n416/katanori/surugo/README.md

# 刷るぞー

**印刷ターム（プレート 1 枚）を単位にして、刷る前に計画を立て、刷った結果をログに積む道具。**

```
python surugo/server.py        →  http://127.0.0.1:8731/
```

## なぜプレート単位なのか

番手もフィルムの状態も位置も、**部品ではなくプレート単位で効く**。いちばんはっきりした例が
[docs/PRINT.md](../docs/PRINT.md) 冒頭の「大きい部品は板が厚く出る」で、あれは
**同じプレートに載っている他の部品が、小さい板の厚みを変えている**現象である
（45mm 離れた大きい板が +0.9 変えた）。部品ごとの STL という単位では、この現象を表現できない。
印刷時間も同じで、「一番背の高い部品だけが決めている」のはプレートの性質である。

## 出力は「結合した 1 つの STL」

✅ 実機で確認済み（[docs/PRINT.md](../docs/PRINT.md) §3）。**CHITUBOX は読み込んだ STL の
座標を捨てて、bbox の中心をプレート中央に合わせる。** 部品ごとに別ファイルで出すと、
相対位置すら保たれない（衝突を避けて勝手にずらされる）。⇒ 1 つに結合して出す。
向きと Z は変えられないので、動くのは XY だけ。

書き出す配置は bbox の中心が (0,0) になるよう作ってあるので、**中央合わせが何もしないのと同じ**になる。
⇒ CHITUBOX では読み込んで、**動かさずにスライスする。**

⚠ プレート上の絶対位置（傷を避ける・フィルムの摩耗を散らす）は、必ず中央へ寄るので指定できない。
やるときは「移動量を出して、人が CHITUBOX の数値欄に入れる」マニュアル操作になる。

## 書いてよい人が種類ごとに違う

ログ（`hardware/print_log.jsonl`）は追記だけの出来事の列。

| 種類 | 中身 | 誰が |
|---|---|---|
| `term` | 印刷ターム（部品・接地・配置） | 人でも **AI でもよい**（STL から導ける事実だから） |
| `placed` | 移動指示を実際に適用したという確認 | 人 |
| `result` | 刷り上がりの結果 | **人だけ** |
| `film` | フィルム交換（摩耗の累積がここで 0 に戻る） | **人だけ** |
| `plate` | 研ぎ直し（番手が決まるのはここ） | **人だけ** |
| `resin` | レジン交換 | **人だけ** |

🔒 2026-09-02 ユーザー「間違えた時に戻す方法ないぞこのあぷり」。⇒ ヘッダの**「ログ」**で全行を見て、
行ごとに**編集・削除**できる（人だけ）。書き換える前に必ず `hardware/print_log_bak/<時刻>.jsonl` へ
丸ごと写し、**「戻す」はその写しを戻す**。行を直しても STL は動かさない（archive へ移す・消すのは
`result` / `drop` を積んだときだけ）。実例: 1405 に書いた失敗の result を 1404 へ付け替えた（16:40）。

🔴 **AI に物理の観測を書かせない。**推測が観測の顔で混ざると、勘を反証するために貯めている
記録が最初から汚れる。⚠ `by` の判定は規律のための柵であって錠前ではない。

⭐ 番手とレジンを**印刷のたびに打ち込ませない**のは、毎回手で入れる欄が必ず腐るからである。
出来事として一度書けば、以後のタームはそれを引き継ぐ。

## 大きい部品は単独で刷る（接地が LCD の 30% 以上）

🔒 2026-08-31 ユーザー「デカイのを刷る時は他のを置いちゃだめ。引きずられて寸法が狂うから」。
接地が `rules.json` の `alone_grip_mm2` 以上の部品が入っていると、**並べずに止まる。**

境目は **3,855mm² ＝ Mars 3 の LCD（143.43 x 89.6 = 12,851mm²）の 30%**。
この機種の系統で知られている目安で、原因は Z の柱でもプレートの取り付けでもなく
**プリンタ本体のベースプレート（土台）のたわみ**。出典と表は
[docs/PRINT.md](../docs/PRINT.md) の節「これは Mars 系で知られている現象だった」にある。

⭐ **うちの実測とも合っている。** btntest 9% → 育ち 0 ／ v4_top 40% → +1.2 ／ テスト板（大）50% → +1.2。
30% の線が「出た組」と「出なかった組」のちょうど間に落ちる。

🔒 **見るのは接地ではなく断面。**原文は "cross-sections"。v4_top は接地 5192.9（40%）に対して
断面の最大が 5579.8（**43%**）で、接地だけでは過小評価になる。⇒ 部品ごとに層ごとの断面積を持つ。

🔒 **効くのは「その層に載っている合計」。**原文の "you don't have any large cross-sections" は
プレート全体の話で、たわむ原因が剥離力である以上そうなる。⇒ **1 個ずつ線の下でも、同じ層で
足して 30% を超えたら止める。**例: `v4_lwall` + `v4_rwall` は 11 層目（Z 0.55mm）で合計 53%。

## ヘラが届く所に置く（中央付近に置かない）

🔒 2026-09-09 ユーザー「小さなパーツを中央付近で印刷すると、金属ヘラを傾けなければいけないから
必ず傷がつく。そうすると連続印刷ができない」。プレートに傷が入ると、**研ぎ直すまで次が刷れない**。

剥がし方は 2 段になっている。① オルファ スクレーパー L型 35LB（刃幅 60mm・全長 159mm）で少し浮かせる。
② 浮いたら 井上工具 INOUE 巾木ヘラ 70mm 13003 を挿す（**プラ製**なのでアルミのプレートを**まったく傷つけない**。薄いのは浮いた隙間に入るため）。①で傷が入るのは、金属の刃が角度を持ってアルミに当たるからである。
⇒ 深さの制限を受けるのは ① だけ。**オルファを使うのは入口の一噛みだけ**で、その先は②に持ち替える。

🔒 ユーザー「正直**入口だけ 30mm** あればいい。そこだけオルファを使うから」「**全部が入ってる必要はない**」。
⇒ 見るのは**入口＝部品の手前の縁**（刃が下に入る所）までの距離で、部品の向こう側までではない。
`rules.json` の `scraper_reach_mm` が 30（図から読んだ刃の長さは約 32mm。60mm は横＝一度に噛める幅で、深さではない）。

⭐ 最近 10 回ほど連続で刷れているのは、**道具を試行錯誤で替えてきたのと、本人の技能が上がったから**である
（2026-09-09 ユーザー）。この規則はその技能の外側に線を引くものではなく、
**技能があっても物理的に無理な置き方（入口が奥すぎる）だけを止める**。

規則は「**入口が、プレートの縁からこの値より奥に来ない**」。効く所は 2 つ:

- **散らし**（`spreadMove`）… **入口を一番浅くする（縁へ寄せる）のが先**で、
  フィルムの摩耗を散らす向きは「入口が同じ深さになる範囲の中で」しか効かない
  （`_reg_term.py` と `app.html` の両方・同じ計算）。
  🔴 最初は「規則を満たす一番近い所で止める」にしていたが、それだと入口 29.8mm（規則 30）で止まり、
  ユーザーに「変わってないよ」と言われた。**ぎりぎりで止めない。**
  ⭐ 並べ方も 2 通り（横並び・縦並び）作って入口が浅い方を採る（`_best_entrance`）が、
  部品が 2 つのときは**横並びの方が浅い**。横並びなら 2 つとも同じ縁に揃って寄れるからで、
  縦並びだと片方が必ず反対の縁から遠くなる（実測: 横 3.3mm ／ 縦 18mm）
- **書き出し**（`/api/export`）… 満たしていない配置は**止まる**。`alone_grip_mm2` と同じ扱い

⚠ この規則を入れる前の回には超えている物がある（2026-09-08-2211 が 35.2mm・過去最大 38.5mm）。

## 摩耗マップ（ヘッダの「摩耗マップ」）

ヘッダの「摩耗 11,510,598」は接地 × 層数の総和で、**どこが減っているか**は分からない。
置き場所をずらしている（`spreadMove`）のが効いているかも、この数字では見えない。
⇒ 真上から見たプレートの 1mm 角ごとに、**その場所で何層ぶん露光（＝剥離）が起きたか**を
足して色にする（`heat.py`・`GET /api/heat`）。「回数（何回そこに部品が載ったか）」にも切り替えられる。
失敗した回の部品があった所は赤い縁で囲む。

🔒 **出どころは刷った結合 STL**（`result` を積んだときに `hardware/stl/term/archive/` へ移した物）。
四隅のアンカー入りなので、その座標がそのまま刷った位置である。ログの cx/cy や w/h は使わない
（2026-09-05 以前の回には w/h が無いし、回した向きも入っていない）。
アンカー以前の回（2026-08-31-1631）は STL が残っていないので入れず、「入れていない回」に名前を出す。
まだ刷っていない回（結果が無い）も入れない。フィルム交換より前の回は数えない（ヘッダの摩耗と同じ）。

⚠ 代理値。剥離仕事そのものではない。**「どこが減っている」の判断は道具はしない。**
測った結果は `surugo/.heat_cache/`（STL の mtime で作る派生物・コミットしない）。

## 判定はまだ入れていない

番手の 3 段（#600 / #800 / #1000）を接地面積から自動で出すことは**していない**。
あの境目は実績ではなくユーザーの勘で、n が小さいため
（[docs/PRINT.md](../docs/PRINT.md) §4「まだ道具にしない」）。**先にやるのは判定ではなく記録**である。

## 数字を二重に持たない

接地面積・島・持たれていない天井は [_stl_preflight.py](../hardware/tools/_stl_preflight.py) を
そのまま呼んで出している（`measure.py`）。同じ数字が 2 か所にあると、片方だけ動く。

## 浮かせて刷る部品

いまのパイプラインでは扱えないので、`rules.json` の `lifted` に名前があると止まる。
🔴 **これを幾何から推論してはいけない。**一度そうしたら、直置きで刷れている
`v4_shutter` / `v4_seat` / `v4_hatch` まで弾いた。置き方は PRINT.md §3 のとおり人が決める。

## ファイル

| | |
|---|---|
| `server.py` | API と画面の配布。**API が本体で、画面はその客の 1 つ**（AI は curl で同じ口を叩く） |
| `measure.py` | STL を測る層。`_stl_preflight.py` を呼ぶだけ |
| `store.py` | ログ。出どころの規則はここ |
| `app.html` | 画面。真上から見たプレート図 |
| `rules.json` | 人が宣言する規則（単独で刷る境目・浮かせて刷る部品） |
| `heat.py` | 摩耗マップ。刷った結合 STL（archive）を 1mm 角に割って露光層数を足す |
