n416/katanori/firmware/esp32/README.md

# カタノリロボ 実機ファームウェア (XIAO ESP32S3)

`firmware/core` / `firmware/hal` のコアロジックを実機で動かすための PlatformIO プロジェクトです。
コアはシミュレーターと**同一のソースを共有**しています（コピーを作らないこと）。

## いまの状態

⚠ 2026-09-15 に書き直した。それまでは「Stage 1〜4」の表で、4 に「会話が成立した後の全部」を積んでいた
（Stage の定義はどこにも無かった）。全体の状態は [ルートの README](../../README.md) が持つ。ここはファームの範囲だけ。

| 領域 | 内容 | 状態 |
|---|---|---|
| 会話の土台 | OLEDに顔を表示（I2Cスキャン・状態遷移の目視確認） | ✅ 2026-07-26 |
| 会話の土台 | Wi-Fi + WSS で Durable Object へ接続 | ✅ 2026-07-26 |
| 会話の土台 | I2S 音声の送受信（ReSpeaker Lite 経由） | ✅ 2026-07-26 会話成立 |
| 会話の土台 | TLS証明書の検証 | ✅ 2026-07-26 |
| Wi-Fi | プロビジョニング（キャプティブポータル）・自動接続・繋がらない時の画面と声 | ✅ 2026-07-26〜 |
| 操作 | 会話ボタン（D2 = GPIO3・短押し=会話の開始/終了・長押し=メニュー） | ✅ Usrボタンで 2026-07-27 → 独立したボタン v3 が 2026-08-31 合格 |
| 操作 | 音量つまみ（AS5600） | ✅ 2026-08-02 移行・2026-08-05 実会話まで開通 |
| 耳の安全 | コーデックのミュートゲート（`pumpOutputGate()`） | ✅ 2026-07 |
| 耳の安全 | ミュートリレー（`D3` = GPIO4・無通電で開） | ✅ 2026-08-08 駆動合格 → 2026-09-02 スピーカー線で確認（[起動時の轟音とその対策](#起動時の轟音とその対策)） |
| 電源 | 電池の電圧・電流（INA226 `0x44`・`bat`） | ✅ 2026-09-02 |
| 電源 | 再起動の理由と直前の様子（`boots` / `lastlog`）・30 秒のウォッチドッグ | ✅ 2026-09-12（BootLog.cpp）。2026-09-11 の勝手な再起動は、2026-09-25 の実測で見た電池切れのブラウンアウトの繰り返しと同じ形（[docs/POWER.md](../../docs/POWER.md) 6章） |
| 運用 | OTA（`xiao_esp32s3_ota` env） | ✅ 2026-08-03 |
| 運用 | 利用者の設定（メニュー ＋ `http://katanori.local/`・Settings.cpp） | ✅ 2026-09-11〜12 |
| 運用 | Wi-Fi 越しのシリアル（`katanori.local` TCP 23・Console.cpp・OTA と同じ合言葉） | ✅ 2026-09-11 |
| 呼びかけ | 「カタノリ」の聞き分け（`MicroWake.h`・`WakeModel.h` の `katanori_own_a`） | ✅ 2026-09-24 完成（[docs/WAKEUP.md](../../docs/WAKEUP.md)） |
| 未着手 | QRペアリング | 未着手 |

> 2026-08-02 に XMOS が起動しなくなった件は 2026-08-05 に解決済み（犯人は `D1`(GPIO2) = XMOS のリセット線。
> この文書の「解決（2026-08-05深夜）」の節）。

## 構成

```
firmware/
├── core/          ← シミュレーターと共有（Arduino依存禁止・純C++14）
├── hal/           ← IHal インターフェース
└── esp32/         ← このPlatformIOプロジェクト
    ├── platformio.ini
    └── src/
        ├── main.cpp        Esp32Hal + setup/loop・会話制御・メニュー・シリアルのコマンド
        ├── NetLink         DO との WebSocket
        ├── AudioIo         I2S・再生キュー・コーデック
        ├── Provisioning    Wi-Fi 設定モード（キャプティブポータル・QR）
        ├── Battery         INA226（電池の電圧・電流）
        ├── BootLog         再起動の理由・直前の様子・前回のログ・ウォッチドッグ（2026-09-11）
        ├── Console         Wi-Fi 越しのシリアル（TCP 23・2026-09-11）
        ├── Settings        利用者の設定と katanori.local の設定ページ（2026-09-11）
        ├── VoiceClips.h    焼き込み音声（katanori-backend/tools/gen-voice-clips.mjs が生成・手で編集しない）
        └── RootCa.h        ピン留めしたルート CA
```

`platformio.ini` の `build_src_filter` で `../../core/*.cpp` をビルド対象に加えているため、
コア側を修正すると実機ビルドにもそのまま反映されます。

## 配線（実機で確認済み）

XIAO ESP32S3 を ReSpeaker Lite に直挿しした構成。OLED は ReSpeaker Lite が使っている
I2Cバス（D4/D5）に相乗りさせる。**このバスにはプルアップが既に載っている**ため追加不要。

| OLEDのピン | XIAO | GPIO |
|---|---|---|
| `VCC` | 3V3（右側ヘッダ上から3本目） | — |
| `GND` | GND（右側ヘッダ上から2本目） | — |
| `SCL` | D5（左側ヘッダ上から6本目） | 6 |
| `SDA` | D4（左側ヘッダ上から5本目） | 5 |

```
          ┌──[USB-C]──┐
   D0 ────┤           ├──── 5V
   D1 ────┤           ├──── GND
   D2 ────┤           ├──── 3V3
   D3 ────┤           ├──── D10
   D4 ────┤           ├──── D9      D4 = SDA (GPIO5)
   D5 ────┤           ├──── D8      D5 = SCL (GPIO6)
   D6 ────┤           ├──── D7
          └───────────┘
```

注意点:

- **VCC は 5V ではなく 3V3 に繋ぐこと。** 5Vを与えるとモジュール側のプルアップが
  I2Cラインを5Vへ引き上げ、ESP32の入力定格を超える。
- 使用しているOLEDモジュールのシルクは **`VCC GND SCL SDA`** の順で、一般的な
  `VCC GND SDA SCL` とは SCL/SDA が逆。並び順の記憶で挿すと入れ替わる。
- 起動時にOLEDが繋がっていないと初期化コマンド列がパネルに届かない。配線を直した後は
  リセットするか、シリアルで `r` を打って再初期化すること。

I2Cスキャンでは ReSpeaker Lite 側のデバイスが `0x18` に、OLEDが `0x3C` に見える。
両方出れば配線は正常。

### Usrボタン（🔒 2026-08-03 不採用・デバッグ用のみ）

> 🔒 **決定（2026-08-03・ユーザー）: Usrボタンは製品では使わない。**
> ReSpeaker Lite 側のボタンを借りる方式は**デバッグ用の間に合わせ**であって、
> 装着者が押すボタンではない。**独立したプッシュボタンを載せる**（次節）。
>
> これで消えるもの: `Usr`-`D2` の導通ハック（ボード裏のスルーホールにジャンパを
> ぶら下げる）、個体ごとの導通確認、ストラッピングピン GPIO3 の制約。
> **ボード交換のたびに増えていた手順が丸ごと無くなる。**
>
> 以下は、いま手元の機体を触るときのための記録として残す。

ReSpeaker Lite 裏の **Usrボタンで会話を開始できる**（XIAOのBOOTボタンは小さすぎて実用にならないため）。
ただし Usrボタンは XMOS XU316 側に繋がっていて、**そのままでは ESP32 から見えない**。

- ReSpeaker Lite の XIAO が載っている面、左下に **`Mute D3 D2 Usr`** と印字された穴の列がある
- **`Usr` と `D2` の導通が必要**（Seeed公式の想定でははんだブリッジ。
  [Usr Button Usage](https://wiki.seeedstudio.com/respeaker_button/)）
- これで Usrボタンが **D2 = GPIO3**（`KATANORI_USR_BUTTON`）に押下=LOWで入る

> 🔧 **記録訂正（2026-08-02・ユーザー確認）**: 以前ここに「はんだブリッジしてある」と
> 書かれていたが、**実機にはんだ付けは一切していない**。Usr-D2は**ジャンパー
> （ブレッドボード用ピン）を穴に通してぶら下げているだけ**（固定なし・ブラブラの
> 状態でスルーホールのメッキに触れて導通している）。取り外し自由で基板は無改造。
> 当時ユーザーは画像付きで「ジャンパーで繋いでいるだけ」と報告していたのに、
> AIが勧めていた「はんだブリッジ」が実行されたものとして記録された（誤変換の経緯）。

**Usr-D2 が導通していない個体では Usrボタンは一切反応しない。** 新しいボードを組むときは導通方法を決めてから。

- ファーム側は BOOTボタンと Usrボタンを同じ扱いで読む（`anyButtonPressed()`）。
  短押し=会話開始/終了、3秒長押し=Wi-Fi設定モード
- **Muteボタンはブリッジしない。** XMOS側でマイクミュートとして実際に機能しているため
- GPIO3 はストラッピングピン。INPUT_PULLUPで読むだけなら無害だが、**リセットの瞬間に
  押しっぱなしにしない**こと

### 会話ボタン（独立したプッシュボタン・2026-08-03 決定・✅ 実装済み）

✅ ファームは `D2`(GPIO3) で読む（main.cpp 冒頭）。スイッチは 2026-08-31 にレバー式の v3 が実機で合格し、2026-09-02 にハブ基板経由で動作確認。下の PS21B-3 の話は経緯。

装着者が押す唯一のボタン。役割は Usrボタンから引き継ぐ（短押し=会話開始/終了、
長押し=メニュー。🔒 2026-09-11 に「3秒長押し=Wi-Fi設定モード」をメニューの WiFiせってい へ移した）。ファームは `anyButtonPressed()` で読む形のまま、
ピン定義を差し替えるだけで済む。

**要件**: 高齢者が肩の上で**見ずに手探りで押せる**こと。筐体に固定できること
（ぶら下げ配線にしない）。A接点（ノーマルオープン）・モーメンタリ・LED無し。

#### 🔴 届いた PS21B-3 は硬すぎる（2026-08-06・実物で判明）

**「かなり強く押さないとダメ」**（ユーザー報告）。**上の要件に反している。**

✅ **実測: 約600gf（≒5.9N）が必要**（2026-08-06・ユーザー実測）。
**橋の穴に据えて固定した状態での測定**なので、「手で持っているから硬く感じるだけ」
（指が反力を吸う）という可能性は**同時に否定されている**。硬いのはスイッチ本体。

参考: キーボードのキーやマウスのクリックは**50〜75gf**程度。**600gf はその約10倍。**
⚠ しかも肩の上では反力を受ける支えが無いので、机の上で600gfを押すより更に不利。

⚠ **肩の上のボタンは、机の上の同じ硬さより実際にはさらに厳しい。** 押し返す支えが
取れない（自分の体を押すことになる）ため力が逃げる。強く押すほど**装置が肩からずれる・
鎖骨側に食い込む**方向にも働く。クリップ留めなら外れる可能性もある。

⚠ **落ち度は記録側にある。** 旧 SHOPPING.md（2026-08-24 に削除・git 履歴）4.5 の選定条件は
A接点・モーメンタリ・LED無し・パネル取付・寿命5000回・¥90 で、**押下力が条件に入っていない**。
「高齢者が手探りで押せる」を散文で書いたまま、**購買の数値条件に落とさなかった**のが原因。
リポジトリ内に押下力の数値は一切残っていない（選定時に見ていない）。

🔒 **決定（2026-08-06・ユーザー）: 動作力の軽いスイッチへ交換する。**
てこ／パドルによる延命（部品を買わない案）は採らない。

**▶ 発注したもの（2026-08-06・Amazon・翌日着＝2026-08-07）:
DAOKAI「20PCSマイクロリミットスイッチ NO+NC ヒンジストレートレバー 3PIN 125V 1A」¥309（20個・¥15/個）。**
ヒンジレバー形・a接点/b接点（COMとNOだけ使う）・プラグイン端子。評価4.6（364件）・Amazon出荷。

⚠ **この品も動作力と動作寿命の数値を公開していない**（スペック表は動作モード・電流・電圧・
接点・コネクタ・ブランド・スイッチタイプのみ）。商品説明の「起動にはわずかな力しか必要ありません」は
**宣伝文であって仕様ではない**。**PS21B-3 と同じ形の情報不足**なので、**届いたら実測する**。

**それでもリスクは囲めている**（前回4個で全滅して手詰まりになった状況とは違う）:
1. **20個ある**
2. **測れる**（下の測定方法）
3. **パドルのてこ比で救える。3:1なら300gf → 100gf。** ヒンジレバー形が400gfを超えることはまず無い

⬜ **秋月の `SS-10GL13`（114659・¥160・0.49N）は買わなかった**が、**数値の基準としては有効**
（下の表の右列）。互換品が重すぎた場合の逃げ道として記録に残す。
⚠ 秋月は**送料¥550＋リードタイムが長い**ため、小物1点では選ばない（ユーザー指摘・2026-08-06）。

| | PS21B-3（現物・硬い） | **SS-10GL13**（買っていない。**数値の基準**） |
|---|---|---|
| 動作力 | **実測 約600gf ≒ 5.9N**（カタログに記載が無く、選定時に見られなかった） | **0.49N ≒ 50gf**。キーボードのキー／マウスのクリック相当＝**約1/12** |
| アクチュエータ | ピン押ボタン（φ小・硬い） | **ヒンジ・アール・レバー形**（レバー自体がてこになる） |
| 動作寿命 | **5,000回**（1日15回で約1年） | **50,000回＝10倍** |
| 奥行き | **全長36.58mm**・径18.94mm | **短辺6.4mm**（18.4 × 19.8 × 6.4） |
| 接点 | A接点 | C接点（**NOとCOMだけ使う**） |
| 取付 | パネル穴＋ナット | ねじ止め（印刷したボスに留める） |

#### ✅ 届いた（2026-08-07）。**動作力 約30gf で合格**

| | 値 | 判定 |
|---|---|---|
| **動作力** | ✅ **約30gf ≒ 0.29N**（ユーザー実測） | **合格**。基準の100gf に対し3倍以上の余裕。`SS-10GL13`(50gf)より軽い。PS21B-3(600gf)の**1/20** |
| **外形** | ✅ **縦5 × 横12 × 高6 mm ／ ノブ高5 mm**（2026-08-07 再計測。横＝端子の並び方向） | リレー12.6mm とほぼ同じ長さ |
| 動作寿命 | ⬜ 不明（メーカー非公開） | 試作は可。製品化の段で再検討 |
| 3ピンの割り当て | ✅ **レバーの根本側から C, NO, NC**（2026-08-07 ユーザー確認） | 使うのは **C と NO**。⚠ **NC は繋がない**（押していない間ずっと閉じている＝会話が始まりっぱなしになる） |

⚠ **心配の向きが反転した。** 硬すぎる問題は消えたが、**30gf は「軽すぎ」も検討する帯**。
**パドルのてこ比で軽くする必要はもう無い**（3:1 を掛けると指先10gf になり、服や寝返りで
誤って会話が始まる側に寄る）。**パドルは「手探りで当てられる面積」のために付ける**もので、
**てこ比は1:1近くでよい**。肩の上での誤爆は、パドルを設計する前に決める。

**この交換は4つ同時に効く**（硬さだけの話ではない）:
1. **動作力** — 要件そのもの
2. **寿命** — 5,000回は上の⚠で「製品として渡すなら替える」と既に書いていた宿題。同時に消える
3. **薄さ** — 36.58mm → 6.4mm。**肩に載せる機体では効きが大きい**
4. **手探りで押せる** — レバーの上に**印刷したパドル**を被せる。パドルは要件のためにどちらにせよ要る
   （てこ比のぶん指先の力はさらに軽くなる）

⚠ **筐体側の作り方が変わる。** パネル穴＋ナットではなく、**ねじ止めのボス＋レバーを押すパドル**。
そのため [DIMENSIONS.md](../../docs/DIMENSIONS.md) の「PS21B-3 のパネル穴径・ねじ長」は
**優先度が下がった**（詳細に測る必要はもう無い）。代わりに要るのは **SS-10GL13 の取付穴ピッチ・
レバー位置・動作travel**。

~~⚠ **今週には間に合わない**（発送待ち・到着は週明け見込み）~~ → **2026-08-07 に着荷済み。**
**PS21B-3 は使わない。最初からこのマイクロスイッチを載せる。**

⭐ **線で出さず、ハブ基板に直挿しする（2026-08-07・ユーザー指摘）。**
端子が**1穴飛ばし＝ピッチ5.08mm で 2.54mm グリッドに乗る**ので、3本がそのまま3穴に入る。
**縦置き（リレーと同じ向き・上端も揃える）で 列9**。
穴は **`J9`＝C（GNDへ）／`L9`＝NO（`D3`へ）／`N9`＝NC（繋がない）**。
⚠ **NC を繋ぐと、押していないのに会話が始まりっぱなしになる。**
⚠ これを載せるため駆動回路を左へ寄せた。**空けてある列が3本ある**（いずれも「空き」ではなく設計の一部）:
**列2**＝+5Vレールとの緩衝／**列6**＝コレクタ配線の通り道／**列8**＝GNDレール(列7)と
スイッチのピン列(列9)の緩衝。
穴割りは [hardware/parts/relay_board.html](../../hardware/parts/relay_board.html) が正。

⚠ **ファーム側はこの件と無関係**（ピン定義＋`anyButtonPressed()`）。硬さが未解決でも
**配線とファームは先に通せる**。

⚠ **ピン割り当ては提案であって未確定**（ボード到着後に確定する）:

| 用途 | 提案 | 理由 |
|---|---|---|
| **ミュートリレー駆動** | **D3 = GPIO4** | ✅ **2026-08-08 実機で合格。** 電源投入で開・`high 3` で閉・`hiz 3` で開 |
| 会話ボタン | **D2 = GPIO3** | ✅ **ファーム側は既にできている。** `KATANORI_USR_BUTTON = 3` がこのピンで、`setup()` で `INPUT_PULLUP` にして `anyButtonPressed()` が読んでいる。**スイッチを D2⇔GND に繋げばファームは1行も変えなくてよい** |
| ~~ミュートリレー駆動~~ | ~~**D10 = GPIO9**~~ | 🔴 **使えない。** ファームでは未使用だが、**ReSpeaker Lite 側が握っている**。挿すだけで電源投入時にリレーが閉じっぱなしになった（[docs/POWER.md](../../docs/POWER.md)）。テスターで1.49V＝クロックの平均値と見られる |

🔴 **「ファームで未使用」は「ピンが空いている」ではない。** D10 はこの取り違えで外した。
**ReSpeaker Lite 側の結線は公開資料で追えていない**ので、ピンを決めたら必ず実機で検証する。
検証は「線を挿す → 電源投入で**動かない**こと → `high N` で動くこと → `hiz N` で戻ること」。
`high`/`hiz` で追従を見れば、**ピンの取り違えと機能の可否を同時に確認できる**（数えなくてよい）。

**D1 は使わない。** 基板内でXMOSのリセット線に直結しており、pinMode しただけで
音声が止まる（2026-08-05 確定）。
**D0 は「ファームが触らないピン」になった**（2026-08-11 にADCフォールバックを削除。
下の旧経路の節）。ただし空きピンとして使うのは、ワイパー線を外した独立テストで
生死を確認してから（「`high 0` で3Vが出ない」はポット接続下の測定で証拠不成立）。

### 音量つまみ（AS5600・2026-08-02 ファーム移行済み）

主経路は **AS5600（I2C 0x36）の `RAW ANGLE`**。ゼロ点（NVS `knob/zero`）からの
相対角度を 0-100% へ写す。設計と実測は [docs/KNOB-ENCODER.md](../../docs/KNOB-ENCODER.md)。

- ビルドフラグ: `KATANORI_KNOB_SPAN_DEG`（既定270・ゼロ点からこの角度で100%）/
  `KATANORI_KNOB_OFF_DEG`（既定5・この角度未満でOFF、+3度のヒステリシス）/
  `KATANORI_KNOB_DIR_INVERT`（回して%が逆に動く組み付け用）
- コマンド: `knobzero`（今の位置をゼロ点として保存）/ `knobsrc`（読み元の再判定）/
  `knob`（角度・%・ゲインに加えて磁石の MD/ML/MH・AGC・MAGNITUDE）
- **AS5600が唯一の経路**（旧・可変抵抗のADCフォールバックは 2026-08-11 に削除）。
  起動時に 0x36 が応答しなければ読み取りを止めて既定音量で動き、動作中に
  5回連続で読めなくなったときは音量・OFF状態を**最後の値のまま固定**する。
  復帰は配線を確認して `knobsrc`
- 治具での実測（2026-08-02）: ゼロ点保存→90度ごとに 0/28/64/97% の単調増加、
  12時戻りでOFF復帰、ゼロ点を数度行き過ぎても範囲外折返しで0%に倒れる。
  つまみを外して切り分けるときは `knobdis` で読み取りを止めてから行う

### 音量つまみ・旧経路（スイッチ付き可変抵抗・2026-07-29 配線・**削除済み**）

RV121SF-20-02J-B10K（10kΩ Bカーブ・SPST連動スイッチ付き）。

> 🔒 **この経路は 2026-08-11 にコードから削除した**（ポットを二度と戻さない方針が
> 確定したため）。`kKnobCurve`・`pumpKnobAdc()`・`knobSwitchRawOn()`・
> `KATANORI_VOL_ADC`・`KATANORI_KNOB_SW`・`KATANORI_KNOB_SW_INVERT` は
> もうコードに存在しない。以下は当時の配線と実測の記録として残す。
> **可変抵抗まわりを新規に設計・買い足ししないこと。**

| つまみの足 | 接続先 | 備考 |
|---|---|---|
| 上の足（OFF位置でワイパーが導通する側） | **GND** | 左に回し切り=0Vで最低音量になる向き |
| 中央の足（ワイパー） | **D0 = GPIO1** | ADCで読む。**3V3系。5Vは絶対に入れない** |
| 下の足（最大位置でワイパーが導通する側） | **3V3** | |
| 連動スイッチ2本 | **D1 = GPIO2** と **GND** | 2本に向きは無い。INPUT_PULLUPで読む |

- ⚠ **XIAOのシルク `D0`/`D1` は GPIO0/GPIO1 ではない**（D0=GPIO1、D1=GPIO2）。
  ここを読み違えるとワイパーとスイッチが入れ替わり、「音量が0か最大しかない・
  回転の途中で疑似電源OFFに入る」という症状になる（2026-07-29 に実際に踏んで、
  コネクタで入れ替えて復旧した）
- **現在の機体は外側2本が上表と逆**（OFF位置側=3V3）のまま実装されている
- **ADC→位置(%)の換算は実測テーブル**（main.cpp の `kKnobCurve`）。この個体の
  抵抗カーブはB（直線）と称して実際は「3時で22%・4時→5時に全変化の6割」という
  極端な偏りがあり、線形換算では使いものにならなかった（2026-07-29 実測）。
  向き（外側2本の付け方）の吸収もこの表が担う（旧 `KATANORI_VOL_INVERT` は廃止）。
  **つまみを交換・再半田したら各位置で `knob` を読んでテーブルを取り直すこと**
- ~~組立中に3V3-GNDの短絡事故があった~~ **記録訂正（2026-08-02・ユーザー確認）:
  3V3-GNDの短絡は実際には起きていない。** 以前のセッションの誤診断が事実として
  書かれていた。故障原因の候補からも外すこと
- 待機中にログへ「ミュートしました」が出続けるのは**仕様**（出力ゲートは
  鳴らすものがある間だけ開く）。故障判定は「会話の応答中にも無音か」で行う
- **スイッチは電源線に入れない**（定格DC12V 0.5A。GPIOで読めば数μAで定格が無関係）
- 論理は **ON位置=接点が閉じる=LOW**（アクティブLOW。Usrボタンと同じ作法）。
  「OFF位置なのにHIGH」は故障ではなく仕様。逆に振る舞う個体は
  ビルドフラグ `-DKATANORI_KNOB_SW_INVERT=1` で反転できる
- OFF位置の挙動: 会話を終了し、出力ゲートを閉じたままにする（手動 `unmute` より優先）。
  ボタンを押しても会話を開始しない
- 確認コマンドは `knob` だった（当時はADC生値・スイッチ状態も表示。現在のコードでは
  AS5600の角度と磁石の状態を表示する）

### 疑似電源OFF（つまみOFF位置・`pumpPowerDown()`）

電源基板が無いので**本当には切れない**（USB給電でも電池でもXMOSごと生きている）。
ESP32側だけを畳んで「切れたように見せる」のがこの処理。

| OFF位置になってから | すること |
|---|---|
| 即時 | 会話終了・出力ゲートを閉じる・顔とマイクを止める |
| 2秒後 | OLED消灯（`setPowerSave(1)`。バッファは残るので戻せば同じ絵が出る） |
| 5秒後 | `wsDisconnect()` → `wifiDisconnect()` → ユーザーLED消灯 |

- **一気に落とさない理由**: 回し切る途中で一瞬OFFを通ることがあり、また「切ったつもりが
  違った」とすぐ戻すこともある。落とし切る前にONへ戻せば、その段階は実行されない＝
  何も起きなかったことになる。落とした後に戻した場合は**落とした分だけ**戻す
  （画面を点け、Wi-Fi再試行の待ち時間を捨てて即座に自動接続へ行く）
- 通信を落とすまでの5秒間は WebSocket を生かしたまま `netLink.loop()` を回す。
  ここで戻れば繋ぎ直しが要らない（再接続はWi-Fiだけで十数秒かかる）
- ユーザーLEDは「通信中」の表示なので、**切断が終わってから**消す
- 昇圧ICのEN制御は、この5秒後の処理の**最後**に足す。そうすると
  ミュート→切断→電源断の順序が構造的に守られる（[docs/POWER.md](../../docs/POWER.md)）
- Wi-Fi設定モード中は動かない（画面もAPも要るため）。設定モードを抜けた時点で効き始める
- **`WiFi.mode(WIFI_OFF)` までは落としていない**（`wifiDisconnect()` 止まり、
  `main.cpp` の `powerWifiOff`）。消費電流は WIFI_OFF のほうが小さいので、
  本当は落としたい。実測してから決めること。

  > **この判断を2度間違えている。** 「WIFI_OFF にするとI2Sが巻き添えで止まる」
  > (2026-07-29) → 「I2Sではなくコーデックの設定が飛ぶ」(2026-07-30) → **どちらも誤り**。
  > 根拠にした試験はどちらも「つまみを回す」操作を含んでいて、そちらが犯人だった。
  > `wifistop` で WIFI_OFF を15秒保持しても、コーデックは生きたままになる。
  > **一度に1つしか変えないこと。**

> ✅ **「つまみを回すとコーデックが死ぬ」は解決済み（2026-08-05）。** 原因だった可変抵抗そのものが
> AS5600 への移行で機体から無くなった。経緯と実測は [docs/KNOB-TROUBLE.md](../../docs/KNOB-TROUBLE.md)。
> 以下の可変抵抗の話は記録。

### 切り分け用のシリアルコマンド

| コマンド | 何をするか |
|---|---|
| `creg` | コーデックの主要レジスタをダンプ。正常時は `0x3F=0xD4` / `P1 0x09=0x3C` |
| `knobdis` | つまみの読み取りを止める/再開。**配線を外して切り分けるときは必ずこれ**（外すとピンが浮いてOFF位置と誤認し、ソフト側の理由で無音になる）。⚠ **疑似電源OFF中に打つと復帰処理が走る**（画面点灯・Wi-Fi再接続・**コーデックのミュート解除・起動ボイス再生**）。ゲインが0でなければ音が出るので、**イヤホンを着けたまま打たないこと** |
| `low <d>` | 指定したDピンを300ms LOWにする。「このピンをGNDに繋ぐと何が起きるか」を手を使わずに再現する |
| `pwr` | 疑似電源OFFの有効/無効。前節の処理を丸ごと切れる |
| `reboot` | ESP32だけ再起動。**この機体はRSTボタンが押せない位置にある**ため。USB給電は切れないので「ESP32だけ」の切り分けに使える |
| `mag` | **AS5600(0x36)の磁石の状態と角度**を1回表示（読み出しのみ。OTPには一切書かない）。`STATUS` の MD/ML/MH・`AGC`・`MAGNITUDE`・`RAW ANGLE`・`ANGLE` を出す。つまみの非接触化の組み付け確認用（[docs/KNOB-ENCODER.md](../../docs/KNOB-ENCODER.md)）。**電源断用リードスイッチの磁石が角度を狂わせていないか**もここで見る（[docs/POWER.md](../../docs/POWER.md)） |

`pumpCodecWatch()` が200msごとにコーデックを見張っていて、出力が死んだ瞬間と復帰した
瞬間をログに出す。**これが無いと、音を鳴らすまで気づけない。**

コマンドは `pio device monitor` に手で打ってもよいが、決まった手順を流して結果を
持ち帰るなら [tools/ser.py](tools/ser.py) が楽（行頭に経過秒が付く）。

```bash
python tools/ser.py 3 knobdis creg
```

## セットアップ

PlatformIO Core をインストールします（VS Code拡張版でも可）。

```bash
pip install -U platformio
```

`pio` にパスが通らない環境では `python -m platformio ...` でも同じことができます
（`pip install --user` の場合はこちらが確実）。初回の `pio run` は
ツールチェーンを取りに行くので数分かかります。

**USBドライバは要りません。** XIAO ESP32S3 はネイティブUSB（USB-Serial-JTAG）で、
Windows 11 なら挿すだけで「USB シリアル デバイス (COMn)」として見えます。
CH340/CP210x のようなドライバを入れる必要はありません。ポート番号はPCごとに
変わるので、機械を替えたら確認してください。

```bash
pio device list
```

## ビルドと書き込み

XIAO ESP32S3 を USB-C で PC に接続してから、このディレクトリで実行します。

```bash
pio run -e xiao_esp32s3 -t upload
```

書き込み後、シリアルモニタを開きます。

```bash
pio device monitor -e xiao_esp32s3
```

### 書き込みできない場合（ブートローダーモード）

XIAO ESP32S3 の **BOOT ボタンを押しながら RESET**（または BOOT を押しながらUSB接続）すると
ダウンロードモードに入ります。COMポートが見えない場合はこれを試してください。

## 動作確認（Stage 1 の完了条件）

1. シリアルに `[I2C] device found at 0x3C` が出る → **配線OK**
2. OLED に目が表示され、数秒おきにまばたきする → **描画OK**
3. シリアルモニタから `1` `2` `3` `4` を送ると顔が変化する → **状態機械OK**

| 入力 | イベント | 遷移 |
|---|---|---|
| `1` / BOOTボタン | `WAKE_WORD` | IDLE → LISTEN |
| `2` | `SPEECH_END` | LISTEN → THINK |
| `3` | `RESPONSE_READY` | THINK → SPEAK |
| `4` | `SPEECH_DONE` | SPEAK → IDLE |

シミュレーターのキー操作と同じ割り当てです。
`wrapper.py` が送る `CMD:SPEAK_START` / `CMD:SPEAK_END` も受理します。

### 診断コマンド

ネイティブUSB CDC のため、`upload` 直後のブートログはモニタを開く前に流れてしまいます。
以下のコマンドで後からいつでも同じ情報を取れます。

| 入力 | 内容 |
|---|---|
| `s` | I2Cバスを再スキャン（配線確認） |
| `a` | D0〜D10 の全ピン組み合わせを I2C として叩き、OLED(0x3C/0x3D)がどのピンに繋がっているかを探索 |
| `vN` | D`N` ピンの電圧を測る（簡易電圧計）。例 `v0` |
| `gN` | D`N` ピンが GND に導通しているか見る（簡易導通チェッカー）。例 `g1` |
| `t` | OLED自己診断パターンを5秒表示（`DisplayBuffer` を通さず U8g2 直描画） |
| `bn` | 接続状況の表示（顔の代わりに出る2行）を4種類、3秒ずつ出す。文字の大きさの確認用 |
| `i` | チップ・メモリ・I2Cピン設定を再表示 |
| `?` | ヘルプ |

`t` は**画面が出ない原因を二分する**ためのものです。

- `t` で枠と `KATANORI SELFTEST` が見える → 配線とOLED初期化はOK。原因は `DisplayBuffer` → U8g2 の転送側
- `t` でも真っ暗 → 配線・I2Cアドレス・給電のいずれかの問題

同じ理由で、起動直後にも自動でこのパターンを5秒表示します。

### テスター代わりの使い方

`vN` / `gN` はテスターが手元にないときに ESP32 自身を簡易計測器として使うためのものです。
調べたい点から D`N` ピンへジャンパーを1本渡して実行します。

- `v` は ADC で電圧を読みます。**入力は 3.3V まで。5V の点に繋ぐとピンが壊れます**
- `g` は内部プルアップを有効にして読むだけ。LOW なら GND に導通しています
- ADC非対応のため `v` は D6 / D7 では使えません（D0〜D5、D8〜D10 を使うこと）

## Stage 2: ネットワーク

Wi-Fi資格情報は **NVS(Preferences) に保存**します。ソースにも `platformio.ini` にも
書かないため、gitに漏れません。書き込み直しても消えません。

**最新5件まで保存**できます（自宅とスマホテザリングの併用を想定）。接続時は
スキャンして「見えている保存済みSSIDの電波が強い順」に試します。6件目を登録
すると最も古い1件が押し出されます。接続に成功したSSIDは「最新」へ繰り上がる
ので、よく使うものが自然に残ります。

| 入力 | 内容 |
|---|---|
| `ssid <名前>` | SSID を追加（既存の同名は先頭へ移動） |
| `pass <パスワード>` | 直前の `ssid` のパスワードを保存（ログには出しません） |
| `forget [名前]` | 指定SSIDを削除。名前を省略すると全消去 |
| `wifi` | Wi-Fi へ接続（普段は自動。手動で試したいとき用） |
| `wifioff` | Wi-Fi を切断 |
| `c` | Durable Object へ WebSocket 接続（普段はボタンを押した時に自動で張る） |
| `d` | WebSocket を切断 |
| `n` | ネットワーク状態を表示 |

### 完了条件（実機で確認済み）

```
[NET] 接続しました  IP=192.168.0.18  RSSI=-44dBm  (1.0秒)
[WS] 接続しました (0.9秒)
[WS] ★ setupComplete 受信 — Geminiまで疎通しました
[WS] BIN 26bytes: {"setupComplete": {}}
```

接続開始からGeminiの応答まで実測 **1.06秒**。WebSocket 接続中は内蔵LEDが点灯します
（仕様書の「通信中のステータス表示」）。

空きヒープの実測値: Wi-Fi接続前 292KB → TLS+WebSocket接続後 **248KB**（TLSで約44KB消費）。

### アンテナは必須

XIAO ESP32S3 は外付けアンテナ前提の設計です。**U.FL コネクタにアンテナを挿していないと
実質的に通信できません。** 実測で 40dB（電力比1万倍）の差が出ました。

| | アンテナなし | アンテナあり |
|---|---|---|
| 自宅APのRSSI | -86dBm | **-46dBm** |
| 検出できたAP数 | 2件 | **15件** |
| Wi-Fi接続 | 失敗 (WL_DISCONNECTED) | 成功 (0.8秒) |

スキャン（ビーコンを聞くだけ）は通っても接続（双方向のやりとり）は落ちるため、
「SSIDは見えるのに繋がらない」という紛らわしい症状になります。

### 実機で判明したこと: Geminiの応答はバイナリフレーム

Gemini Live API は応答を **WebSocket のバイナリフレーム**で返してきます（中身はJSONテキスト）。
`wrapper.py` では Python の websockets ライブラリが bytes と str を透過的に扱うため
表面化しませんでしたが、実機では TEXT と BIN の両方を同じように読む必要があります。
**Stage 3 の音声受信でも同じ扱いになります。**

### 起動後の自動接続

渡した相手はUSBもシリアルコンソールも持たない。**電源を入れるだけで会話できる状態まで
自力で行き着く**必要があるため、`main.cpp` の `pumpAutoConnect()` が以下を回します。

1. 保存済み設定があれば起動後すぐWi-Fiへ接続する（`wifi` を打つ必要はない）
2. 失敗したら 5秒 → 10秒 → 15秒…（上限30秒）と間隔を広げて試し続ける。
   ロボットのほうがルーターより先に起きる場合に備えるため
3. **一度も繋がらないまま3回失敗したら設定モードへ落ちる**。SSID変更や
   パスワード間違いを利用者が自分で直せるようにする

3の条件が「一度も繋がっていない場合のみ」なのは意図的です。会話中にルーターが
再起動しただけで設定モードへ入って会話が終わるのは、利用者から見て理不尽なため。
一度繋がった後の切断は再試行のみを続けます。

#### 繋がっていないことを利用者に伝える（2026-07-29）

引っ越して保存済みSSIDが消えた機体が、**顔だけを出したまま約1分間黙って**
再試行を続けました。顔は繋がっていてもいなくても同じように動くので、
利用者からは正常に見えてしまいます。3つ直してあります。

- **画面**: 繋がっていない間は**顔をやめて**、16pxの日本語を2行で出す
  （`netMsg1/netMsg2` / `Esp32Hal::flushDisplay`）。繋がれば顔に戻ります。

  | 状態 | 表示 |
  |---|---|
  | 接続中 | WiFiに / つないでいます |
  | SSIDが無い | WiFiが / みつかりません |
  | それ以外の失敗 | WiFiに / つながりません |

  最初は**顔の下に10pxの帯を重ねる**設計にしましたが、実機で読めませんでした
  （128pxに9文字入れると1文字10pxしか使えず「つ」が潰れる）。文字を大きくすると
  顔と同居できないので、**伝えるほうを優先して画面ごと明け渡しています。**

  フォントは `u8g2_font_b16_t_japanese1`（+46KB）。**かなとASCIIだけ使うこと。**
  japanese1 に無い漢字は幅0で消えます。1行は全角8文字（128px）が上限で、
  超えるとシリアルに `[UI] !! "..." は NNNpx` が出ます。

  文字の大きさは繋がっている機体では確かめられないので、**シリアル `bn`** で
  4種類を3秒ずつ画面に出せるようにしてあります。文言を変えたら必ずこれで見ること。
- **打ち切り**: 切断理由が結論の出ているもの（201 NO_AP_FOUND / 202・15 認証失敗）
  なら、タイムアウトを待たず接続試行を打ち切る。**12秒 → 実測2.5秒**。
- **顔を止めない**: `wifiConnect()` に待ち中のフックを渡し、接続待ちのあいだも
  描画を回す。渡さないと main loop ごと止まって顔が固まり、故障に見える。

結果、SSIDが消えた機体がQRを出すまで **約58秒 → 約23秒**（うち6.5秒は設定モード
起動時のスキャン。ポータルのSSID一覧を作るためのもので、ここは削っていない）。

**スキャンで「SSIDが在るか」を判定してはいけません。** 最初はそう実装しましたが、
名前を隠したAP（ステルス）が近くに1つでもあると「一覧に無い＝存在しない」と
言えなくなり、実機の環境がまさにそれで判定が成立しませんでした。加えて既定の
スキャンは13チャンネルで約6秒かかり、繋がる機体まで毎回遅くなります。
**接続を試した結果の理由コードのほうが速く、確かです。**

WebSocket は**ボタンを押した時に張ります**。DO はクライアント接続と同時に Gemini へ
繋ぎにいくため、常時接続や自動再接続は Gemini のセッションを浪費します
（`wrapper.py` と同じ「会話するときだけ繋ぐ」設計）。押した時点で未接続なら、
接続してから録音を始めます（`pendingTurn`）。

待つのは **`setupComplete` まで**（`netLink.wsReady()`）。WebSocketが繋がった時点では
Gemini側のsetupが終わっておらず、送った音声は捨てられます。最初のひと言が消える
という分かりにくい不具合になるため、ここを`wsConnected()`で済ませてはいけません。

### 焼き込み音声（起動アナウンス）

`src/VoiceClips.h`（自動生成・コミット対象）に 16kHz PCM を直接持っています。
サーバーに繋がる**前**や繋がらないときに鳴らす音なので、DO側のつなぎ言葉とは
別に、ファームのフラッシュに置く必要があります。

| クリップ | 鳴るとき |
|---|---|
| 「カタノリ、起動しました！」 | Wi-Fiに繋がって会話できる状態になった（電源1回につき1度だけ） |
| 「ワイファイの設定をしてください」 | 設定モードに入った（未設定・繋がらない・ボタン長押し） |

作り直しは backend 側のツールから行います（TTSのAPIキーがそちらにあるため）。

```bash
cd katanori-backend
node tools/gen-voice-clips.mjs   # VoiceClips.h を作り直す
node tools/preview-clips.mjs     # 焼く前にWAVで聴く
```

16kHzで持つ理由: 実機のI2Sは16kHz固定なので、24kHzのまま置くとマイコン側で
リサンプルが必要になり、そのまま流せば低く遅い声になります。フラッシュ消費は
16kHz 16bit モノラルで **1秒あたり32KB**（現在2クリップで108KB）。

再生後は必ず出力をミュートへ戻します（`pumpVoiceClip()`）。開けっ放しにすると
次のリセット時にROMブートログが轟音になります。キューが空になってから
250ms待ってから閉じるのは、I2Sドライバ内に残った送信待ちで語尾が切れるのを
防ぐためです。

### VAD計測モード

`vad` で開始。音声はどこにも送らず、有声区間の回数・長さ・音量だけを数えます。

| 入力 | 内容 |
|---|---|
| `vad` | 計測の開始/終了 |
| `me` | 以降の声を【自分】/【周囲】で切り替える（正解ラベル） |
| `vadme` | 自分の声を4秒測ってゲートを自動設定 |
| `vadth <RMS>` | ゲートを直接指定（0で自動） |

計測中はBOOTボタンもラベル用（押しているあいだ【自分】）になり、会話・設定モードは動きません。

呼び名をクラウドの whisper で聞き分ける方式を検証するために作った（2026-09-21 に捨てた。
docs/WAKEUP.md の「却下したもの」）。今の呼び名は機体の中で聞き分ける（src/MicroWake.h）。
VAD の検出線は、合図の音を鳴らす時と、会話の頭の無音詰めにまだ使っている。

**実測で分かったこと（2026-07-26）**

- **絶対音量は当てにならない。倍率で見ること。** 騒音床が 38〜469 と12倍も動いた
  （ReSpeaker側の自動音量調整）。一方で倍率は安定していて、
  装着者の声が床の15〜58倍、隣にいる家族の声が4〜10倍。
- **長さでは分けられない。** 装着者の5秒の発話と家族の0.2秒の相槌が、
  長さの判定では逆に出る。「呼びかけは短い」という仮定は捨てた。
- **騒音床は追従させないと固まる。** 起動時に1回測るだけの実装では、部屋が少し
  騒がしくなった時点で「発話中」のまま2分間無反応になった。静かなあいだ少しずつ
  更新し、10秒を超えた区間は打ち切って測り直す。
- **方向検知(DOA)はこの機体では使えない。** 4マイクの上位機(XVF3800)の機能で、
  ReSpeaker Lite(2マイク)には公式の記載がない。XMOSの制御ポート(0x42)も
  この機体のI2Cスキャンには出ず、用意されているのはDFUと設定用のみ。
  I2Sから来るのは処理済みの音声で、生のマイク2本ではないため自前計算もできない。
- **代わりに低域比（近接効果）を試している。** 口が近いほど低域が持ち上がる。
  距離で決まる物理現象なので「遠くの大声」に騙されない。XMOSのノイズ抑制で
  低域が削られていると使えないので、実測で判断する。**ここが未検証。**

### 設計上の注意

- ESP32 は **2.4GHz帯のみ**です。5GHz専用のSSIDには接続できません。

### TLS証明書の検証

`beginSslWithCA()` でルート証明書を検証しています（`src/RootCa.h`）。
検証あり/なしで接続時間は 0.85秒 → 1.7秒。

2026-07-26 時点の実チェーンから抽出した2つを信頼アンカーにしています。

```
leaf : tobira-sys.workers.dev
  <- Google Trust Services WE1   (中間)
  <- GTS Root R4                 ← 埋め込み
  <- GlobalSign Root CA          ← 埋め込み
```

PEMは連結して渡せるので、クロス署名が外れても片方で検証が成立します。

**ピン留めの宿命**: 接続先が発行元CAを変更するとこの機器は繋がらなくなります。しかも
「TLS検証に失敗した」とは表に出ず、ただ繋がらないだけになります。そのため
**一度も接続できないまま切断された場合はログでCA更新の可能性を示唆**します。

更新手順は `src/RootCa.h` のコメント参照。緊急避難は `-DKATANORI_TLS_INSECURE=1`
（常用しないこと）。

**限界**: `arduino-esp32 2.0.17` は `CONFIG_MBEDTLS_HAVE_TIME_DATE` が無効なため、
**証明書の有効期限は検証されません**。中間者攻撃は防げますが、期限切れ・失効した証明書を
弾く効果はありません。変えるにはフレームワークの再ビルドが必要です。
副作用として、SNTPによる時刻同期なしで検証が通ります。

## Stage 3: 音声

DO の PCMモード（`?pcm=16000`）に繋ぐため、ESP32 側は base64 も JSON 組み立ても
リサンプルも行いません。**生PCMを読んで送る / 受け取って書く**だけです。

### ReSpeaker Lite との I2S 結線（実機で確定）

XIAO は ReSpeaker Lite に直挿しなので配線作業は不要です。ピンは Seeed公式の I2S サンプル
（`I2S.setPins(8, 7, 43, 44)`）と同じですが、**クロックの向きとスロット幅は公式サンプルと
違いました**。実機での総当たり（`scan2`）で確定させた値がこれです。

| 項目 | 当初の実装 | 正解 |
|---|---|---|
| クロック | ESP32がマスタ | **ESP32はスレーブ**（XMOSがマスタ） |
| スロット幅 | 16bit | **32bit**（データは上位16bit） |
| フォーマット | 標準I2S | 標準I2S（これは合っていた） |

総当たりの実測値:

| 設定 | フレーム/秒 | 無音時RMS | 判定 |
|---|---|---|---|
| MASTER 各種 | 16k〜17k | 17155〜17880 | 全滅（自分のクロックで無意味なビットを読むだけ） |
| SLAVE I2S 16bit | 32,427 | 239.9 | 静かだが**レートが2倍**（32bitスロットを2回に割っている） |
| SLAVE I2S 32bit | **16,213** | 256.2 | **正解** |
| SLAVE MSB | — | 23000超 | 全滅 |

**RMSだけで判断してはいけません。** 一様乱数のRMSは 32768/√3 ≒ 18918 で、これに近い値は
音声ではありません。逆に静かに見えても実測フレームレートが 16kHz から外れていれば
スロット幅が合っていません。`scan2` はこの両方を見て選びます。

| 信号 | GPIO | XIAOピン | 向き |
|---|---|---|---|
| BCLK | 8 | D9 | |
| WS / LRCLK | 7 | D8 | |
| DOUT | 43 | D6 | ESP32 → ReSpeaker（スピーカー） |
| DIN | 44 | D7 | ReSpeaker → ESP32（マイク） |
| MCLK | 9 | D10 | 公式サンプルが未使用のため既定では出さない |

**I2C(D4/D5) とは衝突しません。** OLEDと共存できます。

フォーマットは **16kHz / 16bit / ステレオ**。マイクはステレオで届くので ch0 を使い、
スピーカーへはモノラルを左右へ複製して書きます。

### 会話の手順

```
wifi      # Wi-Fi接続
c         # DOへ接続
1         # 話し始める（録音してDOへ送る）
          # ... 喋る ...
2         # 話し終わる（audioStreamEnd を送る）
```

BOOTボタンでも `1`/`2` を交互に切り替えられます。`au` で音声の状態を確認できます。

`clientContent` + `turnComplete` ではなく **`audioStreamEnd`** を使うこと。VADが発話中と
認識していると前者は無視されてハングします（`wrapper.py` で確定済みの知見）。

### 🔴 再生中の残留（2026-09-21・未決着）

**ロボットが喋っている間、マイクにその声が残る。** Gemini がそれを「人が喋った」と
見なして、始めたばかりの応答を割り込みとして捨てる。会話1ターンごとに起きる。

実測（同じ RMS の計算で並べたもの）:

| 条件 | 件数 | 最小 | 中央 | 9割 | 最大 |
|---|---|---|---|---|---|
| 鳴らしていないとき（部屋の音） | 66 | 0 | **49** | 541 | 1169 |
| 再生中 | 13 | 26 | **1379** | 9172 | 9288 |

中央値で **28倍**。部屋の音ではなく、確かにロボットの声である。
比較のために、人の声は 1m で RMS 1880〜2632（docs/WAKEUP.md 付録D）。**重なる。**

🔴 **音量に依存しない。** つまみを変えて測ったが、残留は動かなかった。

| つまみ | 件数 | 最小 | 中央 | 最大 |
|---|---|---|---|---|
| 9% | 22 | 400 | 1385 | 8612 |
| 21% | 23 | 58 | 1522 | 8497 |
| 30% | 56 | 344 | 1363 | 5738 |
| 40% | 25 | 257 | 1403 | 5036 |
| 50% | 20 | 338 | 1689 | 5755 |

⚠ **音響エコーだけでは説明が付かない。** スピーカーから出た音が回っているなら
音量に比例するはずである。9% まで下げても中央 1385・最大 8612 で、連動していない。
🔒 ユーザー 2026-09-21「消える可能性は低いだろうね。１０％で起きてるんだもの」。

⬜ **説明できる仮説はまだ無い。**
一度「GPIO43(DOUT) と GPIO44(DIN) が隣のピンなので、データ線から信号線への
クロストーク」と書いたが、**これは取り下げた**。DIN はデジタル入力で、数十mV 乗っても
0/1 の判定は変わらないので音が混じることにならない（化けるなら音が壊れて聞こえる）。
アナログ側の回り込み（アンプの数百mA が GND を揺らしてマイク入力に乗る）なら音は
混じるが、**それは音量に比例する**。どちらも実測と合わない。

#### 次の一手（1つだけ）

🔴 **XMOS のファームを v1.1.0 にして、ch0 の取り出し口から AGC を外す。**
（2026-09-21 に一次資料を読んで決めた。スピーカーを抜く実験より先にこれ）

**AGC が AEC の残留を押し戻している**という報告が、フォーラムと GitHub の両方にある。

- Seeed フォーラム「Respeaker Lite AEC support」の hamstie（2025-03-17）:
  「AEC は密な音楽の再生ではよく効くが、**発話だけの再生では効かない**。AGC が
  捕捉信号を増幅し、録音された声を最大レベルまで持ち上げる。AGC が強すぎて変更できない」
- respeaker/reSpeaker_Lite の Issue #9 のコメント（herve-clawd・**個人の投稿で Seeed の
  公式回答ではない**）: 「AEC は動いている。罠は **ch0 の工場出荷の既定が AGC タップ**
  （AEC+IC+NS+AGC のフルチェーン）で、最後の AGC が小さな残留を聞こえるレベルまで
  押し戻すこと。ch0 を NS タップ（AGC なし）に下げるとエコーはほぼ消える」

katanori が再生するのは**まさに発話**である。AGC は一定レベルまで持ち上げるので、
**残留が音量に依存しない**ことの説明にもなる（実測がそうだった）。騒音床が 38〜641 と
12倍動くのも同じ AGC の仕業である。

##### 取り出し口（タップ点）の触り方

XMOS Command Transport Protocol、I2C `0x42`、RESID `0xF1`（Configuration service）。

| cmd | 対象 |
|---|---|
| `0x30` | ch0 の取り出し口 |
| `0x40` | ch1 の取り出し口 |

| 値 | 取り出し口 |
|---|---|
| 0 | 生マイク |
| 1 | AEC |
| 2 | AEC + IC（2マイクのビームフォーム） |
| 3 | **AEC + IC + NS（AGC なし）** ← ここへ下げたい |
| 4 | AEC + IC + NS + AGC ← ch0 の既定 |

⚠ XMOS のフラッシュに残る。焼き直しでは戻らない。

##### 🔴 v1.0.8 には無い（実機で確認・2026-09-21）

シリアル `tap` で読める。

```
ファーム版数        v1.0.8       ← 通信は正常
VNR値(0-100)      3             ← 読めている
ミュート状態        status=2      ← 公式が「v1.0.9 以降が必要」と書いているコマンド
ch0 取り出し口      status=3      ← 受け付けられない
ch1 取り出し口      status=3
```

版数と VNR が読めるので I2C は生きている。status が返るのは**そのコマンドが
この版に無い**ためで、Issue #9 のコメントは **v1.1.0 ch0-asr_ch1-mww** での話だった。

⚠ **読み出しの書式を間違えると status=2 で弾かれる。** 公式の例
（`xiao_esp32s3_arduino_examples/xiao_i2c_get_register_value`）に合わせること:
`cmd|0x80` は**付けない**／要求するバイト数は「欲しい数＋1」（先頭が status）／
`endTransmission()` は通常終了で repeated start にしない。

##### v1.0.9 では直らない

changelog（公式）:

```
v1.0.9: DAC 出力ゲインの既定を 0dB → -2dB、i2c で mute_status を読めるように
v1.0.8: 新しいフラッシュ ZB25VQ32D 対応
v1.0.7: i2c でスピーカーのミュートと出力チャンネルを制御
v1.0.6: PRODUCT_STR を変更、ws2812 のバグ修正
v1.0.5: i2c で vnr を読めるように
```

**AGC とタップ点に関する変更が1つも無い。**

##### 書き込みの道は2つ。⭐ B を採る

公式の `dfu_guide.md` によると、dfu-util からは3つの領域が見える。

```
alt=0, name="DFU FACTORY"
alt=1, name="DFU UPGRADE"        ← 公式手順が使うのはここ（dfu-util -R -e -a 1 -D <bin>）
alt=2, name="DFU DATAPARTITION"
```

| | 中身 | 判断 |
|---|---|---|
| A | 16kHz の v1.1.0（**factory** 版）を `-a 0` に書く | ❌ レート変換は要らないが、**公式手順に無い操作**。factory は工場出荷の復帰用で、壊した場合に戻せる保証が無い |
| B | 48kHz の v1.1.0（**DFU** 版）を `-a 1` に書く | ⭐ **公式手順どおり。** 代わりに ESP32 側で 48k↔16k の変換が要るが **3:1 の整数比**なので、送りは3サンプル平均・再生は3倍に伸ばすだけ。DO 側のリサンプラは触らない |

16kHz の v1.1.0 が factory 版しか無いのは 2026-07-26 に調べた通り
（`respeaker_lite_i2s_factory_firmware_v1.1.0_ch0-asr_ch1-mww.bin`）。

##### 手順

1. **ReSpeaker の USB-C ポート**（3.5mm ジャック寄り。XIAO 側ではない）を PC へ繋ぐ
   → 筐体を開ける必要がある
2. `dfu-util -l` で 3 領域が見えるか確認（見えなければ Zadig で WINUSB を入れる）
3. `dfu-util -R -e -a 1 -D respeaker_lite_i2s_dfu_firmware_48k_v1.1.0_ch0-asr_ch1-mww.bin`
4. 機体のファームを 48kHz 用の env で焼く（**2026-09-21 に用意済み**）

   ```
   pio run -e xiao_esp32s3_48k -t upload --upload-port COM5
   ```

   48k↔16k の変換は `AudioIo` の中だけ。`readMic()` が 3 サンプルの平均を 1 つに
   落とし、`writeMono()` が 1 つを 3 つへ線形に伸ばす。**呼び出し側（main.cpp /
   NetLink / WakeWatch / DO）は無改造**で、いままで通り 16kHz を渡し受けする。
   16kHz の env（`xiao_esp32s3`）では比が 1 になり、変換はコンパイル時に消える。

5. シリアル `tap` で ch0 を読む（**4** のはず）。読めれば Issue #9 の情報が当たり
6. `tap 3` で AGC を外し、`[QUIET]`／`[ECHO]` を測り直す
7. 効かなければ v1.0.9（16kHz・DFU）へ戻し、env も `xiao_esp32s3` に戻す

⚠ **ファームと env は必ず揃える。** 食い違うと音が 3倍速か 3分の1 の速さになる。

⚠ 間引きは 3 サンプルの平均で、8kHz あたりの落ちは -6dB ほどしかない。折り返しが
文字起こしに響くようなら FIR に替える（`AudioIo::readMic` のコメント）。

⚠ **AGC を切ると全体の音量が下がる。** 小さい音を持ち上げる働きも無くなるので、
VAD の検出線・ゲート・呼びかけの距離は測り直しになる（docs/WAKEUP.md 付録D/E）。

##### 参考にした一次資料

- `https://github.com/respeaker/reSpeaker_Lite` — ファーム一覧・I2C プロトコル・Arduino の例
- `https://github.com/respeaker/reSpeaker_Lite/blob/master/xmos_firmwares/changelog.md`
- `https://github.com/respeaker/reSpeaker_Lite/blob/master/xmos_firmwares/dfu_guide.md`
- `https://github.com/respeaker/reSpeaker_Lite/issues/9` — タップ点の話（⚠ 個人の投稿）
- `https://github.com/respeaker/reSpeaker_Lite/issues/5` — 「レジスタマップを公開してほしい」（未回答）
- `https://forum.seeedstudio.com/t/respeaker-lite-aec-support/283114` — AGC が強すぎる報告、
  スピーカーの周波数特性（イコライザ付きは AEC を壊す）、USB 版 v2.0.5〜2.0.7 の不具合報告

##### スピーカーの選び方（Seeed の中の人・2025-04-01）

> スピーカーの周波数特性が AEC の結果に大きく影響する。イコライザが付いていると
> 出る音が参照チャンネルと食い違い、AEC が打ち消せない。**平坦な特性で内蔵アンプの
> 無いスピーカー**を選び、JST2.0 で ReSpeaker Lite に繋ぐのが良い。

#### 次の一手のあと（音響側の切り分け）

**スピーカーの端子（PH2.0）を抜いて、同じ測定をする。** 音は出ないが I2S には
同じデータが流れる。

- **抜いても残留が出る** → 配線の回り込み。XMOS の AEC より後なので原理的に消せない。
  自作の音声基板で DOUT/DIN の引き回しを決める
- **抜いたら消える** → 音響エコー。スピーカーの位置・向き・筐体の遮音で対処する

🔒 **ソフトで引く道は採らない**（2026-09-21 ユーザー「それだとこの基盤つかってる意味がない」）。
ESP32 は自分が送った音を持っているので後段で打ち消すことは原理的に可能だが、それは
「音声を専用ハードウェアでやる」という独自性（[ARCHITECTURE.md](../../docs/ARCHITECTURE.md)）を
崩す。**ハード側で決着させる。**

#### この件で外した説明（同じ道を通らないために残す）

いずれも 2026-09-21 に実測で否定された。

| 説明 | なぜ違うか |
|---|---|
| ミュート解除のポップが原因 | 音量レジスタを 8段24ms のフェードにしても残った（フェード自体は正しいので残置） |
| AEC の収束に 0.3〜0.6秒かかる | 残留は再生の全期間で上下していた。立ち上がりだけではない |
| アンプの飽和 | 音量を 9% まで下げても残留が変わらない |
| ReSpeaker Lite はスピーカーが離れた機器向け | **一次資料で確認していない。根拠のない話だった** |

#### 入れた対策（残留そのものは直っていない）

- **つまみが ON のあいだ、コーデックのミュートを開け閉めしない**（`pumpOutputGate`）。
  会話ごとに閉めていたのは、ミュートリレーが入る前（2026-08-05 頃）の対策が
  見直されずに残っていたもの。起動時の ROM ブートログの轟音は、リレーの
  10kΩ プルダウンがファーム停止中に接点を開いて担保している
- **再生開始から 600ms は送らず、そのあとは RMS 1000 を超えた音だけ送る**（`pumpMic`）。
  ⚠ 残留が 9288 まで出るので、これでは塞ぎきれていない。暫定である
- 会話が終わってから **1.5秒** 置いて見張りを始める（`kWatchAfterPlayMs`）

### 設計上の注意（いずれも実機で踏んだ問題）

- **バイナリフレームは無条件に音声として扱う。** 中身を覗いて振り分けてはいけない。
  PCMデータの先頭バイトがたまたま `{` (0x7B) になることは256分の1で起きる。実機で
  1フレーム誤判定して音が欠けた。制御は必ずテキストで来ることをDO側で保証している。
- **音声フレームは4KB以下**である必要がある。`links2004/WebSockets` は
  `WEBSOCKETS_MAX_DATA_SIZE = 15KB` 超を受け取ると中身を読まず `close(1009)` する。
  DO側で刻んでいる。「文字起こしは届くが音声が来ずに切断」という症状で発現した。
- **受信中は描画を間引く。** OLEDの全面転送は約29msブロックする。20FPSのままだと
  時間の6割を描画に取られ、`ws.loop()` が呼ばれず受信を落とす。再生中は8FPSへ落とし、
  `ws.loop()` は1周あたり8回まわす。
- **再生は専用タスク + リングバッファ**で行う。Gemini は応答音声を実時間よりずっと速く
  まとめて送ってくるため、受信した場所から直接 `i2s_write` すると DMA が空くまで
  ブロックして OLED の描画が止まる。
- **送るものが無くても無音を書き続ける。** TXを止めるとDMAが枯渇し、条件によっては
  直前の内容を繰り返して大音量のノイズになる。
- 再生バッファは **PSRAM があれば 512KB（16秒）**、無ければ 48KB（1.5秒）に縮小する。
- **エコーガード**: 再生中はマイクを送らない。送ると自分の声で Gemini が割り込み判定して
  会話が破綻する。ReSpeaker Lite のハードウェアAECが効けば不要になるはずの暫定措置。
- マイク読み出しは**タイムアウト0の非ブロッキング**。描画を止めないため。
- **出力は音量を絞る（既定35%）。** ReSpeaker Lite の出力はアンプ経由。イヤホンを直結すると
  非常に大きな音になるため、耳に着けたままテストしないこと。

### 顔と会話の同期

`StateMachine` は IDLE→LISTEN→THINK→SPEAK の一本道で途中を飛ばせない。一方 Gemini は
自前のVADで勝手にターンを進めるため状態が食い違う（LISTENが10秒でタイムアウトしてIDLEに
戻った後に応答音声が届く、など）。`driveTo()` で必要なイベントを順に注入して追いつかせる。

| Geminiからの通知 | 顔 |
|---|---|
| `speechState: SPEECH` | LISTEN |
| `speechState: NON_SPEECH` | THINK |
| 音声フレーム到着 | SPEAK |
| 再生完了 + turnComplete | IDLE |

**実用上、`2`(audioStreamEnd) を押す必要はない。** Gemini のVADが発話終了を検知して応答を
始める。`1` で録音を開始すれば、あとは自然に会話が続く。

### ReSpeaker Lite のファームウェア

ReSpeaker Lite には **I2S版と USB版**のファームがあり、**USB版では I2S から音が出ません**。

USBオーディオデバイスとして Windows に現れるかどうかで判別できます（現れなければ I2S版）。
確実に確認するには XMOS側のUSB-Cポート（3.5mmジャック寄り）を繋いで `dfu-util -l`。
Windowsではドライバが当たっていないため Zadig で WinUSB を入れる必要があります。

```bash
dfu-util -R -e -a 1 -D respeaker_lite_i2s_dfu_firmware_v1.0.9.bin
```

**`ch0-asr/ch1-mww` ファームについての訂正**（2026-07-26に一次情報で確認）:

`v1.1.0_ch0-asr_ch1-mww` という派生ファームは存在するが、**ウェイクワードを検出しない**。
ch1は「外部のMicro Wake Wordエンジンに向いた処理をした音声」を出すだけで、判定そのものは
ESP32側でやる必要がある（ESPHomeの microWakeWord コンポーネント用という位置づけ）。
「載せ替えれば自前のTinyMLが不要になる」というのは誤り。

### 2026-08-02: XMOS が起動しなくなった（音声全滅）

つまみのAS5600ファームを書き込んだ日の午後、**XMOS (XU316) が起動しなくなった。**
ESP32はI2Sスレーブでクロックは全部XMOSから来るため、音の入出力が全滅している。

**症状と証拠**（どれも単独で再確認できる）:

| 見たもの | 結果 | 意味 |
|---|---|---|
| `au` | 再生キューが溜まったまま**再生済み0サンプル** | I2Sが1バイトも流れていない |
| `scan2` | SLAVE全設定で**0フレーム**、MASTER読みは常にFFFF | BCLK/WSもDIN(マイク)も来ていない |
| `v8` / `v9` | WS(D8)=0mV / BCLK(D9)=0mV | クロック線が物理的に沈黙 |
| `creg`（電源再投入後） | P0 0x3F=**0x14（AIC3204の初期値）** | **XMOSが起動時のコーデック設定を書いていない** |
| XMOS側USB-CをPCへ | **列挙されない**（過去はVID_2886&PID_0019が見えた記録あり） | XMOSのUSBスタックも動いていない |

**切り分けで消したもの**（⚠ ここで消せたのは「**今の症状を維持している要因**」だけ。
「**壊した原因**」の免罪ではない — 作業中に壊れたものは配線を抜いても直らないため、
最小構成テストは原因の切り分けにならない。2026-08-02 訂正）:

- **給電構成ではない** — XIAO側給電・XMOS側給電・両方給電（バッテリー併用）すべてで同じ
- **治具の配線ではない** — AS5600の5本を全部抜いた最小構成・冷間起動でも 0x3F=0x14 のまま
- **ESP32側ソフトではない** — コーデック設定を書くのはXMOSで、その書き込み自体が無い
- **ケーブル/PCポートではない** — 同じケーブルでCOM3(XIAO)は正常に使えている

**原因は不明**。時系列の相関（ESP32ファーム書き込みリセットの轟音が最後の音）は事実で、
治具の配線作業時のダメージは**否定できていない**。偶発的な部品故障とも矛盾しない。
以前の記録が「ESP32側ソフトではない＝書き込み作業は無関係」と読める書き方だったのは
上記の混同によるもの。

> **「書き込みリセット中のI2Sバス競合」説は否定してよい（2026-08-03 調査）。**
> ROMブート／ダウンロードモードで **4本とも向きが変わらない** — DOUT(43)はESP32が出力
> （UART0 TXもESP32出力）、DIN(44)はESP32が入力（UART0 RXも入力）、WS(7)/BCLK(8)は
> ESP32が入力（リセット既定もI2Sスレーブ動作も入力）。ストラッピングピン(0/3/45/46)にも
> 当たらず、電圧も3.3Vロジックのまま。**書き込み動作がXMOSを電気的に叩く筋は薄い。**

**時系列**: 書き込み直前まで音は出ていた（書き込みリセット時にROMブートログの轟音が
出た＝その瞬間はXMOSがクロックを出していた証拠）。その轟音が最後の音。
因果は特定できていない（轟音はXMOSより下流で鳴るので、音自体がXMOSを壊す経路は
考えにくい。※「組立時の3V3-GND短絡の遅発」説は記録誤りにつき撤回 — 短絡は
実際には起きていない。ユーザー確認 2026-08-02）。

**2026-08-02 深夜の再検証**(冷間起動とUSB抜き挿し計7回+αで再現確認):

- **XMOSは完全沈黙ではなく「起動して0.5〜3秒で必ず死ぬ」**。XMOS側USB-Cを挿すと
  VID_2886&PID_0019 が列挙されるが、0.5秒または2.5〜3秒で切断する(7回中7回死亡、
  生存時間はこの2グループに分かれる)。データ線のある別ケーブルでも同じ
- **死ぬまでの進み方が毎回違う**。事故時と再検証初回の冷間起動はコーデック全初期値
  (0x3F=0x14)のままだったが、別の冷間起動では**コーデック初期化の大半を完走**していた
  (P0 0x1B=0x30, P1 0x09=0x3C, 出力経路0x08。DAC電源ONの手前で死亡)
- **抜き挿しを繰り返すと悪化する**(後半は3連続で0.5秒側)。固定点で死ぬファームの
  バグではなく、マージナルなハード(はんだクラック・電源レール・シリコン損傷)の振る舞い。
  なお**基板は無改造・短絡事故も無し**(ユーザー確認 2026-08-02。過去記録の
  「はんだブリッジ」「3V3-GND短絡」はどちらも誤記録)
- 落ちた後は挿しっぱなしでも自然に再列挙しない(ブートループではない)

**復旧手段は無い**: ReSpeaker Lite に Safe Mode・リカバリピン等の公式手順は存在せず、
DFUはUSB列挙が前提。列挙は最長3秒でドライバのバインドすら間に合わず、ソフトからは
触れない(JTAGで触るにはxTAGが要る)。**ボード交換になる。**

**2026-08-05 追試で故障確定**（新ボード到着日に、動作実績のあるケーブルで再試験）:

- コーデック(0x18)が **I2CのACKすら返さない**（`[CODEC] 応答がありません`。
  新ボードでは同条件でレジスタ全読み出しに成功しており、環境差ではない）
- ESP32が `rst:0x15 (USB_UART_CHIP_RESET)` で**ブートループ**し、そのたびCDCが切れる
- **異常発熱**（ユーザーが触知して即座に抜電。発熱箇所の特定はしていない）

3つの独立した症状が揃い、**基板側の物理故障で確定**。以後この個体には通電しない。

⚠ **同日の教訓（切り分けを汚した2件）**: ①`VBUS`短絡らしき**不良USB-Cケーブル**が
ケーブル束に混ざっていた（何も繋がず挿すだけでPCが電源断×2。隔離済み）。
②PC側フロントUSB-Cポートも容疑が残る（ケーブル単独犯とは確定していない）。
**以後の作業は背面I/Oポート＋実績あるケーブルに固定。**
過去の切り分け記録のうち「別ケーブルでも同じ」は、この不良ケーブル混入により
信頼度が下がっている（ただし上記①〜③により故障の結論自体は揺るがない）。

**生きているもの**: ESP32(XIAO)・OLED・AS5600・I2Cバス全デバイス・つまみファーム一式。
つまみの角度→%→ゲインは実測合格済みで、耳での音量確認だけが保留
（[docs/KNOB-ENCODER.md](../../docs/KNOB-ENCODER.md)）。

**次のボードで必ずやること**（**新しいXIAOを使うと決定** 2026-08-03。
NVSが空なので初期設定は一式やり直し。旧XIAOは設定ごと予備として保管）:

1. **ファームをUSBで初回焼き**（`pio run -e xiao_esp32s3 -t upload`。
   OTA待受を載せるまではWi-Fi書き込み不可）
2. **Wi-Fi設定**（起動時に自動で設定モードに入る。QRから、またはシリアルで `ssid`/`pass`）
3. **I2S版ファームか確認**（この節の冒頭。USBオーディオとしてPCに見えたらUSB版なので焼き替え）
4. ~~**Usr-D2 の導通**~~ → **不要になった（2026-08-03）。** Usrボタンは不採用で、
   独立したプッシュボタンに置き換える（上の「会話ボタン」の節）。部品が届くまでの
   あいだ手元で会話を始めたいときは、XIAOのBOOTボタンで代用できる
5. シルクを読んでから挿す・初回は `s` で全アドレスが出るまで疑う（OLED/AS5600で2例あり）
6. **`knobzero` 取り直し**（ゼロ点は新XIAOのNVSには無い）→ 治具で 0/¼/½/¾/最大 の単調確認
7. 保留中の**耳確認**: `beep2` を ¼ と 最大 の2点で（これでAS5600移行が完了）

### 🔒 2026-08-05 の結論: ハードは全部正常。**本体ファームがI2Sを潰している**

**最小ファーム [../i2sprobe/](../i2sprobe/) で、新ボードのI2Sが完全に動くことを確認した。**

```
WS  (GPIO7/D8) : エッジ 1600回/50ms = 32000エッジ/秒 = ちょうど 16kHz
I2S読み出し     : 8192 frames / 500ms = 16384 fps（Git記録の正解値 16213 fps と一致）
peak            : 841 → 1361 → 5503 と毎回変化 = マイクが実際に音を拾っている
```

RXのみ/TX+RX、32bit/16bit、どの設定でも読めた。**基板・XMOS・I2Sの4本・マイクは
すべて正常。** 一方、本体ファーム(`firmware/esp32`)では同じ設定・同じピン・同じ
レガシードライバで **`mic` が0フレーム**。差は本体側にしか無い。

**次にやること**: 最小ファームに、本体にしか無いものを**1つずつ**足して、
どれでI2Sが死ぬかを特定する。容疑者は Wi-Fi ／ OLEDのI2C転送 ／ 再生タスク ／ つまみ。

> 🚫 **この日の誤診の記録（同じ穴を踏まないために）。**
> 「XMOSがクロックを出していない」と何度も断定したが、**全部誤り**だった。
> 根拠にした観測が3つとも無効だったため:
>
> | 使った証拠 | なぜ無効だったか |
> |---|---|
> | `vN` が 0mV | `analogReadMilliVolts()` の**1回きりの瞬時サンプル**。MHz級の方形波はLOWの瞬間を引けば0mVになる。クロックの有無の証拠にならない |
> | `mic` が0フレーム | **本体ファームのI2Sドライバ経由**。故障している当のものを通して測っていた |
> | `scan2` が SLAVE全滅・MASTER採用 | 同上。しかもMASTERは自分でクロックを作るので**常にフレームが来る**（Git記録に「MASTER各種 -> rms 17000超」と既にあった）。`FFFF`固定を「rms最小＝正解」と判定した出力を鵜呑みにした |
>
> **教訓: 疑っている経路を通した測定は証拠にならない。** 独立した経路
> （この件ではGPIOを直接叩く最小ファーム）を1つ用意するまで、原因を断定しない。

### 新ボード 1日目の結果（2026-08-05）— 1と3の途中で停止

**この個体も基板シルクは V1.1**（✅ ユーザー写真で確認。旧ボードと同版）。
XIAOは工場実装で基板と一体（この個体で追加のはんだ付けをした箇所はXIAO接合部ではない）。

**通ったもの:**

| 項目 | 結果 |
|---|---|
| 1. USB初回焼き | ✅ `pio run -e xiao_esp32s3 -t upload` 成功（1.2MB・25秒・ハッシュ検証OK）。COM4 (`VID_303A`, MAC `A4:CB:8F:DF:C2:E0`) |
| I2C | ✅ `0x18` 応答。`creg` 全レジスタ読み出し可（旧ボードはACKすら返さない） |
| XMOSの起動 | ✅ **一度は初期化を完走**。`P0 0x3F=0xD4`（DAC電源ON）を観測 |
| 発熱 | ✅ 無し |

**止まっているもの — 🔴 I2Sのクロックが1本も来ない:**

- `mic` が **0フレーム**（読み出し51回中 空51回）。`v8`(WS)/`v9`(BCLK) とも **0mV**
- `g8`/`g9` は HIGH＝浮いている（GNDへの短絡は**無い**）
- `g4`/`g5`（I2C・動作中）を対照に取っており、測り方は正しい
- **`0x3F` が 0xD4 → 0x14 に落ちて戻らない**（`0x1B`=0x30 と P1 `0x09`=0x3C は保持
  されたままなので、コーデックの全リセットではない）
- ⚠ `0x3F` が 0xD4 だったときも `mic` は0フレーム。**クロック不在はDAC電源では説明できない**

**潰した仮説**（同日中に検証済み。蒸し返さないこと）:

- ~~ファームの回帰~~ — 未コミット差分はOLED演出とつまみ表示のみ。I2Sには無関係
- ~~疑似電源OFF~~ — `knobdis` 後も0フレーム。つまみ未接続によるピン浮きは原因ではない
- ~~はんだ不良~~ — XIAO接合は**工場実装**。ユーザーのはんだ付け箇所ではない
- ~~D8/D9のGND短絡~~ — `g` テストで両方HIGH

**次にやること**: 3番（I2S版かUSB版か）の確定。ただし XMOS側USB-Cを
PCへ繋いでも**何も列挙されなかった**ため、`dfu-util -l` に到達できていない。
⚠ **「正常な個体がXMOS側USBで何を見せるか」のベースラインを我々は持っていない**
（記録にある `VID_2886&PID_0019` は、DFU書き込み時のものだった可能性がある）。
比較対象の健康な個体が無いまま、この列挙結果を故障の証拠に使わないこと。

### 🔒 2026-08-05 夜: 「I2S版かUSB版か」決着 — **I2S版 v1.0.8**。発熱は誤警報

**XMOSはI2Cアドレス `0x42` に制御インターフェースを持ち、版数が読める**
（公式例 `xiao_i2c_get_register_value.ino`。リソースID `0xF0`・コマンド `0xD8` →
ステータス1バイト＋版数3バイト）。USBケーブルもdfu-utilも不要だった。

```
0x18 ACK（コーデック） / 0x42 ACK（XMOS制御）
生バイト [00 01 00 08] → ステータス0・版数 1.0.8 = I2S版   ✅実測
```

読み取り専用ファームは [../xmosver/](../xmosver/)。**この先も版数・0x42生存確認の
診断手段として使える。** ⚠ v1.0.8 は 1.0.9 未満なので、ミュート状態の読み出し
（`0xF1`/`0x81`）はこの個体では使えない。更新（最新は1.1.0）は未実施・別判断。

**発熱の切り分け（同夜・実測）:**

| 状態 | 結果 |
|---|---|
| 探り針ファーム通電（前セッション） | 熱を感じて緊急停止（ReSpeaker側） |
| 空スケッチ [../blank/](../blank/) | 熱くない（ユーザー触知） |
| xmosver（I2Cのみ・約10分通電） | 「大丈夫」＝異常な熱なし（ユーザー触知） |

**結論: XU316の正常動作熱を、旧ボードの記憶で異常と読んだ可能性が最有力。**
I2S版確定により GPIO43(DOUT) の駆動は正規動作で、「ESP32のコードが線を焼く」
機構は成立しない（衝突説は棄却）。⚠探り針と同条件の並走比較まではしていない。

**残る本丸は変わらず**: 本体ファームだけ `mic` が0フレームになる問題（上の751節）。
探り針に本体の要素を1つずつ足す切り分けは中断したまま。

### 🔒 解決（2026-08-05深夜）: mic 0フレームの犯人は **D1(GPIO2) = XMOSのリセット線**

**この1行だった:**

```cpp
pinMode(KATANORI_KNOB_SW, INPUT_PULLUP);   // KATANORI_KNOB_SW = 2 (D1)
```

**D1(GPIO2) は基板内で XMOS のリセット線（アクティブHIGH）に繋がっている。**
根拠は2つ独立してある: ①ESPHome公式構成が `reset_pin: GPIO2` を使っている
②本体setupを二分探索で削り、この1行の有無だけで 0フレーム ⇔ 16384fps が
完全に再現・解消した（MIN_BOOTカット1〜6、全て実機）。

INPUT_PULLUP は弱プルアップでもHIGHに届き、**XMOSはリセットに押さえ込まれて
I2Sクロックが止まる**。ESP32を再起動するとプルアップが外れてXMOSは自動復帰する。

**これで全部の観測が1つに繋がる:**

| 観測 | 説明 |
|---|---|
| 本体ファームだけ0フレーム | プルアップを張るのは本体だけ。探り針・xmosver・blankは張らない |
| 新ボードだけで発症 | 旧ボードは連動スイッチが D1⇔GND に入っていて、ON位置=閉=LOW がXMOSを走らせていた。新ボードはスイッチ無し→HIGH→XMOS停止 |
| 「つまみを回すとコーデックが死ぬ」(旧) | 回す途中でスイッチが開く/接点が暴れると D1 がHIGH＝XMOSリセット。「ファーム経路と無関係に、回している最中に死ぬ」観測と一致 |
| `0x3F` が 0xD4→0x14 に落ちる | XMOSがリセットされ、コーデックが初期値に戻った |
| USB抜き差しで直る | 電源再投入でプルアップが消えている間にXMOSが起動し直す |

**対処（実装済み）:** `KATANORI_KNOB_SW` の既定を **-1（スイッチ無し）** にし、
GPIO2 への pinMode を封印。OFF判定はAS5600の角度閾値へ（元々の移行方針どおり）。
**GPIO2 には二度と pinMode しないこと。**

**同夜、実機で全経路開通:** mic 80384フレーム/5.02秒、Wi-Fi 1.4秒、
WebSocket→Gemini setupComplete、実会話（「聞こえますか?」→「はい、バッチリ
聞こえてますよ!」）→スピーカー再生まで確認。**音量は vol 30 で「大きすぎて
びっくりした」**（装着者基準では過大）— 既定ゲインを 0.15 に下げ、つまみ未接続時は
ADC読みを自動停止する変更をコード済み（⬜次回書き込みで反映）。

さらに **DFU版は48kHzのみ**（`respeaker_lite_i2s_dfu_firmware_48k_v1.1.0_ch0-asr_ch1-mww.bin`）。
現構成は16kHz（Geminiの入力仕様と一致）なので、載せるとマイク側と再生側の両方に
レート変換が必要になる。16kHzの ch0-asr/ch1-mww は factory firmware のみで、
DFUとは書き込み手順が違う。

結論: **ウェイクワードのためにこのファームを入れる必要はない**。判定はどうせESP32側なので、
まず既存の16kHz ch0 の音声で作る。ch1は「認識精度が上がるかもしれない改善案」であって
前提条件ではない。使うときは `KATANORI_MIC_CHANNEL` で切り替える。

## OTA: Wi-Fi経由のファーム更新（2026-08-03 実機確認済み）

筐体に封入した後もファームを直せるようにする仕組み（TODO 2章。優先2位だった）。
ArduinoOTA を使い、Wi-Fiが繋がると自動で待受が始まる。

```bash
pio run -e xiao_esp32s3_ota -t upload
```

- **初回だけはUSBで通常envを焼く**こと（OTA待受コードが乗っていない機体は受けられない）
- `katanori.local` が引けない環境では `platformio.ini` の `upload_port` を機体のIPに
  （IPはシリアルの `ota` で出る）。合言葉は `--auth=katanori`（`KATANORI_OTA_PASSWORD`）
- 転送は反対側のOTAスロット（default_8MB.csv の app0/app1、各3.3MB）へ書かれ、
  **MD5検証に通ってから起動先が切り替わる**。途中で切れても現行ファームのまま
- 転送中はOLEDに UPDATING と進捗バーが出る（**2026-08-03 目視確認済み**）。
  終わると自動再起動。※1度だけ「進捗が出なかった」回がある（シリアルには
  0→100%が出ていたのでコールバックは動いていた）。再現したら描画側を疑う
- シリアル: `ota`（状態表示）/ `otadis`（待受の無効/有効。計測中の誤爆防止用）

**届く条件に注意**: 疑似電源OFF（つまみOFF位置）では自動接続ごと止まるので**OTAも届かない**。
更新するときはつまみをONにしておく。卓上でつまみ未接続のときはピン浮きで疑似電源OFFに
入るため、先に `knobdis` を打つ（実機で2回踏んだ）。

実測（2026-08-03 深夜）: USB初回焼き → Wi-Fi越しに同一ファームを再送（63秒・約1.2MB）→
自動再起動 → 新スロットで起動 → 待受再開、まで一巡を確認。
遠隔（インターネット越し）の更新は未実装で、DOの認証（[TODO.md](../../docs/TODO.md) B-2）と合わせて設計する。

## Stage 4: Wi-Fiプロビジョニング

Wi-Fi未設定なら起動時に自動で設定モードへ入ります。手動なら `prov`、または
**ボタン長押しのメニュー →「WiFiせってい」**（2026-09-11 から。それまでは3秒長押しで直接入った）。
抜けるのは `provoff` か、設定モード中の長押し。

| 操作 | 動作 |
|---|---|
| 短押し（通常時） | 話し始め / 話し終わり |
| 短押し（設定モード中） | QR画面 ⇄ 文字画面 |
| 長押し（通常時） | メニュー（あかるさ・ねむるまで・きどうのこえ・WiFiせってい。main.cpp の「メニュー」の節） |
| 長押し（設定モード中） | 設定モードを抜ける |

### 画面

QRは Version2(25モジュール)を1モジュール2pxで 50×50px、上下7pxがクワイエットゾーン。
右の余白に文字を置きます。

**時間で自動切り替えしてはいけません。** QRの読み取りには数秒かかることがあり、
その最中に画面が変わると失敗します。ボタンによる手動切り替えにしてあります。
また**変化があったときだけ描き直します**。全面転送(約29ms)が読み取りの邪魔になるため。

0.96インチでは 4x6 / 5x7 ドットのフォントは実用になりませんでした（実機で確認）。
文字画面は全幅を使って 9x15 で描いています。

### 実装順序が重要

`Provisioning::begin()` の順序を間違えると **APがスマホのWi-Fi一覧に出ません**。

```
1. WiFi.disconnect()   STAの再接続を止める（チャンネルが動いてAPが安定しない）
2. refreshScan()       AP起動より先にスキャンを済ませる
3. WiFi.softAP()       最後にAPを立てる（チャンネル固定）
```

`WiFi.scanNetworks()` は数秒チャンネルを掃くため、**AP起動後に呼ぶとその間
ビーコンが止まり**、一覧に現れません。実機で踏みました。

### キャプティブポータルを自動で開かせる

- **302リダイレクトではなく「200 + ポータル本体」を返す。** AndroidもiOSも
  「期待した応答(204 や `<SUCCESS>`)が返ってこないこと」でポータルを判定する。
  リダイレクトだと端末によっては追随しない。
- **スキャン結果をキャッシュする。** 端末は検出用URLを何度も叩いてくる。その都度
  `WiFi.scanNetworks()`（1回数秒）を回すと、端末側のタイムアウトに間に合わない。
- 検出用の既知URL（`/generate_204`, `/hotspot-detect.html`, `/ncsi.txt` 等）も
  明示的に拾う。

### 承知のうえの弱点

設定用APは**開放（暗号化なし）でページもHTTP**です。入力されたWi-Fiパスワードは
設定中の数分間、近くの第三者から傍受されうる状態になります。市販IoT機器でも一般的な
方式ですが、弱点であることは変わりません。設定ページにも明記しています。

## 起動時の轟音とその対策

**ESP32-S3 の GPIO43 は UART0 の TX であり、この構成では I2S DOUT でもあります。**
リセット直後、ROMブートローダが 115200bps で吐くブートログがそのままオーディオとして
増幅され、耳を痛めるレベルの音になります。アプリが走る前の出来事なのでソフトでは防げません。

対策は **ESP32 がリセットされてもコーデックはリセットされない**（別電源）ことを利用します。

- ReSpeaker Lite の音声コーデック **TLV320AIC3204 (I2C 0x18)** を直接ミュートする
- **普段はミュート、鳴らすものがあるあいだだけ解除**。この状態がリセットをまたいで保持される
- DACデジタル音量を -63.5dB（page0 reg 0x41/0x42）とミュートビット（reg 0x40 D3/D2）の二段構え

### 開け閉めは1か所だけ（`pumpOutputGate()`）

`main.cpp` の `pumpOutputGate()` **だけ**がコーデックを開け閉めします。判断基準は
「再生キューに音があるか」の一点です。

以前は再生経路ごとに `setOutputMute()` を呼んでいました（応答再生・割り込み・
ターン終了）。経路が増えるたびに閉じ忘れの穴ができる作りで、起動アナウンスを
足した時点で**電源を入れるだけで自動的に開く経路**が生まれ、実際に事故になりました
（開いたまま電源を抜く → 次の起動でROMブートログが轟音）。

再生経路側でミュートを触らないこと。`announce()` のように「先にキューへ積んで、
開けるのはゲートに任せる」順にすれば、音が出ていないのに開いている時間も作らずに済みます。

手動の `unmute` はゲートを一時停止します（そうしないと鳴っていない状態として
すぐ閉じられ、スピーカー単独の切り分けができない）。**`mute` で必ず戻すこと。**
`beep` / `beep2` はスピーカー単独テストなので自分で解除します（ミュートの検証には
使えません）。

**残る穴**: 再生中にクラッシュ・電源断・リセットが起きると、解除された状態が残って
次の起動でROMブートログが流れます。ゲートは窓を「鳴っているあいだ」まで狭めますが、
ゼロにはできません。**この穴はスピーカー線のミュートリレーが塞ぐ**（下の節・2026-09-02 実機確認）。
リレーの無い卓上構成（ReSpeaker Lite 単体）では **喋っている最中に電源を抜かないこと** で避けます。

### 製品として置くなら、この穴は運用注意では塞げない（2026-08-03）— ✅ ミュートリレーで塞いだ（2026-09-02）

肩に載る＝耳道から数cm、装着者は高齢者。**「喋っている最中に電源を抜かない」を装着者に
要求することはできない**ので、製品ではこれは注意書きではなく**未解決の要求事項**です。

音圧の概算: 8Ω 2W に一般的な感度（85dB/W/m 前後）を仮定して 10cm で 105〜110dB SPL 台。
アンプは5Wまで出せる（[docs/POWER.md](../../docs/POWER.md)）。**感度が不明なので概算**ですが、
桁として「驚く音」ではなく「危ない音」の側です。高齢者では聴力被害より
**驚愕反応からの転倒**のほうが現実的な被害かもしれません。

稼働中に残るリセット経路:

| 経路 | ミュートされるか |
|---|---|
| OTA更新の再起動 | ✅ される（`ArduinoOTA.onStart` でミュート済み） |
| **電池切れ** | ❌ されない（下記。一番効く） |
| クラッシュ・例外 | ❌ パニック中にI2Cでコーデックを閉じる手段が現実的にない |
| ウォッチドッグ | ❌ 同上（2026-09-12 に 30 秒のウォッチドッグを入れた。リセットはハードなのでコーデックは閉じない。守るのはリレー） |
| シリアルの `reboot` / `R` | ✅ される（2026-08-03に `muteBeforeRestart()` を追加。実機で確かめた記録は無い） |

**電池切れが一番効く（2026-08-03・ユーザー指摘）。⚠ 以下は推定で、未実測。**
電池切れは*きれいな電源断ではなく電圧の垂れ下がり*なので、ESP32のブラウンアウト検出が
先に働き、**ESP32だけがリセットして、コーデックは生きたまま解除状態を保持する**
——書き込みリセットとまったく同じ条件が、フィールドで自然に発生します。昇圧ICが
復帰と停止を繰り返せば **爆音が1回で終わらない** 可能性もあります。
喋っている最中に電池が切れるのは、稀ではなく**いつか必ず起きます**。

**危険側に偏っているのが最悪の点**: ゲートが開いているのは喋っている最中だけで、
クラッシュしやすいのも電力を食うのも喋っている最中です。残った窓は危険な瞬間に開きます。

**🔒 決定（2026-08-03・ユーザー）: スピーカー線にミュートリレーを入れる。✅ 実装済み** — 駆動回路と接点の合格（2026-08-08）→ ハブ基板に実装（2026-08-18）→ スピーカー線で「閉→鳴る／開→鳴らない」を確認（2026-09-02）。ファーム側は `muteRelaySet()`（`D3` = GPIO4）。回路と開閉の順序は [docs/POWER.md](../../docs/POWER.md) 3章。

アンプ出力とスピーカーの間にリレーの接点を置き、**無通電で開**（ノーマルオープン）に
する。閉じるのはファームが起動し切ってから。**リレーが開いていれば、上の表の ❌ は
全部「スピーカーが物理的に切り離された状態」で起きます。** 守りがソフトの鎖から外れる。

成立条件（ノーマルオープン / **ラッチング禁止** / 閉じるのは `setup()` の最後 /
コイル電流 30〜50mA）と落ちた案は [docs/POWER.md](../../docs/POWER.md) に集約。

- **減衰器（スピーカー線に固定の抵抗分圧）は不採用。** フルスケールが安全な音圧に
  収まる減衰量まで削ると、肝心の声が聞こえなくなる。必要なのは音量を下げることでは
  なく**開閉すること**
- ⚠ **ウォッチドッグの整備はリレーより先にやらないこと。** 再起動を早める＝
  ミュートされない再起動を増やす方向にも働く（✅ この順で済んだ: リレー 2026-09-02 → ウォッチドッグ 2026-09-12）
- 常用音量の天井（[TODO.md](../../docs/TODO.md) A-3 の「音量の上限」）は
  リレーとは別の宿題として残る。数値の根拠は WHO-ITU H.870 / EN 50332（耳元機器の
  音圧上限）を一次資料で当たること

**検証方法（未実施）**: 可変電源で5Vをゆっくり落としながら再生し、GPIO43とスピーカーを
観測する。**必ずスピーカーを耳から離してから**。

### ROMログをeFuseで止める手（調査済み・2026-08-03）

ROMブートログはリセットのたびに **UART0 と USB Serial/JTAG の両方**へ出ます。
止めるeFuseはそれぞれ別です。

| 出口 | eFuse | この機体での役割 |
|---|---|---|
| UART0 = GPIO43 | `UART_PRINT_CONTROL` = 3 | 受け手はXMOSだけ。**読めない。鳴るだけ** |
| USB Serial/JTAG | `DIS_USB_SERIAL_JTAG_ROM_PRINT` | モニタで実際に読んでいるのはこちら |

`ARDUINO_USB_MODE=1`（USB Serial/JTAG）なので、シリアルで見ている `rst:0x1 (POWERON)` は
USB側の複製です。**`UART_PRINT_CONTROL` を焼いてもモニタの表示は残ります。**

- 焼いても影響しないもの: 書き込み（esptoolのコマンド応答で成立し、経路もUSB側）、
  アプリのログ（USB CDC）、2段目ブートローダ（`CONFIG_BOOTLOADER_LOG_LEVEL_NONE` で元から無言）
- **不可逆。** XIAO 1個ずつ手作業になる。GPIO46で切り替えられる値(1/2)は、
  XIAOのヘッダに GPIO46 が出ていない（D0〜D10 の11本のみ）ため使えず、実質 3 の一択
- 失うもの: **USBが死んだときの最後の診断経路**（GPIO43にUSB-TTLを当ててROMログを読む）。
  ReSpeaker LiteでUSBが死ぬのを実際に見ているので、絵空事ではない

**判断: 不採用（2026-08-03）。** ミュートリレーが入ればブート窓はスピーカーごと
切り離されるので、**不可逆な操作をしてまで焼く理由が無くなりました**。
そもそも消えるのは最大の音源であってゼロにはならず（リセット直後のピンの状態次第で
ポップは残る）、リレーの代わりにはなりません。

> リレーの前は「製品機だけ焼き、ベンチ機を1台残す」を検討していました。この調査を
> 残してあるのは、リレーが物理的に入らなかった場合の控えとしてです。

### モニタの開閉で再起動するのを止める

ネイティブUSB(USB-Serial-JTAG)は DTR/RTS の変化をリセットとして解釈します。
`platformio.ini` の `monitor_dtr = 0` / `monitor_rts = 0` で止まります。

## トラブルシューティング

| 症状 | 対処 |
|---|---|
| 画面が真っ暗 | まず `t` で自己診断。それも真っ暗なら配線側、パターンが出るなら転送側の問題 |
| `[I2C] no devices found` | SDA/SCL/VCC/GND の配線と OLED への給電を確認。ソフトの問題ではありません |
| `スキャンできませんでした (戻り値 -2)` | `WiFi.scanNetworks()` の負値は「APが無い」ではなく失敗。接続の再試行中はスキャンを開始できないので、先に `WiFi.disconnect()` する |
| 設定モードのAPが一覧に出ない | AP起動後にスキャンしていないか確認（上記の実装順序） |
| 書き込みのたびに轟音 | コーデックが解除されたまま電源が切れた状態。スピーカーを耳から離して一度起動すれば `setup()` 冒頭でミュートに戻る。`unmute` を打ったあとは必ず `mute` |
| 画像が横に2ピクセルずれる / 端が回り込む | コントローラが SSD1306 ではなく **SH1106** の可能性。`U8G2_SH1106_128X64_NONAME_F_HW_I2C` に差し替える |
| `0x3C` ではなく `0x3D` が見つかる | `platformio.ini` の `build_flags` に `-DKATANORI_OLED_ADDR=0x3D` を追加 |
| I2Cピンが違う | 同様に `-DKATANORI_I2C_SDA=<n> -DKATANORI_I2C_SCL=<n>` を追加 |
| 顔が8ピクセル単位で左右反転する | `-DKATANORI_DISPLAY_BIT_REVERSE=1` を追加（MSB/LSB順の差異を吸収） |
| `PSRAM が見えていません` | `board_build.arduino.memory_type = qio_opi` が効いているか確認。Stage 3 で必須 |
| シリアルに何も出ない | ネイティブUSBのため、モニタを開き直すか RESET を一度押す |

## Stage 3 に向けたメモ

- `Esp32Hal::getMicLevel()` は現在ダミーのLFO（`KATANORI_FAKE_MIC`）。I2S入力の実測ピークに差し替える。
- Gemini の応答は 24kHz、ReSpeaker Lite の I2S は 16kHz。**リサンプルは DO 側でやる**方が実機は楽。
- base64+JSON は ESP32 には重いため、DO にバイナリフレーム受け口を追加してから着手すること。
- スピーカー出力は ESP32 → I2S → ReSpeaker Lite の DAC 経由にする（AECを効かせるため）。

`main_esp32_skeleton.cpp` は移植前の参考コード（`#if 0`）で、`src/main.cpp` に置き換わっています。
