n416/katanori/hardware/ref/cad/README.md

# 公式 CAD（2026-09-06 に保存。何度もダウンロードし直していたので repo に置く）

| ファイル | 出どころ |
|---|---|
| ReSpeakerLitev1.1.step | Seeed ReSpeaker Lite の公式 STEP（Downloads にあった物）。XIAO は入っていない（部品名 60 個に XIAO/ESP 無し） |
| seeed-studio-xiao-esp32s3-3d_model.zip → xiao_3d/ | Seeed wiki xiao_esp32s3_getting_started の「3D Model」 |
| XIAO_ESP32S3_v1.1_Dimensioning.dxf | 同ページの 2D 寸法図（板 21 × 17.8） |
