n416/katanori/docs/CASE-V61N.md

# 筐体 v6.1n（ナイロン版）

🔴 2026-09-16 の引継ぎは [MECH-V61N-HANDOFF.md](MECH-V61N-HANDOFF.md)。いまの形の残っている欠陥（左の板の透き間）と次にやることはそこにある。

2026-09-15 起こし。**ファイルは v6.1 と同じ `hardware/case_v6_1.scad` で、切り替えは
その先頭の `MAT` 1 行**（🔒 ユーザー 2026-09-15「ナイロン版とレジン版があっていいんだよ。まさか・・・スイッチになってない？」、
2026-09-16「ナイロンとレジンは別パラメーターであるべきでは？でないと explode もそれに応じた形にできないのでは？」）。

```
part = "all";
MAT = "nylon";   // ← 既定は "nylon"（2026-09-16 ユーザー・現行は MJF）。"resin" にすると板 6 枚のレジン版。GUI・Customizer・CLI の -D MAT= のどれでも
```

`skin`・`all`・`explode` は MAT に追従する（nylon なら底パーツ＋蓋の 2 部品（8 章）。explode は底パーツを置いたまま、蓋は小組ごと上へ・PCB と電池は左の窓から外へ・ReSpeaker と OLED はライザーごと上へ）。

仕組み（2026-09-16）: case が `$mat = MAT;` を置き、`$` 付きの変数が呼び出しの連鎖を伝わる性質で `use` した部品
（つまみ・会話ボタン・スピーカー）の先頭の代入にも届く。部品ファイルは include の直後に `$mat = is_undef($mat) ? "resin" : $mat;` を持ち、
単体で開けば resin、`-D '$mat="nylon"'` で nylon、case から use されれば case の値になる。case の assert が食い違い（`-D $mat=` だけ渡した等）を捕まえる。
🔴 2026-09-15 までは `parts/mat.scad` の `MAT = "resin";` を書き換える方式だった（-D が use 先に届かないため）。書き出しスクリプトはその行を一時的に書き換えていたが、いまは -D で渡す。

部品側も同じ `nylon()` を読む: `parts/knob_v61.scad`・`parts/btn_v61.scad`・`parts/spk_v61.scad`
（前者 2 つは v5 と共用の knob_v5 / btn_v3 の写し。v5 は触らない）。

## 1. なぜ形が違うのか

v6.1（レジン）が板 6 枚なのは、**寝かせて刷る・反る・支柱の跡を面に出さない**の 3 つが理由だった。
MJF（粉の中で焼く）ではその 3 つが消えるので、**床＋4 壁を 1 部品、天板だけ蓋**にした。

~~中身を入れる口は上の 1 か所だけでよい。ReSpeaker と PCB はどちらも幅 82.02 で、箱の内寸との
余裕が左右合わせて 1.43mm しかなく、**上下からしか入らない**ため。~~
🔴 **これは間違いだった（2026-09-16・ユーザー「ナイロン組み立て不能では？」）。** 上からしか入れられない箱に対して、最後に横向きに動く物が
3 つあった（充電の USB-C・XIAO の USB-C・OLED のダボ）。床＋4 壁の一体シェルは組めない。直した形は 8 章。

つまみ・スピーカー・会話ボタンの小組は今までどおり天板の上で完結する（深さ 50 の箱の底から
工具を入れる作業にしない）。だから天面が蓋である必要がある。

## 2. 刷り分け

| 部品 | 材料 | 体積 | 理由 |
|---|---|---|---|
| 底パーツ（床＋前・後ろ・右の壁＋左の壁の帯） | MJF PA12 | 26.75cm³ | 大きい・反りと支柱が問題になる（8 章の分割・2026-09-16） |
| 蓋（天板＋左の板） | MJF PA12 | 17.41cm³ | 同上 |
| スピーカーのバスタブ | MJF PA12 | ― | 公差が要るのは六角だけ（呼び ＋0.5） |
| 会話ボタンの押し子・バスタブ | MJF PA12 | ― | 動く嵌めは片側 0.40 ＝ 直径 0.80 で MJF の下限 0.76 を満たす |
| つまみ一式（島・つまみ・軸） | MJF PA12 | 4.91cm³ | E リング 2 枚で公差を吸収する（下） |

**この表は MJF 版（v6.1n）の刷り分け。**🔴 2026-09-18 まで「全部 MJF。レジンで刷る部品は無い」と書いていたが誤り。
レジン版（板 6 枚）は生きていて、**形を調整するのはそちら**（🔒 ユーザー 2026-09-18「MJF 版はたしかに正式では
あるのですが、調整するのは別荘で刷ることのできるレジン版だからです」。作業場所は [[katanori-two-sites]]）。
大きい 2 部品で 44.2cm³ ≈ 44g（レジンの 6 枚は 61.3cm³ ≈ 67g）。

つまみが MJF に乗るのは 🔒 ユーザー案「軸を大きくしたうえで、溝も広げて 2 個入れればいい」による。
軸は 7 のまま（呼び 6 は軸 φ7 に溝 φ6 を切る規格どおりの組み合わせ）で、溝を 2 枚ぶんに広げた。
つまみ側で MJF に合わせて動かした数字は 3 つ:

| | レジン | MJF | 理由 |
|---|---|---|---|
| E リングの溝 | 幅 0.95・径 6.0・1 枚 | **幅 1.90・径 5.85・2 枚** | 幅は枚数で、径は狙いを 0.2 細くして安全側へ |
| 軸受けの遊び | 0.25 | **0.80** | 軸も島も ±0.3 に振れる。0.25 だと最悪 −0.35 で固着 |
| 磁石のポケット | φ4.10（圧入） | **φ4.50 ＋ 接着** | 4.10 だと細い側 3.8 で φ4 の磁石が入らない。入れて瞬間接着剤で留める |

## 3. MJF の数字（JLC3DP）

| | 値 | この設計での扱い |
|---|---|---|
| 最小肉厚 | 1.0mm | 板は全面 **1.6**（公差 ±0.3 で薄い側へ振れても 1.3） |
| 公差 | ±0.3mm（100mm 以内） | 下の嵌め合いに全部これを積む |
| 穴の公差 | ±0.3mm | 六角ポケットは 呼び ＋0.5 |
| 組む隙間 | 0.76mm 以上 | `FIT_SLIP` 0.1 → **0.8**・`FIT_BURN` 0.4 → **0**（初層が無い） |

刻印は彫り **0.8**（JLC3DP の指針 0.8 深）。裏に同じ 0.8 を足して刻印の下の壁を 1.6 に戻す（`lwall_icon_back`・輪郭は刻印を 0.8 太らせた形）。
ただし柄の端の裏はライザーの板（壁の内面から 0.306）に当たるので足さず、そこだけ残り **0.8**（⚠）。2026-09-19 まで 0.35 で、スパナが出ないと言われた。
レジンは 1.0 → **1.5**（透明で読める 1.0 ＋ 下向きの面の焼き込み最大 0.5。残り 0.5 で 0.4 を超えるので裏は足さない）。

## 4. レジン版との差分（一覧）

- 板を留めるための物を全部削除: 下の柱 4 本・耳 6 個・ハッチの足・床の座ぐり 5 か所。
  残るのは**天板を留める上の柱 4 本**だけ（筐体のねじ 9 本 → 4 本）
- ~~背面に**トグルの座** φ14 × 1.8（板 1.6 と合わせて 3.4）。M6 のナットは外側~~ ⭐ 2026-09-19 にトグルをやめ、座も穴も消えた。背面には PCB の電源の押しボタン SW2 のキャップの丸穴（φ7.1・世界 X 27.5・Z 15.23 ＝ USB-C の口の芯の高さ）。キャップ（φ6.6・鍔付き・顔に電源の記号）は**光造形で刷り**、PCB を入れる前に押し子へ差す（`part="look_pwrcap"`・`part="print_pwrcap"`）
- 右の壁の内面を 1.45 外へ（`RIGHT_CL` −1.2 → +0.25・2026-09-16）。ReSpeaker を真上から降ろすとき、右端の出っ張り
  （ジャックの筒 1.58・USB1 の殻 0.86）が壁に触れないため。~~XIAO の USB-C の殻は壁の内面より 1.22 外へ出るので、ReSpeaker を右へ寄せて降ろしてから左へ入れる道を作った~~
  🔴 2026-09-16 まで −0.4 で「道を作った」と書いていたが、USB1 の殻が壁に 0.95 食い込むので道になっていなかった。XIAO の口は 8 章の分割で解いた
- `xusb_shell_relief`（壁を上から降ろすとき殻が通る道）を削除。シェルでは壁が降りて来ない
- つまみ: **E リング 2 枚**（溝 0.95 → 1.90・径 6.0 → 5.85）
- 格子・支柱・ラフトは無し
- ~~リード＋トグルの線が 0.57mm³ 当たる（トグルが座のぶん 1.8 箱の中へ入ったため。レジンでは 0）~~ 実際に当たっていた相手は E リング 2 枚の下の面（Z 40.55）。2026-09-19 にトグルの線ごと消えた（hit_wires はナイロンも 2.20）

## 5. 検査（2026-09-15）

| | 値 | 意味 |
|---|---|---|
| seam_shell_top | 0.00 | 面が重なっているだけ（厚み 0.003） |
| plugpath | 空 | プラグの道は塞がっていない |
| hit_wires | 2.20mm³ | 赤がスピーカーの枠を 1.98・緑が電池の角を 0.22 |
| nutpath | 9.79mm³ | 組む順で解く（天板とスピーカーを先に机で組む）。⭐ 2026-09-18 に `nutpath_chk.py` へ組み直した（口 36／29・場面ごと・docs/SWEEP.md 10 章）。この行より下の nutpath の値は旧検査の物 |
| sk_rsp | 4.28mm³ | 天板が ReSpeaker を 0.3 押さえる設計どおりの当たり |
| sk_hub / sk_spktub / sk_tgl | 0.01 / 0.74 / 0.70 | 前者は USB-C の角、後ろ 2 つは接触面のかけら |
| シェル・天板の STL | 中身 1 個・宙から始まる肉 0・0.42 を割る面なし | |

🔒 **検査は材料で分ける（ユーザー 2026-09-15「レジン版とナイロン版はスイッチできるわけで、それに応じてアラートを分けて」）。**
`_stl_preflight.py` に `--mat resin|nylon` を入れた（道の名に `v61n` があれば自動で nylon）。
上の表は resin の判定（0.42）で見た結果で、**MJF の判定では下の 5.1 の 🔴 が出る**。

```
python hardware/tools/_stl_preflight.py "hardware/stl/v61n/*.stl"          # nylon（自動）
python hardware/tools/_stl_preflight.py "hardware/stl/v5/*.stl"            # resin（今までどおり）
```

| 判定 | resin（自分の機械） | nylon（JLC3DP の MJF） |
|---|---|---|
| 底 Z・接地・宙から始まる肉・急な立ち上がり | 見る | **見ない**（粉の中で焼く） |
| 薄い肉 | 0.30 未満を拾い 0.42 で 🔴 | 1.2 未満を拾い、**最薄 0.8 を割れば 🔴・壁 1.2 に届かなければ ⚠** |
| 中身の数 | プレートに着いていない塊を 🔴 | 入れ子の殻＝**閉じた空洞（粉が抜けない）を 🔴**、別の塊は ⚠ |
| 部品の大きさ | — | 5×5×5 か 10×2×2 未満を 🔴 |

数字の出どころ: 最薄 0.8・壁 1.2 は JLC3DP のアップロード画面（[PRINT.md](PRINT.md) 9.5・2026-09-12 に見た値）。
設計指針（jlc3dp.com/help/article/3d-printing-design-guideline）は 壁 1.0（5×5）〜2.0（100×100 以上）・
刻印 0.8 深 × 0.8 幅・穴 φ1.5 以上・動く隙間 0.6・粉抜き穴 φ2.5（3 未満なら 2 つ）・公差 ±0.3。
⚠ 3 章の「最小肉厚 1.0・組む隙間 0.76」はこれと少し違う（出どころが書いていない）。**厳しい側の 0.8 / 1.2 で判定している。**

### 5.1 MJF の判定で出た 🔴 と、その直し（2026-09-15・同日に全部直して 🔴 0）

書き出しは `python hardware/tools/stl_v61n.py`（7 点。case には `-D MAT="nylon"`、部品ファイルには `-D '$mat="nylon"'` を渡す）、当たり検査は同じ道具の `--check`（下の 5.2。`--resin-check` はレジンのまま）。直しはどれも `nylon()` の分岐で、レジンの形は変えていない（ザグリを開く 1 件だけ両方）。

| 部品 | 🔴 だった物 | 正体 | 直し |
|---|---|---|---|
| v61n_top | 0.60 × 18・0.69 × 30 | スピーカーのハニカムの肉 `S_HEX_WALL` 0.6（0.69 は 0.6/cos30）。PRINT.md 9.5 で 09-12 に「0.8 に」と書いた件 | `spk_v61.scad` `S_HEX_WALL` nylon() ? 1.0 : 0.6 |
| v61n_top | 0.50 × 1（16.8 × 3.0・つまみの後ろ） | **リードスイッチの穴の天井** `REED_TOP` −0.5（見える面の下の肉 0.5） | `knob_v61.scad` `REED_TOP` nylon() ? −1.0 : −0.5 |
| v61n_btn_tub | 先細り 0.25 × 2（X ±16.5） | ナットの溝ではなく、**縦ねじの頭のザグリ φ4.2 と耳の外面の間の肉**（芯 14.15 ＋ 2.1 ＝ 16.25 に対し外面 16.50） | `btn_v61.scad` ザグリを耳の外面へ開く（頭の座の床はそのまま。レジンでも同じ） |
| v61n_btn_tub | 0.55 × 2（底・X ±3.25） | **スイッチのねじのナットの座（六角 4.5・平面を下）の下の床**。ねじの芯 −12.14 − 2.25 − 底 −15.09 | `B3_SKIRT`（床の厚み）nylon() ? 1.3 : 0.8。底が 0.5 下がる（筐体の逃げは元から底の 1.0 下まで）。床 1.3・座の下 1.05 |
| v61n_btn_tub | 0.60 × 2（Y 3.65） | 同じナットの座の底と器の内面の肉（初回の一覧で見落とした） | `B3_WALL_YP` nylon() ? 3.2 : 2.8。器の中の芯 `B3_TUB_CY` は動かさない（それまで外形の中心に追従していた）。肉 0.6 → 1.0 |
| v61n_shell | 0.70 × 1（右の壁・Y 10〜13.5・Z 9〜18.5） | **ReSpeaker 自身の USB-C（USB1）の殻の盲ポケット** 0.9（殻が 0.6 入る） | `USB1_POCKET` nylon() ? 0.75 : 0.9（残り 0.85・逃げ 0.15）。壁を外へ動かす手は、充電の USB-C の口が外面の 0.8 裏より奥に落ちるので使えない |
| v61n_shell | 0.70 × 2（後ろの上の角） | **後ろの上の柱 2 本のナットの溝の両脇の肉**（柱 6.0 − 二面幅 4.6 ＝ 0.7 × 2） | `POST_W_TR` nylon() ? 6.6 : 6.0（後ろの上の柱だけ）。前の柱は OLED の板の端まで 0.3、下の柱は PCB の欠きが確定なので動かさない |

⚠（黄・壁 1.2 に届かない）は残っている。主な物: 前の壁の Y 4.60 の面 1.20（23 か所）、床の柱 4 本の下の 1.00（設計値どおり）、
USB1 のポケットの 0.85、会話ボタンのナットの座 1.0、天板の 0.80〜0.90 × 7。黄は向こうで止められない。

### 5.2 当たり検査（2026-09-15・直した後・`python hardware/tools/stl_v61n.py --check`）

| | 値 | 5 章の表との差 |
|---|---|---|
| seam_shell_top / plugpath / nutpath / sk_rsp / sk_hub / sk_spktub / sk_tgl / sk_btn / hit_btn | 0.00 / 空 / 9.79 / 4.28 / 0.01 / 0.74 / 0.70 / 0.00 / 空 | 同じ |
| hit_wires | **2.77** | 表は 2.20。差の 0.57 はトグルの線（X 63〜68・Y 32・Z 40.55〜40.74）の当たりで、3b1d72d の検算どおり「トグルが座のぶん 1.8 箱の中へ入ったため」。ナイロンだけ出る（レジンは 0）。コミット 97c4bc0 の筐体でも 2.77 で、表が古かった。線の道は直していない |

~~⬜ 刻印が JLC3DP の指針（0.8 深 × 0.8 幅）より浅い（`ICON_D` 0.35・壁 1.6）~~ ✅ 2026-09-19 に彫り 0.8 ＋ 裏の足し肉 0.8 にした（3 章）。柄の端のライザーの裏だけ残り 0.8

## 6. まだ決めていない・残っている

- ~~🔴 MJF の判定で出た 🔴 を直す~~ ✅ 2026-09-15 に 7 件とも直して 🔴 0（5.1）。STL は書き出し直し済み
- ⬜ v61n の .scad に残っているレジンの数字: `btn_v61.scad` 11 行の「肉 0.42」（注だけ）・`spk_v61.scad` の `S_THIN` 0.50（薄い肉を削る判定。MJF なら 0.8）
- 🔒 **電池の工具なし交換は捨てた（ユーザー 2026-09-15）。** v6.1 で電池のハッチ（蓋・ロック・床の板）を外し、電池は板の下・口は天面だけ。替えるときは天板の M2×6 ×4 を外して板ごと上げる。[TODO.md](TODO.md) B-1 の設計条件は取り下げ
- つまみの E リングを**実物で嵌めた記録が無い**（1 枚のレジン版も含めて）。割れたら v4 の半月へ戻す（`hardware/frozen/v1-v4/`）
- 粉抜きの穴は要るか（いまは天面が全開なので抜けるはず。閉じた空洞は作っていない）
- ~~発注用の STL の書き出し~~ ✅ 2026-09-15 に 7 点書き出した（`hardware/stl/v61n/`・コミット 26b3e3a）。支柱・ラフト・FIT_PRINT は無し
  - ⚠ **二重面（厚みゼロの皮）を残さない。** SOLIZE の自動見積りが v61n_shell を「シェル数 129」で弾いた（2026-09-15・5.3）。09-16 にシェルと天板を書き出し直した
  - ⚠ **STL はバイナリで出す**（`--export-format=binstl`）。26b3e3a は ASCII で出していて、3d-print-express.com の見積りが「3Dオブジェクトが含まれていません」で弾いた（サイトは 80〜84 バイト目を三角形数として読むのでバイナリ専用）。2026-09-15 に `hardware/tools/stl_bin.py` で 7 点をバイナリに変換済み（体積は同じ）

### 5.3 SOLIZE の自動見積りが「シェル数 129」で弾いた件（2026-09-15 → 09-16 に直した）

[online.solize.com](https://online.solize.com/) に v61n_shell.stl を上げると全材料が「パーツ数もしくはシェル数が 30 個以上のため、お見積りができませんでした」（左に「シェル数：129」）。
手元の `_stl_preflight.py` は「中身 1 個」と言っていた（頂点でつなぐ数え方なので、厚みゼロの皮を見落とす）。

| 正体 | どこ | 直し（`case_v6_1.scad`） |
|---|---|---|
| **二重面 77 枚**（同じ 3 頂点の三角形が表裏 2 枚＝厚みゼロの皮。潰れた重なりも足すと 130）。外注の判定はこれを殻として数える（数え方は向こうの物なので 129 は再現していない） | 床と 4 壁の 45° の留め継ぎ（`*_wedges()` の斜面）。レジン用に板ごと分けた形を、ナイロンでは**斜面で密着させたまま union** していた。回した halfspace の丸めで継ぎ面に皮が残る | ナイロンでは床と壁の間の楔を切らず、**角で重ねて union**（`floor_wedges()` 全部と、壁 4 枚の Z_TOP 以外の楔を `if (!nylon())`）。天板との継ぎ目（Z_TOP の楔）は別部品なので残す |
| 非多様体の辺（4 枚以上が共有）190 本 | 板の直方体の外面が `env()`（角丸の外形）の平面と**同一平面**。intersection の境目（角丸の最初の輪）に欠片が残る | `slab_*()` の直方体を外へ 1 はみ出させる。外面は env() で決まるので形は同じ（レジン 5 枚・ナイロン 2 点の体積が一致） |
| 面積ゼロの三角形 600 枚（害は無いが、辺の数え方によっては非多様体に見える） | マイクのヒゲ 6 本のベベルの輪が外面ちょうど（Y −0.6）に乗っていた | ベベルの輪を 45° の斜面に沿って 0.01 外・0.01 広くずらす（形は同じ） |

直した後: 7 点とも二重面 0・（面積ゼロを除けば）非多様体 0・殻 1。天板も二重面 48 枚が 0 に（上げていれば同じく弾かれていた）。
`--check` の当たり検査（5.2 の表）は全部同じ値。`_stl_preflight.py --mat nylon` に **🔴 二重面** の判定を足した（同じ見落としを繰り返さない）。
残る面積ゼロの三角形（天板 96・スピーカーのバスタブ 34・会話ボタン 18・シェル 4）は頂点が重なった潰れで、どの読み込みでも捨てられる。
⚠ 変えたのは STL の中の継ぎ目だけで、部品の形は変えていない。**再アップロードはシェルと天板の 2 点**（他 5 点はバイト単位で同じ）。

### 5.4 稜の丸みが R 1.6 に縮んでいた（2026-09-16 に直した）

🔴 `EDGE_R = WALL` で壁厚に連動させていたため、ナイロンで壁を 1.6 に薄くしたとき **外の稜の丸みまで R 1.6** になっていた（v4・v5・レジン版は R 2.0）。
ユーザー「ナイロン版、R1.6 になっちゃうの！？おかしいでしょ」。`EDGE_R = 2.0` に固定し、シェルと天板を書き出し直した（STL 上で実測 R 2.000）。

- ⚠ ナイロンでは内側の角は立ったままなので、角の肉は対角で 2.0 − 0.4·√2 ＝ **1.43**（壁 1.6 より薄いが MJF の ⚠ 1.2 より上。preflight に新しい ⚠ は出ていない）
- `--check`（5.2 の表と 128 行目の hit_wires 2.77）は R を変える前後で全部同じ値。二重面 0・🔴 0 のまま
- 変わるのは外の稜だけ。**再アップロードはシェルと天板の 2 点**（5.3 と同じ 2 点。他 5 点は触っていない）

**内側の角にも同心の R 0.4 を足した**（同日・ユーザー「内部なにもしないと当然角は薄くなるけど、そこにもR付けてるの？」→ 付けていなかった）。
`inner_fillets()`（`case_v6_1.scad`・ナイロンだけ）: 稜ごとの細い箱（空洞側へ 0.4・壁の中へ 0.3 食い込む）− 内側の丸い箱 `env_in()`（外の丸みと同じ 8 中心・半径 `IN_R` = 2.0 − 1.6）。
足したのは床の稜 4 本・壁どうしの稜 4 本・床の隅 4 つの球面で、角の肉は稜も隅も 1.6 になる。天板（2.5）は R 2.0 より厚く天板と壁の稜は痩せないので、天板には足していない。

- 🔴 最初は「空洞の箱 − env_in」で作ったら、帯の平らな面が壁の内面と同一平面になり、Manifold が厚みゼロの皮を残して右の壁の USB ポケットの口を塞いだ（preflight: 閉じた空洞・平たい肉 0.00）。壁の中へ 0.3 食い込む箱にして解消（二重面 0・中身 1 個）
- STL 上で実測: 床の隅の球面の頂点 158 個が全部 中心から 0.400。`--check` は全部同じ値・preflight の ⚠ の顔ぶれも同じ
- 再アップロードは引き続き**シェルと天板の 2 点**（天板は 5.4 冒頭の R 2.0 の書き出しのまま）

### 5.5 F5 のプレビューで板の色が他の板に縞で乗る（2026-09-16 に直した）

explode を下から見ると床の裏が虹色（青・紫・緑の縞）、skin の天面にハッチの緑が縞で乗る（ユーザー「底面の色がおかしい。何枚かさなってるんだこれ」）。
実体は重なっていない（`seam_*` が全部 0、F6 では正しく描かれる）。F5（OpenCSG）が「板の直方体 − 45° の楔（回した 400mm の箱）∩ 丸い外形 `env()`」を
正しく描けず、`env()` の面に他の板の色を重ねる症状。切り取りの箱を小さくしても、intersection と difference の入れ子を変えても直らず、
**`slab_*()` を `render()` で包む**（Manifold の網にして描かせる）と直った。v5 にも同じ 6 行があるので同じ直し。キャッシュされるので 2 回目からの F5 は速い（1〜2 秒）。
書き出しには影響しない（`--check` / `--resin-check` とも同じ値）。
⚠ 以前ここに「7 点ともバイト単位で同じ」と書いていたが、**バイト比較は同一性の根拠にならない**。
`shell.stl` は同じ scad・同じコマンドでも三角形 4 枚ぶん（200 バイト）違う。形で見ること（外形・中身の数・二重面・体積）。

## 7. 発注（2026-09-15 時点）

| 何を | どこへ | 何待ち |
|---|---|---|
| 7 点の STL（`hardware/stl/v61n/`） | JLC3DP・MJF PA12 | 無し（🔴 0・2026-09-16 に底パーツと蓋を書き出し直し。`v61n_top.stl` は消して `v61n_lid.stl` に。他 5 点は 09-15 のまま） |
| 板 v6.1（`hardware/pcb/katanori61/`） | JLCPCB | ユーザー判断で来月（[PCB-V61.md](PCB-V61.md) 5 章） |

## 8. 分割のやり直し — 底パーツ＋蓋（天板＋左の板）（2026-09-16）

🔒 ユーザー「ナイロン組み立て不能では？」「出っ張った USB をどうやって入れる気？」「それじゃ v2 と同じ失敗じゃん」。
1 章の「上下からしか入らない」は最終位置の当たりだけを見た結論で、**入れる順を追っていなかった**。v2（2026-08-22・[CASE-V2.md](CASE-V2.md) 88 行）と同じ失敗で、
そのとき作った掃引の道具 `_assemble_chk.scad` も使っていなかった。「天板だけが蓋」の案は v2 でユーザーが却下していた案でもある。

### 8.1 何が入らなかったか（一体シェル・09-16 朝の形）

| 部品 | 最後の動き | 空き | 結果 |
|---|---|---|---|
| 充電の USB-C（PCB） | 右の壁の穴へ +X 0.8 | 左 0.31 | 真っ直ぐは不可。斜め 6°なら入る |
| XIAO の USB-C（ReSpeaker） | 左の壁の穴へ −X 1.22 | 右 0.27（USB1 の殻が食う） | 不可。「右へ寄せる道」は嘘だった |
| OLED のダボ 2 本 | 前の壁へ −Y 2.0 | 後ろのリブまで 0.2 | 不可（ガラスが壁の穴に 1.0 入る形も同じ理由で不可） |
| ジャックの筒（ReSpeaker） | 右の壁の穴へ +X 0.45 | ― | 不可（掃引で見つけた。表に無かった 4 つ目） |

私の案（口の段付き・壁の増し肉・スリット）は全部却下（ユーザー: スリットは口の脇の肉が限界を割る。壁の増し肉は上まで全部要る）。
🔒 ユーザー案で決めた: **「天板＆左壁というパーツ」**・「角や辺の一部までは底パーツが持てば良い」・「XIAO の USB の方が位置的に高いので辺部分を維持しやすい」・
「電池部分は壁（切り抜き）側が持っていた方がいい」・「電池の仕切りを付けて分けてしまって、その上に（柱を）建てたら」。

### 8.2 形

| 部品 | 中身 |
|---|---|
| 底パーツ `shell()` | 床＋前・後ろ・右の壁＋左の壁のうち前後の縦の稜の帯（前 Y 〜7.7・後ろ Y 51.4〜）＋床の左の稜（Z 〜0.4）＋上の柱 4 本 |
| 蓋 `lid()` | 天板＋左の板（Y 6.0〜51.4・Z 0.5〜天面。XIAO の口とスパナの刻印）＋板の後ろの下の角の足。板の縁は底パーツに 3 辺とも 0.1 で当たる（`FLAP_CL`・8.5） |

- **蓋の閉め方（🔒 ユーザー 2026-09-16 夕・8.5）**: 蓋は真上から降ろす。左の板は L 字のたわみ部品で、途中で外へ 1.5 たわんで XIAO の殻をかわし、口が殻に来た所で戻って嵌まる。ねじ 4 本＋床の裏 1 本。
  横へ 2.0 ずらしてから押す動き（`LID_SHIFT`）は捨てた（0 のまま残してある）。右・前・後ろの壁との 45° の楔はレジンと同じ向き。
  左の帯（前後の隅の柱）の頭は Z_TOP の平らな面で止め、天板（2.5 のまま）がその上に載る。外から見た継ぎ目は左の面だけ 1.6 低く、角で段が付く（楔に戻す理由は無い・ユーザー）。
  🔴 帯の頭を 1.6 高くして天板に 0.9 の唇を被せ、継ぎ目の高さを揃える形を一度作ったが、蓋を 2.0 ずらして降ろすために唇を 2.3 内まで広げる必要があり、そこに左の柱のねじが載って座ぐりが天面まで抜けた
  （ユーザー「ここに穴が開いても OK なわけか」）。継ぎ目を揃える以外の利点が無く（「それのなにがいいの」）、やめた
- 🔴 蓋を回して閉じる案 2 つは掃引で落ちた: 左下の稜を軸にすると上ほど外へ振れて、降ろすとき板の下半分が XIAO の殻を擦り、蓋の縁が帯の楔に食い込む。右上の稜を軸にすると口の動きが Z 3 : X 1 で、殻に被さるあいだに板が 3.7 下がる
- **PCB は Z 12**（`BAT_CASE` 2.0 → 6.0）。左後ろの柱は、ハッチの内面に付く台（電池の後ろ Y 45.7〜51.4）の上の頭（φ7・Z 8.0〜12・ナットの溝の下に肉 1.2）で、電池の上へ張り出す。
  **左前の柱は無い**（床からは電池の抜け道 Y 9.9〜44.9 の中なので立てられない）。**ねじは 3 本**のまま。板の穴 (6, 17) は開けたままでよい。
  仕切りを渡して左前を下から受ける案は **2026-09-16 夕に 2 回試して、どちらもユーザーが却下**（① 塗りつぶしの板 3662mm³　② 板の輪郭に沿った縁のリブ 920mm³）。
  却下の理由は `part="open_left"` で横から見てもらっての「想像以上にスカスカでめちゃくちゃ」。**作戦はユーザーが再検討中。リブは削除済み。**
  ただし **J10 を右へ逃がしたので Z 7.0〜12.0 の層は丸ごと空いている**（電池の抜け道の掛け値 6.5 の上・板の裏 12.0 の下）。何を渡すにしてもこの層。
  🔒 ユーザー 2026-09-16 夕「右壁の２つのスペーサーのナットのポケットは、斜め４５度内側に向ければいいでしょ？」── **`hub_nut_ang(i)`**（右前 135°・右後ろ −135°・左の 2 本は +X のまま）。
  真横（−X）に開けていたときは溝も口も柱の左へ X 62.9 まで伸びていた。箱の中心へ 45° 向けると口の cube は全頂点が X > 71、溝は Y 18.7〜24.1。
  口の cube の長さも `NUT_MOUTH_L` 10 → 4.0（柱の面を破るのに要るのは 2 ほど）。レジンは `nutpath` 8.49 / `sk_hub` 1.26 / `path_bat` 644.77 が前後で同一。
- **電池**は蓋を外して左の窓から −X へ抜く（J10 のプラグを外してから）。床の左の稜の丸み 0.4 を乗り越える
- **J10 は右へ移した**（2026-09-16 夕・🔒 ユーザー「電池のｐｈコネクター、左壁側にあるじゃないですか」）。旧：板 x 1.70〜10.30 / y 22.10〜29.00 ＝ 世界 X 3.70〜12.30・Y 35.60〜42.50 ── 板の左端で、下端 7.2 が電池の天面 6.0 の 1.2 上。この 1.2 が `BAT_CASE` 6.0（4.8 ＋ 1.2）を決めていて、電池の上の層を使えなくしていた。
  新：板 x 72.00〜80.60 / y 15.50〜22.40 ＝ 世界 X 74.0〜82.6・Y 29.0〜35.9・拜く向き −X。電池は −X にしか動かないので **X 68.05 より右は電池が一度も通らない**。隔たりは K31 から 0.4・J4（表）から 0.7・左右の柱から 8 以上・右の壁まで 1.75。線は短い。🔒 ユーザー 2026-09-16 夕「バッテリを Z 軸１８０度回転」で `BAT_RZ` 90 → **270**、タブが左 X 18.05 から**右 X 68.05**（口の目の前）へ移ったので、床近くを X 68.55 → 70.0 と進んで立ち上がるだけ。足跡（50×35）も芯も変わらない。**⚠ 基板担当へ渡す変更**
- **OLED はダボ無し・ガラスは壁の内面の 0.2 後ろ**（`FRONT_DY` 1.0 → −0.2・外面からの奥まり 1.8 でレジンと同じ数字）。X はライザー（PCB の J2）が出す。
  L の足は穴の真上から 1.8 内側へ（`OLED_L_DX`・前の上の柱まで 0.3 だった）。
  **床に板の左右の縁を挟むガイド 2 本**（`oled_guides`・板の縁の外 0.4・幅 1.2・高さ 5・内側の上の角を 0.6 落とす。🔒 ユーザー「すこしの膨らみは付けたほうが安定する」→ 足の膨らみは蓋を左へずらして降ろす動きと両立しないので床側で。X が ±0.4 で決まる）
- **ReSpeaker の右端の止め**（`rsp_stop`・🔒 ユーザー「ReSpeaker を抑える何かが欲しい」）: 右の壁の内面から板の右端の外 0.4 まで、板の前面の前 0.4 から座の後端 9.6 までの帯に高さ 20 の柱。
  盲ポケットを廃止した右端はこれで止まり、左は蓋の板の内面（縁まで 0.3）で止まる。後ろを 9.6 で切るのは USB1 の殻（Y 10.03〜）に当たるため
- **ReSpeaker を真上から降ろす**ために: 右の壁を 1.45 外へ（`RIGHT_CL` +0.25・ジャックの筒との空き 0.20 ⚠）・USB1 とジャックのカバーの盲ポケットを廃止・
  左前の上の柱を K1 の道から外す（`POST_D_F_TL`）。⭐ 2026-09-18 に **Y −1.0〜5.3（6.3）** へ直した ── 柱を前の壁へ `TL_FWD` 0.8 食い込ませて、ナットの溝（Y −0.15〜4.45）が入るようにした。前の肉 1.65・後ろの肉 0.85。K1 への空き 0.3 は変えていない。**2026-09-16 から 09-18 まではここをタッピングにしていた**（10.4）
- マッチ棒（ReSpeaker の押さえ）は X 53（OLED のライザーのメスまで 0.37 だった）。スピーカー IN の線は J4 の頭の 1.6 上を通る式に（板を上げたら 16.0 の数字が J4 を貫いた）
- **左後ろの柱と、フラップが持つ座**（`rear_post`・`flap_seat`・2026-09-16 夕に作り直し）
  🔒 ユーザー「柱を底パーツ側に立てると思ってましたよ」── 上から降りてくる足（旧 `lid_foot`）を廃止し、**床から立つ柱**にした。
  降りてくる物が無くなったので **PCB の欠き 2 つは全廃**（角ごとの欠き X 〜9.594・Y 43.4〜51.9 が消えた）。
  ・**柱** `rear_post`（底パーツ）X 1.694〜8.094・床から Z 12.0。下半分は電池の後ろ 0.3（Y 45.2）から Z 6.7、上半分は前へ Y 43.9 まで張り出して下は 45°（電池はここを −X へ抜ける）
  ・**座** `flap_seat`（蓋）X 1.694〜8.094・Y 43.9〜50.6・**Z 13.6〜22.0**。板の**上**にしか無いので、蓋を真上から降ろしても板の面を横切らない
  ・ナットは座の中の横差しで、**底 1.6 の上に載る**（下からのねじなのでこの向きでないと蓋を引けない）。**口は +Y**で、ハッチの内面（51.4）との隙間 0.8 で抜けない
  ・座は左の板に沿って Z 22.0 まで背を立て、hull で 45° に繋いで根を 6.3 × 3.4 → **6.3 × 8.4** に（下からのねじは板と蓋を一緒に引く）
  🔴 途中でやった 3 つの間違い: ① ナットの上下を逆に彫り、締めてもナットが PCB に押し付けられるだけだった　② 座を 3.4 だけで置き、根が 21mm² しか無かった　③ 口を塞ぐタブを出して、たわんだ蓋が背の高いレール（X 1.694〜2.894）に当たった（`path_lid` 7.42）
- OLED の L の足は穴の真上から内側へ（`OLED_L_DX`）: 左前の上の柱（内面 X 6.7）から 0.3 空く所
- 左後ろの上の柱は壁の内面から始めて後ろのレールと一体（幅 7.4・X 1.7〜9.1。🔒 ユーザー 2026-09-16 夕「肉をふやして、いっそレールと完全に一緒に」）。左後ろの壁どうしの内側の R 0.4 は板の範囲では切る（残すと 0.3 の皮が立つ）

### 8.3 入れる順と掃引の検査（`--check` の `path_*`）

1. **PCB** を横から。🔒 ユーザー 2026-09-16 夕「板を真上から降ろすのをやめるだけでは」「ずらしておろしてからスライドするという 2 動作」。
   ⭐ 2026-09-17 夜に **4 段**へ（充電の USB-C が後ろの縁に移ったため。9.8）:
   ① 前へ `pcb_fwd()` 3.6 逃がし `PCB_LIFT` 3.5 上げて左の窓の外に構える　② 右へ滑らせて中へ
   ③ 柱の頭まで垂直に下ろす　④ **後ろへ 3.6 押して USB-C と電源の押しボタンのキャップをハッチの口へ挿す**（キャップは先に押し子へ差しておく。鍔は壁の内側に残る）。
   前へ逃がす根拠は **板の後ろの縁から出ている物**（USB-C の胴 `usbc_out()` 1.3・押しボタンのキャップの顔 3.1）の大きい方 ＋ 0.5（逃がさないと差している間じゅう後ろの壁を通る）。⭐ 2026-09-19 にキャップで 1.8 → 3.6
   持ち上げの根拠は **J10 の下端がケーシングの天板（天面 8.2）を越える**こと。
   🔴 J10 の窓（`bat_case_j10_win`）は **−Y に `pcb_fwd()`（3.6）広げてある**。④ の押し込みのあいだ J10 はその中を通る。**ねじは上から 3 本**
2. ~~**トグル**をハッチに~~（⭐ 2026-09-19 にトグルをやめた。電源の押しボタンは PCB に付いて 1 で入る）
3. **ReSpeaker** をライザーごと真上から（ライザーの L 字が PCB の J1 に嵌まる）
4. **OLED** をライザーごと真上から（OLED のライザーの前向きのメスが ReSpeaker の頭を跨ぐので、この順でないと入らない）
5. **電池**を左の窓から板の下へ。J10（縦の B2B-PH-K）に挿す。床と天井の膨らみを乗り越える（電池は膨らむのでこれでよい。余る分はスポンジ）
6. **フラップの座にナットを差す**（蓋を降ろす前に。口は +Y）
7. **蓋**を真上から降ろす（左の板は途中で外へ `FLAP_FLEX` たわむ）。**天板のねじ 4 本**
8. **床の裏から M2×18 を 1 本**。床 → `rear_post` → PCB → フラップの座のナット を一本で締める。底パーツと板と蓋が同じねじで留まる（🔒 ユーザー「PCB の留めは上から 3 本、下から 1 本」）

| 検査 | 値 | 意味 |
|---|---|---|
| seam_shell_lid | 0.00 | 継ぎ目は面が触れているだけ |
| sk_oled | 0.00 | OLED ↔ 底パーツ＋蓋。床との接触面だけ |
| hit_wires / nutpath / sk_rsp / sk_hub / sk_spktub / sk_tgl | 2.74 / 空 / 4.28 / 0.00 / 1.35 / 0.70 | nutpath は `S_NUT_ANG` 57 → 20 で空になった |

**入れる道は別の道具で見る**（2026-09-17 に移した。9.9・docs/COLLISION-SURVEY.md）。
引数なしで 6 本とも回る。

```
python hardware/tools/sweep_chk.py
```

了承済みの当たりは `hardware/sweep_accept.json` の台帳に載せてあり、
**載っていない当たりだけが「新」として出る**（新が 1 件でもあれば終了コード 1）。
2026-09-17 時点で台帳 5 件・新 0 件。

| 道 | めり込み（塊ごと） | 状態 | 意味 |
|---|---|---|---|
| hub | 無し | ── | 板の裏が柱の頭に載る面だけ（9 か所とも厚み 0.000 の皮） |
| rsp | 無し | ── | 同上（5 か所） |
| oled | 厚み 0.400・0.438 mm³<br>厚み 0.320・0.205 mm³ | 済 | OLED の裏のフィルムが ReSpeaker の D1 を擦る。フィルムは押せば凹む |
| bat | 厚み 0.700・43.409 mm³ × 2 | 済 | `bat_guide_ring` を電池が乗り越えるぶん（床側と上側のレール）。🔒 ユーザー「電池は膨らみますし、隙間は多少あっても良い」── **意図した値** |
| lidmain | 無し | ── | 天板＋つまみ・ボタン・スピーカー。縁のぐるりの面接触だけ（3 か所） |
| lidflap | 厚み 0.440 × 2・厚み 0.021 | 済 | 左の L 字。戻る最後の一手で XIAO の殻の角が口の R 1.2 に触れる（旧 `path_lid` 0.07 と同じ所） |

「済」は `hardware/sweep_accept.json` の台帳に載せた物。**新は 0 件。**

上の値は 2026-09-16 の `57e661b`（板の上の物を箱から実物のメッシュへ）の後のもの。
それ以前は `path_hub` 0.59 ／ `hit_wires` 2.75 ／ `sk_hub` 0.01 だった。どれも小さくなった側である。

preflight（MJF）: 底パーツ・蓋とも 🔴 0・二重面 0・中身 1 個。

### レジンで回す検査は 6 件少ない（2026-09-16）

`--resin-check` は次の 6 件を回さない（`hardware/tools/stl_v61n.py` の `NYLON_ONLY`）。

| 外す物 | 理由 |
|---|---|
| `seam_shell_lid` | 底パーツ＋蓋の継ぎ目。レジンは板 6 枚なので、この分割が無い |

（入れる道の掃引 `path_*` もここに並んでいたが、2026-09-17 に撤去した。9.9）

これを分ける前は、レジンで `seam_shell_lid` 4529 や `path_lid` 4520 が出ていた。板も部品も壁を突き抜けた量を数えていただけで、**不良の量ではない**。
実際、過去のレジンの報告（`434dee2` ほか）も `sk_*` と `hit_wires` だけを載せていた。道具をその運用に合わせた。

レジンの値（`57e661b` 時点）: `plugpath` 空 ／ `hit_wires` 2.20 ／ `nutpath` 空 ／ `sk_rsp` 4.28 ／
`sk_oled` 0.00 ／ `sk_hub` 0.00 ／ `sk_spktub` 0.80 ／ `sk_tgl` 0.00 ／ `sk_btn` 0.00 ／ `hit_btn` 空。

### 8.4 残っている物

- ⚠ ジャックの筒と右の壁の空き 0.20（MJF の ±0.3 より小さい）
- ⚠ 蓋を右へ押すあいだ蓋が 0.3 浮く前提（ReSpeaker の押さえ）。浮かないなら羊羹が板の頭を 2.0 擦る
- ⚠ **電池の ＋X（前右の柱まで 2.95）と ＋Y（ハッチの内面まで 6.5）の遊び**は止まっていない。床と天井の膨らみは Y と入り口側しか見ていない
- ⚠ フラップの座のねじは **M2×18** が必要（床の裏 −1.6 からナットの上端 17.0）。手持ちの長さを要確認
- 基板担当へ: [PCB-V61.md](PCB-V61.md) 3 章の 🔴。いまの前提は **板の裏 Z 12.0（両材料共通）・欠き無し・穴 4 点 (6, 17) (81.354, 17) (4.834, 47.494) (81.354, 48.4)**
  ⭐ 2026-09-16 夜: 前右を 74.5 → 81.354 へ（🔒 ユーザー）。板の中では X 72.5 → 79.354。右側が前後そろった
- ねじの数: 天板 4 本（4 本ともナット）＋ PCB の上から 3 本 ＋ 床の裏から 1 本（M2×18）

### 8.5 2026-09-16 夕に見つけた不具合

- 🔴 **`ribs_gen61.py` が `-D MAT=` を渡していなかった。** 反り対策の格子は**レジンでしか使わない**（`RIBS_OFF = nylon()`）のに、
  `case_v6_1.scad` 先頭の既定（"nylon"）で空きを計算していた。つまり**ナイロンの中身の配置で作った格子をレジンの箱に立てていた**。
  `BAT_CASE` を揃えるまでは両材料で中身の高さが 4.0 違ったので、ずれはさらに大きかった。直して生成し直した（66 → 72 区間）
- 🔴 **トグルの受け（`CRADLE_*`）は v6.1 に存在しない。** 死んだ定数が 2 行残っているだけ。
  `path_hub` 174.08 のうち 159 の正体は **`tgl_boss`**（ナイロンだけの φ14・張り出し 1.81・Z 36.35〜50.35）
- 🔴 **`skin()` が v6.1 に未定義**だった（v5 からの残り）。`part="skin"` / `part="all"` が黙って空になっていた。定義した
- 🔴 `S_NUT_ANG` を 2026-09-14 に 20 → 57 へ戻したとき、**会話ボタンの押し子の枠を 14.24mm³ 削っていた件が理由に入っていなかった**。
  20 に戻して解消（同心円上の角度なので点対称と同心円の関係は保たれる。🔒 ユーザー「同心円状のナットの位置関係は維持してほしい」）。`nutpath` が空に

### 8.6 表示用の part

- `open_left` … 全部組んだ状態で**左の壁だけ**取り払う（帯もレールも抜く）
- `open_flap` … **蓋の左の板だけ**外し、底パーツの帯とレールは残す（🔒 ユーザー「床パーツがすこし左の壁を持ってるでしょ？それは表示させてほしい」）

## 9. 板の上の物を実物の足形にした（2026-09-16 夕・基板の精緻化）

🔒 ユーザー「コネクタの品番変更もそのスレッドへ。つまりモデルの精緻化と、基板の変更両方ですね」。
電池のケーシング（8 章）で天板の開口が `PCB_PARTS` の数字からそのまま決まるようになったので、
**模型の粗さが直接形に出る**ようになった。その粗さを取った記録。

### 9.1 何が粗かったか

| | 前 | 後 | 出どころ |
|---|---|---|---|
| 口の枠 | KiCad の **courtyard**（胴の周りに 0.3〜0.5 の逃げが付く「置き場所の予約」） | **胴（F.Fab）** | `katanori61.kicad_pcb` に実際に置いてある足形 |
| 枠の取り方 | 口は courtyard・ライザーは胴、と不揃い | 全部 胴 | 同上 |
| プラグの通り道 | 全部の口に一律 **3.1**（`PCB_PLUG_PATH`） | 口ごと。JST-PH は **2.0**（`PH_MATE_OUT`） | 📄 ePH.pdf 1 ページ。🔴 旧 3.1 は**導出が間違っていた**（下） |
| ミュートリレー | 15.3 × 10.7 × 9.33 の 1 つの塊 | **胴 14.8 × 7.4 × 9.33 ＋ リード 15.3 × 10.7 × 0.5** の 2 つ | データシートの 10.7 は「リードを含む外形」 |
| 板の裏へ出る足 | **無かった**（板の下に居るのは J10 だけと数えていた） | スルーホールの口 5 つとピンヘッダ 2 つに付けた | 🔒 並走セッション「ピンヘッダありますからね。当たり判定はちゃんとしておいたほうがいい」 |
| 足の枠 | （無かった） | **スルーホールのパッドの外接枠**。胴の枠で押し出すと嘘の当たりが出る | 同上 |
| 板を入れる持ち上げ | **1.5 の決め打ち** | 数えて出す（`PCB_LIFT` ＝ いま 3.5） | 下の 9.3 |

🔴 **`PCB_PLUG_PATH` 3.1 の導出**: 📄 2 ページ（**SMT** の図）の `(9.6)` − `6.0` − 逃げ 0.5 = 3.1。
引いた 6.0 は**トップ型の背**で、`(9.6)` が載っている**サイド型の奥行き 7.6** ではない。層の違う数どうしを引いていた。
正しくは 📄 1 ページ（Through-hole の組立図）で
**サイド型 (9.6) − 7.6 = 2.0 ／ トップ型 (8) − 6.0 = 2.0**。どちらも 2.0 である。

📄 `hardware/ref/jst_ph/ePH.pdf` は暗号化＋埋め込みフォントで、そのままでは**表の数字が丸ごと落ちる**。
`pypdf` で復号してから `pdfminer` で開き、回転した寸法線は文字の向きごとに拾う。

### 9.2 電池の口（J10）を縦にした

🔒 ユーザー「ケーシング作ったから垂直のがいい。結局一番穴は小さくなる」。
サイド型 S2B-PH-K（背 4.8・横出し）→ **トップ型 B2B-PH-K を板の裏に下向き**。基板の側も同日に差し替えた
（[PCB-V61.md](PCB-V61.md) 2・8 章。DRC エラー 0・未接続 0 で配線し直し済み）。

- 天板の窓 **12.7 × 7.9（100.3mm²）→ 8.11 × 5.91（47.9mm²）**。胴 6.31 × 4.91 ＋ 逃げ 0.5 ＋ 右へ滑る 0.8（X だけ）
- これで足りるのは 📄 3 ページの表でハウジング **PHR-2（5.8 × 4.5）がトップ型の胴（5.9 × 4.5）の中に収まる**から。
  **縦の口は挿しても平面の外形が広がらない**
- 線（`w_bat61`）は電池のタブ（世界 68.05, 27.4）から床の上 Z 3.0 を右へ走り、**パッドの真下で真上に上がる**だけになった（折れが 1 つ減った）
- 🔴 組む順が変わった: 下向きの口なので、板を据えてから下から挿す手は入らない。
  **電池を入れて線を右の帯へ垂らす → プラグを J10 に挿してから板を降ろす** → ねじ

### 9.3 精緻化して出てきた当たり（どれも前から在ったが、模型が粗くて見えていなかった）

| 見つかった物 | 大きさ | 直し方 |
|---|---|---|
| **J10 の足が J4 に挿さったプラグの真下**（`hit_wires`） | 1.02mm³ | J10 のパッドを Y 並びから **X 並び**へ（極性の言い方が 手前／奥 → **左／右**）。[PCB-V61.md](PCB-V61.md) 8 章 |
| OLED のライザーの足（下端 Z 9.0）が、横差しの途中で**床の柱の頭**（Z 12.0）を削る | 0.3 × 足跡 | `PCB_LIFT` を 1.5 → **3.5**。越える相手は天板（8.2）だけでなく**その物の Y の帯に柱が居れば柱（12.0）**である |
| 縦になった J10（下端 Z 6.0）が天板（〜8.2）を横断する | 349mm³ | 同上（1.5 では 1.2 足りなかった） |
| J10 が窓の左の縁を削る | 0.3 | 窓を **右へ滑る 0.8 のぶん** −X 側へ広げた（`pcb_slide()`） |

### 9.4 当たり検査（`python hardware/tools/stl_v61n.py --check`・16 項目）

| | 精緻化の前 | 後 |
|---|---|---|
| seam_shell_lid / plugpath / nutpath / sk_oled / sk_btn / hit_btn / path_rsp | 0.00 / 空 / 空 / 0.00 / 0.00 / 空 / 0.00 | 同じ |
| sk_rsp / sk_tgl / sk_spktub / path_oled / path_bat | 4.28 / 0.70 / 1.35 / 0.51 / 86.82 | 同じ |
| **sk_hub** | 0.44 | **0.01**（リレーを胴とリードに分けた） |
| **hit_wires** | 3.01 | **2.75**（電池の線の折れが 1 つ減った） |
| **path_lid** | 41.55 | **33.15**（同じくリレー） |
| **path_hub** | 1.13 | **0.59** |

`path_hub` の 1.13 は**全部 1 か所**で、板の左後ろの角（世界 X 1.69〜2.89・Y 50.60〜50.90）が後ろのレールを削っていた。
正体は **板の逃げが「右へ 0.8 滑る」分だけ足りない**ことだった ── 板は左の窓から差してから右へ `pcb_slide()` 0.8 滑るので、
滑る前の姿勢では逃げが 0.8 ずれてレールが板を **0.8 × 0.3** 食う。`pcb61()` の逃げの幅を `RAIL_T + 1` →
`RAIL_T + 1 + pcb_slide()` にして（板の座標で X 0〜1.694）**0.59** になった。基板側の `NOTCHES` も同じ値にしてある。
⭐ 2026-09-17: この逃げは**板から筐体へ移した**（`NOTCHES = []`・当たりは 0.000）。9.7 を見ること。

preflight（MJF・7 点）: **中身 1 個・二重面 0**。🔴 は蓋の 1 件（0.22mm・X 28.74 / Y 12.0 / Z 47.6〜50.4）だけだった。
**→ 2026-09-16 に解消（9.6）。いまは 7 点とも 🔴 0。**

### 9.5 引き継ぎの数字が古かった件

精緻化を**始める時点**で、引き継ぎと 5.2・8.3 の表は実測と合っていなかった:
`path_hub` 0.59 → 1.13 ／ `hit_wires` 2.77 → 3.01 ／ `sk_hub` 0.01 → 0.44 ／ `sk_spktub` 0.74 → 1.35 ／
`path_lid` 0.07 → 41.55。どれも 2026-09-16 夕の未コミットの作業で動いていた値である。

その後 `path_hub` は 9.4 のとおり **0.59**（引き継ぎの値）に戻り、`path_lid` も **0.07** に戻った。
`path_lid` の 41.55（途中で 218.61 まで増えた）は、**廃止したはずの蓋の足**（`lid_foot`）を掃引の `lid_flexed()` が
まだ降ろしていたためで、並走セッションが `flap_seat()` に差し替えて解消した。

### 9.6 筐体側の作り替えに合わせた基板の直し（2026-09-16 夕・並走セッションと）

蓋の足を廃して**床から立つ柱**にする作り替え（別セッション）に合わせて、基板を次のように直した。

| | 前 | 後 |
|---|---|---|
| 取付穴（板の座標） | (4.0, 3.5) (72.5, 3.5) (10.0, 33.4) (72.5, 33.4)・**左前は使わず 3 本** | (4.0, 3.5) (72.5, 3.5) **(2.834, 33.9942) (79.354, 34.9)**・**4 点とも使う**（上から 3 本・下から 1 本） |
| 板の欠き | 後ろの両隅に 2 つ（合わせて 41mm²） | **全廃**。残るのは後ろのレールの逃げ（X 0〜1.694・Y 37.1〜37.4）だけ ⭐ 2026-09-17 にそれも廃止（9.7） |
| 板の裏の Z | ナイロン 12.0・レジン 8.0 | **両方 12.0**（`BAT_CASE` 6.0 がレジンにも入った） |

🔴 欠きを全廃したら **Freerouting が VBUS を 3 本引き残す**ようになった（板が広くなって配線の topology が変わったため。
配置は前後で 1mm も動いていないことを確かめてある）。パスを 40 → 120 にしても、ネックダウンを切っても同じ。
`route.py --incremental` を続けて回すと 4.6 秒で 0 になる。

⚠ その `--incremental` は**壊れていた**。「φ0.59 以上は縫いのビア」として落としていて、自動配線のビア（φ0.8）まで
種から抜け、多層をまたぐネットが切れて未接続 40 本を出していた。縫いのビア（φ0.6）だけ落とす形に直した。

⇒ いまの手順は `gen_pcb → route → route --incremental → check_pcb → fab → check_fab`。
DRC エラー 0・未接続 0・回路図との食い違い 0・銅箔のすきま 0.151（下限 0.15）。

### 9.6 ナットを回すと薄肉が出る件（2026-09-16 に解消）

`S_NUT_ANG` を変えるたびに天板のスピーカーの座に薄い刃が出ていた。原因は 2 つあった。

**① 確かめる道具のほうが、角度以外で答えを変えていた。**
`case_v6_1.scad:63` は `$fn = 48`、`parts/spk_v61.scad` には無く、薄肉落としの `offset()` も `$fn` を渡していなかった。
そのため**呼び出し側で多角形が変わり**、同じ `S_NUT_ANG = 20` でも 部品単体 `part="deck"` は 🔴 0・天板は 🔴 1 になっていた。
→ `spk_v61.scad` に `S_FN = 48; $fn = S_FN;` を置いて揃えた。

**② 直線の手と曲面の縁を、同じ半径から立てていた。**
手の板 `spk_hang_arms` の内の面は座の輪郭に**接する直線**（x = S_R_I）。縁 `spk_rim` の内の面は**同じ半径の曲面**。
だから縁は手の内の面より内へ `R − sqrt(R² − y²)` だけ出る（手の縁 y = ±3.3 で **0.73**）。
その裏にナットのポケットの空が来ると、厚さ 0 → 0.73 の楔になる。**角度で深さが変わるので出たり消えたりしていた。**
→ `spk_rim_relief()`: **手のまわりの縁を丸ごと落とす**（薄くするのではなく無くす）。位置出しは手の板 2.8 厚が持つ。
窓は手より `S_RIM_GAP` 0.6 広い（同じ幅だと面が重なって厚さ 0.00 の板が出る）。半径方向は縁の外まで通す。

掃引（`part="deck"`・`$fn=48`・5° 刻み）: **0〜105° で 🔴 0**。110° より先は両方の手がぶつかって部品が分裂する範囲なので設計として成立しない。
当たり検査 16 項目は 8.3 の表と全一致。レジンの 16 項目も変更前と同一。

🔴 やって駄目だった直し方（繰り返さないこと）:
- 断面を `projection(cut=true)` で取り、「縮めて膨らませて」薄い所を削る … 凸の角が全部丸まるので 🔴 が 20 枚に増える
- 縁の逃げを手と**同じ幅**で切る … 面が重なって厚さ 0.00 の板が 9/20 の角度で出る
- 逃げの深さを `sqrt(R² + y²) − R` で計算する … **式が逆**。正しくは `R − sqrt(R² − y²)`。浅いと端に三日月が残る

### 9.7 後ろのレールの逃げを板から筐体へ移した（2026-09-17）

🔒 ユーザー「筐体の後ろのレール（背の高いほう）の逃げで基盤が 0.3mm × 1mm ほど削られている」
「たった 0.3mm で逃げもクソもない気がするしね」。

**あの欠きは効いていなかった。** 板の後ろ左の角を 0.894 × 0.3 欠いていたが、板は**左の窓から差して**入る
（`path_hub` ①）ので、**後ろの縁 82mm 全部**が後ろの背の高いレール（世界 X 1.694〜2.894）を通る。
角だけ欠いても通り道には効かず、掃引には 0.544mm³ が残ったままだった
（X 1.69〜2.89・Y 50.60〜50.90・Z 12.00〜17.01 ＝ 板の裏から差し込む姿勢の表まで）。
しかも深さ 0.3 × 幅 0.9 は**ルータの刃 φ2 では切れない形**である。

⇒ 逃げを**筐体のレール側**へ移した。

| | 前 | 後 |
|---|---|---|
| 板の外形（`v61_board.py` の `NOTCHES`） | `[(0.0, 37.1, 1.694, 37.4)]` | `[]`（角の立った 82.024 × 37.4） |
| 後ろの背の高いレール | Y 50.6〜51.4 が全高 | 板の通る高さだけ前の面を Y **51.0** へ引く |
| `path_hub` のこの当たり | 0.544 mm³ | **0.000 mm³** |

- 逃げは `flap_rail_pcb_relief()`（`case_v6_1.scad`）。Y は `PCB_Y1` ＋ `PCB_RAIL_CL` 0.1、
  Z は 板の裏 `HUB_AT[2]` から 板の表まで（板厚 1.6）、上下に 0.1。**数字は全部引き算で出す。**
  ⭐ 2026-09-17 夜に高さを 5.3 → 1.8 に詰めた。板は前へ 1.8 逃がしたまま入って下りるので、
  差している間の板の後ろの縁は Y 49.1 でレールの前の面 50.6 に届かない。**触れるのは ④ の押し込みだけ**である（9.8）。
- 引いた残りは 0.4 だが、**裏がハッチの板（Y 51.4〜53.0・厚み 1.6）**なので立った薄肉リブにはならない。
- KiCad の板（`katanori61.kicad_pcb`）は **手で切った**。外形の `gr_line` 6 本 → 4 本、ベタ 3 枚の輪郭から欠きの 3 点を抜く。
  `v61_board3d.stl` は `python hardware/pcb/gen_board3d.py` で作り直した。
  🔴 **`gen_pcb.py` は回さないこと。**`build()` は板を毎回ゼロから書き直すので、**自動配線の線が全部消える**
  （`route.py --incremental` は「今の板の線」を種にするので、`gen_pcb` の後では種がもう無い）。
  外形を広げるのは**銅が増える側**なので、いまの配線はそのまま合法である。
- 確かめた: 配線 682 本・ビア 198 個は減っていない。`check_pcb.py` すきま最小 0.151mm（VSYS ↔ LBO）。
  KiCad の DRC は **変更前と同一**（lib_footprint_mismatch 4・silk_edge_clearance 2。どちらも J13 の絹で、欠きとは無関係）。

### 9.8 入れる道の掃引を「通過点の並び」に書き直した（2026-09-17 夜）

> ⚠ **この節の掃引（`sweep_pose` / `path_*`）は同じ 2026-09-17 に撤去した。9.9 を読むこと。**
> 道の書き方（`PATH_*` の通過点・3 軸の回し）はそのまま新しい道具が引き継いでいる。

🔒 ユーザー「本来であれば対象物をどう移動させるかのパスを定義してあたりを出すべきでしょ」
「入れられないかを判断する道具は必要だよ？ 当たり前だけど」「そのクソみたいな機能のツールはいらないということ」。

**何が駄目だったか。** 道具は `sweep_x` と `sweep_z` の 2 本しか持っておらず、**X と Z の平行移動しか書けなかった**。
そのため「前へずらして入れて、下ろしてから後ろへ押して口に挿す」という実際の動きが書けない。
充電の USB-C を後ろの縁（ハッチ）へ移した 2026-09-17 以降、板の縁から 1.3 出た胴が
**横差しの間じゅう後ろの壁の中を通る形**で数えられ、`path_hub` は 51.4mm³ を出し続けていた。
入る動きなのに「あたってます」と言い続ける道具で、しかもその処遇をユーザーに判じさせていた。

**直し方。** 道の 1 点を **`[dx, dy, dz, 回し（度・Z 軸まわり）]`** で持ち、点と点のあいだを n 等分して当てる
（`pose_lerp` / `at_pose` / `sweep_pose`）。これで Y のずらしも斜めも書ける。回す中心は物ごとに渡す。

```
//                dx          dy   dz        rx ry rz
PATH_HUB = [[-95, -pcb_fwd(), PCB_LIFT, 0, 0, 0],   // ① 前へ 1.8 逃がし 3.5 上げて左の窓の外
            [  0, -pcb_fwd(), PCB_LIFT, 0, 0, 0],   // ② 右へ滑らせて中へ
            [  0, -pcb_fwd(),        0, 0, 0, 0],   // ③ 柱の頭まで下ろす
            [  0,          0,        0, 0, 0, 0]];  // ④ 後ろへ 1.8 押して USB-C を口へ挿す
```

**回しは 3 軸ある。**（🔒 ユーザー「これ、入れる物体の角度とかも変えられるの？」「3 軸の変更は必要だし……
特定位置で固定してから回すって動きがあるわけだ」）。最初は Z 軸まわりの 1 つしか持たせておらず、
平面で首を振れるだけで**傾けられなかった**。「斜めに入れる」は普通 X か Y 軸まわりに倒すことなので、
それが書けないと道具の意味が無い。回す中心 `c` は物ごとに渡す（既定は世界の原点で、傾けると物が遠くへ飛ぶ）。
板は `hub_c()`（板の芯）。

**刻みは決め打ちにしない。** 姿勢を n 個置いて union する以上、姿勢と姿勢の**あいだは見ていない**。
刻みより細い物はすり抜けて 0.00 が出る ── それは「入る」ではなく「置いた姿勢では当たらなかった」である。
板は 82mm あるので、芯まわりに **1° 回すだけで端は 0.7mm 動く**。回しを足すほど取りこぼしが増える。
⇒ 1 刻みで物のどの点も `SWEEP_STEP` より動かないよう、区間ごとに n を数える（`pose_move`）。
`SWEEP_STEP` は **1.5**（🔒 ユーザー「重すぎるんでやめてください」）。書き直す前の決め打ち（`path_hub` は 95mm を 60 で刻んで 1.58）
とほぼ同じ細かさで、`path_hub` は 10 秒。0.25 まで落として回しても **16 項目の値は 1 つも動かなかった**ので、
この板と蓋については粗くして失う物は見つかっていない。⚠ ただし「1.5 より細い物はすり抜ける」ことは変わらない。
怪しい所を詰めるときだけ 0.25 に落として回す（`path_hub` が 10 秒 → 120 秒）。
回したときいちばん動くのは端なので、**回す中心から端までの長さ r** を渡してもらう（弧の長さ r・Δθ）。板は `hub_r()` 45.7。

🔴 **`hull()` で隣の姿勢を繋ぐ手は使えない**（2026-09-17 夜に試して捨てた）。凸包なので**へこみが埋まる**。
蓋のような凹んだ殻でやると `path_lid` が 0.07 → **21327mm³** になった。厳密なのは Minkowski だが遅すぎる。
「平行移動なら hull は通り道そのもの」は**凸な物に限った話**である。

- `pcb_fwd()` = `usbc_out()` + 0.5 = **1.8**。数字ではなく式で置く。
  🔴 **関数にすること。** `PCB_HATCH_GAP` はこの行より下で代入されるので、変数だと `undef` になる
  （実際に踏んだ: 天板の窓が `undef` になって STL が書き出されず、**古いファイルの数字を読んで報告した**）。
- `part="path_hub_one"`（`-D PI_=<番号>`）で通過点を 1 つだけ置いて当てられる。どの段で入らないかを見る用。

**道具が直ったら本物を 1 件捕まえた。** 前へ 1.8 ずらした姿勢では、**J10（電池の口・板の裏）が自分の窓から外れて
電池ケースの天板を削っていた**（6.16mm³・世界 X 76.0〜80.5 / Y 24.7〜26.0 / Z 7.0〜8.2）。
窓は最終位置に合わせて開けてあったためである。⇒ `bat_case_j10_win()` の **−Y 側を `pcb_fwd()` ぶん広げた**。
旧の道具では Y へ動かせなかったので、この当たりは永久に見えなかった。

🔴 **「斜めに入れる」は使えない**（2026-09-17 夜。🔒 ユーザー「斜めに入れる道も一度試して、入るか見て」
→ 掃引が重く、測り終わる前に🔒「重すぎるんでやめてください」。**以下は測定ではなく図面の数字からの理屈**）。

| 案 | なぜ駄目か |
|---|---|
| 首を振る（Z 軸） | USB-C は板の X **43.012**、板の芯は X **43.0**。**回転軸の真上**なので何度振っても動かない。加えて内寸 82.66（`IN_X` 84.354 − `LW_X` 1.694）に板 82.024 なので遊びは 0.636。必要幅 `82.024·cosθ + 37.4·sinθ` が内寸を超えるのは **1° 弱**で、そもそも振れない |
| 倒す（X 軸） | 効きはする（15° で USB-C は約 1.5 前へ引っ込む）。だが**最後に口へ入れる一手が回転ではできない**。口は 9.54 × 3.86、殻は 8.94 × 3.26 で**片側 0.3 しかない**。回して戻すと殻の角が弧を描いてこの 0.3 を食う。⇒ 倒しても最後は **Y へまっすぐ押す**しかない |

最後にまっすぐ押すのなら、途中で倒す意味が無い。**前へ 1.8 逃がしたまま入れて押す**いまの道の方が動きが 1 つ少ない。

**検査 16 項目**（`python hardware/tools/stl_v61n.py --check`）: `path_hub` **51.9 → 0.00**。
他の 15 項目は 8.3 の表と全一致（書き直しの巻き添え無し）。
刻みを 0.25mm まで細かくしても値は 1 つも動かなかった（`path_oled` 0.51 / `path_rsp` 0.00 /
`path_bat` 86.82 / `path_lid` 0.07）。**前の粗い刻みが何かを取りこぼしていたわけではない。**
その 0.25 は時間が重すぎた（`path_hub` 120 秒）ので、常用は **1.5**（`path_hub` 10 秒）に戻した。
preflight（MJF）: 底パーツ・蓋とも **🔴 0・二重面 0・中身 1 個**。逃げの 0.4 の段も広げた窓も警告を足していない。

### 9.9 掃引を捨て、判定を距離クエリへ移した（2026-09-17）

🔒 ユーザー「道を通過点で書く形と 3 軸の回しの 0.25 刻みをやったら PC が固まりました」→「旧の掃引検査は削除」。

**なぜ固まったか。** `sweep_pose()` は姿勢を n 個 union して交わりの**体積を作る**。CSG のブーリアンなので
姿勢の数だけ面数が増える。`PATH_HUB` は道のり約 100mm あり、0.25 刻みで 400 姿勢。
`hub_unit()` は 28782 面なので、**1150 万面を 1 つのソリッドに合体**させようとしていた。
粗くすれば今度は姿勢と姿勢のあいだを見ていない。**この方式では「誤報か、重すぎるか」は原理的に解けない。**

**世の中の手**（調べは docs/COLLISION-SURVEY.md）。CAD の当たり判定で交わりの形を作る流儀は無い。
三角形を BVH に入れて**最短距離を mm で返す**（FCL・ROS/MoveIt の標準）。刻みは決め打ちにせず、
「いま d 空いていて、物の最大点速度が v なら d/v 進んでも当たらない」と保証しながら進む（Conservative Advancement）。
誤報はしきい値（clash tolerance）で落とし、体積ではなく**深さ**で判定する。

**移した形。** 形を作るのは OpenSCAD のまま、判定と動画だけ外へ出した。

```
python hardware/tools/sweep_chk.py hub rsp oled bat     # 検査
python hardware/tools/sweep_movie.py bat                # 動画（_tmp_sweep/nylon/bat.mp4。判定は check/nylon/sweep/bat.json）
```

| 道 | 旧（掃引・体積） | 新（距離＋厳密） |
|---|---|---|
| `path_hub` | 0.00 mm³ | 厚み 0.000 mm（同一平面の皮）→ **入る** |
| `path_rsp` | 0.00 mm³ | 厚み 0.000 mm（同一平面の皮）→ **入る** |
| `path_oled` | 0.51 mm³ | **0.512 mm³**・厚み 0.400・1.6×0.8×0.4 @ s=0.898 |
| `path_bat` | 86.82 mm³ | **86.818 mm³**・厚み 2.382・35×6×2.382 @ [15.2, 9.9, 0.5] |

体積は小数 3 桁まで一致した。新しい方は**道のどこで・どんな形で**当たっているかまで出る。
`path_hub` は距離 188 姿勢 1.8 秒 ＋ 厳密 13 回 ＝ **11 秒**（旧は 0.25 刻みで PC が固まった）。4 本まとめて 48 秒。

**`SWEEP_STEP` は無くなった。** 空いている距離から刻みを出すので、広い所は 1 歩で飛び、狭い所だけ細かくなる。
「1.5 か 0.25 か」を人が選ぶ問題も、「刻みより細い物をすり抜ける」穴も消えた。

**誤報の落とし方。** 隙間 0.05mm 以下を接触として扱い、そこで厳密な交わりを取って**主軸で測った厚み**を見る。
0.01mm 未満なら同一平面の皮 ＝ めり込みではない。`path_hub` の接触は 13 姿勢すべて厚み 0.000 の平面で、
板の裏が柱の頭に載っているだけだった。**体積では区別できない**（5mm³ は「深さ 0.01 × 面積 500」かもしれない）。

**外した物。** `case_v6_1.scad` から `sweep_pose` / `pose_move` / `SWEEP_STEP` / `path_*` /
`path_*_one` / `path_*_show` を削除。`stl_v61n.py --check` の 16 項目は **11 項目**になった
（残り 11 の値は撤去の前後で全一致）。`PATH_*`・`at_pose`・`world_for_*`・`lid_flexed` は新しい道具が使うので残す。

**蓋も載せた（同日）。** たわむので 1 つの剛体では書けない ⇒ **2 つに分けた。**
`PATH_LIDMAIN`（天板＋天板に付く物・真下へ降りる）と
`PATH_LIDFLAP`（左の L 字・外へ 1.5 出たまま降り、`LID_REST` で内へ戻る）。
2 つは同じ蓋の部品なので互いには当てない。`PATH_LID` と `lid_flexed()` は置き換えた。
結果: `lidmain` 厚み 0.000（皮）／`lidflap` 厚み 0.440・0.036mm³・6 か所。
6 か所を足すと 0.073mm³ で旧 `path_lid` 0.07 と合う。
⚠ 最後の `LID_REST`(0.3) → 0（ねじで締める分）は見ていない。静止の `sk_*` が見る。

**🔴 塊ごとに測る。合計は持たない。** 交わりは離れた複数の塊になる。まとめて主軸を取ると
別々の平面にある皮が寄り集まって「厚い」に化けた（`lidmain` が体積 0 のまま厚み 5.198）。
そして合計は持たない（🔒 ユーザー「合計は無意味」）── 小さな接触 6 か所と大きなめり込み 1 か所を
足すと区別できなくなり、塊ごとに分けた意味が消える。出すのは**いちばん深い塊**と**所の数**だけ。

## 10. レジン版（板 6 枚）の留めを作り直した（2026-09-18）

入れる道の検査をレジンに対応させるときに出てきた。回し方は [SWEEP.md](SWEEP.md)。

### 10.1 床の板と壁の板が同じ柱を 2 枚持っていた

左 318.33mm³・右 314.99mm³ の重複。レジンでは板が組めない状態だった。

| | 直す前 | いま |
|---|---|---|
| 後ろ 2 点のスペーサー | 床から φ7 を立てる | **立てない**（壁の下の柱が座を兼ねる） |
| 後ろ 2 点のねじ | 床の裏から ＋ 壁の柱の頭にナット | 朝: 板の上から挿して床の裏のナット → **同日夜: 床の裏から ＋ 壁の羽の頭にナット**（戻した。下の 10.1a） |
| 前 2 点のスペーサー | φ7（頭に横差しのナット溝） | **φ5.0 の管**（`HUB_POST_D_R`・`rotate_extrude`） |
| 前 2 点のねじ | 板の上から ＋ 柱の頭のナット | **板の上から挿して床の裏のナット** |
| 左後ろの下の柱の芯 | X 4.694 | **X 4.834**（PCB の穴と一致） |

#### 10.1a 後ろ 2 本を床の裏からに戻した（同日夜）

`nutpath_chk.py`（[SWEEP.md](SWEEP.md) 10 章）で、板の上から挿すと頭の上 23.05 に同じ壁の上の柱が同軸で居て
（通し φ2.5）、壁の格子も頭の柱に 0.7〜0.8 掛かり、ドライバーが入らないことが出た。
上の柱をずらす案（C）と、床の裏からに戻す案（a）を出し、🔒 ユーザー「組み立てづらくなるけど a で行こう」。

- 頭は床の裏の座ぐり（ゴム足の下）。ナットは壁の羽（下の柱）の頭の横差しの溝（口はハッチ側 +Y）。前の下の柱と同じ形
- 引き換え: PCB の後ろ 2 角は羽の頭に載るだけで締めない。締めるのは前の 2 本。M2×15 の先は PCB の穴に 1.0 入って位置だけ決める
- なぜ上からだったか: PCB は ② で先に置き、羽は ④ で後からその下に入るので、PCB ごと締めるねじは板の上からしか入らない。
  その向きは v5 と同じ（🔒 ユーザー「v5 は…底面にナットがついてる。この 6.1 のレジン版も全く同じ」）だったが、上の柱との同軸が邪魔になった
- 確かめた物: 板どうしの食い込み 4 組 0.00 ／ preflight（床・左壁・右壁）中身 1 個・🔴 0 ／ 掃引 5 場面 新 0 ／ nutpath レジン 36 口ぜんぶ空き

根拠: 🔒 ユーザー「ナイロン版は外に持ち出し用」「レジン版は破損のおそれのない室内用です。4 つ足をつけます。
したがって下に貫通し、下部で固定するで良いのです」「v5 はハブ基盤を支えるものが下に貫通していて底面に
ナットがついてる。この 6.1 のレジン版も全く同じ」。

直した後: 板どうしの食い込みは 8 組とも 0.000mm³。preflight（床・左壁・右壁）は 🔴 0・中身 1 個。
ナイロンの shell / lid は体積差 0.000000（壊していない）。

### 10.2 ゴム足の座（φ10 × 0.6）は置かない

v5 は「座の中にナットが隠れる」形だったが、v6.1 の穴位置では成立しない。
板の縁までが 前左 6.306／前右 5.000／後左 5.140／後右 5.000 で、半径 5.0 の座は 4 点中 3 点で縁を割る。
v5 が座を置いたのは M3（ナット 2.6）が床 2.0 に収まらなかったため。M2 のナットは 1.8 なので、
床 2.0 の中に底から 0.6 引っ込んだ位置に収まる（`FOOT_SINK`）。座は要らない。

### 10.3 寸法がされたら止める assert を 3 本入れた

`case_v6_1.scad`。PCB の後ろ 2 穴と、壁の下の柱の芯・蓋のフラップの足のねじが
0.001mm 以上ずれたら止まる（2026-09-16 の指示が半分しか届いていなかった件の再発防止）。

### 10.4 左前の上の柱がタッピングになっていた（2026-09-16 → 09-18 に戻した）

🔒「留めは必ずナット」に反する箇所が 1 つだけ残っていた。`case_v6_1.scad` の上の柱で、ナイロンの左前 1 本。
入ったのは `06fe935`（2026-09-16 の 2 分割）。生きた模型で `TAP_D` を使っていたのはここだけ。

**なぜそうなったか。** 2 分割で前の壁が底パーツの一部になり、ReSpeaker が真上から降りるようになった
（`PATH_RSP` は 45mm 真下・回転なし）。前の上の柱 2 本が板の道に入るので削った。右前は 8.0 → 6.5 で足りたが、
左前は ReSpeaker のボタン **K1**（実測 X 3.232〜7.832・Y 5.600〜8.180・Z 34.895〜38.095）が柱の真下にあり、
板が真下に降りるので K1 は柱の高さを全部通る。柱を Y −0.2〜5.3（5.5）まで詰めた。
そこで「5.5 では溝 6.2（二面幅 4.6 ＋ 肉 0.8 × 2）が入らない」としてナットを外した。

**その引き算が間違っていた。** 柱の前には前の壁 1.6 が密着していて、柱も壁も同じ `shell()`（底パーツ）。
X 1.694〜6.694・Y −1.800〜−0.200・Z 45.454〜50.454 は充填率 100%（体積 39.97 / 40.00）で、
材料は **Y −1.8〜5.3 の 7.1mm 繋がっている**。6.2 は入る。

**直した形。** 柱を前の壁へ `TL_FWD` 0.8 食い込ませて Y −1.0〜5.3（`POST_D_F_TL` 6.3）。
溝は Y −0.150〜4.450、ねじの芯は Y 2.55 → 2.15。実測で前の肉 **1.650**・後ろの肉 **0.850**（MJF の最薄 0.8 以上）。
K1 への空き 0.3 は変えていない。掃引はナイロン 5 本とも新しい当たり 0 件。

⚠ コメントに書いてあった「K1 は X 3.2〜6.7」の 6.7 は K1 の端ではなく**柱の右端**（1.694 ＋ 5.0）だった。
K1 は 7.832 まである。空いている帯は X 1.694〜3.232 の 1.538mm しかなく、そちらへ逃げる道は無い。
