n416/katanori/docs/PCB-V61.md

# v6.1 の板に載る物（2026-09-14）

この資料は **「v6.1 の 1 枚基板に何が載るか」だけ**を持つ。板の外形・穴・口の座標は筐体（`hardware/case_v6_1.scad`）が
持っていて、ここには写した値と、それを板の座標へ直した値だけを置く。配線の進み具合は別の資料にする。

v6.1 の板は、v5 でバラバラだった **ハブ基板（ユニバーサル 44 × 81.2・54 部品）・PowerBoost 1000C・INA226 モジュール・
秋月の Type-C 基板** を 1 枚に統合したものである。回路そのものは v6 で起こした `hardware/frozen/v6/pcb/hub_power/` と同じで、
外形と口の位置だけが変わる。

## 1. 載る物

| ブロック | 部品 | 出どころ |
|---|---|---|
| 充電 | MCP73871-2CCI/ML（QFN-20）・USB-C レセプタクル・CC 5.1kΩ × 2（状態 LED は 2026-09-19 に外した ── POWER.md） | v6 の板。秋月の Type-C 基板（115426）と外付けの CC 抵抗が要らなくなる |
| 昇圧 5V | TPS61090RSAR（VQFN-16）・6.8µH FNR4018S・47µF × 2・10µF × 3・分圧の R | v6 の板。PowerBoost 1000C の置き換え |
| **電力計** | **INA226AIDGSR（MSOP-10）＋ 10mΩ 1206 シャント**。I2C でつまみ・OLED と同じバスに乗る | v6 の板。INA226 モジュールの置き換え |
| **逆接保護** | **AO3401A（P-ch・SOT-23）＋ ゲートの 100kΩ**。電池の ＋ と INA226 のシャントのあいだに入れて、電池を逆に繋いでも電流が流れないようにする | ⭐ 2026-09-16 夕 🔒 ユーザー「MOSFET 一つ入れましょ」 |
| 電源のオン/オフ | EN のプルアップは TPS61090 側。**リードスイッチと電源の押しボタン SW2 が EN を GND へ落とす**（閉 ＝ OFF）。⭐ 2026-09-19 にハッチのマスタートグルを板の押しボタンへ替えた（下の 3 章の終わり） | `docs/POWER.md` 2 章 |
| ミュートリレー | G6S-2F DC5（15.3 × 10.7・**背 9.33** で板の上でいちばん高い）・SS8050・1N4148W・1kΩ・10kΩ・0.1µF | v6 の板。v5 の実機で鳴らしている回路 |
| つまみ | **AS5600（ASOT・`C499458`）を板に直付け**（SOIC-8・足跡 4.9 × 6.2）。磁石はつまみの軸の先に付いて真上から降りてくる | 🔒 ユーザー 2026-09-14「AS5600 を PCB 基板に落として」 |
| XIAO の受け | **2.54 のオスのピンヘッダ 1x07**（信号 4 本 D2・SDA・SCL・D3 ＋ 電源 3 本 3V3・GND・5V）。ライザー側の**裏面の L 字のメス**がこれを受ける。ピンの芯は板の座標 **X 1.770〜17.010（2.54 間隔）・Y 8.935**、courtyard は X 0〜18.79 で板の左の縁と面一 | 枠は KiCad の courtyard 18.80 × 3.54・樹脂 17.78 × 2.54 |
| OLED の受け | **2.54 のオスのピンヘッダ 1x04**（SDA・SCL・3V3・GND）。ピンの芯は板の座標 **X 37.240〜44.860（2.54 間隔）・Y 1.9** | 枠は courtyard 11.16 × 3.54・樹脂 10.16 × 2.54 |

板厚 1.6・**部品はほぼおもて（F.Cu）**。裏に居るのは電池の口 J10 だけで、電池の右の帯（板の座標 X 66.05〜）に立つ。
電池の真上は板の裏まで 6.0 しか無いので、そこには置けない。

## 2. 線が残る口（枠は板の座標・2026-09-14 に置いた）

ライザーと USB-C 以外は線で外へ出る。ネットは v5 のハブ基板と同じである（`hardware/parts/hub_ports.py`）。
口は **JST-PH 2.0**。⭐ 2026-09-16 夕に、courtyard だけでなく **胴（F.Fab）の実寸**も持つようにした
（`v61_board.py` の `PH2_V_BODY` ほか）。courtyard は KiCad が周りに 0.3〜0.5 の逃げを足した**置き場所の予約**で、
物の形ではない。筐体の窓や、板を挟んだ当たりは胴で見る。

| | JST の表（📄 ePH.pdf 1・3 ページ） | KiCad の F.Fab（胴） | courtyard | 背 |
|---|---|---|---|---|
| S2B-PH-K（横出し 2 ピン） | B 5.9 × 幅 4.8 | 5.90 × 7.60 | 6.90 × 8.60 | 4.8 |
| S4B-PH-K（横出し 4 ピン） | B 9.9 × 幅 4.8 | 9.90 × 7.60 | 10.90 × 8.60 | 4.8 |
| **B2B-PH-K**（縦 2 ピン） | B 5.9 × 幅 4.5 | **6.31 × 4.91** | 6.90 × 5.50 | 胴 6.0・**嵌合 8.0** |
| B4B-PH-K（縦 4 ピン） | B 9.9 × 幅 4.5 | 10.31 × 4.91 | 10.90 × 5.50 | 胴 6.0・嵌合 8.0 |
| ハウジング PHR-2（相手） | **5.8 × 4.5** | — | — | — |

🔴 **PHR-2（5.8 × 4.5）は B2B-PH-K の胴（5.9 × 4.5）の中に収まる。**
⇒ **縦の口は、挿しても平面の外形が胴より広がらない。** 筐体の窓は「胴 ＋ 逃げ」だけでよい。

横出しの口には、プラグの相手が板の面に沿って入る 3.1（`PLUG_D`）を「通り道」として同じ向きに取ってある。
この 3.1 は見積りではなく 📄 2 ページの `(9.6)` − 胴 6.0 − courtyard の逃げ 0.5 で出した数で、**横出しにしか意味がない**。
縦の口は面を食わないので通り道は取らない（`plug_box()` は ±Z で `None` を返す）。
位置は筐体がくれた線の行き先の実測から決めた。

📄 この PDF は暗号化＋埋め込みフォントで、そのままでは数字が読めない（表の数字が丸ごと落ちる）。
`pypdf` で復号してから `pdfminer` で座標つきに開くと出る。2026-09-16 夕にそうやって 1・3 ページの表を取った。

芯の座標は `hardware/pcb/v61_board.py` の `PORTS` が正（ここへは写さない）。
⭐ 2026-09-19 🔒 ユーザー「板単体で見たときにも美しいと思える配置に」: 後ろの縁の J6・J7 を同じ線（`REAR_ROW_Y`）にそろえ、J7 はつまみの軸の芯の真下へ。

| 口 | プラグを抜く向き | ネット | 行き先 |
|---|---|---|---|
| J4 SPK IN | 縦（上向き） | SPKP・SPKM | ReSpeaker の J2 |
| J5 SPK OUT | 横出し −X | SPKM・SPKO | スピーカーの線の出口 |
| J6 会話ボタン | 縦（上向き）・後ろの縁の列 | GND・BTN | 天板の会話ボタンの端子 2 本 |
| J7 リード（2 ピン） | 縦（上向き）・後ろの縁の列 | EN・GND | つまみの台座のリードの穴。⭐ 2026-09-19 まではトグルと合わせた 4 ピン |
| J10 電池 | 板の裏・縦（下向き −Z） | VBAT・GND | 板の真下の電池のタブ（電池の**右**の短い辺） |

**リードの口を縦にしたのは、横出し +Y だとプラグがハッチの板に刺さるからである**（トグルと合わせた 4 ピンの頃の測り）。
筐体が通り道を回して 136.03mm³ の当たりを出した（世界 Y 51.40〜54.00 ＝ ハッチの内面から板厚の中）。
挿したプラグ自身がそこに居座るので、ハッチが閉じられなくなる。縦なら上に 27 以上空いている。

**電池の口は板の裏（B.Cu）に下向きで置いた**（🔒 ユーザー 2026-09-14「電池は板の裏にあるんだから、口も裏に出せばいい」）。
線が板を回り込まず、電池からまっすぐ挿さる。いったん作った前の縁の欠きは、これで要らなくなったので廃止した。

板の裏で胴が入るのは、電池の外の 2 本の帯だけである（電池の真上は 6.0 しか無い）。
左の帯が板の座標 X 0〜16.05・Y 8〜29、右の帯が X 66.05〜82.024・Y 8〜29 で、どちらも 16 × 21 ある。

⭐ **2026-09-16 夕に右の帯へ移し、縦（トップ型 B2B-PH-K）にした。** 🔒 ユーザー「ケーシング作ったから垂直のがいい。結局一番穴は小さくなる」。
- 同日に `BAT_RZ` が 90 → 270 になり、電池のタブが左（世界 X 18.05）から**右**（68.05）へ移った。口も右へ来れば線は 10mm で済む
- 左の帯は**電池が −X へ抜ける道の真上**で、電池のケーシングの天板（Z 7.0〜8.2）に大穴が要る。右の帯なら電池が一度も通らない
- 天板の窓が **12.7 × 7.9 → 8.11 × 5.91**（胴 6.31 × 4.91 ＋ 逃げ 0.5 ＋ 板を右へ滑らせる 0.8）。面積 100.3 → 47.9mm²

**置ける所は次の 4 つで決まった**（板の座標）:
- X 66.05 より右（世界 68.05 ＝ 電池の右端。ここより左は電池の抜け道）
- 床の柱 φ7 を外す（X 69.0〜76.0 × Y 0〜7.0 と 29.9〜36.9）
- 🔴🔴 **J10 は裏に付くが、はんだ足 2 本は表へ突き抜ける。** その足を
  ① 表の **J4 の胴**（Y 〜14.30）と ② **J4 に挿さったプラグ**（Y 14.30〜16.30 ＝ 胴 ＋ 2.0）の外へ出す
- **USB-C のシェルの足**（スルーホール・Y 20.63〜）を外す

②と④に挟まれた帯は **4.33** しかなく、パッドを Y へ並べる形（枠 5.5 × 6.9）は入らない。
⇒ **パッドを X へ並べた**（枠 6.9 × 5.5・角度 180）。枠 **X 73.00〜79.90 × Y 14.475〜19.975**。
足は J4 のプラグから **0.60**・枠は USB-C の足から **0.655** 空く。

⚠ その代償で、**極性の言い方が「手前／奥」から「左／右」に変わった**（8 章）。

②を最初に見落として 1 度置き、筐体側の `hit_wires`（1.17mm³ ＝ SPK IN の線が J10 の足に当たる）で見つかった。
基板側の検査は「表と裏は当たらない」で切り分けた所で**足を見ていなかった**ので、同日に
`gen_pcb.py` のプラグの通り道の検査へ「相手が裏なら、その**板を貫くパッド**だけを見る」を入れた。

📄 `hardware/ref/jst_ph/ePH.pdf` 1 ページに「With a mounting height of 8 mm ... in the top-entry version」とあり、
**トップ型は嵌合した高さが板の面から 8.0** ある。ナイロン版は板の裏が Z 12.0・床まで 12.0 なので、**4.0 余して入る**。

⚠ ただし帯の Z 7.0〜8.2 には電池のケーシングの天板が渡っている。**そこに窓を開けてもらうのが前提**で、
嵌合したプラグ（下端 Z 4.0）は天板を 3.0 突き抜けて下へ出る。窓は胴 6.31 × 4.91 ＋ 逃げ 0.5 で足りる（PHR-2 が胴の中に収まるため）。

⚠ 電池の真上は板の裏まで 6.0 しか無い（嵌合 8.0 が入らない）ので、裏の口は電池の外の帯にしか置けない。

🔴 **組む順**（縦にしたので変わった）: 電池を左の窓から入れて線を右の帯へ垂らす → **プラグを J10 に挿してから板を降ろす**
（下向きの口なので、板を据えてから下から挿す手は入らない）→ ねじ 3 本。PHR-2 は胴の中なので窓を通る。

**SPK OUT のプラグを抜く向きは −X（左の縁）**である。裏の口がサイド型だった時に、表の通り道と裏のパッドが
板の面で重なったので変えた。トップ型に戻った後も、筐体が −X で当たりを取り直して空なので、そのままにしている。

🔒 **電池はタブ（線の出る端）を**右**にして入れる。** タブは短い辺（35 の端）から出る（v4 の配置の記録・`hardware/parts/parts.scad`）。2026-09-16 夕に `BAT_RZ` 90 → 270（🔒 ユーザー「バッテリを Z 軸１８０度回転」）で、タブが世界 X 18.05（左）から 68.05（右）へ移った。J10 を板の右へ移したのと対。
🔒 **外形は渡された 82.024 × 37.4 が最大**で、広げない（ユーザー 2026-09-14）。

⭐ **2026-09-19: ハッチのトグルをやめ、板の後ろの縁の押しボタン SW2 にした**（🔒 ユーザー「板の後ろの縁に押しボタンを載せる方法にしようか」「2 で」）。
- 品: **XKB5858-Z-E**（LCSC C780038・横向き・自己保持・DPDT・0.1A 30V DC・$0.30・押し子 5.0）。足形は `katanori.pretty/SW_XKB5858-Z-E`（パッドは JLC の足形のまま）。図面は `hardware/ref/xkb5858/C780038.pdf`。
  同日、押し子 2.5 の -75（C780035）から替えた: 押し込み 2.0 に対してキャップが 0.3 しか掛からない（🔒 ユーザー「キャップがつかない」）
- 位置: 板の座標 (25.5, 30.9)・0°。胴の前の面を板の後ろの縁から **2.8** 下げる（キャップの顔の出から逆算・`v61_board.py` の `PWR_INSET`）。USB-C の左隣で、口の面取りの縁どうし 5.2（🔒 ユーザー「もうすこし USB から離さないとおかしい」で 4.0 左へ）
- 接点: 1–3 番が「離して閉・押し込んで固定すると開」（📄 データシートの CIRCUIT DIAGRAM）⇒ **1 GND・3 EN**（EN の行き先が右なので右の 3 番。左の 1 番に EN を置いたら J6 との隙間で引けなかった）。出ている間は OFF、押し込むと電源はつまみ（リード）に従う。1–3 が「出ている間に閉」の根拠: 📄 CIRCUIT DIAGRAM（RELEASE で 1–3・LOCK で 2–4。4–6・2–5 は常に結ばれた同じ端子）と、📄 PCB LAYOUT のピンの前後（1・3 は胴の前寄り、2・4 はその 2.0 後ろ）。動く接点は押し子と一緒に前後し、出ていると前の 1・3、押し込むと後ろの 2・4 をつなぐ。2 つの図が同じことを言う
- 残り 2・4・5・6 番は使わない。J7 はリードだけの 2 ピンになった。C31 は SW2 と重なったので SW2 の前 (22.9, 27.15) へ固定
- 筐体: 押し子に丸いキャップ（φ6.6・顔の芯は USB-C の口の芯の高さ・鍔で抜け止め・顔に電源の記号）。キャップは**光造形（レジン）で刷る**。形は `case_v6_1.scad` の `pwr_cap`、断面の模型は `part="look_pwrcap"`
（それまで: リードとトグルは同じ EN と GND を並列に落とすだけなので 4 ピン 1 つにまとめ、トグルはハッチの板に付いて線 2 本で来ていた）

前の縁の外は ReSpeaker の板（世界 Y 8.185〜10.035）まで 3.5 しか無いので、**前（−Y）向きの口は挿せない。**
後ろの縁は、柱の欠き 2 つと留めねじの頭 2 つを避ければ、板の外へ通り道を出してよい（殻の側で空けてもらう）。

## 3. 筐体から来た数字（動かせない）

板の座標は板の左前の角が原点で、**世界 = 板 + (2.0, 13.5)**。

- 外形 **82.024 × 37.4 × 1.6**。世界 X 2.0〜84.024・Y 13.5〜50.9。裏が **Z 12.0**・表が **13.6**
  （⭐ 2026-09-16 夕: 電池のケーシング `BAT_CASE` 6.0 が**レジンにも入った**ので、両材料ともこの高さになった）
- 取付穴 M2 φ2.2 が **4 点とも使える**（⭐ 2026-09-16 夕・🔒 筐体側）。板の座標で
  **(4.0, 3.5) (79.354, 3.5) (2.834, 33.9942) (79.354, 34.9)**。世界では (6, 17) (81.354, 17) (4.834, 47.4942) (81.354, 48.4)。
  （⭐ 2026-09-17 に検算。右前は 72.5 と書いてあったが板の穴は 79.354 で、出どころは `python hardware/pcb/check_fab.py` が穴あけファイルから読む表）
  🔒 **留めは 上から 3 本・下から 1 本。** 下の 1 本は**左後ろ (2.834, 33.9942)** で、床の裏 → 床 → 床から立つ柱 → 板 →
  蓋のフラップが持つ座のナット（板の上 Z 13.6〜17.0）を一本で締める。板から見れば 4 点とも φ2.2 の素通しで、
  **4 点とも板の上に頭かナットが出る**（ナットの下が空いているかの検査はそのまま効く）。
  ⚠ 2026-09-14 の「左前は使わない・ねじは 3 本」は取り消し。後ろの 2 点も (10.0, 33.4) (72.5, 33.4) から動いた
- **板の欠き（後ろの両隅）は全廃**（⭐ 2026-09-16 夕）。欠きは「上から降りてくる物（蓋の足・壁の上の柱）を板が避ける」ためで、
  蓋の足が**床から立つ柱**に置き換わって降りてくる物が無くなった。合わせて **41mm² の銅が戻った**。
  ⭐ 2026-09-17 に**最後の 1 個（後ろのレールの逃げ・板の座標 X 0〜1.694・Y 37.1〜37.4）も廃止**した
  （🔒 ユーザー「たった 0.3mm で逃げもクソもない」）。板は左の窓から差して入るので後ろの縁 82mm 全部が
  レールを通る ⇒ 角だけ欠いても筐体の掃引は 0.544mm³ 残ったままで、深さ 0.3 × 幅 0.9 はルータの刃 φ2 でも切れない。
  逃げは筐体のレール側（`flap_rail_pcb_relief`）へ移した。**板に欠きは 1 つも無い**（`NOTCHES = []`・
  外形は角の立った 82.024 × 37.4）。詳しくは docs/CASE-V61N.md 9.7
- 充電 USB-C は板の**後ろの縁（ハッチ側）・X 中央**。胴は板の座標 X 36.542〜45.482・Y 31.400〜38.700 で、
  板の後縁 37.4 から **1.3 出る**（⭐ 2026-09-17: 右の縁 y 26.0・1.53 出しから移した。前の縁は壁ではなく
  ReSpeaker の板が立っていて、胴を出すと残り 1.935 でプラグが入らない）
- AS5600 は (63.7, 13.8)（U4 の胴は板の X 61.750〜65.650・Y 11.350〜16.250）。板の表が世界 Z 13.6、
  IC の背 1.75 で上面が **15.35**・磁石の下面が **16.45**（隙間 1.1）。**真上に φ6 の空きが要る**
  （⭐ 2026-09-20 に検算。出どころは `hardware/pcb/v61_parts.scad` の U4 の行）
- XIAO のライザー（J1・1x07）: 胴が X 0.500〜18.280・Y 10.835〜13.375（ピンの列は Y 12.105。⭐ 2026-09-19 に +0.30。ライザーの表の XIAO のメスを表面実装にして板が 0.30 後ろへ下がったため）。
  OLED のライザー（J2・1x04）: 胴が X 35.970〜46.130・Y 3.500〜6.040（ピンの列は Y 4.770）
  （⭐ 2026-09-17 に検算。y 8.935 / 1.9 は古い。出どころは `hardware/pcb/v61_parts.scad`）
- 表に使える高さは **36.854**。板の表 13.6 から天面の内面 50.454 まで
  （⭐ 2026-09-17 に検算。つまみの台座は天板の**外面** 52.954 に載るので、もう内側の高さを削らない。
  旧「台座の裏 41.45 まで 31.85」は板の裏が 8.0 だったころの値）

2026-09-14 に `hardware/_tmp_v61_pcbchk.scad` の echo で取った。⚠ **そのファイルはもう無い。**
いま取り直すなら: 穴と外形は `python hardware/pcb/check_fab.py`、板の上の物は `hardware/pcb/v61_parts.scad`
（`python hardware/pcb/gen_case_parts.py` が作る）、筐体側の高さは `case_v6_1.scad` を include して
`HUB_AT` / `Z_TOP` / `MAG61_Z0` を echo する。筐体が動かせば動く。

### 3.1 逆向きの流れ ── 板の上の物は、板から筐体へ渡す（2026-09-16 夕）

この章は「筐体 → 板」の一方通行だが、**板に何が載っているか**は逆向きに流れる。

筐体の `case_v6_1.scad` は、板に載る物を `PCB_PARTS` という表で持っている。
2026-09-16 夕まで、これは**手書きの 9 行**だった。板には 55 個載っているので **46 個が模型に存在せず**、
存在しない物には当たらないので、筐体の当たり検査の 0 は「問題なし」ではなく「**見ていない**」を意味していた。

⇒ いまは `hardware/pcb/katanori61/katanori61.kicad_pcb` から起こす。

```
python hardware/pcb/gen_case_parts.py     # → hardware/pcb/v61_parts.scad（56 行）
```

`case_v6_1.scad` はこれを `include <pcb/v61_parts.scad>` の 1 行で読む。
**板を置き直したら、この道具を回し直すこと。** 回さないと筐体の模型が古い板のままになる。

何を板から取り、何を手で持つか:

| | 出どころ |
|---|---|
| 平面の形 | **胴（F.Fab / B.Fab）の外接枠**。courtyard は KiCad が付けた逃げ込みの「置き場所の予約」で物の形ではないので使わない |
| 面 | F.Cu / B.Cu |
| 足の枠 | 板を貫くパッド（thru_hole / np_thru_hole）の外接枠 |
| 背 | **KiCad が同梱している 3D モデル（STEP）の Z の最大**。足形が指しているファイルを読む（📐）。<br>ただし `gen_pcb.py` の `HEIGHT` の出どころが **📄（データシート）か 🔒（決め）なら手の値が勝つ** |
| 抜く向き・通り道・足の長さ | `gen_case_parts.py` の `PORTS`。口だけが持つ |

⚠ **名前を変えないこと。** 筐体は綴りで引く（`pcb_part("J10 BAT")` / `pcb_mouth("J4  SPK IN")` / `j5_frame()`）。
変えると筐体側が undef になって**黙って**壊れる。

⭐ **背は 2026-09-16 夕に実測へ替えた**（🔒 ユーザー「そもそもだけど、表面実装の抵抗とかがなんでこんな分厚いの？」）。
それまでは `HEIGHT_DEFAULT` の **1.45 を 45 個に配っていた**。1.45 は「0805 の抵抗とコンデンサと LED はこれ以下」という
**上限**で実寸ではなく、0805 の抵抗は実際 **0.45**（3.2 倍厚く描いていた）。

いまは 45 個を STEP で測っている。手の値が勝つのは 9 個だけ:

| | 背 | なぜ手の値か |
|---|---|---|
| K31 | 9.33 | 📄 en-g6s.pdf ＋ STEP |
| J4・J6・J7・J10 | 6.00 | 📄 ePH.pdf Top entry（胴。嵌合は 8.0） |
| J5 | 4.80 | 📄 同 Side entry |
| U4 | 1.75 | 📄相当 JLCPCB C79815 |
| J1・J2 | 2.50 | 🔒 **STEP はピンの 6.0 まで入って 8.5 になる**。要るのは板の上に立っている樹脂だけで、ピンはライザーの裏の L 字が咥える |

⚠ 残る ⚠ は **J13（USB-C）の 3.16** だけ（自作の足形なので 3D モデルが無い。二次資料）。

🔴 **`HEIGHT` に値を足すときは、出どころの頭を 📄 か 🔒 にするかどうかで動きが変わる。**
付けないと 3D モデルの実測で上書きされる。J2 で一度踏んだ（2.5 が 8.65 になった）。

⚠ **USB-C を二重に置いている**（筐体の `usbc61()` と、生成した `J13` の行）。
union の中なので害は無いが、`usbc61()` は壁の口 `USBC_PORT_C` の出どころでもあるので単純には消せない。
⭐ 2026-09-17 夕: この 2 つが **1.2 ずれていた**。`usbc61()` が `(IN_Y + HATCH_T - 0.8) - PCB_Y1` で
レジンだけ 2.5 出しており、板の J13（どちらの材料でも 1.3）と合わない。模型の口だけが外へ出ていた。
筐体側を `PCB_HATCH_GAP + HATCH_T_NYLON - USBC_RECESS`（= 1.3・基板側と同じ式）に直して揃えた。
当たりの体積は前後で同じ（`sk_hub` レジン 12.02・ナイロン 0.00、`r_hatch` T=0 で 27.32）。

56 個にして回した当たり検査は、**9 個のときと 16 項目すべて同じ値**だった（[CASE-V61N.md](CASE-V61N.md) 8.3）。
新しく入った 46 個はどれも電源の区画の中に収まっている。

🔴 **ナイロン版（v6.1n・[CASE-V61N.md](CASE-V61N.md) 8 章・2026-09-16）では次の 3 つが上と違う。板の設計は変えなくてよいが、知っておくこと:**

- ~~板の裏は Z 12.0（レジン 8.0）~~ ⭐ 2026-09-16 夕に**レジンも 12.0** になったので差が消えた（3 章に反映済み）
- ~~充電 USB-C の板の縁からの出は 2.58（レジン 1.53）~~ ⭐ 2026-09-17: 口を**後ろの縁（ハッチ）**へ移し、
  出は**両材料とも 1.3** に固定した。板は 1 枚・足形は 1 つなので、材料ごとに出を変えられない。
  レジンのハッチは 2.8 と厚いので、口のまわりを外面から 1.2 掘って残り肉 1.6 ＝ ナイロンと同じにする。
  **奥まりはどちらも 0.80**（胴の奥の面が世界 Y 52.2・ナイロンの外面 53.0・レジンの掘った底 53.0）
- ~~左後ろの欠きは X 〜7.6・Y 29.9 から~~ ⭐ 2026-09-16 夕に**欠きは全廃**（3 章）。蓋の足が床から立つ柱になったため
- 🔴 `fab.py` は 2026-09-16 夕から、kicad-cli を呼ぶときに `--check-zones` を**自分で付けて**書き出す。基板ファイルにはベタの塗りを保存していないので、これが無いと GND ベタが**空**のガーバーになる（それまでの fab の B_Cu は塗り 0 面だった。出し直した物は 3 面 → J10 を右の帯へ移した 2026-09-16 夕の出し直しで 4 面）。⚠ **コマンドラインに書くものではない。**`fab.py` は `sys.argv` を読まないので `fab.py --check-zones` と打っても引数は捨てられる（2026-09-17 まで 5 章がこの綴りで、付けないと塗られないように読めた）

## 4. 私が仮に決めた事

線の口を JST-PH 2.0 にした。ライザーは 2.54 のピンソケットで、足跡の奥行きは 2.54 と置いた。
リードとトグルを 1 つの 4 ピンにまとめた（⭐ 2026-09-19 にトグルをやめ、リードだけの 2 ピンになった）。
🔴 **ミュートリレー K31 は AS5600 の横から退けた（2026-09-17 夕）。**
前は板の (56.3, 17.8)〜(71.6, 28.5)で、筐体の仮置きから**前へ 2.0**（つまみの軸まで残り 0.5）
まで寄せていた。つまり、**電磁石を磁気で角度を読むセンサの真横へ、限界まで寄せていた**。
胴と胴のすきま 3.16mm・芯と芯 9.47mm。
これを 90° 回して **X 46.48〜57.18・Y 20.30〜35.60** へ移した。

| | 前 | いま |
|---|---|---|
| 芯と芯 | 9.47mm | **18.47mm**（1.95 倍） |
| 胴と胴（Y） | 3.16mm | **4.05mm** |
| 胴と胴（X） | 0（重なっていた） | **4.57mm** |
| 磁石（双極子・1/r³）の場 | 1 | **約 7.4 分の 1** |

⭐ 2026-09-20 に引き直した。枠は `hardware/pcb/v61_parts.scad` の U4 の行と `K31 RELAY LEADS` の行から取っている。

⚠ [MEDIATOR-V6-HANDOFF.md](MEDIATOR-V6-HANDOFF.md) 3 章の見出し「**設計で潰す手は無い**」は
**誤り**である。板の 64% には部品の胴が無く、留め穴・欠き・縁 0.5 を避けても
リレーが入る場所は **501 通り** あった。「オフセットなので knobzero が消す」は
残る差を説明する話であって、**離せない理由ではない**。
実機で確かめる項目（つまみを 1 か所に置いて K31 を開／閉し、AGC(0x1A) と RAW ANGLE を
2 回読む）は残すが、出発点の距離が違う。
充電の USB-C は v6 と同じ **HRO TYPE-C-31-M-12（16P・LCSC C165948）**にした。足跡は KiCad 標準の
`Connector_USB:USB_C_Receptacle_HRO_TYPE-C-31-M-12`（足 4 本）で、胴は **8.94 × 7.30 × 3.26**。
筐体の一般値（8.94 × 3.26・奥行 7.35）とほぼ同じなので、殻の口は直さなくてよい。
⚠ 2026-09-17 に自作の `NoFrontLegs` 版（v6 用・出 3.0）へ一度戻しかけたが、出を 1.3 に下げて素の足形へ統一した。

🔴 **板の縁から出す長さが 1.5 を超えると、後ろのシェルの足 2 本が板の縁からはみ出す。**
後ろの SH パッド（貫通・1.00 × 1.60）は芯が (36.692, 36.100) と (45.332, 36.100)、奥の端が **Y 36.900**。
板の後縁 37.400 まで 0.500 しかなく、銅を縁から 0.3 空ける規則（`min_copper_edge_clearance`）を守ると
余りは **0.2** ＝ 出の限界 1.5。**v6.1 は 1.3 出しなので素の足跡（足 4 本）が使える。**
板の座標でいうと、胴が X 36.542〜45.482・Y 31.400〜38.700（1.3 が板の外）になる。
⚠ 旧「2.6 を超えると前の足 2 本が外れる」は、口が**右の縁**に居て自作足形だったころの値。

区画と口の地図は `hardware/pcb/v61_map.svg`（`python hardware/pcb/v61_map.py` で刷り直す）。
同じスクリプトが、区画・口・プラグの通り道 × 動かせない物 の重なりを数えていて、いまは 0 件である。

## 4.1 まだ決めていない（2026-09-16 夕）

- ✅ **シルクの線幅は表裏とも 0.15 に揃っている**（⭐ 2026-09-17 夜にガーバーで確かめた。
  `katanori61-F_Silkscreen.gbr` / `B_Silkscreen.gbr` のアパーチャは `%ADD10C,0.150000*%` の 1 種類だけ）。
  前はここに「足形が持つ枠線が 0.12 で、JLCPCB の公表値 ≥0.15 を下回る」とあったが、直した後も ⬜ のまま残っていた
- ✅ **J4 と J6 の口は縦（B2B-PH-K・上から挿す）。** 2026-09-16 に横出しから替えた。
  J10 のパッドもそれで Y 並び（手前／奥）へ戻った（8 章）。ここは 2026-09-18 まで ⬜ のまま残っていた

## 5. 次にやること

板の外へ出る物（口 5 つ・ソケット 2 つ・USB-C・AS5600・穴）は 2026-09-14 に全部決まり、筐体の模型にも入った。
USB-C の型番も 2026-09-14 に決まったので、**板の外へ出る物は全部決まった。**

板は 2026-09-14 に**配線まで通った**（DRC エラー 0・未接続 0）。道具は `hardware/pcb/` にある。

```
python hardware/pcb/gen_sch.py && python hardware/pcb/check_sch.py         # 回路図と突き合わせ
python hardware/pcb/gen_pcb.py && python hardware/pcb/route.py            # 配置 → 自動配線 → DRC
python hardware/pcb/route.py --incremental                                 # 🔴 残りを引く（下）
python hardware/pcb/check_pcb.py                                           # 銅箔どうしのすきま
python hardware/pcb/fab.py && python hardware/pcb/check_fab.py             # 製造ファイルと、その検算
```

🔴 **`route.py` を 1 回で終わらせない。** 欠きを全廃して板が広くなった 2026-09-16 夕から、
Freerouting は 1 回目で VBUS を **3 本引き残す**（パスを 40 → 120 に増やしても、ネックダウンを切っても同じ）。
`--incremental`（引けている配線と穴を種に入れて残りだけ引かせる）を続けて回すと **4.6 秒で 0 になる**。

⚠ その `--incremental` は 2026-09-16 夕まで**壊れていた**。「φ0.59 以上は縫いのビア」として落としていて、
自動配線のビア（**φ0.8**）まで種から抜けていた ── 多層をまたぐネットが全部切れて、未接続が 40 本出る。
縫いのビア（φ0.6）だけを落とす形に直した。

⚠ その `--incremental` は **2026-09-17 夜にもう 2 か所壊れていた**（どちらも黙って空振りする形）。直してある:
- **種が DSN に入っていなかった。**`seed_wiring()` は「空の wiring」を置き換える作りで、`gen_pcb.py` が
  先に引いた線を protect で wiring に書くようになってから、置き換える相手が無くなっていた（`type route` が 0 行）。
  ⇒ wiring の頭へ差し込む。入らなければ止まる
- **種を渡すと配線がほぼ全部消えた**（未接続 82 本）。Freerouting 2.4.1 は種の線と穴を SES に `type protect` で返し、
  `merge()` は protect を捨てて板の配線を全部置き換えるため。⇒ `--incremental` のときは板の上の配線を残し、SES の新しい線だけ足す
- 縫いのビアは**大きさではなく `(free yes)` の印**で見分ける。4 層化で自動配線の穴も φ0.6 になり、
  「0.65 未満は縫い」が全部の穴を落としていた

⭐ 2026-09-17 夜の通し: 全部の引き直し 約 1 分（未接続 1 本 ＝ BTN）→ `--incremental` 約 15 秒で **未接続 0・エラー 0**。

🔴 **発注の前に回すのは `check_fab.py`。** ガーバーとドリル（JLCPCB へ送る物そのもの）を
配置のコードとは別の道で読み、外形・電池の極性・取付穴・ライザーの穴を突き合わせる。

残っているのは発注だけで、ユーザーの判断で**来月**である。そのとき JLCPCB の在庫と区分と価格を取り直す
（AS5600 は 2026-09-18 に在庫の多い ASOT `C499458` へ替えた。表示灯と Q1 は 2026-09-19 に外した）。

## 6. ライザーの受け方が 3 回変わった（2026-09-14）

最初は線（PH の横型）だった。次にライザーの板を立てることになり、板の側を **2.54 の縦のメスソケット**にした。
ところがこのソケットは背が 8.5 あり、ライザーの板の下端が世界 Z 18.1 になって、XIAO の下のメス（15.61）に
**2.49 届かなかった**（筐体が模型に入れて出した）。

🔒 ユーザー 2026-09-14「ライザーは裏から L 字の水平に出すソケットを付ければいけるか」で決着した。
**板の側はオスのピンヘッダ**（樹脂は板の上に 2.5 ほど）で、**ライザー側が裏面の L 字のメス**で受ける。
ライザーの板の下端が 12.1 に下り、下のメスとの間に 3.51 残る。

**穴の並びは 3 回とも同じ**（1x07 と 1x04・2.54・ピンの芯の座標も同じ）なので、配線はそのまま生きた。
変わったのは部品の指定と背と courtyard だけである。

## 7. L 字のメスの寸法（2026-09-14・Sullins の .100 系のカタログ）

ライザーの裏面に付く **2.54 の L 字（右角）のメス**の寸法を、
[Sullins の .100" Female Headers のカタログ](https://sullinscorp.com/catalogs/101_PAGE114-115_.100_FEMALE_HDR.pdf) から取った。
1 列の右角（型番の 3 文字が `LGB`）は **.335" [8.50]（胴の長さ）× .100" [2.54]（胴の幅）・足 .124" [3.15]** である。

KiCad の `PinSocket_1x07_P2.54mm_Horizontal` は説明文に「8.51mm socket length」と書いてあり、この系列と同じ物である。
足跡の外形 10.03 は、胴 8.50 ＋ 足の曲がりの 1.53 に当たる。

⇒ **胴は板の面から 2.54 の厚みで寝ていて、接点の軸はその真ん中＝ 1.27**。
筐体が置いた「ライザーの板 1.6 ＋ 1.27 ＝ **2.87**」はこれで裏が取れた。
⚠ 残る仮定は「胴が板に密着して寝ていること」と「接点が胴の厚みの真ん中にあること」の 2 つで、
図面の断面までは読んでいない。型番を最終的に決めるときにもう一度当てる。

## 8. 🔴🔴 電池の口（J10）の極性 — 組む前に必ず読む

J10 は**板の裏**に付く。裏面の足形は KiCad の中で鏡になるので、表と同じ角度で置くと
口が逆（−X）を向き、2 つのピンの位置も入れ替わる。**2026-09-14 に置いたあとの座標を測って固定した。**

⚠ 2026-09-16 夕に一度「左／右」へ変わったが、**同日中に「手前／奥」へ戻した**（🔒 ユーザー「J10の極性も手前奥に戻して」）。
左右で書かれた手順書が出回っていたら捨てること。

| | 板の座標 | 板の上での言い方 |
|---|---|---|
| パッド 1 ＝ **GND（−）** | (75.700, **16.950**) | **奥**（ハッチ側） |
| パッド 2 ＝ **VBAT（＋）** | (75.700, **14.950**) | **手前**（OLED 側） |

口（プラグの入る側）は **−Z ＝ 真下（電池の側）**。枠は X 73.50〜79.00・Y 12.50〜19.40。
この 2 点は `gen_pcb.py` の `CHECK_PADS` に入れてあり、**入れ替わると生成の時点で止まる**。
`check_fab.py` も、パッドが並んでいる軸を見て「右が GND ／ 左が VBAT」と刷る。

一度 X 並びにしたのは、**J4 に挿さったプラグ（板 Y 14.30〜16.30）と USB-C のシェルの足（20.63〜）に
挟まれて 4.33 しか無く**、Y 並びの枠 6.9 が入らなかったためである。
同日に **J4 を縦へ替えてその帯が消えた**ので、Y 並び（角度 270）へ戻した。

### この電池のプラグの指紋（2026-09-16 夕・ユーザーが現物を見て）

🔒 **爪（ロックの出っ張り）のある面を上・線の出ている側を手前にして持つと、赤は左。**

これがユーザーの電池（DTP603450(PHR)）の向きである。テスタを当てる前に、まずこれと見比べればよい。

⚠ ただしこの指紋から「赤が J10 の何番に入るか」を紙の上で導くことはできない。
PHR-2 のハウジングのどちらが 1 番の穴かは、リポジトリにあるデータシート（603048・502535）には描かれていない。
**確かなのは実機の実績のほうである**: 2026-09-11 の事故のあと、同日 03 時台と 12:51 に
**この電池をそのまま PowerBoost 1000C の JST-PH に挿して動いている**（[POWER.md](POWER.md)）。
v6.1 の J10 は `check_sch.py` が PowerBoost の B1 と突き合わせて 1番=− / 2番=＋ の一致を確かめているので、
**この電池はそのまま挿さる。**

⚠ 2026-09-11 に燃えた原因は電池のプラグではなく、あいだに挟んだ**圧着済みの延長ペア**である
（噛み合わせると赤と黒が入れ替わる・[POWER.md](POWER.md)）。**延長を挟むときだけ**極性を疑うこと。

### 逆接しても壊れない（2026-09-16 夕に足した）

J10 の 2 番と シャント R41 のあいだに **P チャネル MOSFET（Q2 / AO3401A）**が入っている。

- 向き: **ドレイン（3 番）が電池側（BATRAW）・ソース（2 番）が負荷側（BATP）・ゲート（1 番）は 100kΩ で GND**
- 逆に繋ぐと ボディダイオードが逆方向・Vgs = 0 でチャネルも閉じたまま ⇒ **電流が流れない**
- 逆接したときの症状は「電池をつないでも何も起きない（充電もしない）」。壊れずに間違いが分かる
- 保護の外に残るのは **BATRAW の線と Q2 のドレインだけ**で、その先には部品が無い。
  2026-09-11 に焼けた INA226 は、入力（IN+ = BATP・IN− = VLIPO）も電源（V33）も Q2 の内側にある

⇒ 下の手順 2〜4 は**やらなくても燃えない**。ただし極性が合っているかを早く知るためにやる価値はある。

### 組むときの手順（🔴 通電の前に）

1. 電池のプラグは**色で判断しない。** 手持ちの PH の圧着ペアは規格が無く、噛み合わせると赤が黒に当たる個体があった（2026-09-11）
2. **電池のプラグの 2 本を、テスタの電圧レンジで当たる。** 3.7〜4.2V が出る側が ＋
3. その ＋ が **手前（OLED 側）のピン**へ入る向きで挿す。奥（ハッチ側）が GND
4. 挿したら、**通電の前に**板の上の VBAT と GND のあいだをテスタで当たり、ショートしていないことを見る

⚠ ここを逆にすると INA226 から煙が出る。2026-09-11 に実機で起きている（[POWER.md](POWER.md)）。

## 9. 会話ボタンの口は残る（2026-09-14 に外して戻した）

一度「基板に会話ボタン要らないよ」を**口ごと要らない**と読んで J6 を外したが、同日に戻した。
🔒 ユーザーの言葉は「会話ボタンを基板に付ける必要はないと言ったんであって、**線は必要でしょ**。天板の会話ボタンはあるんだし」で、
**押しボタンを板に載せない**という話だった。**板は線を受ける口だけ持つ。**

⇒ J6 は残す（2026-09-16 夕に縦の口になり、2026-09-19 に後ろの縁の J7 の列へ）。線が出る口は **5 つ**。
BTN（XIAO の D2）は板の J6 で受ける。
