n416/katanori/docs/MECH-V61N-HANDOFF.md

# v6.1n（ナイロン筐体）引継ぎ — 2026-09-16

次の担当へ。この日の作業で決まったこと・残っていること・やってはいけないことを、この 1 枚に置く。
経緯の細かい数字は [CASE-V61N.md](CASE-V61N.md) 8 章にある。

## 1. いまの状態（作業ツリー・未コミット）

`git status` で M になっている物が全部この日の変更。コミットはしていない。

| 何 | 状態 |
|---|---|
| `hardware/case_v6_1.scad`（MAT="nylon"） | 底パーツ `shell()` ＋ 蓋 `lid()`（天板＋左の板＋足）の 2 部品。夕に透き間を無くした（CASE-V61N.md 8.5）。検査は下の表 |
| `hardware/stl/v61n/v61n_shell.stl`・`v61n_lid.stl` | 夕の形を書き出し済み。preflight 🔴 0・二重面 0。`v61n_top.stl` は消した。他 5 点は 09-15 のまま |
| `hardware/tools/stl_v61n.py` | `--check` に入れる道の掃引 `path_hub / path_rsp / path_oled / path_bat / path_lid` を足した |
| `hardware/pcb/katanori61/`・`v61_board.py`・`fab.py` | 左後ろの欠きを X 〜7.6・Y 29.9〜 に広げ（GND の縫いビア 5 本を消した・DRC 0）、ガーバー一式を出し直した。`fab.py` に `--check-zones` を足した（それまでの ガーバーは GND ベタが空だった） |
| `docs/CASE-V61N.md` 8 章（8.5 が夕の分）・`docs/PCB-V61.md` 3 章 | 上の内容を書いてある |

昼の版に残っていた「左の板の 3 辺に 0.8 の透き間」は夕に直した（8.5）。

## 2. 何をどう解いたか（決定はユーザー・🔒）

- 一体シェルは組めなかった。上からしか入れられない箱に、横向きに最後の動きをする物が 4 つあった（充電 USB-C +X・XIAO USB-C −X・OLED のダボ −Y・ジャックの筒 +X）
- 🔒 分割は「天板＆左壁」を 1 部品に。角と稜の一部は底パーツが持つ。電池は左の窓から抜く。PCB の左後ろの柱は電池の上へ張り出す台の上
- 🔒 OLED のダボは廃止。ガラスは壁の内面の 0.2 後ろ。床にガイド 2 本。ReSpeaker の右端に止め
- 🔒 左の板の後ろの下の角は床の裏から M2×15 で留める。ナットは足の中、口は後ろ（ハッチの内面が塞ぐ）
- 🔒 左後ろの隅の台は 1 つの塊（丸い頭を四角い台に載せた形は却下）
- 🔒 天板の左の縁を薄く削る「唇」はやめた（ねじの座ぐりが天面まで抜けた）。左の帯の頭は Z_TOP の平面

## 3. 次にやること（順に）

🔒 **設計の前提（ユーザー・2026-09-16）。まずこれを読んでから CAD を開くこと。**

- **蓋（天板＋左の板）は L 字のたわみ部品。** 蓋は真上から降ろす。左の板は途中で外へたわんで XIAO の USB-C の殻（板の内面より 1.22 内側に出ている）をかわし、
  殻を越えたら戻って口に嵌まる。PA12・厚み 1.6・幅 42・折り目から口まで 26 で、口の所を 1.5 外へ曲げる力は約 8N、ひずみ 0.6%（弾性の内）。
  **横へ 2.0 ずらしてから押す動き（いまの `LID_SHIFT`）は捨てる。** 唇・透き間・柱の幅やねじの位置の細工も、その動きのために生まれた物なので全部要らない
- **左の板の縁はレールで受ける。** 前後の隅の柱に板の縁が落ちる溝（レール）を切り、板は真上から溝に沿って降りる。密着し、位置も決まる。パッキンではなくレール（ユーザー）
- **板の下の角のねじ（床の裏から M2）は、たわんだ板を引き戻して止めるための物。** 8.2 章の足とナットの向き（口は後ろ）はそのまま使える
- **PCB の形は自由。** 電池の抜け道が足やレールで塞がるなら、電池を斜め上へ引き出せる切り欠きを板に作る。床の上を真っ直ぐ左へ抜く道を守る必要は無い
  （いまの「Y 9.4〜45.4 の床に何も置けない」という前提は捨てる）
- 継ぎ目は密着（今までの箱は 0.1）。隙間で公差を逃がす案は却下済み。出さない

やった（夕・CASE-V61N.md 8.5）:

1. ✅ `LID_SHIFT` 0・`path_lid` は板を 1.5 外へたわませた姿勢で真上から
2. ✅ 前後の隅の帯の裏にレール（`flap_rails`）・`FLAP_CL` 0.1（今までの箱と同じ密着）・切り欠きの 3 辺の継ぎ目は両側 0.5 の面取り（`FLAP_CH`・V 溝）。柱の頭は Z_TOP の平面のまま（楔には戻さない・ユーザー）。板の前の縁は Y 6.0 へ（8.5 の裏は ReSpeaker が居てレールを置けない）
3. ✅ 電池の抜け道は変えていない（下の縁には受けを置かない）。PCB の欠きは足と柱に合わせて X 〜7.6・Y 29.9〜
4. ✅ `--check` → `shell lid` 書き出し → preflight 🔴 0（下の表）

残り:

- 発注（底パーツ・蓋・他 5 点）
- ⚠ 未実機のまま: ジャックの筒と右の壁の空き 0.20・OLED 裏のフィルムと ReSpeaker の D1 の 0.4（path_oled 0.51）・後ろのレールの幅 0.8（MJF の最薄ちょうど。理由は 8.5）
- ⭐ 2026-09-17 夜に**掃引を通過点の並びに書き直した**（`pose_lerp` / `at_pose` / `sweep_pose`）。
  道の 1 点は `[dx, dy, dz, 回し]` で、Y のずらしも斜めも書ける。🔒 ユーザー「本来であれば対象物をどう移動させるかの
  パスを定義してあたりを出すべきでしょ」「入れられないかを判断する道具は必要だよ？」。
  ⚠ 2026-09-16 の「これ以上道具を育てないこと」はこれで**取り消し**。平行移動しか書けない道具は、
  入る動きにまで当たりを出して人を困らせる（`path_hub` 51.4 → 0.00）。docs/CASE-V61N.md 9.8

🔴 私が引継ぎの最初の版に書いた「左の壁を 2.0 外へ出す」案は、たわみを想定しない前提の上の案。**優先しない。**

## 4. 検査の値（この日の最後）

| 検査 | 値 | 意味 |
|---|---|---|
| seam_shell_lid / path_rsp / path_bat / sk_oled / sk_btn | 0 | |
| sk_hub | 0.01 | 充電 USB-C の角 |
| path_hub | **0.00** | ⭐ 2026-09-17 夜。道を 4 段（前へ 1.8 逃がす → 右へ → 下ろす → 後ろへ 1.8 押す）で書いた結果。174 は「真上から降ろす」平行移動を当てていた頃の値 |
| path_oled | 0.51 | OLED 裏のフィルム（⚠ 写真の高さ）が D1 を 0.4 擦る。フィルムは凹む |
| path_lid | 0.07 | 模型の殻の角が口の R に触れる。実物の殻は丸い |
| hit_wires / nutpath / sk_rsp / sk_spktub / sk_tgl | 2.77 / 9.79 / 4.28 / 0.74 / 0.70 | 09-15 と同じ |

## 5. この日に私がやった失敗（同じことをしないために）

- 「上下からしか入らない」と書いて、入れる順を追わなかった。v2（08-22）と同じ失敗。掃引の道具はあったのに使わなかった → `path_*` を足した
- 「道を作った」と資料に書いたが、道になっていなかった（USB1 の殻が壁に 0.95 食い込む）
- 「PCB の欠きは動かせない」「ナットで留めるなら向きを変えるしかない」「箱の大きさは変えない」を、誰も決めていないのに制約にした。ユーザー「制約はキミが勝手に作ってる」
- 継ぎ目の高さを揃えるためだけの細工（唇）を足し、利点を聞かれて答えられなかった。それがねじの座ぐりを天面まで抜いた
- 継ぎ目に 0.8 の透き間を置き、狭める方向で答えた。今までの箱は密着（0.1）だった
- **L 字の蓋を見て「板をたわませる」と読まなかった。** ユーザーは最初に「弾性あるの？」と聞いていた。私は「要りません」と答え、横へずらす動きに固定し、そこから唇・透き間・ねじの移動が連鎖した
- 説明が長く、絵を出しても伝わらなかった。数字は合っていても、形の意図を一行で言えない物は作らないこと
- 引継ぎの最初の版がこの前提を書いておらず、後任も同じ所で詰まった（ユーザー 2026-09-16）。この版で 3 章を書き直した

メモリにも残してある: `feedback-assembly-path`・`feedback-no-invented-constraints`・`feedback-joints-overlap`。
