n416/katanori/docs/COLLISION-SURVEY.md

# 当たり判定の作り方 — 世の中の手 (2026-09-17 調べ)

## 0. いま何が起きているか

`case_v6_1.scad` の `sweep_pose()` は、**姿勢を n 個置いて `union` し、世界との `intersection` の体積を測る**。
これは CSG のブーリアンなので、姿勢を細かくするほど面数が線形に増え、CGAL / Manifold の計算量はそれ以上に増える。

- `PATH_HUB` の道のり ≒ 100mm。`SWEEP_STEP = 0.25` なら 400 姿勢。
  回しを入れると `hub_r() = 45.7` なので 10° で弧 8mm ＝ さらに 32 姿勢。
- `hub_unit()` は板＋部品で数千面。**400 倍して数百万面**を 1 つのソリッドに合体させようとする。
  → 2026-09-17 夜、PC が固まった。**道具の使い方が世の中と違う**のであって、PC が非力なのではない。

そして刻みを粗くすると、今度は**姿勢と姿勢のあいだを見ていない**（すり抜け＝見落とし）。
「誤報か、重すぎるか」の板挟みは、**この方式を採っている限り原理的に解けない**。

---

## 1. 世の中は「ブーリアンを取らない」

交わりの**体積を作る**のは、CAD の当たり判定では誰もやっていない。標準は次の 3 つ。

### A. 距離クエリ（BVH）— 実務の本命

三角形を BVH（木）に入れて、**2 つの物の最短距離／めり込み深さを mm で返す**。形は作らない。

| ライブラリ | 出来ること | 入手 |
|---|---|---|
| **FCL**（Flexible Collision Library） | 当たり判定・最短距離・連続当たり判定（CCD）。ROS / MoveIt の標準 | `pip install python-fcl` — **cp312 の Windows wheel あり**（0.7.0.11, 2026-04-08） |
| **trimesh** | STL 読み・`CollisionManager`（中身は FCL）・`min_distance_single()` | `pip install trimesh` (5.1.0) |
| **MeshLib** | 厳密ブーリアン・当たり三角形の列挙・SDF | `pip install meshlib` — Windows wheel あり（3.1.4, 2026-09-16） |
| Bullet / Coal(hpp-fcl) | 同上。ゲーム・ロボットの現場 | — |

速さの桁が違う。**1 姿勢 1 ペアあたりミリ秒**なので、450 姿勢 × 数十ペアでも 1 秒程度。
いまの「体積を作る」やり方とは、比べる土俵が違う。

### B. 刻みを決め打ちにしない — Conservative Advancement

CCD の定石。**「いま d mm 空いている。物の最大点速度が v なら、d/v だけ進んでも絶対に当たらない」**
と保証しながら進む。だから:

- 広い所は 1 歩で飛ばす（速い）
- 狭い所だけ勝手に細かくなる（すり抜けない）
- **`SWEEP_STEP` という定数が要らなくなる。**「0.25 か 1.5 か」を人が選ぶ問題が消える

回しがあっても使える。論文は C2A（Tang et al. 2009, ICRA）。速度で 1〜28 倍。

### C. 掃引体そのものを作る — 研究の領域

- Sellán, Aigerman, Jacobson "Swept Volumes via Spacetime Numerical Continuation"（SIGGRAPH 2021）。
  陰関数で 4D 時空に持ち上げて掃引体の等値面を追う。MIT ライセンスのコードあり（ただし Adobe が特許出願中）。
- "Implicit Swept Volume SDF"（2024, arXiv 2405.00362）。
- **どれも「union して hull を取る」より 1 桁速い**と主張している時点で、いまのやり方が土俵外だと分かる。
  設計の検査では**掃引体は作らない**のが普通。

> `hull()` で姿勢を繋ぐと凹みが埋まる（`path_lid` 0.07 → 21327mm³）のは既に踏んだ通り。
> 厳密には Minkowski だが遅すぎる。**これは「掃引体を作ろうとしたから」起きる問題で、A + B なら起きない。**

---

## 2. 誤報を消す実務の手

### (a) しきい値（clash tolerance）を持つ ── 体積でなく**深さ**で判定する

業界のクラッシュ検出は、**0 か非 0 か**では判定しない。

- 0.05mm 程度の penetration threshold を置いて、意図した接触（嵌め合い・パッキン・面接触）を落とす。
  これをやらないと報告が誤報で埋まる、というのが BIM / CAD 双方の定説。
- SolidWorks の干渉認識にも「一致を干渉として扱う」の切り替えがある。

いまの `0 が正` は、この意味で**世の中より厳しい判定**をしている。
体積 5mm³ は「深さ 0.01mm × 面積 500mm²」かもしれないし「深さ 2mm × 面積 2.5mm²」かもしれない。
**前者は誤報、後者は入らない。体積は両者を区別できない。**

### (b) 当たり用の形を、見せる形と分ける（collision proxy）

ゲーム・ロボットの世界では、**表示メッシュで当たりを取らない**のが常識。
凸分解（V-HACD）や箱・カプセルの代理形を持つ。理由は速さと、三角形分割由来の誤報を避けるため。

**OpenSCAD 特有の誤報源**: `circle()` は多角形が円に**内接**する。
つまり `$fn=48` の穴は真円より小さく、柱は真円より細い。
→ ぴったりの嵌め合いが**必ず当たる**（誤報）。
逃げの要る穴は `r / cos(180/$fn)` で外接させるのが定石。
`katanori-spk-fn-and-wedge` で踏んだ薄肉と同じ根っこ。

### (c) 模型の忠実さ

`PCB_PARTS` が 55 個中 9 個しかない件（[katanori-model-fidelity]）は、
**誤報の裏返しの見落とし**。距離クエリに移せば 55 個入れても速さは問題にならない。

---

## 3. 成果物が「動画」なのも、世の中の標準

SolidWorks の Motion Study の *Find Interferences Over Time* は、まさにこの形をしている。

- アニメーションを再生しながら、**フレームごと**に干渉を探す
- 結果は一覧表: **フレーム番号・時刻・当たった部品の組・干渉の体積**
- その行をクリックするとそのフレームへ飛ぶ

Navisworks の Clash Detective も同じ（当たった場所へ視点を飛ばす）。
つまり実務の成果物は「**動画** ＋ **当たった区間の表**」がセットで、
数字だけ・絵だけでは判定しない。ユーザーの直感は業界の作法と一致している。

### 我々の環境で作れる物

| 部品 | 状態 |
|---|---|
| ffmpeg | `C:\ffmpeg\bin\ffmpeg` にあり |
| Blender | 5.2 導入済み（`C:\Program Files\Blender Foundation`） |
| OpenSCAD | `C:\Program Files\OpenSCAD (Nightly)\openscad.exe` |
| Python | 3.12.10 / numpy 1.26.4（trimesh・fcl は未導入） |

- **OpenSCAD の `--animate N`**: `$t` を 0→1 に振って PNG を連番で吐く → ffmpeg で mp4。手軽だが、
  フレームごとに CSG を評価するので、部品数が多いと重い。
- **Blender**: STL を一度だけ出して、姿勢を Python で振る。描画は毎フレーム数十 ms。
  **当たった区間だけ赤く塗る**・めり込み量を字幕に焼く、が自然にできる。こちらが本命。

---

## 4. 作った物（2026-09-17）

形を作るのは OpenSCAD のまま、**判定と動画だけ外に出した**。

| ファイル | 役目 |
|---|---|
| `hardware/tools/_sweep_v61.scad` | 呼び出し口。`SW_MODE="mover"/"world"/"hit"/"pose"`。`case_v6_1.scad` は触らない |
| `hardware/tools/sweep_chk.py` | 距離クエリで道を走り、接触区間の中だけ厳密な交わりを取る |
| `hardware/tools/sweep_movie.py` | Blender で動画を焼く（青＝空き／黄＝接触／赤＝めり込み） |
| `hardware/tools/_sweep_blender.py` | Blender の中で動く側 |
| `hardware/sweep_accept.json` | 了承済みの当たりの台帳（載っていない物だけが「新」として出る） |
| `docs/SWEEP.md` | コマンド集 |

**回し方は [SWEEP.md](SWEEP.md)**（この資料は「なぜこの形か」だけを持つ）。

### 旧検査との突き合わせ（2026-09-17）

| 道 | 旧（OpenSCAD の掃引） | 新（距離＋厳密） | 一致 |
|---|---|---|---|
| `path_hub` | 0.00 mm³ | 厚み 0.000 mm（皮）→ 入る | ✅ |
| `path_rsp` | 0.00 mm³ | 厚み 0.000 mm（皮）→ 入る | ✅ |
| `path_oled` | **0.51 mm³** | 0.512 mm³・厚み 0.400 mm・1.6×0.8×0.4 @ s=0.898 | ✅ |
| `path_bat` | **86.82 mm³** | 86.818 mm³・厚み 2.382 mm・35×6×2.382 @ [15.2, 9.9, 0.5] | ✅ |

⚠ この表は**移した直後の値**。このあと「塊ごとに測る／合計は持たない」に変えたので、
いまの `bat` は「厚み 0.700・43.409mm³ が 2 か所」と出る（足すと 86.818 で同じ物）。

体積は小数 3 桁まで同じ。新しい方は**道のどこで・どんな形で**当たっているかまで出る。

### 速さ

| | 旧 | 新 |
|---|---|---|
| `path_hub` 0.25 刻み | **PC が固まる**（400 姿勢 × 28782 面 ＝ 1150 万面） | ── |
| `path_hub` | SWEEP_STEP 1.5 で数十秒 | 距離 188 姿勢 1.8 秒 ＋ 厳密 13 回 ＝ **11 秒** |
| 4 本まとめて | ── | **48 秒** |

刻みは `SWEEP_STEP` のような決め打ちを持たない。空いている距離 d と、その区間で物のどの点も動かない上限 M から
`Δt = (d − 0.05) / M` で出す（Conservative Advancement）。広い所は 1 歩で飛び、狭い所だけ細かくなる。
**刻みより細い物をすり抜ける**という旧方式の穴が原理的に無い。

### 誤報の落とし方

- 隙間 0.05mm 以下を「接触」として扱う（clash tolerance）
- 接触したら厳密な交わりを取り、**主軸で測った厚み**が 0.01mm 未満なら同一平面の皮 ＝ めり込みではない
  （`path_hub` の接触はすべて厚み 0.000 の平面。板の裏が柱の頭に載っているだけ）
- 体積で判定しない。体積 5mm³ は「深さ 0.01 × 面積 500」かもしれず、「深さ 2 × 面積 2.5」かもしれない

### 動画の読み方

**回し方と読み方は [SWEEP.md](SWEEP.md)**。ここでは考え方だけ:

- 箱は灰色の半透明、動く物は不透明
- 色は **2 色**（青＝問題なし／赤＝めり込み）。下の「色は 2 色」参照
- 当たった所では**交わりそのもの**を赤い実体で出す（OpenSCAD で厳密に取った形）
- 並びは ①入れる ②交わりを見せる ③**組み上がった姿勢で 2.5 秒止める**（ここで終わる）

### 動画で踏んだ穴（2026-09-17）

- 🔴 **`obj.matrix_world` に素の配列を入れると「列」として読まれる。** 行で渡したつもりの平行移動が
  行列のいちばん下の行（点の変換に使われない場所）に入り、**まるごと捨てられる**。
  最初に焼いた 3 本は**物が 1mm も動いていなかった**（色と字幕は別経路なので、動かない絵の上で
  色と数字だけが変わる、いちばん質の悪い出方をした。ユーザーの指摘で発覚）。
  ⇒ `mathutils.Matrix([行, 行, 行, 行])` で包む。
  ⚠ **焼いたら必ず 2 コマ以上を開いて、物が動いているかを目で確かめること。**
- EEVEE の半透明どうしは前後関係が壊れる（動く物が箱の面の裏に消えた）。
  半透明は箱だけにして、動く物は不透明のまま扱う。
- `Wireframe` モディファイアは物を拡大する**前**に効く。`scale` で大きくすると線まで太る
  （8.4 倍して針金の箱が中身の詰まった箱に見えた）。⇒ 毎コマ頂点そのものを書く。
- カメラの寄りは外接箱の 8 隅をカメラ座標へ落として合わせる。`ortho_scale` は横に効くので、
  16:9 では**縦が先に切れる**（縦長の場面で箱が枠から出た）。
- 道が「座った姿勢 → 外」の向きで書かれている物がある（`PATH_BAT`）。
  動画は座る姿勢で終わる方が読めるので、その場合はコマ順を逆にする（剛体なので当たりは向きに依らない）。

### 了承済みの当たりを台帳に持つ（2026-09-17）

当たりは「有るか無いか」ではなく「**前に見て了承した物か、初めて出た物か**」で読む。
Navisworks の Clash Detective も当たり 1 件ごとに New / Active / Reviewed / **Approved** の
状態を持ち、承認済みは次の回から黙る。同じ形にした。

`hardware/sweep_accept.json`:

```json
{ "id": "bat-guide-ring-low", "key": "bat",
  "why": "bat_guide_ring を電池が乗り越えるぶん。🔒 ユーザー「電池は膨らみますし、隙間は多少あっても良い」",
  "box": [[14.6, 9.4, 0.0], [18.1, 45.4, 1.7]], "thick": 0.75, "since": "2026-09-17" }
```

- 見つけた塊が `box` に収まり、厚みが `thick` 以下なら **済**。そうでなければ **新**
- **形を動かして当たりの場所が箱から出たら、新として鳴る。それが狙い**（決め直す）
- 厚みが育っても鳴る
- 新が 1 件でもあれば**終了コード 1**。新の塊は、そのまま台帳に貼れる形で出る（理由は人が書く）
- 皮（同一平面・厚み 0.01 未満）は当たりに数えないので、台帳に書く必要は無い

2026-09-17 時点で台帳は 5 件（OLED のフィルム 1・電池のレール 2・蓋の左の板 2）、新は 0 件。

### たわむ物の載せ方（蓋）

**2026-09-17 にやって、2026-09-18 に捨てた形**: 蓋を 2 つの剛体（`lidmain` 天板・`lidflap` 左の板）に
割って別々に当てた。数字（最後の 0.44mm）は合っていたが、**左の板を剛体のまま 1.5 横へずらす**ので、
1 つの部品であるはずの**付け根が 1.5mm せん断された**形になっていた。
旧 `lid_flexed()` は 2 つを `union` していたので段差が塊の中に隠れていて、割って並べて描いて初めて見えた。

🔒 ユーザー「天板と左壁はつながっています」「お前はなにをしようとしている」「なんで折り目で曲げようとしている？
ナイロンだから柔軟にグニャグニャ曲がると思っているのか」。

**いまの形（2026-09-18）**: **剛体に割らない。形そのものを作り直す。**
`flap_bent(d)` が Z を 12 段に切り、段ごとに X のせん断（`multmatrix`）を掛けて片持ち梁の形を作る。

```
y(x) = d/2 ・( 3(x/L)^2 − (x/L)^3 )      x は付け根からの距離・L は付け根から口まで 26.50
```

口より下は荷重が無いので直線。実測 **付け根 0.016・口 1.602・下端 3.559・1 つの塊**。
d = 1.5 で 6.24N・表面のひずみ 0.53%（引継ぎの「約 8N・0.6%」と一致・PA12 の弾性内）。

道の点は 7 要素になった（`[dx,dy,dz,rx,ry,rz,d]`）。**7 つ目が変わると形が変わる**ので、
道具はたわみ量を 0.1 刻みに**小さい側へ丸めて**（判定として厳しい側）形を作り直し、姿勢ごとに使い分ける。

**結果**: 降ろす間は全部 0。当たるのは最後に板が戻る 2 コマだけ（0.220 → **0.440mm**）＝ スナップ。
台帳に `lid-snap-front` / `lid-snap-rear` として理由付きで載せた。

⚠ **蓋を平行移動させる道は作れない。** 蓋は 4 本の上の柱（`POSTS_T`）で位置決めされていて、
X にも Y にも **0.3mm** しか動けない（前左の柱の +X 面 6.69 ／ 天板の −X 面 7.0）。
口が要る逃げは **1.25mm**。だから逃げを出せる場所は左の板 1 枚だけで、これがたわみ部品である理由。
曲げない剛体として降ろすと口で **1.958mm** 当たる（2026-09-18 実測）。

### 色は「判断が要るか」だけを持つ（2026-09-18）

🔒 ユーザー「lidflap.mp4 を見る限り、入らないといっているように見えますね」。
皮で触れているだけの所を黄色にしていたため、`lidflap` は道の全域（s 0〜2）で触れていて
**最初から最後まで黄色**になっていた。自分で「皮はめり込みではない」と決めておきながら、
絵では警告を出しっぱなしだった（実測は s 0〜1.5 が全部 厚み 0.000 の 4 面の皮）。
⇒ まず **青＝めり込み無し（触れているのも含む）／赤＝めり込み** の 2 色にしたが、
今度は**了承済みのめり込みまで赤く**なり、蓋の最後の絵が真っ赤になった。台帳を作った意味が消える。
⇒ 最終形は 3 段: **青＝めり込み無し／橙＝了承済み／赤＝新しいめり込み**。
色が持つのは「**判断が要るか**」だけ。触れていることは焼き込みの文字（`touch`）に残す。

### 🔴 塊ごとに測る／合計は持たない

交わりは**離れた複数の塊**になる（蓋は縁のぐるり全部で触れる）。
まとめて主軸を取ると、**別々の平面にある皮が寄り集まって「厚い」に化ける**
（2026-09-17 に踏んだ: `lidmain` が体積 0 のまま厚み 5.198 と出た）。⇒ 塊ごとに測る。

そして**塊の体積を足した「合計」は持たない**（🔒 ユーザー 2026-09-17「合計は無意味」）。
小さな接触が 6 か所あるのと、大きなめり込みが 1 か所あるのを、足すと区別できなくなる。
塊ごとに分けた意味が消える。出すのは**いちばん深い塊**と**触れている所の数**だけ。
（旧道具との突き合わせに 1 回だけ合計を使い、一致を確かめてから外した。）

### まだ手を付けていない

- 🔴 **ナイロン（MJF）しか見ていない。** `sweep_chk.py` は `-D MAT=` を渡しておらず、
  `case_v6_1.scad` の既定（`MAT = "nylon"`）のまま回る。6 本の道もナイロンの入れ方で、
  板 6 枚のレジンの組み立てを表していない。
  🔒 ユーザー 2026-09-15「レジン版とナイロン版はスイッチできるわけで、それに応じてアラートを分けて」
  に、**この道具だけが従っていない**。レジンの道を書くところから要る（2026-09-18 時点で未着手）

- STL の壊れた辺（`print_shell` で 53 本・4 枚または 6 枚が集まる辺。穴は 0）。
  ゼロ面積の面が 74 枚あり、ほぼ Z 0.0（床の面）と Z 0.4（床の左の稜）に固まっている。
  当たり判定は三角形の集まりとして見るので走るが、**内外判定を使う手が採れない**
  （符号付き距離でめり込み深さを直に出せない）。刷る側は穴が無いので当面困らない

## 参考

- C2A: Controlled Conservative Advancement — http://gamma-web.iacs.umd.edu/papers/documents/articles/2009/tang09.pdf
- Swept Volumes via Spacetime Numerical Continuation — https://www.dgp.toronto.edu/projects/swept-volumes/
- Implicit Swept Volume SDF — https://arxiv.org/pdf/2405.00362
- FCL / python-fcl — https://github.com/BerkeleyAutomation/python-fcl
- trimesh.collision — https://trimesh.org/trimesh.collision.html
- MeshLib — https://meshlib.io/feature/mesh-to-sdf/
- SOLIDWORKS Detecting Interference (Motion) — https://help.solidworks.com/2023/english/SolidWorks/motionstudies/t_detecting_interference_motion.htm
- Clash detection と tolerance — https://www.spatial.com/glossary/what-is-clash-detection
- V-HACD（凸分解） — https://github.com/isabella232/VHACD
- OpenSCAD Animation — https://en.wikibooks.org/wiki/OpenSCAD_User_Manual/Animation
