n416/katanori/docs/DIMENSIONS.md

# 部品の寸法（筐体設計の材料）

筐体・スタンドを設計するときに使う寸法を1か所に集めた表。

**この表の目的は「数字を集めること」ではなく、`数字がどこから来たか`を消さないこと。**
つまみの治具で起きた事故が、全部そこから出ている（下）。

関連: [PRINT.md](PRINT.md)（印刷の実測値と補正） / 旧 SHOPPING.md（2026-08-24 削除・git 履歴）（購入品の型番） /
[POWER.md](POWER.md) / [TODO.md](TODO.md) 2章（筐体）

---

## 🔒 この表の使い方（設計ルール）

### 起きた事故

つまみの卓上治具（2026-08-02・[PRINT.md](PRINT.md) 3回目）で3件やった。

| 起きたこと | 何を間違えたか |
|---|---|
| コネクタのスロット位置が外れ、手加工で窓に開け直した | **説明書を流し読みして、ピンの位置とピンヘッダーのサイズを考慮し忘れた** |
| 軸がブリッジの穴に入らず、削って通した | 凸は太る・穴は縮むという**印刷側の補正**を穴の設計値に入れ忘れた |
| スタンドオフが2本折れた | 長穴の向きの肉厚を**計算していなかった**（0.3mmしか無かった） |

**3件を一つの教訓にまとめない。** 原因が別々で、まとめると薄まる。
1件目は**在った情報を読み落とした**（ユーザーもピンヘッダーが立っていることを
説明していた）。2件目は**補正を入れ忘れた**。3件目は**計算しなかった**。
どれも「難しくて分からなかった」ではない。

⚠ **以前ここには「3件とも現物を当てずに数字を置いた」と書いてあった。**
事故を認識論の話へ格上げした書き方で、実際より上品にしていた。書き換えた
（2026-08-03・ユーザーの指摘）。

### 下の格付けが効く範囲

**上の3件には効かない。** 格付けが効くのは別の型 — **公称値をそのまま設計値にする**
事故（外形は📄で足りるが、穴の位置に使うと外す）。上の3件は、**在った情報を
使わなかった**型。**同じ表では防げないので、分けて持つ。**

⚠ **そして 2026-08-03、同じ読み落としをこの表を書きながらもう一度やった。**
公式ページに両面のピンアウト図があるのに、テキストの仕様表だけ見て
「面の割り当てはネットに無い」と書いた（下で訂正済み）。**一次情報を開いて、
最後まで見る。** 仕様表・図・写真は別々の情報で、表だけ読むのは流し読みと同じ。

### だから、数字に格付けを付ける

| 記号 | 意味 | 設計で許されること |
|---|---|---|
| ✅ | **実測** — 手元の現物で測った・嵌めて確かめた | **穴を置いてよい** |
| 📄 | **カタログ** — メーカー／販売ページの公称値 | **外形の当たり（入るか／どのくらいの箱か）まで**。穴は置かない |
| ⚠ | **推定** — 誰かが決め打ちした値。写真からの読みも含む | 設計に使うなら**長穴・窓・逃がし**にする |
| ⬜ | **未取得** | 使わない |

> **📄と⚠の上に、位置の決まった丸穴を置かない。**
> 逃げ方は治具でもう出ている — 位置が怪しければ**丸ごと窓にする**（基板の下を全部開けた）、
> ピッチが怪しければ**長穴にする**（±1mm 吸収）。**手加工で開け直すより、
> 最初から開けておくほうが安い。**

### 📄 を拾うときは一次情報から

⚠ **ここには一度「XIAOの外形は出どころによって 21×17.5 / 21.5×17.5 / 21×17.8 と
食い違う」と書いた。誤り。**
[Seeed の仕様表は **21 × 17.5 mm** の一つだけ](https://wiki.seeedstudio.com/xiao_esp32s3_getting_started/)。
食い違って見えたのは、検索結果に出たまとめサイトや販売店の記事を一緒に数えたから
（2026-08-03 訂正）。**公称値が当てにならないのではなく、公式を見ていなかった。**
ReSpeaker Lite の **35 × 86 mm** も同じで、公式の仕様表に最初から書いてある。

**📄 に採ってよいのは、メーカーの wiki・データシート・製品ページだけ。**
検索結果の要約や転載記事は数に入れない。

---

## 0. 🔒 数字は表に書くだけでなく、CADのモックにする（2026-08-04）

**表だけでは当たりは見つからない。** 2026-08-04、当たり板を刷って3回失敗した
（下端が板の上面に当たる／マイク面のスイッチが座に当たる／中央領域の部品を1.5mmの座に
入れようとしていた）。**3回とも CAD の中に基板が無かったから見つからなかった。**

| ファイル | 中身 |
|---|---|
| [../hardware/parts/respeaker_lite.scad](../hardware/parts/respeaker_lite.scad) | ReSpeaker Lite。`respeaker_lite()` と `respeaker_mating_space()` |
| [../hardware/parts/parts.scad](../hardware/parts/parts.scad) | AS5600・PowerBoost・MTS-102・リードスイッチ・磁石・**リポ・スピーカー・OLED 2.42"** |
| [../hardware/parts/hub_board.scad](../hardware/parts/hub_board.scad) | **ハブ基板（実装込み）**。⭐ **穴割りから自動生成**（下の0.6） |
| [../hardware/frozen/v1-v4/case_pack_study.scad](../hardware/frozen/v1-v4/case_pack_study.scad) | **箱詰めスタディ**（2026-08-15・下） |

### 0.6 ハブ基板は推定せず、穴割りから生成する（2026-08-15）

🔴 **穴割りが分かっているのに、AI はハブ基板を「18mmの赤い箱」で代用し続けていた**
（ユーザー指摘「穴割が分かっている時点で正確にモデリングできるのでは」）。**そのとおりだった。**

```bash
python hardware/parts/gen_hub_board.py     # relay_board.html → hub_board_parts.scad
```

🔒 **手で転記しない。**正は [relay_board.html](../hardware/parts/relay_board.html) の `initialLayout()` で、
穴割りを直したら流し直す（`respeaker_lite_parts.scad` と同じ方針）。**部品17個・口7個**が実位置に載る。

⭐ **生成した瞬間に、推定の誤りが2つ出た。**

| | 推定していた値 | 実際 |
|---|---|---|
| ハブ層（横出し） | 8.0mm | 🔴 **13.6mm**（板1.6＋リレー10＋半田面2） |
| ハブ層（立てる） | 27.0mm | **28.6mm**（板1.6＋口25＋半田面2） |

🔒 **最高点はヘッダの向きで入れ替わる。**立てれば**口が25mm**で断然の最高点、
横出しにすれば口は寝て⚠約6mmになり、**リレーの10mm**が最高点になる。
🔴 **13.6mm のうち 10mm はリレーで、ヘッダを寝かせても減らない。**

⚠ **AI はここに「最高点はピンヘッダ(8.5mm)ではなくリレー(10mm)」と書いた。誤り**
（2026-08-15・ユーザー指摘）。**8.5mm は裸のヘッダで、ハウジングを忘れている。**
25mm という数字を自分で記録した後に、同じ忘れ方を2回している。
🔒 **口の高さは、必ずハウジングが挿さった状態で数える。**

### 🔴 穴割りが鏡像だった（2026-08-19）

**ユーザー指摘**「中継基板のコネクタの位置が実際と違う。鏡面になってないかこれ。
ハンダ面に部品が乗ってる」。**そのとおりだった。**

`relay_board.html` は**部品面**を描いていて、SVG の y は下向きなので画面では **行A が上**。
`gen_hub_board.py` は行A を **Y 小**に置いていた。SCAD で部品面（+Z）から見下ろすと
Y は画面の上へ伸びるので、**同じ面を見ているのに上下だけが反転**する。列はどちらも
左が列1なので、**回転では戻らない鏡像**になっていた。

🔒 **HTML の画面の上 = SCAD の +Y。** 生成器の `hole_xy()` で行を反転して直した。

さらにユーザー指示で **板は筐体へ 180度 回して載せる**（`ROT180`）。鏡像を直しただけだと
口が前後そっくり入れ替わり、XIAO が背面・PWR が前面になって**テストするまでもなく当たる**ため。
⇒ 生成器は**載る向き**で座標を出す。`HUB_ROT180` を `hub_board.scad` の `hub_dir()` が読み、
口の向きも一緒に回る。**座標だけ回して向きを回さないと、口の向きだけが嘘になる。**

⭐ **鏡像の修正と180度回転は打ち消し合うので、旧モデルとの正味の差は「左右の反転」だけ。**
Y は10口すべて不変で、X が `74 - x` になった。**同じ辺に居るが、左右が入れ替わっている。**

| 口 | 旧 X | 新 X |
|---|---|---|
| PHIN / PHOUT（ReSpeaker・スピーカー） | 4.0（左辺） | **70.0（右辺）** |
| AS5600（つまみ） | 64.9（右辺） | **9.1（左辺）** |
| BTN2（会話ボタン） | 67.5（右辺） | **6.5（左辺）** |
| PWR（PowerBoost） | 9.1〜16.7（背面の左） | **57.3〜64.9（背面の右）** |
| XIAO | 37.0〜52.2 | 21.8〜37.0 |
| OLED / INA | 42.1〜49.7 | 24.3〜31.9 |
| TOGGLE | 21.8〜24.3 | 49.7〜52.2 |
| REED | 29.4〜31.9 | 42.1〜44.6 |

🔴 **これで筐体の配線は全部引き直しになる。** とくに `case_v2.scad` が
「ハブの PWR の口が板の左後ろにあるので PowerBoost を左へ入れ替えた」と書いている根拠が
**反転した**（PWR は背面の右になった）。

⚠ 生成器そのものも2回こけた。`fn:'D3'` `fn:'D2'`（XIAOのピン名）を穴名として拾って
**XIAOの口が7本ではなく9本**になり、OLEDのラベルの `"` が SCAD の文字列を壊した。
**どちらも「口の本数を数える」だけで見つかる**ので、生成器は本数を必ず出力すること。

### 🔴 OpenSCAD の警告を捨てない（2026-08-15）

**箱詰めスタディでハブ基板が原点に置かれ、絵が滅茶苦茶になった。**原因は
`use <hub_board.scad>` が**モジュールと関数しか取り込まず、変数を取り込まない**こと。
呼ぶ側の `HUB_SOLDER` が undef になり、`translate([2, 40.125, undef])` が**丸ごと無視された。**

🔴 **OpenSCAD はこれを WARNING で2行はっきり出していた。**
AI が出力を `grep -E "ECHO|ERROR"` で拾っていたため、**自分で警告を捨てていた**
（ユーザーが OpenSCAD の画面を見て発見）。

| 🔒 決めごと | |
|---|---|
| ビルド出力は **`grep -Ei "warning\|error"` で必ず見る** | ERROR だけ拾わない |
| **外に出す値は変数でなく関数にする**（`hub_solder()`） | `use` で変数は渡らない |
| 絵と寸法計算を食い違わせない | `S_CORRIDOR=0` のとき横の通り道を描いていた |

⚠ **外寸の数字（455.7cm³）は変わらなかった。**寸法は定数から計算していて、
描画位置とは独立だったため。**壊れていたのは絵と、絵による検証のほうである。**

### 0.5 箱詰めスタディ — まず「何mmの箱になるか」を見た（2026-08-15）

**筐体の設計ではなく、全部入れたら何mmになるかを見るためだけの当て板。**

```bash
openscad -o out.png --camera=45,35,50,58,0,32,470 -D 'EXPLODE=45' hardware/frozen/v1-v4/case_pack_study.scad
```

### 🔒 唯一の設計変数は「25mm をどの軸で払うか」

**コネクタ1個は約25mm要る**（上の1.5節）。**向きを変えても数字は同じ**なので、
ヘッダの向きは「その25mmを高さで払うか、基板面で払うか」の選択でしかない。

⚠ **この節には一度、行A の通り道しか入れず、ハブ層も推定値(8mm)で置いた表があった。
2026-08-15 に2回とも訂正したので削除した。**⚠ **[relay_board.html](../hardware/parts/relay_board.html) を
開かずに書いたため、行S に口が4つ集中しているのを見落としていた**（2026-08-15・ユーザー指摘）。
行S を入れ直すとこうなる（OLED 20mm のとき）。

🔒 **2026-08-15、ハブ基板を推定値でなく実物のモックに置き換えた**
（[hub_board.scad](../hardware/parts/hub_board.scad)。穴割りから自動生成・下の 0.6節）。**数字はこうなった。**

| ヘッダ | 行S の行き先 | 外寸 | 体積 | 高さ |
|---|---|---|---|---|
| **横出し** | 全部**下段へ降りる**（下限） | 90 × 98 × **51.6mm** | 456cm³ | ⭐ |
| **横出し** | 全部**パネルへ出る**（上限） | 90 × 121 × **51.6mm** | 563cm³ | 長辺が痛い |
| 立てる | （通り道は要らない） | 90 × 75 × **66.6mm** | 450cm³ | ❌ |

🔴 **横出しの優位は「高さだけ」に縮んだ**（51.6 対 66.6mm）。**体積では並ばれている**
（456 対 450）。急所は高さ（[ARCHITECTURE.md](ARCHITECTURE.md) 223行）なので**方向としては横出しのまま**だが、
⚠ **「横出しで確定」と2回言ったのは、どちらも根拠が足りていなかった。**

⚠ **なぜ悪化したか: ハブ層が 8mm ではなく 13.6mm だったから**（内訳と誤りの経緯は 0.6節）。

⬜ **決め手は行S の内訳である。** PowerBoost(4) と INA226(4) は**箱の下段にある部品**なので
線は下へ降り、通り道は要らない。トグル(2)・リード(2)・会話ボタン(2) は**パネルへ出る**。
**この6本をどう逃がすかだけが残った判断で、それが決まるまで横出しは確定にしない。**

⚠ **一度ここに「横出しなら OLED の疑いはほぼ効かない」と書いたが、ハブ層が 13.6mm に
上がったことで OLED の塔が再び床(34mm)を超えた。効かなくなるとは言えない。**（2026-08-15 訂正）

⚠ **AI は「向きに関係なく要る数字」と書いた直後に、ヘッダ高さを別の未知数として
測定を要求した**（2026-08-15・ユーザー指摘）。**同じハウジングに同じ線が挿さるのだから
同じ25mm。**同じ物を2回数えていた。→ `CONN = 25.0` の1変数に統合した。

### 🔒 この配置は好みではなく、3つの制約から一本道で出ている

| | 制約 | そこから決まること |
|---|---|---|
| 1 | **マイクは上か正面を向く**（塞ぐと音が死ぬ・ユーザー 2026-08-15） | 天面は OLED が占めるので、**マイクは正面**しか残らない |
| 2 | マイクは**マイク面の両端**にある（U4/U5・[RESPEAKER-LITE.md](RESPEAKER-LITE.md)） | → **ReSpeaker は立てる**（同文書 240行の結論と一致） |
| 3 | ハブ基板(74×52) と OLED(70×48) は **footprint がほぼ同じ** | **必ず重ねる。** 横に並べると Y が30mm伸びる |

⭐ **`opt` では高さの支配が「OLEDの塔」から「立てた基板の34mm」に移る。**
これは**物理的な床**である。マイクを正面に向ける限り基板は立ち、34mm より低い箱は作れない。

🔴 **候補A（全部平置き）は捨てた。マイク面が箱の底を向いていた。**
[RESPEAKER-LITE.md](RESPEAKER-LITE.md) は最初から「基板は立てる」と結論していたのに、
箱詰めのときに参照しなかった。→ `mic_path()` で**音の通り道を可視化**して再発を防ぐ。

⚠ **この数字を「箱の大きさ」として引用しないこと。** まだ足りていない。
① **つまみが入っていない**（再設計中・[KNOB-ENCODER.md](KNOB-ENCODER.md)）
② ハーネスは **行A（ReSpeaker行きの7本）の1本ぶんしか入れていない。**
   列1・列27 の口の通り道は未計上（他の部品の隙間と共用できる見込みだが、未検証）
③ 逆方向の余地として、**充填率は39%**（部品191cm³ / 箱484cm³）。まだ詰められる

### ⚠ StackChan との比較は、体積ではなく高さで見る

🔴 **下の `opt` の行は 2026-08-14 の箱詰めスタディで、実際に作った筐体ではない。**
筐体 v4 で測り直した確定値は [ARCHITECTURE.md](ARCHITECTURE.md) の
「筐体 v4 で測り直した比較（2026-08-27）」にある（面積 6,498mm² ／ 高さ 52.95mm ／ 体積 344cm³）。
**高さは 40mm では収まらなかった**（`opt` はつまみも外皮の厚みも入っていない）。

| | 設置面積 | 高さ | 体積 | 電池 |
|---|---|---|---|---|
| StackChan | 3,807mm² | **61.5mm** | 234cm³ | ❌ 含まない |
| katanori `opt`（🔴 過去のスタディ） | 6,581mm² | **40mm** | 263cm³ | ✅ 含む |
| **katanori v4（実物）** | **6,498mm²** | **52.95mm** | **344cm³** | ✅ 含む |

🔒 **[ARCHITECTURE.md](ARCHITECTURE.md) 223行のとおり、肩に載せる物の急所は高さである。**
体積で1.1倍・面積で1.7倍だが、**高さは3分の2に収まっている**（薄く長い板になるという読みどおり）。
⚠ **ただし体積の比較はそもそも公平ではない。** StackChan の234cm³は電池を含まず、
katanori 側は電池・PowerBoost・XMOS まで入れた数字である。

**約束:**

1. **測っていない部品はモックに書かない。** 仮の箱を置くと、それが事実として使われる
2. 外形だけでなく、**コネクタ・ピンヘッダー・線の曲がり**まで箱にする
3. 新しい寸法を測ったら、**この表とモックの両方**を更新する
4. 筐体を刷る前に、`respeaker_envelope()` などを `difference()` して**削れないことを確認する**

## 1. 基板

| 部品 | 外形 | 厚み・高さ | 取付穴 | 出典 |
|---|---|---|---|---|
| **ReSpeaker Lite** | **82.024 × 34.007 mm**（張り出し込み 86 × 34） | **1.85 mm** ✅ 実測（公式 CAD は 1.51） | **2つ・対角・φ2.20（M2）** ✅ | ▶ **[RESPEAKER-LITE.md](RESPEAKER-LITE.md) に独立**（面・端・穴の図・突き出ている物） |
| **XIAO ESP32S3** | **21 × 17.5 mm** | ⬜ | 取付穴なし | 📄 [Seeed wiki 仕様表](https://wiki.seeedstudio.com/xiao_esp32s3_getting_started/) |
| **AS5600 モジュール** | **23 mm 角** | 基板 1.6mm ／ チップ ⚠1.1mm（SOIC想定） | 穴中心間 **17mm** ✅／穴の径 🔴 **φ3.5 以上**（2026-08-27 ユーザー実物・⚠ 正確な径は未取得）。**「M2」は誤り**で、M2 のねじだと片側 0.75 以上ガタつき、基板はねじでは位置が決まらない。穴の外に残る板は 1.25mm。チップは4穴の中心 | ✅ 定規で実測（`knob_jig.scad`）／穴の径だけ 2026-08-27 に訂正 |
| **PowerBoost 1000C** | 📄 **22.86 × 36.07 mm**（USB-Aジャック無し） | 📄 **板の一般 4.9mm（✅板1.6＋📄インダクタ3.3）／最高点 6.8mm（JST 5.2）**・読み取り誤差±0.3・6g。🔴 **公称の 10mm は USB-Aジャック込みで、この個体には当たらない。** 2026-08-19 まで筐体はこの 10 を厚みとして箱詰めしていた | 📄 **4つ**（下） | 平面は 📄 [EagleCAD Rev B](https://github.com/adafruit/Adafruit-PowerBoost-1000C) の .brd。**高さは 📄 2026-08-19 の側面写真**（板の長さ36.07で倍率を合わせた）。✅ **板厚 1.6 は同日に櫛ゲージ（[board_gauge.scad](../hardware/frozen/v1-v4/board_gauge.scad)）で実測**し、写真の読みと一致。🔒 **写真と治具は独立した観測**なので倍率の誤差は消え、残るのは読み取り誤差のみ |

🔴 **「23 × 45mm」は USB-A ジャック込みの値で、この個体には当たらない**（ユーザー・2026-08-15）。
**ジャック無しの基板は 36.07 × 22.86mm で 9mm 短い。**

### 📄 取付穴は4つ（`.brd` から確定・2026-08-15）

| 穴 | 位置 | 径 | 正体 |
|---|---|---|---|
| `U$11` | **(2.54, 2.54)** | φ2.5 | 取付穴 |
| `U$10` | **(2.54, 20.32)** | φ2.5 | 取付穴 |
| `CN1.S1` | **(33.91, 5.18)** | φ2.3 | ⭐ **USB-Aのシールド固定タブ穴** |
| `CN1.S2` | **(33.91, 18.32)** | φ2.3 | 〃 |

⭐ **USB-Aジャックを付けないので、シールドタブの2穴がそのまま取付穴として使える。**
四隅に近い4点で留められる。

⚠ **AI は一度「Rev B の取付穴は2つ。現物の4つと合わないので revision が違う」と断定した。誤り**
（2026-08-15）。**`MOUNTINGHOLE` という名前の element だけを探していた**ため、
コネクタのタブ穴を数えていなかった。**探す対象を間違えただけで、板は合っていた。**
🔒 **穴を数えるときは、名前ではなくドリル径で数える。**

| 位置（基板座標・📄 `.brd`） | |
|---|---|
| 電池 JST-PH2（`B1`） | (10.668, 19.304) |
| 出力（USB-A/端子台 `X1`） | (33.909, 11.7475) … ⭐ **この個体はここにピンヘッダが立っている**（ユーザー） |
| スルーホール（pad） | **27個**。ヘッダはここに立つ。図: [_pb_revb.svg](../hardware/frozen/v1-v4/_pb_revb.svg) |

✅ **2026-08-15、ユーザーが現物と図を照合して「完全に一致」を確認。**
→ 外形 36.07 × 22.86 と上の穴位置は **✅ に上げてよい。**

### ✅ 実際に使っている端子は 2つだけ（2026-08-15・ユーザー）

| | |
|---|---|
| **スルーホール27個（ブレイクアウトのパッド列）** | 🔴 **一切使っていない** |
| USB-A の4か所 | 使っているのはここ |
| └ そのうち実際に結線しているのは | ⭐ **`U$25`(+) と `U$26`(−) ＝ +5V と GND の2本だけ** |

📄 位置: `U$25`(+) **(31.115, 6.223)** ／ `U$26`(−) **(31.115, 17.399)** … どちらも **+X 端**。
🔒 **PowerBoost から出る線は2本で、出る場所は基板の +X 端に決まっている。**
→ 置き場所を考えるときは、**この2本と4つの取付穴だけが拘束**になる。

⬜ **`EN` はどうするか。** ハブ基板の穴割りは `S6` を PowerBoost の `EN` へ引いており
（[POWER.md](POWER.md) のEN遮断）、そこはブレイクアウトのパッド列にある。
**「スルーホールは使わない」と両立するのか、要確認。**

| 位置（基板座標・📄 EagleCAD） | |
|---|---|
| 取付穴 ×2 | `(2.54, 2.54)` `(2.54, 20.32)` … **出力と反対の端**。ここで留めて出力側を自由にできる |
| 電池 JST-PH2（`B1`） | `(10.668, 19.304)` … 長辺寄り |
| 出力（USB-A/端子台 `X1`） | `(33.909, 11.7475)` … **+X端**。⭐ **この個体はここにピンヘッダが立っている**（ユーザー） |

⬜ **残るのはヘッダの本数・向き（ストレート/アングル）と、`EN` などの制御パッド列の位置。**
→ **写真を待つ**（[measurement-handoff の作法](TODO.md)。こちらで読み取って復唱する）
| **OLED 2.42"**（現行の表示） | 📄 **70.1 × 48.1 mm** | ✅ **8.5 mm**（実測。図面の 20mm は誤り） | ✅ **四隅穴 横67 × 縦43・ほぼ角・φ2.8・穴の面は正面から3.0mm** ／ **黒い枠 61 × 38.5**（2026-08-17 確定）。~~L型（ライトアングル）ヘッダは板の面から 2mm ／ 横への飛び出し 10mm~~ 🔴 **2026-08-20 訂正: ヘッダは L型ではなく直（ストレート）で、上辺の中央寄りから後ろへ出る**（ユーザー）。旧記述「L型・板の面から 2mm・横への飛び出し 10mm」と、`parts.scad` にあった「正面から見て左辺の4ピン」は**どちらも古い**。位置と逃げは下の 1.5 の表を見ること。🔴 穴間は最初「62×38」と申告されたが、それだと穴が黒い枠に1.9mm食い込む計算になり写真と矛盾 → 写真を定規で校正して読み直し67×43で承認。**「あり得ない値は作る前に照合」の実例**。筐体は4本ともM2×8でねじ化済み（hardware/frozen/v1-v4/case_v1.scad → いまは case_v2.scad が引き継いでいる）。⬜ 発光領域と窓の重なりは初点灯で確認 | 📄 2026-08-15 図面 ＋ ✅ 実測 |
| **OLED 0.96"**（旧・退役） | 30 × 27 mm | ⬜ | 4ピンヘッダが下辺中央 | ✅ 2026-08-07 実測。**2.42" に交換したので設計には使わない** |

⚠ **2.42" の 20mm をそのままパネル設計に使わないこと。** この class のモジュールとしては厚く、
**背面のピンヘッダーを含んだ総厚**の可能性が高い。前面パネルの窓に要るのは表示面までの厚みなので、
着荷したら **「素のパネル厚」と「背面の突起込みの総厚」を分けて**取り直す。
⬜ ピン並びも未確定（[POWER.md](POWER.md) 4章「現物の並びを見てから確定」）。

> ▶ **ReSpeaker Lite の形は [RESPEAKER-LITE.md](RESPEAKER-LITE.md) に独立させた**
> （2026-08-04）。面の呼び方・どの部品がどの端にあるか・取付穴の図・この機体で
> 足されている物・そこから出る設計上の結論まで、全部そちらにある。
> **筐体を触るときは最初にあれを開く。**

## 1.5 突き出ている物（外形の表に載らない）

**基板は板ではない。** 上にも下にも物が生えていて、そこにコネクタが挿さり、線が出て、
曲がる。**外形と穴ピッチだけを並べた設計で1回やらかしている**ので、輪郭と同じ扱いで
ここを埋める。

| 基板 | 生えている物 | 状態 |
|---|---|---|
| **ReSpeaker Lite** | ピンヘッダー7本×2列＋ワイヤー ／ XIAO ／ USB-C ×2 ／ スピーカー端子 ／ 3.5mmジャック ／ マイク ／ ボタン ／ パッド列 | ▶ **[RESPEAKER-LITE.md](RESPEAKER-LITE.md)** に面・端つきで全部ある |
| **AS5600 モジュール** | **7 ピンが左右の対の縁に 2 列**（左 VCC/OUT/GND・右 DIR/SCL/SDA/PGO・2.54 ピッチ・列は穴の間）＋ Dupont（挿すのは 5 本・1 本ずつバラす） | ✅ **2026-08-24 商品画像（寸法矢印付き）で模型化**（[parts.scad](../hardware/parts/parts.scad) `as5600()` ピン単位）。ヘッダは平らな面＝裏から挿して IC 側ではんだ（[KNOB-ENCODER.md](KNOB-ENCODER.md)）。鎖: 樹脂 2.5 ＋ DuPont 10 ✅ ＋ 逃げ 3.6 ＝ 裏面から 16.1（治具時代の包絡 ⚠14 はこの鎖の逃げ無しと整合）。🔴 **2026-08-27 この模型は実物と合っていない**（ユーザー・実物）: 「DIR のピンヘッダから穴までは 1mm もありません」。模型だと 3.42mm ある（穴の縁からピンの側面まで）。⇒ 実物のピンは **M2 の穴の中心から 2mm 以内**に立っており、つまみの座の柱（座面 φ8 ＝ 半径 4）はそれを座面のほぼ中央で踏む。`case_v4` の欠き ③ はこの当たりへの逃げで、**柱の設計そのものが未解決**。⚠ 正しい値は未取得（上限 1mm のみ）。写真の画素読みは 2.3 を作ったのと同じ精度なので使わない（ユーザー指摘）。⚠ 縁から列中心 2.3・列中心＝板中央は画像読み。🔒 **個体は 2 つ・1 つは未はんだ**（2026-08-24 ユーザー）⇒ ヘッダの形（直立て／L 字）は置き場の従属変数で、`as5600(ra =)` の 2 モデル。🔴 「位置未取得」とここに書き続けていたのは docs を掘っていない行だった。⚠ **治具の最終版で窓がギリギリで基板が少し斜めに付いている**（未解決・[PRINT.md](PRINT.md)）は継続 |
| **XIAO ESP32S3** | USB-C ／ 両側のヘッダピン（ReSpeakerのソケットに刺さる） | ✅ **XIAO面から 10.0mm ＝ XIAO の上に立てたヘッダのピンの先端**（ユーザー実測。🔴 2026-08-24 構成確定: XIAO は直付け・「ソケット」は無い。線の DuPont を挿すと 13.9）。**この機体の最高点。**⚠ ここには「未取得」と書いてあったが誤り（2026-08-15 訂正）—— [respeaker_lite.scad](../hardware/parts/respeaker_lite.scad) の `HDR_H` に最初から入っていた。📄 **USB-C の張り出しは 1.53**（2026-08-22・Seeed 公式 STEP。XIAO の板の端は ReSpeaker の端とツライチなので、ReSpeaker の端からも 1.53）。🔴 それまで筐体は ⚠3.0 で描いていた |
| **OLED** | **4ピンヘッダは上辺の中央寄り・ストレートで後ろ（板の裏）へ出る**。位置は背面写真から**上端から下へ約6mm・板の左右 58%**（⚠ 写真読み）。挿さる DuPont ハウジング＋線の曲がりで**後ろへ 25mm** の逃げが要る（⚠ OLED を測った値ではなく AS5600 の 26.0 と同じ一般値） | ✅ 2026-08-17「中央最上部にある」＋ 2026-08-20「L型ではなく直」（ユーザー） |

**数えるのはコネクタ本体だけでは足りない。**

1. **挿さる相手のハウジング**（コネクタは挿すと伸びる）
2. **線が出て曲がる余地**（真横に折れない。曲げ半径のぶん空間が要る）
   → ✅ **約 25mm**（2026-08-15・ユーザー。**断線しない曲げまで含めた実務値**）
3. **抜き挿しする指**（一度組んだら触らない所か、繰り返し挿す所かで要る空間が違う）

### 🔒 ハーネスの余地は 25mm（2026-08-15）

**コネクタ1個につき、線が出て曲がり切るまでに約 25mm 要る。**
⚠ AI が最初に置いた「15〜20mm」は推測で、**小さすぎた**（ユーザーの実務値で訂正）。

🔴 **これはヘッダの向きに関係なく要る数字である。**
横出し（ライトアングル）にすると、この25mmが**高さから基板面の横方向へ移るだけ**で、
消えはしない。**どちらが得かは「箱のどの寸法が苦しいか」で決まる。**

⚠ **[case_pack_study.scad](../hardware/frozen/v1-v4/case_pack_study.scad) はこれを入れていなかった。**
入れた結果は下の 0.5節。

⚠ **「ピンの逃げ」という書き方をしない。** 高さの数字に潰した瞬間に、
ハウジングと線が設計から消える。**部品として置く。**

## 2. 音・電源

| 部品 | 外形 | 取付・端子 | 出典 |
|---|---|---|---|
| **スピーカー** 秋月 **[112495] マイクロスピーカー 青/白リード付 8Ω** | ✅ **23 × 15 × 4.0 mm**（2026-08-16 実測。📄商品ページの 16 / 4.6 は誤り） | ⚠ **リード線の直出しで、PH2.0 ではない。** 2P(E) を継ぐ（旧 SHOPPING.md（2026-08-24 削除・git 履歴） 2章）。✅ **リードは裏面（磁石側）の、楕円の長軸の端の縁にある小さなパッド 2 つから出る**（2026-08-17 写真・2026-09-06 に表と裏の写真で再確認。🔴 AI 側が何度も読み落として聞き直していた。次からはここを読む）。青と白の 2 本。外形が対称なので**端子の端は貼る向きで選べる**。CAD は `SPK_LEAD`（case_v5.scad）で +X 側の端に置いている | ✅ 2026-08-16 実測＋2026-08-17 端子写真。[商品ページ](https://akizukidenshi.com/catalog/g/g112495/)。⬜ 定格(W) |
| **リポ 3.7V 1000mAh** | ✅ **54 × 34 × 5 mm** | JST・約20g。🔒 **v4 ではタブの端を後ろ（ハッチ側）に向けて置く**（2026-08-25 ユーザー「繋ぎやすい方で」・[CASE-V4.md](CASE-V4.md) §2） | ✅ **2026-08-15 ユーザー実測**。規格品 **503450**（厚5×幅34×長50）＋タブ側の封止で長さ54mm。20gとも整合。⚠ 現行の正は parts.scad（603450・50×35×6・2026-08-25 ユーザー「6mm でいい」） |
| **INA226 モジュール**（Amazon `B0GDX2P81Y`・10mΩ・電池線に直列） | 📄 **27.0 × 20.1 mm** | **ネジ端子4口が片方の長辺**（INPUT 2＋OUT 2・電池線を通す。高さ⚠約10=写真比）／**反対の長辺に5ピンヘッダ**（VCC/GND/SDA/SCL/ALER・ハブへは4本）／**取付穴2・対角**（✅ φ3.0・中心はヘッダ側の端から 16.6） | 📄 2026-08-17 ユーザー提供の商品画像（寸法矢印 2.7cm/2.01cm）。✅ **2026-08-24 着荷・実測**（穴 φ3.0・端から 16.6・シャント刻印 `R010` ＝ 10mΩ。[POWER.md](POWER.md) 6章・[parts.scad](../hardware/parts/parts.scad) `ina_holes()`）。⚠ 端子とヘッダの並びの向きだけ模型では仮定のまま |
| **リードスイッチ**（KILIGEN 樹脂モールド N/O） | 2.5 × 14 mm | リード線 | 📄 商品ページ |
| └ 付属マグネット | **φ6 × 厚2 mm** | — | 📄 商品ページの実寸図 |
| **AS5600 用マグネット**（径方向着磁） | ⚠ φ4.0（未実測） | — | ✅ **ポケット内径 4.10mm で嵌合確定**（下） |

> **磁石の径は⚠のままだが、設計は困っていない。** 要るのは「どの設計値で穴を作れば
> この磁石が嵌まるか」であって絶対径ではなく、そちらはゲージで✅が出ている。
> **絶対寸法が要らない場面では、無理に測らない。**（[PRINT.md](PRINT.md) 2回目）

## 3. 操作部・スイッチ

| 部品 | 外形 | パネル取付 | 出典 |
|---|---|---|---|
| **トグル MTS-102**（マスタースイッチ） | レバー込み全長 33mm・胴径 13mm | **φ6mm の穴**（M6ブッシング） | 📄 旧 SHOPPING.md（2026-08-24 削除・git 履歴） 4章 |
| **押しボタン PS21B-3**（開発用・元 会話ボタン・秋月 104580） | ⬜ | ⬜ **穴径**と⬜ **ねじ長**が未取得。**測る必要はもう無い**（硬すぎて交換・下の行が本命） | ✅ **2026-08-06 着荷**（手元にある） |
| **マイクロスイッチ DAOKAI**（会話ボタン・ヒンジレバー3PIN） | **縦5 × 横12 × 高6 mm ／ ノブ高5 mm**（横＝端子の並び方向。✅ 2026-08-07 **再計測**。初回の「縦6×横9」は誤り——端子の外〜外が10.16mmで9mmには収まらない。**リレー12.6mmとほぼ同じ長さ**） | **端子3本が1穴飛ばし＝ピッチ5.08mm。2.54mmグリッドに乗るのでユニバーサル基板に直挿し**。**縦置き**（リレーと同じ向き・上端も揃える）で `J9`=C／`L9`=NO／`N9`=NC。⬜~~レバーの動作travel はパドルを作る段でだけ要る~~ → ✅ 2026-08-29 図面で解決 | ✅ **2026-08-07 ユーザー実測**。**動作力 約30gf**（合格ライン100gf以下）。✅ **2026-08-29 商品ページの図面**（DAOKAI 20PCS ヒンジストレートレバー 3PIN・Amazon 2026-08-06 ¥309/20個・Unit mm ±0.1）: 胴 **12.8×5.8×6.5**・レバー全長 13.5・自由状態の頂点 10.5±0.5・**ヒンジは C(COM) 端子の端**・**取付穴 φ2.0/φ2.2 ×2・穴間 6.5・胴を横に貫通**・端子長 3.5・板厚 0.5。CAD は parts.scad の MSW_* を図面値に更新済み |
| **リレー Y14H-1C-5DS**（秋月 101346・HSIN DA） | **12.6 × 7.6 × 10 mm・約2.2g** | **6ピン＝2列×3本。横 2.54/7.62・行間 5.08。すべて2.54mmグリッドに乗る**（ユニバーサル基板に直挿し可）。⬜ **どのピンがコイルかは未確定** | 📄 [データシート](https://akizukidenshi.com/goodsaffix/y14h.pdf)（2026-08-06 取得） |
| **OLED 0.96" I2C**（会話中の顔） | **30 × 27 mm** | 4ピンヘッダ（2.54mm）が**下辺の中央**。**ユニバーサル基板の 行L・列17〜20 に直挿し**（[POWER.md](POWER.md) の穴割り）。⚠ 本体は上へ27mm張り出すので**行Lより下げられない**（板の上辺からはみ出す） | ✅ **2026-08-07 ユーザー実測** |
| **AS5600 モジュール**（配線） | — | **7ピンのうち はんだ付けは5本**（VCC / GND / **DIR** / SCL / SDA）。⚠ **DIRはGNDへ**（浮かせると回転方向が決まらない）／**OUTは不要**／**GP0(PGO)は絶対に繋がない**（OTP書込用・焼くと戻せない）。基板側の着地は **行M・列17〜20 の4穴**（M18にGNDとDIRの2本） | 📄 [KNOB-ENCODER.md](KNOB-ENCODER.md)（2026-08-01 実物確認） |
| **つまみ**（自作・印刷） | **φ27 × 天面から外へ 5.5mm ／ 軸 φ7** ／ 天板の下に要る深さ **22.4mm**（バスタブ 2 の板の裏まで。基板の裏は 19.7 ＝ `knob_deep()` で、case_v5 の口と線はそちらを基準にしている） ／ 天板の座 **32 × 36.2mm・四隅 r9**（Y は −16.7〜+19.5 で対称ではない。+19.5 は 2026-08-21 にリードの穴の外壁を 0.4→1.4mm にするため 37→39 へ広げた側。−Y と隅の丸めは 2026-08-27・配線の余地のため、**中身が使っていない肉だけ**を落とした＝最薄は前後とも 1.70mm。−16.0 → −16.7 は 2026-09-08、吊るす手のナットのポケットに肉 0.75 を残すため） | 島（1部品）を **M2×6 2本**で上から留める（🔒 2026-08-23 に M2.5 ナイロンから変更。ナイロンねじは 2026-09-09 現在 1 本も使っていない）。天板は**通し穴＋裏の六角ポケットにナット**（2026-08-21・下の418行の方針どおり。以前あった下穴 φ2.1 のねじ込みは誤りだった）。抜け止めは**Eリング呼び6**（✅ 手元にある） | ✅ 設計値（`knob_v5.scad`。深さと座は 2026-09-08 の吊り＝手 4 本＋バスタブ 2 の形）。⚠ 旧「φ25 × 高12 ／ 軸 φ6 × 10」は `knob_jig.scad`（治具）の値 |

✅ **会話ボタンの動作力は解決した（2026-08-07）。約30gf ≒ 0.29N。**
合格ライン100gf に対して**3倍以上の余裕**があり、買わなかった基準品 `SS-10GL13`（0.49N＝50gf）
よりも軽い。PS21B-3 の約600gf に対して **1/20**。→ 旧 SHOPPING.md（2026-08-24 削除・git 履歴） 4.5

⚠ **これで新しい心配が1つ生まれた: 軽すぎる側**。パドルのてこ比は「軽くするため」に
入れる必要がもう無いので、**てこ比は1:1近くでよい**（比を掛けると誤爆側に寄る）。
肩の上で服・手・寝返りが触れて勝手に会話が始まらないか、**パドルを作る前に決めること**。

## 4. 印刷の補正（穴を開けるときに必ず足す）

**寸法表と別に持たない。** 部品の寸法を筐体の穴に変換するのはここ。
全部 [PRINT.md](PRINT.md) の実測で、**レジン①・層厚0.05mm・通常2.5s・ボトム35s×5層・
収縮補償OFF** のときの値。

| | 値 | 使い方 |
|---|---|---|
| 穴の縮み | **約 0.1mm** | 穴系の**設計値に足す**（`SHRINK`） |
| 凸の太り | **約 0.1mm** | 軸などの外径から引く／隙間の見積りに入れる |
| 回る嵌合の遊び | **直径 +0.25mm**（✅2026-08-05 実測ばっちり） | 🔒 **入口逃がしとセットで成立**。逃がし無しの旧実測が「0.25では通らない」だったため一時0.40まで開けたが、ガタが出た（`BORE_CLEAR`） |
| 差し込み嵌合（ほぞ） | **ほぞ径 = 穴の設計値 − 0.25**（✅2026-08-05 穴3.35にほぞ3.1で確定） | 3.0はプカプカ・3.2は入らない（実測3点）。先端に面取り0.5を付ける（`PEG_FIT_D`/`PEG_TIP_C`） |
| ボトム層の過硬化 | 0.25mm（35s × 5層） | **プレートに接する面の穴は入口を逃がす**（+1.2mm × 深0.6mm） |
| 長穴の遊び | ±1mm（`SLOT_LEN` 2.0） | ピッチが📄・⚠のときの逃げ |
| 板バネ | 🔒 **レジン①では作れない** | 刷った直後は戻るが、**1日半で全数破断**した |

⚠ **設定を1つでも変えたら、この列は全部取り直し。**
⚠ **レジン①は経時で脆い。** 樹脂にネジを切らず、**M2は貫通＋ナット**にする。
（根拠は**板バネ試験1件だけ**＝薄肉0.4〜0.8mmを二次硬化後・1日半経過で曲げた話。
設計ルールとしてはこのまま使うが、**破壊の原因診断にこの行を前科として使わない** —
2026-08-05、未硬化のまま剥がすとき割れた部品が一度これで誤診された。経時ゼロで
割れているのだから経時脆化では説明できない、が正しい読み）

## 4.5 造形できる大きさ（プレートの制約）

| | 値 | 出典 |
|---|---|---|
| ELEGOO Mars 3 のビルドボリューム | **143 × 89.6 × 175 mm**（L×W×H） | 📄 [ELEGOO](https://www.elegoo.com/products/elegoo-mars-3-lcd-3d-printer) |

⚠ **ReSpeaker Lite の 86mm が、プレートの短辺 89.6mm とほぼ同じ。**
基板を寝かせて載せる板は、**縁を足した時点で短辺に入らない**。逃げ方は3つあって、
どれを採るかは板の形が決まってから決める（斜めに置く／基板の長手をプレートの
長辺 143mm に向ける／板を分割してほぞで継ぐ）。

**高さは175mmあるので余る。** 光造形で効くのは面積ではなく**Z高さ＝時間**なので、
スタンドを立体で一発で刷ると時間がそのまま伸びる。平板を寝かせて刷る作法は
ここでも正しい。

## 4.6 見せる部品を刷るなら、レジン②へ（段階4が要る）

**プレゼンで使う前提なら、レジン①（水洗い灰・テスト用）では出せない。**
本番用は **SK本舗 Ultra 高靭性 白**（[PRINT.md](PRINT.md) の「手元にあるもの」）。

⚠ **ただし、レジンを替えると 4章の補正値が全部無効になる。**
0.1mm の縮みも、`BORE_CLEAR` 0.40 も、板バネの 1/30 も、**レジン①・この露光設定での
実測値**であって材料の性質ではない。[PRINT.md](PRINT.md) の **段階4（本番レジンの
露光時間出し）が未実施のまま**なので、そこを通してから、磁石ポケットのゲージを
レジン②で刷り直して数字を取り直す。

**脆さの問題もここで解決する見込みがある。** レジン①は経時で割れる（板バネ9枚が
1日半で全数破断）が、これは高靭性レジンへ進む根拠として [PRINT.md](PRINT.md) に
🔒で残してある判定そのもの。

---

## 5. 未取得の一覧（測ればこの表が埋まる）

現物が手元にあるものと、着荷待ちのものを分けてある。

### 🔒 スタンドに要るのは 35 × 86 と板厚だけ

⚠ **ここには一度「外形・取付穴・各コネクタの位置・マイクの位置を全部測る」と
書いてあった。要らない**（2026-08-03 訂正）。持ち方が決まると、必要な数字は激減する。

**基板は立てて、長辺の縁を溝で受ける。**

| 要らなくなった実測 | なぜ |
|---|---|
| コネクタが端から何mmか | **両方の短辺を丸ごと開ける**ので、位置を知る必要がない |
| マイクが端から何mmか | **マイク面は中央しか受けない**ので、端は最初から開いている |
| ピンヘッダーの位置 | **XIAO面には触れない** |
| 取付穴の位置 | 保持は縁で行う。ネジで姿勢を出さない |

| 数字 | 値 |
|---|---|
| 外形 | 📄 **35 × 86 mm**（公式仕様表） |
| **板厚** | ✅ **1.25 mm**（2026-08-03 ユーザー実測）。**標準の1.6ではない** |
| → 溝幅の設計値 | **1.50 mm** ＝ 1.25 ＋ 縮み0.1 ＋ 遊び0.15 |

**これで数字は揃った。** 板厚ゲージ（`board_gauge.scad`）は実測が出たので**刷らない**。

> **測る量は、持ち方が決まるまで確定しない。** 先に全部測るのは無駄になるし、
> 逆に、持ち方を決めずに数字だけ集めても設計は始まらない。

### 参考: 筐体（肩に載せる本番）まで行くと要るもの

**スタンドには不要。** 本番の箱を作る段になったら測る。

- OLED 2.42"（**着荷待ち**）… 📄 70.1 × 48.1 × 20mm は図面から取れた（上の1章）。
  ⬜ 残るのは **素のパネル厚 ／ 四隅穴の径 ／ ピン並び**
- **ハブ基板の実装高さ**（現物は手元）… 🔴 **最高点はピンヘッダー**（リレーではない）。
  ⚠ **ハウジングを挿した状態**で測る（[POWER.md](POWER.md) 4章）
- ~~リポ 1000mAh（外形）~~ → **✅ 2026-08-15 実測 54 × 34 × 5mm**（上の2章）。
  ⚠ ここには「箱の厚みを決めるのが電池になりがち」と書いてあったが、**測ったら 5mm で主要部品の
  最薄だった**。一般論をこの機体の事実として書いていた（[POWER.md](POWER.md) 4章に経緯）。
  ⬜ **残るのは JSTコネクタと線の出る向き**。工具なしで交換する（[TODO.md](TODO.md) B-1）ので、
  **箱の外形だけでは設計できず、抜き挿しの経路が要る**
  ✅ **2026-08-19、PowerBoost 側は片が付いた。サイドエントリである**（ユーザー）。
  **抜け代は板厚方向へ出ない**ので、PowerBoost の板厚方向は電池を挿しても **6.8mm**。
  🔴 AI は「トップエントリ＝板の上へ 6mm 抜ける」と書き、**12.8mm** として隙間の可否を
  判定していた（同日訂正）。
  ✅ **線の出る端も同日に実写で確定。+Y の長辺**（micro-USB のある短辺を -X としたとき）。
  ハウジングは板の +Y 端より外へ出る。⚠ 突き出し量は未測（`PB_JST_MATE = 6.0` は推定のまま）
- ~~PowerBoost 1000C（取付穴の有無と位置）~~ → **📄 済み。公式 EAGLE の .brd から4穴
  （φ2.5×2・φ2.3×2）を取得**（hardware/parts/parts.scad の PB_MOUNT・2026-08-15）。
  筐体の柱4本はこの座標に立っている
- ReSpeaker Lite の取付穴（数・位置・径）… ネジ留めに戻すなら

### 着荷待ち

- ~~スピーカー（外形・厚み）~~ → **📄 2026-08-15 に確定。秋月 [112495]・23 × 16 × 4.6mm**（上の2章）。
  ⬜ 残るのは **定格(W)・取付穴の有無**と、⬜ **PH2.0 化**（リード線の直出しなので 2P(E) を継ぐ）
- **会話ボタンのタクトスイッチ（LUYING アソートの 6×6×4.3mm・4ピン）** … 2026-08-17 発注・当日着。
  ✅ **胴だけの高さ = 3.0mm**（黒い樹脂の四角だけ。軸と足は含まない。2026-08-21 ユーザー実測）。
  一般値で置いていた 3.5 を `hardware/parts/parts.scad` の `TSW_BODY_H` に反映済み。
  ✅ **軸径 3.5mm ／ ストローク 0.5mm**（2026-08-21 ユーザー実測。どちらも parts.scad に反映済み）。
  🔴 **動作力 255gf ＝ 不合格**（合格ライン 100gf）。⇒ **2026-08-30 に会話ボタンは v3（DAOKAI レバー・30gf）へ戻った。**
  このスイッチは会話ボタンには使わない（アソート 180 個は手持ちのまま）。
- **DuPont コネクタ一式（サムコス QI コネクター 620 個セット・2.54mm ピッチ・オス/メス・ケース付き）**
  … ✅ **2026-08-17 購入・手持ち**。ハブ基板側の 10 束はこれで圧着する（🔒 2026-08-07「DuPont のまま＋抜け止め」・[POWER.md](POWER.md) 639 行）。
  Amazon `B08HCNYF1N`。
- **会話ボタンのマイクロスイッチ（DAOKAI・ヒンジレバー）** … 🔒 **これが現行**（会話ボタン v3）。
  ✅ 2026-08-07 着荷・実測完了。20 個手持ち。
  ⚠ 2026-08-17 に「筐体で 24mm の井戸が要る」としてタクトへ変えたが、**その 24mm は二重計上**だった
  （「胴 6 ＋ レバー 11」を足していた。**部品の全高は 11mm**。深さを決めるのはクリックまでの 2.5mm）。
  ⇒ 2026-08-30 に v3 でこのスイッチへ戻した。実測の深さは**バスタブの底 −15.085 / 端子の先 −17.785**。
  - ⑤**動作力 … ✅ 約30gf**（合格。100gf以下）→ **閉じた**。
    ⚠ 個体差の3個測定は**やらなくてよい**（余裕が3倍あり、数gfの差では結論が動かない）
  - ①**外形 … ✅ 縦5 × 横12 × 高6 mm ／ ノブ高5 mm**（2026-08-07 ユーザー**再計測**）。
    横12mm ＝ 端子の並び方向。⚠ 初回申告の「縦6 × 横9」は誤りで、**端子の外〜外10.16mm と
    矛盾していた**（9mmには収まらない）。ユーザーが「リレーと同じ幅では？」と気付いて再計測
    → 12mm で辻褄が合った。**有り得ない値は作る前に照合する**の実例
  - ②**取付穴 … 不要になった。** 端子が**1穴飛ばし（ピッチ5.08mm）で 2.54mm グリッドに乗る**ので、
    **ユニバーサル基板に直挿しする**（ねじ止めのボスは筐体を作る段の話）
  - ③**レバーの位置と動作travel** ⬜ … **パドルを設計する段でだけ要る**。基板には要らない
  - ④**端子 … ✅ 確定**（2026-08-07 ユーザー確認）:
    **レバーの根本（ヒンジ）側から順に C, NO, NC**。使うのは C と NO、**NC は繋がない**
    → 穴は `J9`／`L9`／`N9`（縦置き）。[POWER.md](POWER.md) と
    [hardware/parts/relay_board.html](../hardware/parts/relay_board.html)
  > ⚠ **これを載せるために駆動回路を左へ寄せた**（GNDレール 列8 → **列7**）。
  > **列2 は空けたまま**にすること —— 列1が +5V レールなので、隣に節点を置くと橋絡が
  > 「+5V–GND短絡」「**リレーが閉じっぱなし**」「5VがGPIOへ」に直結する。**緩衝の1列。**
- ~~押しボタン PS21B-3 のパネル穴径・ねじ長~~ → **優先度を下げた（2026-08-06）。**
  硬すぎて交換が決まり（実測600gf）、**取付がパネル穴＋ナットからねじ止め＋パドルに変わった**ため。
  開発用として配線するので現物は使うが、細かく測る必要は無い
- ~~リレー Y14H-1C-5DS（外形）~~ → **✅ データシートで取得（2026-08-06）。**
  残るのは⬜ **ピン機能（どの2本がコイルか）**。`gN` の導通マッピングで確定できる
  （手順は [POWER.md](POWER.md) の「どのピンがコイルかは未確定」）

---

## 記録のときの約束

- **測った日と方法を書く**（「定規で実測（2026-08-03）」）。あとから格付けを直せる
- **推定を実測に見せない。** ⚠ のまま残すほうが安全で、実際 AS5600 の磁石は
  ⚠ のまま設計が通っている
- **物理側の事実（はんだ・配線・現物の有無）は、ユーザーの確認なしに断定形で書かない。**
  過去に「はんだブリッジしてある」「短絡事故があった」が誤記録で残り、
  保証相談の判断まで狂わせかけた（[firmware/esp32/README.md](../firmware/esp32/README.md)）
