n416/katanori/docs/VOICE-BOARD.md

# 自前の音声の板（ReSpeaker Lite ＋ XIAO の置き換え・2026-09-15 着手）

ReSpeaker Lite ＋ XIAO ESP32S3 をやめ、**XU316 の音声部と ESP32-S3 を載せた自前の音声の板**を ReSpeaker Lite の場所に入れる。ハブ（v6.1）とはライザーでつなぐ。
この資料は「なぜ・何を借りて・何を変えるか」と、面積とピンの**叩き台**だけを持つ。
板の外形・穴・口の座標は、今までどおり筐体（`hardware/case_v6_1.scad`）と [PCB-V61.md](PCB-V61.md) が持つ。

## 0. ⏸ 今の状態（2026-09-15・保留）

🔒 **保留。凍結ではなく別の期にやる**（ユーザー 2026-09-15「この板をもとに進める。次は音の面の確認をして、まず 5 枚だけ試作する。これで良い。量産化計画が立ったら。それまではペンディング」）。
それまで katanori は今の **ReSpeaker Lite ＋ XIAO ＋ v6.1 のハブ**（`hardware/pcb/katanori61/`・`gen_sch.py`・`gen_pcb.py`・どれも手を入れていない）で進む。

**できている物**
- 回路図 2 枚（8 章）: 音声の板 `katanori61_audio/`・ハブ `katanori61_hub/`。`check_sch_voice.py` の食い違い 0。
- 音声の板の配置と配線（別スレッド katanori-83・コミット 89a5228）: KiCad の DRC エラー 0・未接続 0。板のパッドのネットは回路図のネットリストと全ピンで一致（katanori-a7 が確かめた）。再現は `python hardware/pcb/gen_pcb_audio.py --route --keep`。

**再開したらやる順**
1. **3.5mm ジャックとヘッドホン検出を戻す。** 回路図を写すときに私（katanori-a7）がユーザーに確かめずに外した。実際は最初の動作確認（[FIRST-RUN.md](FIRST-RUN.md)）でイヤホンを使っていて、筐体 v6.1 の右の壁にも穴がある。置き場所は音声の板の、ReSpeaker Lite の J1 と同じ位置（筐体の穴）。Voice PE の J1・FB2・FB3・C15〜C18・D2・D3・R18・R19 と、ヘッドホン検出 D9・Q2・R26 を写す。`check_sch_voice.py` の爆音の検査は、Q2（アンプを止める側にしか働かない）を認めるように直す。板は今の配線を残して、その周りだけ足す。
2. **音の面を Voice PE と比べる**（DRC では見えない所）: 内層 2 の GND のベタを外したこと、マイク面だけすきま 0.125 にしたこと、Flash を XU316 の横へ回したこと、GNDA の島、水晶の周り、スイッチング電源とマイク・コーデックの距離、XU316 の真裏のパスコン。
3. **5V の電流とノイズ**: ハブの昇圧 TPS61090 で XU316・ESP32・アンプをまかなえるか（Voice PE は USB の 5V）。
4. **ハブの基板を作り直す**（v6.1 からリレーと J4・J5 が消え、ライザーの口が 2x07 に。ライザーの板と筐体の `riser61()` も 2 列に）。
5. **受動部品の LCSC 番号**を選ぶ。J16 の「未実装」属性を回路図に揃える。
6. **5 枚だけ試作**して、割り込みと遠くの声を今の実機と聞き比べる。発注の条件は「DRC エラー・未接続 0」「回路図と板の突き合わせ 0」「`check_sch_voice.py` 0」と、ユーザーが KiCad の画面で板を見て納得すること。

## 1. 決まったこと

| 🔒 決定 | 理由 |
|---|---|
| **XU316 をそのまま載せる**（ソフトの AEC や半二重にはしない） | 声での割り込みが必須。割り込みの要らない版は Android と Web で既にある（ユーザー 2026-09-14） |
| **20 台以上作る前提** | ReSpeaker Lite は日本から大量に入手するのが面倒（ユーザー 2026-09-15） |
| **2 枚に分ける: 音声の板（ReSpeaker Lite の場所）＋ ハブ（v6.1）** | ユーザー 2026-09-15 夜「だめだね。基盤を大きくしないといけないのでは。やっぱり2枚に分けます？」→「あなたがお勧めする構成で良い」。1 枚（82 × 37.4・裏は電池の影で部品を置けない）では、線 0.2・すきま 0.15 に緩めると自動配線が通らず、0.12 に詰めても「ごっちゃごちゃ」（10 章）。筐体 v6.1 には ReSpeaker Lite の場所（前の縦の板・82.024 × 34.007）が既にあるので、そこへ自前の音声の板を入れる。費用は 2 倍にならない（部品は同じ・設計の種類は 1 枚案でもマイクのライザーとで 2 つだった） |
| ~~v6.1 の板と 1 枚にまとめる~~ | ユーザー 2026-09-15 昼に決め、同じ日の夜に上の 2 枚案へ変えた |
| **ESP32 は音声の板に置く** | I2S 2 組と MCLK をコネクタに通さない。ReSpeaker ＋ XIAO と同じ分担なので、ハブとのライザー（XIAO の 2 列を受ける形）の考え方がそのまま使える。ハブとの間はライザーで I2C・電源・USB D±・ボタンなど |
| **ミュートリレーを外す** | 下の 3 章。アンプの SHUTDOWN を ESP32 のピンで握り、プルダウンで代わりにする |
| **マイク間隔は 71.0mm** | ReSpeaker Lite（[RESPEAKER-LITE.md](RESPEAKER-LITE.md) の U4/U5：中心 5.49 と 76.49）、Voice PE、XMOS 純正リファレンスのどれも 71mm。XMOS は 71mm で評価し、他の間隔は「適応するが性能は変わりうる」としている |
| ~~マイクだけを前の面の細い板に分ける~~ | 1 枚案のときの決定（ユーザー 2026-09-15「マイクだけ前にあればいい」）。2 枚案ではマイクが音声の板のマイク面に ReSpeaker Lite と同じ位置で直に載るので、要らなくなった |
| **マイク・XU316・コーデックは今と同じ部品** | 今の実機で割り込めていて、遠くの声も拾えている（ユーザー 2026-09-15） |

## 2. 出どころ

| もの | どこから | ライセンス |
|---|---|---|
| 回路（XMOS・DAC・Power の 3 シート） | **Home Assistant Voice PE**（Seeed の設計と見られる）。`hardware/ref/voice_pe/`（2025-07-16 版を取得） | **CERN-OHL-P v2**。商用で製造・販売してよい。変えた設計を公開する義務はない。著作権表示とライセンス文は残す |
| XU316 のファーム | [esphome/voice-kit-xmos-firmware](https://github.com/esphome/voice-kit-xmos-firmware)（XMOS 純正アプリ FFVA の派生） | XMOS Public Licence v1。XMOS のチップ上で動かすなら商用利用できると読める（XMOS の明文の解釈は未確認） |
| ~~Seeed の配布ファーム~~ | 使わない | ライセンスの記載が無く、USB の VID:PID も Seeed のもの |

ReSpeaker Lite の設計データは非公開で、回路図は PNG 1 枚しか出ていない。

## 3. 爆音の穴を回路で塞ぐ（リレーの代わり）

リレーを入れた理由は [firmware/esp32/README.md](../firmware/esp32/README.md) の「起動時の轟音とその対策」にある。
**ESP32 だけがリセットされて、音の出口が開いたまま残る**場面（書き込み・電池切れ・クラッシュ）を塞ぐためだった。

Voice PE の回路（`DAC.kicad_sch`）では、この場面が次のように塞がる。

- TPA6211A1 の `SHUTDOWN`（Low で停止）＝ `AMP_CTL`
  - ESP32 の GPIO47 から R25（4.7kΩ）経由で駆動する
  - **R35（470kΩ）で GND に引き下げてある**
  - C29（10nF）が GND へ入っている
- ヘッドホンを挿すと Q2（BSS138）が `AMP_CTL` を Low に落とす
- ⇒ **ESP32 がどんな理由でリセットされても、ピンが浮けばアンプは止まる。** リレーの「無通電で開」と同じ働き

🔴 **アンプの EN は必ず ESP32 のピンだけで握る。**
- XMOS に握らせると、XMOS は ESP32 と一緒にリセットされないので、今のコーデックのミュートと同じ罠に戻る。ReSpeaker Lite の X0D31 がこれにあたる。
- Voice PE には、0Ω（R37）で別の信号を同じ節点へ入れる箇所がある。つながる先は未確認。流用するときは外す。

🔒 **I2S は UART0（GPIO43/44）に出さない。** GPIO43/44 はテストパッドにだけ出す（USB が死んだとき、ROM ログを読むための最後の経路）。

ROM ログを eFuse で止める案は、2026-08-03 に不採用のまま。この板でも要らない。

## 4. 面積の見積もり（courtyard の外接矩形の合計・2026-09-15・1 枚案のときの物）

⚠ 1 枚案（v6.1 の板に全部）のときの見積もり。2 枚案では音声の板が ReSpeaker Lite と同じ中身（XU316・コーデック・アンプ・マイク）に ESP32 モジュール（XIAO の代わり）を載せるだけなので、面積の心配は小さい（11 章）。

`kicad_pcb` から部品ごとの courtyard を読んで合計した。配線の余白は入っていない。

| ブロック | 元の値 | この板で見込む値 | 増減の中身 |
|---|---|---|---|
| v6.1 の板の今の中身 | 1086 | 約 770 | − リレーまわり（約 190）、− XIAO の受け（67）、− SPK IN（59） |
| XMOS（Voice PE） | 472 | 約 290 | − ボタン SW1（89）、JTAG の J5（97）をパッドに縮める、− マイク 2 個（前の板へ）、＋ マイクの板への口 |
| DAC（Voice PE） | 385 | 約 250 | − 3.5mm ジャック J1（134） |
| Power（Voice PE） | 247 | 約 150 | − 2 つ目の USB-C、− USB の切替。残すのは 0.9V・1.8V・3.3V |
| ESP32 | 333（チップ直載せ） | 約 350 | **ESP32-S3-WROOM-1U**（18.0 × 19.2）に替える |
| LED・コネクタ（Voice PE） | 377 | 約 40 | 画面の口だけ |
| **合計** | | **約 1860** | |

**使える面積**は、表 82.024 × 37.4 ＝ 3068 から、欠きと穴の周りを引いて**約 2900**。
合計はその **64%** で、**部品を表だけに置くと窮屈**。

逃げ道は 2 つ。
- **受動部品を 0805 から 0402 に落とす。** v6.1 は手はんだ前提の 0805 で、1 個 6.7mm² ある。JLCPCB で実装するなら 0402 でよい。
- **裏の、電池の外の 2 本の帯**（それぞれ 16 × 21、背 6.0 まで）にも部品を置く。

Voice PE の板は 78 × 59 で、部品は大半が裏にある。そのままの配置は使えない。

## 5. ESP32 のピン（叩き台・⬜ 未確定）

ESP32-S3-WROOM-1U-N16R8 を想定する。GPIO26〜32（Flash）と 33〜37（Octal PSRAM）は使えない。

| 用途 | GPIO | メモ |
|---|---|---|
| I2S その 1（スピーカー）LRCK / BCLK / DOUT | **7 / 8 / 10** | Voice PE と同じ。ESPHome の設定（`home-assistant-voice.yaml`）は **48kHz・32bit・ESP32 がスレーブ**。7 と 8 は今の katanori とも同じ |
| I2S その 2（マイク）LRCK / BCLK / DIN | **14 / 13 / 15** | Voice PE と同じ。**16kHz・32bit ステレオ・ESP32 がスレーブ**。XU316 が処理した後の声がここに来る |
| I2S の MCLK | 9 / 12 | Voice PE の配線どおり（0Ω の R146 で 2 本の MCLK がつながっている）。ESPHome の設定には出てこない |
| I2S その 1 の戻り（XU316→コーデック DIN） | 11 | Voice PE の配線どおり ESP32 にもつながっている（読むだけ） |
| I2C SDA / SCL | **5 / 6** | XU316（0x42）・コーデック（0x18。ESP32 から設定する）・AS5600・INA226 |
| アンプ EN | **47** | 基板で 470kΩ のプルダウン（3 章）。ESPHome も `restore_mode: ALWAYS_OFF` |
| XU316 リセット | **4** | High でリセット（Q3 経由）。浮いていれば動く |
| 画面 | 16 / 17 / 18 / 21 / 48 | 今は 16 と 17 を OLED 専用の I2C（SCL・SDA）に使う。SPI 版にしたら SCK・MOSI・RES・DC・CS に回す |
| 会話ボタン | 40 | v6.1 の J6 |
| マイクのミュート | 2 | Voice PE のスライドスイッチの代わり。10kΩ で引き下げ（リセット中もマイクは有効） |
| USB D− / D+ | 19 / 20 | 書き込みとシリアル（今の COM5 と同じ経路） |
| UART0 TX / RX | 43 / 44 | **テストパッドだけ** |
| 避ける | 0・3・45・46 | ストラッピングピン |
| 空き | 1・3・38・39・41・42（45・46 はストラッピング） | Voice PE で 3 はミュートスイッチ、38/39 は 2 本目の I2C、40/41 は XU316 との予備線だった。どれも写していない |

## 6. 開いている問い

| ⬜ 問い | 誰が決めるか |
|---|---|
| ~~マイクの板の形・マイクのライザー~~ | 1 枚案のときの問い。2 枚案ではマイクが音声の板に直に載るので無くなった |
| **音孔。** マイクを 1 個ずつ独立させ、スピーカーから離す。筐体の中で音が回り込まないようにし、ビビリ音を出さない（XMOS の音響設計ガイド） | 筐体 |
| **アンテナ。** 今の XIAO と同じ外付けにするため、WROOM-1U（u.FL）を想定。アンテナの置き場所 | 筐体 |
| 🔒 **音声の板の板厚は 1.6**（JLCPCB の 4 層で選べるのは 0.4/0.6/0.8/1.0/1.2/1.6/2.0。ReSpeaker Lite の 1.85 は選べない。2.0 は 5 枚で +$64（技術料 $66・2026-09-15 の見積もり））。**筐体の座・唇・押さえを 1.6 の板に合わせて直す**（ユーザー 2026-09-15「ガタが出るじゃなくて、筐体設計を変えるだけの話でしょ」）。XIAO 面（ライザー側）の位置 Y 10.035 はそのまま、マイク面側の唇を 0.25 後ろへ。筐体の模型を ReSpeaker Lite から音声の板に替えるときに一緒にやる | 筐体 |
| **ハブ ↔ 音声の板のライザー。** 今のライザーはハブ側が 1x07。I2C・USB D±・画面 5 本・会話ボタン・電源を通すと 14 本要るので、ハブ側を 2x07 にする（筐体の `riser61()` の L 字のメスも 2 列になる） | 回路・筐体 |
| ~~USB-C を 1 つにするか~~ → 🔒 **1 つにして、充電と書き込みを兼ねる**（ユーザー 2026-09-15「やりたかった事そのもの」）。ハブの充電用 USB-C（右の縁・y 26.0）の D+/D− を、ライザーを通して音声の板の ESP32 の GPIO19/20 へつなぐ。ESD 保護を入れる。再起動が起きるのは、PC のソフトがポートを開いて DTR/RTS を動かしたときだけ。挿しただけでは起きない | — |
| **画面は今の HS154L03W2C01（I2C）のまま。SPI への切り替えは後で調べる**（ユーザー 2026-09-15） | ユーザー |
| 🔒 **画面の口は後から SPI に替えられる形にする**（ユーザー 2026-09-15 了承）。1.54" の SSD1309 は、SPI 版の 7 ピンモジュール（GND・VCC・SCL・SDA・RES・DC・CS）が多く出回っている。HS のデータシートにも SPI のタイミングと RES/DC/CS のピンが載っている。口を 1x07 にして、1〜4 番を今の I2C の並びと揃える。3・4 番は共用の I2C バスではなく**専用の GPIO**へつなぐ（ESP32 はどの GPIO でも I2C にも SPI にも回せる）。こうすれば、今の OLED は 4 本だけ挿して動き、同じ大きさの SPI 版が見つかれば板を変えずに差し替えられる | ユーザー |
| XU316 の型番 | QF60B-C24 を第一候補（Voice PE と同じ）。手に入らなければピン互換の C32。LCSC の在庫は 12 個前後しかないので、DigiKey で買って JLCPCB に持ち込む |
| XU316 のファーム | ESPHome 版は **I2S を 2 本使う**。マイクはその 2 で 16kHz（今と同じレート。間引きは要らない）、スピーカーはその 1 で 48kHz。`AudioIo` は 2 本の I2S に分ける。Gemini→ESP32 の 24kHz は 2 倍にして出す |
| 書き込み | 空の XU316 は USB から書き込めない。**JTAG をパッドで出し、XTAG4 で最初の 1 回を書く**。その後の更新は ESP32 から I2C でできる（ESPHome の `voice_kit` が `ffva_v1.3.1_upgrade.bin` を I2C で送っている） |

## 7. 部品の在庫（JLCPCB / LCSC の API・2026-09-15 取得）

Voice PE の部品は**全部 Extended**（Basic も Preferred も無い）。1 枚あたり約 24 種類ある。

**欠品で、代わりに替える物**（XU316 以外は同じ足形・同じピン配置）:

| Voice PE の部品 | 状況 | 替える物 | 違い |
|---|---|---|---|
| XU316-1024-QF60B-C24 | 在庫 0 | **QF60B-C32（C7397517）** | ピン互換で速い版。**JLC・LCSC とも在庫 12 個しかない ⇒ DigiKey（2026-09-14 時点で 571 個）で買って持ち込む**。QF60A は IO が全部 1.8V なので使えない |
| ZB25VQ32DSJG（XU316 の Flash） | 取り扱いなし | W25Q32JVSSIQ（C179173・在庫 2.4 万） | 電源の下限が 2.7V（Voice PE の Flash の電源が 3.3V かは ⬜ 未確認） |
| Y2400FE001（24MHz） | 見つからず | HY24MSMD2016FA1R30（C5265838） | ESR 45Ω。XMOS の条件（ESR 60Ω 以下・12pF）に収まる |
| LC1458CB5TR33 | 取り扱いなし | ME6211C33M5G-N（C82942） | ピン配置は同じ。Voice PE でも U19 は DNP |
| SGM2594BDXN5G（電源スイッチ） | 取り扱いなし | RT9742CGJ5（C250546） | ピン配置は同じ。電流制限の値は ⬜ データシートで確かめる |
| ESDPSA0402V05（Semitel） | 在庫 0 | SLESDPSA0402V05（C7496591） | 同じ系列の互換品 |
| MSM261DHP006（マイク） | **在庫あり（C22390138・2508）** | そのまま使う | — |

**ESP32**: ESP32-S3-WROOM-1U-N16R8（C3013946）は JLC に 11,135 個ある。

**AS5600（C79815）: LCSC は 0 だが、JLCPCB 側に 813 個ある ⇒ JLCPCB の実装なら使える。**
発注までに減るおそれがある。控えは次の 2 つ。
- AS5600L: 在庫 6 個で足りない。
- MT6701CT-STD-R（C3003196・8,592 個）: ピン 3・4・6・7 は同じだが、ピン 2・5・8 の役目が違う。I2C のアドレスは 0x06、レジスタも別物。載せ替えには板とファームの両方の変更が要る。

## 8. 回路図（2 枚・2026-09-15 夜）

```
python hardware/pcb/gen_sch_voice.py && python hardware/pcb/check_sch_voice.py
```

| 板 | 出力 | 部品 | 中身 |
|---|---|---|---|
| 音声の板 | `hardware/pcb/katanori61_audio/`（A1） | 192 | Voice PE の XMOS・DAC・Power の写し、マイク 2 個、ESP32-S3-WROOM-1U とその周り、JTAG のパッド、ライザーの 2 列（J21・J22）、スピーカーの口 J23 |
| ハブ | `hardware/pcb/katanori61_hub/`（A3） | 49 | v6.1 から、リレーまわり・SPK IN（J4）・SPK OUT（J5）・XIAO の受けを外し、ライザーの口 J1 を 2x07 に |

- v6.1 の `katanori61/` はそのまま残っている（比べる元にするため）。
- Voice PE の部品は、**部品番号に 100 を足して**写した（R36 → R136）。
- `gen_sch.py` は書き出し部分だけを使い回せるように直した。v6.1 の出力は 1 バイトも変わっていない。

### ライザー（音声の板 ↔ ハブ）

音声の板の J21・J22 は、XIAO のピンがあった 2 列（11 章）に立てる 1x07 のオス。ハブの J1（2x07）の奇数番が J21、偶数番が J22。

| 番 | J21（電源の列） | J22（信号の列） |
|---|---|---|
| 1 | V5 | GND |
| 2 | GND | USB_DN |
| 3 | V33 | USB_DP |
| 4 | BTN | SDA |
| 5 | OLED_RES | SCL |
| 6 | OLED_DC | OLED_SCL |
| 7 | OLED_CS | OLED_SDA |

- 3.3V は音声の板（Voice PE の TPS62827）が作り、ハブの INA226・AS5600・画面へ送る。5V はハブの昇圧から来る。
- 共用の I2C の引き上げは音声の板の R223・R228（Voice PE の R123・R128）。ハブの R42・R43 は画面の I2C の引き上げ。
- スピーカーは音声の板の J23（PH2.0・上から挿す）に直に挿す。ハブの J5 は無くなった。

### 検算（`check_sch_voice.py`）

KiCad が書き出した 2 枚のネットリストを、ライザーでつないで 1 つにし、元の 2 つと突き合わせる。
1. Voice PE から写した部品: 168 個・487 ピンが Voice PE と同じ組み合わせでつながっているか
2. ESP32 のピン: Voice PE の ESP32 の GPIOn と、この板の IOn の相手が同じか。変えた 15 本（画面・会話ボタン・I2C はライザー越しにハブの相手まで）と、ライザーを越える電源と USB の 5 本を確かめる。JTAG のパッド 7 個
3. 爆音の穴:
   - アンプの SHUTDOWN に乗っているのが、470kΩ・4.7kΩ・10nF・アンプだけか
   - その向こうが ESP32 の IO47 だけか
   - UART0 がテストパッドだけか
4. v6.1 から残した部品（ハブ）: 146 ピンのつながりが変わっていないか

2026-09-15 の時点で**食い違いは 0 件**。ライザーの USB の 2 本を音声の板の側だけ入れ替えると、2 件の食い違いとして出ることも確かめた。

KiCad の ERC のエラーは、ハブの Q1 のベースの 1 件だけ（v6.1 の時点から同じ。昇圧 IC の LBO はオープンドレイン）。音声の板は 0 件。

**写さなかった物**（外した理由はどれも「katanori に無い部品のためのもの」）:

| シート | 外した物 |
|---|---|
| Power | 2 つ目の USB-C・USB の切替（SGM7222）・VBUS から 5V を作るスイッチ（SGM2594）とその周り |
| DAC | 🔴 3.5mm ジャックとその経路・ヘッドホン検出（Q2 がアンプを止める回路）— **ユーザーに確かめずに外した誤り。再開したら戻す（0 章の 1）**。スピーカーの口 J2（音声の板の J23 に替える） |
| XMOS | ミュートのスライドスイッチとその検出・XU316 の USB の VBUS 検出・ESP32 との予備線・JTAG の 20 ピン J5 と xLink の 22Ω（R32・R33。JTAG はテストパッド J16） |

**変えたつなぎ方**:
- ミュート: スライドスイッチの代わりに、ESP32 の IO2 で握る。
- USB: USB の ESD 保護と 22Ω は写し、ハブの USB-C からライザーを通して ESP32 へ。
- 画面: ハブの J2 を 1x07 にし、画面専用の I2C（後から SPI）に替える。
- マイク: 足元に 100nF（C301・C302）を足した。Voice PE はマイクが XU316 の近くにあるので、この 100nF が無い。

**⬜ まだの物**:
- **受動部品の LCSC 番号**（IC は 7 章の番号を入れた）
- **5V の電流**: ハブの昇圧 TPS61090 で、XU316・ESP32・アンプを全部まかなえるか
- **基板**: 音声の板の部品配置と配線は、別スレッド（「ReSpeaker回路の配線」から引き継いだ katanori-83）が作った（ユーザー 2026-09-15「もう部品配置もあっちに依頼したら？」「置き方相当悪いよね」）。`hardware/pcb/gen_pcb_audio.py`・`katanori61_audio/`。katanori-a7 の最初の置き方（Voice PE の並びを区画へ縮めて空きへ詰める）は XU316 とコーデックの周りが詰まって自動配線が進まなかったので、XU316 の周りは手で引き直してある。DRC エラー 0・未接続 0（0 章）。ハブの基板はまだ（0 章の 4）

## 9. 費用と、元が取れる台数（2026-09-15・概算・1 ドル 150 円）

🔴 **最初に出した「1 台あたり 2〜3 千円」と「20 台で約 ¥4,900」は、部品と量産の単価だけで、下の最初の費用・作り直し・道具を入れていなかった**（ユーザー 2026-09-15「完全に後だしでしょ」）。
自作を選ぶ前に、この表で判断できるようにしておくべきだった。

**1 台あたり**
| | 値段 |
|---|---|
| 買う: ReSpeaker Lite ＋ XIAO（スイッチサイエンス） | ¥5,591 |
| 自作: 音声の板 1 枚（部品 約 $30 ＋ 基板と実装の分） | 約 ¥5,000 前後（以前の見積もり: 20 台で ¥4,900・50 台で ¥4,000） |
| 自作ならハブから消える物（リレーまわり） | 数百円 |
| **1 台あたりの得** | **せいぜい ¥1,000 前後** |

**最初にかかる物**
| | 値段 |
|---|---|
| 試作 5 枚（音声の板 4 層・部品・実装〔特殊部品の取り付け料 約 24 種 × $3・両面の段取り〕＋ハブ 5 枚＋送料 約 $30） | 5〜8 万円（見積もりは取っていない） |
| 直しの 2 回目の板（1 回目でそのまま性能が出る見込みは低い） | もう 5〜8 万円 |
| XTAG4（XU316 に最初に書く道具・1 台で全部の板に使える） | 約 4 千円（Flash を先に書いて起動できれば要らない可能性・未確認） |
| **合計** | **約 10〜16 万円**（作業の時間は入っていない） |

⇒ **お金だけで元が取れるのは、およそ 100〜160 台から。20〜50 台では取れない。**
自作の得は値段ではなく、XIAO のピンの制約を解くこと・リレー無しで爆音を塞ぐこと・日本からまとめて買いにくい ReSpeaker Lite に頼らないこと。

## 10. 1 枚案の基板の記録（4 層・2026-09-15・取りやめ）

v6.1 の板（82.024 × 37.4）に全部を載せる案で、配置と自動配線まで進めて**やめた**（1 章）。
道具のうち、置き方（legalize・full_box）と DSN の渡し方（dsn_pad）は `gen_pcb_audio.py` へ移し、`gen_pcb_voice.py` は消した。`route.py`・`dsn.py`・`voicepe.py` はそのまま使う。1 枚案の出力（`hardware/pcb/katanori61_voice/`・`katanori61_mic/`）は消した（git の履歴にはある）。
2 枚案でもそのまま効く教訓だけを残す。

### 足形（そのまま使う）

Voice PE の `.kicad_pcb` から `hardware/pcb/voicepe.pretty`（26 種）を起こした（`voicepe.py`）。
- **検算**: 元と同じ面・同じ回転で置き直すと、171 部品すべてでパッドの位置・向き・層が一致する。
- **同じ名前で形の違う足形**: C0603・R0603 に 2 種類あったので、2 つ目を `_v2` に分けた。
- **XU316 の外形**: 長さ 0 の線と余計な線が混ざっていたので、長方形 1 つに替えた。

### 置き方の教訓

- Voice PE は大半が裏面。**裏から見た鏡像**（X を鏡にし、向きは 180 − a、層は F↔B・In1↔In2）で写す。
- 押し離し（relax）は解けなかった（79 組）。⇒ **大きい順に、狙った位置に一番近い空きへ置く**（`legalize`）。
- 枠は courtyard に**パッドの実寸**と**丸の本当の半径**を足して測る（courtyard だけではパッドが 25 か所で触れた）。
- IC の周りの余白: 足 16 本以上は 0.6、6 本以上は 0.3（0.05 では XU316 のピンが引き出せなかった）。
- 裏の部品の貫通の足の真上（表）には部品を置かない。

### 自動配線の教訓（Freerouting 2.4.1）

- 内層を DSN の plane にすると例外で止まる（`drillShapes` is null）。⇒ 4 層とも配線の層にし、GND のベタを 4 層に敷く。
- 最適化の段は、配線の段より悪い版を書き出すことがある。⇒ 止める（`--router.optimizer.enabled=false`）。
- ネックダウン（細いピッチの手前で線を半分まで細くする）は止める（`--router.automatic_neckdown=false`）。
- 🔴 **CLI で渡した `--router.*` は `%APPDATA%\freerouting\freerouting.json` に残り、次の起動にも効く。** `route.py` は板ごとに全部の値を明示する。
- 金属化していない穴（USB-C の位置決めの足）は、DSN で配線禁止にする（入れ忘れて VBUS のビアが 25 個乗った）。
- 多角形のパッドと斜めのパッドは、DSN に**凸包の多角形**で渡す（小さく渡したら線がパッドに 0.044 まで寄った）。
- **すきま**: マイクの LDO（U118・X2SON4）はパッド 3–5 の間が 0.123、XU316 は 0.146。規則はネットクラスを 0.12 にし、**線・穴・ベタだけ 0.15** を `kicad_dru` で掛ける（ネットクラスを 0.15 にすると XU316 の隣り合うパッドが 56 件の違反になる）。

### 結果と、やめた理由

| 回 | 規則 | 結果 |
|---|---|---|
| 3 回目 | 線 0.15・すきま 0.12 | 未接続 4（JTAG の 20 ピンが XU316 から 45mm） |
| 5 回目 | 同上・JTAG をテストパッドに | 未接続 6（全部 XU316 の水晶・PLL・I2S の周り）・すきま 0.1147 が 3 件 |
| 6 回目 | 線 0.2・すきま 0.15（受動部品を 0402 に） | パス 4 で 44 本（5 回目の同じパスは 12 本）。途中で止めた |

- 5 回目の板を見たユーザー:「ごっちゃごちゃ。簡単にショートしそう」。緩めると通らない＝**面積が足りない**。手で引いても通り道は増えない。
- ⇒ 2 枚に分けた（1 章）。

## 11. 音声の板の置き場所（ReSpeaker Lite の場所・2026-09-15 に筐体から測った）

出どころは `hardware/case_v6_1.scad`（OpenSCAD は未導入なので、式を読んで計算した値）。
座標は ReSpeaker Lite と同じ「XIAO 面から見て 左から x ／ 下から b」（[RESPEAKER-LITE.md](RESPEAKER-LITE.md) 2 章）。
隙間 d は今の板厚 1.85 の面（マイク面 Y 8.185・XIAO 面 Y 10.035）から測る。

### 置き場所
- 世界 X ＝ 2.000 + x、世界 Z ＝ 41.507 − b（`W_rsp`）。**マイク面が前（−Y）、XIAO 面が後ろ（+Y）**。回転であって鏡ではない（`chk_rsp_hand`・ライザーの位置・壁の口の 3 つで確かめた）。
- 板の縁を掴む溝は無い。下の縁は床の座に載り、上の縁を押さえ 2 本（x 30.5〜35.8 と 48.0〜50.4）が 0.3 押す。左右の縁は壁の内面まで 0.306 / 0.33。
- 前板のマイクの穴は、マイクの中心（x 5.487 / 76.487・b 17.002）から外へ 1.0。🔴 穴の位置の式が回す前の写像のままだったので、2026-09-15 に `W_rsp` へ直した（ずれは 0.05）。

### マイク面（前）に置ける高さ
| 場所 | 障害物と隙間 d | 部品の高さの上限 |
|---|---|---|
| ほぼ全面（x 6.0〜76.1） | OLED の基板の裏 3.785 | 3.2（OLED の裏の小さな部品の高さは模型に無い） |
| x 32.05〜50.05 × b 15.71〜19.21 | OLED の FPC のコネクタ 1.785・その中の x 34.8〜47.3 はフィルムの頂点 0.185〜接触 | 1.2、フィルムの下は **何も置かない** |
| x 34.8〜47.3 × b 17.46〜34.0 | OLED のフィルムの帯 2.785 | 2.2 |
| b 31.0〜34.0（下の縁の帯）の x 6.0〜74.35 | 床の座の唇 0.2 | **何も置かない** |
| b 0〜0.9（上の縁の帯）の x 5.2〜11.2 と 70.9〜76.9 | OLED の L 足 0.185 | **何も置かない** |
| 左右の端（x ≤ 8.25 と ≥ 73.75） | 前板のリブ 6.185・下の角の柱 2.685 | 2.1〜5.6 |

⇒ マイク面は、マイク（1.28）・LED・0402 などの低い物だけにする。

### XIAO 面（後ろ）に置ける高さ
| 場所 | 障害物と隙間 d | 部品の高さの上限 |
|---|---|---|
| ほぼ全面 | 9〜13 以上 | 背の高い物（ESP32 モジュール 3.2・コネクタ・電解）はここ |
| b 31.9〜34.0（下の縁の帯） | ハブの板の前の縁 3.465 | 2.9 |
| x 34.7〜47.4 × b 19.4〜34.0 | OLED のライザーの L 字のメス・ハブの J2 6.965 | 6.4 |
| x 36.0〜46.1 × b 0〜29.4 | OLED のライザーの板 5.365 | 4.8 |
| x 1.66〜16.9 の 2 か所（b 8.1〜10.7 と 23.4〜25.9） | ライザーのメスの口 3.9 | ピン以外 3.4 |
| 左右の縁の帯（x ≤ 1.7 と ≥ 80.35） | 壁のリブ 1.65〜 | 部品を置かない（リブは ReSpeaker の形から `ribs_gen61.py` が自動で引いている） |

### ライザーが受けるピン（今の位置）
- 信号の列 b 9.397: x 8.012・10.552・13.092・15.632（XIAO の D2・D3・SDA・SCL）。
- 電源の列 b 24.627: x 2.932・5.472・8.012（5V・GND・3V3）。
- メスの口は d 3.9、奥は d 12.4。ピンの樹脂は d 3.9 より手前、ピンの先は d 3.9〜12.4 に入れる。
- 14 本にするときは、同じ 2 列を x 2.932〜18.172（7 本ずつ）まで使う。

### 壁の口（XIAO と ReSpeaker の物・音声の板では使わない）
- 左の壁: XIAO の USB-C の口（b 12.2〜21.8）。右の壁: 3.5mm ジャックの穴（b 6.5）と ReSpeaker の USB-C の盲ポケット。音声の板の縁のその位置には、背の高い物を出さない。

### 今の筐体で当たっている・近い物（ReSpeaker Lite で）
- ハブの板の前の縁と ReSpeaker の USB-C の殻が 0.07（音声の板には USB-C が無いので消える）。
- OLED のフィルムの頂点と ReSpeaker の LED1 が 0.135（実物では触れている可能性）。音声の板では 上の表のとおりフィルムの下に置かない。
