n416/katanori/docs/KNOB-ENCODER.md

# つまみ（AS5600・ホール式の絶対角度）

可変抵抗（RV121SF）の後継。**摩耗も熱劣化もする要素を無くし、回しても電気的に何も動かない構成。**

🔒 **移行は完了している。可変抵抗には二度と戻さない。** 軸受けにも流用しない。

🔒 **いまの正は [knob_v5.scad](../hardware/frozen/v1-v4/knob_v5.scad)（2026-08-19）。v4 は捨てた**
（圧入した輪が歪み、実機でツメが床を擦って回らなくなった）。
**寸法は `.scad` が正で、この文書は理屈と実測だけを持つ。**
⚠ **以下に「v4」と書いてある数字は、そのとき決めた値の記録であって現行値ではない。**

| | |
|---|---|
| **方式** | 🔒 **AS5600 ＋ 軸受けも含めて全部3Dプリント**（確定） |
| ✅ | 卓上で読める・バスが死なない・**20往復回してもコーデックが死なない** |
| ✅ | 治具を印刷・組立・回転テスト合格（2026-08-02） |
| ✅ | ファーム実装＋治具で実測合格（2026-08-02）。**ADCフォールバックは 2026-08-11 に削除** |
| ✅ | 実会話まで開通（2026-08-05）。**音が出ないという保留は解消済み** |
| ✅ | リードスイッチの座と磁石ポケットは [knob_v5.scad](../hardware/frozen/v1-v4/knob_v5.scad) に入っている（**未印刷**）。⚠ v5 で**リードは横・水平**に置き直した（2026-08-19・ユーザー） |
| 🔒 | **磁石はリードと「平行」に置く。面を正対させてはいけない**（2026-08-16 実測・下の「磁石の向き」）。✅ **2026-08-20 に再実測して確定**、v5 のポケットも同日この向きへ差し戻した |
| ✅ | 回転の壁（315度）も v5 に入っている（**未印刷**。ツメ13度＋タブ32度で 315 ちょうど）。**板バネのデテントは第1世代では作らない**（2026-08-17 決定） |
| ⬜ 残り | **まだ分厚いか**（2026-08-15・ユーザー「つまみがとにかくデカすぎる」）。⚠ **φ25 × 高12mm・全高25.8mm は v4 以前の数字。** v5 は **φ27 × 天面から外へ 5.5mm ／ 天板の下 22.4mm**（バスタブ 2 の板の裏まで。基板の裏は 19.7。[DIMENSIONS.md](DIMENSIONS.md)）。**これで足りたかはユーザーの判断待ち** |
| ✅→⬜ | **筐体用の小型化再設計**（2026-08-15・ユーザー発案 → v5 で実装）。以下は発案時の文面。現行機構は全部品中で最大。デカさの原因はつまみ本体でなく「ねじも接着も避ける」ためのブリッジ＋ベースなので、**ねじ止めを解禁して畳む**方向。AS5600基板（M2×4穴）をパネル裏へ直留めし、軸受けはパネル自体の穴で受ける。1部品で焼く同芯・長穴＋AGCの追い込みはそのまま。リード座・磁石ポケット・回転の壁もこの1回に乗せる。**⬜ 軸受けを買う案をもう一度見る**（下の「既存モデルの調査」） |

📄 経緯・失敗の捜査記録は 2026-08-15 に整理した。`git log -p docs/KNOB-ENCODER.md` で読める。

---

## 設計値

**ここだけ見れば設計できる。** 数字の出どころは右列。

| 値 | 数字 | 出どころ |
|---|---|---|
| 磁石ポケットの内径 | **4.10mm** | [PRINT.md](PRINT.md) ゲージで確定（4.2は逆さで落ちる） |
| 穴の縮み | **約0.1mm**（穴側の設計値に足す） | 同上の副産物。**レジン①・0.05mm・2.5秒での値** |
| プリント一体の板バネ | **厚み ≧ 長さ ÷ 30** | [PRINT.md](PRINT.md) 9枚のゲージ。例外なし。⚠ ただし下の注意 |
| 磁石（AS5600用） | **径方向着磁**・公称 **φ4.0 × 2mm** | AS5600キット付属 |
| 磁石（リード用） | **軸方向着磁**・**φ6 × 2mm** | リードスイッチ付属。⚠ **上と別物。混同しない** |
| 同芯（磁石の中心 ⇔ 回転軸） | **0.25mm 以内** | AS5600データシート |
| エアギャップ（磁石 ⇔ チップ上面） | **0.5 〜 3mm** | 同上。**上限3mmが効く** |
| AS5600基板 | **23 × 23mm** / M2 × 4 / **穴中心間 17mm** / チップは4穴の中心 | 実測（個体差あり） |
| I2Cアドレス | **0x36** | OLED 0x3C・コーデック 0x18 と衝突しない。⚠ **MAX17048 と衝突する**（[POWER.md](POWER.md) 6章） |

設計の決めごと（理由は下の各節）:

- **AS5600保持板の穴は長穴（スロット）にする** … 静的なずれを最後に `AGC` で追い込むため
- **磁石とピンヘッダはできるだけ離す** … ヘッダの鉄が磁界を歪める
- **ピンヘッダは平らな面から挿し、IC側ではんだ付けする** … IC側に何か立つとギャップ上限3mmに入らない
- **穴の嵌合は現物合わせ** … 可動部でない穴は +0.2〜0.4mm 見込む

⚠ **板バネはレジン①では作れない（2026-08-03 確定）。**「厚み ≧ 長さ ÷ 30」は刷りたてでのみ成立し、
**約1日半後に同じ9枚が押した瞬間に全数破断した**（比率がいちばん有利な 0.8×12 も割れた）。
🔒 **第1世代ではデテントを作らない（2026-08-17 決定・ユーザー）。**
軸に載っている機構は抜け止め・リードスイッチ・回転の壁・デテントの4つだが、**デテントだけが
「感触だけ」の機能**である。OFF検知は角度の閾値、電源断はリードスイッチが担っているので、
バネが無くても機体は成立する。そして機構を1つ足すと、その機構の高さではなく「座と逃げ」が
軸方向に積まれるため、ユニットが厚くなる。⚠ **ここを ⬜（未決）で残すと候補が何度も出てくる。**

📄 材料の候補は第2世代へ持ち越す（**作る決定ではない**）。レジン②（高靭性）、リン青銅の板、
そして**バネ線を曲げて渡す方式**（ピアノ線／ばね用ステンレス線 φ0.4〜0.6。天板裏の穴2つに通し、
渡った部分を溝付きの輪に当てる）。⚠ ホームセンターの「針金」＝なまし鉄線はバネにならない。
ばね用ステンレス線はほぼ非磁性なので、リード用磁石の近くを通せるという利点がある。

---

## ✅ リードスイッチ — [knob_v5.scad](../hardware/frozen/v1-v4/knob_v5.scad) に入っている（未印刷）

**つまみが OFF 位置に来たら、磁石でリードスイッチを閉じて `EN` を GND に落とす**
（回路と理屈は [POWER.md](POWER.md) 2章）。

### 🔒 磁石の向き — リードと「平行」に置く（2026-08-16 実測）

**面をリードに正対させると、リードの真正面が不感帯になる。** 磁束が接点の左右に対称に
入って打ち消し合うためで、少しずらすと対称が崩れて閉じる。結果、**真ん中を挟んで2箇所で
鳴る。** ユーザーが台座の上で確かめたところ、4時半と8時半の位置で反応し、その中間では
鳴らなかった。

🔴 **この向きのまま設計すると、つまみを回すあいだに電源が落ちる角度が2箇所できる。**
片方は狙った OFF 位置だが、もう片方は音量を回している最中に来る。

✅ **磁石の軸をリードの長手方向と平行にすると、不感帯が消えて中央の1箇所だけで鳴る。**
knob_v4 は φ6×2 の円板を**立てて**持ち手の裏へ埋める形にしてあった（磁石の下端から接点まで 4.51mm）。

⚠ **距離だけを見て設計しないこと。** 「閉じるのは 5mm」という実測値は向きによって変わる。

### ✅ v5 との矛盾は決着した（2026-08-20・ユーザーが再実測）

一時期、[knob_v5.scad](../hardware/frozen/v1-v4/knob_v5.scad) が 08-19 に「磁石の軸を半径方向へ＝面が
リードに正対」へ変更され、この節と矛盾していた。**2026-08-20 にユーザーが v5 の姿勢
（リードを水平・接線方向に置く）でテスタの導通レンジを当てたところ、やはり2箇所で鳴った。**
08-16 の実測が再現したので、**この節の 🔒（軸をリードの長手と平行）が正しい**と確定し、
v5 のポケットを v4 と同じ向きへ差し戻した。

差し戻しで動いた寸法は次のとおり。円板の直径 6.3 が半径方向に立つので、外壁を
v4 の実績値に保つには中心を内へ引く必要がある。

| | 08-19（正対・誤り） | 08-20 以降（接線・正） |
|---|---|---|
| 磁石の軸 | 半径方向 | **接線方向**（リードの長手と平行） |
| `MAG2_R`（中心の半径） | 11.5 | **9.40** |
| リードに一番近い点 | 面 r 12.51 | **外縁 r 12.40** |
| 接点（y 16.125）まで | 真横に 3.62mm | **真横に 3.73mm** |
| 持ち手の外周までの壁 | 0.60mm | **0.91mm**（v4 の実績値） |
| 圧入で押される壁 | 外壁（v4 と逆） | **押されない**（v4 と同じ） |

⚠ **「閉じるのは 5mm」は正対で測った値なので、この 3.73mm の判定には使えない。**
ただし v4 の 4.69mm（同じ接線向き）より近い側なので、距離だけを見れば悪化していない。
⬜ **接線向きでの閉じる距離が未測定。** 刷る前にテスタで取れば、3.73mm の余裕が分かる。

### 実測でわかっていること

| 項目 | 値 | 出どころ |
|---|---|---|
| 本体 | 14 × 3.2mm、足は両端に14mmずつ（全長42mm） | 📄 2026-08-16 の寸法図。⚠ 一度 2.5角×15 と誤記した |
| 閉じる距離 | 5mm（ただし向きに依存・上記） | ✅ 2026-08-15 ユーザー実測 |
| 溝の圧入 | 3.25（部品 3.2角） | ✅ 2026-08-16 ゲージ（[fit_gauge.scad](../hardware/frozen/v1-v4/fit_gauge.scad)）点2 |
| 磁石の圧入 | 6.10（φ6） | ✅ 同上 点2 |
| プレート側 | 口が縮む。+1.2mm × 深さ0.6 の逃がしが要る | ✅ 同ゲージで「一番奥が通らない」 |

### 経緯（残しておく）

🔴 **リードスイッチは 2026-08-01 に決まっていたのに、8/05〜8/10 に刷った治具
（[knob_jig.scad](../hardware/frozen/v1-v4/knob_jig.scad) ／ [as5600_holder.scad](../hardware/parts/as5600_holder.scad)）の
どちらにも座が入っていない**（2026-08-14 に判明）。

⚠ **順番を守ること。距離を測る前に刷ると、まず確実に2回刷ることになる。**

| 順 | やること | 何で |
|---|---|---|
| 1 | **リードスイッチが閉じる距離を測る** | テスターの導通レンジ＋磁石を近づけるだけ。部品は 8/3 から手元にある |
| 2 | **つまみの外周に φ6×2mm の磁石ポケットを足して刷り直す** | 1の距離で位置が決まる |
| 3 | **ホルダ側にリードスイッチの座（2.5×14mm）を足して刷り直す** | 〃 |

⭐ モデルは [parts.scad](../hardware/parts/parts.scad) に `reed_switch()` と `magnet_reed()` が実寸であるので、
**刷る前に CAD で当てられる。**

### ⚠ 磁石が2つになる（AS5600 への干渉）

**この方式でいちばんの risk。** AS5600 は軸上の磁石の**磁界の向き**を読んでいるので、リード用の
磁石が近いと角度がずれる。**AS5600 の磁石は軸の中心、リード用は つまみの外周**へ置いて距離を稼ぐ。
組んだら `STATUS`(0x0B) の MD/ML/MH と `AGC`(0x1A) で確かめること。**数字で分かる。**

⬜ 8/05 に「磁石の距離が回転角で揺れる」という観測がある。8/11 にホルダを刷り直したので、
**まず `knob` で再確認する**（直っている可能性がある）。

---

## 同芯をどう出すか

**急所は印刷精度ではなく同芯。** そして**誤差は2種類あって性質が違う。この2つを混ぜると設計を間違える。**

| 誤差 | 何が起きるか | 直せるか |
|---|---|---|
| **A. 磁石が軸に対して偏心** | 回すたびに磁石が振り回され、角度誤差が**回転位置ごとに変わる** | **直せない。** 校正で吸収できない |
| **B. 軸の中心とチップ中心が静的にずれている** | 一定のオフセットとして出る | **直せる。** 位置を動かして `AGC` を見ながら追い込める |

🔒 **採った解: つまみ・軸・磁石ポケットを1部品として同じ中心で焼く。**
貼り合わせる工程が無いので、**A が原理的に発生しない。** 軸受けは印刷した門形ブリッジの穴。
残る B は、**AS5600 基板を留める M2 を長穴にして** `AGC` を見ながら追い込む。

### ✅ 「1部品で焼けば同芯が出る」は実測で立証されている

印刷した治具で 12時→3時→6時→9時→12時 の5点を測った（2026-08-02）。

| 位置 | RAW | 角度 | 刻み | AGC | MAGNITUDE |
|---|---|---|---|---|---|
| 12時 | 396 | 34.8度 | — | 47 | 2086 |
| 3時 | 1466 | 128.8度 | +94.0 | 67 | 2112 |
| 6時 | 2391 | 210.1度 | +81.3 | 59 | 2128 |
| 9時 | 3407 | 299.4度 | +89.3 | 51 | 2070 |
| 12時戻り | 353 | 31.0度 | 戻り差 −3.8度 | 67 | 2063 |

⭐ **MAGNITUDE 2063〜2128（変動3%）＝ 磁石が回転軸に乗っている。**
手貼りの治具では 2127→616（**−71%**）まで落ち、刻みも −76 → −42 → −14 → **+3** と最後は反転した。
**この差が「印刷したホルダーが要る」の実測根拠である。**

### 中心出しは AS5600 自身を測定器にできる

目測で当てにいかない。① 磁石を両面テープで仮止め ② つまみを回して各位置で `mag`
③ **MAGNITUDE が平坦なら中心が出ている** ④ 動いた方向へずらして②へ ⑤ 平坦になってから固定。

---

## 配線

XIAO ESP32S3 のヘッダに繋ぐ（実際にはハブ基板経由・[POWER.md](POWER.md) 4章）。OLED と同じ I2C バスへの
相乗りで、**バス側のプルアップは ReSpeaker Lite に載っている**（4.7kΩ）ので追加は要らない。

手元のモジュールは**7ピン**で、左が `VCC` `OUT` `GND`、右が `DIR` `SCL` `SDA` `GP0`。**繋ぐのは5本。**

| AS5600 のピン | 側 | 行き先 |
|---|---|---|
| `VCC` | 左 | **3V3** |
| `OUT` | 左 | **繋がない**（アナログ/PWM出力。I2Cで読むので不要） |
| `GND` | 左 | **GND** |
| `DIR` | 右 | **GND**（ハブ基板側に穴は作らず、ハーネスを二股にして GND に相乗り） |
| `SCL` | 右 | **D5**（GPIO6） |
| `SDA` | 右 | **D4**（GPIO5） |
| `GP0` | 右 | 🔴 **絶対に繋がない**（AS5600 の PGO・OTP書き込み用） |

### 必ず守ること

- **`VCC` は 5V ではなく 3V3。** 5V を与えるとモジュール側のプルアップが I2C ラインを 5V へ引き上げ、
  ESP32 の入力定格を超える（OLED と同じ理由）
- **3V3線に直列抵抗を入れない。** 可変抵抗でやった 1kΩ は、AS5600 では 6.5mA × 1kΩ ＝
  **6.5V 落ちて動かない**
- **`DIR` を浮かせない。** 回転方向の極性を決めるピンで、GND に落とすと「時計回りで値が増える」。
  ⚠ **`DIR` と `GND` は基板の反対側にある**
- **`GP0`（PGO）には何も繋がない。** ZPOS/MPOS は焼き直しが効かず、誤って焼くと戻せない。
  **ゼロ点はソフトで持つのでこの線は一生使わない**
- **シルクを読んでから挿す。並び順は製品ごとに違う。** ⚠ **この個体はシルクの SCL/SDA が逆で、
  D4/D5 を入れ替えたら出た。** OLED（`VCC GND SCL SDA` で一般的な並びと逆）に続き2例目
- ⚠ **左の列は `VCC` と `GND` が隣り合っていない**（間に `OUT` が挟まる）。2連のハウジングを
  そのまま挿すと必ず片方が浮くので、**1本ずつにバラして挿す**
- **配線は電源を切ってから**（組立中に 3V3–GND 短絡事故を起こしている）

### ✅ 「0x36 が黙ったら、まず SCL/SDA の交差を疑う」

2026-08-10、ハーネスを作り直したら **OLED は動くのに AS5600 だけ応答しなくなった。**
症状は `requestFrom(): i2cWriteReadNonStop returned Error -1`（＝相手が返事をしない。バスの衝突ではない）。

| 手 | やったこと | 結果 |
|---|---|---|
| 1 | `knobsrc` を打つ | ✅ 0x36 が居ないことを確定。**ファームは起動時にしか 0x36 を探さない**ので、挿し直しただけでは戻らない |
| 2 | AS5600 の `VCC`–`GND` を DC電圧レンジで測る | ✅ **3.2V**。電源の2本が無罪になり、容疑が `SCL`/`SDA` に絞れた |
| 3 | `SCL` と `SDA` を入れ替える | ✅ **これで動いた** |

🔴 **交差していても OLED は正常に動く。** 2本ともバスには繋がったままなので幹線は健全に見え、
AS5600 だけが黙る。**「OLED が動いているからバスは正常」は、AS5600 の枝の無罪証明にならない。**

### ピンヘッダは「平らな面」側に付ける

**磁石を向けるのは IC が乗っている面。** ホール素子はダイの中にあり、エアギャップ 0.5〜3mm も
IC パッケージの上面から測る。**上限が 3mm しかない**ので、IC 側に何か立っていると成立しない。
ヘッダは**平らな面から挿して IC 側ではんだ付けする**（フィレットは IC 側に出るが、パッドは基板の縁で
磁石の真下には来ない）。

⚠ **裏（平らな面）からでも磁界は FR4 を通るので一応読めてしまう。** 基板厚1.6mm分ギャップが増える
だけなので、**「読めた＝正しい面」ではない。** 面の当たりは `AGC` で比べる（小さいほど強い）。

### バスの相乗り

アドレスは衝突しない（0x36 / 0x3C / 0x18）が、**配線が不安定だとバスごと道連れになる。**
✅ `s` を20回連続で流して3つとも欠けずに出ることは確認済み（2026-08-01）。
⚠ **組んだら 20回以上回して `creg` と `[CODEC]` ログを見ること。1回で判断しない。**

---

## ファーム（`firmware/esp32/src/main.cpp`）

- 角度は `RAW ANGLE`（0x0C/0x0D、12bit＝4096分解能）→ ゼロ点からの相対角度 → `knobPercent`
- **ゼロ点は NVS**（`knob/zero`）。つまみを OFF 位置にして **`knobzero`** で保存。
  🔴 **機構を刷り直したら必ず取り直す**（組み直すと機構とゼロ点の対応が変わる）。OTP には一生書かない
- 可動域はビルドフラグ: `KATANORI_KNOB_SPAN_DEG`（既定270・100%になる角度）/
  `KATANORI_KNOB_OFF_DEG`（**既定25**・未満でOFF。🔒 リードが閉じる約15度より外に置く。
  2026-08-17 に 5 から変更した。理由は [POWER.md](POWER.md) 2章の実測）
- OFF判定は角度の閾値（ヒステリシス3度＋30msデバウンス）。**ファームは EN に触らない**
- **`knob` コマンドが磁石の数字を出す**: MD/ML/MH・AGC・MAGNITUDE・RAW・相対角度
- 0x36 が応答しなければ**読み取りを止めて最後の音量のまま固定**する（起動時に居なければ既定音量）。
  再判定は `knobsrc`、つまみを外して切り分けるときは `knobdis`

### ⬜ SPAN と折返し — **機構に壁が要る**

治具の可動域（約345度）が SPAN（270度）より広く、有効なのは **0〜315度**（SPAN 270 ＋ 上側の
吸着帯45度）である。それを超えると「ゼロ点を通り越した」と判定されて **0%(OFF) に倒れる。**
回し切りでいきなり無音になるのはこれ。

🔴 **壁の向きも設計値である（2026-08-17・実物で発覚）。** ツメを壁のどちら側に置くかで
可動域が丸ごと裏返る。2026-08-17 に刷った版は裏返っていて、**OFF から右へ 0度・左へ 315度**
だった（ユーザーが組んで発見）。`DIR` を GND に落としてある以上「時計回りで値が増える」ので、
**OFF は可動域の時計回り側の端**でなければならない。
いまは `knob_v5.scad` の echo ⑥ が可動域とリードの帯を出す。**右が 315。**

🔴 **SPAN を広げるだけでは直らない。** 上側の吸着帯と「ゼロ点を戻しすぎた」の折返しは同じ判定を
共有しており、SPAN を広げると戻し側の余裕（今は45度）が同じだけ削れる。345度をカバーすると戻し側が
10度未満になり、**OFF 位置を少し行き過ぎただけで最大音量**になる。
🔒 **本筋は機構に壁を付けることで、本番のつまみ／パネルで必ず入れる。**

✅ **入っている。** v4（2026-08-15）はツメ 25度 ＋ 柱 20度 で 360−45＝315度 だった。
**v5 では受けが柱から島のタブに変わり、ツメ 13度 ＋ タブ 32度 で 315度 ちょうど**（echo ⑥）。
⚠ v4 のとき AS5600 の柱が邪魔で、ツメの掛かりが 0.4mm しか取れず**柱の上側だけ外へ広げた**
（内縁 11.85mm）。柱が要るのは基板の穴の位置（17mm角）だけで、その上は自由だという理屈は
v5 でも生きている。🔒 **角度と掛かりの現行値は `.scad` の echo が正。ここに写さない。**

### ✅ 上に引っ張ると壁を越えられる → 直した（2026-08-19・**未印刷**）

⚠ **この節は半月で抜け止めをしていた v4 の話である。** v5 は半月をやめて E リングにしたので、
浮きの内訳が変わった（`ERING_PLAY` ＋ 溝の遊び。現行値は echo ①）。
**残す理由は「浮き＞掛かりなら壁は効かない」という関係のほうで、下の数字ではない。**

**壁そのものは効いている。つまみが上へ浮く量のほうが、ツメの掛かりより大きい。**
✅ 実体でも当てて確かめた（ツメは 0.49 で止まり 0.51 で抜ける／半月は 0.96 で自由・1.00 で当たる）。

| | 量 | 内訳 |
|---|---|---|
| ツメが溝から出る持ち上げ量（＝掛かり） | **0.50mm** | `STOP_T 1.0 − GRIP_GAP 0.5` |
| 半月が段Bを掴んで止める持ち上げ量（＝浮き） | **0.975mm** | `BORE_RELIEF 0.6 ＋ PLAY 0.2 ＋ (RING_BORE−SHAFT_D)/2 0.175` |

🔴 **どちらも「引き算の余り」で、誰も決めていない値だった。**

- **掛かりは `STOP_T` まるごとではない。** ツメは持ち手の裏から下りるので、へこみの底に届くまでに
  `GRIP_GAP` を渡り切っている。溝に入っているのは **`STOP_T − GRIP_GAP`**
- **浮きには `BORE_RELIEF` がまるごと乗る。** 段Bの円錐（45度）と、半月の**下側**の入口逃がし
  （同じ45度）は傾きが一致して**入れ子になる**ので、抜け止めが効き始めるのは逃がしを抜けた奥の稜線
- ⚠ **円錐そのものは前から勘定に入っていた**（`knob_v4.scad` の「遊びは 0.2 → 0.375 に増える」＝
  0.2 ＋ 0.175）。落ちていたのは `BORE_RELIEF` の側である

**浮きの下限**（半月を使う限り）: 逃がし 0.25（ボトム5層）＋ 遊び 0.2（これ以上詰めると噛む）＋
軸の遊びの半分 0.175 ＝ **約 0.6mm**。⚠ 「0.2mm まで詰められる」は E リング版の数字で、別の話。

🔒 **天井の件と一緒に直した（2026-08-19）。** ツメ・溝・持ち手の逃げは同じ場所なので、
別々に直すと二度設計することになる。

| 変数 | 前 | 後 | 理由 |
|---|---|---|---|
| `BORE_RELIEF` | 0.6 | **0.3** | 過硬化はボトム5層＝0.25mm。⚠ これ以上は減らせない |
| `STOP_T` | 1.0 | **1.3** | 掛かりを 0.95 にする |
| `GRIP_GAP` | 0.5 | **0.35** | 掛かりを直接削る値 |

**浮き 0.675 / 掛かり 0.95 → 余裕 +0.275mm。**
✅ 実体でも当てた（ツメは 0.94 で当たり・0.96 で素通り ／ 半月は 0.66 で自由・0.69 で当たり）。
⚠ 副作用: 持ち手が 0.15mm 沈み、リード磁石と接点が 4.69 → **4.56mm**（近づく側＝安全）。

### 表示（2026-08-03）

つまみを回すと**顔を消して数字を全画面**で出し、下にインジケーターを1本引く（1.5秒間・
`drawVolumeScreen()`）。壁が無いと「今どこまで回ったか・100%はどこか・折返し帯に入ったか」が
体感で分からないため。OFF/ON にはブラウン管風の演出を入れてある。**直した理由がそのまま設計条件:**

| 条件 | 理由 |
|---|---|
| 白ベタで塗らず**光る縁だけ**を動かす | OLED は白＝全画素点灯で、ブラウン管とは逆の印象になる |
| ON は**開き切ると真っ黒**で終わる | 真っ白から顔が出るのが不自然だった |
| 縁を最後に**2px→1px**（OFF は残光3px→1px） | いきなり消すと角が立つ |
| 開いた後**黒で120ms**置いてから顔へ | 「開く」と「映る」が重なって忙しく見えた |
| ON の直後**0.9秒は音量表示を抑える** | ON に戻すと必ず%が変わるので、顔より先に数字が出ていた |
| OFF は**「OFF」を0.7秒見せてから**演出へ | いきなり消えると、自分が消したのか勝手に落ちたのか分からない |

⚠ Wi-Fi 設定モード中と起動直後の初回同期では鳴らさない（QR の読み取りと自己診断パターンを
潰さないため）。ON 復帰時は表示が `setPowerSave(1)` で止まっているので、アニメの先頭で自分で起こす。

⚠ **「音が出ない」の切り分けでは、まずつまみ位置とビープ振幅の掛け算を疑うこと。**
`beep2` の振幅は 4000/32767（12%）しかなく、つまみ12時（ゲイン0.14）だと実効1.7%でほぼ聞こえない。
**起動音（ほぼフルスケール）が聞こえるのに `beep2` が聞こえない場合は、故障ではなく音量である。**

---

## いま刷るもの — [knob_v5.scad](../hardware/frozen/v1-v4/knob_v5.scad)

🔴 **[knob.stl](../hardware/stl/knob.stl) は 2026-08-02 の治具版なので刷らないこと**
（つまみφ25・軸φ6。下の「治具（第1世代・履歴）」の成果物）。v5 の STL は名前が違う。

書き出しは `part` を変える。**全部プレート直置き・サポート不要**で、置き方は
`.scad` の 🔒 コメントのとおり（つまみは天面を下・島はへこみの底を下・天板は見える面を下）。

🔒 2026-08-27 ユーザー「v4 ディレクトリにまとまるのが筋」「rod と deck は要らない・wall と knob だけで」。
**機械の部品である 2 点は [_stl_v4.py](../hardware/frozen/v1-v4/_stl_v4.py) が筐体と一緒に `stl/v4/` へ焼きます**。
道具である卓上テストの天板だけは、これまでどおり手で `stl/` へ書き出します。
🔒 2026-08-27 ユーザー「rod はもう完全にいりませんね」で、**押し棒（`part="rod"`）は .scad ごと削除しました**。
リードを押し込む深さは穴の天井が決めているので、ゲージは要りません（平らな細い棒で足ります）。

```bash
python hardware/frozen/v1-v4/_stl_v4.py knob knobwall
```

| STL | 中身 | 刷る |
|---|---|---|
| [v4_knob.stl](../hardware/stl/v4/v4_knob.stl) | つまみφ27 ＋ 軸φ7 ＋ AS5600磁石ポケット ＋ リード磁石ポケット ＋ ツメ ＋ Eリング溝 | ✅ 刷ってよい（v4 の 18 点の 1 つ）。🔴 **2026-08-28 に焼き直すまでは刷ってはいけない状態でした**（下） |
| [v4_knobwall.stl](../hardware/stl/v4/v4_knobwall.stl) | 島（座金＋タブ） | ✅ 刷ってよい（v4 の 18 点の 1 つ） |
| [knob_v5_deck.stl](../hardware/stl/knob_v5_deck.stl)（道具） | 卓上テスト用の天板 | ✅ 刷ってよい。⚠ 上と同じ（`-D 'part="deck"'`） |
| ~~knob_v5_half.stl~~（2026-08-18） | 半月。v5 で廃止した部品の残骸 | ❌ 刷らない |
| ~~knob_v5_rod.stl~~（2026-08-27） | 段付きの押し棒。`part="rod"` ごと削除した | ❌ 刷らない（ファイルも消した） |

✅ **4つとも刷ってよい**（2026-08-20 に E リングの外径が 12.0 で確定）。

### 🔴 2026-08-28（16 度目の机上の通し）: つまみの STL が 5 つに割れていた

`_stl_preflight.py` が `v4_knob.stl` を **中身 5 個**と判定しました。連結成分に割ると
**持ち手 / 持ち手の裏の 0.3mm の円板 / 軸 / ツメ / 軸の先の 0.3mm の円板**の 5 つで、
そのあいだに **0.01mm の隙間**が空いていました（manifold・CGAL とも同じ）。

犯人は面取りの抜き `ch_bot()` です。外側の筒だけが円錐より上下に 0.01 ずつ長く、
そのはみ出しが**半径いっぱいの円板**になって、部品を 2 か所で輪切りにしていました。
`z` は部品の**下の面**なので、下のはみ出しはその面を跨ぐ軸とツメを切り、上のはみ出しは持ち手を切ります。

はみ出しをやめて筒も円錐も `z 〜 z+c` にそろえ、`python hardware/frozen/v1-v4/_stl_v4.py knob` で焼き直しました。

| | 直す前 | 直した後 |
|---|---|---|
| 連結成分 | 5 | **1** |
| 体積 | 4941.72mm³ | **4947.98mm³**（＋6.26 ＝ 誤って抜けていた 0.01mm の円板 2 枚） |
| preflight | 🔴 欠片 4 個 | ✅ 中身 1 個・支えの無い天井なし・島 0・薄肉なし・接地 496mm² |

面取りの寸法は変えていません（持ち手 半径 13.5 → 13.2 ／ 軸 3.5 → 3.2・どちらも 0.3mm）。
当たり検査 48 本と工具の道は、戻した 6.26mm³ の後も全部同じ値でした。
⚠ `ch_top()` にも同じ形のはみ出しがありますが、`z` が部品の**上の面**でその先には何も無いため、
いまは何も切っていません（触っていません）。
下の「E リングは呼び6」を先に読むこと。**呼び7 を使うと入らない。**

⚠ 2026-08-20 の書き出しは**リード磁石の向きを差し戻したあと**のもの。
これより古い `knob_v5_*.stl` は正対のままなので捨てること。

### 🔴 初回の板（5 枚）で真っ先に測ること（2026-09-13）

⚠ **通電の前に、目で 1 つ**（2026-09-13 調停役の依頼で追加）。

🔒 **SW1（スライドスイッチ）が板から浮いていないか。**
浮いていたら、**位置決めの足（φ0.7 × 2）が板厚 1.6 を超えている**ということ。
📄（`hardware/ref/slide_switch_mst12d18g3/MST-12D18G3.pdf`）に**足の長さの寸法が無く**、
「推奨ランドどおりに使う限り、表面実装のパッドが板に着くのだから足は 1.6 以下のはず」という
**幾何の筋だけで 0 と置いている**。⚠ **これは測定ではない。**
⇒ **浮いていれば筋が外れていた証拠**で、そのときは**板の裏へ足が出る＝仕切りの予算が変わる**。
⭐ **組んだ瞬間に分かるので、いちばん安い検査。**

v6 で AS5600 がチップになり、つまみは歯車 3 枚を介すようになった。**机上で潰せない物が 2 つ残って
いて、どちらも `mag` コマンド（`AGC`(0x1A) と `RAW ANGLE`(0x0C)）で出る。**焼き上がったら他より先に取る。

🔒 **やることは 1 つ。「つまみを可動域の端から端まで回しながら `AGC` と `RAW ANGLE` を取る」掃引を、
ミュートリレーを開いた状態で 1 回・閉じた状態で 1 回、合わせて 2 回**（2026-09-13 調停役）。

| | 何が出るか |
|---|---|
| 掃引 1 本そのもの | **エアギャップ 1.10 ±0.41 と磁石の芯の振れ 0.19**（機構担当の依頼） |
| **2 本の差** | **ミュートリレーの漏れ磁束が作る誤差曲線の振幅と位相** |

#### なぜ 1 点の 2 読みでは足りないか

一定の漏れ磁束はつまみの磁石の磁界に**ベクトルで**足されるので、
測れる角度は `atan2(B·sinθ + by, B·cosθ + bx)` になり、誤差は **θ の正弦波**（振幅 ≒ 漏れ ÷ 磁石）。
⇒ つまみを 1 か所に置いた 2 読みは、その正弦波の 1 点でしかない。

> 🔴 **2 読みが 0 でないなら問題は在る。2 読みが 0 でも、問題が無いとは言えない**（節に当たった可能性）。

#### 測ったあとの分岐（先に決めてある）

| `AGC` | 何の問題か | 直す場所 |
|---|---|---|
| 範囲内のまま角度だけずれる | 磁界の**向き** | **ファームで引ける。**`muteRelayClosed`（`main.cpp` 825 行）は つまみを読むループと同じ所にいるので、リレーの状態で場合分けして誤差曲線を引けばよい |
| **振り切る**（0 または 128 に張り付く） | 磁界の**大きさ** | ファームでは直らない。**ここで初めて筐体・機構の話**（板側は K31 の芯 ↔ AS5600 の芯 **11.95mm** が限界） |

#### 掃引 2 本の作り方（🔒 2026-09-13 調停役・ファームの追加は要らない）

| 掃引 | どうするか | なぜ効くか |
|---|---|---|
| **リレー開** | `-DKATANORI_MUTE_RELAY_PIN=-1` でビルドする | ✅ `main.cpp` 154 行が `#ifndef` なので `-D` で上書きできる。`muteRelaySet()` は 838 行で**即 return** しピンを一度も駆動しない（`pinMode` は 844 行より後）。⇒ 板の **R32 10kΩ のプルダウン**が接点を開いたまま保つ |
| **リレー閉** | ふつうにビルドする | 掃引そのものが「操作」なので居眠りに入らず、接点は閉じたまま |

⚠ 掃引 1 は音が出ない（接点が開いたまま）。磁気の測定には関係ない。
⚠ `KATANORI_MUTE_RELAY_PIN` を使っているのは 154・838・844・845 行だけで、
**このピンを他から叩くコードは無い**（2026-09-13 に grep で確認）。

##### ✅ その 10kΩ は v6 の回路図に残っている（2026-09-13 に確かめた）

2026-09-12 にミュートリレーを Omron G6S-2F ＋ SMD のトランジスタ・ダイオードへ替えたとき、
**プルダウンが落ちていないか**を調停役から聞かれたので確かめた。**残っている。**

    R32  10kΩ  BASE → GND   （gen_sch.py 177 行・注記「relay_board R2・🔴 安全の要」・LCSC C17414）
    IN ネットにつながるのは J1.4（XIAO の D3）と R31.1 の 2 つだけ
    BASE につながるのは Q31.1（SS8050 のベース）・R31.2・R32.1 の 3 つだけ

⇒ D3 が浮けば R32 がベースを GND へ引き、Q31 が切れてコイルは励磁されない ＝ **接点は開く。**
`check_sch.py` が `relay_board.html` の R2 と突き合わせていて 0 件で通っている。

🔴 **初回の板では、これを実物で 1 回見ること。** XIAO を挿す前（D3 が浮いている状態）で
V5 を与え、**K31 の COM–NO 間が開いている**ことをテスタで当たる。
`POWER.md` 3 章の「**耳を守っているのはソフトではなく、この『電気が来ていなければ開く』という
配線そのもの**」を、SMD へ替えた後の板で確かめる唯一の手順である。

⚠ この機体は**もともと磁気源が 2 つ**ある（つまみの磁石・リードスイッチの磁石）。干渉は
[POWER.md](POWER.md) 2 章に「この方式でいちばんの risk」として立っている。**リレーは 3 つ目**である。
⭐ ただし v6 は歯車 3 枚で読み取りの芯を**つまみから 24.56mm** 離したので、つまみの外周に付く
リード用磁石は AS5600 から 10mm 以上へ退いた（2026-09-13 調停役）。

### 🔒 AS5600 の基板は「穴に合う棒＋E リング」で留める（2026-08-28 決着）

⛔ **2026-09-13、この 🔒 は失効した。**AS5600 は**中継基板の上のチップ**（`C79815`・SOIC-8）になり、
ここで留める外付けモジュールが無くなった。🔒 ユーザー「歯車 3 枚」で読み取りの芯が
**板 X 36.2・Y 7** に決まり、板の側は `hardware/frozen/v6/pcb/gen_pcb.py` の `PLACE["U4"]` に入っている。
留め方は機構側のブラケット（板の面基準・右下の M2 で共締め）に替わった。
**下の「棒＋E リング」は外付けモジュールを留める話なので、v6 では使わない。**
（この節は v4／v5 の記録として残す。[[case-v6-for-new-board]]）

ねじ止めをやめました。AS5600 の取付穴は M2 ではなく **φ3.5**（印刷した φ3.5 が入り φ3.6 は入らない・
`hole_gauge.scad` で 4 つとも確認）で、M2 のねじでは片側 0.75mm 以上ガタつき、基板の位置がねじでは
決まっていませんでした。座金で締めても、柱の座面 φ8 がピンヘッダのはんだ足を踏むので 4 本が同じ高さに
座らず、実物は「ほんとガタガタしてる」状態でした。

いまの形は、天板から下りる **φ3.5 の棒 4 本**です。棒は基板の穴を通り抜け、裏側に彫った溝で
**E リング（呼び3・箱の「3mm」）が基板を受けます**。

基板の上には **φ4.0 × 高さ 2.0 の段**が 1 つだけあります。リングは下から受けるだけなので、
段が無いと**筐体が揺れたときに基板が棒を 10.7mm 上まで滑ります**（ユーザー指摘・2026-08-28。
磁石とチップの距離が変わる）。⚠ 昔の φ8 の座面には戻しません。あれが踏んでいたのは
穴の中心から 4.40mm にあるはんだ足で、φ4.0（半径 2.0）なら 2.40mm 空きます。
**止めるためだけの段で、柱全体を太くはしません。**

| 決めたこと | 値 | 出どころ |
|---|---|---|
| 棒の径 | φ3.5 | ✅ 現物合わせ（印刷物なので収縮の補正は不要） |
| リング | 呼び3（溝 φ3.0・外径 7.0・厚 0.6） | ✅ **外径 7.0 はユーザー実測**（2026-08-28）。呼び6 と同じで 📄 規格どおりだった。適用軸 3.2〜4 |
| 溝 | φ3.0 × 幅 0.65 | 厚み 0.6 ＋ 0.05。軸のリングと違って**広げない**（基板が下がるため） |
| リングの数 | **3 個**（DIR 角には入れない） | ユーザー案「3 点 E リング・1 個ダボ」 |

3 点にする理由は、**3 点なら板は必ずその 3 点に座る**からです。4 点はどれか 1 本が必ず浮きます。
DIR 角を外すのは、そこだけリングの外周（半径 3.5）がヘッダの樹脂に **0.58mm** 食い込むためで、
残る 3 つは **VCC 角 1.34・GND 角 1.04・GPO 角 0.51mm** 空きます（`knob_v5.scad` の echo ⑤b）。
🔴 2026-08-28 まで、この行は `0.62 / VCC 1.05 / GND 1.35 / GPO 0.48` と書いてありました。
echo を引き写したと書いてありながら、**値が違い、VCC と GND が入れ替わって**いました。
いまの echo（`part="ering"`）の値に直しています。

🔒 **これは決める話ではありません**（2026-08-28 ユーザー「溝を切って無い所に近いのが DIR だよ」）。
リングが入らない角は「リングの外周がヘッダの樹脂に食い込む角」で、`knob_v5.scad` の `DOWEL_XY` が
`parts.scad` の実物合わせから計算しています。**溝は 3 本しか切っておらず、1 本は溝の無いただの棒**です。
組むときは、**その棒へ DIR のピンが来る向きで基板を通します**。取付回転（R）はここには要りません。

🔴 2026-08-28 の一時、ここには「R の記述が食い違うので 4 本とも同じ溝にしてある」と書いてありましたが、
**図面は最初から 1 本を溝無しにしていました**（記述の方が嘘だった）。

### 🔒 E リングは呼び6。呼び7 ではない（2026-08-20 決着）

**E リングの「呼び」は溝径であって、軸径ではない。** ここを取り違えると入らない。

| 呼び | 適用する軸 | 溝径 | 外径 D | 厚さ t |
|---|---|---|---|---|
| 1.5 | 2〜2.5 | 1.5 | 4 | 0.4 |
| 2 | 2.5〜3.2 | 2 | 5 | 0.4 |
| 3 | 3.2〜4 | 3 | 7 | 0.6 |
| 4 | 4〜5 | 4 | 9 | 0.6 |
| 5 | 6〜8 | 5 | 11 | 0.6 |
| **6** | **7〜9** | **6.05** | **12.0** | **0.8** |
| 7 | もっと太い | 7 | 14 | — |

🔒 **軸 φ7 に使うのは呼び6。** 呼び7 は適用軸が太すぎて φ7 では効かない。
✅ 外径 12.0 はユーザーの現物（セットで所有）。08-19 のメモの「外径 12〜13」とも合う。

✅ **手持ちの在庫（2026-08-27・ユーザー）**: 箱には mm の数字だけが書いてあり、
**1.5mm・2mm・3mm・4mm が各 12 個**ある。上の 🔒（「6」と書かれた物が軸 φ7 に効いた）から、
この箱の数字は**溝径＝呼び**と読める。したがって φ2.5 の軸に使うのは「2mm」、
φ3.2〜4 の軸に使うのは「3mm」。⬜ 未確認: 「2mm」の外径が 📄 5.0 に合うか（現物をノギスで）。
小さい呼びの行（1.5〜4）は 📄 規格値で、現物と照合していない。

`ERING_OD = 12.0` で検査は両方とも通る。**島も天板も、いまの形のまま刷れる。**

| 検査 | 余裕 |
|---|---|
| ねじの先 ↔ リング（echo ③） | **+0.65mm** |
| 柱のあいだ 13.4 ↔ リング（echo ⑤） | **+1.40mm** |

<details><summary>📄 2026-08-20 の空騒ぎの記録（同じ失敗を繰り返さないため）</summary>

外径を聞かれたユーザーが**セットの中の呼び7**（外径 14）を測って 14.0 と答え、
その値で `③ −0.35 / ⑤ −0.6` となって「島のねじを置ける半径が無い」という結論が出た。
原因は3つ、いずれも AI 側にある。

1. **どの径かを図で示さないまま数字だけ求めた。** 軸径 7・溝径 6・外径 12 が
   混在する部品で、「外径」としか言っていなかった。
2. **買うものを 旧 SHOPPING.md（2026-08-24 削除・git 履歴） に載せていなかった。**
   呼び6 という指定がリストに無いので、ユーザーの手元で呼びが特定できなかった。
3. **返ってきた 14.0 を「写真では 11〜12mm」と称して否定した。** その読みは捏造で、
   画素を測ってなどいない。設計が壊れない側の数字がほしいという動機が先にあった。
   さらに「木の棒の上に浮いている」「斜めから撮っている」という写真の状況も作り話だった。

⚠ [knob_v5.scad](../hardware/frozen/v1-v4/knob_v5.scad) の 57行目には 08-19 の時点で
**「外径 12〜13」**と書いてあった。AI はそれを読まずに「12.7 は仮の値」と言い続けた。

</details>

### E リングまわりで、確かめてあること／確かめられないこと

**位置は一本の理屈で決まっている。** 受け面（増し肉の裏 z −9.0）から `ERING_PLAY` 0.3mm
下に溝の上端を置く。この 0.3 がそのまま「つまみを引ける量」になる。

| 何を | 数字 | 判定 |
|---|---|---|
| 溝の位置 | z −10.25〜−9.3 | 引き上げ 0.45mm ／ ツメの掛かり 1.3 → **余裕 0.85mm** |
| 溝の深さ | 軸 φ7 に φ6 → 片側 **0.5mm** | 規格の溝径 6.05 なら 0.475 |
| 受け面の掛かり | リング外周 r6 ↔ 通し穴 r4 | **半径で 2.0mm 重なる**（素通りしない） |
| 溝の下端 → 磁石ポケット | 離れ 3.45mm | 軸の中で繋がらない |
| 柱の通り道（echo ⑤） | 13.4 ↔ 12.0 | +1.40mm |
| ねじの先（echo ③） | — | +0.65mm |

⬜ **CAD で出ないのは保持力だけ。** 何 N で爪が外れるか、ステンレスの爪が深さ 0.5mm の
溝でどれだけ踏ん張るかは材料の話で、爪を実形状で描いても数字は出ない。**刷って引く。**

✅ **2026-08-20、代役をやめて実形状にした。** それまでは `ering_proxy()` という
「外径だけ合わせたスリット入りの円板」で、③⑤ の数字は正しかったものの、
**磁石にはある「実体で通り道を見る検査」がリングには無かった**（ユーザー指摘）。
リングも組む順④で横から差す部品なので、磁石と同じ検査を持つべきだった。

いまは 3つの爪と口を持つ `ering_part()` があり、差し込みの経路を実体で当てられる。

| 検査 | 結果 |
|---|---|
| `part="eringpathx"`（±X から差す） | ✅ **交わり空＝通る**（2026-09-09） |
| `part="eringpath"`（±Y から差す） | 🔴 **手 4 本に 16.0mm³ 当たる**（2026-09-09。y 12.00〜14.50・リングの帯の高さ） |

**いまの差し込みは ±X（左右）。**⚠ この向きは**ロックしない**。周りの物から決まる従属値で、
隣が動けば動く（2026-09-09 ユーザー「周辺機構が変わったら削除しないといけないロックなら、それは不要だ」）。
つまみまわりを触ったら、上の 2 つを回して**空いている側を採る**のが決め方。

🔴 **2026-08-28（15 度目の机上の通し）に、この表の下の行が根拠を失っていた。**
2 つ重なっていた。

1. `ering_obstacles()` の「ねじの胴」が、高さ `Z_BOSS_BOT − SCR_TIP_Z = −10.5 − (−10.3) = **−0.2**`
   の**負の円柱**になっていて、実体が 0 だった。つまり `eringpath` も `eringpathx` も、
   **ねじを障害物に数えないまま**「空」を出していた。⇒ ねじの現物 `stop_screws()` を
   そのまま相手にするよう直した（同日）。
2. 直して実体で当て直すと、**±X も空**（当たらない）になる。ねじが短くなったからではなく、
   **ねじの先が Z −10.3 で終わり、リングの帯（Z −11.6〜−10.8）より 0.5mm 上**だからで、
   いまのねじはリングの高さまで下りて来ない。上の「ねじが y=0 に居るので X から入れると轢く」は、
   ねじが Z −12.0 まで出ていた頃の話。

🔴 **2026-09-09 に ±Y → ±X へ入れ替わった。** 上の 2026-08-28 の話（ねじが ±X を塞がなくなった）に、
2026-09-08 の吊りが重なったため。台座の裏に立った**手 4 本**（世界 x 2〜8・y 12〜16）が、
リングの帯（z −11.6〜−10.8）の高さを横切って ±Y を塞いだ。当たりは 16.0mm³。
⚠ この入れ替わりは、9 月 8 日に手を Z 90 度回した時から起きていて、9 月 9 日まで誰も検査を回していなかった。
**つまみの周りを動かしたら、この 2 つの検査を回すこと。**

⚠ 検査の性質: `hull()` は C の口を埋めるので**実物より太った経路**になる。
**「空＝通る」は保守側で通った強い結論**だが、「非空＝当たる」は保守側の判定であって
証明ではない。X の結果はそう読むこと。

⬜ リングの**口の幅・爪の角度幅・逃げ径**は絵の形を作るために AI が置いた値で、
現物と照合していない。⚠ ③⑤ と受け面の判定は**外径だけ**に依存するので、
この3つが違っていても数字は動かない。動くのは絵の見た目だけ。

---

## 治具（第1世代・履歴）

📄 2026-08-02 の回転テスト用。**いま刷るものではない。**
モデルは [knob_jig.scad](../hardware/frozen/v1-v4/knob_jig.scad) と [as5600_holder.scad](../hardware/parts/as5600_holder.scad)。

```bash
openscad -o hardware/stl/knob.stl -D 'part="knob"' hardware/frozen/v1-v4/knob_jig.scad
```

| STL | 中身 |
|---|---|
| [knob.stl](../hardware/stl/knob.stl) | つまみφ25 ＋ 軸φ6×10 ＋ 磁石ポケット4.10 が**一体** |
| [bridge.stl](../hardware/stl/bridge.stl) | 門形の軸受け。デッキの穴で軸を受ける |
| [base.stl](../hardware/stl/base.stl) | 底板。AS5600 の座（M2長穴）＋ ブリッジのほぞ穴 |

⚠ **接着しない。** 駄目なら刷り直すので、ほぞは差すだけにする。

**外したときに直す場所**（`.scad` の1行を変えて刷り直す）:

| 変数 | 用途 | 直し方 |
|---|---|---|
| `BORE_CLEAR` | 軸受けの遊び | ガタつく → −0.1 ／ 渋い → +0.1。⚠ **0.25 → 0.40 に直した**（凸は約0.1mm太り、入口はボトム層で過硬化して縮む） |
| `CHIP_GAP` | 磁石面とチップの隙間 | 許容 0.5〜3mm。⚠ **1.5 → 1.1 に直した**（φ4の小磁石は中央では弱すぎて AGC が振り切った） |
| `HOLE_PITCH` | 基板の穴間隔（現 17.0） | 基板の変種が来たらここだけ |

**組んでみて直した所**（設計に反映済み）: スタンドオフが折れた → 丸柱＋長穴では肉厚0.3mmしか
無かったので小判形に変更（肉厚1.8mm）／ コネクタが挿さらない → ハウジング（約14mm）の空間を
忘れていたので基板の下を貫通窓に。**ベースの下に10mm台を噛ませて使う。**

⚠ **本番のつまみとパネルの寸法は、筐体側の条件（パネル厚・つまみ周りの空間）が決まってから。**

## 部品

| 品目 | 型番 | 入手 | 数 | 単価 |
|---|---|---|---|---|
| AS5600モジュール（磁石付属） | Hailege 2個セット | Amazon | 1 | ¥990 |

**購入済み。追加の基板・線材は手持ちでよい。**

⚠ **Amazon の罠**: 「3ピンワイヤー付き・ジンバルモーター用」の安い基板（¥500台）は買わない。
コネクタに出ているのが PWM/アナログ出力で、**I2C(SDA/SCL) がピンに出ていない。**
ピンヘッダに SDA/SCL が明記されたブレイクアウト形を選ぶこと。**磁石付属品を選ぶ**
（径方向着磁の専用磁石が必要で、単品調達は面倒）。

---

## 既存モデルの調査（2026-08-17）

世の中に出ている AS5600 のノブを一通り見た。**現行機に流用できるものは無かったが、第2世代の
軸受けについて1つ拾うものがあった。**

出回っているモデルはほぼ全部 [scottbez1/AS5600Knob](https://github.com/scottbez1/AS5600Knob) の
子孫で、Printables や Thingiverse のものはそのリミックスにあたる。構成はプリント3部品＋**608 の
スケートベアリング**＋結束バンド（抜け止め）＋基板を留める M3×4 で、磁石は φ4×2 の径方向着磁と、
こちらと同じ寸法を使っている。可変抵抗の置き換えを正面から狙ったものとしては、軸受け筒に
M10×1 のネジを刷ってパネルナットで留める [Magnetic Multiturn Potentiometer](https://www.printables.com/model/972305-magnetic-multiturn-potentiometer) がある。

**拾うもの:** 彼らが半月に相当する部品を作らずに済んでいるのは、ベアリングが軸の位置決めを
全部引き受けているからで、抜け止めは荷重を持たない。だから結束バンドや樹脂の止め輪で足りる。
v4 は**つまみが半月からぶら下がる**ので抜け止めが常時スラストを受けており、そのために剛性が要り、
ねじ止めになり、天板にナットポケットが生えた。ここが部品数と座の広さの発生源になっている。

**そのまま真似できない理由:** 608 は外径22mmの鋼で、持ち手の裏（半径 8.4）に埋めたリード用磁石の
真下に鋼の輪が来る。⚠ **実測した「閉じるのは 5mm」が変わる。** また、どのモデルも
リードスイッチによる機械的な電源断・315度の壁・パネルのへこみを持っておらず、寸法も作者の
FDM機に合わせ込んだ値なので、レジンの縮み 0.1 の世界とは別物。

⬜ **第2世代で見るのは転がり軸受けではなく滑りブッシュ。** 手で回すつまみに転がり要素は要らない。
**青銅（銅系）の焼結含油ブッシュなら非磁性で数百円**であり、セラミック軸受けを買う理由は無い。
⚠ 含油軸受けには**鉄系（磁性あり）もある**ので、買うときは材質を確かめること。

---

## ✅ 天井の直し方 — 壁を1枚だけ別部品にした（2026-08-19・**未印刷**）

✅ **考え方は生きている。`part="wall"` として入っている**（いまは
[knob_v5.scad](../hardware/frozen/v1-v4/knob_v5.scad)）。検討の模型は
[stack_study.scad](../hardware/frozen/v1-v4/stack_study.scad)（`SEAT="onepiece"`・画面用。刷らない）。

🔴 **ただし下の表は v4 に入れたときの数字で、v5 では別物になっている。**
同じ日の夕方に、ユーザー指摘（「歪む壁に壁を建てるな」「圧入ゼロ」）で
**外側の輪とスリットを廃止し、座金＋タブ1枚の「島」を上からのねじ2本で留める形**へ作り直した。
厚みも 1.2 → 3.9mm に変わっている。🔒 **現行値は `knob_v5.scad` の echo ②③。**

**v4 に入れたときの数字**（記録）:

| | 値 |
|---|---|
| 壁の厚み | **1.2mm**（ツメの掛かり 0.95 より厚いこと） |
| 壁の外径 / 座 | 26.0 / 26.2（逃げ 0.2） |
| 壁を受ける輪 | 半径 **12.0〜13.1**（幅 1.1）。それより内は **0.75mm 掘り下げ** |
| ツメの先 → 掘り下げた床 | **1.0mm** |
| 掘り下げ | 🔴 **リードの溝の天面まで通す**（膜を残さない・下の理由） |
| 支柱 | 半径 6.95 と 10.55 に各12本・φ1.4。⚠ **モデルに入れる** |
| 回り止め | ピン **φ3.0 を半径 7.6 に1本**（穴 φ3.3）。⚠ 1本だけ（2本を180度に置くと裏返しでも入る） |

### 何を直すのか（🔒 面はツルツルにならない）

**掘り込みの底は、刷ると必ず天井になる。** 天面を下にして焼く以上、上を向いた面は下向きに焼かれる。
だから狙いは「天井を無くす」ではなく、**荒れる場所を、見えず触らない所へ移すこと**である。

✅ **荒れの度合いはユーザーが実物で順位を付けた（2026-08-18）。赤 ＞ 青 ＞ 橙。**
効いているのは幅ではなく、**生まれた瞬間に何辺で支えられているか**。

| | 場所 | 幅 | 生まれたとき何に繋がっているか | 荒れ |
|---|---|---|---|---|
| **赤** | へこみの底・溝より内（半径 5.5〜9.8） | 4.3mm | 壁の 20度 のタブ1本だけ（片持ち） | 一番ひどい |
| **青** | へこみの底・溝より外（12〜13.1） | 1.1mm | へこみの壁に外周で（片側・全周） | 次 |
| **橙** | 溝の床 | 2.2mm | 溝の内壁と外壁の**両側** | 一番マシ |

### 形（ユーザー案・2026-08-19）

🔒 **天板と床は一体のまま。別部品にするのは「壁」1枚だけ。**

| 名前 | 中身 |
|---|---|
| **天板＋床**（1部品） | 見える面・へこみ・溝の底。**いまの座のまま**。M2.5 のナットもリードの溝もそのまま |
| **壁**（増える1部品） | 溝の壁と回転限界止め。**上面がへこみの底**。円弧のスリットは貫通。平置きで刷るので両面とも平ら |

⭐ **壁は床の上に乗るだけ。**床が天板と一体なので落ちようがなく、**支える仕掛けが一切要らない。**
上へも抜けない（持ち手が 0.5mm 上で蓋になる）。ねじ・すり鉢・棚・ペグ・バヨネット、全部不要。

⭐ **赤と青が壁の上面に移り、平置きで焼かれる。**残る天井は橙（溝の底）だけで、
そこは半径 9.8〜12.0 ＝ **持ち手（φ25）の下に完全に隠れ、ツメとも 0.95〜1.4mm 空く。**

✅ **その面にはサポートを入れてよい。** 痕が残っても機能にも見た目にも当たらない。
🔴 **これが分割のいちばんの効き目である。** 分割前は同じ面が「見える面」かつ「ツメが走る面」で、
支柱の痕がそのまま実害だった（2026-08-17、削らないと回らなかった）。

### 🔴 極薄の床を残さない（2026-08-19・ユーザーの実績）

掘り下げをリードの溝の手前で止めると、**0.45mm の膜**が残る。この膜は刷る向きでは
**下に空洞（リードの部屋）を背負った薄い天井**になり、**印刷が失敗しやすく、FEP に
張り付いたことがある**（ユーザー）。だから**溝の天面まで通して、膜を残さない。**

⚠ 代わりにリードの溝の天面が一部無くなる。ただし**溝の端（x ±7.15）には y 9.64 から外に
天面が残り、本体に対して 2.59mm 幅で当たる**ので、リードの高さの突き当たりは生きている。

### 🔴 支柱はモデルに入れる（消さないこと）

**スライサーのサポートが効かなかった**ので、支柱をモデルに入れてある（ユーザー実測）。
⚠ 2026-08-19、AI が「痕が実害にならないからスライサーに任せればいい」と考えて一度削除し、
差し戻された。**「痕が問題」ではなく「サポートが効かない」が理由である。**

支えるのは**掘り下げた床（半径 5.5〜12.0）**だけ。受ける輪（12.0〜13.1）は幅 1.1mm で
へこみの壁に全周で付くので支柱は要らないし、**そこは壁の座なので痕を残してはいけない。**
痕に許される高さは **0.75mm**（壁の裏と床の差）。

### ⬜ まだ決まっていないこと

- **床の掘り下げ量。** 垂れる内側に島を触らせないために掘る。
  ⚠ **仮値である（v4 で 0.4 → v5 は `RELIEF_T` 0.3）。実測ではない。** 垂れ量は刷らないと分からない。
  ⚠ v5 は締めると島がその分下がって**支柱の痕に乗る**（echo ②）
- 🔴 **掘り下げの下 0.05mm でリードスイッチの部屋。** 溝の天面は z −4.45、掘り下げ底は −4.4。
  抜けると**リードの高さを決めている突き当たりが無くなる**（磁石→接点 4.69mm・閉じるのは 5mm で
  余裕 0.31mm しかない）。強度や見た目の話ではない
- ~~**壁の回り止め。**~~ ✅ v5 で解決。**島は左右2本のねじが回り止めを兼ねる**（ダボも座も無い）。
  ⚠ 2026-08-19 に AI が入れた角柱は、天板の見える面を貫通していて撤去した
- ~~**壁の内側の輪の弱さ。**~~ ✅ v5 で消えた。**外側の輪とスリットを廃止して、島は φ22 の
  丸板＋タブ1枚になった**ので、細い輪がタブ1本でぶら下がる形が無い

### 🔒 ①引き上げと②天井は同時にやる（2026-08-18・ユーザー）

②で壁を別部品にすると、①で触る**ツメ・溝・持ち手の逃げ**がそこへ乗る。
**別々に直すと同じところを二度設計することになる。**

### ⬜ 途中で出て落ちた受け方（蒸し返さないために残す）

⚠ 下は全部、**床も別部品にした場合**に必要になったものである。床を天板と一体にした時点で、
**問題そのものが消えた。**

| 受け方 | なぜ落ちたか |
|---|---|
| **圧入ペグ** | 重力が板を天板から引き剥がす向きに働き、ぶら下がるもの全部を摩擦が持つ |
| **すり鉢**（ユーザーの元案） | 壁が持たない。円錐は 1mm 深くなるごとに半径を 1mm 削るのに、溝の外径 12.0 は固定。壁の外周は上端で 1.1mm しかなく、1.1mm 潜った時点で消える（下端で −0.475mm） |
| **棚** | 🔴 AI が唐突に出して推した案。下を向いた水平面を1つ増やす |
| **バヨネット** | 🔴 AI の誤り。**板を下から支える面は必ず上を向く**ので、天板の中に作れば刷ると天井になる。棚もすり鉢もこれと同じ |
| **下からのねじ** | ナットは上に置けず（上は見える面）、タッピングは天板 2.5mm に 3〜4山しか噛まない |

⭐ **一般則: 天板の中で板を持ち上げる面は、刷ると必ず天井になる。**唯一の例外は下から入れるねじの
下穴（止まり穴なので上へ開く）。だから支えるなら**天板以外の部品から**支えるしかない。
**床を切り離さなければ、この話に入らずに済む。**

---

## 🔒 落ちた案（蒸し返さないこと）

| 案 | 何だったか | なぜ落ちたか |
|---|---|---|
| **死んだRV121SFを軸受けに流用** | 電極を繋がず軸受けとしてだけ使う | **実施して失敗。** 貼り合わせでは同芯0.25mmが出ない（MAGNITUDE が −71%） |
| **スイッチ付ボリューム ¥110 を軸受けに** | JHS16KN2B102L20KC。300°の回転止め・クリック・ブッシング込み | **パネル取付型は軸の先端が使う人の側を向く**＝センサーの置き場所が無い。側面付けは逆に基準面が無い。どちらも貼り合わせが残る |
| **ホール式ポテンショの完成品** | Bourns AMS22 / Piher PST / P3022系・¥1,500前後 | 全部印刷で足りることが実測で立証されたので不要 |
| **非磁性ベアリングで軸を受ける** | セラミック（Si3N4）や SUS316 の転がり軸受け。旧バージョンで検討した | **値段で落ちた**（ユーザー・2026-08-17 に経緯を再確認）。⚠ ただし落ちた理由は「非磁性」という条件の付け方の方にあった可能性がある。⬜ 第2世代では**青銅の滑りブッシュ**として再検討する（下の「⬜ 残り」の行） |
| **インクリメンタルエンコーダ EC11系** | EC12E2420801（秋月 106357・¥100） | **絶対角度が読めない。** NVS保存・音量バー・原点合わせが全部必要になり、現行の UX（軸の向きを見れば音量が分かる）が崩れる。⚠ さらに **A/B相に想定していた D0/D1 は両方 ReSpeaker 側が握っている**ので、この配線では組めない |
| **マイクロスイッチ（境目でパルス）** | — | 接点の摩耗が残り、読み逃しの補正ロジックも要る |
| **ホールIC UH277G**（秋月 111031・¥30） | — | 🔴 **買ってはいけない。** 交番検知（ラッチ型）で磁石1個の近接検知には使えない |

⚠ **可変抵抗（ボリューム）全般は買わない。** RV121SF の予備も、軸受け用の¥110も、ホール式
ポテンショの完成品も**買わない**（旧 SHOPPING.md（2026-08-24 削除・git 履歴）「買わないもの」）。

## この移行で何が置き換わったか

| 役割 | 旧（可変抵抗） | 現（AS5600） |
|---|---|---|
| 音量の入力 | カーボン膜の分圧を ADC で読む | **磁石の絶対角度を I2C で読む**（接触なし） |
| 音量の記憶 | 軸の角度そのもの | 同じ（絶対角度なので NVS 保存は不要） |
| 音量の表示 | 軸の向きを見る | 同じ |
| OFF の検知（音の停止） | SPST スイッチ | **角度の閾値**（部品も配線も不要） |
| OFF の実行（電源断） | SPST スイッチ | **リードスイッチ＋磁石**（EN⇔GND・[POWER.md](POWER.md) 2章） |
| OFF のカチッ（手応え） | スイッチ内蔵デテント | 3Dプリントの溝＋板バネ（**感触だけ**） |
| 回転の壁 | 内蔵（230度） | ⬜ **印刷した機構で作る（未着手）** |

移行した理由は2つで、**どちらも実測から出ている。** ① 抵抗膜が半田付けの熱で劣化し、B（直線）
カーブのはずが「3時で22%・4時→5時に全変化の6割」という歪み方をした ② **回すとコーデックが死んだ**
（[KNOB-TROUBLE.md](KNOB-TROUBLE.md)）。AS5600 なら回るのは磁石だけで、基板も配線も静止したまま
なので、②の観測された経路がそのまま消える。**連動スイッチの2本も無くなる。**
