n416/katanori/docs/CASE-V4-LOG.md

# 筐体 v4 — 経緯の台帳（2026-08-24〜25）

> **この文書は記録です。いまの姿を知りたいときは [CASE-V4.md](CASE-V4.md)、判断待ちは [CASE-V4-OPEN.md](CASE-V4-OPEN.md) を見てください。**
> 2026-08-25 に CASE-V4.md を 3 つに分けたとき、**それまでの本文を 1 行も変えずにここへ移しました**。
> 章番号（§1〜§13）は分ける前のままです。他の文書や .scad が「CASE-V4 §10」のように指しているのは、この文書の §10 です。
>
> 🔴 ここには**間違えた経緯と、取り消した案**が残っています。読みにくいのは承知の上で、消しません。
> 消すと次に開いた人（AI を含む）が同じ場所へ戻ってくるからです。落ちた案・訂正・失敗は、そのための地図です。

---

# 筐体 v4 — 面倒なピースから置く

> 🔒 **2026-08-25 ユーザー決定で v3 を打ち切り、v4 へ**（経緯は [CASE-V3.md](CASE-V3.md) 冒頭）。
> v3 の敗因は、PowerBoost を本物（ヘッダ・ハウジング・挿す軌跡）にする精緻化を後回しにし、最後に入れる場所が無くなったこと。
> ~~v4 は**置く順番**から作る: **PowerBoost＋挿す手 → 電池＋工具なし交換 → ReSpeaker/OLED/フィルム → ハブ → つまみ**。~~
> 🔴 2026-08-24 この順は看板のままで、実作業は毎回 v3 座標の固定物を先に読み込んでいた（＝PB が構造的に残り物になる）。
> 🔒 **作り方を替えた（§7）: まず固定群だけの機体（芯）を作り、自由な部品をそこへ一つずつ足す。外皮は従属変数。**

日付: 2026-08-24〜。原則はユーザー、測定と記録は AI。

## 1. 前提（2026-08-24 ユーザー）

- 🔒 **最上位の条件: つまみは OLED から見て右。** 使う人（介護の現場・高齢の方）は殆どが右利きで、右手でつまみを回す。
  **右以外はあり得ない。** 鏡の事故の後、ユーザーは OLED 用に計画したヘッダを AS5600 に充てる補正までしてこれを守った（口の役割の入れ替え・[POWER.md](POWER.md) 4章）。
  線・口・組み立ての都合は全部この下に従う。設計の序列は **使う人の体 → 実物のハード → 図と模型 → 検査の都合**。逆順にしない。
- ~~**外径は v3 のまま。** 内寸 86.0 × 72 × 48.454・外寸 90 × 76 × 52.95。~~
  🔴 2026-08-24 ユーザー決定で 🔒 を解除（§7）。**v3 の外径は制約ではなく比較対象**（「v3 のようなサイズ感」が目標値）。
- **固定している物**: 天板の部品群（スピーカー・会話ボタン・つまみ knob_v5）・正面の OLED・ReSpeaker。座標は v3 の値を使う。
- それ以外（PowerBoost・電池・INA226・Type-C 基板・ハブの前後位置・トグルの位置）は白紙から置き直してよい。
  ⚠ ただしハブ（52 × 74）は寸法の都合で床に平置きしか無い。スタディは v3 の位置（Y 11.9〜63.9）で当てた。
- **かならず組める形にする。** 組む動きを先に文で追い、検査は当たり体積だけでなく挿す軌跡・抜く軌跡まで見る。
- v3 から引き継ぐ設計の規則（[CASE-V3.md](CASE-V3.md) §4）: 寸法は変数・貫通＋ナット・開口はベベルで穴は殻の大きさ・
  落下前提 2.0・**電池の口は OLED から見て左**・向きの基準は OLED 正面・丸みの持ち主はフロント＝天面 ＞ 側面 ＞ 背面 ＞ 底面。
- 部品の模型は版に依らない（parts.scad・hub_board.scad・knob_v5.scad・respeaker_lite.scad・typec_115426.scad）。v3 までの精緻化がそのまま土台。

## 2. スタディ①: PowerBoost の置き場（2026-08-24・[_v4_pb.scad](../hardware/frozen/v1-v4/_v4_pb.scad)）

**障害物は固定と決まっている物だけ**: 外皮（素の板）・ハブ＋挿した線 10 本・ReSpeaker（XIAO 込み）・OLED・
天板の部品群（つまみ込み）・フロント・トグル（ハッチ・v3 の位置）。v3 の機構（ブリッジ・トンネル・棚・柱・フック）は入れない。

**ReSpeaker の挿さる物も障害物と検査に入れた**（2026-08-24 ユーザー「ピンヘッダも精緻化」）:
- **J2（スピーカーソケット）のプラグ＋線の空間**。🔒 PH2.0 のトップ型（真上に挿す・[RESPEAKER-LITE.md](RESPEAKER-LITE.md)）なので、
  空間は XIAO 面の法線＝箱の +Y へ「面から 15」（`respeaker_mating_space` と同じ値）。世界座標で **X 5.1〜12.1・Y 10.0〜25.04・Z 15.5〜23.5**。
  ⬜ プラグの尻の実測（PHR-2 の突き出し）が出ればこの 15 は詰められる。
- **XIAO の積み重ねと 7 本の線（2026-08-24 にピン単位へ開いた）**。✅ 構成の正はユーザー（写真＋説明・**同日中に AI が 2 回作り話をした末の確定**）:
  **XIAO は ReSpeaker に直接はんだ付け（ソケット無し・浮き無し）。その XIAO の上にストレートのピンヘッダが立ち、線の DuPont はそこに挿さる。**
  鎖: はんだ ⚠0.2 ＋ XIAO の板 ⚠1.2 ＋ 樹脂 2.5 ＋ ピン 6 ＝ **先端 9.9 ≈ ✅実測 10**（標準部品で閉じる）。線の頭は面から 13.9 ＝ 世界の Y 23.9・線の逃げで 27.5。
  🔴 AI の誤り遍歴（再発防止のため残す）: ①「塊 高さ 10」＝挿す物が無い ②「ソケットで XIAO が 6.7 浮き USB の殻が頭」＝作り話で、線の頭を 5.3 深読みし、口の位置を道連れにした。
  模型は [respeaker_lite.scad](../hardware/parts/respeaker_lite.scad) の `respeaker_xiao_stack()`（恒久）と `respeaker_xiao_housings()`。
  🔒 **挿すのは使う 7 本だけ**（[POWER.md](POWER.md) 4章: 電源側 5V・GND・3V3 ＝ USB 端から 1〜3 番、信号側 D2・D3・SDA・SCL ＝ 3〜6 番。残り 7 ピンは裸）。
  ⚠ どちらの列（下/上）が電源側かは未確認だが、入れ替わっても X の帯が入れ替わるだけで筐体の当たりには効かない。
  検査: 線 7 個 ↔ 他の固定物 **0**（`xh`）・抜き挿し（`xpull`・+Y へ 12）**0**。
  **スタディ②の置き物はこの帯（X 64〜83・Y 14〜28・Z 10〜29）を空けておく。**
- 🔴 **道連れの訂正: 右の壁の XIAO USB-C の口の位置。**v2/v3 の口は「殻が積み重ねの頭（面から 6.74〜10）」という誤った鎖から導いていた。
  実物の殻は **XIAO の板の上＝面から 1.4〜4.66**（中心 3.03）。**口は約 5.3 奥に開けていた**ことになる。
  ユーザーは以前から誤りを指摘していて、AI が「合ってる」と言い続けていた（メモリ user-knows-their-hardware に記録）。
  `xiao_usb_yz()` は直した。**v4 の右の壁はこの値で描く。**v3 の `v3_rwall.stl` は口がずれているので刷らない。
- **OLED の I2C ヘッダと線も模型に入れた**（✅ 2026-08-24 ユーザーの写真 3 枚。詳細は台帳）。上辺の裏・中央のストレート 4 ピン。
  線の DuPont の頭は裏面から 12.5 ＝ 世界の Y 17.1・線の逃げで 20.7（Z 45〜48・X **37.9〜48.1**。🔴 当初ここに 30〜40 と書いていたが、模型（✅定規写真由来）の bbox は 37.9〜48.1。2026-08-24 帯出しで訂正）。
  🔴 **これが見つけた当たり: v3 天板の ReSpeaker 押さえの前リブ（X 39.1〜45.1）が、OLED のヘッダと線の真上に居る**（`oh`/`opull` とも 43mm³。🔴 2026-08-24: ヘッダは当初 AI が検査ファイルにだけ置いていて部品本体に無かった。いまは `oled_242()` 本体に入っている＝ case_v3 の画面にも出る）。
  ⬜ **v4 の天板では前リブの X をずらす**（リブは意匠ではなく機能形状なので動かせる。どこへ寄せるかはユーザー）。

検査は 6 種類（すべて `--backend=manifold`）:

| 検査 | 何を見るか |
|---|---|
| `chk` | 座った状態 ↔ 完成形の全部 |
| `seat` | 線を全部挿した PowerBoost を上から降ろす（⑨ 相当の動き） |
| `hup` | ハウジングを後から上へ抜き挿しする（天面がまだ無い時点） |
| `husb` | （C 案のみ）水平の 2 本を完成後に −Y へ抜く |
| `top` | 天面＋つまみを最後に降ろす（⑫ 相当） |
| `bat` | 電池の座＋左の壁の外 5mm まで抜く道 ↔ PowerBoost |

### 🔴 落ちた置き方: 平置き・右半分（どの高さでも不成立）

つまみの一式（固定）は天板から **Z 29.95 まで**下りている（AS5600 の島と柱・実測 bbox **X 54.2〜77.2・Y 22.3〜45.3**）。
平置きのハウジングの頭は 板の下面 ＋14.1 で、板の下面はハブの線の頭（17.7）＋足 1.2 より下げられない ⇒ 頭は最低 **33.0**。
つまり島の下には入らない。島を XY で避けようとすると、右へは壁（板が 94 要る）、後ろへは JST のプラグがハッチを貫き、
前へは XIAO の頭（Y 20.035）、180° 回すと 4 ピンヘッダが電池の場所（X < 52）に入る。**右半分の平置きは全滅**。
（2026-08-24 深夜の「ブリッジの上に平置き」は左寄り X 4〜40 だったので生きている。下の A 案がその子孫。）

### 🔴 ハブの口の模型が 2.5 甘かった（2026-08-24・精緻化の途中で発見）

`housing(id)`（ハブの口に挿した DuPont）は**ハウジングを板の上に直接**置いていた。実際はピンヘッダの樹脂（2.5）の上に座るので、
頭は 14.1 ではなく **16.6**、線の曲がり込みの頭は 17.7 ではなく **20.2**。hub_board.scad 自身が「裸のヘッダで数えるな」と
2 回記録している（2026-08-15 ユーザー指摘）のと同じ忘れ方を、隣のファイルでしていた。直して全検査を回し直した。
同時に、**自分の置いた PowerBoost の上向きハウジングに曲がり込み（3.6）を載せ忘れていた**のも直した。
⚠ ヘッダの樹脂 2.5 は規格値。ハブの実装の最高点（ヘッダ）の実測は [POWER.md](POWER.md) too 未取得のまま（⬜）。

### 🔴 案 A: 平置き・左・電池の下 —— **精緻化で不成立になった**（2026-08-24）

絵は [_v4_pb_A.png](../hardware/frozen/v1-v4/_v4_pb_A.png)。板 **[4, 25, 28.5]**（X 4〜40.2・Y 25〜47.9・板の下面 Z 28.5）・部品面が上。

- ハウジングは 4 つとも真上に立つ（頭 Z 42.6）。スピーカーの裏（Z 44.25）まで **1.65**。
- **電池は PowerBoost の真下** [2, **25.4**, 18.4]（Z 18.4〜25.4）。下はハブの線の頭 17.7 まで 0.7、
  上は PowerBoost のヘッダの足の下（27.3）まで **1.9 ＝ v3 のスポンジ厚と同じ**。左の壁の口から −X へ抜く道も 0。
  🔴 v3 の Y 22.9 のままだと、前面が **J2 のプラグ＋線の空間（Y 〜25.04）に入る**（電池がこの高さに下りたため。v3 の Z 29.3 では上を通っていた）。
  抜き道ごと 2.5 後ろの Y 25.4 へ。後ろは Y 60.4 で、中央の空間に収まる。
- 蓋・ロック・磁石の機構は v3 のまま使えるが、**口の高さが v3 より 10.9 下がる**（壁の口は Y 25.1〜60.7・Z 18.1〜24.7 の帯に開く）。
- JST のプラグは +Y へ水平（Y 47.9〜52.6・Z 30.1〜35.3）。中央の空間に出るだけ。
- ~~検査: `chk` / `seat` / `hup` / `top` / `bat` すべて 0~~ 🔴 **この 0 は模型が甘いときの値だった。**ハブの口の +2.5 と曲がり込みを入れると:
  1. **電池の床が成立しない。**ハブの口の曲がり込みの頭が 20.2 になり、電池の底 18.4 がめり込む（`batf` 544mm³）。
     床を 20.5 に上げて積み直すと、20.2 ＋ 0.3 ＋ 電池 7 ＋ スポンジ 1.9 ＋ 足 1.2 ＋ 板 1.6 ＋ 樹脂 2.5 ＋ ハウジング 10 ＋ 曲がり 3.6
     ＝ **48.3 で、内寸 48.454 に対し余りが 0.15 しか無い**。スポンジ（⬜実測待ち）と曲がり（⚠既定）のどちらかを削る前提でしか立たない。
  2. **その積み上げ以前に、いまの位置でも GND/EN/USB の線の曲がり込みがスピーカーの裏（Z 44.25）に 32mm³ 入る**（`chk`）。
     スピーカーの外（Y 37〜）へ逃げる余地はあるが、1 の全高が変わらないので救えない。
- （記録として残す前提条件）8 ピン列は真っ直ぐなヘッダが要る＝ L 型を半田付け済みなら付け替え。電池の口は v3 より 10.9 下がる。

### 案 C: 背面（ハッチの内側）に立てる（検査は全部 0）

絵は [_v4_pb_C.png](../hardware/frozen/v1-v4/_v4_pb_C.png)。板の裏をハッチへ向けて右の壁の際に立てる。**[右端 X 84.3, 裏の面 Y 70.3, 上縁 Z 34.5]**
（板 X 48.1〜84.3・Y 68.7〜70.3・Z 11.6〜34.5）。部品面はハブ側（−Y）・8 ピン列の縁が上・JST の縁が下。

- **ヘッダは v3 の 🔒 決定のまま**（GND/EN は L 型・USB は真っ直ぐ 1 ピン）。L 型は縁の外＝真上を向き、ハウジングは上から挿す
  （X 60.0〜65.1・頭 Z 44.5・線の曲がり込みの頭 48.1・天井まで 0.35）。
- USB の 1 ピンと PWR の 4 ピンはハブ側へ水平に出る（ハウジングは X 51.8〜55.0・Y 56.2〜66.2・Z 17.7〜27.9。
  ハブの口の頭 16.6 の上・曲がり込みの帯はこの XY に無い）。
  この 2 本は**完成後もハッチを開けて −Y へ抜ける**（真っ直ぐ 10 で抜け切る。11 まで引くと USB の 1 本がつまみの島の角に 1mm³ 触れるが、抜けた後は線が曲がる）。
- JST のプラグは下向き（下端 Z 6.95・X 69.6〜77.6）。⑥ 相当の「手元で挿してから降ろす」で入れる（`seat` 0）。
- 裏のヘッダの足（1.2）とハッチの内面の間は **0.5**。micro-USB の張り出し（0.5）と右の壁の間は **1.2**。
  トグル（X 33.5〜46.5）とは L のハウジングまで X で 13.5。
- **電池・トンネル・蓋は v3 の位置のまま成立**（`bat` 0）。位置は 3 回動かして決めた:
  上縁 Z 36.0 → 4 ピンのハウジングの頭が電池の抜き道の膜（Z 29.0）に 2mm³ → 35.0。
  右端 X 51.5 → USB の水平ハウジングの先が電池の尻（X 〜52・Z 32.5〜35）に 13mm³ → **84.3**（水平 2 本の先が X 52.4 より右になる）。
  L の曲がり込み（3.6）を頭に載せると天井 48.454 を 0.15 超える → 上縁 **34.5**。
- 検査（ハブの口 +2.5・曲がり込み込みの模型で）: `chk` / `seat` / `hup` / `husb` / `top` / `bat` / `batf` / `xpull` **すべて 0**。
- 使う奥行き: 板＋部品で Y 65.4〜71.5。後ろの帯（8.1）にほぼ収まり、ハブの上へは水平のハウジング 2 個だけが出る。
- 🔒 充電の Type-C 基板の場所（左の壁・後ろ下・X 0〜7）とは重ならない。v3 の床のハッチの爪（帯 Z 0〜2.5・ポケット X 12〜20 / 66〜74）は
  JST のプラグ（下端 7.45）より下なので、爪の再設計にも当たらない。
- 完成後に L のハウジング 2 本を抜くには天面を外す（天井に掛かる）。水平の 2 本はハッチだけで済む。

### スタディ①のやり直し（2026-08-24・ユーザー「v4 はなんで作ったんだっけ」を受けて）

🔴 **スタディ①は探索が狭かった。**前提（§1）で白紙のはずのハブの前後位置・電池・トグルを v3 の位置のまま障害物に入れて
PB の席を「残り物」から探していた。v4 の看板（面倒なピースが先・他が従う）と逆。やり直しの結果:

- **場所と姿勢の結論は C のままだった。** ハブが床の平置きしか無く（52 角＋床 62 深で、床にはハブ 1 枚しか置けない）、
  電池の口が 🔒 左、天井が 48.454 で固定の以上、PB の立てる場所は後ろの帯が構造的にほぼ唯一。消去法ではなく構造で決まる。
- 🔴 **撤回: 「下の余り 1.1 ＝ハブの口の頭との隙間」は誤読だった。**PB の水平ハウジング（X 51.8〜55）の真下に後列の口は無い
  （INA は X 48.9 まで・TOGGLE は 59.1 から。§2 の「口の頭 16.6 の上」は帯の一般値の注記で、接触ではない）。
  下で本当に効くのはハブの実装の高さ（⚠ 15.1 規格読み）。
- **Z は窓の上端に居ただけだった。**固定物だけを相手に上縁 Z を走査（`_v4_asm.scad` W="pbz"/"pbzh"）すると窓は **[32, 34.5]**
  （35 で天井・31 でハブの実装に触れる）。スタディ①の 34.5 は「上から下げて最初の 0」＝窓の上端。
  ⚠ **仮決め: 上縁 Z = 33（窓の中央）**。余裕は 天井 1.85・ハブ実装 約1.5・電池の膜 2.6・JST〜爪 2.95 になる。
- Z=33 で軌跡検査を全部回し直し: `chk`/`seat`/`hup`/`husb`/`top`/`bat`/`xpull` **0**。`batf` の 470mm³ は**素の左壁と電池の抜き道の重なり**
  ＝蓋の開口を彫る分（Type-C の 18mm³ と同類・v3 の蓋 🔒 を引き継ぐ場所）。
- 窓をさらに広げる実弾は ⬜ 実測 2 件（§6: 曲がり込み 3.6・ハブ実装の最高点）と、🔒 を解くなら外径 Z の +α（ユーザー判断）。

### ⬜ 決めること（ユーザー）

- 🔴 **2026-08-25 この ⬜ は流れた。** PowerBoost は電池の上の傾いた板へ移り（§10 の ✅③・§12・§13）、背面立ては模型から外れた。
  以下は 8/24 時点の記述で、いまの形ではない。
- ⬜ **C（背面に立てる・上縁 Z 33）で行くか。** やり直しの結論として、これは消去法ではなく
  「ハブ床置き・電池左・外径固定」の下で構造的に唯一の帯。承認するかはユーザー。
- ⬜ 板を何が持つか（C）。後ろの帯の床と右の壁が近い。機構はユーザー案を検査する。
- ~~⬜ ReSpeaker を 1.5 後ろへ送る件（OLED のフィルム・[TODO.md](TODO.md) の「筐体 — 残作業」）。C は無関係（板は Y 68.7〜）。~~
  → ✅ **2026-08-26 に消えた。**当たりの数字はフィルムが裏一面に 3.9 膨らむと置いていた頃のもの。模型は 2026-08-24 に直っており、測り直すと 0mm³（[CASE-V4-OPEN.md](CASE-V4-OPEN.md) の済んだもの）。

## 3. スタディ②: 魚の開きを立体に畳む（2026-08-24・[_v4_asm.scad](../hardware/frozen/v1-v4/_v4_asm.scad)）

魚の開き（[_v4_sakana.scad](../hardware/frozen/v1-v4/_v4_sakana.scad)）は**口の役割の正**（実配線・入れ替え済み）。それを v3 の外径に立体で畳んだ。
座標の正は v3 の固定値（ハブ・ReSpeaker・OLED・天板の部品群・トグル・電池）＋ スタディ①の **C 案**（⬜ 裁可待ちのまま、生き残りを前提に通した）。
絵: [_v4_asm_iso.png](../hardware/frozen/v1-v4/_v4_asm_iso.png)（前右上）/ [_v4_asm_back.png](../hardware/frozen/v1-v4/_v4_asm_back.png)（後左上）/ [_v4_asm_top.png](../hardware/frozen/v1-v4/_v4_asm_top.png)（真上）。

新しく当てた 2 つ（検査は全部 `--backend=manifold`。相手＝自分以外の全部）:

- ~~**INA226 は v3 の位置のまま成立**~~ 🔴 **この 0 は AS5600 のコネクタを置く前の値だった。**④⑤の駅（§4）で
  コネクタ（直立て）と 38mm³ 衝突し、**X=24 へ移動（⚠仮決め）**。以下は当時の記録:
  （板 X 48〜75・Y 29.45〜49.55・Z 21.6〜23.2・部品面を下に吊る姿勢）。
  🔒 2 モデル（2026-08-24 ユーザー「設置したらどっちかに当てはまるように 2 モデル作って置く」）**どちらも当たり 0**:
  L 字横出し（線は −X へ・頭 X 36.4 まで）も、直立て（線は下へ・ハウジングの下端 Z 5.5・ハブの板の上面 4.1 まで 1.4）も入る。
  切替は `ina226_module(ra =)`（parts.scad に引数を追加）・検査は `-D INA_RA=`。
  ⚠ 静的のみ。留め（v3 はブリッジの座の柱だった）と挿す軌跡は v4 の機構待ち（⬜ ユーザー）。⚠ 現物のピン並びは着荷（8/21〜29）待ちのまま。
- **Type-C 基板（🔒 左の壁・後ろ下 CHG_C_LW）も成立**。部品どうしは 0。素の壁と **18mm³** 重なるのは設計どおりで、
  v3 の溝（板の縁が 0.9 入る `tcb_slot_cut`）と口の開口（`left_wall_port_cut`）を **v4 の左の壁にも彫る**分（比較: v3 の `chk_tcb` は 27mm³）。
  ⚠ 基板は未注文・未実測のまま。

電池の座＋左へ抜く道 ↔ 新入り 2 つ（INA226・Type-C）: **0**。

これで開きに載っている部品は全部置けた（つまみ・会話ボタン・スピーカー・トグルは天板/ハッチの v3 座標のまま）。
残るのは形（§4 末尾の差分 ①〜⑦）と線 13 本で、どちらも置き場ではなく作図の工程。

## 4. v4 の組む姿勢（2026-08-24・v3 の①〜⑬からの導出。発明ではない）

> 🔴 **2026-08-24 この章は作り直し（ユーザー「やり直しというのは、組み立て手順を変える所から」）。**
> この章は v3 の①〜⑬の写しに [変] を貼った物で、PowerBoost が相変わらず⑨′＝終盤に入る。冒頭の 🔒（置く順番:
> **PowerBoost＋挿す手 → 電池＋工具なし交換 → ReSpeaker/OLED/フィルム → ハブ → つまみ**）と矛盾していた。
> 手順が設計変数・形が従属変数。スタディ①①′の座標は「v3 の手順の下での解」なので、新しい手順が決まったら全部当て直す。
> ⬜ **新しい①〜⑬の原文はユーザー**（v3 と同じ分担: 原文ユーザー・精緻化と検査は AI）。以下は旧手順の記録として残す。

🔒 背骨は [CASE-V3.md](CASE-V3.md) §2 の①〜⑬（3 回目にユーザーが伝えた組み方）そのまま。
C（PowerBoost 背面立て）で変わる箇所だけ **[変]** を付ける。各ステップは「何を置き・何を持ち・口がどこを向き・最後に載る物は何か」の文で書く。

1. **まな板を作る**（変更なし）: 床にハブを M3×4 で留める。頭は床裏のザグリ・ナットは上。
2. **ReSpeaker を溝に立てる**（変更なし）: ビス無し。⑫で天面のリブが 0.3 押さえる。**[変]** 天面の前リブは OLED の線の真上（X 39.1〜45.1）から外す。
3. **ReSpeaker と OLED をハブに配線**（変更なし）: XIAO 7 本は積み重ねの頭（Y 23.9 まで）の DuPont、OLED は上辺の裏のヘッダへ。上が開いているので挿せる。
4. **天面に OLED を留める**（変更なし）: L で受けて前から M2。
5. **天面側の配線**（変更なし）: AS5600・BTN2・REED・PHOUT。
6. **側面構造体を手元で組む** **[変]**: 左壁・ブリッジ・右壁・電池トンネル・INA226 — **PowerBoost はここに居ない**。右壁のダボ・後ろの L・座の切り欠き（KNOB_TRIM）は不要になる。INA226 は v3 の位置（ブリッジの下）が C でも空いているか検査して決める（2 モデルで当てる）。
7. **充電**: 🔒 Type-C 基板（秋月 115426）は左壁後ろ下。PowerBoost の USB パッドへの 2 本は、PB 側は 8 ピン列の USB（水平ハウジング）なので**⑨' の前に PB へ挿す**。
8. **電池と INA226 と PB の電池線**: 電池 JST → INA INPUT → OUT → PB の JST。**[変]** PB の JST は下向きなので、**PB を降ろす前に手元で挿す**（`seat` 検査がこの姿勢）。
9. **側面構造体をまな板へ Z で降ろす**（変更なし・線 10 本は全部挿してから）。
9'. **[変] PowerBoost を後ろの隙間へ上から降ろす**: JST（下向き）・USB と PWR の水平ハウジング 2 本を挿した単位で、右壁の際（右端 X 84.3・裏がハッチ側・上縁 Z 34.5）へ。L の 2 本（GND/EN）は降ろした後で上から挿せる（`hup` 0）。⬜ 支え: v3 で🔒だったダボ＋唇＋フックの型をこの向きに移す（形はユーザー検収）。
10. **PWR の線**: PB の 4 ピン → ハブ PWR。ハブ側は③〜⑤で挿し済み。
11. **トグル**（変更なし）: ハッチに外ナット。
12. **天面を降ろし、フロントを差す**（変更なし。`top` 0）。
13. **ハッチを閉じる**（変更なし）: 下は爪・上はトグルのナット。**[変]** PB の裏の足とハッチ内面 0.5 は静止で 0（閉じる軌跡も 0）。

**v3 → v4 の形の差分**: ①右壁: XIAO USB-C の口を Y −5.3 直す ②天面: 前リブの X を OLED の線の外へ ③右壁まわり: PB のダボ・L・フック・KNOB_TRIM を撤去し、9' の支えを付ける ④ハブの口の柱・座を頭 20.2 で再検査 ⑤INA226 と Type-C の座を 2 モデル/実測で当て直す ⑥線 13 本を引き直す ⑦ビスと工具の道・組む動きの検査。
🔴 この番号の順で消化しない（それが v2 の再演・§6）。**①〜⑬の組む順を歩きながら、そのステップに属する差分をその場で**。
- ✅ **差分④は消化した**（2026-08-24・[_v4_asm.scad](../hardware/frozen/v1-v4/_v4_asm.scad) `mana`/`mana2`/`manain`）: まな板の①〜③を現行模型で当て直し、
  床の形（柱・土手・リブ）↔ 挿した線 17 本（ハブの頭 20.2・XIAO の頭 23.9）・ハブの線 ↔ ReSpeaker・上から挿す軌跡（+30）**すべて 0**。
  ⚠ 探針に親基板は入れない（樹脂は挿さる相手と重なるのが正。検査するのは他人との当たりだけ）。
- **差分②の材料が出た**（2026-08-24・[_v4_asm.scad](../hardware/frozen/v1-v4/_v4_asm.scad) `rib*`・絵 [_v4_rib_band.png](../hardware/frozen/v1-v4/_v4_rib_band.png)）:
  前リブ（幅 6・Y 7.7〜10.5・Z 36.2〜天井）を全幅 X 2〜84 に伸ばして相手ごとに当てた。塞がりは
  **OLED の線 X 37.9〜48.1**（v3 のリブ 39.1〜45.1 はこの中）と**フロントの耳 X 〜6.25 / 79.75〜** だけ。
  スピーカー・つまみの島・タクトは 0。ReSpeaker 自身とは押し代 0.3 の分だけ重なる（正）。
  ⇒ **空きは X 6.25〜37.9 と X 48.1〜79.75**（右の腕 69.5〜74.2 は従来どおり別部品で残る）。
  ⚠ **仮決め: 前リブは X 31.4〜37.4**（v3 から −7.7）。物差しは「押さえは板の中央に近いほど良い」＋「線から 0.5 逃がす」の 2 つで、
  両方を満たす最良はここ 1 か所。2026-08-24 ユーザー「どう判断していいか分からない」→ AI の推薦を仮採用（変数 1 個なのでいつでも動かせる）。
- **④⑤の駅: AS5600 のコネクタ × INA226 の連立**（2026-08-24・[_v4_asm.scad](../hardware/frozen/v1-v4/_v4_asm.scad) `asc`/`ascw`/`inam`）:
  コネクタ探針（ピン単位・knob_v5 の位置・裏面 Z 31.25）を **4 回転 × 2 形**で箱の全部に当てた内訳（mm³）:

  | 取付回転 R | 直立て | L 字横出し |
  |---|---|---|
  | 0 | INA226 **38** | 電池 **77** |
  | 90 | INA226 31 ＋ XIAO の線 21 ＋ 天板 2 | XIAO の線 14 ＋ 天板 2 |
  | 180 | INA226 **39** | 電池 **103** |
  | 270 | INA226 21 ＋ XIAO の線 35 ＋ 天板 2 | XIAO の線 22 ＋ 天板 2 |

  つまみの島・柱・ハブの口とは**全通り 0**。🔒 の固定物（XIAO の線・電池）に当たる通りは救えないので、
  **筋は「直立て × R0 か R180」**（直立て＝はんだ済みの実機の姿）。残る相手は INA226 だけで、INA の位置は元々未 🔒 の宿題。
  ⇒ **INA226 を X 走査**（姿勢・Y・Z は v3 のまま・相手にコネクタ込み）: 空きは**左端 X 22〜28 だけ**
  （v3 の 48 は 38・X 30〜46 は 15〜22・X 6〜10 は 52〜65・X 14〜20 は 0〜2 の際）→ ⚠ **仮決め X=24**（帯の中央）。
  移動後の再検算: コネクタ 0（端数の殻のみ）・電池の道 0・Type-C 変わらず 18（壁の溝の分）。
  ✅ **取付回転は R0（コネクタの列が手前）に決めた**（2026-08-26）。当たりは R0 / R180 とも 0 なので、決めたのは線の向きの都合: 座の板の欠き ③ は手前側にしか切っていないし、線の道（⑩）も島の下を `Y 36.8` へ渡って手前で受ける。ゼロ点はソフト（`knobzero` → NVS）なので、面内の 180° は角度の一定オフセットにしかならず、回る向きも変わらない（[CASE-V4-OPEN.md](CASE-V4-OPEN.md) の済んだもの）。
  ⚠ 90/270 の天板 2mm³ は座の板の縁。R0/180 では出ないので追わない。

## 5. 挿さる物の台帳（2026-08-24）

🔴 **v3 の敗因も、A 案が一度「全部 0」で通った件も、模型が塊のまま検査を回したこと。**
「0」は模型の細かさまでしか意味を持たない。**塊のまま当てた検査は、報告に「塊」と書く。**
挿さる界面ごとの現在地:

| 界面 | 模型 | 状態 |
|---|---|---|
| PowerBoost（SMD・L/直ヘッダ・4 ピン・JST・ハウジング・軌跡） | parts.scad ＋ [_v4_pb.scad](../hardware/frozen/v1-v4/_v4_pb.scad) | ✅ .brd ＋ 実測（v3 で精緻化済み） |
| ハブの口 10 個（ヘッダ樹脂＋ハウジング＋曲がり込み） | case_v3 `housing(id)` | ✅ 2026-08-24 に +2.5 を直した。⚠ 樹脂 2.5 は規格値・ハブの最高点の実測は ⬜（[POWER.md](POWER.md) も未取得） |
| ReSpeaker J2 ＋ PH2.0 プラグ | 包絡「面から 15」 | ✅ 実測系の値。⬜ プラグの尻の実測で詰められる |
| ReSpeaker XIAO の積み重ね（直付け XIAO・シールド缶・ヘッダ・ピン 14 本） | `respeaker_xiao_stack()` | ✅ 2026-08-24 構成確定（ユーザー写真）。ピンの先端 9.9 ≈ ✅実測 10。⚠ はんだ 0.2・板厚 1.2 は規格読み |
| ReSpeaker XIAO の線 7 個（使うピンだけに DuPont・線の逃げ付き） | `respeaker_xiao_housings()` | ✅ 頭は面から 13.9（Y 23.9）。`xh` 0・`xpull` 0。⚠ 電源側がどちらの列かは未確認（当たりに効かない） |
| XIAO USB-C の殻と口 | `xiao_usb_yz()` | 🔴 2026-08-24 訂正: 殻は XIAO の板の上（面から 1.4〜4.66）。**v2/v3 の壁の口は約 5.3 奥**。v4 はこの値で描く |
| OLED の I2C ヘッダ（直・4 ピン）＋線（4 連 DuPont） | `oled_i2c_header()` / `oled_i2c_housing()` | ✅ 2026-08-24 ユーザーが写真を再提供（裏面＋定規を穴の線に当てた 2 枚）して模型化。**上辺の裏・中央（✅定規写真・±1）**・樹脂は裏面に座りピンは裏面の法線へ。ピンの露出は ✅寄り 6.5（ヘッダ単体の定規写真・±1）。⚠ 縁からの距離 1.6 は写真読み。並びは正面から SDA・SCL・VDD・GND。✅ 四隅の穴も確定（2026-08-24 ユーザー実測＋裁定）: φ3.0・中心はどの端からも 2.0・穴間 66.1 × 44.1・板幅 70.1。旧「67×43・φ2.8」は破棄。✅ 下辺の切り欠き（幅 23・⚠深さ 7 写真読み）を外形から切り、フィルムは「ガラスの尻 → 切り欠きの中 → 裏 → FPC コネクタ」の一続きに直した（外せる接続点はコネクタ側だけ） |
| INA226（L ヘッダ＋ハウジング） | parts.scad | ⚠ 現物のピン並びは着荷（8/21〜29）待ち |
| AS5600 のコネクタ | ピン単位の 2 列（parts.scad `as5600()`） | ✅ 2026-08-24 ユーザーが商品画像（寸法矢印付き）を再提供して模型化。**左右の対の縁に 3 本（VCC/OUT/GND）＋ 4 本（DIR/SCL/SDA/PGO）**・2.54 ピッチ・列は穴の間・ヘッダは平らな面＝裏・挿すのは 5 本（1 本ずつバラす・裸は OUT と PGO）。鎖は 樹脂 2.5 ＋ DuPont 10（✅実測）＋ 逃げ 3.6 ＝ 裏面から 16.1。⚠ 縁から列中心 2.3・列中心＝板中央は画像読み。✅ 取付回転は **R0**（コネクタの列が手前・2026-08-26 決定・§4 の④⑤）。🔒 **個体は 2 つ・1 つは未はんだ**（2026-08-24 ユーザー）⇒ ヘッダの形は置き場の従属変数（INA226 と同じ）。`as5600(ra =)` の 2 モデル（直立て＝はんだ済みの個体の姿・L 字横出し＝深さ約 4 で縁の外へ約 15）を持ち、スタディが場所と一緒に形を出す。🔴 元の「位置未取得」は docs（[KNOB-ENCODER.md](KNOB-ENCODER.md) 8/1）を掘らずに書いた行だった（ユーザー指摘） |
| Type-C 基板（秋月 115426） | 図面由来 | ⚠ **2026-09-09 に着荷（ユーザー・抵抗 5.1kΩ も一緒）。模型はまだ図面のまま**（板 20 × 15 × 1.6・口が縁から出る量 0.8 は図に無いので仮） |
| トグル MTS-102 | 実測 13 × 8 | ✅ |

## 6. まだ無いもの

🔴 **進め方は §4 の組む順（①〜⑬）が背骨**（2026-08-24 ユーザー指摘）。当初ここに
「形の差分 → 線 13 本 → 最後にビスと工具の道・組む動きの全検査」と書いたが、それは **v2 の再演**
（置いて・引いて・当たり 0 を通して、組む手順を最後に確かめた順）なので捨てた。

- 形（.scad）: §4 の①から順に歩き、そのステップに要る板と留めを描いたら、**その場でそのステップの動きの検査**
  （降ろす・挿す・抜く軌跡・ビスと工具の道）まで回してから次のステップへ。v3→v4 の差分①〜⑦は
  §4 の何番に属するかで並べ直して消化する（例: 右壁の XIAO の口は⑥⑨、天面の前リブは⑫）。
- 線 13 本は、線が要るステップ（③⑤⑦⑧⑩）の中で引く。開きの灰色の点＝平面図でだけ重なる点は、
  この工程で高さと道順を割り付けて 0 にする。
- AS5600 のコネクタは ✅ **ピン単位・2 モデルで模型化済み**（台帳・商品画像 2026-08-24。直立て／L 字は `as5600(ra =)`）。
  取付回転は **R0** に決まった（2026-08-26・§4 の④⑤）。残るのはヘッダの形で、これは未取得ではなく設計の自由度（🔒 個体は 2 つ・1 つ未はんだなので L 字も選べる）。
- スタディ①②の静的 0 は**置き場の値**。組めるかどうかは各ステップの動きの検査が言う（「当たらない」は「組める」ではない）。
- ⬜ **刷る前の実測 2 件**（→ §7 の後も生きている）（2026-08-24 ユーザーが CAD で「ギリギリ」を指摘した 2 か所は、どちらも ⚠ の上の余りだった）:
  1. **ハブの後列に線を挿した状態の「基板の上面 → 線の頭」**。C 案の下の余り 1.1 の根拠 16.6 は規格の積み上げ（樹脂 2.5 ⚠）。
  2. **DuPont の線を真横に倒したときの「ハウジングの頭からの膨らみ」**。L の頭 ↔ 天井 0.35 の根拠 3.6 は既定値（⚠）。
  どちらかが実測で大きければ、C 案の Z か電池の膜の側を動かして窓を作り直す。

## 7. 芯から作り直す（2026-08-24 ユーザー決定）

🔴 **ループの根の記録**: スタディ①も §4 も、最初の一手が「v3 座標の固定物一式を箱に読み込む」だった。
その瞬間に PowerBoost は（看板に何と書いてあっても）残り物の席を探す部品になる。置く順番は文書の言葉ではなく
**scad ファイルに部品を書き足す順番**で決まる。決意を繰り返しても同じ場所に戻ったのはこのため。

🔒 ユーザーの決定（原文の要旨）:

- **固定は OLED・ReSpeaker・ハブ基板だけ。位置関係として、天面につまみ（AS5600）・会話ボタン（タクトスイッチ）・スピーカー。多分これは変わらない。**
- **他は位置もサイズも全部フリー**（＝ §1 の外径 🔒 を解除。v3 の 90 × 76 × 52.95 は比較対象）。
- **まず固定群だけの機体（芯）を作る。組み立て順も、これらを置いてから**（自由な部品は芯に一つずつ足し、足すたびに当てる。外皮は最後に部品へ合わせて描く従属変数）。

芯: [_v4_core.scad](../hardware/frozen/v1-v4/_v4_core.scad)（2026-08-24 作成。座標は 🔒 の v3 値・挿さる物はピン/ハウジング/逃げ込みの模型のまま）。
絵は [_v4_core_iso.png](../hardware/frozen/v1-v4/_v4_core_iso.png)（前右上）/ [_v4_core_back.png](../hardware/frozen/v1-v4/_v4_core_back.png)（後左上・v3 外皮の影付き）。

**芯の bbox（manifold・当たり 0 で export）: X 0.4〜85.6・Y 0〜63.9・Z 0〜56.5**（Z はつまみの頭込み。天面の内側までは 48.454）。
v3 内寸（86 × 72 × 48.454）と比べると、**空いているのは主に後ろの帯 Y 63.9〜72（奥行 8.1）**。
X はほぼ満席（0.4〜85.6）。自由な部品（PowerBoost・電池・INA226・Type-C・トグル）が後ろの帯に収まらなければ、皮が Y か Z へ育つ。

- ⬜ **自由な部品を芯へ足す順はユーザー**（冒頭の旧 🔒 を素直に読めば PowerBoost が先頭だが、決めるのはユーザー）。
- ⬜ 芯を先に組む場合、天面一式が先に載る＝自由な部品は「天面が載った芯」へ後から入れることになる。挿す軌跡の検査はその姿勢で回す。

### ハブの X 位置

🔒 **2026-08-25 ユーザー指示: 中継基板（ハブ）は X 中央。** `HUB_DX = 0`・ハブは **X 6.0〜80.0**。口と挿した線も一体で動く。
（8/24 の「ReSpeaker の左端に揃える」はユーザー指示で削除。経緯は git 履歴にだけ残る。）

## 8. 電池の置き方（2026-08-25 ユーザー指示）

🔒 ユーザー指示の原文: **「バッテリーを立てて、背面に下に来るようにしてから以下の位置に置いてください」**＋注釈付きスクショ
（背面からの view に青い枠。「バッテリーのケーブルは下から出る」）。位置の正はこのスクショ（チャットのみ）。

- ⚠ 画像読みの補足: 青い枠は**ハブ基板の上・つまみと反対側の端**（板の X 低い側の縁・背面 view では右に見える）。
  細長い縦帯＝薄い面（厚み 6）が縁を向く立て方。縦（長辺 50 を上）は天井 48.454 を超えるので、高さは幅 35 の側。
- `bat_v4()`（[_v4_core.scad](../hardware/frozen/v1-v4/_v4_core.scad)）は 2026-08-25 にこの位置へ直した
  （X 10.024〜16.024・Y は板の中央 12.9〜62.9・Z 4.1〜39.1）。⚠ Y と「縁との詰め」は AI の仮置き・ユーザー検収待ち。
- 🔴 経緯: 担当 AI 3 代がこの指示を取り違えた（1 代目: 基板の外に縦置き。2 代目: 原文を見ずに「横倒し」と復唱。
  3 代目: 位置を「右端・右壁」と**ユーザーが言っていない言葉で記録し、つまみ側の端＝逆の端に置いた**。
  メモリ restate-only-what-you-saw / no-invented-decisions）。
- ⬜ 電池の帯と J2 プラグ空間（X 5.1〜12.1・Z 15.5〜23.5）は X で約 2 重なる。当たり検査と置き詰めはユーザー検収の後。
- 🔒 2026-08-25 **電池はタブ（ケーブル）の端を後ろ＝ハッチ側に向けて置く**（ユーザー「繋ぎやすい方で」→ AI 選定・理由: 前の端は
  電池ガードの真後ろで塞がり、後ろの端は縦穴 Y 62.9〜72 に全開。電池線の模型もこの向き）。
- ✅ 2026-08-25 ユーザー実測（実物のハブ基板）: **板の端 → 手前のヘッダ（BTN2）は 5〜6mm**（読み 6・誤差込み）。
  模型のヘッダは端から 5.5・挿した線の頭は 4.7 で、実測の幅の中＝**穴の位置は合っていた**。
  検査で出た重なり 58mm³（横 1.3 × 奥行 4.5・相手は BTN2 の線）は、電池を全長まるごと厚み 6 の板で描いた模型の粗さ。
  **実物の電池は封止の端が約 5mm**（ユーザー実測・テーパー）なので、実物どうしなら入る（きつめ）。🔒 電池の模型は 6 のまま使う（2026-08-25 ユーザー「6mm でいいよ」。テーパーは描かない）。

## 9. 配線（2026-08-25〜）

ネットの正は [_v4_sakana.scad](../hardware/frozen/v1-v4/_v4_sakana.scad)（開き・口の役割の入れ替え済み）と [relay_board.html](../hardware/parts/relay_board.html)。
**接点の世界座標は手で写さない**: `openscad --backend=manifold -o /tmp/x.stl -D "W=\"pts\"" hardware/frozen/v1-v4/_v4_core.scad` が
echo で吐く（PB の L ピン・JST プラグ・INA の口・ハブ PWR・電池タブ・通り道。2026-08-25 ユーザー「接点の座標を残しておけば」）。
模型は [_v4_core.scad](../hardware/frozen/v1-v4/_v4_core.scad) の `wires_pwr()`（1.5 角の箱・直角のみ）。通り道は 4 本:
**左の溝**（X 5.4〜13）・**右の溝**（X 53〜80）・**後ろの縦穴**（Y 62.9〜72）・**帯の上の棚**（Z 31.4〜43）。

### ✅ 引いた（電源系 7 本・当たり 0）

| 線 | 出発 → 到着 | 道 |
|---|---|---|
| 5V・GND・EN の 3 本 | PB の L 字 3 ピン（🔒 5Vo=1 番・GND=4 番・EN=5 番・POWER.md シルク実読）→ ハブ PWR の口 | 後ろの縦穴を降りる |
| 電池線 2 本 | 電池のタブ（🔒 後ろの端）→ INA226 の INPUT の口（L 字・✅商品画像実測 y 3.6〜16.4） | 縦穴 → 左の壁ぎわ X 2〜3.5 |
| 電池線の続き 2 本 | INA226 の OUT の口 → PB の JST プラグ | 左の壁ぎわ → 棚の上を右へ |

### ✅ 引いた（残り 10 束・2026-08-25。当たり検査は下の「検査」）

模型は `wires_sig()`（束ごとに `w_*()`）。絵は [_v4_wires_iso.png](../hardware/frozen/v1-v4/_v4_wires_iso.png)（前右上）/
[_v4_wires_back.png](../hardware/frozen/v1-v4/_v4_wires_back.png)（後左上）。経路の数字は .scad のコメントが正（ここに写さない）。

| 束 | 本数 | 通した道（計画からの変更は 🔴） |
|---|---|---|
| XIAO | 7 | 🔴 皿の下の低い車線ではなく **Z 19 の車線**（下記）→ 右の溝 X 55.35 → 上段は島の下の帯から、下段は X 73 で Z 11.9 へ下りて後ろから |
| OLED | 4 | Z 19 → 左の溝 X 9 を上がる → 前を Z 45.2 で右へ（INA の電源の口の頭 41.0 と電池線の上）→ 線の帯 X 37.9〜48.1 |
| つまみ（AS5600） | 5 | Z 19 → X 59.5 で Z 13.3 へ → 島の下 Y 36.8 を横断し 2 列の真下で終端（⬜ 取付回転 R0 のまま） |
| スピーカー IN | 2 | J2 の確保空間の後ろの面から Z 19.6 / 18.0 の 2 段でそのまま右へ（🔴 前の床は 幅広部品〜脚〜ハブ前縁の隙間が 1.5 未満で通らない）|
| スピーカー OUT | 2 | 🔴 口（Y 55.87）は**帯の下**だった。Z 19.5 のまま帯の前 Y 49.3 へ抜けて壁ぎわ X 83.5 を上がる → 天井の下 → スピーカーの下 Z 41.6 |
| INA226 の I2C | 4 | 🔴 3 回引き直し: ①ハッチの廊下 = **PWR 3 本の先客**（Y 70.2・Z 24〜28）②トグルの下 Z 38.3 = **PB の JST ソケット群**（X 36〜51.5・頭 41.8）→ ③縦穴 Y 68.1 → トグルの線の東 X 51.6 → Z 44.5 で前へ |
| トグル | 2 | 縦穴 → 胴の手前 Y 55.4 → 端子の真上（⚠ 使う 2 端子は中央＋片側と仮定） |
| リード | 2 | 縦穴 → デッキのパッド（Y ≤58.3・Z 41.95〜）の後ろで Z 41 へ潜り、v5 の縦の溝から下りる足の根元 [60.85 / 76.55, 54.95] へ。🔒 **コネクタ無しの直はんだ**（2026-08-25 ユーザー）。座は新設せず knob_v5 のポケットのまま |
| BTN2 | 2 | Z 19 で前へ（X 11.75）。🔴 途中 Y 24.2〜41.4 は **OLED の出口と PHIN の下 Z 15.9 をくぐる** → J2 ソケットと INA の口の間 Y 17.4 で上がる → タクトの足へ 🔒 **コネクタ無しの直はんだ**（2026-08-29 ユーザー「直ハンダで確定」）（⚠ −X 側の対と仮定） |
| 充電 | 2 | **VBUS**: 左の壁ぎわを Z 34.30 まで上がり、後ろの廊下の**いちばん下の車線**（4 車線の 1 本目）で右へ、`USB` の DuPont へ。上から降ろさないのは真上がマスタートグルの胴（Z 39.5〜47.5）だから。**GND**: 天井の下 Z 47.3 を右へ、トグルの外（X 18.96）で降ろして `5Vo` の隣の `GND` へ（🔒 2026-08-28 ユーザー決定） |

**検査（manifold・全部 0）**: `W="wchk" -D WP=束` = 束 ↔ 線以外の全部（10 束 0）・`W="wwchk"` = 束 ↔ 電源系＋他の束（10 束 0）。
🔴 wwchk の初版は difference で「他の束」を作っていて、**重なりの体積ごと引かれて検査が盲目**だった（0 厚の面で発覚・修正済み）。

**車線の発見（.scad のコメントにも記載）**: 前列の口からの主車線は **Z 19**（口の頭 16.6 の上・皿の裏 21.4 の下）。
「Z 15 以下」の低い層はジャンパの被覆線（頭 〜12.2）が居て通れる幅が無い。Z 11.9〜13.3 を使うのは XIAO 下段と
つまみコネクタの真下だけ。

⚠ きつい所（引いた後に残っている数字）: ①皿の裏 1.2・L ピン〜ハッチ 2.3（計画どおり）
②~~**PB の USB ピンの DuPont の逃げの頭 49.2 が v3 天井 48.454 を 0.75 超える**~~
　→ ✅ 2026-08-28 **根から解消**。原因は「USB だけ直ピン」で、その根拠（外向きの L 字は天井まで 0.3）は
　　 **v3 の壁立ての姿勢の数字**でした。v4 は板が寝ていて外向き＝水平に後ろなので、L 字に揃えると
　　 頭は 49.72 → ≈37.6（天井まで約 11mm）。§10 の天面の裏のポケットは**廃止**し、天面は 2.5mm に戻りました。
③I2C の通路 X 51.6 はトグルの線と 0.45・ヘッダの逃げと 0.27 ④XIAO 下段の回り込み X 73.0 は曲がり箱まで 0.11。

## 10. 外皮とボス（2026-08-25・[case_v4.scad](../hardware/frozen/v1-v4/case_v4.scad)）

> 🔒 スイッチは v3 と同じ **`part=` 一本**（2026-08-25 ユーザー「V3 と同じ part を。無駄な学習は嫌」で V/P4/W の混在を廃止）。
> 値の一覧は case_v4.scad の冒頭のコメントが正（絵 look/inside/explode・板 p_*・刷る向き print_*・静止 chk_*・
> 動き close_*・線 chk_wire*・電池 chk_shut_*/chk_swap）。芯だけのスタディは従来どおり _v4_core.scad の W。

芯＋自由な部品＋線 17 束に合わせて、皮 6 枚（床・左の壁・右の壁・天面・フロント・ハッチ）と
締結（ボス）を描いた。板の構造・丸みの持ち主・開口のベベル・継ぎ目 45°・貫通＋ナットは
[CASE-V3.md](CASE-V3.md) §4 の規則をそのまま引き継ぐ。フロントは OLED・ReSpeaker が 🔒 固定なので **v3 と同一**。
絵: [_v4_look_iso.png](../hardware/frozen/v1-v4/_v4_look_iso.png)（前右上）/ [_v4_look_back.png](../hardware/frozen/v1-v4/_v4_look_back.png)（後左上）/
[_v4_open_iso.png](../hardware/frozen/v1-v4/_v4_open_iso.png)（天面・フロント・右壁を外した中身）/ [_v4_explode.png](../hardware/frozen/v1-v4/_v4_explode.png)（分解・`V="explode"`）。

> 🔒 2026-08-25 ユーザー「v3 は不要になったのでは」→ **土台を分離**: v4 が使う寸法・座標・関数・共通モジュールだけを
> [case_base.scad](../hardware/frozen/v1-v4/case_base.scad) に写し（生成は [_make_base.py](../hardware/frozen/v1-v4/_make_base.py)・機構と part= の描画は除去）、
> [_v4_core.scad](../hardware/frozen/v1-v4/_v4_core.scad) の include を case_v3 → case_base に付け替えた。`part="none"` の細工は消えた。
> [case_v3.scad](../hardware/frozen/v1-v4/case_v3.scad) は履歴（単体では今も開ける）。**分離の前後で STL 8 個（板 6＋look＋core）の md5 が全一致**、検査一式も同値。
> ⚠ 内寸（IN_X/IN_Y/IN_Z）は v3 の機構の変数から導く式のまま base に残っている（値を変えるときは式ごと v4 の言葉に書き直す）。

### 締結（v3 の型のまま）

- **天面のビス 4 本**（M2）: 後ろは左右の壁の柱（7×7×9・ナット上入れ）、前はフロントの耳と壁の柱（`ear_col`）を 1 本で 3 枚締め。
- **床のビス 3 本**（M2×15）: 前の 2 本は v3 のまま。🔴 **後ろ右は v3 の [79, 65] のままだとハブ（+4 で Y 15.9〜67.9・柱 [77, 64.9]）に入る**
  → X 80.8〜86 へ寄せて幅 5.2 に（ナットは二面幅を X へ・壁 0.5 ⚠）。後ろ左は v3 で廃止済み（充電まわり）のまま。
- **ハッチ**: 下は爪 2 つ＋上はトグルの外ナット（v3 と同じ）。**ハブのビス 4 本**（M3）は +4 に追従。
- **尻尾**（トグルのレバーに被せる別刷り・`tail_cap`）は v3 のまま（形・角度 25°・アンテナ線の溝と、ハッチのスリットの対も同じ）。
  🔴 2026-08-25 皮を描いたとき持って来忘れ、土台の分離でも一度落とした（ユーザー「尻尾がない」で発覚）。
  いまは look/explode に出て、印刷は `V="part"` ＋ `P4="tail"`。

### v3 → v4 の形の差分の消化（§4 の①〜③）

- ✅ ① 右壁の XIAO USB-C の口（2026-08-25 描き直し済み）: 🔒 要件＝**口（殻の面 85.554）が彫り込みの床に顔を出す**。
  **式の付け替えとセットで解いた**（ユーザー「壁を動かして連鎖するなら、使ってる場所の計算がおかしい」）:
  - 部品の X を壁（IN_X）から測っていた誤用 6 式を、全検査済みの世界座標へ**凍結**（つまみ 65.704・ハブ 6.002・
    OLED 8.002・v3 遺産の PB 面・右の耳の内側の縁 79.352・knob_seat）。[_make_base.py](../hardware/frozen/v1-v4/_make_base.py) の FREEZE 表が正
  - **壁は殻から導く**: 内面 ＝ 殻の面 85.554 ＋ 0.15（`RIGHT_CL`）＝ 85.704。皮の板・ボス・耳の幅だけが壁に追従して動く
  - 彫りは v2/v3 の形そのまま（`right_wall_ports_cut` ＋ `xiao_pad` を土台へ復活）: 殻の鼻先は口の開口の中・
    モールドの座（床 86.504・🔒 v3「3 でいきましょう」の 0.95）・口は殻の大きさ・縁ベベル・印は口の右
  - 🔴 経緯（残す）: 初版は壁を v3 の位置（殻から 0.45）に置いたまま外から彫るだけの安い読みで口が 1.25 埋まり、
    「埋まりは物理・IN_X の大工事」という後付けの理由まで docs に書いた。両方誤り。⚠仮の「ポケット 16×11」も横長の読み違いだった
  - 検査: 全板 chk・軌跡（lwseat/rwseat/topseat/frontins/hatchcl）・線（wchk/wwchk/pwrchk）・入れ替え（swslide/swout/swpull）
    すべて再走して **0（押さえ 6mm³ のみ）**。凍結の照合: ハブ [6.002, 80.002]・つまみの島 bbox 不変・内寸 X 86.004 → **85.704**
  - 🔴 途中の発見 2 つ: 右の耳と柱が「壁から幅 6.652」で測られ OLED の L に 0.3 食い込む（→ 内側の縁を凍結・`ear_col` は実スパン幅に）。
    座の板のトグル線のノッチが横穴で、天面を降ろす軌跡で底の肉が線を通過（→ 下まで抜いて縦の通り道に）
  - 🔒 2026-08-25 意匠: すり鉢（床 → 外面の一枚斜面）＋ **井戸の縁にもベベル 0.4**（`rwall_port_cut4`）。
    🔴 ユーザー「XIAO の方が全然 2 段に見える」→ その通りで、**2 段は物理**: 井戸 0.95 ＝ 殻の上の皮 0.8 ＋ 隙間 0.15（消すと肉ゼロ）、
    床の平面 ＝ モールドの受けで、斜面にするとプラグの挿しが浅くなる方向にしか動かない。充電口が 1 段なのは鼻先が外面の 0.8 裏だから。
    やれるのは文法合わせだけ＝井戸の縁を充電口と同じ「ベベル＋口」にして入れ子に読ませる
- ✅ ② 天面の前リブは X 31.4〜37.4（⚠ 仮決めのまま）。🔴 **右の腕（v3 X 69.5〜74.2）は移動後のスピーカーの真下になった**
  → X 50.0〜54.7 へ（⚠ AI 仮: OLED の線の帯 48.1 とつまみの島 57.2 の隙間）。
  🔴 **ついでの発見: v3 は押さえリブを継ぎ目 45° の intersection の中に描いていて、リブの下端（Z 36.2〜40.8）が
  切り落とされ、押さえが ReSpeaker（頭 36.5）に届いていなかった**（v3 の `close_top` 18.6mm³ に押さえ分が無いのはこのため）。
  v4 は OLED の L と同じく継ぎ目の外に置いた。押し代 0.3 の重なり ≈6mm³ が検査に出るのが正。
- ✅ ③ PB の壁の機構（ダボ・唇・フック・KNOB_TRIM・棚）は描いていない（PB は電池の上）。

### 新しく描いた所（v3 に無いもの）

- 🔒 **左壁も右と同じだけ寄せた**（2026-08-25 ユーザー「論理的には右と同じだけ詰められる筈」）: 内面 ＝ ReSpeaker の
  板の左端 2.024 − 0.33 ＝ **LW_X 1.694**（case_base）。皮の左端・耳・ボス・Type-C 基板・壁ぎわの車線 4 本が追従。
  箱の外幅は 90（v3）→ **86.66**。左右の振れ止めリブは壁が務めるので廃止。
  - 🔴 **初出の発見: 左壁は ReSpeaker のイヤホンジャック（J1）の口を塞いでいた**（ユーザー「口も塞いでるわｗｗ」）。
    壁が寄った結果、筒の先（X 0.424）が外面の 0.73 裏に来て **1 段の口が開けられる**ようになった → 開けた。
    🔴 最初は模型の角箱の包絡で「大穴」を開けてしまい、ユーザー「どこがイヤホンジャックの穴じゃ。モデルが間違ってる。
    CAD が公開されてるのに」→ **公式 STEP（Downloads/ReSpeakerLitev1.1.step）から J1 を実体で取り直した**:
    筒は**丸 φ5.45**（穴 φ3.6）・軸 世界 [Y 12.52, Z 9.00]・+Y 側に金属カバー（0.68 張り出し）。
    模型（respeaker_lite.scad）も丸筒＋カバー＋CAD 寸法の胴に描き直し、**口は丸 φ6.05＋ベベルの 1 段**になった。
  - 🔒 **ReSpeaker 自身の USB-C（USB1）**（左端・殻 8.94×3.16・Y 10.27〜13.43・Z 25.79〜34.73・張り出し 0.86・📄 STEP）
    はユーザー「出さなくていい」→ 壁の内側の**盲ポケット**（降ろす溝と一体・外からは見えない）。
    ⚠ XIAO の USB の殻は XIAO の STEP が手元に無く規格値の箱のまま（⬜ Seeed の XIAO ESP32-S3 の CAD で照合）。
  - 🔒 **つまみとスピーカーを内側へ**（2026-08-25 ユーザー「少しだけ内側へ。当たりは出るかもしれないが解決するしかない」）:
    +3 → **+1.5**（⚠ 量は仮）。出た当たり 3 件を潰した: INA226 をさらに −1.5（I2C の角と座の壁）・
    座のトグル線のノッチを板の新しい左端まで拡張・INA の I2C の前走りを 1.5×2 本に割って
    「ソケット群（〜51.5）と降りる島（53.7〜）の谷」を通した（線の端点は全部追従）。
  - 🔒 `inside` は**壁・床・天井なし**（フロントとハッチと中身だけ）に修正（ユーザー「v3 から壊れてた」）。
  - 🔒 **後ろの床ビス（2026-08-25 確定）: 右は復活・左は無し＝v3 と同じ 3 本構成**。
    右は真っ直ぐな柱の幅が無いので **L 形**（X 77.4〜84.354 からハブの柱の角を欠く・ナット [82.0, 69.5]・
    ⚠ ナットの六角の角が欠き側に小さく開くが二面幅より狭く抜けない）。
    左はユーザー「無いとバラける」→ 復活を試みた経緯: 充電基板を +11.5 上げて角を空ける → 上げた板がブリッジの帯
    （Z 21.4〜23.4）を横切る → 帯の左端を欠いたら 🔒「ブリッジ切り抜いちゃだめ」→ 帯を跨ぐには板を帯の上
    （口 Z≈33.5・トグルの下）まで上げるしかない → ユーザー「まぁいいか」で見送り。充電口は Z 10.5 のまま。
    後ろの床は右のビス＋ハッチの爪 2 つ＋トグルの外ナットが持つ。

- **充電口はハッチ**（🔒 2026-08-25 ③案で更新）: **基板の鼻先をハッチの厚みの中へ 1.2 進め、口の面を外面の 0.8 裏に**。
  プラグが面まで届くのでポケットは不要になり、**口（殻の大きさ）＋ベベルだけ**——右壁の XIAO の口と同じ顔。
  基板の縁（板 1.6）が内面に 0.4 入る分は内面側の逃げ溝 0.7（見えない）。充電線の始点と床の振れ止めリブは +1.2 追従。
  🔴 経緯: 初版（内面に鼻先＋局所薄肉のポケット）は輪郭 3 重で角の丸みに食い込む顔だった（ユーザー「変」→ 3 案比較
  [_v4_chg_now](../hardware/frozen/v1-v4/_v4_chg_now.png) / [_v4_chg_scoop](../hardware/frozen/v1-v4/_v4_chg_scoop.png) / [_v4_chg_flush](../hardware/frozen/v1-v4/_v4_chg_flush.png) → ③）。
  端のベベルの規則として記録: **縁から明確に離すか、縁まで開き切るか。中途半端に接するのが一番醜い。彫りで化粧する前に「口を顔出しさせて彫り自体を消せないか」を先に問う。**
  印（稲妻）は口の左（+X。右は板の縁）。⚠ 鼻の出 0.8 は図面値・着荷実測待ち。
- **天面の裏の局所ポケット**（X 17.9〜22.9・Y 56.4〜61.4・深さ 1.27・残り 1.23 ⚠）: PB の USB 線の DuPont の逃げ（頭 49.2）用。
  🔴 充電線の終端は「逃げ箱の上を Z 50.05 まで跳ねる」経路で天井を 1.6 超えていた → 逃げ箱の手前 Y 56.3・Z 47.3 で止める形に引き直した。
- **つまみの座の欠き 3 つ**（v3 の KNOB_TRIM と同じ流儀）: スピーカー側 Y < 22.3（159mm³）・
  右壁側 X > 82.1 ＝ スピーカー OUT の線の通り道の手前（220mm³。🔴 束は幅 2.2 なので X 82.4 から始まる）・
  AS5600 コネクタの列の切り欠き（±0.3・2mm³）。
- **床**: 爪の帯の前縁を Y 66 → **68.4**（🔴 ハブ +4 の半田面の予約が 221mm³ 入っていた。バーとの隙間 0.1 ⚠）。
  ブリッジの脚の受け溝（±0.25・後ろの壁 0.45 ⚠）と Type-C 基板の前の振れ止めリブ（⚠ 高さ 3。
  🔴 壁に付けると壁を降ろす軌跡が壁ぎわの電池線を通過するので床に持たせた）。
- **芯側の直し**（このスタディで動かした）: 🔴 INA226 の I2C の角が座の壁に 6mm³ → `INA_DX` −1.5 → **−3.2**（線の端点も追従）。
  🔴 PB の 8 ピン列の足（板裏 1.0）が留め帯 C の天板に 1.02 刺さる → C の天板に逃げ溝（深さ 1.35・残り 0.65 ⚠）。
- **ブリッジと留め帯の面取り・フィレット**（🔒 2026-08-25 ユーザー「面をとりたい。90 度カーブの所には R を」）:
  稜を削るのではなく、**断面（2D）を丸めてから押し出す**作りに書き換えた（`_v4_core.scad` の `smooth2d` / `ext_ch` / `prism_x,y,z`）。
  面取りは「c だけ痩せた断面 ⊕ 錐」のミンコフスキ和で真の 45°（🔴 スライスの階段で近似したらガタガタになった。`roof()` は実験機能）。
  値: 面取り 0.5・出隅の角 R 0.5・入隅の R は脚の付け根 1.0（真下のハブの前縁 Y 15.9 でちょうど止まる）。
  **電池に面する入隅は 0.5**——レールと留め帯 ⊓ の内側は電池との隙間が X で 0.5 しか無く、そこに収めれば当たらない。
  ⚠ **前ガードの付け根だけ R なし**: 電池は Y も Z も隙間 0 で当たっていて、R を入れると電池を押す。
  🔴 **前ガードは皿と「線」でしか接していなかった**（ガード Y 11.9〜12.9・Z 23.4〜／皿 Y 12.9〜・Z 〜23.4 で、
  共有するのは Y 12.9 ∩ Z 23.4 の一本の稜だけ＝宙に浮いた壁）→ **皿を 1.0 だけ前（Y 11.9）へ出して面で受ける**。
  前面の位置は動かさないので ReSpeaker への隙間 0.18 はそのまま。検査は `brgchk` / `strapchk` / `batchk` / `chk_all` とも据え置き。

### 検査（manifold・2026-08-25。「押さえ 6mm³」は前リブ＋腕の押し代 0.3 ＝ 設計どおり）

| 検査 | 何を見るか | 結果 |
|---|---|---|
| `chk_床〜hatch`（板ごと）/ `chk_all` | 板 ↔ 中身＋線＋他の板（静止） | **押さえの 6mm³ だけ**（床・左右壁・フロント・ハッチは 0） |
| `close_lwall` / `close_rwall` | 壁を上から降ろす軌跡 | **0** |
| `close_top` | 天面（島・スピーカー・傘ごと）を降ろす軌跡 | **押さえの 6mm³ だけ** |
| `close_front` / `close_hatch` | フロントを前から差す / ハッチ（トグル・蓋込み）を閉じる | **0** |
| `wchk` 全束 / `wwchk` / `inachk` / `batchk` / `strapchk` / `strappb` / `brgchk` | 線と自由な部品の当て直し（INA 移動後） | **0** |
| `close_desk` | ブリッジを上から降ろす | 🔴 **OLED の線を挿した後だと 172mm³**（受け皿が線の帯 X 37.9〜48.1・Z 45〜48 を通過）。**ブリッジ → OLED → OLED の線 の順なら両方向 0**（`desk3`・`oledseat` で確認） |

⚠ この表は 2026-08-25 の**昼の時点**の値です。同日午後にフロント板・スピーカー・つまみを動かしたので、**現在の検査値は §12 の表**を見てください。

🔴 **組む順の制約が 1 つ出た: ブリッジは OLED を溝に立てる前に降ろす**（OLED が先だとヘッダのピン先とも 2mm³ 当たる）。
⬜ v4 の①〜⑬の原文はユーザー（§4）。この制約をその中に織り込む。

### ⬜ 残っている判断（ユーザー）・⚠ 仮のまま

- ✅ **電池の入れ替え口は §11 で実装した**（後ろ抜き。🔒 ユーザー「配置を指定した時から後ろから出すのは分かっていた事」）。
- ⬜ **Type-C 基板の保持**: 床の振れ止めは前の 1 本だけ。X に倒れる向きと Z の抜けは未対策（⚠ 基板そのものが未注文・未実測）。
- ⬜ **ブリッジの帯の左右の端の受け**: いまは前の脚（床の溝）だけで、帯の端は壁に触れているだけ。
  左端の真下は Type-C 基板（Z 〜20.5）が居るため v3 の棚（ナット入り）が素直に立たない。
- ⬜ **ブリッジを刷る向き**（`print_bridge` が無い理由）: `part="bridge"`（🔒 v3 と同じ名前）で出せるようにしたが、モデルのままだと
  帯（Z 21.4〜23.4）が脚の上に丸ごと張り出す。寝かせるか・脚を別部品にするかは未決。
- ⬜ **留め帯 3 本の留め方**（Z の抜け止め・帯自身の固定）。脚はレールの切れ目に座るだけ。
- ⬜ **電池・基板の Z の抜け止め**（天面との間は空いている）。
- ⚠ 皮の仮寸法: XIAO のポケット 16×11・充電のポケット 9×15・前リブの X・腕の X・後ろ右の床ボスの壁 0.5。
- ⚠ 上流の仮: `HUB_DY = 4`（ブリッジの脚の空間・ユーザー検収待ち）が動くと、床の柱・ビス穴・爪の帯・脚の溝が全部追従する。

🔴 **2026-08-25 [TODO.md](TODO.md) から引き取った 2 件。** 打ち切った v3 の名前の見出し（「筐体 v3 — 残作業」）に
現役の残作業が溜まっていたのを整理し、v4 固有の 2 件をここへ移した。TODO 側は版に依らないものだけになった。

- **Type-C 基板の受けを「ケーブルの胴用」から「基板用」に作り直す件**（v3・8/23 の別刷りの受け）は、上の ⬜「Type-C 基板の保持」に含む。
  v4 の床の振れ止めリブは最初から基板用なので、残っているのは倒れ（X）と抜け（Z）の対策だけ。
- **PowerBoost の置き場**（v3 の「右の床に立てる」案・床から 4.5 浮かせ・−X へ抜けない押さえ方）は、いまは
  **電池の上の傾いた板**に電流計と並べて載り、座のネジ 6 本と留め帯 3 本で押さえる形になっている（`pb_bat()`・§10 の ✅③・§12・§13）。
  床から浮かせる話も、壁のダボ・唇・フックも、向きごと消えた。
  🔴 **2026-08-25 ここに一度「§2 の案 C（背面立て）で決着した」と書いたのは誤り。** 案 C は 8/24 のスタディで、いまの模型は使っていない。
  `pose_c` / `pb_c` / `pb_unit`（[_v4_core.scad](../hardware/frozen/v1-v4/_v4_core.scad)）は案 C の残骸で、`W="pbchk"` / `"lookpb"` / `"pbseat"` だけがそれを見ていた。
  ⚠ **`pbchk` の 63.73mm³ は、いま存在しない置き方の PowerBoost とハブ基板の重なり**で、現行機の当たりではなかった。
  🔒 2026-08-25 ユーザー「pbchk と lookpb はもはや不要では？」→ **残骸ごと消した**（`C_AT` / `pose_c` / `pb_c` / `hous_c` / `pb_unit` と、
  それを見ていた 3 つのスイッチ）。当たりの検査は [case_v4.scad](../hardware/frozen/v1-v4/case_v4.scad) の `chk_*` / `close_*` / `seat*` / `strap*` が持っていて、
  そちらは最初から現物の `pb_bat()` を相手にしている。

## 11. 電池の入れ替え口（後ろ抜き・2026-08-25・[case_v4_shutter.scad](../hardware/frozen/v1-v4/case_v4_shutter.scad)）

> 🔴 **この節のスライドの向き（下）は 2026-08-26 に §16 で横（右）へ差し替わりました。**口の位置・型・磁石・ロックの考え方は生きています。

🔒 ユーザー GO。**後ろ（ハッチ）だけが、🔒 を一つも崩さず口を作れる向き**だった: レール＋留め帯は最初から +Y にだけ開いた鞘で、
タブ（JST）も 🔒 後ろ向き。抜き道（電池の断面 ±0.5・X 15〜51.5・Z 22.9〜29.9）に当てると**部品は 0**、居たのは仮の線だけ。

- **型は v3 の蓋そのまま**（[case_v3_shutter.scad](../hardware/frozen/v1-v4/case_v3_shutter.scad) の定数を共有。磁石 φ6.1 は ✅ゲージ確定値）:
  蓋（板 2.75＋耳＋磁石 2）＋外面の彫り込み帯＋門形ロック（M2×1＋ナット・中央の半円）。ハッチの裏に増し肉 2.2。
  🔴 **v3 と違うのはスライドの向きだけ＝下（−Z）**。上だと ①増し肉の上端 36.45 が PB の L ピンの線の通り道（Z 35.8）を塞ぐ
  ②ロックのボスが 5V の DuPont（Z 34.5〜37.1）に刺さる。下なら増し肉の上端 30.95 で線の下が空き、ボスは口の下
  （ハブのジャンパの頭 12.2 の上 0.5 ⚠）に立つ。ロックは 🔒 v3 のまま中央（X 33）。
- **交換の手順**: M2 を 1 本外す → ロックを外す → 蓋を下へ 5.5 ずらして後ろへ抜く（磁石だけで保持の運用なら工具なし・
  v3 と同じ思想でロックを締めれば現場の誤開放を防ぐ）→ 電池の JST を抜く → 電池を後ろへ引き出す。
- **線の引き直し 3 系統**（抜き道と蓋の増し肉に居た分。経路は ⚠ 仮のまま）:
  PWR 3 本は増し肉の上の 3 車線（Z 32.2/33.7/35.2・Y 70.7）を右へ走り道の外（X 64/66.5/69）で下りる。
  INA の I2C は立ち上がり X 52.8・前走りは座の板の下 Z 40.6（板と 0.25・JST ソケット群と X 0.2 ⚠）。
  トグル 2 本は口の頭の上 Z 21.6 で X 55.2 へ移ってから上がり、Z 46.8 の車線で前へ（座の板に線のノッチを開けた）。
  🔴 ついでの発見 2 つ: 電源線の**止め代をハウジングの中へ取っていた**（±X の向きの取り違え・全 7 本直した）。
  電池のタブ線の出発が電池に 0.15 めり込んでいた。
- **検査（manifold・全部 0）**: 蓋の静止（`chk_hatch`）・ずらす軌跡（`chk_shut_slide`）・蓋を抜く（`chk_shut_out`）・
  **電池を抜く（`chk_swap`・+Y 45）**・ハッチごと閉じる（`close_hatch`・蓋一式込み）・線の再検査（`chk_wire`/`chk_wire_w` 全束・`chk_wire_pwr` 新設）。
  chk_swap はタブ側の電池線 2 本（`w_batin`）を外して回す（実物は JST を抜いてから）。
- ⚠ 仮のまま: 磁石の座の穴の底 0.4（0.8 だと I2C の束に入る。接着が持つ前提）・きつい所 0.2 が 3 か所
  （I2C ↔ 抜き道／座の板／ソケット群）・ボスの下端 ↔ ハブのジャンパ 0.5。
- ⬜ ユーザー: 蓋の裏 ↔ 電池の尻の遊び 8.35 の詰め物（v3 のスポンジの流儀）。ロックを常時締める運用にするか。

## 12. 意匠の追い込みと、それが呼んだ追従（2026-08-25 午後）

出発点はユーザーの一言でした。「フロントパネルと、スピーカーのベベルがすこし大味すぎるので、すこし掘りをゆるめてください」。
掘りを浅くすると画面や振動板が奥に引っ込むので、**浅くした分だけ相手を近づける**のが全体の方針です。
どちらを動かすかは面ごとに違い、フロントは板を動かし、天面は他部品の兼ね合いが大きいのでスピーカーを持ち上げました（どちらもユーザー指定）。

### 12.1 フロント: 窓の裏を彫って壁を 1.0 にし、板ごと 1.0 ハッチ寄せ

OLED のガラスの面は内面 Y=0 にあり、板の内面とツライチです。ここで**板の裏**を窓のまわりだけ 1.0 彫ると、
そこだけ壁の厚みが 2.0 → 1.0 になります（`WIN_SUNK = 1.0`）。彫り込みの縁は段ではなく 45° で開きます。
段にしなかったのは、輪郭が増えて「変」になった充電口の初版と同じ顔を避けるためです。
さらに板そのものを 1.0 だけハッチ寄せ（`FRONT_DY = 1.0`）すると、彫り込みの底がガラスの面に届き、
**外から見た窓の深さが 2.0 → 1.0** になります。外面は平らのままなので、外から見える顔は変わりません。

- 板の前後位置は `FY_OUT`（外面）と `FY_IN`（内面）の 2 つの式に集約しました。既定は `FRONT_DY = 0` なので v1〜v3 の形は変わりません。
- 板が 1.0 内側へ入った分、床・左右の壁・天面・耳の柱は前端がその位置まで詰まります。
- 窓のベベル `WIN_CH` は 1.2 → **0.6**（板厚の 6 割 → 3 割）。マイクのヒゲと口のベベルは触っていません。
- 彫り込みが窓の外へ出る量 `WIN_SUNK_M = 2.5` は ⚠ 仮の値です。

🔴 **継ぎ目の 45° を切り直し忘れて角が開いた。** 天面とフロントを分ける斜面の蝶番が Y=0 に固定されていたため、
板を寄せたあと旧い斜面と新しい板の間に楔形の欠けが 1mm³ 開きました（ユーザー「この穴はふさがないんですか？」→「天板の斜めを切り直してないからだね」）。
`seam_top_half` / `seam_front_half` の起点を `FY_IN` に追従させて 0 になりました。

🔴 **マイクのヒゲ（貫通スリット）を一度消した。** `whisker_cut` の中の `fy` は**相対値**で、呼び出し側の translate に
既に `FY_OUT` が乗っています。そこを二重に補正したためスリットが外面へ届かなくなり、穴が消えました。
ヒゲは v2 から一貫して**外面のベベル＋内面まで貫くスリットの 2 段**で、飾りの溝ではありません。

### 12.2 天面: へこみを浅くした分だけスピーカーを持ち上げる

天面の板は他の部品との兼ね合いが大きいので動かさず、代わりにスピーカーを上げました。

| | 前 | 後 |
|---|---|---|
| へこみ `EMB_H` | 1.2 | **0.6** |
| スピーカーの持ち上げ `SPK_LIFT` | — | **+0.6** |
| 振動板の逃げ `SPK_REL` | 0.4 | **1.0** |
| 振動板 → 外面の距離／グリルの長さ 0.9 | | **据え置き** |

持ち上げると振動板だけでなく**スピーカーの枠（23×15）**が天板に 0.4 食い込みます。逃げが振動板（15×9）の分しか無かったためです。
枠の座を深さ 0.6・片側 0.3 で掘って解消し、`part="chk_top_spk"` で見張るようにしました。

### 12.3 傾斜の座とネジ（🔒 ユーザー「固定具作って下さい」→「ネジにしないと逆さまにしたら落ちちゃう」）

電流計と PowerBoost の 10°（`THETA`）は**座標の回転だけ**で、前縁の下は空でした。浮きは PowerBoost が 3.97、電流計が 3.49 で、
実機なら組んだ瞬間に落ちます。留め帯 A/B/C の天板の上に座を立てて解決しました。

- 座の面は板の裏から `SEAT_GAP = 0.3` 下げ、**ビス 6 か所だけ φ5 のパッド**で板に届かせます。こうすると板の裏の足
  （電流計の L ヘッダ 1.2・PB の 8 ピン列 1.0）は掘らなくても全部逃げます。
- ネジは**鉛直**です。板に直角にするとナットが 10° 傾き、角が天板の裏から 0.35 はみ出して**電池の頭を突きます**（`seathw` で 6mm³ として出た）。
  鉛直ならナットは天板の裏に平らに座ります。頭は 10° の板に片当たりになりますが、M2 の頭 φ3.0 での話です。
- 座と穴は板と同じ変換（`ina_frame` / `pb_frame`）を通しているので、`THETA` や板の位置を動かせば全部追従します。

🔴 **プレビューを破裂させた。** 板の裏の足を「板の CSG を 7 方向にずらして引く」で逃がしたところ、
CSG の正規化が 20 万要素を超えて**空の木**になり、ユーザーの画面が真っ白になりました。`--render`（Manifold）でしか
検算しておらず、F5 の経路を通していなかったのが原因です。上の「座を下げてパッドで受ける」方式に変え、
座の柱も `roof` 依存の `prism_y` をやめて素の cube にしました。

### 12.4 ネジとつまみの +2

ユーザー指示で、天面と底面の**前**のネジ 2 本ずつと、つまみを 2mm ハッチ方向へ動かしました
（後ろのネジは Y 65〜72 でハッチの内面にべったりなので動かせません）。耳は Y 0〜8 → 2〜10、床の前ビスの柱は +2、つまみは +5 → +7 です。
これに伴う追従は、島のノッチを板の後端まで延長したこと、リードの線の潜り点を +2 したこと、
耳の柱と床の右前の柱が ReSpeaker の板の帯に当たる分を欠いたことの 3 つです。

### 12.5 🔴 PHIN / PHOUT は DuPont ではなく JST PH2.0 だった

ハブの 10 個の口を**全部同じ DuPont**（樹脂 2.5 ＋ 胴 10 ＋ 曲がりの予約 3.6）で描いていました。
しかし PHIN / PHOUT は ReSpeaker の J2 とスピーカーへ行く線で、[relay_board.html](../hardware/parts/relay_board.html) の `PHCONN` に
**PH2.0 の 2P（胴 5.9×4.5）**と書いてあります。DuPont は物理的に挿さりません。模型を PH ソケット（高さ 6.0 ⚠ 標準値）に直しました。

この間違いは検査結果まで汚していました。「つまみ +2 で電流計のコネクタが PHIN のハウジングに 0.27mm 当たる」と報告していましたが、
相手が実在しない部品だったので、**実物同士では当たりません**。直した結果 `close_top` は 0 になりました。
⬜ プラグと線の空間は、トップ型かサイド型かが現物合わせで決まってから入れます。

### 12.6 `part="bridge"` を復活（ユーザー「bridge コマンドが漏れてますね」）

v4 の part 一覧にブリッジが 1 つも無く、刷る部品なのに単体で出せませんでした。v3 と同じ名前で復活させ、
中身はユーザー指定どおり**ブリッジ＋電池・電流計・PowerBoost・左右の壁・結束バンドの一式**です（単体では判断できないため）。

### 検査（manifold・2026-08-25 午後の再取得。これが現在値）

| 検査 | 結果 |
|---|---|
| `chk_floor` 〜 `chk_hatch` / `chk_all`（板 ↔ 中身＋他の板） | **0** |
| `chk_press`（ReSpeaker の押さえが板に届いている証拠） | **6mm³ が正** |
| `chk_top_spk`（天板 ↔ 持ち上げたスピーカー） | **0** |
| `close_top` / `close_front` / `close_hatch` | **0** |
| `close_lwall` / `close_rwall` | **0 / 0.01mm³**（🔴 3.1 / 29.0 だったのを §13.5 で直した。0.01 は口の膜）|
| `seatchk` / `seathw` / `seatshaft`（座・ネジ・ナット ↔ 全部） | **0** |
| `close_desk`（ブリッジを降ろす） | **171mm³**（§10 の組む順の制約。ブリッジ → OLED → OLED の線 の順なら 0） |

⚠ **現在値は §13.7 の表です**（2026-08-25 夜。この表より後）。この表が「0」と書いている中で、
`close_front` は 0.13・`close_hatch` は 0.02・`seatshaft` は 0.05 が実際の値で、丸めた（または取り違えた）ものでした。
どれも板の 0.5 持ち上げとは無関係の既存値で、§13.7 の末尾に別途の宿題として立ててあります。

### ⬜ この章から出た未決

- ⚠ **彫り込みが窓の外へ出る量 2.5** は AI が置いた仮値です。太い／細いの判断待ちです。
- ⬜ **PH2.0 のトップ型かサイド型か**（現物合わせ）。決まればプラグと線の空間を入れます。
- ⬜ **AS5600 側の線の逃げ予約（3.6 角）**も PHIN と同じく取り過ぎの可能性があります。線が下向きに出てどちらへ曲がるかが未確定です。
- ⬜ **つまみの島の欠きと線の経路が世界座標の生の数字**で書かれているため、つまみを動かすたびに手で追従させる必要があります。
  `KNOB4` からの式に直せば「次の移動は 1 変数」になりますが、検証済み座標を凍結する流儀との兼ね合いで保留しています。

## 13. 組み立ての手順（2026-08-25 夜・[assembly_v4.html](../docs/manual/assembly_v4.html)）

ユーザーの依頼は「v3 のときに作った組み立てマニュアルを、v4 の分も作ってほしい」でした。
出来たものは v3 と同じ形式の 1 枚の HTML で、挿絵つきの 12 手順・線と留め具の表・検査の裏取り・
電池の交換・まだ埋まっていないものの一覧を持っています。作り直しは `python hardware/frozen/v1-v4/_asm_manual_v4.py`、
段の中身と軌跡の検査は [_asm_sim_v4.scad](../hardware/frozen/v1-v4/_asm_sim_v4.scad) の `upto()` と `CHK=` が持ちます。

⚠ **手順の番号は CAD の軌跡検査から起こしたもので、①〜⑬の原文をユーザーが書いたものではありません。**
§4 の ⬜（新しい①〜⑬の原文はユーザー）はまだ空いています。ここに書いたのは「この形なら物理的にこの順にしか入らない」
という制約の集合で、原文が来たら突き合わせる材料です。

### 13.1 順番を決めたのは 2 つの制約

1 つめは **ハブの口 10 本の上にブリッジの皿と帯が載る**ことです。皿は `Z 21.4〜23.4・X 13〜53`、
壁〜壁の帯は `Y 50.5〜62.9` の全幅で、その真下に口がある束（XIAO・つまみ・BTN2・スピーカー IN/OUT）は
ブリッジを載せた後では届きません。だから**ハブの口は全部ブリッジより先に挿す**ことになります。

2 つめはその裏返しで、**皿や帯の上を通る束**（OLED・INA の I2C・トグル・リード・充電）を先に上げてしまうと、
今度はブリッジが降りません（`CHK="brg_bad"` で **846mm³**）。この 5 束はハブ側の口が左の溝か後ろの縦穴にあり、
ブリッジの後でも挿せるので、**低い車線を先・上の車線を後**に分けました。

この 2 つから出た順番が次の 12 段です。
**① 床にハブ → ② ReSpeaker と Type-C → ③ ハブの口 10 本と低い車線 → ④ 左右の壁と床の 3 本 →
⑤ ブリッジ → ⑥ 電池 → ⑦ 留め帯 → ⑧ 電流計と PowerBoost → ⑨ OLED と上の車線と電源系 →
⑩ 天面の小組と天面側の配線 → ⑪ 天面を降ろしてフロント → ⑫ トグル・ハッチ・蓋・尻尾。**

電池と留め帯と基板を OLED より先に入れるのは、上の車線が電池の真上（`Z 45.2` の OLED の線など）を通るためです。
先に線を上げると電池も帯も基板も真下へ降ろせなくなります（それぞれ 570 / 256 / 573mm³）。

### 13.2 軌跡の検査（`_asm_sim_v4.scad` の `CHK=`・相手はその手順の直前まで）

| 動かす物 | 結果 |
|---|---|
| 壁（`wall_l` / `wall_r`） | **0 / 0.01mm³**（🔴 3.1 / 29.0 だったのを §13.5 で直した） |
| ブリッジ（`brg`）・電池（`bat`）・留め帯（`strap`）・PowerBoost | **0** |
| 電流計（`boards`） | ⚠ **0.4mm³**（下の 13.3） |
| OLED（`oled`）・上の車線と電源系（`whigh`） | **0** |
| 天面・フロント・ハッチ（case_v4 の `close_*`） | **0** |

ブリッジ・電池・留め帯の検査には素で回すと 4〜10mm³ が出ますが、これは **BTN2 の線がタクトの足へ渡る最後の枝**で、
タクトは手順⑩で載るのでこの時点では存在しません。枝を外すとどれも 0 になります。

### 13.3 🔴 この作業で見つかった、まだ組めない所（→ §13.5 で 2 件を直した）

- ✅ **右の壁の前の床ボス ↔ ReSpeaker の右端の部品（25.7mm³）。** 静止では欠き（`X 78.0〜83.09・Z 6.31〜10.11`）が
  効いて 0 ですが、壁を上から降ろす軌跡では部品（`X 78.30〜82.79・Y 5.60〜7.50・Z 6.61〜9.81`）を通ります。
  順番を入れ替えても解けません。ReSpeaker を壁の後に入れると 454mm³ で、こちらの方がずっと悪いからです。→ §13.5
- ✅ **左右の壁の前の床ボス ↔ ReSpeaker の前面の部品（3.1 / 3.2mm³）。** ボスの後ろの面 `Y 7.5` に部品が 0.6 かぶり、
  降ろす軌跡で `Z 17.75〜21.25` の帯を通ります。どちらも 🔒「天面と底面の前のネジを 2mm ハッチ方向へ」（§12.4）で
  ボスが前へ寄った分です。→ §13.5
- 🔶 **留め帯のナットのポケットだけ下を向いている**（§13.6 で 6 個中 4 個を横穴にした。残り 2 個は未決）**。** 床・天面・耳のボスは全部上向きで落とし込めますが、
  留め帯 3 本の 6 か所は天板の**裏**に開いていて、ポケット 4.3 に対しナットは 4.0 なので帯を起こすと落ちます。
  🔴 **向きは変えられません**——ネジは板の上から来るので、ナットが締める物の反対の端（＝天板の裏）に居ないと
  座を挟めません（床のビスと同じ理屈。上向きにすると板とナットが直に噛むだけで座は締まらない）。
  ⬜ 直せるのは入れ方（テープ・接着・締まりばめ）で、ユーザー判断です。
  ⚠ 六角ポケットは実績では**呼び +0.3 でジャスト**なので、1 本刷って落ちるかを見るのが安い。
- ✅ **座のネジの長さの上限が穴ごとに違う。** 首下は後ろ寄りの 3 本が 3.99 / 4.04 / 4.50、前寄りの 3 本が
  6.70 / 6.78 / 7.13 までです。超えると先が天板の裏を抜けて電池の頭を突きます（天板の裏＝電池の上面で隙間はゼロ）。
  → §13.5 でポケットの天井を上げ、`M2×4` ×3 ＋ `M2×6` ×3 で 6 本とも掛かりが満（1.6）になりました。
- ⚠ **電流計の板の縁が留め帯 A の座に 0.37mm³ 入っています**（`X 15.48〜16.12・Y 19.60〜20.38・Z 33.01〜34.01`）。
  静止でも同じ値なので軌跡の問題ではありません。§12 の `seatchk` が 0 なのは相手に留め帯そのものを入れていないためです。
- **ブリッジ・留め帯・会話ボタンのキャップには印刷用の出力がありません。** `part="bridge"` は §12.6 のとおり「見る用」の一式で、
  `p_` も `print_` もまだ無く、刷る向きも未決です。キャップは v3 の `p_btncap` が v4 に移っていません。
  いま刷れるのは 9 点で、部品は全部で 14 点（ブリッジ 1 ＋ 留め帯 3 ＋ キャップ 1）です。つまみ一式は knob_v5.scad が別に持ちます。

### 13.4 マニュアルに載せた数字の出どころ

線の長さは [_v4_core.scad](../hardware/frozen/v1-v4/_v4_core.scad) の `w_*()` の点列を、`wire()` を echo に差し替えて折れ線長として取りました
（束の中で一番長い 1 本・mm）。⬜ **天面を箱の左に裏返して置いた姿勢で足りるかは v4 では測っていません**。
v3 では実測で最大 +57mm 要った束があったので、作る長さは実長 ＋ 40mm を目安として書き、この項を未計測として残しました。

### 13.5 直した 2 件（2026-08-25 夜・ユーザー「修正できますか？」）

**① 前の床ボスを L 形に。**（[case_v4.scad](../hardware/frozen/v1-v4/case_v4.scad) の `lwall_v4` / `rwall_v4`）
直す前の欠きは「部品の高さの帯だけ」でした。しかし**ボスは壁と一緒に上から降りる**ので、
部品より**下**にある肉も、降りてくる途中でその部品を通ります。つまり欠きは帯ではなく**全高**でなければなりません
（部品より上の肉だけは通りません）。左右とも、部品の XY の影を ±0.3 で全高に抜きました。

| | 欠く範囲 | 結果 |
|---|---|---|
| 左 | `X 5.91〜7.7・Y 6.61〜7.5`（後ろ右の角） | `close_lwall` 3.1 → **0** |
| 右 | `X 78.0〜83.09・Y 5.3〜7.5`（後ろ左＝ボスが L になる） | `close_rwall` 29.0 → **0.01**（口の膜） |

ナットは残った前半分（`Y 2.6〜5.3`）の壁が捕まえたままです。+Y へ出ようとすると右の角（`X 84.28`）が
残り肉（`X 83.09〜85.3`）に掛かり、−X へは前半分の壁で逃げ場がありません（開口 3.77 < 二面幅 4.3）。
締める力を受ける座も前半分が残ります。絵は [_boss_fix_r.png](../hardware/frozen/v1-v4/_boss_fix_r.png)（右・左が直す前）と
[_boss_fix_l.png](../hardware/frozen/v1-v4/_boss_fix_l.png)。当てた道具は [_boss_probe.scad](../hardware/frozen/v1-v4/_boss_probe.scad)
（ボスの XY の影を上まで伸ばした角柱 ↔ ReSpeaker）です。

**② 座のナットのポケットの天井を上げた。**（[_v4_core.scad](../hardware/frozen/v1-v4/_v4_core.scad) の `seat_nut_d`）
ナットは締めるとポケットの**天井**まで登り、そこで止まります。つまり掛かりを決めているのは深さです。
深さ 1.8 のままだと前寄りの 3 穴は天井が低く、`M2×6` の先が届かずに 0.67 / 1.02 / 1.10mm しか掛かりませんでした。
座は板の裏まで詰まっているので天井は上げられます。**深さ ＝ seat_d − 0.6（天井の上に肉 0.6 を残す）で頭打ち 2.8** としました。

| 穴 | 首下の上限 | ネジ | ポケット | 掛かり | 先 → 天板の裏 |
|---|---|---|---|---|---|
| 電流計・後 | 3.99 | M2×4 | 1.80 | **1.6** | −0.01 ⚠ |
| PB・後 | 4.04 | M2×4 | 1.84 | **1.6** | 0.04 |
| PB・後（もう 1 本） | 4.50 | M2×4 | 2.30 | **1.6** | 0.50 |
| 電流計・前 | 6.70 | M2×6 | 2.80 | **1.6** | 0.70 |
| PB・前 | 6.78 | M2×6 | 2.80 | **1.6** | 0.78 |
| PB・前（もう 1 本） | 7.13 | M2×6 | 2.80 | **1.6** | 1.13 |

⚠ 電流計の後穴だけ `M2×4` の先が 0.01mm 出ます（上限 3.99 に対して 4.00）。電池の面に触れるだけで、`seathw` に
0.03mm³ として出るのはこれです。数字は [_seat_probe.scad](../hardware/frozen/v1-v4/_seat_probe.scad) が出し直します。
`seat_bolt` も**現物の長さ**（4 / 6）と**締めた位置のナット**で描くようにしました（旧版は「入る上限の長さ」の
実在しないネジを描いていて、`seathw` が 0 に見えていました）。

**検査**（manifold・直した後）: `close_lwall` 0・`close_rwall` 0.01・`chk_all` 0.03（口の膜 4 枚・直す前と同値）・
`strapchk` 0・`seatchk` 0.37（既知。電流計の縁 ↔ 帯 A の座・§13.3）・`seathw` 0.03（上の ⚠）・
`seatbolt` 1.71（既知。ネジの頭が 10° の板に片当たりする分・直す前と同値）。留め帯の最薄肉は直す前と同じ（薄い稜が 126 → 122 か所）。

### 13.6 ナットを横から差す捕捉溝（2026-08-25 夜・ユーザー「留め帯の形状を変えても構いません・パーツを追加してもいいです」）

形を変えてよいという許可が出たので、留め帯のナットを**横穴**（側面から差す捕捉溝）に替えました。
六角の穴を高さ 1.7 で開け、帯の一番近い面まで幅 4.3 の通路でつなぎます。ナットは横から差し、
上（天井）と下（床）の肉で閉じ込められるので、帯をどう向けても落ちません。通路の壁が二面幅を挟むので回り止めにもなります。

**上下をひっくり返す案は不可です。** ネジは板の上から来るので、ナットが締める物の反対の端（＝天板の裏側）に
居ないと座を挟めません。上向きにすると板とナットが直に噛むだけで、座は締まりません（床のビスと同じ理屈）。
**横は成立します。** 締める力は天井が受けますが、天井は板とナットの間で**押されるだけ**（曲げではない）なので薄くてよく、
床は荷重を持ちません——ナットが落ちないための縁です。値は天井 0.4・床 0.3・傾き 10° の逃げは通路の抜ける向きで決めます
（前＝−Y へ抜くときは面が上がるので六角の分だけ、後ろ＝+Y へ抜くときは通路の長さの分だけ天井を下げる）。

| 穴 | 世界 Y | 形 | 通路 | 天井 / 床 | 掛かり |
|---|---|---|---|---|---|
| 電流計・後（hy 2.25） | 34.05 | ⬜ 下向きのまま | — | — | 1.60 |
| PB・後（hy 2.54） | 57.13 | ⬜ 下向きのまま | — | — | 1.60 |
| PB（hy 5.18） | 54.53 | ✅ 横穴 | 前へ 1.93 | 0.84 / 0.36 | 1.56 |
| 電流計・前（hy 17.85） | 18.69 | ✅ 横穴 | 後ろへ 2.76 | 1.06 / 2.34 | 1.34 |
| PB（hy 18.32） | 41.59 | ✅ 横穴 | 後ろへ 0.61 | 0.68 / 2.80 | 1.60 |
| PB（hy 20.32） | 39.62 | ✅ 横穴 | 後ろへ 2.58 | 1.03 / 2.80 | 1.37 |

ナットの居場所が板の裏の近くまで上がったので、**ネジは 6 本とも `M2×4` の 1 種類**になりました（前は 4 と 6 の 2 種類）。
絵は [_slot_plan.png](../hardware/frozen/v1-v4/_slot_plan.png)（帯 B を溝の高さで水平に切った図。六角の穴から帯の面へ通路が抜けている）と
[_strap_look.png](../hardware/frozen/v1-v4/_strap_look.png)（3 本を斜め下から）。数字は [_seat_probe.scad](../hardware/frozen/v1-v4/_seat_probe.scad) が出し直します。

⬜ **残る 2 個**（電流計の後穴・PB の後穴）は下向きのままです。板の裏から電池の頭まで **2.39 / 2.44mm** しか無く、
横穴に要る **2.84**（天井 0.4 ＋ ナット 1.7 ＋ 傾きの逃げ 0.44 ＋ 床 0.3）が入りません。逃げ道を 3 つとも当たってみて、いずれも塞がりました:

- **板を 0.5 持ち上げれば全部横穴にできます。**（🔴 このとき AI は「板の上は詰まっていて 0.18mm³ 触っている」と書きましたが、
  **古い STL を読んだ誤りでした**。線を外して測り直すと板の上は空で、当たっているのは INA の I2C の線と**その線自身の
  DuPont ハウジング**です。ユーザーはこの案を選び、§13.7 で実装しました）
- **ネジの頭を横穴で捕まえて（頭 φ3.4×1.4 なら 2.30 で収まる）、ナットを板の上で締める**手は、頭が丸くて回り止めが
  効かないので使えません（六角ナットと違い、締めるときにネジが供回りします）。
- **後ろの 2 本をやめて座に返し（リップ）を付ける**手は、電流計の後縁と PowerBoost の前縁の隙間が 0.5mm しか無く、
  返しを立てる場所がありません。

→ 🔒 **ユーザー決定「板を 0.5 持ち上げましょう」で 1 番目を採り、§13.7 で 6 か所とも横穴になりました。**

**検査**（manifold・この直しの後）: `strapchk` 0・`seatchk` 0.37（既知）・`seathw` 0.03（既知の先 0.01）・
`seatbolt` 1.71（既知の頭の片当たり）・`chk_all` 0.03（口の膜 4 枚）。留め帯の肉厚は §13.7 の「肉厚の確かめ直し」を見てください
（この時点で `_thin.py` が出していた 0.60 / 0.30 は道具の下限に当たった値で、設計値としての最薄はナットの床 0.35）。

### 13.7 板を 0.5 持ち上げて、6 か所とも横穴にした（2026-08-25 夜・🔒 ユーザー「板を 0.5 持ち上げましょう」）

蝶番（板の後縁）を天板の面から **0.5 浮かせました**（`BOARD_LIFT`）。座の肉が 6 か所とも 2.89 以上になり、
§13.6 で入らなかった 2 か所も横穴になりました。ネジは 6 本とも `M2×4` のままです。

| 穴 | 通路 | 天井 / 床 | 掛かり | 先 → 天板の裏 |
|---|---|---|---|---|
| 電流計・後（hy 2.25） | 前へ 0.85 | 0.84 / **0.35** ⚠ | 1.56 | 0.49 |
| PB・後（hy 2.54） | 後ろへ 1.47 | 0.84 / **0.41** ⚠ | 1.56 | 0.54 |
| PB（hy 5.18） | 前へ 1.93 | 0.84 / 0.86 | 1.56 | 1.00 |
| 電流計・前（hy 17.85） | 後ろへ 2.76 | 1.06 / 2.84 | 1.34 | 3.20 |
| PB（hy 18.32） | 後ろへ 0.61 | 0.68 / 3.30 | 1.60 | 3.28 |
| PB（hy 20.32） | 後ろへ 2.58 | 1.03 / 3.30 | 1.37 | 3.63 |

ネジの先が天板の裏（＝電池の頭）に触れる穴も無くなりました（前は 1 本が 0.01 出ていた）。

**板に付いている物は同じだけ上げました**——L 字 3 ピンのハウジング・USB ピンのハウジングと逃げ箱・
板側の線の端点（PWR 3 本の出発・電池線の INA 側と PB の JST 側・I2C の INA 側・充電 GND の PB 側）。
これに追従して 3 か所を直しています:

- **PowerBoost の 8 ピン列の逃げ溝**（留め帯 C の天板）: 足も 0.5 上がるので溝の高さを 1.4 → 1.9 に。床の残り 0.65 は据え置き。
  直す前は足が座に 0.15mm³ ×3 刺さっていました。
- **天面の裏の局所ポケット**（PB の USB の DuPont の逃げ）: 逃げの頭が 49.2 → 49.7 になるので、深さ 1.27 → **1.77**。
  ⚠ **板の残りは 1.23 → 0.73**。これが今回の持ち上げの実質的な代金です。
- **INA の I2C の前走り**: 1.5 の 2 本（Z で 3.0 要る）が入らなくなりました。上は座の板 41.95（動かない）、
  下は I2C の DuPont ハウジング（板と一緒に上がって頭 39.41）で、谷が 2.54 しかありません。
  → **元の 2.2 の束 1 本に戻しました**（Z 40.6・下 0.09 ⚠・上 0.25）。⚠ X の余裕が 0.35 → 0 に戻ります
  （谷 51.5〜53.7 にぴったり）。2026-08-25 昼に「余裕 0 だから割った」経緯（§10）の巻き戻しなので、ここは覚えておく値です。

**検査**（manifold・持ち上げの後。カッコ内は持ち上げの前）: `chk_all` 0.03（0.03）・`close_top` 0（0）・
`close_lwall` 0（0）・`close_rwall` 0.01（0.01）・`close_front` 0.13（0.13）・`close_hatch` 0.02（0.02）・
`wchk` 0.18（0.18）・`wwchk` 0・`seatchk` 0.37（0.37）・`strappb` 0.37（0.37）・`inachk` 0.37（0.37）・
`strapchk` 0・`seathw` **0**（0.03）・`seatbolt` 1.71（1.71）・`seatshaft` 0.05（0.05）。
軌跡（`_asm_sim_v4.scad`）: `boards` 3.35・`strap` 9.78・`bat` 4.16・`brg` 9.79（どれも BTN2 の枝の分で、
枝を外すと 0 なのは §13.2 と同じ）・`oled` 0・`whigh` 0・`wall_l` 0・`wall_r` 0.01。**全部持ち上げの前と同値です。**

#### 肉厚の確かめ直し（ユーザー「0.30 は厳しいなぁ・・・印刷できるかなぁ」）

**この 0.30 は道具の下限値でした。** [_thin.py](../hardware/frozen/v1-v4/_thin.py) は 0.15mm の格子でボクセル化して距離場の稜線を拾うので、
**0.30（＝ 0.15 × 2）より薄いものは全部 0.30 と出ます**。面取りや斜面の先（厚み 0 まで痩せる「刃」）と、
本物の 0.3mm の壁が、同じ数字で並んでしまいます。

切り出して格子 0.05 で測り直すと（[_thin_crop.scad](../hardware/frozen/v1-v4/_thin_crop.scad) ＋ [_thin2.py](../hardware/frozen/v1-v4/_thin2.py)）、
どの場所も **0.10（＝新しい下限）** まで下がりました。つまり全部**刃**です。3 か所の正体は:

| 出た場所 | 正体 |
|---|---|
| 世界 Y 37.05・Z 35.4・X 全幅 | 電流計の座と PowerBoost の座の谷（0.5）。板を 0.5 上げた分、座の後縁が天板の上に 0.2 の段として乗った。**下は天板 2.0 が続いている** |
| 世界 Y 58.45・Z 29.9 | PB の 8 ピンの逃げ溝の床（0.65）が、天板の下の面取り 0.5 に食われて縁で刃になる所 |
| 世界 X 23.2〜27.1・Z 33.9 | **今回作ったナットの溝の口**。天井（0.4）が帯の面の面取り 0.5 に食われて、口の縁だけ刃になる |

**設計値としての本当の最薄は、ナットの床 0.35（電流計の後穴）です。** 天井は 0.68〜1.06、逃げ溝の床は 0.65、
天板と ⊓ の壁は 2.0。この機（🔒 ELEGOO Mars 3・光造形・層 0.05）の実績は **「薄壁 0.3mm が形になる」**（[PRINT.md](PRINT.md)）なので、
0.35 は内側です。⚠ FDM のノズル幅（0.4/0.42）はこの機では意味を持ちません（[[stl-preflight-check]] の記録）。
溝は横に開いているのでレジンも抜けます。口の縁の刃は、刷ると丸まって少し欠ける程度で、ナットの逃げ止め（4.3 の口）には効きません。

**「か所」の数え方も誤解を招きました**（ユーザー「195 か所も薄い箇所があると言っているのですよね」）。
`_thin.py` はしきい値ごとに行を出しますが、**195 は「厚み 1.60mm 未満」の行の数**で、0.30 の行の数ではありません。
AI が厚みを一番上の行から、数を一番下の行から拾って 1 文に混ぜたのが誤りでした。正しくは:

| しきい値 | 塊の数 |
|---|---|
| 0.42mm 未満 | 47 |
| 0.60 未満 | 82 |
| 0.80 未満 | 143 |
| 1.00 未満 | 167 |
| 1.60 未満 | **195** |

「か所」はしきい値を超えた稜線の**連結成分の数**なので、面取りの縁が細切れに数えられます。1.60mm 未満に 195 個並ぶのは、
「部品の縁がほぼ全部入る」という意味で、欠陥の数ではありません。

仕分けは [_thin3.py](../hardware/frozen/v1-v4/_thin3.py) が出します（格子 0.09・下限 0.18）。**厚み 0.60 未満の塊 81 個のうち 22 個が刃**
（下限に張り付く）で、残りは 1〜8 点の粒です。粒の正体は溝の口で、帯の面の面取り 0.5 が床や天井の**入口の縁**を
0.25〜0.36 まで削っている所です。ナットが座る奥は設計どおり（床 0.35 / 0.41・天井 0.68〜1.06）で、
入口の縁が少し欠けてもナットは 4.3 の口から出られません。

この部品の肉は、天板 2.0・⊓ の壁 2.0・PB の逃げ溝の床 0.65・ナットの天井 0.68〜1.06・**ナットの床 0.35（最薄）**です。

⚠ 数字が並んだときのために、`_thin.py` は自分の下限を毎回刷るようにしました。
⚠ `close_front` 0.13・`close_hatch` 0.02・`seatshaft` 0.05 は **持ち上げとは無関係の既存値**で、
§10/§12 の表が「0」と書いているのは古いか丸めたものです（この 4 つは別途の宿題）。

---

## 14. 充電基板の受け（2026-08-25 夜・[case_v4.scad](../hardware/frozen/v1-v4/case_v4.scad) の `tc_seat4`）

ユーザーが [CASE-V4-OPEN.md](CASE-V4-OPEN.md) の A-6「Type-C 基板の保持は床の振れ止めリブ 1 本だけ」を読んで、
「マジで？」と聞いたのが発端です。確かめたら、**そのリブは何にも触っていませんでした**。

`tcb_v4()` を単体 STL に出して bbox を取ると `X 1.694..7.065 / Y 48.669..73.200 / Z 0.500..20.500`。
📄 秋月 115426 の寸法図で板は 20 × 15 × 1.6 なので、**板そのものは Y 57.4〜72.4**。Y 48.669 まで前へ出ているのは
板ではなく**デュポンのハウジング 4 個**（`X 4.524〜7.065`・Z は 4 つの帯・最下段 3.99〜6.53）でした。
リブは `X 1.694〜4.694・Y 47.7〜48.4・Z 0〜3.0` なので、板からは Y で 9mm 手前、ハウジングからは Z で 1mm 下。
どちらにも当たっていません。

🔴 **「板の前縁 48.67 の 0.27 手前」というリブのコメントが、ハウジングの前端を板の前縁と読み違えたもの**でした。
A-6 の本文はそのコメントを引き写していたので、二重に間違っていたことになります。実際に基板を押さえていたのは
ハッチに開けた口だけで、X の倒れも Z の抜けも、**−Y（ケーブルを挿す向き）すら**止まっていませんでした。

受けは 5 つに分けました。② が挿す力を、③④ が倒れを、⑤ が抜けを持ちます。

| | 形（世界座標） | 止める向き |
|---|---|---|
| ① 底の座 | `X 1.694〜3.9・Y 55.95〜72.0・Z 0〜0.5` | 板の下端を面で受ける（口の Z 中心 10.5 を保つ） |
| ② 前の当て | `X 1.694〜4.25・Y 55.95〜57.15・Z 0〜20.5` | **−Y。ケーブルを挿す力** |
| ③ 前の返し | `X 3.544〜4.25・Y 57.15〜58.35・Z 0〜20.5` | +X（前の倒れ） |
| ④ 後ろの控え | `X 3.544〜4.70・Y 62.0〜65.5・Z 0〜20.5` | +X（後ろの倒れ） |
| ⑤ 帯の裏の押さえ | `X 1.694〜3.9・Y 58.6〜62.2・Z 20.7〜` | +Z（抜け） |

②③④ を置ける場所は隙間で決まりました。③ の表 4.25 ↔ ハウジング 4.524 で 0.274、③ の後端 58.35 ↔ L 型ピン列 58.67 で 0.32、
④ の後端 65.5 ↔ コネクタ胴の前端 65.85 で 0.35、④ の補強の右端 5.9 ↔ ハブの左端 6.002 で 0.102。
② と ④ は 1.2 厚で 20.5 立つので、前と右へ三角の補強を入れて Z の途中で消しています。
⑤ が入れるのは、板の上端 20.5 と ブリッジの壁〜壁の帯の裏 21.4 のあいだの 0.9 だけで、そこへ 0.7 下ろして
逃げを 0.2 にしました。板との隙間は ②③④ とも 0.25 なので、20mm の板が倒れられるのは 0.7° までです。

🔴 **組む順が変わりました**（§13 の手順 2・4・5）。板の裏を受ける面が左壁の内面そのものなので壁より先には立てられず、
壁の後から真上に落とすと天面の後ろ左のボス（左壁の一部・`X 1.694〜・Y 64〜72・Z 38〜48`）が板の平面図の footprint と
重なって経路を 75.6mm³ 塞ぎます。残るのは「板を壁の内面に当てて、壁と一緒に降ろす」の 1 通りだけでした。

検査は `chk_tc`（受け＋押さえ ↔ 基板と周り）と `close_tc`（壁と基板を一緒に 30mm 降ろす）を足して、どちらも 0。
⚠ `close_tc` の障害物に電源系の線は入れていません。電池は手順 6 でこの時点では通っていないためで、
入れると 20.2mm³ 出ます（`X 2.0〜4.9・Y 57.4〜64.45・Z 27.75〜30.75` ＝ 電池の線が板の真上を横切る所）。
静止では板の上端 20.5 と線の下端 27.75 が 7.25 離れているので当たりませんが、線を通すときはここを避けて回します。

🔒 2026-08-25 ユーザー「この絵で良いと思いますよ」で**形は検収済み**。⚠ 検収されたのは形で、現物（B-2）が未注文のため
②③④ の Y は板が届いたら取り直しです。絵は [_tc_iso.png](../hardware/frozen/v1-v4/_tc_iso.png) / [_tc_seat.png](../hardware/frozen/v1-v4/_tc_seat.png)、
出し方は [_tc_look.scad](../hardware/frozen/v1-v4/_tc_look.scad)。

⚠ このとき、組み立てマニュアルの生成が **OpenSCAD Nightly では回らなくなっている**のも見つけました。
`--render` は値が要る仕様に変わっていて、値なしで渡すと**次の引数（`--camera=...`）を食べてしまいます**。
[_asm_manual_v4.py](../hardware/frozen/v1-v4/_asm_manual_v4.py) の 2 か所を `--render=full` に直しました。

## 15. T-2 の直しと、それが呼んだ追従（2026-08-26・つまみとスピーカーを内側へ 4）

### 15.1 犯人を取り違えた

T-2 は「OLED の右のナットが入らない」。L の裏の面（`Y 6.6`）から奥へ、左は 8.0mm 開いているのに
右は **1.3mm** しか無く、ナットの厚み 1.6 が入りませんでした。

初版は塞いでいる物を **「天面のつまみの島」** と書きましたが、**取り違えでした。**島は `Y 22.3` より奥に
しか無く、この場所から 15mm 離れています。部品ごとに抜いて撃ち直したら、はっきりしました。

| 撃った物 | 左 | 右 |
|---|---|---|
| 天板と L だけ | 8.00 | 8.00 |
| つまみ一式だけ | 8.00 | 8.00 |
| **スピーカーだけ** | 8.00 | **1.29** |

正体は**スピーカーの右前の丸み**（前端 `Y 6.8` ＝ L の裏の面 `6.6` の 0.2 奥）でした。
全部入りの STL で 1 か所測って「1.3 で止まる」まで分かった時点で、**切り分けずに犯人を名前で呼んだ**のが
誤りの原因です。止まった相手を名指しする前に、容疑者を 1 つずつ抜いて撃ち直すこと。
絵は [_t2_blocker.png](../hardware/frozen/v1-v4/_t2_blocker.png)。

同じ理由で「島は天面と一体だから順番では解けない」も誤りでした。スピーカーは後から入れる部品です。

### 15.2 直し方（🔒 全部ユーザーの指示）

1. 「スピーカーを少しだけ**内側**に移動すればいいのでは」「つまみも一緒に」「**両方を +4 移動させてください**」
   → つまみとスピーカーを**内側（−X・右壁から離す向き）へ 4**。`KNOB4` `SPK4` とも `X 67.204 → 63.204`。
   ⚠ AI は「内側」を +Y（奥）と読み違えて一度 Y で実装しました。この repo では 2026-08-25 の
   🔒「少しだけ内側へ」が **+X を +3 → +1.5 に減らした**記録として残っていて、**内側＝−X** が正です。
   この 4mm は T-2 と別に、**上から見たときのつまみの位置のバランス**（UI）が目的でもあります。
2. 動かすと座の**柱**（AS5600 を吊る 4 本・各 9.9 × 7.9）が INA226（29.2mm³）と PowerBoost（11.7mm³）の
   板に乗りました。柱は削れません（中心にナットの小判スロットが入っていて、左右に残る肉は片側 2.7mm）。
   → 「**バッテリー自体のってるブリッジの帯ごと左に 4mm 移動**」で `BAT_DX` を +1 → **−3**。
   電池・皿・脚・帯 A/B/C・座・両基板が `BAT_X0` から出ているので、この 1 つでまとめて動きます。
   これで柱と両基板の当たりは**完全に 0** になりました。
3. 帯ごと動かすと、今度は INA226 の INPUT/OUT が左の壁に当たりました（板の左端 `1.30` ／ 壁の内面 `1.694`）。
   → 「**INA の傾斜を無くして、左壁側のピンヘッダを垂直にしたらどうだろう**」で
   **INA226 だけ水平（`INA_THETA = 0`）＋電源の口を直立て（`pwr_ra = false`）**。
   ⚠ AI は最初 `ra`（I2C の 5 ピン）を立てて取り違えました。座標で確かめたところ、
   **左壁側の口は電源（INPUT/OUT 4 本）** で `X 4.03〜17.07`、I2C は `X 38.50〜41.80` の右側でした。
   L 字は板の縁の外へ 11.8mm 伸びていたので、直立てにすると板の左端が `5.30 → 14.53` になり、
   壁まで 12.8mm 空きます。傾斜を外したのは、直立ての口の頭を 2.06mm 下げるためです
   （`Z 51.66 → 49.60`。帯ごと動かした後の実寸は `46.00` で天井 `48.454` の下）。

### 15.3 併せて直したもの

- **ReSpeaker の押さえの腕** `ARM4_X1` を `54.7 → 52.4`（スピーカーの左端 52.72 と 0.32）。
  左へ寄せる案（45.3〜50.0）は OLED の線の帯（`X 37.9〜48.1・Z 45〜48`）に 20.5mm³ 入るので採りません。
  `chk_press` は 5.94 → **4.66**（0 なら押さえが板に届いていない印なので、これは正）。
- **欠き ④** の右の縁を `KNOB4[0] − 10.954` → `− 6.954` に。板の左端が 4mm 伸びたぶん、
  欠きの右の縁を**元の絶対位置 56.25 のまま**にして、トグルの線の道を動かさないためです。
- **会話ボタンの受けの上の角に幅 5 の縦の溝**（`X 9.3〜14.3・Y 17.8〜22.6・Z 45.9〜48.454`）。
  INA の一番手前のピン（`Y 19.87`）が受け（`X 9.5〜37.4・Y 6.8〜21.8・Z 39〜48.4`）の真下に来て、
  口の頭 `46.0` と受けの底 `47.1` の間が **1.1** しか無く、線（1.5）が通らなかったためです。
  下から開いた溝なのでブリッジは要りません。
  🔴 **初版はこの溝を高さ 3.0（`Z 45.9〜48.9`）で切って、天板に 0.446mm 食い込ませました。**
  会話ボタンの皿の底は `Z 48.454〜48.704` の **0.25mm しか無い**ので、重なった `X 12.4〜14.3・Y 17.8〜20.9` が
  抜けて、**天面の表に穴が開きました**。ユーザーが CAD（`part="explode"`）で見つけたものです。
  当たり検査は全部 0 のままでした ── **皮に穴が開いても「当たり」は増えないので、`chk_*` では見つかりません。**
  外から見る絵（`part="p_top"` / `look`）を必ず 1 枚見ること。溝は `IN_Z` で止めて直しました。
  溝を見る絵は `part="btnslot"`（[_v4_btnslot.png](../hardware/frozen/v1-v4/_v4_btnslot.png)）。
  ⚠ 受けの**首**（`Z 46.5`）は 5.7mm² のまま無傷。受けの**板**は 375.0 → 355.8mm²（−5.1%・左端の角）。
- **`PB_DX` / `pb_wx()` / `ina_wx()` を新設。**板に付く物（DuPont・線の端点・天板の USB 逃げポケット）は
  旧 `BAT_X0 = 15.5` のときの絶対値で書いてあったので、帯ごと動かしたぶんを足して追従させました。
- **座の関数に板ごとの角度を通しました**（`seat_d` `seat_vert` `seat_nut_d` `slot_ceil` `slot_ok`
  `seat_nut_ceil` `seat_hole` `seat_bolt` が `th` を取る。既定は `THETA`＝PowerBoost 用）。
- **線 8 束の引き直し**: OLED・BTN2・PHIN・INA の I2C・電源 3 系統・つまみ・スピーカー OUT・リード。
  効いた事実を 3 つ残します。
  - **BTN2 の立ち上がり**は旧 `X 11.75・Y 17.4` が皿の下に入りました。撃って探した空き車線は
    **`X 3.5〜7.0` の `Y 28`**（J2 の確保空間 `Y ≤ 25.03` の後ろ・皿の縁 `9.0` の左）。
  - **2 枚の板は Y で重なっていて**（INA `16.17〜36.27`・PB `32.77〜66.31`）**間に廊下はありません。**
    電源 2 本は直立ての口の頭の上（`Z 46.8`）を東へ走らせて PB の JST の上で降ろしました。
  - **OLED の前走り**は、その電源 2 本の後ろ（`Y 35.6`）を渡って、電源が降りた後（`X 41.0`）で前へ出ます。

### 15.4 いまの検査（2026-08-26・`--backend=manifold`）

`chk_all` / `chk_wire` / `chk_wire_w` / `chk_wire_pwr` / `chk_t1` / `chk_tc` / `chk_top_spk` /
`close_lwall` / `close_top` / `close_tc` / `chk_shut_slide` / `chk_shut_out` / `chk_swap` は **すべて 0**。
`close_rwall` 0.01・`close_front` 0.13・`close_hatch` 0.02 は 0 厚の膜で既存値のまま。`chk_press` 4.66 が正。

**工具と手の道は 33 本すべて通ります（`python hardware/frozen/v1-v4/_asm_access.py`）。**
OLED の右のナットの空きは **1.3 → 15.7mm**。判定の「要る mm」は初版の 8.0（根拠の無い仮値）を
**ナットの厚み 1.6** に直しました。

### 15.5 電流計の座の 0.1mm（同日・`INA_LIFT`）

水平にしたぶん電流計の座は `2.5`（帯の天板 2.0 ＋ 板の浮き 0.5）しか無く、**M2×4 の先と帯の天板の裏
＝電池の上面が 0.1mm** でした。断面を見る絵を `part="seatgap"` で足して（[_v4_seatgap_zoom.png](../hardware/frozen/v1-v4/_v4_seatgap_zoom.png)）、
🔒 ユーザー「0.1 はきついですね」。

ユーザーの問い「**浮きをふやしたらネジの長さは長くすべきなのでは**」への答えは **いいえ** です。
この座はナットが**天井**に居ます（`slot_ceil` ＝ 板の裏から 0.4 下）。板を浮かせるとナットも一緒に上がるので、
ネジから見た距離は動かず、増えるのは**ナットの下の床**だけです。実測で確かめました。

| 電流計の座 | 浮き 0.5 | 浮き 1.0（`INA_LIFT`） |
|---|---|---|
| ナットの上面（板の裏から） | −0.4 | **−0.4（変わらず）** |
| 掛かり | 1.6 | **1.6（変わらず）** |
| ナットの下の床 | 0.4 | 0.9 |
| **ネジの先 → 電池の上面** | **0.1** | **0.6** |

`seat_d` / `seat_nut_d` / `slot_ok` / `seat_nut_ceil` / `seat_hole` / `seat_bolt` に `lift` 引数を足し、
電流計だけ `INA_LIFT` を通しています（既定は `BOARD_LIFT`＝PowerBoost 用）。
板の頭（直立ての口）が `46.0 → 46.5` になるので、そこから出る電源 4 本も `46.8 → 47.3` へ追従。

🔴 このとき `46.8]` を一括置換して**トグルの線まで巻き添えで上げ**、欠き ④ の天井（`Z 48.0`）を
0.05 超えました（`chk_all` 0.88mm³）。座標の一括置換は、当たった行を必ず目で確かめること。

## 16. 蓋のスライドを下から横へ（2026-08-26・[case_v4_shutter.scad](../hardware/frozen/v1-v4/case_v4_shutter.scad)）

出発点はユーザーの指摘です。「v4 のバッテリーのロック機構は v3 のものを 180 度回転させてしまっている。
こんな事をするとロックが無いと蓋が空いてしまうので 1 から考え直さないといけない」。

そのとおりでした。v3 の蓋は**上へ持ち上げて外す**型なので、手を離せば自重で閉じ位置に戻り、ロックは念のための止めでした。
§11 はそれを 180° 回したので、自重がそのまま開く向きに効きます。ロックのビスを外した瞬間、蓋を押さえているのは
φ6×2.0 の磁石 2 個だけになる。ファイル冒頭には v3 の「外せば磁石だけで開閉」という文言がそのまま残っていて、
v4 では意味が変わっていました。**ロックが念のための止めではなく構造材になっていた**のが誤りです。

### 横へ回せるかを測った

上は §11 のとおり潰れています（線と DuPont）。そこで横を測りました。

- ハッチの面: 帯の右に 36.7mm、左に 8.66mm 空いている。逃がすのに要るのは `SHUT_SLIDE` = 5.5mm
- 中身との当たり: 帯＋裏の増し肉を**右へ** 5.5 伸ばすと **0mm³**。**左へ**だと Type-C 基板に **45.49mm³**
  （あの板はハッチ内面ではなく左壁の内面にベタ付けなので、左端は使えない）
- 横スライドにすると耳が上下（±Z）へ回るので帯が上下に広がる。その最小の外形で当てると、当たったのは
  **PB の L ピン 3 本（`w_pwr3`）だけ**で 59.83mm³。基板にも壁にもボスにも当たらない

**ユーザー指示で 2 枚に分ける案も測りました。**左のパネルを左へ逃がすには帯の左端が X −1.85 まで要り、
ハッチの端は −0.31 なので 1.54mm 足りません。磁石の部屋を左端に置かなければ収まりますが、
**左のパネルの磁石を置く場所が無くなります**。1 枚のまま右へ滑らせれば足りるので、分けていません。

### 形

型は v3 のまま、軸だけ 90° 入れ替えました。

- スライドは **+X（右）**、耳は上下（±Z）、磁石の部屋（`SHUT_EXT`）は口の**左右**
  （口は Z に 7mm しか無いので、磁石を上下には置けない）
- 耳は上下 1 個ずつ・X の中央。v4 と同じで「上下が同じ位置」でないと逃がし口を 1 か所で通れない
- 逃がし口（リップを抜く所）は帯の**右端**。ここにロックが座る
- ロックは 🔒 ユーザー希望で残した。門形の縦棒が帯の右端、脚が左へ、舌（半円）が蓋の右端に乗る。
  ナットは v3 と同じで上から落とし込む

### 意匠（🔒 ユーザーの朱書き）

- **ロックの外端に、ビスを中心にした半円（`SW4_NOSE_R`）を出す**
- **舌が枠に刺さる 2 か所の入り隅の角を取る**（`SW4_FILLET`。膨らませてから縮める処理でまとめて取る）
- **枠の右端の角丸は足先と同じ小さい角にする**（旧 `SHUT_R - SHUT_CL` = 2.25 → `SHUT_LK_RF`）。
  大きい角丸のままだと、半円の左右に丸い耳が残る

🔴 このとき、彫り込みの角丸を手で数字合わせしていたため「ロックは角が取れているのにハッチは角張ったまま」が
上下で 2 回出て、ユーザーに「仕事が粗い」と言わせました。**彫り込みはロックの輪郭そのものから
`offset(r = SHUT_CL)` でくり抜く**ように直しています。ロックの形を変えれば彫り込みが自動で追従するので、
同じ取り残しは起きません。

### 線の引き直し

`w_pwr3` の 3 車線を **Z 32.2/33.7/35.2 → 35.2/36.7/38.2** へ上げました。
下（Z 20 以下）も測りましたが、筐体の芯と信号線でふさがっていて通りません。空いているのは
ハッチ内面ぎわの Z 34.0〜39.25 と、帯より右（X 61〜64）の縦の道だけです。線は帯の上を右へ走り、
その縦の道で下ります。降りる場所は §11 と同じ（X 64/66.5/69）。

**ユーザーから「1mm や 2mm ならハッチを後ろに下げてもいい」という申し出がありましたが、これは効きません。**
帯の裏の増し肉はかわせますが、ロックのナットのボスはハッチから内側へ深く出ているので、
ハッチを下げるとボスがそのぶん奥へ進んで、かえって線に食い込みます（実測で 21.26 → 30.38mm³ に悪化）。

### 検査（manifold・全部 0）

`chk_shut_slide`（右へずらす軌跡）・`chk_shut_out`（蓋を後ろへ抜く）・`chk_lock_out`（ロックを後ろへ外す・新設）・
`chk_swap`（電池を後ろへ抜く）・`chk_wire_pwr`・`chk_wire_sig`。
刷る向きの底 Z も確認済み（`print_shutter` 2.75 高・`print_lock` 3.0 高・どちらも底 Z 0）。

### 交換の手順（§11 から向きだけ変わる）

M2 を 1 本外す → ロックを後ろへ外す → 蓋を**右へ** 5.5 ずらして後ろへ抜く → 電池の JST を抜く → 電池を後ろへ引き出す。

⬜ ユーザー: 蓋の裏 ↔ 電池の尻の遊びの詰め物。ロックを常時締める運用にするか。

## 17. 組む順の掃引で出たブリッジ ↔ J2（2026-08-26・[_v4_core.scad](../hardware/frozen/v1-v4/_v4_core.scad)）

**組み立てマニュアル（[assembly_v4.html](../docs/manual/assembly_v4.html)）の検算で見つかりました。**
静止の検査（`chk_all` ほか §15.4 の一覧）は全部 0 のままなのに、**手順 5「ブリッジを上から降ろす」が成立していませんでした。**

### 何が当たっていたか

皿の左縁 `X 9.00` が、ReSpeaker の **J2（スピーカーのソケット）の右端 `X 10.08`** に **1.08mm** 入っていました。

| 相手 | 量 | 区画 |
|---|---|---|
| J2 ソケットの**実体** | **7mm³** | `X 9.00〜10.08 / Y 12.90〜16.87 / Z 21.40〜23.40` |
| プラグ＋線の**確保空間**（§2 の「面から 15」）| 17mm³ | 同じ X で `Y 16.87〜25.03` |
| 降ろす軌跡 `CHK="brg"` の合計 | 60.5mm³ | 上の 26 ＋ BTN2 の枝 35（枝の相手のタクトは手順 10 の部品なので、この時点では存在しない）|

出どころは §15.2 の 🔒「バッテリー自体のってるブリッジの帯ごと左に 4mm 移動」（`BAT_DX` +1 → −3）です。
皿の左縁が **13.0 → 9.0** になり、**4 のうち最後の 1.08 が J2 に乗りました**。
静止の検査は全部回し直しましたが、**`_asm_sim_v4.scad` の組む順の掃引だけ回していなかった**ので素通りしました。

### 選択肢と代金（測った値）

| | 消えるもの | 代金 |
|---|---|---|
| ① 皿の前左の角を欠く（`X 9.0 → 10.2` を `Y 12.9〜16.9`）| ソケットの実体 7mm³ | 留め帯 A の左足の座が `Y 15.45〜16.9` の 1.45mm だけ幅 2.0 → 0.8 |
| ② ①を `Y 25.1` まで伸ばす | 確保空間も含めて全部 | 帯 A の左足の座 8mm 全部が 0.8 幅＋左の土手の根元 3.6mm が 1.1 幅 |
| ③ 帯ごと右へ 1.1 戻す | 全部（欠き無し）| **落ちる。**板を +0.5 で天面の部品に 0.13mm³・**+1.1 で 3.49mm³**。§15.2 の「柱が INA/PB の板に乗る」が戻る |
| ④ J2 の確保空間を詰める | 確保空間の 17mm³ だけ | **落ちる。**ソケットの実体 7mm³ が残るのでブリッジは降りない |

### 🔒 ユーザーの選択は ①

`BRGJ2_X = 10.2` / `BRGJ2_Y = 16.9` と `brg_j2_cut()` を新設し、`brg_v4()` の `difference()` に足しました。
欠くのは**皿（`Z 21.4〜23.4`）だけ**で、左の土手は `Y 21.45` から始まるので触れていません。

- ✅ ソケットの実体との当たり **7 → 0**（掃引・静止とも）。`CHK="brg"` は 60.5 → **46.4**。
- ⬜ 確保空間へ **16.3mm³** 残る（`W="brgchk"`）。「基板面から 15」は仮の包絡なので、
  **PHR-2 の尻の実測が出るまで保留**というのが ① の中身です。
- 留め帯 A の左足の角とソケットの頭は **0.09mm** 重なりますが（`X 9.23〜10.08`・0.08mm³）、**項目にしません**。
  ユーザーの手の精度は 0.3mm で、印刷の公差より小さい値です。**検査の非ゼロを全部項目に格上げすると宿題が際限なく増える**ので、
  この筐体では **0.3mm 未満の重なり／0.5mm³ 未満の当たりは報告しない**ことにします（0 厚の膜と同じ扱い）。

### 掃引の検査（2026-08-26・欠きを入れた後）

`CHK="bat"` / `"whigh"` / `"top_oled"` は 0。`"strap"` `"strap_dry"` は 0.57（帯 A の左足 ↔ J2 の確保空間・上記）。
`"boards"` 12.0 のうち 11.4 は BTN2 の枝（手順 10 の部品）で、残り 0.6 が電流計の縁 ↔ 帯 A の座（§既知）。
反例は `"rsp_after"` 444・`"brg_bad"` 1037・`"strap_top"` 81・`"strap_bad"` 201・`close_desk` 156 で、**順番の縛りは効いています**。

## 18. 4 度目の机上の通し（2026-08-27・[assembly_v4.html](../docs/manual/assembly_v4.html)）

3 度目までの検査は、**部品が通るか**（当たり体積）と**ビス・ナット・指の道**（円筒の探針）でした。
4 度目は残っていた最後の動き——**コネクタを口に挿す動き**——を初めて当てました。
口の座標は手で写さず、[_asm_plugs.scad](../hardware/frozen/v1-v4/_asm_plugs.scad) が口だけを STL に出して bbox から取ります。
線は口と一緒に動くので障害物に数えられません。線を抜いた段（`ST="st9r"` / `"st10r"`）を
[_asm_sim_v4.scad](../hardware/frozen/v1-v4/_asm_sim_v4.scad) に足しました。

### 🔴 T-4 充電とスピーカー IN の口を挿す手順が、どこにも書かれていなかった

- **充電の 2 本（Type-C 基板側）**。口は `X 4.52〜7.07・Y 48.67〜58.67` の縦 2 段（`Z 3.99〜9.07` と `14.15〜19.23`）。
  **下の口は上の口の真下**なので、壁を降ろした後に真上から届くのは上の口の頭（`Z 19.23`）までで、下の口には触れません。
  手順 5 でブリッジの帯（`Y 50.5〜62.9`・全幅）が載ると、上の口も **23.6mm**（頭の 7.2 上）で止まります。
  ⇒ 手順 4 の行に「**板を手に持っているうちに挿す**」を書きました。CAD は触っていません。
- **スピーカー IN の J2 側**。手順 5 で皿（`X 9〜49・Z 21.4〜23.4`）が真上に載ります（真上から φ5 が 22.6mm ＝
  口の頭 `Z 23.5` の 3.9 上で止まる）。⇒ 手順 3 の行に「**J2 側もここで挿す**」を書きました。
- 手順 9 で挿す 9 か所（電流計の電源 4・I2C・PB の L 3 ピン・USB・OLED）は、挿し代 6.0（`parts.scad` のピンの出）に対して
  全部通りました。OLED だけは**天面を載せると 1.6 で止まり**、以後は抜けません（挿すのは手順 9 のうち）。

### 🔴 手順 3 の車線の分け方が 1 つずれていた

「上へ登る 5 束」に**充電**が入っていて **PWR** が抜けていました。ハブの口は `PLUGGED_9`（[case_base.scad](../hardware/frozen/v1-v4/case_base.scad)）の
`XIAO/PHIN/OLED/AS5600/BTN2/REED/PHOUT/PWR/INA/TOGGLE` の 10 本で、**充電の口はハブにありません**
（充電は Type-C 基板と PowerBoost をつなぐ線で、板は手順 4 に来ます）。手順 3 の行を直しました。

### ✅ 手順 12（ハッチの姿勢）の線の長さを測った

トグルはハッチに付くので、`TOGGLE` の 2 本は**ハッチを箱から離したまま**繋ぐしかありません（天面もフロントも閉じている）。
[_asm_wirepose.py](../hardware/frozen/v1-v4/_asm_wirepose.py) に `hatch()` を足して測りました。固定点は線が後ろの縦穴の頭で前へ折れる角
（`[55.2, 64.76, 46.8]`・そこまで 30.8mm）で、そこから先を後ろの口へ引き出します。

| ハッチの置き方（外の面を下・箱の後ろ・すきま 10） | 要る長さ | 組んだ姿勢との差 |
|---|---|---|
| **上下を返して置く（トグルが箱側）** | 71.6mm | **+14.3** |
| 一番要らない置き方（180° ＋ 15mm ずらす） | 68.8mm | +11.4 |
| そのまま置く（レバーが奥） | 102.4mm | **+45.1（+40 の増しに入らない）** |

⇒ マニュアルの手順 12 に「**繋ぐ**」動作と置き方を書きました。⬜ 残るはアンテナ線（同軸の実物が未取得）。

### 🔴 接点の座標表（`W="pts"`）が 4mm 古かった

「数字を書き写して増やさないこと」と自分で書いてある表が、🔒 2026-08-26 の「帯ごと左に 4mm」（`BAT_X0` 15.5 → 11.5）に
追従していませんでした（PB の L ピンが `32.2/24.58/22.04` のまま＝実際は `28.2/20.58/18.04`、電池タブの Y も 62.9 → 63.9）。
`pb_wx()` / `BAT_X0` を通して計算するように直し、INA の電源口が **L 字ではなく直立て**（🔒 2026-08-26）になっている
のも書き直しました。

### 止まっていないもの

工具と手の道は **52 本すべて通ります**（うち 3 本は反例＝止まるのが正）。静止と軌跡の検査は 3 度目から変わっていません。

## 19. 5 度目の机上の通し（2026-08-26 深夜・[_asm_access.py](../hardware/frozen/v1-v4/_asm_access.py)）

日付は `Get-Date` の実測です（§18 は 2026-08-27 と書いてありますが、こちらが実際の日付。ずれは直していません）。

4 度目までに当てたのは、部品の軌跡・ビスとナットを**落とす／差す**道・指の道・**口に挿す**道でした。
5 度目に当てたのは 2 つです。

### ✅ 口を「持つ」道（19 か所・全部通る）

⑧（4 度目）はコネクタを**口そのものの太さ**（φ3.6）で撃っていました。口は指かピンセットに掴まれて動くので、
φ3.6 が通っても道具が通るとは限りません（2026-08-26 に OLED の L のナットで同じ間違いをしています。
φ2.0 で撃って通し、実際は二面幅 4.3 のナットが 0.19mm で止まっていた）。

- 手順 3 のハブの口 **10 本**（座標は手で写さず [_asm_plugs.scad](../hardware/frozen/v1-v4/_asm_plugs.scad) の `P="hub"` の echo から取る）:
  ピンセット φ5 も指 φ12 も**外まで**通る。この時点では壁もブリッジも無い。
- 手順 9 の **9 か所**: ⑧ と同じ軌道を φ5 で撃ち直して全部通る（電流計の I2C だけ 35.0mm でその先が閉じるが、要る 6.0 は満たす）。

### 🔴 T-6 手順 1 の M3 ナットを**回す**道が、後ろ左だけ φ7.19 しか無い

ハブを留める M3 は 4 本とも、**ビスの頭が丸いザグリ**（`φ6.0 × 2.2`・`M3_HEAD_D` / `M3_HEAD_H`）に座ります。
六角ポケットではないので**回り止めがありません**。ナットを回すあいだ、下からドライバで頭を押さえることになり、
ナットの側には**工具の外径**ぶんの縦の道が要ります。**落ちる道（ナットの対角 6.7）とは別の数字**です。

| 穴 | ナットが落ちる道 | 座 `Z 4.1` まで届く一番太い円筒 |
|---|---|---|
| 前左 `[9.0, 18.9]` | 通る | **φ16.82** |
| 前右 `[77.0, 18.9]` | 通る | **φ16.49** |
| 後ろ右 `[77.0, 64.9]` | 通る | **φ10.12** |
| **後ろ左 `[9.0, 64.9]`** | 通る（対角 6.7 に対して 7.19 ＝ 片側 0.25） | **φ7.19** |

塞いでいるのは **Type-C 基板の受けの ⑤ 補強の三角**（[case_v4.scad](../hardware/frozen/v1-v4/case_v4.scad) `tc_seat4()` の
`polygon([[4.70, 0], [5.9, 0], [4.70, 10.0]])`・`Y 62.0〜65.5`）です。`Z 0` で `X 5.9`、`Z 10` で `X 4.70` まで
斜めに引っ込むので、ナットの座 `Z 4.1` の高さでは `X 5.408`。穴の中心 `X 9.002` からの距離が **3.594** ＝ 直径 **7.19** で、
測定値とぴったり合います。三角の右端 `X 5.9` はハブ基板の左端 `6.002` の 0.102 手前（`tc_seat4` のコメントに既出）。

- **横からのスパナも入りません。**ナットの高さ（`Z 5.3`）で φ6 を撃つと、左からは中心の **5.5mm 手前**、
  後ろからは **7.1mm 手前**で止まります（ハブ基板の実装部品）。ナットを掴むには中心まで 2.75 に寄る必要があります。
- ✅ **要る外径が実測で決まりました。**5.5mm のナットドライバのボックス外径は **9.0mm**
  （📄 HOZAN `D-840-5.5`（M3 用）の寸法表・深さ 18・軸 φ5）。初版に書いた 8.0 は AI の仮値でした。
  **後ろ左は 7.19 なので入りません。**他の 3 本は入ります（後ろ右 10.12 ＝ 片側 0.56 の余裕）。
- 三角を `X 4.75` まで欠くと **φ8.60**（次に効くのは ④ 控えの表 `X 4.70`）で、**9.0 にはまだ 0.40 足りません**。
  欠く量は三角の断面 6.00mm² のうち **5.51mm²**（体積で 21mm³ のうち 19.3mm³）＝**ほぼ全部**で、
  ④ の控えは幅 1.156・高さ 20.5 の片持ちだけになります。
  そこから 9.0 にするには、**控えの表を `Y 63.58〜66.22` の帯で最大 0.198mm 削ぐ**必要があります
  （`X 4.70 → 4.502`・厚みは 1.156 → 0.958）。⇒ 🔒 ユーザー判断（[CASE-V4-OPEN.md](CASE-V4-OPEN.md) T-6）。**CAD は触っていません。**
- 🔴 **初版に書いた「ピンセットか細いラジオペンチで押さえる」は、ラジオペンチが誤りでした。**
  ナットの二面幅 5.5 を挟むので、掴み代は **片側 (7.19 − 5.5) / 2 = 0.845mm** です。先がこれより厚い物は入りません。
  他の 3 本は 5.7 / 5.5 / 2.3（片側）。この値も `_asm_access.py` が出します。

### 🔴 T-7 手順 1 の「裏返して 4 本通してから起こす」は、そのままでは成立しない

床を裏返してザグリへ M3×8 を 4 本落とし、**床を起こす**とビスは 4 本とも落ちます。ザグリは丸くて
（`φ6.0 × 2.2`）掴む物が無く、通し穴 `φ3.4` はビスの胴 3.0 より広いからです。ナットを掛けるまで
ビスを保持する物が、この手順のどこにもありません。

床を台か机の端に載せることも、手順 1 には書いてありませんでした（手順 4 の「箱を伏せずに机の端か台に載せる」と
同じ条件が、手順 1 にも要ります。下からドライバを入れるので）。⇒ **マニュアルの手順 1 を、
台に載せて 1 本ずつ通し、その都度ナットを掛ける書き方に直しました。CAD は触っていません。**

### 検査（99 本・止まりは T-6 の 1 本）

`python hardware/frozen/v1-v4/_asm_access.py` を 52 → **99 本**にしました（⑨ 口を持つ道 19 本・⑩ 手順 1 の M3 まわり 18 本）。
止まるのは「後ろ左のナットを回す工具」（T-6）だけです（要る 9.0 は 📄 HOZAN D-840-5.5 のボックス外径）。掃引の当たり（`CHK=...`）と静止の検査は 4 度目から動いていません。

### 🔒 T-6 のユーザー決定（2026-08-26）

**①（工具を足さない）。**「ピンセットの先の厚みが片側 0.8mm 以下ですか」に対して **「はい。鋭いですからね」**。
後ろ左の 1 本は、手持ちのピンセットでナットを押さえ、下からビスを回します。**受けの三角は欠きません（CAD は触っていません）。**
マニュアルの手順 1 は「選択肢」から「そう締める」という書き方に直し、`_asm_access.py` の後ろ左のナットドライバの行は
**反例**（止まるのが正）にしました。⇒ 99 本すべて通ります（うち 4 本が反例）。

なお、要る外径を調べたのは **8.0 という私の仮値では「買えば済むのか」を判定できなかったから**です。
呼びの **5.5 はナットの二面幅**で、ボルトの M3 とは別の数字です（M3 のナット ＝ 二面幅 5.5）。

---

## 20. D-1 充電基板の受けを床から出した（2026-08-27・[case_v4.scad](../hardware/frozen/v1-v4/case_v4.scad)）

床は `Z 10` から上、この受けしか無く、断面 8.4mm² のまま `Z 20.5` まで続いていました。床の背が **8.5 → 22.5mm**、
層数 **170 → 450**、CHITUBOX の見積りが約 25 分 → **1h04m50s** です。分けて刷れば床は 25 分に戻り、
受けは `4.21 × 19.8 × 20.5`・257mm³ を寝かせて刷るだけになります。

### 落とした案 ① 左の壁の部品にする（🔒 ユーザーが一度こちらを選んだが、測って取り下げた）

壁の刷る背は **9.00mm のまま変わりません**でした（壁の内面から一番出ている棚が 7.4mm あり、受けの 4.21mm は
その下に隠れる）。**時間の面ではタダ**です。ところが**板が受けに入りません**。

| 板を受けに入れる動き | 受けが床（いま） | 受けが壁 | 塞いでいる物 |
|---|---|---|---|
| 横から壁の面へ当てる（−X） | **0** | **111.4mm³** | ④ 後ろの控え 98.0（全高 20.5）／③ 前の返し 13.4 |
| 後ろから差す（−Y） | **0** | **48.5mm³** | ④ ↔ 板の L 字コネクタ 2 段（`Z 3.99〜9.07` / `14.15〜19.23`） |
| 壁の面を真下へ滑らせる（−Z） | 61.6mm³ | 61.6mm³ | 天面の後ろ左のボス 56.5（`Y 65〜72・Z 39.45〜44.50`）＋ 押さえ 5.1 |

⭐ **理由は 1 つです。** 受けが**床**に在るあいだ、板は受けに対して**真下**へ入り、返し 2 枚（③④）は板の脇に立つので
当たりません。受けが**壁**の部品になると板は受けと一緒に動いてしまうので、どこかで受けに対して入れ直す必要が出ます。
その道が 3 方向とも無い、ということでした。**一部だけ移す逃げもありません**（床の背を 8.5 に戻すには ②③④⑤ が
全部出る必要があり、③ か ④ が壁に在るかぎり横からの道は塞がる）。

### 落とした案 ② ストッパーをねじ止めする（🔒 ユーザー提案・場所が無くて採れなかった）

ケーブルを挿す力は口の中心 `Z 10.5` に効きます。床の枠だけで受けると腕が残るので、落とし込んだ後に前から差し込む
ストッパーで高い所を受ける、という案でした。機構としては正しかったのですが、**ビスの座が置けません**。
受けの前は 壁（`X 1.694`）と デュポンのハウジング（`X 4.524`）に挟まれた **2.83mm 幅**のスリットだけで、
M2 の通し穴 φ2.5 ＋ 肉に要る 4.1mm が入りません。前の上（`Z 9〜20`）・後ろ（`Y 68.6〜72`）・後ろの上も当たっていて、
ナット（二面幅 4.3）の座に要る 5.5 角が取れる所は 1 つもありませんでした。

### 採った形（🔒 ユーザー了解）

**⑤ 前の三角を落として、床の枠が ② 前の当ての前面を面で受ける。**

- ⑤ の**斜面に噛む形の枠は庇**になり、受けを真上から落とせなくなります（持ち上げるほど斜面が前へ出るため）。
  三角を落とすと ② の前面が `Z 0` から平らに出るので、**垂直どうし**で落とし込めます。
- 枠は `X 1.694〜4.25・Y 54.50〜55.70・Z 0〜6.5`（`seat_frame4`）。腕は 10.5 → **4.0mm**。
- 🔴 **枠の背 6.5 は「床の上に立っている物の頭」です。** 一度 8.5 で作って刷る背が 8.50 → **10.50** に伸びました。
  **床の刷る背 8.50 は床板の厚み 2.0 を含んだ数字**で、床の上の物の頭は世界の `Z 6.5`（ReSpeaker の溝の壁）です。
- **ビスはありません。** 受けが動ける 4 方向を、それぞれ別の物が止めます ── `−Y` 枠／`−X` 左の壁の内面
  （受けの裏がそのまま `X 1.694`）／`+X` ハブの後ろ左の柱（φ7・左端 `X 5.5` に 0.3mm）／`+Y` ハッチの内面。
- ⚠ 受けが単体（箱に入る前）のときは ② が `2.556 × 1.2 × 20.5` の柱になって折れやすくなります。

### 入れる順は 1 通りだけ

**手順 1〜3 の後、手順 4 の頭で真上から落とす。** `chk_seat_in` の `SEAT_STAGE` で測れます。

| 段 | 真上から | 何が起きるか |
|---|---|---|
| 手順 1〜3 で置く | 0（入る） | ❌ 後ろ左の M3 ナットの道が `φ10.1 → φ7.19` に狭まる |
| **手順 4 の頭** | **0** | ✅ これが正 |
| 板と壁の後 | 255.5mm³ | ❌ ① 底の座が板の下へ入るので通れない |

⭐ **手順 1 の「後ろ左だけピンセット」（T-6・🔒 2026-08-26 のユーザー決定）は、これで消えました。**
塞いでいたのは受けの ⑤ 補強の三角で、手順 1 の段には居なくなったからです。**4 本ともナットドライバ**
（📄 HOZAN `D-840-5.5`・ボックス外径 9.0mm）で締まります（道は 16.8 / 16.5 / **10.1** / 10.1）。

### ついでに直した当たり

⑤ 後ろの三角がハブの後ろ左の柱（`[9.0, 64.9]`・左端 `X 5.5`）と **0.85mm³ 重なっていました**。受けが床の一部だった
あいだは同じ部品どうしなので union で溶けて見えませんでしたが、別部品になると別々の印刷物が同じ場所を取り合います
（`chk_floor` 0 → 0.85 / `chk_lwall` 0.06 → 0.92 で出ました）。柱を 0.3 の逃げ付きで欠いてあります。
⚠ 逃げの実績に書いてあった「⑤ の右 5.9 ↔ ハブの左端 6.002 = 0.102」は**基板の縁**との距離で、その下の柱を
見ていませんでした。**同じ場所に 2 つ相手が居るときは、近い方を測る。**

### 使った道具（作り直せます）

- `hardware/_pf/_split.scad` ── 床を「受け」と「受け以外」に割って測る。空きを探す probe も全部ここ。
- `hardware/frozen/v1-v4/_d1_fig.scad` ＋ `hardware/frozen/v1-v4/_d1_fig.py` ── 4 枚の絵（`_d1_floor` / `_d1_near` / `_d1_wall` / `_d1_side`）。
- `hardware/frozen/v1-v4/_stl_v4.py` ── v4 の印刷部品 16 点を `hardware/stl/v4/` へ書き出す（それまで手順が文書に無かった）。

## 21. 刷る物を全部並べて見る `part="plate"`（2026-08-27・[_v4_plate.py](../hardware/frozen/v1-v4/_v4_plate.py)）

刷る部品が 16 点に増えて、「何を焼いたか」「どれが焼き直し前か」が一目で分からなくなっていたので、
**焼いた STL をそのまま 1 面に並べて見る絵**を CAD 側に足しました。OpenSCAD で
[case_v4.scad](../hardware/frozen/v1-v4/case_v4.scad) を開き `part = "plate"` にすると出ます。

並べているのはモデルではなく `hardware/stl/v4/*.stl` そのものです。STL は `PROPS_OFF=false` で焼いてあるので、
**支柱もラフトも犠牲タブも付いた状態**で並びます。つまりここに見えている物が、そのままスライサへ持って行く物です。
支柱とラフトは部品の下に付くため真上からは見えません。回して斜め下から見てください
（[_v4_plate_low.png](../hardware/frozen/v1-v4/_v4_plate_low.png)）。

置き方は [_v4_plate.py](../hardware/frozen/v1-v4/_v4_plate.py) が STL の外形から決めて
[_v4_plate.scad](../hardware/frozen/v1-v4/_v4_plate.scad) に書き出します（`_v4_props.py` と同じ流儀で、🔴 手で直しません）。
[_stl_v4.py](../hardware/frozen/v1-v4/_stl_v4.py) の最後から呼んでいるので、焼き直せば絵も一緒に付いてきます。

- **動かすのは X と Y だけで、Z は 1mm も動かしません。** 底が Z=0 に無い部品は浮いたまま並びます
  （`[FLOAT]` の名札も出ます。しきい値 0.05 は `_stl_preflight.py` と同じ）。
- 🔒 **色分けはしません**（2026-08-27 ユーザー「全部白くていいです」）。最初は古い STL を赤くしていましたが、
  やめました。焼いた時刻は名札に出したままなので、古い STL が混ざっていれば時刻を見れば分かります。
- 隙間は「見て区別が付く量」で、**プレートへの詰め方ではありません**。Mars 3 のプレートは 143 × 89mm、
  板は 100.66mm あるので 2 枚は並びません（[PRINT.md](PRINT.md)）。これは 1 回の印刷の割り付けではなく
  **刷る物の棚卸し**です。

⚠ 足した時点で 16 点のうち 9 点（top / front / hatch / lwall / rwall / shutter / lock / btn / tail）が
06:03 の焼きで、残り 7 点が 11:55 の焼きでした。前の 9 点は §20 の受けの独立と押さえの移設より前の STL なので、
刷る前に `python hardware/frozen/v1-v4/_stl_v4.py` を通してください。

---

## 22. 9 度目の机上の通し（2026-08-27・[assembly_v4.html](../docs/manual/assembly_v4.html)）

マニュアルに載っている検査を 1 本ずつ回し直して、数字が**いまのモデルでも出るか**を確かめました。
17 本とも同じ値でした（`wall_l` 0 / `wall_r` 0.012 / `brgf` 0 / `brgf_bad` 1450.3 / `brg` 46.4 /
`brg_bad` 1037.1 / `strap` 0.57 / `strap_dry` 0.57 / `strap_down` 15.0 / `strap_top` 81.1 /
`strap_bad` 201.3 / `bat` 0 / `boards` 12.0 / `oled` 0 / `whigh` 0 / `close_top` 0 / `close_front` 0.128 /
`close_hatch` 0.018 / `chk_all` 0.027 / `chk_press` 4.66 / `close_tc` 0 / `chk_tc` 0 / `brghw` 0 / `brgchk` 16.3）。
マニュアルが引いているスイッチ名 20 個も、全部ソースに実在します（8 度目に見つけた「`CHK` が無いのに 0 と
書いてあった」類は再発していません）。

### ① 掃いていなかった動きが 3 つありました

| 何 | 結果 | |
|---|---|---|
| ② ReSpeaker を床の溝へ差す | **0** | 反例（`rsp_after` 444.4）だけがあって、**入れる動きそのもの**が無かった |
| ④ 壁を降ろす（相手に**受け**を入れて） | **0 / 0.012** | 受けは 🔒 2026-08-27 に床から出た別部品で、手順 4 の**頭**に落とす。壁はその後に降りるのに、`wall_l` / `wall_r` の相手（`upto(3)`）に受けが居なかった |
| ④ 左の壁が **Type-C 基板を抱いて**降りる | **1.169mm³** | 下記 ② |

`CHK="rsp"` / `"wall_l_seat"` / `"wall_r_seat"` / `"tcwall"` / `"tcwall_bare"` として
[_asm_sim_v4.scad](../hardware/frozen/v1-v4/_asm_sim_v4.scad) に足しました。

### ② 🔴 充電の口（下）のハウジングが、ハブ基板に 0.11mm 乗っています

手順 4 は 🔒「充電の 2 本を挿すのは、板を手に持っているうち」です。つまり壁と一緒に降りるとき、板には
デュポンのハウジング 4 個が付いています。**その姿で当てたことが一度もありませんでした。**
既存の `close_tc` は板を `tcb_v4_bare`（デュポン**抜き**）で掃いていて、相手も `core() + floor_v4()` で受けが居ません。

- 当たり **1.169mm³**・`X 6.002〜7.065`（1.06）・`Y 48.669〜58.670`（10.0）・`Z 3.99〜4.10`（**0.11**）
- 中身は「下の口のハウジングの底 `Z 3.99`」と「ハブ基板の上面 `Z 4.10`」。ハブの左端は `X 6.002` なので、
  ハウジングが **1.06mm** ハブ基板の上へ張り出し、その底が板の面より **0.11mm** 下にあります。
- **掃引のせいではありません。静止でも同じ 1.169mm³ が出ます。** 板の Z は受けの ① 底の座（`Z 0.5`）が決めていて、
  ハウジングはそこから決まる高さに来ます。
- 板は 📄 秋月 `[115426]` の寸法図から起こしたもので**現物は未注文**、ハウジングも `2.54` 角の既定値です
  （[CASE-V4-OPEN.md](CASE-V4-OPEN.md) B-2・⑤）。⬜ どちらの数字も実測ではありません。

### ③ 🔴 中身どうしの静止を、誰も総当たりで当てていませんでした

②が 8 度素通りしたのは、静止の検査が **皮 ↔ 中身**（`chk_all` ほか）と **名指しの 1 対 1**（`chk_tc` など）
しか無いからです。中身どうしは、名前を挙げた組しか見ていませんでした。
[_asm_pairs.py](../hardware/frozen/v1-v4/_asm_pairs.py) を書いて 20 部品を総当たりしました（`PAIR_A` / `PAIR_B`）。出たのは 10 組で、
設計どおりの食い込み（ハブ ↔ 挿した口 1231.4／ReSpeaker ↔ 天面の押さえ 4.662）と、既に文書にある小片を除くと
**新しいのは②の 1 件だけ**でした。

| 組 | 当たり | 読み |
|---|---|---|
| ハブ基板 ↔ Type-C 基板 | **1.169mm³** | 🆕 上の② |
| 留め帯 ↔ 電流計 / PowerBoost | 0.369 / 0.367mm³ | 板の縁が座に食い込む分。電流計側は既知（[CASE-V4-OPEN.md](CASE-V4-OPEN.md)）だが、**PowerBoost 側は書かれていなかった** |
| ReSpeaker ↔ 留め帯 | 0.063mm³ | 既知。帯 A の左足の角 ↔ J2 の頭 0.09mm（§17） |
| ReSpeaker ↔ 右の壁 | 0.012mm³ | 既知。XIAO の口は殻の大きさ（逃げゼロ） |
| Type-C 基板 ↔ ハッチ | 0.016mm³ | 既知。充電の口も逃げゼロ |
| 左の壁 ↔ フロント / 右の壁 ↔ フロント | 0.064 / 0.064mm³ | 継ぎ目の 0 厚の膜（`close_front` 0.128 の中身） |

### ④ 🔴 工具と手の道の表が、6 時間前の形を測っていました

[_asm_access.py](../hardware/frozen/v1-v4/_asm_access.py) の `stage()` は `_access_tmp/*.stl` を
**在れば作り直さない**キャッシュでした。この日は 06:14 に焼いた STL が残っていて、
§20（受けを床から出す）より前の姿のまま測り続けます。実際、手順 1 の「後ろ左のナットを回す工具」は
`φ10.1 通る` が **`φ7.19` で止まる**に化けていました（＝受けが床に在った頃の値）。
マニュアルは「この表は作り直すたびに測り直すので古くならない」と書いてありますが、
**それが本当になるのはこの判定を入れてからです**。`hardware/*.scad` の一番新しい更新時刻より古い STL は
焼き直すようにしました（`fresh()`）。空にして測り直すと **104 本すべて通ります**。

### ⑤ 手順 6（留め帯）の手の道が 1 行も無かったので足しました

帯は「+2.0 ずらした位置へ上から降ろして、まっすぐ −X へ 2.0 押す」動きですが、当てていたのは部品の軌跡
（`strap` / `strap_down`）だけで、それを**する手**は一度も撃っていませんでした。

- 上から摘まむ: 3 本とも **指 φ12 が通る**（A 30.6 / B 36.6 / C 36.6mm・要るのは 27.6 / 24.4 / 27.2）
- −X へ押す: 横から差す道は **棒 φ3.2 なら 3 本とも通る**。指 φ12 は A が 2.6mm・C が 1.4mm で止まるので、
  横からではなく**天板に指を載せたまま**押します

### ⑥ ✅ 直しました（同日・板ごと 0.25 上げ）

②のハウジングとハブ基板の 1.169mm³ を 0 にしました。**この分割より前の版でも同じ 1.169mm³ が出ます**
（`git archive 2c504f7^` の木で `tcb_v4()` ∩ `hub_at()` を取ると同じ値・同じ bbox）。`tcb_v4` も `hub_at` も
`_v4_core.scad` の中にあり、D-1 の分割はそのファイルを触っていないので、**分割が作った当たりではありません**。

出どころは [case_base.scad](../hardware/frozen/v1-v4/case_base.scad) の `CHG_C_LW` に付いていた
「胴の下はハブの基板の上面（4.1）から 0.4」というコメントです。逃げ 0.4 を見ていたのは**胴の下（4.5）だけ**で、
その下に伸びる**ピン列のハウジング**（下の口の底 `Z 3.99`）を見ていませんでした。

- **直し**: 口の中心 `CHG_C_LW` を **`10.5 → 10.75`**（板ごと 0.25 上げ）。逃げは **0.14mm** になります。
- **なぜ 0.25 しか上げないか**: ハブの上面 `4.1` からブリッジの帯の裏 `21.4` までの **17.3** に、
  板 **16.51**（ハウジングの底から板の上端まで）・押さえ・🔒 遊び 0.2 が入る取り合いだからです。
  余りは **0.79** しかなく、いまは 逃げ 0.14 ＋ 遊び 0.2 ＋ 押さえ 0.45 で使い切っています。
- **押さえは式にしました**: `TC_PRESS = [58.6, 62.2, TCB_ZTOP + 0.2]`。🔒「板が上へ動ける量 0.2」を式で持つので、
  板の Z を動かしても遊びが変わりません。厚みは `21.4 − 20.95` ＝ **0.45**（📄 [PRINT.md](PRINT.md) の最薄 0.42 は超える）。
- **同じ数字の直書きを 3 か所やめました**: `TC4_ZT`（板の上端）は `TCB_ZTOP` へ、受けの ① 底の座は `TC4_ZB` へ、
  ハッチの口 `CHG4_C` の Z は `CHG_C_LW[1]` へ。**口と板が別々に動ける状態**だったので、ずれれば挿さらなくなります。

**検査は全部やり直しました。** `tcwall` 1.169 → **0** / 中身の総当たりからもこの組が消えた（残りは前と同じ 9 組）/
`chk_all` 0.027・`chk_lwall` 0.064・`chk_rwall` 0.076・`chk_hatch` 0.016・`chk_floor` 0・`chk_tc` 0・`chk_press` 4.662・
`close_lwall` 0・`close_rwall` 0.012・`close_top` 0・`close_front` 0.128・`close_hatch` 0.018・`close_tc` 0・
`brg` 46.4・`strap` 0.57・`bat` 0・`whigh` 0（全部前と同じ）。工具と手の道は **104 本とも通ります**。

### ⑦ 🔴 ついでに: 反例の 1 本が「差せる」に化けていました

`chk_tc_slide`（板だけを後ろから差し込む道・**止まるのが正**）が **0** ＝ 差せる、になっていました。
相手に**受け（`tc_seat4`）が入っていなかった**ためです。受けが床の一部だった間は `floor_v4()` に含まれていて、
D-1 で独立した瞬間に相手から消えました。文書に載っている 48.519mm³ はその前の値です。
相手に受けを足して **47.986mm³**（＝ 差せない）に戻しました。`chk_tc_drop` も同じ理由で 5.110 → **3.285** です
（こちらは受けを足しても変わりません。止まることに変わりはありません）。

### ⑧ 🔴 工具の表の「要る mm」も直書きでした

板を 0.25 上げた直後、「充電の口（上）へ真上から」が赤くなりました。**測る側は動いたのに、要る mm が
直書きの `19.23`（口の頭の Z）のまま**だったからです。ハブの口と同じように、口の頭を模型から取るようにしました
（`ST="tchous"` で下の口・上の口を STL に出し、連結成分の bbox から Z を読む）。いまは `19.5` と出ます。

⚠ **STL は焼き直しが要ります。** 形が変わったのは **左の壁**（押さえ）・**受け**（① 底の座 0.5 → 0.75）・
**ハッチ**（充電の口の Z）の 3 点です。`python hardware/frozen/v1-v4/_stl_v4.py`。

---

## 23. 11 度目の机上の通し — 電池のコネクタ対（2026-08-27・[_v4_core.scad](../hardware/frozen/v1-v4/_v4_core.scad)）

### ① 検査が穴を隠していました

組む手順 1〜12 は当たり 39 本・工具と手の道 104 本とも通りました。止まったのは**組んだ後の電池交換**です。

マニュアルの最後の「電池の交換」の 3 行目に「電池の JST を抜く」と書いてありましたが、
**抜く相手が図面にありませんでした。** 電池の線（`w_batin`）は電池のタブから電流計の INPUT まで 1 本続きで、
途中に外れる所がありません。手順 9 の「電源の 7 本」にも、線の表の 13 束 39 本にも、電池側のコネクタ対は入っていません。

それでも `chk_swap` が 0 だったのは、`world_no_door_bat()` が**その線を障害物から丸ごと外していた**からです。
線を残したまま同じ 45mm を引き出すと 65.6mm³ 当たります。

外せる所（電流計の INPUT）は `Z 46〜47.3` で天面の下です。電池の口が開いているのは `Z 23.5〜29.0` だけ
（φ5 のピンセットなら `25.5〜27.0`）で、そこから電流計へ届く直線はありません。

### ② ポケットの実測

🔒 2026-08-27 ユーザー「後ろの 8.35mm にコネクタ対を置きましょ」。
8.35mm は口の所の話で、電池のすぐ後ろは違いました。

| | 実測 |
|---|---|
| 電池の尻 → ハッチの裏 | `Y 63.9 〜 70.4`（**6.5mm**。8.35 は蓋の裏まで） |
| ポケットの高さ | `Z 23.4 〜 約 39`（鞘の 6mm ではない） |
| 電池口（蓋を外したとき） | `X 42.2 × Z 22.90〜29.90`（**7.00mm**） |
| 口から φ5 が届く先 | `Y 63.9`（電池の尻ちょうど） |

### ③ 置き方は X 一択でした

嵌合した PH2.0 は約 14mm あって **Y には寝ません**（6.5mm しかない）。Z に立てると口を通りません（7.00mm）。
残るのは **X に寝かせる**だけです。`BATCON = [14.0, 5.0, 6.0]`（⚠ 仮）を `X 27〜41・Y 64.2〜69.2・Z 23.4〜29.4` に置きました。

線は 3 つに割りました。**電池と一緒に動く側**（`w_bat_tab`・タブ → コネクタ・15.4mm）、
**曲がるたるみ**（`w_bat_slack`・抜き道の中の 4.4mm・剛体では見ない）、
**箱に残る側**（`w_bat_ext`・コネクタ → 電流計の INPUT・97.7mm）です。

### ④ 引き直しが 3 回要りました

- 🔴 タブの線の出発を `Y 63.95` に置いて、電池の尻に 12.1mm³ 食い込みました（束の太さ 1.5 の半分を忘れた）。`64.70` へ。
- 🔴 延長の横渡りを `Z 33.0 / 34.5` に置いて、**PowerBoost の L 字ハウジングの腹（`Z 35.03`）**に 0.22 触れました。
  この 2 本の天井は 35.03、床は電池の抜き道の頭 29.4 です。`32.2 / 33.9` へ。
- 🔴 延長を手順 7 の段に入れたら、板を降ろす検査（`CHK="boards"`）が **その板に挿さる自分の線**で 9.1mm³ 止まりました。
  口の真上に線の端が居るためです。延長は他の「上の道」と同じ手順 9 の段へ。
- 🔴 たるみと延長を同じ点で継いだら、`CHK="whigh"` に継ぎ目の 6.5mm³ が出ました。束の太さ 1.5 だけずらして面で突き合わせました。

### ⑤ 嵌める順は「電池が座ってから真上で」

| いつ | ピンセット φ5 | 指 φ12 | |
|---|---|---|---|
| 手順 7（板の前） | 30.6 通る | 30.6 通る | ← ここだけ |
| 手順 8（板を載せた後） | 24.4 で止まる | — | PowerBoost の L 字ハウジングの腹 |
| 交換（蓋を外す） | 20.8 通る | 16.0 で止まる | 口は高さ 7.00 |

先に嵌めてから電池を押し込むことも出来ません。**電池の尻を押す指の前にコネクタが立つ**ためで、
φ12 が通るのは `X 14` あたりだけになります。

### ⑥ いまの数字

`chk_swap` **0**（箱に残る延長を障害物に入れたうえで）・`chk_wire_pwr` **0**・`CHK="bat"` **0**・
`CHK="boards"` 11.98・`CHK="whigh"` **0**・`chk_all` 0.03・`close_top` 0・`close_front` 0.13・`close_hatch` 0.02。
当たり 39 本は前と同じ、工具と手の道は **109 本とも通ります**（コネクタの 5 行が増えました）。

⚠ **外形 `14.0 × 5.0 × 6.0` は仮です。** 逃げは Y に 1.2・Z に上下 0.5 ずつしかありません。
現物（電池の PHR ＋ 自作の PH2.0 延長）が来たら真っ先に測ります（[CASE-V4-OPEN.md](CASE-V4-OPEN.md) B-7）。

## 24. 12 度目の机上の通し — つまみが手順に無かった（2026-08-27・[assembly_v4.html](../docs/manual/assembly_v4.html)）

### ① 今回当てたのは「部品表と手順の突き合わせ」です

図面には触っていないので、当たり 39 本・工具と手の道 109 本は 11 度目から動いていません。
今回は**印刷部品 18 点と、ビス・ナットの全行が、手順 1〜12 のどこかに出てくるか**を 1 つずつ当てました。

出てこなかったのは **2 点だけ**でした。**つまみ**（`knob_v5.scad` の `part="knob"`）と
**つまみの島**（同 `part="wall"`）です。印刷部品の表には両方とも載っていて、刷る向きまで書いてあります。
それに付く **E リング（呼び 6）**・**つまみの磁石 2 個**・**島を留める M2×6 ×2 とそのナット 2 個**も、
手順にもビスとナットの表にもありませんでした。

### ② 1 行だけあって、それが最後の 1 つでした

手順 10 のつまみまわりは「天面を裏返して置き、AS5600 の基板を島の 4 本の柱へ M2×6 ×4」の 1 行だけでした。
[knob_v5.scad](../hardware/frozen/v1-v4/knob_v5.scad) の冒頭の「組む順」では、その基板は **⑤＝いちばん最後**です。

| | knob_v5 の組む順 | 天面の向き |
|---|---|---|
| ⓪ | リードの足を曲げて、裏の穴から平らな細い棒で押し込む | 裏 |
| （つまみ単体） | 磁石 2 個を軸の下から入れる | — |
| ① | 島をへこみに置く（**圧入しない**） | 表 |
| ② | 左右の M2×6 ×2 を上から締める | 表 |
| ③ | つまみを上から挿す | 表 |
| ④ | E リングを軸の溝へ**横から**（🔒 ±Y のみ） | 裏 |
| ⑤ | AS5600 の基板を柱へ | 裏 |

マニュアルは、この 7 つのうち**最後の 1 つだけを、最初に書いていた**ことになります。

### ③ 直したこと

手順 10 を上の順に書き直し、題も「つまみを組み、天面に小組を付けて配線する」にしました。
天面は **裏 → 表 → 裏** と 2 回返ります。あわせて、

- ビスの表に **M2×6 ×2（島 → 天面）**、ナットの表に **M2 ×2（天面の裏の下向きポケット）**を足しました。
  ナットの総数はこの表から数えるようにしたので、もう手書きの数字が離れません（M2 は 23 → **25**）。
- 「ナットには 2 種類ある」を **3 種類**に直しました。島の 2 個だけは**下向き**で、置いておけません
  （天面を台に載せて、下から押さえながら上から回す）。
- 道具にリードを奥まで押す**平らな細い棒**を足しました。

### ④ 残した ⚠

**工具と手の道の 109 本に、つまみまわりの道が 1 本も入っていません。** 小組そのものが手順に無かったので、
その道も掃いていませんでした。E リングの**片側 0.65mm** と島のねじの逃げは `knob_v5.scad` の echo で、
`_asm_access.py` の掃引で出した数字ではありません（🔒 ただし 2026-08-21 にユーザーが実物で
「非常に難しかったが、工作できないほどではない」と判定済み）。マニュアルの「まだ埋まっていない」に **⑨** として立てました。

### ⑤ その道を掃きました（同日・追記）

④ で「掃いていない」と書いた**島のナットを下から押さえる道**を、実際に撃ちました。
相手は新しく足した段 `ST="topnut"` ＝ **天面と、へこみに置いた島だけ**です
（つまみ・E リング・AS5600 の基板・スピーカー・会話ボタンはまだ付いていません）。
ねじは 2 本とも `X 55.304 / 71.104・Y 40.8`、ナットのポケットの口は `Z 40.454`（天面の裏と面一）です。

| 下から Z 20.0 で撃つ | 止まった Z | |
|---|---|---|
| 指 φ12 | **32.854** | ポケットの口まで **7.6mm 手前**。AS5600 の柱 4 本に当たる |
| ピンセット φ5 | 40.454 | 口まで届く |
| ナット 4.3 | 40.454 | 口まで届く |
| 柱のあいだに空いている太さ | **φ9.1** | これより太い物は入らない |

つまり**指では押さえられません**。押さえるのはピンセットです。手順 10 の本文をそう直しました。
島のねじを**上から回す**道（ドライバ φ3.2 → 頭は島のザグリの底 `Z 46.654`）も同時に足しています。
⚠ ザグリは φ3.4 なので、φ3.4 の先は `Z 48.3` で止まります（箱側の座ぐりと同じ条件）。

工具と手の道は **109 → 117 本**になり、**全部通ります**（止まったもの 0）。
マニュアルの「まだ埋まっていない」⑨ は ✅ に変えました。残るのは E リングの**片側 0.65mm** が
`knob_v5.scad` の echo であってこの表の掃引ではない、という注記だけです。

### ⑥ ついでに見つかった書き間違い

[knob_v5.scad](../hardware/frozen/v1-v4/knob_v5.scad) の `NUT_POCK_AF` と `NUT_POCK_T` のコメントが、
**M2.5 のときの数字（5.3 / 2.2）のまま**でした。2026-08-23 に M2.5 → M2 へ変えたときの直し忘れで、
式は正しく **4.3 / 1.8** を出しています。掃引の実測（口の AF 4.3・深さ 1.8）と合ったので気づきました。
コメントを直しました。

## 25. 13 度目の机上の通し — 天面が降りなくなっていた（2026-08-27・[assembly_v4.html](../docs/manual/assembly_v4.html)）

### ① 今回当てたのは「表の数字を、いまの図面で取り直す」ことです

検査の表は手書きで、図面に自動では追従しません。12 度目からあとに図面を触った commit が
4 本あったので、**表に載っている 40 本を全部回し直して、書いてある数字と突き合わせました**。

39 本は一致しました。ずれたのは **1 本だけ**です。

| 何を動かすか | 表の値 | いまの値 |
|---|---|---|
| 天面一式を降ろす（`part="close_top"`） | 0 | **30.24mm³** |

### ② 止めているのは、AS5600 に挿したデュポンの腹でした

動く側・相手・束を 1 つずつ当てて切り分けました（道具は
[_asm_blame_v4.scad](../hardware/frozen/v1-v4/_asm_blame_v4.scad) の `P="ct_*"` に置いてあります）。

| 当てたもの | 結果 |
|---|---|
| 天面の殻だけ ↔ 全部 | 4.66mm³（＝ ReSpeaker の押し代。`close_top` では引かれる・正しい姿） |
| つまみ一式 ↔ 全部 | 0 |
| スピーカー ↔ 全部 / 会話ボタン ↔ 全部 | 0 / 0 |
| **AS5600 のデュポン ↔ 全部** | **30.24mm³** |
| 同 ↔ XIAO の束だけ | **30.24mm³**（ほかの 9 束は 0） |
| 同 **止まった姿**（降ろし終わった後） | **13.26mm³** |

食い合っているのは、**ハウジングの腹**（`Y 30.53` から +Y・`Z 18.75〜31.25`・
`X 59.39〜61.93` と `64.47〜67.01` の 2 か所）と、**XIAO の上段 4 本の束**
（中心 `Y 29.9`・`Z 27.13`・束 φ3 ＝ `Y 28.40〜31.40`）です。食い込みは **0.87mm**、
1 か所 6.63mm³ の 2 か所で 13.26mm³。降ろす軌跡ではこれが `Z` に伸びて 30.24mm³ になります。

### ③ いつからかは、commit を 1 本ずつ回して出しました

`part="close_top"` を 12 度目（`f8fc10d`）から HEAD まで 11 本ぶん回しました。

| commit | close_top |
|---|---|
| `f8fc10d` 〜 `b0d1a2d`（7 本） | 0 |
| **`90f7899`「つまみの座の柱を C 字にして、AS5600 のヘッダを踏まないようにした」** | **30.24mm³** |
| `34246d8` 以降（3 本） | 30.24mm³ |

`90f7899` は、AS5600 の**ピン列を実物の写真から起こし直した** commit です
（列が**左右 → 上下** ⇒ `rotate 90`・縁から列の中心まで `2.3 → 4.5`）。模型が実物に近づいたのは
正しい直しですが、**コネクタが動いた先に線が居たまま**でした。同 commit の本文には
「検査: chk_top 0.000 / chk_all 0.027mm³」とあります。どちらも**止まった姿**の検査で、
`close_top`（降ろす軌跡）と `W="wchk"`（束 ↔ 部品）は回していませんでした。

### ④ 同じ commit で、つまみの 5 本の行き先も宙に浮きました

`w_as5600` の終点は `X 72.4・Y 36.8・Z 13.3` です。これは**回す前**の右列
（`X 70.6〜74.2`・`Y 35.73〜44.41`・`Z 15.15〜18.75`）の真下で、当時は合っていました。
いまの列は `Y 30.0〜33.6` と `44.0〜47.6`（`X 57.6〜68.3`）なので、線は**どちらの列の下にも来ていません**
（前の列まで `Y` で 2.1mm・後ろの列まで 6.1mm）。当たりは 0 なので、当たり検査には出ません。

### ⑤ 逃げ場を測りました

XIAO の上段の車線に、`Y` の逃げ場がどれだけあるかを測りました。3×3 の角材を `Z 27.13` に置いて
`Y` を振り、ReSpeaker・XIAO・つまみ一式・デュポンに当てた実測です（`P="ct_lane"`）。

| 束の中心 Y | 当たり |
|---|---|
| 29.9（いま） | 13.26mm³ |
| 29.4 | 5.64mm³ |
| **29.0** | **0.15mm³** |
| 28.9 | 0.57mm³ |
| 28.4 | 2.68mm³ |

`Y 29.0` の一点だけが底です。**空きは 3.00mm ＝ 束の太さちょうど**（逃げ 0）。

ただし、その 3.00mm は**車線の全長にわたる細いトンネルではありません**。断面（`P="ct_slab"`）で見ると:

| X の区間 | 空いている Y | |
|---|---|---|
| 55.35〜59.39 | 両側とも遠い | 広い |
| 59.39〜66.59 | 〜30.53 まで（−Y 側に何も無い） | 8mm 以上 |
| **66.59〜67.01** | **27.53〜30.53 ＝ 3.00mm** | ← ここだけ |
| 67.01〜68.00 | 27.53 から +Y へ開いている | 広い |

きついのは**長さ 0.42mm の一点**で、相手は板ではなく**両方ともデュポンのハウジング**でした——
`−Y` 側が **XIAO に挿したハウジングの尻**（`X 66.59〜68.00`・`Y 27.53` まで）、
`+Y` 側が **AS5600 に挿したハウジングの腹**（`X 64.47〜67.01`・`Y 30.53` から）。

🔒 **2026-08-27 ユーザー判断「逃げ 0 でも一応通るかなぁ」＝ 通す**（線は柔らかい）。⇒ 下の ⑥ で引き直しました。

### ⑥ 引き直しました（同日）

**XIAO の上段**は車線を `Y 29.9 → 29.03`（3.00mm の隙間の真ん中）へ寄せました。
[_v4_core.scad](../hardware/frozen/v1-v4/_v4_core.scad) に `XIAO_UP_Y` という名前を付けて、同じ数字を 3 か所に書かないようにしています。

**つまみの 5 本**は、口の位置を**数字で写さず** `as_conn()` と同じ変換から出す `as_plug()` を足して、
そこから引き直しました（幹は 2 列のあいだ `Y 36.8` に残し、南へ 2 本・北へ 3 本の枝）。

引き直して初めて出たことが 1 つあります。**4 ピンの列は、ハブのリレーの真上でした。**

| | |
|---|---|
| リレー Y14H-1C-5DS（ハブの最高点・高さ 10mm）の頭 | `Z 14.10` |
| 4 ピンの列に挿したデュポンの下端 | `Z 15.15` |
| **そのあいだ** | **1.05mm** |

線（φ1.5）はここを通れません。⇒ その 3 本は「口の真下から下りる」のをやめ、
**口の高さのまま南へ出て、リレーの前面（`Y 43.22`）を越えてから下りる**形にしました
（`AS_OUT_Z 16.0` / `AS_DROP_Y 42.0`）。3 ピンの列の下には何も無いので、そちらは真下で終わります。

### ⑦ 引き直したあとの数字

表の 40 本を全部回し直して、**39 本が元の値に戻りました**。

| | 前 | いま |
|---|---|---|
| `part="close_top"` | 30.24mm³ | **11.45mm³**（実体は 0） |
| `W="wchk"` つまみの 5 本 ↔ 部品 | — | **0** |
| `W="wchk"` XIAO ↔ 部品 | — | 0.16（3.00mm に束 3.0 ＝ 逃げ 0 のぶん） |
| `W="wwchk"` 束 ↔ 他の束（10 束） | — | 0（下の ⑧ を除く） |
| `part="chk_all"`（止まった姿） | 0.027mm³ | **0.027mm³** |

残った **11.45mm³ は実体ではありません**。デュポンの口から出る線のために取ってある
**3.6 角の逃げ予約**が、天面を降ろす途中で XIAO の車線を横切る分です。
止まった姿では予約の頭 `Z 18.75` と束の底 `Z 25.63` が **6.88mm** 離れていて、静止の当たりは 0 です。
⚠ この分は**車線をどこへ寄せても消せません**——予約の縁 `Y 30.00` と XIAO 側のハウジングの尻 `27.53` の
あいだは **2.47mm** で、束 3.0 が入らないからです。同じ性質の残りが `close_top` には前からあり
（旧「AS5600 の線の逃げ予約 ↔ PHIN」の 2mm³）、その行き先が変わっただけです。

### ⑧ 引き直しの途中で踏んだ穴（2 つとも記録します）

**`use <parts.scad>` の向こうからは、変数が見えません。** 口の位置を `AS5600_USED_L` などから
出そうとしたら、静かに**空のリスト**になり、枝が 1 本も出ないまま線が箱の外まで伸びていました
（`wall_l` が 0 → 38.7 で気づきました）。⇒ parts.scad に関数（`as5600_used_l()` など）を足して渡し、
`_v4_core.scad` 側に `assert(len(AS_PLUGS_L) == 2 && len(AS_PLUGS_R) == 3, ...)` を置きました。
同じ落とし方は [case_base.scad](../hardware/frozen/v1-v4/case_base.scad) 460 行にも書いてあります。

**トグルとリードの 2 束が、後ろの縦穴で 44.15mm³ 重なっています**（`X 54.60〜55.95`・
`Y 64.01〜65.51`・`Z 21.55〜43.35` の 1 本の柱）。これは**今回の引き直しより前からで**、
`HEAD` でも同じ値が出ます。[CASE-V4.md](CASE-V4.md) の「線どうし…ゼロ」はこの 1 組だけ外れています。
どちらも柔らかい線で、行き先も同じ（つまみのデッキの足元）なので止まりではありませんが、
⬜ 直すか「束ねる前提」と書くかは決めていません。

### ⑨ ついでに直した、部品表の 3 か所

- **ビスの本数**が見出しで **27 本**になっていました。表を足すと **29 本**です
  （12 度目につまみの島の M2×6 ×2 を足したときの数え忘れ）。
- **平座金 4 枚**が、部品表にも手順 10 にもありませんでした。AS5600 の穴は φ3.5 以上で、
  M2 の頭（φ3.0・実測）は**穴を素通りします**。🔒 2026-08-27 ユーザー「一応座金を入れて対応してたよ」。
- ナットの表の「つまみの島の柱の**小判スロット**」は、`90f7899` で小判をやめて丸になっています
  （`SLOT_LEN 2.0 → 0`）。横から差すことは変わらないので、「六角ポケット（横から差す）」に直しました。

### 止まっているもの

**ありません。** 手順 11（天面を降ろす）は、線を引き直して通るようになりました。
⚠ ただし XIAO の上段の車線は**逃げ 0** です。手順 11 に
「降ろす前に束を ReSpeaker 側へ寄せる」を書き足しました。

---

## 26. 14 度目の机上の通し — 幻を避けるために寄せた車線を戻した（2026-08-28・[assembly_v4.html](../docs/manual/assembly_v4.html)）

マニュアルを頭から読み直し、**当たり 61 本・工具と手の道 117 本・中身どうしの総当たり 20 部品**を通しで回しました。
止まったものと新しい当たりは **ゼロ**です。食い違ったのは**記録の方で 2 か所**でした。

### ① `close_top` は 11.45mm³ ではなく **0** だった

マニュアル（`docs/manual/assembly_v4.html`）は 2026-08-28 02:49 に作られていますが、`_v4_core.scad` が
最後に変わったのは **02:53** です。あいだに入った 🔒 ユーザー指示「そんな変数は削除してほしい」（`20c378b`）で
`ASC_DY = -2` が消え、**AS5600 のコネクタが基板の上へ戻っていました**。その 2mm ぶん、
13 度目に「消せない」と書いた当たりが消えています。

- 13 度目の 30.24mm³ も 11.45mm³ も、**実物の当たりではなく `ASC_DY` の幻**でした。
  コネクタは基板にはんだ付けされている物なので、基板から 2mm ずれた模型は現物では成立しません。

### ② 幻を避けるために寄せた車線が、今度は XIAO のハウジングを食っていた

13 度目に XIAO の上段の車線を `Y 29.9 → 29.03` へ寄せました（🔒 ユーザー判断「逃げ 0 でも一応通るかなぁ」）。
幻が消えたいま、この 29.03 は**逆側**へ寄り過ぎていて、束の腹が XIAO 側のハウジングへ **0.005mm** 入り、
`chk_wire` が **0.168mm³**（0 が正の検査）で止まっていました。コミット `20c378b` の本文には
「chk_wire 0.168（内 0.164 は §25 ⑦ の XIAO の束・別件）」と書いてありますが、**別件ではありませんでした**。

- **断面を測り直しました**（`_asm_blame_v4.scad` の `P="ct_slab"` を Y 45 まで広げた版）。
  車線の帯（`Z 25.63〜28.63`）で、XIAO 側のハウジングの尻は `Y 27.535`・AS5600 側の腹は `Y 32.230`。
  **通り道は 4.695mm** で、束 3.0 を入れると片側 0.85mm ずつ、**ど真ん中が 29.88** です。
- ⇒ `XIAO_UP_Y` を **29.9 へ戻しました**。13 度目に AI が動かす前の値で、いまの通り道の中央でもあります。
  🔒 の「逃げ 0 でも一応通るかなぁ」は**逃げ 0 を通す許し**であって 0 にしろという指示ではないので、
  前提（幻の 0.87mm）が消えた時点で元へ戻す判断をしました。**戻したくなければ 1 行で戻せます**（`_v4_core.scad`）。

### ③ 効き

`close_top` **0**（11.45 から）／ `chk_wire` **0.004**（0.168 から）／ `chk_wire_w` 0 ／ `chk_all` 0.027 ／
`chk_top` 0 ／ `chk_press` 4.662 ／ 他の 55 本はマニュアルの表と同じ数字。
工具と手の道は **117 本とも通り**、中身どうしの総当たりで出た 9 組は全部 §22 ③ の既知（設計どおりの食い込み・膜）です。

⚠ `chk_wire` に残る **0.004mm³** は XIAO とは別で、車線を戻す前から在ります。中身は 2 つ ——
BTN2 の束がハブの OLED の口のハウジング（`X 12.812〜12.850`・`Y 37.801〜38.379`・`Z 16.6〜17.0`）を
**0.038mm** かすめる分と、INA の I2C の束の厚みゼロの膜（`Z 23.400` の 1 面）です。
⬜ どちらも手の精度（0.3mm）より 1 桁小さいので、この通しでは触っていません。

### ④ 直した記録

- `hardware/frozen/v1-v4/_v4_core.scad` … `XIAO_UP_Y` と、その上の経緯。
- `hardware/frozen/v1-v4/case_v4.scad` … `close_top` の脇に置いてあった「いまの正は 11.45」の注記。
- `hardware/frozen/v1-v4/_asm_manual_v4.py` … 検査表の `close_top` の行／手順 11 の注意（「束を寄せる」の理由と数字）／
  線の表の上段の車線／「まだ埋まっていない」⑩（⚠ 要観察 → ✅ 済んだ）。
- `docs/CASE-V4-OPEN.md` … 「数字は分かっているが、直していないもの」の 2 行と、A-14 の後日談。

### 止まっているもの

**ありません。**⬜ 実測待ちは前と同じ 3 つ（Type-C 基板・電池のコネクタ対・アンテナの同軸）と、
🔴 AS5600 の取付回転（DIR がどの角か）です。どれも**手が止まる物ではありません**。

---

## 27. 15 度目の机上の通し — 「0」が本物かを確かめた（2026-08-28・[assembly_v4.html](../docs/manual/assembly_v4.html)）

マニュアルを頭から読み直し、**当たり 48 本**（`_asm_sim_v4.scad` の CHK 27 本・`case_v4.scad` の part 14 本・`W=` 3 本・
`knob_v5.scad` の part 4 本）と、**工具と手の道 117 本**を今のジオメトリで回し直しました。
数字は**マニュアルに書いてある値と 1 つ残らず一致**し、止まったものはゼロです。
そこで今回は、数字が合っているかではなく、**その 0 が本物か**を見ました。

### ① 0 が「両側に実体がある 0」かを機械で確かめた

当たり検査は `intersection(){ 動く側; 相手側; }` なので、**どちらか一方が空でも 0 が出ます**。
14 度目までは、その空を見る仕組みがありませんでした。0 で通っている検査ぜんぶについて、
動く側と相手側を別々に焼いて体積を測りました。

- `_asm_sim_v4.scad` の 13 組（`hub` `rsp` `seat` `ldgnut_lf/lb/r` `wall_l` `tcwall` `brgf` `bat` `oled` `whigh` `strap`）と、
  `case_v4.scad` の 8 つの動く側（棚・ビス・蓋のスライド・ロック・蓋の抜き・電源の線・組み上がりの世界・天面の掃引）。
- **結果はすべて非空**（一番小さい棚のナットの掃引で 60.57mm³、次が `brg_hw` の 128.55mm³）。
  ⇒ **筐体側の 0 は全部本物**です。

### ② 見つけた穴は 1 つ ── E リングの検査が、ねじを障害物に数えていなかった

`knob_v5.scad` の `ering_obstacles()` が、「ねじの胴のうち `Z_BOSS_BOT` より下へ出る分」を
自前の円柱で描いていました。その高さは `Z_BOSS_BOT − SCR_TIP_Z = −10.5 − (−10.3) = **−0.2**` ——
**負の円柱**で、OpenSCAD は黙って何も作りません。つまり `part="eringpath"` も `part="eringpathx"` も、
**ねじが 1 本も居ない状態で「空＝通る」を出していました**。

- **直し**: 自前の円柱をやめ、ねじの現物 `stop_screws()` をそのまま相手にしました。
  `eringpath`（±Y）は直した後も **0** で、結論は変わりません。
- **ついでに分かったこと**: 実体で当て直すと **±X も 0**（当たらない）になります。
  ねじの先は `Z −10.3` で、リングの帯（`Z −11.6〜−10.8`）の**上端より 0.5mm 上で終わって**いて、
  いまのねじはリングの高さまで下りて来ません。[KNOB-ENCODER.md](KNOB-ENCODER.md) の
  「ねじが y=0 に居るので X から入れると轢く」は、ねじが `Z −12.0` まで出ていた頃の話でした。
- 🔒 **それでも「差し込みは ±Y のみ」は動かしていません。**決めたのはユーザーで、
  2026-08-21 に実物で「非常に難しかったが工作できないほどではない」と判定済みです。
  ±X を許すかどうかは⬜ **ユーザーの判断待ち**にしてあります。

### ③ 刷る側 ── ブリッジの掘り込みの天井が支え無しだった

STL 18 点を書き出し直し（形は 18 点とも**体積が完全一致**＝古くなっていませんでした）、
`_stl_preflight.py` を通しました。1 つだけ記録と食い違います。

- `v4_bridge`: **支えの無い天井 65mm²**（刷る向きで `Z 1.10`・`X 19.9〜38.2`・`Y 15.3〜18.5`・1 層）。
  正体は**前板のフランジが入る掘り込み**（皿の裏のへこみ）の天井で、皿を伏せて刷ると下を向きます。
  掘り込みは前（首を通す抜きの側）へ開いているので、天井を支える壁は左右と奥の 3 方だけです。
- 🔴 **初報で「支柱は立てられない」と書いたのは間違いでした**（同日、ユーザー「え。サポート付ければ
  いいんじゃないの？」で訂正）。掘り込みはプレートへ向かって開いていて、**柱を立てる空間はあります**。
  `_v4_props.py` が 0 本なのは `keepout_bridge()` が `brgf_cuts()`（この掘り込みそのもの）を
  keepout に入れているからで、**こちらが書いたルール**です。物理ではありません。
- 本当の制約は**痕**です。掘り込みの実寸は**公称 1.0 ＋ 逃げ 0.1 ＝ 1.1**、フランジは 1.0 ＝
  **差し込みの逃げ 0.1mm**。支柱の痕の実績は **0.3mm** で、痕はフランジが滑り込む天井の面に残ります。
  ⇒ サポートを入れるなら**先に掘り込みを深くする**（`BRGF_SINK` 一箇所）。その代わり前板が前へ倒れる
  余裕が増えます（逃げ 0.1 で約 1°・0.4 なら約 4°）。⬜ ユーザー判断。
- **危険度の見立て**: 天井は膜ではなく**厚み 0.9mm の棚**（皿 2.0 − 掘り込み 1.1）で、左右と奥の
  3 辺で繋がり、自由なのは手前の 1 辺だけ。一番遠い点でも奥の壁から **6.0mm** です。
  preflight の「支えから 2.0mm 超」は部品を選ばない一般のしきい値なので、
  **このまま刷って前板が入るかを見る**のが安いと考えます。
- 🔴 §T-6（[CASE-V4-OPEN.md](CASE-V4-OPEN.md)）には「支えの無い天井 **なし**・接地 2304mm²」と
  書いてありますが、それは押さえを壁へ移した 2026-08-27 時点の値です。**いまは 65mm² / 2263mm²** です。
  ⬜ 実物で垂れるかは刷ってみないと分かりません（**現物待ち**）。

### ④ 直した記録

- `hardware/frozen/v1-v4/knob_v5.scad` … `ering_obstacles()` の負の円柱 → `stop_screws()`。
  ①の echo の「±X は不可」の理由も、いまの寸法から出る文に直した。
- `docs/KNOB-ENCODER.md` … `eringpathx` の行と、その下の 🔒。
- `docs/CASE-V4.md` … ブリッジの刷る向きの接地（2304 → 2263）と、掘り込みの天井の節。

### 止まっているもの

**ありません。**⬜ 実測待ちは前と同じ 3 つ（Type-C 基板・電池のコネクタ対・アンテナの同軸）に、
**ブリッジの掘り込みの天井が垂れるか**と、**E リングの ±X を許すか**（ユーザー判断）が加わりました。
どれも手が止まる物ではありません。

---

## 28. 16 度目の机上の通し — つまみの STL が 5 つに割れていた（2026-08-28・[assembly_v4.html](../docs/manual/assembly_v4.html)）

15 度目は「当たり検査の 0 が本物か（相手が空でないか）」を潰しました。今回は**同じ疑いを、工具と手の道の側**へ
向けました。円筒を撃つ検査も、相手に居ない物には当たりません。あわせて、刷る側も見直しました。

### ① いちばん重いもの ── `stl/v4/v4_knob.stl` は 5 つのバラバラな塊だった

`_stl_preflight.py` が **中身 5 個**と言いました。連結成分ごとに焼いて測ると、つまみは
**持ち手 / 持ち手の裏の 0.3mm の円板 / 軸 / ツメ / 軸の先の 0.3mm の円板**の 5 つに分かれていて、
そのあいだに **0.01mm の隙間**が空いていました（Z 7.695・8.005・21.095 に三角形が 1 枚もありません）。
manifold と CGAL の両方で同じ結果なので、書き出しの癖ではなく**形そのもの**です。

犯人は面取りの抜き `ch_bot()` でした。

```
translate([0, 0, z - 0.01]) difference() {
    cylinder(r = r + 3, h = c + 0.02);                    // z-0.01 〜 z+c+0.01
    translate([0, 0, 0.01]) cylinder(r1 = r-c, r2 = r, h = c);   // z 〜 z+c
}
```

外側の筒だけが円錐より**上下に 0.01 ずつ長い**ので、その 2 か所は円錐に守られない
**半径いっぱいの円板**になります。抜きなので、そこで部品が丸ごと輪切りになります。
`z` は部品の**下の面**なので、下のはみ出しはその面を跨ぐ物（軸とツメ）を切り、
上のはみ出しは持ち手そのものを切っていました。

- **直し**: はみ出しをやめて、筒も円錐も `z 〜 z+c` にそろえました（[knob_v5.scad](../hardware/frozen/v1-v4/knob_v5.scad)）。
  面取りの寸法は変えていません（持ち手 半径 13.5 → 13.2 ／ 軸 3.5 → 3.2・どちらも 0.3mm のまま）。
- **結果**: 連結成分 **5 → 1**（manifold・CGAL とも）。体積 4941.72 → **4947.98mm³**（＋6.26 ＝ 誤って抜けていた 2 枚の 0.01mm の円板）。
  preflight は **中身 1 個・支えの無い天井なし・島 0・薄肉なし・接地 496mm²（無事の実績 513 の側）** で全部合格になりました。
- 当たり検査 48 本と工具の道は、この 6.26mm³ を戻した後も**全部同じ値**でした（戻った肉はどこにも当たりません）。
- ⚠ `ch_top()` にも同じ形のはみ出しがありますが、`z` が部品の**上の面**で、その先には何もありません。
  いまは切っていないので触っていません。

### ② 工具の道の穴 ── 手順 3 の「口を摑む」が、口の無いハブへ撃っていた

`_asm_access.py` の 20 行（10 口 × ピンセット・指）は、相手が **`st2` ＝ 口が 1 本も挿さっていない姿**でした。
手順 3 は 10 本を順に挿す手順なので、最後の 1 本を挿すときには**残り 9 本が既に立っています**。
それを障害物に入れないまま撃っていたので、20 行とも「外まで通る」が出ていました。

- **直し**: `ST="nb_<ID>"`（手順 2 まで ＋ その口以外の 9 本）を足し、相手をそちらに変えました。
  向きも直しました（真上へ撃つと出発点が口の頭に重なり、隣の口の**下の面**を跨いでしまう。道具は上から降りて来ます）。
- **出たこと**: **トグルとリードの 2 口だけ、指の腹（φ12）が口の頭まで 4.5mm 届きません。**
  後列は 1 列に並んでいて、トグル ↔ リードは **7.6mm**。隣の口が上に取っている線の逃げ（半径 2.25）を
  よけて φ12（半径 6.0）を降ろすには **8.25mm** 要ります。**ピンセットなら 10 口とも届きます**（残り 4.0mm）。
- ⇒ 手順 3 の本文に「後ろに並んでいる 4 本はピンセットで挿す」を足しました。**手が止まる話ではありません。**

### ③ 手順 9 の中の順番が、実は効いていた

コネクタを挿す検査は `ST="st9r"`（線を **10 束とも**障害物から外した姿）へ撃っています。
自分の線と当たるのを避けるための除外ですが、**隣の束まで消えて**いました。
`ST="w9_<束>"`（その口自身の束だけを抜く）を足して測り直すと、**OLED の 4 連**の挿し代が
**12.7 → 5.0mm**（要る 6.0）に落ちます。相手は**電流計 → PowerBoost の 2 本**で、
これが OLED の口の真上（Z 40.8〜48.0）を渡ります。

マニュアルは前から OLED を先に書いていましたが、「**先でなければならない**」とは書いておらず、裏取りもありませんでした。
反例の行を 1 本足し、本文にも「この段の中では OLED の 4 連をいちばん先に挿す」を書きました。

⚠ **線は剛体の管で描いてあります。**電流計の INPUT と OUT のように、同じ列の隣どうしが互いの真上を
渡っている所は、この描き方だと必ず当たります（1.5mm で止まる）。実物の線は逃げるので、
**straight-cylinder の検査では線どうしの当たりは判定できません。**それが `st9r` が 10 束を外している理由で、
その判断自体は妥当です。今回足したのは「**順番が効いているか**」を見るための段です。

### ④ 動いていないもの

- 当たり検査 **48 本**（`_asm_sim_v4` の CHK 27・`_v4_core` の W 3・`case_v4` の part 14・`knob_v5` の part 4）
  … つまみを直す前も後も、マニュアルに書いてある値と**全部一致**。
- 工具と手の道 **118 本**（1 本増えたのは③の反例）… 止まったもの **0**。
- 印刷部品 **18 点** … つまみ以外の 17 点は体積が完全一致（うち 5 点は三角形の切り方だけが変わった）。
- ⚠ `_stl_v4.py` で焼き直すと STL が **ASCII → バイナリ**になります（スクリプトが `binstl` で書くため）。
  中身は同じで、ファイルが小さくなるだけです。

### 止まっているもの

**ありません。**⬜ 実測待ちは前と同じ（Type-C 基板・電池のコネクタ対・アンテナの同軸・呼び3 の E リングの外径）、
⬜ 現物待ちはブリッジの掘り込みの天井、⬜ ユーザー判断は E リングの ±X です。

### ⑤ マニュアルの掃除（🔒 ユーザー指示）

🔒 ユーザー「だんだんゴミがたまってきて下の方を見るのが人間ではキツくなってきました」。
本文 31,045 字のうち、**組む人向けは 26%（手順）だけ**で、残りは機械の検算と申し送りでした。

- **検査 2 表を別ページへ出した** —— [assembly_v4_check.html](../docs/manual/assembly_v4_check.html)
  （部品の当たり 31 行・工具と手の道 118 行）。`_asm_manual_v4.py` が 2 枚とも書き出し、
  **数字は同じ 1 回の測定から出す**ので、2 枚がずれることはありません。
  マニュアル側にはリンク 1 行と、止まったものがあるかどうかの 1 文だけを残しました。
- **「まだ埋まっていない」を 12 行 → 6 行にした。**🔒 ユーザー「まだ埋まってないとか書いてるのに
  完了してるってのが笑うね」。落としたのは ✅ 済みの 5 件（⑩ XIAO の車線・② 刷る向き・③ 支えが無い所・
  ④ 線の長さ・⑨ つまみまわりの道）と、⑪ 呼び3 の E リングの外径です。
  ⑪ は 🔒 同日ユーザー「7mm で実測してる」で**埋まっていました**——[KNOB-ENCODER.md](KNOB-ENCODER.md) の
  出どころを 📄 規格 → ✅ ユーザー実測に直しました。
- 消す前に、他のどこにも書いていなかった 2 件を [CASE-V4.md §6](CASE-V4.md) へ移しました ——
  **たるみの行き場**（箱の空き 195,910mm³・1 つながり 186,185mm³・逃がし先は後ろの縦穴と右の溝）と、
  🔴 **たるみを置いてはいけない道 3 本**（電池の抜き道・蓋の横スライド・ハッチの爪）。
  ② の「⚠ 皿の裏は 0.7 浮く」は、CASE-V4.md に「押さえを左の壁へ移して解決済み」と既にあり、
  マニュアル側が**古くて間違い**でした。
- ついでに [KNOB-ENCODER.md](KNOB-ENCODER.md) の E リングの逃げの数字を直しました。
  `knob_v5.scad` の echo を引き写したと書いてありながら、**値が違い、VCC と GND が入れ替わって**いました
  （旧 0.62 / VCC 1.05 / GND 1.35 / GPO 0.48 → 正 **0.58 / VCC 1.34 / GND 1.04 / GPO 0.51**）。

結果、マニュアルの本文は **31,045 → 16,751 字**（−46%）で、手順が占める割合は **26% → 49%** になりました。
手順・呼び名・線・ビスとナット・印刷部品・電池の交換は 1 字も減らしていません。

---

## 29. 会話ボタンの線は直はんだで確定（2026-08-29・[assembly_v4.html](../docs/manual/assembly_v4.html)）

🔒 ユーザー「B-8は直ハンダで確定です」。会話ボタンの 2 本は、デュポンのハウジングを作らずに
**タクトの足へ直接はんだ付けします**。これで [CASE-V4-OPEN.md](CASE-V4-OPEN.md) の B-8 は閉じました。

決まったことで、組む順に 1 つ制約が付きました。下から留める板（`btn_plate`）に開いている足の窓は
**1.4mm**（`BTN_LEGWIN = [3.1, 4.5]`・足 3.46〜4.16 の外へ 0.34 ずつ）しかないので、
はんだを付けた後では板が通りません。**留め板は、線をつなぐ前に入れて留めます。**
手順 10 に本文として書き、ビスとナットの表にも板のねじ 2 本とナット 2 個を足しました。

書いているうちに、**留め板が本番の刷る部品に入っていない**ことが分かりました。板は
`print_btntest`（会話ボタンだけの試し刷り）の中にしか置いておらず、`stl/v4` の 18 点に居ませんでした。
`1f52b26` で羊羹（ReSpeaker の前リブ）の逃げを欠いたので、試し刷りで刷ってある板はもう使えません。
⇒ `print_btnplate` を足して単体で焼けるようにしました。焼いた板は `15.40 × 12.87 × 1.50`・中身 1 個で、
底の Z は 0.000、接地 142mm²、支えの無い天井なし、0.30mm 未満の面もありません（`_stl_preflight.py`）。
刷る物は **18 → 19 点**になりました。

板を留める `M2` ねじ 2 本は **`M2×8`** に決まりました（🔒 2026-08-29 ユーザー「8 も沢山買ったので大丈夫です」）。
板の裏 `Z 38.154` からナットの底 `45.304` まで 7.15mm なので**掛かりは 0.85mm**、ねじの逃げは `Z 47.60`
（9.45mm）まであるので底は突きません。手持ちから出せるので**買い物は増えず**、ビスの長さは
`M2×4`・`M2×6`・**`M2×8`**・`M2×15`・`M3×8` の **5 種類**になりました。

なお同じ日に **B-9（右の耳のナットを落とす順）は取り下げました。**手順 11 の 1 行目に
「先に M2 ナットを 4 個落とす……この 4 個は、天面を載せる前にしか入らない」が
**2026-08-25（`3e958e4`）から入っていて**、工具の道の検査も「天面のナット 前右 (81.9, 6.0)・φ4.3・外まで・通る」
で通っていました。B-9 は手順書も検査の表も見ずに立てた重複で、添えた行番号（441・448）も外れていました。

### 焼き直したら工具の道の検査が 5 行動いた（同日）

マニュアルを焼き直すと、工具の道は**その場で測り直します**。前に焼いたのが 08-28 の朝（`9c2b723`）で、
その後に天板・スピーカー・会話ボタン・つまみのピッチと 4 つ形が動いていたので、5 行が新しい数字になりました。

**測る側の間違いが 2 つ見つかりました。**

- `_asm_access.py` が、OLED の L の裏へナットを差す道を **`4.6 + 2.0`＝ L の古い厚み**から撃っていました。
  08-28 に `OLED_L_T` を 2.0 → 3.6 にして STL を焼き直したので、撃ち始めが**ナットのポケットの中**（Y 6.4〜8.2）に
  入り、ポケットの口までの 1.59mm だけを測って **4 行とも「🔴 止まる」**に化けていました。
  L の裏の面（`OLED_L_BACK_Y = 4.6 + 3.6`）から撃つように直すと、**左 4.561・右 2.853**（要る 1.6）で通ります。
  ⚠ L が 1.6mm 厚くなったぶん、後ろの空きは**右が 4.5 → 2.9 に減っています**。通りますが、余裕は半分以下です。
- 反例の行（止まるのが正）が**通ってしまった**とき、`_asm_access.row()` は `⚠ 通ってしまう` を返すのに、
  マニュアル側が「🔴 止まる」と書いていました。止まっていないのに「止まる」と出るので、読む側には見分けが付きません。
  ラベルと、上の「いま何か所で止まっているか」の 1 文を分けました。

**直したうえで残った本物が 1 つあります。**反例「OLED の 4 連を 電源の 7 本の後から挿す」が、
要る 6.0 に対して **7.5mm 空いていて通ってしまいます**（前は 5.0 で止まっていました）。
手順 9 の中の順の唯一の裏取りだったので、[CASE-V4-OPEN.md](CASE-V4-OPEN.md) に **B-11** として立てました。
つまみの島のナットを下から押さえる道も **φ13.2 → φ12.0**（指ちょうど）に細っています。
どちらも 08-28 の夜の 4 つの変更のどれが効いたかは切り分けていません。

## 30. 支柱の下側の抜け止めは絵の上だけだった（2026-09-02）

ユーザー「このスペーサーって上に載ってるだけじゃない？基板と一緒に引っ張ったら取れない？」
「下にEリング付ける溝ないじゃん」「ただ細くなってるだけ」「電池は蓋にならないよね・・・」。

支柱は 2026-08-30 に「上下 2 つの E リング（呼び 2）で挟む」形で作った。上のリングは板を支柱に留め、
下のリングは帯の裏のザグリ（0.5）に沈んで支柱を帯に留める、という筋だった。ところが帯の下に出る軸は
1.6mm しか無く、下の溝は**軸の先端**に置いてあるので、φ1.5 に細くした段があるだけで下側の壁が無い。
scad には「下は電池が蓋」と書いてあったが、電池は柔らかいパウチで蓋にならない。

⇒ 支柱を帯に留める物が無く、板と支柱 6 本がひとまとまりで帯から浮く。締結としては成立していない。
座（高さ・10° の傾き）と回り止め（D の足）だけが残っている。未決は [CASE-V4-OPEN.md](CASE-V4-OPEN.md)。

同日、支柱を浮かせて刷る生成器の不具合 5 つ（最下点に足が無い・円錐が法線から外れる・斜材が胴の側面を
0.08 で通る・柱の頭が 0.3〜0.46 で癒着しそう・1 本の柱に円錐が 2 つ）を直してターム 2120 に登録したが、
締結の話はその後に出た。**刷る前に見つかった。**

## 31. 支柱の留め方の調査（2026-09-02）

ユーザー「省スペースで上に持ち上がらないように固定する方法を調査して欲しい。帯と一体型のスペーサーを付けるのが
定石のはずだが、そうすると印刷が難しくなる問題がある。ただ、寝かせばいけるのでは？」。工学の定石を調べ、4 つの案を
数字で比べた。数字は全部 CAD と検算ツールの値で、この日は何も刷っていない。提案は §31.8。

### 31.1 いまの scad の実体（調べて分かったこと）

- post_one の軸 φ2.0 は Z 29.4（帯の裏面＝電池の上面）から立つ。**帯の裏から出る量は 0** で、φ1.5 の首 0.5 は裏のザグリ
  （φ4.4 × 深さ 0.5）の中に収まる。先端側に φ2.0 へ戻る壁が無いので、E リングの言葉では溝ではなく段付きの軸で、
  リングは先から抜ける。§30 の「帯の下に出る軸は 1.6mm」は D の足の下で帯の中にある長さで、帯の裏から出てはいない。
- 溝径 1.5・外径 4.0・厚 0.4・溝幅 0.5（`ER_GD` / `ER_OD` / `ER_GW`）は**呼び 1.5** の値である。`_v4_core.scad` 907 行の
  コメント「呼び 2」は誤り。呼び 2 は適用軸 2.5〜3.2・溝径 2.05 で、φ2.0 の軸には切れない。手持ちは箱の「1.5mm」が 12 個。
- **支柱の穴が帯の縁を破っている。** PowerBoost の穴は 14° で回した座標になるので、`_v4_core.scad` 713 行の
  「PB の 4 穴は中に居る」（θ=0 の値）は成り立っていない。post 5（Y 41.85）は帯 B の後端 42.2 まで 0.35 しか無く、
  通し穴 φ2.1 が縁を 0.70、ザグリ φ4.4 が 1.85、D の窪み r3.05 が 2.70 破る。post 2 はザグリ 0.77・D 1.62、
  post 4 はザグリ 0.20・D 1.05、post 3 はザグリの残り 0.09・D 0.76。絵は [hardware/frozen/v1-v4/_onepiece_strapB_top.png](../hardware/frozen/v1-v4/_onepiece_strapB_top.png)
  （いまの帯 B を上から。左上の穴が後端に切れている）。
- 帯 A/B/C は**まだ一度も刷っていない**（print_log.jsonl に strap の回は無い）。「伏せで接地 316mm²・無支持 0」は
  検算の数字で、印刷の実績ではない。
- 旧の一体の座（`seats_v4`・M2 鉛直＋横差しナット）を捨てた commit 52429f0 の理由は 3 つ: ①6 か所中 3 か所で差し口が
  作れない ②床 0.30 ③天面を平らにして伏せて刷る。案は 🔒 2026-08-29 ユーザー「座のパッドを別部品にして帯面を平らにする」。
  ①②はナットの溝の話で、E リングのピンなら無くなる。残るのは③だけ。

### 31.2 E 形止め輪 呼び 1.5 の規格 📄

| 項目 | 値 |
|---|---|
| 内径 d | 1.5（0 / −0.09） |
| 外径 D | 4.0（±0.2）。溝にはめた状態の最大 4.25（DIN 6799 d3） |
| 厚さ t | 0.4（±0.03） |
| 適用軸径 | 2.0 を超え 2.5 以下（オチアイの表は 2〜2.5） |
| 溝径 d2 | 1.53（+0.06 / 0） |
| 溝幅 m | 0.50（+0.05 / 0） |
| 軸端から溝までの距離 n の最小 | 0.8 |
| 溝底の r の最大 | 0.13 |

- 溝の片側の深さは (2.0 − 1.53) / 2 = 0.235。オチアイの計算資料は n/d ≥ 3 を要求し、この軸では n ≥ 0.71。
- 取り付けは径方向（軸に直角）から押し込む。リングが横に走る幅が要る。φ4.4 のザグリの中では片側 0.1〜0.2 しか無く、入らない。
  専用工具 ETH-1.5 の先端幅は 7mm。
- 溝の耐荷重は溝側の材料の降伏強さで決まる。軟らかい相手は挿入時に削れる。相手の角が R や面取りだと荷重点が動いて脱落する。
  リングは再使用しない。
- 出典: https://jp.misumi-ec.com/tech-info/categories/machine_design/md05/g0004.html ／
  https://www.ochiai-if.co.jp/assets/file/pdf/products/retaining_ring/retaining_ring_spec_etw.pdf ／
  https://www.ochiai-if.co.jp/assets/file/pdf/products/retaining_ring/retaining_ring_calc_all.pdf ／
  https://www.monotaro.com/p/4196/3293/ ／ https://www.westfieldfasteners.co.uk/Standards/Clip-EClip.pdf ／
  https://www.rotorclip.com/wp-content/uploads/2023/03/UltimateRetainingRingGuide.pdf ／ 工具 https://www.monotaro.com/p/2901/8168/

### 31.3 支柱の胴の高さ（OpenSCAD の echo）

| post | 板 | xy | 板の裏 Z | 胴の高さ（天面 31.4 から） | 全高 |
|---|---|---|---|---|---|
| 0 | INA 後 | [21.20, 37.02] | 32.40 | 1.00 | 5.90 |
| 1 | INA 前 | [21.20, 21.42] | 32.40 | 1.00 | 5.90 |
| 2 | PB hy 2.54 | [44.49, 57.17] | 32.51 | 1.11 | 6.01 |
| 3 | PB hy 20.32 | [44.49, 39.91] | 36.82 | 5.42 | 10.32 |
| 4 | PB hy 5.18 | [13.12, 54.60] | 33.15 | 1.75 | 6.65 |
| 5 | PB hy 18.32 | [13.12, 41.85] | 36.33 | 4.93 | 9.83 |

### 31.4 薄い板の裏を平らなまま留める既製品（Web 調査）

| 種類 | この事例で落ちる理由 | 出典 |
|---|---|---|
| セルフクリンチング スタンドオフ（PEM SO/TSO） | 母材が HRB80 以下の金属で冷間流動する前提。打込 3.1〜4.9kN。M2 無し | https://www.pemnet.com/wp-content/uploads/sites/9/2022/06/sodata.pdf |
| 基板用ブローチ式（PEM KF2/KFS2） | 対象は FR4。最小板厚 1.53。M2 はナット型のみ | https://www.pemnet.com/wp-content/uploads/sites/2/2022/06/kdata.pdf |
| ブラインドナット（ポップナット） | 最小 M3。かしめで板の裏に胴が膨らむ | https://www.japan-drive-it.co.jp/bli-pop.html |
| スナップイン基板サポート（Essentra LCBS） | 頭が板の裏に出る。板厚上限 1.98。ナイロンの弾性が原理 | https://www.digikey.com/en/product-highlight/e/essentra-components/pcb-snap-lock-supports |
| ワンタッチスペーサー（廣杉 WN） | 足が板の裏へ抜けて開く | http://hirosugi.co.jp/shop/c/c1121/ |
| クォーターターン（Southco D5） | 板の裏に線深さ 3.81 のばね受けが要る | https://media.southco.com/media/static/Literature/d5.en.pdf |
| 樹脂クォーターターン（Essentra QTPF-2BK） | 板厚 4.0〜6.2 から。頭 φ15.9 | https://us.rs-online.com/product/essentra-components/qtpf-2bk/71185091/ |
| 金属 M2 六角スタンドオフ（廣杉 ASB-2000E） | 対辺 3、長さ 3〜12.5。最短 3.0 が胴 1.00〜1.75 に入らず、上面が平らで 14° を受けない。秋月は M2 の金属を扱わない | https://hirosugi.co.jp/shop/g/gASB-2006E/ |
| M2 皿小ねじ（ISO 7046-1） | dk 実 3.8 / 理論 4.4、k 1.2、90°。板 2.0 に皿 1.2 は板厚の 60% で板金の則の上限。在庫に無い | https://fullerfasteners.com/tech/iso-7046-1-specifications-countersunk-flat-head-screws/ |
| 光造形部品の一般解（Formlabs / Hubs） | 熱圧入インサートは SLA に打てない。ナットをポケットに抱かせるか、**ボスを筐体側に一体で作る** | https://formlabs.com/blog/adding-screw-threads-3d-printed-parts/ ／ https://www.hubs.com/knowledge-base/how-assemble-3d-printed-parts-threaded-fasteners/ |

### 31.5 案ごとの成否

- **案 A（支柱を帯と一体にし、上の E リングだけで板を留める）**: 締結は 6/6 成立。帯の裏に出る物は 0。買い足し 0
  （呼び 1.5 を 6 個使い 6 個余る）。伏せて刷れないので向きを変える（§31.6）。
- **案 B（帯の裏から M2 皿ネジ、支柱の胴の中にナット）**: 胴の高さ 1.00 / 1.00 / 1.11 / 1.75 の 4 本にナット厚 1.6
  （📄 ISO 4032）が入らない。床 0.3 ＋ ナット 1.6 ＝ 1.9 が最低。板を 1.0 上げると天面に当たる記録がある
  （`_v4_core.scad` の THETA まわりのコメント）。φ5.8 の胴に幅 4.1 のポケットを切ると壁は 0.53〜0.85。皿の円錐 φ4.4 は post 5 で 1.85、
  post 2 で 0.77、post 4 で 0.20 帯の縁を破る。皿の頭は帯の裏で電池パウチに面一で触れる。M2 皿小ねじは在庫に無い。**不成立。**
- **案 B'（裏のザグリの中に溝 0.5 とつば n を持つ本物の E リング座）**: 天板 2.0 ＝ D の窪み 0.4 ＋ 床 ＋ 溝 0.5 ＋ n 0.8 で
  **床は 0.3**。commit 52429f0 で捨てた「床 0.30」の寸法に戻る。ザグリ 0.5 のままなら軸の先が電池側へ 0.8 出る。
  ザグリ φ4.4 にリング φ4.0（座って 4.25）を径方向に差す走路が無く、帯の縁まで通路を切ることになる（post 2/4/5 は
  ザグリが既に縁を破っている）。上下で 12 個使い、在庫 12 個で予備 0。溝幅 0.5 − 厚 0.4 ＝ 0.1 に印刷の Z 縮み 0.1 と
  下向き面の膨らみが乗る。**成立はするが、案 A が採れないときの控え。**
- **案 D（真鍮 M2 スタンドオフ ＋ 裏から皿ネジ）**: 最短 3.0 が胴 1.00〜1.75 に入らない。上面が平らで PowerBoost の
  14° を受けられない（対辺 3 で高低差 0.75）。長さ 3.0 の中で上下のネジの先が当たる。買い物が 3 種類増える。**不成立。**

### 31.6 一体にした帯の印刷性（[hardware/frozen/v1-v4/_onepiece_study.scad](../hardware/frozen/v1-v4/_onepiece_study.scad) を `_stl_preflight.py` に掛けた値）

較正 ✅: 「急な立ち上がり」は無事に刷れた部品で最大 4.00mm（floor）、失敗は 6.83mm（tub）。点立ちは接地 38mm² 未満。
帯 A には post 1、帯 B には post 0/3/5、帯 C には post 2/4 が載る。

| 帯 / 向き | 接地 mm² | 急な立ち上がり mm | 無支持の天井 mm² | 備考 |
|---|---|---|---|---|
| A / B / C 足を下 0° | 34 / 44 / 35 | 17.75 | 244 / 244.5 / 152.5 | 天板が足の間 36mm を渡る。Z 6.0 で層断面 37 → 326mm² |
| A 寝かせ −Y 面（前にツバ無し） | 51.4 | 3.00 | 0 | 支え無しで較正の内側。ピンは水平 |
| A 寝かせ +Y 面 | 1.0 | 18.82 | 44.4 | ツバの刃先で立つ |
| B 寝かせ ±Y 面 | 3.2 / 1.0 | 34.93 / 18.82 | 39.4 / 47.9 | 前後ともツバ。08-26 に「もう使えない」と記録した向き |
| C 寝かせ ±Y 面 | 1.0 / 1.0 | 15.97 / 16.45 | 20.7 / 44.1 | 同上 |
| A / B / C 端で立てる（40mm 高） | 56〜60 | 5.94〜6.27 | 21〜34 | 上の足が 6mm の庇。ピンは水平 |
| A / B / C 伏せ（ピンの先で立つ） | 3.1 | 25.11〜31.85 | 106〜252 | ピン先 1 本の点立ち |

- 「寝かせる」が支え無しで成り立つのは帯 A だけで、理由は前にツバが無いこと。帯 B・C は ±Y のどちらを下にしても
  ツバの刃先（接地 1mm²）で立つ。
- 寝かせる・端で立てるとピン φ2.0 が水平になる。下向きの面は 50〜500µm 膨らみ（§31.7）、溝幅 0.5 にリング 0.4 の余裕 0.1 を食う。
- 傾けた最良（`_tilt_sweep.py`）: A と B は 30°・方位 315 で 1 層あたりの増分 0.59 / 1.13mm²、最大断面 81 / 86mm²。
  C は 45°・方位 225 で 0.56mm²、43mm²。どれも接地は 0.01〜0.08mm² で、ラフトと支えが要る。
- 足を下にして傾けると天板の裏は坂になり、高い側の足の先が島になる（10° で 35.09、20° で 17.93、45° で 9.10mm²）。
  支えは足の裏に立つ。痕の実績 0.3mm（knob_v5）。ツバの溝の逃げ `TAB_CL` は 0.2。
- 旧の一体の座（`oldseat` 変種）も順位は同じ。ナット横穴の床 0.30 が全部の向きで薄肉に出る。
- 帯用の支えモジュール `props_strap_*` は現在空。支柱用の生成器 `_v4_post_props.py` は LIFT 5.0・ラフト厚 0.6・球 φ1.0・
  円錐 1.5〜3.0・GAP 0.4。
- ⚠ `_stl_preflight.py` の島の数え方に偽陽性がある（BFS の seen の印が残り、鏡像の向きで数が食い違う）。上の表では島の列を省いた。

### 31.7 光造形の向きと材料の一般値 📄

- Formlabs Form 3/4: 無支持のオーバーハングは 5mm・水平から 10° まで。旧世代は 1mm・19°。大きな平面は 10〜20° 傾ける。
  直置きは Z が約 0.1 縮み、底が幅 +0.29 広がる。https://formlabs.com/support/Design-specifications-for-3D-models-form-3/ ／
  https://formlabs.com/support/Model-Orientation/
- CHITUBOX: 鉛直から 45° 未満のオーバーハングと 5mm 未満のブリッジはサポート無しで刷れることがある。
  https://docs.chitubox.com/en-US/academy/a-complete-guide-about-adding-supports-in-sladlplcd-3d-printing
- 下向きの面の膨らみ（層をまたぐ硬化）は 50〜500µm。水平のねじ穴は補正しても嵌らず、鉛直と 45° は嵌る。
  https://blog.honzamrazek.cz/2022/11/cross-layer-curing-and-layer-bulging-on-resin-printers-enemy-of-overall-dimensional-accuracy-and-printed-threads/
- 鉛直でない穴は 0.2〜0.3mm 楕円になる。https://forum.formlabs.com/t/cylindricity-of-the-holes/36847
- 一体ボスの根元は内 R ＝ 肉厚 × 0.5、ボス径 ≥ ねじ径 × 2.5、ピン ≥ φ2。https://www.hubs.com/knowledge-base/how-design-parts-sla-3d-printing/ ／
  https://ameralabs.com/blog/3d-design-parts-sla-3d-printing/
- Formlabs の値はレーザー SLA（Form 2/3/4）で、Mars 3（LCD・FEP）とは剥離の機構が違う。
- ELEGOO 水洗いレジン 2.0: 引張 23.4MPa・破断伸び 14.2%。https://3dprintbeginner.com/elegoo-water-washable-resin-review/
- Formlabs: 硬化が進むほど伸びが落ちる（Grey V5 で 22 → 13%）。部品は経年で脆くなりうる。スナップは Tough/Durable 向け。
  https://formlabs.com/support/Brittle-parts-SLA/ ／ https://formlabs.com/blog/designing-3d-printed-snap-fit-enclosures/
- リポジトリ側: レジン①の板バネは 1 日半で全数破断（docs/DIMENSIONS.md 421）。

### 31.8 提案（未実装・判断待ち）

**案 A を提案する。** 支柱の胴 φ5.8 とピン φ2.0 を帯の天板に一体で生やし、板は上の E リング（呼び 1.5）6 個だけで押さえる。
帯の通し穴・ザグリ・D の窪みは無くなり、電池側に出る物は 0。買い足しは無い。定石にも合う（§31.4 の最終行）。

「寝かせればいける」は帯 A だけ当たっている（§31.6）。向きは 3 本とも**足を下にして傾け、ラフトと支えで浮かせる**にする。
これは 🔒 2026-08-26 にユーザーが描いた向き（足とツバを下・ツバの上面 45°）で、天板の裏は坂になり支えが要らず、
支えの痕は足の裏に付く。絵は [hardware/frozen/v1-v4/_onepiece_look.png](../hardware/frozen/v1-v4/_onepiece_look.png)（帯 B を組んだ姿勢）と
[hardware/frozen/v1-v4/_onepiece_tilt.png](../hardware/frozen/v1-v4/_onepiece_tilt.png)（足を下に 30° 傾けて 5mm 浮かせた向き。支えとラフトは描いていない）。

採用するなら要る直し（計算だけで、当たりの検査は回していない）:
1. 帯 B・C を後ろへ広げる。胴 φ5.8 のはみ出しは post 5 で 2.55、post 2 で 1.47、post 4 で 0.90、post 3 で 0.61。
   幅の値は当たりの検査（chk_all・close_top・横差しの掃引）と一緒に決める。C の後ろの土手は `TAB_MIN` 3.5 を割って
   後ろのツバが消える可能性がある。
2. PowerBoost の 4 本はピンを板に直角（14°）にする。鉛直のままだと板 1.6 を 14° で抜けるのに穴 φ2.46 が要り（計算）、
   φ2.3 の穴を通らない。リングも板に平らに座らない。
3. ピンの先 `POST_TIP` を 0.5 → 0.8（📄 JIS の n の最小）。post 1 と会話ボタンのバスタブ底の余裕が 0.57 → 0.27（計算）になるので chk 要。
4. 胴の根元に R1.0 のフィレット（📄 内 R ＝ 肉厚 × 0.5）。
5. 帯 3 本の向きは `_tilt_sweep.py` で取り、支えは `_v4_post_props.py` の作法で足の裏に立てる。刷る前に `_stl_preflight.py`
   （急な立ち上がり ≤ 4.00・底 Z 0・薄肉）を通す。

**判断待ち: 🔒 2026-08-29「帯は天面を下にして伏せて刷る」の撤回。** 一体にすると伏せられない。帯はまだ刷っていないので、
捨てる実績は無い。

実機で確かめていない前提（採用時に 1 つずつ潰す）:
- 呼び 1.5 の現物の外径 4.0・厚 0.4（📄 規格値。KNOB-ENCODER の ⬜ のまま）。
- 印刷した φ2.0 のピンの溝幅 0.5 が膨らみでどれだけ狭くなるか。ターム 1404 の支柱の残骸で測れる。
- いま機械に入っているレジンでの急な立ち上がりの限界・痕の高さ・薄肉の下限（較正はレジン①）。
- 傾けて刷った天板の裏（坂）が支え無しで持つか。
- 足の裏の痕を紙やすりで落とせるか（ツバの溝の逃げは 0.2）。
- 上の E リング 6 か所にリング φ4.0 と指が入る空き（PB の JST・USB・INA の直立ピンとの当たり未検査）。

採用時に掃く文書: docs/CASE-V4.md 44 行（帯の Y）・80 行（支柱 6 本の行）・134 行（M2×4 ×6 の表）、
`_asm_manual_v4.py` 386〜427 行（裏の E リング・呼び 2）、`_v4_core.scad` 907 行のコメント「呼び 2」。

## 32. 支柱を帯と一体に戻し、帯を傾けて浮かせて刷ることにした（2026-09-03）

ユーザー「スペーサーが上からひっぱると抜ける問題があり、帯と一体化に戻す事になりました。ただ、印刷時に
長いアーチになるので柱が必須です。浮かせるスペーサーを作る時に使った保持具を付けて欲しいです」
「角度についても、最も印刷に適した極端な変化にならない角度を付けたいです」。§31 の調査で出した案 A の採用である。
実装した。**この日はまだ何も刷っていない。** 数字は全部 CAD と検算ツールの値である。

### 32.1 モデル

支柱は帯の天板から生える形にした。帯の側にあった通し穴（φ2.1）・裏のザグリ（φ4.4 × 0.5）・天面の D の窪み
（0.4）と、軸の下の溝は全部消えたので、**帯の裏（電池に触る面）に出る物は 0** になり、板は上の E リング
（呼び 1.5）6 個だけで押さえる。抜け止めは支柱が帯そのものであることで成り立つので、§31 で「成立していない」
と書いた締結はここで終わる。

作図で 2 つ直した。1 つ目は、胴を天面 31.4 ちょうどから立てると帯と**面で触れているだけの別の塊**になる
（焼いた STL が 2 つの塊で出た）ので、胴を天板へ 0.5 沈めて 1 つの肉にした（`POST_MERGE`）。沈めるのは天板 2.0 の
中だけなので、外から見える形も帯の裏も変わらない。2 つ目は、印刷用の切り出しである。胴 φ5.8 は帯の Y の外へ
出る（post 5 は後端から 2.55mm）ので、ツバ込みの端（`strap_ya` / `strap_yb`）で切ると胴が削れる。胴込みの端
（`strap_ya_all` / `strap_yb_all`）で切るようにした。

当たりは測った。**支柱 ∩ 箱の中身（皿・ブリッジ・電池・トグル・Type-C）は 0.00mm³** で、一体化で増えた当たりは
無い。前からある物として、軸 ∩ 板 2 枚が 1.43mm³（PowerBoost の板が 14° 傾いているのに軸が鉛直・§31.8 の 2 番）、
帯 ∩ 箱の中身が 0.63mm³、帯 ∩ 板 2 枚が 0.37mm³ ある。後の 2 つは支柱を外した帯だけで測っても同じ値なので、
一体化とは無関係である。3 つとも [CASE-V4-OPEN.md](CASE-V4-OPEN.md) に立てた。

### 32.2 保持具（支柱を浮かせて刷ったときの物をそのまま使う）── ⚠ 同日中に凍結した（§32.7）

`_v4_post_props.py` の相手を**支柱 6 本から帯 3 本へ**付け替えた。作り（柱 φ2.0 ＋ 球 φ1.0 ＋ 円錐 → 接点 φ0.5・
食い込み 0.1・浮かせ 5.0・ラフト 0.6）と、向きの選び方（1 層あたりの断面積の増分の最大値がいちばん小さい向き ＝
ユーザーの言う「極端な変化にならない角度」）は 2026-09-01〜02 に決めたまま、何も変えていない。

触ってはいけない面だけ帯のものに書き換えた。①軸の側面と E リングの溝（軸の中心から 1.55mm・先の端面は除く）
②板が載る座＝胴の天面（中心から 3.20mm・板の傾きで下がるぶんを見込む）③ツバの上面と側面（溝の逃げ `TAB_CL` が
0.2 しか無く、痕の実績 0.3 が勝つため）。**足の裏とツバの裏（皿に載る面）は当ててよい**ことにした。§31.8 の
「支えは足の裏に立つ」のとおりで、痕は紙やすりで落とす前提である。座標は case_v4.scad の `part="strap_nums"` の
echo から読むので、生成器の側に書き写していない。

逃げが効いているかは別に測った。**柱ぜんぶ ∩ 逃げの体積は 3 本とも 0.00mm³** である
（帯 A で 柱 915mm³ ↔ 逃げ 35mm³、帯 B で 柱 1908 ↔ 238 と、どちらも空ではないので検査は空振りではない）。

### 32.3 選ばれた向きと結果（`python hardware/_v4_post_props.py`）── ⚠ この向きは採らなかった（§32.7）

帯を広げた後（§32.5）に取り直した値である。

| 帯 | 向き | 柱（真下／斜め） | 接点の合計 | ラフト | 急な立ち上がり | 食い込み（見込み） | 最下点から最寄りの先 |
|---|---|---|---|---|---|---|---|
| A | 30° / 方位 315 | 11 / 9 | 3.93mm² | 613mm² | 1.50mm | 0.365（0.393）mm³ | 0.03mm |
| B | 45° / 方位 135 | 10 / 21 | 6.09mm² | 800mm² | 2.02mm | 0.522（0.609）mm³ | 0.11mm |
| C | 45° / 方位 225 | 9 / 9 | 3.53mm² | 532mm² | 1.77mm | 0.375（0.353）mm³ | 0.09mm |

⚠ 広げたことで**帯 B の向きが 30°/315 から 45°/135 へ動いた**（柱も 22 → 31 本）。向きは形から選び直すので、
帯を 2.6mm 伸ばせば別の向きが最良になる。A は同じ向きのまま、C は 3.16 → 1.77mm と良くなった。

急な立ち上がりは 3 本とも実績の較正値 4.00mm の内側である。食い込みは見込み（接点の面積 × 0.1 × 本数）と同じ桁
なので、斜材や枝が部品を突き抜けてはいない。支柱どうしの隙間は 1.08〜1.27mm（要 0.40）、先まわりの空き（ニッパー
の刃）は 2.00〜2.02mm（要 2.00）で、どちらも満たしている。

焼いた STL を `_stl_preflight.py` に通すと、3 本とも底が Z=0・塊は 1 個・0.30mm 未満の面は無し（面取りの縁だけ）
だった。接地は 616 / 803 / 535mm² で、A と B は較正の「frame（585・角が欠けた）」を超える ⚠ が付く。ただしこれは
**ラフトの面積**であって部品の面ではなく、この機で 🔴 が出る線（base 1709）よりは下、床 5737・天板 5147 で刷っている
実績よりずっと小さい。

### 32.4 帯 A の向きの候補（掃引の上位・物差しは 1 層あたりの断面積の増分）

| 傾き / 方位 | 増分の最大 | 最大断面 | 高さ |
|---|---|---|---|
| **30° / 315** | **0.59mm²** | 81mm² | 23.6mm |
| 30° / 45 | 0.66mm² | 74mm² | 23.6mm |
| 30° / 135 | 0.66mm² | 70mm² | 24.7mm |
| 45° / 45 | 1.40mm² | 60mm² | 29.3mm |

0° の直置き（足を下）は、天板が現れる層で 37 → 326mm² に一段で跳ぶ。傾けるとその跳ねが 0.59mm²/層になる。

### 32.5 帯 B・C を広げた（同日・ユーザー「広げる判断を聞くなら計算前にしたらよかったのでは」）

最初は広げるかどうかを**支柱を生成した後に**聞いた。順番が逆で、広げれば向きも柱も取り直しになる。
指摘を受けて、決める材料を先に測り直した。

| 案 | 帯 B | 帯 C | 残るはみ出し | ツバ | 当たり（帯 ∩ 中身 / ∩ 板） |
|---|---|---|---|---|---|
| そのまま | 33.2〜42.2 | 52.6〜58.6 | post5 2.55・post2 1.47・post4 0.90・post3 0.61 | 全部ある | 0.63 / 0.37mm³ |
| **採用** | **33.2〜44.8** | **51.7〜58.6** | **post2 1.47 のみ** | 全部ある | 0.63 / 0.37mm³ |
| 全部入れる | 33.2〜44.8 | 51.7〜60.1 | 無し | 🔴 **C の後ろが消える** | 0.63 / 0.47mm³ |

C の後ろを 60.1 まで伸ばすと、後ろの土手が 62.9 − 60.1 = 2.8mm になり `TAB_MIN` 3.5 を割る。
ツバが消えると C の抜け止めが前だけになるので、post 2 の 1.47mm を残す方を採った。
広げても当たりは 1 つも増えていない（**横差しの掃引 0.63mm³ も広げる前と同じ値**・支柱 ∩ 箱の中身 0.00・帯 ∩ 線 0.00）。
レールの切れ目とツバは `STRAP_BANDS` から作るので自動で追従した（左のレールは 24.45〜33.2 / 44.8〜51.7 / 58.6〜62.9）。

### 32.6 刷る回 `2026-09-03-0138` を登録した

ユーザー「OK では刷るぞーに登録してください」「非常に高さがあるので、フロントパネルとバスタブも一緒に印刷しましょ」。
⇒ 帯 A・B・C とバスタブの **4 点**で登録した（`hardware/stl/term/2026-09-03-0138.stl`・露光だけの下限 32 分・
いちばん高いのは帯 B の 768 層 38.40mm）。

🔴 **フロントパネルは入らなかった。** 5 点だと 11 層目（Z 0.55）で断面の合計が 4174mm² ＝ LCD の 32%、
フロントを足すだけでも 3985mm² ＝ 31% になり、🔒 2026-08-31 の「デカイのを刷る時は他のを置いちゃだめ」
（30% ＝ 3855mm²）に当たる。刷るぞーが止めた。⇒ フロントは別のプレートにする。

⚠ ラフトの接地で帯 A（616mm²）と帯 B（803mm²）に「実績 585 で角が欠けた」の警告が出ている。
欠けるとしたらラフトの角なので部品ではないが、実際どうなるかは刷ってみないと分からない。

### 32.6 掃いた文書と、やっていないこと

掃いた: docs/CASE-V4.md（点数 25 → 19・帯の行・帯の Y・ビスの表から M2×4 6 本を削除・E リングを 4 → 10 個）、
docs/PRINT.md §3.9（この仕組みの相手が帯になったこと）、`_asm_manual_v4.py` の手順 6 と 8（差す作業が消え、
E リングは呼び 1.5 が 6 個）と部品表、`_stl_v4.py`（post_0〜5 の出口を削除）、`_v4_props.py`（PARTS から帯を外す）。
`stl/v4/v4_post_*.stl` 6 個は消した。

やっていない（[CASE-V4-OPEN.md](CASE-V4-OPEN.md) に立てた）: 帯 B・C を後ろへ広げて胴のはみ出しを無くすこと、
PowerBoost の 4 本の軸を板に直角（14°）に倒すこと、帯そのものの 0.63 / 0.37mm³ の当たりの場所の特定。

### 32.7 浮かすのも傾けるのもやめ、直置き＋立てる柱にした。浮かす道具は凍結（同日・夜）

ユーザーが CHITUBOX でスライスして、**宙から始まる肉**を見つけた（層 484 と 370 の赤丸）。
そこから 3 つ分かった。

1. **検算の実装が定義どおりでなかった。** 「急な立ち上がり」の 🔒 定義は「新しく出た肉が**直下の肉**から
   どれだけ離れているか」なのに、コードは `edt(~prev)`（前の層の肉ぜんぶが相手）で
   **平面上でいちばん近い肉**までを測っていた。⇒ 下に何も無い島でも「1.95mm」という有限の値が出て、
   しきい値 4.00 を素通りしていた。ユーザー「差分という意味なら無限大です」。
2. **島は立ち上がりの物差しには原理的に映らない。** ユーザー「大抵の開始点は角なので、それは急な
   立ち上がりを回避できる」。角から始まった肉は面積も層ごとの差も小さいまま育つ。
   ⇒ **開始点（0 か所か否か・しきい値なし）と立ち上がり（4.00mm と比べる）は別の門**にした
   （`_stl_preflight.layer_starts` を新設し、`steep_rise` は「つながって出た庇」だけを測るように直した）。
3. **角度は「出せていなかった」。** 向きは球面上の連続な 2 自由度なのに、傾き 5° × 方位 45° の 145 点しか
   見ておらず、そのうち柱まで付けて評価するのは上位 1〜6 通りだけ。1 位と 2 位の差（1.12 対 1.14mm²）は
   網の目より細かい。ユーザー「組み合わせ爆発によって不可能なので、どこかで間引いているだろう」。
   ⇒ そのとおりだった。

🔒 ユーザー「帯については浮かすのも傾けるのもやめましょう。この帯については柱を立てる方の
パイプラインで作りましょう」「浮かすパイプラインは凍結。使われないようにしてアーカイブしておきましょう」。

⇒ **帯は直置き**（組んだ姿勢・足の裏とツバの裏が z=0）で刷り、天板の裏のアーチ（足と足の間 36mm）は
`_v4_props.py` が立てる柱で受ける。`_v4_post_props.py` / `_spot_props.py` とその .scad は
[hardware/frozen/v1-v4/archive/floating_supports/](../hardware/frozen/v1-v4/archive/floating_supports/README.md) へ移し、include も外した。

直置きの結果（`python hardware/frozen/v1-v4/_v4_props.py` → 焼き直し → `_stl_preflight.py`）:

| 帯 | 柱 | 接地 | 宙から始まる肉 | 急な立ち上がり | 高さ（層数） |
|---|---|---|---|---|---|
| A | 23 本 | 104mm² | **0 か所** | 2.50mm（Z 6.03） | 11.90mm（238） |
| B | 37 本 | 183mm² | **0 か所** | 2.37mm（Z 6.03） | 16.32mm（327） |
| C | 22 本 | 104mm² | **0 か所** | 2.57mm（Z 6.03） | 12.65mm（254） |

立ち上がりは天板の裏が現れる層で、実績の較正 4.00mm の内側。接地は 585 の警告より下。
傾けていた版（768 層・接地 616〜803mm²・開始点 15 か所）と比べて、**層数は 768 → 327、接地は 1/4 以下**。

回 `2026-09-03-0138` は**改訂して登録し直した**。接地が 1954 → 391mm² に減ったので、
前は 30%（3855mm²）に当たって外していた**フロントパネルが同じプレートに載った**
（帯 A・B・C ＋ バスタブ ＋ フロントの 5 点・327 層・露光だけの下限 13.6 分）。

## 2026-09-03 窓を黒枠の実物の形に合わせた（横 63.0・縦 38.8・下辺に台形の逃げ）

回 `2026-09-03-0244` のフロントを実物に当てて分かったこと（どれもユーザーの実測）。

- **黒枠の下辺の中央が 1.5mm 下へ張り出している。** 黒枠の左右の端から 12mm で斜めが始まり、14mm で下がりきる。
  中央の平らな所は 33mm。位置はフィルムが裏へ回る切り欠きの真上。
- これが窓に入らないので、黒枠がフロント板を前へ **1.0mm**（`FRONT_DY`）押し、**板が反っていた**。
- 黒枠の前への出は **2.8mm**（模型は 3.0 だった）。半田面（ガラス側）へ**ピンの尻が 1.8mm** 出ている（模型は 0.5 と置いていた）。

直したもの。

- 窓の横 62.0 → **63.0**（🔒 ユーザー「スっと入らないと困る」・片側 1.0）
- 窓の縦 39.1 → **38.8**（🔒 ユーザー「縦幅そのものは 0.5 くらい大きすぎ」。0.5 まるごとは詰めない ──
  黒枠の 38.5 は 1 回の実測で、少しでも大きければ入らず、また板が反るため。半分の 0.15/片側 にした）
- 下辺の中央だけ**台形に逃がした**（🔒 ユーザー「下辺を大きく下げると基板が目立つから、こういう所ちゃんとしたい」）。
  下端を全幅で下げると窓の両端から青い基板が 1.65mm 見え、板の下の帯も全幅で 5.7mm に細っていた。
  台形なら帯は端で 7.2mm のまま、細るのは中央だけ。
- 黒枠の張り出しを **OLED の模型そのものに入れた**（`OLED_GLASS_BULGE`）。窓はそこから作る。

🔴 **なぜ机上で見つからなかったか。** 窓は「黒枠 ＋ 隙間」で作るので、模型の黒枠は必ず窓より小さい。
当たり検査は永遠に 0 と出る。ピンの尻も 0.5 という根拠の無い置き値で、板の内面まで 0.2 余っていた（実物は 0.0）。
⇒ 張り出しを模型に入れたうえで、**逃げを外して検査が反応するかを確かめた**: 逃げ無し **47.1mm³** / 逃げ有り **0.13mm³**
（0.13 は前からある値と同じ）。検査が見えていることを確かめてから 0 を報告する。

刷る前の検算: 底 Z=0・接地 1367mm²・宙から始まる肉 0 か所・急な立ち上がり 0.35mm・0.30 未満の面なし。

## 2026-09-03 右の壁の「宙から始まる肉」は取り残しの刃だった（消した）

刷る前の検算が右の壁で **1 か所・1.06mm²** を出していた。道具の誤検出ではなく、**モデルに実在する刃**だった。

作っていたのは 2 つ。**床ビスの通し穴**（φ2.5・芯 `Y 4.75` ⇒ 縁は `Y 6.00`）と、
**ReSpeaker の右端を避ける欠き**（平面 `Y 5.30`・X 78.0〜83.09 を全高で落とす）。穴の縁は欠きの壁より奥にあるので
普通なら飲み込まれるが、穴は円筒なので端へ行くほど縁が手前へ戻る。戻って壁より手前に入った所だけ肉が残っていた。

実体を切り出すと **体積 0.343mm³・厚み 0〜0.2mm・丈 7.0mm**（X 80.400〜80.686・Z 3.2〜10.2）。反対側（X 82.92〜83.05）にも対称に同じ物。
壁は外面を下に寝かせて刷るので、この薄い先が 2〜3 層のあいだ宙に現れる。硬化しないか、ヒゲになって槽に落ちる。

**消し方**: 穴の真上（穴の X 幅ぶん・芯 `Y 4.75` から欠きの壁 `Y 5.30` まで）を箱で落とした。
上端は**ナットのポケットの底**（`BOSS_B_H − NUT_T` ＝ Z 10.2）で止めてある ── ナットを捕まえている前半分の肉には手を出さない。

確認: **宙から始まる肉 1 か所 → 0 か所**／`chk_rwall` 0.08mm³ で変化なし／刃の実体を切り出すと消えており、
残るのは穴の外の普通の肉（X 80.40〜80.55）だけ。STL は焼き直し済み（152,484 → 152,084 バイト）。

⚠ 左の壁には出ない。あちらの欠きは `Y 6.61` で、穴の縁（6.00）より奥にあるため交わらない。

🔴 経緯として残す: 最初にこれを「検算のバグ」と言い、「太さ 2 マス未満は島と呼ばない」というフィルタを出した。
ユーザー「いやいやおかしいだろ」。**フィルタで隠すのは直しではない。**検算は正しく、モデルが間違っていた。

## 2026-09-03 ハッチの柱 20 本が空中から生えていた（足元の規則を直した）

ユーザーが ChituBox で見つけた。「柱が地面に置かれていない」「柱そのものが印刷不能じゃねーか」。
`v4_hatch.stl` の柱 49 本のうち **20 本が Z 0.70 から始まり、その下（0〜0.70）には何も無かった**。
柱の先は天井（Z 3.00）に食い込んでいるので塊としては 1 個に繋がっており、
刷る前の検算は「中身 1 個・宙から始まる肉 0 か所」と通してしまう。**塊単位でしか浮きを見ていない検査の穴**である。

原因は `hardware/frozen/v1-v4/_v4_props.py` の `basemax` だった。柱の足元を「胴 φ2.0 の footprint の中でいちばん高い肉の上」に
置く規則で、これは 2026-08-29 に「胴が部品に食い込まないように」入れた物である。ところが**円の端を段差が
かすめただけでも円全体がその高さまで持ち上がる**。ハッチでは電池の口（プレートまで空）の縁に高さ 0.70 の段差が
あり、そこを 0.25mm 踏み外した所に柱が並んでいた。例として柱 (11.55, 22.11) の真下の肉は 0.70〜4.20 だけである。

**直し方**: 足元は `basemin`（胴の底面**全部**の下にある肉）で取る。段差をまたぐ升には肉が無いので、柱はプレートまで下りる。
なお「段差をまたぐ升には立てない」という案も試したが、段差の縁の帯 2mm がまるごと禁止になり、
**ハッチの天井 252.1mm² のうち 114.9mm² が持たれないまま残った**（柱 49 → 32 本）ので採らなかった。

**結果**（`python hardware/frozen/v1-v4/_v4_props.py` → `python hardware/frozen/v1-v4/_stl_v4.py hatch`）:
柱は 49 本のまま・持たれずに残る天井も 3.4mm² のままで、**0.70 から始まる柱は 0 本**になった。
プレートに着く面積は 3311 → **3467mm²** に増えた。断面の絵は [_hatch_props_sec.svg](../hardware/frozen/v1-v4/_hatch_props_sec.svg)。

**⚠ 代わりに、20 本の柱が部品の肉と重なった。**ユーザー ChituBox「重なってる」。
素のハッチ（`-D PROPS_OFF=true` で焼いた物）に対して足 φ2.0 を重ねて数えると、
重なりは **18〜50%**（多くは 33%・最大 50.2%）で、相手は **Z 0〜0.70 の帯**である。
その帯は電池の口のふちに沿って走る**外面側の 0.7mm の皮** ＝ 蓋が滑る鞘の床で、
その上（0.70〜3.00）が蓋の通る隙間、さらに上（3.00〜4.20）が柱の持っている天井（鞘の屋根）である。
つまり柱は**鞘の中に立ち、床のふちに食い込んでいる**。折れば跡は蓋の入口に残る。

🔴 このとき私は最初「重なりは 0.9〜1.8%」と報告した。**間違い。**
柱と肉が癒着した所は STL では 1 本の肉（0.00〜3.10）になるので、
「低い所で切れている肉」を数える書き方では**重なった所だけが数から抜け落ちていた**。
素の部品と柱を別々に持って測り直すこと。

刷る前の検算（新しい `v4_hatch.stl`）: 底 Z=0・接地 3467mm²・宙から始まる肉 0 か所・急な立ち上がり 2.85mm・0.30 未満の面なし。

### 屋根は本当に柱が要るのか（測った・要る）

ユーザー「そもそもですが、ここって急な立ち上がりに属するんですか？」「なんか面積で適当に柱建てられているように見えるけど。」
まず**柱の置き場所は「急な立ち上がり」では決めていない**。あれは `_stl_preflight.py` の別の物差しで、
`_v4_props.py` は層ごとに「その層で新しく現れた肉」＝下に何も無い下向きの面（`Ng = O & ~S`）を天井として拾い、
天井の縁から `REACH` 2.0mm で持てない所にだけ立てている。

そのうえで張り出しを測った（`python hardware/frozen/v1-v4/_hatch_roof_span.py`・素の部品を読む）。
Z 3.00 の天井は **394.9mm²**、下から続く肉（壁）は 84.0mm² しかなく、
**壁からの張り出しは中央 2.92mm・最大 28.19mm**。2.0mm より遠い天井が 251.7mm² ある。
絵は [_hatch_roof_span.png](../hardware/frozen/v1-v4/_hatch_roof_span.png)（灰＝壁・青＝壁に近い・赤＝遠い）で、
鞘の屋根の**左 6 割は下に何も無いまま 28mm 伸びている**。⇒ **柱は要る。**

⬜ **未解決**: 柱は要るが、鞘の床のふちと重ねてはいけない。
🔒 ユーザー案（2026-09-03）「柱を口の内側へ寄せ、円錐で保持する。前に浮かせるのを作った時のヤツ
（`archive/floating_supports/_v4_post_props.py` の 柱＋球＋円錐＋枝）を使う」「内側の何もない所に**ラフト**を
置いて、そこから伸ばすしかない」。凍結した道具だが仕組みは借りる（浮かせも傾けもしない）。

**場所があるかを先に測った**（`python hardware/frozen/v1-v4/_hatch_post_room.py`・素の部品）:
Z 0〜3.00 を貫いて空いている所が 694.2mm²、そのうち **φ2.0 の柱が肉から 0.3 逃げて立てられる所が 466.4mm²**
（かたまり 2 個・大きい方が 454.5mm²）。**天井の各点からその足場までの横の距離は中央 0.50mm・最大 3.32mm**で、
3.0mm より遠い天井は 0.2mm² しかない。⇒ 球＋円錐＋枝で渡す量は 3.3mm 以下。**ユーザー案は成立する。**
絵は [_hatch_post_room.png](../hardware/frozen/v1-v4/_hatch_post_room.png)（緑＝柱を降ろせる所＝ラフトを置く所）。

⚠ **term `2026-09-03-1725` は古いハッチで焼いた物なので刷らない。** 刷るぞーで新しい id を取り直すこと。
⬜ `_stl_preflight.py` は今回の浮きを検出できなかった。柱の足元を列（レイ）ごとに見る検査は入っていない。

### 直した: 接触点は天井のふち・柱は口の内側・間を球＋円錐＋枝、ラフトは口の中（2026-09-03）

`_v4_props.py` に `CONE_PARTS = {'hatch'}` を足した。この部品では**接触点と柱の足を切り離す**。
接触点はこれまでどおり天井の規則（縁から `CLEAR`・間隔 `PITCH` 2.4）で取り、柱は
`stand`（肉から `MIN_GAP` 0.3 逃げていて、足がプレートに着く升）にだけ降ろす。
真下が `stand` でないときは、`BRANCH_SLOPE` 1.0（45°）で届く範囲のいちばん近い `stand` へ**枝**で振る。
柱の足どうしは `PROP_D + GAP2` ＝ 2.4mm 離す。形は 柱 φ2.0 ―（球 φ1.0）― 枝 ― 円錐（`HEAD_L` 0.6）― 先 φ0.5・食い込み 0.1。
ラフトは**柱の足の下**に敷く（＝口の中の空き）。値と作りは `archive/floating_supports/_v4_post_props.py` から借りた。

🔴 **足どうしの間隔は最初に入れ忘れ、支えが互いに -0.845mm 食い込んでいた**（`_props_gap.py` で実測）。
枝で振ると別々の接触点が同じあたりへ集まるためで、接触点の間隔（2.4）は足の間隔を保証しない。

**検算（ハッチ）**

| 見たもの | 値 |
| --- | --- |
| 支え ∩ 素の部品（`_chk_hatch_sup.scad`） | **0.900mm³・Z 3.00〜3.10 だけ** ＝ 先の食い込み 0.1 のぶん（48 本ぶん）。胴の重なりは 0 |
| 持たれずに残る天井 | **8.1mm²**（元の重なる置き方で 3.4・柱を立てないだけの案で 131.2） |
| 支えどうしの隙間（`_props_gap.py`） | **最小 0.500mm**（基準 0.40）・割った組み合わせ 0 |
| 枝で振った柱 | 21 本・振った横の距離は最大 1.46mm |
| 刷る前の検算 | 底 Z=0・接地 3593mm²・宙から始まる肉 0 か所・0.30 未満の面なし |
| 急な立ち上がり | 2.85 → **3.75mm**（Z 3.03）。実績で無事な範囲 ≤4.00 の内側だが、余裕は 0.25mm しかない |

絵: [_hatch_cone_sec.svg](../hardware/frozen/v1-v4/_hatch_cone_sec.svg)（X 一定の縦断面・柱＋枝＋円錐の並び）／
[_hatch_cone_look.png](../hardware/frozen/v1-v4/_hatch_cone_look.png)（口の中を斜めから）。

⚠ `PITCH` 2.4 は、アーカイブの道具が要求していた「先の径 0.5 ＋ ニッパーの刃 2.0 ＝ 2.5」を満たさない。
これは**柱を立てる側のパイプラインに元からある性質**で、今回の変更で持ち込んだものではない。⬜ 触るかは未決。

### 刷るぞーに登録した: 回 `2026-09-03-2037`（ハッチ＋充電基板の受け）

ユーザー GO。`hardware/stl/term/2026-09-03-2037.stl`（面 20,758）。
中身は `v4_hatch.stl`（接地 3593.1mm²・132 層・背 6.60・cx -4.31 / cy 11.50）と
`v4_seat.stl`（61.0mm²・84 層・背 4.18・cx 52.83 / cy -5.70）。
フィルムを散らすため中央から **X +8.0 / Y +11.5** ずらしてある（12 回目・動かせる範囲 ±8.0 / ±11.5）。
層数はハッチが決めている（132）。

刷る前の検算（回の STL・四隅のアンカー込み）: 底 Z=0・接地 3807mm²・**宙から始まる肉 0 か所**・
急な立ち上がり 3.76mm（Z 3.03・実績で無事な範囲 ≤4.00 の内側）。
「先細りの縁 0.03→0.30mm（X 53.9..56.1 / Y -7.6..-4.4・Z 3.01）」は受けの面取りで、前の回から同じ。

⚠ 前の回 `2026-09-03-1725` はユーザーが 18:01 に取りやめ済み（理由「ハッチの印刷形状に問題がある。これでは印刷できない」）。
登録に使った口は `surugo/_reg_term.py`（AI が画面を触れないため。並べる・書き出す・積むの本体は server.py / store.py）。

## 2026-09-03 刷った結果（回 2026-09-03-2037）: レールがガビガビ・全体が反った

ユーザー実機「電池カバーのレール部分の加工がかなり必要なレベルでガビガビ。あと全体的に反っている。」

### ① ガビガビの原因（確定）

`props_hatch()` の **48 本すべてが接触点 Z 3.00**、つまり**鞘（レール）の屋根の裏**に当たっている
（他の高さは 0 本）。先は φ0.5 で 0.1mm 食い込ませてあるので、折れば**蓋が滑る面そのものに 48 個の跡**が残る。
そのうえ円錐 0.6mm・枝・柱が **0.70〜3.00 の 2.3mm の隙間の中**に残る。

🔴 その隙間 2.3mm は、アーカイブの道具が要求していた「先の径 0.5 ＋ ニッパーの刃 2.0 ＝ **2.5mm**」に足りない。
**刃が入らない場所に 48 本立てた**ということである。私はこれを「`PITCH` 2.4 が 2.5 を満たさない・
柱を立てる側に元からある性質」として付記しただけで、**この部品では刃が入らないという意味に翻訳しなかった。**
2026-09-03 にユーザーが最初に言った「こんなところに柱を立てる事がNGだわ」が正しかった。

### ② 反りは剥離力（断面積）では説明できない

`python hardware/frozen/v1-v4/_layer_area.py <STL> 0.05` で 1 層ずつの断面積を出して比べた。

| 部品 | 1 層目の断面 | 板の区間 | 結果 |
| --- | --- | --- | --- |
| `v4_floor`（2026-08-31-2325） | **5749 mm²** | Z 2.03 まで約 6000mm² を 40 層 | **ばっちり**（反り無し） |
| `v4_lwall`（09-01-0352） | 接地 3384mm² | ― | 良い感じ |
| `v4_rwall`（09-01-1339） | 接地 3363mm² | ― | 無事 |
| `v4_hatch`（09-03-2037） | **3599 mm²** | Z 2.03 まで約 3630mm² を 40 層 | **反った** |

⇒ **床は面積で 1.66 倍を 40 層引いて無事だった。** 面積が原因なら床が先に反る。⚠ 反りの記録はこれが初めて。

⬜ **未解決。候補は 2 つで、まだ分けられていない。**

1. **形の弱さ**: ハッチは大きな貫通口を囲む枠で、Z 2.03 で断面が 3630 → **208mm²** に落ちる（床は 681mm²）。
   口の縁には板が **0.70mm** しかない帯もある。曲げに弱い形である。
2. **私が付けたラフトと柱の載せ方**: ラフトは口の中の **259.1mm²・厚み 0.3mm** の独立した島で、
   プレートには自分で貼り付いているが、**部品との繋がりは屋根の裏の φ0.5 の先 48 本だけ**。
   プレートから部品を剥がすとき、その力が 48 本の先を通して **1.2mm の屋根**に掛かる。
   ガビガビと反りが**同じ一回の動作**で起きた説明になる。

### 観測が来た（2026-09-03 ユーザー実機）

「レールを削っている間に反りましたね」「ラフトは全部部品についてきましたよ」「反りは長手方向です」。

⇒ **候補 2（プレートから剥がす力が先 48 本を通して屋根に掛かる）は消えた。**ラフトは部品に付いてきており、
剥がす動作で先は折れていない。**反りは印刷中でも取り外し中でもなく、レールを削っている間に起きた。**

⇒ **原因は 1 つ。①が②を生んだ。**刃の入らない 2.3mm の隙間に 48 本立てたので、削るしかなくなり、
その力で部品が長手に曲がった。

**なぜ長手に曲がるのか（測った・`python hardware/frozen/v1-v4/_hatch_stiff.py`）**。X を 0.5mm おきに切った
Y-Z 断面の断面二次モーメント I（水平軸まわり）を、無事だった部品と比べる。I が小さいほど曲げに弱い。

| 部品 | 長手の長さ | I の中央 | 断面積の中央 | 結果 |
| --- | --- | --- | --- | --- |
| `v4_hatch` | 86.7mm | **80.3 mm⁴** | 95.1 mm² | 反った |
| `v4_floor` | 86.0mm | 308.7 mm⁴ | 166.4 mm² | ばっちり |
| `v4_lwall` | 47.0mm | 369.2 mm⁴ | 152.3 mm² | 良い感じ |

⇒ ハッチは**床と同じ長さで I が 1/3.8**。たわみは荷重が同じなら I に反比例するので、同じ力で床の 3.8 倍曲がる。
壁と比べると、長さが 1.84 倍・I が 1/4.6 なので、L³/I で **約 28 倍**。
**いちばん柔らかい板を、いちばん長く工具で押す羽目になった**という組み合わせだった。

⬜ **次の判断**: 鞘の中に柱を立てない方法を選ぶ。①刷る向きを変えて屋根を垂直面にする
②部品を割って屋根を別に刷る。**「柱を立てない」は不可**（屋根は壁から最大 28.19mm 張り出す。上の §で実測）。

### 口が大きすぎる（測った・2026-09-03）

ユーザー「そもそも形状だっておかしい。スライドする部分はそんなにいらなかったし」
「なんで縁まで全部穴あいてるのこれ」「レールが滑る長さは 1cm もない。でも隙間は端まである」。
測ると全部そのとおりだった（`python hardware/frozen/v1-v4/_hatch_openings.py`・素の部品）。

| 測ったもの | 値 |
| --- | --- |
| ハッチの板 | 86.66 x 50.45 |
| 口（貫通・Z 0.05 でも 1.90 でも同じ） | **58.35 x 12.25**。板の左の縁まで **3.50mm** しか残っていない |
| 鞘の隙間が開いている範囲 | X 3.25〜61.50（**58.25**）x Y 20.25〜32.50（12.25）＝ **口の全長** |
| 蓋 `v4_shutter.stl` | 51.20 x 11.80 x 2.75 |
| ロック `v4_lock.stl` | 29.30 x 11.80 x 3.00 |
| 滑り代 `SHUT_SLIDE` | **5.5mm**（1cm も無い） |
| 電池の抜き道（§11 の設計値） | X 15〜51.5・Z 22.9〜29.9 ＝ **36.5 x 7.0** |

⇒ **口は抜き道より 左に 11.8 / 右に 10.0 / 下に 2.65 / 上に 2.60 大きい。**
滑り代 5.5 で説明できるのは片側だけで、残りは説明が付かない。
鞘が端まで開いているのは滑り代のせいではなく、**蓋が 51.2 あるから**である
（鞘は 蓋 51.2 ＋ 滑り代 5.5 ＝ 56.7 以上要る。実際 58.25）。

**連鎖**: 大きい口 → 長い蓋 → 長い鞘 → **385mm² の天井** → 柱 48 本 → 削って反った。
つまり印刷の失敗の根は柱ではなく口の寸法にある。

⬜ 型は「v3 の蓋そのまま」と §11 に書いてある。v4 の抜き道に合わせ直した記録は無い。
**⬜ 判断待ち: 口を抜き道（36.5 x 7.0）＋逃げ に詰め直すか。**詰めれば蓋・鞘・天井が同じだけ縮む。

## 2026-09-04 電池の蓋の溝の床が片持ちだったのを直した（`sw4_backing` につばを戻す）

ユーザーが CAD で発見。溝の床（増し肉を彫った残り 1.2mm・磁石の座を持つ板）が、
**ロックの座の縁だけでぶら下がっていた**。外から見て右の磁石までが約 25mm の片持ち。

理由。溝は外面から 3.0mm（蓋 2.75 ＋ 隙間 0.25）掘るのに、ハッチの壁は 2.0mm しかない。
足りない 1.0mm は裏の増し肉 2.2mm から取っており、残る床の外面は Y 71.0、壁の内面は Y 72.0 で
**1.0mm ずれている**。増し肉の輪郭が帯とぴったり同寸だったので、床の縁の先には何も無かった。
唯一の例外がロックの座の裏（`offset(SHUT_CL + 1.0)`）で、そこだけ帯の外へ出て壁に届いていた。

直し方はユーザー指示「当たった部分だけ削ればいい」。2026-09-02 は Type-C 基板との 0.721mm³ を
**輪郭全体の縮小**で解いていたので、床を支えていた縁まで消えていた。

- つば `SW4_BACK_FL = 1.0` を全周に戻す（ロックの座の裏と同じ出）
- 当たる所だけを**部品そのもの**で引く（`sw4_backing_carve()` ＝ `tcb_v4()` を 6 方向へ
  `SW4_BACK_CL = 0.3` ずらした和）。🔒 数字で削らないので、基板が動けば削れる所も追う

| 検査 | 直す前 | 直した後 |
| --- | --- | --- |
| `chk_hatch`（ハッチ ↔ 中身＋他の板・0 が正） | 0.02mm³ | **0.02mm³** |
| `chk_all` | 1.15mm³ | **1.15mm³** |
| つばと Type-C 基板の重なり（削る前） | — | 0.35mm³（削って 0） |
| Y 71.4 の断面に残る肉（＝床と壁をつなぐ物） | ロックの座の縁だけ | **帯を一周する 1.0mm の輪** |

### 同日 レールは端まで要らない（耳の届く範囲だけにした）

ユーザー「端までレールである必要がない。**実際手元でそのレールを 6mm 以外塞いでも動作してる**」（実機で確認済み）。
理由は印刷で、縁の下に柱が立って滑る面がガビガビになる。

- 耳は蓋の X 中央の 1 対だけで、閉 X 26.75〜31.25 から逃がし口へ 5.5 動く。届くのは X 36.75 まで。
- ⇒ 溝を「蓋の本体が走る分（全長・蓋の高さ）」と「耳が走る分（レール・縁まで高い）」の 2 つに分け、
  後者を **X 24.0 から右だけ**にした。左の X 3.15〜24.0（20.85mm）は上下の縁とも壁が Y 71〜74 で通しになる。
- 🔒 ロックの形は変えていない（ユーザー指示「ロックの形はそのままでやってみろ。動作するから」）。
- ⚠ レールの左端は角丸 SHUT_R のぶん口が細るので、耳の閉位置より `SHUT_R + SHUT_CL = 2.75` 左へ出す。
  1.0 で切ったときは掃引で耳と 0.07mm³ 当たった。

| 検査 | 値 |
| --- | --- |
| 蓋を閉→開き切りまで送った掃引 ∩ ハッチ（0 が正） | **空（当たり無し）** |
| `chk_hatch`（0 が正） | **0.02mm³**（直す前と同じ） |

### 同日 電池の蓋の床を Y 71.0 で 2 部品に割った（急な立ち上がりを消す）

ユーザー指示「急な立ち上がりを作らない形状に変更したい」「部品が分かれても良い」。
柱を立てる／立てないの前に、**そもそも柱が要るか**を測った。刷る向きで 0.1mm ごとに全層を切り、
下の層とつながっていない塊（島）を探すと **島は 0**。48 本は屋根を見た生成器が立てただけで、
受けている物は無かった。残る問題は落下ではなく、**Z 3.00 で 327.8mm² が一度に出る**こと。

斜めで削れる量は蓋の逃げの分しかなく（耳の裏まで 1.05mm・磁石の穴があるので長辺は 0.8mm）、
概算で 111mm² しか抜けない。**板が溝をまたぐ限り、その面はどこかの層で必ず一度に出る。**
⇒ 増し肉を **Y 71.0（＝溝の床の面）**で割り、Y 71〜72 をハッチの縁、Y 69.8〜71 を別部品の板にした。

| | 一度に出る面積（最大） | 島 |
| --- | --- | --- |
| 割る前のハッチ | **327.8 mm²**（Z 3.00） | 0 |
| ハッチ（`print_hatch`・7404mm³） | **45.4 mm²**（Z 0.15・外周のベベル。割る前からある） | 0 |
| 床の板（`print_shutfloor`・836mm³） | **15.1 mm²**（Z 2.05・磁石の座の輪） | 0 |

- 板の刷る向きは 🔒 **溝の床の面を下**（座とボスが上を向く）。逆向きだと座が宙で始まって島になる。
- 合わせ面は Y 71.0 の平面。接着（磁石と同じ）＋ ロックの M2 を共用して締める。
  ⚠ **この接着は、同日の「つばを戻す」直しが先にあって初めて成立する。**浮いた板は貼れない（ユーザー）。
- 位置決めは **ハッチ側の爪 2 個**（Y 70〜71、板は同じ所を貫通で欠く）。板側に立てると、板を寝かせた
  ときに爪だけが最下層になり本体 544mm² が Z 1.0 で一度に出るので、**必ずハッチ側**。
  - 置ける所は限られる: 右の端はロックの鼻の座（半径 5.55）に縁を食われていて爪が浮いた（島 1 個・3.00mm²）。
    上の帯は電源の線が Y 70.7・Z 32.2 を走るので当たる。⇒ **左の端**と**下の帯の X 30** に置いた。
  - 最初に試した「全周を囲む輪」は、縁の輪郭が 1.25mm 外へ広がって**信号線に 31.8mm³** 当たったので取り消し。

| 検査 | 値 |
| --- | --- |
| `chk_hatch`（0 が正） | **0.02mm³** |
| `chk_all`（0 が正） | **1.15mm³**（割る前と同じ） |
| 蓋の掃引 ∩ ハッチ＋板（0 が正） | **空** |

⬜ `_v4_plate.py` の並べ方には `print_shutfloor` をまだ入れていない。

### 同日 ロックの舌が右の磁石に乗っていたので、蓋の右端だけ 1.8mm 外へ出した

ユーザー実機「私の手元のロックパーツは、シャッターの嵌る半月分しか考慮されていない。
その半月の中にさらに磁石が嵌るための空間が無いとだめなのに。**このロック、機能として良くない**」。
測ると、空間が足りないどころか**すでに穴が開いていた**。

| | 値 |
| --- | --- |
| 蓋の外面に残る肉（磁石の上） | 0.75mm（板 2.75 − 磁石 2.0） |
| ロックの舌の逃げの深さ（蓋に彫る） | 1.4mm（`SHUT_LK_T` 1.2 ＋ `SHUT_LK_CL` 0.2） |
| 逃げ ∩ 磁石の穴 | **2.96mm³**（0.65mm 深く抜けていた） |
| X の重なり（舌 52.3〜54.8 ↔ 右の磁石 47.6〜53.6） | **1.3mm** |

逃がす道は 3 つあって、動く量を測ると 2 つは足りなかった。

- 磁石を内へ動かす: **0.18mm** しか動けない（穴 ↔ 電池の口の肉が 0.6 で、最小 0.42 まで）。要るのは 1.3mm
- 電池の口を詰める: 不可。口は電池 35 × 6 に片側 0.5 を足しただけの寸法（ユーザー「入口が狭くなる」）
- ⇒ **機構の幅を広げる**（ユーザー判断）。左右で対称である必要は無い（同）ので **右だけ**

`SW4_EXT_R = SHUT_EXT + 1.8`（左は据え置き。左は口の縁まで 3.5mm しか無い）。
磁石は蓋の端からではなく**電池の口から**数える `SW4_MAG_IN = 0.6` に変え、端が動いても口から離れないようにした。
結果、舌の始まりが 52.3 → **54.1**、磁石の外端 53.6 との間に **0.5mm** の肉ができた。

⚠ 広げたことで 2 つ動いた。どちらも「当たった所だけ削る」で処理した。

- ロックのナットのボス（幅 9.0）が右へ動いて電源の線の下り（X 64）に食い込んだ ⇒ **幅 7.0**（ナット対角 4.73・壁 1.13）
- ロックの鼻のまわりのつばが X 64.35 まで伸びて 5V の下りに **7.86mm³** ⇒ つばを削る相手に `w_pwr3()` を追加（線の通り道の溝になる）

追加した assert: 左右それぞれの「磁石 ↔ 口」の肉・右の「磁石 ↔ 蓋の端」の肉・**舌が磁石に掛からないこと**。

| 検査 | 値 |
| --- | --- |
| 舌の逃げ ∩ 磁石の穴（0 が正） | **空**（直す前 2.96mm³） |
| 蓋の掃引 ∩ ハッチ＋床の板 | **空** |
| `chk_hatch` / `chk_all` | **0.02 / 1.15mm³**（据え置き） |
| 島（ハッチ・床の板・蓋・ロック） | **全部 0** |

## 2026-09-04 刻印の印が反転していた ── 投影図には見た側を書く

印（スパナ・ヘッドホン・稲妻・クーポン）に反射が入った。**命令の綴りが `mirror` かどうかは関係なく、
幾何として入った**ので、`hardware/frozen/v1-v4/_kinshi_check.py` も grep も素通りしている。

作った側の言い分は「CAD を 180度 回して裏へまわしてスクショを撮り、それをトレースした。
だから反転のコマンドは使っていない」。これは弁明ではなく経路の説明になっている。

- 板を 180度 回して裏へまわるのは**剛体運動**なので、**物体そのものは鏡像にならない。** そこは正しい。
- 反転が生まれるのは、その像を 2D に落として**「表の図」として読み直した瞬間**で、
  トレースがそれを座標に焼き込む。以後どこにも変換が残らず、ソースからは永久に見つからない。
- 裏から見ること自体は正しい作業（半田面はそう見るしかない）。事故は、
  **見た側が書かれていない絵を表の図として使ったこと。**

🔒 **投影図には「どちら側から見たか」を書く。書いていない絵はトレースしない。**

その場で捕まえられる印もある。裏から見た像には必ず利き手を持つ物が写っている
（シルクの文字・USB の口・1番ピンの位置関係）。**文字が裏返って読めたら、その絵は表の図ではない。**

⚠ 番人 `_kinshi_check.py` はソースの文字列しか見ていない。**反射は書き方の性質ではなく
出来上がった形の性質**なので、結果を測る検査（彫った面から見た輪郭を元の SVG と、その左右を
入れ替えた版の両方に突き合わせる）でなければ、何件潰しても必ずすり抜ける。⬜ 未実装。

⚠ このときの直しは、AI が出した**板を下から見たレンダー画像**を根拠にユーザーへ判断を求めたため、
以後の直しがその向きの上に積まれた。**絵は必ずユーザーが見る向き（彫った面から見た向き）で出す。**

## 2026-09-05 電池の蓋の床の板とハッチの接着面を作った（奥行き +2.0・のりしろ 8 個）

ユーザーが CAD のプレビューでハッチの蓋の窓の中がチラつくと指摘した。原因は 2 つの部品の彫りが
合わせ面（溝の床）ちょうどの Y で始まっていたことで、彫りの底面がハッチの縁の底面と床の板の上面に
同一平面で重なっていた。ハッチは縁の下が空なので彫りを 1.0 貫き、床の板は上面の 0.01 上から彫る
ように呼び分けた（`hatch_cuts4(u)` / `sw4_band_cut(u)`）。形は変わらない（STL の体積が編集前後で同一）。

同じ絵で、ハッチ側は溝の輪郭がそのまま貫通していて、床の板を貼れるのは溝のまわり幅 1.0 の枠だけだと
分かった（面積 201.7 mm²・`_hatch_glue.scad` で測った）。ユーザー「接着用ののりしろをいくつか付けたい」。
つばのまわりに何が居るかを升ごとに測ると（`_hatch_tabs_probe.scad`）、下の帯はリブの間だけ、上の帯は
電源線の 4 車線（Y 70.7 直書き）でふさがっていた。ユーザー「筐体の Y を広げてもよい。線は最背面に
沿わせているだけ」。BACK_CL を 8.1 → 10.1 にして IN_Y 72 → 74（外寸の奥行き 74 → 76）。ハッチ側の肉は
IN_Y − 2.2 = 71.8 から始まり、線（〜71.45）の後ろに外れた。

奥行きを広げたら Type-C 基板の受けと押さえが置いていかれた。基板は IN_Y に追従するのに、受けの前後
（57.4 / 72.4 / 58.35 / 62.0 / 65.5）と押さえ（58.6 / 62.2）と基板の置き場（−64.47）が直書きだったため。
全部 IN_Y からの式にした（`TC4_Y1 = IN_Y + 0.4`、`TC_PRESS`、`tcb_v4` の `TCB_YB`）。線を板の厚みに
通すための Y への掃き（`SW4_CARVE_Y`）は、線が板の手前に外れたので 0 にした（掃いたままだと線の無い
縁まで削れて幅 0.06 のひれが出ていた）。

のりしろは幅 5.6 × 丈 3.0（下）/ 2.5（上・トグルの胴まで 0.8）をリブの間に上下 4 個ずつ。
接着面は 201.7 → 331.3 mm²。リブの表（RIB_SEGS）と照合する assert を入れた。

検査は広げる前と同値（chk_all 1.146 / chk_hatch 0.0155 / chk_tc 0 / chk_seat_in 0 / chk_press 4.94 /
close_hatch 0.0175 / close_top 0.163 / chk_wire 0.241）。刷る向きの検算はハッチ・床の板とも底 Z 0・1 個・
薄肉なし。

⚠ 支柱（`_v4_props.py`）・並べ方（`_v4_plate.py`）・リブ（`_v4_ribs.py`）は広げる前の形で焼いたもの。
**刷る前に焼き直す。** stl/v4 の既存 STL は奥行き 74 の物なので使わない。
