n416/katanori/docs/SCREW-SORTER-SURVEY.md

# ねじを長さで仕分ける道具の一覧（2026-09-07・第 1 版）

問い: 「M2 のねじが長さ違いでゴッチャ。ナットとワッシャーも混ざっている。揺らしたらいい感じで仕分けられる治具は無いか」（2026-09-07・ユーザー）。

手元の物: M2 なべ小ねじ（📄 頭 φ3.8 × 1.4）。記録にある長さは 4・6・8・15（他の長さも混ざっている前提）。M2 ナット（📄 二面幅 4.0・厚 1.6）。M2 ワッシャー（📄 外径 4.3〜5.0・厚 0.3）。

この版は 2026-09-07 に Web で集めた。Printables と Cults3D はボット検証で本文が読めず、検索結果の要約だけで書いた行は「本文未読」と付けてある。
可否や順位は付けていない。M2 で使うときに効く数字だけ、各行の右に置いた。

## 原理は 5 つ

長さで分ける道具は、①1 本ずつ当てて目盛りを読む（ゲージ）、②転がして、長さより広いスリットに落とす、③頭で吊るして流し、
軸の先が抜ける所で落とす、④穴に立てて並べ、頭の高さで見る、のどれか。⑤径だけで分けるふるいは長さを分けないが、ナット・ワッシャーを
ねじから外すのに使われている。⑥ナット・ワッシャー専用の物は別に並べた。

## ① 1 本ずつ当てて読む（ゲージ）

| 実例 | 仕組み | 対応 | 大きさ | 入手 | M2 で効く数字 |
|---|---|---|---|---|---|
| Sneaks「Quickly Measure & Sort M2, M3, M4, M5 Metric Screws up to 50mm」 | 中央の V 溝に寝かせ、頭を端に当てて目盛りを読む | M2〜M5・〜50mm | 本文未読 | [Printables 3408](https://www.printables.com/model/3408-quickly-measure-sort-m2-m3-m4-m5-metric-screws-up-)（無料・印刷） | 1 本ずつ。振っては分からない |
| RH3D「ねじ測定ツール カードサイズ」 | 径の穴と長さの目盛りが 1 枚の板 | M2〜M12・0〜82mm | カード大 | [MakerWorld 検索](https://makerworld.com/en/search/models?keyword=screw%20sorter%20M2)（無料・印刷） | 同上 |
| alexan_e「円形メートルねじ測定器」 | 円盤の放射状の溝 | M2〜M6・〜48mm | — | 同上 | 同上 |
| torokzoli「Screw sorter metric」 | 径の穴＋長さの目盛り | M2〜M16・5〜100mm | — | [Thingiverse 104966](https://www.thingiverse.com/thing:104966) | 同上 |
| 市販「ねじ識別ゲージ」（ステンレス板） | 径の穴＋ピッチ＋長さの目盛り | 3〜22mm（M2 は範囲外の表記） | — | [Amazon.co.jp B0D22TC42H](https://www.amazon.co.jp/dp/B0D22TC42H) | M2 の穴が無い |
| ねじゲージ・ネジサイズチェッカー各種 | 雌ねじにねじ込んで径を判別 | M2 あり | — | [モノタロウ ねじゲージ M2](https://www.monotaro.com/s/c-122640/attr_f2853-M2/) | 径だけ。長さは分からない |

## ② 転がして、長さより広いスリットに落とす

| 実例 | 仕組み | 対応 | 大きさ | 入手 | M2 で効く数字 |
|---|---|---|---|---|---|
| Zavion3D「Bolt/Screw Length Sorter」 | 傾いた樋を転がる。樋の幅が段々広がり、自分の長さより広い所で下の箱へ落ちる。上の樋を台に載せるだけ・サポート無し | 5・10・15・20・25・30・40mm、M6 まで | 197 × 88 × 77・160g | [MakerWorld 633329](https://makerworld.com/en/models/633329-bolt-screw-length-sorter)（無料・印刷） | 作者「穴は表記より約 2mm 広い（10 の穴は約 12）。12・14・16 は 10 と 15 の間で不安定」（コメント 2024-11-17）。使用者「時々転がり落ちる・脱線する」「サポート面の凹凸で転がらなかった」 |
| 同型の市販品「M3 ボルトソーター 7 つの測定スロット」 | 上と同じ形の 3D プリント品 | M3・7 段 | — | [Amazon.co.jp 検索](https://www.amazon.co.jp/s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) ￥1,427〜1,988・9/20〜28 着（中国発送） | M3 用の幅。M2 の頭 3.8 は M3 の頭 5.5 より小さく、樋の幅が合わない |
| Fabbaloo 紹介「M3 Bolt Sorter」（Gridfinity） | 上から 1 本入れると溝を転がり、寸法の違う穴を順に通って最初に合う穴へ落ちる | M3 | Gridfinity 升 | [Fabbaloo](https://www.fabbaloo.com/news/design-of-the-week-m3-bolt-sorter) | 1 本ずつ入れる |
| LayerLux3D「自動 M3 ボルト仕分けタワー」 | 同じ原理の塔 | M3 | — | MakerWorld 検索 | 同上 |

## ③ 頭で吊るして流し、軸の先が抜ける所で落とす

| 実例 | 仕組み | 対応 | 大きさ | 入手 | M2 で効く数字 |
|---|---|---|---|---|---|
| EmGi「Mechanical M3 Bolt/Screw Sorting Device」 | ホッパーに山盛り → 手回しの昇降台が 1 本ずつ拾って溝に頭で吊るす → 90° 回して仕分けの樋へ → 樋の下の隙間が段々長くなり、軸が抜ける所で下の箱へ落ちる。ナットも通って自分の箱へ。全部印刷・モーター無し・接着剤少量 | M3 キャップボルト 6〜40（11 箱）。皿・なべは未対応 | 部品 20 点 | [MakerWorld 747968](https://makerworld.com/en/models/747968-mechanical-m3-bolt-screw-sorting-device)（無料・印刷。商用不可）／解説 [Hackaday 2024-11-02](https://hackaday.com/2024/11/02/3d-printed-hardware-sorter-keeps-it-simple/) | M2 は 2025-01 に要望があり作者「改良版で M2 を予定」。2026-03 にも催促あり、M2 版は未公開。使用者「ゆっくり回さないと失敗」「PETG だと供給されず 1 本ずつ置いた」 |
| EmGi「Screw Sorting Machine｜Motor or by Hand｜Modular」 | 上の改良版。箱 10・手回しかモーター | M3〜M6 | — | [MakerWorld 1589824](https://makerworld.com/en/models/1589824-screw-sorting-machine-motor-or-by-hand-modular) | M2 は無い |
| 2026-09-07 に私が出して引っ込めた皿 | 同じ原理からホッパーと昇降台を抜いた物 | — | — | 削除済み | 入れ口が無く、吊るしたねじが滑る根拠も無かった |

## ④ 穴に立てて並べ、頭の高さで見る（整列皿）

| 実例 | 仕組み | 対応 | 大きさ | 入手 | M2 で効く数字 |
|---|---|---|---|---|---|
| 日東工器「ねじ整列皿 静電 2.0〜2.6mm」（トラスコ 392-4233） | 皿に入れて軽く振ると、ねじが穴に先から落ちて頭を上に立つ。電動ドライバーの供給用の定番 | ねじ径 2.0〜2.6 | 94 × 142 × 25・深さ 13.5・穴 273・ピッチ 6 | [モノタロウ](https://www.monotaro.com/s/q-%E3%81%AD%E3%81%98%E6%95%B4%E5%88%97%E7%9A%BF/) ￥2,198（税込）・当日出荷。[ミスミ](https://jp.misumi-ec.com/vona2/detail/223300278827/) にもあり | 立った後は頭の高さ＝長さ。長さごとに分けるのは目で見て拾う。皿の深さ 13.5 に対し M2 の長さは 4〜15。穴の深さと底の形はページに無い |
| 同 1.7〜2.0mm（392-4232）／3.0〜4.0mm（392-4234） | 同上 | — | 同寸・穴 273／160 | 同上 ￥2,198 | — |
| キリウス「ネジ皿（ネジ整列皿）」 | 同上 | 3 種 | — | モノタロウ ￥1,978 | サイズの内訳はページに無い |

## ⑤ ふるいで径を分ける（長さは分けない。ナット・ワッシャーが外れる）

| 実例 | 仕組み | 対応 | 大きさ | 入手 | M2 で効く数字 |
|---|---|---|---|---|---|
| BubsBuilds「Quick Bolt Sorter - M2, M3, M4, M5」 | 網を小→大の順に重ね、混ぜ物を入れて蓋をし、左右に振る。頭より少し小さい穴の網で止まる。5 部品が 1 プレートで 7 時間 | M2・M3・M4・M5 | — | [MakerWorld 112537](https://makerworld.com/en/models/112537-quick-bolt-sorter-m2-m3-m4-m5)／[Thangs](https://thangs.com/designer/BubsBuilds/3d-model/Quick%20Bolt%20Sorter%20-%20M2,%20M3,%20M4,%20M5-904925)（無料・印刷） | 径で分ける。M2 だけの山には長さの情報が出ない。穴は縮み分 +0.3 で、作者「穴の寸法合わせはプリンタごとに難しい」 |
| BubsBuilds 単品の網 M2／M2.5／M3／M6／#6 | 同上の 1 枚 | — | — | MakerWorld 118635 ほか | 同上 |
| EmGi「Bolt/Screw Separation Device｜Sort by Size」 | モーターで径ごとに分ける | M2〜M6・長さ 60 まで | — | [MakerWorld 982703](https://makerworld.com/en/models/982703-bolt-screw-separation-device-sort-by-size) | 径だけ |
| Shadow Moose「In-Cam-Sieve-able」 | カムで棒の隙間を変える円筒のふるい | ねじ・ナット・ボルト | 本文未読 | [Printables 57815](https://www.printables.com/model/57815-in-cam-sieve-able-the-screw-nut-and-bolt-sorter) | — |
| Isik's Tech「Screw Sorter」 | 本文未読 | M2.5〜M5・6〜50mm | — | [Printables 226325](https://www.printables.com/model/226325-screw-sorter) | M2 は範囲外 |

## ⑥ ナット・ワッシャー

| 実例 | 仕組み | 対応 | 入手 | M2 で効く数字 |
|---|---|---|---|---|
| carl5blum「Nut & Washer Sorter」 | 合板に各サイズのボルトを立てた板。ワッシャーは通る一番太いボルトに落とし、ナットはねじ込んで判別 | #0〜#10・M3〜M12（自作） | [Instructables](https://www.instructables.com/Nut-Washer-Sorter/) | 板と M2 のねじ 1 本で同じ物が作れる。ワッシャー内径 2.2 が φ2.0 に通る |
| Mr. Innovative「Automatic Nut Sorter」 | 回る階段。段の下をくぐれない高さのナットが横の箱へ出る。モーター＋旋盤加工 | ナットの高さで分ける | [Hackaday 2021-08-23](https://hackaday.com/2021/08/23/automatic-nut-sorter-for-a-tidy-workspace/) | 大きいナットが小さい物を押し出して誤仕分けあり |
| jonafriendj「Metric hex nut sorting machine - no supports」 | 本文未読 | メートル六角ナット | [Printables 281892](https://www.printables.com/model/281892-metric-hex-nut-sorting-machine-no-supports) | — |
| TobiW_「メートルねじ六角ナット仕分け器 M2〜M10」／TuTu「ナット選別タワー」 | 本文未読 | M2〜M10 | MakerWorld 検索 | — |
| EmGi ③の装置 | ねじと一緒に通すとナットは自分の箱へ | M3 | 上記 | — |

## 混ぜ物を扱う市販機（参考）

| 実例 | 仕組み | 対応 | 入手 |
|---|---|---|---|
| キリウス「ねじ供給機 M1.0〜M5.0」 | 回転ドラムと振動レールで 1 本ずつ整列して供給。首下 19 まで・容量 200〜220cc | M1.0〜M5.0 無段階 | モノタロウ ￥52,778 |
| パーツフィーダ EA シリーズ | 振動ボウル | — | モノタロウ ￥131,780〜 |

どちらも「整列して送る」機械で、長さでは分けない。

## 出典（読めた順）

- MakerWorld: [Zavion3D 633329](https://makerworld.com/en/models/633329-bolt-screw-length-sorter)・[EmGi 747968](https://makerworld.com/en/models/747968-mechanical-m3-bolt-screw-sorting-device)・[EmGi 1589824](https://makerworld.com/en/models/1589824-screw-sorting-machine-motor-or-by-hand-modular)・[EmGi 982703](https://makerworld.com/en/models/982703-bolt-screw-separation-device-sort-by-size)・[BubsBuilds 112537](https://makerworld.com/en/models/112537-quick-bolt-sorter-m2-m3-m4-m5)・[検索「screw sorter M2」](https://makerworld.com/en/search/models?keyword=screw%20sorter%20M2)
- [Hackaday 2024-11-02（EmGi の解説）](https://hackaday.com/2024/11/02/3d-printed-hardware-sorter-keeps-it-simple/)・[Hackaday 2021-08-23（ナット）](https://hackaday.com/2021/08/23/automatic-nut-sorter-for-a-tidy-workspace/)・[Instructables](https://www.instructables.com/Nut-Washer-Sorter/)・[Fabbaloo](https://www.fabbaloo.com/news/design-of-the-week-m3-bolt-sorter)
- モノタロウ: [ネジ 仕分け](https://www.monotaro.com/k/store/%E3%83%8D%E3%82%B8%20%E4%BB%95%E5%88%86%E3%81%91/)・[ねじ整列皿](https://www.monotaro.com/s/q-%E3%81%AD%E3%81%98%E6%95%B4%E5%88%97%E7%9A%BF/)・[ねじゲージ M2](https://www.monotaro.com/s/c-122640/attr_f2853-M2/)
- [Amazon.co.jp「ネジ 長さ 仕分け トレイ」](https://www.amazon.co.jp/s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)・[ねじ識別ゲージ](https://www.amazon.co.jp/dp/B0D22TC42H)
- 本文未読（ボット検証）: [Printables 3408](https://www.printables.com/model/3408-quickly-measure-sort-m2-m3-m4-m5-metric-screws-up-)・[226325](https://www.printables.com/model/226325-screw-sorter)・[526978](https://www.printables.com/model/526978-quick-bolt-sorter-m2-m3-m4-m5)・[57815](https://www.printables.com/model/57815-in-cam-sieve-able-the-screw-nut-and-bolt-sorter)・[281892](https://www.printables.com/model/281892-metric-hex-nut-sorting-machine-no-supports)・[Cults3D 8〜20mm 自動長さ仕分け](https://cults3d.com/en/3d-model/tool/automatic-screw-length-sorter-8-20-mm)
