n416/katanori/docs/CASE-V4-OPEN.md

# 筐体 v4 — OPEN

いまの姿は [CASE-V4.md](CASE-V4.md)、経緯は [CASE-V4-LOG.md](CASE-V4-LOG.md)、組む手順は [assembly_v4.html](../docs/manual/assembly_v4.html)。

🔒 **OPEN しているものだけを書く。** 済んだ話・経緯・AI の反省は書かない。**済んだらその場で消す**（経緯が要るなら
[CASE-V4-LOG.md](CASE-V4-LOG.md) へ）。書く前に「これは本当にまだ決まっていないか」を現物と `.scad` に当てる。
**1 件につき「やること」「いま」「外れると」の 3 行。** モデルの中の言葉（「ハウジングの頭」のような言い方）は使わない。

---

## 🔴 組めない（2026-09-05・実機）

**線のハウジングは 14。模型は 10 で置いていて、その 10 に「✅実測」の印が付いていた**
- やること: ハウジング 14 で中身が閉じる形にする。当たりは下の 5 か所（模型・`_hous14_fit.scad` と `chk_all`）。
- いま: ユーザー「ピンヘッダは 10、ハウジングは 14」。10 はヘッダ（樹脂＋ピン）の値をハウジングの欄に書いたもので、
  OLED・INA226・ハブ・PowerBoost・XIAO の線の全部に使われていた。2026-09-05 に全部を 1 つの数字（parts.scad `DUPONT_H = 14`）に集めた。
  実機で当たったのは 1 番目で、模型でも同じ形で出るようになった。

  | # | 何が | 何に | どれだけ |
  |---|---|---|---|
  | 1 | OLED の線のハウジング | 会話ボタンの右の腕 | 横 1.4 重なり・奥行き 3.2 食い込む（実機 約 2） |
  | 2 | INA226 の口のハウジング 4 本 | 天板 | 天板の中へ 2.05 入る（天板 2.5 のうち残り 0.45） |
  | 3 | ハブの口のハウジング＋線の曲がり | ブリッジ・電池 | ブリッジの底（Z 21.4）を 3.7 越える。電池の床が成立しない |
  | 4 | PowerBoost の L ピンの線 | ハッチの内面 | 0.7 入る |
  | 5 | XIAO の線のハウジング | ReSpeaker の板 | 10 のときから 17mm³ 重なっていた（14 で 186）。線は XIAO 面から真上・頭 13.9・曲がり込み 17.5（RESPEAKER-LITE.md 259 行・ユーザー 2026-08-24）。v5 はこの向きで置く |

  ボタンを左へずらす案: 0.5 で座の左端が INA226 の板の角に当たる（模型）。ずらす余地は無い。
  バスタブの壁や腕を削る案: 腕の内面は押し子のツバの部屋（±10.3）で決まっているので、壁を削っても腕は動かない。
  天板を 5 上げる案: INA226 の角は越えるが、腕と耳は 11.5 の高さがあり OLED の線はその中に居続ける。上げるだけでは 1 番は直らない。
- 外れると: 天板が組めない。3 番は電池の床の積み上げ（LOG 2026-08 の「余り 0.15」）が 14 では −3.85 になる、という意味で、v4 の内寸そのものの話。

**⬜ OLED のヘッダの並び**
- 模型は腕に近い端を SDA としている（正面から SDA・SCL・VDD・GND）。ユーザーは当たった線を GND と言った。形は同じなので当たりには効かないが、配線の資料の並びは要確認。

## 買う物

**アンテナ線（同軸）を買う — 尻尾 `v4_tail` はこれが来てから**
- やること: 同軸の実物を手に入れる。
- いま: 未取得。🔒 尻尾は最後の仕上げにする（2026-09-01・ユーザー）。
- 外れると: `v4_tail` を刷る番が来ない。ほかの 17 点の印刷は止まらない。

**B-2 充電口の基板を買う — 秋月 `[115426]` ¥180 ＋ 5.1kΩ を 2 本**
- いま: 2026-08-24 の時点で未注文。模型は秋月の寸法図から起こしたもので、実物は見ていない。
- 外れると: ハッチに開けた口の位置と大きさが図面値のまま。**受け（`tc_seat4`）の前の当て・返し・控えの Y も、
  板の 20 × 15 × 1.6 を前提に置いてある**ので、実物が図面と違えば一緒に取り直しになる。
  🆕 2026-08-27（D-1）で受けは**独立した印刷部品 257mm³**になったので、取り直しても**刷り直すのは受けだけ**です（前は床 1 枚でした）。
- 確かめた日: 2026-08-25（[TODO.md](TODO.md) B-3 に未注文のまま）

**B-7 電池のコネクタ対 — 電池側の JST を測り、相手の PH2.0 延長を用意する**
- いま: 🔒 2026-08-27 ユーザー「後ろの 8.35mm にコネクタ対を置きましょ」で、置き場は決まりました
  （電池の尻の後ろ・`X 27〜41・Y 64.2〜69.2・Z 23.4〜29.4`・X 方向に寝かせる）。
  ただし**外形 `14.0 × 5.0 × 6.0` は仮**です。出どころは parts.scad の `PB_JST_SZ [7.9, 4.5]`・
  `PB_JST_H 5.2`・`PB_JST_MATE 6.0` で、どれも写真か推定の値です。
  リポ側は parts.scad に「⬜ JSTコネクタ・線の出る向き・曲げ半径」と書いたまま、相手（自作の PH2.0 延長）も未取得です。
  作り方そのものは v3 で決まっています（[CASE-V3.md](CASE-V3.md) 123 行「電池線は PH2.0 の延長を自作して切る」）。
- 外れると: 逃げが **Y に 1.2mm**（ポケット 6.5 − 5.0 − 0.3）・**Z に上下 0.5mm ずつ**（電池口 7.00 − 6.0）しかありません。
  実物がこれより厚ければ電池口を通らず、**組んだ後の電池交換ができなくなります**。
- 確かめた日: 2026-08-27（11 度目の机上の通し）

## PowerBoost の 4 本は軸が板に直角ではない（2026-09-03）

- やること: PB の 4 本の軸を板に直角（14°）に倒すか決める。
- いま: 軸は 6 本とも鉛直。PowerBoost の板は 14° 傾いているので、**軸が板の穴（φ2.3）を斜めに抜ける**。
  当たりは **1.43mm³**（`posts_v4()` ∩ 2 枚の板・2026-09-03 に測った）。一体化より前からある形で、
  一体化で増えたものではない（支柱 ∩ 箱の中身は 0.00mm³）。E リングも板に平らには座らない。
- 外れると: 実物では板の穴が軸に当たって最後まで落ちないか、無理に通すと板が反る。
- 確かめた日: 2026-09-03

## 帯そのものの当たりが 0 ではない（2026-09-03・記録だけ）

- やること: 0.63mm³（帯 ∩ 箱の中身）と 0.37mm³（帯 ∩ 板 2 枚）の出どころを特定する。
- いま: 支柱を外した帯だけで測っても同じ値なので、**一体化とは無関係の前からある当たり**。
  場所はまだ特定していない（体積だけ）。
- 外れると: 小さいので組めるかもしれないが、どこが当たっているか分からないままになる。
- 確かめた日: 2026-09-03

## フロントの一枚板は反りを止める物が無い（2026-09-03）

- やること: 板の留め方を決める（このままにするかどうかを含めて）。
- いま: フロントは 2.0mm 厚・86.7 × 52.1 の一枚板で、真ん中に 63.0 × 38.8 の穴（下辺の中央に台形の逃げ）。残る枠は左右 11.8・下 7.35・上 5.9mm。
  前へ膨らむ向きを止めているのは**上の両端の耳 2 か所だけ**で、床・左右の壁・天面の前端は板の内面に突き当たっているだけ。下辺は自由。
- 外れると: 窓の件（2026-09-03 に直した）で押されなくなっても、組み付けの力が掛かれば同じ所が膨らむ。
- 確かめた日: 2026-09-03

## OLED のピンの尻（正面側 1.8mm）がフロントの内面に当たる（2026-09-03・実物）

- やること: ニッパーで 4 本の尻を落とす（🔒 ユーザーの方針）。落とした後に実際の残りを測って `OLED_HDR_TAIL` を直す。
- いま: 半田面（ガラスと同じ正面側）へピンの尻が **1.8mm** 出ている。場所は上辺の裏の中央＝**窓の上端の 2.2mm 上**、
  板の上の帯（幅 5.8mm）の中。黒枠 2.8（実測）− `FRONT_DY` 1.0 ＝ 板の内面まで 1.8 なので、**ちょうど届く**。
  🔴 模型がこれを 0 と出していた理由は 2 つ: 尻を根拠なく 0.5 と置いていたことと、黒枠を 3.0（実物 2.8）で持っていたこと。両方 `parts.scad` に直した。
- 外れると: 板の上の帯を 0.5 掘って逃がすことになる。そこは反りに対して一番細い所なので、削りたくない。
- 確かめた日: 2026-09-03

## 留め帯とレールの逃げが Y に 0.00mm しかない（2026-09-04・実機）

- やること: 帯の足とレールの切れ目のあいだに逃げを入れるか決める。入れるなら**レール側**を左右に広げる
  （帯 B は胴 44.754 が後端 44.8 の内に 0.046 で入っているので、帯を細くする側では逃げが作れない）。
  溝（`tab_slot`）も同じだけ延ばさないと、レールの端の 0.2mm が残ってツバを突く。
- いま: 手で滑らず、**ドライバーの棒で押し込んで入った**（2026-09-04・ユーザー）。刷った STL で測ると
  `rail_segs()` は `STRAP_BANDS` の**ちょうど補集合**で、Y の逃げは **0.00**（0.05 動かすと 0.14mm³ 当たる）。
  逃げがあるのは上だけで `TAB_CL` の **0.20**（0.3 で 0.13mm³）。滑る向き（X）は ±2mm 空いている。
  この機は六角ポケットで**呼び + 0.3 でジャスト**なので、0.00 は締まりばめになる。
- 外れると: 帯 3 本が毎回押し込みになり、ツバ（掛かり 2.0・高さ 2.0）を折る危険が残る。
  直すなら**ブリッジを刷り直す**ことになる（帯の側は動かせない）。手元の 4 点は入っているので、刷り直しは今すぐ要らない。

---

## 反り対策のリブ（2026-09-04・入れた。⬜ 実機で確認待ち）

**4 枚の板の内面に格子のリブを入れた — 現物で効いたかを見る**

- やること: 次に刷ったときに、この 4 枚が二次硬化後も歪まないかを見る。
- いま: `case_v4.scad` に入れて、当たり・切れ端・外形を機械で通した（下）。**まだ刷っていない。**
- 外れると: 刷るたびにまた歪む。**`front` だけリブではなく板厚（2.0 → 2.8）で買った**（下）。

### なぜ厚みではなくリブか

板を 2.0 → 2.6mm へ**外へ**広げる案は、ユーザーが自分で潰した（「そのせいでUSBの口が～ってのがあるか」
「刺さらなくなる」）。右壁の XIAO USB-C とハッチの Type-C は**殻が壁を貫通し、口の面が外面の 0.8 裏**にある。
外面が 0.6 外へ出ると、プラグは 0.8 → 1.4mm 浅い所で止まる。
逃げを掘る案（「深くなった分、掘りを広げるしかない」）は、オーバーモールド 6.5 × 12.5 に対して口が 3.86 × 9.54 で、
45° のベベルをいくら深くしても**箱は入らない**（ベベルは自分と同じ大きさの所で止まる）。
入れるには**まっすぐな彫り込み**が要り、それは 2026-08-25 に意匠で 2 度却下された形（「幻か？」「変」）である。
⇒ **口を触らずに断面だけ増やせるのがリブ。**

### 🔴 丈 1.0mm では「3mm」に届かない

板 2.0 にリブを立てたときの**等価板厚**（曲げ剛性を同じにする一枚板の厚み）:

| リブ丈 | 幅 | ピッチ | 等価板厚 |
|---|---|---|---|
| 1.0（局所 3.0mm） | 2.0 | 4 | **2.68** ← これが丈 1.0 の天井 |
| 1.0 | 1.6 | 8 | 2.36 |
| **2.0**（局所 4.0mm） | **1.6** | **8** | **2.95 ≈ 3.0** |

⚠ **「3mm になるように」の読みが 2 通りある。** ①リブの所の肉が 3.0mm（丈 1.0）② 等価板厚が 3.0（丈 2.0）。
**②で決めた。**①では 2.68 が上限で、反らなかった床（焼き上がり 2.8）に届かないため。
⇒ **違うなら丈を 1.0 に落とすだけで済む**（線の場所は変わらない）。

### 入れたもの（`python hardware/frozen/v1-v4/_v4_ribs.py` が生成）

🔒 **格子・ピッチ 8mm・幅 1.6mm・0/90。丈 2.0（front だけ 1.0）。**
✅ ユーザー「鞍型ですね」で横だけの平行リブは消えた（鞍型は 2 方向に曲がる）。
⚠ **斜め（±45）は採らない。** どの板でも引ける長さが短く、front は 131 → 44mm と壊滅した。
空きが四角い障害物で区切られていて、斜めの線はそのたびに切られるため。

| 板 | リブ丈 | 内面の空き | 入ったリブ | 体積 |
|---|---|---|---|---|
| `rwall` | 2.0 | 1681mm² | **18 本 / 340mm** | +839mm³ (+10%) |
| `lwall` | 2.0 | 1995mm² | **20 本 / 357mm** | +941mm³ (+12%) |
| `hatch` | 2.0 | 2020mm² | **16 本 / 292mm** | +871mm³ (+12%) |
| ~~`front`~~ | — | — | **リブ無し。板厚 2.8 で買った**（下） | — |

⭐ **リブは印刷に一切悪さをしない。** 3 枚とも外面を下にして刷るのでリブは上を向く。
⇒ 支柱は要らず、**接地面積も LCD 比も変わらない**ので、育ち +0.2 もそのまま。

### ✅ `front` は板厚で買った（2026-09-04・`BEZ_T` 2.0 → 2.8）

🔒 ユーザー「frontは厚くしましょう」。リブでは 3 本 30mm しか入らず、効きが +1% しか無かった
（窓の裏に OLED と ReSpeaker が居て、丈 1.0 でも空きが 990mm² しかない）。

- **2.8 は反らなかった床の焼き上がりと同じ値。** 曲げは厚みの 3 乗で効くので、t²·⁰ を 1 として **2.74 倍**。
- ✅ **front は接地 11% で育ちが 0**（実測 2.0 → 2.0）なので、**設計値がそのまま焼き上がる。**
- ✅ **front には口が無い**ので、壁とハッチを潰した USB の問題が起きない。
- ⚠ **外へ 0.8 出した。** 外面の Y が −1.000 → −1.800。機体の奥行きが 0.8mm 増える。
- ⚠ **45° の合わせ目のぶん、板の Z が 0.414 伸びた**（50.094 → 50.508）。天板はその分を失うが、
  合わせ目の面（`FY_IN`・`IN_Z`）は動いていないので噛み合いは変わらない（下の検算で 0.000）。
- ⚠ **窓のまっすぐな部分が 0.8 → 1.6mm になり、窓が深く見える。** ベベル `WIN_CH` は 1.2 のまま。
  窓はガラス（61.0 × 38.5）に隙間 0.3 で切ってあり、**表示は無効枠の内側**なので機能には効かない。
  ⬜ 深く見えるのが嫌なら `WIN_CH` を 1.2 → 2.0 にすれば、まっすぐな部分は 0.8 に戻る
  （そのぶん外から見た窓が全周 0.8mm 大きくなる）。

### 作り方（🔴 手で座標を置いていない）

[_v4_ribs.py](../hardware/frozen/v1-v4/_v4_ribs.py) が [_v4_ribs_gen.scad](../hardware/frozen/v1-v4/_v4_ribs_gen.scad) を書く。
`_v4_props.py` → `_v4_props.scad` と同じ型。⚠ **中身（`innards4`）を動かしたら生成し直すこと。**

1. OpenSCAD に「内面の空き」を焼かせる（`_v4_ribspace.scad` の `ribfree_<k>`）。
   空き ＝ 〈リブ帯 ∩ 板の輪郭〉−〈中身を面内 ±0.4 太らせた物〉−〈他の皮〉。深さも**リブ丈 ＋ 0.5**で見る。
2. その空きを**深さ方向に 8 枚**切り、**全部で空いている所**だけを空きとする。
3. 幅 1.6 が丸ごと空いていて、8mm 以上続く区間だけを線にする。⇒ **薄片・切れ端は構造上できない。**

🔴 **2 は落とし穴だった。** 最初は帯の一番奥 1 枚だけを見ていて、**手前だけ塞がっている物**
（壁に寄り添う線・薄い棚）を見逃し、**当たりが 1.1 → 106.5mm³ に増えた。**
「一番当たりやすい所で切っている」つもりが逆だった。

### 🔴 生成が 2 か所で 1 マスはみ出していた（2026-09-04・直した）

**最初の生成は、リブが皮に 0.7mm³ 食い込んでいた**（左右の壁のリブ → フロントの耳、
X 1.694〜3.694・Y 4.200〜5.800・**Z 45.254〜45.500 ＝ 0.246mm**。ハッチのリブ → 右壁も 0.4mm³）。
原因は空きの地図の**格子の目（0.25mm）の丸め**で、2 つ別々に取りこぼしていた:

| | 何を落としたか | 直し方 |
|---|---|---|
| ① | 線の**中心を格子に乗せていなかった**ので、幅 1.6 の判定が実効 ±0.75 になり **0.05mm 足りなかった** | 中心を `C[i]` に丸め、幅は 1 マス余分に見る |
| ② | 区間の端を格子の目のまま返していたので、端が**最大 1 マス（0.25mm）はみ出した** | 端を `END_CLR = 0.3` だけ内へ詰める |

⇒ 直した結果、リブは 458→405 / 641→608 / 406→292mm に短くなった。**これが本当に入る長さである。**

### 🔴 私の検算のやり方が間違っていた（同日・記録として残す）

一度「フロントを厚くしたら壁との当たりが 0.738mm³ 出たが、`BEZ_T=2.0` でも 0.738 なので**元からある物**」と
報告した。**これは嘘だった。** 比べた 2 つは**どちらもリブが乗ったまま**で、0.738 の中身は
「元からある 0.064」＋「私が入れたリブの 0.674」だった。**変えていない方を基準に置くとき、
その基準に自分の新機能が乗っていないかを確かめていなかった。**
⇒ 基準は `-D RIBS_OFF=true -D BEZ_T=2.0`（＝手を付ける前の姿）で取ること。

### 🔴 組み立ての「動き」の模型が実態と違っていた（2026-09-04・ユーザーの指摘で判明）

リブを入れた直後、別セッションが `close_lwall` 60.34 / `close_rwall` 267.65 を報告した。
これを受けて私は**「壁を垂直に 30mm 降ろす道」をリブの障害物に足し**、右のリブを 608 → 340mm に半減させた。
**それが間違いだった。** ユーザー:

> 「なんか垂直におろす事ってそこまで重要なんですかね」「計算が面倒なので垂直におろす計算をしているようにしか見えない」
> 「実際私も組み立てた感想ですが、別に垂直におろしたことなど1度もない」
> 「手で持って左右の壁で ReSpeaker をサンドイッチするんですよ。ねじは下からでしょ?」
> 「左壁はネジが1個しか底面にはないので、羽根のように開きます。……右壁を立て、左壁も立てたあと、
> 羽根のように開いてから ReSpeaker を入れられましたね。羽根を閉じたら挟み込み完了」
> 「精読を組み立てマニュアル16回も通したのに、ここまで実態と違うとは思いませんでしたよ」

🔴 **`close_lwall` / `close_rwall` / `close_tc` が見ている垂直の並進は、実際には一度も起きていない。**

**本物の動きを検査にした**（`case_v4.scad`・どれも **0 が正**）:

| 検査 | 動き | 結果（リブ有 / 無）|
|---|---|---|
| `side_lwall` / `side_rwall` | 左右の壁で ReSpeaker を ±X から挟む | 0.000 / 0.014 — **リブ有無で同値** |
| `wing_lwall` | 左壁を前端のネジ `[4.2, 4.75]` を軸に 18° 開いて閉じる | 0.068 — **リブ有無で同値** |

⇒ **リブは実際の組み方に一切かかっていない。** 垂直の制約は外し、リブは元の長さに戻した。
⚠ ReSpeaker の入れ方は掃引にしていない。✅ ユーザー「上でも横でもどこからでも。素材は多少はたわむから
どうやっても入ります」。**剛体の掃引で縛ると嘘の制約になる。**
⚠ `close_*` の 3 つは消さずに残し、理由を `case_v4.scad` に書いた。内面から出る物を足すと非ゼロに
なるが、それは不具合ではない。**次に同じ報告が上がるのを防ぐため。**
✅ ドライバの道（`chk_t1`）と充電基板をポケットへ差す道（`chk_tc_pocket`）は**本物なので残してある**
（`_v4_ribs.scad` の `rib_path`）。棒は曲がらないし、ポケットの入る向きは 1 つ。

### ✅ 「壁を降ろす道」の彫り 4 本を切り詰めた（同日・264mm³ の肉が戻った）

✅ ユーザー「左の壁の ReSpeaker の USB のくぼみとかも縦に伸びてますが全く持って不要」
「右の壁の USB のくぼみも不要ですね」。**降ろす動きのためだけに、壁の下端まで貫く縦溝が 4 本あった。**

| 彫り | 全体 | 最終位置で要る分 | 要る Z | 直した下端 |
|---|---|---|---|---|
| 左① 筒の通り道 | 121.0mm³ | 32.1 | 6.15〜11.73 | −0.5 → **5.6** |
| 左② J1 の金属カバー | 33.1 | 10.9 | 6.15〜11.70 | −0.5 → **5.6** |
| 左③ USB1（縦に長い） | 95.4 | 29.8 | 6.15〜34.73 | −0.5 → **5.6** |
| 右① XIAO の USB | 105.0 | 17.6 | 15.03〜19.50 | −0.5 → **14.5** |

「要る分」は彫りと `innards4()` の交わりを実測した値。⇒ **合計 264mm³ が壁へ戻り、
外の皮 0.58mm の全高の弱線が消えた**（反りに直接効く側）。⚠ `chk_all` は 1.146 のまま動いていない。

### いま入っているリブと、効きの見積り

| 板 | 入った長さ | 埋め切り（約 860mm）に対する被り | 等価板厚のおよそ |
|---|---|---|---|
| `rwall` | **608mm** | **71%** | **2.7**（＝反らなかった床とほぼ同じ）|
| `lwall` | 380mm | 44% | 2.5 |
| `hatch` | 292mm | 34% | 2.4 |
| `front`（リブ無し・板厚 2.8 で買った） | — | — | **2.8** |

⚠ 等価板厚は被りから按分した**概算**で、リブの入り方が場所で違うので効きも一様ではない。
⇒ 反らなかった床の 2.8 に並んだのは **front と rwall**。`lwall` と `hatch` は 2.4〜2.5 止まり。
⬜ 足りるかは実物で見る。

### 通した検算（2026-09-04・直したあと）

`case_v4.scad` にある **`chk_*` / `close_*` の 26 本を全部**、リブ有り・無しで回して突き合わせた。

| 見たもの | 結果 |
|---|---|
| **26 本の検査すべて** | リブ**無し**と同値。⚠ 例外は下の 2 本だけで、どちらも**増えるのが正しい向き** |
| ┗ `chk_tc_drop` 3.285 → 5.845 | コメントに「**止まるのが正**」（板だけ後から落とす道は無い、の裏取り）|
| ┗ `chk_tc_pocket_z` 62.6 → 146.4 | 同じく「**止まるのが正**」 |
| **リブ ∩ 皮（15 組）** | **全部 当たり 0** |
| 皮 front ∩ lwall / rwall | **0.064mm³** — ⚠ 板 2.0・リブ無しでも同じ 0.064。**元からある** 0.01mm の膜 |
| 切れ端（8mm 未満の塊） | **3 枚とも 0 個** |
| リブの外形（bbox の差） | **3 枚とも X/Y/Z すべて 0.000** |
| 絵 | `_rib_look_*.png`（内面）・`_front_bez20.png` / `_front_bez28.png`（外から見た顔）|

⚠ 「空」と「失敗」は分けて数えた。OpenSCAD は当たり 0 のとき STL を出さず
`Current top level object is empty.` を返して**終了コード 1** になる。これをエラーと読むと全部
エラーに見える（実際そう読み違えた）。

⚠ **「3mm」を等価板厚と読んで丈 2.0（局所 4.0mm）にした。** 「リブの所の肉が 3mm」の意味なら
`_v4_ribs.scad` の `RIB_H` を 1.0 にして生成し直すだけ（線の場所は変わらない）。
⚠ 素の板だけ見たいときは `-D RIBS_OFF=true`。
