n416/katanori/docs/CASE-V4.md

# 筐体 v4 — いまの姿

この文書は **「いまの v4 はこういう箱です」だけ**を持ちます。長さは意図的に短くしてあります。

| 知りたいこと | 見る文書 |
|---|---|
| いまどういう箱で、何が決まっているか | **この文書** |
| 何を決めればいいか・何が仮のままか | [CASE-V4-OPEN.md](CASE-V4-OPEN.md) |
| どうやってそこへ辿り着いたか・落ちた案・訂正 | [CASE-V4-LOG.md](CASE-V4-LOG.md) |
| 手を動かして組む手順 | [assembly_v4.html](../docs/manual/assembly_v4.html) |

> 2026-08-25 に 1 本 876 行だった CASE-V4.md を 3 つに分けました。**元の本文は 1 行も消さずに
> [CASE-V4-LOG.md](CASE-V4-LOG.md) にそのまま入っています**（章番号 §1〜§13 も分ける前のまま）。
> この文書だけは新しく書いた要約です。数字の出どころは .scad と LOG の該当章で、末尾に対応表を置きました。

---

## 1. 箱

外寸 **86.65 × 74.99 × 52.95mm**、内寸 **84.354 × 72 × 48.454mm**。手のひらに乗る大きさで、
前が画面、上が操作面、後ろが開く蓋、という置き方をします。

- **正面**（フロント板）に OLED の窓と、マイクのヒゲ（貫通スリット）。
- **天面**につまみ・会話ボタン・スピーカーのグリル。🔒 **つまみは OLED から見て右**です。
  使う人（介護の現場・高齢の方）の殆どが右利きで、右手で回すためで、これが設計の最上位の条件です。
- **左の壁**にイヤホンジャックの丸い口。ReSpeaker 自身の USB-C は 🔒 外に出さず、壁の内側の盲ポケットで受けます。
- **右の壁**に XIAO の USB-C の口。
- **後ろ**（ハッチ）に充電の Type-C の口、トグルスイッチ（尻尾つき）、電池の交換用の蓋。

板は 6 枚（床・左の壁・右の壁・天面・フロント・ハッチ）で、落下を前提に厚み **2.0mm** です。

## 2. 中身の積み方

下から順に重なります。組む順もこの順です。

| 段 | 何が入るか |
|---|---|
| 床 | **ハブ基板**（`X 74 × Y 52`）を平置きで M3 ×4 留め。X は箱の中央（`X 6.0〜80.0`）、前縁は `Y 15.9` |
| 床に立つ | **ReSpeaker Lite**（＋直付けの XIAO）を前の溝に立てる。**OLED** を前に立てる |
| 左の壁ぎわ | **Type-C 基板**（20 × 15 × 1.6）を板の裏で左壁の内面に付けて立てる。`X 1.694〜3.294・Y 57.4〜72.4・Z 0.5〜20.5`。床の受け（底の座・前の当て・前の返し・後ろの控え）に座り、ブリッジの帯の裏の押さえが Z の抜けを止める。**壁と一緒に降ろす** |
| ハブの上 | **ブリッジ**（左右の壁を渡す平板＋電池の受け皿）。皿は `Z 21.4〜23.4`、壁〜壁の帯は `Y 50.5〜62.9`。前の 1 枚板の脚が床の溝に座り、**3 か所で壁の棚へ上から留まる**（左前 `Y 30.5〜36.5`・右 `Y 56.9〜62.9` が M2×6、帯の左端が `Y 45.0〜50.4` で M2×4） |
| 皿の上 | **電池**（1000mAh・50 × 35 × 6）を平置き。`X 11.5〜46.5・Y 13.9〜63.9・Z 23.4〜29.4`。🔒 タブ（JST）は後ろ＝ハッチ側。🔒 2026-08-26 ユーザー「バッテリー自体のってるブリッジの帯ごと左に 4mm 移動」で `BAT_DX` を +1 → −3（皿・脚・帯・座・両基板が一緒に動く） |
| 電池の尻の後ろ | **電池のコネクタ対**（嵌合した PH2.0・⚠ 仮の外形 `14.0 × 5.0 × 6.0`）を `X 27〜41・Y 64.2〜69.2・Z 23.4〜29.4` に**X 方向に寝かせて**置く。🔒 2026-08-27 ユーザー「後ろの 8.35mm にコネクタ対を置きましょ」。ポケットの実測は `Y 63.9〜70.4`（6.5mm）・高さは `Z 39` まで・電池口は `X 42.2 × Z 7.00`。嵌合長 約 14mm は Y には寝ないので X に寝かせる。嵌めるのは**電池が座ってから真上で**（手順 7 だけ）、外すのは**電池ごと口から出してから箱の外で** |
| 電池を抱く | **留め帯 3 本**（⊓ 断面・**支柱と一体**）。`Y 15.45〜24.45 / 33.2〜44.8 / 51.7〜58.6`（🔒 2026-09-03 B を後ろへ 2.6・C を前へ 0.9 広げて、支柱の胴 φ5.8 が帯の中に入るようにしました。残るのは PowerBoost の後ろの 1 本だけで、胴が後端から 1.47mm はみ出します ── C の後ろを 60.1 まで伸ばせば入りますが、後ろの土手が 2.8mm になってツバが消えるのでやめました）・`X 9.0〜49.0`。天板に基板の座が乗る。足の前後の**ツバ**が土手を X に貫通した溝に入り（横差しのみ）、後入れの**電池が楔**になって戻らない |
| 帯の天板 | **電流計（INA226）**（`X 10.53〜49.37・Y 19.17〜39.27・Z 31.20〜46.50`）と **PowerBoost**（`X 10.97〜47.53・Y 33.28〜69.70・Z 30.97〜45.54`）。どちらも部品面が上。板の浮きは PowerBoost が 0.5、電流計が **1.0**（`INA_LIFT`・ネジの先と電池の隙間を 0.1 → 0.6 にするため）。**傾きは 2 枚で別**です: PowerBoost は 🔒 2026-08-29 の **14°**（後縁を蝶番に前が持ち上がる。上限は板の頭ではなく **PH プラグの抜き差しの通り道**で決まる ── 通り道の頭が 14° で Z 48.07・天井 48.454。15° で天井に触れる）、INA226 は 🔒 2026-08-26 の **0°（水平）**。<br>🔒 2026-08-29 電流計は `INA_DY = 3.0` で **+Y へ 3.0 送って**、傾いた PowerBoost の前縁の下へ潜らせてある（会話ボタンのバスタブの下を空けるため。+4 で PowerBoost に 1.83mm³ 当たる） |
| 天面 | つまみ（AS5600 の島）・会話ボタン・スピーカー・リードスイッチが天面にぶら下がって一緒に降りる。つまみとスピーカーは 🔒 2026-08-26 に**内側（−X）へ 4** 動きました（`KNOB4` `SPK4` とも `X 63.204`・会話ボタンは `X 22` のまま） |

電池は組んだ後も、ハッチの蓋を開けて**後ろへ引き出せます**（工具なしの交換）。
コネクタは繋いだまま電池について口から出るので、外すのは箱の外です。🔴 2026-08-27（11 度目の机上の通し）まで、電池の線は電池のタブから電流計の INPUT まで 1 本続きで、**外れる所がどこにもありませんでした**。交換の検査（`chk_swap`）はその線を障害物から丸ごと外して 0 を出していました。

## 3. 動かせないこと（🔒 ユーザー決定）

- **つまみは OLED から見て右。** 線・口・組み立ての都合は全部この下です。
- **固定は OLED・ReSpeaker・ハブ基板の 3 つ。** 天面につまみ（AS5600）・会話ボタン・スピーカー。他は位置もサイズも自由でした。
- **ハブ基板は X 中央**（`HUB_DX = 0`）。
- **電池はハブの上に平置き**で、タブは後ろ向き。**交換は後ろから**。
- **樹脂にネジは切らない。** 全部が貫通＋ナットです（[DIMENSIONS.md](DIMENSIONS.md) の方針）。
- **スイッチは `part=` 一本**（v3 と同じ）。値の一覧は [case_v4.scad](../hardware/frozen/v1-v4/case_v4.scad) 冒頭のコメントが正です。
- **開口はベベル、穴は殻の大きさ**（スカスカにしない）。継ぎ目は 45°。丸みの持ち主はフロント＝天面 ＞ 側面 ＞ 背面 ＞ 底面。
- **刷るのは光造形**（🔒 ELEGOO Mars 3・層 0.05）。薄壁は 0.3mm が形になる実績（[PRINT.md](PRINT.md)）。

## 4. 印刷部品

全部で **19 点**です。うち 2 点（つまみ・つまみの島）は形を [knob_v5.scad](../hardware/frozen/v1-v4/knob_v5.scad) が持ちますが、
🔒 2026-08-27 ユーザー「v4 ディレクトリにまとまるのが筋」で、**刷る物の STL は `stl/v4/` の 1 か所に集めます**
（`python hardware/frozen/v1-v4/_stl_v4.py` が両方の .scad から焼きます）。卓上テストの天板（`deck`）は
道具なので、この 19 点には入りません。
🔴 2026-08-30 に **19 → 25 点**へ増えました（増えたのは支柱 6 本と、会話ボタン v3 のバスタブ 1 点。
減ったのは会話ボタンの留め板 1 点）。🔒 2026-09-03 に**支柱 6 本が留め帯の一部になった**ので **25 → 19 点**です
（ユーザー「スペーサーが上からひっぱると抜ける問題があり、帯と一体化に戻す事になりました」）。
🔒 2026-08-27 ユーザー「rod はもう完全にいりませんね」で、押し棒（`rod`）は knob_v5.scad から削除しました。

| 部品 | `part=` | 刷る向き |
|---|---|---|
| 床 / 左の壁 / 右の壁 / 天面 / フロント / ハッチ | `p_floor` 〜 `p_hatch` | `print_*` で外面を下・底 Z0 |
| 電池の蓋 / 蓋のロック / 尻尾 | `p_shutter` / `p_lock` / `p_tail` | 同上 |
| ブリッジ | `print_bridge`（`part="bridge"` は見る用の一式のまま） | 皿を伏せる（レール・パッド・ビスの座は全部上を向く）。**皿の裏が平らにプレートへ着く**（接地 2263mm²）。⚠ 2026-08-27 まではここに充電の Type-C の押さえが 0.7 下がっていて皿が浮いていたが、🔒 ユーザー指示で押さえを左の壁へ移した。🔴 **支えの無い天井が 65mm² ある**（下の「⚠ ブリッジの掘り込みの天井」） |
| 前板（電池の返し＋前の脚） | `print_brgfront` | **前面を伏せて寝かせる**（🔒 2026-08-26 ユーザー）。前面（Y 12.9）は **634mm² の 1 枚の平らな面**でそのままベッドに着き、フランジは真上へ立つ壁になるので庇が出ない。高さ 8.0 |
| 留め帯 A / B / C（3 点・**支柱ごと**） | `print_strap_a` / `print_strap_b` / `print_strap_c` | 🔒 2026-09-03 **直置き**（組んだ姿勢のまま・足の裏とツバの裏がベッドに着く）。天板の裏のアーチ（足と足の間 36mm）は `_v4_props.py` が立てる柱で受けます（A 23 本・B 37 本・C 22 本）。接地 104 / 183 / 104mm²・宙から始まる肉 0 か所・急な立ち上がり 2.37〜2.57mm（較正 4.00 の内側）・高さ 11.9 / 16.3 / 12.7mm。⚠ 伏せる向き（`strap_print_flip`）と、傾けて浮かせる向きは廃止 |
| 会話ボタンの押し子 | `print_piston`（`print_btn` は旧名の別名） | 頭を下（皿の面をベッド）に置く。首とツバは上に開くので支柱が要らない |
| 🆕 会話ボタンのバスタブ | `print_tub` | 🔒 2026-08-30 の v3 で刷る物になった 2 点目（背 9.34mm） |
| 🆕 充電基板の受け | `p_seat` / `print_seat` | **壁に当たる面（−X）を伏せて寝かせる**。部品の背は 4.21mm・体積 257mm³。立てると 4.21 × 19.8 の足で 20.5 の塔になる。接地 100mm² なので **ラフトを敷く**（`props_seat` / `raft_seat` はモデルに入っている＝この向きでしか刷れない） |
| 🆕 つまみ / つまみの島（2 点） | `knob_v5.scad` の `part="knob"` / `part="wall"` | つまみは天面を伏せる（軸が上・背 21.40）、島はへこみの底を下（背 3.90）。書き出しは `python hardware/frozen/v1-v4/_stl_v4.py knob knobwall` で `stl/v4/v4_knob.stl` ／ `v4_knobwall.stl` |

🔒 2026-09-03 **支柱は留め帯と一体**です。帯の天板から胴 φ5.8 と軸 φ2.0 が生えていて、帯の裏（電池に触る面）には何も出ません。板は**上の E リング（呼び 1.5）6 個だけ**で押さえます。2026-09-02 の「下側の抜け止めが成立していない」（別部品だった版）はこれで終わりです（経緯は [CASE-V4-LOG.md](CASE-V4-LOG.md) §31〜32）。刷る向きと支柱の付け方は [PRINT.md](PRINT.md) §3.9。

下の 5 行は 2026-08-26 に出口を付けました。それまでは板 9 点しか STL に出せませんでした。
同じ日に、ブリッジから**前板（電池の返し＋前の脚）を切り離して別部品にしました**（🔒 ユーザー）。
ブリッジは皿と脚が直角に付いた L だったので、どちらの面を下にしても片方が宙に浮いていました。
前板は**ビスを使わずに**、下は床の溝、上は皿を貫く抜き＋皿の裏の掘り込み（深さ 1.0）に差した
フランジ（厚み 1.0・奥行き 6.0）で止まります。フランジは掘り込みに丸ごと沈むので皿の裏へは出ません。
**前へ倒れようとするとフランジの背が掘り込みの天井（Z 22.4）に当たり、後ろへ倒れようとすると
首の背が抜きの奥（Y 15.1）に当たります**。どちらも面で受けます（首の背は 23 × 2.0）。
組む順は**前板を先に床の溝へ差してから、ブリッジを真上から降ろす**
（[_brgf_sec.png](../hardware/frozen/v1-v4/_brgf_sec.png) ／ 抜いた姿は [_brgf_fit.png](../hardware/frozen/v1-v4/_brgf_fit.png)）。

**⚠ ブリッジの掘り込みの天井（2026-08-28・15 度目の机上の通し）**。
その掘り込みは皿の裏のへこみなので、皿を伏せて刷ると**へこみの天井が下を向きます**。
`_stl_preflight.py` はここを **支えの無い天井 65mm²**（刷る向きで Z 1.10・X 19.9〜38.2・Y 15.3〜18.5・1 層）
と読みます。掘り込みは前（首を通す抜きの側）へ開いていて、天井を支える壁は左右と奥の 3 方だけです。
**⚠ 「支柱を立てられない」わけではありません**（2026-08-28・ユーザー指摘で訂正）。
掘り込みはプレートへ向かって開いているので、**柱を立てる空間は空いています**。
`_v4_props.py` が 0 本なのは `keepout_bridge()` が `brgf_cuts()`（この掘り込みそのもの）を
keepout に入れているからで、**こちらが書いたルール**です。
本当の制約は場所ではなく**痕**です。掘り込みの実寸は**公称 1.0 ＋ 逃げ 0.1 ＝ 1.1**（天井は Z 22.5）、
フランジの厚みは 1.0 なので、**差し込みの逃げは 0.1mm**。支柱の痕の実績は **0.3mm**
（`knob_v5.scad` の「痕 0.3 の実績」）で、痕はフランジが滑り込む天井の面に残ります。
⇒ **サポートを入れるなら、先に掘り込みを深くする**（`BRGF_SINK` 一箇所）。
その代わり前板が前へ倒れる余裕が増えます（逃げ 0.1 で約 1°・0.4 なら約 4°）。⬜ ユーザー判断。
上の本文の「深さ 1.0・天井 Z 22.4」は逃げを含まない公称値で、実寸はこちらが正です。

**危険度の見立て**: 天井は膜ではなく**厚み 0.9mm の棚**（皿 2.0 − 掘り込み 1.1）で、
左右と奥の 3 辺で繋がり、自由なのは手前の 1 辺だけです。**一番遠い点でも奥の壁から 6.0mm**。
preflight の「支えから 2.0mm 超」は部品を選ばない一般のしきい値なので、ここは
**このまま刷って前板が入るかを見る**のが安いと考えます。⬜ 刷ってから
（絵: [_brg_pocket_zoom.png](../hardware/frozen/v1-v4/_brg_pocket_zoom.png)）。
🔴 [CASE-V4-OPEN.md](CASE-V4-OPEN.md) の T-6 には「支えの無い天井 **なし**・接地 2304mm²」と書いてありますが、
それは 2026-08-27 に押さえを壁へ移した時点の値です。いまの STL は 65mm² / 2263mm² です。

刷る前に「底の Z が 0 か」と「最薄肉」を機械で見ます（[PRINT.md](PRINT.md)）。
留め帯の設計上の最薄はナットの床 **0.35mm** です。

## 5. 締結

ビスは **25 本**、長さは 5 種類（`M2×4` / `M2×6` / `M2×8` / `M2×15` / `M3×8`）だけです。
（`M2×8` は 🔒 2026-08-29 に会話ボタンの留め板で入りました。ここが 4 種類のままだったのは掃き忘れです）
🔴 2026-08-27 まで見出しは **27 本**でしたが、それは表につまみの島の 2 本が抜けていた数え忘れでした（正しくは 29 本）。
🔒 2026-08-28 に **AS5600 の基板の 4 本を廃止**（棒＋E リングへ）し、🔒 2026-08-30 に
**電流計 / PowerBoost の M2×4 6 本を廃止**（支柱＋E リングへ）したので、いまは **19 本**です。

| ビス | 本数 | どこ |
|---|---|---|
| `M3×8` | 4 | ハブ基板 → 床（頭は床の裏のザグリ・ナットは基板の上） |
| `M2×15` | 3 | 床の裏 → 左右の壁の下の柱（前 2・後ろ右 1。後ろ左は無し） |
| `M2×6` | 2 | ブリッジ → 壁の棚（左前・右）。上から。**ナットは棚に横から差す** |
| `M2×4` | 1 | ブリッジ → 帯の左端の耳（左**前** `Y 47.7`）。頭の底 24.8 から棚の底 20.8 まで積みがちょうど 4.0 で、**余りが出ない**。🔒 2026-08-26 ユーザー「ネジの長さは留め金の長さで調整したい」。この 1 本だけ棚が帯の前（OLED 側）に立つ ── 後ろだとドライバが天面ボスに当たる（CASE-V4-OPEN の T-1） |
| `M2×6` | 2 | つまみの島 → 天面（上から・**ナットは天面の裏の下向きポケット**） |
| | | 電流計の 2 本は 🔒 2026-08-26 に**板の浮きを 0.5 → 1.0**（`INA_LIFT`）にしました。座が `3.0` になり、天井 0.4 ／ ナット 1.7 ／ 床 0.9 で**掛かりは満（1.6）のまま**、**ネジの先と電池の上面は 0.1 → 0.6** です。ナットは座の**天井**に居て板と一緒に上がるので、**ネジは M2×4 のまま**で足ります（`_seat_probe.scad`） |
| `M2×6` | 2 | OLED → 天面の L（前から・ナットは L の後ろ） |
| `M2×6` | 2 | 天面の後ろの 2 本（壁の柱）。積みは 天板 0.9 ＋ ナット で余りが 1.7 あります |
| `M2×8` | 2 | 天面の前の 2 本（天面＋フロントの耳＋耳柱 の 3 枚）。🔒 2026-09-04 ユーザー「8mm のにするので大丈夫です」。✅ 同日の実機で `M2×6` は**届きませんでした**（設計上は 天板 0.9 ＋ 耳 3.2 ＋ ナット 1.8 ＝ 5.9 で余りが **0.1mm しか無く**、現物では消えていた。仮に 15mm を挿して確かめてあります） |
| `M2×6` | 1 | 電池の蓋のロック |

ほかに、トグルはハッチの外から六角ナット 1 個、電池の蓋の磁石が φ6 × 2.0 を 4 個です。
**E リングが 10 個**あります —— つまみの軸に**呼び6** 1 個、AS5600 の基板を受ける**呼び3** 3 個
（🔒 2026-08-28 に基板のねじ止めを廃止。[KNOB-ENCODER.md](KNOB-ENCODER.md)）、電流計 / PowerBoost を支柱に留める**呼び1.5** 6 個。
呼び 1.5 は手元に 12 個あります（📄 適用軸 2.0 超〜2.5・外径 4.0・厚 0.4・溝径 1.53・溝幅 0.5。[CASE-V4-LOG.md](CASE-V4-LOG.md) §31.2）。

**ナットの向きが 2 種類あります。** 床・天面・耳のボスは上向きのポケットで、落とし込んで箱を傾けなければ残ります。
ブリッジの棚の 3 か所は**横から差す捕捉溝**で、上下の肉で閉じ込められるのでどう向けても落ちません
（留め帯の 6 か所は E リングになったのでナットがありません）。

## 6. 線

13 束 39 本です。通り道は 4 本 —— 左の溝（`X 5.4〜13`）・右の溝（`X 53〜80`）・
後ろの縦穴（`Y 62.9〜72`）・帯の上の棚（`Z 31.4〜43`）。

**線には高さの階が 2 つあります。** 低い車線（`Z 19`）はブリッジの皿と帯の**下**を通り、
上の車線は皿や帯の**上**を通ります。これが組む順を決めています（下の §7）。

| 階 | 束 |
|---|---|
| 低い車線（ブリッジより先） | XIAO 7・つまみ 5・BTN2 2・スピーカー IN 2・スピーカー OUT 2 |
| 上の車線（ブリッジより後） | OLED 4・電流計の I2C 4・トグル 2・リード 2・充電 2 |
| 電源系（基板が入ってから） | PWR 3・電池線 2 ＋ 2 |

模型は [_v4_core.scad](../hardware/frozen/v1-v4/_v4_core.scad) の `w_*()`（1.5 角の箱・直角のみ）。
接点の世界座標は `W="pts"` が echo で吐きます（手で写さない）。

**たるみの行き場**（2026-08-26 に測った。組み立てマニュアルの「まだ埋まっていない」から移した）。
作る長さは模型の実長 ＋65mm なので、閉じた後に最大 40mm の余りが 4 束ぶん、箱の中へ戻ります。
箱の中の空きは **195,910mm³**（内寸の 2/3）で、1mm の格子で塊に割ると **186,185mm³ が 1 つながり**です
（残り 142 個は合計 1,000mm³ 足らずの隅）。4 束ぶんの余りは 2.2mm の束 × 40mm × 4 ＝ **約 600mm³** なので、
行き場そのものはあります。逃がし先は**後ろの縦穴**（27,865mm³）と**右の溝**（65,944mm³）です。

🔴 **空いていても、たるみを置いてはいけない道が 3 本あります** —— **電池の抜き道**・**蓋の横スライド**・
**ハッチの爪**。ここに線が寄ると、電池の交換で線を噛みます。

## 7. 組み立て

**手順は [assembly_v4.html](../docs/manual/assembly_v4.html)**（挿絵つきの 12 手順）にあります。作り直しは
`python hardware/frozen/v1-v4/_asm_manual_v4.py`、段の中身と軌跡の検査は [_asm_sim_v4.scad](../hardware/frozen/v1-v4/_asm_sim_v4.scad) が持ちます。

順番の骨は 2 つの制約です。**ハブの口 10 本はブリッジより先**（皿と帯が上に載って届かなくなる）、
**上の車線はブリッジより後**（先に上げるとブリッジが降りない）。
そこから出た 12 段が —— 床にハブ → ReSpeaker → ハブの口と低い車線 → 左右の壁（**Type-C 基板を抱いて降ろす**）→
ブリッジ → 電池 → 留め帯 → 電流計と PowerBoost → OLED と上の車線と電源系 → 天面の小組 → 天面とフロント → ハッチ、です。

🔴 3 つめの制約が 2026-08-25 に加わりました。**Type-C の充電基板は左の壁と一緒に降ろす**。板の裏を受ける面が
左壁の内面そのものなので壁より先には立てられず、かといって壁の後から真上に落とすと天面の後ろ左のボスが
経路を 75.6mm³ 塞ぐ（`close_tc`）。一緒に降ろす 1 通りだけです。

⚠ この番号は CAD の軌跡検査から起こしたもので、**①〜⑬の原文をユーザーが書いたものではありません**（[CASE-V4-OPEN.md](CASE-V4-OPEN.md)）。

## 8. いまの検査（2026-08-26・`--backend=manifold`）

**0 が正**です。`chk_press` だけは 6mm³ が正で、0 になったら ReSpeaker の押さえが板に届いていない印になります。

| 検査 | いまの値 |
|---|---|
| `chk_floor` 〜 `chk_hatch` / `chk_all`（板 ↔ 中身＋他の板） | **0** |
| `chk_press`（押さえが届いている証拠） | **6mm³ が正** |
| `close_lwall` / `close_hatch`（板を入れる軌跡） | **0** |
| `close_top`（天面一式を降ろす） | **11.45mm³**（実体は 0）。2026-08-27 の 13 度目の机上の通しで 0 → 30.24 になり、同日**線を引き直して戻した**。残るのは AS5600 のデュポンの**線の逃げ予約**（3.6 角）が降ろす途中に XIAO の上段の車線を横切る分で、止まった姿では 6.88mm 離れている（[CASE-V4-LOG.md](CASE-V4-LOG.md) §25） |
| `close_rwall`（同上） | 0.01（0 厚の膜。旧 25 は線を引き直す前の値） |
| `brgldg` / `brghw` / `brgchk`（ブリッジを箱へ留める棚・ビス・本体） | **0**（2026-08-26 に追加） |
| `close_front` | 0.13（0 厚の膜 2 枚） |
| `close_desk`（ブリッジを降ろす） | 109.7mm³ ＝ **OLED より先に降ろせ**という制約（順番を守れば 0） |
| `chk_tc`（Type-C の受け＋押さえ ↔ 基板と周り） | **0** |
| `close_tc`（左の壁と Type-C 基板を一緒に降ろす） | **0** |
| 軌跡（`_asm_sim_v4.scad` の `CHK=`）: 壁・OLED・上の車線 | **0** |
| 同 ブリッジ 9.79 / 電池 4.16 / 留め帯 9.78 / 基板 2.98 | どれも **BTN2 の線が会話ボタンのスイッチの足へ渡る最後の枝**で、スイッチはまだ載っていない。枝を外すと 0 |
| `chk_wire` / `chk_wire_w` / `chk_wire_pwr`（線 13 束） | **0**（2026-08-26、つまみ −4・帯ごと −4 に合わせて OLED・BTN2・PHIN・I2C・電源 3 系統を引き直した後） |
| `seatchk` / `strappb` / `inachk` | ⚠ **0.37mm³**（電流計の板の縁 ↔ 留め帯 A の座。既知） |
| `seathw`（ネジとナットの現物 ↔ 周り） | **0** |
| `seatbolt` | 1.71（ネジの頭が 10° の板に片当たりする分・設計どおり。電流計は水平になったので片当たりしません） |
| 工具と手の道（`python hardware/frozen/v1-v4/_asm_access.py`） | **止まったもの 0 / 33**。OLED の右のナットの空きは 1.3 → **15.7** |

## 9. 判断待ち

[CASE-V4-OPEN.md](CASE-V4-OPEN.md) にまとめました。1 件につき「やること」「いま」「外れると」の 3 行です。
**買う / 落とすが 2 件**、**AI が置いた仮の数字が 7 件**。設計を決める必要があるものは 2026-08-26 に 0 件になりました。

## 10. §番号の行き先

他の文書や .scad が「CASE-V4 §10」のように指しているのは、**分ける前の章番号**です。
その本文は [CASE-V4-LOG.md](CASE-V4-LOG.md) に同じ番号で残っています。いまの姿を知りたい場合の対応は次のとおりです。

| 旧 § | 中身 | いまの姿は |
|---|---|---|
| §1 前提 | v4 を始めたときの条件 | この文書の §3 |
| §2 PowerBoost の置き場 | 🔴 **全部が過去**。案 A も案 C も落ちて、PowerBoost は電池の上へ移った | この文書の §2 |
| §3 魚の開きを畳む | 🔴 過去のスタディ（INA の仮置き X=24 も無効） | この文書の §2 |
| §4 組む姿勢 | 🔴 v3 の写しで、§13 が置き換えた | この文書の §7 |
| §5 挿さる物の台帳 | 部品の模型がどこまで実測かの一覧。**まだ生きている** | LOG §5 をそのまま |
| §6 まだ無いもの | 進め方の反省と実測 2 件 | [CASE-V4-OPEN.md](CASE-V4-OPEN.md) |
| §7 芯から作り直す | 🔒 固定は 3 つだけ、という決定 | この文書の §3 |
| §8 電池の置き方 | 🔒 平置き・タブは後ろ | この文書の §2 |
| §9 配線 | 線 13 束の道 | この文書の §6 |
| §10 外皮とボス | 板 6 枚と締結 | この文書の §1・§5 |
| §11 電池の入れ替え口 | 後ろ抜きの蓋 | この文書の §2 |
| §12 意匠の追い込み | ベベルを浅く・傾斜の座とネジ | この文書の §2・§5 |
| §13 組み立ての手順 | 12 手順と、そこで見つかった直し | [assembly_v4.html](../docs/manual/assembly_v4.html) |

部品の寸法は [DIMENSIONS.md](DIMENSIONS.md)、ReSpeaker の実測は [RESPEAKER-LITE.md](RESPEAKER-LITE.md)、
電源系は [POWER.md](POWER.md)、印刷は [PRINT.md](PRINT.md)、v3 までの経緯は [CASE-V3.md](CASE-V3.md) です。
