n416/katanori/docs/RESPEAKER-LITE.md

# ReSpeaker Lite — 基板の形と結線

**この基板について「現物がどうなっているか」を1か所に集めた参照表である。**
外形・面・端・穴・突き出ている物・XIAO の14本の行き先を持つ。
🔒 **ここに書いてあることを聞き直さない。**

| 文書 | 担当 |
|---|---|
| **RESPEAKER-LITE.md（ここ）** | この基板の寸法・位置・結線。**事実だけ** |
| [POWER.md](POWER.md) | 電源の設計と根拠。**どう繋ぐかの判断はあちら** |
| [DIMENSIONS.md](DIMENSIONS.md) | 他の部品の寸法／格付け（✅実測 / 📄カタログ / ⚠推定 / ⬜未取得）の定義 |
| [PRINT.md](PRINT.md) | 印刷の補正値 |

📄 経緯・反省・訂正の履歴は 2026-08-15 に削除した。`git log -p docs/RESPEAKER-LITE.md` で読める。

---

## 1. 基本 — この機体は **V1.1**

基板のシルクに **`V1.1`** と印字されている（✅ 実物写真 2026-08-04）。
🔴 **[公式wikiのピンアウト図](https://wiki.seeedstudio.com/xiao_respeaker/)に写っているのは V1.0 で、
別の版である。図から位置を読み取ってはいけない**（2回外している。実際「USB-Cは右の短辺」と
読んだが、この機体では上の長辺にあり開口は上を向いていた）。**図から使ってよいのは
「どの部品がどちらの面のどの端にあるか」だけで、mm は 5.5／5.6 の表からしか取らない。**

| | 値 | 出典 |
|---|---|---|
| 横（長辺） | **86 mm** | 📄 公式仕様と ✅ 実測が一致。⚠ **これは張り出し込みの外形**（素の基板は 82.024・5.6） |
| **縦（短辺）** | **34 mm** | ✅ ユーザー実測。**2枚目のボードでも34を確認**（別個体で一致）。⚠ 公式仕様の 35 と1mm食い違うが、個体差ではない。**実測を採る** |
| **板厚** | **1.85 mm** | ✅ ユーザー実測（2026-08-10・板厚ゲージv2の櫛・0.05刻み）。**公式CADの1.510とも標準の1.6とも違う。** 傍証2つ: 穴Aペグ（当て面から2.21）の出しろ「ほぼ無し」＝2.21−1.85=0.36 ／ 中央領域の実測4.8 ≒ 1.69+1.85+1.19=4.73 |
| → 溝で受けるときの設計値 | **2.10 mm** | 1.85 ＋ 縮み0.1 ＋ 遊び0.15 |

⚠ 検索に出る「45.5 × 86.5mm」は公式の外形と食い違う（ケースか梱包の値と思われる）。採らない。

## 2. 面の呼び方（固定）

**面は向きで呼ばない。載っている物で呼ぶ。** スタンドで傾けると上下・表裏の意味が変わるため、
**「上・下・表・裏」は使わない。**

| 呼び方 | どの面か |
|---|---|
| **XIAO面** | XIAO・XU316・全コネクタ・パッド類が載っている面 |
| **マイク面** | マイク2個・各LED・Usr/Muteボタン・`seeed studio` ロゴがある面 |

🔒 **基準の向きは「XIAO面を手前・XIAO の USB-C が左」**（✅ ユーザー確認・2026-08-03）。
この向きで **86mm が横・34mm が縦**で、短辺を「左端」「右端」と呼ぶ。

> 🚫 **鏡像の禁止。** モックで面のY割り当てを逆に置き、モデル全体が鏡像になる事故を起こした
> （2026-08-04）。鏡像は一瞬正しく見えるため、**それを基準に伝えられる座標ごと汚染される。**
> 座標系や面割り当てを定義・変更したら、**XIAO面ビューのレンダを実物写真と並べて照合するまで、
> そのモデルで設計しない。** モックの面ラベル「XIAO」が鏡文字に見えたら、裏（マイク面）を見ている。

## 3. 何がどこにあるか（面と端の割り当てのみ）

| 面 | 位置 | 物 |
|---|---|---|
| XIAO面 | **左端** | ⑦ XIAO ESP32S3（実装済み）。**XIAO の USB-C は基板の左端から外へ張り出す** |
| XIAO面 | 中央 | ⑧ XU316 |
| XIAO面 | **上の長辺・Type-C のすぐ左** | ⑨ 外部電源パッド（下記） |
| XIAO面 | **右端** | ⑩ **USB Type-C**（ReSpeaker側）／ ⑪ **スピーカー端子**（白・2ピン・`SPK + −`・🔒 **PH2.0**）／ ⑫ **3.5mmジャック**。**3つとも右の短辺に並んで外を向く** |
| XIAO面 | 下辺 | ⑬ 外部パッド1 `Mute D3 D2 Usr ⏚ 3V3` ／ ⑭ 外部パッド2 `43 42 36 35 33` ／ ⑮ JTAG |
| マイク面 | **左端寄り** | **MIC 1** ／ Power LED |
| マイク面 | **右端寄り** | **MIC 2** |
| マイク面 | 中央 | RGB LED（WS2812）／ Mute LED |
| マイク面 | 右下 | ⑤ Usr ボタン ／ ⑥ Mute ボタン |

### ⑨ 外部電源パッド — 🔴 **穴の無いランド2枚**

📄 公式のハードウェア図で位置と形が確認できた（`files.seeedstudio.com/wiki/SenseCAP/respeaker/front.png`）。

| | 内容 |
|---|---|
| 面 | XIAO面 |
| 位置 | **上の長辺に沿う。** XU316 の右上・**ReSpeaker の Type-C のすぐ左**（基準の向き＝2章） |
| シルク | **左が `GND`・右が `5V`** |
| 形 | 🔴 **平らなランド2枚。穴が開いていない**（拡大画像で確認）。ピッチは2.54mmより狭い |

🔴 **したがって「このパッドに2ピンのピンヘッダーを立てる」は物理的に成立しない。**
⬜ **では何で受けるかは未決で、判断は [POWER.md](POWER.md) 5章が持つ**（この文書は形しか言わない）。
⚠ 公式図の基板シルクは `V1.0` なので、位置と形は現物で照合すること。
⬜ 左からの mm は未取得。

## 4. 🔒 XIAO の14本が基板上で何に繋がっているか

📄 出典は wiki に1枚だけ載っている **XIAO ブロックの回路図画像**
（`files.seeedstudio.com/wiki/SenseCAP/respeaker/respeaker_lite_v1.0_sch_1.png`）。
⚠ **Seeed はフル回路図を公開していない。**

🔴 **「ファームで未使用＝空きピン」ではない。基板側の結線を先に見ること。**
D10 をリレー駆動に選んで実機で外した件は、この表があれば起きなかった。

| XIAO | 基板上の行き先 | 空きか |
|---|---|---|
| **D0** | 🔴 `XIAO_WS2812` — RGB LED のデータ線 | ❌ 下記 |
| **D1** | 🔴 `XU316_RST` — XMOS のリセット | ❌ |
| **D2** | `XIAO_D2` → 外部パッド1 ⑬ | ✅ |
| **D3** | `XIAO_D3` → 外部パッド1 ⑬ | ✅ |
| D4 | `I2C_SDA`（**4.7kΩ プルアップ実装済み** R34） | I2C |
| D5 | `I2C_SCL`（**4.7kΩ プルアップ実装済み** R35） | I2C |
| D6 | `I2S_DIN_SEC`（DIN・R36 0Ω） | ❌ |
| D7 | `I2S_DIN_XIAO`（DOUT・R40 0Ω） | ❌ |
| D8 | `I2S_LRCK`（R39 0Ω） | ❌ |
| D9 | `I2S_BCLK`（R38 0Ω） | ❌ |
| **D10** | `I2S_MCLK`（R37 0Ω） | ❌ **実測 1.49V（矩形波の平均）と一致** |
| 3V3 / GND | 基板の 3V3 / GND | — |
| **5V** | 🔒 **`+5V` ネットに直結**（C59 100nF が付くだけ。逆流防止も分離も無い） | 給電の入り口 |

### 🔒 D0 は壊れていない。**680Ωでプルアップされている**

```
XIAO D0 ──[D11 ショットキー]──┬──[R75 680Ω]── +3V3
                              │
XU316 ────[D12 ショットキー]──┴──[Q5 LBSS138 レベルシフタ]──[R69 5.1k→+5V]── WS2812 の DI
```

**XIAO と XMOS が1本の LED データ線をワイヤードOR で共有していて、High を作っているのは
R75 の 680Ω である。**「何も繋がない状態でテスター(10MΩ)を当てても3.3Vが動かない」という実測は、
**このプルアップそのもの**である。🔒 **故障説は否定された。**

⚠ **ただし空きピンにはならない。** 使えば RGB LED のデータが壊れ、XMOS 側も同じ線を叩く。
⬜ RGB LED を捨てる前提なら入力として使える可能性はあるが、XMOS が叩く分をファームで無視できるかが
未検討。**いま結論を出さない。**

## 5. 🔒 取付穴 — 2つ・対角・**φ2.20（M2）**

📄 公式CAD ＋ ✅ ユーザー確認（2026-08-08）。**実物に2mmネジが通ることを確認済み。**

```
        XIAO面を手前・XIAOのUSB-Cが左（86 × 34）

      左2.5
       ↓
    ┌──●─────────────────────────────────────────┐  ↑
    │  ↑ 上2.5                                    │  │
    │                                             │  │ 34
    │                                             │  │
    │                                ●            │  │
    │                          左60 ↗ ↑ 下2.5     │  ↓
    └─────────────────────────────────────────────┘
    ←──────────────── 86 ────────────────────────→
```

| 穴 | 左から | 上下 | 径 |
|---|---|---|---|
| 隅の穴 | **2.492 mm** | **上から 2.430 mm**（＝下から 31.577） | **φ2.20（M2）** |
| もう一方 | **60.202 mm** | **下から 2.657 mm** | **φ2.20（M2）** |

> **向きの取り違えは写真で判別できる。** XIAO面の公式写真で、隅ではない穴は**基板の右半分**に
> ある。鏡像（マイク面から見た向き）なら 86 − 60 = **26mm** で左半分に来る。隅の穴も XIAO面では
> 左上、マイク面では右上に写っていて、鏡の関係と一致する。

## 5.5 🔒 実測マップ（2026-08-04・この機体 V1.1）

**座標は「左から／下から」。基準の向きは2章。**
モック [../hardware/parts/respeaker_lite.scad](../hardware/parts/respeaker_lite.scad) はこの表そのもので、
⚠ **片方だけ直さない。**

| 部品 | 面 | 左から | 下から | 立ち上がり | 備考 |
|---|---|---|---|---|---|
| XIAO（直付け）＋その上のピンヘッダー2列 | XIAO | **2〜20** | 下列 7〜9 ／ 上列 23〜25（**下から8 と 上から8**・厚み2） | **10（ピンの先端）** | ✅ 2026-08-24 構成確定（ユーザー写真・何度も指摘されていた）: **XIAO は基板に直接はんだ付け・ヘッダはその上**。はんだ0.2＋板1.2＋樹脂2.5＋ピン6＝9.9≈10。線の DuPont を挿すと頭 13.9。🔴 旧記「ソケット込み」「XIAO がソケットに載る」は AI の誤り |
| Usr スイッチ | マイク | 1.5〜6.5 | 3.5〜6.5 | 3.5 | 座に当たった張本人 |
| Mute スイッチ | マイク | 9〜14 | 3.5〜6.5 | 3.5 | 〃 |
| **中央領域**（基板込み） | 両面⚠ | **32〜65** | **0〜34（全域）** | 計 **約4.8** | ✅ ユーザー実測。⚠ 面ごとの振り分けは未取得（クレードル設計では不要） |
| 3.5mmジャック | XIAO | **68〜83** | 3〜10 | 5 | ✅ 筒が右端から突き出す |
| スピーカーソケット | XIAO | 76〜81 | 12〜23 | 10（線込み15） | |
| USB-C（ReSpeaker） | XIAO | 76〜88 | **24.5〜32.5**（上端 32.5 = 34−1.5 は✅／下端は⚠導出） | ⚠3.2 | ✅ **上の長辺・開口上向き。縁から1.5mm引っ込む**。⚠ X88（右へ2mm出る）との両立は現物で要確認 |
| XIAOのUSB-C | — | 📄 左端から1.53張り出し | 板の高さの中央 | 📄3.26 | 🔴 **2026-08-24 訂正: 殻は XIAO の板の上＝面から 1.4〜4.66**（旧「積み重ねの頭 6.74〜10」は AI の作り話。**右の壁の口はこの誤りで約 5.3 奥に開いていた**。ユーザーは以前から指摘していた） |
| u.FLアンテナ同軸 | XIAO | ⬜ | ⬜ | ⬜ | 存在は✅（実物写真）。経路・固定未定 |

## 5.6 🔒 公式CADマップ（2026-08-08・出典 `ReSpeakerLitev1.1.step`）

Seeed の公式3Dファイル（KiCad が吐いた v1.1 のアセンブリSTEP）から出した値。リファレンス指定子
（K1・U4…）と配置行列が入っているので、**部品の位置は読み取りではなくそのまま数字で出せる。**
格付けは📄（公式CAD）。

⚠ **5.5 とは別の表として置く。5.5 はこの機体の実測（ユーザーの配線・はんだ込み）で、こちらは
素の基板である。食い違ったときは、どちらが何を測っているかを先に見ること。**

座標変換: 基板外形が STEP の X40.238〜122.262 / Y−107.957〜−73.950 / Z0〜1.510 にあるので、
**左から = X − 40.238 ／ 下から = Y + 107.957 ／ マイク面 = Z<0 側・XIAO面 = Z>1.51 側。**
この向きは取付穴2つと K1・K2 の位置が 5.5 と一致することで検算済み。

| 項目 | 値（📄公式CAD） | 5.5・5章との関係 |
|---|---|---|
| 基板外形 | **82.024 × 34.007**、四隅 **R1.27** | 1章の「86×34」は**張り出し込みの外形**。82.024＋ジャックの筒1.578＋XIAOのUSB-C約3 ≒ 86.6 で辻褄が合う ✅ |
| J1（3.5mm ジャック）の筒 | **丸 φ5.45（穴 φ3.6）**・軸 = 下から 6.502・面から 2.485・板の端から 1.576 出る。+Y 側に金属カバー（x 82.25〜82.70・端から 0.68） | 🔴 2026-08-25 まで模型は「胴＋筒」の角箱で、筐体の口が大穴になっていた（ユーザー指摘）。STEP の CIRCLE から取り直し、respeaker_lite.scad を丸筒に修正 |
| USB1（ReSpeaker 自身の USB-C） | 殻 **8.94 × 3.16**（角 r1.28）・下から 23.29〜32.23・面から 0.24〜3.40・板の端から 0.86 出る | 2026-08-25 STEP から。筐体 v4 では 🔒 出さない（左壁の盲ポケット） |
| 基板厚 | **1.510** | ⚠ **実物は1.85**（1章）。**公式CADのこの値は実物と0.34ズレている数少ない項目。** モデル（`respeaker_lite.scad` の `BOARD_T`）は1.85に直してある |
| 取付穴 | **φ2.20** が2つ。左から **2.492**／下から **31.577** と、左から **60.202**／下から **2.657** | ✅ **5章と完全に一致**（位置も径も） |
| マイク U4（左） | マイク面・左から **4.16〜6.81**・下から **15.25〜18.75**・出っ張り **1.28** | 5.5では⬜だった。**塞いだら音が死ぬ場所** |
| マイク U5（右） | マイク面・左から **75.16〜77.81**・下から **15.25〜18.75**・出っ張り **1.28** | 〃 |
| スイッチ K1 | マイク面・左から **1.23〜5.83**・下から **4.11〜7.31**・出っ張り **2.58** | 5.5の「Usr 1.5〜6.5」と一致。⚠ 名前は下の注記 |
| スイッチ K2 | マイク面・左から **8.92〜13.52**・下から **4.16〜7.36**・出っ張り **2.58** | 5.5の「Mute 9〜14」と一致 |
| 3.5mmジャック J1 | 左から **69.00〜83.60**・下から **2.18〜10.83**・XIAO面へ **4.99** | **筒の突き出しは 83.60−82.024＝1.578mm** |
| スピーカーソケット J2 | XIAO面・左から **73.94〜80.94**・下から **13.04〜20.99**・**6.84** | 5.5の「10」は線込みの値。🔒 規格は PH2.0（下） |
| USB-C（ReSpeaker）USB1 | 左から **75.10〜82.88**・下から **23.29〜32.23**・XIAO面へ **3.40** | 右端から **0.86mm** 出る。上の長辺から **1.78mm** 引っ込む。⚠ 5.5の「左から76〜88」の88は合わない |
| XIAOのパッド | 2×7・**2.54ピッチ**・φ0.89。左から **2.932〜18.172**、下から **9.397** と **24.627** | 5.5の「ピンヘッダー2〜20」と一致 ✅ |
| 中央領域（左から32〜65）の素の総厚 | **4.38**（XIAO面へ最大1.69＝C85／マイク面へ最大1.19＝D1／板1.51） | ✅ 5.5の実測 **4.8** との差0.42は**板厚で決着**: 実物の板は1.85なので 1.69+1.85+1.19=**4.73**、残差0.07は測り方の差で足りる。🔒 **スタンドの設計値は4.8のまま**（厚いほうが当たるので、薄い側に合わせると効かなくなる） |

### 🔒 スピーカーソケット J2 は **PH2.0**（2026-08-10 確定）

秋月の **コネクター付コード 2P(E)**（通販コード 105683・型番 DG01032-0009-01・**JST PH相当の
2.0mmピッチ・ストレートプラグ・長さ160mm**）が**この機体のスピーカーソケットに実際に挿さる**ことを、
ユーザーが現物で確認した。規格の推定ではなく嵌合そのものを見ているので確定として扱う。

**向きは トップ型（真上に挿す）**（✅ ユーザー現物確認）。コードは XIAO面から真上に出るので、
**この上に線の曲がるぶんの空間が要る**（5.5 の「線込み15」がそれ）。
**場所取りは公式CADの 7.00 × 7.95 × 6.84 をそのまま使う。**

### 🔒 マイク面に載っている部品は、基板全体で **6つだけ**

STEP で Z<0 側（マイク面）に置かれている部品を全部並べるとこれで終わる。

| ref | 左から | 下から | 出っ張り |
|---|---|---|---|
| K1（スイッチ） | 1.23〜5.83 | 4.11〜7.31 | 2.58 |
| U4（マイク・左） | 4.16〜6.81 | 15.25〜18.75 | 1.28 |
| K2（スイッチ） | 8.92〜13.52 | 4.16〜7.36 | 2.58 |
| D1 | 40.26〜41.86 | 14.27〜15.07 | 1.19 |
| LED1 | 39.90〜42.00 | 16.06〜17.95 | 0.65 |
| U5（マイク・右） | 75.16〜77.81 | 15.25〜18.75 | 1.28 |

→ **マイク面の左上、左から0〜20 × 下から19.5〜34 は完全に無地**（20 × 14.5mm）。
ここは⬜（未取得）ではなく📄（公式CADで空だと確認済み）。**左のロックが掴める場所はここ。**
マイク U4 の上端は下から18.75 なので、下から19.5 より上なら音の穴に掛からない。

> ⬜ **Usr と Mute の名前が 5.5 と逆の可能性がある。** 公式の製品写真のシルクでは、左端側
> （左から1.5〜6.5＝K1）が **Mute**、その隣（9〜14＝K2）が **Usr** に見える。STEP はリファレンス
> （K1/K2）しか持たないので名前の確定には使えない。**位置は一致しているので機構設計には影響しない。
> ファームで区別するときだけ効く。**

## 6. 🔒 設計に効くこと

**5.5／5.6 から機械的に出てくる結論。迷ったらここへ戻る。**

1. **両方の短辺と、上辺の右角が塞げない。** 右端にジャックの筒とスピーカーの線、左端に XIAO の
   USB-C、**上辺の右角（X76〜88）に USB-C が上向きに開く**
2. **下辺の占有**: X0〜14 スイッチ ／ X32〜65 中央領域（下端まで）／ X68〜83 ジャック。
   **素の基板を下辺で掴めるのは X20〜32 の間だけ**（マージン込みで X21.5〜31 の約10mm）
3. **XIAO面は一切押さえられない**（ピンヘッダー2列＋ワイヤー、高さ10mm）
4. **マイクは長辺方向の両端寄りに1個ずつ。** マイク面を受けるなら中央だけ。端は開ける
5. → **基板は立てる。** マイク面＝前（マイクが人を向く）／XIAO面＝後ろ（ヘッダーと線は背面へ）
6. → **受け（橋）は X21.5〜31 の1個だけにして、他は全部開放する。** 当たれる物を1個にすれば、
   当たりの原因も1個になる。X合わせは手探りにせず**左端ストッパー**に突き当てる
7. **中央領域を掴む・挟む設計は、面ごとの振り分け（⚠）を測るまで作らない**
8. **隅の穴（左2.492／上2.430・φ2.20）は、左を掴むための本命。** φ2.2あれば**φ2.0のダボが
   立てられる**ので、ネジを使わずに位置を出せる。下側の穴（左60.202／下2.657）は基板を沈めた
   時点で使えない。⚠ **樹脂にネジは切らない**（レジン①は経時で脆い）
9. **左を掴むなら相手はマイク面。** XIAO面は8項のとおり触れないが、マイク面は基板全体で6部品しか
   載っておらず、**左から13.6〜39.9 は全高が無地**、**左から0〜20 × 下から19.5〜34 も無地**。
   マイク U4（左から4.16〜6.81・下から15.25〜18.75）とスイッチ2つ（下から4.1〜7.4）だけ避ければよい

## 7. この機体で足されている物

**公式の図には無い。この機体固有。ここを設計から落とすと前回の事故と同じになる。**

| 物 | 場所 | 効くこと |
|---|---|---|
| **XIAO（直付け）の上のピンヘッダー 7本 × 2列 ＋ ワイヤー** | XIAO面・XIAO の上に立つ | ✅ ピンの先端 10・**線の DuPont を挿すと 13.9（逃げ込み 17.5）**。XIAO面には何も被せられない |
| ジャンパ（Usr導通用） | XIAO面の ⑬ から通してある | 「何とでもなる」（要件にしない） |
| OLED | ブレッドボードに挿してある（基板には固定されていない） | ⬜ **2.42インチへ移行中**。前面パネル扱いになる（[POWER.md](POWER.md) 4章） |

## 8. 🔒 CADのモック — **刷る前にここで当てる**

**[../hardware/parts/respeaker_lite.scad](../hardware/parts/respeaker_lite.scad)**

```
use <respeaker_lite.scad>
respeaker_lite();       // 基板＋部品。目で見て当たりを探す
respeaker_envelope();   // 侵入禁止の体積。筐体から difference() して、削れたら当たり
```

**2026-08-04 に、当たり板を刷って3回失敗してから作った。** 3回とも CAD の中に基板が無かったから
見つからなかったもので、モックがあれば刷る前に全部出ていた（受け以外の場所で下端が当たる／
マイク面のスイッチが座に当たる／中央領域の部品を 1.5mm の座に入れようとしていた）。

チェックのやり方は [../hardware/frozen/v1-v4/stand_seat_test.scad](../hardware/frozen/v1-v4/stand_seat_test.scad) の
`show="check"`（**何も表示されなければ干渉なし**）。

⚠ **モックの多くの寸法はまだ ⚠（仮値）。** 測ったら `.scad` の該当行を ✅ に書き換える。
**⚠ のままの箱に筐体を密着させない。**

他の部品のモックは [../hardware/parts/parts.scad](../hardware/parts/parts.scad)。
この形を使っているもの: [../hardware/frozen/v1-v4/stand_seat_test.scad](../hardware/frozen/v1-v4/stand_seat_test.scad)。

## 9. 公開されているもの／いないもの

| | 公開されているか |
|---|---|
| 外形 | 📄 **35 × 86 mm**（⚠ 短辺は実測34。1章のとおり実測を採る） |
| **どの部品がどちらの面・どの端にあるか** | 📄 **公開されている**（ピンアウト図・両面） |
| 部品の**寸法上の位置**（mm） | ⬜ 図は写真で寸法線が入っていない。✅ 5.5 と 📄 5.6 で埋まった |
| 取付穴の数・位置・径 | ⬜ 記載なし。✅ 5章・5.6 で埋まった |
| 板厚・部品高さ | ⬜ 無い。✅ 実測で埋まった |
| **フル回路図** | ⬜ **無い。** XIAO ブロックの画像1枚だけ（4章） |
| DXF・STEP・PCB外形 | 📄 **STEP はある**（`ReSpeakerLitev1.1.step`・5.6の出典）。[GitHub](https://github.com/respeaker/reSpeaker_Lite) には画像のみ |

**出典**

- [ReSpeaker Lite with XIAO ESP32S3（ピンアウト図・両面）](https://wiki.seeedstudio.com/xiao_respeaker/)
- [Getting Started with reSpeaker Lite（仕様表・外形）](https://wiki.seeedstudio.com/reSpeaker_usb_v3/)
- [respeaker/reSpeaker_Lite（GitHub）](https://github.com/respeaker/reSpeaker_Lite)
