n416/katanori/docs/_img/sweep/2026-09-18-nylon/README.md

# 入れる道の動画 — 2026-09-18-nylon

`python hardware/tools/sweep_movie.py --save=2026-09-18-nylon` が焼いた物。
読み方と回し方は [SWEEP.md](../../SWEEP.md)。

| 動画 | 道 | 判定 | めり込み |
|---|---|---|---|
| [bat](bat.mp4) | bat | 了承済みの当たりだけ | 厚み 0.700・[15.159, 9.9, 0.5]（済）<br>厚み 0.700・[15.159, 9.9, 5.8]（済） |
| [hub](hub.mp4) | hub | 入る | 無し |
| [rsp](rsp.mp4) | rsp | 入る | 無し |
| [oled](oled.mp4) | oled | 了承済みの当たりだけ | 厚み 0.400・[42.255, 7.0, 27.25]（済）<br>厚み 0.320・[42.255, 7.0, 27.615]（済） |
| [lid](lid.mp4) | lid | 了承済みの当たりだけ | 厚み 0.440・[0.47, 11.435, 20.733]（済）<br>厚み 0.440・[0.47, 13.795, 20.733]（済） |

了承済みの当たりの理由は `hardware/sweep_accept.json`。
