n416/katanori/docs/_img/sweep/2026-09-18-resin/README.md

# 入れる道の動画 — 2026-09-18-resin

`python hardware/tools/sweep_movie.py --save=2026-09-18-resin` が焼いた物。
読み方と回し方は [SWEEP.md](../../SWEEP.md)。

| 動画 | 道 | 判定 | めり込み |
|---|---|---|---|
| [front](front.mp4) | front | 了承済みの当たりだけ | 厚み 1.013・[37.97, 6.9, 45.23]（済）<br>厚み 1.013・[47.13, 6.9, 45.23]（済）<br>厚み 0.119・[1.694, 0.883, 50.454]（済） |
| [hatch](hatch.mp4) | hatch | 入る | 無し |
| [rwall](rwall.mp4) | rwall | 了承済みの当たりだけ | 厚み 0.191・[85.409, 10.798, 32.98]（済）<br>厚み 0.104・[84.264, 48.446, 0.779]（済） |
| [top](top.mp4) | top | 了承済みの当たりだけ | 厚み 0.300・[32.5, 8.185, 41.907]（済）<br>厚み 0.300・[50.0, 8.185, 41.907]（済） |

了承済みの当たりの理由は `hardware/sweep_accept.json`。
