n416/katanori/docs/CONCEPTS-2026-09-13.md

# 並べ替えの提案 3 案（2026-09-13）

ハブ基板・PowerBoost・電流計・OLED 2.42" を外し、残りの v5 の部品（ReSpeaker＋XIAO・電池・充電の Type-C・
つまみ v5・会話ボタン v3・スピーカー v5・トグル・リード）と v6 の 1.54" OLED（HS154L03W2C01）を自由に並べ替えた、
形だけの 3 案である。部品は `hardware/parts/` の実模型をそのまま呼んでいて、寸法はそこから読んでいる。

| 案 | ファイル | 外形（mm） | 一言 |
|---|---|---|---|
| A フレーム | [../hardware/concepts/concept_a_frame.scad](../hardware/concepts/concept_a_frame.scad) | 89 × 30 × 84・12° 後ろへ傾く | 卓上の写真立て。画面の左右にマイクの口が並ぶ |
| B ハンド | [../hardware/concepts/concept_b_hand.scad](../hardware/concepts/concept_b_hand.scad) | 83 × 30 × 89 | 片手で持つ縦型。左に画面・右につまみとボタン |
| C ドラム | [../hardware/concepts/concept_c_drum.scad](../hardware/concepts/concept_c_drum.scad) | φ72 × 89・高さ 58 | 横に寝た筒。天面につまみ、15° 上を向いた顔に画面 |
| D ブック | [../hardware/concepts/concept_d_book.scad](../hardware/concepts/concept_d_book.scad) | 89 × 112 × 19 | 部品を 1 層に並べて寝かせた板。DuPont 無し・薄いつまみ。厚みは ReSpeaker が決める |
| E 文庫本 | [../hardware/concepts/concept_e_bunko.scad](../hardware/concepts/concept_e_bunko.scad) | 木 16（左）＋ 本体 89 ＝ 105 × 148 × 19（A6） | D の本体の左に木のクレードル。充電の Type-C は本体の左の壁、木は USB-C のオスだけ。電源はしおりの磁石とリードスイッチ |

共通の単位（部品と口）は [../hardware/concepts/_cunits.scad](../hardware/concepts/_cunits.scad) にある。
どのファイルも `part` 一本で切り替える（`look` 中身と透けた皮／`guts` 中身だけ／`shell` 皮だけ／`cut` 断面／`pair` 2 単位の重なり）。

```
"C:/Program Files/OpenSCAD (Nightly)/openscad.exe" --backend=manifold -o a.png -D "part=\"look\"" hardware/concepts/concept_a_frame.scad
python hardware/concepts/tools/pairs.py hardware/concepts/concept_a_frame.scad   # 単位どうしの重なりを 1 組ずつ数える
```

---

## A 「フレーム」── 12° 傾いて立つ薄い板

卓上に置いて上から覗く物なので、板を 12° 後ろへ倒して顔を上へ向けた。
足は左右の 2 本だけで、間は空けてある。スピーカーは底面から下向きに鳴らし、机に反射させる。

顔の上段は画面で、その左右にマイクの細い口が 1 つずつ並ぶ。ReSpeaker は画面のすぐ裏に横向きに寝ていて、
マイク面が顔を向いている。マイクは板の両端にあるので、42 幅の画面が中央を隠しても両端の口は塞がらない。
下段は左から会話ボタン・（底面のスピーカー）・つまみで、つまみの台座 39 は横に寝かせて右の壁に寄せた。
トグルは左の側面、充電の Type-C は背面の下、XIAO の USB-C は右の側面、ジャックは左の側面に出る。
電池は ReSpeaker の裏（XIAO の反対側）に立てて隠した。

厚み 30 は ReSpeaker 側の鎖（壁 2 ＋ ガラスの沈み 0.2 ＋ OLED 2.65 ＋ 隙間 1.3 ＋ マイク面の部品 2.6 ＋ 板 1.85 ＋ XIAO 面の DuPont と曲がり 17.5 ＋ 壁 2）で決まっていて、
つまみ側（板 2.5 ＋ 22.4）は 5 余る。

## B 「ハンド」── 片手で持つ縦型

v6 で「幅を狭めないとポータブル端末に見えない」と言われた向きの案。ReSpeaker を縦に立てて左の列に入れ、
その顔に画面を載せる。XIAO の USB-C が上の縁、ジャックが下の縁に出る。マイクは上下の端なので、画面が中央にあっても口は上下に 1 つずつ開く。

右の列は上がつまみ、下が会話ボタン。会話ボタンの真裏（背面）にスピーカーを置いた（バスタブ 15.1 ＋ 10.2 で厚み 30 の中に収まる）。
トグルは右の側面でボタンとつまみの間、充電の Type-C は下の縁の右寄り。電池は ReSpeaker の裏の下半分（XIAO の反対側）に立てた。

幅 83 は「ReSpeaker の幅 34 ＋ つまみの台座 32」に逃げと壁を足した値で、これより狭くするにはつまみの台座を小さくするしかない。

## C 「ドラム」── 横に寝た筒

箱に見えない形を狙った案。φ72 の筒を横に寝かせ、天面（Z 28 の平面・弦の幅 45）に会話ボタン・つまみ・トグルを左から並べる。
顔は 15° 上を向いた平面で、左に画面、右下にスピーカーのハニカム。机に着く底は幅 40 の平面。

ReSpeaker は筒の軸に沿って寝かせ、マイク面を上へ向けた。マイクの口は天面の両端で、中央のつまみの台座（幅 32）は両端の口を隠さない。
XIAO の USB-C は左の端面、ジャックと充電の Type-C は右の端面に出る。電池は底に寝かせ、XIAO 面の DuPont（左端）とは X で分けた。

## D 「ブック」── 部品を 1 層に並べて寝かせた板（🔒 ユーザー 2026-09-13「DuPont は無し・出来る限り平らに・Book タイプ」）

机に寝かせた本の形で、顔の上に部品を重ねずに並べる。上から、ReSpeaker（寝かせてマイク面を上・マイクの口は顔の両端）、
その手前に OLED（左）とつまみ（右）、いちばん手前にスピーカー（左）と会話ボタン（右）。
電池だけは OLED の板の裏（4.15 ＋ 6 で 10）に隠す。トグルと充電の Type-C は手前の縁、XIAO の USB-C は左の縁、ジャックは右の縁。
🔴 2026-09-13 私はここを「USB-C が右・ジャックが左」と逆に書き、穴も逆に開けていた（模型の ReSpeaker は x 0 端＝XIAO が左）。同日直した。

厚みは 19 で、決めているのは ReSpeaker の鎖（壁 2 ＋ マイク面の部品 2.6 ＋ 板 1.85 ＋ XIAO のピンの先 9.9 ＋ 壁 2 ＝ 18.35）。

🔒 2026-09-13 ユーザー「会話ボタンと同じ高さに」「PCB 基板を作るから DuPont も要らないし、バスタブ 2 も不要」:
つまみは v5（深さ 22.4）をやめて `u_knob_flat` にした。v6 の皿（φ28.5・外へ 2.5・スカートが板の穴 φ12.85 の中で回る・皿とハブで板を挟む）に
短い軸と磁石を付け、AS5600 は自作基板に直付けで、基板の裏を会話ボタンのバスタブの底（−15.085）に揃えた。
磁石の下面は IC の上 1.0。つまみの底も会話ボタンの底も顔から 15.085 で、床から 3.9 に並ぶ。
最初は つまみ v5 のせいで 25 だった。⚠ 皿の回り止め・ハブの留め・基板の留めは描いていない（v6 の A1〜A4 を使う前提）。

## E 「文庫本」── D の本体の左に木のクレードルを足して文庫本（A6）に（🔒 ユーザー 2026-09-13）

🔒 ユーザー「USB を両方出させる為に、文庫本サイズの横は別の木製パーツで埋める。充電器も兼ねる」→
「逆。左につけて。メンテナンス用の USB はいつも使う訳ではないから。この木はいわばクレードルなんで、USB 基板は本体側。USB のオスだけがついてる」。

本体の幅は ReSpeaker で決まる 89（左の壁に XIAO の USB-C・右の壁にジャック・D と同じ）で、丈は文庫本の 148。
充電の Type-C 基板は本体の左の壁に寝かせ、口を左の壁に出す（Y 40〜60）。
左に幅 16 の木のクレードルを付けて 105 × 148 にする。木が持つのは充電の口へ挿さる USB-C のオス 1 本だけで、基板は無い。
木を付けている間、XIAO の USB-C（保守用）は木の裏に隠れる。外して使う。

顔の並びは上から: しおりのレーン（Y 129〜148）／会話ボタン（右）とスピーカー（左）（Y 108〜128）／ReSpeaker（Y 71〜105・マイクの口は両端）／
OLED（左）とつまみ（右）（Y 32〜70）／電池（Y 3〜38・OLED の板の裏に 6 潜る）。
🔒 ユーザー「ボタンとスピーカーを上に。バッテリーは下に」「下が重い方が持ちやすいので」。

### 電源はしおり（🔒 ユーザー 2026-09-13）

🔒「トグルスイッチは無くす。リードスイッチに変更。しおり型の磁石が付いた板を外すと ON になるようにする。リードは表面近くにして、後で作るカバーを閉じても電源が切れるように」
「斜めはやめる。Z 軸を中心に時計回りに 10 度くらい」「しおりはもっと押し込む想定。ちょっと出てるくらいのがしおり」「長さは短く。つまり磁石の位置はもっと上」。

トグルは外した。電源はリードスイッチ（KILIGEN・N/O・磁石が近いと閉）で、回路は「閉 ＝ OFF」と読む。
しおりは 20 × 20 × 2.2 の板で、先から 3 の所に φ6 の磁石を平らな面を上にして埋める。皮の裏に平らに寝て、上の縁（Y 148）の口から
上から見て時計回りに 10° 振った向きで 16 刺さり、4 だけ出る。刺し切ると磁石の芯は X 47.3・Y 135.2 で、磁石の上面はリードの芯の 1.8 下（閉じる距離 5 の中）。抜くと開いて ON。
リードは天面の皮のすぐ裏（芯 Z 15.4・上面が皮の裏に着く）に X 向きで寝かせてあるので、後で作るカバーがその真上に磁石を持てば、閉じたときも閉（OFF）になる。

⚠ 板の寸法・出る長さ 4・板の高さ（芯 Z 12.5）・通り道の遊び（片側 1.0・上下 0.2）は私の仮の数字。しおりの抜け止め・口の面取り・リードの足の道（足 14 は曲げて基板へ）は描いていない。
リードの接点は真ん中の一点で端へ行くほど鈍る（parts.scad）ので、磁石はリードの芯の真下に置いてある。

🔴 その前の版は私の読み違い。①本体を 105 に広げただけの版は「XIAO の USB-C を右の縁に出した」と書いたが、届いていたのはジャックで USB-C は 16 内側だった。
②木を右に付けて中に Type-C 基板を入れた版は、木がクレードル（オスだけ）という意図を取り違えていた。③しおりを 20° 下向きに刺す版と 34 押し込む版は、向きと長さを取り違えていた。

⚠ 描いていない物: 木と本体の留め方・クレードルとして本体を受ける形（溝など）・オスの線の出口・オスの殻の寸法は規格の概数。

---

## 検算したこと・していないこと

| | 状態 |
|---|---|
| 単位どうしの重なり（A〜D 8 単位 × 28 組・E は木・オス・リード・しおりを入れて 11 単位 × 55 組） | `pairs.py` で全部「空」。E の tc × plug（189mm³）だけはオスを口に 6.5 挿している分で、意図した重なり。⚠ 皮と単位の当たりは見ていない |
| つまみ・会話ボタン・スピーカーの台座（`knob_station_add/cut` など） | **入れていない**。皮に開けたのは軸の穴・頭の窓・ハニカム・φ6.4 だけ |
| 線の道・線の余り | 置いていない |
| マイクの位置 | ⚠ 板の両端 x 5 と 77・板の高さの中央、と置いた概数。docs/RESPEAKER-LITE.md の U4/U5 の座標で置き直すこと |
| ReSpeaker の厚みの鎖 | 模型の bbox で測った。マイク面の部品の頭は面から 2.6（D1 の 1.185 より高い物がある）・XIAO 面は DuPont と曲がりで 17.5 |
| 1.54" OLED の端子 | 模型に入れていない（板 42.4 × 38 とガラスだけ） |
| A の足の安定 | ⚠ 傾き 12° で重心は足の上に載る計算だが、実物で確かめていない |
| C の天面と顔の平面の位置 | 台座 39 が入る弦の幅から決めた。筒の半径 36 はその結果で、これより細くするなら天面を下げるしかない |
