n416/katanori/docs/WAKEUP.md

# 話しかけ・会話参加のロードマップ

## 目指すもの

**最終目標**: 複数人の会話にそばで混ざれるロボット。

そこへ至る道は2本ある。混ぜて考えると設計を誤る。

| 軸 | 内容 | いま |
|---|---|---|
| A. 呼ばれて応じる（受動） | 話しかけられたら反応する | **ボタンと「カタノリ」の呼びかけで動く** |
| B. 自分から入る（能動） | 会話を聞いて頃合いで入る | 未着手（最終目標） |

**土台は共通**。どちらも「常に聞く → 安く文字にする → 判断する → 必要なときだけGeminiに繋ぐ」
の二段構えで動く。Aで作るものはBでそのまま効くので、順にやれば無駄がない。

## 決まっていること

1. **レベル0（ボタン）を仮OKとする。** 確実に動く。ここで止まっても製品として成立する
2. 🔒 **呼び名は「カタノリ」で固定し、機体の中で聞き分ける（2026-09-21・ユーザー決定）。**
   呼び名を自由にする要件は取り下げた。スマートスピーカーがこの 10 年で固定の呼び名に
   落ち着いたのが最適解だという判断。自由な呼び名を声で確実に聞き分けるには、
   言葉の分かる大きなモデルをクラウドで回し続けるしかない（whisper での失敗は[却下したもの](#却下したもの)）
3. **入力は1つに絞らない。** 確信度の違う入力を足し合わせる（下表）
4. **迷ったら聞き返す。** 「私ですか？」と返せるので、各入力は完璧でなくてよい

### 確信度と反応

| 確信度 | 例 | 反応 |
|---|---|---|
| 確実 | ボタン、遠隔ベル、叩く | すぐ会話を始める |
| 強い | 声 ＋ 目線 | 短く返事をして始める |
| 弱い | 声だけ | 「私ですか？」と聞き返す |
| なし | 周囲の会話、テレビ | 黙る |

## 次の一手（1つだけ）

🔒 **呼び名の聞き分けは `katanori_own_a` で完成（2026-09-24・ユーザー「今のこのモデルは完成です」）。**
実機で、映画を 2 時間見て誤爆 0 回、眠り（待機スリープ）から呼んで起きた（ユーザー）。
中身は[呼び名で起こす](#呼び名で起こす)。次は下の「そのあとの順番」から選ぶ。

### 音素の網（別のプロジェクトで研究開発を続ける）

🔒 音素の網（ReazonSpeech で学習した CTC ＋「k a t a n o r i」の並びの照合。2026-09-23 決定）は、
このリポジトリの外の別のプロジェクト `C:/Users/shingo/phoneme-wake` で研究開発を続ける（2026-09-24・ユーザー）。
🔒 **ただし、恐らくこの MPU（XIAO ESP32-S3）には載らない（2026-09-24・ユーザーの見立て）。**

2026-09-23 時点の到達点（詳しい表は phoneme-wake の README）:

| 見たもの | 結果 |
|---|---|
| 本人の PC 録音 28 本で「カタノリ」の確からしさ 0.5 以上 | 一番良い版（mel3・log-mel・75 万パラメータ・130 時間）で **10 本**。網を大きくしても（480 万）・増強しても・書き起こしを選別しても 10 本から動かない |
| 機体の音（`cap_first.wav`・ch1 16 倍） | どの版も 2 回目で 0.20〜0.25 止まり（当たりは 0.5〜0.7）。頭の k・t が毎回消える |
| 誤爆 | 本人の会話 4.9 分で最大 0.16。しきい値 0.3 で 0 回 |
| 特徴量 | 機体の frontend（22 段階）では実声が上がらず、log-mel にして 3 倍。機体に載せるなら log-mel を自前で計算する |
| 残る手 | 放送の音をスピーカーから鳴らし、機体の ch1 で録り直して学習に混ぜる（別荘で機体が要る） |

## そのあとの順番

上ほど安く効果が大きい。

| 順 | やること | なぜこの順か |
|---|---|---|
| 1 | **叩いて起こす** | ハード追加ゼロ。マイクで拾える。肩を叩く動作は自然で他人には起こせない |
| 2 | **遠隔無音ベル（BLE）** | 声を出せない場面で使える。離れた家族からの呼び出しにもなり、仕様書4章のプッシュに直結 |
| 3 | **呼び名で起こす（機体の中）** | ✅ 2026-09-22 に動いた（microWakeWord）→ 2026-09-24 own_a で完成（上） |
| 4 | **目線で確認（カメラ）** | 誤起動をほぼ消せるが、ハード追加とESP-IDF移行が要る。買う前に[写真で確認](#目線カメラ)する |
| 5 | **アクティブモード** | 最終目標。1〜4の土台が要る |

## 各項目のメモ

### 叩いて起こす

叩いた音は声と形がまったく違う。**極端に短い（数十ms）／極端に大きい／低音寄り**。
低域比の計算はVAD計測モードに実装済みなので、判定を足すだけ。
2回叩き（コンコン）を条件にすれば、物がぶつかった誤検知も落とせる。

### 遠隔無音ベル

声を出さずに呼べることに、他にない価値がある（夜間・人前・声が出しづらいとき）。
離れた家族から呼ぶ使い方もでき、DOから機体へ落とす経路は既存のWebSocketがそのまま使える。

### 呼び名で起こす

「カタノリ」を microWakeWord で学習し、ReSpeaker の ch1 を機体の中で聞き続ける
（`firmware/esp32/src/MicroWake.h`・`WakeModel.h`）。クラウドへは呼ばれたと決まってから繋ぐ。
学習の材料と手順は別のリポジトリ `n416/wakeword-maker` にある。

🔒 **モデルの方向を変えた（2026-09-23・ユーザー決定）: 本人の声を徹底的に覚えさせる。近い声の人に反応するのは許容し、誤爆も起きる前提。**
09-22 の「本人の声は正例にも負例にも入れない」は取り下げ。合成音だけで大勢の声に効かせる道は
限界が見えてきたという判断。根拠は機体が拾った音（wakeword-maker `device/cap_first.wav`・呼びかけ 4 回・16 倍）で、
合成音だけの版はどれも 1/4 以下、実録 17 個を学習に入れた `katanori_withreal` が 3/4（2〜4 回目が 1.000）、
実録 28 個・重み 8 の `katanori_real8` が 2/4。09-23 は withreal を起動時に使ったが、
テレビあり・鼻声で取りこぼしは無かった一方、1 時間で誤爆 27 回だった。

**2026-09-24: 正例をご本人の声だけにして作り直した `katanori_own_a`（wakeword-maker `c30b39b`）を機体の唯一のモデルにした。**
🔒 ユーザー「own_a は今までのモデルの発展形ではないので、他 3 つは不要」。withreal・real8・tv_loud は
`WakeModel.h` から外した（katanori `3897cc8`）。

| 実機で確かめたこと | 結果 |
|---|---|
| 映画を 2 時間（ユーザー） | **誤爆 0 回**（withreal は 1 時間で 27 回） |
| 眠り（待機スリープ）から呼ぶ（ユーザー） | 起きた |
| withreal が誤爆した YouTube（c5SiAR7eNow）の、越えた場所 18 か所を順に鳴らす | 0 回。3 周とも越えた 2 か所（10:10.7・13:20.1）も越えない |

比べたいモデルができたら `WakeModel.h` の `kWakeModels` に足し、シリアルの `wakemodel <番号>` で切り替える
（起動時は先頭。切り替えは保存しない）。

| 決めたもの | 値 | 根拠 |
|---|---|---|
| 聞き分けに渡す音 | **ch1 を 16 倍** | ch1 は XMOS v1.1.0 で AEC だけを通した口。そのままでは小さい。上げても取りこぼしは直らない（[付録F](#付録f-2026-09-23-の測定取りこぼしの原因を機体で潰した)で 256 倍まで測った） |
| しきい値 | **0.7**（直近 5 回の平均） | microWakeWord の既定の数え方。越えた瞬間の値は余裕ではない（最大は起きたあと 0.6 秒追ってログに出す） |
| 会話の頭を遡る長さ | **2 秒** | 判定は言い終えてから少し遅れて出る。1.5 秒では頭の「カ」が欠けた |
| 声の手前に残す長さ | **0.3 秒** | 「カ」の k はゲートを越えない。0.16 秒でも 3 回に 1 回「たのり」になった |
| 合図の音を鳴らす時 | **0.6 秒静かになったら**（最長 8 秒） | 🔒 ユーザー 2026-09-22「ウェイクと続きを受け取ってからに」。呼ばれた直後に鳴らすと「カタノリ、今日の天気は？」の続きが消えた |
| マイクの読み方 | **専用タスクで読み、PSRAM に 5 秒ためる** | Gemini への接続の間 loop が止まり、続きの言葉が消えていた |

VAD で区間を切ってクラウドの whisper に送る方式は 2026-09-21 に作って捨て、
部品は 2026-09-22 に消した（[付録E](#付録e-2026-09-21-の実装呼びかけで会話が始まるところまで)）。

### 目線（カメラ）

🔴 **「目線」は取れない。取れるのは顔の向きだけ（2026-08-14・ユーザーが PC 上で実験済み）。**
**視線そのものは全然取れず、取れても顔の方向だった。** この項目を「目線で確認」として
計画するのは、実測に反する。**以後は「顔の向きで確認」として扱う。**

視線を扱う技術には段階があり、この機体で届くのは 1 までである。

| 段階 | 何が分かるか | この機体で |
|---|---|---|
| 1 | **顔がこちらを向いているか** | ✅ **ここまで**（実験で取れたのはこれ） |
| 2 | 目が合っているか | ⚠ 目の領域が数十ピクセル要る |
| 3 | 視線の方向を角度で出す | ❌ 実験で取れなかった |
| 4 | 角膜反射と瞳孔から確定する | ❌ **原理的に無理。** IR照明・近距離・個人ごとの較正が要る据置き/眼鏡型の技術 |

⚠ **本当の壁は解像度ではなく角度である。** 肩の位置は顔の下から見上げるので、
まぶたと頬骨で目が隠れる。**画素を増やしても、下から見上げている限り改善しない。**

カメラを回し続けるのはウェアラブルでは電力的に厳しい。**音で起こして、その瞬間だけ見る**。
声が聞こえた瞬間に数百msだけカメラを見て、こちらを向いていれば反応する。
カメラは1日数分しか動かず、クラウドへ送る前に判断できる。

**買う前にやること**: ロボットを載せる位置にスマホを置き、(1)正面を向いたとき
(2)ロボットを見たとき の2枚を撮る。そもそも顔が写るか、2枚が明らかに違うかを見る。
ここで駄目ならカメラを買っても解決しない。
⭐ **切り離す前提（下）なら、この実験は「置く場所を決める実験」になる。**
肩の高さと胸元の2箇所で撮り比べれば、どこに置けば通るかが分かる。

#### カメラは無線で切り離す（2026-08-14・ユーザー提案）

**カメラを本体に配線せず、別ユニットにして無線で繋ぐ。** 高画質である必要はない。

| 効くところ | 中身 |
|---|---|
| **MCU の条件が緩む** | カメラは「逃がせないもの」の筆頭で、アプリ側 MCU を30本級・DVPペリフェラル必須に縛っていた**唯一の理由**だった。外に出すと要件は 11〜17本まで落ちる（[ARCHITECTURE.md](ARCHITECTURE.md)） |
| **置く場所を選べる** | 上の「角度」の問題が、解像度ではなく**配置**で解ける問題に変わる |
| **画像を送らなくてよい** | 欲しいのは「向いているか」の真偽だけ。**カメラ側で判定して結果だけ送れば帯域の問題は消える。** 画像が機体の外に出ないので、[仕様書](../仕様書.md)の「カメラ監視のプライバシーリスクを排除」ともまっすぐ合う |
| **ESP-IDF 移行を閉じ込められる** | 移行が要るとしてもカメラ側の1台だけで済み、本体のファームは触らない |

#### カメラは機体から少し離れた所に置く（2026-08-14・ユーザー）

**肩には置かない。** 上の角度の問題は、肩に置いている限り解像度では解けないため。

これで性質が3つ変わる。

| | |
|---|---|
| ✅ **充電するものは増えない** | 据え置きなら常時給電にできる。当初の懸念（高齢者に「今日はどちらを充電したか」を増やす）が消える |
| ⚠ **その部屋にいるときだけ効く機能になる** | 外出時は使えない。BLE の届く範囲は見通しで10m程度で、同じ部屋なら足りるが家中はカバーしない |
| 🔴 **受け取られ方が変わる** | **肩のカメラより、部屋に置かれたカメラのほうが「見張られている」と感じられやすい。** 画像を外に出さない作りであっても、置いた瞬間の印象は別物である。[仕様書](../仕様書.md)が「カメラ監視のプライバシーリスクを排除」を掲げている以上、**説明の仕方まで含めて設計に入る** |

障害: 肩のカメラは周りが身構える。
XIAO ESP32S3 の Sense 版が同じ形でカメラ付きだが、ESP-IDF 移行が要る可能性が高い。

### アクティブモード（軸B）

複数人の会話に自分から入る。アプリ側にすでに「AIの好奇心」「プロアクティブトーク」が
あるので、**何を喋るかの判断はそちらの資産を持ってこられる**。ロボット側で新しく要るのは
「聞き続ける」「誰が喋ったか」「いつ入るか」の3つ。

難しいのは判定ではなく**間の取り方**。何を喋るかより、いつ黙るか。
少しでも入りすぎた瞬間に鬱陶しくなる。先に決めておくこと:

- 明示的にONにするモードにする（常時聞く状態を既定にしない。同席者の同意の問題）
- 黙ることを既定にする（迷ったら入らない）
- 入った回数を数えて自制する

未検討: 話者分離をマイク1本でどこまでできるか。入るタイミングをどこで判断するか。

## 却下したもの

同じ議論を繰り返さないために残す。

| 案 | 却下の理由 |
|---|---|
| whisper で自由な呼び名を判定（クラウド） | 2026-09-21 に実装して捨てた。**咳で毎回起きる**（ユーザー「せきをすると１００％反応」）。`initial_prompt` に呼び名を入れると咳を「カタノリ」と書き起こし、外すと短い呼びかけを「ご視聴ありがとうございました」と書き起こす。`no_speech_prob` は咳でも 0 で当てにならない。whisper は長い文の書き起こし用で、1 語の聞き分けには向かない |
| Picovoice Porcupine | 対応が Arm Cortex-M4 のみ。ESP32-S3(Xtensa)では動かない |
| ブラウザの音声認識モデルを載せる | 実体は数百MBのネイティブ部品かクラウド。ESP32とは桁が2〜3つ違う |
| 音源方向（DOA）で判定 | 4マイクの上位機の機能。Lite(2マイク)では取り出せず、I2Sから来るのは処理済み音声 |
| 発話の長さで呼びかけを判定 | 実測で逆に出た（[付録C](#付録c-実測で分かったこと)） |
| 低域比（近接効果）で装着者を切り分け | 2026-09-21 の実測で分離しなかった。**そもそも要らない**（[付録D](#付録d-2026-09-21-の実測距離で分けられる)） |
| 加速度センサーで体の振動を拾う | **置いても使う**ので体に触れていない場面がある。AirPods 方式はこの機体では成立しない（2026-09-21・ユーザー指摘） |

---

## 付録A: 費用

クラウドで文字にする方式でも、費用は判断材料にならない。

- Cloudflare Workers AI `whisper-large-v3-turbo`: **音声1分 $0.00051**
- 無料枠: **1日10,000ニューロン ≒ 音声3.5時間ぶん**

装着者が喋った分だけ送るなら1日数分〜数十分。無料枠に収まる見込み。
会話を聞き続けるアクティブモードでも3.5時間/日までは無料。
判断がCloudflare内で完結するので、呼ばれたと分かるまでGoogleへは何も送らない。

## 付録B: 計測のやり方

`firmware/esp32/` を書き込み（`pio run -t upload`）、シリアルで操作する。
音声はどこにも送らない。

| 入力 | 内容 |
|---|---|
| `vad` | 計測の開始/終了。最初の2秒は静かにする（騒音床の測定） |
| `me` | 以降の声を【自分】/【周囲】で切り替える（正解ラベル） |
| `vadme` | 自分の声を4秒測ってゲートを自動設定 |
| `vadth <RMS>` | ゲートを直接指定（0で自動） |

`me` で自分と周囲を交互に切り替えながら数回ずつ喋る。1分ごとに判定が出る。

```
[VAD] 区間 0.56秒  音量RMS=2547 (床の15.6倍)  低域比=0.71  [自分]  → 送る
[VAD] 正解ラベル 自分8回(最小RMS=2100) / 周囲6回(最大RMS=1500) → 音量で分離できています
[VAD] 低域比の平均 自分=0.71 / 周囲=0.48 → 近接効果が出ています
```

計測中はBOOTボタンもラベル用になり、会話・設定モードは動かない。

## 付録C: 実測で分かったこと

2026-07-26、肩乗り・隣に家族がいる状態での実測。

- **絶対音量は当てにならない。倍率で見る。** 騒音床が38〜469と12倍動いた
  （ReSpeaker側の自動音量調整）。倍率は安定していて、装着者が床の15〜58倍、
  隣にいる家族が4〜10倍
- **長さでは分けられない。** 装着者の5秒の発話と家族の0.2秒の相槌が、
  長さの判定では逆に出る
- **騒音床は追従させる。** 1回だけ測る実装では、部屋が騒がしくなった時点で
  「発話中」のまま固まり2分間無反応になった
- **低域比は未検証。** XMOSのノイズ抑制で低域が削られていると使えない

## 付録D: 2026-09-21 の実測（距離で分けられる）

同じ人が同じ調子で、距離だけ変えて喋った。エアコン・PC のファン・換気扇は鳴ったまま。

| 距離 | 何にあたるか | 区間 | RMS | 低域比 | ゲート |
|---|---|---|---|---|---|
| 40cm | 肩に載せたときの本人 | 1.93〜2.04秒 ×3 | 10455〜16859 | 0.46〜0.59 | 全部 送る |
| **1m** | **置いて使うときの本人** | 0.80〜2.32秒 ×4 | 1880〜2632 | 0.25〜0.40 | **4/4 送る** |
| **3m** | **隣の人** | 0.11〜1.00秒 ×20 | 405〜2594 | 0.10〜1.00 | **19/20 落とす** |

**結論: 低域比は使えないが、要らない。** 距離が 1m と 3m なら、検出線（騒音床×3）と
ゲートだけで分かれる。低域比は 1m が 0.25〜0.40、3m が 0.10〜1.00 で重なる。

- 🔴 **誤って通ったのは 20 区間中 1 つ**（0.36秒・RMS 2594・低域比1.00）。**最短区間 0.5 秒の
  条件を足せば落ちる**（1m 側の最短は 0.80秒なので、本人は削られない）
- ⚠ **低域比は 1 秒未満の区間では当てにならない。** 0.11〜0.36秒の区間で 0.10〜1.00 まで散る。
  使う場面があっても 1 秒以上に限ること
- ⚠ **騒音床は 2 秒の初回測定では実勢に届かない。** 1 回目は床 RMS=83 と出たが実勢は 150〜700 で、
  検出線 207 を下回れず「発話中」のまま 10 秒の上限で切られ続けた（区間が成立しない）。
  ReSpeaker の自動音量調整が時間差で動くため。測り直すと床 209 で乗った
- ⚠ **距離で落ちる量は逆二乗より急。** 40cm → 1m（距離2.5倍）で RMS が 12〜25分の1
  （逆二乗なら 6分の1）。ReSpeaker が遠い音を落としているぶん、狙いには有利に働く
- 📄 参考（距離を測っていないので判定には使わない）: PC スピーカーのアニメは RMS 712〜11297。
  大きい場面は 40cm の本人（最小 10455）と音量で重なる

## 付録E: 2026-09-21 の実装（呼びかけで会話が始まるところまで）

⚠ **この方式は同じ日に捨て、`POST /wake` と送る部品は 2026-09-22 に消した**（[却下したもの](#却下したもの)）。
同じ道を通らないための記録として残す。今の数字は[呼び名で起こす](#呼び名で起こす)にある。

機体が VAD で切った区間だけを `POST /wake` へ送り、バックエンドで
`whisper-large-v3-turbo` にかけて呼び名の有無を返す。入っていれば会話を始める。

| 測ったもの | 値 |
|---|---|
| 呼びかけの判定（送信〜返事） | **2.7〜6.6秒** |
| サーバー接続（setupComplete まで） | 1.6〜1.8秒 |
| 呼んでから会話が始まるまで | **4.3〜8.4秒** |
| 送るぶんの費用の目安 | 月 40〜425円（機体の表示。無料枠 3.5時間/日の内） |

🔴 **待たせる間に黙っていてはいけない。** 判定に数秒かかるので、何も返さないと
届いていないと思って呼び直される。実機で4回呼ばれ、その全部が控えから送られて
Gemini が別々の発話として扱い、応答が割り込みで捨てられ続けた
（ユーザー「応答がないからだよ。そりゃ呼ぶわ」）。**顔（目）と音で即座に返す。**
音は木を2回叩いた音（`firmware/esp32/tools/gen_wake_chime.py`）。
⚠ 顔だけでは足りない。機体を見ていない場面がある。口は音に反応して出るだけなので、
黙っている間に変わるのは目（16→19px）だけである。

### 数字で決めたこと

| 決めたもの | 値 | 根拠 |
|---|---|---|
| 最短の区間 | **0.3秒** | 呼び名だけを言うと 0.36秒 にしかならない。0.5秒 にしたら呼びかけ自体が落ちた |
| 控えに遡る長さ | **1.5秒** | 「カタノリ、〜」と間が空くと呼び名が手前の区間に落ちる。呼び名 0.7秒＋区切りの無音 0.5秒 |
| 控えの無音を詰める | **0.2秒 まで** | 一括で送ると Gemini が無音の長さを実時間として扱わず、0.44秒 の間で発話を切る |
| 1回に送る長さ | **最大4秒** | 呼び名は文頭近くに来る。送った量が費用になる |
| 会話後に見張るまで | **1.5秒** | 鳴り終わった直後はロボットの声が残る |

### 踏んだ穴（同じ道を通らないために）

- 🔴 **`isRecording()` を「会話中か」の代理に使ってはいけない。** マイクの用途が
  3つ（見張り・計測・会話）に増えたので、判定する場所ごとに条件を足して回る形になり、
  同じ原因のバグが4件出た（見張り開始→即「60秒無音」で会話終了→再開の無限ループ／
  会話ボタンが「終了」に倒れる／計測モードに入れない／呼ばれた直後に閉じる）。
  **マイクの用途を1つの状態として持つ**リファクタリングが要る（未了）
- **騒音床は「静かなとき」だけ追従させると固まる。** 起動直後の2秒で測った値が
  実勢とずれると（実機で床 2〜5 に対して環境音 100〜300）、検出線を割る瞬間が
  来ないので追従が一度も掛からない。直近5秒の底を見て、発話中でも寄せ直す
- **打ち切り時の測り直しは `vadCloseSegment()` の前に値を控える。** あの関数が
  `vadSegMinRms` を 0 に戻すので、後から読むと必ず 0 になり床が据え置かれていた
- **控えを流し込むまでライブ送信を始めない。** 繋がった瞬間から送ると、直後の
  `drainToNetLink()` が同じところをもう一度送って二重になる

## 付録F: 2026-09-23 の測定（取りこぼしの原因を機体で潰した）

呼んでも起きない回がある。原因の候補を実機で 1 つずつ測った。測り方は、同じ音声ファイルを
PC のスピーカーから流し、機体が聞いた ch1 を `wakedump` で吐かせて数える形。声の大きさは
[QUIET] と [VAD] の行で追った。

⚠ この測り方で分かるのは「機体の中の音の通り道」までで、**呼びかけの取りこぼしそのものは再現できない**。
スピーカーから鳴らした録音は、元の声とは別物になる（実際、本人の録音を鳴らしても越えない本が多い）。
下の表のうち、通り道の性質（AGC・床の上がり方）は再生音で測ってよいが、**モデルの当たり外れは
再生音では測れない**。

### 外れた候補

| 候補 | 測ったこと | 結果 |
|---|---|---|
| ch1 に AGC が掛かっている | 取り出し口を 1・0・4 に変えて同じ音を 4 回ずつ | 1（AEC だけ）では声 222〜237 でばらつき 0.6dB。4（AGC あり）では声 4076〜9313（7.2dB）・床 831〜4439（5.3 倍）。**ch1 に AGC は掛かっていない** |
| ch1 の 16 倍が足りない | **スピーカーから鳴らした録音**の 6 回に 16・32・64・128・256 倍を当てる | どの倍率でも 1 度も越えない。振り切れ 0。⚠ 測ったのは「そもそも越えない再生音」に対してだけ。**生の声で取りこぼす回に倍率が効くかは未測定**。理屈の上では声も床も同じだけ上がるので差は変わらないが、それは測定ではない |
| 機体が喋った直後だから | `say` で喋らせ、その 0.3 秒後に同じ声を鳴らす（5 回） | 声は 425〜452 で変わらない。変わるのは床で、45〜60 → 111〜147。**声と床の差が 19dB → 10dB に縮む** |

### 残った見立て

同じスピーカー・同じ音量・同じ部屋・ピーク -3dBFS にそろえた 11 本の「カタノリ」を流すと、
越えたのは 3 本だけだった（本人の録音 6 本のうち 2 本、合成 5 本のうち 1 本）。条件をすべて
そろえても結果が分かれるので、**この再生音の中で越える・越えないを決めているのは声そのもの**。

生の声では 5 回中 3 回だった。こちらが本題の取りこぼしで、モデルが認める範囲が狭い、というのが
残った見立て。ただし机の上の再生と生の声は別物で、再生が越えないこと自体は取りこぼしの再現ではない
（スピーカーと部屋を通った音は元の声と違う）。**両者を同じ現象として扱わないこと。**

### この机の物差しは使えない

同じ 6 本を tv_loud と conf2 で流すと、tv_loud が 1 本・conf2 が 2 本で、conf2 の方が良く出た。
別荘の実機テストでは逆（tv_loud テレビなし 4/5、conf2 テレビなし 0/5）。**順位が合わないので、
スピーカーで鳴らした録音による机上の測定はモデルの選定に使えない。** 別荘側でも、手元の測定
（取り出した音・厳しい条件・声の変化）が実機の結果を予測できなかったと報告されている。
モデルの良し悪しは、今のところ実機で生の声を使う以外に測る手段がない。

### 足した道具（シリアル）

| 命令 | 何をするか |
|---|---|
| `wakedump <何秒前から> <秒数>` | 聞き分けに渡している ch1 を、専用の 30 秒の控えから 16 進で吐く。**控えに入っているのは `wakegain` を掛けた後の音**（既定 16 倍済み）。PC で測るときにさらに 16 倍しないこと（wakeword-maker の TRAIN.md 21 節・2026-09-24） |
| `tools/wakecap.py <出力.wav> <秒数>` | PC 側。倍率を 1 にしてから指定の秒数だけ待ち（この間に呼ぶ）、その区間を `wakedump` で取り出して WAV にし、倍率を元に戻す。16 倍する前の ch1 が取れる（ワラビモチの物差しを 2026-09-24 にこれで録った） |
| `wakegain <倍率>` | ch1 の倍率を変える（既定 16）。振り切れた数も出す |
| `wakedry on/off` | 越えても会話へ進まない。記録だけ残して見張りへ戻る（再起動で切） |
| `wakeword on/off` | 入切を指定する。引数なしなら今の状態を出す（切り替えない） |
| `say` | 焼いてある声を 1 つ鳴らす（喋った直後を測るため） |
| `tap1 <値>` | ch1 の取り出し口を書く（ch0 は `tap`） |

`wakeword` は以前は入切を入れ替えるだけで、今どちらかを読めなかった。切のまま試験して
「どの倍率でも起きない」という無効な結果を出したので、読める形にした。

### 起動時のモデルを tv_loud に戻した

`WakeModel.h` の先頭が conf2 になっていて、起動時に一番悪い版が動いていた。tv_loud を先頭に戻した。
（09-23 時点の話。今は own_a 1 本だけ。）

### 測るときの注意

- 再生を見つける判定を「1 回大きい音」にすると、部屋の物音で誤って始まる。5 秒間隔で 2 回続いたときだけ始める
- `wakedump` の吐き出しは頭が数秒欠けることがある。届いた行だけで測る（無音として埋めない）
- 🔴 人に聞かせる音は、中身を確かめてから渡すこと。`wakeword-maker/check/katanori_*.wav` は
  長さの指定を落として生成した壊れた見本で、呼び名と関係ない発話が入っていた（学習には未使用・別荘で削除済み）。
  中身を聞かずに試験音へ混ぜて、本人の家族の前で鳴らした
