n416/katanori/docs/CASE-V6-PLAN.md

# 筐体 v6 — 縦置き（2026-09-13）

> ⛔ **凍結（2026-09-14）。v6 縦置き案の資料。現行の筐体 v6.1（[CASE-V61N.md](CASE-V61N.md)・`hardware/case_v6_1.scad`）は v5 から派生した別の作りで、ここに書いた方針（丸み無し・48 × 88 × 23 など）は v6.1 には当てはまらない。**

🔴 **2026-09-12 に書いた「基板を立てる案・88 × 74 × 40」は捨てた。**この文書はその日のうちに全面的に
置き換わっている。v5 のファイル（`hardware/case_v5.scad` ほか）は触らない。

形の正は [../hardware/frozen/v6/_v6_portrait.scad](../hardware/frozen/v6/_v6_portrait.scad) 一本。数字はそこから写している。
部品の寸法は [DIMENSIONS.md](DIMENSIONS.md)、ReSpeaker は [RESPEAKER-LITE.md](RESPEAKER-LITE.md)、
電源と基板は [POWER.md](POWER.md) が持つ。

きっかけはユーザーの参考画像（縦長の携帯機・画面が上・下に円いつまみ・側面にボタン）で、
方針は「**ポータブル端末に見える形**」である。

---

## 1. 外形

| | |
|---|---|
| 胴 | **48 × 88 × 23 ＝ 97cm³** |
| スピーカーのポッド | 左（−X）へ 8.2 出る ⇒ 総幅 **56.2** |
| 肉 | 壁 2.0・背面の蓋は Z 10 で合わせる |
| 角と稜 | **丸み無し**（🔒 ユーザー「筐体の丸みを無くしましょう」） |

幅 48 の下限は **OLED の 42.40**。ガラス 40.04 の左右の余白が 4.0 ずつ、縦横比 1:1.83 で参考画像
（1:1.82）とほぼ同じになる。🔒 一度 58 で引いたらユーザーに「幅を狭めないとポータブル端末に見えない」
と却下されている。**広げる方向はこの一言で塞がっている。**

丈 88 の下限は**両端の口**。XIAO の USB-C 1.53 ＋ ReSpeaker 82.024 ＋ 3.5mm ジャックの筒 1.576 ＝ 85.13 で、
88 なら余り 2.87 を上下に分けて、どちらの口も外面から 1.435 奥で止まる。

厚み 23 は下の 3 節の鎖で決まっている。

## 2. 顔（正面）と縁

**正面**

| | 座標 |
|---|---|
| 画面の窓 | X 4.98〜43.03・Y 50.13〜70.65（**38.05 × 20.52**。光る所 35.05 × 17.52 に縁 1.5） |
| つまみの皿 | φ**28.5**・芯 **Y 30.04**・厚み 2.5・面から 2.5 出る（裏は 23.05）・真ん中の抜き φ11 |
| 軸の穴と止めの溝 | 穴 φ**12.85**／溝 r9.6・幅 2.2・深さ 1.0・島 28 度・抜き穴 φ1.5（−90 度）。**どちらも皿の下で見えない** |
| マイクのグリル | 縦 1.6 × 3.0 のスリット **7 本**（ピッチ 3.4・X 13.8〜34.2）を **Y 8.45 と 79.45** の 2 段 |

🔒 **窓はガラスではなく光る所に合わせる。**ガラス 27.22 のうち光るのは 17.52 で、残り 9.70（上 2.76・
下 6.94）は部品の余白。そこまで開けると黒い帯が顔に出るので、殻の裏へ入れる。

🔒 **OLED は Z 軸まわりに 180° 回してある**（`OLED_FLIP`）。端子が上の縁に来て、光る所がガラスの中で
上へ 4.18 寄る。

🔒 **マイクの穴は面の中心に合わせたスリットにする。**マイクの芯は X 19 で面の中心 24 から 5 左だが、
7 本のグリルが X 13.8〜34.2 に左右対称で並ぶので、ズレが外から見えない。

**上の縁**（左から）

| | X | Z |
|---|---|---|
| 3.5mm ジャック φ7 | 5.00〜12.00 | 芯 14.515 |
| J2 のプラグの柱（**穴なし**・内側の立入禁止） | 15.04〜22.99 | — |
| スライドスイッチのスリット | 26.35〜30.65 | 4.3 × 2.0・芯 Z **7.65**。レバー（1.5 角）が板の上端から 3.0 張り出し、外面の 0.8 奥で止まる |
| 充電の USB-C | 35.03〜43.97 | 芯 6.18 |

**下の縁**: XIAO の USB-C（X 14.28〜23.72・Z 12.14〜15.80）だけ。**充電は上・データは下。**

**左の縁**: スピーカー（v5 一式・−20°・ポッド）と会話ボタン。**右の縁**: 何も無い。

## 3. 中身の Z の鎖（厚み 23 の内訳）

| | Z |
|---|---|
| 背面の壁 | 0 〜 2.0 |
| 逃げ（⚠ 私が置いた数。板の裏のはんだは 0.8〜1.5 出るので**足りていない可能性がある**） | 2.0 〜 3.0 |
| **中継基板** | 3.0 〜 4.6 |
| 板の部品 | 4.6 〜 8.6 |
| **電池**（⬜ 寸法は探索中。天面は U3 の底 14.75 で止まる） | 8.6 〜 14.6 |
| 逃げ（ReSpeaker の XIAO 面のはみ出し 1.69） | 14.6 〜 17.0 |
| **ReSpeaker**（マイク面が前） | 17.0 〜 18.85 |
| 🔒 **OLED との隙間 `OL_RS_GAP` 1.30** | 18.85 〜 20.15 |
| **OLED の板 1.00** | 20.15 〜 21.15 |
| 歯車 3 枚（幅 1.4） | 19.40 〜 20.80 |
| **OLED のガラスの積み 1.65** | 21.15 〜 22.80 |
| 顔の肉（`SCR_IN` 0.2） | 22.80 〜 23.0 |

🔴 **`OL_RS_GAP` は 0.3 だった。**ReSpeaker のマイク面から **1.185 出ている D1** を誰も数えておらず、
OLED の板が **0.89 食い込んで**いた（OLED × ReSpeaker ＝ 2.51mm³・**この 2 つを当てた検査が無かった**）。
⇒ 1.30 に広げ、同じだけ `SCR_IN` を 1.2 → **0.2** にして OLED を前へ出した。
⚠ **この 2 つは対。**片方だけ動かすと中継基板が背面の床（Z 2.0）を割る。
⚠ 背面から 1.0 出す案は、**板の裏へはんだが 30 点 0.3〜1.5 出る**ので不可（回路担当）。
⇒ **顔のガラスは面から 1.2 奥 → 0.2 奥（ほぼ面一）になる。**🔒 ユーザーへ報告済み。

⭐ **ここで動かせない数は 12.4 である。**中継基板の表面から ReSpeaker の XIAO 面までの距離で、
XIAO のピンを板のメスソケットへ直挿しにした時点で確定した（はんだ 0.2 ＋ XIAO の板 1.2 ＋ 樹脂 2.5 ＝ 3.9 の
所からピンが 6.0 出る。メスの胴 8.5 の天面が樹脂の頭に当たって止まる ⇒ 3.9 ＋ 8.5 ＝ 12.4）。
厚みを増やしてもこの帯は広がらないので、**厚みで解ける問題と解けない問題がある。**

## 4. 板への条件 — 天井の地図

板の座標（左下＝箱の X 2・Y 3 を原点）。**「板の部品は 4.0 まで」は板全面の規則ではない。**

| Y の範囲 | 背の高い物を置ける幅 | 天井（板の面から） |
|---|---|---|
| **Y 0〜25** | **44 全部**（谷 X 10.67〜23.36 だけ 9.0 ＝ XIAO の胴が居る） | 12.4〜14.2 |
| Y 25〜75（電池の影） | X 35〜44 の **9.0** だけ。影の中は **4.4** | 4.4 ／ 帯は 14.2 |
| Y 75〜81.2 | 44 全部（切り欠きを除く） | 12.4〜17.2 |

🔒 **立入禁止**: 板の X 33.2〜39.2・Y 4〜10（磁石と軸 φ4 に逃げ 1.0。板の面から 14.05 全高）。
　歯車 3 枚でここへ移った。電池の影（Y 25〜75）の外なので、電池への 0.8 の食い込みは消えた。

## 5. 中継基板へ渡した条件

| | 板の座標 |
|---|---|
| 外形 | **44 × 81.2**（切り欠き後 3,491mm²）。旧 2 枚の合計 5,128mm² の 68% |
| 切り欠き | X 12〜22・Y 73 から上端（J2 のプラグの柱が板を 2.6 貫くため） |
| 取付穴 | X 3.5 と 40.5・Y 3.5 と 69.5（**37 × 66**・M2 φ2.2） |
| XIAO の口 | Y 2.90〜18.14・列 X 9.40 と 24.63（縦のメスソケット 1×7 ×2・直挿し） |
| AS5600 のチップ | 🔒 X 36.2・Y 7。真上に φ6 の空き |
| 充電の USB-C | X 37.5・上の縁から 3.0 出る |
| スライドスイッチ | X 21.95〜31.05・**胴のレバー側の面を Y 81.2（板の上端）に揃える**。胴 Y 77.7〜81.2・端子の尻 75.5〜77.7 |
| OLED の口 | **JST PH 4 ピン横型**（`S4B-PH-K-S`） |
| リード・会話ボタンの口 | 2.54 の L 字ソケット |
| スピーカー IN／OUT・電池 | JST PH 横型 |

**口は 7 つ**（XIAO・OLED・スピーカー IN・スピーカー OUT・リード・会話ボタン・電池）。
AS5600 の 4 ピンとマスタートグルの 2 ピンは消えた。

⚠ **「線ゼロ」ではない。**消えたのは AS5600 の 4 本と XIAO の 7 本だけで、他は線が残る。

## 6. つまみと歯車 — 🔒 3 枚で確定（2026-09-13）

つまみの軸は正面の面から後ろへ 19.7（`knob_v5` の `Z_PCB_BOT`）で、その先に AS5600 が来る。
ReSpeaker が幅いっぱい（X 2〜36.007）で寝ているので、**軸を真っ直ぐ降ろすと板を貫く。**

🔒 ユーザー案「つまみをギアで動かして稼働部と読み取り部を遠ざける」で解く。
🔒 **2026-09-13 ユーザー決定: 歯車 3 枚**（2 枚だと磁石の軸が電池に 0.8 × 4.0 食い込んでいた）。
これで **幅 48・板 44 × 81.2 が確定**し、幅 50 の案は消えた。

| | 芯（箱） | 歯数 | ピッチ円 | 歯先円 |
|---|---|---|---|---|
| つまみ | X 24・Y 30.04 | 28 | 14.0 | 15.0 |
| 中継 | X 33.00・Y 21.37 | 22 | 11.0 | 12.0 |
| 読み取り | **X 38.2・Y 10**（板 X 36.2・Y 7） | 28 | 14.0 | 15.0 |

- **1:1 でなければならない。**AS5600 は 1 回転 0〜4095 の絶対角なので、増速すると 1 回転を超えて巻き戻る。
  **3 枚なら両端の歯数を同じにするだけでよく、中継の歯数は比に効かない。**
- 中継の芯は両端から等距離なので、両端を結ぶ線の中点から垂線を 2.332 立てた所に来る。
  この 3 つの数はモジュールと歯数から計算していて、**.scad に直書きしていない**（歯数を変えれば追従する）
- ⚠ **3 枚は 2 枚と回る向きが逆**（つまみと同じ向きに回る）。符号はソフト側（`knobzero`）で吸収する
- 歯先と内壁の逃げは **右 0.3・下 0.5**。歯車の平面は **19.05〜20.85**
### 🔴 帯の在庫は 0.45 しかない（2026-09-13 調停役の裁定 #1）

帯 2.15（ReSpeaker のマイク面 18.85 〜 前の壁の内面 21.0）に中継の歯車（鍔から鍔 **1.700**）を
入れると、**余りは 0.450**。つまみの軸方向の遊び 0.25 と止めピンの掛かり 0.85 はこの中から出る。

そしてこの 0.45 を食うのは公差ではなく、**前の壁の内面の「育ち」**である（片側にだけ出る系統誤差・
接地面積で決まる。`PRINT.md`: LCD 比 9〜11% で +0、26〜27% で +0.2、40〜45% で +0.8〜0.9、50% で +1.2）。

| | 初層 | LCD 比 | 育ち | 判定 |
|---|---|---|---|---|
| 前の殻だけ | 3,142mm² | 24.4% | +0.2 | ✅ 通る（余り 0.25・遊び 0.05） |
| 背面の蓋だけ | 4,226mm² | 32.9% | — | — |
| 🔴 **2 枚を同じプレートに** | 7,368mm² | **57.3%** | +0.8〜1.2 | 🔴 **組めない** |

🔒 **前の殻と背面の蓋を同じプレートに載せない。**刷るのはユーザーだが、「好みで 2 枚一緒にした」
だけで機構が組めなくなるので、**設計側の条件**としてここに残す。
🔒 **0.45 は帯の在庫。**鍔を厚くする・歯幅を戻す・壁を厚くする話は全部ここから引く。

- 磁石とチップの隙間は **1.0**（⚠ AS5600 が許すのは 0.5〜3。歯車 → 軸 → 磁石 → 板の座の積み上げ公差の上に乗る値で、まだ数え直していない）

**当たりは数えた**（`--backend=manifold` の交差の体積）。歯車 × 殻・歯車 × ReSpeaker・歯車 × OLED・
軸 × 電池・軸 × ReSpeaker はすべて **0**。同じ検査に古い値（歯幅 2.5／軸を Y 30.04）を入れると
214.24 / 10.70mm³ と出るので、**検査そのものが空振りしていないことも確かめてある。**
残る 15.68mm³ は軸が中継基板の「口の層」（板一面に 4.0 の塊を置いた仮の場所取り）を通る分で、
実体ではない。実体の条件は上の立入禁止（4 章）。

🔴 **この段落は塊で置いていた頃の数字である。**歯を切った後の検査は機構担当が持っていて、`python hardware/frozen/v6/tools/_v6_gear_chk.py` で 1 本ずつ回る。2026-09-13 12:55 の結果は**実体 15 本が空（ブラケットの足が板の面に乗る 0.0000 を含む）・対照 16 本が全部反応・ERROR 0**。対照は実体 1 本につき 1 本ずつ対にしてある。要求の一覧は [MECH-V6-REQ.md](MECH-V6-REQ.md)。

## 7. スピーカー

🔒 ユーザー「ケーシングも含めて v5 の形状が美しい」。`parts/spk_v5.scad` を**そのまま呼ぶ**
（`spk_station_add` / `spk_station_cut` / `spk_body` / `spk_tub_all`）。

v5 の一式は板の面から内へ **10.2**。左の壁の内側は X 2 から ReSpeaker なので彫れない。
⇒ **板の面を X −8.2 に置いて丸ごと外へ出し、ポッド（一式の凸包）で覆う。**内側の端が X 2.0 で
ReSpeaker の左端に触れて止まる。🔒 面内で **−20°** 回して、腕とバスタブを輪郭の中へ収める。

🔴 背面に入れる案は厚み 31 になり、ユーザーに「一気に箱感が出た」と却下されている。

## 7.5 組む順・外す順（2026-09-13）

🔴 **外す順は組む順の逆ではない。**OLED は**前の殻**に付き、その口 J2 は**背面側の板の上の縁**にある。
線に遊びが無いと、前の殻を外すのに J2 を抜く必要があり、J2 のプラグの通り道は電池の下、
電池は ReSpeaker の下なので、**前の殻を開けるだけで ReSpeaker と電池を外すことになる**（調停役が指摘）。

⇒ **線で解く。**OLED の線に「前の殻を本体の横へ置ける長さ」を持たせ、余りを**右の谷**へ落とす。

| | |
|---|---|
| 余りの置き場 | 箱の **X 37〜46・Y 28〜78・Z 8.6〜19.15**（9 × 50 × 10.55） |
| 空き（実測・中身と柱と殻を引いた残り） | **4,263.72mm³** |
| 要る量 | 4 芯 φ1.0 を 60mm 遊ばせて 188mm³ |
| 模型 | `wire_bay()`。🔒 **線の空間は部品として置く**（v5 で余りの置き場が模型に無く、張った線の検査に出なかった） |

⚠ 却下した置き場: OLED の板の上の帯（Z 20.15〜21.0）は 194.26mm³ あるが**高さが 0.85 しかない**。

**外す順**（この遊びが入った状態）

1. 背面の蓋（Z 10 で割る）
2. **前の殻はそのまま本体の横へ置く**（線は繋がったまま）
3. 以降は中身を上から順に

**組む順**は `hardware/frozen/v6/_v6_gear.scad` の冒頭が持つ（機構担当）。

## 7.6 リードスイッチ（2026-09-13・**まだ置いていない**）

🔒 **役はスライドスイッチと分かれている。**リードは「つまみを回し切ると切れる」、
スライドは「つまみがどこにあっても・ファームがハングしても落とせる」非常用で、
`EN` ⇔ `GND` に**リード・スライド・0.1µF の 3 つが並列**に入る（`POWER.md` 2 章）。
リードなのは「**電源が無くても効く部品**でなければならない」から。

| | 値 | 出どころ |
|---|---|---|
| OFF の壁 | 🔒 **−14 度**（島は 0 度が芯で ±14・可動域 320.1） | `KNOB-ENCODER.md` 268〜272 と `main.cpp:4125`「**右へ回して**」。正面では時計回り ＝ 角度が減る向き |
| リードの芯（殻の中・固定） | 🔒 **−4 度**（OFF から島側へ 10 度 ＝ v5 の `STOP_OFF_ANG`） | リードが開くのは OFF ＋ 5 度。島の中なので止めピンと当たらない |
| 半径 | ⬜ 磁石が決まってから | |
| ファーム | `KATANORI_KNOB_OFF_DEG` **15 → 25**（＝ 15 ＋ 遊び 9.12） | 筐体側の仕事ではない |

⭐ **回転の向きは v5 と同じ。**歯車 **3 枚は 2 枚と違って入力と同じ向きに回る**ので、
つまみと AS5600 の向きは v5（直結）から変わらない。⇒ **`knobzero` の符号は反転しない。**

### 🔴 皿は磁石の運び手として厳しい

皿の裏で空いているのは軸穴 φ12.85 と止めの溝 r8.5〜10.7 を除いた 2 つの輪だが、
**幅だけ渡すと入る前提で設計が進む。厚みが一定ではない**（上面の窪み `KN_SINK` 0.8 が裏の肉を食う）。

| 半径 | 皿の残り厚み |
|---|---|
| 10.700〜11.250 | **1.700**（窪みの底の真下） |
| 12.000 | 1.967 |
| **12.656** | **2.200** |
| 13.500〜14.250 | 2.500 |

⇒ **厚み 2.2 以上が取れるのは r 12.656〜14.250 の幅 1.594 だけ。**
🔴 **φ4 × 2（手持ち）も φ3 も入らない。**内側の輪は r 6.425〜8.500（幅 2.075・厚み 1.700）。

⚠ **距離**: 皿の裏 23.05 → 殻の内面 21.0 で **2.05**。ただし**止めの溝の底（22.0）だけは 1.00**。
リードは距離で効きが決まるので、この差は効きうる。

⚠ **v5 の 🔒「磁石の軸は接線方向」は持ち越さない。**あの実測（「面をリードに正対させると 2 箇所で鳴る」・
2026-08-20）は**磁石とリードが同じ高さで横に並ぶ** v5 の形でのもの。v6 は前の壁を挟んで**上下に重なる**。
⇒ 手続きだけ生きる: ユーザーの原文「変えるなら先にテスタで『鳴る箇所が 1 つ』を見ること」。
これは `main.cpp:99〜111` が既に「測るならテスタをリードの足に当てる」と書いている初回の実機の項目に 1 行足すだけ。

**⬜ 待ち**: 磁石の形（機構担当）。決まるまで座は彫らない。

## 7.7 電池（⬜ **未決・探索中**）

🔴 **35 × 50 × 6 は入らない。**柱 3 本と ReSpeaker の裏の部品に 548mm³ 食い込んでいた。

| 枠（実体に当てて測った空き。逃げ 0） | 体積 |
|---|---|
| 幅を取る 31.2 × 46.8 × 6.0 | 8,760mm³ |
| 丈を取る 28.0 × 54.2 × 6.0 | 9,106mm³ |
| ⭐ **J1 の胴（X 5.51〜11.51）を避ける 28.19 × 54.2 × 6.0** | **9,167mm³** |

- 幅を決めているのは **OLED の柱**（X 5.3 と 42.7・φ6.0）⇒ 空きは X 8.30〜39.70 の **31.40**
- 丈を決めているのは **J1 の胴**（Y 69.565 から）。**X で避ければ Y 76.8 まで使える**
- 天面を決めているのは **U3**（底 14.75）

🔴 **DTP603048（30 × 49 × 6.0・860mAh）は入らない。**総当たり 510 通りで最小の食い込み **10.85mm³**、
相手は **J1 の胴だけ**（柱・`wire_bay`・殻・中継基板は全部 空）。幅 30 だと左端が必ず 11.51 より左に来る。
⇒ **幅 25 の帯で探し直し中**（DTP の幅は 20 / 25 / 30 / 34 と飛んでいる）。

### 🔒 決着（2026-09-13）

| 品 | 寸法 | 容量 | 逃げ 0 | 逃げ 0.25/片側 |
|---|---|---|---|---|
| DTP603048 | 30 × 49 × 6.0 | 860mAh | 🔴 10.85mm³（J1 の胴） | — |
| DTP652533 | 25.5 × 35 × 6.7 | 500mAh | ✅ (8.5, 33.0, 8.6) | ⬜ |
| ⭐ **603040**（楽天・株式会社TOP・**PSE 認証**） | **30 × 40 × 5.0** | **800mAh** | ✅ **(8.5, 22.5, 8.6)** | ✅ **同じ位置** |

⇒ 模型は **603040** で置いてある。余りは 幅 1.40 ／ 丈 6.96 ／ **厚み 1.0**（膨らみの逃げが取れる）。
🔒 **ユーザー決定: 800mAh（603040）。**「８００でやりましょ。正直決めの問題です。」
⚠ **決めた時点では 500 も入ると思われていた**（部品商社・コネクタがそのまま挿さる・63 個即納）。
🔴 **その後、逃げ 0.25/片側 で 7.64mm³ の食い込みが出て落ちた**（厚み 6.7・天面 15.30・**余り 0**）。
⇒ **ユーザーの「決めの問題」という判断は、当時の材料の上では正しい。いまは 500 には戻れない。**
（⚠ 400mAh（DTP502535）は呼び＋Max の見込み 25.5 × 37 × 5.2 で**入る**。📄 は未取得）

### 電池の押さえ（`bat_fence()`）

🔒 **位置だけ決めて、厚み方向は遊ばせる。**リポは充放電で膨らむので、上から押さえると逃げ場が無くなる。
⇒ 柵は電池と**同じ高さまで**（Z 8.6〜13.6・肉 0.8）。**天井は作らない。**

| | 前 | 後 |
|---|---|---|
| +Y に動ける | **7.07** | 0.30 |
| **−Y に動ける** | **0.09** ← 🔴 **電池が XIAO のソケットを押していた**（押さえを作る過程で見つけた） | 0.30 |
| ±X | 1.20 / 0.20 | 0.30 |
| 上（膨らむ先） | 1.16 | **1.16（触っていない）** |

⚠ **1.16 で足りるかは書かない。**この電池の膨らむ量を誰も持っていない。

🔴 **稼働時間を書かない。**`POWER.md` 78 行 ── 「20 分連続動作」は**死んだ ReSpeaker Lite での実績**で、
**いま生きている板では一度も電池で動かしていない**。⇒ **言えるのは 500 と 800 の比が 1.6 倍まで。**
何分動くかは中継基板を組んで実測するまで誰も知らない（`TODO.md` A-2）。
⚠ 🔒 [[results-belong-to-a-build]] と同じ形を、この案件で 2 度目にやりかけた。

⚠ **私（模型）が言えるのは「この寸法の直方体が入るか」まで。**タブと線・膨らみは数えていない。
🔒 **届いたら現物を測ってから組む。**

**道具**: `python hardware/frozen/v6/tools/_v6_batfit.py 幅 丈 厚み [逃げ]`
模型の実体に当てて置き方を総当たりする。1 品 5〜10 分。**「入らない」も言える。**

## 8. 残っている判断（2026-09-13 の終わり）

| | 中身 | 誰が |
|---|---|---|
| 🔴 **背面のねじの頭 10 か所** | ザグリ φ4 × 1.1。上の 2 対は柱が 2.31 で食い込むので「8 の字」になる。**絵を出してある** | ユーザー |
| ⬜ **800mAh の実寸** | 📄 が無い品。🔒 **届いたらノギスで測ってから組む。**30.5 × 41 × 5.2 を超えたら 400mAh（控え）へ | 実物 |
| ⬜ 磁石とチップの距離 1.10 | AS5600 の許容 0.5〜3。積み上げ公差を数え直していない | 板の座が固まってから |
| ⬜ 電池の膨らみ | 1.16 空けた。足りるかは誰も知らない | 実物 |
| ⬜ ReSpeaker Lite の 3V3 の余力 | 非公開 | 実測 |
| ⬜ 薄壁の下限 0.42 の出どころ | `_stl_preflight.py:386` が使っているが根拠の記載が無い。⇒ **0.30 と 0.42 の両方を超える形にしてある**ので、いまやり直す物は無い | 記録を掘る人 |
| 🔒 **ファームの `KATANORI_KNOB_OFF_DEG` 15 → 25 は、遊び 9.12 度 にぶら下がっている** | 次に遊びを減らしたら（ばね腕・二面幅の隙間）**閾値も戻せる**。増やせば鳴らない区間が広がる。⇒ **遊びを触る人は必ずここも見る** | ソフト |
| ⬜ リードのストローク・Z の芯 | 📄 に無い。初回の実機でテスタを当てるときに見る | 実物 |

🔒 **稼働時間は書かない。**`POWER.md` 78 行 ── 「20 分連続動作」は**死んだ ReSpeaker Lite での実績**で、
いま生きている板では**一度も電池で動かしていない**。何分動くかは組んで実測するまで誰も知らない。

## 9. 今日ここで潰した当たり（記録）

私（AI）が置いた誤りで、実体で当たっていたもの。同じ種類を繰り返さないために残す。

| 何 | 原因 |
|---|---|
| XIAO の USB-C の穴が消えていた | Z を `21.97` と直書きしていて、厚みを 30.5 → 23 に変えたとき ReSpeaker に追従しなかった。`RS_Z − 3.03` で導く形に直した |
| 3.5mm ジャックの Z が 3.0 ずれていた | `BODY_Z/2` と直書き。実物は「筒の軸が XIAO 面から 2.485」 |
| 中継基板の柱が箱の外（X 51）に立っていた | 旧 74 × 52 の 46 × 68 格子のまま。37 × 66 に直した |
| 歯車が ReSpeaker の頭に 0.05 触っていた | 歯車の平面を 18.8 に置いていた。19.05 へ |
| 歯車の歯先が右の内壁を 1.0 貫いていた | 中心距離 15.0。14.2 へ |
| スライドスイッチがジャックに重なっていた | 上の縁の並びを数えずに X を置いた |
| 歯車が前の壁を 0.55 貫いていた（214.24mm³） | 天井に窓の掘り込み 21.8 を使ったが、歯車は窓の下（掘り込みの無い所）に居る。歯幅 2.5 → 1.8 |
| ReSpeaker の Usr/Mute ボタンが前の壁に押されていた（0.43） | マイク面から 2.58 出る。押されっぱなし＝ミュートが入りっぱなしになる。逃げを彫って残り肉 1.2 |
| XIAO の USB-C の穴が殻を 0.30mm³ 削っていた | 逃げを片側 0.25 で引いていた。0.5 へ |
| 🔴 **失敗した検査を「当たり 0」と報告した** | レバーの振り切りの 0.02mm³ を「面取り誤差」として 0 と書いたが、その根拠にした `-D '$fn=256'` の再検査は OpenSCAD がエラーで落ちてファイルが書かれておらず、古い STL を読んでいた。**エラー／空／数値の 3 分岐**を踏んだ |
| 🔴 **対照が「空のまま」通っていた** | `chk_ctrl`（歯車 × ReSpeaker の対照）が古い円盤を Z 19.05 に置いていて、ReSpeaker のマイク面 18.85 と**最初から触っていなかった**。反応しない対照は何も証明しない。記録に残る実際の当たり（平面 18.8 で 0.05）へ差し替えて 15.67mm³ で反応するようにした（2026-09-13・機構担当） |
| 🔴 **OLED を塊で置いて 773.17mm³ 壁に埋めていた** | 42.40 × 38.00 × 2.65 の 1 個の箱にしていた。掘り込みを「光る所」に合わせたので、板の天面 21.8 が内面 21.0 を**全周 0.8 貫いて**いた。📄 側面図から **板 1.00 ＋ ガラス 1.65** に割り、ガラスのぶんだけ内側に座ぐりを足した |
| 🔴 **ハブの柱に穴が 1 つも開いていなかった** | `post()` が穴を「床から 1.5 上」から柱の高さぶん彫っていて、高さ 1.0 のハブの柱では穴が柱の外（z 3.5〜4.5）へ出ていた。機構担当が「M2 × 4 で留まる」を前提に組む順を歩いていて発覚。床の裏から柱の頭まで貫く形へ（🔒 docs「樹脂にねじを切らず貫通＋ナット」） |
| 🔴 **OLED と ReSpeaker を当てた検査が 1 本も無かった** | D1（マイク面から 1.185）に OLED の板が 0.89 食い込んでいた。「挟めるか」を調べに行って見つかった。⇒ `OL_RS_GAP` 1.30 ＋ `SCR_IN` 0.2 |
| 🔴 **電池を「帯の高さ 6.0」だけ見て置いていた** | 柱 3 本と ReSpeaker の裏の部品に **548mm³** 食い込み。⇒ 🔒「ここへ置ける」と言う前に、その箱の中を通っている物を全部数える |
| 🔴 **`STP_D` が 2.00 のまま数時間、φ2.4 として報告していた** | ① 1 つのスクリプトで 2 か所直し、2 つ目の assert が落ちて**ファイルが 1 文字も書かれなかった** ② その後の `re.sub` は置換 0 件でも黙って成功。⇒ 🔒 **1 スクリプト 1 編集**・🔒 **報告する数はファイルから読み直して計算する**（echo に常駐させた） |
| 🔴 **障害物を「部品の表」から作っていた** | `respeaker_lite.scad` は表から **J1 だけ除外して STEP から置き直して**いる。表の J1 は使われていない。⇒ 🔒 **当たりを見るとき、相手は表ではなく模型の実体で取る** |
| 🔴 **測った 3 行のうち、渡すとき 2 行に間引いた** | いちばん体積の大きい「J1 を避ける枠」を落としていた。⇒ 🔒 **測った行を、渡すときに間引かない** |
| 🔴 **柱 10 本と中継の軸が実体として存在しなかった** | `cavity()` を引く前の union に入れていたので丸ごと消えていた。背面の穴だけ残るため、絵では開いて見える。`shell_stand()` として**彫った後に足す**形へ |
| 🔴 **電池を押さえる物が 1 つも無かった** | 姿勢の問題ではなく元から抜けていた。逆さで落ちるだけでなく正立でも動く |
| 🔴 **前方参照を 3 回**（`JACK_Z`・`KN_DISHZ`・`ID_PIN_BOT`） | 後で定義される変数を使う変数を書いて undef にした。しかも `part="face"` では評価されないので**警告が出ない**。壁から出る数を全部壁の隣へ上げて根を絶ち、5 つの part 全部で警告 0 を数えた |
| レバーの Z の芯を 1.05 低く見ていた | 「胴 3.5 ＋ 0.5」の 0.5 をレバーの台と読んだが、胴の下の浮きだった（回路側が側面図の 0.2 を見つけた） |

🔒 **2026-09-13 の 3 スレッド共通の規則**

- **相手のファイルの数に追従させたいときは、変数ではなく「関数」で渡す。モジュールごと上書きしない。**
  🔴 OpenSCAD は同じ変数に 2 回代入すると、**最後の代入の右辺を「最初の代入があった位置」で評価する。**
  子からの変数の上書きは undef になる。関数とモジュールの引数だけが効く。
  モジュールの複製は、親がそのモジュールに足した物を子へ伝えない（**溝の抜き穴で実際に起きた**）。
- 🔒 **共有する実体（殻・OLED・ReSpeaker・板・電池）の形を割った／動かしたら、
  `python hardware/frozen/v6/tools/_v6_gear_chk.py` を 1 回回す。**判定の 1 行だけ読めばよい。
  ⚠ **実体が空なのは正常・対照が空なら失敗**（ここが逆なので注意）。
  下流に 1 行知らせるのは礼儀として続けるが、規則にはしない。相手を知っていて覚えていた日にしか効かないから
- **当たりを見るときは「対照 1 本」と「警告 0」を両方確かめる。**片方では足りない。
  「空」は「当たっていない」と「形が無い」を同じ顔で返す。今日 3 つの機序が出た:
  ① 対照が最初から別の物を触っていた ② 定数の複製で抜き穴の無い溝を見ていた ③ undef で形が消えていた
  ④ **相手の形を割ったら、それを当てにしていた対照が届かなくなった**（誰も間違えていないのに起きる）
  ⑤ **古い写しから引用した**（相手のファイルの複製・直す前の版・自分が前に書いた数）
  ⑥ **同じ変数が設計モデルと印刷モデルで違う値になる**（`fit.scad` を通す数。どちらの話か書かずに比べない）
  ⑦ **部品は描かれていたが、検査が使う実体に union されていなかった**（柱 10 本が `shell_a()` に無かった）
  ⑧ **union には入れたが、その後の `cavity()` に消されていた**（柱も中継の軸も、穴だけ残って実体が無い。
  絵では開いて見えるので気付けない。⇒ **立ち物は彫った後に足す**）
  🔒 5 つとも同じ形である ── **手元にある物が正である保証はどこにも無い。**
  ⇒ 相手の数を confirm するときは、**別の式・別の出どころから出す。**写して一致を見ても、
  それは一致ではなく同じ計算をもう一度しただけになる

🔴 **直書きの座標が 3 件ある。**どれも「他の寸法を変えたとき追従しない」形で残っていた。
**部品の位置は必ず相手の実体から導くこと。**

---

# 2026-09-13 の決着（4 スレッドの議論）

🔴 **この節の内容は、`hardware/frozen/v6/_v6_portrait.scad` にまだ 1 つも入っていない。**
絵にしたものが `hardware/frozen/v6/_tmp_v6b_stack.scad`（提案ファイル・本体には触っていない）。

## 🔒 決まった

| | |
|---|---|
| ギアボックス | 歯車の帯 **4.45**。機構が設計済み（`_tmp_gearbox_proposal.scad`）。天井は前の殻の内面をそのまま使うので新しい肉は要らない |
| 電池 | 背面の**閉じた部屋**に入れる。外からは開かない／全分解すれば取り出せる。**「交換不可」とは書かない**（リポは数年で劣化する） |
| 背面の窓 | **作らない**（ユーザー決定） |
| 殻の割れる高さ | `SPLIT_Z` 10.0 → **2.00**。理由は継ぎ目の位置ではなく、**柱 10 本が切れないこと**と、**見えない嵌合がゼロになること** |
| 部屋の天井 | Z 7.50〜8.30 の **0.8 を別部品**に。留め具なし（中継基板が上から押さえる）。**段差を彫らない**（壁 0.6 − 0.4 = 0.2 で下限 0.42 を割るため。平らに載せる方が強い） |
| 部屋の壁 | X の 2 面 **0.6**／Y の 2 面・天地 **0.8**。薄くするのは「挿すときに擦れる面」で、電池が膨らむ方向に立つ天地は 0.8 のまま |
| 電池の四角 | 部屋の外形 箱 X 8.00〜40.00 / Y 8.20〜67.20。電池そのもの X 8.80〜38.80（逃げ 0.40/辺） |
| J10 | 板の**裏面**。胴が部屋の天井の穴にはまる。**線が通る穴はゼロ**。隙間 0.4/辺 ＋ 部屋側へ 0.6 の襟 |
| 口 | J2・J6 → **ZH 4 ピン** ／ J4・J5・J10 → **PH のまま** ／ K31 → **G6K**（表の右の帯 X 36.30〜45.90 に残せる・空き 14.8）／ XIAO **直付け** ／ SW1 **裏面** |
| 厚み | **`BODY_Z` 23.59**  ⚠ **ユーザー未承認** |

## ⬜ まだ決まっていない

- **印刷の向き。**記録が無い（`print_log.jsonl` 64 件に傾けた例は 0 件。確立しているのは直置きか立てるかの 2 択）
- **1 枚のプレートに何を載せるか。**⚠ `PRINT.md:189`「2 枚以上載せるときは足し算する」

## ⚠ 引いてみるまで分からない

- 前面側が **21.0 の器**になる（いま 13.0）。刷れるか・支柱・育ち
- 背面の板を**立てて**刷れるか（接地 1.4%・育ち 0 になるが、厚み 2.0 の大きい板を立てた記録が無い＝反りが未知）
- **寝かせるとどちらの面を下にしても壊れる**: 内面を下 ⇒ 壁を受ける溝 0.5 が初層で埋まり、育ち 0.46 が部屋の深さを食う（膨らみ代 0.5 → 0.04）／外面を下 ⇒ ザグリ φ4.0 × 1.1 が 10 か所埋まる

## 🔴 今日見つかった、案とは独立の欠陥（案を捨てても残る）

- **いまの設計は柱 10 本を継ぎ目で切っている**（`SPLIT_Z` 10.0 で背面側に 1019.4mm³）。ねじはその継ぎ目を貫いて締まる
- **歯車の読み取りの天面 20.50 ↔ 前の壁の内面 21.00 が 0.50** で、鎖の出会い 0.55 を下回る
- **背面の初層比が 32.87%**（4,224 / 12,851）で、`PRINT.md` の 30% の線を既に越えている

## ⚠ 出どころの無い数字（判断に使うときは見ること）

| 値 | 何 | 出どころ |
|---|---|---|
| **0.5** | 電池の膨らみ代 | ⚠ 私の仮定。📄 でも実測でもない。**電池が届いたら測る** |
| **0.8 / 0.6** | 部屋の壁の肉 | ⚠ 同上（下限 0.42 の 1.4〜2 倍） |
| **0.2/辺** | J10 の実装のずれ | ⚠ 同上（手はんだの THT） |
| **0.42** | 平らな材の下限 | ⬜ `_stl_preflight.py:386`。**記録された根拠が無い** |

## 🔒 幾何で解けず、手順に渡したもの

- **素線 1 本（φ0.08）は、どんな隙間も通る。**⇒ 部屋の継ぎ目と J10 の穴は「被覆つき線 φ1.2 が通らない」までしか保証できない
  ⇒ **組立の手順に「前面側を被せる前に、部屋の中と縁を拭く」を入れる**
- **PH の足を裏 1.0 に切るなら、はんだ付けの前に切る**（付けた後に切るとニッパがランド φ1.7 を剥がす）
