n416/katanori/docs/MECH-V6-HANDOFF.md

# 機構スレッドの任務書（筐体 v6・つまみと歯車）

> ⛔ **凍結（2026-09-14）。v6 縦置き案の任務書。現行の v6.1 には当てはまらない（[CASE-V61N.md](CASE-V61N.md)）。**

**このファイルを読んだセッションが、katanori 筐体 v6 の「機構」担当になります。**
新しいセッションを開いて「`docs/MECH-V6-HANDOFF.md` を読んで機構担当を引き継いで」と言えば立ち上がります。

いま 3 つのスレッドが並行しています。

| | 課題 |
|---|---|
| デザイン担当 | 薄さと「携帯機に見える形」。外形・顔・部品の置き場。`hardware/frozen/v6/_v6_portrait.scad` を持つ |
| 回路担当（セッション「ケーブル取り回しの問題」） | 中継基板が引けること。`hardware/frozen/v6/pcb/` を持つ |
| **機構担当（あなた）** | つまみが回って AS5600 が正しく角度を読む、その**構造**。`hardware/frozen/v6/_v6_gear.scad` を持つ |

ユーザーの言葉: 「機構つまり歯車とかの構造は貴方以外のもう１スレッドを立てて検討すべきですね。
基板設計に任せるものでもないです。」

---

## 1. まず読む（順に）

1. `docs/CASE-V6-PLAN.md` … v6 の現在地。6 章が歯車、4 章が板の天井の地図、9 章が潰した当たりの記録
2. `hardware/frozen/v6/_v6_gear.scad` … **あなたの持ち物**。すでに 6 部品ぶん入っている
3. `hardware/frozen/v6/_v6_portrait.scad` … 形の正。**編集しないこと**（デザイン担当が同時に触っています）
4. `hardware/parts/knob_v5.scad` … v5 のつまみ一式。軸の保持と AS5600 の座の前例
5. `docs/KNOB-ENCODER.md` … AS5600 の要求
6. `docs/RESPEAKER-LITE.md` 5.6 と `hardware/parts/respeaker_lite_parts.scad` … 部品ごとの実寸（212 箱・公式 CAD 由来）

## 2. 🔒 動かせないもの

| | 値 |
|---|---|
| 筐体 | 48 × 88 × 23。丸み無し。壁 2.0。**正面が z = 23**・背面が z = 0。背面の蓋の合わせ面 z = 10 |
| つまみの芯 | 箱の X 24・Y 30.04 |
| つまみの皿 | φ28.5・抜き φ11・厚み 2.5・面から 2.5 出る。**皿そのものがつまみ**（窪みではない）。ユーザーが 2 度こだわった所 |
| 読み取りの芯 | 箱の X 38.2・Y 10（＝ 板の X 36.2・Y 7）。**回路側と合意済み** |
| AS5600 | SOIC-8 のチップが中継基板の表面（箱 Z 4.6）に直付け |
| 比 | **1:1**（1 回転 0〜4095 の絶対角。増速すると巻き戻る） |
| 歯車の帯 | ReSpeaker のマイク面 **18.85** 〜 前の壁の内面 **21.0**。**2.15 しかない** |
| 作り方 | 光造形（自分で刷る）。ユーザーの手の精度 0.3mm |

## 3. いまの到達点（前の担当が出したもの・**未反映**）

`hardware/frozen/v6/_v6_gear.scad` に 6 部品（皿・ハブ・中継の歯車・読み取りの歯車・ロータ・ブラケット）。
歯はインボリュート m0.5・圧力角 20・歯末 0.85m。当たり検査は実体 14 本すべて空、対照 7 本すべて反応。

**潰した当たり**: つまみが軸に繋がっていなかった（皿の抜き φ11 ↔ 殻の軸穴 φ9・結ぶ実体 0mm³）／
軸受け 0 本／歯先の厚み 0.237（下限 0.30 割れ）／歯幅 1.8 が帯に入らない／
ロータが ReSpeaker の脇を通れない（**Q4 が板の裏に箱 Z 15.71 まで垂れている**。
`respeaker_lite_parts.scad` で独立に確認済み）／エアギャップ 1.0 の下限が 0.04 ＝ 磁石がチップに当たる／
回り止めが無い（ファームは壁がある前提。`main.cpp` 660 行・`KATANORI_KNOB_SPAN_DEG=310`）／
板の右下の M2 が磁石の環を塞ぐ。

### 🔴 筐体側へ要求されていること（デザイン担当が未反映）

| | 何のために | 何 |
|---|---|---|
| 軸穴 | 皿の抜き φ11 に届く筒を通す | φ9.0 → **φ12.85**（皿 r14.25 の下に隠れる） |
| 止めの溝 | 可動域 320 度 | 前の面に r8.6〜10.6・深さ 1.0・島 28 度 |
| 中継の軸 | 中継の歯車を載せる | 壁の内面から φ3.0 × 1.85 |
| 皿の裏 | 抜け止めの遊びを 0.25 に | 23.30 → 23.05（出っ張り 2.5 は不変） |
| 歯車の平面 | 2 つの鎖のずれ 0.55 を飲む | 19.05〜20.85（幅 1.8）→ 19.40〜20.80（幅 1.4） |

### 🔴 板側へ要求されていること（回路担当へ未伝達）

1. 立入禁止を 6×6 の角から、板 (36.2, 7) を芯とする **φ10.2 の円・板の面から 11.3** へ
2. ブラケットの座: 板 X 35.4〜43.7・Y 0〜6.7 に背 1.5 超の部品を置かない。**右下の M2 で共締め**
3. AS5600 の足跡は**リード込み 4.9 × 6.2**（いまの 4.9 × 3.9 は胴だけ）

## 4. 🔴 未決（ユーザーの判断待ち）

**戻したときの遊び 8.07 度（RSS 4.70 度）を許すか。**
逆へ回すとこの角度は読みが動きません。ファームの 1%（3.1 度）で 1.5〜2.6 段ぶん、可動域 310 度の 2.6%。
内訳は 噛み合い 2 か所 3.93 ＋ 中継の軸受け 2.18 ＋ つまみ 1.09 ＋ 読み取り 0.87。
消すなら中継をばね腕で両側へ押し付ける（1.96 度になる。部品が 1 つ増え、手応えが重くなる）。

**⚠ 明記された仮定**（実測ではない）: 殻の中の寸法 ±0.20／背面の殻→柱→板 ±0.20／
合わせ面の閉じ残り 0.15／歯厚の削り 0.12（噛み合い 0.24）／読み取りの軸受けの遊び 0.20（v5 の実績 0.25）。

## 5. やり方の決まり

- 🔴 `hardware/frozen/v6/_v6_portrait.scad` を**編集しない**。要求は文で出し、デザイン担当が入れる
- 🔴 座標を直書きしない。相手の実体から導く。同じ数字を 2 か所に書かない
- 🔴 当たりは `--backend=manifold` で。1 つずつ見る。**エラー／空／数値を 3 分岐**にし、
  **わざと外した対照が反応することを毎回 1 本確かめる**（古い STL を読む事故が実際に起きています）
- 🔴 ⬜ を判断待ちに積まない。記録を掘る → 無ければ**仮定を明記して自分で進める**
- 🔴 ユーザーに測定・写真・ノギスを頼まない。試し刷りを気軽に提案しない
- 🔴 絵を出す。座標の羅列で判断を迫らない。**1 返答で迫る判断は 1 つまで**
- 🔴 機構の発案より、ユーザー案の検証・寸法出し・当たりの報告を優先する
