n416/katanori/docs/MECH-V6-REQ.md

# 機構から筐体・板へ出す要求（v6・2026-09-13）

> ⛔ **凍結（2026-09-14）。v6 縦置き案の要求。現行の v6.1 には当てはまらない（[CASE-V61N.md](CASE-V61N.md)）。**

**この資料は要求だけを持つ。**機構の理屈と検算は [CASE-V6-PLAN.md](CASE-V6-PLAN.md) 6 章と
[../hardware/frozen/v6/_v6_gear.scad](../hardware/frozen/v6/_v6_gear.scad) が持っていて、ここはそこから写した
「相手が自分のファイルに入れる数字」の一覧である。

出どころは全部 `_v6_gear.scad` の echo で、番号（①〜⑪）はそのまま引ける。
検算したい人は次の 2 つを回せば同じ数字が出る。

```
"C:/Program Files/OpenSCAD (Nightly)/openscad.exe" --backend=manifold -o x.echo -D "part=\"p_khub\"" hardware/frozen/v6/_v6_gear.scad
python hardware/frozen/v6/tools/_v6_gear_chk.py
```

2026-09-13 12:50 時点で、下の 8 件はどれも相手のファイルに入っていない。
`_v6_portrait.scad` は `KN_BORE = 9.0`・止めの溝なし・`GEAR_W = 1.8`・`GZ = 19.05` のままである。

---

## A. 前の殻へ（`hardware/frozen/v6/_v6_portrait.scad`・デザイン担当）

| | いま | 要求 | なぜ |
|---|---|---|---|
| A1 つまみの軸穴 | `KN_BORE = 9.0` | **φ12.85**（芯は `KN_C` のまま） | 皿の抜きが φ11 なので、φ9 の穴を通る軸は最大 φ8.75 にしかならず、皿の肉に直径で 2.25 届かない。皿を中空の帽子にしてスカート φ12.6 を穴の中で回す。穴は皿 r14.25 の下に完全に隠れるので、顔の見た目は変わらない（echo ③） |
| A2 止めの溝 | 無い | 前の面の内側に **r8.6〜10.6・深さ 1.0**、角度 0 の位置に **28 度の島** | ファーム（`main.cpp` 660 行）は「壁があるので可動域の外へ行けない」前提で書いてある。`KATANORI_KNOB_SPAN_DEG` は 310 度で、この溝の可動域は 320.0 度なので収まる。深さ 1.0 は壁 2.0 のうち 1.0 を残す値で、OLED（Z 19.15〜21.8）には届かない（echo ④・`chk_groove_oled` が空、対照 `chk_ctrl7` は 7.26mm³ で反応） |
| A3 中継の軸 | 無い | 前の壁の内面から **φ3.0 を 1.85 下ろす**（芯は `IDLER`） | 中継の歯車はこの止まり軸に載るだけで、他に支えが無い。軸受けの長さは帯の都合で 1.70 しか取れないので、倒れは軸受けではなく歯車側の上下の鍔 φ10 で 2.58 度に止める（echo ⑧） |
| A4 皿の裏の高さ | 23.30 | **23.05** | 皿とハブで壁を挟む形にしたので、ここが軸方向の遊びになる。0.25 で倒れ 0.66 度。出っ張り 2.5 は変えない（echo ④） |
| A5 歯車の平面 | `GZ = 19.05`・`GEAR_W = 1.8` | **19.40〜20.80（幅 1.4）**、読み取りだけ 19.30〜20.50（幅 1.2） | 使える帯は ReSpeaker のマイク面 18.85 から前の壁の内面 21.0 までの 2.15 しかない。ここへ前の殻の鎖と背面の殻の鎖が別々にぶら下がり、その相対ずれが最悪 0.55 ある。幅 1.8 では上下の逃げが 0.175 しか残らず 0.55 を飲めない（echo ①） |

A1・A2・A3 は `_v6_gear.scad` の `shell_add()` と `shell_cut()` にそのまま形で入っているので、
デザイン担当はこの 2 つのモジュールを呼ぶか、中身を写すかのどちらでもよい。

## B. 中継基板へ（`hardware/frozen/v6/pcb/`・回路担当）

| | いま | 要求 | なぜ |
|---|---|---|---|
| B1 立入禁止 | 板 X 33.2〜39.2・Y 4〜10 の 6 × 6 角 | 板 **(36.2, 7) を芯とする φ10.2**・板の面から **11.3** | 磁石とロータだけでなく、ロータを受ける軸受けの筒（φ9.6・板の面から 4.2〜10.5）がここに立つ。角の指定では筒の外周が入らない（echo ⑪） |
| B2 ブラケットの座 | 無い | 板 **X 35.4〜43.7・Y 0〜6.7** に背 1.5 を超える部品を置かない。**右下の M2（板 X 40.5・Y 3.5）で共締め**する | 軸受けを板の面基準にするための足。前の殻から吊ると鎖が 6 段になってエアギャップが最悪 0.26 まで落ち、AS5600 の下限 0.5 を割る。板基準なら 3 段で 0.69〜1.51 に収まる（echo ⑦） |
| B3 AS5600 の足跡 | 4.9 × 3.9 | **4.9 × 6.2**（リード込み） | いまの数字は胴だけで、SOIC-8（JEDEC MS-012）のリードの張り出し E は 6.00 ±0.20 である。ブラケットの足の座 φ6.4 がこの足跡へ 0.57mm³ 入っていたのを、芯まわりを φ8.5 の筒で抜いて逃がしてある（`chk_brk_chip` が空、対照 `chk_ctrl6` は 0.60mm³ で反応） |

B1 と B2 は同じ場所の話で、B2 の足が通るのは B1 の円の外側である。両方入れないと片方が効かない。

## C. 決めたこと — 戻したときの遊びは 8.07 度のまま（2026-09-13・機構担当）

つまみを逆へ回したとき読みが動き出すまでの遊びは **最悪 8.07 度・RSS 4.70 度**ある。
内訳は噛み合い 2 か所 3.93 ＋ 中継の軸受け 2.18 ＋ つまみ 1.09 ＋ 読み取り 0.87（echo ⑤）。

**ばね腕（1.96 度まで詰まる）は足さない。**

🔴 **2026-09-13 訂正（調停役の裁定 #3）。最初にここへ書いた理由は間違っていた。**
「ファームが 2% のデッドバンドで捨てるから、ばね腕で詰めた差はソフトが捨てる」と書いたが、
**遊びとデッドバンドは競合しない。足し算である。**逆へ回すと読みは遊びのぶん止まり、
そこから 2%（6.2 度）動いて初めて効く。手が動く量は 遊び ＋ 6.2 度 になる。

| | 遊び | 手が動く量 |
|---|---|---|
| 二面幅なし | 8.07 | 14.3 度 |
| 二面幅あり（いま） | 9.12 | **15.3 度** |

⚠ 最悪値は最初から 2% を超えていた（8.07 / 310 = 2.60%）。
私が「前回は 2.60% で下でした」と書いたのも誤りである。

## 足さない本当の理由

`docs/PRINT.md` の「板バネのゲージ」: 9 枚を刷り、直後は 3 枚が合格したのに、
**約 1 日半後に押した瞬間、全数が破断した。**効いたのは形ではなく**時間（経時脆化）**で、
同文書の教訓は「**弾性部品の合否を刷った直後で判定してはいけない。数日置いて同じ試験を
やり直すまでが 1 セット**」である。

⚠ その 🔒 の守備範囲はレジン①（SK本舗 灰）で、それは尽きている。いまは ELEGOO で、
同文書は「水洗い系のレジンでその用途に耐えるかは**どちらのレジンでもまだ試していない**」と書く。
⇒ **「ばね腕は作れない」とは言えない。**言えるのは次のことである。

🔒 **ばね腕を採るとは、未確認のレジンで弾性部品の合否試験を数日がかりでやる、という意味である。**
それを 1.05 度（手が動く量で 15.3 → 14.3 度）のために始めない。
ユーザーに試し刷りをさせないという決まりとも一致する。

この決定は筐体にも板にも何も要求しない（A・B の数字は 1 つも動かない）。

---

# 2026-09-13 追記 — つまみは「抜ける」前に**回っていなかった**

調停役の裁定 #2 の指摘を自分で確かめた。皿の穴は真円 φ8.70、ハブの柱は φ8.60 を二面幅 6.60 で
削った形で、**φ8.60 の円の部分集合はどの角度でも φ8.70 の真円に収まる**。
皿を回してハブに当てる検査は 5 度・20 度・45 度のどれも **0.0000mm³** だった。
⇒ 抜け止めが無いだけでなく、**トルクが 1 つも伝わっていなかった。**
私の前の報告（「締め代ゼロ」）は軸方向しか見ておらず、回転方向が抜けていた。

## 直した所（`_v6_gear.scad`）

| | 何 | 効き |
|---|---|---|
| ① | 皿の穴を**二面幅つき**にした（φ8.70 ∩ 幅 6.70） | 回してぶつける検査が 5 度 0.5633 / 20 度 3.1947 / 45 度 7.1057mm³ で反応。**乾組みのまま「回ること」が確かめられる** |
| ② | 穴の底（z 20.79）に**堀** φ9.70 × 0.40 を彫った | 走った未硬化レジンをここで止める。スカートと殻の穴の隙間 0.25 へ回らせない（裁定の条件 ①） |
| ③ | echo ⑤ に**皿とハブの二面幅の遊び**を足した | 隠さないため。下の数字のとおり増える |
| ④ | echo ⑧b に**帯の在庫と育ちの取り分**を足した | 裁定 #1 の依頼 |

## 🔴 遊びは 8.07 → **9.12 度**になった（RSS 4.70 → 4.82）

二面幅を入れた代償である。柱の角が溝の壁に当たるまでの **1.05 度**が鎖に 1 つ増えた。

    噛み合い 2 か所 3.93 ＋ 中継の軸受け 2.18 ＋ つまみ 1.09 ＋ 読み取り 0.87
      ＋ 皿とハブの二面幅 1.05 = 最悪 9.12 度（RSS 4.82 度）

**決定は変えない。**ファームのデッドバンド 2% ＝ 6.2 度に対し、RSS 4.82 度はまだ下にある。
最悪 9.12 度は 2.94% で、デッドバンドを 0.94 ポイント超える。ばね腕を足しても
つまみ 1.09 ＋ 読み取り 0.87 ＋ 二面幅 1.05 は残るので、詰められるのは噛み合いと中継の分だけである。

## 検査の現在地（2026-09-13 13:28）

**実体 16 本が空／0・対照 20 本が全部反応・ERROR 0。**
`python hardware/frozen/v6/tools/_v6_gear_chk.py` で 1 本ずつ回る。

---

# 2026-09-13 — リードスイッチ用の磁石は**皿の裏**に決めた（機構担当）

電源を切るリードスイッチ（`POWER.md` 2 章「つまみを回し切ると EN を GND に落として完全停止」）の
磁石を、つまみと一緒に回る物のどこに載せるか。運び手の候補は 皿の裏・溝の中・ハブ の 3 つだった。

## 皿の肉を実測した

輪（幅 0.20）で切って 体積 ÷ 面積 で読んだ平均の厚み。

| r | 6.0 | 8.0 | 11.0 | 11.5 | 12.0 | 12.7 | 13.0 | 13.5 | 14.0 |
|---|---|---|---|---|---|---|---|---|---|
| 肉 | 1.698 | 1.698 | 1.698 | 1.788 | 1.968 | 2.219 | 2.327 | 2.492 | 2.497 |

⚠ 「r 11.25 より内側は 2.5 あるはず」は誤り。`KN_SINK` の引き算は中実の円錐なので、
**中心まで 0.8 掘れている**（だから皿の形になる）。

## 手持ちの磁石は 2 種類とも入らなかった

v5 のリード用は **φ6.0 × 2.2**（`knob_v5.scad` の `MAG2_PART_D` / `MAG2_T`。横倒しで、
掴んでいるのは `MAG2_SLOT_W` 1.97 の溝）、AS5600 用は **φ4 × 2**。

| 候補 | 使える枠 | φ6×2.2 | φ4×2 |
|---|---|---|---|
| 皿の裏（埋め込み） | 幅 5.75・深さ 1.4 まで | ✗ | ✗ |
| 溝の中 | 幅 2.2・出しろ 0.9・底 22.0（内面まで 1.00） | ✗ | ✗ |
| ハブ | 中継の歯先まで 6.575 ⇒ 芯が柱 φ8.6 の中に入る。Z も下 0.55・上 0.20 | ✗ | ✗ |

## 🔒 決定

**皿の裏に φ4 × 1 を埋める。**芯 r8.4・止めピンから +90 度・深さ 1.0・天井 0.698。
磁石 ↔ 殻の内面は 2.05。留め方は接着（`PRINT.md`「磁石は圧入にならず抜ける」）で、
A5 の UV レジンと同じ工程に乗せる。⚠ 上限は φ4 × 1.35。**φ4 × 1.5 は入らない**（1.5 + 0.3 > 1.698）。

⭐ **角度が自由になるのが決め手だった。**「止めピンから +10 度」は磁石が溝を走る場合の縛りで、
埋め込むなら溝を通らないので角度はどこでもよい。+10 度ではピンとの中心間が 2.57 しか取れず
φ4 が置けなかったが、+90 度なら弧で 13.2 離れる。

溝の中（φ2 × 0.9 以下）は可動域を 10 度食い、島を 28 → 20 度に狭めないと戻らない。
止めピンを磁石にする案は、突き当たりの衝撃を毎回受ける（NdFeB は脆い）。どちらも採らない。

⚠ 距離 2.05 が足りるかは計算では決めない。`knob_v5` の向きの 🔒 が「実測して差し戻された」記録である以上、
**初回の実機でテスタを当てて「鳴る箇所が 1 つ」を見る**（`main.cpp:99〜111` の項目に 1 行）。
足りなければ上げる余地は皿ではなくリードの側（殻の内面から手前へ出す）にある。

## 検算

刷る向き（表をプレート側）で `_stl_preflight.py`: 底 Z=0・**宙から始まる肉 0**・0.30 未満の面なし。
当たりは `chk_mag2_shell` 空／`chk_mag2_pin` 0.0000、対照 22（磁石を 0.30 沈める）1.5827mm³・
対照 23（磁石を止めピンの角度へ置く）12.5504mm³ で反応。

---

# 2026-09-13 — MuJoCo で歯車を回そうとして駄目だった記録

ユーザーの依頼「ギアがちゃんと回るのを物理シミュレーションで動画で見たい」に対して試した。
**動いていない。**再開する人が同じ所で止まらないよう、試した順と理由をそのまま残す。

⚠ この記録は一度失われかけた。模型は `hardware/_tmp_sim/v6_gear/（消した・現物は frozen/v6/sim2d/ の 2D 模型だけ）` に置き、
理由は `build.py` の冒頭にしか書いていなかった。**1 か所にしか無い記録は消える。**

## 前提（記録より）

MuJoCo は pip で入る（3.12.0 で確認）。**1 単位 1cm**・`multiccd` 必須・**凹 STL 不可**。

## 試した順と、駄目だった理由

| | やったこと | 結果 |
|---|---|---|
| 1 | 歯 1 枚を丸ごと凸メッシュにする | 🔴 インボリュートの歯元が凹なので**凸包が太る**。測ると z28 で **0.1752mm**・z22 で 0.0903mm。設計のバックラッシュの半分 **0.12** を超えるので **t=0 で歯が食い込み**、0.0094 秒で QACC が NaN |
| 2 | 歯を放射方向に 8 枚の帯（台形）へ割る | 🔴 台形は凸なので食い込みは消えた（t=0 の接触 0）。しかし**同じ歯の複数の板が同時に当たって拘束が競合**し、歯 1 枚分（12.86 度）回った所で解けなくなる。`Linesearch objective is not convex` が連発 |
| 3 | **歯を中心線で 2 つに割る** | ✅ **凸包の太り 0.0000**（＝実物の歯形と一致）。geom も 627 → **159**。t=0 の接触 0 |
| 4 | つまみをトルク（motor）で押す | 🔴 慣性が小さく加速しすぎて歯が飛ぶ。数千度回る |
| 5 | つまみを角度（position）で駆動 | 🔴 歯が噛んだ瞬間にアクチュエータが暴れる |
| 6 | **つまみを運動学で直接与える**（毎ステップ qpos/qvel を書く） | ✅ つまみは狙いどおり（32→64→96→128→160 度）。🔴 **中継と読み取りが付いてこない**。0.13 秒で DOF 1 が NaN |

## ⭐ 切り分けの結果 ── 原因は接触の解け方

**接触を切って同じ入力を与えると、つまみは最後まで安定して回る**（160 度の指示に対し 131.72 度・暴れなし）。
接触を入れると **0.201 秒**（つまみ 16 度 ＝ 歯 1 枚分をわずかに超えた所）で壊れる。
⇒ **駆動でも単位でも慣性でもなく、歯どうしの接触である。**

## 使った設定（最後の版）

    timestep 0.0002 ／ gravity 0 ／ integrator implicitfast ／ cone elliptic
    iterations 150 ／ ls_iterations 50 ／ tolerance 1e-10 ／ multiccd enable
    歯: condim 1（摩擦なし）／ solref "0.004 1" ／ solimp "0.95 0.995 0.0005"
    接触の組み合わせは contype/conaffinity で つまみ↔中継 と 中継↔読み取り だけに絞った
    慣性は実物の 100 倍（RHO 1.15e-3 → 1.15e-1 kg/cm³）。
      ⚠ 接触の剛性に対して小さすぎて解けないための処置で、**力の絶対値は読めない模型**になる

NaN が出た時刻は 0.0094 / 0.1306 / 0.201 / 0.2797 / 0.3868 / 0.4501 / 1.7372 秒。
**刻みを細かくしても落ちる時刻が動くだけで、落ちること自体は変わらない。**

## 再開するなら

**手順 3（歯を中心線で 2 つに割る）と手順 6（運動学で駆動）から始める。**そこまでは正しい。
残っているのは「中継と読み取りが接触で付いてこない」の 1 点だけで、
触る先は接触のパラメータ（solref / solimp / condim / margin）と、
場合によっては歯の当たりを 1 か所に絞る工夫である。

⚠ **代わりに出した物**: 運動学の動画（`part="gspin"` を 24 コマ焼いて往復させた GIF）。
歯形も歯数も中心距離も本物だが、**物理ではない**。
通り道に物が無いことは当たり検査の掃引（歯 1 枚分を 0.5 度刻み・可動域を 20 度刻み）で別に取ってある。

---

# 2026-09-13 — 🔒 潤滑は **シリコングリスを軸受け面に塗る**（v4/v5 と同じ）

## 🔴 取り消した判断を 2 つ、理由ごと残す

| いつ | 書いたこと | なぜ間違いだったか |
|---|---|---|
| 1 回目 | **「グリスは塗らない」** | 順番が逆だった。根拠が ①受け皿が入らない ②唇が立たない ③力が小さい の順で、**「入らないから要らない」**になっていた。⇒ ①②は「入れられるか」の答えで、「要るか」の答えではない。**しかも最初に「グリスを塗ると思いますが」と言ったのはユーザーで、私はそれを制約で潰した** |
| 2 回目 | **「PTFE の乾性被膜を使う」** | 🔴 **塗る場所を間違えていた。**私は**歯のまわり**にグリスを保持する方法を探し、入らないので「垂れない物」を外から探した。**v4 も v5 も歯のまわりには塗っていない。**⇒ 一般論を調べる前に、リポジトリの実績を読むべきだった |

## ⭐ 実績（これが正）

    hardware/frozen/v1-v4/knob_v4.scad:46    半月の軸受け面にはシリコングリスを塗る。
    hardware/frozen/v1-v4/knob_v4.scad:1001  シリコングリスを塗るのはこの2面。
    hardware/parts/knob_v5.scad:203   🔒 持ち手の裏は島の上面に乗る（重さの受け）。グリスはこの面

🔒 **グリスは「軸受け面」に塗る。向かい合った 2 面のあいだの薄い膜である。**
⇒ **膜はその 2 面が保持する。囲いも唇も床も、最初から要らない。**
`GRIP_GAP = 0` ── **隙間ゼロで面が乗っている。そこがグリスの座である。**

⚠ そして v5 は**現に良い手ざわりで動いている**。設計は実績に勝てない。

## 🔒 v6 の軸受け面（塗る所）

### ① つまみ ── **ここが手ざわりを決める**

| | |
|---|---|
| 筒の面 | スカート **φ12.60** ↔ 殻の穴 φ12.85 ／ 長さ 2.25 ／ 隙間 0.25（半径 0.125） ／ **面積 89.1mm²** |
| 平らな面 | 皿の裏 23.05 ↔ 殻の顔 23.00 ／ 隙間 **0.05** ← v5 の `GRIP_GAP = 0` に当たる面 |

⭐ **摩擦のトルクは面の半径に比例する。**つまみの筒は半径 6.30 で、しかも**指が直に回す所**である。
中継（半径 1.50）と読み取り（3.50）は歯車を介して伝わるので、つまみ換算では小さい。
⇒ **手ざわりを作っているのはこの面である。**

### ② 中継

| | |
|---|---|
| 筒の面 | 穴 φ3.25 ↔ 軸 φ3.00 ／ 長さ 1.70 ／ 隙間 0.25 ／ **面積 16.0mm²** |
| 平らな面 | 上の鍔の天面 20.95 ↔ 前の壁の内面 21.00 ／ 隙間 0.05 |

### ③ 読み取り

| | |
|---|---|
| 筒の面 | ロータ **φ7.00** ↔ ブラケットの穴 φ7.20 ／ 長さ 6.30 ／ 隙間 0.20 ／ **面積 138.5mm²** |
| 平らな面 | ロータの鍔 φ8.10 が筒の天面 15.10 に**乗っている**（荷重を受ける唯一の面）／ **面積 10.8mm²** |

## 塗る工程（組む順番のどこで塗るか）

**全部、組む前に部品へ塗れる。**組んだ後に届く面は 1 つも無い。

| 工程 | 塗る面 |
|---|---|
| A1 の前 | 皿のスカートの外周と、皿の裏 |
| A5 の前 | 中継の穴と、壁から下りた軸 |
| B2 の前 | ロータの胴と鍔、ブラケットの穴と筒の天面 |

## ⚠ 歯面には塗らない

**v4 も v5 も歯には塗っていない。**そして v6 で歯が伝えるのは磁石 φ4×2（0.19g）を回す分だけで、
手ざわりへの寄与は上の軸受け 3 つに比べて小さい。⇒ **軸受けだけに塗る。**
🔴 実機で歯の当たりがざらつくなら、そのとき歯面を足す（後から塗れないので、その時は組み直し）。

## ⬜ 残っていること

**どのシリコングリスか。**v4/v5 の記録に製品名が無い。⇒ **手持ちがあるか**を先に確かめる
（`docs/` に購入の記録が無いので、v4/v5 の時点で持っていた可能性が高い）。
無ければ買い物に 1 行足す。**硬化済みレジンに使えることだけは確かめる。**

## 参考: 一度書いた「囲いが入らない」の数字（もう使わない）

歯のまわりに溜める必要が無くなったので、この数字は効かない。
帯 2.15 ／ 歯車 1.40 ／ 上 0.20 ／ 下 0.55（中継の鍔を引いて 0.40）／ 平たい肉の下限 0.42。

## ⚠ 一緒に記録する: 上 2 枚の板は誰が留めているか

分解図（`part="ghold"`）の薄い板は**高さの基準**であって実物ではない。

| | 実物 | 留め方 | 持ち主 |
|---|---|---|---|
| 上の板 | **前の殻**そのもの | 殻の合わせ（z 10） | デザイン担当 |
| 下の板 | **ReSpeaker** | 柱 2 本に **M2 貫通＋ナット** | デザイン担当（`POSTS[4]` `POSTS[5]`） |

## 🔒 この件から出た規則

> **機構を選ぶときは、その機構が連れてくる物（潤滑・逃げ・組む順・戻せるか）を同時に数える。**
> **後から数えると、答えが制約から出る。**

> **一般論を調べる前に、リポジトリの実績を読む。**`knob_v5.scad:203` には 🔒 が付いていた。

⚠ 歯車 3 枚は 2026-09-13 にユーザーが決めたが、**潤滑という語はこの日まで docs のどこにも 1 度も出ていない。**

---

# 2026-09-13 — 🔒 つまみの抜け止めを **壁の内側へ移した**（裁定 #2 の取り消し）

## ユーザーの言葉が要求である

> だから溶着が必要なら必要でいいんですが、上からみて「接着してるな～」って分かるようなものは、
> ネジの頭を出すより悪いでしょ？

⇒ **接着そのものは許されている。禁じられたのは「顔から接着に見えること」である。**
裁定 #2 の栓は φ11 の抜きの**真下**にあり、**穴の底がそのまま栓の天面**だった。

## 逃げ場を 1 つずつ潰した記録（＝なぜ「移す」しか残らないか）

| 案 | 落ちた理由 |
|---|---|
| ねじ＋埋めナット | スカートの肉は内 φ8.70／外 φ12.60 の輪で、厚みは半径方向に 1.95。M2 のナット（二面幅 3.2・対角 3.7）がどこにも収まらない |
| 皿の裏の外周（r 5.5〜14.25・顔から見えない） | そこへ届くのはハブの鍔だが、皿とハブのあいだには**前の壁そのもの**がある。ハブは壁より内側から出られない |
| φ11 の穴を塞ぐ膜／別部品の蓋 | 穴は 🔒 顔の意匠。塞げば別の見た目になり、蓋なら継ぎ目が見える |
| 栓を小さくして深い所に置く（φ3 の注ぎ口） | UV が φ3 の口から半径 5.25 まで届かず、**影に未硬化が残る**（裁定 #2 の条件 ②） |

## 🔒 決めたこと — 接着面を **前の壁の内側**へ 2 面

| | 場所 | 面積 | 効き方 |
|---|---|---|---|
| **A** | スカートの下端の輪（z 20.80・穴の縁 → φ11.80）が**歯車の天面**に乗る | **57.40mm²** | 引っ張り。主 |
| **B** | 柱と穴の隙間（片側 0.05・z 20.80 → 21.80） | **26.36mm²** | せん断。従 |
| | | **83.76mm²** | 裁定 #2 の栓は柱の天面 **50.51mm²** の 1 面だけだった |

面積は `_v6_knob_hold.scad` の `a_bond_rim` / `a_bond_bore` を刷って体積から出した（計算ではない）。

## 🔒 はみ出しの行き先を 2 つ作った（これが本体）

| 逃げ | 形 | 容積 | 何を防ぐか |
|---|---|---|---|
| 外へ | スカートの下端を φ12.60 → **φ11.80** に細くする（z 20.80〜21.00） | 4.07mm³ | 軸受けの隙間（片側 0.125）へ上がって**つまみが固まる**のを防ぐ |
| 上へ | 穴の中に毛管止めの溝 φ9.70 × 0.30（z 21.80〜22.10） | 4.74mm³ | 呼び込みの円錐＝**φ11 から見える所**へ届くのを防ぐ |

🔴 細りの上端は壁の内面 21.00 ちょうど。**軸受けは 1 つも短くならない**（`chk_uc_brg` = 0.0000・対照 27 が 3.06mm³）。
🔴 溝の天井 22.10 と円錐の底 22.59 のあいだに残る内向きの庇は **0.49**。
   最初 22.30 に置いたら庇が 0.29 になり、`_stl_preflight` が「平たい肉 0.29（下限 0.42）」を 2 か所で出した。0.20 下げた。

## 🔒 接着剤は **2 液エポキシ**。UV レジンではない

裁定 #2 が UV レジンを選んだ理由は「①手持ちが確実 ②硬化のタイミングを選べる」だった。
**場所を移した結果、①の前提が消えた:**

- A も B も壁の内側の**閉じた隙間**で、**UV が 1 本も入らない**。
- 瞬間接着剤が落ちた理由は「回るか確かめる前に固まる」で、これは CA 固有の欠点。
  **エポキシには可使時間があるので、裁定 #2 の手順 2「回ることを確かめる」がそのまま残る。**

⇒ 買い物に 1 行足す（磁石・リードと同じ 1 回の注文に入れる）。

## φ11 の穴から何が見えるか（`part="gface"` で見られる）

**皿の呼び込みの円錐（皿の印刷面）と、柱の天面（ハブの印刷面）の 2 つだけ。**
柱のまわりに嵌め合いの隙間 0.05 の線が 1 本残るが、これは**穴**であって接着剤ではない。
接着剤はその線の **0.80 下**（溝 21.80）で止まっている。

## グリスとの両立（順番で解く）

接着面にグリスが回ると接着しない。⇒ **細りの段（z 21.00）が塗り分けの目印**である。
グリスはスカートの外面の**段より上**だけ。下端 0.20 と穴の中は塗らない。
🔴 段差 0.40 は手で触って分かる。[[user-hand-accuracy]] の 0.3 で足りるように付けた。

## 検査（`_v6_gear_chk.py`）

| | |
|---|---|
| `chk_bond_cone` | 空 ＝ 接着剤は円錐（＝顔から見える所）に届かない。対照 21（溝が無い場合）1.65mm³ |
| `chk_bond_brg` | 空 ＝ 接着剤は軸受けの隙間に届かない。対照 28（細りが無い場合）8.98mm³ |
| `chk_bond_hub` | 12.24mm³ ＝ 接着剤はハブに本当に向き合っている（**反応するのが正**） |
| `chk_uc_brg` | 0.0000 ＝ 細りは軸受けの帯を食っていない。対照 27（細りを 0.30 上へ）3.06mm³ |

---

# 2026-09-13 — 🔒 ギアボックス（帯 4.45）。**まだ本体の .scad に入っていない**

## ⚠ どこにあるか

| ファイル | 状態 |
|---|---|
| `hardware/frozen/v6/_tmp_gearbox_proposal.scad` | **提案・未実装。**形と検査はここにある。本体を include して読むだけ |
| `hardware/frozen/v6/_v6_gear.scad` | 🔴 **入っていない。**1 文字も触っていない |
| `hardware/frozen/v6/_v6_portrait.scad` | 🔴 **入っていない。**1 文字も触っていない |

⇒ 入れるときは 1 回でまとめて入れ、`_tmp_gearbox_proposal.scad` は消す。

## なぜ囲いが要るのか（経緯）

ユーザー「**軸受け 3 つには塗るし、歯車にだって塗らないとだめでしょ。だから、ReSpeaker とつまみの間には
絶対に間隔が必要。ギアボックスだよ・・・そんなのどんな機械だってあるでしょ・・・。**」
「**普通にギアボックスは大きいでしょ。**」

🔴 それまでの議論は「2.15 の帯に囲いが入るか」だった。**問いが違った。**囲いは要る物なので、
入らないなら帯を広げる。⇒ **「入る範囲で我慢する」をやめた結果、構造の側（XIAO 直付け・電池を別室へ）が動いた。**

## 🔒 帯 = 4.45（天井から下へ）

| z | |
|---|---|
| **21.00** | 天井 ＝ 前の壁の内面 `WALL_IN`。**そのまま使う。新しい肉は 0** |
| 21.00 → **19.00** | 箱の内のり **2.00**（中継 1.70 ＋ 遊び 0.30） |
| 19.00 → **17.50** | 床の肉 **1.50** |
| 17.50 → **16.55** | 床の下面 ↔ 板の面 **0.95** |
| **16.55** | ReSpeaker の板の面 ⇒ `RS_Z = 14.70`（いま 17.0 から **2.30 下げ**） |

### 内のり 2.00 の割り付け

| 部品 | z | 上 | 下 |
|---|---|---|---|
| つまみのハブ | 19.40 〜 20.80 | 0.20（抜け止めの面） | 0.40 |
| 中継（鍔込み） | 19.25 〜 20.95 | **0.05（倒れ止めの当て面）** | **0.25（新しい当て面＝床）** |
| 読み取り | 19.30 〜 20.50 | ⚠ 下の 🔴 参照 | 床を開ける |

🔴 **歯車群の厚みは 1.40 ではなく 1.70。**STL を刷って Z の両端を測った値で、中継の上下の鍔が最外。
1.40 は歯幅であって、帯に要る値ではない。

### 各項目の根拠

| 値 | なぜその値か |
|---|---|
| 内のりの遊び 0.30 | 前の殻の中の 1 寸法 `TOL_SHELL` 0.20 ＋ 回るための逃げ 0.10。天井も床も前の殻の持ち物なので 0.20 が乗る |
| 床の肉 1.50 | 荷重ではない。43 × 19 の**下向きの大平面**であること、**上面が中継のスラスト面を兼ねる**こと（たわむと遊びが変わる）、下面の垂れがマイクとの隙間を食うこと |
| 床の下面 ↔ 板の面 0.95 | 鎖の出会い `TOL_XS` 0.55 ＋ 下向き面の出来 0.20 ＋ 余裕 0.20 |

## 平面の形 — 3 円の凸包

| | 芯 | 歯先 r | 逃げ | 壁の内面 r | 外面 r |
|---|---|---|---|---|---|
| つまみ | (24.00, 30.04) | 7.425 | 0.30 | 7.725 | 8.725 |
| 中継 | **(33.003, 21.368)** | 5.925 | 0.30 | 6.225 | 7.225 |
| 読み取り | (38.20, 10.00) | 7.425 | **0.85** | 8.275 | 9.275 |

側壁の肉 **1.00**、高さ 2.00（床の上面 19.00 → 天井 21.00）。床の外形は外面の凸包。
🔴 読み取りだけ逃げが 0.85（鎖の出会い 0.55 ＋ 0.30）。**半径方向にも鎖は出会う。**

## 🔒 読み取りの下は床を開ける（φ15.70）

| | |
|---|---|
| ① | 読み取りだけ**スタックの鎖**。床（前の殻）で軸方向を決めると上下に 0.65 ずつ要り、内のりが 2.00 → 2.50（帯 ＋0.50） |
| ② | 読み取りの歯車は**ロータに圧入**され、**ロータごと下から入る。**歯先 φ14.85 は小さい穴を通れない |
| ③ | 口の真下はブラケットと板。**マイク U4 まで 8.18 離れている**（下の表） |

⇒ **囲いを半分にしたのではない。鎖が違う物を前の殻で押さえない、という線引き。**

## マイクとの関係（実測・箱の外面から）

| | 出っ張り | 箱の外面から |
|---|---|---|
| マイク U4（左） | 1.28 | **8.18** |
| マイク U5（右） | 1.28 | 39.47 |
| スイッチ K1 | 2.58 | 17.10 |
| スイッチ K2 | 2.58 | 11.23 |

⇒ **箱はどのマイクにもスイッチにも被っていない。**下向きの口は読み取りの φ15.70 ただ 1 つで、真下はブラケット。
🔴 マイクは 🔴 `RESPEAKER-LITE.md:190`「塞いだら音が死ぬ場所」。**封で守るのではなく、位置で守っている。**

## 軸受け 3 つ

| | いま受けている物 | 箱ができて受ける物 |
|---|---|---|
| つまみ | 半径: スカート φ12.60 ↔ 壁の穴 φ12.85（**89.1mm²**）／軸方向: 皿の裏 ↔ 壁の外面 0.05・歯車の天面 ↔ 壁の内面 0.20 | **変わらない。**つまみは壁そのものに受けられている |
| 中継 | 半径: 穴 φ3.25 ↔ 壁から生えた止まり軸 φ3.00（**16.0mm²**）／軸方向: **上の鍔だけ。下は何も無く、0.40 落ちて ReSpeaker に触る** | 🔴 **床が下の当て面になる。箱が増やす軸受けの仕事はこれ 1 つだけ** |
| 読み取り | 半径: ロータ φ7.00 ↔ ブラケットの筒 φ7.20（**138.5mm²**）／軸方向: ロータの鍔が筒の天面に乗る（**ここでエアギャップ 1.10 が決まる**） | **変わらない。箱が受けてはいけない**（受けるとエアギャップが前の殻の鎖へ移る） |

## 🔒 グリス — 塗る面

| | |
|---|---|
| 軸受け | つまみのスカート 89.1mm² ／ 中継の穴と軸 16.0mm² ／ ロータと筒 138.5mm² |
| 歯面 | つまみ ↔ 中継 ／ 中継 ↔ 読み取り |
| スラスト面 | 中継の上の鍔 ↔ 天井 ／ **中継の下の鍔 ↔ 床（新設）** ／ つまみの歯車の天面 ↔ 天井 |

溜まりは**床の上面に浅く彫る**（遊び 0.30 の中に入るので帯は増えない）。

## 組む順（顔を下にして）

```
A1 皿を台へ → 前の殻を被せる
A2 ハブを箱の中へ入れて、柱を皿の穴へ挿す        ← 床がまだ無いから入る
A3 回ることを確かめる
A4 中継を止まり軸へ落とす                      🔴 いまの A6 が繰り上がる
A5 床の板を被せて留める                        ← ここで箱が閉じる
A6 以降スタック。読み取りはロータごと下から φ15.70 の口を通って入り、噛む
```

🔴 **床は別部品。**箱が前の殻と一体だと A2 で歯車が入らない。
留め方: 側壁に段（受け）を作って**下から M2 × 2**。🔒 樹脂にねじは切らず、
ナットは**側壁の外面に横向きの口**で埋める（🔒 ねじの軸と直交する面）。座標は未定。

## 検査（`_tmp_gearbox_proposal.scad` で回した）

```
--- 実体（空 か 0 が正）---
  つまみのハブ            空
  中継                  空
  読み取り               空
  ロータとブラケット         空
  ReSpeaker の板        空
  マイク 2 つとスイッチ 2 つ  空
  天井（前の壁）           0.0000 mm3   ← 箱の天面が天井に面で乗っている
--- 対照（反応が正）---
  中継を 0.30 上げ→天井     18.5816 mm3
  中継を 0.30 下げ→床       3.4750 mm3
  読み取りを X へ 1.20→側壁   0.7086 mm3
  板を 1.20 上げ→床        105.2273 mm3
  マイクを Y へ 16→つまみの下  2.8658 mm3
```

## 🔴 いま既に壊れている（ギアボックスとは無関係）

**読み取りの歯車の天面 20.50 ↔ 天井 21.00 = 0.50 ＜ 鎖の出会い `TOL_XS` 0.55。**
⇒ 公差が悪い方へ出た時点で、読み取りの歯車が前の壁に触る。**箱を入れなくても、いまそうなっている。**
直し: 読み取りの芯 (38.20, 10.00) に **r 8.30 × 深さ 0.15** を天井へ彫る ⇒ 0.65。壁 2.00 の残り 1.85。

## 公差の置き場所（今日決まった規則）

つまみは前の壁を貫いている。皿は殻の外・歯車は殻の内で、ハブは必ず前の殻からぶら下がる。
⇒ **殻の鎖とスタックの鎖は、つまみと ReSpeaker のあいだで必ず 1 回出会う。**
床をどちらの側に付けても **0.55 は消えず、出会う場所が移るだけ**である。

🔒 **避けられない公差は、どちらの壊れ方が軽いかで置く場所を選ぶ。**

| 0.55 が出会う場所 | 当たったとき |
|---|---|
| **床の下面 ↔ 板の面（採用）** | 音が死ぬ。**歯車は回る** |
| 歯車の底 ↔ 床 | 床が歯車を押し上げ、倒れ止めの 0.05 の面が挟む面に変わる ⇒ **回らなくなる** |

## ⬜ 決まっていない

- **つまみの抜け止め** … 調停役の栓の裁定（#2）は**取り消されたまま**。皿まわりの寸法はギアボックスで変わる。
  ⚠ この文書の 1 つ上の節「つまみの抜け止めを壁の内側へ移した」は、**`_v6_gear.scad` に入っていて検査も通っている**が、
  皿の Z（`KN_DISHZ` 23.05）と歯車の Z が動けば、接着面 A（スカートの下端の輪）と毛管止めの溝の Z は取り直しになる。
  ⇒ **ギアボックスが先。**
- **上から押せる機構** … 同上
- **印刷の向き**
