n416/katanori/docs/MEDIATOR-V6-HANDOFF.md

# 調停役の任務書（筐体 v6）

> ⛔ **凍結（2026-09-14）。v6 縦置き案の任務書。現行の v6.1 には当てはまらない（[CASE-V61N.md](CASE-V61N.md)）。**

**このファイルを読んだセッションが、katanori 筐体 v6 の「調停役」になります。**
新しいセッションを開いて「`docs/MEDIATOR-V6-HANDOFF.md` を読んで調停役を引き継いで」と言えば立ち上がります。

🔒 **モデルは Fable 5.1**（ユーザー指定・2026-09-13）。開くときに選んでください。

## 任務（ユーザーの原文）

> 調停役の任務は、薄型のデザインを守りながら、どう落とし込むか考える事です。
> 基板の設計についても、デザインについても、中間に立った視点でやってほしい

---

## 1. いま動いているスレッド

| | 課題 | 持ち物 |
|---|---|---|
| デザイン担当 | 薄さと「携帯機に見える形」 | `hardware/frozen/v6/_v6_portrait.scad`・`docs/CASE-V6-PLAN.md` |
| 回路担当（「ケーブル取り回しの問題」） | 中継基板が引けること | `hardware/frozen/v6/pcb/` |
| 機構担当（「機構担当の引き継ぎ」） | つまみが回って AS5600 が読むこと | `hardware/frozen/v6/_v6_gear.scad`・`docs/MECH-V6-HANDOFF.md` |
| **調停役（あなた）** | **薄さを守りながら 3 つを落とし込む** | この文書 |

3 つはそれぞれ自分の課題に最適化します。**衝突したときに、どこを譲るかを決めるのがあなたです。**
ユーザーに投げ返す前に、まず自分の案を出してください。

## 2. まず読む

1. `docs/CASE-V6-PLAN.md` … v6 の現在地（外形・Z の鎖・板の天井の地図・潰した当たりの記録）
2. `docs/MECH-V6-HANDOFF.md` … 機構側の到達点と、筐体・板への要求
3. `hardware/frozen/v6/_v6_portrait.scad` / `hardware/frozen/v6/_v6_gear.scad` … 形の正
4. `docs/POWER.md` / `docs/RESPEAKER-LITE.md` / `docs/KNOB-ENCODER.md`

## 3. 🔒 触れない前提（ユーザーが決めたもの）

- 外形 **48 × 88 × 23**。丸み無し。幅 48 は「これ以上広げるとポータブル端末に見えない」で 2 度こだわられた
- つまみの皿 **φ28.5・抜き φ11・厚み 2.5・面から 2.5 出る**。皿そのものがつまみ
- 背面にスピーカーを入れて厚み 31 にした案は「一気に箱感が出た」で却下済み
- 中継基板 **44 × 81.2**、歯車 3 枚、読み取りの芯 板 (36.2, 7)
- 1:1（AS5600 は 1 回転 0〜4095 の絶対角）
- 光造形で自分で刷る。軽量化は v7

## 4. いま調停が要る所

### 🔴 A. 機構が筐体の顔を削りにきている（未反映）

機構側の要求 5 件のうち、薄さ・見た目に効くのは 2 つです。

| | 機構の言い分 | デザインの言い分 |
|---|---|---|
| 軸穴 φ9.0 → **φ12.85** | 皿の抜き φ11 に届く筒が要る。いまは皿と歯車を繋ぐ実体が 0mm³ | 皿 r14.25 の下に隠れるので**見た目には出ない**。反対の理由は弱い |
| 前の面に **深さ 1.0 の溝**（r8.6〜10.6・島 28 度） | 回り止め。無いと 360 度回って 0%↔100% が飛ぶ | **残り肉が 1.0 になる。**大きい平面は板が厚く出る（`docs/PRINT.md`）・沈みが顔に出る恐れ |

ほかに 歯車の平面を 19.05〜20.85（幅 1.8）→ 19.40〜20.80（幅 1.4）、中継の軸 φ3.0 × 1.85、皿の裏 23.30 → 23.05。

### 🔴 B. 機構が板の面積を取りにきている（回路へ未伝達）

1. 立入禁止を 6×6 の角 → 板 (36.2, 7) を芯とする **φ10.2 の円・板の面から 11.3**
2. ブラケットの座: 板 X 35.4〜43.7・Y 0〜6.7 に背 1.5 超の部品を置かない。**右下の M2 で共締め**
3. AS5600 の足跡は**リード込み 4.9 × 6.2**（いまの 4.9 × 3.9 は胴だけ）

板は 44 × 81.2（切り欠き後 3,491mm²）に 7 つの口と電源回路を全部載せた状態で、余白がありません。

### 🔴 C. つまみが抜ける（機構側で作業中）

いまの抜け止めは**圧入だけ**です。ユーザー「スポスポ抜けるじゃん。キミらの機構っていつもそう」。
ねじ／形での確実な保持が要りますが、それは厚みか顔のどちらかを食います。**どちらを食わせるかが調停です。**

### ⬜ D. 決まっていない数字

- 戻したときの遊び **8.07 度**（RSS 4.70 度）を許すか … 機構担当が決める
- スライドスイッチのストローク **2.3** … 📄 ではなく回路担当が PDF のベクタを measure した値
- 磁石とチップの隙間 **1.10 ±0.41**（AS5600 の許容 0.5〜3）
- ReSpeaker Lite の 3V3 の余力 … 非公開・実機で見るしかない

## 5. やり方の決まり

- 🔴 **`hardware/frozen/v6/_v6_portrait.scad` と `hardware/frozen/v6/_v6_gear.scad` を編集しない。**持ち主に文で要求する
- 🔴 **ユーザーへ判断を上げる前に、自分の案を 1 つ出す。**選択肢を並べて投げない。1 返答で迫る判断は 1 つまで
- 🔴 数字で言う。当たりは `--backend=manifold`、**エラー／空／数値の 3 分岐**、対照を毎回 1 本
- 🔴 絵を出す。座標の羅列で判断を求めない
- 🔴 ⬜ を積まない。記録を掘る → 無ければ仮定を明記して進める
- 🔴 ユーザーに測定・写真・ノギスを頼まない。試し刷りを軽々に提案しない（1 時間使わせる提案です）
- 🔴 「打ち切る」「やめる」を選択肢に混ぜない。やめるかはユーザーが決める

---

# 裁定 #1 — 機構の 5 件は全部通す。代わりに「育ち」を勘定に入れる（2026-09-13・調停役）

⚠ モデルは Fable 5.1 の指定だったが、この回は **Opus 5** で回っている。数字は全部この文書の中で
追えるようにしてあるので、引き継ぐときに読み直せば足りる。

## 0. まず自分で数え直した

機構の 14 本＋対照 7 本を `python hardware/frozen/v6/tools/_v6_gear_chk.py` でそのまま回した。
**実体 15 本すべて 空 か 0.0000・対照 7 本すべて反応。**報告と一致する（ERROR 0 本）。
その上で、**誰も数えていない数が 1 つある**と分かった（3 章）。

## 1. 🔴 A-1 軸穴 φ9.0 → φ12.85 … **通す**

デザイン側の反対理由は元から弱かったが、数で閉じておく。

| | |
|---|---|
| 皿の縁 r14.25 ↔ 穴の縁 r6.425 | **半径で 7.825 隠れる。**顔には 1mm も出ない |
| 穴の上端 Y 36.465 ↔ 窓の下端 Y 50.13 | **13.67 空く** |
| 刷り方 | **貫通穴**。`docs/PRINT.md`「貫通穴はきれいに抜けている」＝ この機で唯一そのまま出る形 |

⇒ 薄さにも顔にも刷りやすさにも 1 つも払っていない。**議論する所ではなかった。**

## 2. 🔴 A-2 前の面に深さ 1.0 の溝 … **通す。ただしデザイン側の反対理由は向きが逆だった**

デザインの言い分は「残り肉が 1.0 になる・大きい平面は板が厚く出る・沈みが顔に出る」。
**この機では逆である。**

1. **育つのは内面**（`docs/PRINT.md`「育つのは内面なので、天板は同じ +0.9 で六角ナットの
   ポケットと裾を飲んでいる」）。溝はプレート側＝顔の側に開くので、**残り肉は 1.0 のまま、
   あるいは育った分だけ厚くなる。薄くなる向きには動かない。**
2. 「大きい平面が厚く出る」のは接地面積の話で、溝は**平面を 111mm² 減らす**（増やさない）。
   前の殻の初層は溝込みで 3,142mm²（実測 ↓3 章）。

代わりに、機構が書いていない条件が 2 つ付く。**どちらも `hardware/parts/fit.scad` に既にある規則である。**

| | 何 | 出どころ |
|---|---|---|
| ① | 溝の幅は設計 2.2 のまま、**印刷モデルだけ +0.4**（`FIT_BURN`）。手で広げない | fit.scad `fit_hole_down` |
| ② | 溝の底から内面へ **φ1.5 の抜き穴**。無いと吸盤になり「径をいくら広げても入らない」 | fit.scad の ⚠ ・2026-09-10 の小帯 C |

⚠ ②の抜き穴は r9.6 に開くので、**中継の鍔 φ10（芯まで 12.5）を避ける角度**に置くこと。
⚠ 皿は**表をプレート側にして刷る**。止めピンは「印刷の遠い端に立てる」側でなければ太る（fit.scad）。
　これは皿の見える面をプレート側にする向きと一致するので、払う物は無い。

## 3. ⭐ 3 件の残り（軸 φ3.0 × 1.85・皿の裏 23.05・歯幅 1.4）… **通す。ただし帯の残りは 0.45 しかない**

**ここが今日の本題である。**歯車の帯 2.15 に対して、

| | 値 |
|---|---|
| 中継の高さ（鍔から鍔・STL の実測） | **1.700** |
| 帯 21.0 − 18.85 | **2.150** |
| ⇒ **中継が使い切るまでの余り** | **0.450** |
| つまみの軸方向の遊び | 0.25（これを超えると**皿が顔から浮く**） |
| 止めピンの掛かり | 0.85（これを超えると**回り止めが外れて 0%↔100% が飛ぶ**） |

そして、この 0.45 を食う物が 1 つある。**前の壁の内面の「育ち」である。**

🔴 **この機の内面の育ちは公差ではない。片側にしか出ない系統誤差で、接地面積で決まる。**
`docs/PRINT.md` の v4 実測: LCD 比 9〜11% で +0、**26〜27% で +0.2**、40〜45% で +0.8〜0.9、50% で +1.2。

初層の断面を数えた（`--backend=manifold`・**対照は実体の無い z 30 を切って 空**）。

| | 初層 | LCD 比 | 見込みの育ち |
|---|---|---|---|
| 前の殻だけ | **3,142mm²** | **24.4%** | +0.2（v4 の 26〜27% の帯のすぐ下） |
| 背面の蓋だけ | **4,226mm²** | **32.9%** | 30% の線を越える |
| 🔴 **2 枚を同じプレートに載せる** | 7,368mm² | **57.3%** | **+0.8〜1.2**（v4 の実例「大＋小 ＝ 60%」と同じ所） |

⇒ **判定**

| 育ち | 帯 | 中継 1.70 | つまみ | 判定 |
|---|---|---|---|---|
| 0 | 2.15 | 余り 0.45 | 遊び 0.25 | ✅ |
| **+0.2**（前の殻を単独で刷る） | 1.95 | 余り **0.25** | 遊び **0.05** | ✅ 通る。**余りは半分になる** |
| +0.45 | 1.70 | **0** | 皿が 0.20 浮く | 限界 |
| **+0.8〜1.2**（2 枚一緒に刷る） | 1.35〜0.95 | 🔴 **入らない** | 🔴 皿が 0.55〜0.95 浮き、掛かり 0.85 が消える | **組めない** |

⚠ 静的な交差でも出る: 内面を 0.20 下げた殻 × 歯車 3 枚 ＝ **10.52mm³**（0.80 で 113.97・1.20 で 207.83。
育ち 0.001 なら **空** ＝ この検査は空振りしていない）。実物では遊びが先に食われるので潰れはしないが、
**食われる順番がそのまま上の表である。**

### 🔒 決定

1. **歯幅 1.4・帯 19.40〜20.80 を認める。**これ以上細くしても、余り 0.45 は中継の 1.70 で決まっていて増えない
2. 🔴 **前の殻と背面の蓋を同じプレートに載せない。**刷るのはユーザーだが、これは
   「好みで 2 枚一緒にした」だけで機構が組めなくなる、という**設計側の条件**なので、ここに書いて残す
3. 🔴 **0.45 は帯の在庫である。**誰かが中継の鍔を厚くする・歯幅を戻す・壁を厚くするとき、
   この 0.45 から引く。`_v6_gear.scad` の echo ⑧ に「育ちの取り分」を 1 行足すこと（機構担当へ）

⚠ 明記した仮定: 前の殻は**顔を下にして刷る**（顔がこの機で一番正確な面なので、そう刷るはず）。
傾けてサポートで浮かせるなら育ちはほぼ 0 になり、上の表は全部楽になる。**顔の面と帯の 0.45 は同じ数を取り合っている。**

## 4. 🔴 B 板への 3 件 … **通す（回路担当が拾うこと）**

1. 立入禁止を 6×6 の角 → 板 (36.2, 7) を芯とする **φ10.2 の円・板の面から 11.3**
2. ブラケットの座: 板 X 35.4〜43.7・Y 0〜6.7 に背 1.5 超の部品を置かない。**右下の M2 で共締め**
3. AS5600 の足跡は**リード込み 4.9 × 6.2**

⭐ **これは面積の話ではなく、板の右下の角の話である。**3 件とも板の X 35.4〜43.7・Y 0〜6.7 に閉じていて、
既に立入禁止だった 6×6 の角とほぼ同じ場所を、形を丸くして少し広げているだけである。
⇒ **口 7 つと電源回路の置き場には効かない。**回路担当が「余白が無い」で突き返す理由は無い、というのが調停の読み。
⚠ ただし ③（足跡 4.9 → 6.2）は AS5600 のランドそのものが伸びる話なので、`gen_pcb.py` の足形を直す手間は要る。

## 5. ⬜ C つまみの抜け止め — まだ上げない

機構側で作業中。⭐ ただし**払う物は「厚み か 顔」ではない**というのが調停の見立てである。
A-1 で軸穴が φ12.85 に開く以上、保持は**皿 r14.25 の下の直径**で取れる。皿の抜き φ11 の底にねじ頭を
出す（顔を食う）案も、厚みを足す案も、その前に検討する所がある。**機構の案が出てから 1 つに絞る。**

---

# 裁定 #2 — つまみは「抜ける」前に「回っていない」（2026-09-13・調停役）

機構担当から C（抜け止め）と D（遊び 8.07 度）が返ってきた。**D は認める。C は 接着（④）を採る。**
ただし C の理由は機構が書いたものと違う。

## 1. ✅ D 遊び 8.07 度のまま … **認める。調停は不要**

`firmware/esp32/src/main.cpp` 906 行を自分で読んだ。`abs(pct - knobPercent) >= 2` の
デッドバンドは実在し、両端（0/100）だけ `endstop` で素通りする作りも書いてあるとおりだった。
可動域 310 度で 2% ＝ **6.2 度**。最悪 8.07・RSS 4.70 はこの中に埋まる。
**ばね腕を足しても差はソフトが捨てる。**筐体にも板にも要求は出ない。

## 2. 🔴 C 見つけたこと — **いまのつまみは、抜ける前に回っていない**

機構は「皿の穴 φ8.70 ↔ ハブの柱 φ8.60 で締め代ゼロ」を軸方向の話として報告している。
**同じ隙間は回転方向にも空いている。**

`_v6_gear.scad` の `knob_dish()` が開ける穴は `cylinder(d = KN_PEG + SLIP, ...)` ＝ **真円**である。
一方 `knob_hub()` の柱は φ8.60 を `KN_FLAT = 6.60` の二面幅で削った形。
**φ8.60 の円の部分集合は、どの角度でも φ8.70 の真円に収まる。**⇒ 二面幅には相手がいない。

測った（`--backend=manifold`）:

| | |
|---|---|
| いまの皿を **5 度** 回してハブに当てる | **0.0000mm³** |
| いまの皿を **20 度** 回してハブに当てる | **0.0000mm³** |
| 対照: 穴に二面幅を入れた皿 0 度 / 5 度 / 20 度 | 0.0756 / 0.7998 / **4.1831mm³**（反応） |

⇒ **つまみを回しても歯車は動かない。**`chk_dish_hub = 0.0000` は「締め代ゼロ」ではなく
「**継ぎ手が無い**」と読むのが正しい。

⭐ これで C の選択の形が変わる。**直しは抜け止めと回り止めの両方を同時に供給しなければならない。**

## 3. 🔒 決定 — ④ 接着。ただし「接着」ではなく「厚みの中の肩」を作る

### ② バヨネットを却下する理由（面積でも顔でもない）

**つまみに付けるバヨネットは、回すたびに緩む向きに力を受ける。**可動域 310 度の両端は
機構の壁で、ユーザーは必ずそこへ突き当てて止める（メニューは 0／100 へ振り切って使う）。
突き当てた先のトルクは、半分の回転方向で**外す向き**に入る。掴んで回す部品には向かない。

⚠ 機構が挙げた却下理由（「回り止めの二面幅と両立しない」）は**成り立たない。**
両立させる相手の二面幅が、そもそも効いていないからである（2 章）。

### ④ を採る。そして ④ は接着強度の話ではない

皿の穴の上には**呼び込みの円錐**が既に引いてある（z 22.59〜23.05・**φ8.70 → φ11.00**・容積 34mm³）。

🔴 **ここを満たすと、硬化した栓は皿自身の φ8.70 の穴を通れなくなる。**
皿を 0.1 持ち上げた所で栓は φ9.21 になり、穴 8.70 に噛む。⇒ **リベットの頭である。**
`docs/PCB-MOUNT-SURVEY.md` の分類でいえば、**④ の道具で ② 「厚みの中に肩」を作っている。**
壊れるとすれば φ8.70 の面でのせん断（断面 59.4mm²）で、接着面のせん断 49N とは桁が違う。

そして柱の二面幅の脇に残る**三日月の空所 2 つ**が、同じ栓で埋まって**鍵になる**。
⇒ **1 つの操作で、抜け止めと回り止めの両方が出る。**

### 何で満たすか — 🔒 **同じレジン＋UV。瞬間接着剤ではない**

| | |
|---|---|
| 強さ | `PCB-MOUNT-SURVEY.md` ④「**UV 接合の方が同材で強い**」 |
| 手持ち | レジンと硬化機は**確実にある**（同表）。CA は「手持ちにあれば」＝在庫が不確か |
| ⭐ 決め手 | **硬化のタイミングを自分で選べる。**CA は入れた瞬間に走って固まるので、**回るかどうか確かめる前に決着が付く** |

### 🔒 手順 — 皿の抜き φ11 が注ぎ口と UV の通り道になる

1. 乾組みする（皿を外から落とす → 内からハブを挿す）
2. **回ることを確かめる**
3. 皿の抜き φ11 から未硬化レジンを落として**円錐だけ**満たす
4. 同じ穴から UV を当てて硬化させる

⭐ **ユーザーが 2 度こだわった顔の穴が、そのまま組み立ての口になる。**顔も厚みも 1mm も食わない。
これが「厚みか顔のどちらを食わせるか」への回答である ── **どちらも食わない。**

### 機構への条件 2 つ

| | |
|---|---|
| ① | 皿の穴の底（z 20.79）に**堀**を彫ること。そこがスカートの底＝軸受けの隙間 0.25 に一番近い。走った分はここで止める |
| ② | **円錐だけ満たす。**三日月まで満たそうとすると UV の影に未硬化が残る。円錐だけで頭は出るし、三日月の口の所で鍵にもなる |

### 代償の訂正

機構の「(1) つまみが壊れたら前の殻ごと刷り直し」は**言い過ぎである。**
ハブは歯先 φ14.85 が穴 φ12.85 を通らないだけで、**壊してよければ穴から掻き出せる。**
失うのは**皿とハブの 2 部品**で、前の殻は残る。

## 4. まだ機構へ返していない宿題

🔴 **皿の穴に二面幅を入れるかどうかは、機構が決めること。**栓が鍵になるなら要らないが、
入れておけば乾組みの段階で回り、栓は抜け止めだけを担う（役割が 1 つずつに分かれる）。
⭐ 調停の推しは**入れる**。理由は手順 2「回ることを確かめる」が、二面幅が無いと
**回らないことしか確かめられない**からである。

---

# 裁定 #3 — D は取り消さない。栓はリベットではなくなった（2026-09-13・調停役）

機構が二面幅を入れ、代償として遊びが 8.07 → **9.12 度**（RSS 4.71 → 4.82）になったと報告してきた。
「2% を 0.94 ポイント超えた・前回は 2.60% で下でした」と添えられている。

## 1. ✅ D はそのまま。前提は動いていない

🔴 **「前回は 2.60% で下」は違う。2.60% は 2% の上である。**（8.07 / 310 ＝ 2.603%）
最悪値は最初から 2% を超えていた。**動いたのは 0.34 ポイントで、超えたかどうかではない。**

そして **遊びとデッドバンドは競合しない。足し算である。**逆へ回したとき、
読みは遊びのぶん止まり、そこから 2% 動いて初めて効く。

| | 遊び | ＋ デッドバンド 6.2 度 | 体感の死に幅 |
|---|---|---|---|
| 二面幅なし | 8.07 | | **14.3 度** |
| 二面幅あり | 9.12 | | **15.3 度** |

⇒ **310 度のつまみで、手が動く量が 1.05 度 増えただけ。**RSS は 4.82 度 ＝ 1.56% で
デッドバンド 6.2 度の下にいる（前回 1.52%）。**判断は変わらない。**

## 2. ⭐ ばね腕を採らない理由を、本当の物に差し替える

機構は「部品が増える・手応えが重くなる」を理由に挙げていたが、**もっと重い記録がある。**

`docs/PRINT.md`「板バネのゲージ」: 厚み × 長さを変えた 9 枚が、刷った直後は 3 枚 OK だったのに、
**約 1 日半後に押した瞬間 全数破断した。**効いたのは形ではなく**時間（経時脆化）**である。

> ⭐ 教訓: **弾性部品の合否は「刷った直後」で判定してはいけない。数日置いてから同じ試験をやり直すまでが 1 セット。**

⚠ この 🔒 の守備範囲は**レジン①（SK本舗 灰）**で、それは尽きている。いまは ELEGOO で、
同文書は「水洗い系のレジンでその用途に耐えるかは、**どちらのレジンでもまだ試していない**」と書いている。
⇒ **「作れない」とは言えない。**言えるのはこちらである:

🔒 **ばね腕を採るとは、未確認のレジンで弾性部品の合否試験を数日がかりでやる、という意味である。**
それを 1.05 度 のために始めない。**ユーザーに試し刷りをさせない、という調停の決まりとも一致する。**

## 3. ⬜ 1.05 度 を返したいなら、ばね腕より先に見る所がある

二面幅の遊びは `KN_FLAT + SLIP` の **SLIP = 0.10** から出ている。
`fit.scad` の `FIT_SLIP` は「**回る嵌め合い**の狙いの隙間」として計られた値である。
**この二面幅は組んだ後まったく動かない**（回り止めそのもの）。⇒ 同じ 0.10 を使う必然は無い。

| 幅の隙間 | 遊び |
|---|---|
| 0.10（いま） | 1.051 度 |
| **0.05** | **0.522 度** |

⚠ 皿は表をプレート側にして刷るので、**この穴は上向き**＝ `fit_hole_up` 側。ゲージは
「φ3.0 のダボに φ2.9 でも入る」＝ 上向きの穴は大きめに焼ける側である。
**要求ではない。**機構が決めること。1.05 度 はこのままでも払える。

## 4. 🔴 栓の読み方を訂正する — 二面幅を入れた時点で、栓はリベットではなくなった

裁定 #2 では「栓は皿の φ8.70 の穴を通れない ＝ リベットの頭」と書いた。**その形は消えている。**

皿の穴を二面幅（φ8.70 ∩ 6.70）にしたので、**円錐の底（真円 φ8.70）は穴より広くなり、
その三日月ぶんが皿の肉の上に乗る。**⇒ 皿を持ち上げると、**皿が栓を一緒に持ち上げる。**
栓は穴を塞いでいない。

⇒ **荷重を持つのは、栓と柱の天面の溶着である。**

| | 値 |
|---|---|
| 柱の天面（φ8.60 の円を 6.60 で削った形） | **50.55mm²** ＝ 円 58.09 − 弓形 3.77 × 2 |
| 読み方 | **引張**（せん断ではない） |

⚠ 機構の案「円錐の首 φ8.70 の断面で読む」も、私の「φ8.70 面のせん断 59.4mm²」も外れている。
剪断で読むなら円錐の壁 π × 8.70 × 0.45 ＝ **12.30mm²** だが、**その面は荷重経路に無い。**

⭐ **だから心配する所は面積ではない。**50mm² の同材 UV 溶着は母材に近く、指の力とは桁が違う。
**効くのは「未硬化レジンが柱の天面を濡らすか」の 1 点だけ**である。天面は水平で、
注いだレジンの底に来るので重力が仕事をする。⇒ **注いだら少し置いてから UV。**

## 5. 分担は合っている

**鍵＝二面幅（樹脂どうし）／ 栓＝抜け止めだけ**で正しい。理由 3 つ。

1. ⭐ **選んだ方法が成り立つのはこの分担のときだけ。**レジン＋UV を CA より上に採った理由は
   手順 2「**回ることを確かめる**」だった。鍵を栓で作ると、確かめるのは鍵を鋳た後になる
2. **壊れ方が分かれる。**満たし足りなければ抜け止めだけ失う（つまみは回る＝気付ける）。
   鍵を兼ねさせると、満たし足りない 1 つの原因で両方同時に落ちる
3. **栓が穴の中へ 1.80 降りる必要が無くなった**ので、軸受けへの漏れ道が短い

🔒 **堀（z 20.79・φ9.70 × 0.40）はそれでも残すこと。**ただではないものは何も無く、
軸受けの 0.25 は一度回り込んだら戻せない。

---

# 裁定 #4 — 栓の読み方を 3 回目で確定する（2026-09-13・調停役）

この 1 か所は私も機構も 1 回ずつ外している。**測って閉じた。**

| 検査 | 結果 | 読み |
|---|---|---|
| 皿＋栓を 1 つの体として 3.0 持ち上げ、ハブに当てる | **空** | 🔴 **溶着が切れれば皿は栓ごと外れる。ハブ側に止める形は無い** |
| 栓を柱側に固定し、皿だけ 0.30 持ち上げる | **9.2978mm³** | 栓が付いている限り、皿は**止まる** |
| 同じことを二面幅の無い（真円の）皿で | **7.0313mm³** | その大半（7.03）は**円錐のテーパ**の寄与。三日月が足しているのは 2.27 |
| 対照: 皿を動かさない / 0.30 下げる | 0.0000 ／ 空 | 検査は空振りしていない |

⇒ **どちらの言い分も半分ずつ正しかった。**

- 🔴 私の裁定 #3「**栓は穴を塞いでいない**」は言い過ぎだった。**塞いでいる**（9.30mm³）
- 🔴 機構の「皿が抜けないのは円錐が下すぼまりだから」は、**それだけでは成り立たない。**
  栓と柱のあいだに形の掛かりは 1 つも無く、繋いでいるのは溶着だけである（持ち上げの検査が空）

🔒 **確定した 1 行**（組む順番にはこう書くこと）:

> **円錐と三日月が皿を止める。ただし止められるのは、栓が柱の天面に溶着している間だけである。
> 溶着が切れれば皿は栓ごと外れる。⇒ 荷重は溶着の引張 50.5mm² で読む。**

⚠ **これは言葉の綾ではない。**「円錐が止めている」と書くと、**溶着が飾りに見える。**
飾りではないので、手順の「注いだら少し置く（重力で柱の天面を濡らす）」が**効く工程**になる。

## ✅ 二面幅の隙間 0.10 のまま — 認める

`fit_hole_up` の 🔒 実績式の中に留まり、0.53 度 のために式の外の数字へ出ない、という判断は正しい。
`SLIP = FIT_SLIP` に繋いだのも良い（複製が 1 つ減った）。

## 🔴 「検査が別の物を見ていた」は、この案件で 2 回目である

1. `chk_ctrl`（歯車 × ReSpeaker の対照）が古い円盤を置いていて、**最初から触っていなかった**
2. 機構が親の定数 11 個を複製していて、**抜き穴の無い溝**を検査していた（親には `STP_VENT` φ1.5 がある）

**どちらも「同じ数字を 2 か所に書かない」が破れた所で起きている。**
⇒ 調停で走査した（2026-09-13 時点）。**両方に定義がある変数は `WALL_IN` の 1 つだけ**
（式は双方 `BODY_Z - WALL` で同じ）。**両方に定義があるモジュールは 0。**機構の掃除は効いている。

## ⬜ `idler_pin()` の直書き — 直し方を 1 つ出す（デザイン担当へ）

親の `_v6_portrait.scad:191` は `GZ - 0.25` と直書きで、機構が鍔の厚み `ID_FT` を動かしても追従しない。

⭐ **機構が 5 章で「私の定義は include より後なので、親のモジュールの中でも私の値が使われていた」と
書いた性質を、事故ではなく道具として使う。**

| | |
|---|---|
| 親 | `ID_PIN_BOT = GZ - 0.25;` を**名前付きの既定値**として置き、`idler_pin()` はそれを使う。「機構が上書きする」とコメントする |
| 機構 | include の後で `ID_PIN_BOT = ID_BOT - 0.10;` と**上書き**する |

⇒ 名前が 1 つになり、親を単独で描いても壊れない。**同じ数字を 2 か所に書かない**の、
「書かざるを得ない 1 個」の形である。

---

# 裁定 #5 — 私の直し方が間違っていた。追従は「関数」で渡す（2026-09-13・調停役）

## 1. 🔴 裁定 #4 の `ID_PIN_BOT` は成立しない。私の誤り

機構が最小の実験で示してきたので、自分でも再現した。

```
親:  A = 1;  X = A + 10;  B = 2;  function x_fn() = A + 10;  module show(v = 0) ...
子:  include <親>
     C = B + 100;
     X = C;                    // 変数の上書き
     function x_fn() = C;      // 関数の上書き
     echo(X, C, x_fn());  show(C);
```

```
WARNING: Ignoring unknown variable "C"
ECHO: "X = undef   C = 102   x_fn() = 102"
ECHO: "  module arg = 102"
```

🔒 **同じ変数に 2 回代入すると、最後の代入の右辺は「最初の代入があった位置」で評価される。**
⇒ **子は、親の代入より後に定義された物を 1 つも参照できない。**変数での上書きは使えない。
**関数とモジュールの引数は呼ぶときに評価されるので効く**（どちらも 102）。

⚠ この誤りで親の中継の軸が一時 `undef` になった。デザイン担当が `GZ` を壁の隣（34 行）へ上げて
`function id_pin_bot()` へ直し、いまは警告 0 で描ける。

## 2. 🔒 規則（3 つのスレッド共通）

> **相手のファイルの数に追従させたいときは、変数ではなく「関数」で渡す。
> モジュールごと上書きしない。**

- 変数 … ✗ 成立しない（上の実験）
- **関数 … ⭕ これを使う**
- モジュールごと上書き … ⚠ 動くが**禁止**。⭐ 理由: **持ち主が後からモジュールへ足した物が、子へ伝わらない。**
  今日それが実際に起きている（親が溝へ足した抜き穴 `STP_VENT` が機構の複製に無く、
  機構は**抜き穴の無い溝**を検査していた）

⇒ **デザイン担当の言い分が正しい。**機構は `_v6_gear.scad:281` の `idler_pin()` のモジュール上書きを
やめ、`function id_pin_bot() = ID_BOT - 0.10;` の 1 行にすること。**これは裁定である。**

## 3. 🔴 「空」は 2 つの意味を持つ ── これがこの案件の常習犯である

**「検査が別の物を見ていた」は、今日で 3 つ目の機序が出た。**

| | 何が起きたか | 捕まえた物 |
|---|---|---|
| 1 | 対照が古い円盤を置いていて、**最初から触っていなかった** | 対照を実際の当たりへ差し替え |
| 2 | 定数を複製していて、**抜き穴の無い溝**を検査していた | 親から導く形へ掃除 |
| 3 | `undef` で形が消え、**壊れた検査が「空」に見えた**（未遂） | ✅ 警告の行（機構が `_v6_gear_chk.py` へ追加） |

🔒 **共通形: 「空」は「当たっていない」と「形が無い」を同じ顔で返す。**
⇒ **対照を毎回 1 本**（1・2 を捕まえる）＋ **警告 0 を確かめる**（3 を捕まえる）。両方要る。

⚠ **調停も同じ規則に従う。**裁定 #4 の測定を警告つきで回し直した:
`q_lift` 空 ／ `q_ledge` **9.2978mm³** ／ `q_ctrl0` 0.0000 ／ `q_ctrl1` 空 ── **全部 警告 0。**
裁定 #4 の読みはそのまま立っている。

---

# 裁定 #6 — 対照の「空」は失敗である。知らせるのは礼儀、回すのが規則（2026-09-13・調停役）

機構が **4 つ目の機序**を出してきた。裁定 #5 の表に足す。

| 4 | **相手の形が変わって、対照が届かなくなった** | ERROR でも警告でも出ない。**対照の「空」だけが証拠** |

デザイン担当が OLED を 塊 → 板 1.00 ＋ ガラス 1.65 に割ったので、ガラスが Y 44.69 からになり、
板は Z 20.15 で止まった。⇒ 溝（Y 19.4〜40.6）へ届かなくなり、`chk_ctrl7` が **7.2551mm³ → 空**。
実体はずっと空のままなので、**検査は全部「正常」に見えていた。**

## ⭐ まず: Z の鎖は動いていない（調停で確かめた）

割ったのは**中身の表し方**だけで、`OL_T = 2.65`・`OL_Z`・`RS_Z` の式は変わっていない。

> ① 帯: ReSpeaker 18.85 〜 内壁 21 = **2.15** ／ ⑧b 帯の在庫 **0.45**（警告 0・Status NoError）

⇒ **裁定 #1 の 0.45 の在庫は無傷。**歯車も溝も OLED の居る Y 39.3 以上には触っていない。

## 🔒 決定 — 規則は 2 つ。どちらも機械で効く物にする

| | 規則 | なぜこの形か |
|---|---|---|
| **1** | **対照が「空」なら失敗。runner が赤で出す** | 4 つ目への直接の答え。誰が下流かを知らなくても、誰が覚えていなくても効く |
| **2** | **共有する実体（殻・OLED・ReSpeaker・板・電池）の形を割った／動かした側が、`_v6_gear_chk.py` を 1 回回す** | 読むだけで 1 コマンド。**費用が原因を作った側に乗る** |

🔴 機構の案「形を割ったら下流へ 1 行知らせる」は、**規則にはしない。礼儀として残す。**
今回それで拾えたのは事実だが、**知らせる相手を知っていて、かつ覚えていた日にしか効かない。**
規則をそこへ置くと、忘れた日に何も残らない。⇒ **知らせは補助、回すのが規則。**

## 🔴 正直な限界 — 対照が反応しても、正しい理由で反応しているとは限らない

機械で確かめられるのは「**反応したか**」までで、「**何に反応したか**」は確かめられない。
⇒ だから `chk_ctrl7` のような**思いつきのずらし**（0.9 下げる）は鈍る。

> ⭐ **対照は、できる限り「記録に残る実際の当たり」から作る。**
> （`chk_ctrl` を「平面 18.8 で ReSpeaker に 0.05 触っていた」へ差し替えたのがその形）
> 作れないときは、ずらし量を**ぎりぎり反応する値にしない**。今回 0.9 → 2.0 がそれ。

## ✅ 機構の掃除（確認済み）

`grep "module idler_pin" _v6_gear.scad` = **0 件**、`function id_pin_bot() = ID_PINZ;`（273 行）。
両方に定義がある変数は **`part` だけ**（文字列リテラルなので前方参照の問題は起きない・意図的）。
実体 19 本 空／0・対照 21 本 反応・ERROR 0・警告 0。

---

# 裁定 #7 — 回路担当と初めて話した。私の裁定 #1 の B は、当事者に聞かずに書いていた（2026-09-13）

## 0. 🔴 まず私の誤り

| | 何を書いたか | 実際 |
|---|---|---|
| 1 | 「回路担当が**『余白が無い』で突き返す理由は無い**」 | 🔴 **回路担当はそんな主張をしていない。**制約は面積ではなく**プラグの通り道**だった（PH 横挿し 18.6mm・2.54 の L 字 28.3mm）。部品の面積は 1,327 / 3,491mm² で最初から足りていた |
| 2 | B3「`katanori.pretty` のランドを取り直せ」 | 🔴 **取り直さない。**AS5600 は KiCad 標準 `Package_SO:SOIC-8_3.9x4.9mm_P1.27mm`、足跡 7.40 × 5.40。「4.9 × 6.2」は**機構のモデルが 90 度回っていた**もので、機構が撤回済み |
| 3 | 「回路側の作業は未コミット」 | 🔴 **コミット済み。**main は `99a5800`、ワークツリーは `594ab4a` で **18 コミット遅れ** |
| 4 | 口は 7 つ | 🔴 **5 つ。**🔒 ユーザー「線が二股になるのは構わない」でリードと会話ボタンが 1 つの 4 ピン PH（J6）に |

🔴 **1 が一番重い。**私は B を「通す」と裁定したとき、**その反対意見の持ち主に一度も聞いていなかった。**
任務書から写した「板は…余白がありません」を相手の主張として扱い、それを数で論破した。
**相手が言っていないことに勝っても、調停ではない。**

> 🔒 **規則: 当事者に当たっていない論点は「裁定」と呼ばない。**聞くまでは「調停待ち」と書く。

⚠ 相手の申し送り「`CHIP = [4.9, 3.9, 1.75]` が親に残っている」も、確かめたら**既に直っている**
（`_v6_portrait.scad:362` `CHIP = [3.90, 4.90, 1.75]`・`CHIP_PAD = [7.40, 5.40]`）。3 スレッドが
同時に動くと、**送った時点で古い**ことが双方向に起きる。⇒ 受けた申し送りは、渡す前に現物を見る。

## 1. ① 4 ピンの PH — **ReSpeaker のほうが軽い。ただし板はいまのままでよい**

聞かれたのは「電池と ReSpeaker、どちらを外すほうが軽いか」。**答えは ReSpeaker。**

**電池（Z 9.0〜15.0）は ReSpeaker（Z 17.0〜18.85）の下にある。**組む順番も B3「電池 → ReSpeaker」。
⇒ 電池を外すには**先に ReSpeaker を外す**。**上の縁は谷より必ず高くつき、同着にはならない。**

⇒ それでも **OLED は上の縁のままにする。**谷へ移すと、OLED の端子（箱 Y ≒ 77）から谷（Y ≒ 10）まで
**約 65mm の線**を電池と ReSpeaker の脇に通すことになる。97cm³ の箱で、確実な 65mm の線は、
不確実な修理 1 回より重い。**板の変更なし。**

## 🔴 2. その代わりに見つけた物 — 外す順番が定義されていない

OLED は**前の殻**に付き、その口 J2 は**背面側の板**にあって、間は約 3mm しかない。
⇒ **線に遊びが無ければ、前の殻は J2 を抜かないと外れない。**J2 は上の縁なので、
**前の殻を開けるだけで ReSpeaker と電池を外すことになる。**

⚠ 回路担当は「効くのは修理のときだけ」と書いたが、**効くのは分解のたびである。**

`_v6_gear.scad` の冒頭には**組む順番**があるが、**外す順番はどこにも無い。**そして外す順番は
組む順番の逆ではない（前の殻が最初に外れるのに、その線が 2 つの下に埋まっている）。

⇒ 直すなら板ではなく**線**である。**OLED の線に、前の殻を横へ置ける長さを持たせる。**
置き場所（前の壁の内側・OLED の板の上 Z 20.15〜21.0 など）は筐体側の話。**デザイン担当へ回す。**

## 3. ② リレーの磁気 — **設計で潰す手は無い。そのままでよい。測るのは 2 読みで足りる**

`docs/POWER.md` 3 章: **「コイルは動作中ずっと電流を食う」**（5V 30〜50mA）。
リレーは `setup()` で閉じ、**つまみOFF で開く**。

⭐ ⇒ **コイルの状態は、つまみの可動域の中では 1 度も変わらない。**
⇒ 漏れ磁束が作るのは**ふらつきでも漂流でもなく、範囲全体にかかる一定のオフセット**である。
**一定のオフセットは `knobzero`（組む順番 D）が消す物そのもの。**

効きうるのは **OFF の境目の 1 段だけ**で、そこは既にリードスイッチ・両端の即吸着・
ミュートの順序で特別扱いされている。

⇒ **測るのは掃引ではない。つまみを 1 か所に置いたまま、リレーを開／閉して `AGC`(0x1A) と
`RAW ANGLE` を 2 回読む。**差が 1 つ出れば済む。

### ⭐ そして、歯車 3 枚が `POWER.md` の「いちばんの risk」を既に潰している

> 📄 POWER.md「**これがこの方式でいちばんの risk。**…AS5600 の磁石は軸の中心、
> リード用の磁石は**つまみの外周**へ置いて距離を稼ぐ」

これは **AS5600 がつまみと同軸だった頃**の文である。v6 は歯車 3 枚で読み取りの芯を
**つまみから 24.56mm** 離した。⇒ つまみの外周（r ≒ 14）のリード用磁石は、AS5600 から
**10mm 以上**へ退いた。**しかもリード用磁石は回る＝角度に依存する誤差**で、これが悪い方の種類である。
リレーは動かない。⇒ **3 つの磁気源のうち、リレーがいちばん害が小さい。**

## 🔴 4. その過程で見つけた穴 — v6 にリードスイッチが無い

v6 の 2 つの .scad にある磁石は **AS5600 用の φ4 が 1 個だけ**である。
**リードスイッチ本体も、それを叩く磁石も、どこにも置かれていない。**口（J6）だけがある。

リードは飾りではない。**電源の入切そのもの**（`POWER.md` 2 章・`EN` を GND に落とす）。
⇒ 誰の持ち物にするかを決めて、置かせる必要がある。**調停待ちに立てる。**

## 5. コミットの取り決め

回路担当の案「**本体へ書いた人がコミットする**」に賛成。
⚠ それより重いのは **ワークツリーが 18 コミット遅れで、`hardware/frozen/v6/pcb/` が古い 74 × 52 のまま**である点。
⇒ **ワークツリー側で `hardware/frozen/v6/pcb/` を読まない。**板のことは回路担当の本体が正。

---

# 裁定 #8 — リレーは常時通電ではなかった。段差は消せるが、消す場所はファーム（2026-09-13）

## 1. 🔴 私の誤り（裁定 #7 の 3 章）

「リレーは `setup()` で閉じ、つまみOFF で開く ⇒ 可動域の中で状態が変わらない ⇒ 一定のオフセット」
と書いた。**3 つ目の開閉を見落としていた。**回路担当の指摘どおりで、実物を読んで確かめた。

| `firmware/esp32/src/main.cpp`（main `c99ec9c`） | |
|---|---|
| 1271 行 | `if ((drowsy \|\| asleep) && !powerRelayDown && muteRelayClosed) { … muteRelaySet(false); }` |
| 1316 行 | `if (powerRelayDown) { … muteRelaySet(true); }` |
| 1094 行 | `KATANORI_IDLE_SLEEP_SEC 180` |

⇒ **無操作 180 秒で開き、操作で閉じ直す。つまみは動いていない。**
⇒ 出るのは一定のオフセットではなく、**居眠りと復帰のたびの段差**。`knobzero` は起動時の 1 回なので消せない。

⚠ **掃引を「要らない」と書いたのも外れ。**掃引は別件（エアギャップ 1.10 ±0.41 と磁石の芯の振れ）で、
機構担当の依頼である。2 つを 1 つに畳んでいた。

## 2. ⭐ ただし、段差が出たときの直し場所は筐体でも機構でもない

回路担当は「差が出たら離す以外の手を探す ⇒ 筐体か機構の話」と書いたが、**その前にファームがある。**

**ファームはリレーの状態を正確に知っている**（`muteRelayClosed` は同じファイルの静的変数で、
つまみを読むループと同じ所にいる）。⇒ 段差が出たなら、**`muteRelayClosed` で場合分けして引けばよい。**
板を動かすより、筐体を動かすより安い。

🔴 **ただし引く量は定数ではない。**一定の漏れ磁束は磁石の磁界に**ベクトルで**足されるので、
角度の誤差は**つまみの角度に対して正弦波**になる（振幅 ≒ 漏れ/磁石）。⇒ 1 か所の 2 読みは
**その正弦波の 1 点**でしかない。

⚠ **だから私の「2 読みで足りる」も言い過ぎだった。**正しくはこう:

> **2 読みが 0 でないなら、問題は在る。2 読みが 0 でも、問題が無いとは言えない**（節に当たった可能性）。

## 3. 🔒 ⇒ 掃引を 2 回回せば、両方ただで取れる

機構担当の依頼の **AGC の掃引（つまみを端から端まで）を、リレー強制開で 1 回・強制閉で 1 回**。

| 得られる物 | |
|---|---|
| 掃引そのもの | エアギャップと磁石の芯の振れ（機構担当の依頼・本来の目的） |
| **2 本の差** | **リレーの誤差曲線の振幅と位相がそのまま出る** ＝ ファームが引く量 |

⇒ 掃引を畳むのではなく、**同じ 1 回の作業を 2 度回すだけ**で、2 つ目の測定が要らなくなる。

## 4. AGC がどちらの種類かを教える

- **AGC が範囲内のまま角度だけずれる** ⇒ 磁界の向きの問題。**ファームで引ける**
- **AGC が振り切る** ⇒ 磁界の大きさの問題。ファームでは直らない。ここで初めて筐体・機構の話になる

⇒ **初回の板で見るのは「差が出たか」ではなく「AGC が振り切ったか」が先である。**

## 5. ③ リードスイッチ — 板ではなく線の先で確定

`hub_ports.py` の `REED` は口 2 本（`GND`・`EN`）だけ、部品表にリードスイッチは無い。
⇒ **筐体側だけの話。**持ち主はデザイン担当へ回した（つまみ側の磁石は機構担当）。

---

# 裁定 #9 — リードの役は変わっていない。変わったのは、リードとファームの間に歯車が入ったこと（2026-09-13）

## 1. 🔒 リードの役 ＝ **つまみを回し切ると切れる**（デザイン担当の表の 2 行目）

決めるまでもなく `docs/POWER.md` 2 章に書いてある。**スライドスイッチはリードを置き換えない。**

| | 出どころ |
|---|---|
| リード ＝ つまみ OFF で `EN` を落とす | 「つまみOFF位置 → 磁石がリードスイッチに近づく → 接点が閉じる → EN=GND → 完全停止(20µA)」 |
| なぜリードでなければならないか | 「**電源が無くても効く部品**でなければならない。ホールICは電源が要るので使えない」 |
| スライド（マスタートグル）＝ **非常用・並列** | 「**リードスイッチと並列**に、同じ EN⇔GND へ入れる。どちらか一方でも閉じれば止まる。つまみがどの位置にあっても、ファームがハングしていても落とせる」 |
| 板の節点 | 🔒「`EN` ⇔ `GND` には**リードスイッチ・マスタートグル・0.1µF の 3 つが並列**に入る」 |

⇒ **両方ある。役は分かれている。**置き場は **つまみの外周の磁石 ＋ 前の殻の中**。
⚠ デザイン担当の懸念「回すたびに入切するので不可」は 1 行目（マスター）のときの話で、
2 行目なら**回転で入切するのが正しい役**である。磁石は可動域の端でだけリードの前を通る。

## 2. 🔴 ただし v6 は、この仕組みの前提を 1 つ壊している

`main.cpp:99〜111` に鎖が全部書いてある。

```
✅ 2026-08-17 実測: リードの反応帯は磁石の真上から片側 15 度
🔒 機構側で OFF位置を帯の縁へ 10 度 寄せた（knob_v4.scad の STOP_OFF_ANG）ので、
   リードが開くのは OFF から 5 度。閾値 15 で 10 度 の余裕。
⚠ 25 のままだと、鳴らない区間が 25 度 と無駄に広い。STOP_OFF_ANG を変えたらここも直す
#define KATANORI_KNOB_OFF_DEG 15
```

⇒ **ファームがミュートするのは OFF から 15 度、リードが切るのは 5 度。余裕はちょうど 10 度。**

🔴 **この 10 度 は「つまみと AS5600 が同じ軸に乗っている」ことを前提にしている。**
v6 は歯車 3 枚を間に入れた。**リードはつまみが直接叩き、角度は歯車の先の AS5600 が読む。**
⇒ **その 10 度 の中に、裁定 #3 の遊びがまるごと入る。**

| | 度 | 余裕 10 度 に対して |
|---|---|---|
| 戻したときの遊び（最悪） | **9.12** | **残り 0.88** |
| 同（RSS） | 4.82 | 残り 5.18 |

⚠ 向きも悪い方に効く。**戻し方向では読みが古い側に張り付く**ので、ファームのミュートが**遅れる**。
これは `POWER.md` が 🔴 を付けている「ブツ切り／轟音の穴」そのものである。

## 3. 🔒 直す場所は `#define` ひとつ

```
KATANORI_KNOB_OFF_DEG  15 → 25 前後（＝ 15 ＋ 遊び）
```

⭐ **v5 で「25 は無駄に広い」と 15 へ詰めた最適化は、つまみとセンサが同軸だったから成立していた。
v6 がその前提を壊したので、数は戻る。**無駄だったのではなく、**歯車の代金**である。

⚠ もう一方の手（リードが開く角度を OFF から遠ざける）は機構・筐体の話になる。
`#define` のほうが安い。⇒ **まず `#define` を動かす。**

⚠ v6 には `knob_v4.scad` の `STOP_OFF_ANG` に当たる物がまだ無い（止めの溝は島 28 度・可動域 320.1 度
だけが決まっている）。**リードの磁石を置く人が、この 10 度 に相当する寄せを一緒に決める。**
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
