n416/katanori/_med_band.png

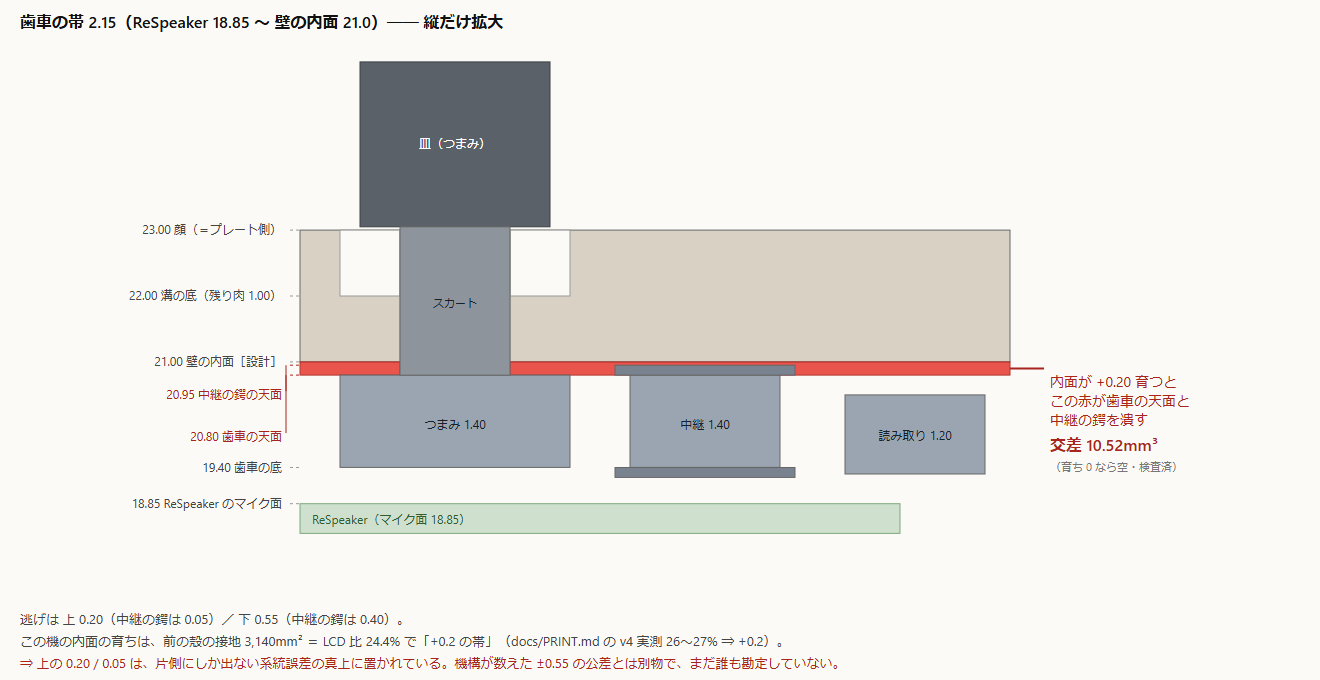
_med_band.png
