n416/katanori/_med_knob.png

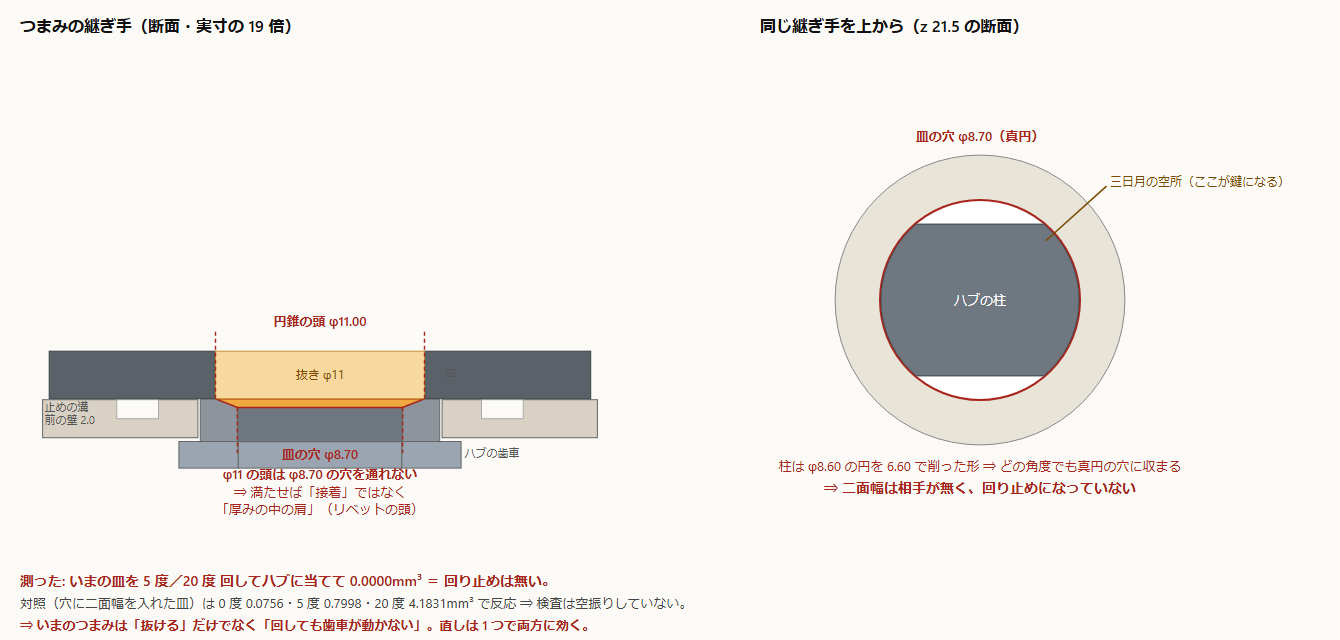
_med_knob.png
