n416/katanori/hardware/frozen/v1-v4/_asm_pic2.png

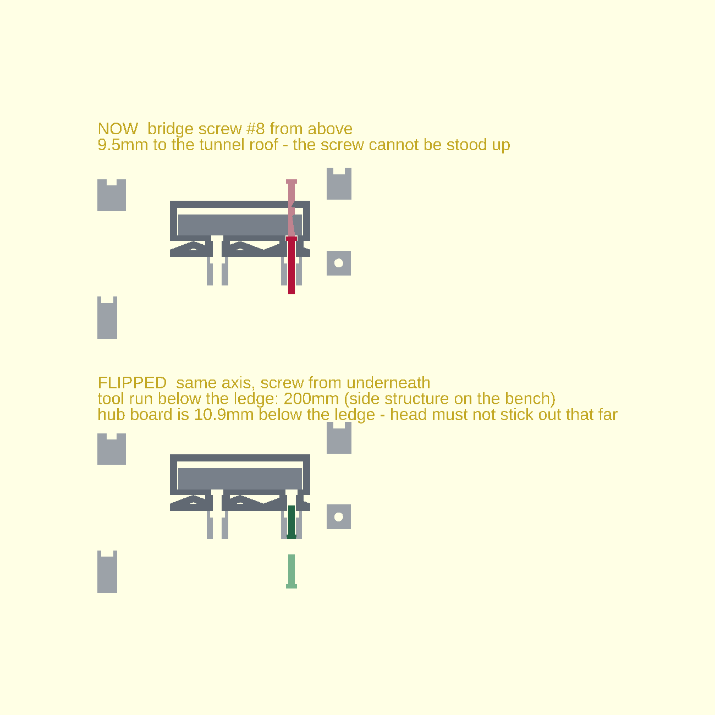
hardware/frozen/v1-v4/_asm_pic2.png
