n416/katanori/hardware/frozen/v1-v4/_brg_pocket_zoom.png

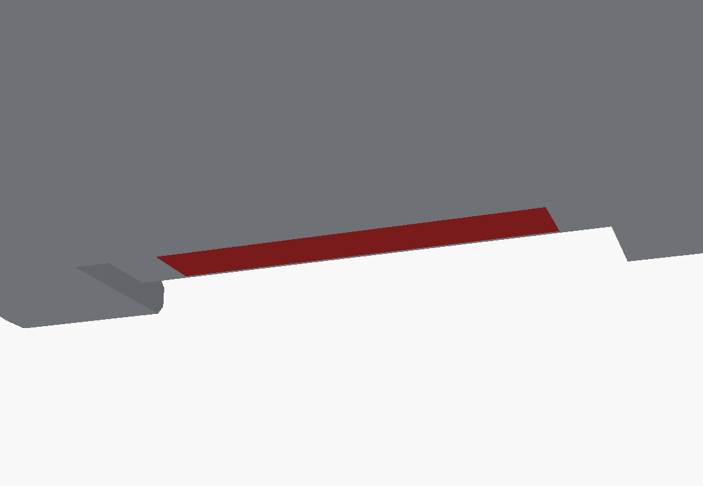
hardware/frozen/v1-v4/_brg_pocket_zoom.png
