n416/katanori/hardware/frozen/v1-v4/_chg_route.png

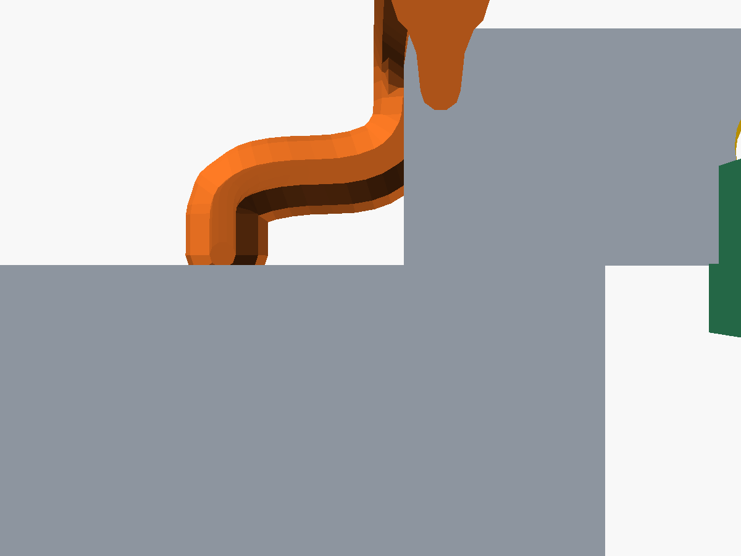
hardware/frozen/v1-v4/_chg_route.png
