n416/katanori/hardware/frozen/v1-v4/_hatch_cone_look.png

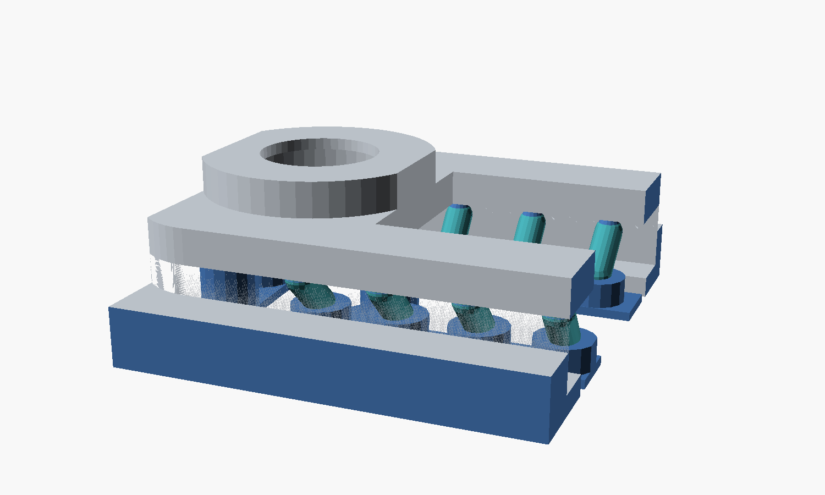
hardware/frozen/v1-v4/_hatch_cone_look.png
