n416/katanori/hardware/frozen/v1-v4/_hatch_post_room.png

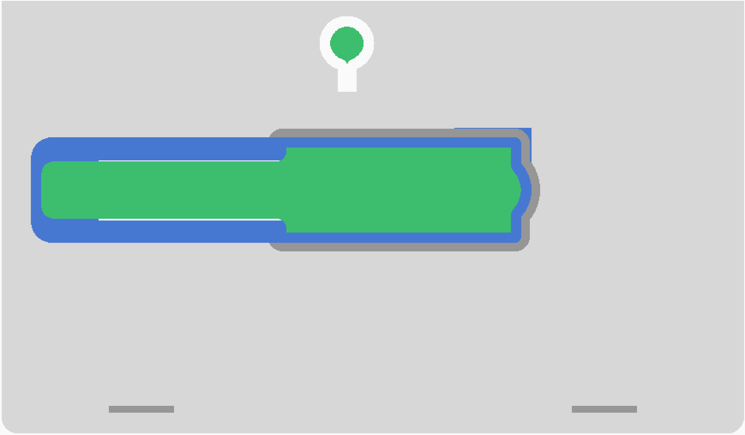
hardware/frozen/v1-v4/_hatch_post_room.png
