n416/katanori/hardware/frozen/v1-v4/_hatch_roof_span.png

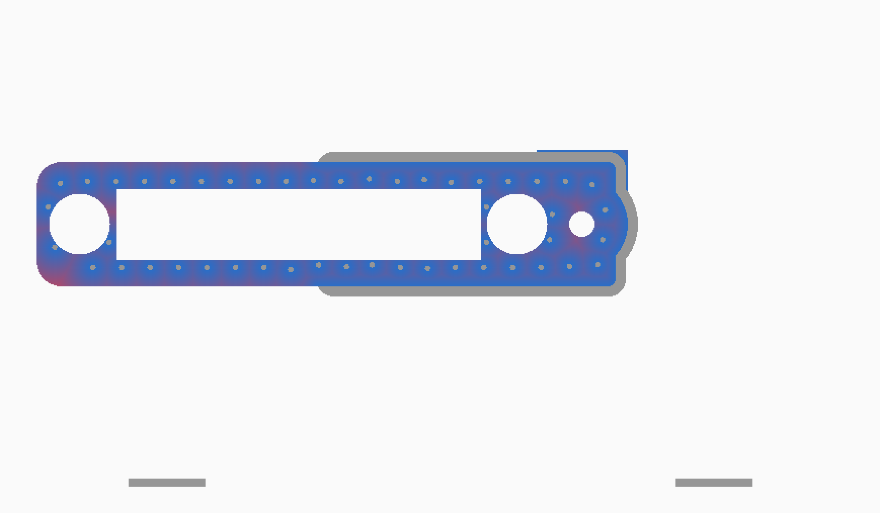
hardware/frozen/v1-v4/_hatch_roof_span.png
