n416/katanori/hardware/frozen/v1-v4/_hinge_chk2.png

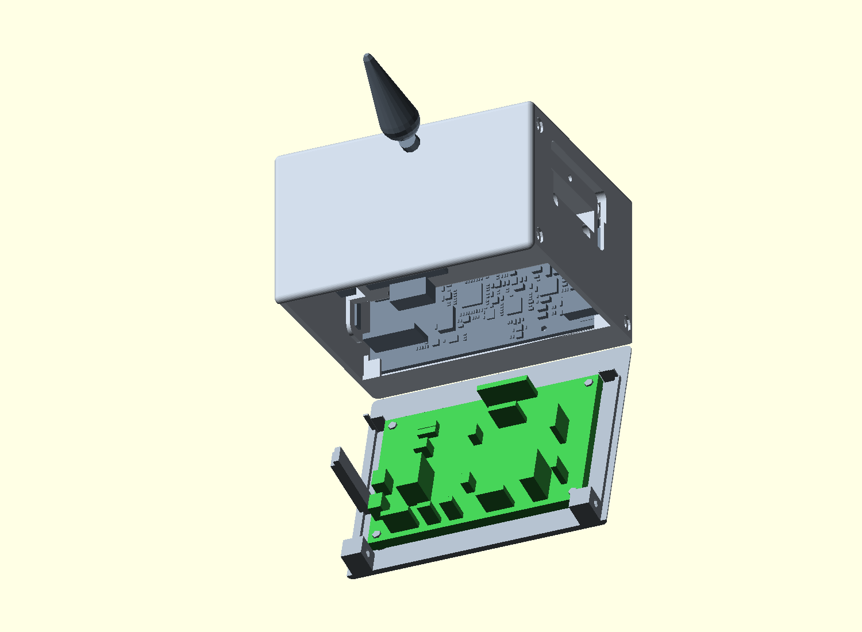
hardware/frozen/v1-v4/_hinge_chk2.png
