n416/katanori/hardware/frozen/v1-v4/_onepiece_strapB_top.png

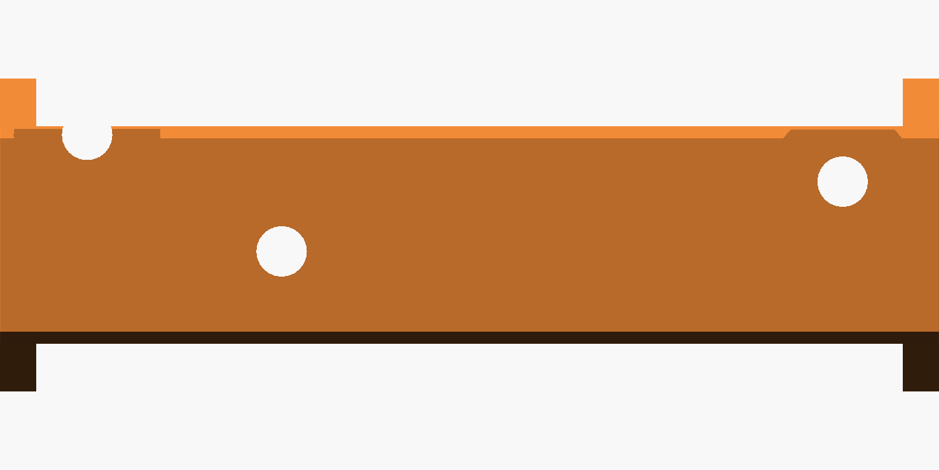
hardware/frozen/v1-v4/_onepiece_strapB_top.png
