n416/katanori/hardware/frozen/v1-v4/_onepiece_tilt.png

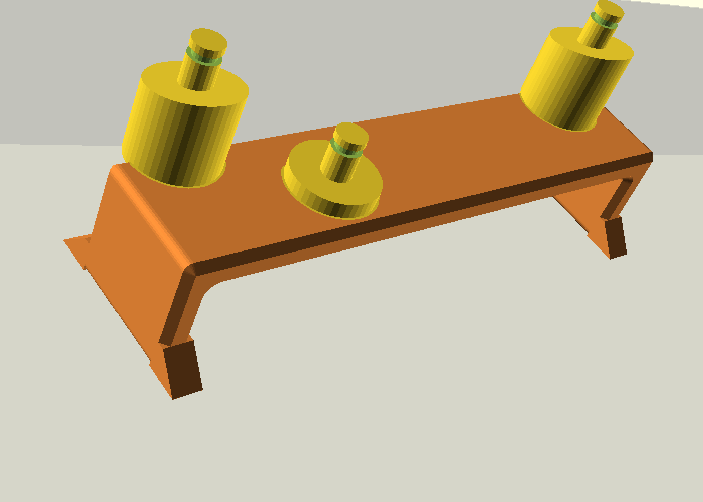
hardware/frozen/v1-v4/_onepiece_tilt.png
