n416/katanori/hardware/frozen/v1-v4/_open_top_look.png

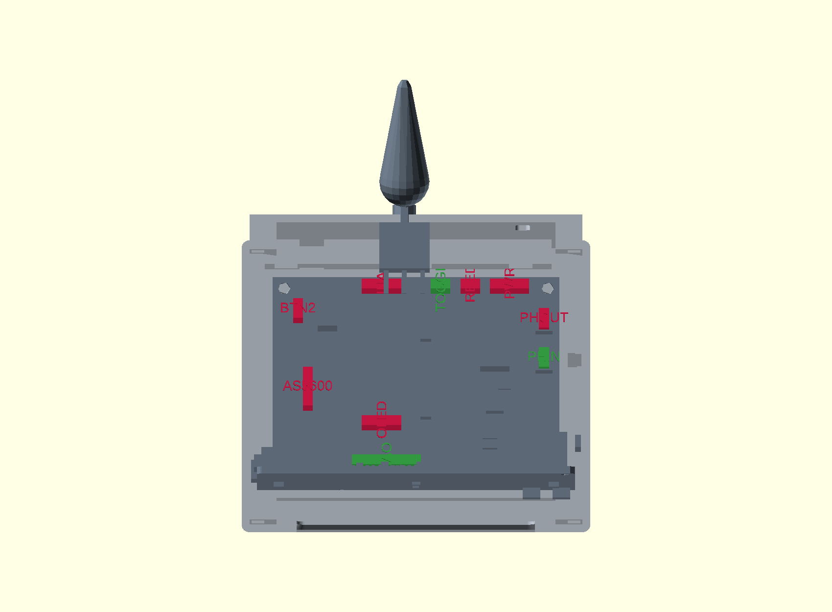
hardware/frozen/v1-v4/_open_top_look.png
