n416/katanori/hardware/frozen/v1-v4/_pb_on_bridge.png

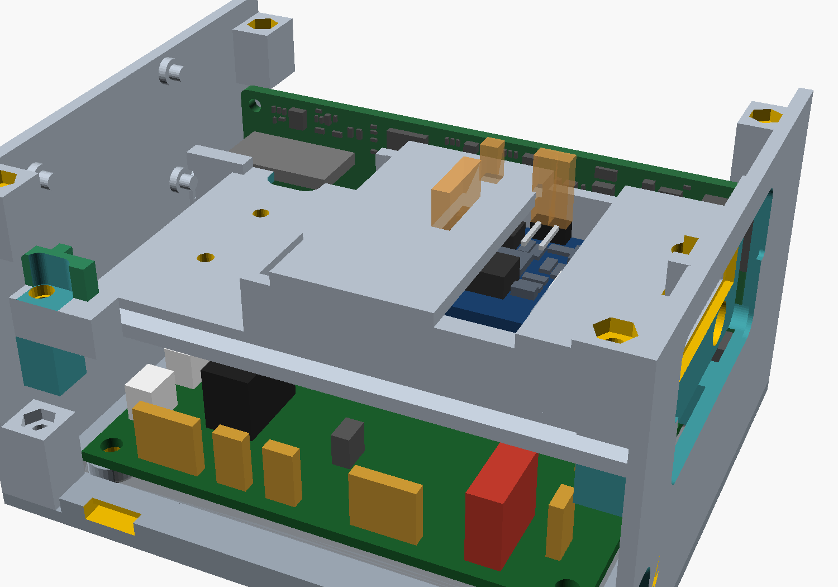
hardware/frozen/v1-v4/_pb_on_bridge.png
