n416/katanori/hardware/frozen/v1-v4/_port_area.png

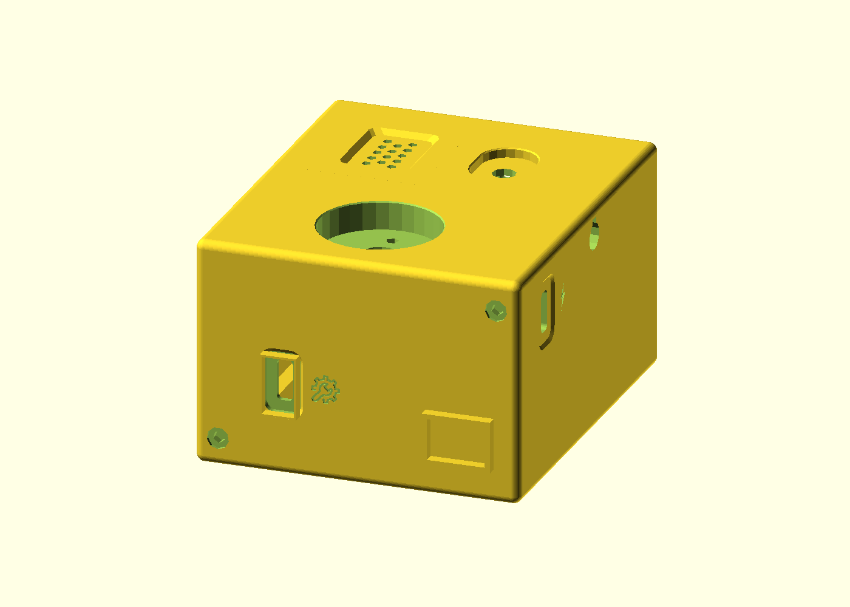
hardware/frozen/v1-v4/_port_area.png
