n416/katanori/hardware/frozen/v1-v4/_slot_plan.png

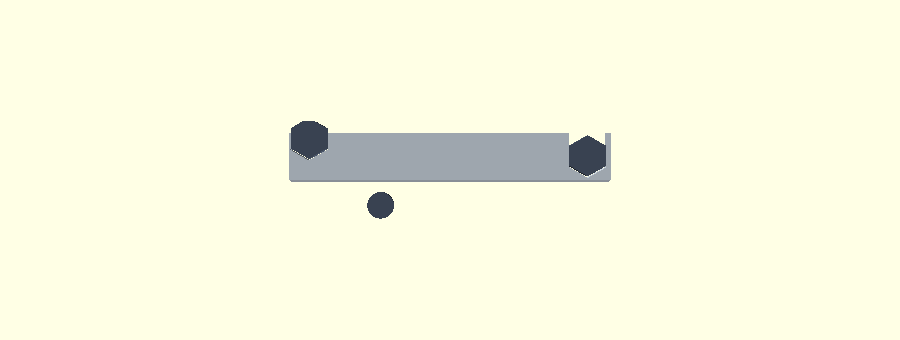
hardware/frozen/v1-v4/_slot_plan.png
