n416/katanori/hardware/frozen/v1-v4/_strap_look.png

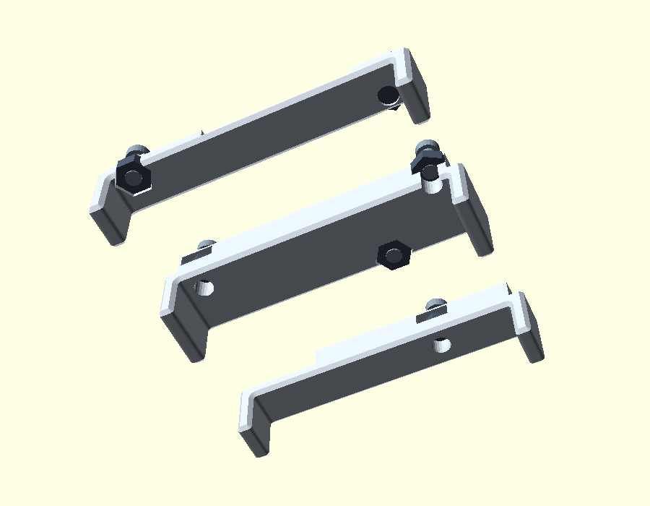
hardware/frozen/v1-v4/_strap_look.png
