n416/katanori/hardware/frozen/v1-v4/_t2_blocker.png

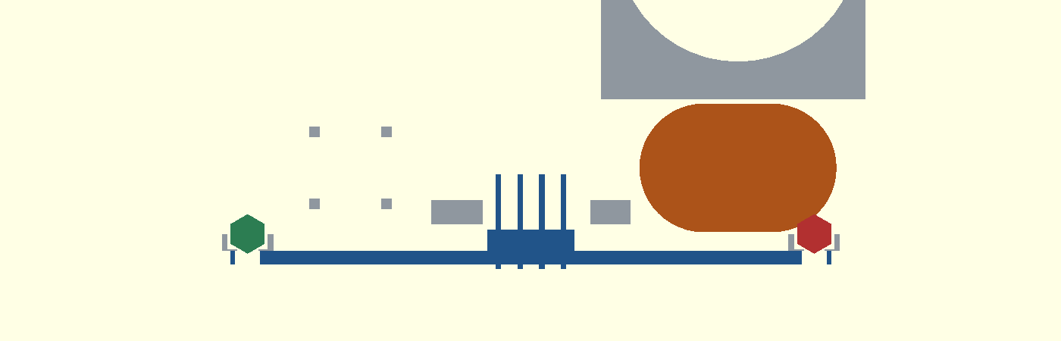
hardware/frozen/v1-v4/_t2_blocker.png
