n416/katanori/hardware/frozen/v1-v4/_tc_seat.png

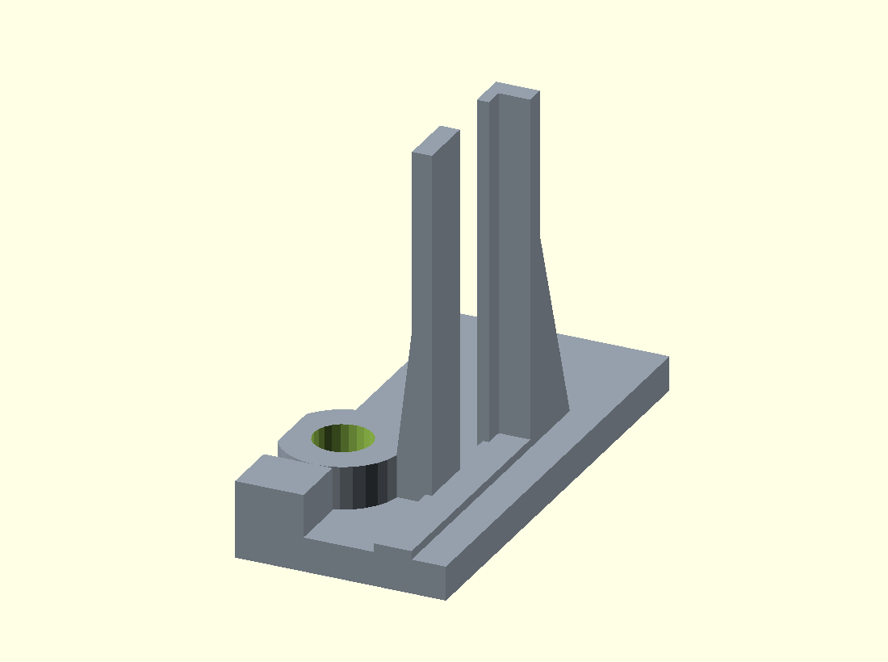
hardware/frozen/v1-v4/_tc_seat.png
