n416/katanori/hardware/frozen/v1-v4/_v3_front_center.png

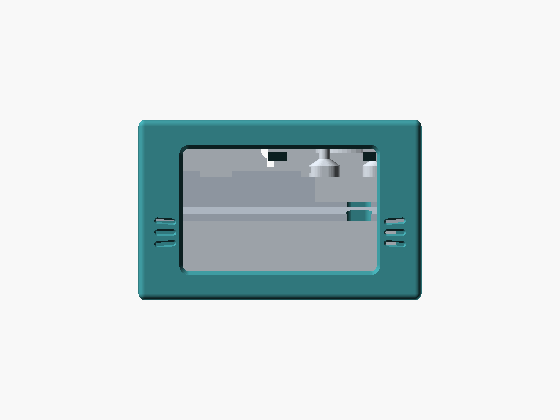
hardware/frozen/v1-v4/_v3_front_center.png
