n416/katanori/hardware/frozen/v1-v4/_v3_lane_plan.png

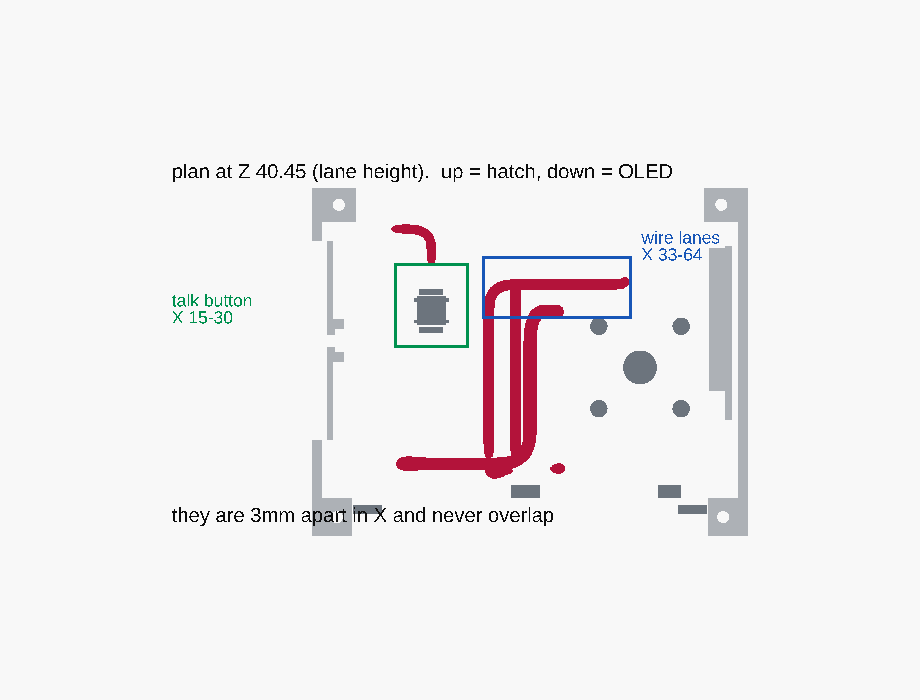
hardware/frozen/v1-v4/_v3_lane_plan.png
