n416/katanori/hardware/frozen/v1-v4/_v3_look9.png

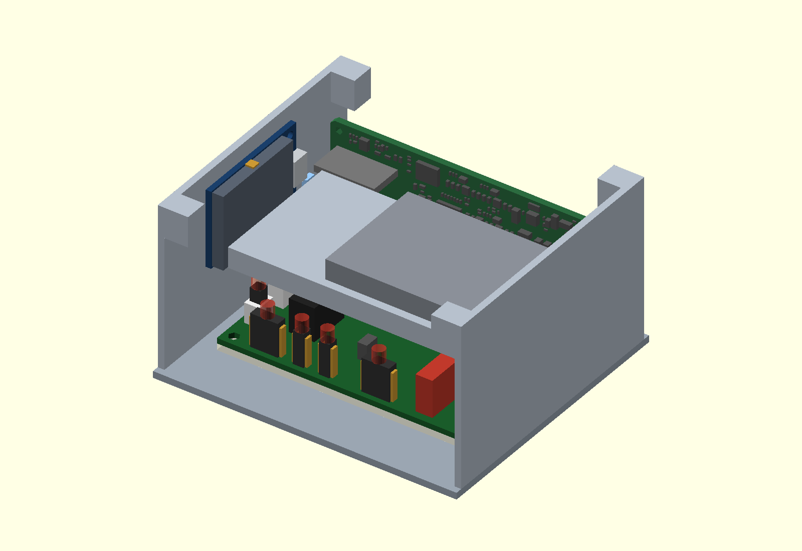
hardware/frozen/v1-v4/_v3_look9.png
