n416/katanori/hardware/frozen/v1-v4/_v3_look_lwall.png

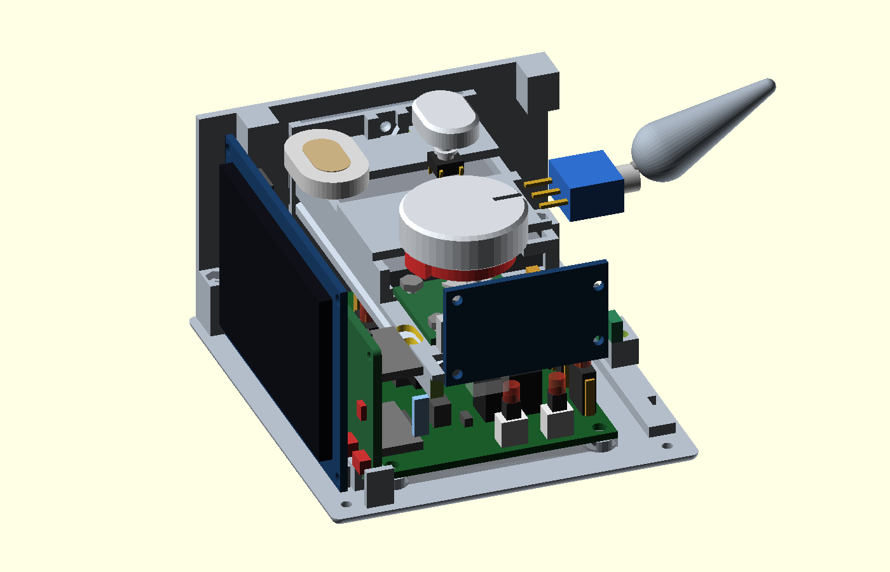
hardware/frozen/v1-v4/_v3_look_lwall.png
