n416/katanori/hardware/frozen/v1-v4/_v3_pic_port_sec_l.png

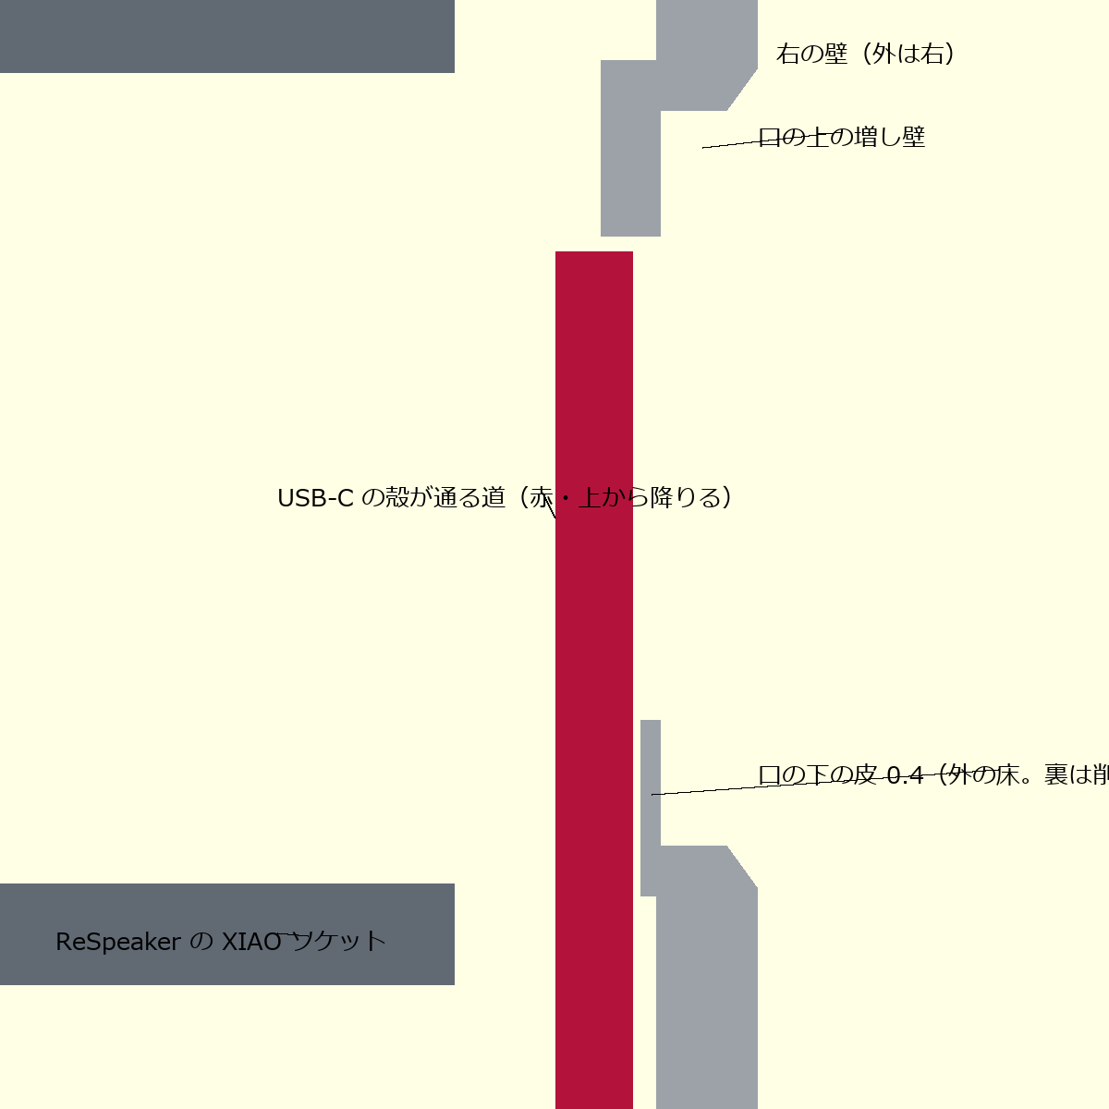
hardware/frozen/v1-v4/_v3_pic_port_sec_l.png
