n416/katanori/hardware/frozen/v1-v4/_v3_port_zoom.png

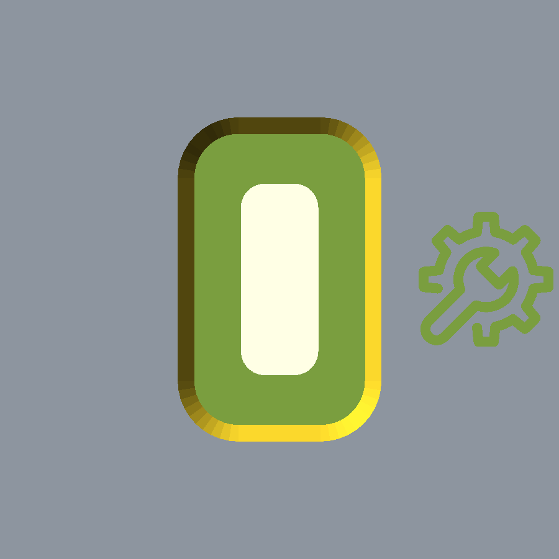
hardware/frozen/v1-v4/_v3_port_zoom.png
