n416/katanori/hardware/frozen/v1-v4/_v3_tgl_sec.png

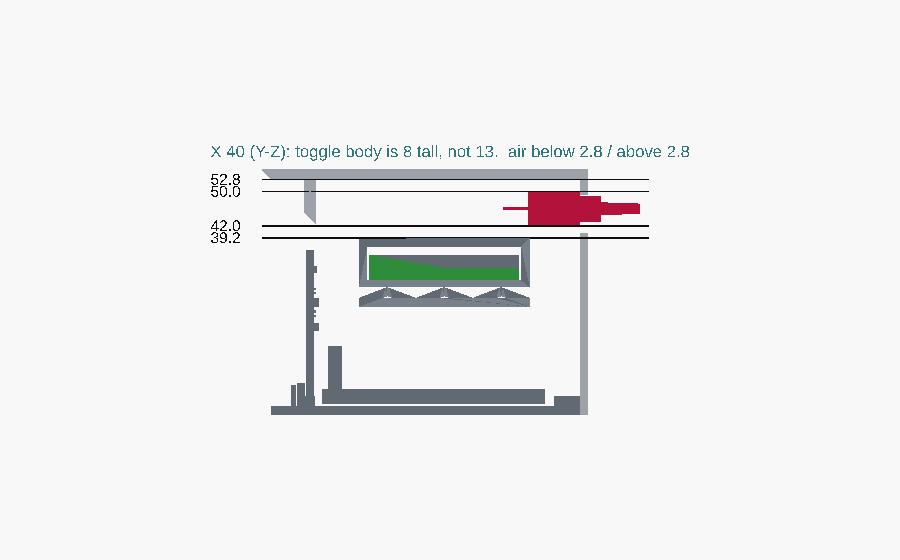
hardware/frozen/v1-v4/_v3_tgl_sec.png
