n416/katanori/hardware/frozen/v1-v4/_v3_typec_map.png

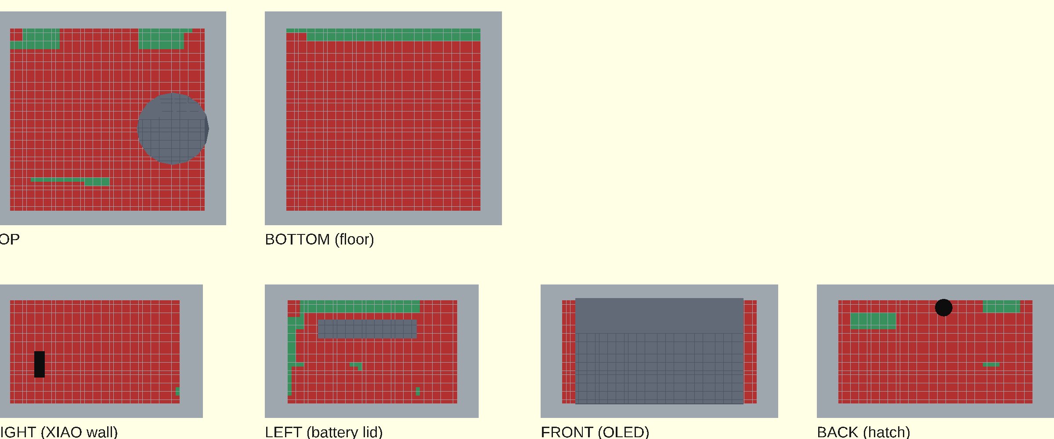
hardware/frozen/v1-v4/_v3_typec_map.png
