n416/katanori/hardware/frozen/v1-v4/_v4_asm_top.png

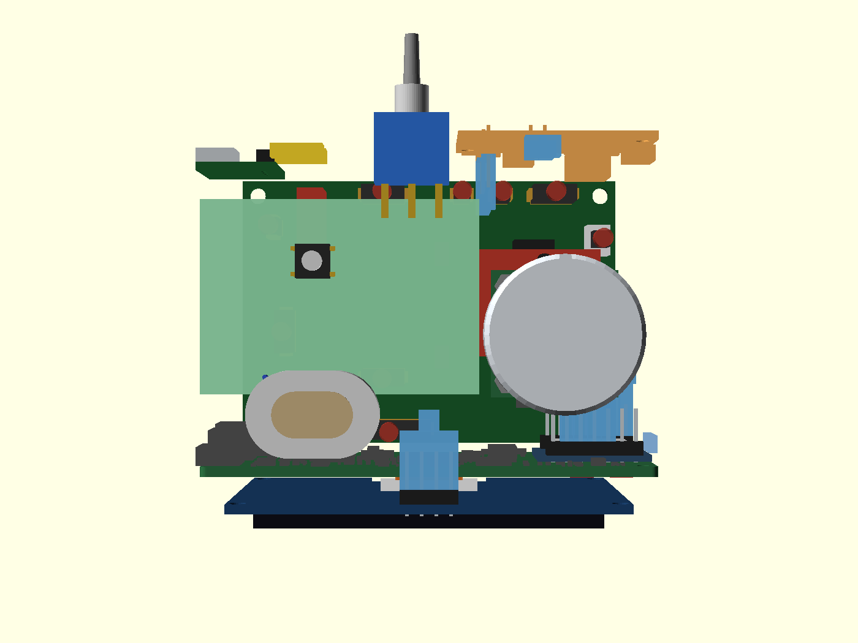
hardware/frozen/v1-v4/_v4_asm_top.png
