n416/katanori/hardware/frozen/v1-v4/_v4_chg_now.png

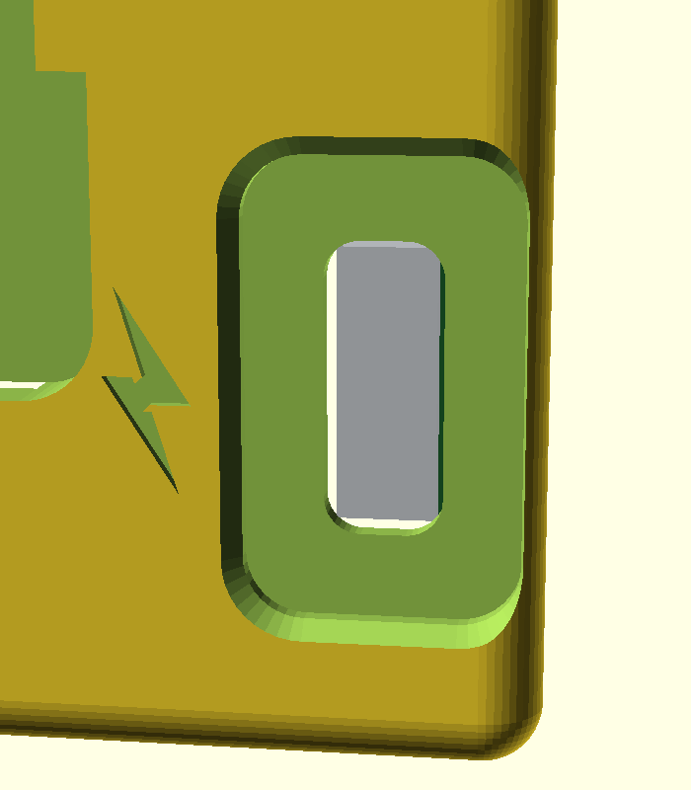
hardware/frozen/v1-v4/_v4_chg_now.png
