n416/katanori/hardware/frozen/v1-v4/_v4_core_iso.png

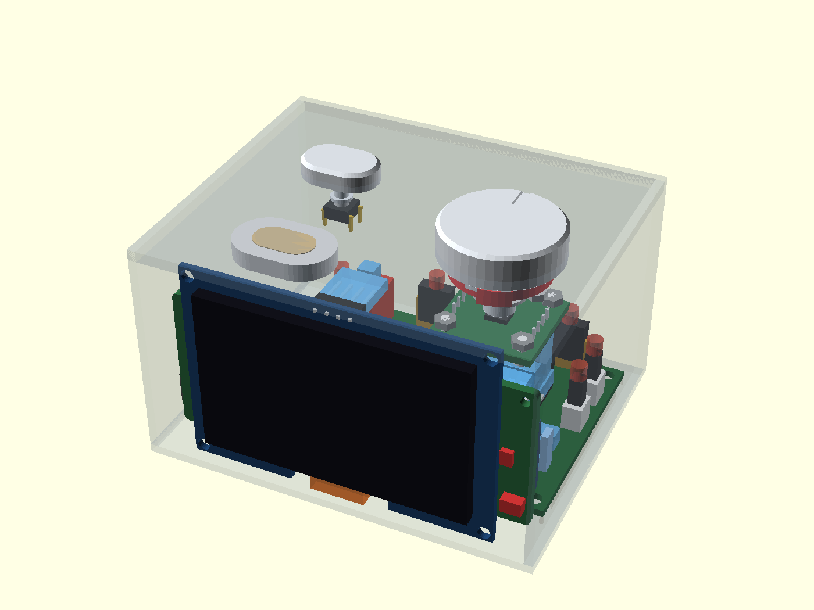
hardware/frozen/v1-v4/_v4_core_iso.png
