n416/katanori/hardware/frozen/v1-v4/_v4_pb_A.png

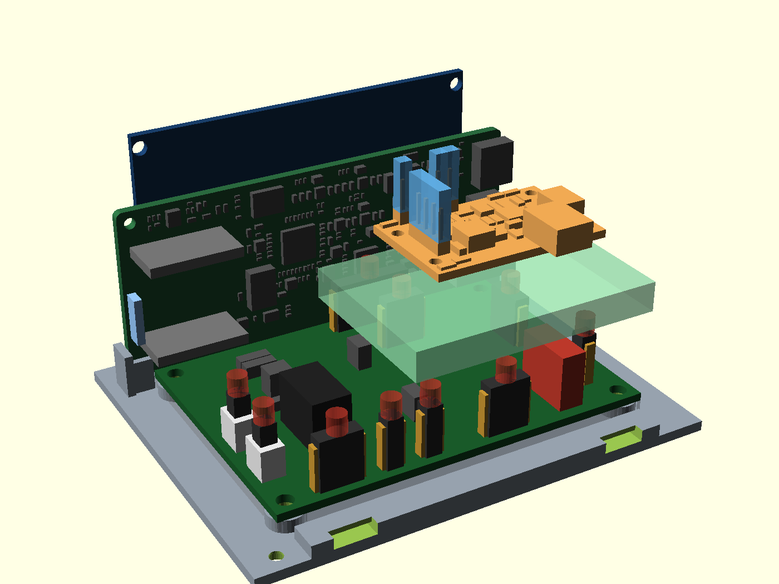
hardware/frozen/v1-v4/_v4_pb_A.png
