n416/katanori/hardware/frozen/v1-v4/_v4_pb_C.png

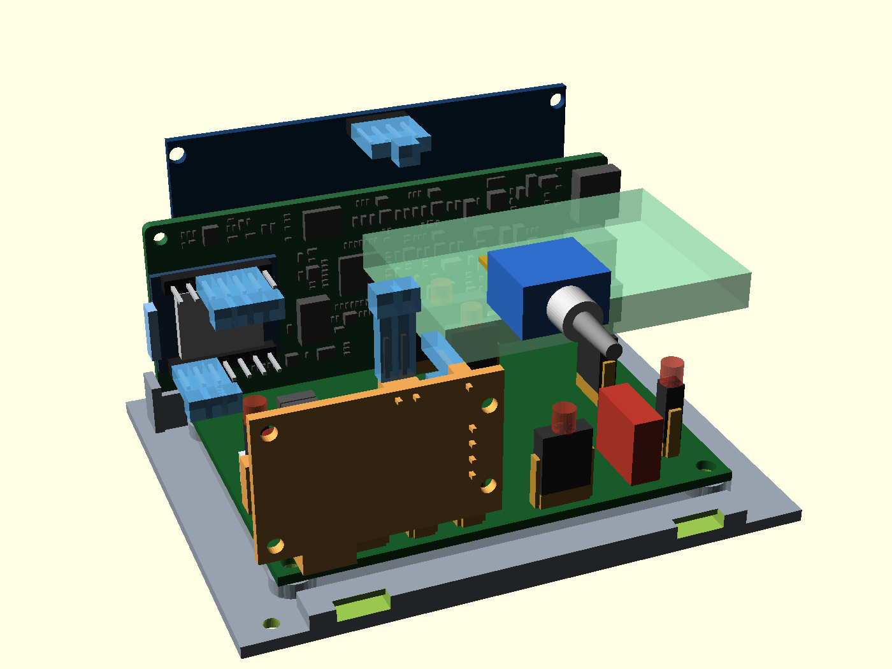
hardware/frozen/v1-v4/_v4_pb_C.png
