n416/katanori/hardware/frozen/v1-v4/_v4_rib_band.png

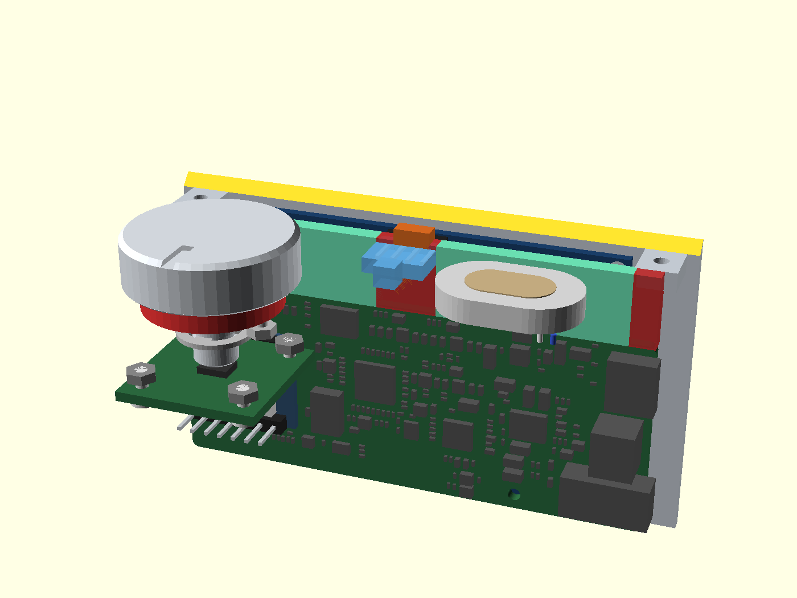
hardware/frozen/v1-v4/_v4_rib_band.png
