n416/katanori/hardware/frozen/v1-v4/_v4_seatgap_zoom.png

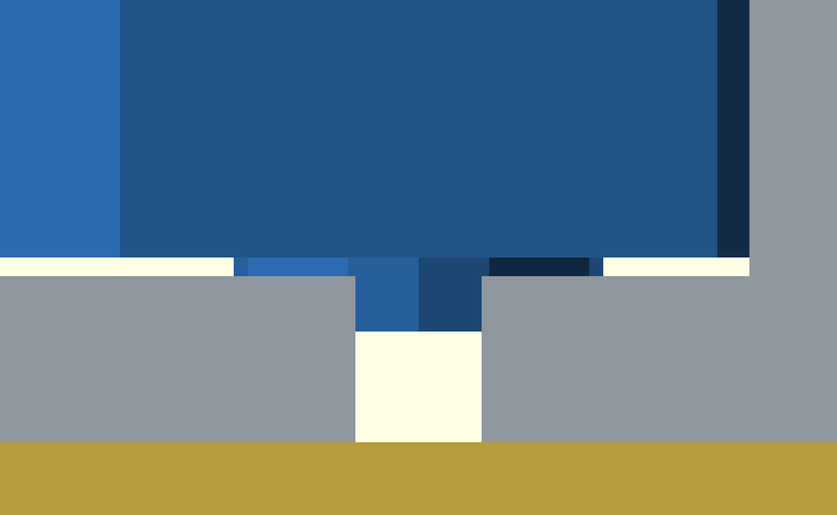
hardware/frozen/v1-v4/_v4_seatgap_zoom.png
