n416/katanori/hardware/frozen/v1-v4/_v4_wires_back.png

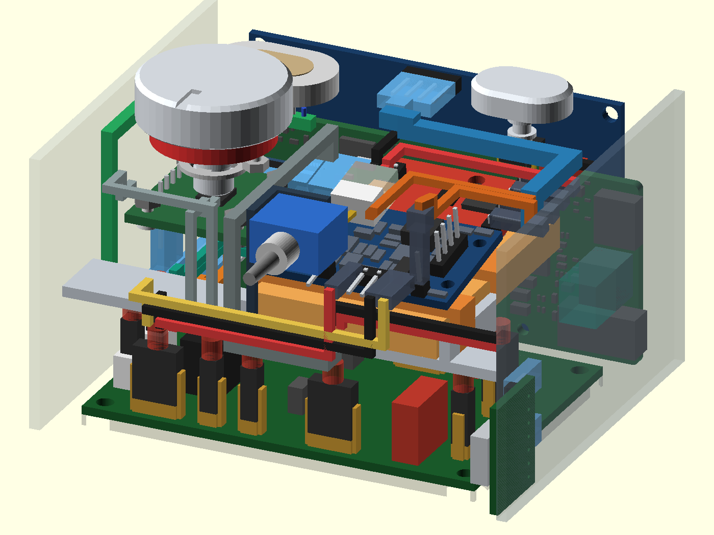
hardware/frozen/v1-v4/_v4_wires_back.png
