n416/katanori/hardware/frozen/v1-v4/renders/board_gauge_v2.png

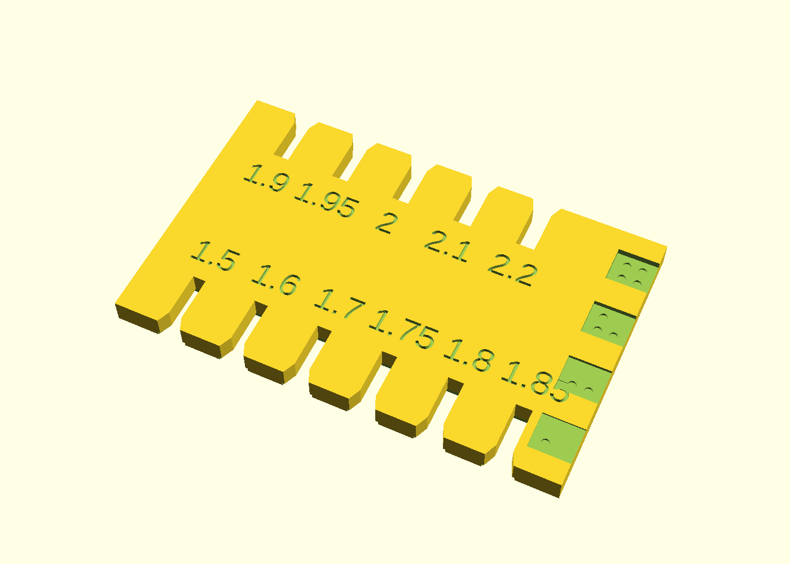
hardware/frozen/v1-v4/renders/board_gauge_v2.png
