n416/katanori/hardware/frozen/v1-v4/renders/case_front2_iso.png

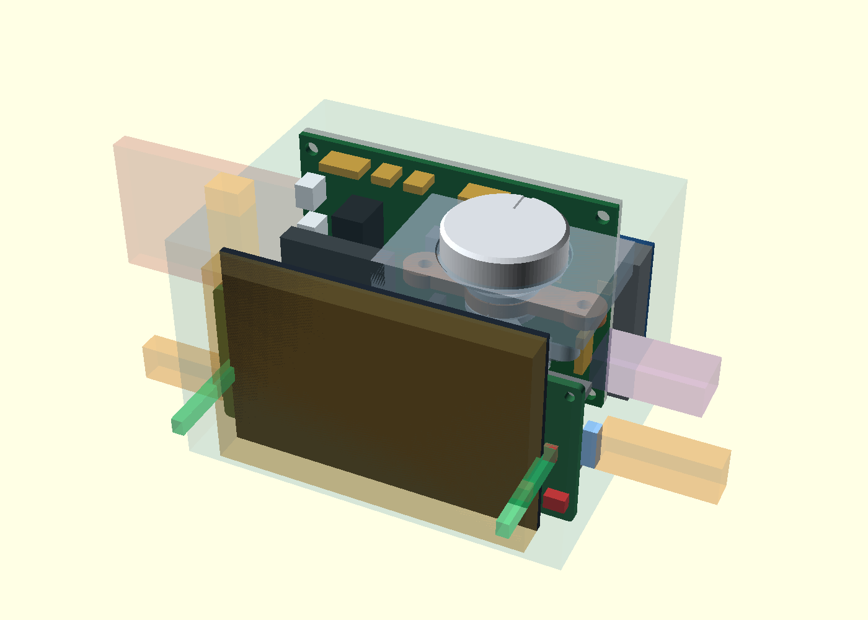
hardware/frozen/v1-v4/renders/case_front2_iso.png
