n416/katanori/hardware/frozen/v1-v4/renders/case_front_face.png

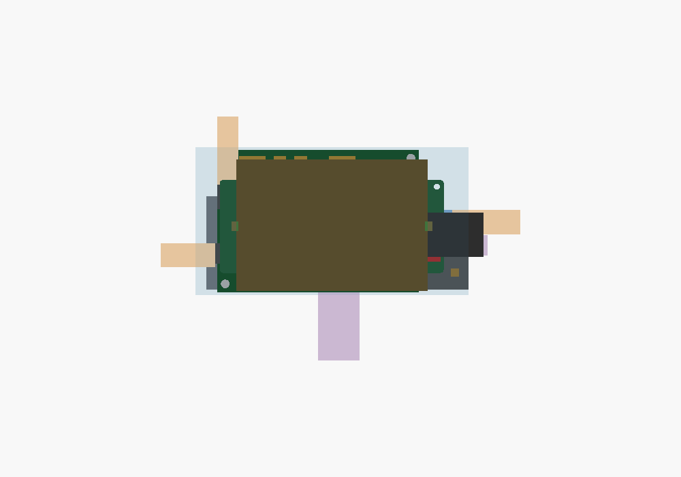
hardware/frozen/v1-v4/renders/case_front_face.png
