n416/katanori/hardware/frozen/v1-v4/renders/case_front_side.png

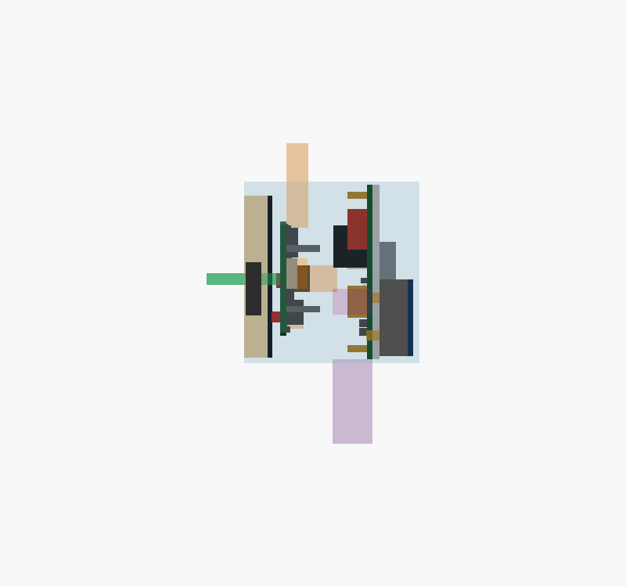
hardware/frozen/v1-v4/renders/case_front_side.png
