n416/katanori/hardware/frozen/v1-v4/renders/case_pack_explode.png

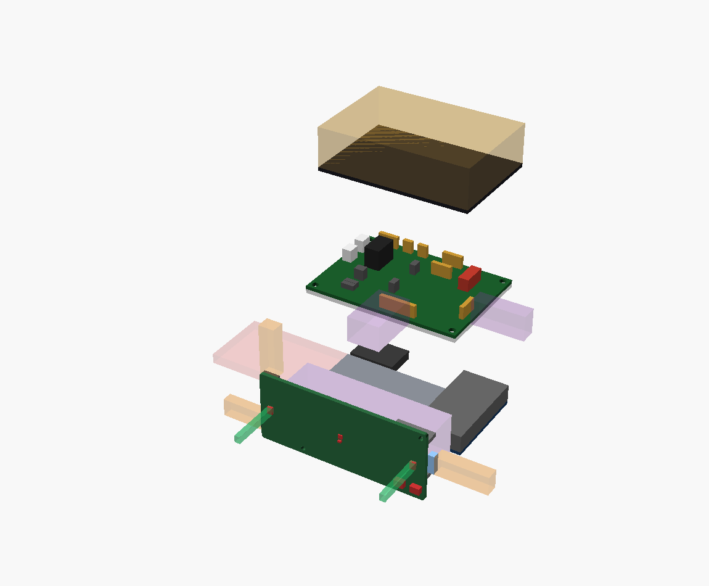
hardware/frozen/v1-v4/renders/case_pack_explode.png
