n416/katanori/hardware/frozen/v1-v4/renders/case_pack_side_vert.png

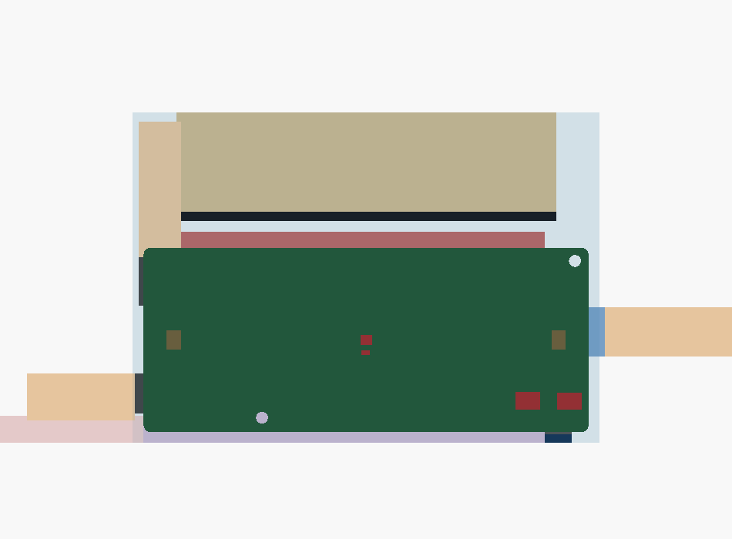
hardware/frozen/v1-v4/renders/case_pack_side_vert.png
