n416/katanori/hardware/frozen/v1-v4/renders/case_pack_top.png

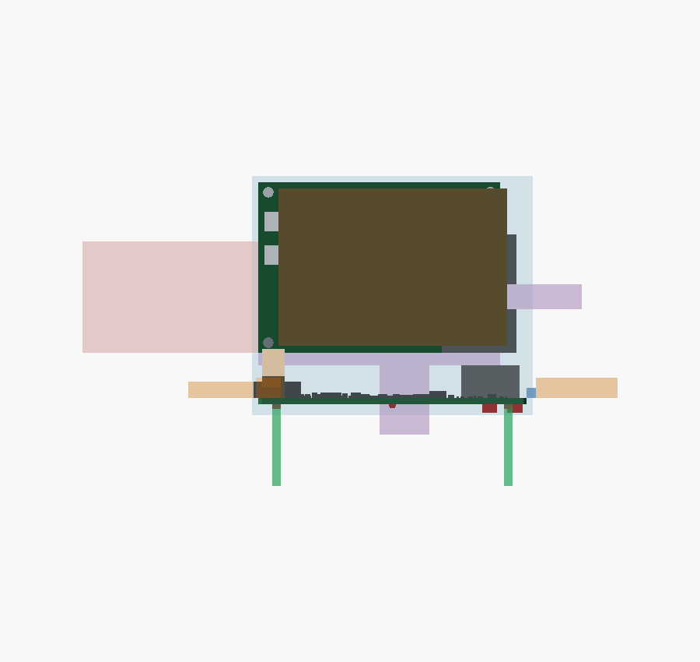
hardware/frozen/v1-v4/renders/case_pack_top.png
