n416/katanori/hardware/frozen/v1-v4/renders/case_top_under.png

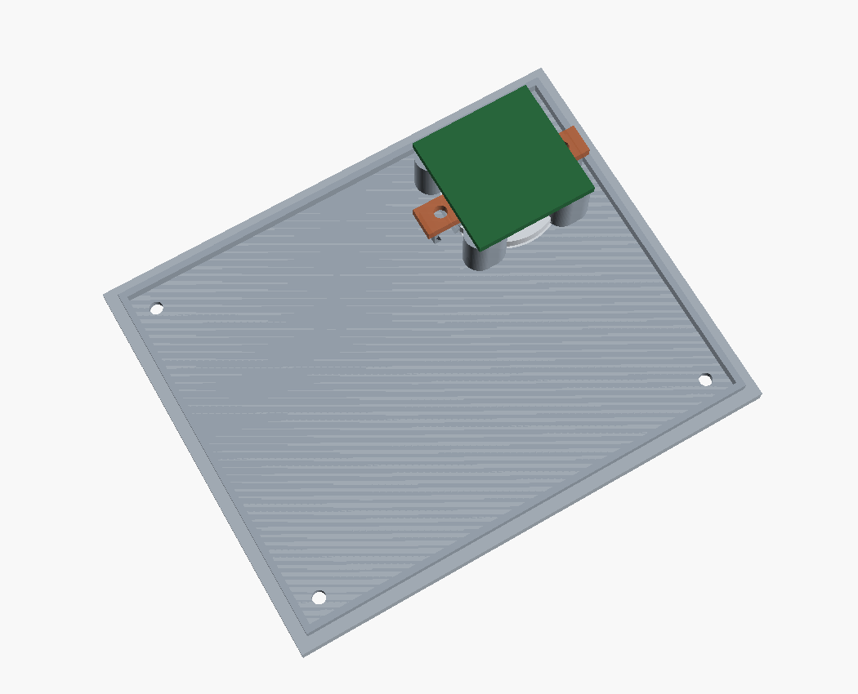
hardware/frozen/v1-v4/renders/case_top_under.png
