n416/katanori/hardware/frozen/v1-v4/renders/case_v1_explode.png

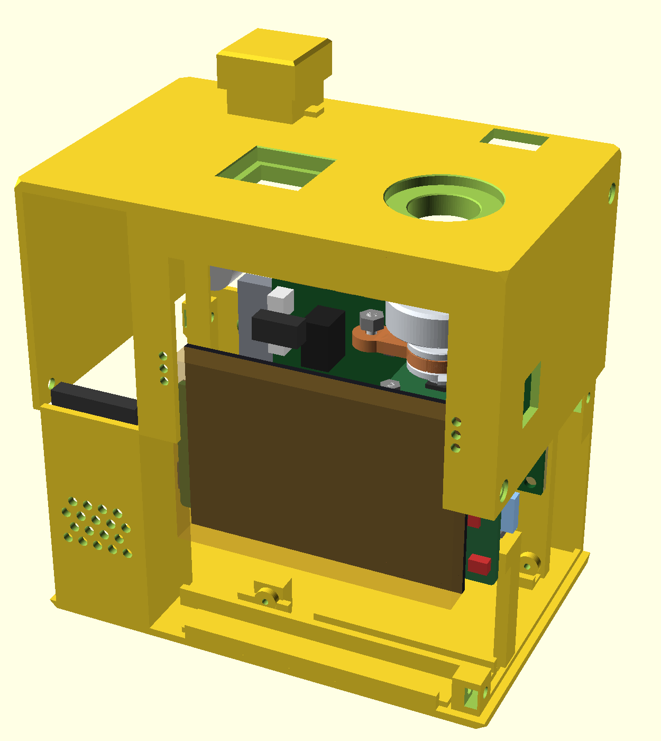
hardware/frozen/v1-v4/renders/case_v1_explode.png
