n416/katanori/hardware/frozen/v1-v4/renders/case_v1_iso.png

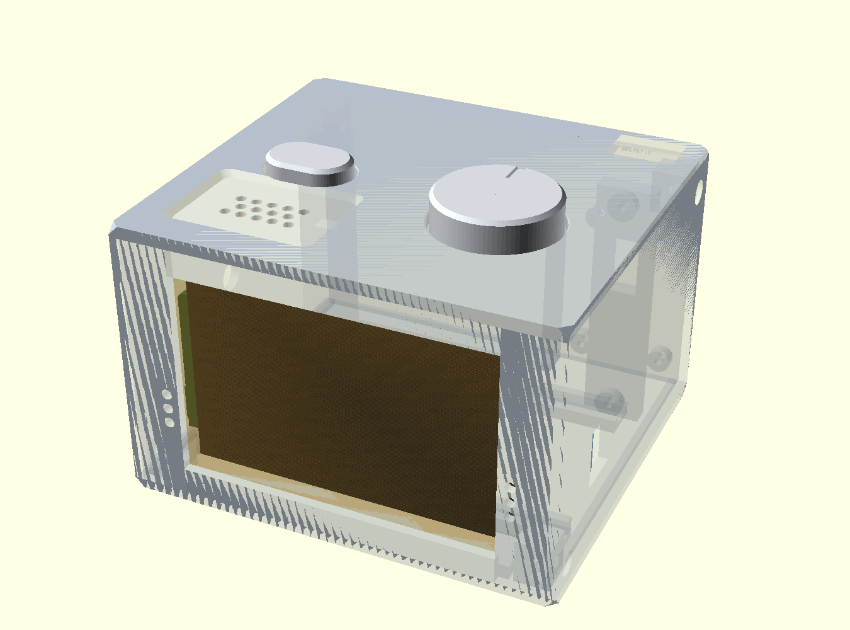
hardware/frozen/v1-v4/renders/case_v1_iso.png
