n416/katanori/hardware/frozen/v1-v4/renders/case_v1_lower.png

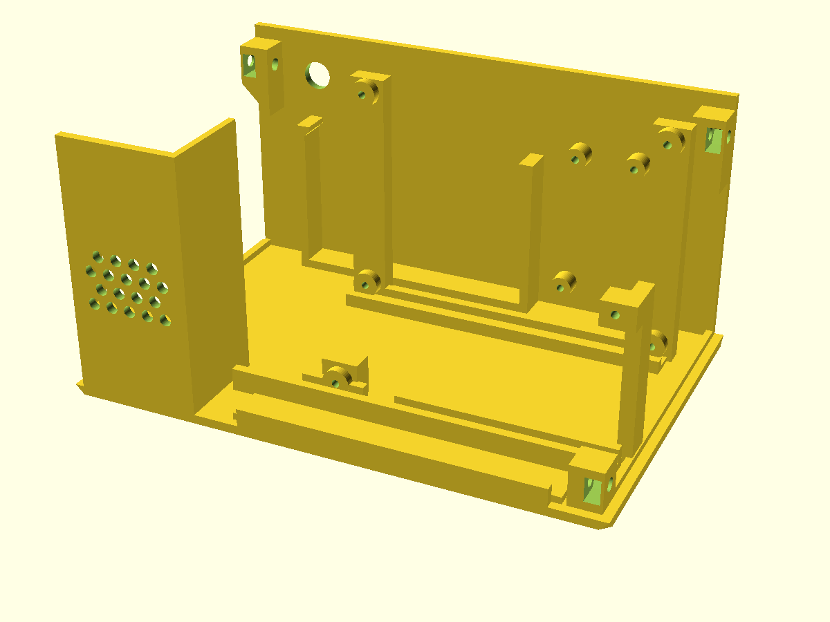
hardware/frozen/v1-v4/renders/case_v1_lower.png
