n416/katanori/hardware/frozen/v1-v4/renders/case_v1_tail.png

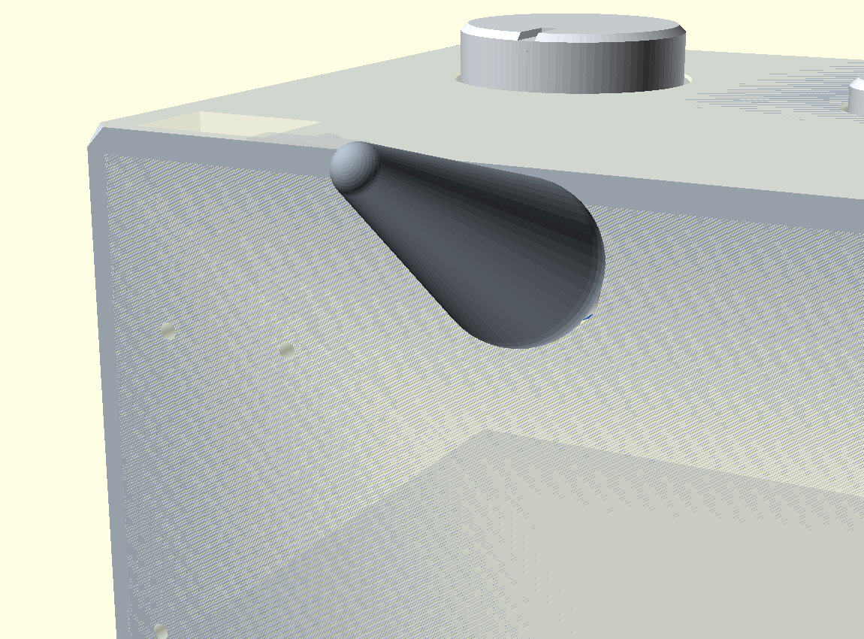
hardware/frozen/v1-v4/renders/case_v1_tail.png
