n416/katanori/hardware/frozen/v1-v4/renders/hub_board.png

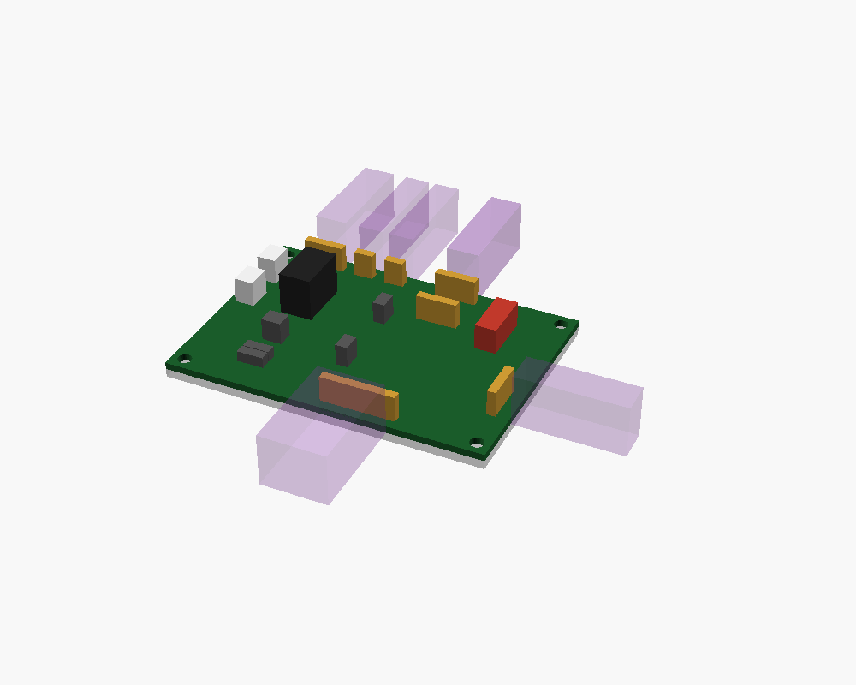
hardware/frozen/v1-v4/renders/hub_board.png
