n416/katanori/hardware/frozen/v1-v4/renders/knob_explode.png

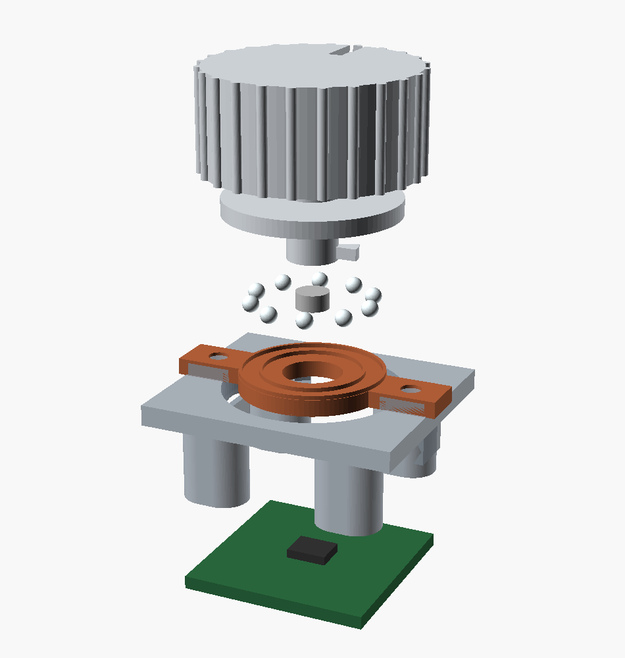
hardware/frozen/v1-v4/renders/knob_explode.png
