n416/katanori/hardware/frozen/v1-v4/renders/knob_top.png

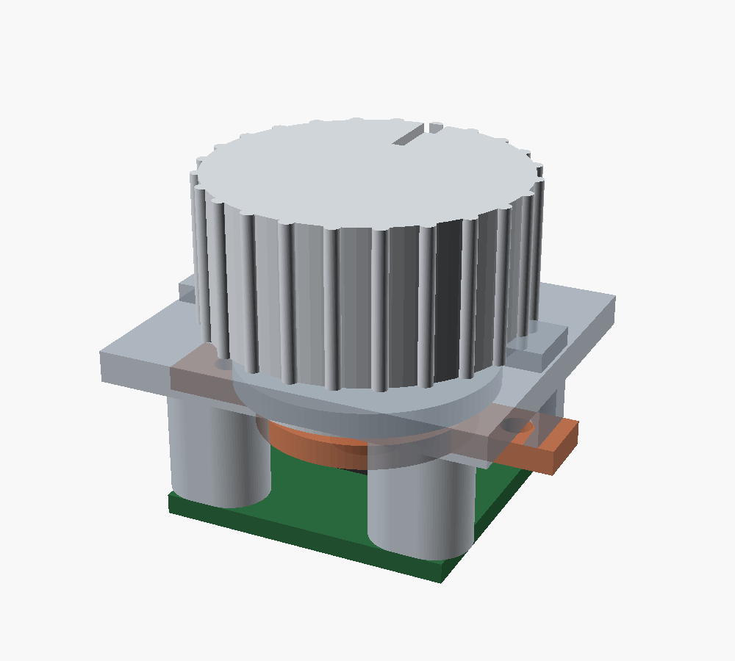
hardware/frozen/v1-v4/renders/knob_top.png
