n416/katanori/hardware/frozen/v1-v4/renders/v_cmp.png

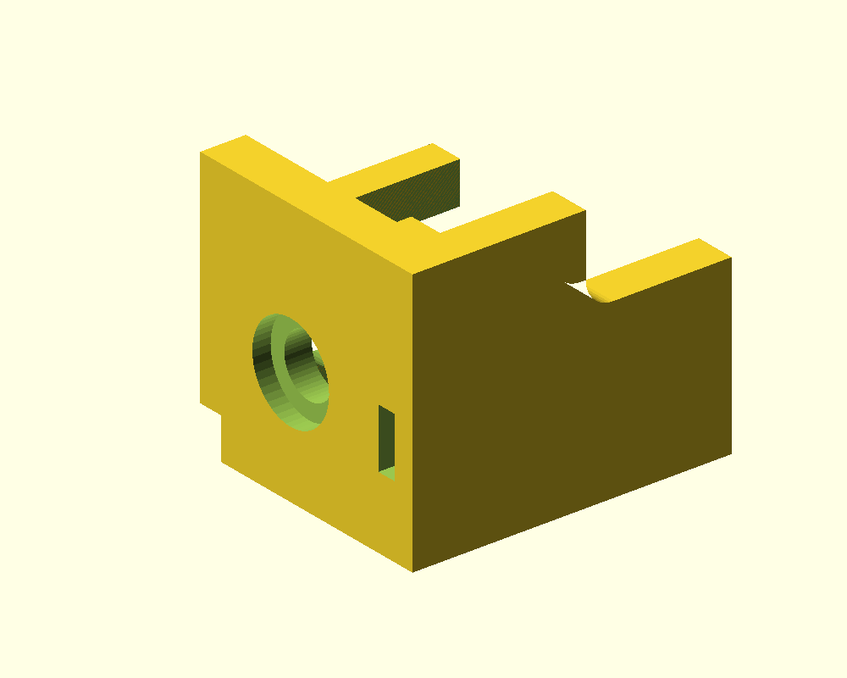
hardware/frozen/v1-v4/renders/v_cmp.png
