n416/katanori/hardware/frozen/v1-v4/renders/v_flip.png

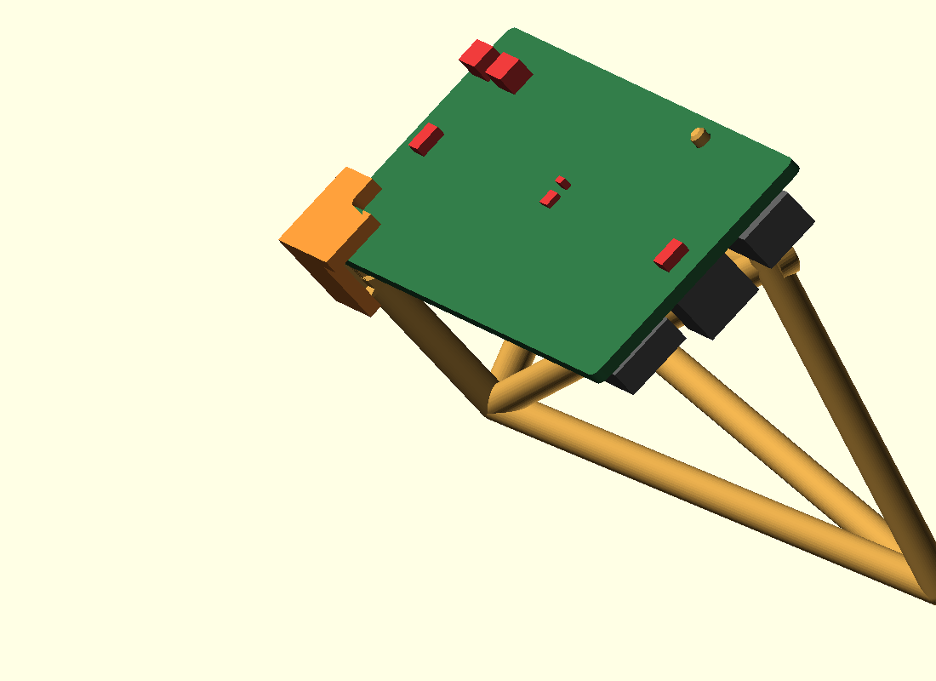
hardware/frozen/v1-v4/renders/v_flip.png
