n416/katanori/hardware/frozen/v1-v4/renders/v_leg1.png

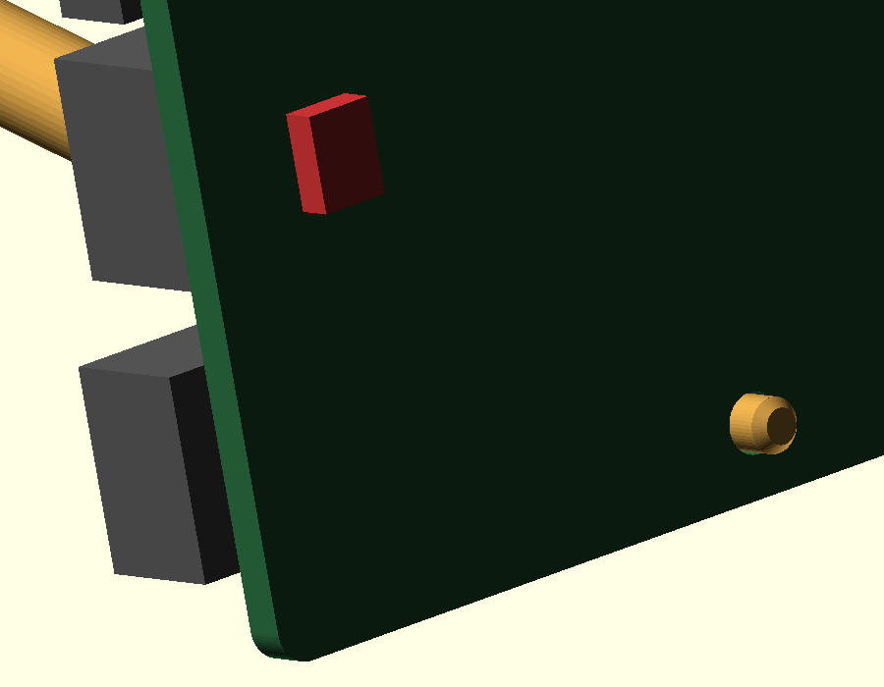
hardware/frozen/v1-v4/renders/v_leg1.png
