n416/katanori/hardware/frozen/v1-v4/renders/v_lock2.png

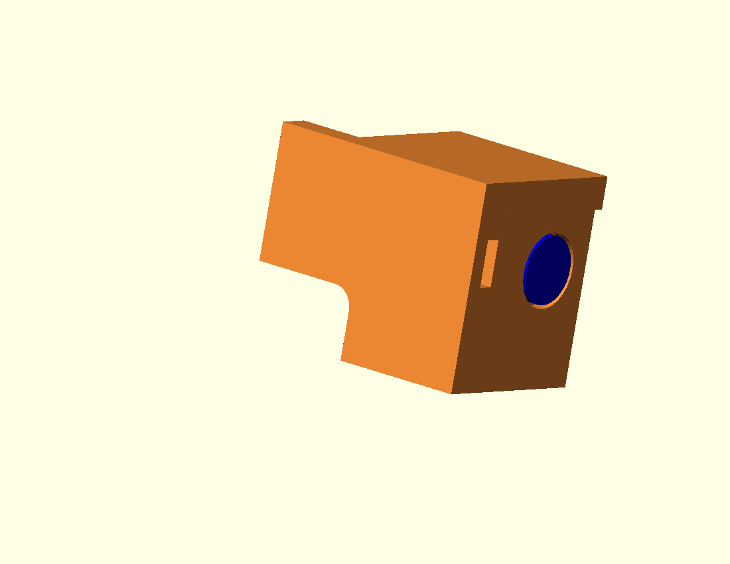
hardware/frozen/v1-v4/renders/v_lock2.png
