n416/katanori/hardware/frozen/v1-v4/renders/v_lock4.png

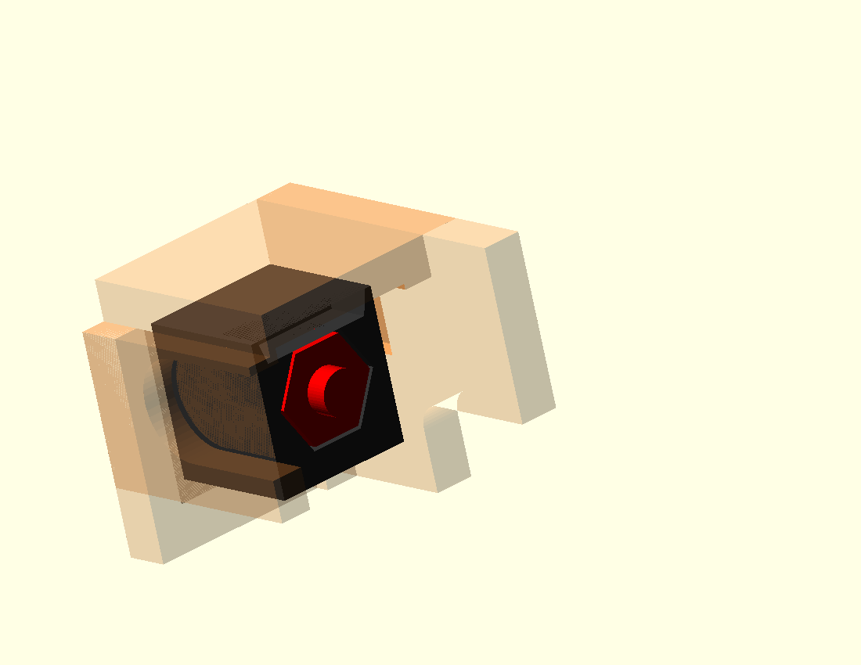
hardware/frozen/v1-v4/renders/v_lock4.png
