n416/katanori/hardware/frozen/v1-v4/renders/v_lock.png

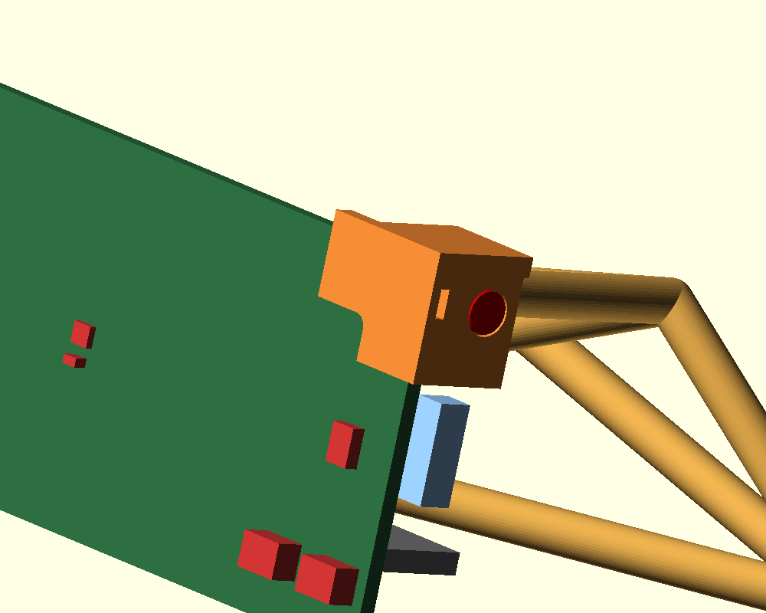
hardware/frozen/v1-v4/renders/v_lock.png
