n416/katanori/hardware/frozen/v1-v4/renders/v_nut.png

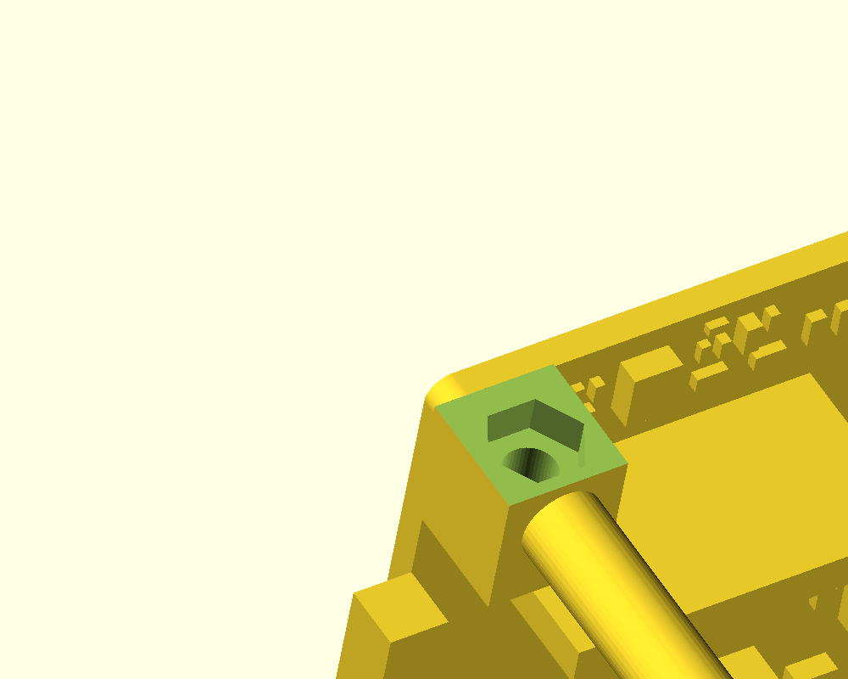
hardware/frozen/v1-v4/renders/v_nut.png
