n416/katanori/hardware/frozen/v6/chk/sgear_hold.png

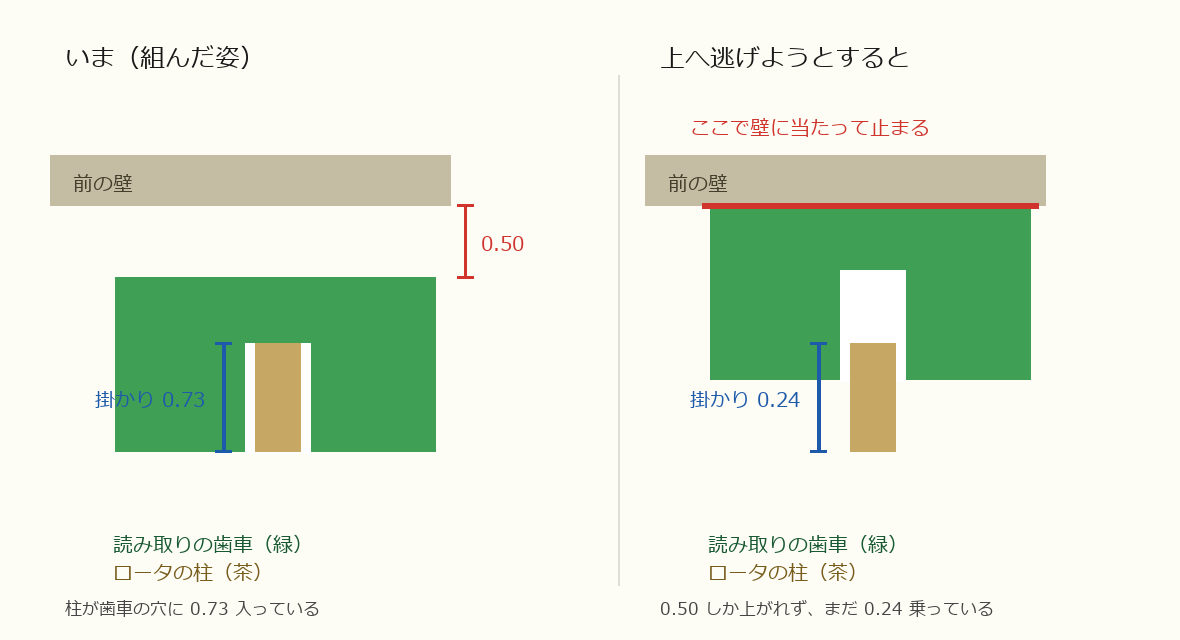
hardware/frozen/v6/chk/sgear_hold.png
