n416/katanori/hardware/frozen/v6/pcb/hub_power/pcb_3d.png

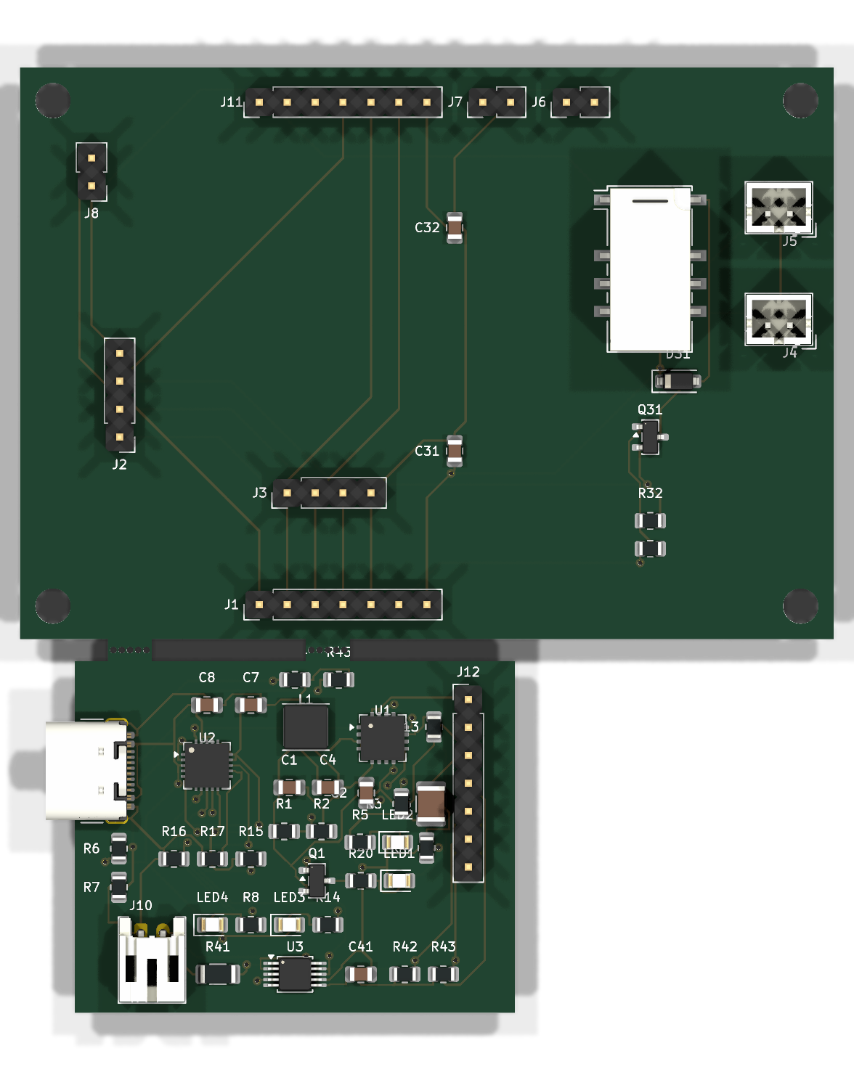
hardware/frozen/v6/pcb/hub_power/pcb_3d.png
