n416/katanori/hardware/frozen/v6/pcb/hub_power/pcb_usbc.png

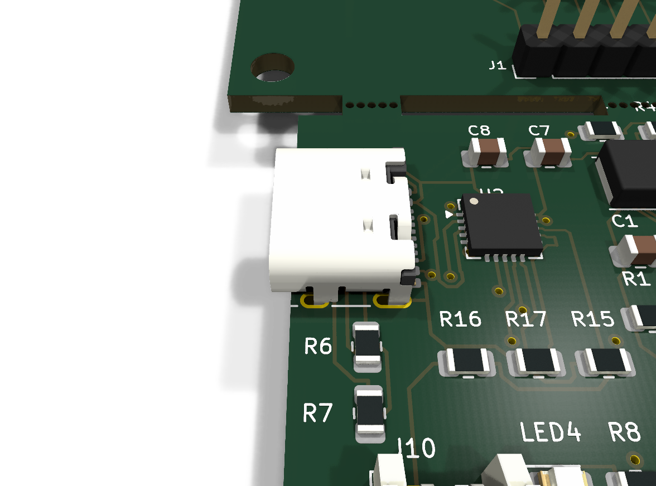
hardware/frozen/v6/pcb/hub_power/pcb_usbc.png
