n416/katanori/hardware/frozen/v6/pcb/hub_power/v6_top.png

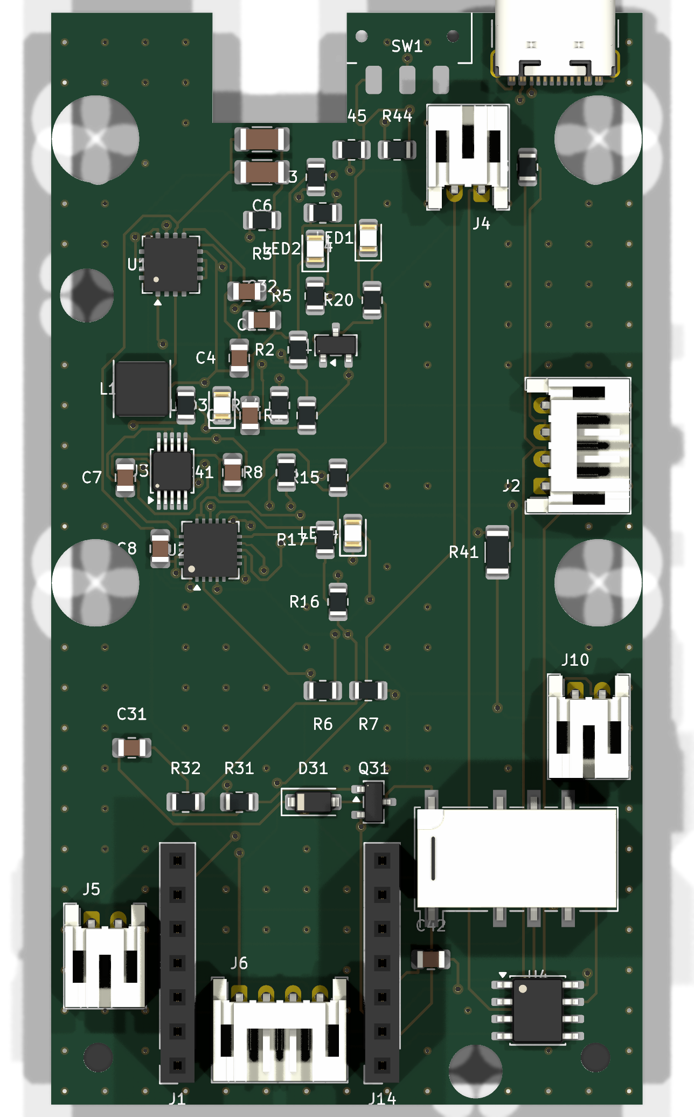
hardware/frozen/v6/pcb/hub_power/v6_top.png
