n416/katanori/hardware/frozen/v6/renders/_v6_edge_side.png

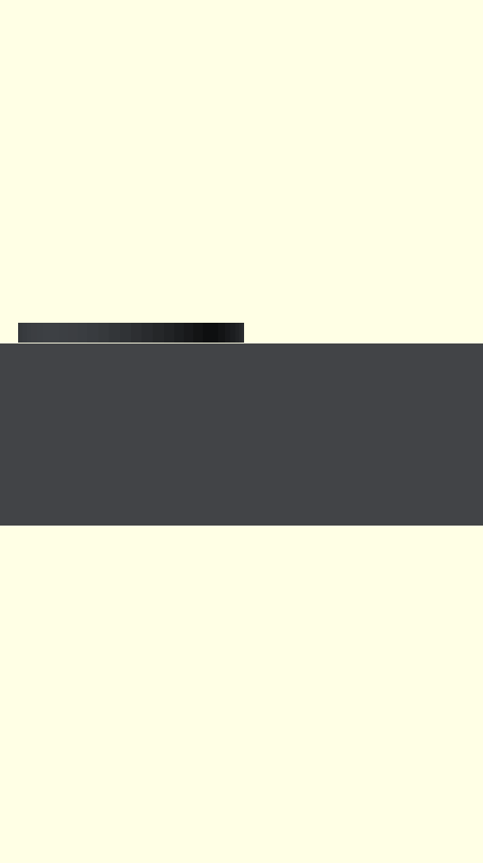
hardware/frozen/v6/renders/_v6_edge_side.png
