n416/katanori/hardware/frozen/v6/renders/_v6_edge_top.png

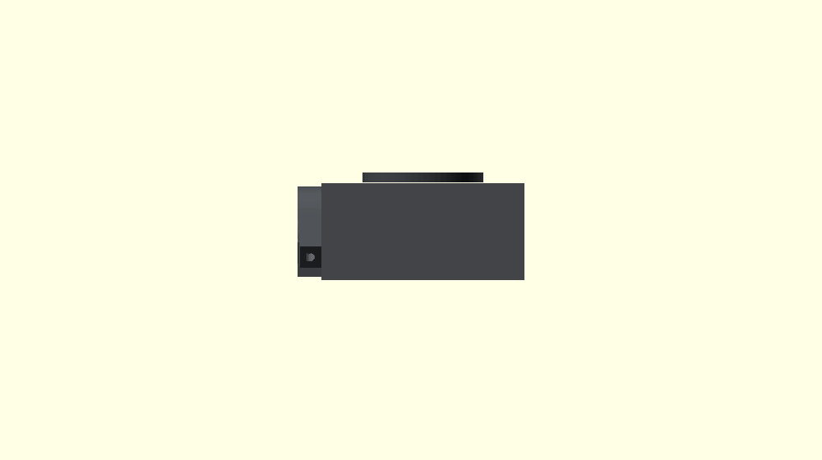
hardware/frozen/v6/renders/_v6_edge_top.png
