n416/katanori/hardware/frozen/v6/renders/_v6_exp_iso.png

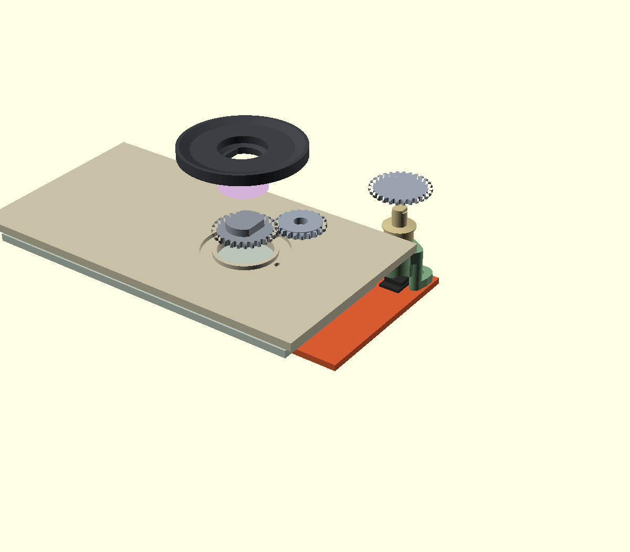
hardware/frozen/v6/renders/_v6_exp_iso.png
