n416/katanori/hardware/frozen/v6/renders/_v6_face_front.png

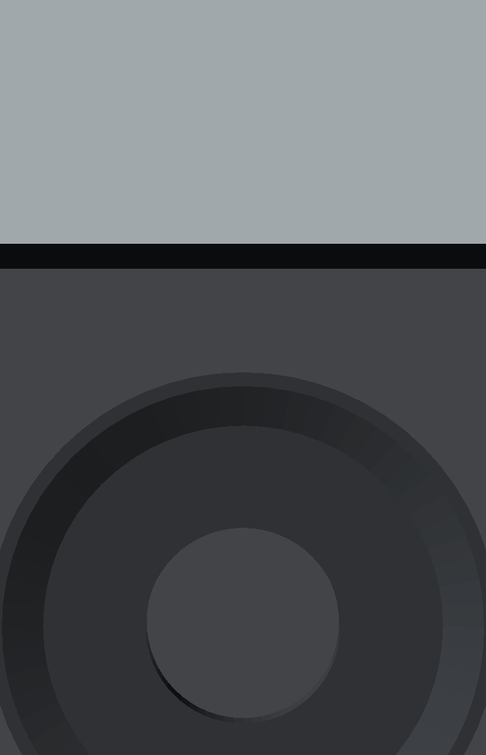
hardware/frozen/v6/renders/_v6_face_front.png
