n416/katanori/hardware/frozen/v6/renders/_v6_gear_turn.gif

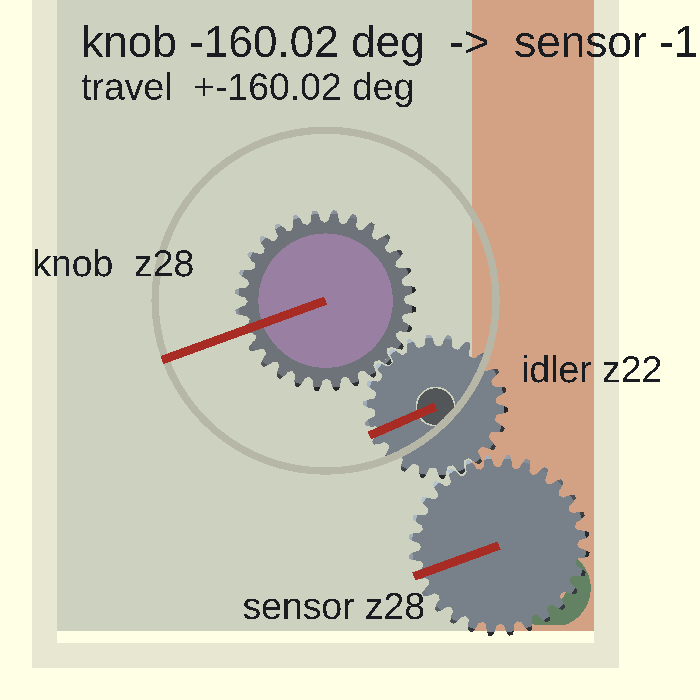
hardware/frozen/v6/renders/_v6_gear_turn.gif
