n416/katanori/hardware/frozen/v6/renders/_v6_guts3d.png

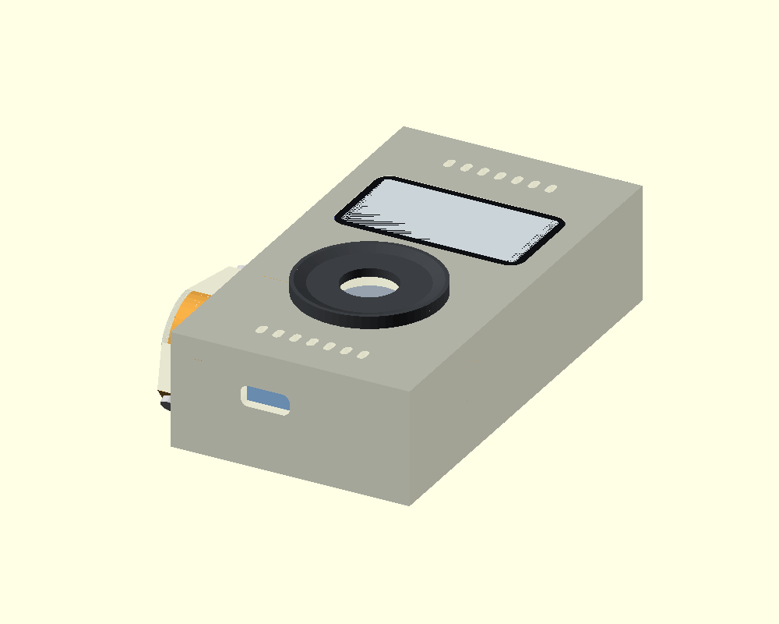
hardware/frozen/v6/renders/_v6_guts3d.png
