n416/katanori/hardware/frozen/v6/renders/_v6_hold.png

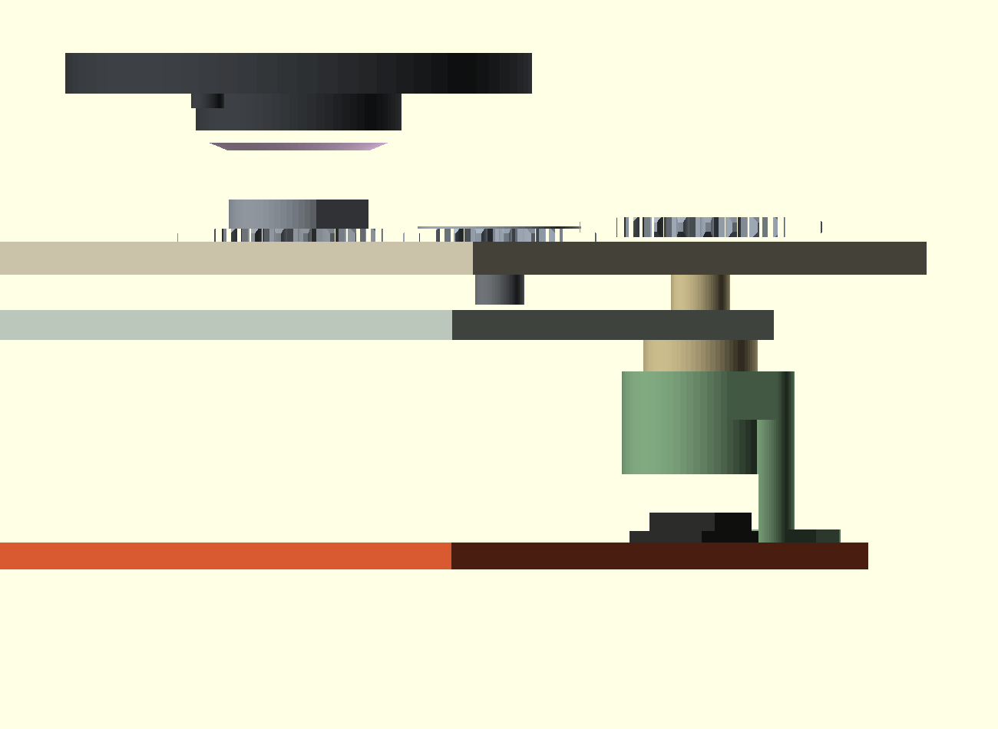
hardware/frozen/v6/renders/_v6_hold.png
