n416/katanori/hardware/frozen/v6/renders/_v6_hold_asm.png

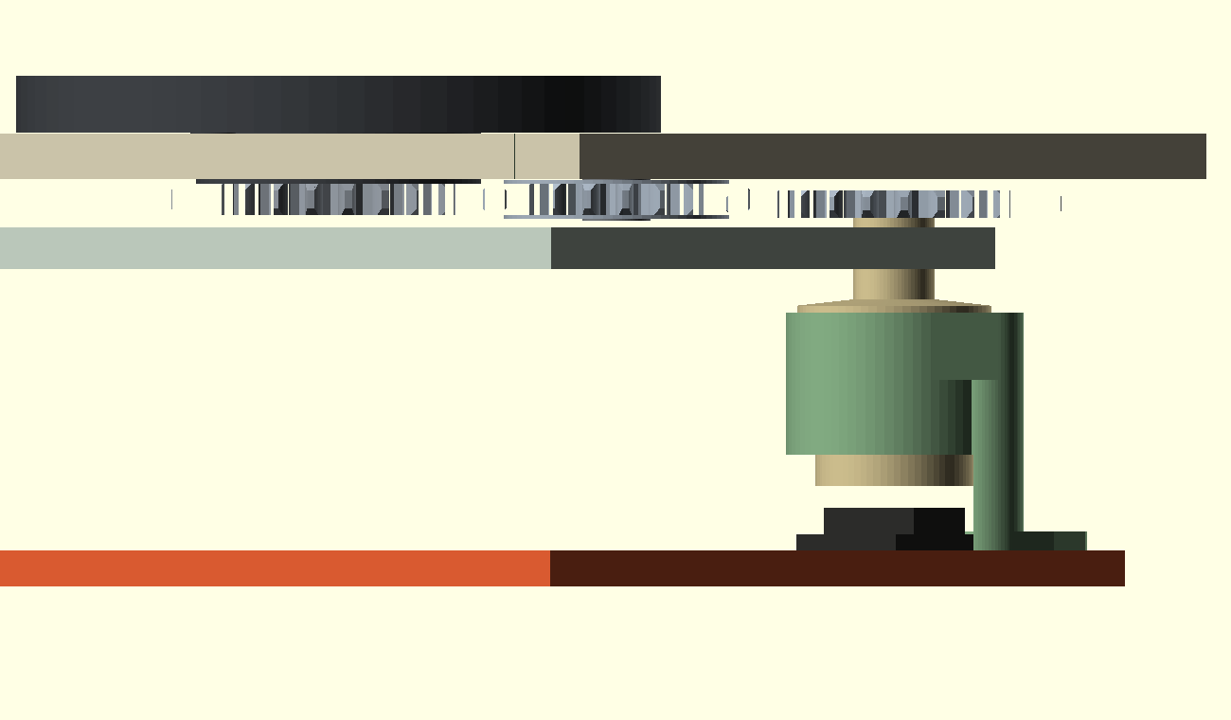
hardware/frozen/v6/renders/_v6_hold_asm.png
