n416/katanori/hardware/frozen/v6/renders/_v6_inside.png

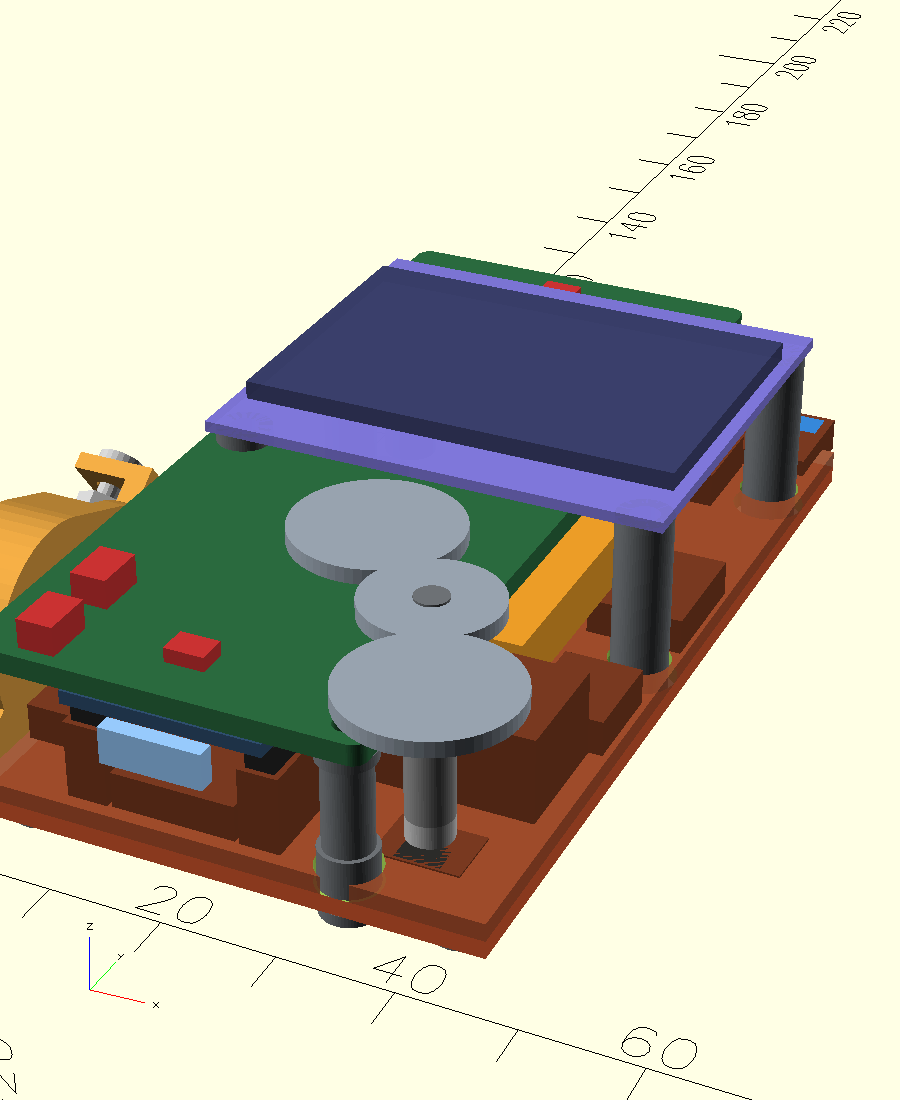
hardware/frozen/v6/renders/_v6_inside.png
