n416/katanori/hardware/frozen/v6/renders/_v6_lift0.png

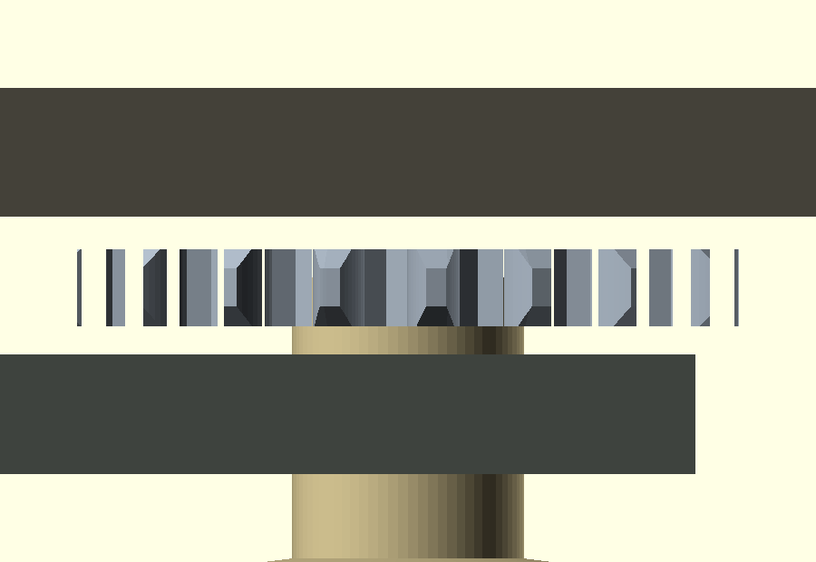
hardware/frozen/v6/renders/_v6_lift0.png
