n416/katanori/hardware/frozen/v6/renders/_v6_plug_face.png

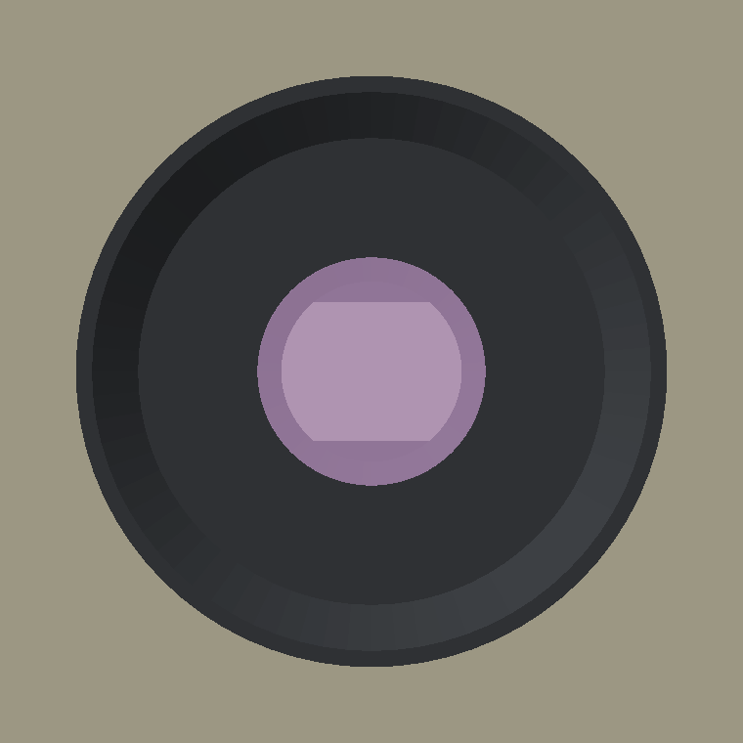
hardware/frozen/v6/renders/_v6_plug_face.png
