n416/katanori/hardware/frozen/v6/renders/_v6_plug_in.png

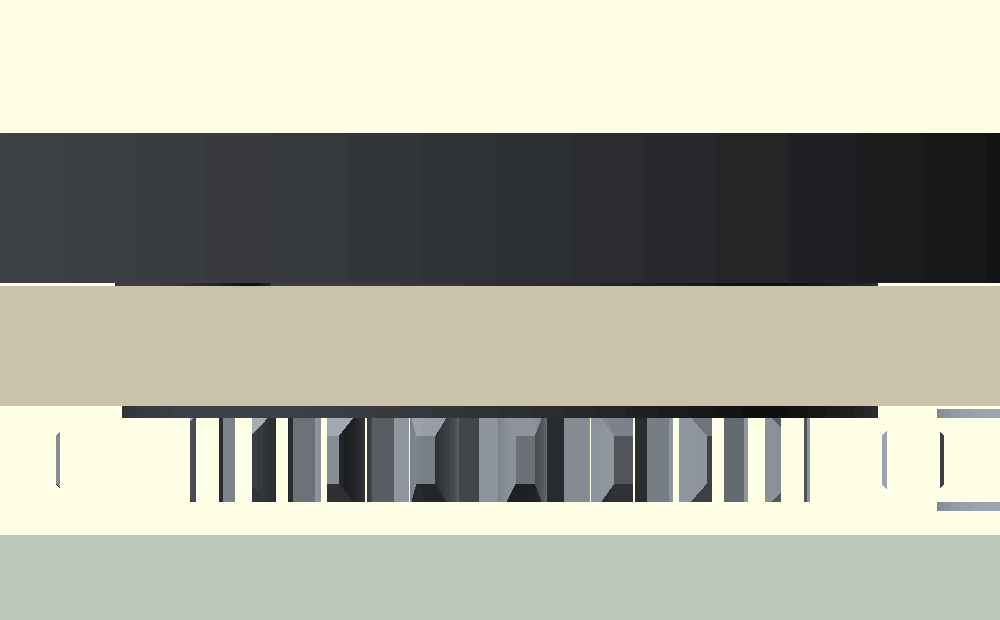
hardware/frozen/v6/renders/_v6_plug_in.png
