n416/katanori/hardware/frozen/v6/renders/_v6_pt_back.png

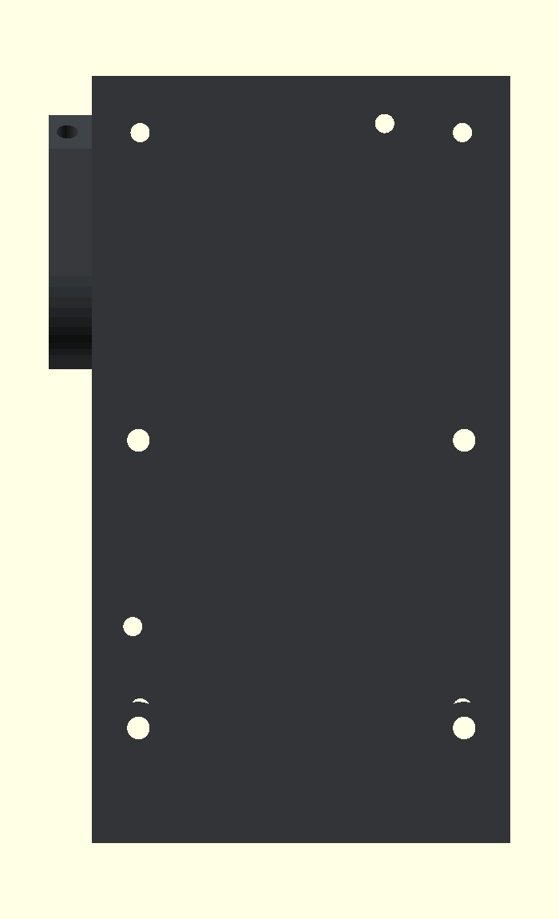
hardware/frozen/v6/renders/_v6_pt_back.png
