n416/katanori/hardware/frozen/v6/renders/_v6_scr_0.2.png

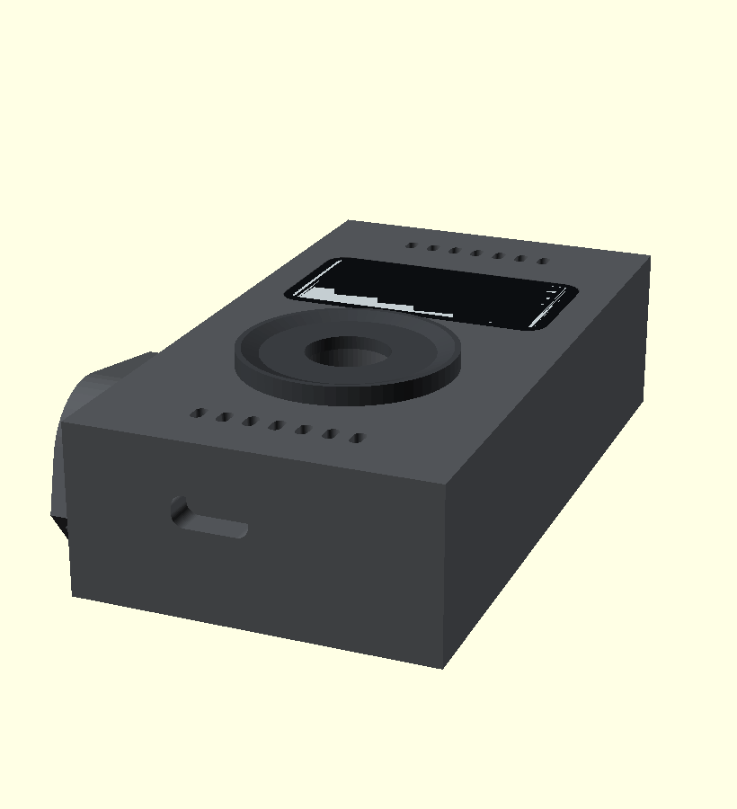
hardware/frozen/v6/renders/_v6_scr_0.2.png
