n416/katanori/hardware/frozen/v6/renders/_v6_side.png

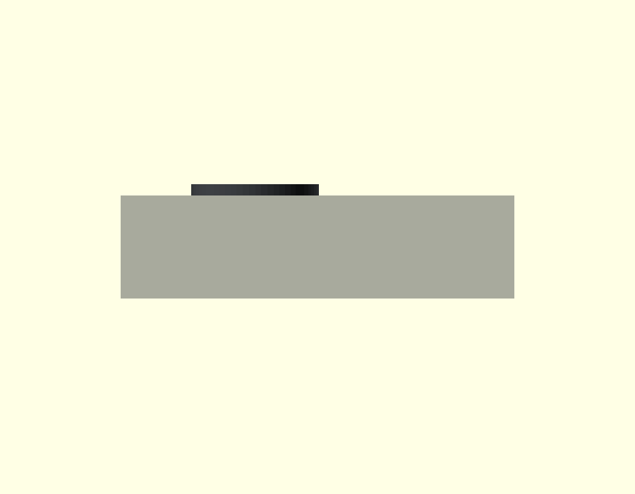
hardware/frozen/v6/renders/_v6_side.png
