n416/katanori/hardware/frozen/v6/renders/_v6_stack.png

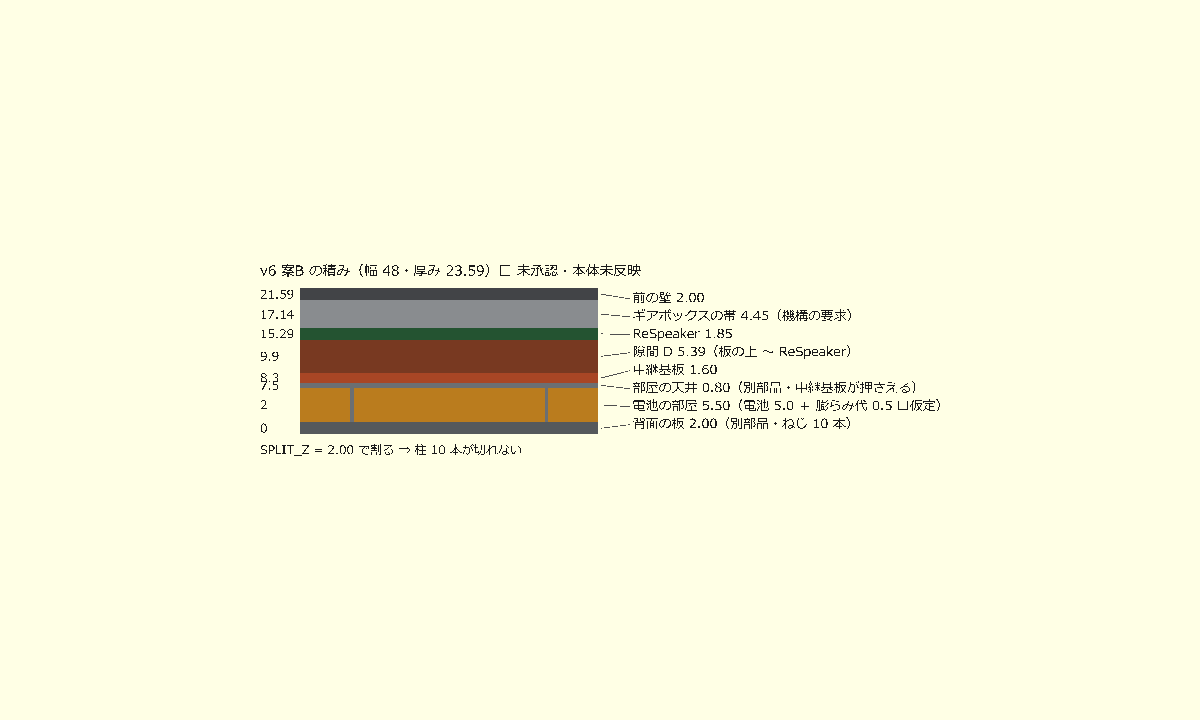
hardware/frozen/v6/renders/_v6_stack.png
