n416/katanori/hardware/frozen/v6/renders/_v6_stop_80.png

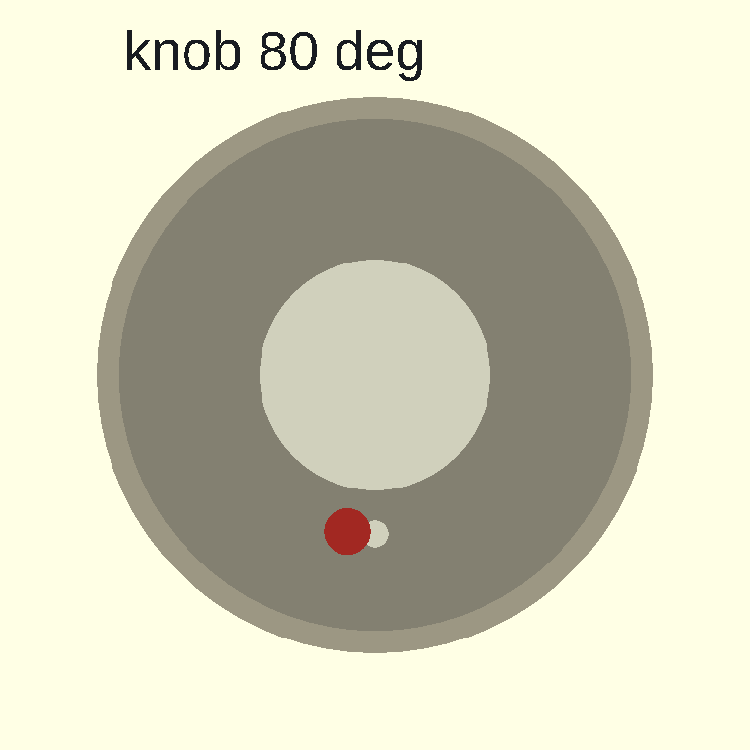
hardware/frozen/v6/renders/_v6_stop_80.png
