n416/katanori/hardware/frozen/v6/sim2d/frame40.png

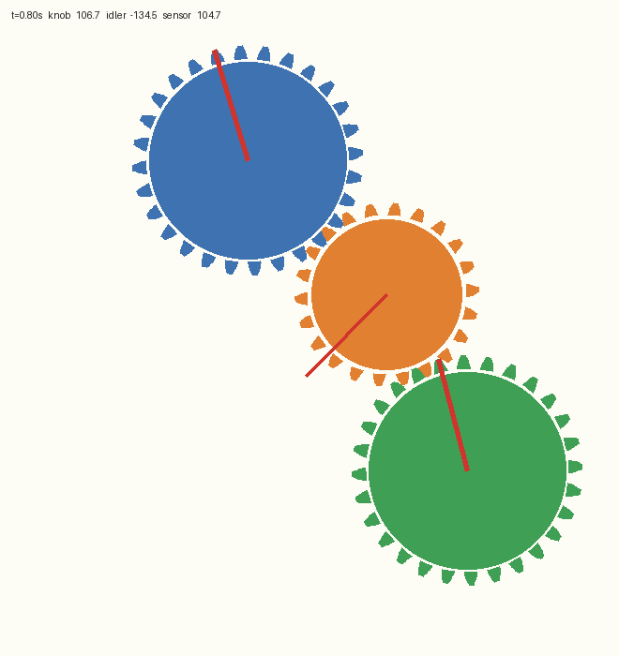
hardware/frozen/v6/sim2d/frame40.png
