n416/katanori/hardware/ref/as5600_overlay.png

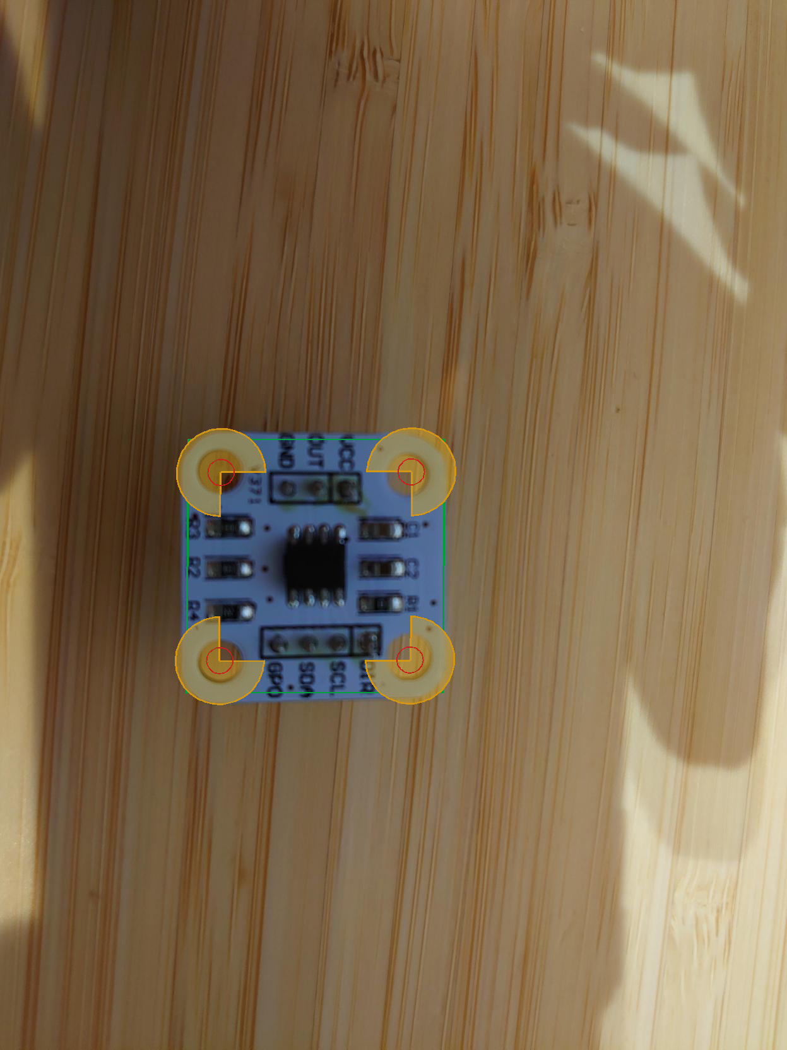
hardware/ref/as5600_overlay.png
