n416/katanori/hardware/ref/as5600_rect.png

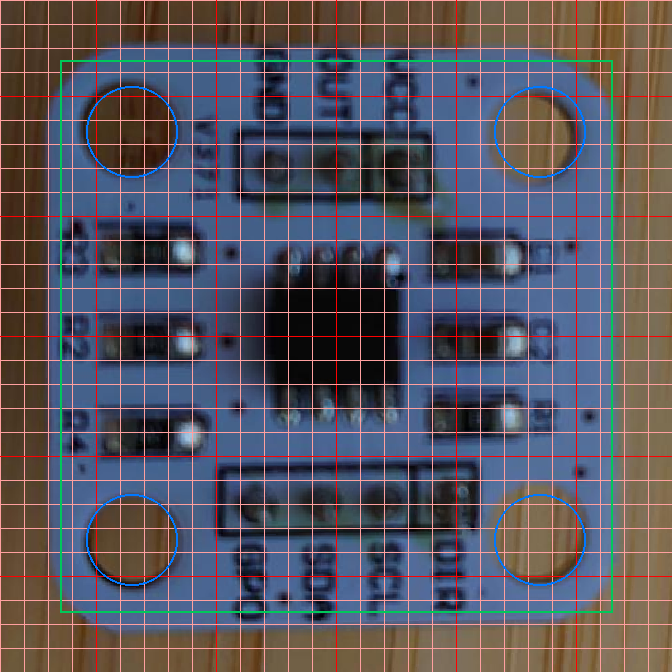
hardware/ref/as5600_rect.png
