n416/katanori/hardware/ref/as5600_row_bot.png

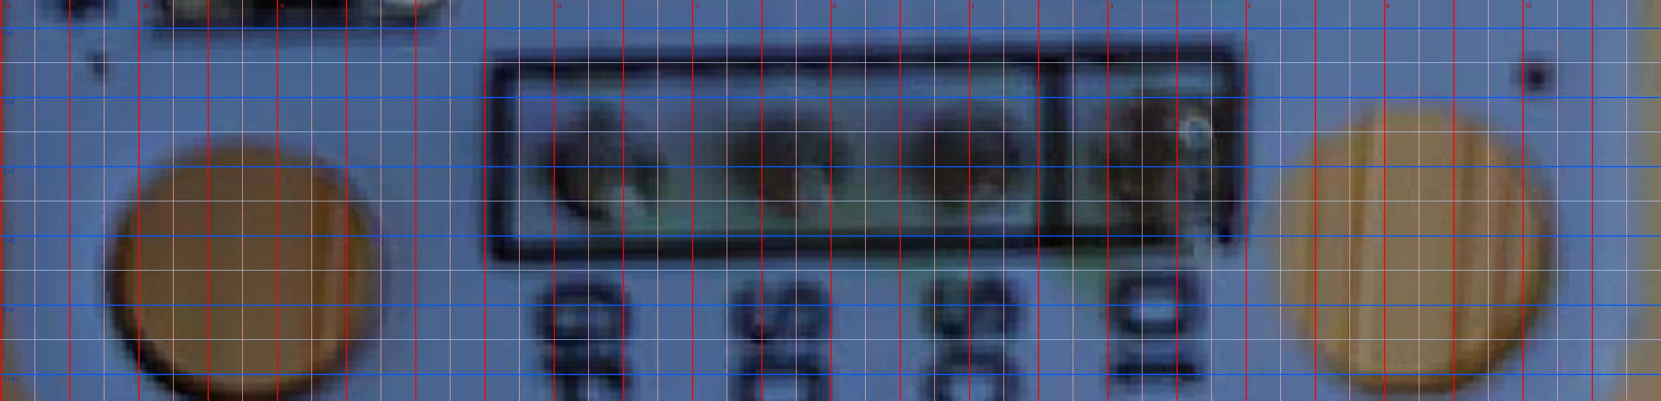
hardware/ref/as5600_row_bot.png
