n416/katanori/hardware/ref/as5600_row_top.png

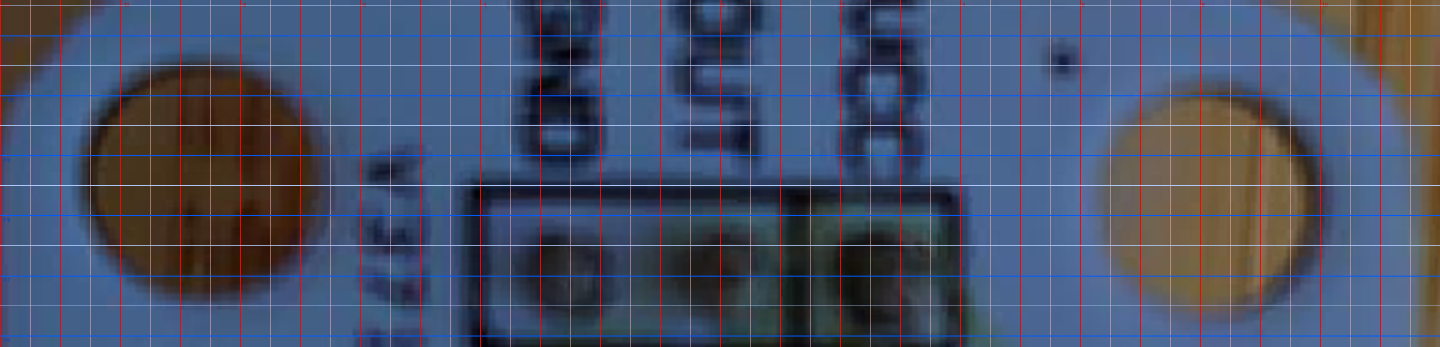
hardware/ref/as5600_row_top.png
