n416/katanori/hardware/ref/battery_dtp/DTP502535_外形図.png

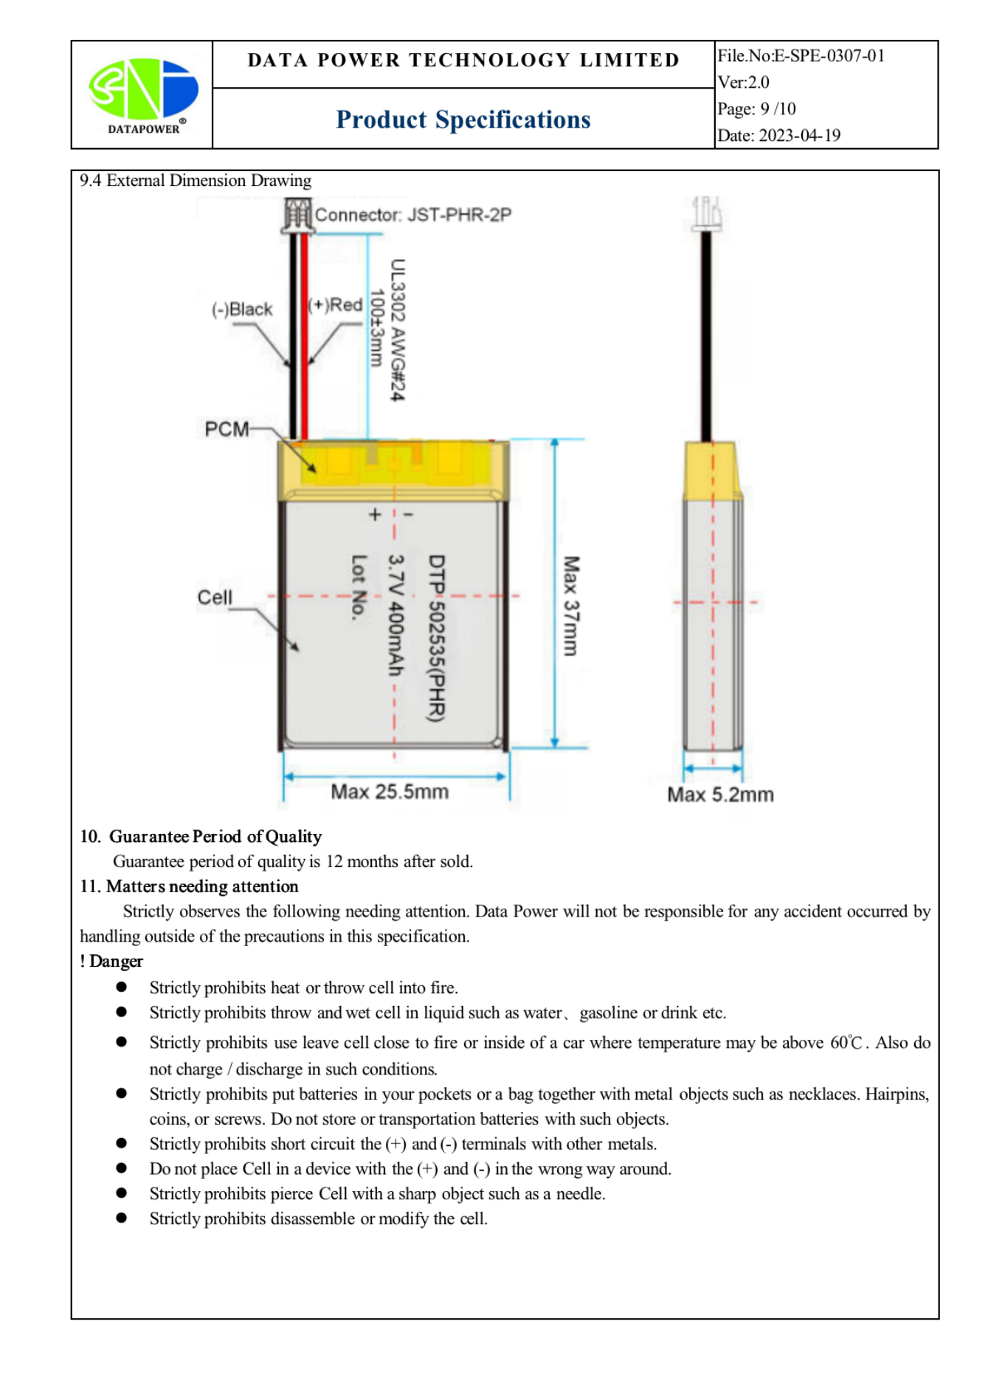
hardware/ref/battery_dtp/DTP502535_外形図.png
