n416/katanori/hardware/ref/oled_hs154l03w2c01/mechanical_drawing.png

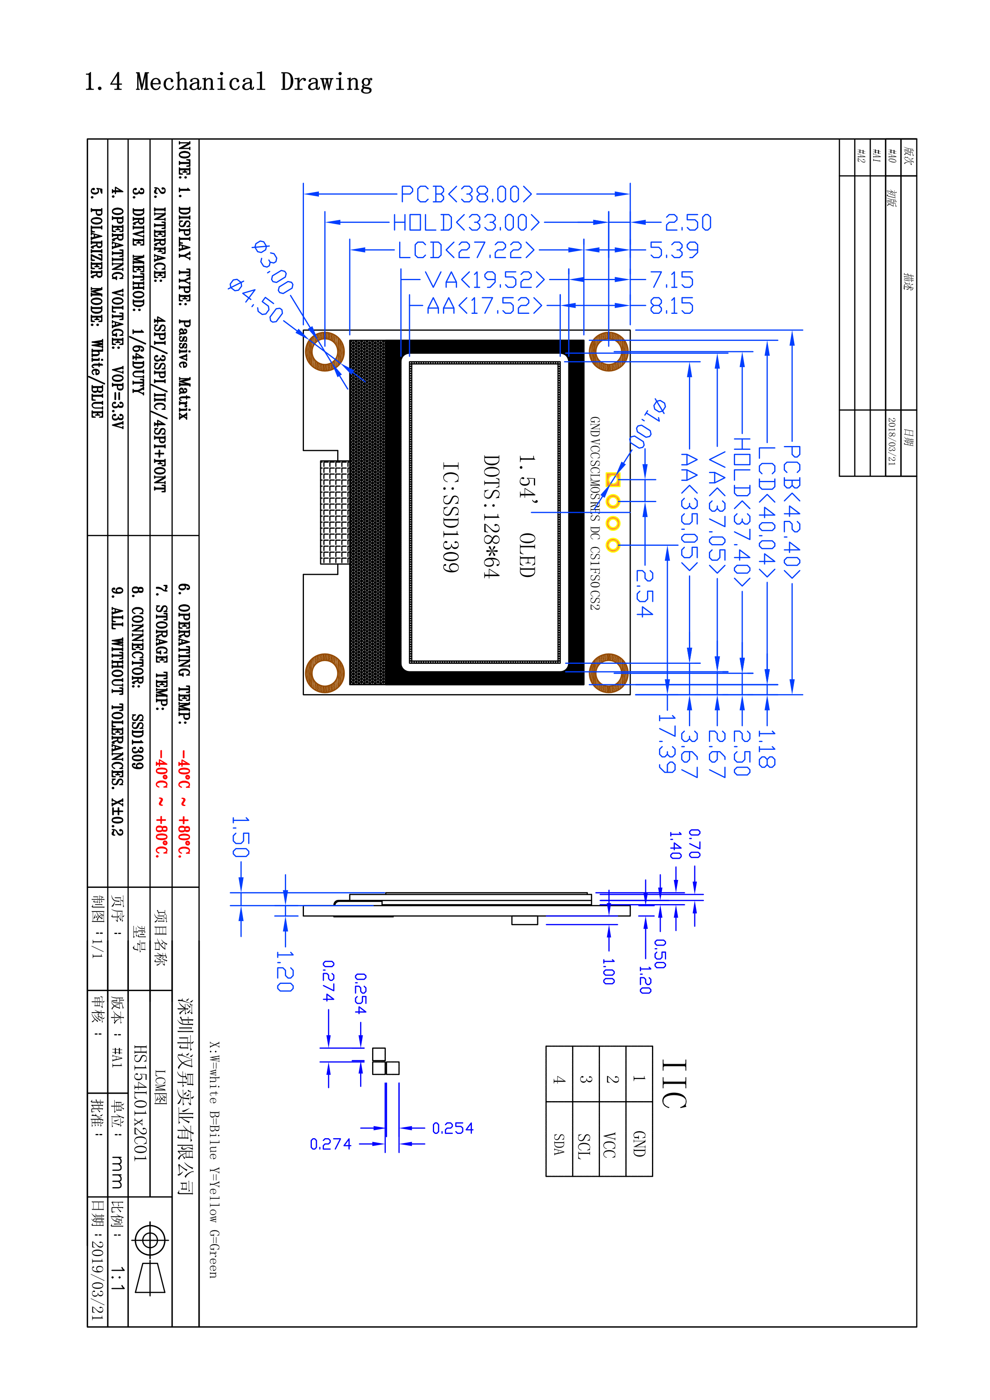
hardware/ref/oled_hs154l03w2c01/mechanical_drawing.png
