n416/katanori/hardware/ref/oled_hs154l03w2c01/outline_topview.png

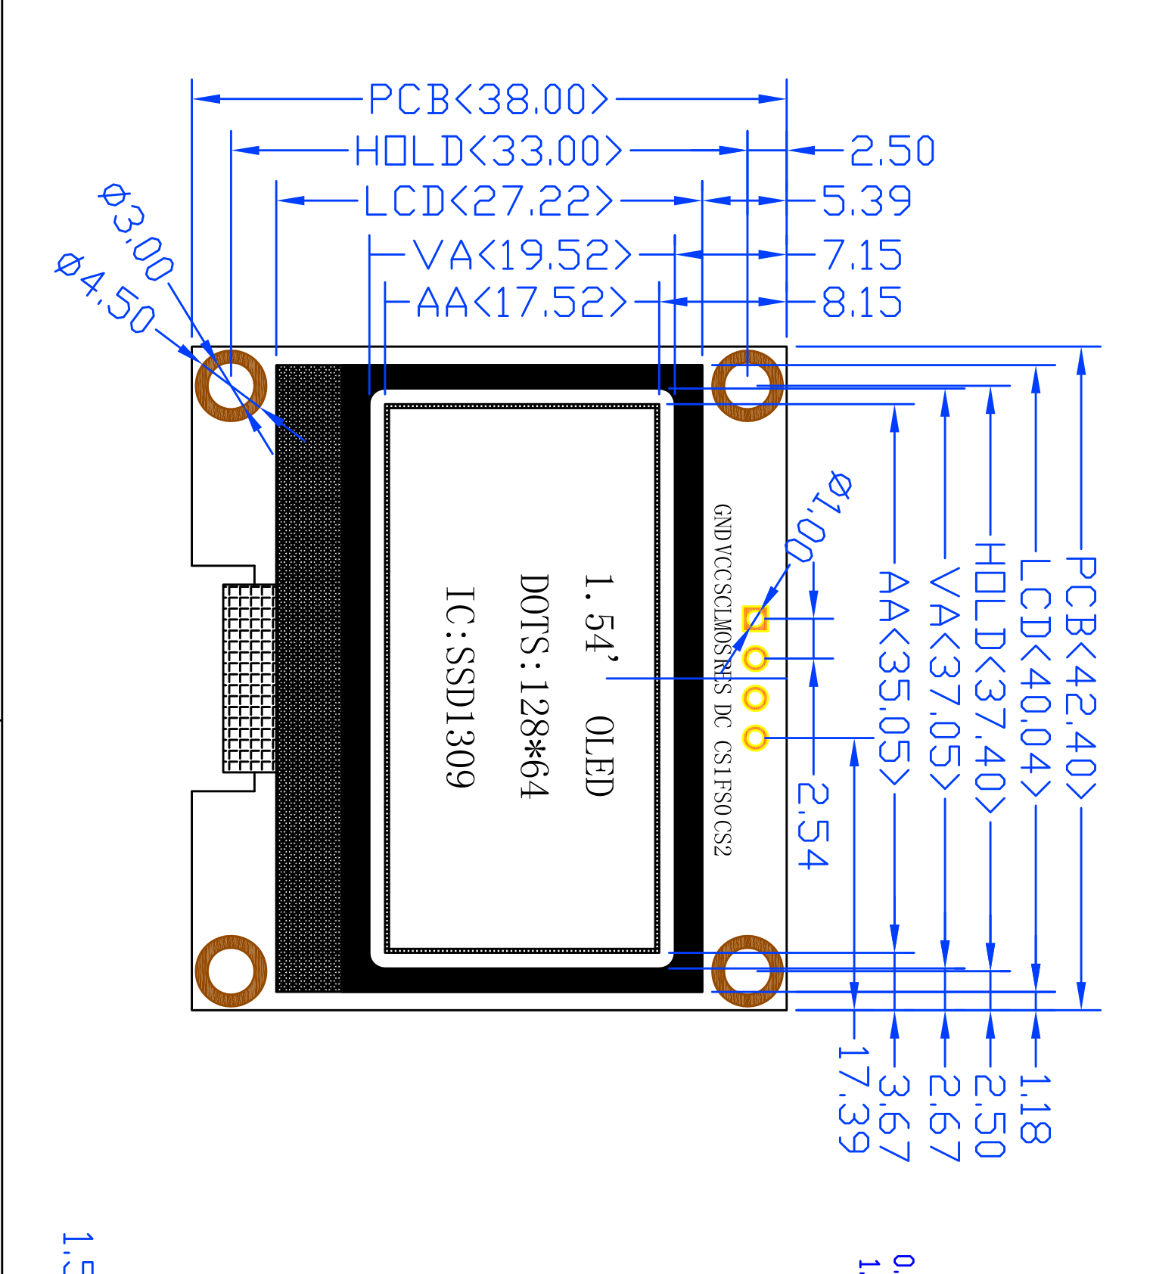
hardware/ref/oled_hs154l03w2c01/outline_topview.png
