n416/katanori/hardware/ref/slide_switch_mst12d18g3/outline_and_land.png

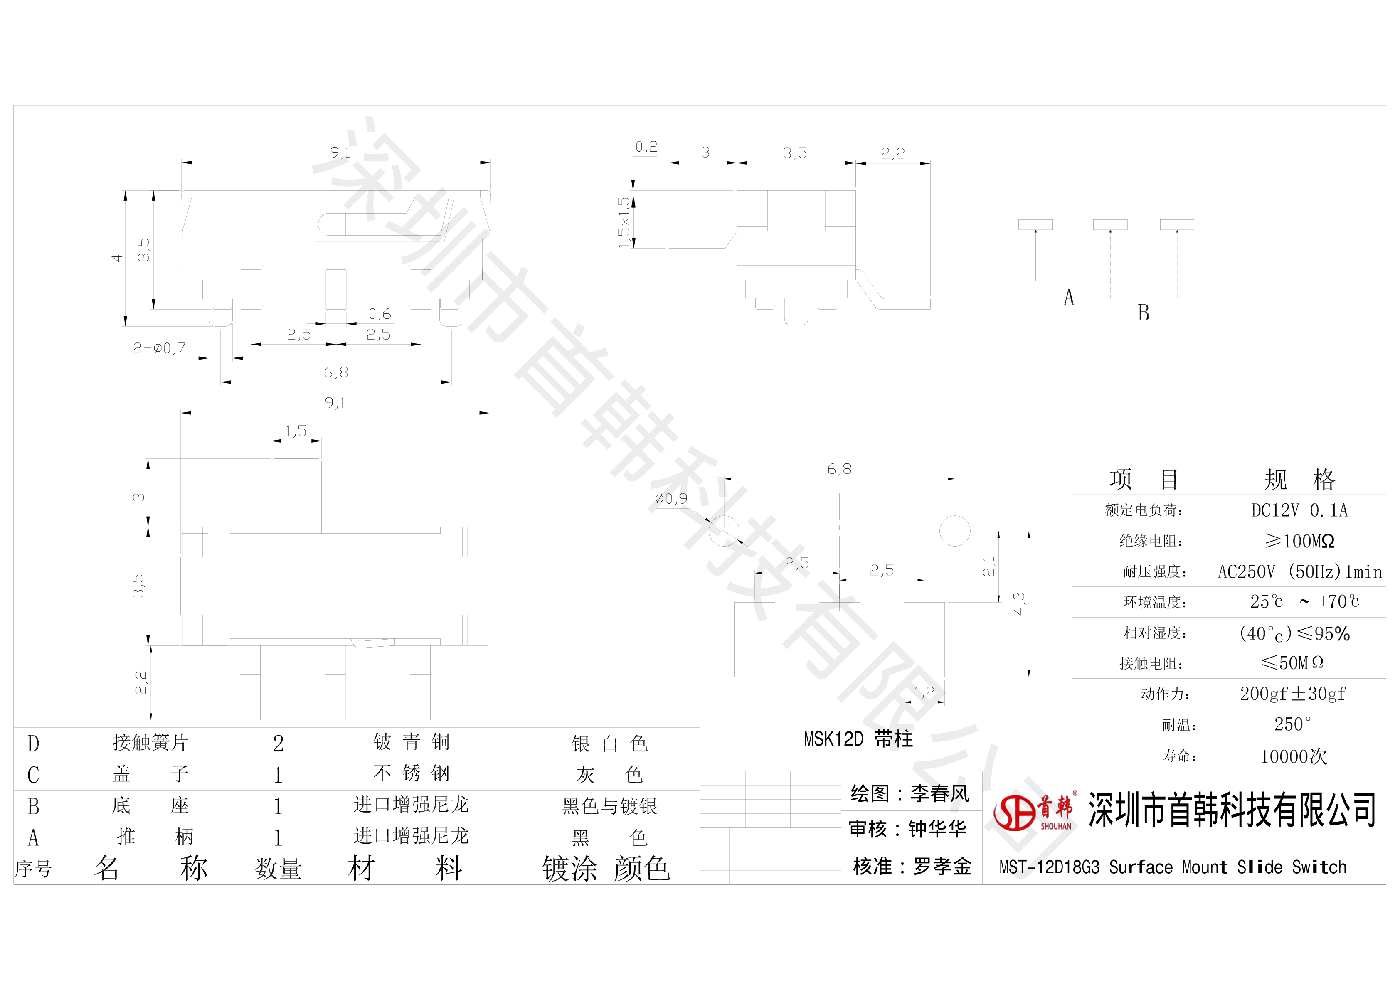
hardware/ref/slide_switch_mst12d18g3/outline_and_land.png
