n416/katanori/hardware/ref/slide_switch_ssss811101/ssss811101_drawing7.png

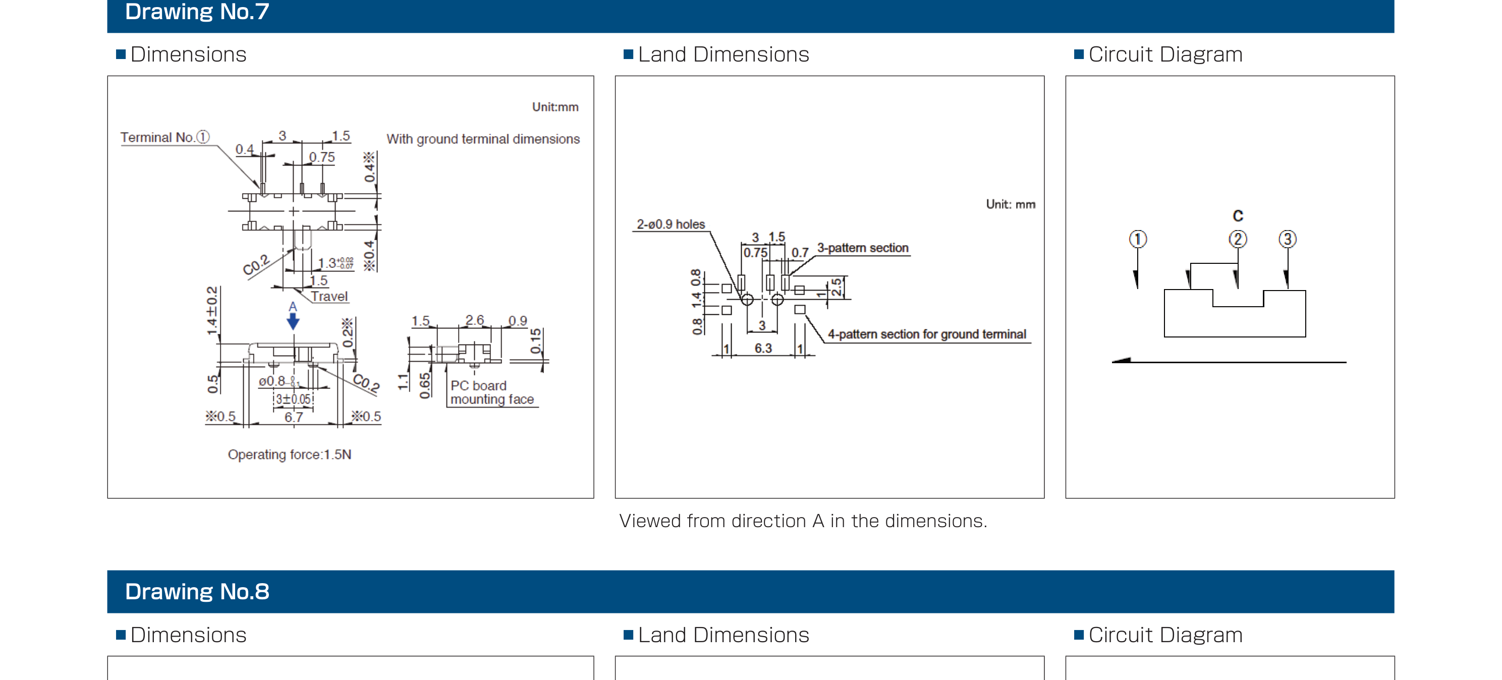
hardware/ref/slide_switch_ssss811101/ssss811101_drawing7.png
