n416/katanori/hardware/ref/top_layer1630.png

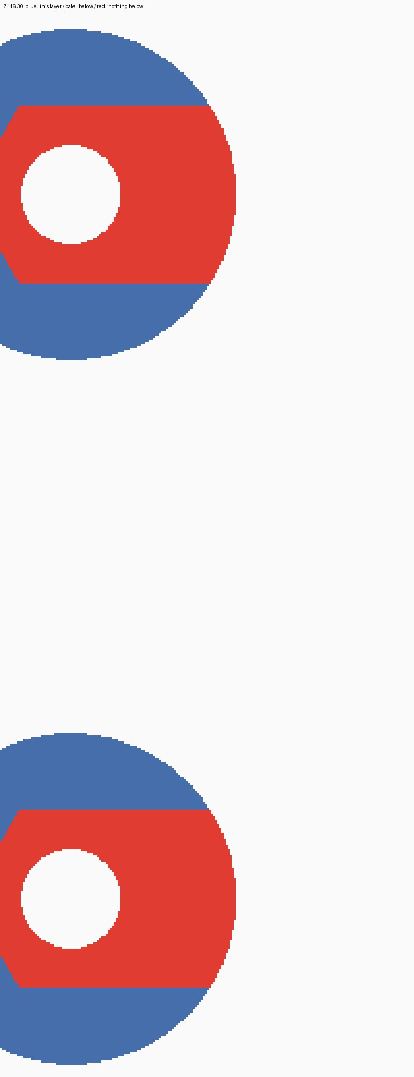
hardware/ref/top_layer1630.png
