n416/katanori/docs/ORDER-V61N.md

# v6.1n の注文リスト（1 台ぶん）

2026-09-19 作成。筐体はナイロン（MJF）版 v6.1n。手はんだ・線作り・組む手順は [組み立てマニュアル](manual/assembly_v61n.html)（手順 0〜）、
ねじ・ナット・線の長さはマニュアルの表（`hardware/tools/manual_v61/_asm_manual_v61.py` の SCREWS・NUTS・BUNDLES）が正で、ここはそこから引いた数。

## 1. 外に出す物

| 相手 | 何を | 数 | 出す物 | メモ |
|---|---|---|---|---|
| JLCPCB（板＋実装） | ハブ基板 `katanori61`（4 層） | 最低 5 枚 | `hardware/pcb/katanori61/fab/`（ガーバー・bom.csv・cpl.csv） | 実装は表面実装だけ（`fab.py --smd-only`）。出す前に `python hardware/pcb/check_fab.py` で在庫・区分を取り直す |
| JLCPCB（板だけ） | XIAO のライザー（2 層・**板厚 1.2**・18.28 × 22.48） | 最低 5 枚 | `hardware/pcb/riser_xiao/riser_xiao_gerber.zip` | 板厚は 1.2 で頼む（`XRISER_T`）。0.8〜1.6 は同じ値段 |
| JLCPCB（板だけ） | OLED のライザー（2 層・板厚 1.6・10.16 × 32.63） | 最低 5 枚 | `hardware/pcb/riser_oled/riser_oled_gerber.zip` | |
| JLC3DP（MJF PA12） | 底パーツ・蓋・つまみ・島・スピーカーのバスタブ・会話ボタンの押し子・会話ボタンのバスタブ | 各 1（7 点） | `hardware/stl/v61n/` | つまみは長い軸（高さ 42.0） |
| 自分で光造形 | 電源の押しボタンのキャップ | 1 | `case_v6_1.scad` の `print_pwrcap` を `MAT="nylon"` で書き出す（高さ 3.6） | MJF では記号の彫り 0.4 が出ないのでレジン |
| 自分で光造形 | つまみの軸のガイド | 1 | `case_v6_1.scad` の `print_kguide` を `MAT="nylon"` で書き出す（板を下） | 支柱なし |

## 2. 買う部品

### 2.1 LCSC（JLC の注文と一緒に）

| 使う所 | 品 | 品番 | 数 | 1 個 |
|---|---|---|---|---|
| XIAO のライザー 表（電源の列） | SHOU HAN 表面実装のメス 1x3・高さ 8.5 | C55218894 | 1 | $0.13 |
| XIAO のライザー 表（信号の列） | SHOU HAN 表面実装のメス 1x4・高さ 8.5 | C55218895 | 1 | $0.14 |
| XIAO のライザー 裏 | SHOU HAN L 字のメス 1x7・8.5 | C54876736 | 1 | $0.18 |
| OLED のライザー 表 | SHOU HAN 縦のメス 1x4・8.5（スルーホール） | C54876726 | 1 | $0.12 |
| OLED のライザー 裏 | SHOU HAN L 字のメス 1x4・8.5 | C54876733 | 1 | $0.14 |
| ハブ SW2 | 押しボタン XKB5858-Z-E | C780038 | 1 | $0.30 |

### 2.2 ハブの手はんだの部品

足形は `hardware/pcb/gen_pcb.py` の `HAND_SOLDER`。値段は 2026-09-19 の LCSC（最小の単位）。

| 記号 | 品 | 品番 | 数 | 1 個 |
|---|---|---|---|---|
| J1 | XFCN PZ254V-11-07P オスのピンヘッダ 1x7・縦（樹脂 2.5・ピン 6・下 3） | C492406 | 1 | $0.044（10 個から） |
| J2 | XFCN PZ254V-11-04P 同 1x4 | C2691448 | 1 | $0.026（20 個から） |
| J4・J6・J7・J10 | JST B2B-PH-K-S(LF)(SN) 縦 2 ピン | C131337 | 4 | $0.036（20 個から） |
| J5 | JST S2B-PH-K-S(LF)(SN) 横出し 2 ピン | C173752 | 1 | $0.040（20 個から） |

模型のピンヘッダは樹脂 2.54 で描いてある。買う品は 2.5 で、ピンの先は 0.04 低い（L 字のメスの中の彫りは板の面から 9.0 まで）。

### 2.3 線の材料

| 品 | 数 | メモ |
|---|---|---|
| JST-PH の殻 PHR-2（LCSC C157955） | 5 | 板の側 4 ＋ スピーカー IN の逆の端 1 |
| JST-PH の端子 SPH-002T-P0.5S（LCSC C111515・AWG 24〜30） | 10 | 予備を足して買う |
| 線（黒・白・紫・橙・青） | 各少し | 色の決まりはマニュアルの表 |
| DuPont のメスの端子（2.54・殻は要らない） | 2 | 会話ボタンの逆の端。マイクロスイッチの C・NO に挿してはんだで固める。予備を足して買う |
| 収縮チューブ（端子の太さ 2.5 角に被さる物・φ3.5 前後） | 2 本 | 会話ボタンの端子の口から線の被覆まで。圧着の前に線へ通しておく |
| PH の圧着工具 | 1 | 手持ちが無ければ（DuPont の端子も圧着する） |

### 2.4 ねじ・ナット・その他

| 品 | 数 | 使う所 |
|---|---|---|
| M2 × 6 | 8 | PCB → 柱 2・天板 → 上の柱 4・つまみの島 → 天板 2 |
| M2 × 12 | 1 | 床の裏 → 右後ろの柱 |
| M2 × 18 | 1 | 床の裏 → 左後ろの柱 → PCB → 蓋の座 |
| M2 × 4 | 2 | スピーカーのバスタブ → 天板の手 |
| M2 × 8 | 3 | つまみの軸のガイドの足 → PCB（要る長さ 7.8 以上） |
| M2（長さはマニュアルに無い・手持ちで合わせてきた物） | 4 | 会話ボタンのスイッチ → バスタブ 2・バスタブ → 天板の腕 2 |
| M2 ナット | 18 | PCB の柱 3・上の柱 3・蓋の座 1・つまみの台座 2・会話ボタン 4・スピーカーの手 2・軸のガイドの足 3 |
| E リング 呼び 6 | 2 | つまみの軸の溝（ナイロンは 2 枚） |
| 磁石 φ4 | 2 | つまみの軸の先 |
| 瞬間接着剤 | 少し | 磁石 |
| はがき | 2 枚 | XIAO のライザーの L 字のメスの下に挟む（コピー用紙では薄い） |

### 2.5 今の実機（v5）から移す物

手元にある前提。無ければ買う。

| 品 | メモ |
|---|---|
| ReSpeaker Lite（XIAO ESP32-S3 付き） | |
| OLED 2.42" | |
| リポ電池 1000mAh（603450・PH のリード付き） | リードが短いと J10 に届かない（長さはマニュアル手順 0） |
| スピーカー | |
| マイクロスイッチ（会話ボタン） | |
| リードスイッチ | |
