n416/katanori/docs/HUB-V6-PARTS.md

# 中継基板（v6）の部品 — 板の座標・足跡・背の高さ

> ⛔ **凍結（2026-09-14）。v6 の中継基板の資料。現行は katanori61（[PCB-V61.md](PCB-V61.md)）。**

外形 44.0 × 81.2・板厚 1.6。座標は **板の左下が原点・X 右・Y 上**。
部品はすべて **F.Cu（ReSpeaker を向く面）** にあり、**B.Cu には 1 つも無い**。
枠は courtyard（KiCad の足形が持つ占有の枠）。**背は板の面から。**

🔴 **出どころの印**: 📄 ＝ データシート／図面で取った ／ ⚠ ＝ 一般値（未確認）

| ref | 値 | 芯 X | 芯 Y | 回転 | 枠 X | 枠 Y | 背 | 背の出どころ |
|---|---|---|---|---|---|---|---|---|
| K31 | G6S-2F DC5 | 34.65 | 18.30 | 90° | 26.95〜42.25 | 12.95〜23.65 | **9.33** | 📄 en-g6s.pdf 5 ページ ＋ KiCad の STEP（Z 0〜9.330） |
| J1 | XIAO D0-D6 | 9.40 | 2.90 | 180° | 7.63〜11.17 | 1.13〜19.91 | **8.5** | 筐体側の数字（2.54 のメスソケット） |
| J14 | XIAO PWR | 24.63 | 2.90 | 180° | 22.86〜26.40 | 1.13〜19.91 | **8.5** | 同上 |
| J10 | BAT (JST-PH) | 41.00 | 25.65 | 180° | 36.55〜43.45 | 23.80〜32.40 | **4.8** | 📄 同 |
| J2 | OLED | 41.75 | 49.30 | 270° | 35.00〜43.60 | 40.85〜51.75 | **4.8** | 📄 ePH.pdf 3 ページ Side entry |
| J4 | SPK IN | 32.50 | 72.90 | 0° | 30.05〜36.95 | 66.15〜74.75 | **4.8** | 📄 同 |
| J5 | SPK OUT | 3.00 | 13.50 | 0° | 0.55〜7.45 | 6.75〜15.35 | **4.8** | 📄 同 |
| J6 | REED+BTN2 | 20.00 | 3.10 | 180° | 11.55〜22.45 | 1.25〜9.85 | **4.8** | 📄 同 |
| SW1 | MST-12D18G3 | 26.50 | 76.20 | 0° | 21.45〜31.55 | 74.90〜84.45 | **4.0** | 📄 MST-12D18G3.pdf（胴 3.5 ＋ 浮き 0.5。レバーは Z 2.3〜3.8） |
| J13 | USB-C | 37.50 | 80.55 | 180° | 32.18〜42.82 | 75.28〜84.70 | **3.16** | ⚠ 二次資料（PCBWiki）・メーカー図は未取得 |
| L1 | 6.8uH | 6.75 | 53.22 | 90° | 4.50〜9.00 | 50.92〜55.52 | **1.8** | 型番の「18」＝ 1.8mm（FNR4018S） |
| U4 | AS5600-ASOM | 36.20 | 7.00 | 0° | 32.50〜39.90 | 4.30〜9.70 | **1.75** | 📄相当 JLCPCB C79815 の仕様欄 Height 1.75mm |
| C6 | 47uF | 15.69 | 69.33 | 180° | 13.39〜17.99 | 68.18〜70.48 | **1.6** | ⚠ 一般値 1206 MLCC |
| C9 | 47uF | 15.69 | 71.78 | 180° | 13.39〜17.99 | 70.63〜72.93 | **1.6** | ⚠ 一般値 1206 MLCC |
| C1 | 10uF | 14.79 | 51.24 | 90° | 13.81〜15.77 | 49.54〜52.94 | **1.45** | ⚠ 一般値・0805 の抵抗とコンデンサと LED はこれ以下 |
| C2 | 2.2uF | 14.56 | 60.48 | 180° | 12.86〜16.26 | 59.50〜61.46 | **1.45** | ⚠ 一般値・0805 の抵抗とコンデンサと LED はこれ以下 |
| C31 | 0.1uF | 6.00 | 26.50 | 0° | 4.30〜7.70 | 25.52〜27.48 | **1.45** | ⚠ 一般値・0805 の抵抗とコンデンサと LED はこれ以下 |
| C32 | 0.1uF | 15.68 | 58.35 | 0° | 13.98〜17.38 | 57.37〜59.33 | **1.45** | ⚠ 一般値・0805 の抵抗とコンデンサと LED はこれ以下 |
| C4 | 0.1uF | 14.00 | 55.52 | 90° | 13.02〜14.98 | 53.81〜57.22 | **1.45** | ⚠ 一般値・0805 の抵抗とコンデンサと LED はこれ以下 |
| C41 | 0.1uF | 13.50 | 47.00 | 90° | 12.52〜14.48 | 45.30〜48.70 | **1.45** | ⚠ 一般値・0805 の抵抗とコンデンサと LED はこれ以下 |
| C42 | 0.1uF | 28.25 | 10.80 | 0° | 26.55〜29.95 | 9.82〜11.78 | **1.45** | ⚠ 一般値・0805 の抵抗とコンデンサと LED はこれ以下 |
| C7 | 10uF | 5.52 | 46.62 | 90° | 4.54〜6.50 | 44.92〜48.32 | **1.45** | ⚠ 一般値・0805 の抵抗とコンデンサと LED はこれ以下 |
| C8 | 10uF | 8.12 | 41.34 | 90° | 7.14〜9.10 | 39.64〜43.04 | **1.45** | ⚠ 一般値・0805 の抵抗とコンデンサと LED はこれ以下 |
| LED1 | RED | 23.60 | 64.44 | 90° | 22.65〜24.55 | 62.76〜66.12 | **1.45** | ⚠ 一般値・0805 の抵抗とコンデンサと LED はこれ以下 |
| LED2 | WHITE | 19.64 | 63.64 | 90° | 18.69〜20.59 | 61.96〜65.32 | **1.45** | ⚠ 一般値・0805 の抵抗とコンデンサと LED はこれ以下 |
| LED3 | GREEN | 12.71 | 52.00 | 90° | 11.76〜13.66 | 50.32〜53.68 | **1.45** | ⚠ 一般値・0805 の抵抗とコンデンサと LED はこれ以下 |
| LED4 | YELLOW | 22.44 | 42.50 | 90° | 21.49〜23.39 | 40.82〜44.18 | **1.45** | ⚠ 一般値・0805 の抵抗とコンデンサと LED はこれ以下 |
| R1 | 1.87M | 19.03 | 51.24 | 90° | 18.08〜19.98 | 49.56〜52.92 | **1.45** | ⚠ 一般値・0805 の抵抗とコンデンサと LED はこれ以下 |
| R13 | 200K | 20.00 | 68.97 | 90° | 19.05〜20.95 | 67.29〜70.65 | **1.45** | ⚠ 一般値・0805 の抵抗とコンデンサと LED はこれ以下 |
| R14 | 1K | 16.98 | 52.00 | 90° | 16.03〜17.93 | 50.32〜53.68 | **1.45** | ⚠ 一般値・0805 の抵抗とコンデンサと LED はこれ以下 |
| R15 | 15K | 21.34 | 46.62 | 90° | 20.39〜22.29 | 44.94〜48.30 | **1.45** | ⚠ 一般値・0805 の抵抗とコンデンサと LED はこれ以下 |
| R16 | 1.0K | 21.34 | 37.38 | 90° | 20.39〜22.29 | 35.70〜39.06 | **1.45** | ⚠ 一般値・0805 の抵抗とコンデンサと LED はこれ以下 |
| R17 | 100K | 20.39 | 42.00 | 90° | 19.44〜21.34 | 40.32〜43.68 | **1.45** | ⚠ 一般値・0805 の抵抗とコンデンサと LED はこれ以下 |
| R2 | 330K | 18.38 | 56.12 | 90° | 17.43〜19.33 | 54.44〜57.80 | **1.45** | ⚠ 一般値・0805 の抵抗とコンデンサと LED はこれ以下 |
| R20 | 1K | 23.88 | 59.82 | 90° | 22.93〜24.83 | 58.14〜61.50 | **1.45** | ⚠ 一般値・0805 の抵抗とコンデンサと LED はこれ以下 |
| R3 | 1.87M | 15.69 | 65.76 | 180° | 14.01〜17.37 | 64.81〜66.71 | **1.45** | ⚠ 一般値・0805 の抵抗とコンデンサと LED はこれ以下 |
| R31 | 1k | 14.00 | 26.50 | 0° | 12.32〜15.68 | 25.55〜27.45 | **1.45** | ⚠ 一般値・0805 の抵抗とコンデンサと LED はこれ以下 |
| R32 | 10k | 10.00 | 26.50 | 0° | 8.32〜11.68 | 25.55〜27.45 | **1.45** | ⚠ 一般値・0805 の抵抗とコンデンサと LED はこれ以下 |
| R4 | 200K | 20.21 | 66.31 | 180° | 18.53〜21.89 | 65.37〜67.27 | **1.45** | ⚠ 一般値・0805 の抵抗とコンデンサと LED はこれ以下 |
| R42 | 10K | 10.03 | 52.00 | 90° | 9.08〜10.98 | 50.32〜53.68 | **1.45** | ⚠ 一般値・0805 の抵抗とコンデンサと LED はこれ以下 |
| R43 | 10K | 29.09 | 69.72 | 90° | 28.14〜30.04 | 68.04〜71.40 | **1.45** | ⚠ 一般値・0805 の抵抗とコンデンサと LED はこれ以下 |
| R44 | 5.1k | 26.31 | 71.00 | 0° | 24.63〜27.99 | 70.05〜71.95 | **1.45** | ⚠ 一般値・0805 の抵抗とコンデンサと LED はこれ以下 |
| R45 | 5.1k | 22.94 | 71.00 | 0° | 21.26〜24.62 | 70.05〜71.95 | **1.45** | ⚠ 一般値・0805 の抵抗とコンデンサと LED はこれ以下 |
| R5 | 1K | 19.64 | 60.13 | 90° | 18.69〜20.59 | 58.45〜61.81 | **1.45** | ⚠ 一般値・0805 の抵抗とコンデンサと LED はこれ以下 |
| R6 | 220K | 20.21 | 30.78 | 180° | 18.53〜21.89 | 29.83〜31.73 | **1.45** | ⚠ 一般値・0805 の抵抗とコンデンサと LED はこれ以下 |
| R7 | 82K | 23.60 | 30.78 | 180° | 21.92〜25.28 | 29.83〜31.73 | **1.45** | ⚠ 一般値・0805 の抵抗とコンデンサと LED はこれ以下 |
| R8 | 1K | 17.50 | 47.00 | 90° | 16.55〜18.45 | 45.32〜48.68 | **1.45** | ⚠ 一般値・0805 の抵抗とコンデンサと LED はこれ以下 |
| D31 | 1N4148W | 19.50 | 22.50 | 0° | 17.15〜21.85 | 21.35〜23.65 | **1.35** | ⚠ 一般値 SOD-123 |
| Q1 | MMUN2133LT1G | 21.18 | 56.47 | 90° | 19.48〜22.88 | 54.54〜58.40 | **1.3** | ⚠ 一般値 SOT-23 |
| Q31 | SS8050 | 24.00 | 22.50 | 0° | 22.07〜25.93 | 20.80〜24.20 | **1.3** | ⚠ 一般値 SOT-23 |
| U3 | INA226AIDGSR | 9.00 | 47.11 | 90° | 7.25〜10.75 | 43.98〜50.24 | **1.1** | ⚠ 一般値 MSOP-10 |
| U1 | TPS61090RSAR | 8.91 | 62.46 | 90° | 6.28〜11.54 | 59.83〜65.09 | **1.0** | ⚠ 一般値 VQFN-16 |
| U2 | MCP73871-2CCI/ML | 11.85 | 41.23 | 90° | 9.25〜14.45 | 38.63〜43.83 | **0.9** | ⚠ 一般値 QFN-20 |
| R41 | 10m | 30.75 | 42.66 | 90° | 29.62〜31.88 | 40.38〜44.94 | **0.65** | ⚠ 一般値 1206 合金シャント |

合計 54 部品。

## 線が出る口 — **筐体の座標（箱）**

**箱 = 板 + (2.0, 3.0)**（向きは同じ・回転も鏡も無い）。
🔴 **線が出るのはこの 5 つだけ。**J1・J14 は ReSpeaker のピンヘッダが真上から挿さる所で線は 0 本。

| ref | 何 | 箱 X | 箱 Y | 背 | 線が抜ける向き |
|---|---|---|---|---|---|
| J2 | OLED | 37.00〜45.60 | 43.85〜54.75 | 4.80 | **−X（左へ）** |
| J4 | SPK IN | 32.05〜38.95 | 69.15〜77.75 | 4.80 | **−Y（下へ）** |
| J5 | SPK OUT | 2.55〜9.45 | 9.75〜18.35 | 4.80 | **−Y（下へ）** |
| J6 | REED+BTN2 | 13.55〜24.45 | 4.25〜12.85 | 4.80 | **＋Y（上へ）** |
| J10 | BAT (JST-PH) | 38.55〜45.45 | 26.80〜35.40 | 4.80 | **＋Y（上へ）** |

### プラグの通り道（箱）

🔴 **「相手の実体」は必ず要る。**そこに殻の肉があると挿さらない。
残りは指と線の曲がりのぶんで、板側の検査はこの 10.0 で回している。

| ref | 相手の実体（枠の縁から 3.1） | 指と曲げまで（10.0） |
|---|---|---|
| J2 | X 33.90〜37.00 | X 27.00〜37.00 |
| J4 | Y 66.05〜69.15 | Y 59.15〜69.15 |
| J5 | Y 6.65〜9.75 | Y -0.25〜9.75 |
| J6 | Y 12.85〜15.95 | Y 12.85〜22.85 |
| J10 | Y 35.40〜38.50 | Y 35.40〜45.40 |

⚠ **板の縁を越える帯がある**（下の縁は箱 Y 3.0・上の縁は箱 Y 84.2）。板の上に障害物が無いので板側の検査は通るが、**殻の側で空けてもらう必要がある。**

## 板に開いている穴（部品ではない）

| 何 | 板の座標 | 径 |
|---|---|---|
| 柱の抜き | (3.3, 38.8) | φ6.5 |
| 柱の抜き | (40.7, 38.8) | φ6.5 |
| 柱の抜き | (3.3, 71.8) | φ6.5 |
| 柱の抜き | (40.7, 71.8) | φ6.5 |
| 柱の抜き | (31.58, 2.46) | φ4.0 |
| 柱の抜き | (2.66, 60.17) | φ4.0 |
| 取付穴 M2 | (3.5, 3.5) | φ2.2 |
| 取付穴 M2 | (40.5, 3.5) | φ2.2 |
| 取付穴 M2 | (3.5, 65.25) | φ2.2 |
| 取付穴 M2 | (40.5, 65.25) | φ2.2 |
| 切り欠き | X 12.0〜22.0・Y 73.0 から上端 | — |
