n416/katanori/docs/jlcpcb-parts-cost.pdf

# JLCPCB の部品区分とコスト — 調査のまとめ

2026-09-12 ／ 対象は自作の電源・ハブ基板（ hub_power ・表面実装 44 個 28 種類）。数字はすべて JLCPCB の部品検 索と料金表から取った実測値で、推定は推定と明記した。

### 1. 何にお金が掛かるのか — 2 種類に分かれる

基板実装の費用は、枚数に比例する分と発注の回数に比例する分に分かれる。ここを混ぜると、枚数を増やせ ば安くなるはずのものが安くならない、という読み違いが起きる。

項目 | 額 | 何に比例するか

⚠ この表の額は「1 回ぶん」「1 枚ぶん」であって、総額ではない。総額は 5 節。

実装の段取り（Economic） | $8.18 | 発注 1 回につき 1 回
メタルマスク | $1.53 | 発注 1 回につき 1 回
Extended の部品 | $3.07 / 種類 | 発注 1 回につき、種類ごとに 1 回
部品代 | 約 $10 / 枚 | 枚数
はんだ点 | $0.0016 / 点 | 枚数

この基板では、発注 1 回あたり必ず $37.34 が乗る。（段取り $8.18 ＋ メタルマスク $1.53 ＋ Extended 9 種類 $27.63）。枚数に比例するのは 1 枚あたり約 $10.2 なので、5 枚 1 回の発注（総額 約 $88）では、費 用の 42% が「枚数と無関係な分」になる。

Basic と Extended の違い

JLCPCB は実装に使える部品を Basic／Promotional Extended／Extended の 3 つに分けている。前の 2 つ は追加料金がかからない。Extended は部品の種類ごとに 1 回の発注で $3.07 かかる。これは機械にリールを 載せ替える手間の料金なので、同じ発注で 100 枚作っても 1 回である。

⚠ 逆に言うと、小分けに頼むと回数ぶん掛かる。5 枚を 5〜6 回に分けて発注する前提なら、Extended 1 種類の実質は 「発注 1 回あたり $3.07」ではなく 総額で $15〜$18 になる。試作を重ねる案件では、ここが効く。

2. この基板の実際 — | 28 種類の内訳
区分 | 種類 | 追加料金
Basic | 19 | $0
Extended | 9 | $27.63 / 発注

計 | 28 | $27.63 / 発注

Basic に寄せられた 3 種類（発注 1 回あたり $9.21・6 回まわすなら総額 $55）

PowerBoost 1000C から写した定数のうち 3 つは、回路の意味をほとんど変えずに Basic の値へ寄せられた。 「E96 の半端な値だから Extended」というだけの部品は、E24 に寄せれば落とせることが多い。

元 | 先 | 電気的に何が変わるか
340kΩ C17636 | 330kΩ 0603 C23137 | 電池切れ警告の閾値が 3.25V → 3.33V。80mV 早く知らせ る側
270kΩ C17589 （100kΩ も 82kΩ へ） | 220kΩ 0603 C22961 82kΩ 0603 C23254 | USB 入力を見る分圧比が 0.2703 → 0.2715。差 0.45%
100µF 10V 1210 C23742 | 47µF 10V 1206 C96123 × 2 | 耐圧 10V を維持。部品が 1 つ増える

最後の 1 つには選択肢が 2 つあった。Basic の 100µF は 6.3V 品しかなく、5.2V が掛かる場所で耐圧を下げるとセラミックコ ンデンサは容量が大きく落ちる（どれだけ落ちるかはメーカーの曲線が要る）。その分からない部分を踏まないために、47µF 10V を 2 個に分ける方を採った。

### 3. 落とせなかった 9 種類と、その理由

残った 9 種類は、理由が 3 つに分かれる。「棚に無い」と「代えると回路が変わる」を混ぜないことが大事 で、前者は調べれば決まるが、後者は設計判断になる。

部品 | 理由の種類 | 確かめたこと
昇圧 TPS61090 C206167 | 写しであることが価値 | この 3 つを代えると PowerBoost 1000C の写しではなく なる。写しであること自体が設計の裏付けで、公開された 実証済みの回路をそのまま使い、元の EAGLE の回路図と 1 ピンずつ機械で突き合わせて検証できる。代えればその裏 付けを捨てることになる。手間の問題ではない。

充電 MCP73871
C5121473

電流計 INA226 C49851

リレー G6S-2F C16707 | 棚に無い | リレー 30,930 件に Basic の絞り込み → 0 件。Promotional Extended も 0 件
インダクタ 6.8µH C167807 | | 6.8µH で 0 件。10µH なら Basic 2 件あるが、 C1035 （0603・3mA）と C1046 （0805・15mA）で信号用。昇 圧の 2A には桁が 2 つ足りない
シャント 10mΩ C105362 | | 「Current Sense Resistors」15,376 件に Basic 0 件。値で 10mΩ を引いても 0 件
USB-C の受け口 C165948 | | USB Type-C 1,345 件に Basic 0 件（USB 全体 15,834 件で も 0）
デジトラ MMUN2133 C21714196 | | Digital Transistors 4,905 件に Basic 0 件。PNP 単体 （MMBT3906）も Extended なので、抵抗 2 本に分ける道 も無い
1.87MΩ C482988 | 代えると回路が動く | E96 なので Basic に無い。2MΩ 0603 は Basic に 1 件ある が、この抵抗は出力電圧 0.5V × (1 + R3/R4) と電池切 れ警告の両方を決めていて、2MΩ にすると出力 5.5V・警 告 3.53V になる。相方も振り直す設計変更が要る
4. 調べ方 — | 0 件を「無い」と読む前に対照を取る

この調査でいちばん危なかったのは、検索で 0 件と出たものを「存在しない」と読んでしまうことだった。
JLCPCB の検索は部品の説明文への文字列一 | 致なので、書き方が違えば当たらない。実際、この調査では一 | 度
これで誤った結論を出しかけた。手順はこうなる。
1. 部品表の品番を 1 つずつ引いて区分を読む。品番で引けば区分（Basic / Extended）は正しく出る。ここ は疑う必要がない。
2. Extended の物は、値で検索して Basic の絞り込みをかけ、残り件数を読む。

3. 🔴 0 件が出たら、必ず対照を取る。Basic が在ると分かっている別の検索で同じ操作をして、絞り込みが 効いていることを見る。抵抗なら 185 件、10µH のインダクタなら 2 件が残る。ここを飛ばすと、方法の 不具合と事実の区別がつかない。
4. 残り件数が 1 以上でも、件数だけで決めない。実際に品番を開いて定格と大きさを見る。10µH の Basic 2 件は、開いてみたら 3mA と 15mA の信号用だった。
JLCPCB の Basic 一 | 覧ページ（1,586 点）は検索の引数を受け付けず、カテゴリ一 | 覧も途中で打ち切られるので、一 | 覧を端から
数える道は使えなかった。上の 4 手順が現実的な方法になる。

### 5. 数量と発注回数でどう効くか

試作を重ねる案件では、ロットの切り方が部品選定より効く。この基板で 5 枚ずつ作る場合を並べる。

発注の回数 | 回数に比例する分 （総額） | 枚数に比例する分 （総額） | 総額 | 1 枚あたり
1 回（5 枚） | $37.34 | $51 | $88 | $17.6
3 回（15 枚） | $112.02 | $153 | $265 | $17.7
6 回（30 枚） | $224.04 | $306 | $530 | $17.7
1 回（30 枚） | $37.34 | $306 | $343 | $11.4

同じ 30 枚でも、総額は 6 回に分ければ $530、1 回にまとめれば $343。差の $187 はすべて段取り・メタル マスク・Extended の掛かり直しで、1 枚あたりに直すと $17.7 と $11.4 の差になる。板代と送料は別で、そ ちらも回数ぶん掛かる。

設計を詰める段階では回数が増えるのは避けられない。そこで効くのは「1 回あたりの固定費を下げておく こと」で、Extended を 12 → 9 種類に減らした効果は、発注 1 回あたり $9.21、6 回まわすなら総額 $55 になる。

### 6. この案件で決めたこと

Extended 9 種類のまま行く。1 種類を落として浮くのは発注 1 回あたり $3.07、5 枚を 6 回まわす前提の 総額で $18。残っている 9 つのうち 5 つは棚に無いので落としようがなく、3 つは実証済みの回路構成そ のもの、1 つは出力電圧が動く。つまり総額 $18 と引き換えに差し出すものが、裏付けのある回路か、5V の値そのものになる。
ミュートリレーは表面実装に替えた（Y14H-1C-5DS → Omron G6S-2F DC5）。手はんだが消え、足形も KiCad 標準の Omron 純正 land pattern になった。Basic のリレーは存在しないので、発注 1 回あたり $3.07（6 回で総額 $18）は避けられない。リレー本体は 1 枚あたり $1.47。
スルーホールは 11 個（ピンヘッダ 8・JST・PH 2）。自分で付けるか、$3.58 ＋ 41 点 × $0.0164 ＝ 発注

### 1 回あたり $4.25（6 回で総額 $26）で頼むかは未決。

板代・送料・面付けの追加料金は未確定。発注画面にファイルを上げるまで出ない。

出どころ: docs/POWER.md（案③）。値段は 2026-09-12 に JLCPCB の部品検索・料金ページで取得。部品には最低数量があるので部 品代は上ぶれする。
