n416/katanori/hardware/frozen/v1-v4/_hatch_bare.stl

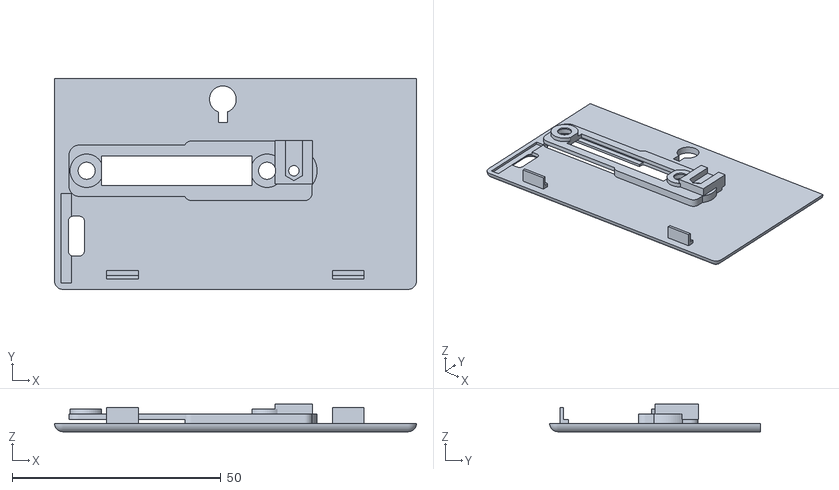
[picture p141: CAD file, 2026-09-03]
hardware/frozen/v1-v4/_hatch_bare.stl
86.7 x 50.5 x 6.60
