n416/katanori/hardware/frozen/v6/pcb_tmp/box_now.stl

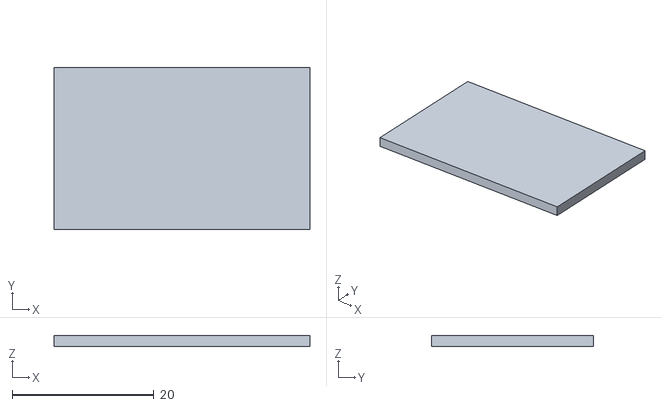
[picture p142: CAD file, 2026-09-14]
hardware/frozen/v6/pcb_tmp/box_now.stl
36.1 x 22.9 x 1.60
