n416/katanori/hardware/pcb/v61_parts3d.stl

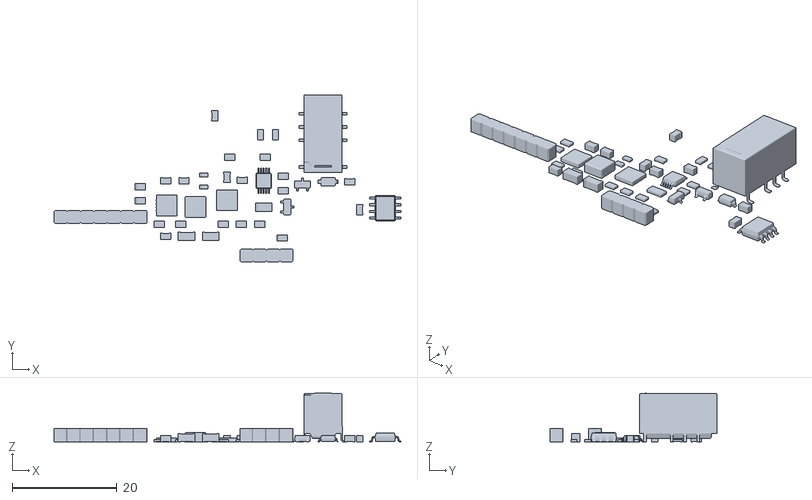
[picture p143: CAD file, 2026-09-20]
hardware/pcb/v61_parts3d.stl
66.2 x 31.9 x 9.33
