n416/katanori/hardware/ref/cad/ReSpeakerLitev1.1.step

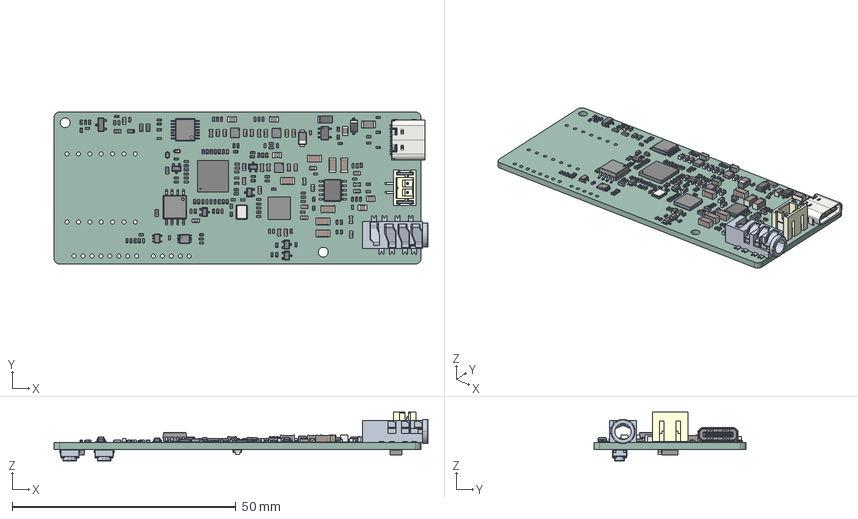
[picture p144: CAD file, 2026-09-06]
hardware/ref/cad/ReSpeakerLitev1.1.step
83.6 x 34.0 x 10.9 mm
R_0402_1005Metric x 70
C_0402_1005Metric x 59
C_0603_1608Metric x 21
PRT000A1
PRT000A2
PRT000A3
PRT000A4
PRT000A5
PRT000A6
PRT000A7
PRT000A8
PRT000A9
SOD-123
SOT-323 x 6
Crystal_SMD_3225-4Pin_3.2x2.5mm
R_0603_1608Metric x 6
C_1206_3216Metric x 7
SOD-123FL
WSON-8 x 3
L_0603_1608Metric x 9
C_0805_2012Metric x 3
FUSE_1206
BODY-QFN
PIN1-ID x 2
USB_C_Receptacle_GCT_USB4105-xx-A_16P_TopMnt_Horizontal
QFN_F60B-C24_XMO
User Library-SOT-23-5_pin_SOT_sot-23-6_1 x 5
User Library-SOT-23-5_body_sot23-6_1
SSOP-10_3.9x4.9mm_P1.00mm
R_1206_3216Metric
SOT-23
PinsArrayLR
BODY-TSSOP
LEAD-TSSOP x 14
PIN1
L_0805_2012Metric x 3
SOD-523 x 2
BODY-VSSOP
LEAD-VSSOP x 8
B2B-PH-SM4-TB_B2B-PH-SM4-TB
BODY-SOT
LEAD-SOT x 5
ReSpeaker Lite v1.1 1.207 x 2
LED4-0404
LED_0603_1608Metric
Pins x 2
ReSpeaker Lite v1.1_PCB
