n416/katanori/hardware/ref/ina226/INA_226.step

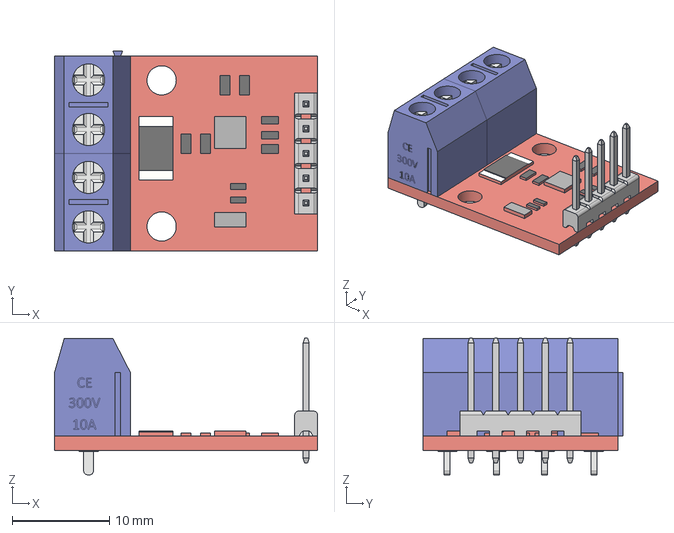
[picture p146: CAD file, 2026-09-14]
hardware/ref/ina226/INA_226.step
27.0 x 20.5 x 14.0 mm
Screw-Terminal-P5.08 x 2
C-3-644456-5
