n416/katanori/hardware/sim/m2_sorter/static.stl

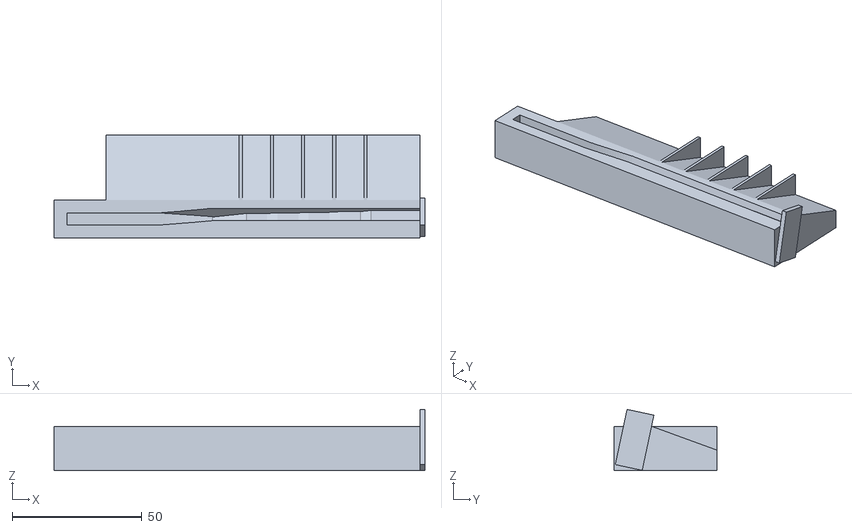
[picture p147: CAD file, 2026-09-14]
hardware/sim/m2_sorter/static.stl
143.0 x 39.6 x 23.6
