n416/katanori/hardware/stand_seat_test_v13custom.stl

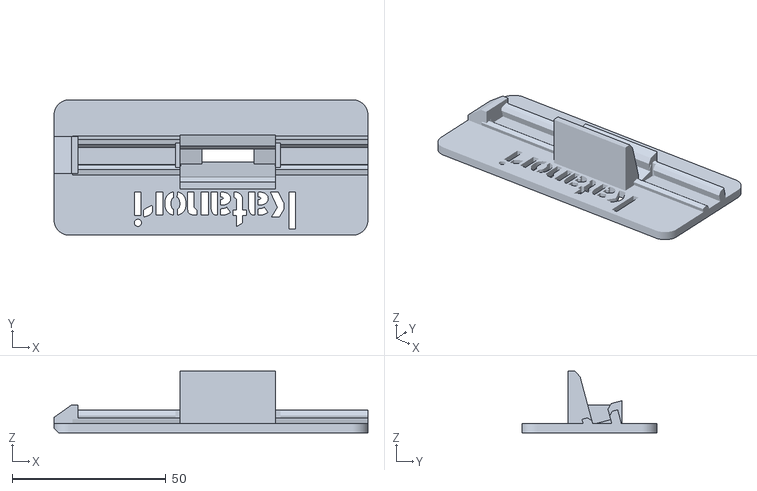
[picture p148: CAD file, 2026-08-04]
hardware/stand_seat_test_v13custom.stl
102.0 x 44.0 x 20.0
