n416/katanori/hardware/stl/icon_gauge.stl

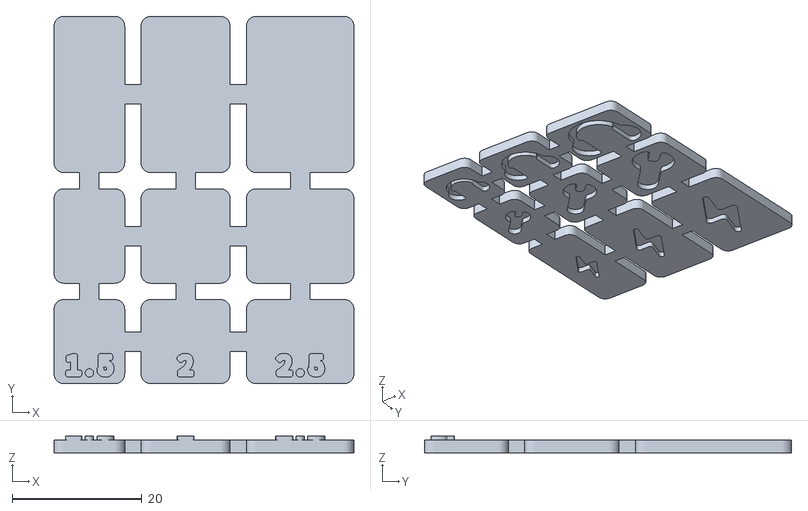
[picture p149: CAD file, 2026-09-04]
hardware/stl/icon_gauge.stl
46.3 x 56.7 x 2.60
