n416/katanori/hardware/stl/jig/m2_align_tray.stl

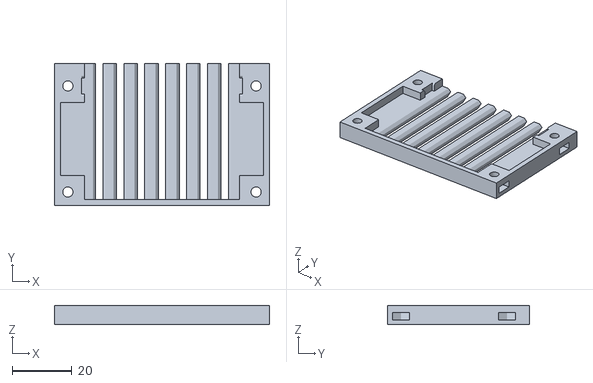
[picture p150: CAD file, 2026-09-11]
hardware/stl/jig/m2_align_tray.stl
72.0 x 47.5 x 6.50
