n416/katanori/hardware/stl/term/2026-09-10-1727.stl

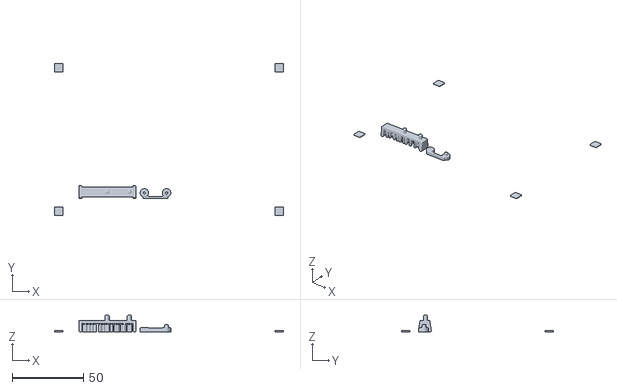
[picture p151: CAD file, 2026-09-10]
hardware/stl/term/2026-09-10-1727.stl
161.0 x 107.0 x 11.7
