n416/katanori/hardware/stl/test/hex_gauge.stl

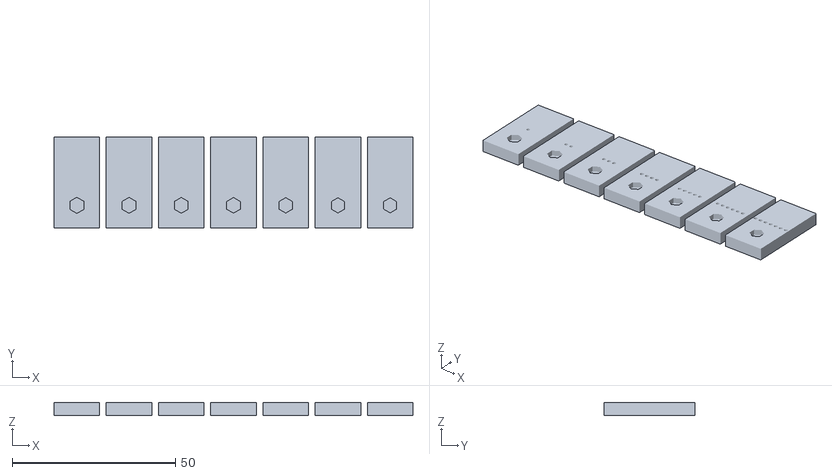
[picture p152: CAD file, 2026-09-02]
hardware/stl/test/hex_gauge.stl
110.0 x 28.0 x 4.00
