n416/katanori/hardware/stl/trial/trial_tub.stl

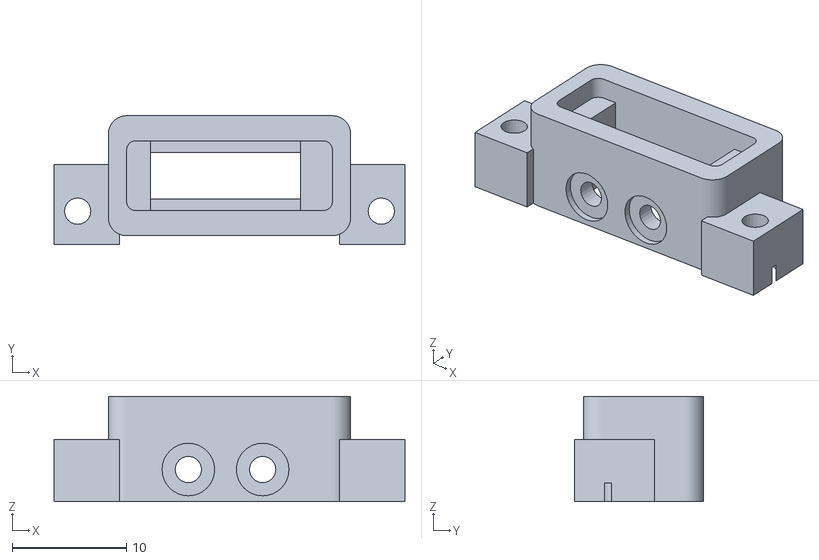
[picture p153: CAD file, 2026-09-07]
hardware/stl/trial/trial_tub.stl
30.7 x 11.2 x 9.19
