n416/katanori/hardware/stl/v5/v5_hatch.stl

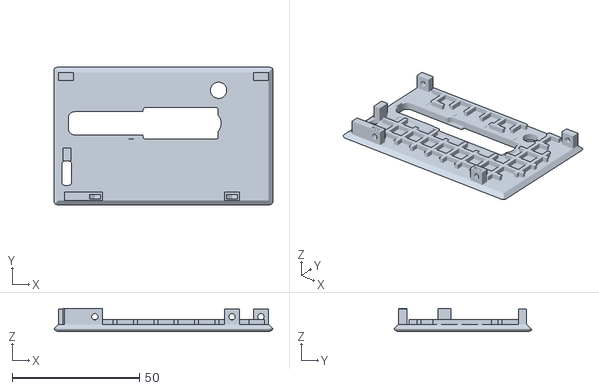
[picture p154: CAD file, 2026-09-11]
hardware/stl/v5/v5_hatch.stl
86.2 x 54.3 x 9.05
