n416/katanori/hardware/stl/v61n/v61n_knob.stl

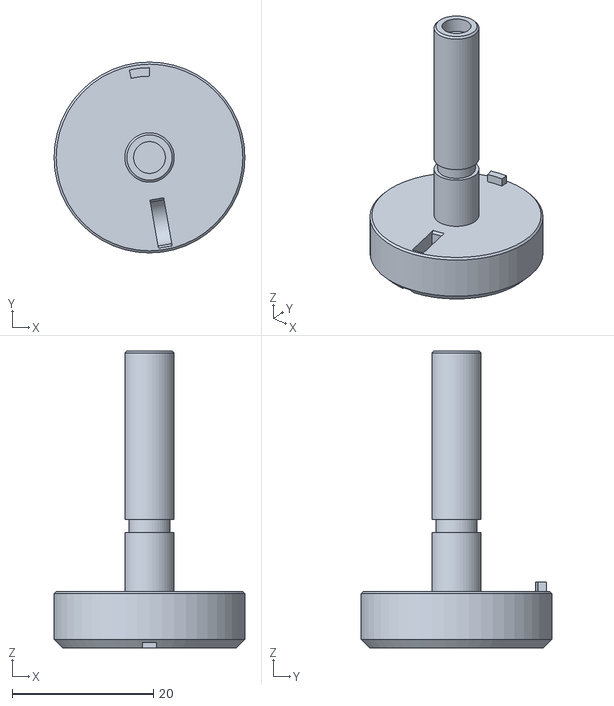
[picture p155: CAD file, 2026-09-19]
hardware/stl/v61n/v61n_knob.stl
27.0 x 27.0 x 42.0
