n416/katanori/surugo/anchor.stl

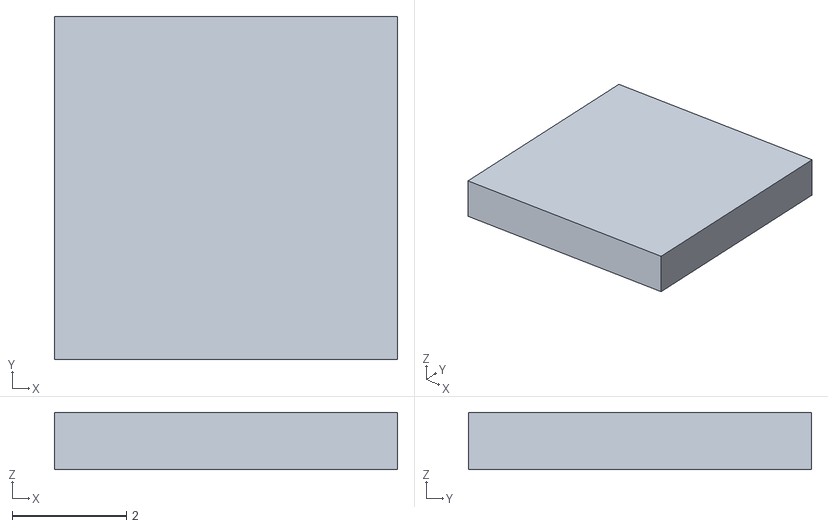
[picture p156: CAD file, 2026-08-31]
surugo/anchor.stl
6.00 x 6.00 x 1.00
