n416/katanori/hardware/frozen/v1-v4/_blade_3.stl

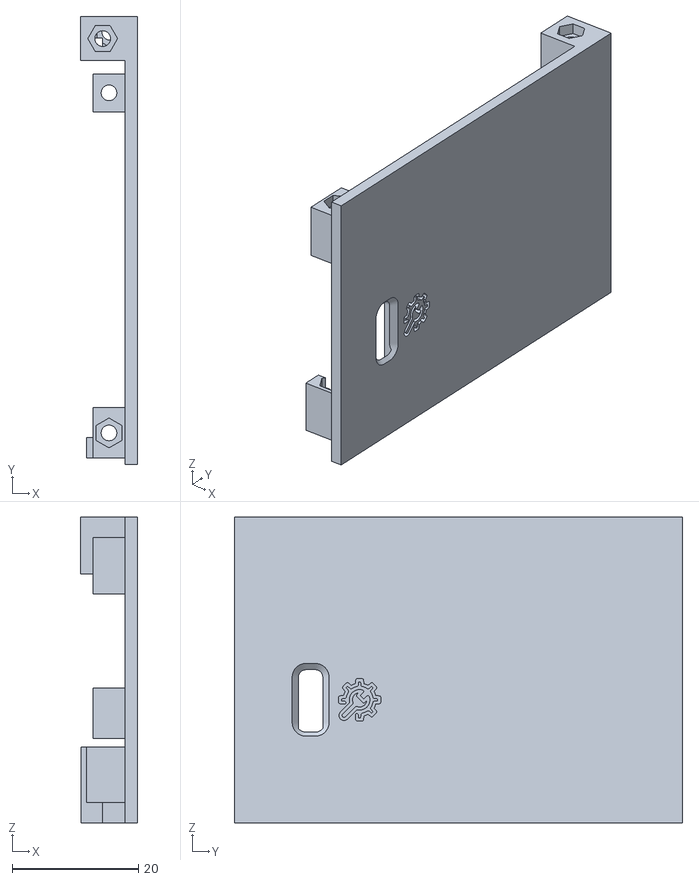
[picture p157: CAD file, 2026-09-03]
hardware/frozen/v1-v4/_blade_3.stl
9.00 x 71.0 x 48.5
