n416/katanori/hardware/frozen/v6/pcb_tmp/ctl_DY_1_-D_NEW_W_60.stl

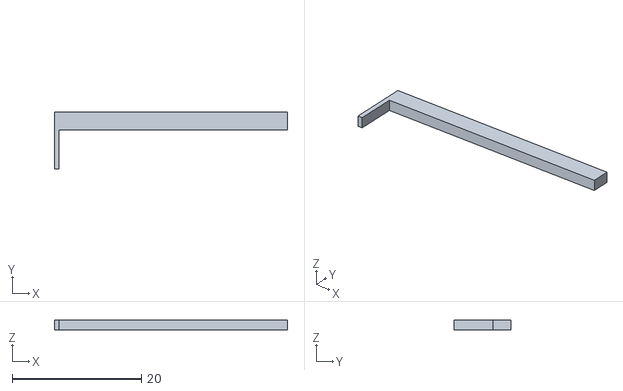
[picture p158: CAD file, 2026-09-14]
hardware/frozen/v6/pcb_tmp/ctl_DY_1_-D_NEW_W_60.stl
36.1 x 8.80 x 1.60
