n416/katanori/hardware/pcb/v61_conn3d.stl

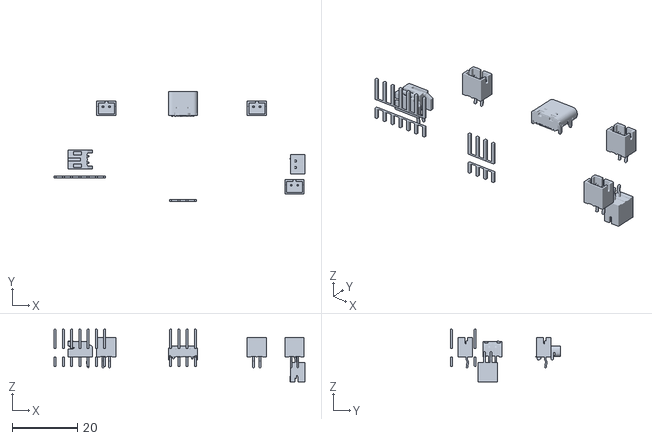
[picture p159: CAD file, 2026-09-19]
hardware/pcb/v61_conn3d.stl
77.0 x 33.9 x 16.2
