n416/katanori/hardware/ref/cad/XIAO_ESP32S3_v1.1_Dimensioning.dxf

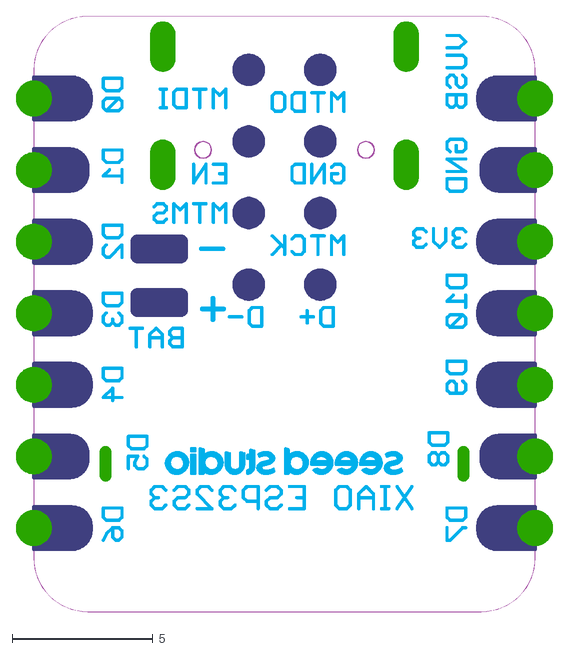
[picture p160: CAD file, 2026-09-06]
hardware/ref/cad/XIAO_ESP32S3_v1.1_Dimensioning.dxf
19.0 x 21.1
