n416/katanori/hardware/sim/m2_sorter/pusher.stl

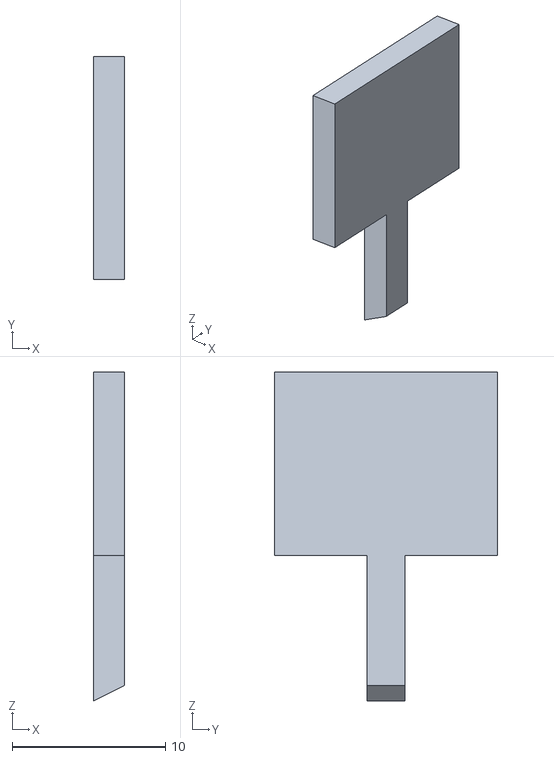
[picture p161: CAD file, 2026-09-14]
hardware/sim/m2_sorter/pusher.stl
2.00 x 14.6 x 21.5
