n416/katanori/hardware/stl/jig/m2_align_gate.stl

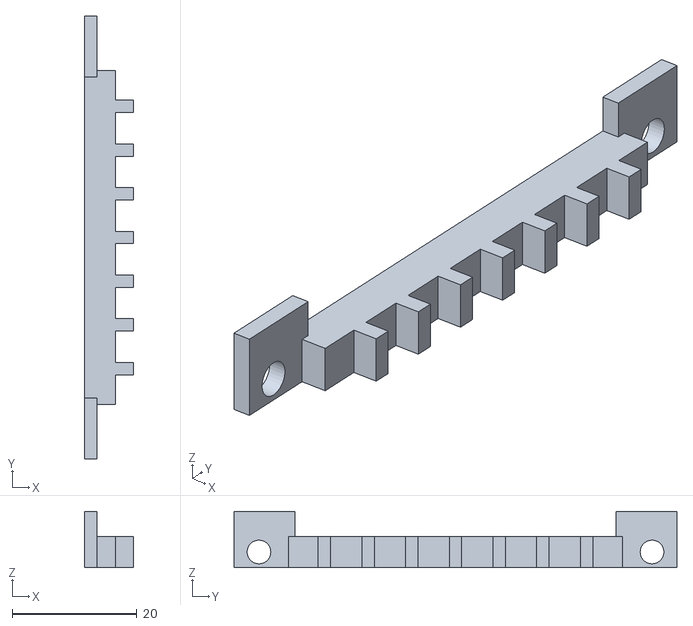
[picture p162: CAD file, 2026-09-11]
hardware/stl/jig/m2_align_gate.stl
7.90 x 71.0 x 9.00
