n416/katanori/hardware/stl/post_fit_test.stl

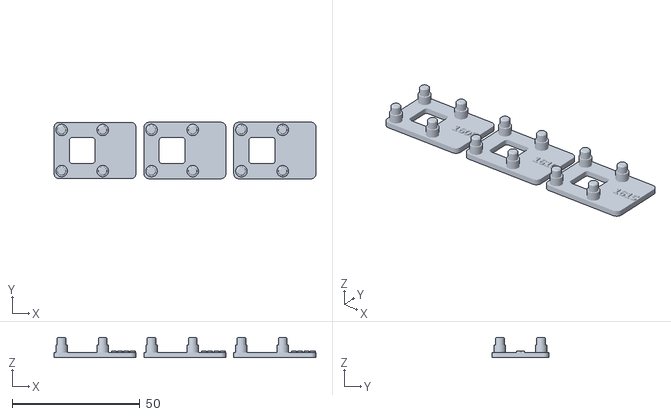
[picture p163: CAD file, 2026-08-30]
hardware/stl/post_fit_test.stl
102.4 x 22.2 x 8.00
