n416/katanori/hardware/stl/term/2026-09-10-1604.stl

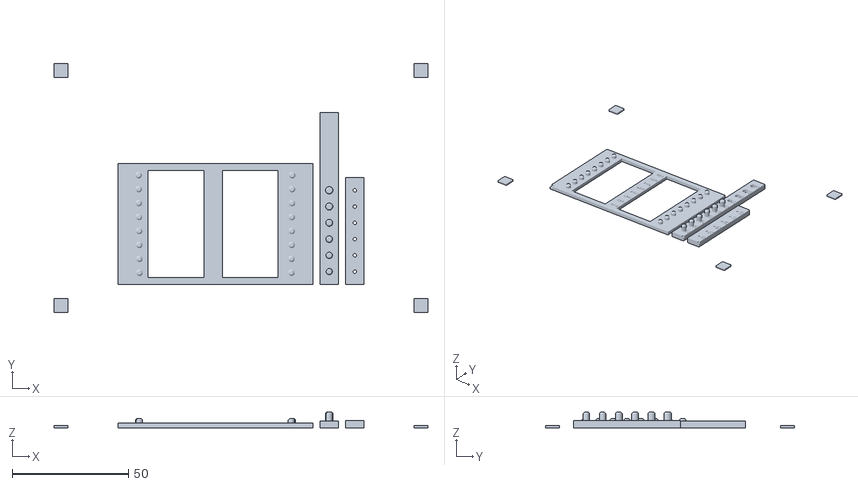
[picture p164: CAD file, 2026-09-10]
hardware/stl/term/2026-09-10-1604.stl
161.0 x 107.0 x 6.69
