n416/katanori/hardware/stl/test/cb_depth_gauge.stl

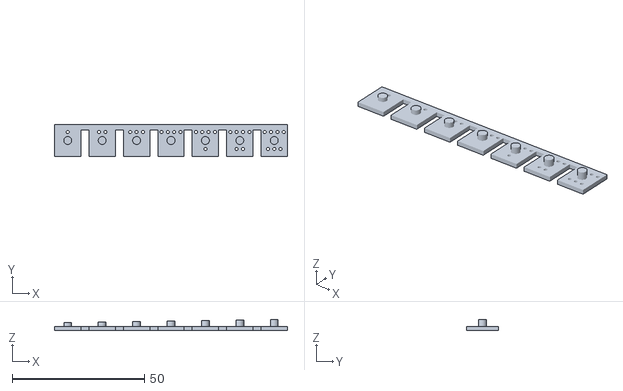
[picture p165: CAD file, 2026-08-31]
hardware/stl/test/cb_depth_gauge.stl
88.0 x 12.0 x 4.10
