n416/katanori/hardware/stl/trial/trial_piston2b.stl

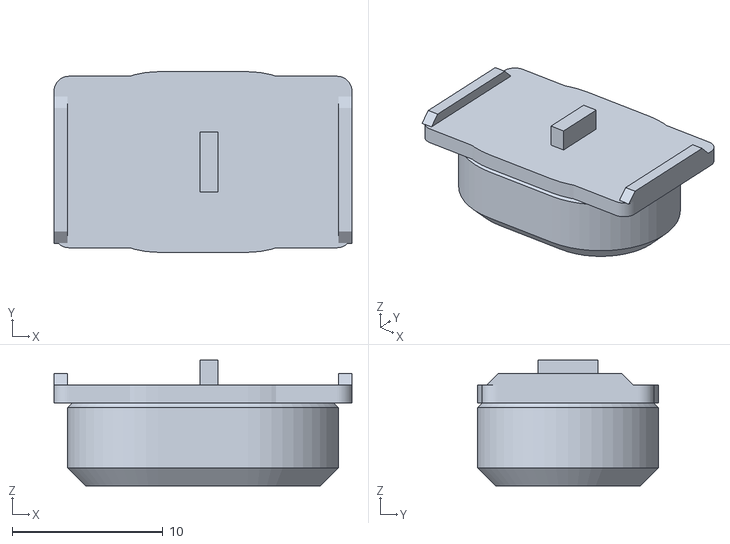
[picture p166: CAD file, 2026-09-07]
hardware/stl/trial/trial_piston2b.stl
19.8 x 12.0 x 8.36
