n416/katanori/hardware/stl/v5/v5_knobhangtest.stl

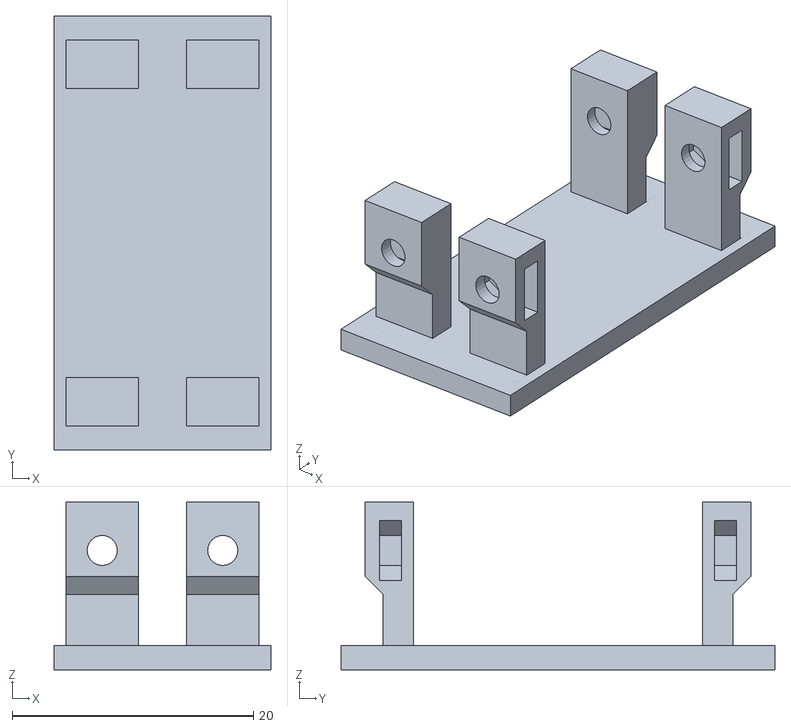
[picture p167: CAD file, 2026-09-11]
hardware/stl/v5/v5_knobhangtest.stl
18.0 x 36.0 x 13.9
