n416/katanori/hardware/stl/v61n/v61n_shell.stl

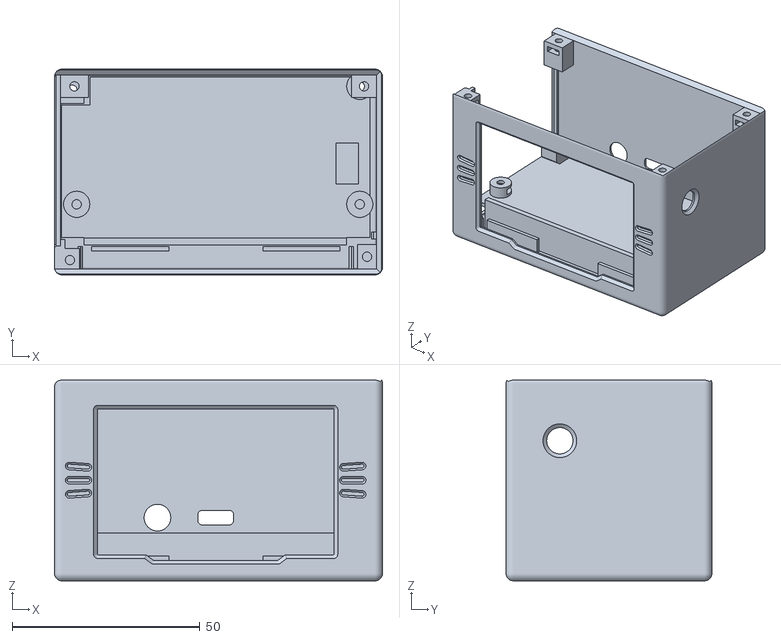
[picture p168: CAD file, 2026-09-19]
hardware/stl/v61n/v61n_shell.stl
87.3 x 54.8 x 53.4
