n416/katanori/hardware/frozen/v6/pcb_tmp/box_1.stl

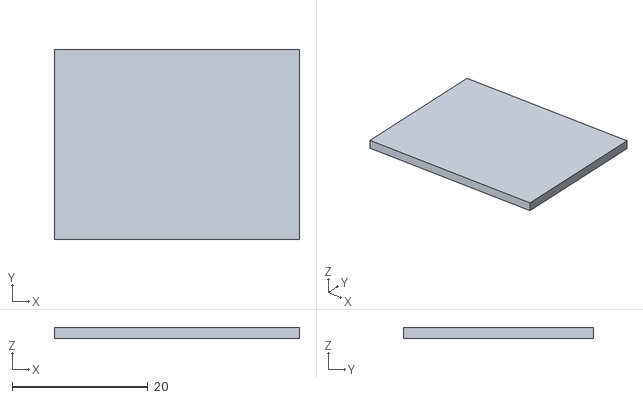
[picture p169: CAD file, 2026-09-14]
hardware/frozen/v6/pcb_tmp/box_1.stl
36.1 x 28.0 x 1.60
