n416/katanori/hardware/pcb/v61_board3d.stl

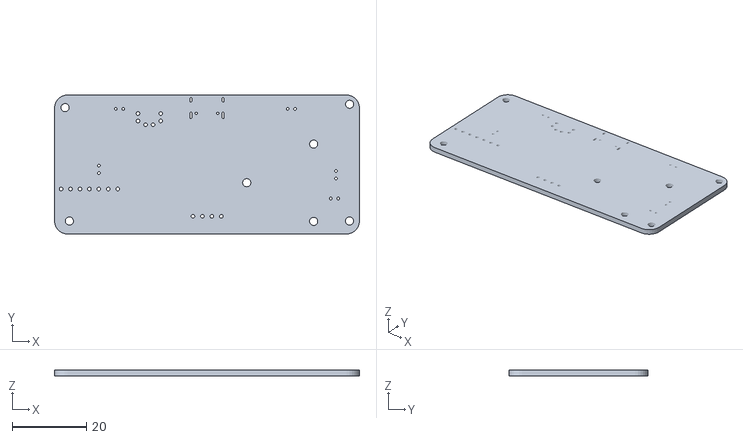
[picture p170: CAD file, 2026-09-19]
hardware/pcb/v61_board3d.stl
82.0 x 37.4 x 1.51
