n416/katanori/hardware/stl/jig/oled_peg_gauge.stl

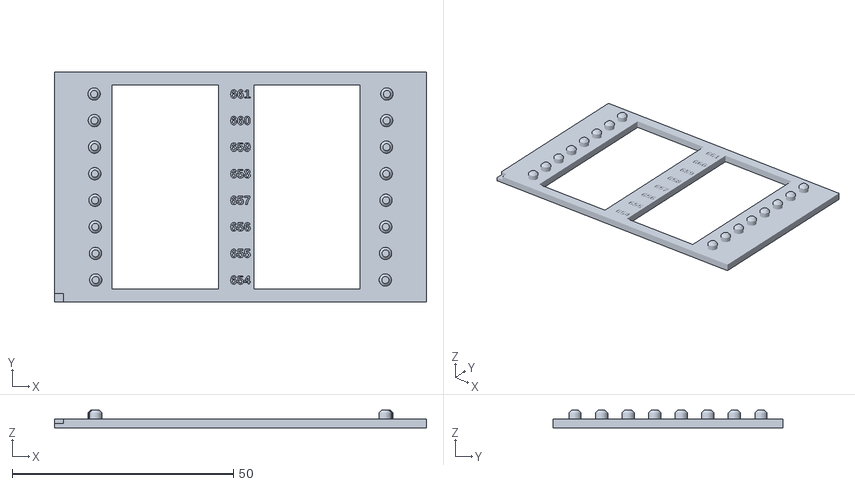
[picture p171: CAD file, 2026-09-10]
hardware/stl/jig/oled_peg_gauge.stl
84.0 x 52.0 x 3.99
