n416/katanori/hardware/stl/knob_v5_half.stl

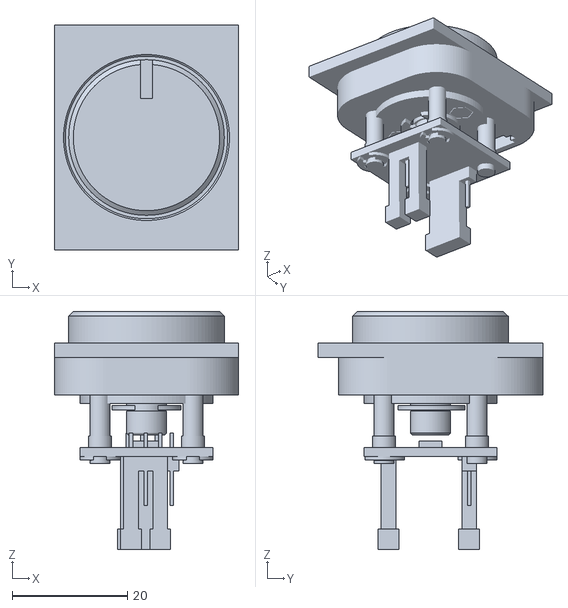
[picture p172: CAD file, 2026-08-28]
hardware/stl/knob_v5_half.stl
32.0 x 39.0 x 41.3
