n416/katanori/hardware/stl/term/2026-09-09-0340.stl

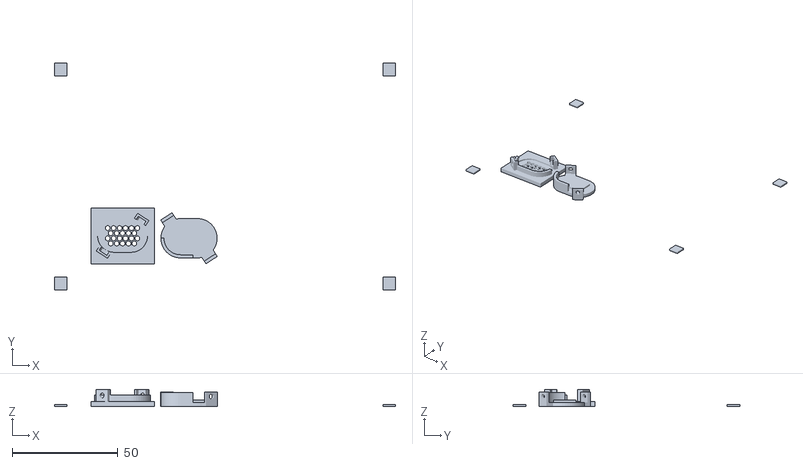
[picture p173: CAD file, 2026-09-08]
hardware/stl/term/2026-09-09-0340.stl
161.0 x 107.0 x 8.20
