n416/katanori/hardware/stl/test/coord_test_b.stl

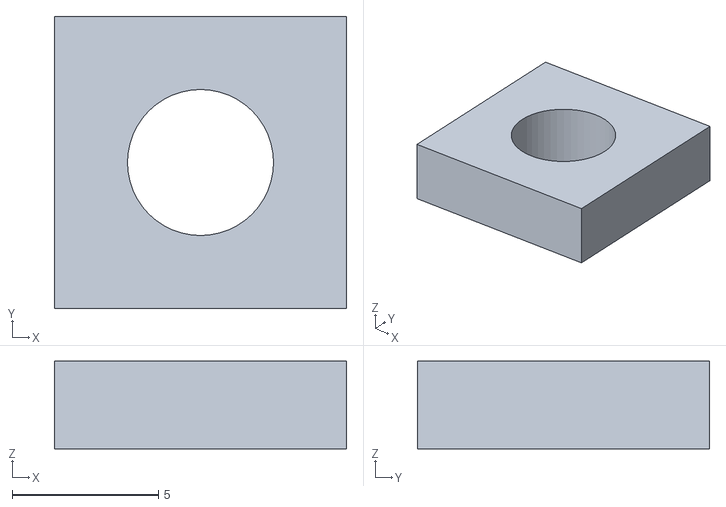
[picture p174: CAD file, 2026-08-31]
hardware/stl/test/coord_test_b.stl
10.0 x 10.0 x 3.00
