n416/katanori/hardware/stl/trial/trial_piston.stl

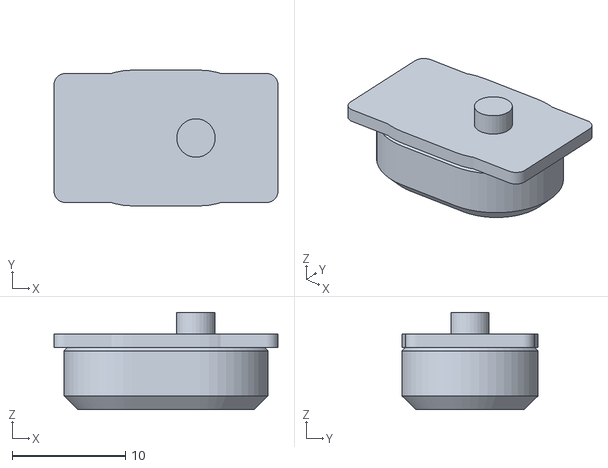
[picture p175: CAD file, 2026-09-07]
hardware/stl/trial/trial_piston.stl
19.8 x 12.0 x 8.59
