n416/katanori/hardware/stl/v5/v5_knobdeck.stl

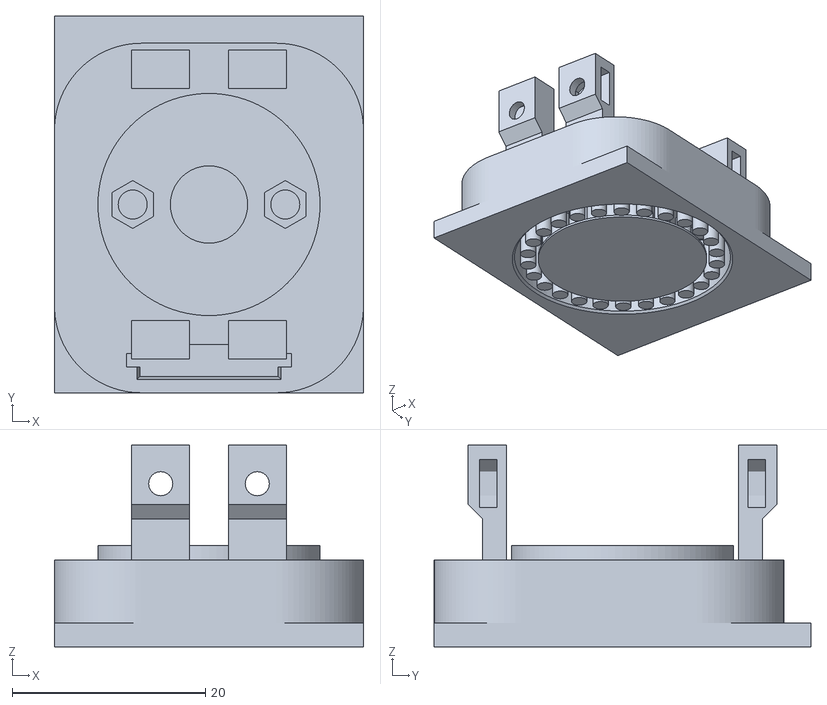
[picture p176: CAD file, 2026-09-11]
hardware/stl/v5/v5_knobdeck.stl
32.0 x 39.0 x 20.9
