n416/katanori/hardware/stl/v61n/v61n_btn_tub.stl

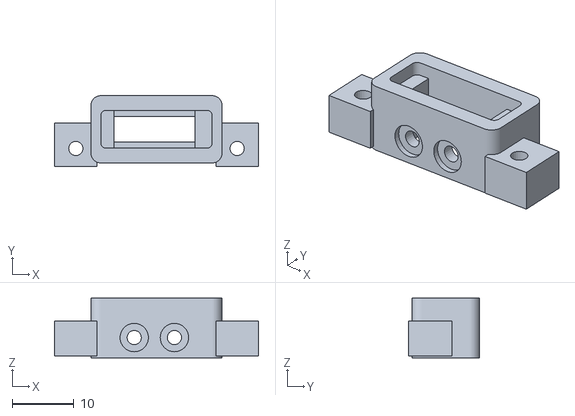
[picture p177: CAD file, 2026-09-19]
hardware/stl/v61n/v61n_btn_tub.stl
33.0 x 11.5 x 9.69
