n416/katanori/hardware/frozen/v6/pcb_tmp/f2_44_32.stl

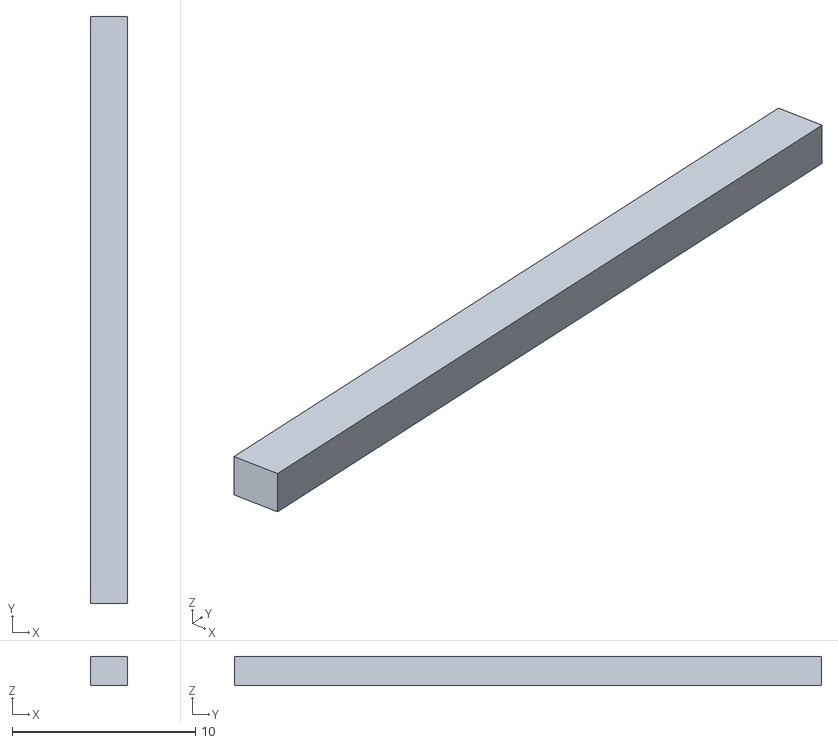
[picture p178: CAD file, 2026-09-14]
hardware/frozen/v6/pcb_tmp/f2_44_32.stl
2.00 x 32.0 x 1.60
