n416/katanori/hardware/ref/emgi_m3_sorter_PrintProfileV4.3mf

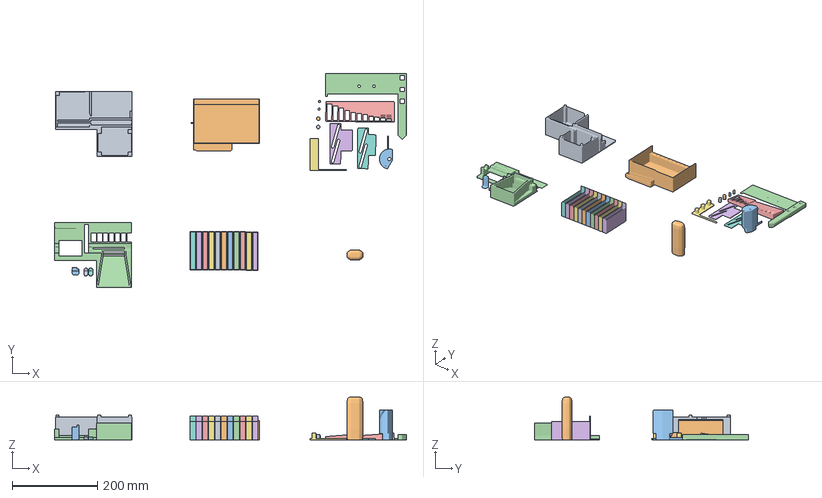
[picture p179: CAD file, 2026-09-14]
hardware/ref/emgi_m3_sorter_PrintProfileV4.3mf
825.2 x 501.7 x 100.0 mm
Grundplatte
Behälter
Rotator
SchieberUnten
SorterV2
Lifter2
SchieberOben
Lifter1
Rotatorbolzen x 2
Lifterstift x 2
Schaufel (1) x 11
Rotatordeckel x 2
Griff
Klemme
MainPlate
