n416/katanori/hardware/stl/jig/peg_gauge_pegs.stl

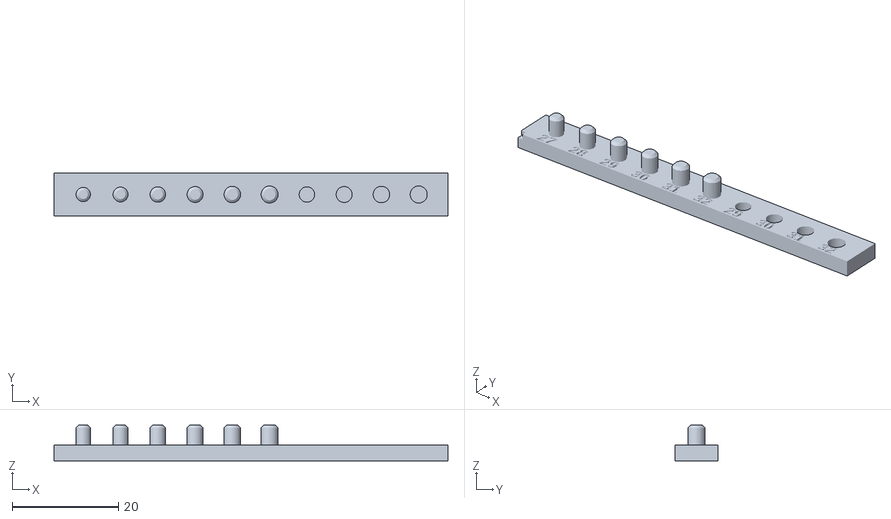
[picture p180: CAD file, 2026-09-10]
hardware/stl/jig/peg_gauge_pegs.stl
74.0 x 8.00 x 6.69
