n416/katanori/hardware/stl/pitch_gauge.stl

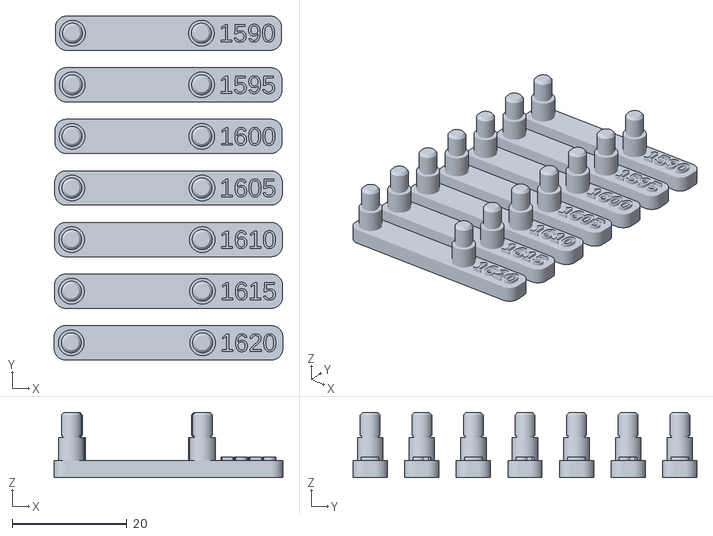
[picture p181: CAD file, 2026-08-28]
hardware/stl/pitch_gauge.stl
39.9 x 60.0 x 11.4
