n416/katanori/hardware/stl/term/2026-09-07-0537.stl

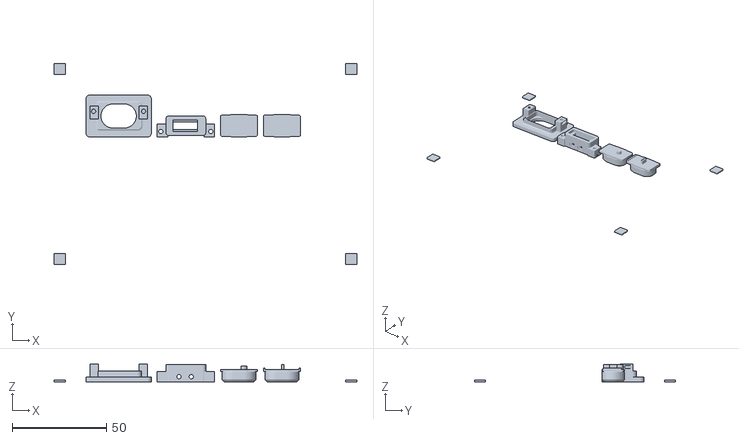
[picture p182: CAD file, 2026-09-07]
hardware/stl/term/2026-09-07-0537.stl
161.0 x 107.0 x 9.50
