n416/katanori/hardware/stl/test/coord_test_a.stl

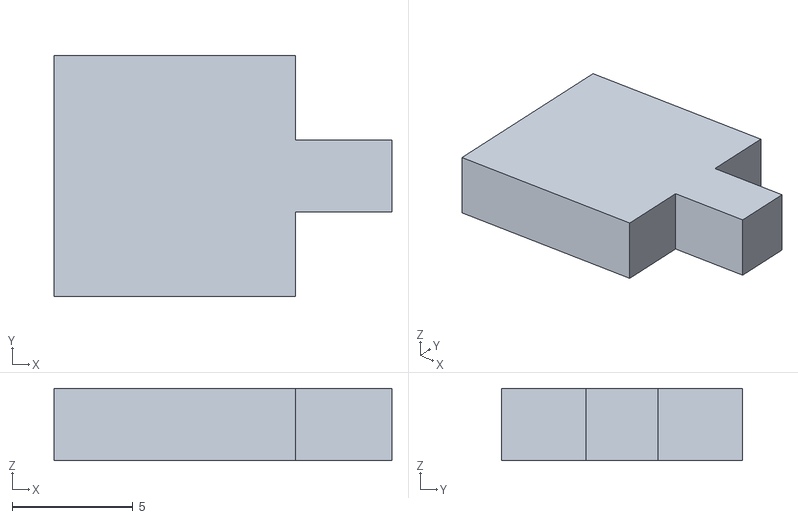
[picture p183: CAD file, 2026-08-31]
hardware/stl/test/coord_test_a.stl
14.0 x 10.0 x 3.00
