n416/katanori/hardware/stl/trial/trial_piston2.stl

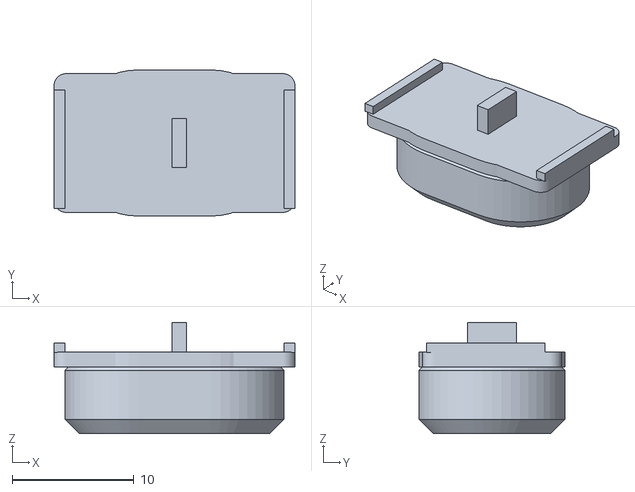
[picture p184: CAD file, 2026-09-07]
hardware/stl/trial/trial_piston2.stl
19.8 x 12.0 x 9.16
