n416/katanori/hardware/stl/v5/v5_floor.stl

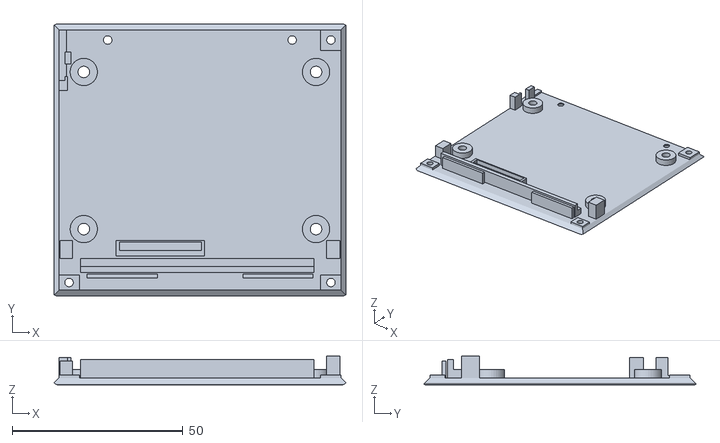
[picture p185: CAD file, 2026-09-11]
hardware/stl/v5/v5_floor.stl
85.5 x 79.8 x 8.49
