n416/katanori/hardware/stl/v61n/v61n_lid.stl

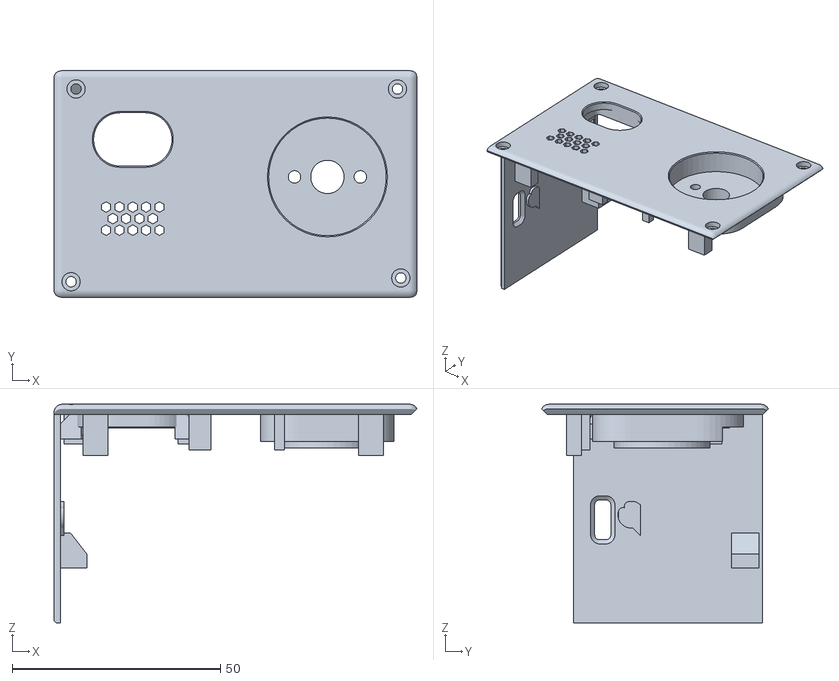
[picture p186: CAD file, 2026-09-19]
hardware/stl/v61n/v61n_lid.stl
87.1 x 54.4 x 52.5
