n416/katanori/hardware/frozen/v6/pcb_tmp/ctl_DY_0_-D_NEW_W_60.stl

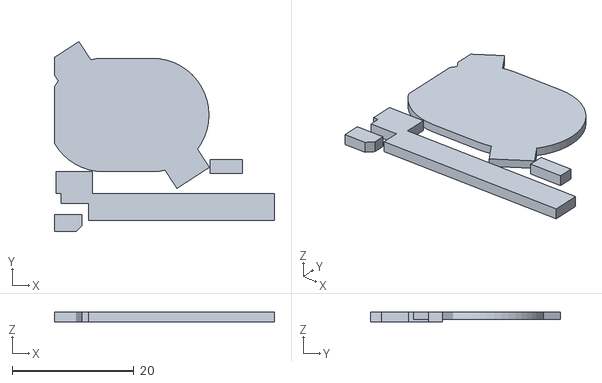
[picture p187: CAD file, 2026-09-14]
hardware/frozen/v6/pcb_tmp/ctl_DY_0_-D_NEW_W_60.stl
36.1 x 31.1 x 1.60
