n416/katanori/hardware/stl/hole_gauge.stl

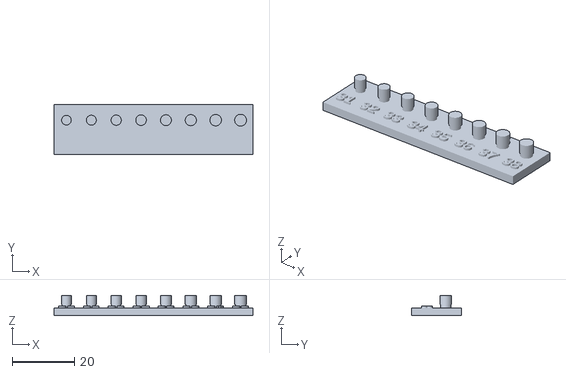
[picture p188: CAD file, 2026-08-27]
hardware/stl/hole_gauge.stl
64.0 x 16.0 x 6.50
