n416/katanori/hardware/stl/jig/peg_gauge_holes.stl

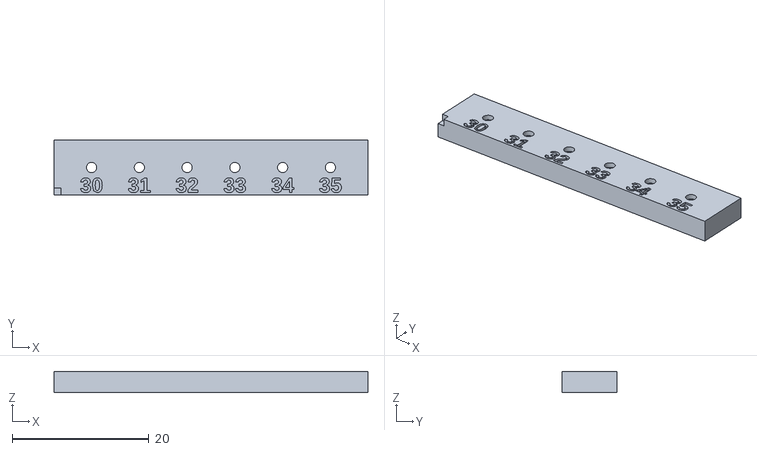
[picture p189: CAD file, 2026-09-10]
hardware/stl/jig/peg_gauge_holes.stl
46.0 x 8.00 x 3.10
