n416/katanori/hardware/stl/term/2026-09-05-1918.stl

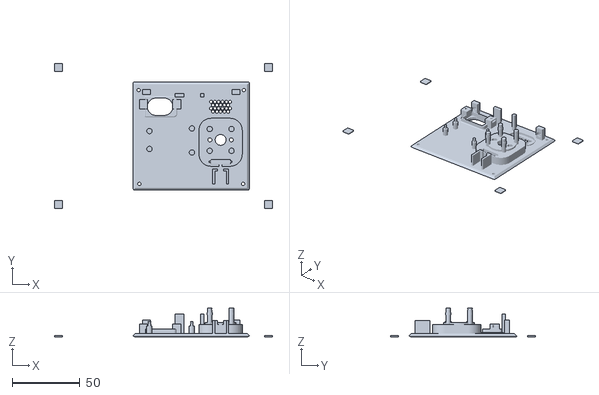
[picture p190: CAD file, 2026-09-06]
hardware/stl/term/2026-09-05-1918.stl
161.0 x 107.0 x 21.2
