n416/katanori/hardware/stl/test/coord_test_both.stl

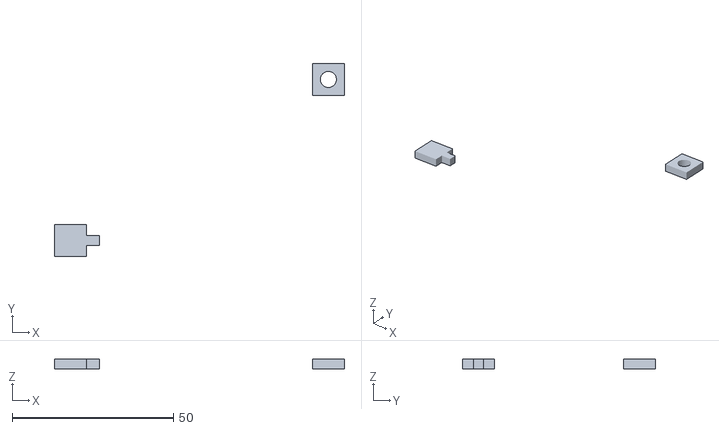
[picture p191: CAD file, 2026-08-31]
hardware/stl/test/coord_test_both.stl
90.0 x 60.0 x 3.00
