n416/katanori/hardware/stl/trial/trial_station.stl

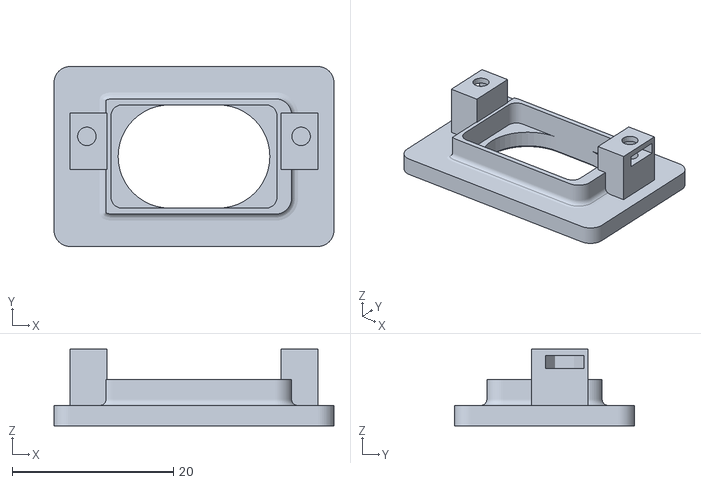
[picture p192: CAD file, 2026-09-07]
hardware/stl/trial/trial_station.stl
34.7 x 22.3 x 9.50
