n416/katanori/hardware/stl/v5/v5_shutfloor.stl

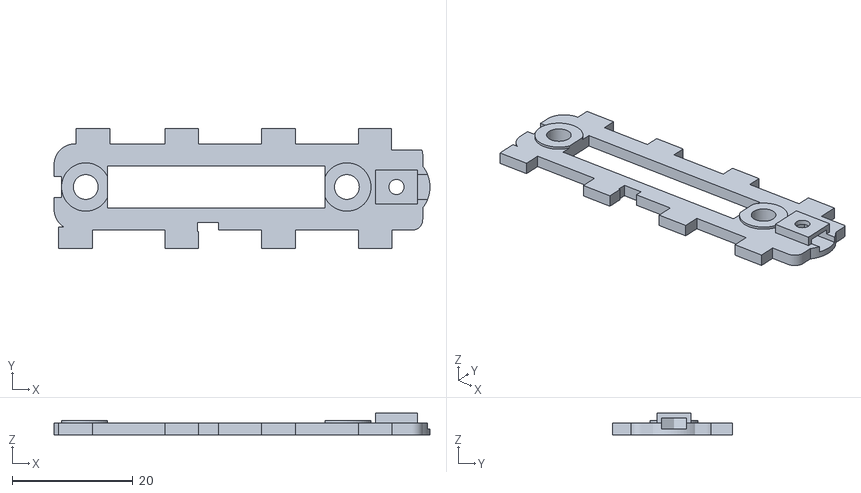
[picture p193: CAD file, 2026-09-11]
hardware/stl/v5/v5_shutfloor.stl
62.2 x 19.8 x 3.60
