n416/katanori/hardware/stl/v61n/v61n_spktub.stl

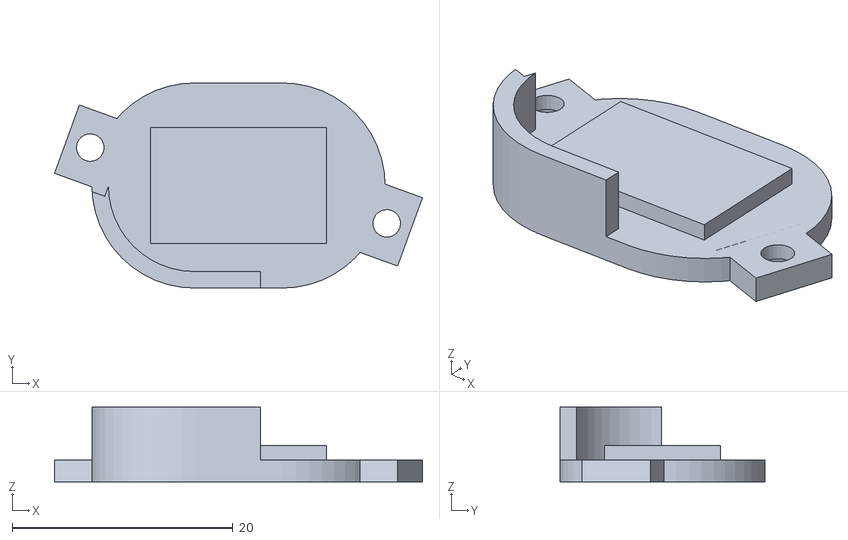
[picture p194: CAD file, 2026-09-19]
hardware/stl/v61n/v61n_spktub.stl
33.4 x 18.6 x 6.80
