n416/katanori/hardware/stl/case_v2_shutter.stl

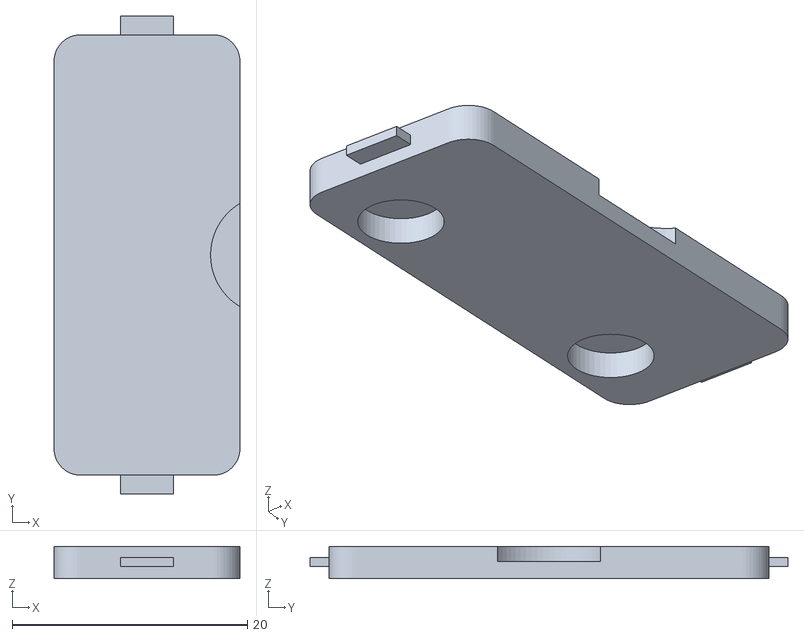
[picture p195: CAD file, 2026-08-21]
hardware/stl/case_v2_shutter.stl
15.8 x 40.6 x 2.75
