n416/katanori/hardware/stl/term/2026-09-05-1917.stl

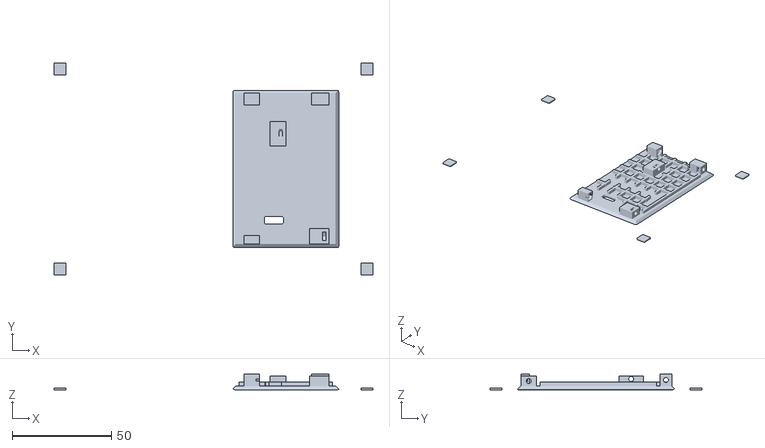
[picture p196: CAD file, 2026-09-05]
hardware/stl/term/2026-09-05-1917.stl
161.0 x 107.0 x 8.00
