n416/katanori/hardware/stl/test/anchor_test.stl

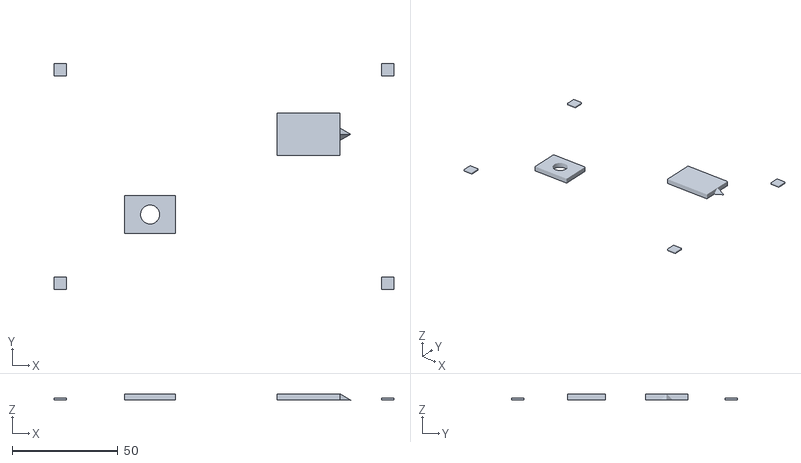
[picture p197: CAD file, 2026-08-31]
hardware/stl/test/anchor_test.stl
161.0 x 107.0 x 3.01
