n416/katanori/hardware/stl/v5/v5_lwall.stl

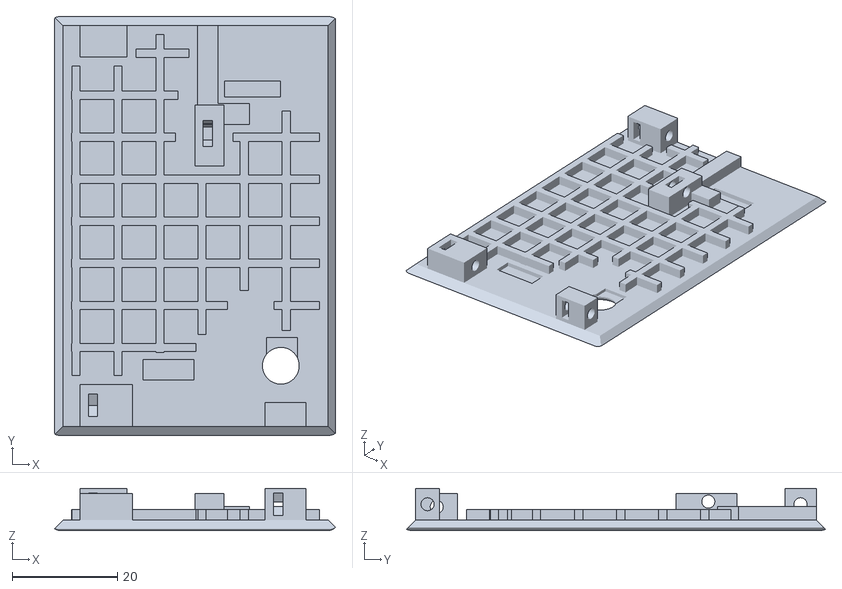
[picture p198: CAD file, 2026-09-11]
hardware/stl/v5/v5_lwall.stl
53.5 x 79.8 x 8.00
