n416/katanori/hardware/stl/v61n/v61n_island.stl

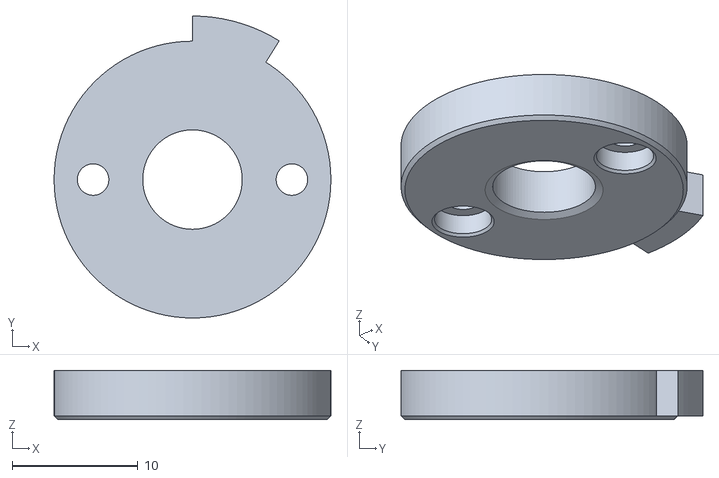
[picture p199: CAD file, 2026-09-15]
hardware/stl/v61n/v61n_island.stl
22.0 x 24.0 x 3.90
