n416/katanori/hardware/frozen/v6/pcb_tmp/pbfit_0.stl

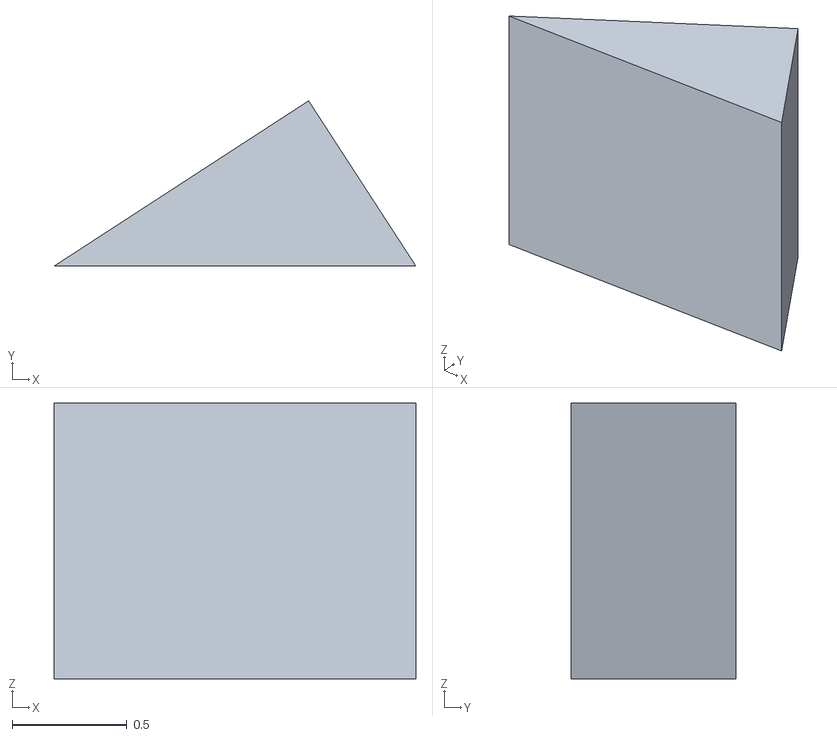
[picture p200: CAD file, 2026-09-14]
hardware/frozen/v6/pcb_tmp/pbfit_0.stl
1.57 x 0.719 x 1.20
