n416/katanori/hardware/stl/case_v2_lock.stl

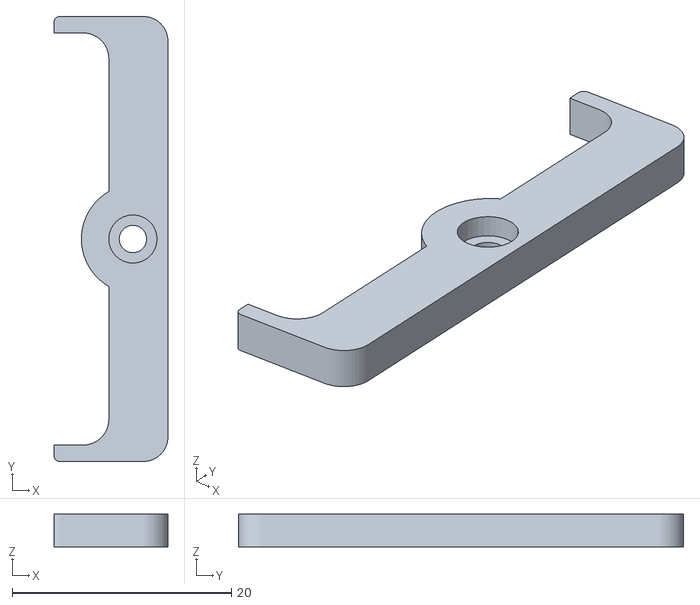
[picture p201: CAD file, 2026-08-21]
hardware/stl/case_v2_lock.stl
10.4 x 40.6 x 3.00
