n416/katanori/hardware/stl/term/2026-09-05-1920.stl

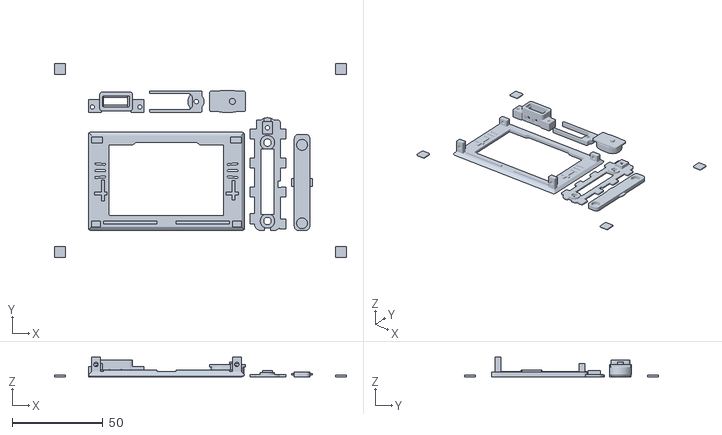
[picture p202: CAD file, 2026-09-05]
hardware/stl/term/2026-09-05-1920.stl
161.0 x 107.0 x 10.8
