n416/katanori/hardware/stl/test/mag_slot_gauge.stl

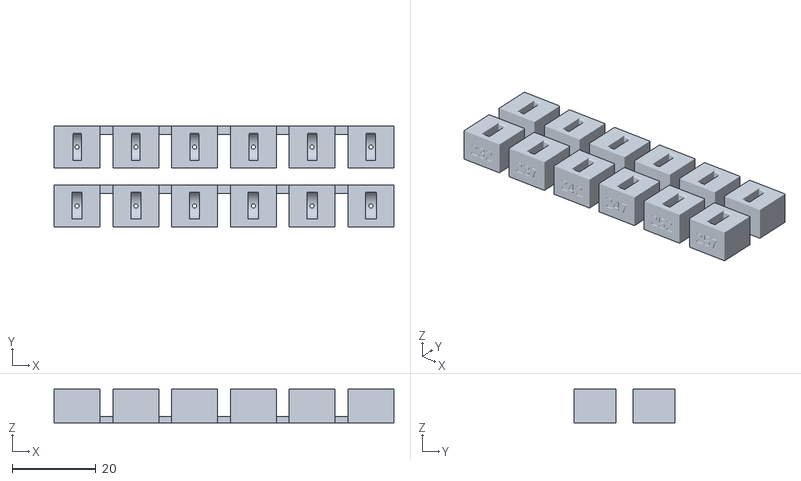
[picture p203: CAD file, 2026-08-31]
hardware/stl/test/mag_slot_gauge.stl
81.0 x 24.0 x 8.00
