n416/katanori/hardware/stl/v5/v5_knobhang.stl

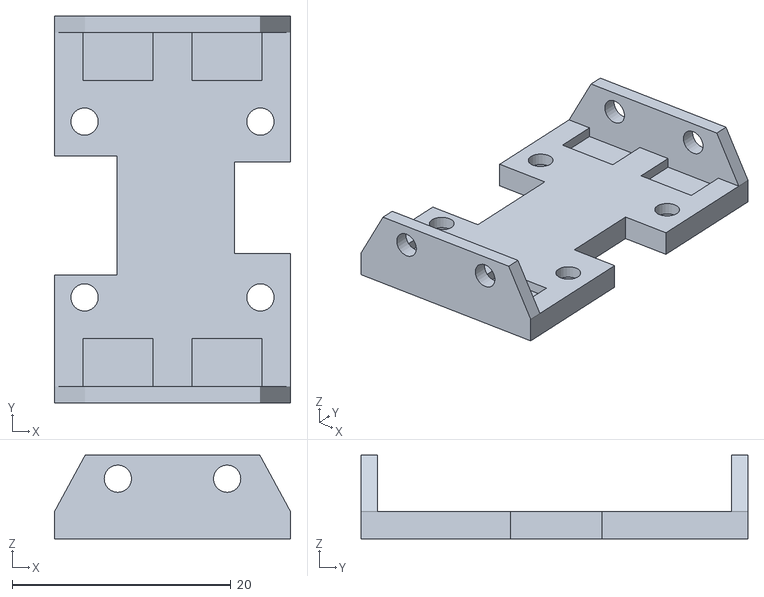
[picture p204: CAD file, 2026-09-11]
hardware/stl/v5/v5_knobhang.stl
21.6 x 35.4 x 7.65
