n416/katanori/hardware/stl/knob_v5_knob_prop.stl

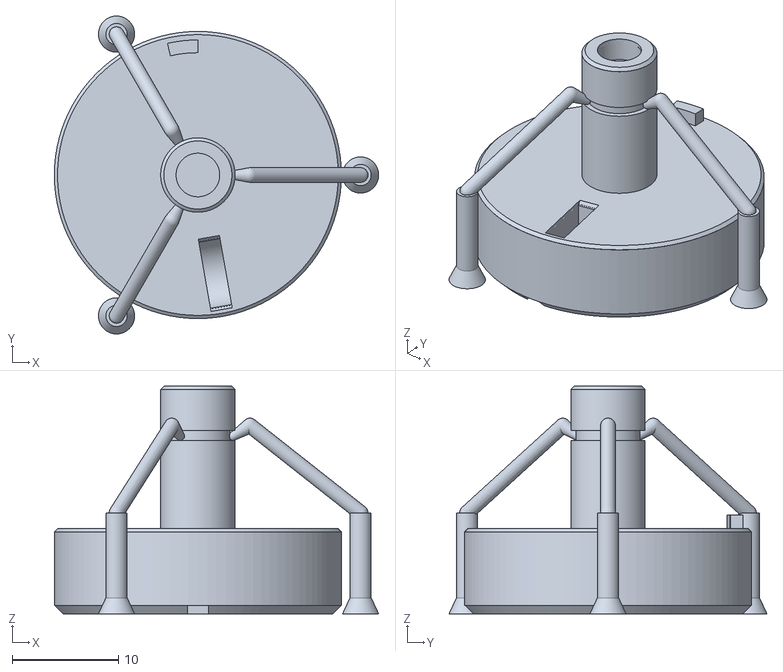
[picture p205: CAD file, 2026-08-21]
hardware/stl/knob_v5_knob_prop.stl
30.5 x 29.9 x 21.4
