n416/katanori/hardware/stl/term/2026-09-05-1914.stl

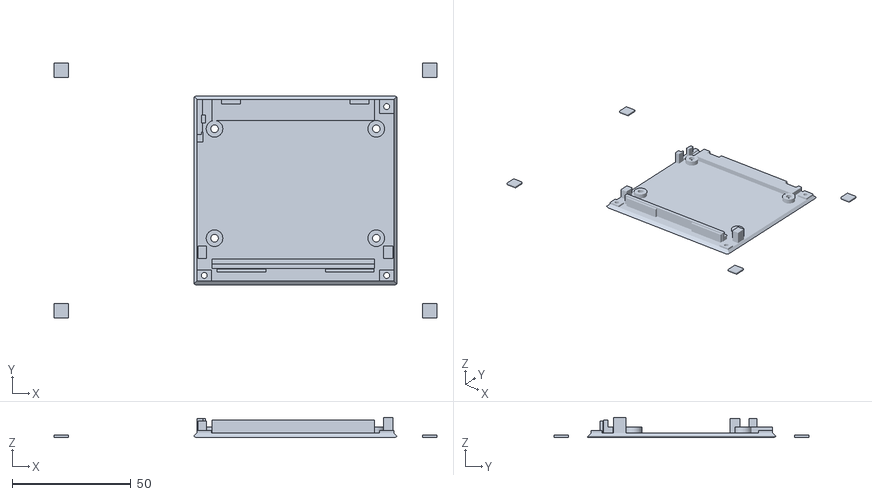
[picture p206: CAD file, 2026-09-05]
hardware/stl/term/2026-09-05-1914.stl
161.0 x 107.0 x 8.49
