n416/katanori/hardware/stl/test/flat_area_test.stl

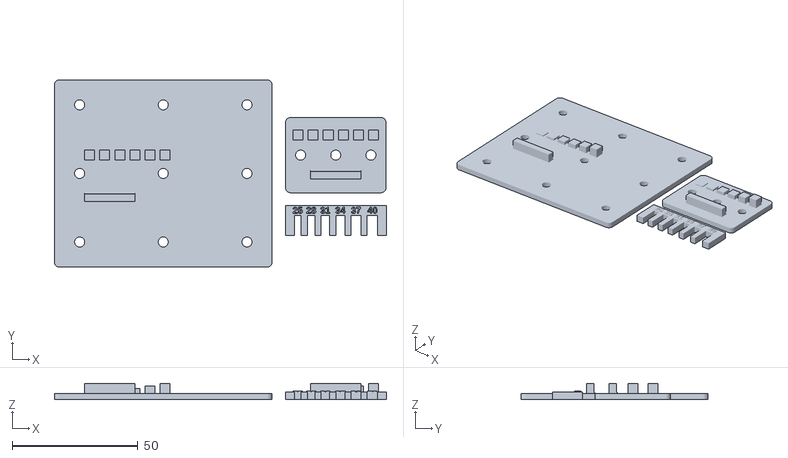
[picture p207: CAD file, 2026-08-31]
hardware/stl/test/flat_area_test.stl
132.2 x 74.6 x 6.50
