n416/katanori/hardware/stl/knob_v5_knob_plain.stl

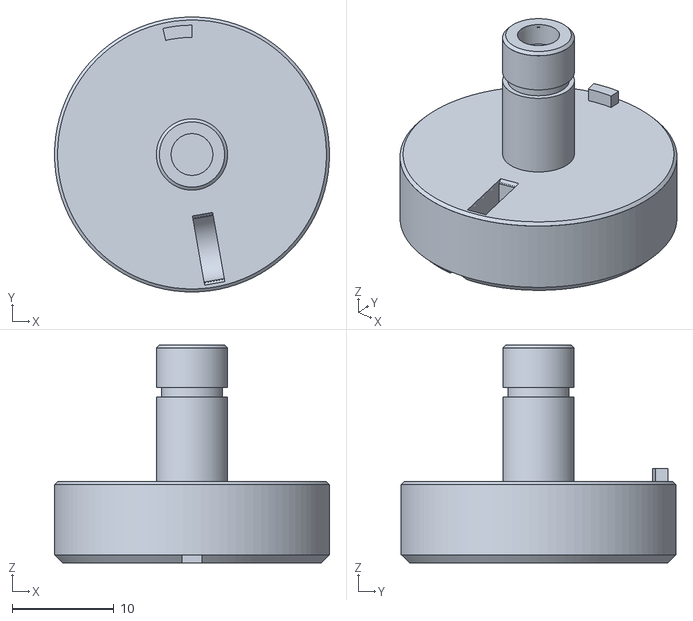
[picture p209: CAD file, 2026-08-21]
hardware/stl/knob_v5_knob_plain.stl
27.0 x 27.0 x 21.4
