n416/katanori/hardware/stl/term/2026-09-03-2037.stl

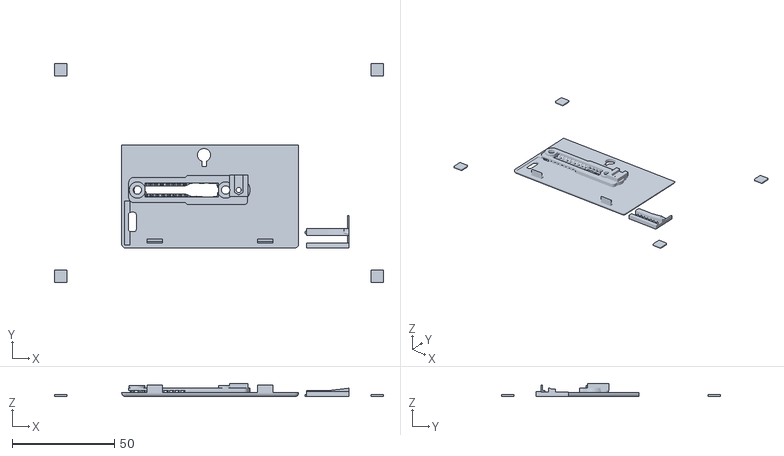
[picture p210: CAD file, 2026-09-03]
hardware/stl/term/2026-09-03-2037.stl
161.0 x 107.0 x 6.60
