n416/katanori/hardware/stl/test/thick_gauge.stl

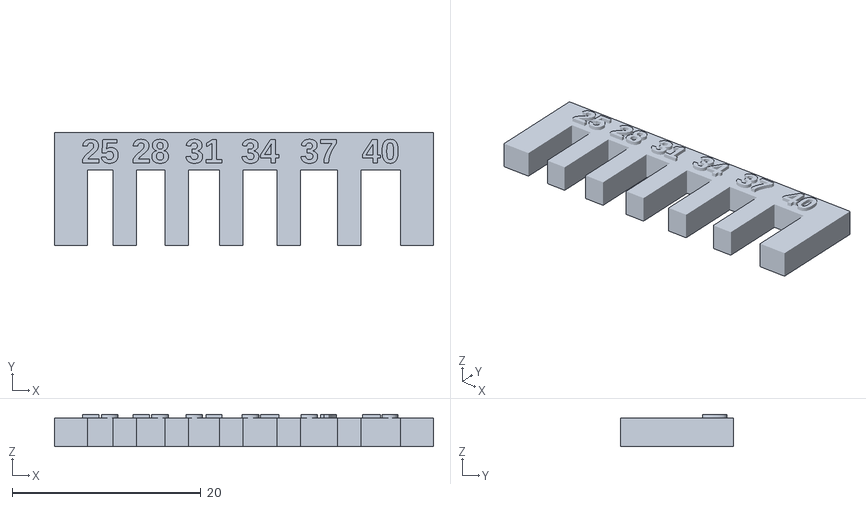
[picture p211: CAD file, 2026-08-31]
hardware/stl/test/thick_gauge.stl
40.2 x 12.0 x 3.40
