n416/katanori/hardware/stl/v5/v5_strap_b.stl

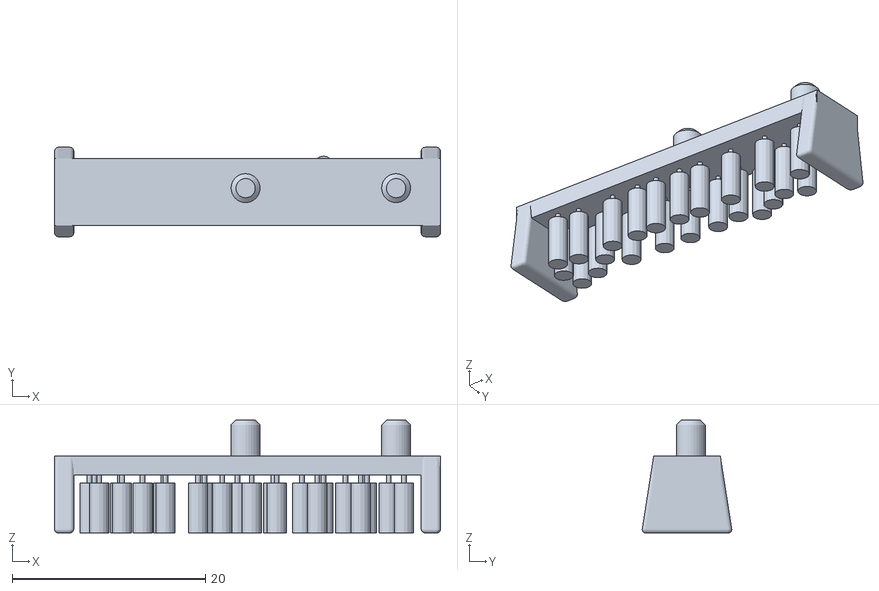
[picture p212: CAD file, 2026-09-10]
hardware/stl/v5/v5_strap_b.stl
40.0 x 9.28 x 11.7
