n416/katanori/hardware/stl/case_top.stl

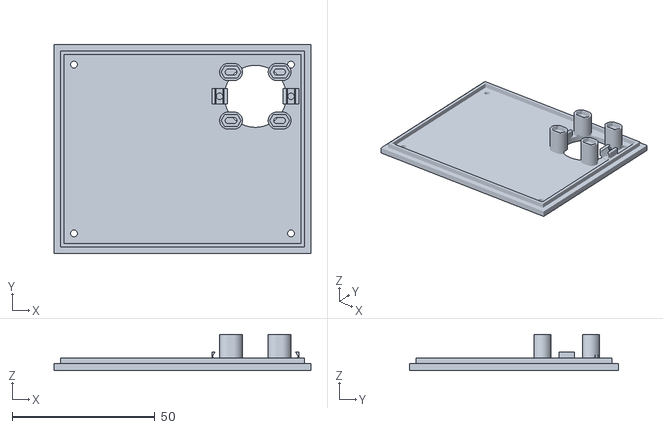
[picture p213: CAD file, 2026-08-17]
hardware/stl/case_top.stl
90.0 x 73.1 x 12.7
