n416/katanori/hardware/stl/term/2026-09-03-0244.stl

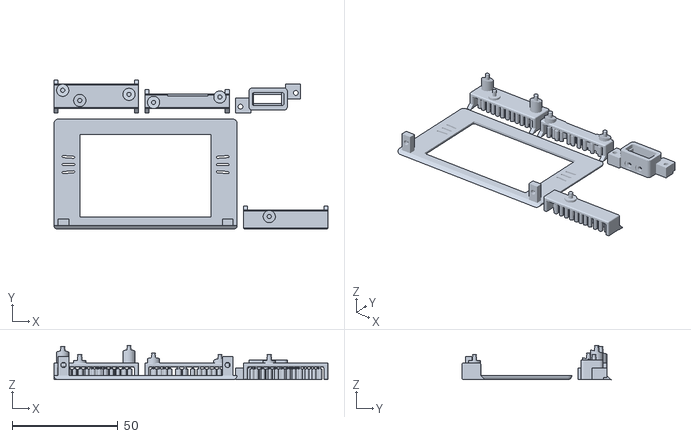
[picture p214: CAD file, 2026-09-02]
hardware/stl/term/2026-09-03-0244.stl
129.7 x 70.7 x 16.3
