n416/katanori/hardware/stl/test/btntest.stl

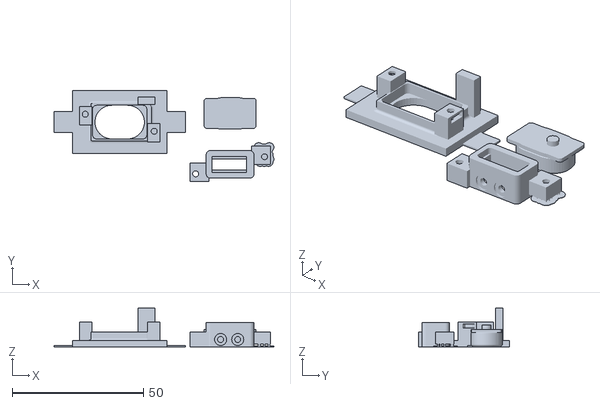
[picture p215: CAD file, 2026-08-30]
hardware/stl/test/btntest.stl
83.7 x 34.6 x 14.7
