n416/katanori/hardware/stl/v5/v5_top.stl

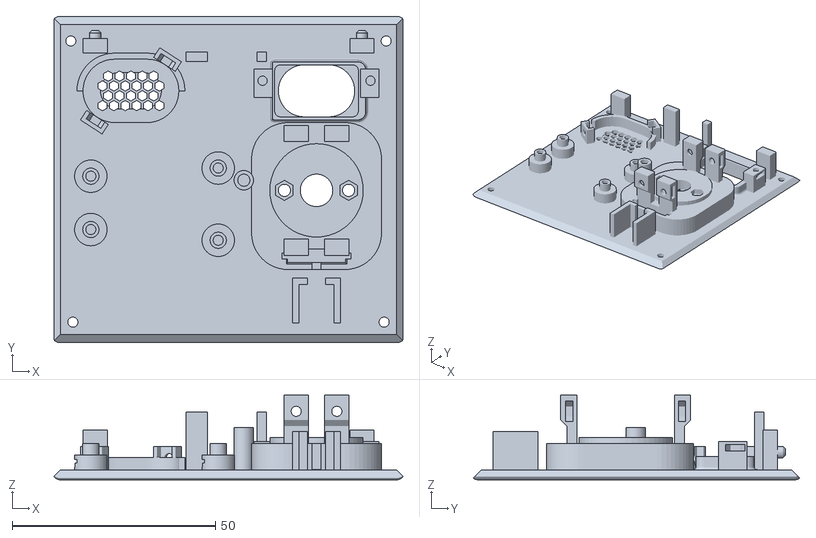
[picture p216: CAD file, 2026-09-10]
hardware/stl/v5/v5_top.stl
85.9 x 80.4 x 20.9
