n416/katanori/hardware/stl/fit_gauge.stl

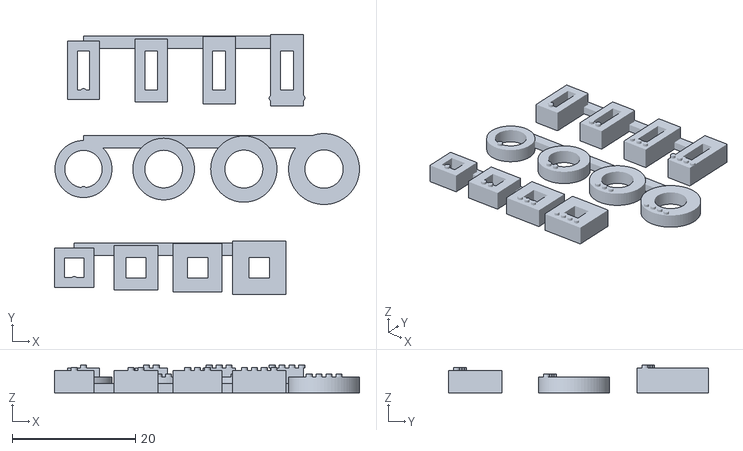
[picture p217: CAD file, 2026-08-17]
hardware/stl/fit_gauge.stl
49.5 x 42.1 x 4.50
