n416/katanori/hardware/stl/term/2026-09-02-0540.stl

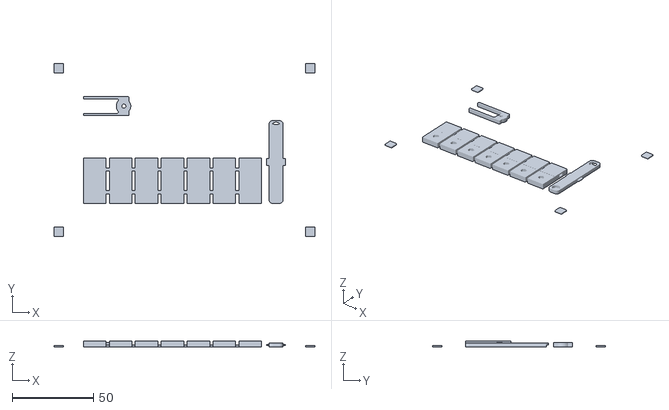
[picture p218: CAD file, 2026-09-01]
hardware/stl/term/2026-09-02-0540.stl
161.0 x 107.0 x 4.00
