n416/katanori/hardware/stl/test/knob_deck.stl

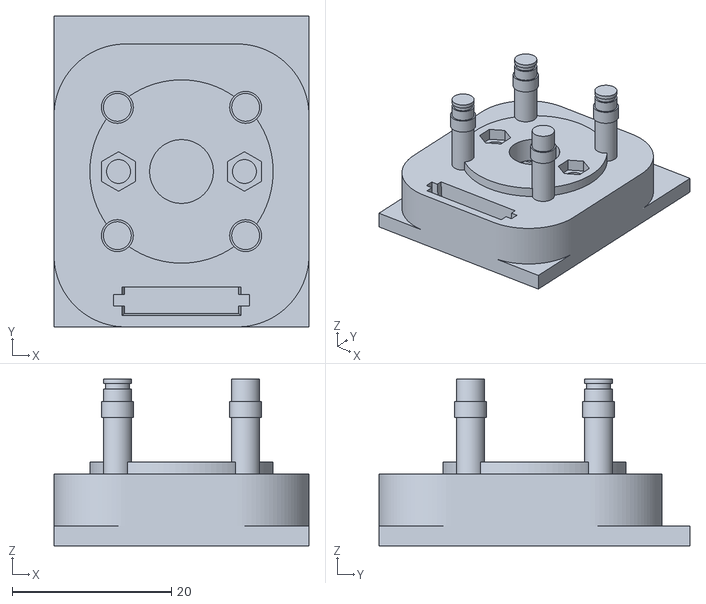
[picture p219: CAD file, 2026-08-28]
hardware/stl/test/knob_deck.stl
32.0 x 39.0 x 20.9
