n416/katanori/hardware/stl/v5/v5_inabar_d.stl

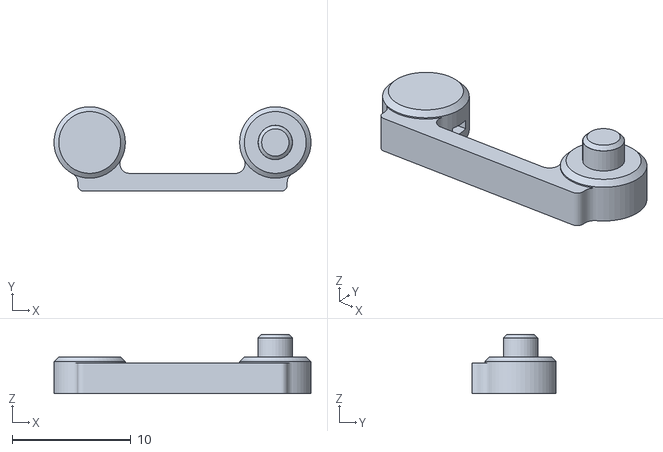
[picture p220: CAD file, 2026-09-10]
hardware/stl/v5/v5_inabar_d.stl
21.6 x 7.10 x 4.99
