n416/katanori/hardware/stl/case_v1_upper.stl

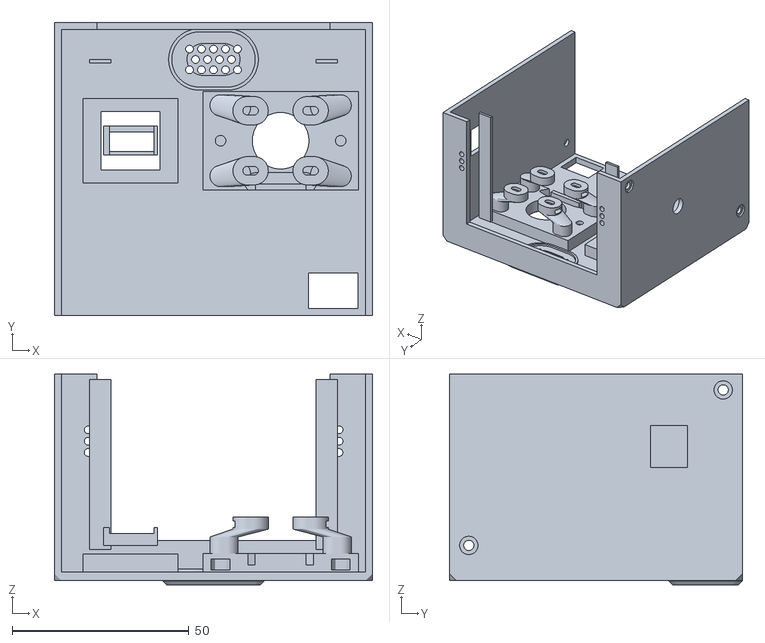
[picture p221: CAD file, 2026-08-17]
hardware/stl/case_v1_upper.stl
90.0 x 83.0 x 59.7
