n416/katanori/hardware/stl/term/2026-09-01-1525.stl

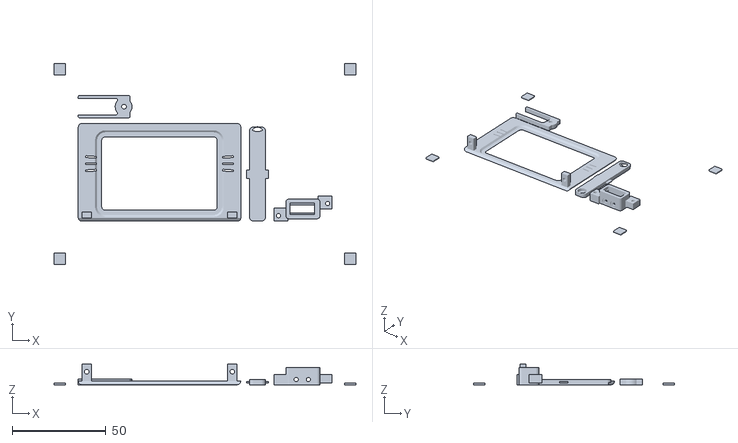
[picture p222: CAD file, 2026-09-01]
hardware/stl/term/2026-09-01-1525.stl
161.0 x 107.0 x 11.0
