n416/katanori/hardware/stl/case_v1_lower.stl

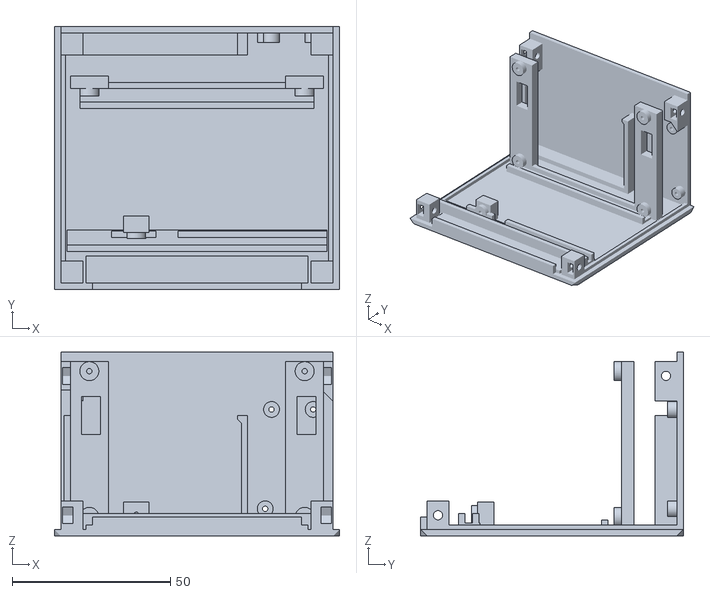
[picture p224: CAD file, 2026-08-17]
hardware/stl/case_v1_lower.stl
90.0 x 83.0 x 58.0
