n416/katanori/hardware/stl/term/2026-09-01-0107.stl

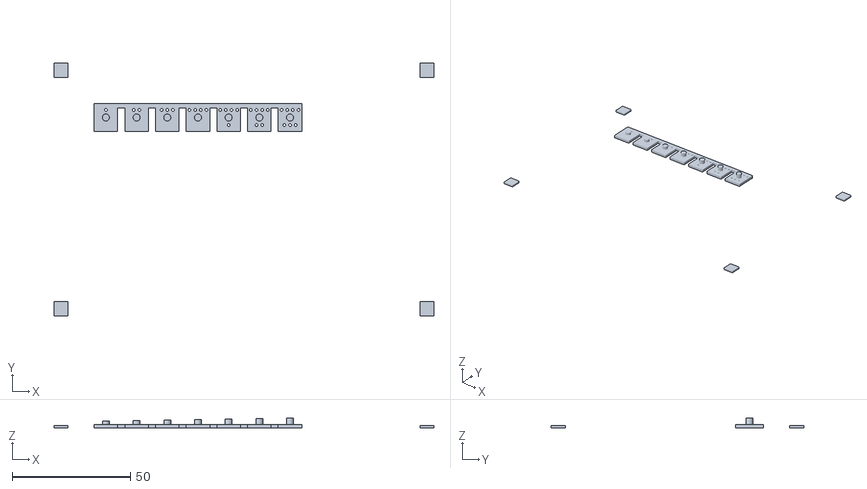
[picture p225: CAD file, 2026-08-31]
hardware/stl/term/2026-09-01-0107.stl
161.0 x 107.0 x 4.10
