n416/katanori/hardware/stl/case_v1_button.stl

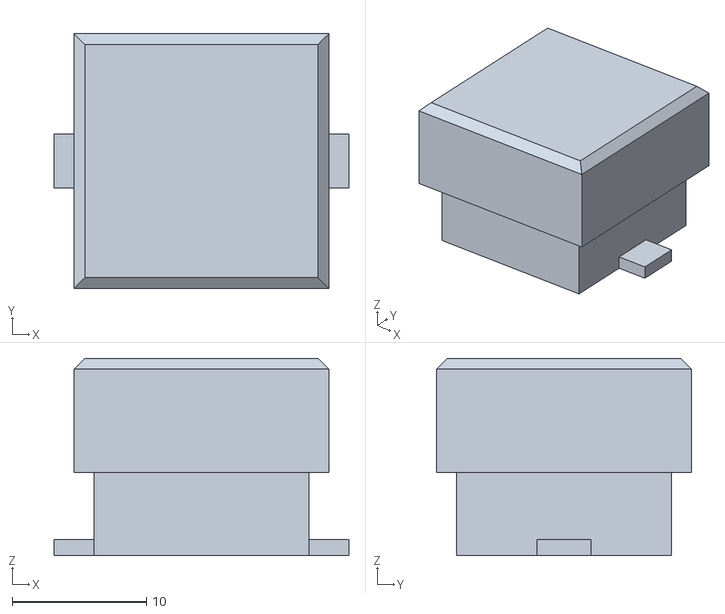
[picture p226: CAD file, 2026-08-17]
hardware/stl/case_v1_button.stl
22.0 x 19.0 x 14.7
