n416/katanori/hardware/stl/v5/v5_inabar_a.stl

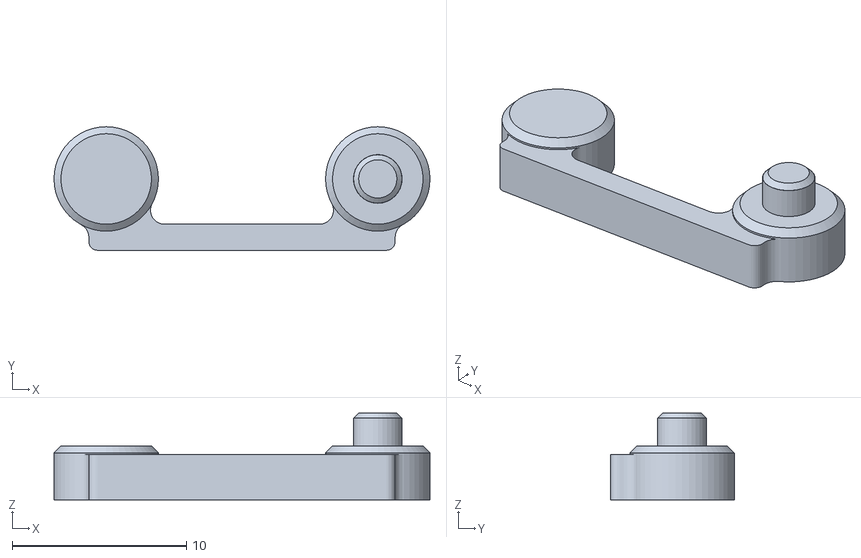
[picture p227: CAD file, 2026-09-09]
hardware/stl/v5/v5_inabar_a.stl
21.6 x 7.10 x 4.99
