n416/katanori/hardware/stl/fit_gauge_edge.stl

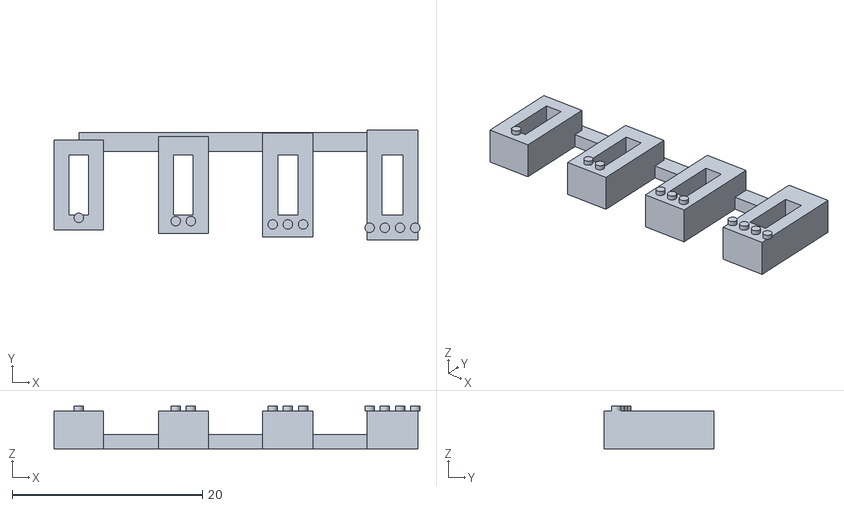
[picture p228: CAD file, 2026-08-17]
hardware/stl/fit_gauge_edge.stl
38.5 x 11.6 x 4.50
