n416/katanori/hardware/stl/v5/v5_strap_c.stl

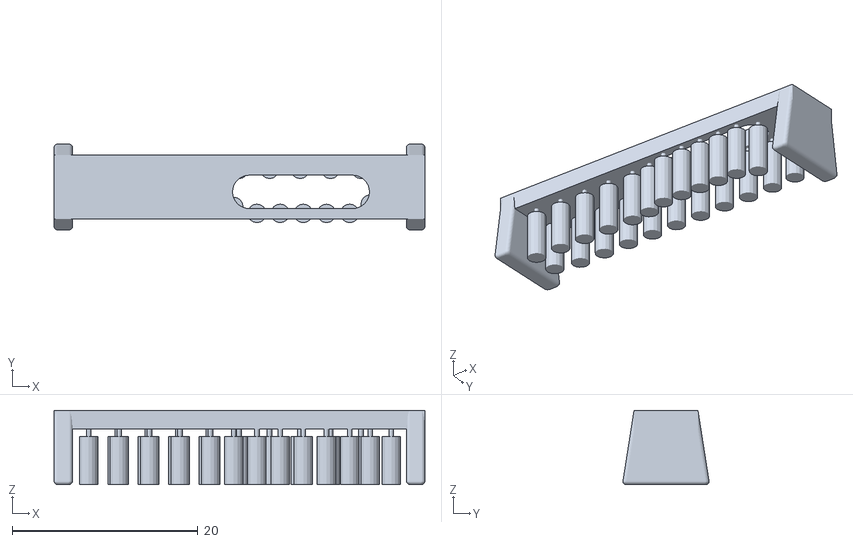
[picture p230: CAD file, 2026-09-09]
hardware/stl/v5/v5_strap_c.stl
40.0 x 9.28 x 8.00
