n416/katanori/hardware/stl/stand_left_lock.stl

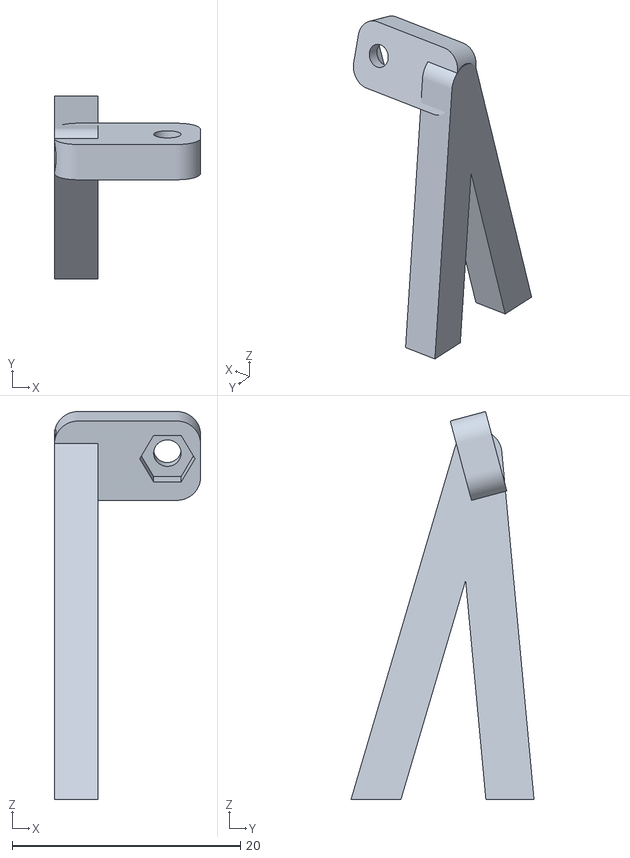
[picture p231: CAD file, 2026-08-11]
hardware/stl/stand_left_lock.stl
12.8 x 16.0 x 34.0
