n416/katanori/hardware/stl/v5/v5_bridge.stl

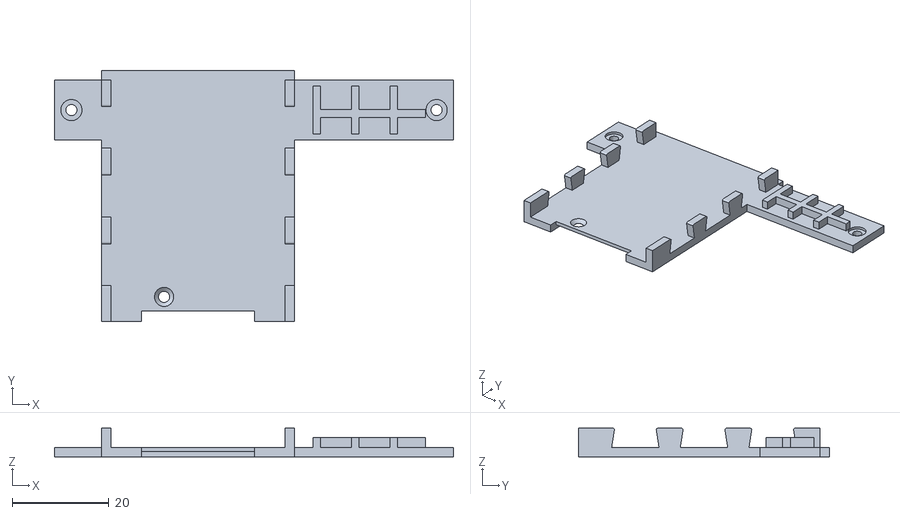
[picture p232: CAD file, 2026-09-09]
hardware/stl/v5/v5_bridge.stl
82.7 x 52.0 x 6.00
