n416/katanori/hardware/stl/v5/v5_spktub.stl

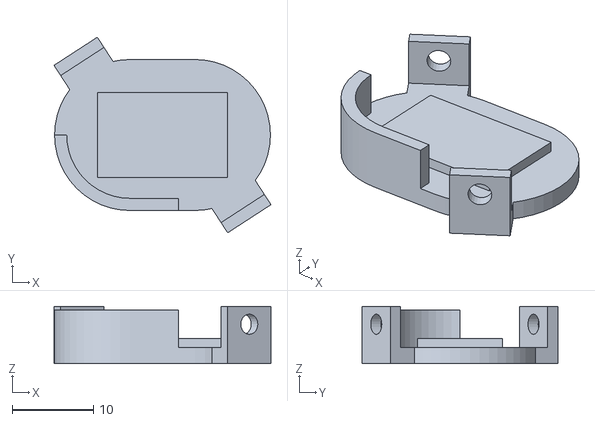
[picture p233: CAD file, 2026-09-08]
hardware/stl/v5/v5_spktub.stl
26.7 x 24.1 x 7.05
