n416/katanori/hardware/stl/v5/v5_spktest.stl

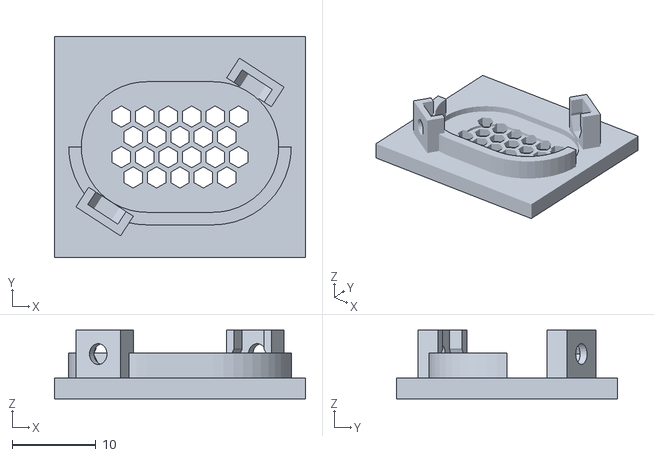
[picture p234: CAD file, 2026-09-08]
hardware/stl/v5/v5_spktest.stl
30.0 x 26.4 x 8.20
