n416/katanori/hardware/stl/as5600_frame.stl

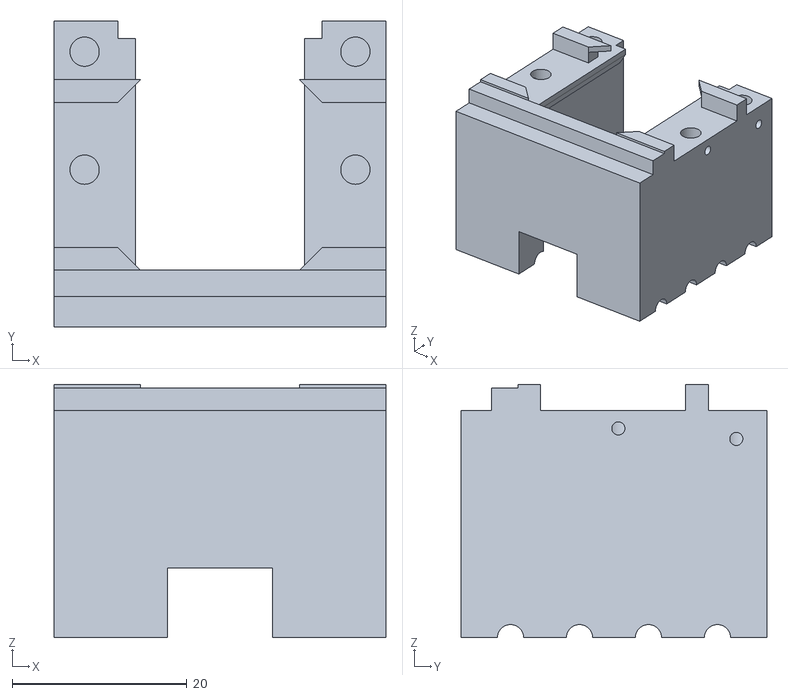
[picture p235: CAD file, 2026-08-11]
hardware/stl/as5600_frame.stl
38.0 x 35.0 x 29.0
