n416/katanori/hardware/stl/stand_ab_frame.stl

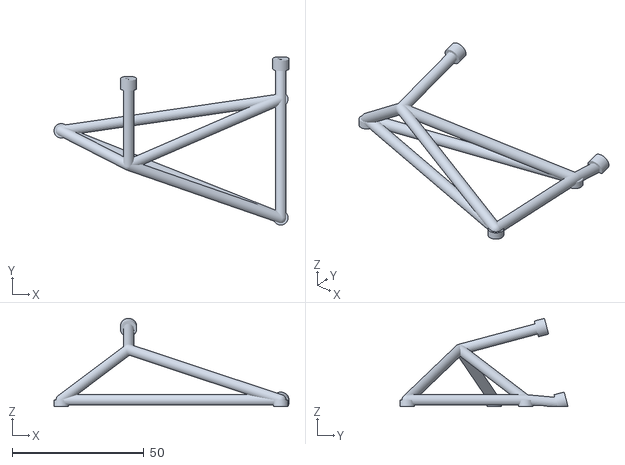
[picture p236: CAD file, 2026-08-11]
hardware/stl/stand_ab_frame.stl
89.1 x 63.8 x 33.5
