n416/katanori/hardware/stl/v5/v5_front.stl

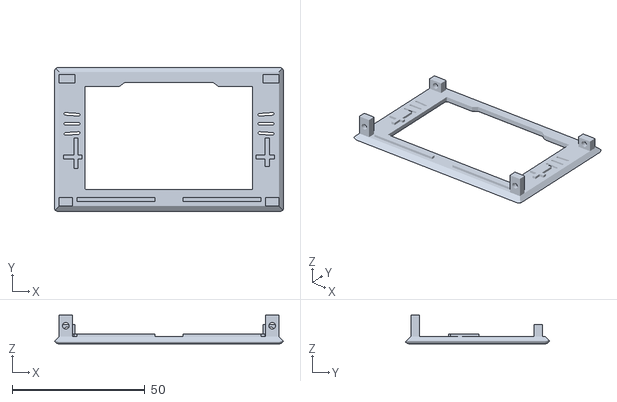
[picture p237: CAD file, 2026-09-05]
hardware/stl/v5/v5_front.stl
86.2 x 54.3 x 10.8
