n416/katanori/hardware/stl/stand_ab_cover.stl

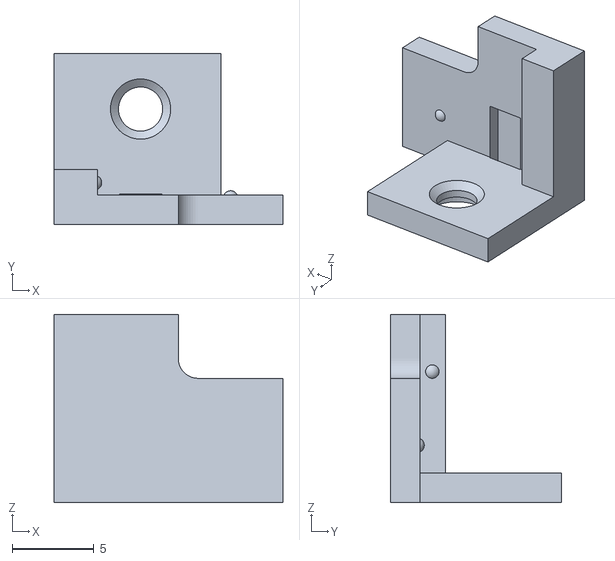
[picture p238: CAD file, 2026-08-11]
hardware/stl/stand_ab_cover.stl
14.0 x 10.5 x 11.5
