n416/katanori/hardware/stl/v5/v5_shutter.stl

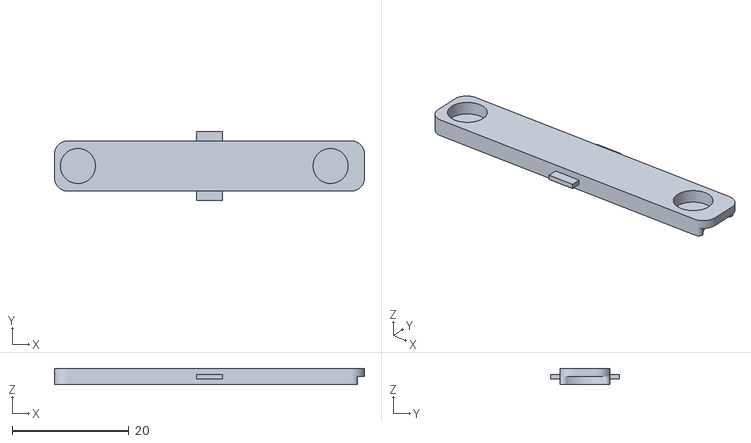
[picture p239: CAD file, 2026-09-05]
hardware/stl/v5/v5_shutter.stl
53.0 x 11.8 x 2.75
