n416/katanori/hardware/stl/as5600_bridge.stl

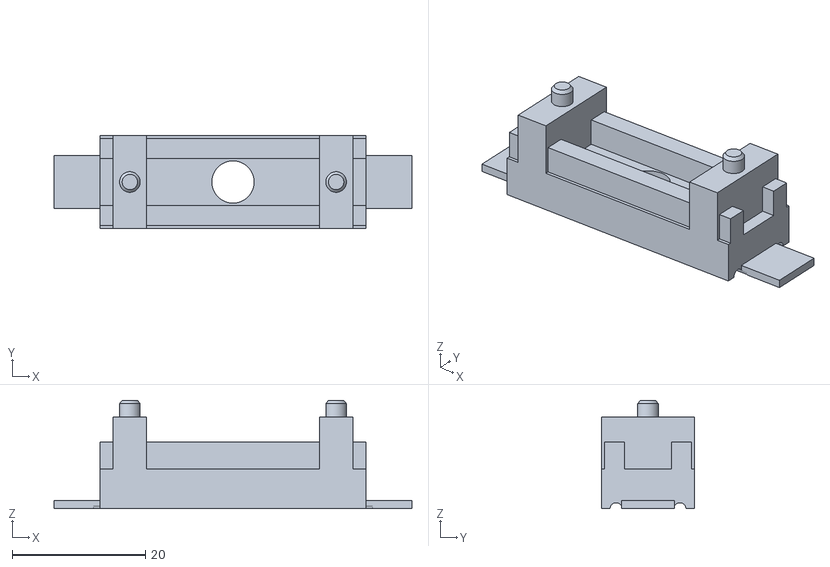
[picture p240: CAD file, 2026-08-11]
hardware/stl/as5600_bridge.stl
53.8 x 14.0 x 16.3
