n416/katanori/hardware/stl/v5/v5_knob.stl

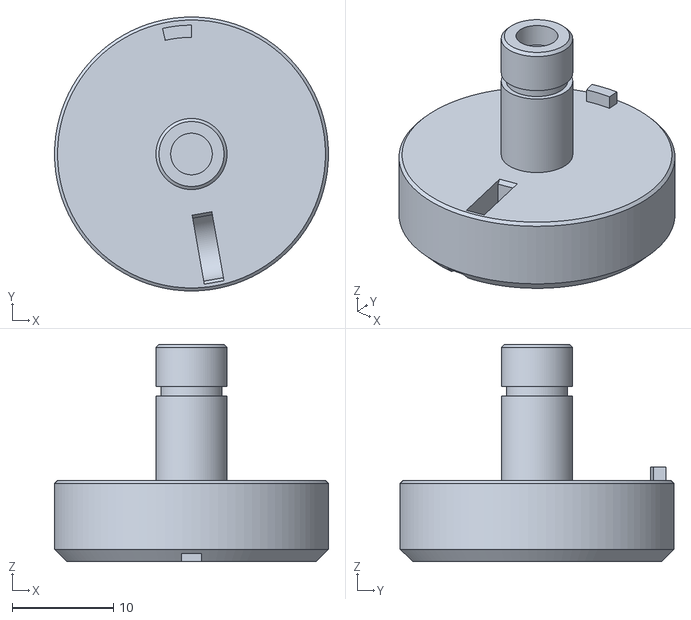
[picture p241: CAD file, 2026-09-05]
hardware/stl/v5/v5_knob.stl
27.0 x 27.0 x 21.4
