n416/katanori/hardware/stl/checkflip.stl

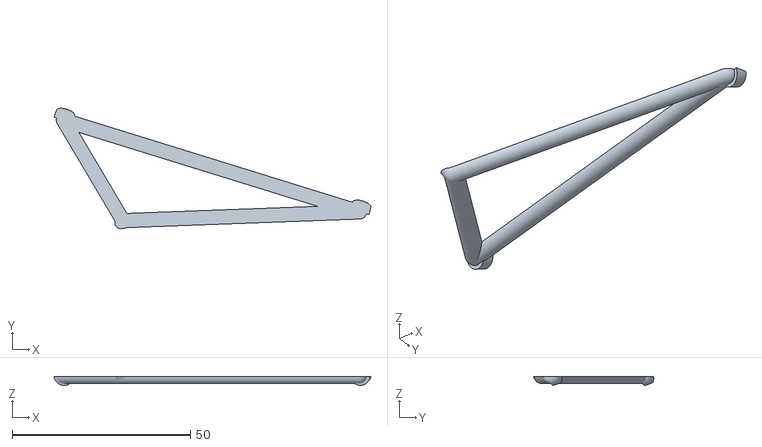
[picture p242: CAD file, 2026-08-11]
hardware/stl/checkflip.stl
89.0 x 33.9 x 2.53
