n416/katanori/hardware/stl/v5/v5_brgfront.stl

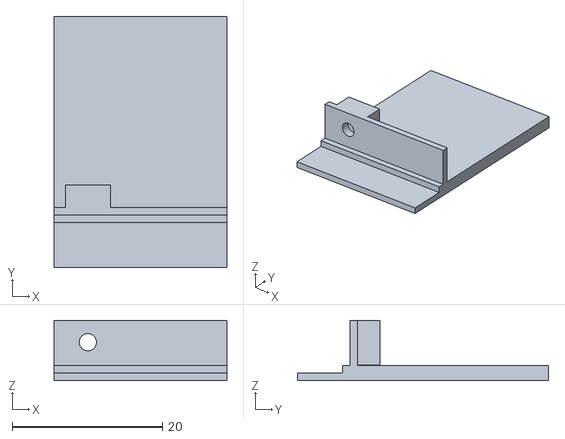
[picture p243: CAD file, 2026-09-05]
hardware/stl/v5/v5_brgfront.stl
23.0 x 33.4 x 8.00
