n416/katanori/hardware/stl/v5/v5_lock.stl

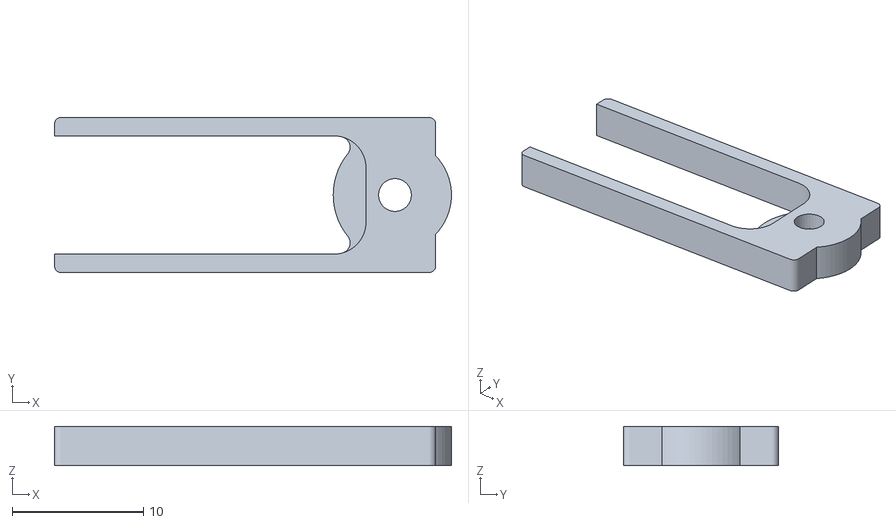
[picture p244: CAD file, 2026-09-05]
hardware/stl/v5/v5_lock.stl
30.2 x 11.8 x 3.00
