n416/katanori/hardware/stl/as5600_lock.stl

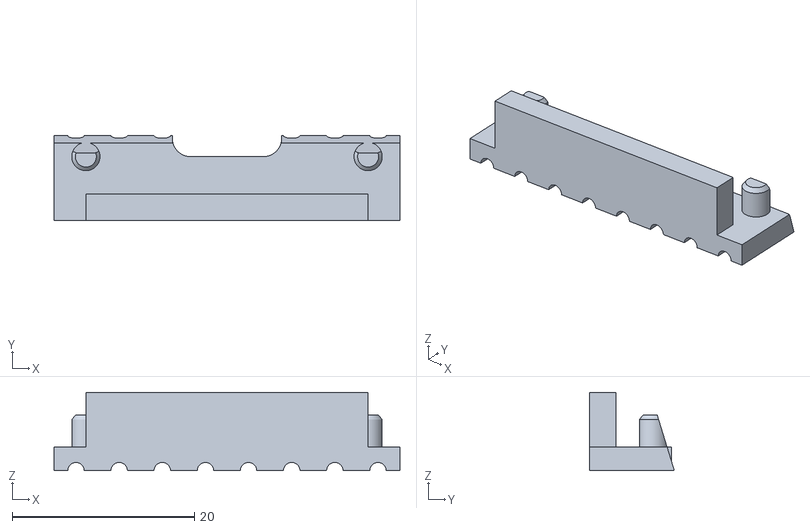
[picture p245: CAD file, 2026-08-11]
hardware/stl/as5600_lock.stl
38.0 x 9.30 x 8.60
