n416/katanori/hardware/stl/stand_ab_frame_v7.stl

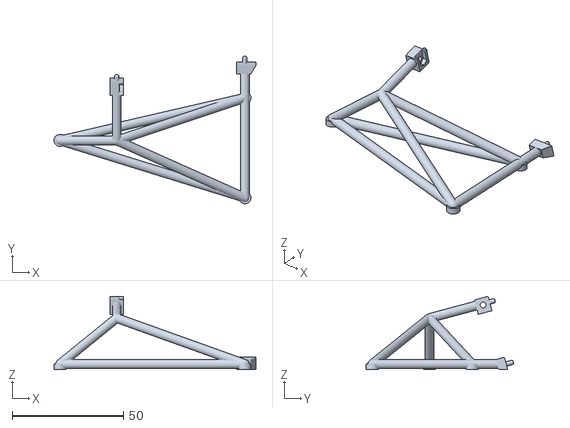
[picture p246: CAD file, 2026-08-11]
hardware/stl/stand_ab_frame_v7.stl
91.0 x 66.5 x 33.0
