n416/katanori/hardware/stl/stand_ab_cover_v8.stl

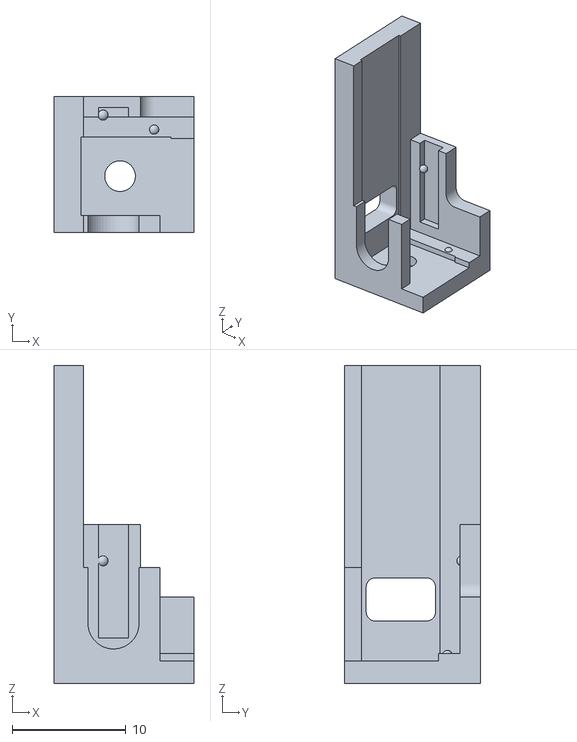
[picture p247: CAD file, 2026-08-11]
hardware/stl/stand_ab_cover_v8.stl
12.3 x 11.9 x 28.0
