n416/katanori/hardware/stl/board_gauge.stl

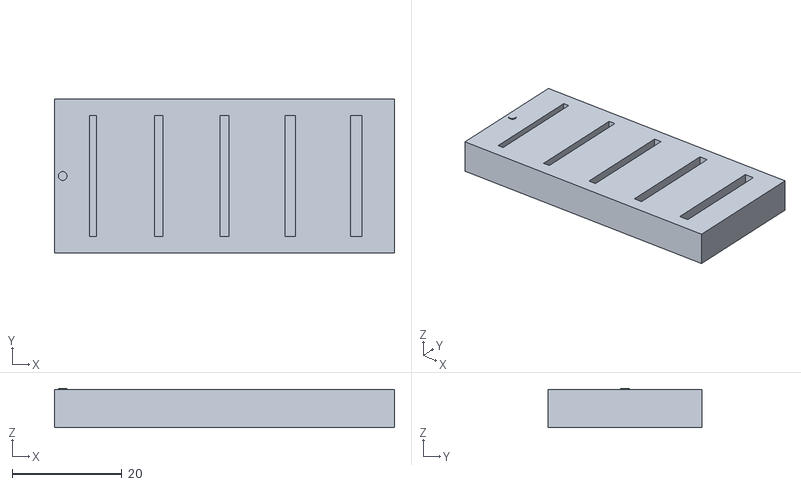
[picture p248: CAD file, 2026-08-11]
hardware/stl/board_gauge.stl
62.0 x 28.0 x 7.20
