n416/katanori/hardware/stl/peg_bore_gauge.stl

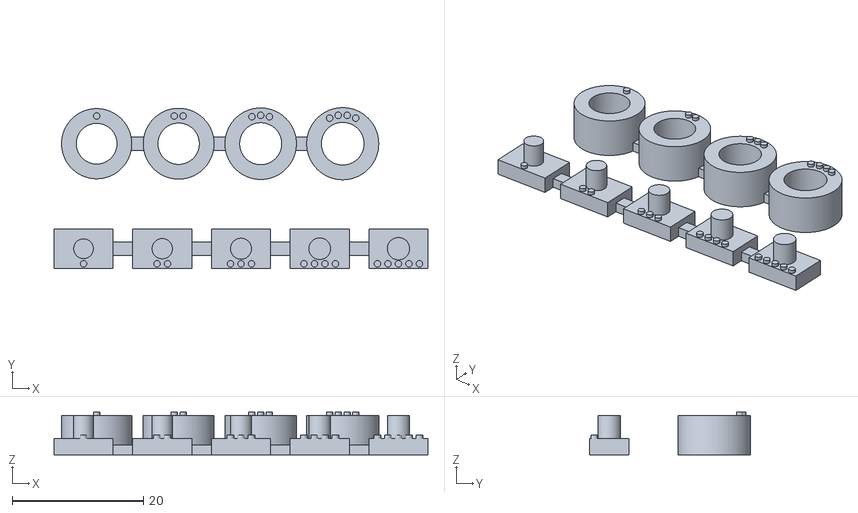
[picture p249: CAD file, 2026-08-11]
hardware/stl/peg_bore_gauge.stl
57.0 x 24.5 x 6.50
