n416/katanori/hardware/stl/flipfoot.stl

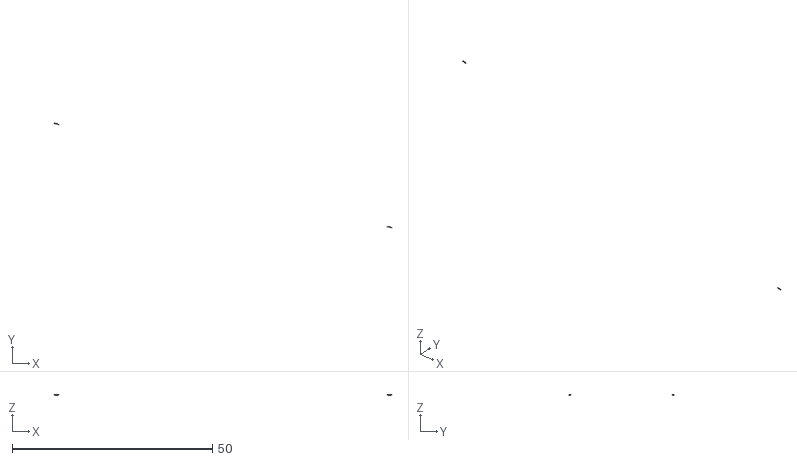
[picture p250: CAD file, 2026-08-11]
hardware/stl/flipfoot.stl
84.2 x 26.1 x 0.0516
