n416/katanori/hardware/stl/stand_seat_v18b.stl

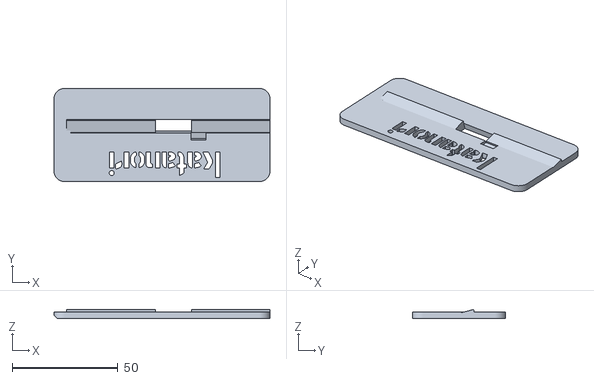
[picture p251: CAD file, 2026-08-11]
hardware/stl/stand_seat_v18b.stl
102.0 x 44.0 x 4.28
