n416/katanori/hardware/stl/as5600_fittest.stl

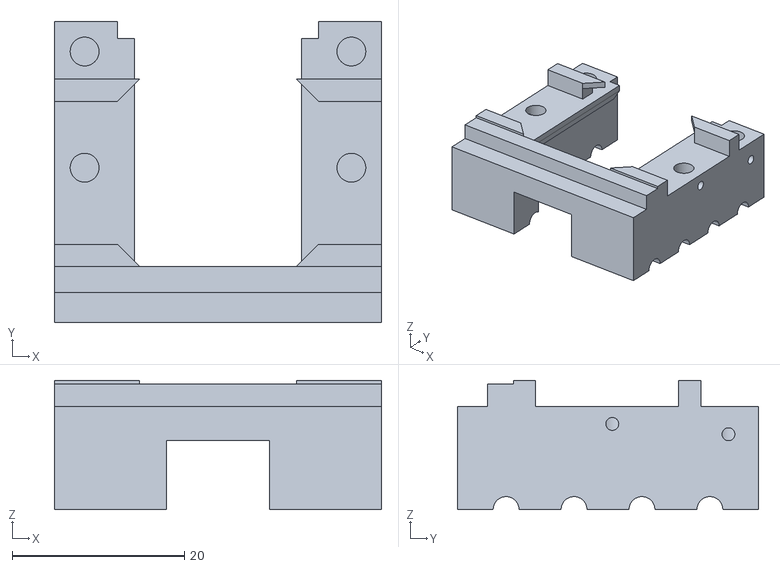
[picture p252: CAD file, 2026-08-11]
hardware/stl/as5600_fittest.stl
38.0 x 35.0 x 15.0
