n416/katanori/hardware/stl/stand_seat_v18.stl

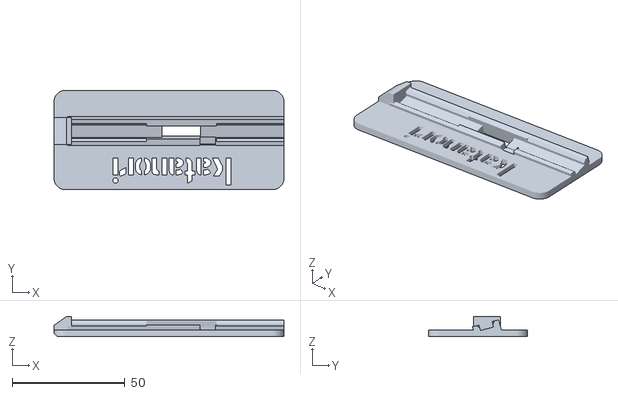
[picture p253: CAD file, 2026-08-11]
hardware/stl/stand_seat_v18.stl
102.0 x 44.0 x 9.00
