n416/katanori/hardware/stl/board_gauge_v2.stl

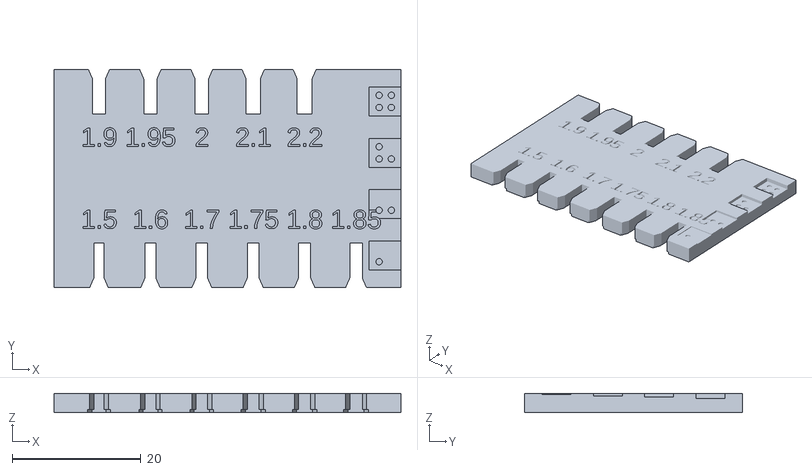
[picture p254: CAD file, 2026-08-11]
hardware/stl/board_gauge_v2.stl
54.0 x 34.0 x 3.00
