n416/katanori/hardware/stl/as5600_bridge_v2.stl

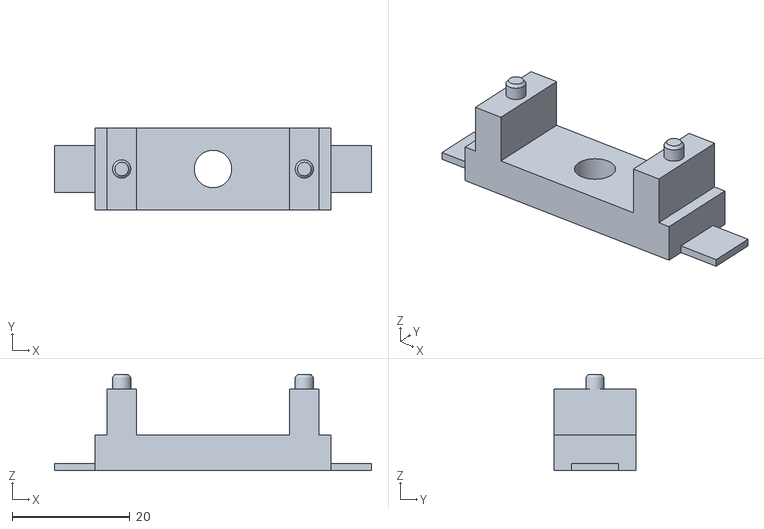
[picture p255: CAD file, 2026-08-11]
hardware/stl/as5600_bridge_v2.stl
53.8 x 14.0 x 16.3
