n416/katanori/hardware/stl/katanori_logo_cutter.stl

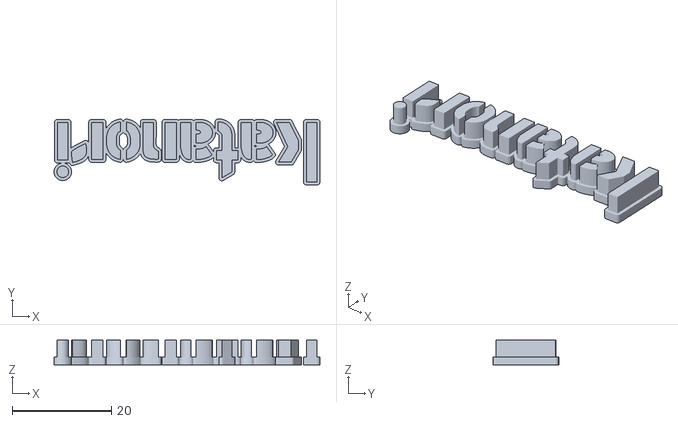
[picture p256: CAD file, 2026-08-04]
hardware/stl/katanori_logo_cutter.stl
53.6 x 13.3 x 5.00
