n416/katanori/hardware/stl/bridge.stl

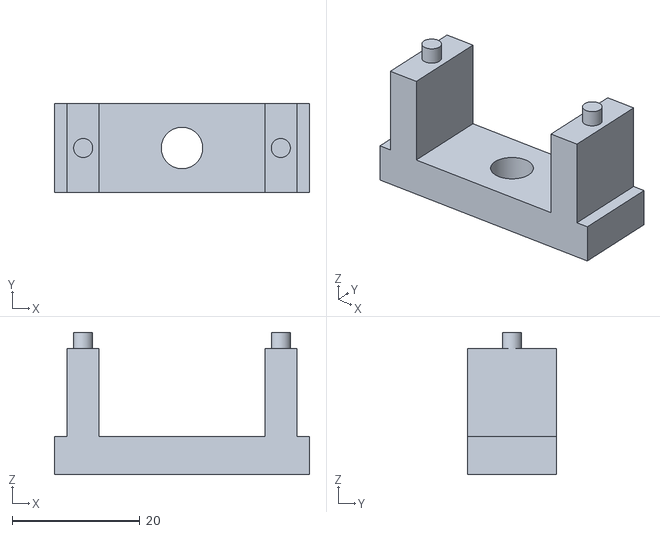
[picture p257: CAD file, 2026-08-02]
hardware/stl/bridge.stl
40.0 x 14.0 x 22.3
