n416/katanori/hardware/stl/base.stl

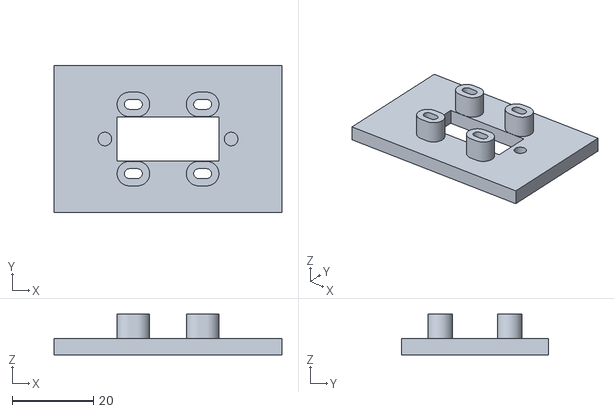
[picture p258: CAD file, 2026-08-02]
hardware/stl/base.stl
56.0 x 36.0 x 10.0
