n416/katanori/hardware/stl/knob.stl

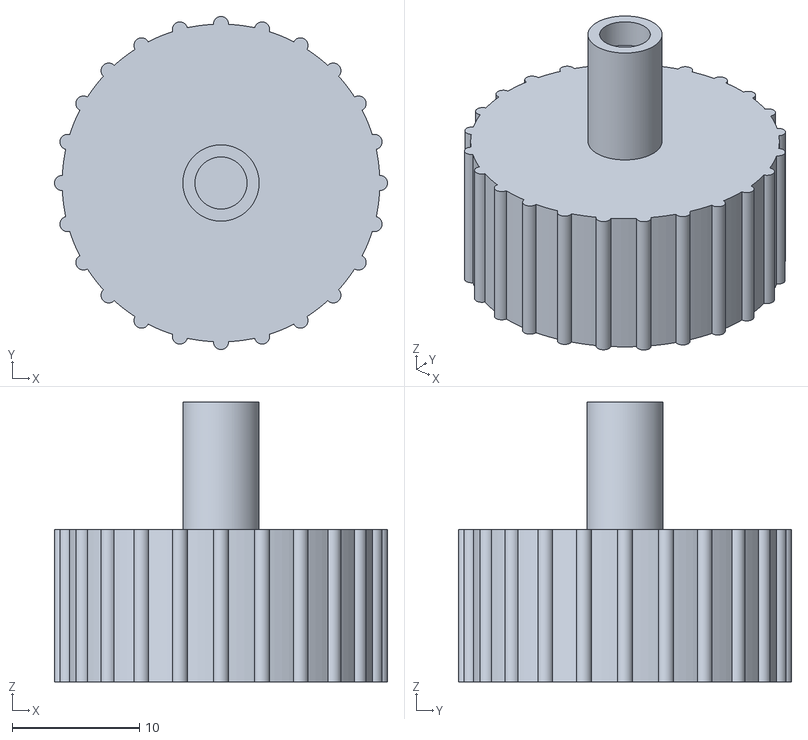
[picture p259: CAD file, 2026-08-02]
hardware/stl/knob.stl
26.2 x 26.2 x 22.0
