n416/katanori/hardware/stl/print-run-2.stl

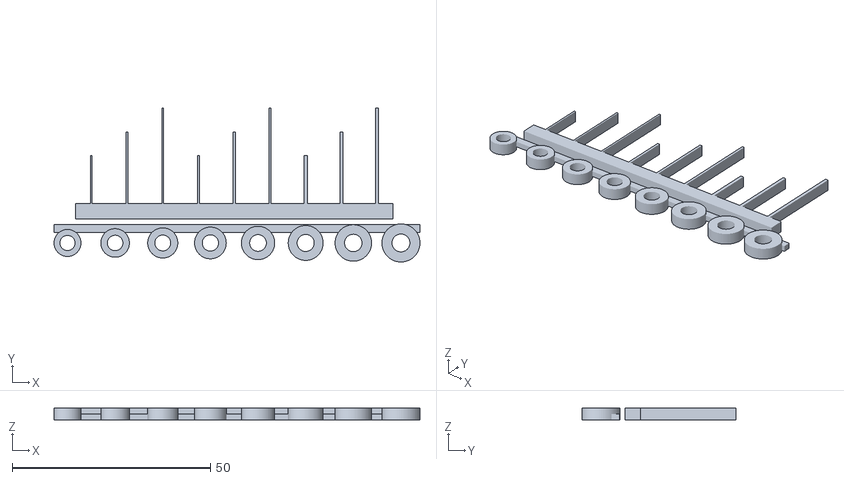
[picture p260: CAD file, 2026-08-01]
hardware/stl/print-run-2.stl
92.2 x 38.8 x 3.00
