n416/katanori/hardware/stl/magnet-fit-gauge.stl

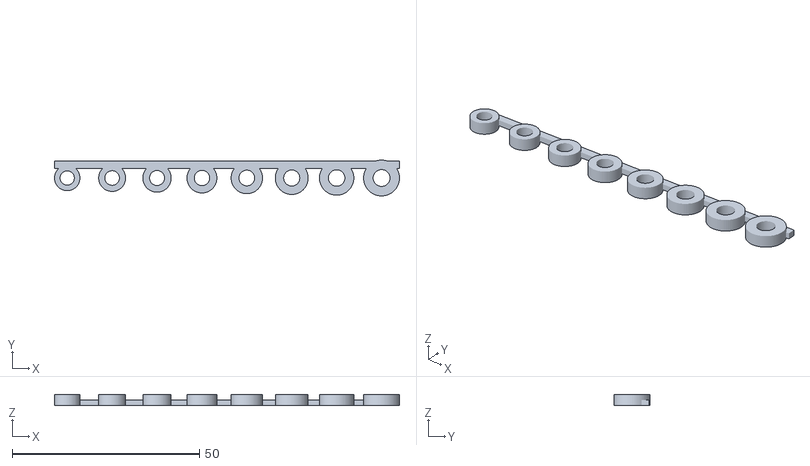
[picture p261: CAD file, 2026-08-01]
hardware/stl/magnet-fit-gauge.stl
92.2 x 9.60 x 3.00
