n416/katanori/hardware/stl/first-print-test.stl

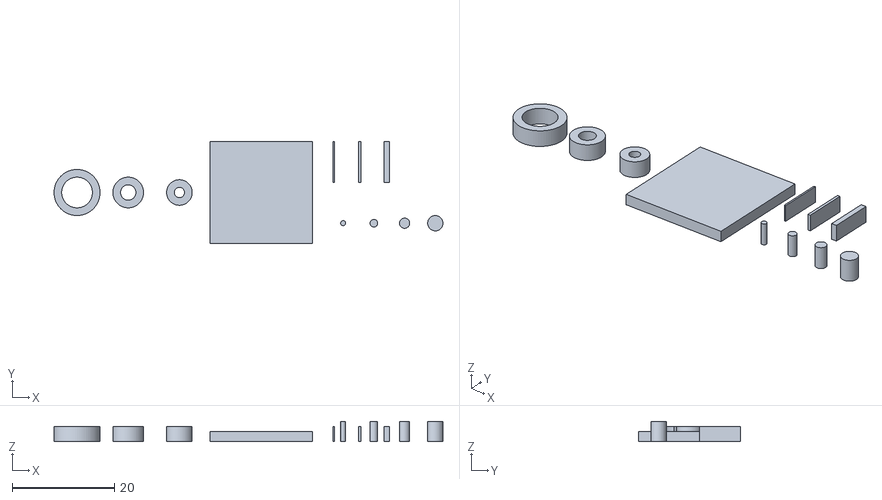
[picture p262: CAD file, 2026-08-01]
hardware/stl/first-print-test.stl
76.0 x 20.0 x 4.00
