n416/katanori/hardware/parts/hub_board_parts.scad

// 🔴 自動生成。手で編集しない。
//    生成元: relay_board.html の initialLayout()
//    作り直す: python hardware/gen_hub_board.py

HUB_L = 74.0; HUB_W = 52.0; HUB_T = 1.6;
HUB_PITCH = 2.54; HUB_MARGIN = [3.98, 3.14];
HUB_MOUNT = [68.0, 46.0]; HUB_MOUNT_D = 3.2;
// 🔒 板が筐体へ載る向き。true なら HTML 忠実な向きから 180度 回してある。
//    hub_board.scad の hub_dir() がこれを見て口の向きを合わせる。
HUB_ROT180 = true;

// [ id, name, kind, x0, y0, x1, y1, 高さ ]
HUB_PARTS = [
  ["R1", "1kΩ", "res", 54.22, 7.07, 60.42, 9.37, 2.5],   // ⚠ 1/4W を寝かせた胴の直径
  ["R2", "10kΩ", "res", 54.22, 9.61, 60.42, 11.91, 2.5],   // ⚠ 1/4W を寝かせた胴の直径
  ["D1", "1N4148", "diode", 58.16, 22.59, 61.56, 24.34, 2.0],   // ⚠ 1N4148 を寝かせた胴の直径
  ["C1", "0.1µF", "cap", 38.14, 14.86, 40.94, 19.36, 5.0],   // ⚠ 0.1µF セラミックを立てた高さ
  ["Q1", "2SC1815-GR", "tr", 55.02, 16.43, 59.62, 20.33, 5.2],   // ⚠ TO-92 の胴の高さ
  ["C2", "0.1µF (EN)", "cap", 38.14, 35.18, 40.94, 39.68, 5.0],   // ⚠ 0.1µF セラミックを立てた高さ
  ["RELAY", "リレー Y14H-1C-5DS", "relay", 53.52, 27.32, 61.12, 39.92, 10.0],   // 📄 Y14H-1C-5DS データシート（docs/DIMENSIONS.md 3章）
  ["BUTTON", "会話ボタン", "button", 11.64, 37.78, 16.64, 49.78, 11.0],   // ✅ DAOKAI 本体6mm ＋ レバー5mm。**レバー込みの実高**（docs/DIMENSIONS.md 3章）
  ["PHIN", "IN（ReSpeakerから）", "ph", 67.77, 26.86, 72.27, 32.76, 6.0],   // ⬜ PH2.0 トップ型の高さ未確定（サイド型なら約4）
  ["PHOUT", "OUT（スピーカーへ）", "ph", 67.77, 37.02, 72.27, 42.92, 6.0],   // ⬜ PH2.0 トップ型の高さ未確定（サイド型なら約4）
  ["XIAO", "XIAO からの7本", "header", 20.76, 2.14, 38.00, 4.14, 8.5],   // 📄 2.54mm ピンヘッダの標準的な全高（樹脂2.5＋ピン6）
  ["OLED", "OLED 2.42” へ4本", "header", 23.30, 12.30, 32.92, 14.30, 8.5],   // 📄 2.54mm ピンヘッダの標準的な全高（樹脂2.5＋ピン6）
  ["AS5600", "AS5600 へ4本（GNDは二股ケーブルでDIRへ）", "header", 8.06, 17.38, 10.06, 27.00, 8.5],   // 📄 2.54mm ピンヘッダの標準的な全高（樹脂2.5＋ピン6）
  ["PWR", "PowerBoost へ4本（3本目は空き）", "header", 56.32, 47.86, 65.94, 49.86, 8.5],   // 📄 2.54mm ピンヘッダの標準的な全高（樹脂2.5＋ピン6）
  ["REED", "リードスイッチへ2本", "header", 48.70, 47.86, 53.24, 49.86, 8.5],   // 📄 2.54mm ピンヘッダの標準的な全高（樹脂2.5＋ピン6）
  ["INA", "INA226 へ4本 ⬜並び要確認", "header", 23.30, 47.86, 32.92, 49.86, 8.5],   // 📄 2.54mm ピンヘッダの標準的な全高（樹脂2.5＋ピン6）
  ["TOGGLE", "マスタートグルへ2本", "header", 41.08, 47.86, 45.62, 49.86, 8.5],   // 📄 2.54mm ピンヘッダの標準的な全高（樹脂2.5＋ピン6）
  ["BTN2", "筐体の会話ボタンへ2本", "header", 5.52, 40.24, 7.52, 44.78, 8.5],   // 📄 2.54mm ピンヘッダの標準的な全高（樹脂2.5＋ピン6）
];

// [ id, label, 出る向き, 本数, x0, y0, x1, y1 ]
HUB_HEADERS = [
  ["PHIN", "IN（ReSpeakerから）", "left", 2, 70.02, 28.54, 70.02, 31.08],
  ["PHOUT", "OUT（スピーカーへ）", "left", 2, 70.02, 38.70, 70.02, 41.24],
  ["XIAO", "XIAO からの7本", "up", 7, 21.76, 3.14, 37.00, 3.14],
  ["AS5600", "AS5600 へ4本（GNDは二股ケーブルでDIRへ） 🔒 2026-08-24 実配線: 旧 OLED 計画のヘッダをユーザーが AS5600 に充てた（鏡事故の補正。つまみの線が OLED から見て右に出る＝このロボットの核心）", "down", 4, 24.30, 13.30, 31.92, 13.30],
  ["OLED", "OLED 2.42” へ4本 🔒 2026-08-24 実配線: 旧 AS5600 計画のヘッダ（上の入れ替えの相方）", "right", 4, 9.06, 18.38, 9.06, 26.00],
  ["PWR", "PowerBoost へ4本（3本目は空き）", "down", 4, 57.32, 48.86, 64.94, 48.86],
  ["REED", "リードスイッチへ2本", "down", 2, 49.70, 48.86, 52.24, 48.86],
  ["INA", "INA226 へ4本 ⬜並び要確認", "down", 4, 24.30, 48.86, 31.92, 48.86],
  ["TOGGLE", "マスタートグルへ2本", "down", 2, 42.08, 48.86, 44.62, 48.86],
  ["BTN2", "筐体の会話ボタンへ2本", "right", 2, 6.52, 41.24, 6.52, 43.78],
];
