n416/katanori/hardware/_spot_props.scad

// 🔴 自動生成。手で直さない。作り直しは `python hardware/_spot_props.py`
//    検算が出した 1 か所にだけ足す支柱。支柱の形（one_prop_free / _strut / _branch）は
//    _v4_post_props.scad が持っているので、使う側でそちらも include すること。
