n416/katanori/hardware/case_v6_1.scad

// ============================================================
// 筐体 v6.1（2026-09-14 着手）= v5 のコピー。ハブ基板を PCB 1 枚に置き換えた所から始める
//   方針（ユーザー 2026-09-05）: 配置は v4 のまま・Y と Z を広げて当たりを減らす。最初は大きく、縮めるのは CAD の中だけ。
//   前の版のファイルは読まない。読むのは parts/ の模型と hub_board_parts.scad（口の表）と、docs/CASE-V4.md §2 に言葉で書かれた配置だけ。
//
//   実行: "C:/Program Files/OpenSCAD (Nightly)/openscad.exe" --backend=manifold -o x.png -D "part=\"look\"" hardware/case_v5.scad
//
// ---- スイッチは part 一本。語はここで決めて、意味を変えない ----
//   look     … 中身（基板・電池・口・線の出だし）。皮は描かない
//   look_rearscrew … 後ろの PCB ねじの周り（場面 ⑧ の角を切り出し・床の裏からのねじと羽のナット・上の柱のねじ）
//   look_btnnut … 会話ボタンのナットの口（蓋を伏せてバスタブを付ける前・口は内側・ナットと道を赤で）
//   look_knobpad … つまみの台座（天板の裏・右後ろの上の柱と逃げ・リードの入口の段・六角穴）
//   look_pwrbtn … 電源の押しボタン（後ろの壁の押し子の口・USB-C の口・PCB の縁の胴）
//   look_pwrcap … 押しボタンとキャップの断面の模型（分解・切・入・押し切りの 4 つ）
//   look_riserhang … XIAO のライザーの下へ垂らした板と、ハブのピンヘッダーの樹脂が接する所（断面）
//   look_kguide … つまみの軸のガイド（平らな板・短い足 3 本・U4 を受ける口）の断面
//   plugs    … 口だけ。v6.1 は空（DuPont は無く、XIAO も OLED もライザーのメスが受ける）
//   open_flap … 蓋の左の板だけ外す（底パーツの左の帯・レールは残る）
//   open_left … 全部組んだ状態で左の壁だけ取り払う（中を左から見る）
//   explode  … 箱全体の分解（レジン: 皮 6 枚を外へ、天板は小組ごと上へ、PCB は柱の上へ／ナイロン: 底パーツは置いたまま、蓋（天板＋左の板）は上へ、PCB と電池は左の窓から外へ、ReSpeaker と OLED はライザーごと上へ）
//   skin     … 皮（板 6 枚・格子込み）
//   all      … 皮＋中身
//   p_floor / p_top / p_lwall / p_rwall / p_front / p_hatch … 板 1 枚だけ（柱・棚・耳・ダボ・穴込み）
//   fasten   … 締結の絵: 左右の壁（柱・棚）を不透明、床と天板とフロントを半透明
//   hit_<名>  … その 1 単位 ↔ 他の全部 の当たり（体積を STL で取る。0 が正）。名は UNITS の語（oled rsp hub riser oriser bat knob btn spk spktub）
//   pair_<a>_<b> … 2 単位の重なり（例 pair_knob_btn）
//   only_<名> … 1 つだけ（外形を数字で取る用）。名は UNITS の語
//   wires    … 中身＋線（束は丸・口の近くは 1 本ずつ扇）。wiresonly は線だけ
//   hit_wires … 線 ↔ 中身と皮と格子の全部の当たり。hit_w_<束> は束 1 つだけ（spkout spkin btn2v61 reed batv61）。only_w_<束> は束 1 つの絵
//   print_<板>  … 刷る向き（floor top lwall rwall front hatch は外面を下）＋ 支柱とラフト（parts/props_v61_gen.scad・python hardware/tools/props_gen61.py）。つまみは parts/knob_v5.scad、会話ボタンは parts/btn_v3.scad で焼く
//   sk_<名>    … その 1 単位 ↔ 皮 6 枚 の当たり（0 が正。ReSpeaker の押し 0.3 は意図した当たり）
//   seam_<板>_<板> … 板 2 枚の重なり（例 seam_top_front。0 が正）
//   （皮・板・検査の語は皮を起こすときにここへ足す。既にある語の意味は変えない）
// ============================================================
part = "explode";
MAT = "nylon";   // ["resin", "nylon"]   刷り方。"resin" = 自分の光造形（板 6 枚）／"nylon" = 外注 MJF（底パーツ＋蓋の 2 部品。蓋 = 天板＋左の板・2026-09-16）。GUI ではこの行を書き換える（Customizer でも選べる）。CLI は -D MAT="nylon"
$mat = MAT;      // 🔴 部品ファイル（use）へ材料を配る。$ 付きは呼び出しの連鎖を伝わる（parts/mat.scad の説明）。PROPS_OFF などより前に置くこと
// ---- 刷り方（🔒 ユーザー 2026-09-14「ナイロンで印刷する場合のモードが欲しいね」）----
//   "resin" … 自分の機械（光造形）。いまの既定。板厚も格子も支柱も、この機械の癖を避けるための形
//   "nylon" … 外注 MJF PA12（docs/PRINT.md の §「レジンと MJF の値段の差」）
//   ここで切り替わるのは**刷り方だけで決まる物**（支柱・ラフト・格子）。板厚と嵌め合いはまだ resin の値のまま。
//   ⚠ ナイロンで書き出すときは FIT_PRINT を渡さないこと（初層の太りの打ち消しは光造形の話。粉の中で焼く MJF には無い）
include <parts/mat.scad>   // nylon() / mat_name()。スイッチは上の MAT（2026-09-16 までは mat.scad の 1 行だった）
PROPS_OFF = nylon();   // 粉が支えるので支柱もラフトも要らない   // true: 刷る向きの素の形（支柱・ラフト無し）。tools/props_gen.py がこれで焼いて支柱の位置を決める

include <parts/fit.scad>   // 嵌め合いの数式（穴 = ダボ + 向きで決まる差。🔒 2026-09-10 ゲージ）
// ナイロンの嵌め合い（🔴 include の**後ろ**に置くこと。前だと fit.scad の既定に上書きされる）
FIT_SLIP = nylon() ? 0.8 : 0.1;   // 印刷どうしの狙いの隙間。JLC3DP の「組む隙間 0.76 以上」より
FIT_BURN = nylon() ? 0 : 0.4;
LID_SHIFT = 0;     // 🔒 ユーザー 2026-09-16: 蓋は真上から降ろす（横へずらす動きは捨てた）。左の板は L 字のたわみで XIAO の殻をかわす（FLAP_FLEX）。2.0 だった名残の読み手（OLED の足）のために 0 で残す
FLAP_FLEX = 1.5;   // 蓋を降ろすあいだ左の板が外へたわむ量（XIAO の殻の出 1.22 ＋ 0.28。PA12・厚み 1.6・幅 42・折り目から口まで 26 で約 8N・ひずみ 0.6%）。掃引 path_lid はこの姿勢で当てる
LID_REST = 0.3;    // 壁に載せただけの蓋の浮き（ReSpeaker の押さえ 0.3 のぶん。ねじで締めて 0 になる）     // 初層の太りの打ち消し。粉の中で焼く MJF には初層が無い
use <parts/parts.scad>
use <parts/respeaker_lite.scad>
use <parts/hub_board.scad>
use <parts/typec_115426.scad>
use <parts/plug.scad>
use <parts/wires.scad>    // 線（丸束・曲げ半径で丸めた点列）
use <parts/btn_v61.scad>    // 会話ボタン v3（🔒 2026-08-30）。原点 = ボタンの芯・z0 = 天板の外面
use <parts/knob_v61.scad>   // つまみ v5。原点 = 軸・z0 = 天板の外面
use <parts/spk_v61.scad>   // スピーカー v6.1（parts/spk_v5.scad の写し。いまは中身も同じ・v6.1 の直しはこちらへ）。原点 = スピーカーの中心・z0 = 天板の外面
// 🔴 半分だけ切り替わっていないか（部品は $mat で見る。-D '$mat=…' だけ渡して MAT を変えないと食い違う）
assert(MAT == knob_mat() && MAT == btn_mat() && MAT == spk_mat(),
       "材料のスイッチが食い違っている。先頭の MAT（または -D MAT=\"nylon\"）で切り替えること（-D $mat= を case に渡さない）");
include <parts/hub_board_parts.scad>   // HUB_HEADERS（口の表・自動生成）。数字はここから読む
include <icons/icon_wrench_u.scad>   // スパナ（🔒 ユーザーの絵 uuu.svg から）
include <icons/icon_headphone.scad>  // ヘッドホン（ユーザーの EPS から）
PLUG_EMBEDDED = true; HUB_EMBEDDED = true;
$fn = 48;   // 🔒 v4 と同じ分割数（無いと小さい円が 5〜6 角形で出る・2026-08-23 ユーザー指摘）

// ---- 箱の中の座標（v4 と同じ）----
//   X: 左の壁の内面が LW_X 1.694・右の壁の内面が IN_X 86.05（ReSpeaker の板の左端 2.0 から測った v4 の座標）・Y 0 = フロント板の内面・Z 0 = 床の上面
//   +X 右（XIAO の USB-C 側）・+Y 後ろ（ハッチ側）・+Z 上（天面）
// ---- 広げる量（Y は AI の初期値・当たり表の最大 3.7 の 2 倍。Z はユーザー決定）----
GROW_Y = 3.25;   // 🔒 ユーザー 2026-09-05「意味不明な拡大はおかしいでしょ」: 8 → 0 → I2C の L 字がハッチの床の板にかかり「3mm 伸ばそう」→「Y を 0.25 増やして」: 3.25（電流計の I2C ↔ 床の板の空き 0.19 → 0.44）
GROW_Z = 2.0;    // 🔒 ユーザー 2026-09-05: 初期値 8 → 電流計を 215° に回して口をバスタブの外へ出し、会話ボタンを X 19 にして「+2 で」（内寸 50.45・外寸 55）。一時 12.5・8.5 にした案は取り下げ

// ---- 配置（docs/CASE-V4.md §2 の言葉と数字。v4 と同じ席）----
OLED_AT = [8.0, 8.5, 0];            // 背面の板の角。X 8.0・背面が Y 8.5・床に直置き（§2「OLED を前に立てる」）
RSP_X   = 2.0;                      // 左端（ジャックの筒が左の壁の口へ）
RSP_Y1  = 10.035;                   // 板の背面（XIAO 面）の Y
RSP_Z   = 7.0 + 1.2;                // 🔒 ユーザー 2026-09-16 夕「ReSpeaker を Z 方向で上に上げてケーシングの天板の上に乗せてください」: 7.5 → 8.2（天板の天面 BCS_H 7.0 ＋ BCS_DT 1.2）。🔴 BCS_TOP を直接書くとこの行より下で代入されるので undef。   // 旧: 🔒 ユーザー 2026-09-14「ReSpeaker の Z 位置を 5mm 上に」: 7.5。一度 10.1（+2.6）まで上げたが、ライザーを L 字で受ける形にして下端が 12.1 まで下りたので**戻した**
HUB_Y0  = 11.9;                     // v4 HUB_Y0（10.035 ＋ 前の逃げ）。電池の Y はここから測る
HUB_DY  = 4.0;                      // v4 HUB_DY（板だけ後ろへ 4。口も一緒に動く）
LW_X    = 1.694;                    // 左の壁の内面（v4: ReSpeaker の板の左端 2.024 − 0.33）
PCB_Y0  = 13.5;                     // 🔒 ユーザー 2026-09-14「PCB の奥行きを小さくして ReSpeaker とぶつからないように」: 前縁 10.235 → 13.5
PCB_Y1  = PCB_Y0 + 37.4;            // PCB の後縁 50.9（板の奥行き 37.4）。動かさない: ハッチの内面がここ（電源の押しボタンの胴の前の面もこの縁に揃う）
PCB_W   = PCB_Y1 - PCB_Y0;          // Y の長さ
PCB_L   = respeaker_L();            // 🔒 ユーザー 2026-09-14「幅を（ReSpeaker に）合わせて」: 82.024（ReSpeaker の板の長さ）。それまでハブと同じ 74
BAT_CASE = 6.0;   // 🔒 ユーザー 2026-09-16 夕「次は高さを合わせろ」: レジンも 2.0 → 6.0。**板の裏は両方とも Z 12.0**。
//   ナイロンはこれより下げられない: 電池 6.0 ＋ 逃げ 1.0 ＝ ケーシングの天井 7.0、天板 1.2 で 8.2、その上の柱にナット 1.8 ＋ 肉 1.0 ＋ 下 1.0 で 12.0。
//   旧: nylon() ? 6.0 : 2.0（レジンは板の裏 8.0）。穴の位置を合わせたのと同じ理由で、板 1 枚を両方で使うなら Z も 1 つにする
HUB_AT  = [RSP_X, PCB_Y0, lipo_size()[2] + BAT_CASE];   // 🔒 ユーザー 2026-09-14「リポ電池を PCB 基板の下へ」: PCB の裏 8.0（電池 6 ＋ 隙間 2）   // 2026-09-14: X を ReSpeaker の板に揃える（2.0〜84.024）・Y の前縁は PCB_Y0   // §2「X 6.0〜80.0・前縁 Y 15.9」。Z 2.5 = v4 BOARD_Z
// 🔴 この 3 行は HUB_AT より後に置く（前に置くと HUB_AT が undef になり、USB-C が原点に落ちる・2026-09-14）
USBC_X = HUB_AT[0] + PCB_L / 2;     // ⭐ 2026-09-17: 口は板の X 中央（世界 43.012）。後ろの縁へ移したので位置を決めるのは X
USBC_Y = 39.5;                      // ⛔ 右の壁に居たときの Y。いまは口の位置に使わない
USBC_SZ = [7.30, 8.94, 3.26];       // 🔒 基板担当 2026-09-14: HRO TYPE-C-31-M-12（16P・LCSC C165948）の胴 [奥行, 幅, 高さ]
// 🔴 板の縁から出す長さ（usbc_out() = 1.3）を **1.5 を超えて** 動かすと、後ろのシェルの足 2 本が
//    板の縁からはみ出す。足形 Connector_USB:USB_C_Receptacle_HRO_TYPE-C-31-M-12 の後ろの SH パッドは
//    奥の端が板の Y 36.900（縁 37.400 まで 0.500）で、縁まで 0.3 空ける規則を守ると余りは 0.2。
//    変えるときは基板担当へ先に知らせること（v6 は 3.0 出して足を 2 本省いた版を作っていた）
// ⭐ 2026-09-17: USB-C を 右の壁 → **後ろの縁（ハッチ）** へ移した（基板側 d4d30b3）。
//   前の縁は壁ではなく ReSpeaker の板が立っていて、板の縁から背面まで 3.465・胴を出すと残り 1.935 でプラグが入らない。
//   口の面はハッチの外面の 0.8 裏で止める（右の壁・XIAO と同じ関係）。材料で HATCH_T が変わると追従する。
// ⭐ 2026-09-17 夕: **材料で変えない。**板は 1 枚・足形は 1 つなので、胴の出は 1 つしか持てない。
//   ナイロンのハッチ（1.6）で奥まり 0.8 になる値に固定し、レジン（2.8）は下の counterbore で
//   1.2 掘って同じ 0.8 に揃える。基板側 v61_board.py の usbc_out() と同じ式・同じ 1.3。
//   ⚠ 前は (IN_Y + HATCH_T - 0.8) - PCB_Y1 で、レジンだけ 2.5 を返していた。板の J13 は
//     どちらの材料でも 1.3 なので、模型の口だけが 1.2 外へ出ていた（2026-09-17 夕に発見）。
HATCH_T_NYLON = 1.6;   // ナイロンのハッチの厚み。下の HATCH_T の nylon 側はここから取る
USBC_RECESS   = 0.8;   // 口の面をハッチの外面の何ミリ裏で止めるか（右の壁・XIAO と同じ関係）
function usbc_out() = PCB_HATCH_GAP + HATCH_T_NYLON - USBC_RECESS;   // = 1.3（材料によらない）
// ⭐ 2026-09-17: **差し込む間だけ板を前（−Y）へ逃がす量**。USB-C の胴が板の後ろの縁から usbc_out() 出ていて、
//   口はハッチ（内面 Y 51.4）にある。まっすぐ横へ差すと、その出っぱりが差している間じゅう後ろの壁の中を通る。
//   前へ逃がしておいて、下ろしてから後ろへ押して口へ挿す（PATH_HUB の ④）。
//   🔴 板の裏へ出ている物の窓は、この 1.8 ぶん **−Y 側にも開けておくこと**（J10 の窓 bat_case_j10_win）。
//     開けないと、押し込む 1.8 のあいだ J10 が電池ケースの天板を削る（掃引で 6.16mm³ 出た）
//   🔴 **関数にすること。**`PCB_HATCH_GAP` はこの行より下で代入されるので、変数だと undef になる
//     （2026-09-17 に変数で書いて、天板の窓が undef になり STL が出ずに古いファイルを読んだ。rp_x() と同じ罠）
function pcb_fwd() = max(usbc_out(), pwr_cap_face() - PCB_Y1) + 0.5;   // 2.7（板の後ろの縁から出る物の大きい方 ＋ 逃げ 0.5）。⭐ 2026-09-19: 電源の押しボタンの押し子が USB-C（1.3）より出る（2.2）。キャップは組んだあと外から差すので数えない
PWR_KEY_OUT = 5.0;   // 電源の押しボタン（XKB5858-Z-E）の押し子が胴の前の面から出る量（📄 データシート 5.00）。⭐ 2026-09-19 に -75（2.5）から替えた
// ハブの口の頭: 板の下面 2.0 + 板 1.6 + 樹脂 2.5 + ハウジング 14 + 曲がり 3.0 = 23.1
HUB_PLUG_TOP = HUB_AT[2] + 1.6 + 2.5 + plug_top();
BRG_T   = 2.0;
BRG_DZ  = 0.5;                      // 🔒 ユーザー 2026-09-05「ブリッジの高さを 2mm 上げて」→「1mm 下げて」→「0.5mm 下げて」: +2 → +1 → +0.5
BRG_ZB  = HUB_PLUG_TOP + 0.775 + 0.5 + BRG_DZ;   // ブリッジの裏 25.375（口の曲がりの頭 23.6 ＋ 線の半径 0.775 ＋ 0.5 ＋ 0.5）。電池・帯・電流計はこれに付いて上がる
BAT_X0  = 14.5 - 3.0 + 3.0 - 0.6;   // v4 BAT_X0 = 14.5 + BAT_DX(−3)。🔒 ユーザー 2026-09-05「電池を 3mm 右に」: +3 →「電池（帯ごと）を左へ 0.6」: −0.6（皿・土手・帯・前板・電池の口も一緒。帯の右の足が AS5600 の板の左端と 0.3 重なったぶん）
BAT_YS  = 1.0;                      // v4 BAT_YS: 電池を前板の返し（1.0）の後ろへ
TRAY_Y0 = HUB_Y0 + (52.0 - lipo_size()[0]) / 2;   // 皿の前縁 12.9（v4 の BAT_Y0）。前板・帯の区間・電流計の枠はここから測る
BAT_Y0  = TRAY_Y0 + BAT_YS;                        // 電池の前縁 13.9（🔴 2026-09-05 まで BAT_YS を落としていて電池が返しに 138mm³ 食い込んでいた）
BAT_AT  = [BAT_X0, BAT_Y0, 0];   // 🔒 2026-09-14: 電池は床の上（PCB の下）   // Z は皿の上（v4 BAT_Z 23.4 を口の頭 23.1 + 0.5 + 皿 2.0 に置き換え）
BAT_TOP = BAT_AT[2] + lipo_size()[2];
STRAP_T = 2.0;                      // 留め帯の天板の厚み（v4 STRAP_T）
PAIR_Y0 = TRAY_Y0 + (lipo_size()[0] - (pb_size()[1] + 0.5 + ina_size()[1])) / 2;   // v4 PAIR_Y0（電流計と PowerBoost を電池の Y の中央に並べる）
STRAP_C_POCKET = 0.0;               // 2026-09-05 一度 1.0 にしたが、ユーザー「ピンヘッダ部分は 1.2mm 掘って」で板を帯に直置きにしたので 0 に戻す
HDR_POCKET_D = 1.2 + 0.3;           // 電源ヘッダの足の裏出し 1.2 の逃げ（帯 C の天板に掘る・床 0.5 残る）
INA_DX  = -4.7; INA_DY = 3.0; INA_LIFT = 0.0; INA_THETA = 0;   // 2026-09-06 一度 4.5 にしたが取り消し（ヘッダは表・裏は足の先だけ）。   // INA_LIFT: v4 は 1.0。🔒 ユーザー 2026-09-05「浮いてるでしょ」: 足の逃げは帯に掘って板は帯に直置き（0）   // v4 の値（🔒 2026-08-29 INA_DY 3.0・2026-08-26 0°）
BOARD_LIFT = 0.5;                   // v4: PowerBoost の蝶番を帯の面から 0.5 浮かせる（🔒 2026-08-25）
INA_SX  = -4.0 + 5.0 + 0.6 - 2.0 + 1.0 + 4.0 + 5.0 - 2.0;   // 🔒 ユーザー 2026-09-08「電流計を 2 ミリ左へ」（帯の印刷が増えるのは承知の上）。それまで: // →「右に 4mm」: +4 →「右に 5mm」: +5。 🔒 ユーザー 2026-09-05 …→ −4 →「右に 5mm」: +1 →「2mm 左に」: −1 →「1mm 右に」: 0。電池を −0.6 したとき枠が動いたぶんを +0.6 補正（電流計の場所は変えない）
INA_SY  = 1.2 - 3.0;                // 🔒 ユーザー 2026-09-05 …→ +1.2 →「手前に 3mm」: −1.8
INA_RZ  = 180;                      // 🔒 ユーザー 2026-09-05「電流計の Y 軸回転をやめて水平に」（ユーザーの「Y 軸回転」＝上下の軸まわり＝ここでは Z）: 45 右・90 左・10 右で 215 にしていたのを、回す前の 180（板を箱の軸に平行・I2C の口が後ろ・電源の口が前）に戻す
PB_DY   = -4.0;                     // 🔒 ユーザー 2026-09-05「PowerBoost と電流計を 4mm 前へ」（電流計もこの値を読む）
PB_DY2  = -2.0 + 1.0 + 2.0;               // 🔒 ユーザー 2026-09-09「PowerBoost を少し奥に押せばいい」: +2（前の JST の面 27.08 → 29.08。スピーカーのバスタブの後ろの腕 25.10 との間が 1.98 → 3.98）。🔒 ユーザー 2026-09-08「PowerBoost を 1 ミリ奥へ」: −2 → −1。それまで: 2026-09-05「手前に 4mm」→「2mm くらい奥に」（天井に付けた後・PowerBoost だけ）: −4 → −2
// （PowerBoost の枠は下の at_pb()。v4 pb_frame() と同じ式）
PB_TILT = 0;                        // 🔒 ユーザー 2026-09-05「PowerBoost の傾きを無くして」。v4 の 14°（2026-08-29）は電流計を前縁の下へ潜らせるための物で、重ねるなら要らない
// ナイロンは +0.25（右の壁を 1.45 外へ）。右の壁は底パーツの一部で上から降りて来ないので、ReSpeaker を真上から降ろすとき
//   右端の出っ張り（ジャックの筒 1.58・USB1 の殻 0.86・ジャックのカバー 0.68）が壁の内面（板の縁から 1.78）に触れないための値。筒との空き 0.20（⚠ MJF の ±0.3 より小さい。触れば筒が口へ滑り落ちるだけで、壁の上に乗ることは無い）
//   上限は充電の USB-C の板の縁からの出（usbc_out）2.6（下の 🔴）で、+0.25 で 2.58。🔴 2026-09-16 まで −0.4 で、ジャックの筒が壁に 0.45 入っていた（掃引 path_rsp で 30mm³）
//   🔴 2026-09-16 まで「右へ 1.22 寄せて降ろしてから左へ入れる道」と書いていたが、USB1 の殻が右の壁に 0.95 食い込むので道になっていなかった
//   （ユーザー「出っ張った USB をどうやって入れる気？」）。XIAO の USB-C（左の壁に 1.22 入る）は、左の壁の板を蓋（天板と一体）に移して横から被せる形で解いた（docs/CASE-V61N.md 8 章）
RIGHT_CL = nylon() ? 0.25 : -1.2;   // 🔒 v4 2026-08-25 ユーザー「壁の移動が足りないだけ」: XIAO の USB-C の殻（先 85.554）を壁に貫通させ、口の面を外面の 0.8 裏に置く
IN_X    = RSP_X + respeaker_L() + xiao_usb_out() + RIGHT_CL;   // 右の壁の内面 84.354（🔴 2026-09-05 まで +0.5 の 86.054 で 1.7 外に置き「v4」と書いていた。ユーザー「XIAO の USB 口も全く違う」）
XIAO_FACE_X = RSP_X + respeaker_L() + xiao_usb_out();   // 85.554 レセプタクルの面
// ⭐ 2026-09-17: 🔒 ユーザー「2.5 で。その上でナイロン版は基板を 0.4 手前にずらして」。
//   USB-C の胴の出は 2.5（レジンに合わせた・板の銅は 1 つしか持てない）。ナイロンは
//   ハッチが 1.6 と薄いので、そのままだと口が外面から 0.4 出る。
//   ⚠ 板を動かしても差は変わらない。ハッチは板から測って作る（IN_Y = PCB_Y1 + この隙間）ので、
//     板を動かすとハッチも一緒に動く。効くのは **この隙間** だけ。
//   0.9 にすると ハッチの外面 = PCB_Y1 + 0.9 + 1.6 = PCB_Y1 + 2.5 ＝ 口の面。面一になる。
//   板の上の物（AS5600 とつまみの位置関係）は動かない。箱が Y に 0.4 深くなるだけ。
PCB_HATCH_GAP = 0.5;   // 板の後縁とハッチの内面の逃げ。⭐ 2026-09-17: 胴の出を 1.3 に戻したので材料で変える必要が無くなった
IN_Y    = PCB_Y1 + PCB_HATCH_GAP;   // ハッチの内面 51.4（PCB の後縁 50.9 の 0.5 後ろ）。v5 は HUB_Y0 + 52 + 10.1 + GROW_Y = 77.25      // v4 の式: HUB_Y0 11.9 ＋ 板 52 ＋ 後ろの逃げ 10.1（BACK_CL・2026-09-05）＝ 74.0。ハブの後縁 67.9 から 6.1（🔴 一時 HUB_AT[1]（+4）から数えて 86 にしていた）
IN_Z    = 48.454 + GROW_Z;          // v4 の内寸 48.454（§1）+ 広げ
Z_TOP   = IN_Z;                     // 天面の内面
TOP_T   = 2.5;                      // 天板の厚み。btn_v3（B3_PLATE_T）と knob_v5（DECK_T）が 2.5 で形を持っているので同じ値
ROW_Y   = 17.3;                     // スピーカーの列。2026-09-14: ReSpeaker を戻したので 22.6 → 17.3 に戻す
ROW_RX  = 64.7;                     // 右の列の X 中央（会話ボタン・つまみ・トグル）。🔒 ユーザー 2026-09-08 夜「つまみと、トグルスイッチは右ですよ」: 入れ替えで動くのはスピーカーと会話ボタンだけ。値はスピーカーの居た 63.2 + 1.5
SPK_AT  = [19.0, ROW_Y];   // 🔒 ユーザー 2026-09-14「スピーカーとボタンを揃える」: 会話ボタンと同じ列。一度 24 にしたのは ReSpeaker を上げてボタンが箱の左後ろの柱に当たったときの逃げで、L 字のライザーで上げをやめた時点で 19 に戻した   // 以下は v5 の経緯:             // 🔒 ユーザー 2026-09-08 夜「会話ボタンとスピーカーの位置入れ替えたらどうでしょうか。元々プロダクトとしてはそっちが正解」: 会話ボタンの居た X 19.0 へ（OLED の線 4 本の出口が無い・横の空きが無い、の 2 つを一度に解く）。それまで 63.2 + 1.5（🔒 ユーザー 2026-09-05「スピーカーも右に 1.5mm」（つまみの台座と一緒）。§2「SPK4 X 63.204」。2026-09-08 「右へ 3」を試したが、右のバスタブ 3 の壁とねじの頭が右の壁に 1.15 / 2.0 入るので戻した（右側の積み上げ 7.6 に対して余裕 8.15）
SPK_RZ  = 180;                      // 🔒 ユーザー 2026-09-09「Z 軸 180 度回転」: スピーカーの単位を本体ごと Z で 180°
OLED_X_C = OLED_AT[0] + oled_l() / 2;   // OLED の X の中心 43.05（板 X 8.0〜78.1）
KNOB_AT = [ROW_RX + 5.0 - 2.0 - 2.0, 33.3 + 1.6 - 1.1 + 8 - 4.5 - 15.0 + 5.0 + (PCB_Y0 - 13.5)];   // 🔒 ユーザー 2026-09-19「2mm 移動してください」: X 67.7 → 65.7（軸のガイドの 3 本足の右前が ReSpeaker の USB の下に入るのを避ける。基板は pcb/v61_board.py の SHAFT を同じだけ動かした）   // ⭐ 2026-09-17: **板に追従させる**。磁石は板の上の AS5600 を読むので、板が前へ寄ればつまみも同じだけ寄らないとずれる（ナイロンで 0.4）。   // 🔒 ユーザー 2026-09-14「つまみを手前に 15mm」→「5mm もどして」: Y 27.3。→「5mm 右へ」→「2mm 左へ」: X 64.7 → 69.7 → 67.7   // 🔒 ユーザー 2026-09-08 夜「つまみとトグルは右」: 右の列 64.7（スピーカーは左へ移ったので、もう SPK_AT には追従しない）。🔒 ユーザー 2026-09-05「つまみの X 中央をスピーカーの X 中央に合わせて」（Y に合わせたのは言い間違い・41.8 に戻す）。X: 63.2 ＋ 右へ 1.5 ＝ 64.7（スピーカーと同じ）。Y: v4 KNOB_YC 33.8 ＋ KNOB_DY 8（🔒 2026-08-29「ノブを後ろに」）＝ 41.8
BTN_GAP = 0.5;   // ⚠ スピーカー一式の後ろとボタンの隙間（私の仮）
BTN_AT  = [SPK_AT[0], SPK_AT[1] + 19.0];   // 🔒 ユーザー 2026-09-14「スピーカーの後ろへ」＋「X 24 で揃える」: スピーカーと同じ列・その 19.0 後ろ（X 24・Y 41.6）   // 🔒 ユーザー 2026-09-14「会話ボタンを OLED の X 軸中央に・Y を後ろに 15」: X 64.7 → 43.05・Y 17.3 → 32.3。それまで: // BTN_AT  = [ROW_RX, ROW_Y];          // 🔒 ユーザー 2026-09-08 夜「会話ボタンとスピーカーの位置入れ替え」: スピーカーの居た X 64.7 へ。それまで 19.0 + 1.0 - 2.0 + 2.0 - 1.0（🔒 ユーザー 2026-09-08「会話スイッチを 1mm 左へ」: 20 → 19。   // →「2mm 右へ」: 20。 🔒 ユーザー 2026-09-05「右へ 2」→「左へ 4」→「左に 3mm」→「1mm 右へ」→「2mm 左へ」: 24 → 26 → 22 → 19 → 20 → 18
TC_AT   = [1.694, IN_Y + 0.4 - 15.0, 0.75];      // §2「X 1.694〜3.294・Y 57.4〜72.4（IN_Y 72）・Z 0.5〜20.5」。Y はハッチに追従
// 🔴 2026-09-11 未解決: この位置だとコネクタの口がハッチの外面の 1.6 裏に落ちて充電のプラグが挿さらない（実機）。IN_Y + 1.2 にすれば XIAO と同じ 0.8 裏になる。Y を決めているのは床の「前の当て」（挿す力を受ける）なので床とハッチ（スリット）の 2 点が刷り直し。左の壁の押さえは動かさなくても成立する。⚠ の TC_CONN_OUT の上に固定の当てを置いたのが DIMENSIONS.md の格付けの規則違反で、当ては Y を選べる形にする（形はユーザー待ち・docs/TODO.md）
OLED_Z_C = OLED_AT[2] + oled_w() / 2;   // OLED の顔の縦の中央 24.05（板 Z 0〜48.1）
// ⭐ 2026-09-19 🔒 ユーザー「板の後ろの縁に押しボタンを載せる方法にしようか」: ハッチのトグル（MTS-102・座・M6 の穴）をやめ、
//   PCB の後ろの縁の押しボタン SW2（XKB5858-Z-E・押し子 5.0）へ。押し子に丸いキャップ（pwr_cap）を差し、後ろの壁（ハッチ）の丸穴から出す（pwr_port_cut）

// ナイロンは全面 1.6（🔒 ユーザー「ねじ止めが無い壁は、ある壁と統一出来る」。MJF は最小肉 1.0・公差 ±0.3 なので
//   1.2 だと薄い側で 0.9 になり下限を割る）。レジンは板ごとの値（フロントとハッチの 2.8 は二次硬化の歪み対策）
WALL = nylon() ? 1.6 : 2.0; FLOOR_T = nylon() ? 1.6 : 2.0; FRONT_T = nylon() ? 1.6 : 2.8; HATCH_T = nylon() ? HATCH_T_NYLON : 2.8;   // 板の厚み。
//   🔒 ユーザー 2026-09-14「ナイロンで印刷する場合のモードが欲しいね」→「やってください」: MAT = "nylon" で薄くする。
//   壁 1.2 は docs/PRINT.md の見当（壁 1.2・天板 2.0 で 111g → 60〜70g）。フロントとハッチの 2.8 は
//   二次硬化の歪みを避けるために足した 0.8 なので、反らない MJF では 2.0 へ戻す。
//   床 2.0 は据え置き（柱・ナット・ゴム足の座を持つ板なので、薄くする理由が刷り方から来ていない）。
//   天板 2.5 も据え置き（下の TOP_T。会話ボタンとつまみの台座が 2.5 で形を持っている）。
//   もとの注: フロントは 2.8（🔒 2026-09-04 二次硬化で鞍型に歪んだので 2.0 → 2.8）。ハッチも 2.8（🔒 ユーザー 2026-09-07「格子が入ってるのにもう歪んできてる」「厚さをました方がいい」: 外へ 0.8 厚くする。内面 IN_Y は動かない）。皮の節より前に置く（shutter_v4 の include が読む）
BAT_Z = BAT_AT[2];                  // 電池の下面（shutter_v4 が読む）
// v6.1: 電池のハッチ機構（shutter_v4）は無い

// ---- 置き道具 ----
module at_oled() translate(OLED_AT) rotate([90, 0, 0]) children();                          // 模型の +Z（正面）→ −Y（前）
RSP_RY = 180;   // 🔒 ユーザー 2026-09-14「ReSpeaker を Y 軸中心に 180 度回転」: 板の中心を動かさずに世界の Y 軸まわりで回す（上下と左右が入れ替わる）
RSP_CX = RSP_X + respeaker_L() / 2; RSP_CZ = RSP_Z + respeaker_H() / 2;   // 板の中心（回転の芯）
module at_rsp()  translate([RSP_CX, 0, RSP_CZ]) rotate([0, RSP_RY, 0]) translate([-RSP_CX, 0, -RSP_CZ]) translate([RSP_X + respeaker_L(), RSP_Y1, RSP_Z]) rotate([0, 0, 180]) children();
// 電流計の姿勢（ユーザー 2026-09-05「PowerBoost の上に電流計は乗らないのかね」「L 字にするよ」の検討）
//   "横並び"      … v4 のまま（PowerBoost の前縁の下に潜る）。電源の L が左の壁を 7.2 貫く
//   "重ね_I2C右"  … PowerBoost の上に重ね（板は平行・JST の頭 5.2 の 0.5 上）。I2C の口が右・電源の口が左。壁を 2.5 貫き天井を 1.1 越える
//   "重ね_I2C左"  … 同・I2C が左・電源が右
//   "重ね_I2C後"  … 同・I2C が後ろ・電源が前
//   "重ね_I2C前"  … 同・I2C が前（OLED 側）・電源が後ろ（ハッチ側）
//   "下_I2C前"    … 電流計が帯の上（PowerBoost の枠の位置）・PowerBoost がその上（PB_ON_INA_Z）。向きは INA_RZ（0: I2C 前・電源 後ろ／180: その逆）と INA_SX・INA_SY で送る
INA_POSE = "下_I2C前";             // 🔒 ユーザー 2026-09-05「PowerBoost と電流計の位置を入れ替えて」: 電流計が帯の上・PowerBoost がその上。向き（I2C 前・電源 後ろ）はそのまま
INA_PWR_L = true;   // 電源の口: true = L 字（🔒 ユーザー 2026-09-05）／ false = 直立て（v4・🔒 2026-08-26）。比較用
INA_ON_PB_Z = 1.6 + pb_jst_h() + 0.5;   // PowerBoost の板の裏から電流計の板の裏まで（板 1.6 ＋ JST ＋ 隙間 0.5）
// PowerBoost の枠（v4 pb_frame() と同じ式・PB_DY と傾きを足したもの）。長辺 36 は X・Z 軸 180°: micro USB が右端・JST は前（−Y）・L 字は後ろの外向き
PB_ON_INA_Z = 1.6 + 2.5 + 1.27 + 0.5 + 1.2;   // 電流計の板の裏から PowerBoost の板の裏まで（L 字のハウジングの頭 5.37 ＋ 隙間 0.5 ＋ PowerBoost の足の裏出し 1.2）
PB_SX = -9.0 + 0.6 + 3.0 + 2.0 - 3.0;   // 🔒 ユーザー 2026-09-08「PowerBoost を 3 ミリ左へ」（上段の中央を広げて線を通す）。それまで: 2026-09-05「右に 3mm」（回転 15° の後）→「右に 2mm」（17° の後）。電池を −0.6 したとき枠が動いたぶんを +0.6 補正（PowerBoost の場所は変えない）。🔒 ユーザー 2026-09-05「PowerBoost を 2mm 左へ」→「左に 4mm」(−6)。電池を +3 したとき枠が動いたぶんを −3 補正して −9（PowerBoost の場所は変えない）
// 🔒 ユーザー 2026-09-05「PowerBoost は天井につけましょう」: 板の裏を天板の内面に向けて（部品は下向き）座 PB_CEIL_SO で浮かす。
//   XY の中心は pb_frame0 の場所のまま。
PB_CEIL_SO = pb_pcb_t() + pb_jst_h() + 0.5;   // 天板の内面 ↔ 板の裏 8.1（板 1.6 ＋ JST 6.0 ＋ 隙間 0.5）。🔴 2026-09-06 実機: JST 5.2 で描いたダボ 5.7 より PH コネクタ（実測 6.0）が高かった → ダボ 6.5。刷った天板（1918）は 5.7 のまま使い、次に刷り直すときにこの形（ユーザー）。🔒 ユーザー 2026-09-05「基板面を下にしなければならない理由はない」: 部品面を上（天井側）に
PB_FLIP = [0, 0, 0];                // 裏返さない（部品が上）。2026-09-05 まで [180,0,0]
PB_RZ = 0;                          // 🔒 ユーザー 2026-09-05「Z 軸左回転 15 度」→「もう 2 度」→「元に戻して」: 0（JST 前・L 字 後ろ）（上から見て反時計回り）。それまで 0（JST 前・L 字 後ろ。「Z 軸で 180 度回転」は裏返しと組の値で、部品面を上にしたとき 0 に戻した）
PBC = [BAT_X0 + (lipo_size()[1] - pb_size()[0]) / 2 + pb_size()[0] / 2 + PB_SX, PAIR_Y0 + ina_size()[1] + 0.5 + pb_size()[1] / 2 + PB_DY + PB_DY2];   // 板の中心 XY（27.0, 44.2）
module at_pb() translate([PBC[0], PBC[1], Z_TOP - PB_CEIL_SO]) rotate([0, 0, PB_RZ]) rotate(PB_FLIP) rotate([0, 0, 180]) translate([-pb_size()[0] / 2, -pb_size()[1] / 2, 0]) children();
BAT_RZ = 270;   // 🔒 ユーザー 2026-09-16 夕「バッテリを Z 軸１８０度回転」: 90 → 270。足跡（50×35）も芯も変わらず、**タブが左 −X（X 18.05）から右 +X（X 68.05）へ**移る。右へ逃がした J10（口 X 71.7）の目の前になるので、線が電池の天面を 50mm 渡さなくて済む。   // 旧: 🔒 ユーザー 2026-09-14「電池を Z 軸 90 度回転」: v5 の姿勢（50 が Y）から中心を動かさずに Z で +90（50 が X・タブは左 −X）
BAT_CL = 0.5;   // ⚠ 電池と右の壁の隙間（私の仮の数）
BAT_DY0 = 0;   // 次にユーザーが電池を前後させるときはここ
BAT_C = [OLED_X_C, 27.4 + BAT_DY0];   // 🔒 ユーザー 2026-09-14「電池を OLED を目標に X 中央揃え」: 芯を OLED の X 中心 43.05 に（X 18.05〜68.05）。Y 27.4 は「PCB の中心 → 3 前 → さらに 3 前」の着地点。🔴 2026-09-16 夕に私が勝手に 32.2 へ動かした（ケーシングの内寸に入れるため）。指示に無いので戻した
BAT_RX = 0;    // 🔒 ユーザー 2026-09-14「リポ電池を PCB 基板の下へ」: 寝かせて床に置く（90 のときは立つ）
function bat_h() = (BAT_RX % 180 == 0) ? lipo_size()[2] : lipo_size()[1];   // 回した後の高さ
module at_bat()  translate([BAT_C[0], BAT_C[1], BAT_AT[2] + bat_h() / 2]) rotate([BAT_RX, 0, 0]) rotate([0, 0, 90 + BAT_RZ]) translate([-lipo_size()[0] / 2, -lipo_size()[1] / 2, -lipo_size()[2] / 2]) children();   // 箱の中心を原点に置いてから回す   // 模型は 50 が X。箱では 50 を Y（前後）に寝かせる（§2 X 11.5〜46.5・Y 13.9〜63.9・タブは後ろ）
KNOB_RZ = 0;    // 🔒 ユーザー 2026-09-14「つまみを 90 度回転させちゃってるんでそれを直して」: 90 → 0（v5 の向きに戻す）。台座・島・リードの穴・ねじが一緒に戻る
module at_knob() translate([KNOB_AT[0], KNOB_AT[1], Z_TOP + TOP_T]) rotate([0, 0, KNOB_RZ]) children();             // 天板の外面が z0
BTN_RZ = 90 + 90;   // 🔒 ユーザー 2026-09-14「ボタンを Z 軸中心に 90 度回転」を 2 回: 180
module at_btn()  translate([BTN_AT[0], BTN_AT[1], Z_TOP + TOP_T]) rotate([0, 0, BTN_RZ]) children();               // 天板の外面が z0（btn_v3 の約束）
module at_spk()  translate([SPK_AT[0], SPK_AT[1], Z_TOP + TOP_T]) rotate([0, 0, SPK_RZ]) children();   // 天板の外面が z0（spk_v5 の約束。2026-09-08 まではスピーカーの角が原点だった）

// Type-C 基板の L 字ヘッダ（v4 tcb_ra と同じ形）: 板の下辺の 7 穴（局所 y 2.54・x 2.54+2.54i）。樹脂は板の上（X 3.294〜5.8）、ピンは芯 X 5.8 で −Y（前）へ 6。立てるのは TC_PINS の 2 本（1 番 VBUS・4 番 GND）だけ
TC_Y0 = TC_AT[1]; TC_ZT = TC_AT[2] + tc_size()[0];
TC_PINS = [0, 3];   // 🔒 ユーザー 2026-09-09「1，4 にピンヘッダ立てるよ。5,6,7 は抵抗に使う」: L 字ピンは 1 番 VBUS と 4 番 GND に 1 本ずつ（ピン単位・間の 2 番 +D と 3 番 −D は立てない）。ヘッダも線もこの 1 つの列から出す（tc_ra / tc_plugs / tc_mouth）。🔴 2026-09-09 まで [0,1,4,5] で、並びの読み違い（2 番を GND としていた）と CC への挿し込みが混ざっていた。2026-09-05 の「7 本目は立てない」（樹脂がハブの左後ろの柱 φ7 に 0.3・ピンの先がハブの板の左端に 0.11）はこの形でも守られている
TC_PIN_XC = TC_AT[0] + tc_size()[2] + 2.5;   // ピンの芯の X 5.79（板の表 3.294 ＋ 樹脂 2.5）

// ---- Type-C 基板の受け（v4 tc_seat4 の形。🔒 2026-09-05 ユーザー「物理的に固定できない」→ 床と一体にする）と左の壁の押さえ ----
//   入れ方: 壁を立てた後・ブリッジの前に、ハッチ側から板を溝へ後ろから滑り込ませ、前の当てに当てる（押さえが溝の上に被さるので真上からは入らない）。ハウジングは板が入ってから前側で挿す
//   板の裏を左の壁の内面に付けて立てる基板を、底の座（床〜0.75）・前の当て（1.2）・前の返し（板の表に 0.25 の逃げ）・後ろの控え（3.5）で受ける。浮きは壁の押さえ（板の上端 ＋0.2）が止める
TC4_XF = TC_AT[0] + tc_size()[2];              // 板の表 3.294
TC4_Y1 = TC_AT[1] + tc_size()[1]; TC4_Y0 = TC_AT[1];   // 後縁 IN_Y+0.4・前縁
TC4_ZT = TC_AT[2] + tc_size()[0]; TC4_ZB = TC_AT[2];   // 上端 20.75・下端 0.75
TC4_CL = 0.25; TC4_GX0 = TC4_XF + TC4_CL; TC4_GX1 = 4.25; TC4_BX1 = 4.70;
TC4_SEAT_X1 = 3.9;   // 底の座（板の下端を受ける台）の右端。板の表 3.294 より 0.6 外へ出ている。⚠ 板の下だけで足りる 0.6 だが、床は 2026-09-07-2140 で刷ってあるので詰めない（詰めると床が刷り直しになる）。この 0.6 のぶんハッチの羊羹は 4.15 から右にしか置けない（左は薄壁になるので 2026-09-09 に廃止）
TC4_FY1 = TC4_Y0 - TC4_CL; TC4_FY0 = TC4_FY1 - 3.0;   // 前の当ての厚み 1.2 → 3.0（ケーブルを挿す力を受ける・2026-09-05）
TC4_SEAT_H = 6.0;   // 受けの高さ（🔒 ユーザー 2026-09-05「床からそんな長いの生やすわけ？」: 20.75 → 6.0。板の上は壁の押さえとハッチの穴が持つ）
TC_PRESS = [TC4_FY1 - 4.0, IN_Y, TC4_ZT + 0.2];   // 左の壁の押さえ [Y0, Y1, Z0]: 板の上端の 0.2 上・足の前面（Y 55.15）からハッチまで（足の上も埋める・ユーザー 2026-09-05）。v4 は IN_Y−13.4〜−9.8 の 3.6 だった（🔒 ユーザー 2026-09-05「もう少し長く」）
TC_PRESS_LIP = 6.0; TC_PRESS_LIP_T = 4.0;   // 押さえの前端から下へ落とす L の足の高さ 6.0・厚み 4.0（🔒 ユーザー 2026-09-05「これくらい厚くしていいでしょ・意匠的にも」）（🔒 ユーザー 2026-09-05「末端を L 字で下に少し落として抑えに。橙の抑えだけだと USB を押し込む時に斜めになりそう」）

// ---- 口（全部 plug.scad）----
// ハブ 10 口: 口の表 HUB_HEADERS = [id, label, 出る向き, 本数, x0, y0, x1, y1]（板の局所・ピン 1 本目 = (x0,y0)）
// 🔒 PHIN・PHOUT は PH2.0 のソケット（表では kind "ph"）。DuPont は挿さらない（ユーザー 2026-09-05「PH コネクタの上にピンヘッダー立てないで」）。ここでは飛ばす
// OLED: ヘッダは板の上辺の裏（oled_hdr() の xy）・樹脂の外面は局所 z = oled_hous_z_top()+14・ハウジングは板の裏（−z 局所 ＝ 後ろ +Y）へ・線は下（局所 −y ＝ 世界 −Z）へ曲がる
OLED_EXIT = [-1, 0];   // OLED の口から出た線の向き（plug の局所）。[0,-1] は下（−Z）。🔒 ユーザー 2026-09-05「OLED のケーブルを水平に」→ 左（−X・ハブの OLED の口の側）へ
// 電流計: L 字ヘッダ（ina_hdr() = [x0, x長, y0, y長, 高さ]）。樹脂の外面 x = x0+高さ・ピン 1 本目 y = y0+1.27・ピンの芯 z = 板 1.6 + 2.5
//   ハウジングは −X（板の外）へ水平・線は後ろ（+Y）へ曲がる（ハブの電流計の口は後縁で +Y 向き）
INA_I2C_YAW = 0;   // I2C の L 字は振れない（5 ピンの L 字ヘッダ・🔒 ユーザー 2026-09-05「そっちは角度つけられんよ」）
INA_I2C_EXIT = [0, 1];   // I2C の口から出た線が曲がる向き（plug の局所）。[-1,0] は後ろ（ハッチへ 3.4 出た・2026-09-05）→ 横へ
// I2C ヘッダが裏（INA_HDR_BACK）なら、上に描いた口を板の中面 z 0.8 で鏡にして裏へ（2026-09-06）
// 電流計の電源の口: 4 本・L 字（🔒 ユーザー 2026-09-05「では電流計を L 字にしてください」。同日 直立て→L→直立て→L と往復）。ピンは端子側の縁（局所 +x）の外へ水平・樹脂の外面 x = 26+1.27・芯 z = 1.6+2.5。線は上へ曲がる
INA_PWR_EXIT = [0, 1];    // 口から出た線が曲がる向き（plug の局所 xy）。[-1,0] = 上（板の法線）・[0,1] = 右（+X 世界）・[0,-1] = 左。上だとバスタブの底に入るので右へ（行き先の電池のコネクタ対と PowerBoost の JST が右側・2026-09-05）
INA_PWR_YAW = [90 - 180, 0, 0, 0];   // 電源の L 字ピン 4 本の根元の振り（板の局所 y 3.6・7.87・12.13・16.4 の順＝板が 180 のとき世界の左から右）。🔒 ユーザー 2026-09-05「一番左のピンだけを左に 90 度回転」: 1 本目 +90（左＝反時計回り）→「右に 180 度」: −90（ハウジングが左＝−X を向く）。それまで 0（「右に 25 度」→「30 度」→「0 に戻す」）
// PowerBoost: JP2 の L 字（pb_ra_pwr() 3 本 ＋ pb_ra_chg() 2 本・ピンは板の上を +y へ水平・芯 z = 1.6 + 2.5）。ハウジングは 1 本ずつ。線は上（+Z）へ曲がる
// XIAO: 2 列 × 使う本数（🔒 2026-09-06 下の列 = 信号 4 本・上の列 = 電源 3 本。公式ピン配置を USB-C 左に回した向き＝マニュアル手順 2。それまで逆に置いていた）。ヘッダは XIAO の上（面から 1.4+2.5）・ハウジングは XIAO 面から真上（後ろ）へ
//   線は低い車線（Z 19 前後）へ: 上の列は下へ、下の列は上へ曲がる
// つまみ AS5600: 板の裏から下へ 2 列（左 2 本・右 3 本）

module plugs() { }   // v6.1: DuPont はもう無い（XIAO も OLED もライザーのメス）

// 単位（基板＋その口を 1 つに数える。ピンはハウジングの中に居るので、別々に数えると自分同士の重なりが出る）
UNITS = ["oled", "rsp", "hub", "riser", "oriser", "bat", "knob", "btn", "spk", "spktub"];   // ⭐ 2026-09-19: "tgl"（ハッチのトグル）を外した。電源の押しボタンは PCB（hub）の部品   // 2026-09-14 ユーザー「ブリッジと帯を削除」: bridge・front（前板）・straps を外した   // v6.1: 電流計・PowerBoost・Type-C 基板・小帯・電池のハッチ機構（蓋・ロック・床の板）を外した（2026-09-14）   // pbmount は天板と一体・tcseat は床と一体にした（2026-09-05）   // リードスイッチは 2026-09-05 に一度置いて外した（ユーザー「そんなところについてないだろ」）
module one(n) {
    if (n == "oled") at_oled() oled_242();   // 2026-09-14: DuPont は廃止（ライザーのメスが受ける）
    if (n == "rsp")  at_rsp() respeaker_lite();   // 2026-09-14: XIAO の DuPont は廃止（ライザーのメスが受ける）
    if (n == "hub")  { hub_body(); kguide(); kguide_screws(); }   // ⭐ 2026-09-19: つまみの軸のガイドも PCB の一式（ねじのナットが板の裏なので、PCB を箱に入れる前に机の上で付ける）   // 電源の押しボタンとキャップ（⭐ 2026-09-19。キャップは PCB を入れる前に押し子へ差すので PCB の一式）   // ⭐ 2026-09-16 夕: 既定は KiCad の 3D モデルごとのメッシュ（下の PCB3D）
    if (n == "riser") riser61();   // XIAO の 2 列を受けるライザー（2026-09-14）
    if (n == "oriser") oriser61();   // OLED の 4 ピンを受けるライザー（2026-09-14）
    if (n == "bat")  at_bat()  lipo_1000mah();
    if (n == "knob") knob61();   // v6.1: AS5600 は PCB の上・軸を磁石まで伸ばす（下の knob61）   // 台座（knob_station_add/cut）は天板 p_top() の側   // 島・つまみ・柱・基板・E リング・磁石
    if (n == "btn")  at_btn()  { btn3_piston(); btn3_tub(); btn3_switch(); btn3_sw_screws(); btn3_v_screws(); }   // 台座（btn3_station_add/cut）は天板 p_top() の側   // バスタブ込み
    if (n == "spk")  at_spk()  spk_body();
    if (n == "spktub") at_spk() spk_tub_all();
}
module hub_body() { if (PCB3D) pcb61_solid(); else { pcb61(); usbc61(); pcb_parts61(); } color("#e8e8e8") pwr_btn61(); color("#f2f2f2") pwr_cap(); }   // PCB と板に付いた物（ガイドを除く。見本の絵で色を分けるため）
module others(n) for (m = UNITS) if (m != n) one(m);
// ---- v6.1 充電の USB-C（🔒 ユーザー 2026-09-14「PCB 基板に USB の充電口を左壁に付けて」）----
//   PCB の左の縁（X 6.0）に横出しのレセプタクル。殻 8.94 × 3.26（v5 の TC_PORT_SZ − 逃げ 0.6）・胴の奥行 7.35（⚠ 一般値）・板の縁から 3.0 出る（v6 の板と同じ数）。Y の位置は私の仮
// ---- 板の上の部品（⭐ 2026-09-16 夕に**実物の足形**へ入れ替えた。板の座標 = 世界 −(2.0, 13.5)）----
// 🔴 それまでの枠は KiCad の **courtyard**（置き場所の予約。胴の周りに 0.3〜0.5 の逃げが付く）で、
//    しかも口は courtyard・ライザーは胴、という不揃いだった。いまは全部 **胴（F.Fab）**である。
//    出どころは hardware/pcb/katanori61/katanori61.kicad_pcb に実際に置いてある足形で、
//    python hardware/pcb/gen_pcb.py を回すと動く。板が動いたらここも取り直すこと。
//
//  [名前, x0, x1, y0, y1, 背, 抜く向き, 面, 通り道, 足]
//    背     … その面から立つ胴の高さ
//    向き   … +1 +Y / −1 −Y / +3 +X / −3 −X / +2 上（板から離れる）/ −2 下（板から離れる）/ 0 通り道なし
//    面     … 1 表・−1 裏
//    通り道 … 嵌合した相手のハウジングが**胴の外へ出る量**（下の PH_MATE_OUT）
//    足     … 板を貫いて**反対の面へ出る**長さ
//    足の枠 … [x0, x1, y0, y1] 足の平面の範囲（**スルーホールのパッドの外接枠**）。[] なら胴の枠を使う。
//             ⭐ 2026-09-16 夕に足した。最初は胴の枠のまま押し出していたが、それだと J10 の足が
//             世界 Y 28.5〜33.4 に広がり、SPK IN の線（Y 29）と 1.02mm³ 当たった。実物のピンは
//             Y 30.4〜32.2 にしか無い。**太い枠は安全側ではなく、嘘の当たりを出す**（線の道を曲げさせる）
PCB_PLUG_H = 4.8;        // JST-PH サイド型の背（📄 ePH.pdf 3 ページ Side entry）
PCB_PLUG_V_H = 6.0;      // JST-PH トップ型の胴の背（📄 同 Top entry）
// 🔴🔴 2026-09-16 夕: 旧 PCB_PLUG_PATH 3.1 を捨てた。**導出そのものが間違っていた。**
//    旧: 📄 2 ページ（SMT の図）の (9.6) − 6.0 − 逃げ 0.5 = 3.1。引いた 6.0 は**トップ型の背**で、
//        (9.6) が載っている**サイド型の奥行き 7.6** ではない。層の違う数どうしを引いていた。
//    正: 📄 1 ページ（Through-hole の組立図。回転した寸法なので pdfminer で向きごとに拾った）
//        サイド型  (9.6) − 胴の奥行き 7.6 = **2.0**   ← 嵌合したハウジングが胴の外へ出る量
//        トップ型  (8)   − 胴の背     6.0 = **2.0**   ← 同じく胴の上へ出る量
//    ⇒ どちらも 2.0。さらに 📄 3 ページの表でハウジング PHR-2 は 5.8 × 4.5 で、
//      トップ型の胴 5.9 × 4.5 の**中に収まる**。縦の口は挿しても平面の外形が広がらない
PH_MATE_OUT = 2.0;
PCB_PLUG_UP = 16.0;      // ⚠ 表の縦の口（J7）の上に取る**線の曲がり込み**の空き。私の見積り（筐体の実測では 33 空く）。PH_MATE_OUT 2.0 はこの中
PCB_PLUG_DOWN = 2.0;     // ⚠ 裏の縦の口（J10）で、嵌合したプラグの下に取る線の曲がり。プラグの下端 Z 4.0 − 2.0 = 2.0 で床まで 2.0 残る
PCB_TH_LEG = 1.8;        // ⚠ 一般値。スルーホールのポストが板（1.6）を貫いて反対側へ出る残り。📄 に数字が無い（ePH.pdf の (3.4) はポストの**位置**で長さではない）
RISER_SOCK_H = 2.54;     // ⭐ 2026-09-16 夕に 2.5 → 2.54。2.54 ヘッダの樹脂は**断面が 2.54 の角**で、2.5 ではない。KiCad の 3D モデルでも板の面から 2.54（メッシュの天面 Z 16.14 − 板の表 13.6）。2.5 のままだとライザーの板の下端がヘッダの樹脂へ 0.04 めり込み、path_rsp / path_oled に 1.2 ずつ残っていた   // 板の上に出るオスのヘッダの樹脂。2.54 ヘッダの規格の姿（樹脂 2.5・ピン 6.0・先は板の面から 8.5・足 3.0）で、parts/parts.scad:328 の PowerBoost のヘッダと同じ数。特別な品を想定していないので実測は要らない
RISER_LEG = 3.0;         // 🔒 並走セッション 2026-09-16 夕「ピンヘッダありますからね。当たり判定はちゃんとしておいたほうがいい」: 同じ規格の姿の**足 3.0**。板の裏 12.0 から下端 Z 9.0 で、電池のケーシングの天板 8.2 まで 0.8 空く
// 🔴 この行は PCB_PARTS より前に置くこと。後ろに置くと前方参照で undef になり、板の上のオスのヘッダ 2 つが描かれない（2026-09-14 に実際に起きた）
// ⭐ 2026-09-16 夕: 手書きの 9 行をやめ、**基板ファイルから生成した 56 行**を読む。
//   引き継ぎ docs/HANDOFF-2026-09-16.md 3.3。手書きの表では 55 個中 46 個が模型に存在せず、
//   **存在しない物には当たらない**ので、当たり検査の 0 は「問題なし」ではなく「見ていない」だった。
//   作り直し: python hardware/pcb/gen_case_parts.py
//   🔒 残しておくべき経緯（生成物の行コメントには入らないので、ここに置く）:
//     J5 SPK OUT … 基板担当 2026-09-14「抜く向きは −X（左の縁）」。ライザーの裏の L 字の胴に
//                  26.21mm³ 食い込んでいたので Y を 1.9 後ろへ逃がしてある
//     J6 BTN2    … 🔒 ユーザー 2026-09-14「会話ボタンを基板に付ける必要はないと言ったんであって、
//                  線は必要でしょ」。板は線を受ける口だけ持つ（私が 1 度この口を消したのは読み違え）
//     J7         … 🔒 縦の B4B-PH-K。横出しだとプラグがハッチの板に刺さる
//     J10        … 🔒 ユーザー 2026-09-16 夕「ケーシング作ったから垂直のがいい。結局一番穴は
//                  小さくなる」。板の裏・縦・下向き。はんだ足が表の J4 のプラグの下へ入らない所に置いてある
//     K31        … 胴（14.8 × 7.4 × 9.33）とリード（15.3 × 10.7 × 0.5）の 2 行に分けてある。
//                  データシートの 10.7 はリード込みの外形で、背 9.33 の胴はもっと小さい
include <pcb/v61_parts.scad>
include <pcb/v61_silk.scad>   // ⭐ 2026-09-19 板のシルク（gen_board3d.py が書く 2D の図形）
// ---- 実物の姿（🔒 ユーザー 2026-09-16 夕「STEPをそのまま読み込んで」）----
//   OpenSCAD は STEP を読めないので、KiCad に基板ごとメッシュへ落としてもらう:
//     python hardware/pcb/gen_board3d.py   → hardware/pcb/v61_board3d.stl（28,528 三角・1.4MB）
//   板・部品の 3D モデル・貫いた足まで入った実物の姿である。箱の模型では
//   コネクタの殻の口もロックの爪もリレーの蓋も無かった。
//   🔴 **寸法の出どころはこちらではない。** 口の座標・背・通り道は PCB_PARTS（v61_parts.scad）が持つ。
//      メッシュは「見る物・当てる物」で、数字は表から引く。両方とも同じ基板ファイルから起きている。
//   座標: KiCad の 3D は 板の裏が Z 0・X は図面のまま・Y は図面の符号を反転。
//      世界 = 3D + (−38.0, +90.9, HUB_AT[2])。gen_board3d.py が同じ式を刷る
PCB3D = true;   // false で箱の模型（pcb61 + usbc61 + pcb_parts61）に戻る
// ⭐ 2026-09-19 🔒 ユーザー「シルクをモデルにも反映させてください」: 板のシルク（pcb/v61_silk.scad の 2D に厚み 0.075）。
//   絵のための物なので当てる検査には入れない（sweep_chk.py・nutpath_chk.py は -D PCB_SILK=false で呼ぶ）
PCB_SILK = true;
//   ⚠ 2026-09-16 夕、ピンヘッダ（J1・J2）の 3D モデルをメッシュから外して逃げようとした。
//      🔒 ユーザー「ピンヘッダ立てることそのものは問題ないでしょ」── そのとおりで、
//      ピンが板の面から 8.5 立つのは実物どおりである。直すべきは**こちら側**で、
//      ライザーの裏の L 字のメスを中身の詰まった塊で描いていたのが原因だった（下の lsock_body）。
//      メスに穴を開けたので、ピンはそこへ入る。メッシュは 55 個そのまま
//   板と部品は**別のファイル**にしてある。1 つだと色を分けられず全部が同じ色になる
//   （🔒 ユーザー 2026-09-16 夕「真っ黄色はやめてね」── import に色を付け忘れると OpenSCAD の既定の黄）
// ⭐ 2026-09-17: 置き方を **板から引く**ようにした。−38.0 / 90.9 と直書きしていて、PCB_Y0 を 13.5 → 13.1 に動かしたとき模型だけ 0.4 後ろに残り、USB-C がハッチから飛び出して見えた。
//   STL は KiCad の図面座標（原点 40, 40・Y は下向き）で出ている。world X = kicad X − 40 ／ world Y = PCB_Y0 + (40 + 板の奥行き) − kicad Y。
module pcb61_solid() translate([HUB_AT[0] - 40.0, PCB_Y0 + 40.0 + PCB_W, HUB_AT[2]]) {
    color("#2b6b3f") import("pcb/v61_board3d.stl", convexity = 12);   // 板
    color("#333")    import("pcb/v61_parts3d.stl", convexity = 12);   // 部品
    color(C_HEADER)  import("pcb/v61_conn3d.stl", convexity = 12);    // 口（PH・USB-C）は白（gen_board3d.py の CONN_3D）
    if (PCB_SILK) color("#f4f4f4") {   // シルク（表・裏）。KiCad の厚み 0 の面を 2D にした物に、板の面から浮いていた分（0.075）の厚みを付ける
        translate([0, 0, SILK_BOARD_TOP]) linear_extrude(SILK_Z_TOP - SILK_BOARD_TOP) silk_top2d();
        translate([0, 0, SILK_Z_BOT]) linear_extrude(-SILK_Z_BOT) silk_bot2d();
    }
}
function pcb_w(q) = [HUB_AT[0] + q[1], PCB_Y0 + q[3], HUB_AT[2] + 1.6];   // 板の座標 → 世界（枠の左前の角）
function pcb_z0(q) = (q[7] < 0) ? HUB_AT[2] - q[5] : HUB_AT[2] + 1.6;   // 部品の下端（裏なら板の裏から下へ）
function pcb_path(q) = q[8];   // 嵌合した相手が胴の外へ出る量
function pcb_leg(q)  = q[9];   // 板を貫いて反対の面へ出る長さ
function pcb_legbox(q) = (len(q) > 10 && len(q[10]) == 4) ? q[10] : [q[1], q[2], q[3], q[4]];   // 足の平面（板の座標）。無ければ胴
module pcb_parts61() for (q = PCB_PARTS) let (o = pcb_w(q), w = q[2] - q[1], d = q[4] - q[3]) color("#333") {
    translate([o[0], o[1], pcb_z0(q)]) cube([w, d, q[5]]);
    // 🔒 板を貫く足（反対の面へ出る）。枠は**スルーホールのパッドの外接枠**（pcb_legbox）
    if (pcb_leg(q) > 0) let (g = pcb_legbox(q))
        translate([HUB_AT[0] + g[0], PCB_Y0 + g[2], (q[7] < 0) ? HUB_AT[2] + 1.6 : HUB_AT[2] - pcb_leg(q)])
            cube([g[1] - g[0], g[3] - g[2], pcb_leg(q)]);
}
// プラグの通り道。胴の縁から PH_MATE_OUT（2.0）だけ抜く向きへ。縦は線の曲がりぶんまで伸ばす。0 が正
module pcb_plug_paths() for (q = PCB_PARTS) let (o = pcb_w(q), z = pcb_z0(q), w = q[2] - q[1], d = q[4] - q[3], n = pcb_path(q))
    if (q[6] == 2)  translate([o[0], o[1], z + q[5]]) cube([w, d, PCB_PLUG_UP - q[5]]);                       // 表の縦の口（上へ・線の曲がり込み）
    else if (q[6] == -2) translate([o[0], o[1], z - (n + PCB_PLUG_DOWN)]) cube([w, d, n + PCB_PLUG_DOWN]);    // 裏の縦の口（下へ・嵌合 ＋ 線の曲がり）
    else if (abs(q[6]) == 3) translate([(q[6] > 0) ? o[0] + w : o[0] - n, o[1], z]) cube([n, d, q[5]]);       // ±X へ抜く
    else if (q[6] != 0) translate([o[0], (q[6] > 0) ? o[1] + d : o[1] - n, z]) cube([w, n, q[5]]);            // ±Y へ抜く
PCB_NOTCH = 0.5;   // 板と柱の隙間
PCB_SCR_D = 2.2;   PCB_FOOT_CL = 0.4;   // 蓋の足と板の穴の隙間   // M2 の通し（板の穴）
// 板に開けるのは **留めねじ 4 本の通し φ2.2**（柱 HUB_HOLES_W の真上）だけ。
// ⭐ 2026-09-17: 後ろのレールの逃げ（板の後ろ左の角 0.894 × 0.3）を**廃止**した（🔒 ユーザー「たった 0.3mm で逃げもクソもない」）。
//   板は左の窓から差して入るので後ろの縁 82mm 全部がレールを通る ⇒ 角を欠いても掃引は 0.544mm³ 残っていた。
//   逃げは筐体側（flap_rail_pcb_relief）へ移した。板の外形は角の立った 82.024 × 37.4 の長方形に戻る
// 2026-09-18: 四隅を丸める（ユーザー「４隅全部丸めればいい」）。レジンの壁を 45° 開くと、後ろのねじより後ろの
//   壁の端が内側へ回り込み、角の立った板の後ろ左・後ろ右の角をかすめていた。外側の角なのでルーターの刃の太さの制限は無い
PCB_CR = 3.5;   // 角の丸みの半径。⚠ 出どころは基板の外形（hardware/pcb/gen_pcb.py の BOARD_CR）。ふだんの模型は KiCad から書き出した v61_board3d.stl を使い、ここは PCB3D=false のときの予備の箱
module pcb61() color("#2b6b3f") difference() {
    translate(HUB_AT) linear_extrude(1.6) offset(r = PCB_CR, $fn = 64) offset(delta = -PCB_CR) square([PCB_L, PCB_W]);
    for (h = HUB_HOLES_W) translate([h[0], h[1], HUB_AT[2] - 1]) cylinder(d = PCB_SCR_D, h = 1.6 + 2, $fn = 24);
    // ⭐ 2026-09-16 夕: 角ごとの欠きを廃止。欠きは「板を真上から降ろす」前提で、壁に付いた上の柱・レール・蓋の足を通すための縁まで開いた穴だった。
    //   🔒 ユーザー 2026-09-16 夕「板を真上から降ろすのをやめるだけでは」→ 1.5 上げて左の窓から差し、柱の頭まで下ろす形（path_hub 174.08 → 0.59）。
    //   この入れ方なら板は上の柱（Z 38.25〜47.25）の下を通るだけなので、欠きは要らない
}
module usbc61() color("#c8ccd0") translate([USBC_X - USBC_SZ[1] / 2, PCB_Y1 + usbc_out() - USBC_SZ[0], HUB_AT[2] + 1.6]) cube([USBC_SZ[1], USBC_SZ[0], USBC_SZ[2]]);   // 後ろの縁の中央。幅 8.94 が X・奥行 7.30 が Y
USBC_PORT_C = [USBC_X, IN_Y + HATCH_T / 2, HUB_AT[2] + 1.6 + USBC_SZ[2] / 2];   // 口の中心（ハッチの厚みの中央）
USBC_PORT_SZ = [USBC_SZ[1] + 0.6, USBC_SZ[2] + 0.6];   // [X, Z] 殻 ＋ 片側 0.3（XIAO の USB-C の口と同じ逃げ）
module usbc61_port_cut() port_cut(USBC_PORT_C, USBC_PORT_SZ[0], USBC_PORT_SZ[1], HATCH_T, "y");   // ハッチ（port_cut の外面は +Y）
// ⭐ 2026-09-17: レジンのハッチ（2.8）だけ、**口のまわりを外面から 1.2 掘る**。
//   胴の出は 1.3（シェルの足 4 本が板に載る上限 1.800 の内側）で 1 つしか持てないので、
//   ナイロン（1.6）では奥まり 0.8 だがレジンでは 2.0 になる。掘って残り肉 1.6 ＝ ナイロンと
//   同じにすれば、どちらも奥まり 0.8（右の壁・XIAO で通った関係）に揃う。
//   ⚠ 掘る大きさは口の穴 ＋ 片側 1.5（CASE-V2.md 1036 行「口の外形＋余白 1.5」の前例）。
//     プラグのオーバーモールドの実寸は手元に無い。現物が来たら測って詰める。
USBC_CB = [USBC_PORT_SZ[0] + 3.0, USBC_PORT_SZ[1] + 3.0, 1.2];   // [X, Z, 深さ] = 12.54 × 6.86 × 1.2
module usbc61_counterbore() translate([USBC_X, IN_Y + HATCH_T - USBC_CB[2], USBC_PORT_C[2]])
    rotate([-90, 0, 0]) linear_extrude(USBC_CB[2] + 1) port_rr([USBC_CB[0], USBC_CB[1]], PORT_R);
// ---- v6.1 ライザーカード（🔒 ユーザー 2026-09-14「PCB 基板に OLED ＋ ReSpeaker をくっつけるライザーカード」）----
//   まず XIAO の 2 列だけ。板を垂直に立て、前向きのメス 2 個で XIAO のピンを受ける。線は 7 本消える。
//   ピンの面（ハウジングの根元）は 2 列とも同じ Y で、ReSpeaker が動けば追従する（W_rsp から引く）
RISER_T = 1.6; SOCK_D = 8.5; SOCK_FWD = 0; RISER_MARG = 1.0; RISER_TOP_CL = 2.5; SOCK_WALL = 1.0; RISER_SHAFT_D = 9.0;   // SOCK_FWD 0: メスの口は XIAO のヘッダの樹脂の面と面一。RISER_SHAFT_D: つまみの軸 φ7 の逃げ
function xiao_row_pts(r) = let (used = [[2, 3, 4, 5], [0, 1, 2]][r], zl = [9.397, 24.627][r])
    [W_rsp([2.932 + used[0] * 2.54, -(1.4 + 2.5), zl]), W_rsp([2.932 + used[len(used) - 1] * 2.54, -(1.4 + 2.5), zl])];
function riser_xs() = [for (r = [0, 1], k = [0, 1]) xiao_row_pts(r)[k][0]];
function riser_y0() = xiao_row_pts(0)[0][1] - SOCK_FWD + XSOCK_H;   // 板の前面 ＝ 表面実装のメスの座る面（口から 8.80。⭐ 2026-09-19 まで SOCK_D 8.5）
function riser_zs() = [for (r = [0, 1]) xiao_row_pts(r)[0][2]];
RISER_SOCK_CY = 18.78;   // 🔒 基板担当 2026-09-14: 板に立てる 1x07 のメスソケットの courtyard。板はこれを覆う幅にする
// 🔒 ユーザー 2026-09-14「ライザー、裏から L 字の水平に出すソケット付ければいけるか」:
//   板の上に立てるのは背の低いオスのヘッダ（樹脂 2.5）にして、ライザー側は裏面の L 字のメスで受ける。
//   ⇒ ライザーの板の下端は 板の表 ＋ 2.5。縦のメス（背 8.5）の頭に乗せる形をやめたので、
//      下のメスの下に板が 3.51 残る（8.5 のときは 0.11 で、オスのヘッダと場所を取り合って作れなかった）
//   ⚠ 2.5 は 2.54 ヘッダの樹脂の一般値。L 字のメスの実寸は基板担当待ち
// L 字のメス（ライザーの裏面に付き、口は下を向いて板のオスを受ける）
// 📄 出どころ: Sullins の .100" Female Headers カタログ（hardware/ref/sullins_100_female_hdr.pdf・2026-09-14 に取得）
//    https://sullinscorp.com/catalogs/101_PAGE114-115_.100_FEMALE_HDR.pdf の表:
//      LGB  1 列  RIGHT ANGLE  A .335"[8.50]  B 0.100"[2.54]  TAIL .124"[3.15]
//      LJB  2 列  RIGHT ANGLE  A .335"[8.50]  B 0.200"[5.08]  TAIL .124"[3.15]
//    ⇒ **B が板からの高さ**（1 列 2.54・2 列 5.08 と列の数に比例する ＝ 接点が縦に積まれる向き）。
//      A 8.50 は列数で変わらないので板に沿う長さ。KiCad の PinSocket_1x07_P2.54mm_Horizontal の
//      足跡の外形 10.03 ＝ 胴 8.50 ＋ 足の曲がり 1.53 とも合う。
//    ⇒ 胴は板の面から 2.54・接点の軸はその真ん中 1.27。**J1・J2 の +2.87 はこれで確定**
//    ⚠ 残る仮定は「接点が 2.54 のちょうど真ん中」の 1 点だけ（この表に断面図は無く、A・B・TAIL の 3 つしか出ていない）
//    ⭐ 2026-09-19: 買う品は SHOU HAN（ORDER-V61N.md）。寸法はその図面へ置き換えた（下の LSOCK_BODY の注）。奥行き 2.50 で接点の軸は 1.25
LSOCK_T = 2.50;   // 胴がライザーの裏面から後ろへ出る厚み。⭐ 2026-09-19 買う品 SHOU HAN の図面で 2.54 → 2.50（下の LSOCK_BODY の注）。接点の軸は真ん中 1.25（図面に寸法なし・前の 1.27 と 0.02 違い）
LSOCK_H = 10.03;  // 🔒 基板担当 2026-09-14（KiCad の実寸）: PinSocket 1x07 P2.54 Horizontal の樹脂は「ピンの列から口の側へ 10.03」。口はライザーの板の下端にあるので、胴は下端から上へ 10.03
function riser_z0() = HUB_AT[2] + 1.6 + RISER_SOCK_H;   // L 字のメスの口（胴の下端）。OLED のライザーの板の下端もここ
// XIAO のライザーの板の下端（⭐ 2026-09-19）。🔒 ユーザー「表面実装のメスなりオスなりさがさないと」→「模型の形を変えてください」:
//   表の XIAO のメスを表面実装（SHOU HAN PM2.54-1x3PLT-H8.5-R C55218894 / 1x4PLT-H8.5-R C55218895・高さ 8.5）にする。
//   スルーホールのままだと電源の列の 3 本の足が裏へ出て、裏の L 字のメスの胴（Z 16.14〜26.17）の下に入り、はんだも付かない。
//   表面実装のパッドは列の芯から上下へ互い違いに 3.0 まで出る（図面の PCB LAYOUT 6.00）。電源の列 Z 17.58 − 3.0 = 14.58 が
//   L 字の口の高さ 16.14 より下なので、板だけハブのピンヘッダの前へ垂らす。板はピンの列（Y 25.3）より前（Y 22.4〜24.0）なのでピンの邪魔にならない。
//   下端はハブの表の 0.5 上（パッドの下に 0.48）。その場所にハブの部品が無いのは 2026-09-19 に KiCad の 3D モデルで見た
RISER_BOT_CL = 0.5;
function riser_plate_z0() = HUB_AT[2] + 1.6 + RISER_BOT_CL;
// ---- XIAO のライザーの部品の寸法（⭐ 2026-09-19 精緻化。🔒 ユーザー「模型の板を精緻化してください」）----
// 表の XIAO のメス: 📄 SHOU HAN PM2.54-1xNPLT-H8.5-R の図面（https://www.lcsc.com/datasheet/C55218894.pdf）
//   胴の長さ N × 2.54 + 0.5・幅 2.50・高さ 8.50。足を含む高さ 8.80（胴は板から 0.30 浮く）・足の先の幅 4.70・足 0.54 × 0.25
//   パッド 1.02 × 3.00 が列の芯から上下へ互い違い（PCB LAYOUT の全幅 6.00）
//   ⚠ 口の四角い穴の大きさは図面に無い。1.0 角・口から 7.5 と置いた（ピン 0.64 が入ればよい）
XSOCK_H = 8.80; XSOCK_BODY = 8.50; XSOCK_W = 2.50; XSOCK_FOOT = 4.70; XSOCK_LEG = [0.54, 0.25]; XSOCK_PAD = [1.02, 3.00]; XSOCK_HOLE = [1.0, 7.5];
function xsock_len(n) = n * 2.54 + 0.5;
CU_T = 0.035;   // 銅箔（1oz）
// 裏の L 字のメス: 📄 SHOU HAN PM2.54-1xNPWZ-H8.5 の図面（https://www.lcsc.com/datasheet/C54876736.pdf・1x4 の C54876733 も同じ図）で 2026-09-19 に突き合わせ
//   胴の長さ N × 2.54 + 0.5（±0.3）・奥行き 2.50（±0.15）・高さ 8.50（±0.15）・胴の座る面から足の先 3.20（±0.25）・胴の口から曲げた足の下の面 10.20（±0.3）・足 0.64 × 0.4・推奨穴 φ1.02
//   足の列の高さは図面の 10.20 から足の厚みを引いて 9.8〜10.0。KiCad の足跡の 10.03 は ±0.3 の内なので LSOCK_H は変えない
//   胴は口（下）から 8.50。その上 1.53 で足が板の側へ曲がり、ピンの列（口から 10.03）で板を貫いて、胴の座る面から 3.20 出る
LSOCK_BODY = 8.50; LSOCK_TAIL = 3.20; LSOCK_LEG = 0.64; LSOCK_DRILL = 1.0;
// XIAO のライザーだけ板を 1.2 にして、板の裏と L 字の胴の間にレジンの板切れ 0.4 を挟む（⭐ 2026-09-19 🔒 ユーザー「板の厚さを下げて、L 字ピンヘッダの樹脂の間にレジンの板切れ 0.4mm を噛ませますか」）。
//   L 字の軸は 板の前面 + 1.2 + 0.4 + 1.27 で 1.6 のときと同じ（ハブの J1 と合ったまま）。垂らした板の裏とハブのピンヘッダーの樹脂の前の面の間が 0 → 0.4 空く。
//   足は胴の上（口から 10.03）で板へ曲がるので、胴の下に挟む板切れに足の穴は要らない。板の前へ出る足は 3.20 − 0.4 − 1.2 = 1.60。
//   JLC の 2 層の厚みの選択肢に 1.2 がある（0.8〜1.6 は同じ値段）。OLED のライザーは J2 と 1.6 で合っているので変えない
XRISER_T = 1.2; LSOCK_SHIM = 0.4;
function xsock_pins(r) = let (q = xiao_row_pts(r), n = round(abs(q[1][0] - q[0][0]) / 2.54) + 1) [for (k = [0 : n - 1]) min(q[0][0], q[1][0]) + k * 2.54];
// 表の XIAO のメス 1 個（y = 板の前面。胴は −Y へ）。足 k は偶数が s0 の向き（+1 上・−1 下）・奇数がその逆
// XSOCK_S0 = [信号の列, 電源の列] の 1 本目の向き。基板の配線（pcb/gen_riser.py）がこれを読む:
//   信号の列は D2 を下（線を下のすきまへ落とす）・D3 を上（ビアを D3 の下に打つ）、電源の列は 5V・3V3 を上・GND を下
XSOCK_S0 = [-1, 1];
// ⭐ 2026-09-19 🔒 ユーザー「USBポートとphヘッダーは白にしてください」→「ピンヘッダーの樹脂部分は黒です」:
//   PH・USB-C は白（基板の側は gen_board3d.py が v61_conn3d.stl に分けて出す）。ピンヘッダとライザーのメスの樹脂は黒
C_HEADER = "#f2f2f2";   // PH・USB-C
C_PINHDR = "#333";      // ピンヘッダ・ライザーのメスの樹脂
C_PIN = C_HEADER;       // ピン・メスの足の金属（🔒 ユーザー「樹脂だけ黒です。ピンは白ですよ」）
module xsock(xs, z, y, s0 = 1) {
    n = len(xs); c = (xs[0] + xs[n - 1]) / 2;
    color(C_PINHDR) difference() {
        translate([c - xsock_len(n) / 2, y - XSOCK_H, z - XSOCK_W / 2]) cube([xsock_len(n), XSOCK_BODY, XSOCK_W]);
        for (x = xs) translate([x - XSOCK_HOLE[0] / 2, y - XSOCK_H - 1, z - XSOCK_HOLE[0] / 2]) cube([XSOCK_HOLE[0], XSOCK_HOLE[1] + 1, XSOCK_HOLE[0]]);
    }
    for (k = [0 : n - 1]) let (x = xs[k], sg = k % 2 == 0 ? s0 : -s0) {
        color(C_PIN) translate([x - XSOCK_LEG[0] / 2, y - CU_T - XSOCK_LEG[1], sg > 0 ? z : z - XSOCK_FOOT / 2]) cube([XSOCK_LEG[0], XSOCK_LEG[1], XSOCK_FOOT / 2]);   // 足（胴の下から列の外へ）
        color("#c87533") translate([x - XSOCK_PAD[0] / 2, y - CU_T, sg > 0 ? z : z - XSOCK_PAD[1]]) cube([XSOCK_PAD[0], CU_T, XSOCK_PAD[1]]);                         // パッド
    }
}
module riser61() {
    pins = riser_pin_x();
    x0 = pins[0] - 1.27; x1 = HUB_AT[0] + RISER_SOCK_CY;   // 左の縁はピンの列の端 − 1.27 = X 2.50（左壁の内面 1.694 まで 0.806）。裏の L 字のメスの胴はそこから 0.25 左へ出る（X 2.25・壁まで 0.556）
    // 🔒 ユーザー 2026-09-19: ライザーはルーターで切る板で、外形は ±0.2 ずれる（JLCPCB・pcb/gen_pcb.py 128 行）。それまでの縁 X 2.0（ハブの板の左の縁に揃えた）は
    //    壁まで 0.306 で、最悪 0.106 にナイロンの ±0.3 が乗ると当たる。縁を胴の端まで引っ込め、壁との隙間を買う部品の樹脂で決める
    //    （2026-09-19 の精緻化で胴の端を XIAO の列ではなくハブの J1 のピンの列から取り直し、2.392 → 2.50）
    zb = riser_z0(); zt = max(riser_zs()) + 1.27 + RISER_TOP_CL; zp = riser_plate_z0(); y = riser_y0();
    color("#2b6b3f") difference() {
        translate([x0, y, zp]) cube([x1 - x0, XRISER_T, zt - zp]);                                    // 板 1.2（下端は zp。L 字の口 zb より下へ垂れる）
        translate([KNOB_AT[0], KNOB_AT[1], zp - 1]) cylinder(d = RISER_SHAFT_D, h = zt - zp + 2, $fn = 48);   // つまみの軸の逃げ（⚠ 2026-09-15 の測り: 軸は X 64.2〜71.2 でライザーの板から遠く、今は何も削っていない）
        lsock_drills(pins, y, zb, XRISER_T);                                                          // L 字のメスの足の穴
    }
    for (r = [0, 1]) xsock(xsock_pins(r), riser_zs()[r], y, XSOCK_S0[r]);                            // 表の XIAO のメス（表面実装）
    color("#e8e0c8") translate([(pins[0] + pins[len(pins) - 1] - xsock_len(len(pins))) / 2, y + XRISER_T, zb]) cube([xsock_len(len(pins)), LSOCK_SHIM, LSOCK_BODY]);   // レジンの板切れ 0.4（胴の下だけ）
    lsock_body(y + XRISER_T + LSOCK_SHIM, zb, pins);   // 裏面の L 字のメス（口は下・板のオスを受ける。板切れの上に座る）
}
// ---- L 字のメスの胴（⭐ 2026-09-16 夕）----
// 🔒 ユーザー「ピンヘッダ立てることそのものは問題ないでしょ」。
//   それまで中身の詰まった塊で描いていたので、板のオスのピン（板の面から 8.5）が入る所が無く、
//   上から降ろす掃引が串刺しになっていた（path_rsp 18.55 / path_oled 11.12）。
//   実物は**口が下を向いた雌**なので、ピンの列のぶんだけ下から彫る。
//   壁は前向きのメスと同じ SOCK_WALL 1.0。彫る深さはピンの先（板の面から 8.5）までで、
//   胴の上に 1.0 残る限りはそこで止める
LSOCK_PIN_W = 1.2;    // 彫る幅（2.54 のピン 0.64 に片側 0.28 の遊び）
// ピンの芯（世界）。出どころは gen_pcb.py の CHECK_PADS（J1 は板の 1.770〜17.010 の 7 本・
// J2 は 37.240〜44.860 の 4 本。どちらも 2.54 間隔）。板が動けばここも取り直す
function riser_pin_x()  = [for (k = [0 : 6]) HUB_AT[0] + 1.770 + k * 2.54];
function oriser_pin_x() = [for (k = [0 : 3]) HUB_AT[0] + 37.240 + k * 2.54];
// y0 = 胴の座る面（ライザーの板の裏面）。胴は口（zb）から LSOCK_BODY、足はその上で板へ曲がり、ピンの列（zb + LSOCK_H）で板を貫く
// 胴の長さは SHOU HAN の図面の N × 2.54 + 0.5（表の XIAO のメスと同じ式）。列の真ん中から左右へ
module lsock_body(y0, zb, pxs) {
    color(C_PINHDR) difference() {
        translate([(pxs[0] + pxs[len(pxs) - 1] - xsock_len(len(pxs))) / 2, y0, zb]) cube([xsock_len(len(pxs)), LSOCK_T, LSOCK_BODY]);
        // 🔴 Y は「胴の厚み − 壁 × 2」ではなく **ピンと同じ 1.2 を胴の真ん中**に取る。
        //   SOCK_WALL 1.0 を両側に置くと 2.54 − 2.0 = 0.54 しか残らず、2.54 ヘッダのピン 0.64 が入らない
        //   （2026-09-16 夕に実際に path_rsp 4.04 が残った）。真ん中に取れば壁は片側 0.67 になる
        // 彫る高さはピンの先（板の面から 樹脂 2.54 ＋ ピン 6.0 ＝ 8.54）の少し上まで。胴の天井は 1.0 残す
        let (zt = min(HUB_AT[2] + 1.6 + 9.0, zb + LSOCK_BODY - 1.0))
            for (px = pxs)
                translate([px - LSOCK_PIN_W / 2, y0 + (LSOCK_T - LSOCK_PIN_W) / 2, zb - 1])
                    cube([LSOCK_PIN_W, LSOCK_PIN_W, zt - zb + 1]);
    }
    color(C_PIN) for (px = pxs) let (ya = y0 + LSOCK_T / 2, zr = zb + LSOCK_H, h = LSOCK_LEG / 2) {   // 足: 胴の上から軸に沿って上がり、ピンの列で板へ曲がって貫く
        translate([px - h, ya - h, zb + LSOCK_BODY]) cube([LSOCK_LEG, LSOCK_LEG, zr - zb - LSOCK_BODY + h]);
        translate([px - h, y0 - LSOCK_TAIL, zr - h]) cube([LSOCK_LEG, ya + h - (y0 - LSOCK_TAIL), LSOCK_LEG]);
    }
}
// L 字のメスの足の穴（板の前面 yf から裏面まで）
module lsock_drills(pxs, yf, zb, t = RISER_T) for (px = pxs) translate([px, yf - 1, zb + LSOCK_H]) rotate([-90, 0, 0]) cylinder(d = LSOCK_DRILL, h = t + 2, $fn = 24);
// ---- v6.1 OLED のライザー（🔒 ユーザー 2026-09-14「OLED ライザーもつくりましょ」）----
//   OLED の 4 ピンは板の裏の上辺（世界 Z 46.5）から後ろ（+Y）へ出る。ピンの出る面は世界 Y = ORISER_Y_PIN。
//   そこへ口を合わせた前向きのメスを付け、板は PCB の上（Z 9.6）まで下ろす。⇒ 下駄は要らない（ピン 6 の中でメスが受ける）
function oriser_y_pin() = OLED_AT[1] - (oled_hous_z_top() + dupont_h());   // ヘッダの樹脂の面（ピンの根元）7.1
function oriser_xs() = let (c = oled_hdr()) [OLED_AT[0] + c[0] - 1.5 * 2.54, OLED_AT[0] + c[0] + 1.5 * 2.54];
function oriser_z() = OLED_AT[2] + oled_hdr()[1];
module oriser61() {
    x0 = oriser_xs()[0] - 1.27; x1 = oriser_xs()[1] + 1.27;
    yf = oriser_y_pin() + SOCK_D;                                   // 板の前面
    zb = riser_z0(); zt = oriser_z() + 1.27 + 1.0;
    color("#2b6b3f") difference() { translate([x0, yf, zb]) cube([x1 - x0, RISER_T, zt - zb]); lsock_drills(oriser_pin_x(), yf, zb); }   // 板（L 字のメスの足の穴）
    color(C_PINHDR) difference() {                                                                    // 前向きのメス（中は空）
        translate([x0, oriser_y_pin(), oriser_z() - 1.27]) cube([x1 - x0, SOCK_D, 2.54]);
        translate([x0 + SOCK_WALL, oriser_y_pin() - 1, oriser_z() - 1.27 + 0.5]) cube([x1 - x0 - 2 * SOCK_WALL, SOCK_D - SOCK_WALL + 1, 2.54 - 1.0]);
    }
    lsock_body(yf + RISER_T, zb, oriser_pin_x());   // 裏面の L 字のメス（口は下・穴あき）。胴 10.66 は板 10.16 から左右へ 0.25 出る
}
// ---- v6.1 つまみ（🔒 ユーザー 2026-09-14「AS5600 を PCB 基板に落として」「ノブはながーーい棒を備える事になりますがそれで良い」）----
//   knob_v5 の 持ち手・島・ねじ・ナット・E リング・磁石 はそのまま。AS5600 のモジュール基板と吊り（バスタブ 2）は無い。
//   軸（φ7）を knob_v5 の軸の下端（外面から 15.9）から PCB の上の磁石まで伸ばす。IC 5 × 4 × 1.1 と 磁石との隙間 1.1 は knob_v5 の CHIP_H / CHIP_GAP と同じ数
KNOB61_GROUPS = ["knob", "mag", "screw", "wall", "nut", "ering", "reed"];   // ⭐ 2026-09-19: "reed"（リードスイッチ）を足した
// ⭐ 2026-09-17: AS5600 のチップを筐体側で描くのをやめた。基板の模型（PCB_PARTS の "U4"）が
//   同じ 1 個を持っているので、2 か所に描くと当たり検査が自分自身に当たる（15.791mm³ 出ていた）。
//   背も筐体側は 1.1 と置いていたが、実物は 📄 1.75（JLCPCB C79815 の仕様欄）。基板の模型から読む。
function as_ic_h() = pcb_part("U4")[5];   // AS5600 の背（基板の模型が持つ実寸）
AS_GAP = 1.1;   // 磁石の下面とチップの**天面**の隙間。ここは設計値のまま
AS_IC_Z  = HUB_AT[2] + 1.6;                 // PCB の上面 レジン 9.6／ナイロン 13.6
MAG61_Z0 = AS_IC_Z + as_ic_h() + AS_GAP;    // 磁石の下面。チップの実寸 1.75 から測るので ナイロンで 16.45（旧 15.8。1.1 と置いていたぶん 0.65 上がる）
// 軸の延長（⭐ 2026-09-19）: v5 の軸の下端（外面から −15.9）から磁石の下面 MAG61_Z0 まで。つまみの部品ファイルへ $knob_ext で渡す。
//   軸は 1 本の刷り物になり、磁石 φ4 × 2 は伸ばした先のポケットに入る（つまみと一緒に蓋に付いて動く）。
//   🔴 2026-09-19 まで延長は絵の円柱（knob61_shaft・磁石の上面で止まる）だけで、発注用の STL（parts/knob_v61.scad の part="knob"）は短い軸のまま。
//      磁石も PCB の側に別に描いていた。刷る形は print_knob61 から出す（tools/stl_v61n.py の knob）
KNOB61_EXT = (Z_TOP + TOP_T + knob_shaft_bot()) - MAG61_Z0;
$knob_ext = KNOB61_EXT;
module knob61() at_knob() for (g = KNOB61_GROUPS) knob_group(g);   // ⛔ AS5600 のチップはここでは描かない（基板の模型が持つ）。2026-09-17 に消した
module print_knob61() rotate([180, 0, 0]) translate([0, 0, -knob_grip_h()]) knob_part();   // 持ち手の天面を下（knob_v61.scad の part="knob" と同じ向き）
echo(str("knob61: 軸の延長 ", KNOB61_EXT, "（下端 Z ", MAG61_Z0, "）"));
// ---- つまみの軸のガイド（⭐ 2026-09-19。🔒 ユーザー 2026-09-19「つまみの軸の精度をあげる方法として、基盤手前にガイドをつけたい」→「１がいい」＝基板に立てる）----
//   🔒 ユーザー 2026-09-19「私は板に足がすこしついているくらいのイメージ」「板から足が伸びてるので良い」:
//     平らな板 1 枚（軸の周りの丸 ＋ 足へ向かう 3 本の腕）を U4 の少し上に浮かせ、短い足 3 本で基板に立てる。
//     🔴 最初は別セッションの叩き台（輪・漏斗・輪から下りる胴・腕）で描き、形が違う・刷れない（宙から始まる肉・突然出る輪）と言われて描き直した
//   ・軸の穴: 軸 φ7 ＋ 島と同じ遊び 0.8。上の縁に面取り（降りてくる軸の先を拾う）
//   ・位置は U4 の胴で取る。丸の下を U4 の足の上まで下ろした太い塊にし、中の口を下は U4 の胴の四角（嵌め 0.1）、チップの天面の上で軸の丸へ少しずつ移す
//     （🔒 ユーザー「四角から丸にすこしずつ移行すればいい」。最初は板の裏から壁 0.8 の枠を下ろしていて「これじゃ割れちゃう」）。
//     移る斜面は左右で水平から約 28°（高さ 1.0 で 1.85 入る。軸の先とチップの間が 1.1 しか無いので高さは取れない）。
//     🔒 ユーザー「28° のまま刷る」: 45° は一般の目安で、このリポジトリの光造形の判定（宙から始まる肉 0・急な立ち上がり 0.25 / 実績 4.00）は通っている
//   ・足 3 本（120° 等分・半径 12・基板の穴は PCB_GUIDE_HOLES）。ねじは押さえるだけ ⇒ 板と足の穴は φ2.8 と大きめ
//     🔒 ユーザー 2026-09-19「だめだったら枠を無くしましょ。3 点穴があれば場所は固定できますし」: 刷って U4 の口がうまくいかなければ、
//     口（丸の下の塊と前後の端の壁）を外し、KG_SCR_D を φ2.2（基板の穴と同じ）に絞って 3 本の足の穴で位置を取る
//   ・板の外形を丸や三角にしないのは、右の 2 本の足の間に J4（背 6.0）が来るため
//   ・刷る向きは板を下（print_kguide）。足と枠は板から上へ伸びるだけで、宙から始まる肉は無い
//   ⚠ 私が置いた値: 板の高さと厚み、丸と腕の幅、口の嵌め 0.1、前後の端の壁 0.8、KG_LEAD_H 1.2（SOIC-8 の足の上端の一般値・図面で未確認）
KG_BORE = knob_shaft_d() + 0.8; KG_BORE_CH = 0.5;
KG_PLATE_T = 2.0; KG_HUB_D = 16.0; KG_ARM_W = 6.0; KG_PAD_D = 6.0; KG_LEG_D = 5.0; KG_SCR_D = 2.8;
KG_FIT = 0.1; KG_WALL = 0.8; KG_END_CL = 0.5; KG_LEAD_H = 1.2; KG_TOP_CL = 0.1; KG_PART_CL = 0.3;   // KG_TOP_CL: 口の四角はチップの天面の 0.1 上まで・KG_PART_CL: 塊の下の部品（C42）の逃げ
function kg_top() = AS_IC_Z + as_ic_h();                       // チップの天面（ナイロン 15.35）
KG_PLATE_Z = [kg_top() + 0.85, kg_top() + 0.85 + KG_PLATE_T];   // 板 16.2〜18.2。軸の先（天面 + 1.1）は板の穴の中
function kg_holes() = [for (h = PCB_GUIDE_HOLES) [HUB_AT[0] + h[0], PCB_Y0 + h[1]]];
function kg_u4() = let (q = pcb_part("U4"), o = pcb_w(q)) [o[0], o[1], o[0] + q[2] - q[1], o[1] + q[4] - q[3]];   // U4 の胴 [x0, y0, x1, y1]（世界）
assert(norm([(kg_u4()[0] + kg_u4()[2]) / 2 - KNOB_AT[0], (kg_u4()[1] + kg_u4()[3]) / 2 - KNOB_AT[1]]) < 0.01, "U4 の芯がつまみの軸と揃っていない");
assert(len([for (h = kg_holes()) if (abs(norm(h - [KNOB_AT[0], KNOB_AT[1]]) - 12) > 0.01) 1]) == 0, "ガイドの足の穴が軸から 12 に無い（基板を動かしたら gen_case_parts.py を回す）");
module kg_plate2d() let (c = [KNOB_AT[0], KNOB_AT[1]]) {
    translate(c) circle(d = KG_HUB_D, $fn = 64);
    for (h = kg_holes()) { hull() { translate(c) circle(d = KG_ARM_W, $fn = 32); translate(h) circle(d = KG_ARM_W, $fn = 32); } translate(h) circle(d = KG_PAD_D, $fn = 48); }
}
module kguide() color("#e0c060") difference() {
    b = kg_u4(); c = [KNOB_AT[0], KNOB_AT[1]]; zb = AS_IC_Z; zt = kg_top();
    union() {
        translate([0, 0, KG_PLATE_Z[0]]) linear_extrude(KG_PLATE_T) kg_plate2d();                                                   // 板
        for (h = kg_holes()) translate([h[0], h[1], zb]) cylinder(d = KG_LEG_D, h = KG_PLATE_Z[0] - zb + 0.01, $fn = 48);           // 足
        translate([c[0], c[1], zb + KG_LEAD_H]) cylinder(d = KG_HUB_D, h = KG_PLATE_Z[0] - zb - KG_LEAD_H + 0.01, $fn = 64);        // 丸の下の塊（U4 の足の上で止める）
        translate([b[0] - KG_FIT - KG_WALL, b[1] - KG_FIT - KG_WALL, zb + KG_END_CL])                                                 // 前後の端（足の無い辺）だけ板の 0.5 上まで下ろす
            cube([b[2] - b[0] + 2 * (KG_FIT + KG_WALL), b[3] - b[1] + 2 * (KG_FIT + KG_WALL), KG_LEAD_H - KG_END_CL + 0.01]);
    }
    // 口: 下は U4 の胴の四角（嵌め 0.1）、チップの天面の上で丸（軸の穴）へ少しずつ移す（🔒 ユーザー「四角から丸にすこしずつ移行すればいい」）
    translate([b[0] - KG_FIT, b[1] - KG_FIT, zb - 1]) cube([b[2] - b[0] + 2 * KG_FIT, b[3] - b[1] + 2 * KG_FIT, zt + KG_TOP_CL - zb + 1]);
    hull() {
        translate([b[0] - KG_FIT, b[1] - KG_FIT, zt + KG_TOP_CL - 0.01]) cube([b[2] - b[0] + 2 * KG_FIT, b[3] - b[1] + 2 * KG_FIT, 0.01]);
        translate([c[0], c[1], MAG61_Z0]) cylinder(d = KG_BORE, h = 0.01, $fn = 64);
    }
    translate([c[0], c[1], MAG61_Z0]) cylinder(d = KG_BORE, h = KG_PLATE_Z[1] - MAG61_Z0 + 1, $fn = 64);                            // 軸の穴（軸の先の高さから上）
    translate([c[0], c[1], KG_PLATE_Z[1] - KG_BORE_CH]) cylinder(d1 = KG_BORE, d2 = KG_BORE + 2 * KG_BORE_CH + 0.02, h = KG_BORE_CH + 0.01, $fn = 64);   // 上の縁の面取り
    translate([b[0] - KG_FIT - KG_WALL - 1, b[1] - KG_FIT, zb - 1]) cube([b[2] - b[0] + 2 * (KG_FIT + KG_WALL) + 2, b[3] - b[1] + 2 * KG_FIT, KG_LEAD_H + 1]);   // 左右（足の側）は足の上端より下を空ける
    let (q = pcb_part("C42"), o = pcb_w(q)) translate([o[0] - KG_PART_CL, o[1] - KG_PART_CL, zb - 1]) cube([q[2] - q[1] + 2 * KG_PART_CL, q[4] - q[3] + 2 * KG_PART_CL, q[5] + KG_PART_CL + 1]);   // C42 の逃げ
    for (h = kg_holes()) translate([h[0], h[1], zb - 1]) cylinder(d = KG_SCR_D, h = KG_PLATE_Z[1] - zb + 2, $fn = 24);              // ねじの通し
}
// 足のねじ M2（頭は板の上）と板の裏のナット（絵）
module kguide_screws(screw = true, nut = true) color("#b8b8b8") for (h = kg_holes()) translate([h[0], h[1], 0]) {   // 分解図は screw・nut を別々に呼ぶ
    if (screw) translate([0, 0, KG_PLATE_Z[1]]) cylinder(d = 3.8, h = 1.3, $fn = 24);
    if (screw) translate([0, 0, HUB_AT[2] - FP_NUT_T]) cylinder(d = 2.0, h = KG_PLATE_Z[1] - (HUB_AT[2] - FP_NUT_T), $fn = 16);
    if (nut) translate([0, 0, HUB_AT[2] - FP_NUT_T]) cylinder(d = FP_NUT_AF / cos(30), h = FP_NUT_T, $fn = 6);
}
// 分解図の PCB の一式: 軸のガイドは板から上へ、ねじはさらに上へ、板の裏のナットは下へ（🔒 ユーザー「explodeにAS5600の位置ガイド部品の分解が書かれていません」）
EXP_KG = [12, 24, -8];   // ガイド・ねじ・ナットを離す量 [mm]
EXP_PISTON = -10;        // 分解図の会話ボタンの押し子: 天板の下（下から入れる）。バスタブ（−20）より上
// 分解図の会話ボタン（押し子は上の EXP_PISTON）: 押し子の下にスイッチ、その下にバスタブ。スイッチを留める横のねじは
//   バスタブの壁を貫く向き（−Y）へ抜き、バスタブを引き上げる縦のねじは一番下（🔒 ユーザー「会話ボタンのスイッチが分解できていません」）
//   🔒 ユーザー「スイッチですが下から入れるものではないので、バスタブを下にしてください」: スイッチは上からバスタブへ入れる
EXP_BTN = [-34, -20, 10, 14];   // バスタブの Z・スイッチの Z・横のねじを −Y へ・縦のねじをバスタブから下へ [mm]
module btn_explode() {
    translate([0, 0, EXP_BTN[0]]) at_btn() { btn3_tub(); btn3_v_screws(EXP_BTN[3]); }
    translate([0, 0, EXP_BTN[1]]) at_btn() { btn3_switch(); translate([0, -EXP_BTN[2], 0]) btn3_sw_screws(); }
}
module hub_explode() {
    hub_body();
    translate([0, 0, EXP_KG[0]]) kguide();
    translate([0, 0, EXP_KG[1]]) kguide_screws(nut = false);
    translate([0, 0, EXP_KG[2]]) kguide_screws(screw = false);
}
function kguide_screw_len() = KG_PLATE_Z[1] - (HUB_AT[2] - FP_NUT_T);   // 頭の座（板の上）から板の裏のナットの下まで
echo(str("kguide: 板 Z ", KG_PLATE_Z[0], "〜", KG_PLATE_Z[1], "・足の長さ ", KG_PLATE_Z[0] - AS_IC_Z, "・ねじ M2 × ", kguide_screw_len(), " 以上"));
module print_kguide() translate([0, 0, KG_PLATE_Z[1]]) mirror([0, 0, 1]) kguide();   // 板の上面を下（足と枠が上へ伸びる）。鏡で上下だけ返す（X・Y は世界のまま）
function tail(s, k) = len(s) > k ? _join([for (i = [k : len(s) - 1]) s[i]]) : "";
function _join(v, i = 0) = i >= len(v) ? "" : str(v[i], _join(v, i + 1));
function starts(s, pre) = len(s) >= len(pre) && _join([for (i = [0 : len(pre) - 1]) s[i]]) == pre;


// ============================================================
// ブリッジ（🔒 ユーザー 2026-09-05「先にブリッジを設計しましょう」→ 3 段案は却下・PowerBoost は天井へ）
//   皿（電池）＋土手＋壁への帯。電流計は留め帯 B の支柱に載る（v4 と同じ）。
//   数字は全部いまの中身の外形から（電池 X 11.5〜46.5・Y 12.9〜62.9・Z 26.1〜32.1／電流計の穴 (14.2,43.1)(29.8,43.1)／PowerBoost の穴 (42.5,53.1)(42.5,35.3)(11.1,50.5)(11.1,37.3)）
// ============================================================
BR_X0 = BAT_X0 - 2.5;  BR_X1 = BAT_X0 + lipo_size()[1] + 2.5;   // 皿の X 9.0〜49.0（v4 と同じ・土手の外面まで）
BR_Y0 = TRAY_Y0;       BR_Y1 = TRAY_Y0 + lipo_size()[0] + 2.0;   // 皿の Y 12.9〜64.9（v4 と同じ。後ろは開ける）
ARM_Y = [50.5, 62.9];                 // 壁への帯の Y（v4 と同じ・幅 12.4・左右とも）。
// 帯の両端を壁の棚へ M2×6 で留める（v4 と同じ流儀: ブリッジ側は通し φ2.3＋座ぐり φ4.4×1.6、ナットは壁の棚の中＝皮を描くときに彫る）。2026-09-05
BRG_ANCH = [[LW_X + 3.5, (ARM_Y[0] + ARM_Y[1]) / 2], [IN_X - 3.5, (ARM_Y[0] + ARM_Y[1]) / 2]];   // ねじの芯 [X, Y]: 壁の内面から 3.5
BRG_ANCH_D = 2.3; BRG_ANCH_CB = 4.4; BRG_ANCH_CBH = 0.6;   // 座ぐりの深さ 1.6 → 0.6（2026-09-05）: 腕は 2.0 厚なので 1.6 だと底が 0.4 しか残らず印刷の下限 0.42 を割る。腕の上は箱の中で頭が 0.7 出ても当たる物が無い   // （🔒 ユーザー 2026-09-05「奥のクソ細い橋は却下」。帯はつまみの口（X 58.7〜68.8・Y 〜49.8・Z 19〜）の後ろを通る）
// ---- 前板（v4 の brg_front と同じ形・🔒 ユーザー 2026-09-05「v4 と同じ支え板を設置」）----
//   首 23 × 2.0 が床の溝に立ち、皿を貫く抜きを通って、皿の裏の掘り込み（1.0）にフランジ（1.0 厚・奥行き 6）が沈む。上は返し（1.0 厚・電池の高さ 6）。ねじ無し（前へ倒れるとフランジが掘り込みの天井に、後ろへ倒れると首が抜きの奥に当たる）
LEG_X0 = BAT_X0 + 6;                  // 17.5（v4: 意匠の引っ込み 6）
LEG4W  = lipo_size()[1] - 2 * 6;      // 23
BRGF_T = 1.0; BRGF_SINK = 1.0; BRGF_D = 6.0; BRGF_CL = 0.2;
FP_Y0  = TRAY_Y0;                     // 前板の前面 12.9（皿の前縁と面一）
FP_ZT  = BRG_ZB + BRG_T;              // 皿の天面 26.875
// 🔒 ユーザー 2026-09-05「支え板、平ねじでブリッジ上から留められるように」: 皿の上から M2 平ねじ 2 本 → 皿 2.0 → フランジ 1.0 → フランジの下のナットの箱（床 1.0＋ナット 1.6・横差し）。M2×6
FP_SCR_X = [LEG_X0 + 4.5];                  // ねじの芯 X 22.0・1 本（🔒 ユーザー 2026-09-05「1 個でいいよ」。右は XIAO の口の上で置けない）
FP_SCR_Y = FP_Y0 + BRG_T + 3.1;            // 18.0（フランジ Y 14.3〜20.9 の中）
FP_SCR_D = 2.3; FP_CSK_D = 4.0; FP_CSK_H = 0.85;   // 通し・皿もみ（M2 平ねじの頭 φ3.8）
FP_NUT_AF = 4.0; FP_NUT_T = 1.6; FP_NUT_FLOOR = 1.0;
FP_BOX = [LEG_X0 + 1.5, LEG_X0 + 7.5, FP_SCR_Y - 3.0, FP_Y0 + BRG_T + BRGF_D];   // ナットの箱 X 19.0〜25.0・Y 15.0〜20.9（フランジの中に収める）
FP_NUT_ROOF = 0.4;                                                       // ナットの溝の天井とフランジの裏の間に残す肉（フランジ 1.0 と合わせて 1.4）
FP_BOX_Z0 = BRG_ZB - FP_NUT_ROOF - FP_NUT_T - FP_NUT_FLOOR;                // 箱の底 21.875（ハブの口の頭 24.4 は X 26.5〜 にしか無い）
module bridge() color("#c9a86a") difference() {
    union() {
        translate([BR_X0, BR_Y0, BRG_ZB]) cube([BR_X1 - BR_X0, BR_Y1 - BR_Y0, BRG_T]);                       // 皿
        translate([LW_X, ARM_Y[0], BRG_ZB]) cube([IN_X - LW_X, ARM_Y[1] - ARM_Y[0], BRG_T]);                    // 壁〜壁の帯（皿と一体・v4 と同じ Y）
        banks();                                                                                                 // 土手（留め帯の足の区間だけ途切れる）
    }
    strap_seat_cut();   // 🔒 ユーザー 2026-09-10「台形で良いね」: 台形の足が入る座（ツバの溝 tab_slots() は使わない）
    seat_corner_round();   // 🔒 ユーザー 2026-09-10「あまりにも鋭利で作業中に手を切った事がある」: 座の口が土手の天と交わる角を R0.5 で丸める
    for (a = BRG_ANCH) translate([a[0], a[1], 0]) { translate([0, 0, BRG_ZB - 1]) cylinder(d = BRG_ANCH_D, h = BRG_T + 2, $fn = 24); translate([0, 0, BRG_ZB + BRG_T - BRG_ANCH_CBH]) cylinder(d = BRG_ANCH_CB, h = BRG_ANCH_CBH + 0.01, $fn = 32); }   // 壁への留め（通し＋座ぐり）
    for (x = FP_SCR_X) translate([x, FP_SCR_Y, 0]) { translate([0, 0, BRG_ZB - 1]) cylinder(d = FP_SCR_D, h = BRG_T + 2, $fn = 24); translate([0, 0, BRG_ZB + BRG_T - FP_CSK_H]) cylinder(d1 = FP_SCR_D, d2 = FP_CSK_D, h = FP_CSK_H + 0.01, $fn = 32); }   // 前板の平ねじ（通し＋皿もみ）
    translate([LEG_X0 - BRGF_CL, FP_Y0 - 1.0, BRG_ZB - 1]) cube([LEG4W + 2 * BRGF_CL, BRG_T + 1.0 + BRGF_CL, BRG_T + 2]);   // 首を通す抜き（皿を貫通・Y 11.9〜15.1）
    translate([LEG_X0 - BRGF_CL, FP_Y0 + BRG_T + BRGF_CL, BRG_ZB - 1]) cube([LEG4W + 2 * BRGF_CL, BRGF_D, 1 + BRGF_SINK + 0.1]);   // フランジの掘り込み（皿の裏・深さ 1.0）
}

// ---- 留め帯 3 本（🔒 v4 2026-08-25〜09-03 の形をそのまま・ユーザー 2026-09-05「3 本のバッテリーストラップを復活させて」）----
//   ⊓: 足（厚み 2）が皿の縁の上に立ち、天板（厚み 2）が電池の上。足の前後のツバ（長さ 2・上面 45°）を、皿の土手を X に貫く溝へ横差し。
//   差した後に電池を後ろから入れると電池が楔になって戻らない（ねじ無し）。土手は厚み 2・高さ 4・足の区間だけ途切れる。
STRAP_GAP = 51.7 - (33.2 + 13.3);   // 帯の間隔 5.2（B〜C）。🔒 ユーザー 2026-09-05「1・2・3 番目の間隔を同じに」
STRAP_DY = -4.0;   // 🔒 ユーザー 2026-09-05「3 つの帯を 4mm 手前へ」
STRAP_W = 6.9;    // 帯の太さ（3 本とも同じ）。🔒 ユーザー 2026-09-05「帯の太さをもっとせまく」: 13.3 → 6.9（元の A・B の太さ）。間隔 2.525 では足の三角（ツバ・TAB_MIN 3.5 以上の区間にだけ付く）が消えていた
STRAP_N = 3;   // 🔒 ユーザー 2026-09-05「帯を 2 個から 3 個に増やし等間隔に」（様子見・調整はまだ）
STRAP_SP = (lipo_size()[0] - STRAP_N * STRAP_W) / (STRAP_N + 1);   // 電池の長さ 50 の中に帯 3 本を、両端の余白も含めて同じ間隔で並べる（6.9 なら 7.3）
STRAP_BANDS = [for (i = [0 : STRAP_N - 1]) [BAT_Y0 + STRAP_SP + i * (STRAP_W + STRAP_SP), STRAP_W]];   // 6.9 のとき 21.2〜28.1・35.4〜42.3・49.6〜56.5
BANK_H = 4.0;
TAB_L = 1.5; TAB_H = 1.5; TAB_CL = 0.2; TAB_MIN = 3.5;   // 掛かり 2.0 → 1.5・45°（🔒 ユーザー 2026-09-05「細すぎ」: 土手の根元 = 帯の間隔 5.2 − 溝 1.7×2 = 1.8。v4 は 2.0 で根元 0.8）
TAB_TIP = 0.4;   // ツバの先端の平らな高さ。🔒 ユーザー 2026-09-05「足の三角が鋭角すぎて入れるのに苦労した」: 刃（0）→ 0.4 の面で止め、そこから 45°
TAB_Z0 = BRG_ZB + BRG_T;                // ツバの下面 = 足の裏 = 皿の上
function foot_x(right) = right ? BAT_X0 + lipo_size()[1] + 0.5 : BAT_X0 - 2.5;   // 足の X（電池との隙間 0.5）: 9.0 / 47.0
function rail_segs(right) = [for (i = [0 : len(STRAP_BANDS)])   // 左右とも皿の前縁から（v4 は左を最初の帯の後ろから始めていた: J2 の欠きのため。v5 は皿が J2 の頭 23.5 より上なので要らない・ユーザー 2026-09-05）
    let (a = (i == 0) ? TRAY_Y0 : STRAP_BANDS[i - 1][0] + STRAP_BANDS[i - 1][1],
         b = (i == len(STRAP_BANDS)) ? TRAY_Y0 + lipo_size()[0] : STRAP_BANDS[i][0]) if (b > a) [a, b]];
module banks() for (right = [false, true]) for (sg = rail_segs(right))
    translate([foot_x(right), sg[0], TAB_Z0]) cube([STRAP_T, sg[1] - sg[0], BANK_H]);
// 🔒 ユーザー 2026-09-10（絵・中央の帯 B）＋「台形で良いね」: 足は下へ行くほど Y へ広がる台形。ツバは廃止。
//   上端は STRAP_W 6.9・下端は片側 FOOT_FLARE ずつ広い。絵から読んだ数字（帯の間隔 14.2mm を基準に 25 px/mm、上端 6.6・下端 9.4）→ 片側 1.25。
//   A・C も同じ形（ユーザー「A と C の帯の足は中央 B にあわせて」）。刷る向き（足の裏を下）では上へ行くほど細るので張り出しが無い。
//   横（X）から差す。下が広いので、差した後は上へ抜けない。柱の根元の肉は 7.325 − (1.25+0.2)×2 = 4.425
FOOT_FLARE = 1.25;
FOOT_H = lipo_size()[2] + STRAP_T;   // 足の高さ 8.0（皿の上から天板の上まで）
// 🔒 ユーザー 2026-09-10「入れやすいように左右の角を削って。帯側。台形の底面もかな」: 足の底のまわりを FOOT_CH だけ落とす。
//   底面が四方に FOOT_CH 小さくなり、そこから 45° で台形の断面に戻る。削るのは帯だけで、土手の座は角のまま（逃げを帯側に持たせる）
FOOT_CH = 0.4;
// 🔒 ユーザー 2026-09-10「入れやすいように左右の角を削って。帯側。台形の底面もかな」→「丸くしてください」: 面取り（45° の平面）をやめて R に。
//   ① 足の四隅（上下に走る 4 本の角）を R = FOOT_R で丸める（断面が角丸の長方形になる）
//   ② 底のまわりの辺も同じ R で丸める（底面が四方に FOOT_R 小さくなり、そこから R で側面へつながる）
//   削るのは帯だけ。土手の座は角のままで、逃げは帯側に持たせる
FOOT_R = 0.4;
FOOT_RN = 6;   // 底の R の分割
// 🔒 ユーザー 2026-09-10（絵・赤丸 6 か所）「ブリッジのこの赤丸の所は丸めておいて。あまりにも鋭利で作業中に手を切った事があるから」:
//   座の斜面が土手の天面と交わる角（X に 2mm 走る辺・左右の土手 × 帯 3 本の前後 = 12 本）を半径 SEAT_R で丸める。
//   丸めるぶんは座が広がる側なので、帯との嵌まりはゆるくなる方向（きつくならない）
SEAT_R = 0.5;
function seat_g(z) = (FOOT_FLARE + TAB_CL) - FOOT_FLARE * z / FOOT_H;   // 高さ z での座の片側の広がり
module round_edge(x0, xw, ye, zt, s, r) difference() {   // s=-1: 肉が y<ye 側 / s=+1: 肉が y>ye 側
    translate([x0, s < 0 ? ye - r : ye, zt - r]) cube([xw, r, r + 0.01]);
    translate([x0, ye + s * r, zt - r]) rotate([0, 90, 0]) cylinder(r = r, h = xw, $fn = 96);   // 中心は肉のある側へ r（🔴 2026-09-10 反対側に置いていて、丸まらず四角い欠きになっていた）
}
module seat_corner_round() let (g = seat_g(BANK_H), zt = TAB_Z0 + BANK_H)
    for (b = STRAP_BANDS) for (right = [false, true]) {
        round_edge(foot_x(right) - 1, STRAP_T + 2, b[0] - g,        zt, -1, SEAT_R);   // 手前側（肉は前の土手）
        round_edge(foot_x(right) - 1, STRAP_T + 2, b[0] + b[1] + g, zt, +1, SEAT_R);   // 奥側（肉は次の土手）
    }
module strap_seat_cut() for (b = STRAP_BANDS) for (right = [false, true]) hull() {   // 足＋逃げ TAB_CL。X は土手を貫くよう前後 1 ずつ伸ばす
    translate([foot_x(right) - 1, b[0] - FOOT_FLARE - TAB_CL, TAB_Z0]) cube([STRAP_T + 2, b[1] + 2 * (FOOT_FLARE + TAB_CL), 0.01]);
    translate([foot_x(right) - 1, b[0] - TAB_CL, TAB_Z0 + FOOT_H - 0.01]) cube([STRAP_T + 2, b[1] + 2 * TAB_CL, 0.01]);
}
// 電流計まわりだけの組み立て図（2026-09-09）: 実体は 電流計の板と部品・帯 B・小帯・天板の棒、天板は半透明。part="inalook"
// 電流計の支柱（B の天板の上・v4 2026-09-03「支柱は帯と一体」）: 胴 φ5.8・高さ INA_LIFT、軸 φ2.0 が穴 φ3.0 を通る。E リング（呼び 1.5）の溝はまだ彫っていない
// 電流計の穴の世界座標: at_ina() の "下_I2C前" と同じ変換を式で（送ると支柱が付いてくる）
PBF_O = [BAT_X0 + (lipo_size()[1] - pb_size()[0]) / 2 + pb_size()[0], PAIR_Y0 + ina_size()[1] + 0.5 + pb_size()[1] + PB_DY];   // pb_frame0 の原点 XY
function ina_hole_w(h) = let (v = [h[0] - ina_size()[0] / 2, h[1] - ina_size()[1] / 2],
                              a = -90 + INA_RZ,
                              r = [v[0] * cos(a) - v[1] * sin(a), v[0] * sin(a) + v[1] * cos(a)],   // rotate Z(−90+INA_RZ)（任意の角度）
                              q = [r[0] + pb_size()[0] / 2, r[1] + pb_size()[1] / 2])
                         [INA_SX + PBF_O[0] - q[0], INA_SY + PBF_O[1] - q[1]];          // pb_frame0 の Z 軸 180° と送り
INA_HOLES_W = [for (h = ina_holes()) ina_hole_w(h)];
// E リング（呼び 1.5）の軸: φ2.0・板 1.6 の上に遊び 0.1 → 溝（径 1.5・幅 0.5）→ 掴みしろ 0.6。🔒 ユーザー 2026-09-05「電流計に E リング。PowerBoost もダボ＋E リング」。溝の数字は規格値（AI が置いた）
E15_D = 2.0; E15_GRV_D = 1.5; E15_GRV_W = 0.5 + 0.3; E15_PLAY = 0.1; E15_GRIP = 0.6;   // 溝の幅 0.8（リング 0.4 ＋ 0.4）。🔒 ユーザー 2026-09-05「AS5600 のダボの E リングが取れないくらい厳しい。PowerBoost と電流計の溝も同じはず」: 0.5 → 0.8、軸は同じだけ長くなる（e15_len）
// 電流計の軸: 3.0（穴 3.2〜3.4）に E-2.3（軸 3〜4 用）の溝。🔒 ユーザー 2026-09-06「軸 3 を留める E リングなんていくらでも持ってる」。溝径 2.3・幅は板厚 0.6 ＋ 0.4（E-1.5 の溝を 0.4 広げた前例と同じ）
E23_D = 3.0; E23_GRV_D = 2.3; E23_GRV_W = 0.6 + 0.4;
// 電流計の板の足跡（世界・軸に平行）: 4 隅を ina_hole_w() と同じ変換で写す
INA_FOOT = let (c = [for (q = [[0, 0], [ina_size()[0], 0], [ina_size()[0], ina_size()[1]], [0, ina_size()[1]]]) ina_hole_w(q)])
           [min([for (q = c) q[0]]), max([for (q = c) q[0]]), min([for (q = c) q[1]]), max([for (q = c) q[1]])];   // [x0, x1, y0, y1]
// 電源ヘッダの足の列（板の局所 x 26・y 3.6〜16.4）の世界の足跡
HDR_FOOT = let (c = [for (q = [[26.0 - 1.27, 3.6 - 1.27], [26.0 + 1.27, 3.6 - 1.27], [26.0 + 1.27, 16.4 + 1.27], [26.0 - 1.27, 16.4 + 1.27]]) ina_hole_w(q)])
           [min([for (q = c) q[0]]), max([for (q = c) q[0]]), min([for (q = c) q[1]]), max([for (q = c) q[1]])];
// ---- 電流計の留め（🔒 ユーザー 2026-09-07 決定）----
//   ① E リングはやめて素のダボ（左の穴・帯 B の上）。樹脂の軸に E リングは割れる（同日実機・PowerBoost の首 1.5 で 1 本割れ、「2mm だって無理」）
//   ② 帯 B と帯 C の上の薄いレール（板の縁を横から差し込む唇）は同日に廃止（ユーザー「スライドしませんよね。穴の開いた帯です」: ダボ 2 本に上から落とす板は横に差し込めない）
//   ③ 2026-09-07 の同日、ユーザー「ダボとダボを結ぶ小帯パーツがあった方がよくないですか」→ 描く: 右のダボも帯 B に戻して 2 本にし、
//      2 つの穴に小帯 inabar（足 φ6.0 × 高さ INA_BAR_H・間は橋）を載せる。天板の足（φ3.6・先は平ら）は小帯の右の足の上に降りて押さえる（ina_ceiling_leg・p_top 側）。
//      小帯の穴は φ3.0 のすべり嵌め（ダボ φ2.8）。ダボの先は小帯の上面より 0.2 低く、天板の足はダボではなく小帯に当たる
//   台座でナットを入れる案は、電流計の一番高い所が PowerBoost の裏の 0.33 下にあり、台座 4.2 で 3.9 食い込む（当たり 113mm³）ので不可（同日検算）
INA_BAR_H = 3.1; INA_BAR_T = 1.5; INA_BAR_FOOT_D = 6.0; INA_BAR_W = 1.25;   // 小帯: 足の高さ（板の上から）・橋の厚み・足の径・橋の幅。凹みの径は下の INA_BAR_HOLE_D（INA_PEG_D の後で定義する。前に置くと undef）
INA_BAR_ARM_W = 2.0; INA_BAR_BACK_Y = 35.2; INA_BAR_BACK_W = 1.5;   // 🔒 ユーザー 2026-09-09「ピンヘッダー側の 2mm 程度は床が平。そこで繋げれば小細工がそもそもいらない」: 橋を足の芯の列から +Y へ逃がして「コ」の字にし、足の裏から上面まで通しで結ぶ（張り出しを作らない）。
//    板の上の障害物（模型で実測・足と足のあいだ x 34.2〜43.8）: y 23.90〜31.17 高 4.09 ／ 31.65〜38.15 高 1.00 ／ 39.90〜43.10 高 1.10 ／ 51.33〜59.87 高 2.82（I2C ヘッダ）。
//    ⚠ y 38.15〜39.90 の 1.75 のすき間は模型では空だが、実物は抵抗が載っている（🔒 ユーザー 2026-09-09「抵抗がある」）。通せるのは y 43.5〜51.0 の側だけ
INA_BAR_POCKET = 2.4;   // 🔒 ユーザー 2026-09-10「ダボ穴が浅すぎる」: 1.6 → 2.4（足 3.1、右のダボの下に 0.7 残す）。帯 B のダボも同じ回で伸ばす。   // 🔒 ユーザー 2026-09-09「天板棒→棒の凹み→小帯ダボ→小帯凹み→帯Bダボ」: 小帯の下面の凹みの深さ（貫通させない。残り肉 1.5）
INA_BAR_CB_D = 4.0;
INA_BAR_CB_H = 0.4;
INA_BAR_VENT_D = 1.5;   // 🔒 ユーザー 2026-09-10「どっちも入りましたが D はダボがすこし斜めになりました。なので C で」: 凹みの天井から真上へ抜く φ1.5（右は上のダボの中を通る）。✅ 実機 2026-09-10: C（凹み 3.35・ダボ 2.9・抜き穴 1.5）と D（横穴）はどちらも帯 B のダボに入った。吸盤が原因だった
INA_BAR_WEB = 2.6; INA_BAR_CH = 0.4; INA_BAR_FIL = 0.8; INA_BAR_RND = 0.5;
// ↑ 見た目だけの値（🔒 ユーザー 2026-09-10「板と円柱をくっつけただけみたいなダサさ」）。腕と橋の高さ 2.6（足 3.1 より低くして段を出す）・
//   足の上の縁の面取り 0.4（右の足は φ5.2 の平らが残る。天板の棒 φ4.8 より広いので面接触はそのまま）・
//   入り隅の丸み 0.8（腕↔足・腕↔橋）・外の角の丸み 0.5（橋の幅 1.5 の半分 0.75 より小さくする。これを超えると橋が消える）
// ↑ 小帯の凹みの口のザグリ（径 3.6・深さ 0.4）。🔴 2026-09-10 実機: 帯 B のダボ φ2.75 がこの凹み（φ3.0）に入らなかった。
//   同じ差 0.25 でも、小帯の上のダボ φ2.75 → 天板の棒の穴 φ3.0 は入っている（✅ ユーザー 2026-09-10）。違いは向きで、
//   この凹みだけが print_inabar でプレートに接する面に開いている。docs/PRINT.md §2「プレート側の穴は初層で塞がる。ザグリで浮かせること」を
//   落としていた（初層 5 層 = 0.25mm）。効く φ3.0 の区間を 0.4 上から始める。ダボが入るのは左 1.0・右 1.3 なので掛かりは足りる
// 🔴 2026-09-09 実機: φ2.8 のダボが小帯（穴 φ3.0）にも天板の棒（穴 φ3.0）にも刺さらなかった。この機の嵌め合いは as5600_holder.scad:162〜170 の実測が持っていて、
//    穴 φ3.35 に対しダボ 3.1 が良い・3.2 は入らない → 一般則「差し込みのほぞ径 = 穴 − 0.25」＋先端の面取り 0.5。ここは差 0.2・面取り無しでその規則を外していた（私が置いた数字）。
//    直しは**ダボ側だけ**（穴を広げると刷り直したばかりの天板の棒が変わる）: φ2.8 → 2.75（差 0.25）・先に 0.5 の面取り。帯 B だけ刷り直せば済む
INA_PEG_D = 3.0; INA_PEG_CH = 0.5;   // 🔒 ユーザー 2026-09-10「帯 B 触るならダボ径をもう少し厚く。電流計の穴は 3.2 くらい」: 2.75 → 3.0（板の穴 3.2 に 0.2）   // ダボの径（板の穴 φ3.0 − 嵌め代 0.25）・先の面取り
INA_BAR_HOLE_D = fit_hole_down(INA_PEG_D);   // 設計 3.1 / 印刷 3.5。小帯の凹みは口がプレート側の止まり穴なので ダボ + 0.5（parts/fit.scad・🔒 2026-09-10 ゲージ）。旧: 3.0 → 3.35（C）→ 数式
INA_PEG_H_R = ina_size()[2] + INA_BAR_POCKET - 0.3;   // 右のダボ 2.9（板 1.6 ＋ 小帯の凹み 1.6 − 0.3）。🔒 ユーザー 2026-09-09「連動ダボと小帯のダボの長さを 0.3 づつ減らせ」: 先に 0.3 の空きを残す
INA_PEG_H_L = ina_size()[2] + INA_BAR_POCKET - 0.3;   // 左も 3.7（2026-09-10。凹み 2.4 に対して先の空き 0.3。突き当てないのは同じ）。旧 +1.0:              // 左のダボ 2.6（板 1.6 ＋ 凹みへ 1.0）。🔒 ユーザー 2026-09-09「上に棒が無いので柱に入らない。右と連動させるな」: 位置決めだけ。突き当てない
INA_PEG_IN = 2.0;                                              // 🔒 ユーザー 2026-09-08「帯のダボは小帯を貫通して天井の棒に刺さるイメージ」: 右のダボは小帯を抜けて天板の棒の先の穴に 2.0 入る
INA_LEG_D = 4.8; INA_LEG_PLAY = 0;   // 天板の棒 φ4.8（先の穴は下の INA_LEG_HOLE_D）。棒の先と小帯の上の遊び 0。⚠ 棒はつまみの台座の壁（x 48.7）に 0.5 重なるが同じ天板なので溶け合うだけ
INA_BAR_PEG_D = 2.9;   // 🔒 ユーザー 2026-09-10「天板との噛み合いは 2.9 ですね」（A/B の試し刷りで 2.8 と 2.9 を比べた。刷った棒の穴 φ3.0 に 2.75 はブラブラ）。小帯の上のダボ（刷った棒の穴 φ3.0 と同軸・嵌め代 0.25）
INA_BAR_PEG_H = INA_PEG_IN + 0.2 - 0.3;   // 1.9 小帯の上のダボ（刷った棒の穴の深さ 2.2 − 0.3）。同上
INA_LEG_HOLE_D = fit_hole_up(INA_BAR_PEG_D);   // 設計・印刷とも 3.0（初層に無いので打ち消し無し）。天板の棒の穴は口が上の止まり穴なので ダボ 2.9 + 0.1（parts/fit.scad）。刷った天板（2026-09-09-1413）も 3.0
INA_TOP_Z = BAT_TOP + STRAP_T + ina_size()[2];             // 板の上面 36.975
INA_LEG_AT = INA_HOLES_W[1];
INA_BAR_Z0 = INA_TOP_Z; INA_BAR_TOP = INA_TOP_Z + INA_BAR_H;   // 小帯の裏（板の上面）と上面
// 🔴 2026-09-10 実機: プレートに口を向けた止まり穴は吸盤になる（ユーザー「吸盤かこれ」）。中のレジンが抜けずに固まり、
//    凹み φ3.0 でも φ3.35 でも φ2.75 のダボがまったく入らなかった（A/B の試し刷り）。眼鏡の頃の貫通穴は入っていた。
//    径ではなく「反対側が開いているか」。C は各凹みの天井から φ1.5 を真上へ抜いて空気とレジンの道を作る

// 🔒 ユーザー 2026-09-10「3mm のと 3.35mm のをそれぞれ作って刷る。3mm の方の小帯のダボは 2.8mm、3.35mm のダボは 2.9mm」
//   上のダボを太くするのは、刷った天板の棒の穴 φ3.0 に φ2.75 がブラブラだったから（実機 2026-09-10）
echo(str("INA hold: 板の穴 ", INA_HOLES_W, " / 帯 B のダボ ", INA_HOLES_W, " d ", INA_PEG_D, " h 左 ", INA_PEG_H_L, " 右 ", INA_PEG_H_R, " / 小帯 Z ", INA_BAR_Z0, "-", INA_BAR_TOP, " 足 d ", INA_BAR_FOOT_D, " 凹み d ", INA_BAR_HOLE_D, " 深さ ", INA_BAR_POCKET, " / 上のダボ ", INA_LEG_AT, " d ", INA_BAR_PEG_D, " h ", INA_BAR_PEG_H, " / 刷った棒 ", INA_LEG_AT, " 穴 d ", INA_LEG_HOLE_D, " 深さ ", INA_PEG_IN + 0.2, " / 小帯の上面から PB の裏まで ", Z_TOP - PB_CEIL_SO - INA_BAR_TOP));
// ---- 帯 1 本だけ・刷る向き ----
//   strap_one(k): 帯 k（ツバ込み・その帯の上に立つ電流計の軸込み）。straps() を Y の板で切る（v4 strap_one と同じ切り方・ツバ TAB_L のぶん広げる）
//   strap_print(k): 直置き（組んだ姿勢のまま・足の裏とツバの裏が Z 0。🔒 ユーザー 2026-09-03「帯については浮かすのも傾けるのもやめましょう。柱を立てる方のパイプラインで」）。
//     天板の裏（足と足の間 36mm のアーチ）は tools/props_gen.py が立てる柱（props_strap_*）と 0.3 のラフト（raft_strap_*）で受ける。電流計の軸は上を向くので支えは要らない
// PowerBoost のダボ（天板の裏から部品面まで下りる胴 φ5.8・高さ 5.7、軸 φ2.0 が板の穴 φ2.4 を下へ貫いて E リング）。天板を描くとき天板に union する
PB_DOWEL_D = 4.0;   // ダボの胴の径（板のそば）。5.8 だと足元が板の上の小さな部品（0.6〜0.7）に 2.8mm³ 乗る。4.0 で 0（2026-09-05）
// 🔒 ユーザー 2026-09-07「PowerBoost はネジとナットでいいよ」: E リングの軸（首 1.5）は嵌めると割れた。胴に通し φ2.5、板の裏から M2×8、ナットは胴の上の横穴（上に肉 0.7・天板が続く）。
//   胴は板から PB_BOSS_LO の間は φ4（部品を避ける）、その上は φ7（ナットの角 4.97 を包む）。溝の口は 4 本とも −X（2026-09-08。右の穴を +X に向けるとつまみの台座に塞がれる）
PB_BOSS_D2 = 8.0; PB_BOSS_LO = 2.8; PB_NUT_SKIN = 0.7;   // 2026-09-08: 胴 7.0 → 8.0（口を片側に閉じると閉じた側でナットの角と胴の外面の肉が 0.35 になる。8.0 で消える）、細い部分 1.5 → 2.8（8.0 だと左後ろの穴のそばの部品の頭（板の裏から 3.1〜4.1）に 0.43mm³ 乗る。2.8 まで φ4 で逃げて 0）
PB_SCR_HEAD_D = 3.8; PB_SCR_HEAD_H = 1.4;   // M2 なべ頭（板の裏に載る）
module pb_mount() color("#c9d0d8") at_pb() difference() {
    for (h = pb_mount()) translate([h[0], h[1], pb_pcb_t()]) { cylinder(d = PB_DOWEL_D, h = PB_BOSS_LO + 0.01); translate([0, 0, PB_BOSS_LO]) cylinder(d = PB_BOSS_D2, h = PB_CEIL_SO - pb_pcb_t() - PB_BOSS_LO + 0.01); }
    for (h = pb_mount()) let (sx = +1) translate([h[0], h[1], 0]) {   // 🔴 2026-09-08 実機: 右の 2 本（世界 X 43.5）の口が +X を向いていて、つまみの台座の壁（X 48.7）まで 1.7 しか無くナットが入らない（ユーザー「つまみの台座に干渉してる」）。4 本とも口を世界の −X へ ＝ 枠が 180° 回っているので局所は +x。右の 2 本は PowerBoost の板の上の空へ、左の 2 本は左の壁まで 6.9
        translate([0, 0, -1]) cylinder(d = SCR_D, h = PB_CEIL_SO + 2, $fn = 24);
        hull() for (k = [0, sx * 10]) translate([k, 0, PB_CEIL_SO - PB_NUT_SKIN - NUT_T]) rotate([0, 0, -30]) hex_pocket(NUT_AF, NUT_T);   // 二面幅を Y に・口は X の外へ
    }
}
echo(str("PB screw: board ", pb_pcb_t(), " + boss ", PB_CEIL_SO - pb_pcb_t(), " = ", PB_CEIL_SO, " / nut Z ", PB_CEIL_SO - PB_NUT_SKIN - NUT_T, "-", PB_CEIL_SO - PB_NUT_SKIN, " above the board back / M2x8 tip at 8.0 -> engages ", min(8.0, PB_CEIL_SO - PB_NUT_SKIN) - (PB_CEIL_SO - PB_NUT_SKIN - NUT_T), " of nut ", NUT_T));

// 前板の脚を受ける床の溝（v4 floor_v4 の「ブリッジの前の脚の受け溝」と同じ形。🔴 2026-09-07 実機: v5 の床に彫っていなかった。ユーザー「あれの溝がどこにもない。v4 は床にあった」）
//   脚（厚み 2.0・幅 23）の前後 ±0.25 を空け、前の壁 1.6・後ろの壁はハブの前縁（Y 15.9）から 0.3 逃げた残り 0.45・高さ 2.5。X は脚の両端に 0.5 の空きと 1.0 の壁
FPG_H = 2.5; FPG_CL = 0.25; FPG_WF = 1.6; FPG_XCL = 0.5; FPG_XW = 1.0;
FPG_Y0 = FP_Y0 - FPG_CL - FPG_WF;                 // 溝の塊の前端 11.05
FPG_Y1 = HUB_AT[1] - 0.3;                          // 溝の塊の後端 15.6（ハブの前縁 15.9 の 0.3 手前）
echo(str("FP groove: leg Y ", FP_Y0, "-", FP_Y0 + BRG_T, " / slot Y ", FP_Y0 - FPG_CL, "-", FP_Y0 + BRG_T + FPG_CL, " / block Y ", FPG_Y0, "-", FPG_Y1, " (rear wall ", FPG_Y1 - (FP_Y0 + BRG_T + FPG_CL), ") H ", FPG_H));   // ASCII only: the manual generator decodes OpenSCAD output with cp932
// 前板そのもの（別部品・v4 brg_front）。断面 Y-Z を X に押し出す

// ============================================================
// 皮（v4 と同じ板 6 枚。壁 2.0・天板 2.5。口は v4 の一覧のとおり・開口の縁はベベル 1.0）
// ============================================================
PORT_BEV = 1.0;    // 口の縁のベベル（v4 PORT_BEV）
FRONT_DY = nylon() ? -0.2 : 1.0;    // ナイロン −0.2（2026-09-16）: 前の壁は底パーツの一部で動かないので、OLED は真上から降ろすしかなく、ガラスを壁の穴の中に入れられない（−Y の押し込みが要る）。ガラスの面（Y 0）を壁の内面の 0.2 後ろに置く。外面からの奥まりは 1.6 ＋ 0.2 ＝ 1.8 で、レジン（2.8 − 1.0）と同じ数字   // 🔒 v4 2026-08-25 ユーザー「板の位置を y−1」: フロント板を 1.0 後ろへ寄せ、OLED のガラスの面（Y 0）が外面の 1.0 奥に来る（黒枠は窓を素通りして前へ 1.0 出る）
OUT_X0 = LW_X - WALL; OUT_X1 = IN_X + WALL; OUT_Y0 = -FRONT_T + FRONT_DY; OUT_Y1 = IN_Y + HATCH_T;
// 角穴＋外面のベベル。c = 穴の中心（板の厚みの中央）・w, h = 板の面内の [横, 縦]・t = 板厚・axis = 板の法線 "x"|"y"・外面は法線の +側
PORT_R = 1.2;      // 口の角の丸み（v4 USBC_PORT_R）。🔴 2026-09-05 まで角の立った長方形で切っていた（ユーザー「何で四角いの」）
module port_rr(sz, r, g = 0) hull() for (a = [-1, 1], b = [-1, 1]) translate([a * (sz[0] / 2 - r), b * (sz[1] / 2 - r)]) circle(r = r + g, $fn = 40);   // 角丸の四角（2D）。g で外へ広げる
// 口: 角丸の四角を板に貫通させ、外面に 45° のベベル（PORT_BEV）。axis "x": w は Y・h は Z、外面は +X ／ axis "y": w は X・h は Z、外面は +Y
module port_cut(c, w, h, t, axis) {
    translate(c) rotate(axis == "x" ? [90, 0, 90] : [-90, 0, 0]) {   // 2D の x → Y（"x"）/ X（"y"）・押し出しは外向き
        translate([0, 0, -t / 2 - 1]) linear_extrude(t + 2) port_rr([w, h], PORT_R);
        hull() { translate([0, 0, t / 2 - PORT_BEV]) linear_extrude(0.01) port_rr([w, h], PORT_R); translate([0, 0, t / 2 + 1.0]) linear_extrude(0.01) port_rr([w, h], PORT_R, PORT_BEV + 1.0); }
    }
}
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
