n416/katanori/hardware/icons/icon_gear_wrench.scad

// icon_gear_wrench.svg から自動生成（hardware/gen_icon_svg.py）。直接いじらない
// 線を「点と点のあいだの hull」で描く。角と端は丸（元の stroke-linejoin/cap と同じ）
function icon_gear_wrench_size() = [72.500, 72.500];   // 線の太さ込みの外形（SVG 単位）
function icon_gear_wrench_sw()   = 5.000;           // 元の線の太さ（SVG 単位）
ICON_GEAR_WRENCH_PATHS = [
  [[-4.96,25.52], [-4.14,33.75], [4.14,33.75], [4.96,25.52], [6.23,25.24], [7.49,24.9], [8.73,24.49], [9.95,24.02], [11.14,23.49], [12.31,22.9], [13.44,22.26], [14.54,21.55], [20.93,26.79], [26.79,20.93], [21.55,14.54], [22.26,13.44], [22.9,12.31], [23.49,11.14], [24.02,9.95], [24.49,8.73], [24.9,7.49], [25.24,6.23], [25.52,4.96], [33.75,4.14], [33.75,-4.14], [25.52,-4.96], [25.24,-6.23], [24.9,-7.49], [24.49,-8.73], [24.02,-9.95], [23.49,-11.14], [22.9,-12.31], [22.26,-13.44], [21.55,-14.54], [26.79,-20.93], [20.93,-26.79], [14.54,-21.55], [13.44,-22.26], [12.31,-22.9], [11.14,-23.49], [9.95,-24.02], [8.73,-24.49], [7.49,-24.9], [6.23,-25.24], [4.96,-25.52], [4.14,-33.75], [-4.14,-33.75], [-4.9,-26.12]],
  [[-26.12,-4.9], [-33.75,-4.14], [-33.75,4.14], [-25.52,4.96], [-25.24,6.23], [-24.9,7.49], [-24.49,8.73], [-24.02,9.95], [-23.49,11.14], [-22.9,12.31], [-22.26,13.44], [-21.55,14.54], [-26.79,20.93], [-20.93,26.79], [-14.54,21.55], [-13.44,22.26], [-12.31,22.9], [-11.14,23.49], [-9.95,24.02], [-8.73,24.49], [-7.49,24.9], [-6.23,25.24], [-4.96,25.52]],
  [[-31.11,-22.63], [-13.96,-5.48], [-14.39,-4.24], [-14.7,-2.98], [-14.9,-1.69], [-14.99,-0.39], [-14.97,0.92], [-14.84,2.21], [-14.59,3.49], [-14.23,4.75], [-13.76,5.97], [-13.19,7.14], [-12.52,8.26], [-11.76,9.32], [-10.9,10.3], [-9.97,11.21], [-8.95,12.03], [-8.31,12.48], [-7.65,12.9], [-6.97,13.28], [-6.27,13.63], [-5.55,13.94], [-4.81,14.21], [-4.06,14.44], [-3.3,14.63], [-2.54,14.78], [-1.76,14.9], [-0.98,14.97], [-0.2,15], [0.58,14.99], [1.36,14.94], [2.14,14.85], [2.91,14.71], [3.68,14.54], [4.43,14.33], [-2.83,7.07], [7.07,-2.83], [14.33,4.43], [14.6,3.42], [14.81,2.4], [14.94,1.36], [15,0.32], [14.98,-0.72], [14.9,-1.76], [14.74,-2.79], [14.51,-3.81], [14.21,-4.81], [13.84,-5.79], [13.4,-6.74], [12.9,-7.65], [12.34,-8.53], [11.72,-9.37], [11.04,-10.16], [10.3,-10.9], [9.52,-11.59], [8.69,-12.23], [7.82,-12.8], [6.68,-13.43], [5.73,-13.86], [4.75,-14.23], [3.75,-14.52], [2.73,-14.75], [1.7,-14.9], [0.66,-14.99], [-0.39,-14.99], [-1.43,-14.93], [-2.47,-14.8], [-3.49,-14.59], [-4.49,-14.31], [-5.48,-13.96], [-22.63,-31.11], [-23.17,-31.6], [-23.77,-32.01], [-24.23,-32.26], [-24.71,-32.47], [-25.2,-32.63], [-25.71,-32.76], [-26.22,-32.83], [-26.74,-32.87], [-27.36,-32.85], [-27.88,-32.78], [-28.49,-32.65], [-28.98,-32.49], [-29.46,-32.28], [-29.92,-32.04], [-30.36,-31.75], [-30.77,-31.43], [-31.22,-31], [-31.56,-30.61], [-31.93,-30.1], [-32.19,-29.65], [-32.41,-29.18], [-32.59,-28.69], [-32.72,-28.19], [-32.82,-27.67], [-32.87,-27.05], [-32.86,-26.53], [-32.81,-26.01], [-32.71,-25.5], [-32.57,-25], [-32.39,-24.51], [-32.16,-24.04], [-31.9,-23.6], [-31.6,-23.17], [-31.19,-22.7], [-31.11,-22.63]],
];
module icon_gear_wrench(sw = 5.000) {
    for (p = ICON_GEAR_WRENCH_PATHS) for (i = [0 : len(p) - 2])
        hull() { translate(p[i]) circle(d = sw, $fn = 16); translate(p[i+1]) circle(d = sw, $fn = 16); }
}
