n416/katanori/hardware/icons/icon_headphone.scad

// icon_headphone.svg から自動生成（hardware/gen_icon_svg.py）。直接いじらない
// 線を「点と点のあいだの hull」で描く。角と端は丸（元の stroke-linejoin/cap と同じ）
// 塗りの付いていた path は polygon でも描く（塗り ＋ 線）
function icon_headphone_size() = [41.058, 30.613];   // 線の太さ込みの外形（SVG 単位）
function icon_headphone_sw()   = 2.181;           // 元の線の太さ（SVG 単位）
ICON_HEADPHONE_PATHS = [
  [[-14.216,-0.193], [-14.157,1.118], [-13.984,2.397], [-13.701,3.637], [-13.315,4.835], [-12.829,5.984], [-12.249,7.079], [-11.58,8.117], [-10.827,9.09], [-9.996,9.996], [-9.09,10.827], [-8.117,11.58], [-7.079,12.249], [-5.984,12.829], [-4.835,13.315], [-3.637,13.701], [-2.397,13.984], [-1.118,14.157], [0.193,14.216], [1.505,14.157], [2.784,13.984], [4.024,13.701], [5.221,13.315], [6.37,12.829], [7.466,12.249], [8.504,11.58], [9.477,10.827], [10.383,9.996], [11.214,9.09], [11.967,8.117], [12.636,7.079], [13.216,5.984], [13.701,4.835], [14.088,3.637], [14.371,2.397], [14.544,1.118], [14.603,-0.193]],
  [[-12.282,-14.216], [-13.724,-14.071], [-15.068,-13.654], [-16.283,-12.994], [-17.342,-12.12], [-18.216,-11.061], [-18.876,-9.845], [-19.293,-8.502], [-19.438,-7.06], [-19.293,-5.617], [-18.876,-4.274], [-18.216,-3.058], [-17.342,-1.999], [-16.283,-1.126], [-15.068,-0.466], [-13.724,-0.049], [-12.282,0.097], [-12.282,-14.216], [-12.282,-14.216]],
  [[12.282,0.097], [13.724,-0.049], [15.068,-0.466], [16.283,-1.126], [17.342,-1.999], [18.216,-3.058], [18.876,-4.274], [19.293,-5.617], [19.438,-7.06], [19.293,-8.502], [18.876,-9.845], [18.216,-11.061], [17.342,-12.12], [16.283,-12.994], [15.068,-13.654], [13.724,-14.071], [12.282,-14.216], [12.282,0.097], [12.282,0.097]],
];
ICON_HEADPHONE_FILLS = [
  [[-12.282,-14.216], [-13.724,-14.071], [-15.068,-13.654], [-16.283,-12.994], [-17.342,-12.12], [-18.216,-11.061], [-18.876,-9.845], [-19.293,-8.502], [-19.438,-7.06], [-19.293,-5.617], [-18.876,-4.274], [-18.216,-3.058], [-17.342,-1.999], [-16.283,-1.126], [-15.068,-0.466], [-13.724,-0.049], [-12.282,0.097], [-12.282,-14.216]],
  [[12.282,0.097], [13.724,-0.049], [15.068,-0.466], [16.283,-1.126], [17.342,-1.999], [18.216,-3.058], [18.876,-4.274], [19.293,-5.617], [19.438,-7.06], [19.293,-8.502], [18.876,-9.845], [18.216,-11.061], [17.342,-12.12], [16.283,-12.994], [15.068,-13.654], [13.724,-14.071], [12.282,-14.216], [12.282,0.097]],
];
module icon_headphone(sw = 2.181) {
    for (p = ICON_HEADPHONE_FILLS) polygon(p);
    for (p = ICON_HEADPHONE_PATHS) for (i = [0 : len(p) - 2])
        hull() { translate(p[i]) circle(d = sw, $fn = 16); translate(p[i+1]) circle(d = sw, $fn = 16); }
}
