n416/katanori/hardware/icons/icon_wrench_u.scad

// hardware/uuu.png（ユーザーが貼ったスクリーンショット）の輪郭から起こした。
// 🔒 2026-09-04 ユーザー「私の絵から SVG つくれ」「これでやれもう」。
//    uuu.png のオレンジの領域を cv2 で輪郭化 → uuu.svg → ここ。
//    元の位置に描き戻して画素で照合し 99.25% 一致を確認済み。
//    SVG は Y が下向きなので、ここでは Y を反転してある（軸の約束の違いだけ・形は同じ）。
//    単位は uuu.png の画素。原点は外形の中心。外形は 204.750 角。
// 🔴 2026-09-04 点を 90 度回して焼き込んだ（(x, y) -> (-y, x)）。
//    元は口が右下を向いていた。原因は、トレース元にした uuu.png が裏から撮った絵だったこと。
//    ユーザー「rotate([0,0,90]) って入れる前に原本が 90 度回ってるのがおかしいんじゃないの」。
//    呼ぶ側で回すと、回し忘れた呼び出し（icon_gauge.scad）と 90 度ずれる。原本で直すのが正しい。
//    🔒 これで素のまま **口が右上**（icon-orientation-truth の基準）。
function icon_wrench_u_span() = 204.750;
// 🔒 2026-09-04 輪郭を平滑化済み（`python hardware/_wrench_smooth.py 6.0`）。
//    画素の階段と手の震えだけを落とし、外形は 204.750 角へ正規化し直してあるので大きさは不変。
//    平滑化前の生の輪郭は _icon_wrench_u_raw.bak と git 履歴に残してある。
ICON_WRENCH_U_PTS = [
  [-94.023, -91.693],
  [-90.566, -94.982],
  [-86.140, -98.011],
  [-81.294, -100.285],
  [-76.746, -101.589],
  [-72.095, -102.198],
  [-66.843, -102.054],
  [-61.644, -101.098],
  [-56.633, -99.374],
  [-53.458, -97.783],
  [-50.418, -95.873],
  [-47.019, -93.320],
  [-43.292, -90.084],
  [-37.004, -83.976],
  [6.067, -40.766],
  [10.149, -36.978],
  [13.491, -34.535],
  [16.553, -33.110],
  [19.816, -32.419],
  [23.249, -32.322],
  [32.924, -32.823],
  [38.484, -32.731],
  [45.153, -32.042],
  [51.612, -30.714],
  [57.885, -28.719],
  [64.579, -25.785],
  [70.982, -22.183],
  [76.972, -18.018],
  [80.730, -14.909],
  [84.207, -11.470],
  [87.349, -7.740],
  [90.536, -3.306],
  [93.414, 1.344],
  [95.959, 6.221],
  [97.873, 10.708],
  [99.574, 15.870],
  [100.955, 21.717],
  [101.918, 27.669],
  [102.329, 32.514],
  [102.305, 37.392],
  [101.675, 43.422],
  [100.623, 48.701],
  [99.120, 53.105],
  [97.411, 55.982],
  [95.934, 57.552],
  [94.654, 58.487],
  [93.246, 59.180],
  [91.743, 59.609],
  [90.178, 59.763],
  [88.587, 59.641],
  [87.004, 59.257],
  [84.942, 58.379],
  [81.528, 56.073],
  [77.417, 52.336],
  [67.328, 42.240],
  [59.283, 33.175],
  [56.223, 30.371],
  [53.308, 28.552],
  [50.685, 27.647],
  [47.972, 27.408],
  [45.274, 27.864],
  [42.178, 29.239],
  [39.316, 31.310],
  [36.733, 33.852],
  [34.132, 37.224],
  [32.348, 40.370],
  [31.122, 43.679],
  [30.637, 47.064],
  [30.884, 49.872],
  [31.688, 52.615],
  [32.933, 55.266],
  [34.823, 58.321],
  [38.062, 62.701],
  [43.541, 69.118],
  [54.497, 79.979],
  [56.463, 82.302],
  [58.111, 84.730],
  [59.417, 87.785],
  [59.713, 89.349],
  [59.739, 90.907],
  [59.169, 93.408],
  [58.471, 94.796],
  [57.533, 96.063],
  [55.520, 97.856],
  [53.084, 99.238],
  [49.818, 100.433],
  [45.759, 101.365],
  [40.946, 101.989],
  [36.017, 102.235],
  [30.439, 102.148],
  [24.957, 101.648],
  [20.795, 100.946],
  [16.127, 99.837],
  [12.115, 98.583],
  [8.188, 97.035],
  [4.366, 95.216],
  [0.134, 92.863],
  [-4.453, 89.923],
  [-8.377, 87.065],
  [-11.656, 84.333],
  [-14.721, 81.346],
  [-17.529, 78.126],
  [-20.099, 74.737],
  [-22.793, 70.704],
  [-25.238, 66.496],
  [-27.373, 62.119],
  [-28.933, 58.188],
  [-31.134, 50.731],
  [-32.703, 42.478],
  [-33.145, 38.266],
  [-33.267, 34.630],
  [-32.536, 23.817],
  [-32.544, 20.896],
  [-32.835, 18.622],
  [-33.261, 16.968],
  [-33.876, 15.368],
  [-34.975, 13.322],
  [-37.100, 10.424],
  [-40.875, 6.318],
  [-89.323, -42.142],
  [-92.599, -45.852],
  [-95.217, -49.230],
  [-97.540, -52.762],
  [-99.233, -55.934],
  [-100.955, -60.378],
  [-102.015, -65.021],
  [-102.375, -69.777],
  [-102.005, -74.531],
  [-100.948, -79.181],
  [-99.251, -83.660],
  [-96.931, -87.877]

];
module icon_wrench_u() polygon(ICON_WRENCH_U_PTS);
