n416/katanori/hardware/parts/btn_v61.scad

include <mat.scad>   // nylon() / mat_name()。スイッチは case_v6_1.scad 先頭の MAT（$mat で届く）
$mat = is_undef($mat) ? "resin" : $mat;   // 🔴 単体で開く・書き出すときの既定（-D '$mat="nylon"' で上書き）。case から use されたときは呼び出し側の $mat を引き継ぐ。無いと -D が末尾に付いて上の代入が resin のまま焼かれる（2026-09-16 に踏んだ）
function btn_mat() = mat_name();
// ============================================================
// 会話ボタン v6.1n — parts/btn_v3.scad の写し（v6.1n・MJF ナイロン用）
//   🔒 ユーザー 2026-09-14: v5 と共用のファイルは触らない。ナイロン用の直しはこの写しだけに入れる。
//   MJF PA12（JLC3DP）: 公差 ±0.3・穴の公差 ±0.3・組む隙間 0.76 以上・最小肉 1.0
// ============================================================
// 🔒 2026-09-07 本番。btn_v3_trial.scad（試し刷り 0537・1632 で決めた形）をそのまま本番に戻した物（ユーザー「会話ボタンの再設計を行いました。バスタブはテストで印刷したものを使えるので押し子を追加」）。刷る押し子は print_piston2（根元寄りの線・P2_CUT 0.8・台形の足）。バスタブは 0537 の物
//   直した所（ユーザー 2026-09-07 実物）: ①レバーの曲がり始めは胴の端から 1.5（B3_BEND）。図面に寸法は無く、btn_v3 は端で描いていた
//   ⇒ 先が 6.75 → 8.25 に出るので、バスタブの内のりを先から 0.75 空ける形で出す（15.0 → 18.0・外形 21.2）
//   ⇒ 外形が広がるとブロックの内面（B3_BLK_XI）も外へ出て、v5 で足した下側の内面 B3_BLK_XI2 は同じ値になり、ツバ 19.8 の通り道が 18.6 → 21.6 に戻る
//   ⇒ ヒンジが内へ寄ったぶん柱の所のてこ比が 0.696 → 0.585 になり、柱の出 1.6 では先がツバに 0.15 まで寄るので 1.9 に
//   ⇒ ブロックが薄くなるので縦ねじの芯を 13.1 → 13.28 に（ナットの溝の内側の肉 0.42 を残す）
//   刷る物は print_piston / print_tub の 2 点。STL は hardware/stl/trial/ に出す（v5 の STL は上書きしない）
// 🔒 2026-09-07 試し刷り（刷り台 0537: ミニ天板・バスタブ・押し子 1・押し子 2）の実機の結果（ユーザー）:
//   ・押し子 1 を設計の向き（ポッチが先端側・接点 4.35）で付ける … 押せない
//   ・押し子 2（根元側の線・接点 1.0・予圧 0.8・足 0.77）      … 押せない
//   ・押し子 1 を逆（ポッチが根元側・接点 −0.95）で付ける      … 押せて感触が良い（跳ね返りが強い）
//   ⇒ 深く当てた物ほど押せない。実物のレバーはこのファイルの直線（曲がり始め 1.5 から先端 10.5 へ一直線）より
//     接点の辺りで 1.0〜1.5 高い（正しい向きが押せない下限 1.0・逆が鳴る上限 1.5）。写真では根元で急に立ち上がる形。測ってはいない
//   ⇒ その後（同日）ユーザー: バスタブのねじを 2 周緩める（0.8 下げる）と押し子 2 も押せる。足の Y の端を台形に削ると長辺の縁の渋さも消えた
//   ⇒ 🔒 **決定「これで行く」**（ユーザー「0.8mm 押し子のバーを削る・足を台形にする」）: 押し子 2 の線を 0.8 短く（P2_CUT）・足の端を台形。バスタブは 0537 の物のまま。
//     逆付けの押し子 1 は同じ深さで偶然合っていた物。模型（scratchpad/btn_sim*.py）はレバーを 0.8〜1.0 上げて合わせ直すこと
use <parts.scad>   // 借りるのは DAOKAI マイクロスイッチの実測値（msw_*）と絵（microswitch_daokai）だけ。
                   //   `use` なので変数は入って来ない。世界の座標（BTN4 / Z_TOP）もここには一切無い。
// ============================================================
// 📦 btn_v3.scad — 会話ボタン v3（レバー式マイクロスイッチ・2026-08-30）
//    原点 = ボタンの芯 ／ z = 0 は天板の外面 ／ +Z が外（空の方）
//    刷る物 2 点（押し子・バスタブ）。買い物 0（M2 x 4 とナット x 4 は手持ち）。
// ============================================================
//
// ============================================================
// ✅ 実機で確かめた（2026-08-31・btntest 初刷り・レジン①）
//   ・押し心地 … ユーザー「最高。これは凄い」。指の動く量 1.44mm でクリック、
//     残り 0.51mm はツバの部屋の底が受ける（レバーは押し切られない）
//   ・抜けない … ✅ 引いても抜けない（ツバの掛かり 片側 0.5 → 焼いて 0.8）
//   ・落ちない … ✅ 押しても中へ落ちない（ツバ 19.8 ＞ バスタブの内のり 15.0）
//   ・ツバの下面 … ✅ **支え無しで荒れない**（片側 0.9mm の庇・7.56mm2 は垂れなかった）。
//     押し子には柱もラフトも付けない（顔を下にして刷るので跡が縁に残るため）
//   ・傾き … ✅ 約 12° 傾くが引っかからない。ユーザー「傾いても押せてきもちいい」
//   ⇒ **この 4 つはもう検討し直さなくてよい。**
// ============================================================
//
// ■ v2 が死んだ理由
//   天板の **1 つの穴が、ツバを「通す」役と「引っ掛ける」役を兼ねていた。**
//   通れば抜け、抜けなければ通らない。実機 2026-08-30「押し子が落ちない」→「落とせるように
//   したら抜け放題」は、この 1 点から出た症状で、隙間の詰め方の問題ではなかった。
//
// ■ v3 の作り —— 🔒 ユーザー案（2026-08-30・スケッチあり）
//   **押し子を下から通す。** 頭は天板の口を下から抜けて外に出る。ツバは口より広いので
//   **天板の肉そのものの裏に掛かる**。抜け止めに追加部品は要らない。
//   筒は天板から切り離して**バスタブ**（別部品）にし、天板の裏から下ろした**ブロック 2 個**
//   （＝羊羹 2）へ、**下から縦ねじ 2 本**で引き上げて留める。
//
//   組む姿勢: **天板を裏返して机に置く**（箱の中で見えないままやる作業をゼロにする）
//   ① 裏返した天板の口へ押し子を落とす（重力で座る）
//   ② バスタブにマイクロスイッチをねじ止め（M2 x 2）… **机の上・単体でできる**
//   ③ ブロックのナットを横から差す（2 個）
//   ④ バスタブを載せ、下（＝机の上では上）から M2 x 2 を耳に通してナットへ締める
//
//   落ちない … ツバ 19.8 はバスタブの内のりより広い。**中へ入る道が無い**
//   抜けない … ツバ 19.8 は天板の口 18.8 より広い。**外へ出る道も無い**
//   押し心地 … バネはレジンではなく**スイッチのレバー自身**。てこ比 0.696
//   🔒 たわむ部品ゼロ・圧入ゼロ・接着ゼロ。docs/PRINT.md「レジン①で板バネは作れない」に触れない
//
// ■ 🔴 ここまでに潰した 3 つの間違い（同じ穴に落ちないため）
//   ① カバーを皿へ圧入 … 公差に頼る留め方。v2 で 4 回外したのと同じ性質。取り下げ
//   ② カバーに脚を生やして横ねじ … 2.4mm の板に脚と M2。薄すぎる。取り下げ
//   ③ 横ねじ 2 本を同じ軸に並べる … ユーザー指摘「ねじを支点にしたブランコになる」。その通り。
//      横ねじはバスタブを天板へ**押し付けない**ので、止まるのは摩擦だけだった
//   ⇒ 縦ねじだけが「バスタブを天板の裏へ**引き上げる**」向き。面 1 つ＋離れたねじ 2 本で決まる
//   🔴 ナットは「ねじの軸方向に掘ったポケット」に入れるものではない。**床の上に載せて、
//      締める力で床へ押し付ける**（横から差し込む溝）。ここを取り違えて一度縦ねじを取り下げた
//
// ■ 🔒 守っている条件
//   ① ネジを表面に出さない ⇒ 天面に出るのは押し子の頭だけ
//   ② 頭が AS5600 のつまみ（+5.5）より高くならない ⇒ 頭の天面は +3.0
//   ③ 🔒 **バスタブの上は全開**。スイッチはレバーごと上から落とすので天井側に張り出しを作らない
//   ④ 🔒 **留めは 2 か所**。1 か所で持たせない
//   ⑤ 🔒 **棚（本当の L 字）を作らない**（ユーザー「印刷的には棚の形状にしない方が良い」
//      「羊羹みたいな直方体が一番」）。ブロックは天板の裏に付く**薄い直方体**
//   ⑥ ねじの頭は耳の下面にザグって沈める。バスタブの底より下へは何も出ない（深さが増えない）
//      🔴 2026-08-30 ここに「🔒 耳はバスタブの一番上（ユーザーの絵）」と書いていたが、**指示ではない**。
//        ユーザー「耳はバスタブの一番上なんて指示はしてません。なんとなくその方が線の通りが
//        良いだろうと思ったから」。⇒ 🔒 を外す。耳の高さはブロックの厚みで決まる従属値
// ============================================================


// ============================================================
// 1. 印刷の見込み（🔒 docs/PRINT.md 実績値。ここを触ると全部の嵌め合いが動く）
// ============================================================
//   ✅ **2026-09-02 実機で確定**（ELEGOO・回 0540 の六角ゲージ）。
//     ユーザー「正直全部入るのでもういいです。５あたりで良いと思います」。印 5 = 二面幅 4.10。
//     ⚠ 測れたのは **A（上から落とす袋穴）だけ**。B（横差し）は口を連結棒で塞いでいて 1 個も
//       入らなかった（ゲージの設計ミス）。横差しの値は未測定のまま、同じ 4.10 を使っている。
B3_SHRINK   = nylon() ? 0.50 : 0.10;  // v6.1n: 0.10 → 0.50。レジンの実績 0.10 は自分の機械の話で、MJF は穴の公差が ±0.3。呼び 4.0 に対し二面幅 4.50 になる
B3_FIT_MOVE = 0.40;  // 動く所の片側の隙間。v6.1n でもこの値のまま（片側 0.40 ＝ 直径 0.80 で、JLC3DP の「組む隙間 0.76 以上」を満たす）
B3_FIT_POCK = 0.15;  // 金属を入れて動かさない所（見込みだけ）


// ============================================================
// 2. スイッチ（DAOKAI ヒンジストレートレバー 3PIN）
// ============================================================
B3_SW    = msw_size();          // [12.8, 5.8, 6.5] 胴
B3_BEND  = 1.5;                 // 🔒 ユーザー 2026-09-07 実物: レバーの曲がり始めは胴の端から 1.5（図面には無い寸法）
B3_HINGE = -B3_SW[0] / 2 + B3_BEND;   // -4.90 ヒンジ（COM 端子側 = -X の端から 1.5 内）
B3_PIN_LEN   = 3.5;             // ✅ 端子は図面のまま。ニッパーで詰める工程は無い
B3_SW_HOLE_Z = 2.0;             // ✅ 胴の底から取付穴の芯（ユーザー実測）

function b3_lever_z(x) = msw_bot_h() + (msw_act_h() - msw_bot_h()) * (x - B3_HINGE) / msw_lever_l();

B3_SW_DX = -0.35;   // 胴の位置は btn_v3 と同じに固定（ポケット・ねじ・端子・柱の位置を動かさない）。振りの中心を芯に置く式は捨てた
B3_TIP_X = B3_HINGE + msw_lever_l() + B3_SW_DX;      // +6.75 レバー先端（ボタンの芯から）

B3_PUSH_X = 3.0;                                     // てこ比を決める唯一のつまみ
B3_RATIO  = (B3_PUSH_X - B3_HINGE) / msw_lever_l();  // 0.696
B3_CLICK  = msw_click()  * B3_RATIO;                 // 1.74
B3_FULL   = msw_travel() * B3_RATIO;                 // 2.78


// ============================================================
// 3. 顔（天板の口・押し子）
// ============================================================
B3_PLATE_T = 2.5;    // 天板の厚み（case_base.scad の TOP_T と同じ値。ここは形だけを持つ）
// 🔒 2026-08-30 **皿（口の手前の浅い凹み）は廃止**。ユーザー「外のベベルを埋めるのが難しいと？」
//   つまみの顔は「口が板を真っ直ぐ貫いて、縁に 0.3 の面取り」だけ。私はその手前にもう 1 段
//   皿（深さ 0.8）を入れていたので段が 3 つになり、つまみと顔が違って見えていた。
//   ⇒ 皿を埋める。ツバが掛かる肉は 1.70 → **2.50**（板の全厚）に増える。
B3_LIP_T   = B3_PLATE_T;   // 2.50 ツバが掛かる肉の厚み（板の全厚）

// 🔒 2026-08-30 顔を 18.0 → 15.0 に縮めた。ユーザー「ボタンサイズを小さくすれば当たらないんじゃないの？」
//   実測: 顔 15.0 で INA226 の板への当たりが 0 になる（18.0 では 2.22）。買った物（INA226・
//   ReSpeaker 基板・OLED）が全部 0 になるのはこの位置・この寸法だけ。
//   ⚠ 下限は 14.0。ツバ（顔 +1.8）がバスタブの内のり 15.0 より広くないと押し子が中へ落ちる。
//   ⚠ Y へ逃がす案は成立しない: -1 から OLED に当たり始め、-3 で ReSpeaker の基板に 17mm 食い込む。
//   🔄 2026-08-30 **v2 と同じ 18.0 x 12.0 に戻した。**
//   🔴 それまで「顔は 15.0 が限界」と言っていたが、止めていたのは INA226 ではなく
//     **私が決めた 2 つの数字**だった（ユーザー「なんか引っかかるな」で判明）:
//       ① バスタブの ±X の壁 1.6 → 外形 18.2。ツバの部屋（顔 +2.6）がこれより広くなると
//          バスタブの天面が座に載れず、部屋の中に落ちる。だから顔が 15.6 で頭打ちに見えていた
//       ② 座の枠 3.6。座が外へ張り出して INA226 の板に届いていた
//     ⇒ 壁を 3.0（外形 21.0 ＞ 部屋 20.6）、枠を 1.2 にすれば **18 x 12 で全部 0**。実測済み。
B3_HEAD_L = 18.0; B3_HEAD_W = 12.0; B3_HEAD_OUT = 3.0;   // 頭（天面から +3.0 出る）
B3_OPN_L  = B3_HEAD_L + B3_FIT_MOVE * 2;                // 18.80 天板の口（頭が下から抜けて上下に滑る）
B3_OPN_W  = B3_HEAD_W + B3_FIT_MOVE * 2;                // 10.40
// 🔒 2026-08-30 ユーザー「ボタンのベベルがつまみの顔と異なるので**つまみを正として**揃えて」。
//   つまみは knob_v5.scad の ch_hole_top(DISH_D/2, 0, CH_S) ＝ **45°・0.3mm**（CH_S = 0.3）。
//   ここは 0.4 で描いていたので 0.3 に合わせる。⚠ 数字の出どころは knob_v5.scad の CH_S。
//   btn_v3 は筐体を読まない約束なので値は写しで持つ。あちらを変えたらここも直す。
B3_BEVEL  = 0.3;                                        // 皿の縁の面取り（つまみと同じ 45°・0.3）
// 🔒 つまみの顔は **2 段**だった（ユーザー「どう見ても 2 段ベベルです」）。
//   ① 天板の口の縁 … ch_hole_top(..., CH_S=0.3)
//   ② **つまみ自身の頭の角** … ch_top(..., GRIP_CH=0.8) ／ 裾の角は ch_bot(..., CH_S=0.3)
//   ボタンは①しか無く、頭の角が立っていた。つまみを正として②を入れる。
// 🔒 2026-08-30 ユーザー「斜めに押されてしまうのでレールが必要。多少の遊びは必要なのでゆるめに」。
//   🔴 リブで隙間を詰める案は**取り下げ**。滑る嵌め合いの製図値は片側 0.40（見込み 0.30 ＋ 滑り 0.10）が
//     下限で、リブでそれ以下にすると焼いた時点で噛む。**レールでは遊びを減らせない。**
//   ⇒ 減らせるのは遊びではなく**傾き**。効くのは「案内する長さ」なので、頭の断面を
//     ツバの部屋の底まで下ろして、案内の長さを 2.5 → 5.65mm にする（＝下の裾）。
B3_HEAD_CH = 1.2;   // 頭の天面の角（＝つまみの GRIP_CH）。🔒 ユーザー 2026-09-05「1.2 に」: 天面を下にして刷ると 0.8 の面取りが初期層のにじみと下向き面の Z ずれで埋まり、現物の角が立った
B3_HEAD_CB = 0.3;   // 頭の裾の角（＝つまみの CH_S）

// ツバ = 「抜けない」を持つ唯一の面。口より **X だけ** 広くする（Y へ広げない）
B3_CATCH = 0.5;                          // 掛かり（片側・呼び）。焼くと 0.8 になる
B3_FLG_L = B3_OPN_L + B3_CATCH * 2;      // 19.80
// 🔴 2026-08-30 ここを 9.0 の直書きにしていたため、顔を Y に縮めると口より広くなって
//   assert に当たり、「縮められない」ように見えていた。口から引く形にして顔に追従させる。
B3_FLG_W = B3_OPN_W - 1.4;               // Y は掛からない（口より片側 0.7 狭い）
B3_FLG_T = 1.2;

B3_TRAVEL   = 1.95;   // ハードストップ（レバーではなくツバの部屋の底が受ける）
B3_PILLAR_D = 3.4;    // レバーを押す柱の径
B3_PILLAR_H = 1.9;    // 柱の出。1.6 だとヒンジが内へ寄ったぶん先がツバに 0.15 まで寄る（assert 0.30）


// ============================================================
// 4. Z の積み上げ
// ============================================================
B3_Z_LIP_B = -B3_PLATE_T;                      // -2.50 天板の裏 ＝ ツバの座
B3_Z_FLG_B = B3_Z_LIP_B - B3_FLG_T;            // -3.70 ツバの下面（自由状態）
B3_Z_WIN_B = B3_Z_FLG_B - B3_TRAVEL - 0.10;    // -5.75 ツバの部屋の底 ＝ バスタブの上端
// 🔒 予圧: レバーが常にツバを天板の裏へ押し付けている状態にする（0 だとカタつく）
B3_PRELOAD  = 0.3;
B3_Z_SW_BOT = B3_Z_FLG_B - B3_PILLAR_H - b3_lever_z(B3_PUSH_X) + B3_PRELOAD;   // -14.14（バスタブは 0537 で刷った物のまま。レバーの較正は押し子の側 P2_CUT に入れる）
B3_Z_SW_TOP = B3_Z_SW_BOT + B3_SW[2];          // -7.785
B3_SKIRT    = nylon() ? 1.3 : 0.8;                             // 端子と線の逃げ ＝ バスタブの床の厚み。v6.1n 2026-09-15: 0.8 → 1.3（MJF の最薄 0.8・壁 1.2。0.8 の床は境界で、スイッチのねじのナットの座の下の床も 0.55 しか無かった → 1.05）。底が 0.5 下がる（筐体の逃げは元から底の 1.0 下まで・btn3_keepout）
B3_Z_TUB_B  = B3_Z_SW_BOT - B3_SKIRT;          // -15.085 バスタブの底（world の下限に効く）
B3_FINGER_CLICK = B3_CLICK - B3_PRELOAD;       // 指が動く量（予圧のぶんは既に食われている）
// レバーの先の高さ（予圧のぶん柱が押す点を下げているので、先端は 予圧/てこ比 だけ下がる）
B3_TIP_Z = B3_Z_SW_BOT + b3_lever_z(B3_TIP_X - B3_SW_DX) - B3_PRELOAD / B3_RATIO;
// 裾（レール）の下端。押し切っても部屋の中に留まる高さ。
//   🔴 2026-08-30 これを「3. 顔」の節（Z の積み上げより**前**）に置いたら、参照先がまだ無くて
//     押し出しの高さが負になり、押し子が高さ 100mm の柱になった（ユーザー「立派に育ちましたね」）。
//     ⇒ 定義はここ（Z が出そろった後）。下の assert で高さが正であることを縛る。
B3_SKIRT_Z = B3_Z_WIN_B + 0.10 + B3_TRAVEL;


// ============================================================
// 5. 天板側（口・ツバの部屋・ブロック 2 個）
// ============================================================
// 🔴 2026-08-30 ここをツバだけで決めていた。**押し切ると頭も 1.95mm この部屋へ入る**ので、
//   頭も見なければならない。実際 頭 12.0 ↔ 部屋 12.2 で**片側 0.1**しか無く、印刷の見込み
//   （片側 0.30）に完全に負けていた＝焼いた時点で固着する。ブーリアンの当たりは 0 を返すので
//   検査では見えなかった。⇒ ツバと頭の**大きい方**から取る。
B3_WIN_L = max(B3_FLG_L, B3_HEAD_L) + B3_FIT_MOVE * 2;   // ツバの部屋
B3_WIN_W = max(B3_FLG_W, B3_HEAD_W) + B3_FIT_MOVE * 2;
// 🔴 2026-08-30 ここを一度 30.80（座とブロックを 1 枚に繋いだ「1 枚羊羹」）にした。
//   **それは私の勝手な解釈で、ユーザーは言っていない。**実測で当たりが 2 か所 → 4 か所に増えた
//   （+X 側で羊羹と OLED に新たに当たった）ので、ユーザーの絵どおり 24.20 に差し戻した。
// 🔒 枠は 3.6 → **1.2**。3.6 は根拠のない太さで、これが INA226 の板に届いていた。
//   座の役目は「ツバの部屋を囲むこと」と「バスタブの天面を受けること」だけで、
//   荷重はブロックとねじが持つ（座は 2.5mm の天板にぶら下がっているだけ）。
// 🔒 2026-08-30 枠は**一律にできない**。実測した相手の位置:
//     -X … INA226 の板が world X 13.07 まで。枠 0.6 で余裕 0.03mm。1mm も足せない
//     +Y … 電源線が world Y 26.0 を東西に走る。枠は片側 1.05 まで（付け根の丸み 0.8 込み）
//     +X … 空き（羊羹だけで、あれは同じ天板なので union）
//   ⇒ **-X の一辺だけ薄いまま、ほかを厚く**する。枠が 0.6 の薄いリングだったのを直す。
B3_PAD_L = B3_WIN_L + 3.6;               // +X 側の枠（片側 1.8）
B3_PAD_W = B3_WIN_W + 1.5;               // ±Y の枠（片側 0.75。部屋が広がったぶん枠を詰めた）
B3_PAD_XN = B3_WIN_L / 2 + 0.6;          // -X 側だけ 0.6（INA226 が居る）
B3_PAD_R = 2.0; B3_ROOT_R = 0.8;


// ============================================================
// 6. バスタブ（別部品。上は全開・スイッチはレバーごと上から落とす）
// ============================================================
B3_TUB_IX = 2 * (B3_TIP_X + 0.75);       // 18.0 内のり X。レバー先端 8.25 から壁まで 0.75（btn_v3 の 15.0 と同じ空き）
B3_TUB_IY = B3_SW[1] + B3_FIT_POCK * 2;  //  6.10 内のり Y（胴に合わせる）
B3_POCK_X = B3_SW[0] + B3_FIT_POCK * 2;  // 13.10 胴のポケット
B3_LEDGE_W = 1.0;                        // 胴の底を受ける棚（±Y の長辺。端子は Y ±0.4 しか使わない）

// 🔒 ±X の壁は 1.6 → **3.0**。バスタブの外形をツバの部屋より広くして、天面が座に載るようにする。
//   （1.6 のままだと外形 18.2 < 部屋 20.6 でバスタブが部屋に落ちる ＝ 顔を大きくできない原因だった）
// 🔄 2026-08-30 3.0 → **1.6 へ戻した**。3.0 にした理由は「バスタブの天面が座に載るように
//   外形を部屋より広くする」だったが、**耳を下げた時点でその前提は消えている**
//   （締め付けは耳の上面 ↔ ブロックの下面に移った。天面は載っていなくてよい）。
//   細くするとブロックを内側へ寄せられ、ナットの肉と信号線の隙間が両立する。
B3_WALL_X  = 1.6;                        // ±X の壁
B3_WALL_YN = 1.6;                        // -Y の壁（スイッチのねじの頭の側）
// 🔴 2026-08-30 刷る前の検算で **0.30mm の壁**が出た（ナットの座の床・11.62mm2 x 2）。
//   原因: バスタブの芯 B3_TUB_CY が (WALL_YP - WALL_YN)/2 だけ +Y へずれているので、
//   床の実寸は WALL_YP - NUT_T ではなく **(WALL_YP + WALL_YN)/2 - NUT_T**。
//   2.2 では 0.30 にしかならない。0.6 を確保するには 2.8 が要る。
B3_WALL_YP  = nylon() ? 3.2 : 2.8;                        // +Y の壁。v6.1n 2026-09-15: 2.8 → 3.2（ナットの座 1.6 の底と器の内面の肉が 0.6 → 1.0。MJF の最薄 0.8）
B3_TUB_OX  = B3_TUB_IX + B3_WALL_X * 2;              // 18.20
B3_TUB_Y0  = -(B3_TUB_IY / 2 + B3_WALL_YN);          // -4.65
B3_TUB_Y1  =   B3_TUB_IY / 2 + B3_WALL_YP;           // +5.25
B3_TUB_OY  = B3_TUB_Y1 - B3_TUB_Y0;                  //  9.90
B3_TUB_CY  = (B3_TUB_Y0 + B3_TUB_IY / 2 + 2.8) / 2;   // +0.60 器の中（部屋・胴のポケット・裾・耳）の芯。v6.1n 2026-09-15: +Y の壁を 2.8 → 3.2 にしても中は動かさない（レジン版 btn_v3 と同じ芯）。厚くしたぶんは全部ナットの座の底の肉になる（0.6 → 1.0）。それまでは (Y0 + Y1) / 2
B3_TUB_TOP = B3_Z_WIN_B;                             // -5.75 天板の裏に当たる面
B3_TUB_R   = 1.6;

// ---- 縦ねじ（🔒 ユーザーのスケッチ）----
//   下（＝組む姿勢では上）から耳を通し、ブロックの中のナットへ締める。
//   締める力はバスタブを**天板の裏へ引き上げる**向きに働く。
B3_V_SCR_D = 2.3;                    // M2 の通し
B3_NUT_T   = 1.6;  B3_NUT_AF = 4.0;  // M2 ナット（下の芯の式が読むので、ここで先に置く）
// ⭐ 2026-09-18 🔒 ユーザー「ナットの入口を内側に作る必要があるよね。これはボタンもそう」:
//   ナットの溝の口を **−X（ブロックの内面＝バスタブの側）** へ向ける。ナットはバスタブを付ける前に
//   内側から差し、組んだ後はバスタブの外壁（±B3_TUB_OX/2）が口を塞ぐ。
//   これで外向きの道が要らなくなり、ナイロンで蓋の左の板（内面 X 1.694）に塞がれていた
//   15.09mm³ が消える（外面までの空き 0.806 に対し、ナットは厚み 4.0 で入らなかった）。
//   ⇒ ねじの芯は **ブロックの内面 ＋ ナットの半幅**（＝座ったナットの内の面が内面とツライチ）。
//      外側は口ではなく肉になるので、外面との間に MJF の壁 1.2 を残す。
B3_BLK_XI0 = max(B3_WIN_L, B3_TUB_OX) / 2 + 0.2;   // ブロックの内面（下の B3_BLK_XI と同じ式。ここで要るので先に出す）
B3_V_SCR_X = B3_BLK_XI0 + (B3_NUT_AF + B3_SHRINK) / 2;   // ナイロン 13.05 ／ レジン 12.85（旧 14.15 / 13.28 ＝ 口が外向きだった頃の値）
// 🔴 2026-09-02 **見込みを対角（外接円）に足していた。** 正しくは二面幅に足す。
//   旧: B3_NUT_AF/cos(30) + B3_SHRINK = 4.965 + 0.30 = 5.265 ⇒ 二面幅 **4.56**（呼び +0.56）
//   新: (B3_NUT_AF + B3_SHRINK)/cos(30)                      ⇒ 二面幅 **4.30**（呼び +0.30）
//   他は全部 4.30（case_base の NUT_AF / case_v3_shutter の SHUT_LOCK_NAF）。ここだけ 0.26 大きかった。
//   ✅ ユーザー実測が裏付け: 「底板の 6 角はうまく機能している。上面の裏のバスタブを付ける腕と
//     バスタブも逆さまにすると落ちる」。**落ちる方が 0.26 大きい方**だった。
//   ⚠ 下の assert は最初から (B3_NUT_AF + B3_SHRINK) の形で書いてある。検算の側は正しく、
//     彫っている側だけが違っていた。
//   🔒 天板は刷り済み（旧 4.56 のまま）。ユーザー「もう印刷したものをやり直すのは嫌」
//     「気が向いたらやり直すくらいですね。割れたり壊れたら」⇒ **刷り直さない。**
// 🔴 2026-08-31 ザグリの**深さ**を 1.2 → **1.6** に（ユーザー指示・刷り直しの理由）。
//   1.2 は実測の頭の高さ 1.3 より低く、頭が沈みきらない形だった。1.3 ＋ 沈み 0.3 ＝ 1.6。
//   耳の厚み [4.5, 5.585] に対し assert（耳 − ザグリ ≥ 1.5）も通る。
//   ⚠ 径は **4.2 のまま**。他（case_base の SCR_CB・つまみの島）は 4.4 だが、ここだけ
//     外面（B3_BLK_XO 15.35）までの肉が 0.052 まで落ちるので広げない（8d79f07）。
B3_CB_D    = 4.2;  B3_CB_H   = 1.6;  // 頭のザグリ（バスタブの底に沈める）
// 🔒 2026-08-30 ユーザー「耳が浮いてるからその部分で印刷失敗する」。**左右で別々に取る。**
//   耳の下に空間が残ると庇になって刷れないので、当たらない範囲で底まで下ろす。
//   INA226 は -X 側にしか居ないので、+X は底までいける。[+X 側, -X 側]。
//   ✅ 実測: **-X は 5.585（バスタブの底とツライチ・庇ゼロ）／+X は 4.5 が限界**。
//     +X の真下には電池／INA の塊が world Z 35.87〜36.82 の帯で来ていて、4.7 で当たる。
//     ⇒ +X 側だけ 1.085mm の隙間が残る。これは埋められない（支えを付けて刷る）。
B3_EAR_T   = [5.585, 5.585];         // 耳の厚み（Z）。[+X 側, -X 側]。🔒 ユーザー 2026-09-05「右耳の Z 高さを左に合わせて」: 4.5 → 5.585
// 🔄 2026-09-02 上の「+X 側は埋められない」は**耳の厚みを一様に掃引した**結果で、部分的には埋まる。
//   実測（hardware/_tub_ear_probe.scad・相手は innards4 の全部）: 耳の足あと 7.25 x 7.0 = 50.75mm² のうち
//   **39.18mm²（77%）は 1.085mm ぜんぶプレートまで空いている**。塞いでいるのは INA226 の板の縁 1 枚だけで、
//   局所 y 6.54 以上・厚み 0.29mm（当たり 2.007mm³）。電池・PowerBoost・橋・帯・柱・線・OLED・ハブ・
//   ReSpeaker・蓋は全部 0。⇒ +X の耳にも**底まで届く足**を付け、+Y 側だけ INA の手前で止める。
//   これで浮いた庇（斜めに出た所）が消え、支柱もラフトも要らなくなる。
B3_EAR_FOOT_Y1 = 6.04;               // 足の +Y の端（局所 y）。INA の縁 6.54 − 逃げ 0.5
// 足の下面。+X だけ底まで下ろす（-X は元から底とツライチ）
function b3_ear_foot_z0(i) = b3_ear_z0(i);   // 足が無いので耳の下面（2026-09-05）
function b3_ear_foot_y0()  = B3_TUB_CY - B3_BLK_W / 2 + B3_BLK_DY[0];
// 2026-08-30 耳を一度バスタブの一番上へ上げた（ユーザーの絵に合わせて）。
//   ⚠ それは**指示ではなかった**（「なんとなく線の通りが良いだろうと思ったから」）。
//   ⇒ 今はブロックの厚み（印刷の安全）を優先して下げてある。耳の高さは従属値。
// 🔒 2026-08-30 ユーザー「羊羹 2 の Z 長さをすこし増やした方がいい。薄すぎて印刷が危険」。
//   ブロックの高さ = 天板の裏（-2.5）から下へ B3_BLK_H。**上は天板なので伸ばせるのは下だけ**で、
//   下げた分だけ**耳も一緒に下がる**（耳の上面 ＝ ブロックの下面）。
B3_BLK_H   = 7.0;                        // ブロックの高さ（旧 3.25）
B3_EAR_Z1  = B3_Z_LIP_B - B3_BLK_H;      //  -9.500 耳の上面 ＝ ブロックの下面
// 🔒 2026-08-30 耳はできるだけ下まで伸ばす（下に庇を残さないため）。底まで下ろすと INA226 に
//   当たるので、当たらない範囲で最大に取る。B3_EAR_T がその厚み。
function b3_ear_z0(i) = max(B3_EAR_Z1 - B3_EAR_T[i], B3_Z_TUB_B);   // 耳の下面（i=0 が +X）

// ---- ブロック（＝羊羹 2。天板の裏から下りてナットを持つ）----
//   🔴 2026-08-30 ユーザー「押し子にあたってんじゃん」。内面を 9.30 に置いていた。
//     ツバは ±9.9 まで張り出して**上下に動く**ので、そこはブロックの居場所ではない。
//     ⇒ 内面はツバの部屋（±10.3）の外に置く。下の assert で二度と入れない。
//   🔒 ブロックは**直方体**（ユーザー「印刷を考慮したら羊羹みたいな直方体が一番」）。
//   🔒 耳を上げたので、ブロックは天板の裏から耳の上面までの**薄い板**（高さ 3.25）で足りる。
// 🔴 2026-08-30 ここもツバの部屋だけを見ていた。ブロックが避けるべきなのは
//   **ツバの部屋とバスタブの両方**。顔を縮めるとバスタブ（18.2・レバーの振りで決まる）の方が
//   広くなるので、大きい方を見る。これを直すまで「顔を縮められない」ように見えていた。
B3_BLK_XI  = B3_BLK_XI0;             // 内面（ツバの部屋とバスタブの外）。式は上の B3_BLK_XI0
B3_BLK_XO  = B3_V_SCR_X + (B3_NUT_AF + B3_SHRINK) / 2 + 1.2;   // ⭐ 2026-09-18: 外側は口ではなく**閉じた肉**。ナットの外の面から MJF の壁 1.2 を取る。ナイロン 16.50（据え置き＝ブロックは動かない）／レジン 16.10（旧 15.35。口を内へ回したぶん外に肉が要る）
B3_BLK_XI2 = B3_TUB_OX / 2 + 0.2;    // v5: ツバの部屋より下の内面（バスタブの外壁から 0.2）。隙間を埋めてナットの内側の壁にする
B3_BLK_W   = 7.0;                    // 幅（Y）
// ブロックの Y の送り。🔒 ユーザー指針「X が置けなければ Y 方向に太らせればいい。
//   それでもダメなら斜め 2 点」。[-X 側, +X 側] で別々に送れる（＝斜め 2 点が書ける）。
// ✅ 2026-08-30 実測で決定: **-X 側だけ -2.5**。電源線（INA の GND が口から +Y へ走る線）が
//   -X のブロックの中を通っていた（当たり 1.50 x 1.98 x 1.50）。線は引き直せない——線の始点
//   [11.8, 19.87, 47.3] そのものがブロックの内側で、口の頭（Z 46.0）もブロックの高さの中にあり、
//   下へも横へも抜け道が無いため。⇒ 動かすのはブロックの方。
//   掃引: -1 で 1.50 / **-2 で 0** / -3..-5 も 0。他の相手（INA226・ReSpeaker 基板・OLED）は全部 0 のまま。
// 🔄 2026-08-30 **+X 側も振って斜め 2 点に**。ユーザー「これだと OLED のピンヘッダにも刺さる」。
//   +X のブロックが OLED の I2C コネクタに 1.43 x 3.00 x 2.54 食い込んでいた
//   （world X 37.97〜39.40 / Y 14.10〜17.10 / Z 45.23〜47.77）。
//   掃引: +1 で 2.00 / +2 で 1.43 / **+3 で 0**。余裕 0.5 を見て +3.5。
//   🔴 このときまで検査の相手に**コネクタ類（oled_hous / xiao_hous / housing）が入っていなかった**。
//     「全部 0」と言いながら相手が抜けていた。_btn_v3_fit.scad に oledh / xiaoh / hous を追加済み。
//   ✅ 窓を測って真ん中へ置いた（ユーザー「うんギリギリ」）:
//     +X 側 … 窓は **3.0〜4.1 の 1.1mm しかない**（下は OLED のコネクタ・上は電源線）。
//             真ん中の 3.5 が最善で、余裕は 0.5 / 0.6。**ここは物理的にギリギリ**
//     -X 側 … 窓は -2.0 から -5.5 以上まで開いている。-2.5 は端に寄りすぎだったので
//             **-3.0** へ。電源線からの余裕が 0.5 → 1.0 に増える
B3_BLK_DY  = [-2.5, -2.5];   // 🔒 ユーザー 2026-09-05「左右の耳の Y を右の耳に合わせて」: 両方 −2.5（右は 3.5 → 手前 3 → 手前 3 で −2.5）。 🔒 ユーザー 2026-09-05「バスタブの腕を手前に 6mm」: −X 側（腕＝天板の裏のブロック・耳と同軸）を −3.0 → −9.0。 🔒 ユーザー 2026-09-05「バスタブの耳（右だけ）、手前に 3mm」→「さらに手前に 3mm」: +X 側を 3.5 → −2.5（v4 で後ろへ振った理由＝OLED のコネクタは v5 では 3.6 離れている）
B3_BLK_FLR = 0.8;                    // ナットを載せる床の厚み
B3_NUT_Z0  = B3_EAR_Z1 + B3_BLK_FLR; // -11.285 ナットの下面（床の上）
B3_NUT_Z1  = B3_NUT_Z0 + B3_NUT_T;   //  -9.685 同 上面
B3_EAR_XO  = B3_BLK_XO;              // 耳の外面（ブロックと同じ）

// ---- スイッチのねじ（机の上で締める。🔒 頭は -Y・ナットは +Y の壁の中）----
B3_SCR_D  = 2.3;
B3_SEAT_D = 4.6;  B3_SEAT_H = 0.6;
B3_HEAD_D = 3.8;  B3_HEAD_T = 1.2;
B3_Z_SCR  = B3_Z_SW_BOT + B3_SW_HOLE_Z;   // -12.285 ねじの芯の Z
B3_SCR_X  = msw_hole_p() / 2;             // ±3.25（スイッチの芯から）


// ============================================================
// 7. 形（2D の下地）
// ============================================================
// 🔒 2026-08-30 ユーザー「小判状にはできないんですかね。デザイン的に相当浮いてます」。
//   **顔と天板の口だけ**を小判（両端が半円）にする。つまみもスピーカーの穴も丸なので顔が揃う。
//   ⚠ ツバは角のある形のまま。ツバまで小判にすると、掛かりが X の端の一点付近だけになって
//     抜け止めが弱くなる（口が小判・ツバが角なら、口の細る所でむしろ掛かりが増える）。
module b3_ob2d(l, w) hull() for (sx = [-1, 1]) translate([sx * (l - w) / 2, 0]) circle(d = w, $fn = 48);
module b3_ob(l, w, h) linear_extrude(h) b3_ob2d(l, w);

module b3_rr(l, w, r, cy = 0) translate([0, cy])
    offset(r = r, $fn = 48) square([l - 2 * r, w - 2 * r], center = true);
module b3_box(l, w, r, h, cy = 0) linear_extrude(h) b3_rr(l, w, r, cy);


// ============================================================
// 8. 刷る物 ① 押し子（頭 ＋ ツバ ＋ 柱。**下から**天板の口へ通す）
// ============================================================
// 頭。つまみと同じ 2 段の面取り（天面の角 0.8・裾の角 0.3）
module btn3_head() hull() {
    for (d = [[B3_Z_LIP_B, B3_HEAD_CB], [B3_Z_LIP_B + B3_HEAD_CB, 0],
              [B3_HEAD_OUT - B3_HEAD_CH, 0], [B3_HEAD_OUT - 0.01, B3_HEAD_CH]])
        // 🔴 最上段は HEAD_OUT **-0.01**。0.01 の板を HEAD_OUT に置くと天面が 3.01 になり、
        //   刷る向きにしたとき底が Z -0.01 に浮く（刷る前の検算で出た）
        translate([0, 0, d[0]]) linear_extrude(0.01)
            offset(r = -d[1], $fn = 24) b3_ob2d(B3_HEAD_L, B3_HEAD_W);   // 小判
}
// ⭐ 2026-09-19 🔒 ユーザー「モデルの押し子なんですが左右逆です。設計ではたしかにあなたの設定している方向なんですが、
//   V5で実験したところ逆が押し心地が良かったのです」: 押し子は芯のまわりに 180° 回して付ける（柱がレバーの根元側）。
//   上の 2026-09-07 の試し刷りの「押し子 1 を逆（ポッチが根元側）で付ける … 押せて感触が良い」と同じ付け方。
//   刷る形は変わらない（回すのは付ける向きだけ）
B3_PISTON_RZ = 180;
module btn3_piston(dn = 0) color("#f2f2f2") translate([0, 0, -dn]) rotate([0, 0, B3_PISTON_RZ]) {   // ⭐ 2026-09-19 🔒 ユーザー「押し子の色を白に」: #8fb4d9 → 白
    btn3_head();                                                                                 // 頭（2 段の面取り）
    // 裾（レール）。頭と同じ断面を部屋の底まで下ろして、案内の長さを稼ぐ
    translate([0, 0, B3_SKIRT_Z]) b3_ob(B3_HEAD_L, B3_HEAD_W, B3_Z_LIP_B - B3_SKIRT_Z);
    translate([0, 0, B3_Z_FLG_B]) b3_box(B3_FLG_L,  B3_FLG_W,  1.0, B3_FLG_T);                   // ツバ
    translate([B3_PUSH_X + B3_SW_DX, 0, B3_Z_FLG_B - B3_PILLAR_H + 0.01])                        // 柱
        cylinder(d = B3_PILLAR_D, h = B3_PILLAR_H, $fn = 32);
}


// ============================================================
// 9. 刷る物 ② バスタブ（上は全開。耳の下面は底とツライチ）
// ============================================================
// ⭐ 2026-09-19 🔒 ユーザー「各バスタブは全部オレンジにしてください」: #a8b6a0 → スピーカーのバスタブ（spk_v61 の spk_tub）と同じ #e0a040
module btn3_tub() color("#e0a040") difference() {
    union() {
        translate([0, 0, B3_Z_TUB_B])                                                    // 器
            b3_box(B3_TUB_OX, B3_TUB_OY, B3_TUB_R, B3_TUB_TOP - B3_Z_TUB_B, B3_TUB_CY);
        for (i = [0, 1]) mirror([i, 0, 0]) translate([0, B3_BLK_DY[i], 0])                // 耳 2 か所
            translate([B3_TUB_OX / 2 - 1, B3_TUB_CY - B3_BLK_W / 2, b3_ear_z0(i)])
                cube([B3_EAR_XO - B3_TUB_OX / 2 + 1, B3_BLK_W, B3_EAR_Z1 - b3_ear_z0(i)]);
        // 耳の足（+X の耳の下を筒の底まで埋めていた肉）は 🔒 ユーザー 2026-09-05「削除」で無し。ザグリは耳の下面から
    }
    // ---- 中を彫る。🔒 上は全開（天井側に張り出しを一切作らない）----
    translate([0, 0, B3_Z_SW_TOP])                                                        // レバーの部屋
        b3_box(B3_TUB_IX, B3_TUB_IY, 0.8, B3_TUB_TOP - B3_Z_SW_TOP + 0.01, B3_TUB_CY);
    translate([-B3_POCK_X / 2 + B3_SW_DX, B3_TUB_CY - B3_TUB_IY / 2, B3_Z_SW_BOT])        // 胴のポケット
        cube([B3_POCK_X, B3_TUB_IY, B3_SW[2] + 0.01]);
    translate([-B3_POCK_X / 2 + B3_SW_DX, B3_TUB_CY - (B3_TUB_IY / 2 - B3_LEDGE_W),       // 裾（端子の道）
               B3_Z_TUB_B - 1])
        cube([B3_POCK_X, B3_TUB_IY - B3_LEDGE_W * 2, B3_SKIRT + 1.01]);
    btn3_sw_screw_cut();
    btn3_v_screw_cut();
}

// ---- スイッチのねじ（頭は -Y・ナットは +Y の壁の中。締めるとナットは床へ押し付けられる）----
module btn3_sw_screw_cut() for (sx = [-1, 1]) translate([sx * B3_SCR_X + B3_SW_DX, 0, B3_Z_SCR]) {
    translate([0, -20, 0]) rotate([-90, 0, 0]) cylinder(d = B3_SCR_D, h = 40, $fn = 24);
    translate([0, B3_TUB_Y0 + B3_SEAT_H, 0]) rotate([90, 0, 0])                            // 頭の平らな座
        cylinder(d = B3_SEAT_D, h = 4, $fn = 32);
    translate([0, B3_TUB_Y1 - B3_NUT_T, 0]) rotate([-90, 0, 0])                            // 六角の座
        cylinder(d = (B3_NUT_AF + B3_SHRINK) / cos(30), h = B3_NUT_T + 1.0, $fn = 6);
}

// ---- 縦ねじ（耳の通しと、底に沈める頭のザグリ）----
//   ⚠ 足を付けた側は下面が 1.085 下がるので、ザグリも同じだけ深くする。**頭の座の Z は動かさない**
//     （動かすと M2 を 1.085 長い物へ買い替えることになる）。深さ 1.6 → 2.685、残る肉 2.9（assert 1.5）
module btn3_v_screw_cut() for (i = [0, 1]) mirror([i, 0, 0]) translate([0, B3_BLK_DY[i], 0]) {
    translate([B3_V_SCR_X, 0, b3_ear_foot_z0(i) - 1])
        cylinder(d = B3_V_SCR_D, h = B3_EAR_Z1 - b3_ear_foot_z0(i) + 2, $fn = 24);
    translate([B3_V_SCR_X, 0, b3_ear_foot_z0(i) - 0.01])                                   // 頭のザグリ
        cylinder(d = B3_CB_D, h = B3_CB_H + (b3_ear_z0(i) - b3_ear_foot_z0(i)) + 0.01, $fn = 32);
    // ⭐ 2026-09-18: 2026-09-15 に入れた「ザグリを耳の外面へ開く」逃げを**外した**。
    //   あれは芯 14.15 ＋ φ4.2/2 ＝ 16.25 と外面 16.50 の間に 0.25 の刃が出たための逃げで、
    //   ナットの口を内向きにして芯が 13.05 へ寄った今は外面まで 1.35 あり、刃は出ない。
    //   （レジンも 12.85 ＋ 2.1 ＝ 14.95 に対し外面 16.10 で 1.15）⇒ ザグリは閉じた座に戻る
}


// ============================================================
// 10. 天板側（足す肉 = ツバの部屋の囲い ＋ ブロック 2 個 ／ 抜く物 = 皿と口）
// ============================================================
module b3_pad_2d() intersection() {
    b3_rr(B3_PAD_L, B3_PAD_W, B3_PAD_R);
    translate([-B3_PAD_XN, -50]) square([100, 100]);   // -X 側を切り落とす（INA226 の逃げ）
}

B3_ROOT_N = 8;
module btn3_root() for (i = [0 : B3_ROOT_N - 1]) hull() for (j = [i, i + 1])
    let (d = j / B3_ROOT_N * B3_ROOT_R)
        translate([0, 0, -B3_PLATE_T - B3_ROOT_R + d]) linear_extrude(0.02)
            offset(r = B3_ROOT_R - sqrt(B3_ROOT_R * B3_ROOT_R - d * d), $fn = 32) b3_pad_2d();

// ブロック 1 個ぶん（+X 側）。上側は 45° で座へ繋ぐので、刷る向きで庇にならない
module btn3_block() {
    translate([B3_BLK_XI, B3_TUB_CY - B3_BLK_W / 2, B3_EAR_Z1])
        cube([B3_BLK_XO - B3_BLK_XI, B3_BLK_W, B3_Z_LIP_B - B3_EAR_Z1]);   // 直方体・天板の裏まで
    translate([B3_BLK_XI2, B3_TUB_CY - B3_BLK_W / 2, B3_EAR_Z1])           // v5: ツバの部屋（Z_WIN_B より上）を避けて、その下だけ内へ出す
        cube([B3_BLK_XI - B3_BLK_XI2 + 0.01, B3_BLK_W, B3_Z_WIN_B - B3_EAR_Z1]);
}
// ブロックから抜く物: ナットを横から差す溝（床の上に載る）＋ ねじの通し
module btn3_block_cut() {
    translate([B3_V_SCR_X, 0, B3_EAR_Z1 - 0.01])                                           // ねじの通し
        cylinder(d = B3_V_SCR_D, h = B3_NUT_Z1 - B3_EAR_Z1 + 2.0, $fn = 24);
    // ⭐ 2026-09-18 ナットの溝の口は **−X（内側＝バスタブの側）**（🔒 ユーザー「ナットの入口を内側に」）。
    //   ナットはバスタブを付ける前に内側から差し、組んだ後はバスタブの外壁が口を塞ぐ。
    //   掃く先はブロックの内面の 1.0 外まで（そこから先には天板側の物が無い Z 帯）
    hull() for (dx = [0, -(B3_V_SCR_X - B3_BLK_XI) - 1.0])
        translate([B3_V_SCR_X + dx, 0, B3_NUT_Z0]) rotate([0, 0, 30])                      // 二面幅を X に向ける
            cylinder(d = (B3_NUT_AF + B3_SHRINK) / cos(30), h = B3_NUT_T, $fn = 6);
    // 口を六角の角いっぱいに開ける（六角の斜めの辺と口の面がすれ違う所に刃を残さない）。
    //   ナットを keying する六角の面は芯から ±2.0 に残る。⭐ 2026-09-18: 向きを外 → 内へ。レジンでも同じ（口の向きは材料で変えない）
    translate([B3_V_SCR_X - 2.0 - 10, -((B3_NUT_AF + B3_SHRINK) / cos(30) / 2 + 0.3), B3_NUT_Z0])
        cube([10, (B3_NUT_AF + B3_SHRINK) / cos(30) + 0.6, B3_NUT_T]);
}

module btn3_station_add() difference() {
    union() {
        btn3_root();
        // 🔴 ここは b3_box(...) で直に描いていて、b3_pad_2d() の -X の切り落としが効いていなかった
        translate([0, 0, B3_Z_WIN_B]) linear_extrude(B3_Z_LIP_B - B3_Z_WIN_B + 0.01) b3_pad_2d();   // ツバの部屋の囲い
        for (i = [0, 1]) mirror([i, 0, 0]) translate([0, B3_BLK_DY[i], 0]) btn3_block();    // 🔒 ブロック 2 個
    }
    translate([0, 0, B3_Z_WIN_B - 0.01]) b3_box(B3_WIN_L, B3_WIN_W, 1.4,                   // ツバの部屋
                                                B3_Z_LIP_B - B3_Z_WIN_B + 0.02);
    for (i = [0, 1]) mirror([i, 0, 0]) translate([0, B3_BLK_DY[i], 0]) btn3_block_cut();
}

// ---- 天板の板そのものを抜く（皿・縁のベベル・口）----
module btn3_station_cut() {
    // 🔒 つまみと同じ顔: 口が板を真っ直ぐ貫き、縁に 45°・0.3 の面取り 1 つだけ（皿は無い）
    translate([0, 0, B3_Z_LIP_B - 0.01]) b3_ob(B3_OPN_L, B3_OPN_W, B3_PLATE_T + 0.02);           // 口（小判）
    translate([0, 0, -B3_BEVEL]) hull() {                                                        // 口の縁の面取り
        b3_ob(B3_OPN_L, B3_OPN_W, 0.01);
        translate([0, 0, B3_BEVEL]) b3_ob(B3_OPN_L + B3_BEVEL * 2, B3_OPN_W + B3_BEVEL * 2, 0.01);
    }
}


// ============================================================
// 11. 買う物の絵（部品ではない）
// ============================================================
function btn3_sw_pin(i) = [B3_SW_DX + i * 5.08, 0, B3_Z_SW_BOT - msw_pin_h()];   // 端子の先（i = -1 / 0 / +1・ボタンの局所）。筐体の線がここから出る（2026-09-05）
// 試し: 絵も曲がり始め 1.5 で描く（parts.scad の microswitch_daokai は端から描くので使わない）
module msw_trial(press = 0) {
    W = B3_SW[0]; D = B3_SW[1]; H = B3_SW[2]; L = msw_lever_l();
    top = max(msw_bot_h(), msw_act_h() - press);
    color("#2b2b2b") difference() {
        translate([-W / 2, -D / 2, 0]) cube([W, D, H]);
        for (sx = [-1, 1]) translate([sx * msw_hole_p() / 2, -D / 2 - 1, B3_SW_HOLE_Z])
            rotate([-90, 0, 0]) cylinder(d = sx < 0 ? 2.2 : msw_hole_d(), h = D + 2, $fn = 24);
    }
    color("#9a9a9a") translate([-W / 2, -D / 2 + 0.6, 0]) rotate([90, 0, 0])
        translate([0, 0, -(D - 1.2)]) linear_extrude(D - 1.2)
            polygon([[0, H], [B3_BEND, H], [B3_BEND + L, top], [B3_BEND + L, top - 0.8], [B3_BEND, H - 0.8], [0, H - 0.8]]);
    color("#c9a227") for (i = [-1, 0, 1]) translate([i * 5.08 - 0.6, -0.4, -B3_PIN_LEN]) cube([1.2, 0.8, B3_PIN_LEN]);
}
module btn3_switch(press = 0) translate([B3_SW_DX, 0, B3_Z_SW_BOT]) msw_trial(press);
module btn3_sw_screws() for (sx = [-1, 1]) translate([sx * B3_SCR_X + B3_SW_DX, 0, B3_Z_SCR]) {
    color("#b0b0b0") {
        translate([0, B3_TUB_Y0 + B3_SEAT_H - B3_HEAD_T, 0]) rotate([-90, 0, 0])
            cylinder(d = B3_HEAD_D, h = B3_HEAD_T, $fn = 24);
        translate([0, B3_TUB_Y0 + B3_SEAT_H, 0]) rotate([-90, 0, 0])
            cylinder(d = 2.0, h = B3_TUB_Y1 - B3_TUB_Y0 - B3_SEAT_H, $fn = 20);
    }
    color("#8a8a8a") translate([0, B3_TUB_Y1 - B3_NUT_T, 0]) rotate([-90, 0, 0])
        cylinder(d = B3_NUT_AF / cos(30), h = B3_NUT_T, $fn = 6);
}
// 縦ねじ（頭はバスタブの底のザグリの中・ナットはブロックの床の上）
module btn3_v_screws(ex = 0) for (i = [0, 1]) mirror([i, 0, 0]) translate([0, B3_BLK_DY[i], -ex]) {
    color("#b0b0b0") {
        translate([B3_V_SCR_X, 0, b3_ear_z0(i)]) cylinder(d = B3_CB_D - 0.2, h = B3_CB_H, $fn = 24);
        translate([B3_V_SCR_X, 0, b3_ear_z0(i)]) cylinder(d = 2.0, h = B3_NUT_Z1 - b3_ear_z0(i), $fn = 20);
    }
    color("#8a8a8a") translate([B3_V_SCR_X, 0, B3_NUT_Z0]) rotate([0, 0, 30]) cylinder(d = B3_NUT_AF / cos(30), h = B3_NUT_T, $fn = 6);   // 二面幅を X に向ける（台座の溝と同じ向き。2026-09-05 まで 30° ずれて描いていて、皮との当たり 1.1mm³ の正体だった）
}


// ============================================================
// 12. 外へ渡す寸法（case_v4.scad が読む。逆向きの参照はしない）
// ============================================================
function btn3_tub_ox()  = B3_TUB_OX;
function btn3_tub_oy()  = B3_TUB_OY;
function btn3_tub_y0()  = B3_TUB_Y0;
function btn3_tub_y1()  = B3_TUB_Y1;
function btn3_pad_l()   = B3_PAD_L;
function btn3_pad_w()   = B3_PAD_W;
function btn3_blk_xo()  = B3_BLK_XO;       // 箱の中で一番外へ出る X（±）
function btn3_tub_z0()  = B3_Z_TUB_B;      // 下へはここまで
function btn3_v_scr_x() = B3_V_SCR_X;
function btn3_nut_z0()  = B3_NUT_Z0;       // 縦ねじのナットの下面（ブロックの溝の床）。case_v6_1 の look_btnnut が読む（2026-09-18）
function btn3_nut_t()   = B3_NUT_T;
function btn3_nut_af()  = B3_NUT_AF + B3_SHRINK;   // 溝の二面幅（呼び ＋ 材料の見込み）
function btn3_blk_dy(i) = B3_BLK_DY[i];
function btn3_blk_xi()  = B3_BLK_XI;       // ブロックの内面（ナットの溝の口。⭐ 2026-09-18 に外 → 内）

module btn3_keepout() {                     // 支柱の禁止区域（外から手が入らない所）
    translate([0, 0, B3_Z_TUB_B - 1])
        b3_box(B3_BLK_XO * 2 + 1.0, B3_TUB_OY + 1.0, B3_TUB_R, B3_Z_LIP_B - B3_Z_TUB_B + 1, B3_TUB_CY);
}


// ============================================================
// 13. 刷る向き（どちらも平らな面をベッドへ・庇ゼロ）
// ============================================================
module btn3_piston_print() translate([0, 0, B3_HEAD_OUT]) rotate([180, 0, 0]) btn3_piston();

// ============================================================
// 8b. 押し子 2（🧪 2026-09-07・ユーザーが「いい」と言った逆付け＝根元寄りの接点を設計にした物）
//   剛体の押し子＋天板の裏・部屋の底・口の遊び・レバーの接触で解いた地図（scratchpad/btn_sim*.py）から:
//   ・接点は芯のすぐ根元側 P2_X = 1.0（先端側の縁）。どこを押しても鳴る深さが 0.84〜1.19 に揃う。力は 59〜200gf
//   ・ポッチは Y に 4.0 の線（幅 1.2）。長辺の縁を押しても真ん中と同じ動き
//   ・予圧 0.8（先端）。逆付けの押し子は接点が 0.77 浮いていてバスタブが座るとカタつくので埋める
//   ・ツバの裏の両端に足（高さ P2_FOOT）。ハードストップを浅くして、レバーが胴に着く前に止める。足はバスタブの壁の上（X 9.0〜9.9）に着く
//   バスタブは試しの物のまま。頭・ツバ・裾は押し子 1 と同じ
// ============================================================
P2_X    = 1.0;    // 接点（線の先端側の縁・ボタンの芯から）
P2_W    = 1.2;    // 線の X 幅
P2_LY   = 4.0;    // 線の Y 長さ（レバーの幅 4.6 の中）
P2_PRE  = 0.8;    // 予圧（レバーの先端で）
P2_R    = (P2_X - B3_SW_DX - B3_HINGE) / msw_lever_l();                       // 0.463 接点のてこ比
P2_CUT  = 0.8;    // 🔒 ユーザー 2026-09-07 実機: 実物のレバーはこのファイルの直線より高い。バスタブのねじを 2 周（M2 × 0.4 × 2 ＝ 0.8）緩めると押し子 2 が押せた ⇒ 線を 0.8 短く
P2_ZB   = B3_Z_SW_BOT + b3_lever_z(P2_X - B3_SW_DX) - P2_PRE * P2_R + P2_CUT;   // -5.36 線の底（直線のレバーより予圧ぶん下・そこから 0.8 上げる）
P2_H    = B3_Z_FLG_B - P2_ZB;                                                // 2.46 線の出
P2_FULL = (msw_travel() - P2_PRE) * P2_R;                                    // 1.48 接点でレバーが胴に着くまで
P2_TRAVEL = P2_FULL - 0.2;                                                   // 1.28 ハードストップ（0.2 手前）
P2_FOOT = (B3_Z_FLG_B - B3_Z_WIN_B) - P2_TRAVEL;                             // 0.77 足の高さ
P2_CLICK = (msw_click() - P2_PRE) * P2_R;                                    // 0.79 真っ直ぐ押したとき鳴るまでの指
P2_FOOT_X0 = B3_TUB_IX / 2; P2_FOOT_X1 = B3_FLG_L / 2;                       // 9.0〜9.9 足が載るバスタブの壁の上
P2_FOOT_Y0 = B3_TUB_Y0 + 0.3; P2_FOOT_Y1 = min(B3_TUB_Y1, B3_FLG_W / 2) - 0.3;   // 壁の上に収まる Y
module btn3_piston2() color("#8fb4d9") {
    btn3_head();
    translate([0, 0, B3_SKIRT_Z]) b3_ob(B3_HEAD_L, B3_HEAD_W, B3_Z_LIP_B - B3_SKIRT_Z);
    translate([0, 0, B3_Z_FLG_B]) b3_box(B3_FLG_L,  B3_FLG_W,  1.0, B3_FLG_T);
    translate([P2_X - P2_W, -P2_LY / 2, P2_ZB]) cube([P2_W, P2_LY, P2_H + 0.01]);              // 線
    // 足 2 本。🔒 ユーザー 2026-09-07「足の角を台形にするだけで渋さはなくなった」: Y の両端を 45° で削る（削った角度は未記録・45° で描く）。
    //   帯のままだと長辺の縁を押して傾いたとき帯の端が先に壁に着いて渋い。台形なら端が逃げて、鳴ってから着く
    for (sx = [-1, 1]) mirror([sx < 0 ? 1 : 0, 0, 0])
        translate([P2_FOOT_X0, 0, B3_Z_FLG_B]) rotate([90, 0, 90])
            linear_extrude(P2_FOOT_X1 - P2_FOOT_X0)
                polygon([[P2_FOOT_Y0, 0.01], [P2_FOOT_Y1, 0.01], [P2_FOOT_Y1 - P2_FOOT, -P2_FOOT], [P2_FOOT_Y0 + P2_FOOT, -P2_FOOT]]);
}
module btn3_piston2_print() translate([0, 0, B3_HEAD_OUT]) rotate([180, 0, 0]) btn3_piston2();
echo(str("btn_v3 押し子 2: 接点 ", P2_X, "（てこ比 ", P2_R, "）／線の出 ", P2_H, "／予圧 ", P2_PRE, "／鳴るまで ", P2_CLICK,
         "／ハードストップ ", P2_TRAVEL, "（足 ", P2_FOOT, "）／胴に着くまで ", P2_FULL));
assert(P2_CLICK < P2_TRAVEL, "押し子 2: クリックより先にハードストップ");
assert(P2_TRAVEL < P2_FULL, "押し子 2: ハードストップより先にレバーが胴に着く");
assert(P2_X + 0.0 < B3_TIP_X - 0.5 && P2_X - P2_W > B3_HINGE + B3_SW_DX + 0.5, "押し子 2: 線がレバーの外");
assert(P2_FOOT_Y1 - P2_FOOT_Y0 > 3, "押し子 2: 足の Y が短い");
module btn3_tub_print()    translate([0, 0, -B3_Z_TUB_B]) btn3_tub();
module btn3_station_print() rotate([180, 0, 0]) btn3_top_slice();   // 🧪 ミニ天板（口・部屋・腕・ナットの溝）。外面を下にして刷る。押し子とバスタブを机の上で組んで試すための物


// ============================================================
// 14. 単体で開いたときの絵（🔒 スイッチは part 一本）
// ============================================================
// ---- part の一覧（UI・消さない）----
//   絵   : look（組んだ姿）/ explode（分解）/ press（クリックまで押した姿）
//   断面 : secx（レバーの伸びる X-Z 面）/ secy（ねじの Y-Z 面）
//   部品 : p_piston / p_tub / p_station（天板側）/ p_sw
//   刷る : print_piston / print_tub     ← **刷る物は 2 点**（試し: print_piston2 / p_piston2 ＝ 根元寄りの線の押し子）
//   none : 何も出さない（他のファイルから include したとき）
part = "explode";
BTN3_SOLO = true;

module btn3_top_slice() color("#c9d0d8") difference() {   // 天板の切れ端（絵のため・部品ではない）
    union() {
        translate([0, 0, -B3_PLATE_T]) b3_box(B3_BLK_XO * 2 + 4, B3_PAD_W + 8, 2.0, B3_PLATE_T);
        btn3_station_add();
    }
    btn3_station_cut();
}
module btn3_scene(ex = 0, dn = 0) {
    btn3_top_slice();
    translate([0, 0, -ex * 8])  btn3_piston(dn);                    // ① 下から口へ
    translate([0, 0, -ex * 24]) { btn3_tub(); btn3_sw_screws(); }    // ④ バスタブを載せて縦ねじ
    translate([0, 0, -ex * 16]) btn3_switch(dn / B3_RATIO);          // ② スイッチは上からバスタブへ
    btn3_v_screws(ex * 34);                                          // 縦ねじ 2 本（下から）
}
module btn3_half(ax) difference() {
    children();
    if (ax == "x") translate([-60, -100, -60]) cube([120, 100, 120]);   // -Y を落とす ⇒ X-Z の断面
    else           translate([-100, -60, -60]) cube([100, 120, 120]);   // -X を落とす ⇒ Y-Z の断面
}
if (BTN3_SOLO) {
    if (part == "look")         btn3_scene();
    if (part == "explode")      btn3_scene(ex = 1);
    if (part == "press")        btn3_scene(dn = B3_CLICK);
    if (part == "secx")         btn3_half("x") btn3_scene();
    if (part == "secy")         btn3_half("y") btn3_scene();
    if (part == "p_piston")     btn3_piston();
    if (part == "p_tub")        btn3_tub();
    if (part == "p_station")    btn3_top_slice();
    if (part == "p_sw")         btn3_switch();
    if (part == "print_piston") btn3_piston_print();
    if (part == "p_piston2")    btn3_piston2();
    if (part == "print_piston2") btn3_piston2_print();
    if (part == "print_station") btn3_station_print();
    if (part == "print_tub")    btn3_tub_print();
}


// ============================================================
// 15. 数字の申告と歯止め
// ============================================================
echo(str("btn_v3 押し味: クリックまで指が ", B3_FINGER_CLICK, "mm（タクトは 0.5）／ハードストップ ",
         B3_TRAVEL, "／押し切り ", B3_FULL, "／てこ比 ", B3_RATIO, "／予圧 ", B3_PRELOAD));
echo(str("btn_v3 抜け止め: ツバ ", B3_FLG_L, " ↔ 天板の口 ", B3_OPN_L,
         " ⇒ 掛かり 片側 ", (B3_FLG_L - B3_OPN_L) / 2, "（焼くと ", (B3_FLG_L - B3_OPN_L) / 2 + B3_SHRINK,
         "）／受けるのは天板の肉 ", B3_LIP_T, "mm"));
echo(str("btn_v3 落下止め: ツバ ", B3_FLG_L, " ↔ バスタブの内のり ", B3_TUB_IX,
         " ⇒ 中へ入る道は無い（差 ", B3_FLG_L - B3_TUB_IX, "）"));
echo(str("btn_v3 ガタ: 胴 ", B3_SW[0], " x ", B3_SW[1], " ↔ ポケット ", B3_POCK_X, " x ", B3_TUB_IY,
         " ⇒ 片側 X ", (B3_POCK_X - B3_SW[0]) / 2, " / Y ", (B3_TUB_IY - B3_SW[1]) / 2,
         "／レバー先端 ", B3_TIP_X, " ↔ 壁 ±", B3_TUB_IX / 2, " ⇒ 隙間 ", B3_TUB_IX / 2 - B3_TIP_X));
echo(str("btn_v3 レバー先端の Z ", B3_TIP_Z, " ↔ ツバの下面 ", B3_Z_FLG_B, " ⇒ 隙間 ", B3_Z_FLG_B - B3_TIP_Z));
echo(str("btn_v3 深さ: 胴の底 ", B3_Z_SW_BOT, "／バスタブの底 ", B3_Z_TUB_B,
         "（v2 は -15.735 / -16.535）／端子の先 ", B3_Z_SW_BOT - B3_PIN_LEN,
         "／ねじの頭はザグリの中なので下へ出ない"));
echo(str("btn_v3 外形: 口 ", B3_OPN_L, " x ", B3_OPN_W, "（天板の表・皿は無い）／座 ", B3_PAD_L, " x ", B3_PAD_W,
         "／箱の中の最外 X ±", B3_BLK_XO, " = ", B3_BLK_XO * 2, "／バスタブ ", B3_TUB_OX, " x ", B3_TUB_OY,
         "／顔 ", B3_HEAD_L, " x ", B3_HEAD_W));
echo(str("btn_v3 ねじ: スイッチ M2 x2（机の上・頭 -Y）／縦 M2 x2（下から・芯 ±", B3_V_SCR_X,
         "・ナットは Z ", B3_NUT_Z0, "〜", B3_NUT_Z1, " の溝に横から差す）"));
echo(str("btn_v3 組む順: 天板を裏返して机に置く ①押し子を口へ落とす ②バスタブにスイッチをねじ止め ",
         "③ブロックのナットを横から差す ④バスタブを載せて縦ねじ 2 本"));

assert(B3_FINGER_CLICK > 0.8, "予圧が大きすぎて指の動く量が残らない");
assert(B3_FINGER_CLICK < B3_TRAVEL, "クリックより先にハードストップに着く（押しても入らない）");
assert(B3_TRAVEL < B3_FULL, "ハードストップより先にレバーを押し切る（レバーを壊す）");
assert(B3_FLG_L > B3_OPN_L, "ツバが天板の口より狭い ⇒ 上に抜ける");
assert(B3_FLG_W < B3_OPN_W, "ツバが Y でも掛かっている ⇒ Y を広げる圧力が戻る（v2 の道）");
assert(B3_HEAD_L < B3_OPN_L && B3_HEAD_W < B3_OPN_W, "頭が天板の口を下から通らない（組めない）");
assert(B3_FLG_L > B3_TUB_IX, "ツバがバスタブの内のりより狭い ⇒ 中へ落ちる");
assert(B3_WIN_L > B3_FLG_L && B3_WIN_W > B3_FLG_W, "ツバの部屋がツバより狭い（上下に動けない）");
assert(B3_TUB_IX / 2 - B3_TIP_X > 0.5, "レバーの先が壁に当たる（実機 2026-08-30）");
assert((B3_POCK_X - B3_SW[0]) / 2 <= 0.2 && (B3_TUB_IY - B3_SW[1]) / 2 <= 0.2,
       "胴がポケットの中で動く（実機 2026-08-30 ブレブレ）");
assert(B3_Z_FLG_B - B3_TIP_Z > 0.30, "レバーの先がツバに当たっている（柱の出 B3_PILLAR_H が足りない）");
assert(B3_HEAD_OUT < 5.5, "🔒 頭が AS5600 のつまみ（5.5）より高い");
// 🔴 芯のずれを入れた正しい式。前は WALL_YP - NUT_T で 0.6 と出ていたが実寸は 0.30 だった
assert((B3_WALL_YP + B3_WALL_YN) / 2 - B3_NUT_T >= 0.55,
       "ナットの床が薄い（実寸 = (WALL_YP + WALL_YN)/2 - NUT_T）");
assert(min(B3_EAR_T) - B3_CB_H >= 1.5, "耳がザグリに食われて薄い（頭が抜ける）");
// 足の +Y の縁 ↔ ザグリ（φ4.2・芯は B3_BLK_DY[0]）の間に残る肉。ここが足の最薄部
assert(B3_BLK_XI > B3_TUB_OX / 2, "ブロックがバスタブに食い込んでいる（入らない）");
// 🔴 2026-08-30 ユーザー「押し子にあたってんじゃん」。ツバは ±FLG_L/2 で上下に動く
assert(B3_BLK_XI >= B3_WIN_L / 2, "ブロックがツバの部屋に入っている ⇒ 押し子に当たる");
assert(B3_FLG_L > B3_OPN_L, "ツバが天板の口より狭い（再掲・掛かりが消える）");
assert(B3_V_SCR_X - B3_NUT_AF / 2 > B3_WIN_L / 2, "ナットの溝がツバの部屋を食っている");
assert(B3_NUT_Z1 < B3_Z_LIP_B - 0.5, "ナットの溝が天板の裏を突き抜けている");
assert(b3_ear_z0(0) >= B3_Z_TUB_B && b3_ear_z0(1) >= B3_Z_TUB_B, "耳がバスタブの底より下に出ている");
assert(B3_BLK_FLR >= 0.6, "ナットを載せる床が薄い");
// ⭐ 2026-09-18 口が内向きになったので、この 2 つは向きが入れ替わった。
//   内側は**口**なので肉は要らない。代わりに「座ったナットが口からはみ出さないこと」を見る。
//   六角は二面幅を X に向けているので、X の半幅は (二面幅 + 見込み)/2
assert(B3_V_SCR_X - (B3_NUT_AF + B3_SHRINK) / 2 >= B3_BLK_XI - 0.001,
       "座ったナットがブロックの内面（口）からはみ出す");
// 外側は**閉じた肉**。MJF の壁 1.2 を割らないこと（レジンも同じ数字で見る）
assert(B3_BLK_XO - B3_V_SCR_X - (B3_NUT_AF + B3_SHRINK) / 2 >= 1.2 - 0.001,
       "ナットの外の面とブロックの外面の間の肉が 1.2 未満");
assert(B3_Z_LIP_B - B3_SKIRT_Z > 0.2, "裾の高さが 0 以下（Z の定義順を間違えている）");
assert(B3_SKIRT_Z >= B3_Z_WIN_B + B3_TRAVEL, "押し切ると裾がツバの部屋から出る");
