n416/katanori/hardware/parts/fit.scad

// 嵌め合いの数式（🔒 ユーザー 2026-09-10「これかなり重要な情報なので数式にしておいて欲しい」）
//
// 🔒 ユーザー 2026-09-10「印刷用モデルと、構造生成用モデルに分けるべきです」
//    設計モデル（既定・FIT_PRINT = false）… 狙いの寸法。当たり検査・組み立て図・マニュアル・寸法の説明はこちら。
//    印刷モデル（FIT_PRINT = true）      … 焼き上がりが設計モデルになるように、初層の太りを先に打ち消した寸法。
//                                          STL を書き出すときだけ hardware/tools/stl_v5.py と props_gen.py が -D FIT_PRINT=true を渡す。
//    ⇒ 図面の数字は物と一致し、レジンを変えても設計モデルは動かない（動くのは下の FIT_BURN だけ）。
//
// 数字の出どころ: 2026-09-10 のゲージ（hardware/parts/peg_gauge.scad・補償 OFF・レジン ELEGOO）。docs/PRINT.md §2。
//   口が上の止まり穴（深さ 2.2）      : φ3.0 のダボに φ2.9 でも入る  → 効いているのは狙いの隙間だけ  = ダボ + 0.1
//   口がプレート側の止まり穴（深さ 2.4）: φ3.0 のダボに合うのは φ3.5 だけ → 隙間 0.1 ＋ 初層の太り 0.4  = ダボ + 0.5
//   ⇒ 差の 0.4 が初層の太りそのもの（片側 0.2mm）。これは横方向のほぼ一定の距離で、穴の大きさにも部品の形にも依存しない。
//     だから 1 回測れば全部に効く定数として持てる。小さい穴ほど比率で効く（φ3.0 なら 13%）。
//
// 🔒 ユーザー 2026-09-10「レジンを変えた場合にこのゲージを刷って同じテストをすべき」:
//    レジン・露光・ボトム公差補償のどれかを変えたら peg_gauge.scad（pegs / holes）を刷って測り直し、FIT_BURN と FIT_SLIP だけ更新する。
// ⚠ down / up は「その部品を刷る向きで、その穴の口がどちらを向くか」。print_<部品> の向きを変えたら呼び分けも見直すこと。
// ⚠ 口がプレート側の止まり穴は、天井から反対側へ抜き穴（φ1.5）を通してあること（小帯 C）。抜き穴が無いと吸盤になり、径をいくら広げても入らない。
// ⚠ ダボは印刷の遠い端に立てる。プレート側のダボは逆に太る（未測定なのでここでは扱わない）。

FIT_PRINT = false;   // 印刷用モデルなら true（書き出すときだけ -D で渡す）
FIT_SLIP  = 0.1;     // 狙いの隙間。設計モデルにも印刷モデルにも入る
FIT_BURN  = 0.4;     // 初層の太りの打ち消し（直径で）。印刷モデルだけに入る
FIT_THRU  = 0.2;     // 貫通穴（⚠ 眼鏡の頃の小帯 1 点だけ。ゲージで測っていないので分解していない）

function fit_burn() = FIT_PRINT ? FIT_BURN : 0;
function fit_hole_down(peg_d) = peg_d + FIT_SLIP + fit_burn();   // 口がプレート側の止まり穴
function fit_hole_up(peg_d)   = peg_d + FIT_SLIP;                // 口がプレートの反対側の止まり穴（初層に無いので打ち消し不要）
function fit_hole_thru(peg_d) = peg_d + FIT_THRU;                // 貫通穴
