n416/katanori/hardware/parts/knob_v61.scad

include <mat.scad>   // nylon() / mat_name()。スイッチは case_v6_1.scad 先頭の MAT（$mat で届く）
$mat = is_undef($mat) ? "resin" : $mat;   // 🔴 単体で開く・書き出すときの既定（-D '$mat="nylon"' で上書き）。case から use されたときは呼び出し側の $mat を引き継ぐ。無いと -D が末尾に付いて上の代入が resin のまま焼かれる（2026-09-16 に踏んだ）
function knob_mat() = mat_name();
// ============================================================
// つまみ v6.1n — parts/knob_v5.scad の写し（v6.1n・MJF ナイロン用）
//   🔒 ユーザー 2026-09-14: v5 と共用のファイルは触らない。ナイロン用の直しはこの写しだけに入れる。
//   MJF PA12（JLC3DP）: 公差 ±0.3・穴の公差 ±0.3・組む隙間 0.76 以上・最小肉 1.0
// ============================================================
// 🔒 2026-09-05 v5 用の写し（元: frozen/v1-v4/knob_v5.scad）。変更は as5600(..., hous = false) の 1 行だけ。
// つまみユニット v5 ── 島は座金＋タブ・留めは上からのねじ2本・抜け止めはEリング（2026-08-19）
//
//   openscad -o knob.stl -D 'part="knob"' hardware/knob_v5.scad   // つまみ（1個）
//   openscad -o wall.stl -D 'part="wall"' hardware/knob_v5.scad   // 島（1個）
//   openscad -o deck.stl -D 'part="deck"' hardware/knob_v5.scad   // 卓上テスト用の天板
//   （part 未指定なら組み立てビュー。part="explode" で分解図）
//
// ============================================================
// なぜ v4 を捨てたか（ユーザーの指摘。2026-08-19）
// ============================================================
// v4 の輪は矛盾していた。**レールとして精度を求められるのに圧入をしているせいで歪む。**
// へこみの穴の側壁は刷った面なので必ず荒れていて、設計では消せない。圧入すれば輪は
// その形を写して歪む。逃げを作れば留め具が無いので、側面を削ればポロポロ外れる。
// さらに輪の厚み 1.2 とツメの高さ 1.3 がほぼ等しく、縦の逃げが無かった。
// 歪みがそのまま縦に効いて、ツメが床を擦って回らなくなった（実機）。
//
// v5 の骨子と、誰が決めたか:
//   ・島はどこにも押し付けない。**圧入ゼロ**（ユーザー・3回言わせた）
//   ・島は上下に挟まれていて落ちようがない。留めはダボで足りる（ユーザー）
//   ・抜け止めは半月ではなくステンレスのEリング（ユーザー・再三）
//   ・限界止めはタブ（当たり面）だけが持つ。**ねじは限界止めを兼ねない**
//   ・外側の輪とスリットは廃止（ユーザー「歪む壁に壁を建てるな」）。島は座金＋タブ1枚
//   ・島の厚み＝ねじ頭＋薄い底、天板側を厚くして飲む（ユーザー）
//   ・軸 φ7、ねじの半径、Eリング呼び6 … **AIが決めた値**。
//     ユーザーの決定ではない。おかしければ遠慮なく動かすこと
//
// ============================================================
// 2026-08-19（同日・2回目のユーザー指示）で変えた4点
// ============================================================
//   ① 天板のダボ台座（床の掘り残し3点）を削除。へこみの床は全面フラット
//   ② 限界止めのねじ位置（タブの中心・286度）をやめる。タブは当たり面としてだけ残る
//   ③ 島を留めるねじを**2本**にして左右（±X）へ。島がその径で足りないので φ20 → φ22
//   ④ 太った島がツメの道を塞ぐので、ツメを外へ 1.0 動かし、へこみの壁と
//      つまみの外径を**半径で 1.0 ずつ**広げた（へこみ φ26.2 → φ28.2 /
//      つまみ φ25 → φ27）。⚠ 壁を広げたのはユーザー指示「横壁は荒れるから」で、
//      ツメと壁のすき間 1.4mm を現行と同じに保つため
//
// 🔴 このとき AI は「本体水平方向に2個のねじ」を**ねじの軸が水平＝横から刺す**と
//    読み違えた。正しくは**2本の並びの方向**。読み違えたまま「ツメの通り道を
//    横切るので不可能」という報告を2回出した。回る物の通り道にねじを立てる形が
//    出てきた時点で、読みの方を疑うこと。
//
// ---- 🔒 の使い方（2026-09-09 ユーザー）----
//   「周辺機構が変わったらロックそのものを削除しないといけないロックなら、それは不要だ」
//   🔒 を付けてよいのは、**隣が動いても生き残るもの**だけ:
//     ・ユーザーの決定（圧入ゼロ／抜け止めは E リング／刷る向き／ねじは短くしない …）
//     ・実物から出た値（実測・現物合わせ・印刷の実績）
//     ・方針（樹脂にネジを切らない／数字を二重に持たない）
//   付けてはいけないのは、**隣から決まる従属値**（すきま・帯の高さ・差し込む向き・座標）。
//   そこには「いまの値」と、**決め方**（回す検査の名前）を書く。値は答えであって決定ではない。
//   ⚠ ロックの付いた従属値は、隣を動かした人がロックを剥がしそこねて古い数字が正の顔で残る。
//      2026-09-09 に実際に 4 か所あった（リングの帯の高さ・通り道の障害物・段の外縁・case_v2 への波及）。
//
// ---- 組む順 ----
//   ⓪ リードの足を両端とも下へ曲げてから、裏の穴から**平らな細い棒**で、穴の天井に突き当たるまで押し込む
//   ① 島をへこみに置く（タブの向きを合わせるだけ。ダボも座も無い）
//   ② 左右のねじ2本を上から締める（**M2×6**。頭は島のザグリに沈む。ナットは台座の裏の六角ポケット）
//      🔴 ここは長らく「M2.5 ナイロン」と書いてあったが、🔒「2026-08-23、M2.5 ナイロン → M2 に変更」で古い。
//         材質はその 🔒 に書かれていないので、ここでは呼びと長さだけにする
//   ③ つまみを上から挿す（軸はまっすぐ。島の穴を素通り）
//   ④ 天板の裏から、軸の溝にEリングを横から差す。**いまの向きは ±X（左右）**。口が先頭（軸をくわえる側）。
//      ⚠ **この向きはロックしない。**周りの物から決まる従属値で、隣が動けば動く（2026-09-09 ユーザー
//         「周辺機構が変わったら削除しないといけないロックなら、それは不要だ」）。決め方は
//         part="eringpathx" / part="eringpath" を回して**空いている側を採る**。以下は 2026-09-09 時点の値。
//      2026-08-20〜09-08 は ±Y だった。入れ替わった理由は同じ日に起きた二つ:
//        ・±X を塞いでいた島のねじは、先が z −10.3 でリングの帯（−11.6〜−10.8）まで 0.5mm 届かない（2026-08-28）
//        ・±Y には 2026-09-08 の吊りで**手 4 本**が立った（世界 x 2〜8・y 12〜16。リングの帯の高さを横切る）
//      ✅ 2026-09-09 に実体で検査した（part="eringpathx" が空＝通る／"eringpath"（±Y）は 16.0mm³ 当たる）
//   ⑤ **机の上で**、AS5600 基板を**バスタブ 2**（hang_part・別部品）に留める。
//      板の裏から **M2×6 を 4 本**（頭は板の裏のザグリに沈む）、**ナット 4 個は基板の上**に直に置く。
//      座リングは無い（NCV = false）。板はヘッダ 2 列を切り欠いてあるので、基板の裏のピンはそこから下へ出る
//   ⑥ 台座の裏から下りている**手 4 本**の、**横の溝**へ M2 ナットを 1 個ずつ差す
//      （溝は隣り合う 2 本の、外を向いた面に開く。knob_station_hang_cut）
//   ⑦ 基板を付けたバスタブ 2 を、壁が手を外から掴むように被せる。
//      手の下端が板の上面のくぼみ（HANG_RECESS_D）に入って位置が決まる
//   ⑧ **壁の外から横ねじ M2×6 を 4 本**（壁 1 枚に 2 本）。壁 → 手の外の肉 → ナット の順に通る
//      🔒 2026-09-08 ユーザー案。下の「AS5600 を吊るす板」が寸法の出どころ。
//      ⚠ **棒 4 本と E リング（呼び3）3 つは廃止**。2026-08-28〜09-08 はその形だった
//         （基板の穴を φ3.5 の棒に落とし、裏から呼び3 を 3 つ・1 本はダボ）。2026-09-09 にコードごと削除
//
// ---- 🔒 治具から引き継ぐ実績値（作り直さない）----
//   SHRINK 0.1 / MAG_D 4.10 / BORE_CLEAR 0.25 / CHIP_GAP 1.1
//   HOLE_PITCH 16.10 / SLOT_LEN 2.0 / STANDOFF_D 6.0
//
// ---- 手持ち・調達 ----
//   ✅ M2 なべねじ × 6mm … 頭の高さ ✅1.3（2026-08-23 ユーザー実測）。頭の直径は下の M25_HEAD_D の節のとおり
//      （実物は未測定・ザグリは規格上限 📄φ4.0 ＋ 0.4 で切ってある）
//      🔒 2026-09-09 ユーザー「ナイロンネジはもう一つも使っていません」。
//         旧「M2.5 ナイロン・頭 3.0・頭 φ5.0」は 🔒「2026-08-23、M2.5 ナイロン → M2 に変更」で置き換わっている
//   ⬜ ステンレス Eリング … ユーザーが購入予定。軸 φ7 なので**呼び6**。
//      📄 適用軸 7〜9・溝径 6.0・厚さ 0.8・溝幅 0.9・外径 12〜13 — **記憶なので、
//      届いた実物で溝径・厚さ・外径を照合してから刷る**（外径は echo ⑤ の通り道に効く）
//
// ---- リードスイッチ: 横・水平・磁石の高さ（🔒 ユーザー 2026-08-19・最終）----
//   🔒 出発点: **下（床の中）ではぎりぎりだから横に出す**（ユーザー）。
//   🔴 AI は「水平にして」を「床下の穴に戻す」と誤読して一度戻した。正しくは
//   「横の位置のまま、水平に寝かせて磁石に近づける」。以後これが正。
//     ・磁石は軸を接線方向へ（円板を立てる＝v4 と同じ）。中心 r 9.40・外縁 r 12.40
//       🔴 2026-08-20 差し戻し。08-19 に「軸を半径方向＝面が正対」に変えていたが、
//          その向きは**2箇所で鳴る**（ユーザーがテスタで再現）。詳細は下の節
//     ・リードは水平・接線方向。へこみの壁のすぐ外（y 14.5〜17.75）、**磁石と同じ高さ**
//       （z -0.5〜-3.75。天井は見える面の下 0.5）
//     ・接点 (0, 16.125, -2.13) ↔ 磁石の外縁（r 12.40・z -2.45〜+3.55）＝
//       **真横に 3.73mm**。⚠ 「閉じるのは5mm」は**正対で測った値なので当てにしない。**
//       この距離で閉じることは v5 の実機で確かめ済み（つまみ OFF で電源が切れる・2026-09-02）
//     ・挿し方は下から圧入のまま: 裏 -9.0 から 3.95 角の呼び込み → z -4.0 から
//       3.25 角（✅実績値）の座 → 天井 -0.5 で突き当たり
//     ・押し込み量は**穴の天井**（REED_TOP -0.5）が決める。棒は平らな物でよい
//       🔒 2026-08-27 ユーザー「rod はもう完全にいりませんね」で part="rod" を削除した
//     ・足は両端から。挿す前に根元 2mm 残して下へ曲げ、両脇の縦の溝から裏へ。
//       ⚠ モールドの際で曲げると足の付け根が傷む（2mm 残す）
//       🔴 2026-08-21 訂正: ここは長らく「ガラス」と書いていたが、**現物は樹脂モールドの
//          角物**（ユーザー）。3.25mm 角の座に入る時点で丸いガラス管ではない
//   ⚠ 磁石とリードの間: 磁石の面 12.51 →（すき間）→ へこみの壁 14.1 →（肉 0.4）→ 14.5
//
// ---- ⬜ まだ入っていないもの ----
//   ・刷り直したらゼロ点を取り直す（knobzero）

part = "look";
raft = (part == "deck");   // サポートの床。刷るときだけ。-D raft=true/false
$fn  = 96;

use <parts.scad>   // magnet_reed() / as5600()

// ---- 治具から引き継ぐ ----
SHRINK     = 0.1;
MAG_D      = nylon() ? 4.50 : 4.10;   // v6.1n: 4.10 → 4.50。φ4 の磁石に対し MJF の穴は ±0.3 に振れるので、
//   4.10 だと細い側 3.8 で入らない。圧入はあきらめて**接着**にする（ポケットの壁は 1.25 残る）
MAG_DEPTH  = 2.2;
BORE_CLEAR = nylon() ? 0.80 : 0.25;   // v6.1n: 0.25 → 0.80（直径）。軸も島も MJF で、両方が ±0.3 に振れる。
//   0.25 だと最悪 −0.35 で固着する。0.80 なら最悪でも 0.20 残り、緩い側でも 1.40（半径 0.7 のがた）で収まる。
//   🔒 E リングの溝が MJF で成立しない件は、ユーザー案（2 枚・溝 1.90・径 5.85）で解決済み
PCB        = 23.0;
PCB_T      = 1.6;
CHIP_H     = 1.1;
CHIP_GAP   = 1.1;
HOLE_PITCH = 16.10;   // ✅ 2026-08-29 **決着**（⚠ ±0.03）。parts.scad の AS5600_PITCH と同じ。
//   ✅ ユーザー実測（pitch_gauge.scad の φ3.5 版・対角の棒・0.05 刻み・2026-08-29）:
//   **1610 ちょうど／1615 ややキツ／1605 ややユル**。ゲージの棒はこの PCB_HOLE_FIT_D と同寸なので、
//   入った番号がそのまま「柱が挿さるピッチ」になる。17.0 → 16.0（φ3.0 版の中心）→ 16.10。
//    ✅ 2026-08-29 **4 本挿しでも確認**（post_fit_test.scad・台座＋φ3.5 の柱 4 本・3 枚）。
//       ユーザー実測「16.05 / 16.10 / 16.15 の**全部入る。全部ギリギリ**。しいて言えば
//       1605 が少しだけ入りやすいが誤差レベル。**どれも普通には抜けない**」。
//       ⇒ 4 本挿しの余裕は少なくとも **±0.05**。16.10 はその帯の真ん中なので動かさない
//         （1605 側へ寄せるのは誤差への追従＝測り過ぎ）。印刷のばらつきで嵌合は壊れない。
//   根拠: ゲージ（pitch_gauge.scad の φ3.0 版・対角の棒）で 152/154 入らず・156〜168 入り、
//   **160 が一番ゆるい**（ユーザー実測）。ゆるい嵌合はガタが最大の所が正解にいちばん近い。
//   🔴 17.0 は 2026-08-01 の定規実測で、8 月いっぱい模型に居座って柱の位置を決めていた。
//   ⚠ ±0.1 が残っているので、**4 本とも φ3.5（PCB_HOLE_FIT_D）のままだと挿さらない可能性がある**
//      （穴 φ3.5〜3.6 に対して遊びが 0〜0.1 しかない）。これは実物の制約ではなく、
//      4 本を同じ寸法の締まり嵌めにしたこの作図の帰結。⬜ 未解決
SLOT_LEN   = 0;    // 🔒 2026-08-27 ユーザー「小判型辞めようよ。元々、ピンヘッダーを避けようとして
//   小判型にした名残でしょ」。避けるのは post_relief（座面の扇形）の仕事になったので、柱は丸へ戻す。
//   逃げとしても不要: AS5600 の穴は φ3.5 以上で M2 に対し既に ±0.75 以上ある（二重に持っていた）。
//   0 にすると post_oval / M2 の通し穴 / 六角ポケット / 逃げ穴 の hull が全部 1 個の円・六角に潰れる
STANDOFF_D = 6.0;
// 🔒 2026-08-28 **基板を留める M2 のねじ・ナット・座金は廃止した**（ユーザー案）。
//   経緯: AS5600 の穴は φ3.5 で M2 ではない。ねじでは片側 0.75 以上ガタついて基板の位置が
//   決まらず、座金で締めても座面 φ8 がヘッダのはんだ足を踏んで 4 本が同じ高さに座らなかった
//   （ユーザー「ほんとガタガタしてる」）。⇒ 穴に合う φ3.5 の棒を通し、基板の裏で E リングが受ける。
//   これで消えたもの: M2_D / M2_NUT_AF / M2_NUT_T / M2_SHELF / STANDOFF_D_LO / WASHER_* /
//   横入れの口 / 六角ポケット / 座面の扇形（post_relief）。
// ⚠ 2026-09-09 追記: **この段は経緯として読むこと。**2026-09-08 の吊りで、基板の留めは
//   M2 のねじ 4 本＋ナット 4 個に戻っている（相手は台座のスタンドオフではなくバスタブ 2 の板。
//   4 本とも同じ 1 枚の板に締まるので、上でねじをやめた理由＝スタンドオフ 4 本が同じ高さに
//   座らない、は起きない）。
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
