n416/katanori/docs/PRINT.md

# 3Dプリンター（ELEGOO Mars 3・光造形）

**刷る前に開く文書。** 設定・実績値・置き方の判断・剥がし方をここに集めてある。

| 文書 | 担当 |
|---|---|
| **PRINT.md（ここ）** | プリンタの設定・印刷の実績値・置き方と剥がし方 |
| [DIMENSIONS.md](DIMENSIONS.md) | 部品の寸法（格付けの定義もこちら） |
| [KNOB-ENCODER.md](KNOB-ENCODER.md) | つまみの機構と、刷ったものの評価 |

📄 立ち上げ時の捜査記録・失敗の経緯は 2026-08-15 に整理した。`git log -p docs/PRINT.md` で読める。

**スライサーは CHITUBOX（無料版）。** ⚠ `.ctb` は暗号化形式で露光設定が読めないため、
**他人のファイルは使わない。**

---

## 🔴 大きい部品は板が厚く出る（2026-08-30 発見 / 08-31 原因を特定・未解決）

**天板 `v4_top.stl` を刷ったら、板が 2.5mm ではなく 3.7mm で出た**（初報のノギスは 4.0、ゲージで 3.7）。
同じ日・同じ設定で刷った `btntest.stl` は 2.5mm で正しく出ている。**ファイルは正しい。機械の側で起きている。**

🔎 **正体は下の「Mars 系で知られている現象」。** 焼いているあいだ、プリンタの土台が弾性でたわみ、
ビルドプレートが FEP から離れる。断面が LCD 面積の 30% を超えると出る。**ガタではないので手で押しても分からない。**
🟡 **対策 1 回目（待機 3s ＋速度 100）で 3.7 → 3.4。動いたが消えていない。**

出方（実物で確認したもの）:

| 見たもの | モデル | 実物 |
|---|---|---|
| 天板の厚み | 2.500mm | **4.0mm** |
| 壁の根元の裾（R0.8・Z 2.500→3.300） | ある | **無い。角ばっている** |
| OLED を留める六角ナットのポケット | 入る | **六角の一番下の 1 辺が板に埋まって入らない** |
| 貫通穴（四隅のネジ・スピーカーの網目） | — | **きれいに抜けている**（＝二次硬化の膜ではない） |

ファイルが正しいことの裏取り（`.ctb` は暗号化で読めないので、CHITUBOX で開いて体積と層数を突き合わせた）:

| ctb | CHITUBOX | STL | |
|---|---|---|---|
| `top.ctb` | 19.9401 ml | `v4_top.stl` 19.70 ml / 418 層 / 20.900mm | ✅ 一致 |
| `test.ctb` | 5.27834 ml・295 層 / 14.750mm | `btntest.stl` 5.14 ml / 295 層 / 14.747mm | ✅ 一致 |

露光設定も 2 つの ctb で同一（2.500s / 初期層 30.000s / 層 0.050 / リフト 5.000・80 / リトラクト 210）。

### ✅ 切り分けの結果（2026-08-30・flat_area_test を焼いた）

大小 2 枚の板（2.5mm）を **1 ジョブで同時に**焼いた。[hardware/frozen/v1-v4/flat_area_test.scad](../hardware/frozen/v1-v4/flat_area_test.scad)。

| 測った所 | 設計 | 実物 | 差 |
|---|---|---|---|
| 大きい板 6468mm²（全面） | 2.500 | **3.7 均一** | +1.2 |
| 小さい板 1200mm²・**大に近い**短辺 | 2.500 | **3.4** | +0.9 |
| 小さい板 1200mm²・**大から遠い**短辺 | 2.500 | **2.8** | +0.3 |
| 前に刷った天板（単独） | 2.500 | **3.7** | +1.2 |
| btntest（単独・接地 1128mm²） | 2.500 | **2.5** | 0 |

🔴 **小さい板に 40mm で 0.6mm の傾斜が付き、厚い側が大きい板を向いていた。**
同じ大きさの板が、単独なら 2.5、大きい板と同居すると 2.8〜3.4 になる。
⇒ **45mm 離れた大きい板が、小さい板の厚みを変えている。**

これで消えるもの:
- **露光・レジン・光のにじみ** — 45mm 離れた板に一次関数の傾斜は作れない
- **Z=0 のずれ** — それなら全部が同じだけ厚くなる。実際は場所で違う
- **FEP 中央のたわみ** — それなら大きい板が中央だけ膨らむ。実際は**全面 3.7 で均一**
- **初期層／エレファントフット** — 初期層は 5 層＝0.25mm。育っているのは 30 層ぶん

残るもの: **焼いているあいだ、ビルドプレートが FEP から離れる向きに動いている**（大きい板の側ほど大きく＝傾いている）。
逃げ場のないレジンがプレートを押し返す力が原因、という筋。⚠ 押し返す力そのものは測っていない。

✅ **ビルドプレートの取り付けとアームのガタは無い**（2026-08-30・ユーザー判断）。
根拠は「ガタがあれば造形がもっと荒れる。過去に荒れたことがあるので分かる」。⇒ 機械の締結は容疑者から外す。

⬜ 次に試すこと（**②③は同じ 1 つの力を下げる 2 つのつまみなので、一緒に変える**）:
- **リトラクト後の待機時間 0.500s → 3.000s**（レジンが横へ逃げる時間を作る）
- **リトラクト速度 210 → 100mm/min**（押し返す力は降ろす速さに比例する。ボトムも同じに）
- ⚠ 418 層に効くので、天板の印刷時間は 1h0m → **1 時間半前後**に伸びる。

🔴 **2026-08-31・この試行はレジンが変わっている。** 灰（レジン①）が尽きたので、予備の**透明レジン**に交換した。
露光は灰の値（2.500s / 初期層 30.000s）のまま。⇒ **対照実験になっていない。**

- **2.5mm で出ても確定ではない。** 透明は灰より粘度が低いのが普通で、粘度はいま試している力そのものを決める。
  設定が効いたのか、レジンが変わったからなのか分けられない。**灰が入ったら同じ設定でもう一度焼いて確定させる。**
- **3.7mm のままなら、こちらは強い結果。** 粘度が下がり、待機と速度も入れて、なお動かないことになる。
- ⚠ **この印刷の XY 寸法は信用しない。** 透明は光を止めないので深く硬化する。§2 の実績値（磁石ポケット 4.10 /
  丸穴の縮み 0.1 / 六角 +0.3）は全部**灰**の数字。読むのは**板厚と裾だけ**にする。
- 🔄 **2026-09-02 上の「透明は〜」は的外れだった。** 変わったのは色ではなく**メーカー**である
  （✅ ユーザー「そもそもメーカーが違うのです。透明のはエレグーで、灰色（白も使っていましたが）のは
  SK本舗のなんですよ」）。⇒ 灰 ↔ 透明の比較ではなく、**SK本舗 ↔ ELEGOO という別の樹脂の比較**。
  色から機序を推し量る話は成り立たない。§2 の実績値は「灰の数字」ではなく
  **「SK本舗 Water Washable 灰の数字」**である。

### 🟡 1 回目の対策の結果（2026-08-31・天板を焼いた）

**リトラクト後の待機 0.500 → 3.000s ＋ リトラクト速度 210 → 100（ボトムも）**、レジンは灰 → **透明**。

| | 設計 | 前 | 今回 |
|---|---|---|---|
| 天板の板厚 | 2.500 | **3.7** | **3.4** |
| 会話ボタンのスイッチ | 動く | 動かない | ✅ **動くようになった** |
| OLED の六角ナット | 入る | 入らない | ✅ **入った** |

⭐ **この天板は使える。刷り直さない。**（2026-08-31・スイッチ可・ナット可）
⬜ 組むときに見る所: 板が 0.9 厚いぶん、**内側に付いている物は全部 0.9mm 短い**（ネジのボス・柱・壁の受け）。
外面基準の寸法（つまみと AS5600 の距離など）は無事。天板が壁の上に浮くか中へ食い込むかで、
箱の中の余裕（PowerBoost の上の 0.3mm）に当たる可能性がある。

🟡 **動いた。ただし解決していない（まだ +0.9）。**
- ⚠ ゲージの刻みは 0.3mm。動いたのは 1 段で、**改善量は 0.3 ± 0.3** としか言えない。
- ⚠ **設定とレジンを同時に変えている**ので、どちらが効いたか分けられない。透明は粘度が低く、
  設定と同じ向きに効く。**灰が入ったら同じ設定でもう一度焼いて確定させる。**
- 押し返す力を下げる方向へ 2 つ同時に振って、1.2 のうち取れたのが 0.3。**力はまだ大きい。**

⭐ スイッチが 0.3mm の改善で動作域に入った ⇒ **あの機構はもともと際どい所で成立していた。**

⭐ **試すときはテスト板ではなく天板そのものを刷る。** テスト板 16.2ml に対して天板は 19.9ml で、
差は 3.7ml しかない。天板の基準値は 3.7mm と分かっており、ゲージは刷り済みなのですぐ読める。
**効いていれば使える部品が 1 枚残る。** レジンが限られているときは、こちらが得。

⭐ **同じテスト板で効果を測れる。基準値は 大 3.7 / 小 3.4→2.8。**

### ✅ 「飲まれる」の正体（同日・柱 6 本の読み）

テスト板には板の上に **0.5 / 1.0 / 1.5 / 2.0 / 3.0 / 4.0mm の柱**を並べてある。消えた本数:

| | 板の育ち | 消えた柱 | 計算 |
|---|---|---|---|
| 大きい板 | +1.2 | **3 本** | 0.5・1.0 は沈む。1.5 は 0.3 しか出ずほぼ面一 |
| 小さい板（柱の列は傾斜に沿う） | 根元 +0.9 | **2 本** | 0.5 は沈む。1.0 は 0.1 しか出ない。1.5 は 0.8 出て残る |

🔴 **厚みから計算した本数と、実際に消えた本数が一致した。**

✅ テスト板の壁の根元の裾（R0.8）は**大小とも全部消えた。**裾は面から 0.8 しか立たないので、
大きい板（+1.2）では完全に沈む。小さい板も壁の位置で +0.45〜0.75 育つので、残っても 0.35 以下で見えない。
⇒ **天板で裾が角になったのと同じ現象が、テスト板で再現した。**

⇒ **層が落ちているのではない。埋まっている。** 天板の内面が育った分だけ高くなり、
それより低い形は全部その中に沈む。天板で起きたことは、これ 1 行で全部説明が付く:

- 壁の根元の裾（R0.8・頂点 Z=3.300）→ 面が 3.7 で出たので沈む。**壁が平らな面から垂直に立って見える**
- OLED の六角ナットのポケット → 一番下の 1 辺が面に飲まれてナットが入らない
- 全高が +1.1〜1.2 → 板が育った分そのもの
- 貫通穴はきれいに抜けている → 上から膜が乗ったのではないので、当然抜ける

### 📄 これは Mars 系で知られている現象だった（2026-08-31・出典あり）

[(Final) Tuning the Elegoo Mars – mind.dump()](https://blog.honzamrazek.cz/2020/01/final-tuning-the-elegoo-mars/)

- 🔴 **弱いのは Z の柱でもプレートの取り付けでもなく、プリンタ本体のベースプレート（土台）。**
  著者いわく「弱点は Z 軸の柱ではなく、プリンタ全体のベースプレート」。**ガタではなく弾性のたわみ**なので、
  手で押してガタが無くても起きる。⇒ ユーザーの「ガタは無い」という判断と矛盾しない。
- 🔒 **目安: 「サポートで浮かせて、断面が LCD 面積の 30% を超えなければ大丈夫」。**
  ⚠ ここでの断面は**プレート上の全部を足した、その層の断面積**（原文 "any large cross-sections"）。部品 1 個ではない。
- 著者の直し方は **Z 軸をリニアレール 2 本＋ボールねじに作り替えるハード改造。**設定では消えない。
- 著者は模型の高さに **約 2% の直線誤差**と、階段状の試験片で**非線形の誤差**を見つけている。

⚠ 元記事は 2020 年の**初代 Mars** の測定で、Mars 3 そのものではない。ただし土台とカンチレバーの作りは同系統。

⭐ **この記事を読む前に、うちは独立して同じ結論に着いていた。**小さい板の 0.6mm の傾斜から
「プレートが FEP から離れる向きに動く・大きい板の側ほど大きい」を出したのが先。あとから 30% の線が出てきて、
うちの 9%（育ち 0）と 40%（+1.2）がその両側に落ちた。**別々の経路が同じ所に着いている。**

#### 脇役の候補: 層をまたぐ硬化とふくらみ（同じ著者の別記事・主犯ではない）

[Cross-layer Curing and Layer Bulging – mind.dump()](https://blog.honzamrazek.cz/2022/11/cross-layer-curing-and-layer-bulging-on-resin-printers-enemy-of-overall-dimensional-accuracy-and-printed-threads/)
は、UV が下の層まで届いて**下向きの面が Z 方向にずれる**（経験値 **50〜500µm**）ことと、
**幅の広い面ほど大きくふくらむ**ことを書いている。効くのは**レジンの顔料の量**（顔料が多いほど光を止めてずれが小さい）。

🔴 **うちの症状の主犯ではない。**理由 2 つ:
1. **量が足りない。**最大 500µm でも +1.2mm には届かない。
2. **向きが逆。**透明レジンは顔料がほとんど無いので、層をまたぐ硬化は**灰より悪くなる**はず。
   ところが実測は 3.7 → 3.4 で**良くなった**。主犯ならレジンを変えた時点で悪化していた。
⇒ **主犯は土台のたわみ（機械）。層をまたぐ硬化は乗っていても脇役。**
（レジンと設定を同時に変えてしまったのは痛いが、**この 1 点に関しては切り分けの材料になった。**）

⬜ **レジンを使わない knob: レジンの温度。** 同記事は「温かいと粘度が下がってふくらみが減る」を挙げている。
粘度が下がれば押し返す力も下がるので、両方に効く。**次に焼くとき、部屋かレジンを暖めるだけで試せる。**

**Mars 3 の LCD は 143.43 × 89.6 = 12,851mm²。**下の表の「LCD 比」はこれに対する割合。
**30% の線が、うちの「出た組」と「出なかった組」のちょうど間に落ちる**（9% で 0、40% で +1.2）。

### 🔴 部品ごとの接地と、育ちの記録（2026-08-31・**刷るたびに埋める**）

🔴 **効く量は「その層の断面積の合計」。**部品 1 個の接地ではなく、**プレートに載っている全部の、
その層での断面積を足した値**が LCD 面積の 30% を超えると出る（原文 "you don't have any large
cross-sections (let's say more than 30 % of the LCD surface)" ＝ 合計側）。

⚠ 下の表の「接地」は、**平らな板を伏せて直置きする場合の近似**でしかない。板は最初の 50 層が
ほぼ footprint そのものなので接地 ≒ 断面積になるが、背の高い部品では層ごとに変わる。
**2 枚以上載せるときは足し算する。**（実例: 大 6468 ＋ 小 1200 ＝ **7668mm² ＝ 60%**。
このとき小さい板は単独 9% なら 2.5 で出るのに、2.8〜3.4 になった。）

育つ量は断面積で決まるので、**部品ごと・プレートごとに違う。**刷ったらゲージ
（[thick_gauge](../hardware/frozen/v1-v4/thick_gauge.scad)）を当てて、この表を埋めること。
**測るための印刷は要らない。どのみち刷る物を測るだけ。**

| | 部品 | 接地mm² | LCD 比 | 実測の育ち |
|---|---|---|---|---|
| 🔴 | テスト板（大・参考） | 6468 | **50%** | **+1.2**（灰） |
| 🔴 | **v4_floor** | **5748** | **45%** | **+0.8**（透明・待機3s＋速度100／設計 2.0 → 実測 2.8・2026-09-01） |
| 🔴 | v4_top | 5147 | **40%** | **+1.2**（灰・旧設定）／**+0.9**（透明・待機3s＋速度100） |
| 🟡 | **v4_hatch** | 3411 | 27% | **+0.2**（設計 2.0 → 実測 **2.2**・2026-09-04） |
| 🟡 | **v4_lwall / v4_rwall** | 3380 / 3359 | 26% | **+0.2**（設計 2.0 → 実測 **2.2**・2026-09-04） |
| 🟡 | v4_bridge | 2280 | 18% | ⬜ 未測定 |
| ✅ | **v4_front** | 1465 | 11% | **0**（設計 2.0 → 実測 **2.0**・2026-09-04） |
| ✅ | btntest | 1128 | **9%** | **0**（正しく出た） |
| ✅ | 残り 20 点 | 1059 以下 | 8% 以下 | btntest 側。knob_deck 1059 / knob 494 / seat 61 / post 各 2 |

✅ **あいだが 2026-09-04 に埋まった。** 9% と 11% で **0**、26〜27% で **+0.2**、4 0〜45% で **+0.8〜0.9**。
⇒ **30% の線の下でも既にわずかに立ち上がっており、その先で急に伸びる。**30% はスイッチではなく、実害が出始める目安である。

🔴 **大きい部品と、精度の要る部品を同じプレートに載せない。**
2026-08-31、1200mm² の板は**単独なら 2.5** で出るのに、6468mm² と同居させたら **2.8〜3.4** になり、
しかも**大きい板に近い側ほど厚い**傾斜が付いた。小さくても巻き込まれる。

⚠ **接地の広い部品（天板は 5147mm²、btntest は 1128mm²）を刷る前に、この項目を読むこと。**

---

## 1. 🔒 設定 — この数字を変えると寸法が全部変わる

| タブ | 項目 | 値 |
|---|---|---|
| 印刷 | レイヤーの高さ | **0.050mm** |
| 印刷 | 初期層の数 | **5** |
| 印刷 | 露光時間 | **2.500s** |
| 印刷 | 初期層の露光時間 | **30.000s** |
| 印刷 | リフト高さ / 初期層リフト距離 | **5.000mm** |
| 印刷 | 上昇速度 / 初期層上昇速度 | **80 / 60 mm/min** |
| 印刷 | リトラクト速度 / ボトムリトラクト速度 | **100 mm/min** 🔄 2026-08-31（210 から） |
| 印刷 | 遷移レイヤー数 / タイプ | **5 / リニア** |
| 印刷 | プリント中の待機モード | **待機時間** |
| 印刷 | リフト前 / リフト後の待機時間 | **0.000s / 0.000s** |
| 印刷 | **リトラクト後の待機時間** | **3.000s** 🔄 2026-08-31（0.500 から）⚠ 下 |
| 高度設定 | **収縮補償** | 🔴 **OFF** |
| 高度設定 | 許容範囲補償 / ボトム公差補償 | **OFF** ⚠ 下 |
| 高度設定 | アンチエイリアシング / 画像ぼかし | グレースケール（127〜255）/ 2px |

⚠ **ボトム公差補償（2026-09-05 に初めて話に上がった）**: 初期層の輪郭を内側に縮めて、初期層の露光（5 層 × 30s）で横に太る分（エレファントフット）を打ち消す設定。
収縮補償とは別物で、効くのは初期層だけ。現物の症状: 会話ボタンの押し子（天面をベッドに伏せて刷る）は天面の面取り 0.8 が消えて角が立ち、
皮の外周の丸み R 2.0（外面を下に刷る）は底の側が埋まって折れた斜面に見える（v4 の印刷物・ユーザー 2026-09-05）。
🔴 OFF のままだった理由は記録に無い。機械の値を写しただけで、誰もこの症状と結びつけていなかった。
ON にするなら: ベッドに接する面の寸法だけ下の実績（穴 −0.1・六角 +0.3・初層で塞がる）が使えなくなるので、その面の寸法は取り直し。それより上の層は変わらない。
下向きの面の Z ずれ（§ 脇役の候補・50〜500µm）はこの設定では消えないので、天面の面取りは 1.2 に上げてある（btn_v3 / knob_v5・2026-09-05）。
✅ **2026-09-05 実機: ON（a 0.200 / b 0.200）で外面を下にして刷っても、丸みは出なかった**（ユーザー「やっぱり丸みがでませんね」）。
🔒 **2026-09-10 ユーザー決定（こちらが新しい）: 小帯を刷り直す回（ターム 2026-09-10-0522）は **OFF** で刷る。**「3mm にして。ボトム公差は切る」**。
凹みは φ3.0 に戻してある（補償が無ければ真の φ3.0 で、ダボ φ2.75 との差は 0.25）。

🔒 **2026-09-10 ユーザー決定: 帯の回（ターム 2026-09-10-0319・帯 A/B/C ＋ 小帯）は ON で刷る。**
ブリッジの回（2026-09-10-0320）は **OFF のまま**。理由: 帯は足の裏を下にして刷り、台形のいちばん広い所がベッドに接するので、
初層の太りがそのまま「土手の座に入らない」になる。小帯も、裏の凹み（ダボ φ2.75 を受ける φ3.0）が「プレート側の穴は初層で塞がる」で
実際に入らなかった所で、ON ならベッド側の穴は広がる。どちらもゆるむ方向で、嵌まりには安全側。
ブリッジのベッド側は皿の裏（前板のフランジの掘り込み・ナットの箱）で嵌め合いが無く、上の「ON にすると使えなくなる実績」を
手放す理由が無いので触らない。⚠ この機のエレファントフットの太り量は**実測されていない**（上の +0.45〜0.75 は板が育つ話で別物）。

この設定は横（象の足）にしか効かない。丸みが埋まるのは縦の現象で、丸みの区間では層ごとに輪郭が外へ広がるので、
広い層を焼く光が輪郭の外側を通ってプレート側（＝下の狭い層の脇の空き）へ抜け、初期層と遷移層（30s → 2.5s の 5 層）の
余分な露光がその空きを埋める。効く設定は初期層の数・初期層の露光・遷移レイヤー数で、どれも食いつきと引き換え
（35s → 30s は「剥がれない」で下げた値）。ON のままだとベッド側の輪郭が 0.2 内側に寄る（🔴 **「穴は広がる」と書いてあったが、実物は逆である。2026-09-10、ON で刷った 0319 の小帯の、プレート側に開く凹み φ3.0 へ φ2.75 のダボが**まったく入らなかった**（ユーザー）。a 0.200 / b 0.200 なら直径で 0.4 縮む向きで、実効 φ2.6 になる。同じ φ3.0 でも、印刷の遠い端に開く天板の棒の穴では同じダボがブラブラだった。ベッド側に嵌め合いの穴がある部品を ON で刷るなら、穴は 0.4 大きく描くか、その回だけ OFF にする**）ので、丸みが目的なら戻す。

🔴 **収縮補償を絶対に ON にしない。** 下の「穴は約0.1mm縮む」は**補償OFFで測った実測値**で、
設計値に手で足す前提になっている。ON にするとスライサーの補正と二重にかかり、**穴が大きくなる**
（4.2mm＝逆さで落ちる側へ寄る）。

⚠ **これはレジン①（水洗い灰）の値。** レジン②（Ultra高靭性白）に移るときは露光を取り直す
（下の「レジン」）。

🔒 **Z=0 はこの機体では毎回の印刷ごとに取り直す運用。** プレートを削っても Z ずれは発生しない。

🔄 **2026-08-31 に 2 か所を変えた。**リトラクト後の待機 0.500 → **3.000s**、リトラクト速度 210 → **100mm/min**
（ボトムも）。狙いは、大きい平面を降ろすときにレジンが押し返す力を下げること
（[UVtools の wiki](https://github.com/sn4k3/UVtools/wiki/Rest-times-and-TSMC) は待機の出発点として 2〜3s を挙げている）。
**結果は天板の板厚 3.7 → 3.4。動いたが解決していない**（冒頭の項目）。
⚠ 418 層に効くので、天板の印刷時間は 1h0m → **1h29m** に伸びた。
⚠ この 2 つを変えたときレジンも灰→透明に変わっているので、**どちらが効いたかは未確定。**
⚠ **旧値（0.500s / 210mm/min）は、それ以前に刷った全部の部品の条件。**古い部品の寸法を語るときはこちらで読む。

⚠ **初期層の露光は 35s → 30s へ下げてある。** 理由はユーザー「あまりにも剥がれない時に設定を変えた」。
以降ずっと 30s。**変更した時期は記録が無い。** 2026-08-30 に `top.ctb` と `test.ctb` の両方を
CHITUBOX で開いて 30.000s であることを確認した（この表は 35.000s のまま残っていた）。
⚠ 初期層の露光が効くのは最初の 5 層だけなので、**下の「実績値」の丸穴の縮み 0.1mm は 2.500s の側の値で、
この変更では動かない。**

## 2. 🔒 実績値（この設定で焼いたときの値）

| 何 | 値 | 出どころ |
|---|---|---|
| **磁石ポケットの内径**（φ4磁石） | **4.10mm** | ゲージ8個で確定。4.2は逆さで落ちる |
| **丸穴の縮み** | **約0.1mm**（設計値に足す） | 上の副産物 |
| **止まり穴の向きで径が変わる** | 口が**プレート側**（抜き穴あり・深さ 2.4）: ダボ φ3.0 に合うのは **φ3.5 だけ**（作図差 0.5）。口が**上**（深さ 2.2）: φ3.0 のダボに **φ2.9 でも入る**（穴は作図より大きく焼ける） | 🔒 2026-09-10 ゲージ（peg_gauge・補償 OFF）。ユーザー「凄まじい差」。小帯 C（凹み 3.35 にダボ 2.75）が入って 3.0 が入らなかったのと整合 |
| **OLED のダボの間隔** | **65.7**（66.1 は広い） | 🔒 2026-09-10 ゲージ（oled_peg_gauge） |
| **嵌め合いの数式** | `hardware/parts/fit.scad`: 穴 = ダボ + 0.5（口がプレート側）／ + 0.1（口が上）／ + 0.2（貫通、1 点）。使う側は `fit_hole_down/up/thru(ダボ径)` を呼ぶ | 🔒 ユーザー 2026-09-10「数式にして」「レジンを変えたらこのゲージを刷って同じテストを」 |
| **六角ポケット** | **呼び + 0.3 でジャスト** | 実績 |
| 可動部でない穴の見込み | +0.2〜0.4mm | 現物合わせ |
| **プリント一体の板バネ** | 🔴 **レジン①では作れない**（下） | 9枚のゲージ＋再試験 |
| 印刷時間 | **CHITUBOX の見積り × 1.3 が実測** | 20分/15分1秒 |
| 薄壁の下限 | **0.3mm が形になる** | 1回目のテスト |
| 細ピンの下限 | φ1.5 は出た。**φ1.0 は剥離に負けて欠けた** | 〃 |

⚠ **プレート側の穴は初層で塞がる。ザグリで浮かせること。**
🔒 **プレートに口を向けた止まり穴は吸盤になる（ユーザー 2026-09-10）。** 中のレジンが抜けずに固まり、径を 3.0 → 3.35 にしてもザグリを足しても φ2.75 のダボがまったく入らなかった（小帯 A/B）。
直しは径ではなく反対側へ抜くこと: 天井から真上へ φ1.5 を抜いた C と、側面へ幅 1.5 の横穴を通した D はどちらも入った（✅ 2026-09-10）。
D は上のダボが少し斜めに出たので C を採った。ザグリは効かない（吸盤の面積を広げるだけ）。

### 🔴 透明レジンでは上の数字が効いていない（2026-09-01 実機・未解決）

**この表は全部レジン①（SK本舗 Water Washable 灰）の数字である。** それが尽きて
**ELEGOO の透明レジン**に替え、露光は SK本舗の値のまま（2.500s / 初期層 30.000s）で焼いた
2026-09-01-1525 の実物で、次が起きた。⚠ **変わったのは色ではなくメーカーである**（§1 の 🔄）。

| 見たもの | 設計 | 実物 |
|---|---|---|
| 電池の蓋の磁石ポケット φ6.10（磁石 φ6.0） | 圧入 | **スポスポ抜ける**（✅ ユーザー） |
| つまみ（knob_v5）の磁石 | 圧入 | **同じく抜ける**（✅ 同） |
| 蓋の磁石の枠 0.10mm の輪 | 出る | **焼けなかった** |
| バスタブの浮いた腕（庇 17.19mm²） | 出る | **斜め・一部出なかった** |

⭐ **読み方はこうである。** φ6.0 の磁石に対して φ6.10 で描いた穴が、灰では圧入になっていた。
これは**穴が 0.1mm 以上縮んで焼き上がっていた**ということで、上の「丸穴の縮み 約 0.1mm」がその値である。
その同じ穴で磁石が抜けるようになったのだから、**透明では穴が大きく焼けている＝縮みが減っている。**

🔴 **これは §1 に書いてある「透明は光を止めないので深く硬化する」と向きが逆である。**
深く硬化するなら穴は小さくなり、磁石はもっときつくなるはずだった。ユーザー
「なんか AI は透明の方が収縮率が高い的な話をしていたけど逆っぽいよ」。**実物が正しい。**
そして色で説明しようとしたこと自体が的外れで、**別メーカーの別の樹脂に替わっている**（§1 の 🔄）。
⬜ 機序は未解決。ただし §7 に「露光時間はレジンとプリンタの組み合わせごとの実測値」と既に書いてある。
**SK本舗の露光時間で ELEGOO を焼いている**のが効いている可能性は高いが、**確かめていない。**

### 1525 の 3 つの失敗のうち、レジンのせいなのは 1 つだけ

刷った本人の一次所見は「恐らく新しい透明レジンのせいだろう」だったが、形を測ると分かれた。

| 起きたこと | 本当の原因 | レジンを替えたら直るか |
|---|---|---|
| 蓋の磁石の枠が焼けなかった | 枠の設計値が **0.10mm**（帯 6.30 の中央に φ6.10 を置いた残り） | **直らない。** どのレジンでも消える |
| バスタブの腕が斜め・一部出ない | 耳の下 **1.085mm** が浮き、支えの無い天井 **17.19mm²** が支柱なしだった | **直らない。** 形の問題 |
| 磁石が圧入にならず抜ける | 丸穴の縮みが SK本舗の 0.1mm 前提のまま | **これだけがレジンの話** |

⇒ **この印刷に、ELEGOO の品質を疑う根拠は無い。** 上 2 つは私（AI）の作図の穴で、両方その場で直した。

### 常用レジンを ELEGOO にする話（2026-09-02・ユーザーの意向）

ユーザー「価格が 2 倍くらい違うので、この品質ならずっとエレグーで良いかなと思っています」。

| | 量 | 価格 | 密度 1.1g/ml と見た ml 単価 |
|---|---|---|---|
| ELEGOO 水洗い可能 2.0 クリアブルー | 1000g（≈909ml） | 2,879 円 | **約 3.2 円/ml** |
| SK本舗（レジン①の系統） | 500ml | 3,600 円 | 約 7.2 円/ml |

⇒ **約 2.3 倍。** ⚠ g → ml は密度 1.1 と置いた換算で、実測ではない。

✅ **洗い方は変わらない。** ELEGOO 水洗い可能 2.0 も**水洗い**なので、§5 の運用（Mercury Plus に水・
洗った水は排水に流さない）がそのまま使える。レジン①（SK本舗 Water Washable 灰）と**同じ系統**である。

🔴 **ただし §7 が「本番用」に選んでいたのは SK本舗 Ultra 高靭性 白で、選んだ理由は靭性である。**
いまの目標は「毎日会議へ連れ歩く物」で、制約は納期ではなく**耐久性**に入れ替わっている。
水洗い系のレジンでその用途に耐えるかは、**どちらのレジンでもまだ試していない**（落下・繰り返しの
開け閉め・ネジの効きを実物で確かめた記録が無い）。⬜ 値段はこの問いに答えない。常用を決める前に
ここを立てておく。
⬜ **まだ決定ではないが、そうなるなら §7 の「本番レジン（レジン②＝SK本舗 Ultra 高靭性 白）へ移る宿題」は
移る先が変わる。** 常用にするなら露光と §2 の実績値は**一度きちんと取り直す価値がある**（使い捨ての
つなぎではなくなるため）。

### 🔄 「露光を取り直す」は取り下げ（2026-09-02）

一度ここに「露光が先、寸法は後」と書いたが、**間違いだった**。ユーザー
「露光は取り直すって言いますけど、もうこれで全部刷ってますよ」。**その通りである。**
SK本舗の露光（2.500s / 初期層 30.000s）のまま ELEGOO で焼いた記録は、印刷ログで **7 回・うち 6 回 ok**:

| 回 | 刷った物 | 結果 |
|---|---|---|
| 08-31-1631 | knob / knobwall / piston | ✅「問題なく出た。多少張り付きが厳しかったかも」 |
| 08-31-1957 | knob / knobwall | ✅「ばっちり」 |
| 08-31-2325 | floor | ✅「ばっちり」 |
| 09-01-0107 | cb_depth_gauge | ✅「裏の文字が消えてる。薄すぎるよ」 |
| 09-01-0352 | lwall | ✅「良い感じでした。」 |
| 09-01-1339 | rwall | ✅「USB の刻印がみえませんね」 |
| 09-01-1525 | front / shutter / tub / lock | ❌（3 件。うち 2 件は作図の穴） |

⇒ **この露光は ELEGOO で通っている。合わせ直す理由が無い。⇒ これを ELEGOO の基準値として固定する。**

### 🔄 「細く焼けている徴候が 3 つある」も取り下げ（2026-09-02・同日）

一度ここに「裏の文字が消えた／USB の刻印が見えない／蓋の 0.10mm の輪が消えた ＝ 細く焼けている
徴候が 3 つ」と書いたが、**3 つとも徴候ではなかった。** ユーザー「蓋の 0.10mm の輪が消えたって
のはそもそも印刷できる許容を超えているだけでしょ」。**その通りである。**

| 一度「徴候」に数えた物 | 実際 |
|---|---|
| 蓋の 0.10mm の輪 | **§2 の「薄壁の下限 0.3mm」の下**。レジンでも露光でもなく、ただの設計値の誤り。この文書の上の表にも「どのレジンでも消える」と自分で書いてある |
| `cb_depth_gauge` の裏の文字 | ユーザーの所見自体が「**薄すぎるよ**」。同じく設計値 |
| `rwall` の USB の刻印（彫り 0.4） | 彫りは在る。**クリアブルーの透明樹脂では 0.4 の凹凸が目で読めない**。寸法ではなく見え方の話（⇒ 彫りを 1.0 に深くして解決・コミット 63a1b71） |

⇒ **寸法が変わったと言える実測は、磁石の嵌め合い 1 件だけである。** 露光を疑う根拠は無い。

### ✅ ELEGOO の縮みは **ほぼ 0**（2026-08-31 に実物で確定済み）

🔴 **この節を一度「⬜ 未解決。ゲージを焼いて取り直す」と書いたのは誤りだった。**
答えは同じ日に出ていて、[knob_v5.scad](../hardware/frozen/v1-v4/knob_v5.scad) の 257〜282 行に残っている。

| レジン | 設計 | 焼き上がり | 締め代（磁石の厚み 2.02 に対して） | 出どころ |
|---|---|---|---|---|
| SK本舗（旧） | 2.02 | **1.92**（縮み 0.10） | 0.10 ＝ 壊さないと抜けない | ✅ 08-21 の現物 |
| **ELEGOO 透明** | 2.02 | **≒ 2.02**（縮み ≒ 0） | 0 ＝ **ポロポロ落ちる** | ✅ 08-31 ユーザー「磁石ポロポロでした。透明レジンの収縮は少ないみたいですね」 |
| **ELEGOO 透明** | **1.97** | ≒ 1.97 | **0.05 ＝ 丁度** | ✅ 08-31「丁度入りますね。すこしキツイくらいなので丁度いいです」 |

⭐ **手順はゲージではなかった。**「二点（旧の焼き上がりと透明の焼き上がり）から欲しい締め代を引き、
設計値を下げて、実物で確かめる」で 1 発で当たっている。**同じ症状が出たら、まずこの表を見る。**

### 適用（2026-09-02）

同じ理屈を電池の蓋の磁石ポケットへ移した（[case_v3_shutter.scad](../hardware/frozen/v1-v4/case_v3_shutter.scad) `SHUT_MAG_D`）。

| | 設計 | 焼き上がり | 結果 |
|---|---|---|---|
| SK本舗 | 6.10 | ≒ 6.00 ＝ 磁石と同寸 | 圧入になっていた |
| ELEGOO（1525 で刷った物） | 6.10 | ≒ 6.10 | 隙間 0.10 ＝ **スポスポ抜ける** |
| **ELEGOO（直した）** | **6.00** | ≒ 6.00 | 旧レジンの焼き上がりと同じ寸法を作り直す |

⚠ まだ緩ければ 5.95（締め代 0.05・つまみで当たった値）へ。**ゲージは焼かない。**

🔴 **同じ前提の上に立っている数字がまだ残っている。** §2 の表の「丸穴の縮み 約 0.1mm」「六角ポケット
呼び + 0.3」「可動部でない穴の見込み +0.2〜0.4」は**全部 SK本舗の縮み 0.1 を前提にした値**で、
ELEGOO ではその見込みが乗らない。⬜ ナットのポケットや圧入の穴を次に触るときは、ここへ戻ること。
つまみは磁石を**立てて滑らせる**入れ方なので、読むのは立て溝の側である（§ 下の「ゲージの答えは
どの入れ方で測ったかとセット」）。

⚠ **この 0.1mm は上の設定での値。** この設定を**恒久的に変える**なら取り直す。
**うっかり別設定で刷った回があっても、この表に戻せば数字はそのまま有効**である
（実害は「別設定で刷ったその部品にこの数字が効いていない」ことだけ）。

## 2.5 印刷時間は背の高さで決まる（2026-08-27）

**光造形の時間は樹脂の量ではなく層数で決まる。** 1 層は面ごと一度に焼くので、
プレートに何個載っていても時間は変わらない。**1 回の印刷にかかる時間は、
そのプレートで一番背の高い部品だけが決めている。**

🔒 **ただし 1 ターム ＝ 印刷 30 分 ＋ 人手 30 分 ＝ 1 時間。研ぎ直しになれば 2 時間**
（2026-09-02 ユーザー「掃除したり磨いたり、なんだかんだで 1 タームの間に 30 分以上は
掛かってるんだよ」「ゲージ印刷 30 分、そして手間で 30 分。傷がついて磨きなおしになれば
2 時間はかかるんだよ」）。
⚠ **「分けるか、まとめるか」を層数の差だけで比べない。** ターム 1 回を増やすと、
露光の差に加えて**人の 30 分**が必ず乗る。高いのは機械の時間ではなくそちらである。
🔴 **例（2026-09-02・分けたのは誤りだった）。** スペーサーの試し刷りとバスタブ＋パネルを
分けた。ユーザーの後日談「やっぱり今 1 時間以上待ってるのを考えると一緒に印刷すべきだったな」。

間違いは**重みの付け方**である。分ける代償（人の 1 時間）は**確実に発生する**のに対し、
避けようとした損失は「試し刷りが失敗し、**かつ**欠片が同居の部品を巻き込んだ場合」で、
しかもバスタブもパネルも**刷り直せる部品**だった。確実な支払いと、起きるかもしれない損失を
同じ重さで並べてはいけない。

⚠ さらに、同居を避ける理由に挙げた「大きい板が小さい部品の厚みを変える」は、
そのとき自分で「較正の犯人は 6468mm² で、パネルの 1430mm² で起きるかは未確認。
疑いであって確定ではない」と書いていた。**自分で疑いと書いたものに人の 1 時間を払わせない。**

⭐ **分けるのは、同居の相手が「刷り直せない物」か「その回でしか取れない物」のときだけ。**
それ以外は、確実な 1 時間の方が高い。
⬜ `surugo` が出す `min_sec` は**露光だけの下限**で、この 30 分は入っていない。

層数 ＝ 部品の背 ÷ **0.050mm**（§1）。露光は 1 層 **2.500s** なので、
**層数 × 2.5 秒が下限**である（実際は昇降が乗るのでこれより長い。§2 の
「CHITUBOX の見積り × 1.3 が実測」で換算する）。

### 版ごとの「一番背の高い部品」

どれも **刷る向きで焼いた STL の Z** を `python hardware/frozen/v1-v4/_bbox.py` で測った値（2026-08-27）。

| 版 | 一番背の高い部品 | 背 | 層数 | 露光だけの下限 |
|---|---|---|---|---|
| v1 | 上シェル（天面を下） | 57.21mm | **1,145** | 48 分 |
| v2 | 上シェル（天面を下） | 51.10mm | **1,022** | 43 分 |
| v3 | 天面（外面を下） | 18.10mm | **362** | 15 分 |
| v4 | 天面（外面を下） | 18.10mm | **362** | 15 分 |
| （全版共通） | **尻尾**（立てて刷る） | **33.78mm** | **676** | 28 分 |

⭐ **v2 → v3 で 1 回あたりが 1,022 → 362 層（3 分の 1）になった。**
上下 2 枚貝を板 6 枚に割ったので、**箱の高さがそのまま印刷の背だったのが、板の厚みになった**。
[ARCHITECTURE.md](ARCHITECTURE.md) の「v1 → v4 の変遷」のとおり、この版で外寸はほとんど動いていない。
**縮んだのは箱ではなく、1 回の印刷である。**

### v4 の 25 点（刷る向きの背・低い順）

この表は `hardware/stl/v4/*.stl` の実物の背から起こしている（2026-08-30 に焼き直したもの）。

| 部品 | 背 | 層数 | | 部品 | 背 | 層数 |
|---|---|---|---|---|---|---|
| 電池の蓋 | 2.75mm | 55 | | 前板 | 8.00mm | 160 |
| 蓋のロック | 3.00mm | 60 | | 会話ボタンの押し子 | 8.29mm | 166 |
| つまみの島 | 3.90mm | 78 | | 床 | 8.50mm | 170 |
| 充電基板の受け | 4.21mm | 84 | | 右の壁 | 9.00mm | 180 |
| 支柱 #0 | 5.90mm | 118 | | 左の壁 | 9.00mm | 180 |
| 支柱 #1 | 5.90mm | 118 | | 会話ボタンのバスタブ | 9.34mm | 187 |
| ブリッジ | 6.00mm | 120 | | 支柱 #5 | 9.83mm | 197 |
| 支柱 #2 | 6.01mm | 120 | | 支柱 #3 | 10.32mm | 206 |
| ハッチ | 6.60mm | 132 | | フロント | 11.00mm | 220 |
| 支柱 #4 | 6.65mm | 133 | | 天面 | 20.90mm | 418 |
| 留め帯 A | 8.00mm | 160 | | つまみ | 21.40mm | 428 |
| 留め帯 B | 8.00mm | 160 | | 尻尾 | 33.78mm | 676 |
| 留め帯 C | 8.00mm | 160 | |  |  |  |

🔴 2026-08-29〜30 に**留め帯 3 本を天面下向きへ伏せた**ので、背が 9.00 / 12.17 / 9.44 から
**3 本とも 8.00 へ揃った**。座のパッドを**支柱 6 本**として別部品に出したためで、帯の天面が
平らな 1 枚になり、支えの無い天井（26mm²）も島（1 か所）も柱も 0 になっている。
⚠ 支柱の接地は 2mm² しかない（細い軸を下にして立てるため）。**単独で刷らず、必ず他の部品と
一緒にプレートへ並べてラフトを敷く。**

🔴 **未解決の矛盾（2026-08-31）— 上の「ラフトを敷く」は §3 と食い違っている。**
§3 はこう書いている:「効かないのは**ラフト単体**（部品をラフトにベタ置き）で、融着して一体になるだけ。
**『サポート＋ラフト』は標準の作法**」。⇒ **接地 2mm² の支柱にラフトだけ敷いても、
くっついて取れないか、そもそも支えになっていない可能性がある。**

🔴 ユーザーの見立て:「この記述が出来たのは恐らく、**光造形じゃない所に AI が落ち込んで
アイデアを出していた**からだと思う」。⚠ 「ラフトを敷けば接地の小さい部品が固定できる」は
**FDM の作法**であって、光造形では §3 のとおり成立しない。**筋が通っている。**

⚠ **どちらが正かは未確定。片方を消さないこと。** 確かめずに支柱 6 本を刷ると、
2mm² の足のまま焼くことになる。

⬜ 効いてくる先: 支柱の正解が「サポート＋ラフトで浮かせる」だった場合、**支柱 6 本は
「浮かせて刷る部品」に該当する。**「いまは持ち上げて刷るパターンが無い」という前提が崩れ、
配置を自動化するパイプラインの範囲が変わる。

🔴 **尻尾 1 個が、v4 の印刷の重さの 4 割を占めている。** 樹脂は 2,016mm³（24 点の 2.3%）しか
使わないのに、立てて刷るので **676 層**ある。天面（362 層）の 1.9 倍で、v4 で一番長い印刷はこの部品である。
⬜ **寝かせられるかは置き方の判断（§3）で、まだ誰も決めていない。** 寝かせれば背は 12.97mm ＝ 260 層になる。

### プレートに何回分載るか

Mars 3 のプレートは **143 × 89mm**（§4）。**支柱と犠牲タブを含めた実寸**で見ると、大物は
どの版も 1 プレートに 1 枚しか載りません。

| 版 | 大物 | 1 プレートに 2 枚並ぶか |
|---|---|---|
| v1 | 上下シェル 90 × 84 | ❌（90 × 2 = 180 > 143） |
| v2 | 上下シェル 90 × 76 | ❌（同上） |
| v4 | 床・天面・フロント・ハッチ 86.65 × 〜75 | ❌（86.65 × 2 = 173 > 143） |
| v4 | 左右の壁 48.45 × 71 | ✅（96.9 × 71 で 1 プレートに載る） |

⚠ 2026-08-29 に犠牲タブを外した（下の §4）ので、上の実寸は**タブ抜きの外形**です。タブが付いていた頃は
長い軸に片側 7mm ずつ ＝ 14mm 大きく、床・天面・フロント・ハッチは 100.66 と数えていました。

⭐ **小物は大物の脇に同乗させれば 0 秒である**（🔒 2026-08-27 ユーザー指摘）。
1 層は面ごと一度に焼くので、**同じプレートに載っていて、その回で一番高い部品より低いなら、
その部品の印刷時間はゼロ**です。大物の脇には必ず余りが出ます ── 90mm の板なら **53 × 89**、
86.65mm の板なら **56.4 × 89** ＋ 板の奥の帯。v1 の尻尾・ボタン・クリップ・ワッシャも、
v4 の留め帯・受け・蓋・ロック・前板も、全部この余りに入ります。

**同乗を数えた回数と層数**（⚠ AI が寸法を突き合わせた読み。スライサで詰めた結果ではない）:

| 版 | 回数 | 各回の層数 | 総層数 |
|---|---|---|---|
| v1 | **2 回** | 1,145（上シェル＋小物）／ 1,135（下シェル） | **2,280** |
| v2 | **2 回** | 1,022（上シェル＋小物）／ 1,002（下シェル） | **2,024** |
| v4 | **6 回** | 676（天面＋**尻尾**＋小物全部）／ 220 フロント ／ 180 左右の壁 ／ 170 床 ／ 132 ハッチ ／ 120 ブリッジ | **1,498** |

**1 回あたりは 1,145 → 676 層、総量は 2,280 → 1,498 層（−34%）。**
回数は 2 → 6 に増えますが、増えたぶんは**どれも 132〜220 層＝ 6〜9 分の短い回**です。
回数ぶんかかるのは初層 5 層 × 35 秒（＝ 約 3 分）と、洗浄・二次硬化・剥がしの手間です。

⬜ **尻尾を寝かせれば、その 1 回が 676 → 362 層（天面が上限）になり、総層数は 1,184 層になる。**
判断は §3（置き方）。

## 3. 刷る前の判断 — 直置きか、サポートで浮かせるか

🔴 **分かれ目は「底面が平らかどうか」ではない。**

| 部品の性質 | 置き方 |
|---|---|
| 傾けてよい／断面が層ごとに変わる部品 | ✅ **サポートで浮かせる**（光造形の標準の作法） |
| **壁が垂直で、上面に精度の要る基準面がある部品** | ✅ **直置き**（傾けると基準面を失う） |

⚠ **「光造形ではサポートで浮かせられない」は誤り。** 効かないのは**ラフト単体**（部品をラフトに
ベタ置き）で、融着して一体になるだけ。**「サポート＋ラフト」は標準の作法**で、CHITUBOX に
最初から入っている。

**直置きを選ぶ理由は、サポートが使えないからではない。** 枠のように壁が垂直な部品はどの層も
断面積が同じで（`as5600_frame` は全層 585mm²）、浮かせると1層ごとの剥離力を細いサポートの足だけで
受けることになり、途中で落ちやすい。傾ければ剥離力は下がるが、**上を向いた基準面が斜めに焼かれて
精度を失う。**

🔴 **島はサポートで潰すものであって、傾けて潰すものではない。**

### ✅ CHITUBOX は STL の座標を捨てる ── 配置を渡すなら 1 ファイルに結合する（2026-08-31・実機で確認）

**確かめ方**: [chitubox_coord_test.scad](../hardware/frozen/v1-v4/chitubox_coord_test.scad) で、10mm 角の板 2 枚を
A =(-40, -25)、B =(+40, +25) に置いて書き出し、CHITUBOX Basic V2.3 に読み込んだ。

| 読み込み方 | 出た位置 |
|---|---|
| A だけ（1 ファイル） | ❌ **プレート中央**。座標は無視された |
| A と B を**別ファイルで 2 つ** | ❌ **中央付近に隣り合って並ぶ**。さらに衝突を避けて横へずらされる |
| A と B を**1 ファイルに結合** | ✅ **離れた対角のまま。配置が保たれた** |

🔒 **合わせて分かったこと: CHITUBOX は読み込んだ物の bbox の中心を、プレート中央に合わせている。**
（A 単独の bbox 中心は (-38, -25) だったが中央へ動いた。結合版は bbox 中心が (0,0) なので動かなかった。）
✅ **向きと Z は変えられない**（爪は +X を向いたまま、Z=0 に接地したまま）。**動くのは XY だけ。**

⇒ **配置をこちらで決めて渡すなら、1 つの STL に結合して出すしかない。**
⭐ その形で書き出す道具が [surugo/](../surugo/README.md)（「刷るぞー」）。`python surugo/server.py`
⚠ 部品ごとに別ファイルで出す形は成立しない。相対位置すら保たれない。
✅ 支柱をモデル側で作っている（`_v4_props.py`）ので、CHITUBOX で部品を個別に選ぶ用事は無く、
**結合しても失うものは無い。**

🔴 **ただし、プレート上の絶対位置は指定できない。** 必ず bbox の中心が中央に来るため、
「傷の上を避ける」「フィルムの摩耗を散らす」は**このままでは実現できない。**
✅ **解き方（2026-08-31・ユーザー）: アプリが移動量を出して、CHITUBOX で人が動かす。**
必要なときだけのマニュアルモードにする。**目分量ではない** ── CHITUBOX には移動量を数値で
入れる欄があり、しかも **必要な移動量＝狙う bbox 中心の座標そのもの**（中央合わせが (0,0) に
置くため）。指示は「X に +12.5、Y に −8.0」の 1 組で済む。
⇒ 印刷物が増えず、未検証の仕掛けも要らない。動かさなければ従来どおり中央に出るだけなので、
**やらなくても壊れない。**
⚠ **ログに残すのは指示ではなく、実行したという確認の方。**動かさなかった回を「そこに刷った」と
記録すると、傷のマップが汚れる。チェック 1 つでよい。

~~⬜ 回避案（未検証・印刷物が増える）: 狙った範囲の対角に 1mm 角の目印を 2 つ入れて bbox を固定する。~~
（AI 案。上のマニュアルモードで足りるので採らない。）

### 🔴 モデルに支柱を入れた部品は、その支柱が届く置き方でしか刷れない（2026-08-17）

つまみの天板（`deck_props`）は、へこみの天井を掴む支柱を**モデルに入れてある**
（v4 で 8本。いまの正は [knob_v5.scad](../hardware/frozen/v1-v4/knob_v5.scad) で、本数は座の形に合わせて変わる）。この支柱は**見える面をプレートに直置き**したときにだけ足がプレートに届く。
傾けたり浮かせたりすると、支柱の足は**宙に浮いた φ1.4 の島**になり、まず刷れない。

実際 2026-08-17 の印刷では支柱がほとんど脱落し、へこみの底（回転の溝が乗る面）が荒れて、
削って整えないと回らなかった。⚠ **原因は同じファイルの置き方メモが「15〜20度 傾けると
吸着が減る」と書いていたこと**で、支柱の前提と矛盾していた。

⭐ **教訓: 支柱をモデルに入れたら、置き方の指示を同じ場所に書いて縛る。**
スライサー側の自由（傾ける・浮かせる）は、そのぶん失われている。

### 🔴 支柱は「空いていなければならない体積」を避ける（2026-08-27）

筐体 v4 の支柱を作る [_v4_props.py](../hardware/frozen/v1-v4/_v4_props.py) は、**持たれていない天井の輪郭**
だけを見て柱を立てていた。そのため、ネジの通し穴・ナットのポケット・つまみの軸の穴・
充電の口・トグルの穴・前板のフランジの溝の中にも柱が立っていた。ユーザーが STL を見て
「ネジ穴や回転部分にサポートが立っている。これはまずい」と指摘した。
そこの柱は**折っても取れないし、取れてもねじとナットと軸が入らない**。

⇒ case_v4.scad に `keepout_<部品>()` を置いた。中身は**実際に彫っている cut の module を
そのまま呼ぶ**（数字を二重に持たないので、形を変えれば keepout も追従する）。
生成器はこの体積に柱の胴（φ2.0）＋逃げ 0.3 が触る位置を候補から落とす。

⭐ **天井を持つことより、相手の部品が入ることが先。**持てなかった天井は短いブリッジとして
残す（v4 で残ったのは幅 1.0〜3.2mm の帯だけ）。

### ✅ トラス系のサポート設定（2026-08-10・これで成功した）

丸棒だけで構成され上を向いた基準面が無い部品（stand_ab のフレーム）を、直置きで刷って
**床トラスがボロボロになった**。オートサポートで浮かせ直したら**脱落なく出せた。**
**トラス系は次からこの設定を出発点にする。**

| 項目（CHITUBOX Basic V2.3・サポートタブ） | 値 |
|---|---|
| サポート設定プリセット | **中間** |
| Zリフト高さ（プレートから浮かせる量） | **4.000mm** |
| 先端上部径 | 0.40mm |
| タッチチップ距離 | 3.00mm |
| サポート角度 | 45.00° |
| ラフト形状 | スケート |
| オートサポート | 自動サポートモード「**+すべて**」 |

✅ ペグ（φ2）にサポートが付いても実害は無かった（「ペリっと外せた」）。
**配置を毎回手直しする必要は無い。** 嵌合が渋いときに跡を疑う程度でよい。

🔴 **落ちた案（同日・AI が提案して悪化させた）**: 「足を下へ伸ばして浮かせれば良くなる」は
**逆効果だった**。三角がプレートから 0.57mm → 4.57mm へ上がり、浮き島の位置が高くなったうえ、
全体が φ5.5 の柱3本にぶら下がる形になって前回より悪化した。**造形中に何がその重さを支えるのかを
見ずに「浮かせる＝良い」と考えたのが誤り。**

## 3.9 ⬜ 浮かせるシステムを作るための調査（2026-09-01・**インターネットの一般論。実機未検証**）

支柱 6 本（`v4_post_*.stl`）を刷るために、**部品ごとプレートから浮かせて足で受ける仕組みを作る**と
決めた（ユーザー 2026-09-01）。

> 🔴 2026-09-03 **この仕組みは凍結した。**（この節の下の一般論は生きている。凍結したのは道具の方）
> ユーザー「浮かすパイプラインは凍結。使われないようにしてアーカイブしておきましょう」。
> 道具は [hardware/frozen/v1-v4/archive/floating_supports/](../hardware/frozen/v1-v4/archive/floating_supports/README.md) にある。
> 作った相手（支柱 6 本）は留め帯と一体になって消え、残った帯では ①開始点を 0 にできない
> ②角度を出せていない（145 点の網）③遅い、の 3 つが同時に出た。⇒ 帯は**直置き＋立てる柱**
> （`_v4_props.py`）にした。詳しくは [CASE-V4-LOG.md](CASE-V4-LOG.md) §32.7。
>
> （凍結前の記録）2026-09-03 の日中は、この仕組みの相手を留め帯 A/B/C（`v4_strap_*.stl`）へ移していた。 支柱が帯と一体に
> なって単独では刷らなくなり、代わりに帯が「足と足の間 36mm を渡る長いアーチ」を持つようになったため
> （ユーザー「印刷時に長いアーチになるので柱が必須です」「浮かせるスペーサーを作る時に使った保持具を
> 付けて欲しいです」「角度についても、最も印刷に適した極端な変化にならない角度を付けたいです」）。
> 仕組みそのもの（浮かせ 5mm・柱 φ2.0 ＋ 球 φ1.0 ＋ 円錐 → 接点 φ0.5・食い込み 0.1・ラフト 0.6）は
> 変えていない。下の一般論はそのまま生きている。
過去の実績（2026-08-10 の stand_ab）は形状が違いすぎて根拠にならない、
というのがその判断の理由である。ここに集めたのは**その仕組みの寸法を決めるための材料**であって、
この機で焼いて確かめた数字ではない。⚠ FDM の記事は全部落としてある。出典は節の末尾。

### 何が部品を落とすのか

失敗の正体は、焼けた層が FEP から剥がれるときの力（剥離力・吸着力）である。この力は
**その層の断面積に比例する**。断面が大きいほど強く引かれ、支えの保持力を超えたところで落ちる。
⇒ 立てて刷る（断面を小さくする）判断は、この一般論と合っている。

🔴 **ただし本当の敵は断面の大きさではなく「断面の急な立ち上がり」である。**
底が平らな部品は、その層でいきなり大きな面積が現れるので吸盤になる。
複数の出典が同じ処方を書いている: **20〜35°（面が広いときは 30〜45°）傾けて、
層ごとの断面積が少しずつ変わるようにする。**

⚠ **これは支柱 6 本にそのまま当たる。** 真っ直ぐ立てると断面は
**φ1.5＝1.77mm²（z 0.00〜1.60）から φ5.8＝26mm² へ z 1.60 で一段に跳ぶ**（STL 実測）。
教科書どおりの失敗の形をしている。⬜ 傾けるかどうかは未決。

### 浮かせる高さ

| 値 | 出どころ |
|---|---|
| **5mm**（CHITUBOX の既定） | CHITUBOX 公式ドキュメント（Z Lift Height ＝ 部品の最下点とプレートの距離） |
| 3〜10mm | Make: |
| 大きいプレートは 7mm・小さいプレートは 5mm | 一般記事 |

浮かせる理由は 3 つある。サポートが実体として存在できること、部品がラフトに沈まないこと、
吸着力が下がることである。

### サポート 1 本の形（作る物の寸法の候補）

| 部位 | 値 | 出どころ |
|---|---|---|
| 接点の径（tip） | **0.4〜0.5mm** が実用。細部は 0.2〜0.3mm。**0.2 未満は折れて部品の中に残る** | AmeraLabs / RapidMade |
| 接点の径（別出典） | 0.2〜1.0mm | Make: |
| 食い込み（contact depth） | **0.1〜0.7mm** | Make: |
| 頭の長さ | **2〜5mm** | Make: |
| 台（base）の径 | **2〜5mm** | Make: |
| 台の高さ | **0.5〜2mm** | Make: |
| ラフト | スケート（プレート側を 1 枚にして接地を稼ぐ） | CHITUBOX |

⚠ **胴（pillar）の径だけ、どの出典も数字を出していない。** 「台と頭を繋ぐもの」としか書かれていない。
この機で数字を持っているのは repo 側の実績だけである（`deck_props` の 柱 φ2.0・先 φ1.2・ピッチ 3.0。
φ1.4／先 φ0.8 は 2026-08-21 に面ごと剥がれて失敗している）。

### 生成の作法

- **島の判定は層ごとの 2D で行う。** 面の傾きを見るやり方では、わずかに傾いた面が
  スライス時に作る孤立した画素を取りこぼす。CHITUBOX も PrusaSlicer も 2D ラスタで島を探している。
  ⇒ 断面から場所を取る `_v4_props.py` の方針自体は、この作法と合っている。
- **支柱同士を繋ぐと強くなる。** 独立した細い柱より、横に繋いだ組のほうが折れにくい。
  PrusaSlicer の SLA は柱を繋ぐ距離をパラメータに持っている。
- **密度は多めが正解。** 材料と後処理は増えるが、成功率がはっきり上がる、というのが共通の勧め。
- **自動生成だけに任せない。** 自動で出してから、島の警告を 1 つずつ見て手で足す、が定石。
- **ピンには面取りを入れる。** 初層の膨らみ（象の足）を吸って、相手の穴へ入りやすくなる。
  ⇒ 軸 φ2.0 の先端に効く話である。

### この調査で**分からなかったこと**

- **断面 ◯mm² を持つのに足が何本・合計何 mm² 要るか**、という計算式はどの出典にも無い。
  「密度は多めに」までしか書かれていない。⇒ ここは実機で決めるしかない。
- **ELEGOO Mars 3 固有の値**は出てこない。上の数字は全部レジン全般の一般論である。
- 傾けるべきか否かの結論も出ていない。ただし ⚠ **「傾けると軸 φ2.0 と E リングの溝が斜めに
  焼かれておかしくなる」は AI が確かめずに書いた文で、根拠は無い**（2026-09-01・ユーザー指摘で撤回）。
  裏を取った結果はこう:
  - `print_log.jsonl` 64 件に**傾けて焼いた記録は 1 件も無い**。この機で傾けた部品はまだ 1 つも無い。
  - **E リングの溝は一度も焼かれていない。** 設計が 2026-08-30、支柱 6 本は回 `2026-09-01-1525` に
    登録されているだけで結果が無い。
  - §3 の「傾けると上を向いた基準面が斜めに焼かれて精度を失う」は**理屈として書かれた行**で、
    実測ではない。それを軸と溝へ当てはめたのが上の文だった。
  ⇒ **傾ける側の代償は、まだ誰も見ていない。**

### ✅ 立ち上がりの緩やかさは計算できる（2026-09-01・[_tilt_sweep.py](../hardware/frozen/v1-v4/_tilt_sweep.py)）

物差しは **1 層あたりの断面積の増分の最大値**（mm²/層）である。層ごとの断面積は
`surugo/measure.py` の `profile` が既に出しているので、足したのは「三角形を回してから
同じ計算へ渡す」ことと「傾き 0〜90°・方位 8 方向を振る」ことだけ。**難しい計算ではない。**

支柱 6 本の結果（pitch 0.1・層 0.05）:

| 部品 | 直立（いま） | いちばん緩やかな向き | 跳ねの比 |
|---|---|---|---|
| post_0 | **20.63** mm²/層（z 1.60） | 60°/方位135 → **0.70** | 29 倍 |
| post_1 | 20.63 | 60°/135 → **0.70** | 29 倍 |
| post_2 | 20.63 | 60°/135 → **0.68** | 30 倍 |
| post_3 | 20.63 | 30°/90 → **0.79** | 26 倍 |
| post_4 | 20.63 | 60°/135 → **0.69** | 30 倍 |
| post_5 | 20.63 | 30°/90 → **0.77** | 27 倍 |

⭐ **どの向きに傾けても直立より 1 桁以上ましになる。** 直立が飛び抜けて悪い
（φ1.5＝1.74mm² から φ5.8＝26.37mm² へ z 1.60 で一段に跳ぶ）。20° 前後は 1.08〜1.86 で、
出典が言う「20〜35°」はこの部品では最良帯ではなかった。**効くのは 45〜60° である。**

⚠ **正直な代償が 1 つある。** 背の高い post_3 / post_5 は、倒すと影が長くなるので
**最大断面が 26.37 → 30.5 mm² へ増える**（+16%）。跳ねは 26 倍ましになるが、
1 層の最大剥離力は少し上がる。短い 4 本は最大断面も 26.37 → 14〜19 へ下がる。

⚠ **接地は 45〜60° で 0.04〜0.10mm² ＝ 実質ゼロになる。** 傾けるなら浮かせる仕組みが要る、
という結論はここでも同じ所へ来る。

⬜ **実機での検証はまだ無い。** 上は全部 STL の幾何から出した数字である。

### 🔒 足の間隔は既存の柱と同じ（2026-09-01 ユーザー「通常の柱の間隔と同じで良いと思うけど」）

`deck_props` の実績値をそのまま使う ── **柱 φ2.0・先 φ1.2・ピッチ 3.0**。
その間隔で、いちばん緩やかな向きに倒した支柱に何本当たるかを数えた:

| 部品 | 向き | 足の数 | 先の合計 | 最大断面 | 合計/断面 |
|---|---|---|---|---|---|
| post_0/1 | 60°/135 | 7 | 7.92mm² | 14.22 | 0.56 |
| post_2 | 60°/135 | 7 | 7.92 | 15.34 | 0.52 |
| post_3 | 30°/90 | 10 | 11.31 | 30.50 | 0.37 |
| post_4 | 60°/135 | 7 | 7.92 | 18.63 | 0.42 |
| post_5 | 30°/90 | 10 | 11.31 | 30.49 | 0.37 |

✅ **足は一直線に並ばない。** post_0 は 4.25 × 4.15mm に散り、並びの主成分比が 0.84
（post_3 は 3.40 × 6.05mm・比 0.65）。⇒ ねじれ方向にも持てる形になっている。

⚠ **柱の長さは 1 本ごとに違う**（同じ部品の中で 3.2mm の差）。倒したので当然だが、
生成器は「同じ高さの柱を並べる」ではなく**足ごとに部品の下面まで伸ばす**必要がある。

⬜ **「先の合計 ◯mm² あれば持てる」の合否は、まだ誰も持っていない。**
2026-08-21 の失敗（先 φ0.8 × 35 本 ＝ 17.6mm²）は合計が今回より多いが、
あれは**持たれる側が薄皮の床で、床ごと剥がれた**という別の壊れ方である。
支柱は中身の詰まった塊なので、そのまま当てはめられない。

### ✅ 浮かせる生成器ができた（2026-09-01・[_v4_post_props.py](../hardware/_v4_post_props.py)）

`python hardware/_v4_post_props.py` → `hardware/_v4_post_props.scad`。
`case_v4.scad` は素の向き（生成器が読む）と、傾けて浮かせた刷る向き（＋柱＋ラフト）に分かれている。
🔒 2026-09-03 に相手が支柱 6 本から**留め帯 A/B/C** へ移ったので、いまの名前は
`part="strap_bare_a/b/c"` と `part="print_strap_a/b/c"`（旧 `post_bare_N` / `print_post_N` は廃止）。
食い込みの検査も `part="strap_weld_a/b/c"`。

🔒 **考え方の順序（ユーザー 2026-09-01「円錐から柱を作って行く感じなんだよね」）:**

    接触点 → 面の法線 → 円錐 → その円錐を支える柱 → ラフト

**円錐が先で、柱は円錐から下ろす。円錐は動かさない。**

サポート 1 本の作り（🔒 ユーザー「柱＋球＋円錐で構成されるべきだよね」）:

    ラフト ── 柱（垂直・φ2.0）── 球（継ぎ手・φ1.0）── 円錐（軸＝面の法線・長さ 1.5）── 接触面 φ0.5

円錐の軸は面の法線で、両端とも軸に直角＝本物の円錐（回転体）。向きの変わり目は球が受ける。
**柱は円錐の真下**（円錐の中点）に立てるので、寝た円錐も φ2.0 の柱に footprint ごと乗る。

柱の降ろし方は 3 通りあり、この順に試す:

| | いつ | 形 |
|---|---|---|
| **真下** | 円錐の真下が空いている | 垂直な柱をそのままプレートへ |
| **斜め** | 真下が部品の中（急な面ではこうなる） | 球から外へ 45° で降り、届いた所に**自分の柱**を立てる |
| **枝** | 自分では降りられない | 隣の柱へ繋ぐ |

生成器の全体:

1. **向きを毎回選び直す。** 1 層あたりの断面積の増分がいちばん小さい所を掃引で採る
   （`_tilt_sweep.py`）。⇒ 角度をどこにも書いていないので、形を変えれば向きも追従する。
2. **プレートから 5mm 浮かせる**（CHITUBOX の既定）。
3. **部品の最下点を最初の接触点にし、次に 2.5mm の格子で下面を拾う。** 格子の**位相**も
   振って多い所を採る。
   🔴 2026-09-02 まで最下点は格子まかせで、網目に落ちると足が無かった。ユーザーのスクショ
   「最下部にも関わらず、突然出現します」。6 本中 4 本で最下点から最寄りの接触点まで
   2.4〜3.2mm 離れていた。**急な立ち上がりの検査はこれを通す**（隣の柱まで XY で
   2.4mm なので 4.0 の内側）。⇒ 最下点は検査に頼らず、生成器が必ず当てる。
   ⚠ 種にするだけでは足りなかった。60°/135 では最下点が **D の足の角**（平らな面から
   0.06）に来て、逃げの中なので当てられない。⇒ **向きの条件**に「最下点に先を当てられる」を
   足し、当てられない向きは捨てる。⚠ 「跳ねの小さい 6 つの中で選ぶ」では足りなかった
   （全部 D の角か、フランジ下面の縁で軸が刃の筒に入る）。**全候補を先に安い検査でふるい**、
   当てられる向きの中から跳ねの小さい順に組む（post_0 は 7 番目の 60°/270 が当てられた）。
4. 各接触点から円錐 → 柱（上の 3 通り）。
   🔴 2026-09-02 夕方から、胴（柱・テーパー・斜材・枝）と部品の隙間は**全表面**（三角形を
   0.08mm で点にした KD 木）に対して **GAP 0.4**（癒着の実績 0.36 の外）を要求する。首（球〜円錐）は
   軸から半径 NIP_GAP 2.0 の筒（接触面の 0.4 上〜球の上）に部品の面が無いこと＝刃が入る空き。
   ユーザー「ニッパー入りません」「癒着しそうです」（1632 版のスクショ）。
5. **急な立ち上がりを検査器に聞いて潰す。** 焼いて `_stl_preflight.steep_rise()` に
   「その層で新しく出た肉が直下の肉からどれだけ離れているか」の最大（mm）と場所を
   出させ、しきい値（`RISE_WARN` 4.00）を超えていればその場所へ支柱を足す。
6. **ラフトはスケート型。** 底が狭く、**上の縁が 0.6mm 張り出した** 1 枚の板。
   🔴 2026-09-02 夕方: 円の径は φ5 から始めて、**その部品のラフトが 40mm²**（検査の「点で
   立っている」38 の外）に届くまで 0.5 刻みで広げる（上限 φ9）。柱が 1 本しか立たない部品
   （post_0/1・幹 1 本＋枝 3 本）が φ5 の円 1 つ＝19.6mm² になったため。前回（31mm²）と同じ対処。
   （高さ 0.6・下面は 45° で内側へ逃げる）。スキーの先が反った形で、
   **その張り出しの下へヘラを差し込む。**
   🔒 2026-09-02 ユーザー「スケートなんとか型にできます？浮かせる時はこれにしておきたい」
   →（上下を逆に作って）「スロープ・・・これじゃ逆に入りづらいじゃん」→ 直して「ばっちりですね」。
   ⚠ 上下を逆にすると縁が薄い刃先になり、ヘラが乗り上げて刺さらない。

| 部品 | 向き | 真下 | 斜め | 枝 | 接触面の合計 | ラフト（＝接地） | 急な立ち上がり | 先まわりの空き | 振った角度 | 円錐の長さ |
|---|---|---|---|---|---|---|---|---|---|---|
| post_0/1 | 60°/270 | 1 | 2 | 0 | 0.59mm² | 72mm² | 1.52mm | 2.41mm | 0° | 1.5〜2.0mm |
| post_2 | 60°/90 | 1 | 2 | 0 | 0.59 | 71 | 1.50 | 2.43 | 0° | 1.5〜2.0 |
| post_3 | 30°/90 | 2 | 3 | 0 | 0.98 | 109 | 1.95 | 2.05 | 0° | 1.5〜2.5 |
| post_4 | 80°/90 | 2 | 1 | 0 | 0.59 | 64 | 1.25 | 2.26 | 0° | 1.5 |
| post_5 | 30°/0 | 1 | 4 | 0 | 0.98 | 115 | 1.95 | 2.05 | 0° | 1.5〜2.5 |

（2026-09-02 22 時台・親の円錐との空きも見るようにした後の値。枝は 0 本になった）
急な立ち上がりは 6 本とも **1.25〜1.95mm**、実績で無事な範囲（≤ 4.00mm）の内側。
接地は 64〜116mm²。最下点から最寄りの先まで 0.05〜0.25mm。円錐どうし **3.05mm 以上**。
胴と部品の隙間は 6 本とも **0.40mm 以上**、首の筒（半径 2.0）は全部空き。

### 🔒 支柱を足す基準を「急な立ち上がり」へ乗り換えた（2026-09-02）

🔒 ユーザー「もう島だのなんだの曖昧な話は無しにしました」
「面積は惑わせ、混乱させる元凶だから急な立ち上がりに統合だね」。

生成器はそれまで**島の個数**で回していた（島が出た所へ支柱を足す）。いまは
`_stl_preflight.steep_rise()` が返す **1 つの mm** で回す。島（下に何も無い）も
庇（下から離れている）も、この 1 つの数に入る。しきい値も検査器の `RISE_WARN`
（実績の較正値 4.00）をそのまま読むので、こちらに数字を持たない。

⚠ **報告からも島と支えの無い天井の語を落とした。** 面積で言うと「小さいから大丈夫」に
見えてしまうのが理由（この機の失敗 3 件は全部「小さい面積」だった）。

### 🔴 刷った結果（回 2026-09-02-1404・スペーサー 6 本の初回）

**先が部品に刺さっていない支柱があった。** ユーザーがスライサの画面で発見
「円錐の先がオブジェクトに刺さってないのがありますね」。刺さっていない先は、
その周りが宙に浮いた薄片になるので**そこだけ印刷されない**（同・赤丸）。

🔴 **原因（計算で確定）。** 接触面の中心を**振った軸に沿って**押し込んでいた。
正しくは**面の法線に沿って** `PROP_BITE` 押す。振った軸に沿って押すと、中心の深さが
`bite·cosβ` に減り、縁の浅い側は `bite·cosβ − r·sinβ` になる:

| β | 中心の深さ | 縁の浅い側 |
|---|---|---|
| 0° | 0.1000 | 0.1000 |
| 8° | 0.0990 | 0.0642 |
| 16° | 0.0961 | 0.0272 |
| **23.6°（上限）** | 0.0917 | **−0.0083 ★ 浮く** |

法線に沿って押せば中心はいつも 0.100 で、縁は `bite − r·sinβ ≥ 0` になる（上限 23.6° で 0）。
⇒ 直しは `head_at()` の `A = 接触点 − n(振った軸) * PROP_BITE` を
`A = 接触点 − n0(面の法線) * PROP_BITE` にする 1 行。
⚠ 実際に浮いていたのは post_2 に 1 本・post_3 に 1 本（どちらも β=24°）。

🔴 **本当の問題は先の 2 本ではなく、検査が全部「合計」だったこと。**
食い込み体積を「0.0685 対 見込み 0.0785 ＝ 見込み以下」と報告して通したが、中身は
「刺さっている先」と「浮いている先」の混合だった。**1 本ずつ見ていれば 0 が出て、
刷る前に止まっていた。** 隙間（最小値）も立ち上がり（最大値）も同じ形で、
**個々の要素が仕事をしているかを一度も確かめていない。**
⇒ 次にやるのは先の位置の修正ではなく、**要素ごとの検査**を入れること。

⬜ **このシステムを続けるかは未決**（ユーザー「このサポートシステムだめかな」
「いやマジでだめでしょこれ」）。切り分けの見立てだけ残す:
- **残す価値があるのは向きの選定（`_tilt_sweep`）。** 直立の 20.63mm²/層 を 0.79 まで
  落としたのはこれで、支柱の作りとは独立している。スライサには無い機能。
- **支柱の生成そのものは捨てて、傾けた素の部品を出して CHITUBOX に付けさせる**という
  道がある。試すのに新しい印刷は要らない。

### 🔴 足の球はラフトに触れてはいけない（2026-09-02）

🔒 ユーザー「支柱の足の球がプレートを割るって指摘が来たヨ」。

斜材と枝の**根元にある φ2.0 の球**は、中心の下限が `RAFT_T`（0.6）だった。
そのため球の底がラフト（0〜0.6）の中に入り、**そこだけラフトが薄い板ではなく塊**になる。
ヘラで曲げても逃げないので、力がプレートへ行く。実際 post_3 の枝の足が
**球の底 z=+0.43**（ラフトの中）だった。

⇒ 球の中心の下限を **ラフトの上面 ＋ 球の半径 ＋ 0.1 ＝ 1.70mm** にした。
いまの最小は post_3 の **球の底 z=+0.70**（ラフトの上面 0.60 より上）。
生成器が毎回この値を出すので、埋まったら「🔴 足の球がラフトに埋まっている」と表示する。

⚠ **検査ツールの出力の文言は変わることがある。** 2026-09-02、`_stl_preflight.py` が
別途書き換わって「島 N か所」「支えの無い天井」の行が消え、grep が空振りして
「島が出た」と誤読しかけた。**数を見るときは CLI の文字列ではなく
`grip_and_islands()` を直接呼ぶこと。**

### 🔒 円錐の角度と長さを自由度として持つ（2026-09-02・ユーザーの案）

🔒 ユーザー「①点が決まった時点で円錐の角度を固定しない ②どの柱に落とすかの優先度は、
最短で落とした場合のピンの周りの最も混んでいる所から落とす ③それでも混む場合は円錐の
形状をもっと細長くして対応」。**3 つとも実装した。**

⚠ それまでは①②③のどれも無い**貪欲法**だった。格子の走査順に置き、詰まったら
「斜材で横へ降りる／隣へ枝で相乗り／あきらめる」の 3 つしかなく、しかもこの 3 つは
**どれも降ろし方を変えるだけで円錐は動かない**。⇒ 円錐どうしがぶつかったら
その点は黙って消えていた（気付けるのは、たまたま島だったときだけ）。

**①の限界は数字で出る。** 接触面を法線から β 傾けると、円い面の縁で食い込みが
±(先の半径)·sinβ ずれる。浅い側が 0 になるのが β = arcsin(食い込み / 先の半径) で、
先 φ0.5・食い込み 0.1 なら **23.6°**。そこを超えると縁が浮いて接触が三日月になる。
⇒ 振ってよい上限は 23.6°。ただし球が横へ動くのは **0.60mm** しかない。
**①単独では混雑を解けない。**③（長さ 1.5 → 3.0mm）と組んで 1.20mm になって初めて効く。

🔴 **①は同日に止めた（振り角 0 だけ）。** 平らな面（傾き 0°）で 23.6° 振った円錐が出て、
ユーザー「円柱の先が法線になっていないところも見つかりました」。円錐の軸は法線、が
🔒（2026-09-01）で、①はそれと両立しない。②③は残す。戻すなら `BETA_STEPS`。

効果: 間隔を **3.2 → 2.5mm**（検算の下限）まで詰めても 6 本とも島 0 で成立するようになった。
支柱 3〜4 → 4〜6 本、接地 42〜74 → 65〜136mm²。

🔴 **検算を入れた。** 間隔 < 先の径 ＋ 刃の空き のときは走らずに止まる。狭いと
「ぶつかった点が黙って捨てられる」状態になるためで、2026-09-02 に実際にそれをやっていた
（間隔 2.4 に空き 2.0 ＝ 要 2.5）。

**「食い込み」＝ 支柱 ∩ 部品の体積**（`part="post_weld_N"`）で、**剥がせるかの物差し**である。
見込み値は「円錐の先が 0.1 だけ食い込むぶん（φ0.5 の面 × 0.1 ＝ 0.0196mm³）× 本数」。
実測がそれ以下なら、支柱は先でしか部品に触れていない。⇒ 6 本とも見込み以下。

✅ 検査（`_stl_preflight`）: 6 本とも **底 Z=0.000・中身 1 個・0.15mm 未満の面なし**、
**急な立ち上がり 0.79〜2.25mm**（実績で無事な範囲 ≤ 4.00mm の内側）。

🔴 **作りながら潰した間違い（同じ穴に落ちないため残す）:**

| 間違い | どうなったか |
|---|---|
| 逃げ（軸まわり）を半径 2.3 にした | 胴 φ5.8 の 6 割が消え、柱が 2〜3 本に。正しくは 1.55 |
| 軸の**端面**まで逃げに入れた | 傾けたとき最下点になる軸の先を支えられず島が残った。端面は軸方向なので嵌合に効かない |
| 最下点を格子まかせにした | 網目に落ちて足が無く、最下点が島で現れた（スクショで発見。急な立ち上がりの検査は通した） |
| 胴の当たりをレイの最下面だけで見た | 胴の側面（壁）の脇を斜材が 0.08mm で通り、首がその隙間に埋まってニッパーが入らない（スクショで発見）。全表面の点群（KD 木）で見る |
| 胴と部品の逃げを 0.3 にした | 柱の頭のテーパーが部品から 0.30〜0.46 で「癒着しそう」。癒着の実績 0.36 の外 ＝ GAP 0.4 を要求する |
| 「深く重なれば融合」の例外を先にも効かせた | 最下点の先と格子の先が 0.3mm 隣に立ち、1 本の柱の頭に首が 2 つ付いた（スクショで発見）。例外は柱どうしだけ |
| 首のまわりの空きを部品に対して見なかった | 支柱どうしには刃の空き 2.0 を要求していたが、部品との間は見ていなかった。軸から半径 2.0 の筒（接触面の 0.4 上〜球）に部品の面が無いこと |
| 円錐を法線から振った | 平らな面で 23.6° 傾いた円錐が出た（スクショで発見）。軸は法線、に戻した |
| 柱を最寄りのレイへ吸わせた | 隣どうしが 2.4 より近づき、当たり判定で片方が消えた |
| 格子点の下に部品が無くても柱を立てた | **宙に立った柱**（絵で発見。検査は素通りした） |
| 島を自前で数えた | 1 本のレイの「いちばん下の面」しか見ておらず、その上の下向きの面を落とす |
| 島の判定をレイ 1 刻みで見た | 0.25mm² 前後の島は刻みしだいで出たり出なかったりする。3 通り通す |
| 先を球にした | 🔒「球にしてるのは多分雑です」「ただしくは当該面においての垂直方向です」「円錐」 |
| 水平な円と傾いた円を hull で繋いだ | 🔒「円錐の底面に角度が付いてないよね」。球を継ぎ手に挟んで作り直した |
| 胴の頭に φ2.0 の球を置いた | 半径 1.0 が接点より上へはみ出し、円錐ではなく太い塊になった（絵で発見） |
| 円錐を 60° で頭打ちにした | 🔒「刷れない円錐なのであれば柱の位置の方を変更すべきかと」。曲げるのは辻褄合わせ |
| 「急な面には当てない」と決めた | 🔒「壁のような急な面には当てていいでしょ」「何言ってんの？」。**当ててよい。**水平な 7.2mm の円錐ができたのは「球は接触面より下」を法線方向で測った私の規則のせいで、長さが発散していた。壁なら球は横へ逃げるので 1.5mm のままでよい |
| 球を垂直方向の高さで当たり判定した | 斜面で「真上の部品の高さ」と球の半径を足して比べ、空いているのに落として柱が半減した。球は法線方向に 1.5mm 離れており作りの上で空いている |
| 柱どうしが近いと枝に回した | プレートに届く柱が 2〜3 本に減り、接地 25〜33mm²（点で立っている判定）、post_2 は中身 2 個に割れた。空中で柱が融合するのは無害 |
| ラフトを固定の距離だけで繋いだ | 柱が横へずれて届かず、post_4 で 60mm² が 23mm² の小片に割れた。最小全域木で必ず 1 枚にする |
| 「空中で柱が融合するのは無害」と判断して支柱どうしの隙間を見なかった | 🔴 **これが本当の「剥がせない」だった。** 斜材と円錐が隣の支柱に触れるほど近づき、癒着してニッパーの入らない塊になっていた（🔒 ユーザー「いずれにしてもこんなにちかいのはまずいでしょ」）。リポジトリに実績値（隙間 0.4／癒着 0.36）があるのに柱どうし以外へ当てていなかった。⇒ 柱・斜材・円錐の**全部の組み合わせ**で線分どうしの距離を見る |
| 柱を球のところまで上げた | 🔒 ユーザー「円錐の下に球がない」「であれば柱の長さが長すぎるのでは？」。φ1.0 の球が φ2.0 の柱に丸ごと埋まって継ぎ手として働かず、細い部分が円錐の 1.5mm しか残らずニッパーが入らない。⇒ 柱は球の 1.0mm 手前で止め、そこから球へ絞る（細い部分 2.5mm） |
| 柱の頭を球（S.z）に固定した | 🔒 ユーザー「真下ふさがってないよね」。部品の下面まであと 0.6mm というだけで「真下は部品の中」と判定し、斜材へ逃げていた。⇒ 柱は**部品の下面の手前まで**上げ、残りをテーパーで球へ繋ぐ。真下に立つ柱が 8 → 17 本に増えた |
| 「部品に当たる」と「隣の支柱に近い」を区別しなかった | どちらでも斜材へ逃げていた。部品が何も邪魔していないのに柱が横へ飛ぶ |
| 斜材の逃げる方角を**法線の方位に固定**した | 🔒 ユーザー「イメージ的にはオレンジの所に落ちると思うんだけど」。すぐ隣が空いていてもそこへ降りない。⇒ 全方位から探して、いちばん短く降りられる所を採る |
| 近さを「0.4 以上」だけで見た | φ2.0 の柱どうしは「しっかり重なって 1 本になる」か「0.4 空ける」かのどちらかで、**中間（隙間 0〜0.4）だけが癒着する**。禁じるのはその帯だけ |
| 斜材の**着地点の真下**しか調べなかった | 🔴 **斜材そのものが部品を突き抜けて融着した**（2026-09-01・ユーザーのスクショ「剥がせないし、反るような柱になってる」）。検査は島も天井も素通りする。⇒ 通り道を 0.25mm ごとに調べる `seg_clear()` を足し、**食い込み体積**を毎回測るようにした |

⚠ **接触する面の傾きは 0°〜84° まで散っている**（法線と垂直のなす角・実測）。
壁にも当てているので、円錐を法線に沿わせるのは飾りではない。

### ✅ 向きは「立ち上がりが小さいこと」を先に見る（2026-09-01・post_5 で判明）

⚠ 下は**島で回していた頃の記録**である（2026-09-02 に急な立ち上がりへ乗り換えた）。
判断の筋は同じで、いまは「跳ねの良い順に最大 6 通り試し、**急な立ち上がりがいちばん
小さい向き**を採る（しきい値を切ったらそこで止める）」になっている。

跳ねだけで選ぶと post_5 は 30°/90 になり、**0.38mm² の島が 1 つどうしても消せなかった**。
そこへ降ろす支柱と、隣の支柱（軸の端面を持っている枝）の**接触点の軸間距離が 0.6mm しかない**。
支柱をどれだけ細くしても隙間 0.4 は作れず、邪魔な隣を外す案は**島が 0.38 → 0.25mm² へ移るだけ**
だと実験で確認した（外した支柱が持っていた面が今度は島になる）。

⇒ 向きを変えるしかない。候補を並べるとこうなっていた:

| 傾き/方位 | 跳ね | 支柱 | 接地 | 残る島 |
|---|---|---|---|---|
| 30°/90（跳ねが最良） | 0.77mm²/層 | 7 | 84mm² | **1** |
| **35°/0** | 0.85 | 10 | 94 | **0** |
| 30°/45 | 0.87 | 7 | 85 | 0 |
| 30°/315 | 0.87 | 8 | 99 | 0 |

⇒ 生成器は **跳ねの良い順に最大 6 通り試し、島が残らない最初の向きを採る**ようにした
（どれも残るなら跳ね最良へ戻す）。跳ねを 10% 譲るだけで島が消え、支柱も接地も増える。

🔴 **回 `2026-09-01-1525` に登録してある支柱 6 本は、直立だった頃の STL である。**
🔒 2026-09-03 に支柱は留め帯と一体になり、単独では刷らなくなった（`v4_post_*.stl` は消した）。
この回の登録は焼き直しではなく**そのまま歴史として残す**。いま刷る物は `v4_strap_a/b/c.stl` である。

## 4. 剥がす

### 🔒 剥がすのは力ではなく、空気を入れること（2026-09-09・ユーザー）

✅ ユーザー「そもそも最近は傷すらつかないんだけどね。**手が慣れてしまって、どういう力でどういう方向で
加えると空気が入って行くのか想像できる**ようになったんだ」。

⇒ 部品はプレートに**面で吸い付いている**ので、正面から起こそうとすると力が面の全体に掛かり、
足りない分を刃で足すことになる。**縁のどこか一点に入口を作って空気を入れれば、あとは順に外れる。**
刃を立てて力で押し切る方向へ行くと、アルミに傷が入って §5 の坂が始まる。
⇒ **§5 の「プレートを傷なしで維持する」は、研ぎで取り返す話であると同時に、剥がし方で傷を作らない話でもある。
現在は後者が効いていて、傷そのものが出ていない。**

⚠ **力の向きと強さそのものは、まだ文章になっていない。**書けるようになったらここに足すこと。
この節に書けるのは「面の吸着を空気で切る」という考え方までである。

### 🔴 接地面積が剥がれなさを決める

🔒 **この節は散文で置かない。**下の実績値は [_stl_preflight.py](../hardware/tools/_stl_preflight.py) に入れてあり、
STL を出したら必ず通す（`python hardware/tools/_stl_preflight.py "hardware/stl/v4/*.stl"`）。
2026-08-27、筐体 v4 の STL 15 点をこの節を開かずに出して、接地 5770mm² の床をそのまま渡しかけた。
機械が見るのは ①底の Z ②欠片と密閉空洞 ③薄肉 ④**接地面積**（1709 / 585 / 513 と比較）⑤島 ⑥塔。

🔴 **2026-09-03 この 3 つを根拠にした警告は道具から消した。** ユーザー「この警告意味無いので消してください。
ビルドプレートを磨くようになってから失敗なんて一度もないのです」。下の表は**傷のあるプレートで取った値**で、
2026-08-06 の研ぎ直しのあと同じ橋が「めっちゃ簡単に取れた。綺麗。」になり、**傷が原因だったことが独立に
裏付けられている**（下の「✅ 研ぎ直しは効いた」）。⇒ `_stl_preflight.py` と刷るぞーは**接地の数字だけ**を出す。
表は歴史として残す。⚠ 消したのは「剥がれにくさ」の警告だけで、**LCD の 30%（土台のたわみ）は別の判定として生きている**。

| 部品 | プレートに接する面積 | 結果 | いつ |
|---|---|---|---|
| `base.stl` | **1709 mm²** | 剥がれず・**プレートに傷**・スタンドオフ2本折れ | 研ぎ直し前 |
| `as5600_frame` / `fittest` | **585 mm²** | fittest で**角が欠けた** | 研ぎ直し前 |
| `bridge.stl` | 513 mm² | 無事に剥がせている | 研ぎ直し前 |

⚠ 2026-09-03 **この 3 つの実績は「直置き」の回のものである。**着いていたのは部品自身の底で、
欠けた角も部品の角だった。**浮かせて刷る部品では、着くのはラフトの底**で、部品はその上に
5mm 浮いて円錐の先（合計 4〜6mm²）だけで繋がっている。`_stl_preflight.py` は初層の面積しか見ないので
ラフトと部品を区別できず、ラフトにもこの ⚠ を出す（帯 A 616 / 帯 B 803mm²）。**ラフトの角が欠けても捨てる物**なので、
この警告はそのままでは当たらない。⇒ 浮かせる回で見るべきは接地ではなく「先の合計で持てるか」で、
そちらは §3.9 の ⬜ のまま（実績なし）。

**印刷の成功しやすさと、取り外しやすさは逆を向く。** 底面積が大きいほど食いつきは強く、
ボトム35秒×5層で焼き付いている。「サポート不要で確実に刷れる」置き方は、そのまま
**「一番剥がれない」置き方**でもある。

**直置きを選んだら、接地面積を設計で減らす。** 底に横溝を切れば、向きも精度も変えずに面積だけ
落とせる。✅ 半円溝で接地を約4割落とした frame・lock・bridge は**3つとも無傷で剥がせた**
（前回は同じ3部品が全損）。実装は [as5600_holder.scad](../hardware/parts/as5600_holder.scad) の
`relief_x/relief_y`。**溝は半円（角を作らない）・外へ抜く**（閉じた凹みにすると吸盤になり、
洗浄液も溜まる）・**剥がすとき曲げる軸と直交する向き**に走らせる。

🔒 **ただし長い部品に溝は張るな。** 橋（39mm）の溝は2回目の剥がしで蝶番になり、
**軸受け穴を通って破断した**（溝入りの橋がさらに3枚、全部「溝に沿って・穴と無関係の位置で」破断。
計4枚で確定）。長い部品は端からこじると長手に曲がるが、**どの向きに溝を切っても
「どちらかのこじり方」に対しては蝶番になる。** 幅の狭い部品（ロック9mm）は曲げ方向が実質1つなので
溝が効く。**長い部品は溝ではなく犠牲タブ**（`bridge_print` の両端の薄板1.2mm。
ヘラはタブの下に入れ、本体を曲げない）。

🔒 **2026-08-29 ユーザー「天板、側板、底面板、ハッチ、フロントパネルには犠牲のアレを付けないで」。
筐体 v4 の外皮 6 枚（床・天面・左右の壁・ハッチ・フロント）から犠牲タブを外した。** `case_v4.scad` の
`print_*` から呼び出しを消してあり、STL も 2026-08-29 に焼き直してある（外形からタブぶんの 14mm が消えた）。
タブの形（`tab_x` / `tab_y` / `tabs_x` / `tabs_y`）は試し刷り `print_btntest` が使うので残っている。
⚠ `_stl_preflight.py` は接地面積が大きい板に今も「犠牲タブ」を勧めるが、これはユーザーの決定で外したもの。

以下は外す前の記録（2026-08-27 に入れたときの数字）:
~~筐体 v4 の 6 枚（床・天面・左右の壁・ハッチ・フロント）には 2026-08-27 にこのタブを入れた。~~
`case_v4.scad` の `tabs_x` / `tabs_y`（10 × 8 × 1.2・長い軸の両端・本体へ 3mm 食い込ませて角丸を跨ぐ）。
刷る向き（`print_*`）にだけ足してあるので、組み立ての形（`p_*` / `look`）には出ない。
⚠ **タブは接地面積を減らさない**（床 5770 → 5910mm²）。ヘラを本体に当てないための足場である。

### ✅ プレートの粗さは、刷る物の接地面積に合わせて変える（2026-08-31）

🔒 **番手は一度決めて終わりではない。刷る物の接地面積で変える。**（✅ ユーザー・実施済み）

🔒 **2026-09-09 訂正 ── 番手は吸着のためではなく、模様のための選択だった（ユーザー）。**
✅ ユーザー「実は小さいものでも 1000 まで磨いても十分吸着してるんだよ。800 とか 600 で良いのは、
ある意味**模様を見せたい時**と言う感じ。印刷物が**ヘアライン加工**みたいになるからね」。
⇒ **下の表の「狙い」の欄が間違っていた。** 粗くする理由は食いつきではない。**#1000 でも小さい部品は保つ。**
番手を落とすのは、プレートに接する面（外皮では**人の目に触れる面**・下の ⭐）に模様を出したいときである。
表は経緯として残す。

⬜ **運用は 3 段（2026-08-31）。ただし境目は ✅ 実績ではなく、ユーザーの勘である。**
🔴 **サンプルが少ない**（各段 1〜2 回・対照なし・レジンやプレートの研ぎ直しと交絡）。
ユーザー本人が「本当に？とソフトウェアエンジニアとして疑っている」と述べている。
⚠ **この表を根拠に自動判定を書かないこと**（下の「まだ道具にしない」）。
✅ 確かなのは「**番手を刷る物によって変えた**」という運用の事実の方で、境目の数字ではない。

| 刷る物 | 番手 | 狙いと結果 |
|---|---|---|
| **基本**（小さい部品） | **#600** | **取れやすく、しかも落とし（造形中の脱落）が出ない。**ここが既定値 |
| **少し大きい** | **#800** | 中間 |
| **全体の 7 割を超えるくらい** | **#1000** | 剥離しやすくするため。**そもそもデカくて吸着しやすい**ので、粗くしなくても十分に食いつく。実績: 天板（接地 5193mm²） |

⬜ **「全体の 7 割」の分母が記録できていない**（プレート 143 × 89mm に対してか、部品の外形に
対して接地が占める割合か）。⚠ **書き手が推測で埋めないこと。** 次にユーザーに会ったとき確かめる。

⭐ **磨くのは一定方向に。** プレートに接する面は、そのまま部品の表面になる。ランダムな傷は傷として
転写されるが、**一方向なら ヘアライン仕上げとして出る。**
🔴 **v4 の外皮では、これは仕上げの話ではなく外観そのものである。** 外皮は「外面を下」で刷るので
（§2.5）、**プレートに接する面が、完成品で人の目に触れる面**になる。
⇒ **番手を上げる判断は、剥離のためだけではなく、外観の仕上げを決める判断でもある。**
⚠ 外皮の置き方（どの面を下にするか）を変えると、**ヘアラインの出る面も一緒に動く。**

冒頭の「接地面積が剥がれなさを決める」への対策は、これまで**設計側**（半円溝・犠牲タブ）しか
書いていなかった。**プレート側にもつまみがある**という記録である。ユーザーの決定で犠牲タブを
外してある外皮 6 枚（床・天面・左右の壁・ハッチ・フロント）には、実質こちらが唯一の手になる。

⬜ **「鏡面にしたらダメ」は、この機体では検証していない。** §「プレートの傷」の末尾にあるこの一行は
**ネットの通説をそのまま持ち込んだもので、出典は実機ではない。**（🔴 2026-08-31 ユーザー
「鏡面にしたらだめって話だって分からんよ？本当に」）

ユーザーの指摘は筋が通る。**プレート側の食いつきは、単独では意味を持たない。**
造形中に部品を引き剥がそうとするのは FEP 側の離型力なので、成立条件は
**「プレートの食いつき ＞ フィルムの離型力」という比**である。フィルムが新しく滑るなら、
かなり滑らかなプレートでも保つ。曇った・張りの落ちたフィルムなら、同じプレートで落ちる。
⇒ **番手の正解はフィルムの状態にも依存する。**「#1000 にしてください」のような単独の数字は、
比の片側だけを言っている。

⬜ 鏡面が独立に悪いとしたら、考えられるのは「弱い」ではなく「**読めない**」方である（筋・未検証）:
平滑どうしは薄いレジンの膜を挟んで吸い付き（ブロックゲージのリンギングに近い）、
食いつきが弱いのではなく**回によってばらつく**可能性がある。⚠ これは確かめていない。

✅ **反証された（2026-09-09・ユーザー）。** 「小さい部品を #1000 で刷ると落ちる側に倒れるはず」という
この筋は外れていた。**小さい物でも #1000 で十分に吸着する。**

⬜ **なぜ面積で変えるのが正しいのか（筋・未検証）**: 剥離は縁から始まる。小さい部品ほど
**周長 ÷ 面積**が大きく、単位面積あたりで見ると縁の影響を強く受けるので、より強い食いつきが要る。
大きい部品はこの比が小さく食いつきに余裕があり、**余ったぶんがそのまま「剥がれない」に化ける。**

🔴 **記録に番手の列が要る。** §2 の実績値も、冒頭の「部品ごとの接地と、育ちの記録」も、
**どの番手のプレートで焼いたか**を書いていない。粗さは初層の食いつきを変えるので、
刷るたびに番手も一緒に残すこと。

### ⬜ まだ道具にしない（`_stl_preflight.py` に番手の判定を入れない）

上の 3 段を preflight に書けば「#800 で磨いてください」と自動で出せる。**が、いま入れると
n＝1 の勘が、機械の出す指示の顔になる。**（🔴 2026-08-31、AI が「分母が決まれば一行入れます」と
提案したが、早い。撤回した。）

⭐ **先にやるのは判定ではなく記録である。** 刷るたびに **番手・接地面積・結果**の 3 つを残せば、
いま出している印刷にただ乗りしてサンプルが貯まる。**勘を頭に置いたままだと、外れても
外れたことが分からない。**表に書いて初めて反証が効くようになる。

⬜ **入れてよくなる条件**: 各段に数回ぶんの記録が付き、**その間に一度も表と食い違わなかった**とき。
⚠ 食い違いが出たら、それは表が間違っている証拠なので、境目を動かして記録を続ける。

⚠ 対照実験は現実的でない（プレートを研ぐのは不可逆で、深い傷 1 本に 4 時間かかる。§「プレートの傷」）。
**取れるのは観察の積み上げだけ**である。

### 剥がし方

1. **角から攻めない。長い辺の真ん中から。** 角は肉が少なく、力が集中して欠ける
2. **突起を取っ手にしない。** 力は必ず底面の縁に、面で掛ける
3. **プレートを外してから**造形物を剥がす
4. ⚠ **金属ヘラはビルドプレートに使ってよいが、FEP には絶対に使わない**

❌ **決着（2026-08-31・ユーザー実機）: 温める・冷やすは、どちらも効かない。「ほぼ無関係」。**
**この軸はもう追わない。** 剥がれ方を決めているのは接地面積とプレートの粗さであって、温度ではない。
⚠ 以下は当時この節に書いた理屈だが、**実機で否定された。残してあるのは同じ道を二度たどらないため**である。

~~⬜ **冷やすか温めるかは未確定。**~~ 膨張率の差が界面に作るのは**面に沿ったせん断**で、
**縮んでも伸びても剥離の方向に働く**（「温めると押し合う」は起きない。ネット上に「温めろ」という
記事が多いのは、そちらも機構として正しいから）。ただし副作用が違う。

| | 界面 | 部品そのもの |
|---|---|---|
| 冷やす | せん断が出る | ⚠ **樹脂が脆くなる。** こじった瞬間に欠けやすい |
| 温める | せん断が出る | しなやかになる。欠けにくい |

⚠ **「プレートごと冷凍庫15分」は実機で効かなかった**（「全く変わらない」）。プレートは金属で
熱容量が大きく、15分では界面まで冷えない。🔴 **そして「効かない＝冷却不足」と決めつけないこと。**
15分で1mmも動かないなら、冷え方ではなく**接地面積**を先に疑う。
⚠ **水洗いレジンに温水を直接かけない**（未硬化の表面が水に侵される）。温めるならプレートの裏から
ドライヤーか湯煎で、**造形物を濡らさない。**

### 🔒 プレートの傷は造形に影響する

✅ **この機は譲り受けた物で、受け取った時点でプレートに大きな傷があった**（2026-09-09・ユーザー
「このプリンタをくれた人もビルドプレートに最初にあったでっかいキズとかを見る限り私の領域までは
来なかったんだと思うね」）。⇒ **うちは傷のある状態から始まっている。**⚠ 2026-08-06 に 4 時間かけて
落とした深い傷が、この受け取り時の傷と同じ物かは記録できていない。

🔒 **ネットの「傷は吸着を良くする」への答え（2026-09-09）。** ✅ ユーザー「大抵のサイトは
『傷は吸着を良くするので！』みたいなめちゃくちゃな事書いてあるけど大嘘だったね。いや吸着は良くなるけど
**剥がれなくなったら、なにもかもダメ**だし」。⇒ ①あの主張は**比の片方だけ**を言っている
（成立条件は「プレートの食いつき ＞ フィルムの離型力」で、その後に**取り外し**の工程がある）。
②**均一な粗さと、傷は別物である。**砂目のプレートが売られているのは前者で、面の全体に効く。
傷は一点に効き、下の機序で錨になる。**この 2 つを混ぜたまま「傷＝吸着」と書くと嘘になる。**

⚠ **傷の めくれた縁にレジンが流れ込んで焼き付くと機械的なアンカーになり、部品はそこだけ
剥がれずに、傷の真上で折れる。** 橋を溝→タブ→リブと3回設計変更しても折れ続け（1日で6枚破損）、
割れた位置が傷と一致することで判明した。**設計側の対策では直らない。**

**対処（この順で）:**

1. **応急: CHITUBOX で部品を傷のないエリアに配置する**
2. **恒久: プレートの研ぎ直し**（下）
3. 削った後は**レベリングと Z=0 をやり直す**
4. **平面が崩れていないか確かめる。** 紙の抵抗を**中央と四隅の5点**で比べ、中央だけ明らかに
   緩ければ**皿状に凹んでいる**

✅ **研ぎ直しは効いた（2026-08-06）。** 研いだ面での1枚目（`as5600_bridge_v2.stl`・溝なし・
両端タブ）は「めっちゃ簡単に取れた。綺麗。」で折れなし。⭐ **変わった変数はプレートだけで、
同じ橋は前日に設計を3回変えても折れ続けていた。傷が原因だったことが独立に裏付けられた。**

**やったこと**: #120から入って #600 まで（**深い傷1本の除去に4時間**）→ 中性洗剤でブラシ洗い →
乾燥。⚠ **IPA脱脂はしていないが食いつきは正常だった**（脱脂の役目は食いつきなので、
洗剤洗いが済んでいれば必須ではない）。

⚠ **電動サンダーは使わない。** オービタル・パッド式は面に追従し、**押し圧の高い所を深く削る**ので、
深い傷を狙えば傷の周りだけ凹む。**光造形はプレートの平面がそのまま1層目の精度**なので、
速いかわりに取り返しがつかない。

⬜ **次はこの方法で試す**（⚠ この機体では未実施・一般的な擦り合わせの作法）:
耐水ペーパーを**平らな基準面**（厚いガラス板・御影石タイル・定盤）にテープで貼り、
**プレートを裏返して面を下にし、8の字に動かす。当て木を動かすのではなく、基準面を固定して
プレートを動かす。** 面全体が一度に当たるので速く、基準面が平らなので**高い所から先に削れる＝
勝手に平面が出る**。Mars 3 のプレートは 143 × 89mm なので **A4サイズのガラス板1枚で全面が乗る。**
⚠ **鏡面にしない**（食いつきが死ぬ）。**指で直接研がない**（面がえぐれる）。
⚠ **アルミ粉がバットに入ると FEP を突き破る。** プリンタから離れて作業する。

## 5. 運用

### 🔒 一番大事なのはビルドプレートの状態（2026-09-09・ユーザー）

✅ ユーザー「一番大事だったのはビルドプレートだったんだ。いかに良い状態でビルドプレートを
維持するかが光造形では大事だね。本当に誰も教えてくれないし、何処にも書いてない」。

**この文書はここまで、露光時間・レジン・FEP・置き方という「設定できる物」を厚く書いてきたが、
それらの手前にプレートの状態という変数がある。** 造形物が機械に留まっているのは初層の食い付き
一点だけで、その上の全ての層は剥離力に引かれ続ける。したがって板の状態が悪ければ、
露光をどう振っても結果は安定しない。⚠ **この項目は数字にならないので、スライサーの設定表にも
販売元の手引きにも現れない。**うちがここまで書いてこなかったのも同じ理由である。

#### 🔒 傷は坂であって状態ではない（2026-09-09・ユーザー）

✅ ユーザー「ビルドプレートを傷なしで維持する事で連続印刷が可能になるんだけど。そもそも傷なしで
維持するのがめちゃくちゃ難しい。剥がれないから。**傷のあるプレートだと剥がれない。だからますます
傷がつくんだよ**」「だから**完全に磨ききる事が大事**なんだわ。**爪が掛からなければいいとかじゃない。
傷なしで 1000 番の面にならないとだめ**」。

🔴 **これは自分で自分を増やす。** 傷が入る → 剥がれない → 剥がすのに力と刃を使う → 傷が増える、
と一方向に転がるので、**傷のあるプレートで刷り続けるという選択肢は無い**（悪いなりに続く、にならない）。
⇒ **磨きの合格点は「使える」ではなく「傷が無い」である。**爪が掛からない程度に均した面は、
少し悪い状態ではなく**坂の途中**で、残した 1 本が次の回の起点になる。

⭐ **連続印刷ができるかどうかは、この 1 点で決まる。**（🔒 §冒頭「一番大事なのはプレートの状態」の
中身がこれである。）研ぎ直しは不可逆で、深い傷 1 本に 4 時間・磨きが発生すれば日程に 2 時間
（[CASE-V5-PLAN.md](CASE-V5-PLAN.md)）。⇒ **剥がしやすさは快適さの問題ではなく、プレートの寿命の問題。**

✅ **§4 の「番手 3 段」との関係（2026-09-09・確認済み）。** 到達点は **#1000 で傷なし**であり、
これは吸着の都合ではない。**小さい部品でも #1000 で十分に吸着する。**#800・#600 に落とすのは
**ヘアラインの模様を出したいときだけ**である（§4 の表の「狙い」の欄を訂正した）。

#### 🔒 いま使っている道具 ── 中京研磨 サビトール 中目 65×40×9（2026-09-09・ユーザー）

✅ ユーザー「サビトール 65x40x9 中目っていうふざけた包丁磨きツールがあるんだけど。実は今こればっかり。
**ヘラで付いた浅い傷は一発で落とせる**し、**出来上がりの面の触った感じが 800〜1000 番**なんだよ」。

⇒ ヘラで入る浅い傷は、番手を積み上げなくてもこれ 1 本で **#800〜#1000 相当の面**まで戻せる。
**毎回の維持はこの道具でやっている、というのが現在の運用である。**
⚠ 深い傷（§4 の「1 本に 4 時間」の側）にこれが効くかは、まだ書けていない。

🔴 **この製品は自称 #120 である**（✅ ユーザー「中京研磨 サビトール中目 って自称 120 番なんだよ」）。
**箱の番手と、出来上がる面は別の尺度である。**紙やすりの #120 は深い傷を作る番手だが、この道具の面は
触った感じで #800〜#1000 になる。⇒ **この文書で「#1000 の面」と書いているのは、結果としての面の状態で
あって、道具の番手ではない。**道具を選ぶときに数字だけで比べないこと。

⬜ **なぜそうなるか（一般論。この道具では未検証）**: この種の道具は**弾性砥石・ゴム砥石**と呼ばれ、
**金型の仕上げでは標準的な道具である**。
🔴 **ただし補充で買うのはサビトールそのものである。** 同じ原理でも、金型用として売られている物は
値段の桁が違う（✅ 2026-09-09 ユーザー「サビトール激安なのに」）。**カテゴリ名は原理を調べるための
言葉であって、買い物の言葉ではない。**ゴムや樹脂で砥粒を固めてあるので、
砥粒の頭だけが出た状態で当たり、高い所に当たると**粒が土台に沈んで逃げる**。⇒ 切り込みの深さを
決めているのが砥粒の大きさではなく**ゴムの沈み込み**になるため、**削る速さは粗い番手のまま、
傷の深さだけが浅くなる。**紙やすりは硬い台紙に砥粒が固定されているので、番手なりの深さで削れる。
また紙は削りカスで目詰まりして途中から擦っているだけになるが、ゴムは減りながら新しい粒を出し続ける。
⚠ この説明はこの製品で確かめていない。確かなのは ✅ の「触った感じが 800〜1000 番」の方である。
✅ 手持ちの紙やすりも残してあるが、**大体はサビトールで済んでいる**（2026-09-09・ユーザー）。

**手順は §4 の「プレートの傷」と「接地面積が剥がれなさを決める」に書いてある。**
番手の 3 段（#600 / #800 / #1000）・一定方向に磨くこと・その面が外皮の見える面になること・
研ぎ直しが不可逆で深い傷 1 本に 4 時間かかることは、すべて向こうが担当である。
この節は「どこに目を向けるか」だけを言っている。

この文書の中に散っている、プレートに関わる記録:

- 🔒 **Z=0 はこの機体では毎回の印刷ごとに取り直す運用**（§1）。**プレートを削っても Z ずれは発生しない**
- ✅ **プレートの取り付けとアームのガタは無い**（2026-08-30・ユーザー判断）。冒頭の「板が厚く出る」の
  原因はプレートではなく、プリンタ本体の土台の弾性たわみだった
- 🔒 **研ぎ直しの効果は実績で裏付いている**（§4）。2026-09-03 に接地面積を根拠にした剥がれにくさの
  警告を道具から消したのは、この実績が理由である
- ✅ **刷るぞーは配置の側でこれを守っている。** 縁から部品までの距離を見て、ヘラの柄がプレートに
  乗って刃が起き、アルミに傷が入る並べ方を止める（[surugo/server.py](../surugo/server.py) の `edge_gap`）
- 🔒 **日程にも入っている。** 「プレート磨きが発生すれば 2 時間」（[CASE-V5-PLAN.md](CASE-V5-PLAN.md) §冒頭）

- 🔒 **Z=0 は毎回取り直す**（1章）
- **レジンはよく振る。** 振り足りないと硬化不良で「露光時間が足りない」と誤診する
- 🔴 **液面は底から10mm・造形物の高さ + 6mm を確保する。少ないまま刷らない。**
  ⚠ 2026-08-10 に peg_bore_gauge v2 が失敗した回は、レジンがかなり少なくなっていた
  （液面が薄いとリフト後の戻りが追いつかず、細い断面から欠ける）
- 🔒 **印刷に失敗したら、FEP は「本来は」張り替える。掃除で済ませない**（2026-08-31・ユーザー）。
  硬化した層はフィルムに**面で**貼り付くので、剥がすには**縁だけで支えられた膜を押す**ことになり、
  局所的に伸びる。⚠ **問題は弱くなることではなく、そこだけ性質が変わることである。**
  伸びた場所は失敗した場所＝**次も刷る場所**（普通は中央に置く）なので、
  フィルムの状態が一様な変数ではなく**位置依存の変数**に化ける。機械もスライサーもその位置を
  記録しないため、以後の不調は原因不明のまま残る。⇒ **掃除は寿命を延ばしているのではなく、
  追跡できない欠陥を 1 つ埋め込んでいる。** §6 に **FEP 予備あり**。
  ✅ バットのレジンを**濾す**のは別件で問題ない（膜を擦らないので）。
- **洗浄・二次硬化は ELEGOO Mercury Plus**（兼用機）。水洗いレジンなら**水**を入れる。
  **洗浄3分 → 完全に乾かす → 硬化4分。硬化は4分で止める**（当てすぎると脆くなって黄変する）
#### ✅ 洗ってから二次硬化までの段取り（2026-09-09・ユーザー）

1. 洗う
2. **エアブラシで風を当てて乾かす**（下の項目。洗い残しの判定も兼ねる）
3. **塗装ブースの中でしばらく置く。** ブースは常時換気しているので、乾燥と保管を兼ねる
4. **その置いている間に、ヘラを掃除し、手袋を乾かし、次の印刷を機械に入れる**
5. **乾いたものを取り出して二次硬化を始める**

⭐ **下の ⬜「完全に乾かす時間が書かれていない」に対する、この工房での答えがこれである。**
時計で計るのではなく、**3〜4 の他の作業が終わるまでの長さ**を乾燥時間にしている。
⚠ 実際に何分になっているかは記録していない。
⭐ **次の印刷を先に入れているので、機械の時間と手の時間が重なっている。**乾燥待ちが段取りの
待ち時間になっていない。
🔒 **塗装ブースがあり、常時換気している**（§安全の「換気」は、この設備で満たされている）。

- ✅ **いまは洗浄後にエアブラシで風を当てて乾かしている（2026-09-09・ユーザー）。**
  ⭐ **これが残ったレジンの判定にもなっている。**✅ ユーザー「風を当てて乾かないのがレジンだからね」。
  ⇒ 水は飛ぶがレジンは飛ばないので、**濡れたまま残る場所＝洗い残し**である。時間で「乾いたはず」と
  決めるのではなく、**風を当てて見た目で判定できる。**
  ⚠ 使っているエアブラシの圧・当てる時間は記録していない。
- ⬜ **「完全に乾かす」の時間が書かれていない（2026-09-04・一般論。実機未検証）。**
  [SK本舗のコラム](https://skhonpo.com/blogs/3dprinter-practice/usercolumn05) は二次硬化後の反り・
  クラックの機序をこう書いている: 二次硬化の光重合反応で**熱が出る** → 硬化したレジンの中に残った
  **水分がその熱で膨張** → 冷却で収縮 → **内部に応力・クラック**。同記事の対策は
  **「出力後、半日から1日、送風機で送風して常温で乾燥させてから二次硬化する」**で、
  「この方法を始めてから5か月程度経過したレジンでもひび割れ等は発生していない」としている。
  🔴 **うちはレジン④（ELEGOO 水洗い可能 2.0）を水で洗っているので、部品に残るのは水である。**
  ⇒ 二次硬化後に板が反る症状が出たら、置き方より先にここを疑う。**設計も設定も変えずに試せる。**
  ⚠ 出典は 1 件（レジン販売店のコラム）で、この機で確かめていない。
- ⬜ **サポートを付けたまま二次硬化する（2026-09-04・一般論。実機未検証）。**
  [i-maker の解説](https://i-maker.jp/blog/sla-warping-guide-form4-medsupo-52941.html) は別の機序を挙げている:
  「**二次硬化中は熱と光でレジンが収縮します。サポート材を先に外してしまうと、造形物が自由に収縮して
  反り返ってしまいます。**」⇒ サポートを**骨組み（矯正器具）**として使い、形を拘束したまま焼く。
  外すのは「硬化が完了し、常温に戻ってから」。薄板・棒状の部品はタッチポイントを
  0.60 → **0.70〜0.80mm** に太くして拘束を強くする、とも書いている。
  🔴 **うちの大物（`v4_top` 40% / `v4_floor` 45% / 壁）は §3 の判断で全部「直置き」で、
  サポートもラフトも無い。** プレートから剥がした瞬間に完全に自由な板になり、その状態で焼いている。
  ⇒ **この記事の言う「先に外してしまった」状態が、うちでは常時である。**
  ⭐ §3 が直置きを選んだ理由は「上面に精度の要る基準面があるから、傾けると基準面を失う」だが、
  **これは板が平らなまま出てくることが前提の理屈**で、反るならどのみち基準面は失われている。
  ⚠ うちの板が実際どれだけ反っているかは測っていない。
  ⚠ **この記事の時間・温度は移らない。** 向こうは Form 4 ＋ Form Cure（加熱庫）＋ Rigid 10K で、
  うちは Mercury Plus（**加熱なし**）＋水洗いレジンである。**「二次硬化 30分×2回」「庫内を予熱」は
  持ち込まないこと。**上の「硬化4分で止める」がこの機の実績値である。
  ✅ 移るのは「洗浄後にブロワーで隙間の洗浄液を飛ばす」「拘束したまま焼く」という**手順の形**だけ。

✅ **いまやっている対処: 床に板を並べて、上から重しを乗せる**（2026-09-09・ユーザー）。
⚠ いつ乗せるか（二次硬化の前か後か）・時間・重さは記録していない。上の ⬜ 2 つ（乾燥時間・
サポートを付けたまま焼く）とは別の、実際に手を動かしている手当てである。

### 🔴 反ったのは t=2.0 の裸の板 4 枚だけだった（2026-09-04・実機）

✅ ユーザー「ハッチ、フロント、横壁ｘ２が凄く歪みましたね」。STL の実寸を並べると 4 枚は同じ形をしている。

| 部品 | bbox | 設計厚 | **実測厚** | LCD 比 | t³（front=1） | 反り |
|---|---|---|---|---|---|---|
| `v4_floor` | 86.7 × 71.0 | 2.0 | **2.8** | 45% | **2.74** | — |
| `v4_top` | 86.7 × 74.6 | 2.5 | **3.4** | 40% | **4.91** | — |
| `v4_hatch` | 86.7 × 50.5 | 2.0 | **2.2** | 27% | 1.33 | 🔴 凄く歪んだ |
| `v4_lwall` | 71.0 × 48.5 | 2.0 | **2.2** | 26% | 1.33 | 🔴 凄く歪んだ |
| `v4_rwall` | 71.0 × 48.5 | 2.0 | **2.2** | 26% | 1.33 | 🔴 凄く歪んだ |
| `v4_front` | 86.7 × 52.1 | 2.0 | **2.0** | 11% | 1.00 | 🔴 凄く歪んだ |

✅ 実測厚は 2026-09-04 にユーザーが現物を測った値（「ハッチも横板ｘ２も２．２ｍｍ、フロントは2mmでしたね」）。
🔴 **反った組は 1.00〜1.33、反らなかった組は 2.74〜4.91。重なりが無い。** 境目はこの間にある。
✅ ユーザー「完全に面積に反映されてるんで、相変わらずクソプリンタの特性ですね」。
⇒ 育ちは 9% と 11% で 0、26〜27% で +0.2、40〜45% で +0.8〜0.9 と、**面積に対して単調**である。
**冒頭の「土台のたわみ」の診断が、2 点から 6 点に増えて裏付いた。**

⭐ **曲げの硬さは厚みの 3 乗で効く。** t=2.0 を 1 とすると、実測 3.4 の天板は **4.9 倍**、
実測 2.8 の床は **2.7 倍**。⇒ **冒頭で敵だと思っていた「板が厚く出る」現象が、天板と床を反りから守っていた**
という筋になる。反った 4 枚はどれも **30% の線の下**（26 / 27 / 11%）で、育ちが乗らなかった。

#### ⬜ 厚みで買うといくらか（算数。設計判断はしていない）

反らなかった床（焼き上がり 2.8）と同じ硬さを、壁・ハッチで買うなら:

| 設計 | 焼き上がり（育ち +0.2） | t³（front=1） |
|---|---|---|
| 2.0 | 2.2 | 1.33 ← いま。反った |
| 2.4 | 2.6 | 2.20 |
| **2.6** | **2.8** | **2.74** ← 床と同じ |

⚠ これらの部品の育ちは **+0.2** で、板厚を変えても接地面積は変わらないので +0.2 はそのまま乗るはず。
⚠ **`WALL` を上げると内寸・嵌め合い・`IN_X`/`OUT_X` が全部動く。これは算数であって提案ではない。**
⚠ 厚みと同時に「板から立っている物の量」も違う（天板 20.9mm / フロント 11.0mm）ので、
厚みだけが効いていると断定はできない。ただし**壁とハッチは 9.0 / 6.6mm でフロントより少ないのに
反りは同程度**なので、リブ量では説明しきれない。

🔴 **育ちはタダの強さではない。** 育つのは**内面**なので、天板は同じ +0.9 で
六角ナットのポケットと裾を飲んでいる（冒頭）。**固さを買って内側の形を売っている。**
設計で厚くすれば、同じ固さを**内側の形を壊さずに**手に入れられる。

#### 真ちゅう線を差して焼く案（⬜ 人から聞いた手。この 4 枚には小さすぎる）

「造形の時点で穴を開けておき、1mm 真ちゅう線を二次硬化前に差し込んでおくと反らない」という手。
曲げ剛性で比べるとこうなる（⚠ ヤング率は**仮定値**。レジン 2.0GPa・真ちゅう 100GPa）:

| | 値 |
|---|---|
| 真ちゅう φ1.0 を 1 本 | **板の幅 3.68mm ぶん**（t=2.0 の板の場合） |
| 壁（幅 48.5）を倍にする | **13 本** |
| ハッチ（50.5）/ フロント（52.1） | **14 本** |
| 参考：板厚 2.0 → 2.5mm | **1.95 倍**（真ちゅう線 13 本とほぼ同じ） |
| 参考：板厚 2.0 → 3.0mm | **3.38 倍** |

⇒ φ1.2 の通路を 3.7mm ピッチで 13 本並べたら、2.0mm の壁は櫛になる。**この 4 枚には道具として小さすぎる。**
⭐ 逆に **t1.5 × 幅 10mm の細い帯なら 1 本で値が倍になる**ので、手そのものは本物である（相手が違う）。
ロック・シャッター・帯の類なら効く側。
⚠ それでも、φ1.2 × 長さ 50mm の穴は**洗えない**（中の未硬化レジンが抜けないので、線は焼いた後固着する）。
⚠ t=2.5 の板なら残り肉は片側 0.65、t=2.0 なら 0.40。両方とも §2 の「薄壁の下限 0.3mm」の上で、**穴自体は開ける**。
⚠ ただしうちの機では、板の下側 1.2mm にある通路は**育ちに埋まる可能性がある**（テスト板の柱が 3 本沈んだのと同じ機序）。
- ⚠ **洗った水は排水に流さない。** 「水洗い」は水で洗える意味で、流せる意味ではない。
  容器のまま日光に当てて硬化・沈殿させ、沈殿物を可燃ゴミにする

### 安全

- **ニトリル手袋。素手で触らない**（未硬化レジンは皮膚感作性がある。**一度かぶれると以後ずっと反応する**）
  - ✅ **手袋はエアブラシで乾かして再利用している**（2026-09-09・ユーザー）。**乾いていると着けやすい。**
  - ⭐ **同じエアブラシで穴の検査をしている。**✅ ユーザー「膨らませて乾かして音を聞くんだよね」。
    ⇒ **空気を入れて膨らませ、漏れの音で破れを見つける。**手袋の破れは、上の「一度かぶれると
    以後ずっと反応する」の入口そのものなので、**再利用の可否をその場で判定できる手順**になっている。
    ⚠ この検査で見つかるのは音になる大きさの穴で、**微細な孔や、溶剤で薄くなった部分は見つからない。**
    ⚠ ニトリルは IPA やレジンに触れ続けると劣化するので、回数の上限は決めていない（未記録）。
- **換気** ／ **IPA は引火性・火気厳禁** ／ **UVレジンは日光でも硬化する**（直射日光の下で作業しない）
- ⚠ LCD の露光テスト中は**直視しない**

## 6. 手元にあるもの

| 品目 | 内容 |
|---|---|
| プリンタ | ELEGOO Mars 3（4K モノクロLCD） |
| レジン① テスト用 | SK本舗 Water Washable 灰（**水洗い**） |
| レジン② **本番用** | SK本舗 Ultra 高靭性 白（**要IPA洗浄**・2024年11月バッチ） |
| レジン③ 予備 | ELEGOO Plant-based Tough 灰 |
| **レジン④ いま機械に入っている** | **ELEGOO 水洗い可能レジン 2.0 クリアブルー**（1000g・395〜405nm・Amazon B0FMJ1T3L4・**2,879 円**）<br>2026-08-31 に投入。⚠ レジン③（Plant-based Tough 灰）とは別物。露光は SK本舗の値（2.500s / 初期層 30.000s）を流用したまま |
| 洗浄・二次硬化 | **ELEGOO Mercury Plus**（兼用機） |
| 洗浄 | IPA 約3L（本番レジン用） |
| **プレートの研ぎ** | **中京研磨 サビトール 中目 65×40×9**（包丁用の研磨ブロック・**自称 #120**）。**いま維持に使っているのはこれ**。ヘラの浅い傷を一発で落とし、出来上がりの面は #800〜#1000 相当（§5。箱の番手とは別の尺度） |
| 消耗品 | FEP予備あり ／ ニトリル手袋 ／ 濾し器（本体付属のペイント用ストレーナー） |

⬜ **買い足すもの**: キッチンペーパー・プラ製のヘラ（金属は FEP を傷つける）／
デジタルノギス（¥1,500前後。**無くても作業は止まらない。** 要るのは縮み率そのものを数値で
知りたいときだけ）。

⚠ **レジン②は2024年11月バッチで、約1年9ヶ月経っている。** 顔料が底に固着している可能性があるので、
よく振る。心配なら濾してからバットへ入れる。

## 7. ⬜ 本番レジン（レジン②）に移るときの宿題

🔴 **この節の前提が揺れている（2026-09-09・ユーザー。別途あらためて話す予定の話題）。**
✅ ユーザー「倍以上した SK本舗のやつ、質悪いよあれ。エレグーの激安透明レジン**収縮率も少ないし、
曲がりも少ない**。いや曲がるけど」。⇒ **今入っている ELEGOO 水洗い可能 2.0 の方が、値段の高い
SK本舗より収縮と反りで良い**、という実感である。この節は「いずれ SK本舗の Ultra へ移る」という
前提で書かれているので、**移るかどうかから見直しになる。**
⚠ **どちらの SK本舗（レジン① Water Washable / レジン② Ultra）を指しているかは特定していない。**
⚠ 数字ではなく使った実感であり、比較の条件も記録していない。**この旗を根拠に節を書き換えないこと。**

🔴 **移ると IPA が作業場に入る。** ✅ この工房では**塗装ブースの中で半田付けもしている**
（2026-09-09・ユーザー。内部照明を使用）。⇒ レジン②へ移ると、**IPA（引火性・火気厳禁。§5 安全）と
半田ごてが同じブースを使うことになる。**いまのレジン④は水洗いなので、この重なりは発生していない。
⚠ 具体的な手当て（洗浄の日と半田の日を分ける等）は決めていない。**移ると決めたときに決めること。**

**露光時間はレジンとプリンタの組み合わせごとの実測値で、ネットの数字は出発点にしかならない。**
露光テスト用のモデル（Cones of Calibration / AmeraLabs Town / XP2 Validation Matrix など）を
刷って詰める。

| 項目 | 出発点の目安（**実測で置き換える**） |
|---|---|
| 層厚 | 0.05mm |
| 通常露光 | 2.0〜3.0秒 |
| ボトム露光 | 30〜40秒 |
| ボトム層数 | 4〜6層 |

**高靭性レジンは標準レジンより長めに要ることが多い。**

## 8. ⬜ 宿題: 剥離のために足した逃げを、1つずつ外して部品を強くする

傷対策として入れた逃げは、面がきれいになった今は**部品を弱くしているだけかもしれない。**
⚠ **外すのは1回に1つ。**

| 順 | 外すもの | なぜこの順か |
|---|---|---|
| ① | **橋の犠牲タブ**（`bridge_print` 両端1.2mm） | **一番安い実験。** 橋は小物で刷り直しが軽く、しかも「力が要らない」＝余裕が大きいことが分かっている |
| ② | **ロックの `RELIEF_D_LK`**（1.8 → 溝深さ0.9） | **強度を一番食っている逃げ**（板厚2.6mmに対して0.9mm＝約1/3）。⚠ 薄い平板は剥離が一番難しいので**①の結果を見てから** |
| ③ | ~~枠の `RELIEF_D_FR`~~ | ⬜ **やらなくてよい。** 枠は壁7.3mm厚・高さ26mmで溝は強度を食っていない。**得るものが無い変更で変数を増やさない** |

---

## 9. 較正の記録（済み・数字の出どころ）

### 磁石ポケットのゲージ ✅（2026-08-02）

内径 3.8〜4.5mm のリング8個を桟でつないだ1枚。**磁石が「少し力を入れると入り、ガタつかない」
最小のリングの内径が、そのままポケットの設計値になる。**

| リング | 内径 | 結果 |
|---|---|---|
| D | 4.2mm | 嵌るが**逆さまにすると落ちる**（緩い） |
| **E** | **4.10mm** | ⭐ **スポッと嵌り、逆さまでも落ちない** |

⭐ **これが効くのは、ホルダーの設計に要るのが磁石の絶対径ではないからである。** 必要なのは
「どの設計値で穴を作れば刷ったときにこの磁石が嵌まるか」で、それは**磁石の公差と樹脂の縮みの
両方を含んだ値**でなければ意味がない。ノギスで磁石だけを測っても、そこから縮み量を推定する
一手間が残る。

磁石は公称φ4.0mm なので、**設計4.1mmの穴が実寸4.0mm前後に焼き上がっている＝穴は約0.1mm縮む。**

### 🔴 ゲージの答えは「どの入れ方で測ったか」とセットでしか使えない（2026-08-17）

リード用磁石（φ6×2）の圧入ゲージ（[fit_gauge.scad](../hardware/frozen/v1-v4/fit_gauge.scad)）は
2列を別々に測っていた。

| 列 | 入れ方 | 出た答え | それは何の値か |
|---|---|---|---|
| 丸穴 | 磁石を**軸方向**に押し込む | 6.10 | **落ちない**いちばんきつい穴＝圧入代 |
| 立て溝 | 磁石を**立てて横から滑らせる** | 幅 2.02 | 掴む2面の締め代（進行方向の幅は 6.3 固定） |

つまみは磁石を**立てて滑り込ませる**設計なので、必要だったのは立て溝の側の数字だった。
ところが `MAG2_D` に丸穴の 6.10 を書き戻していた。**6.10 は通り道の幅としては
「刷ると 0.1 縮んで磁石と同寸」**になり、道が消える。2026-08-17 の実物で磁石が入らなかった。

🔒 **ゲージは正しかった。6.1 で滑らせるという入れ方を一度も試していなかっただけ。**
ゲージで磁石が実際に滑って入ったのは幅 6.3 の溝で、いまは `MAG2_D = 6.3` にしてある。

⭐ **教訓は2つ。**
- **「落ちない最小の穴」は圧入の答えであって、通り道の答えではない。**
  部品が**通る**必要があるなら、通す向きに動かして測ったゲージの値を使う
- **モデル側で通り道そのものを検査する。** 部品を入口から座まで掃引した立体と実体の
  交わりを取り、空であることを見る（`openscad -D 'part="magpath"'` ＝ knob_v5.scad の中に置いた検査）。
  「座に収まるか」だけを見ていると、収まる位置まで**行けない**形が通る

### 🔴 蓋のツメのゲージ ❌ 2回作り直した（2026-08-20）

[cover_tab_gauge.scad](../hardware/frozen/v1-v4/cover_tab_gauge.scad) は rev.C。rev.A と rev.B は
**このページに既に書いてあるルールを、書いた本人が読まずに破って**失敗した。

| 版 | 何をした | どのルールに反したか |
|---|---|---|
| rev.A | 受け側に「横から覗く窓」を開けた | 溝の天井 12×18mm が 2×3mm の柱2本にぶら下がる片持ちになり、無サポートで垂れた。番号も独立部品にしていたので洗浄でバラバラになった |
| rev.B | ツメの厚み 1.2 を Z に取ってプレート直置き | 上の「板バネのゲージ」…**厚みを Z に取るとボトム層が支配する** |
| rev.B | -X からまっすぐ差すだけにした | 上の「どの入れ方で測ったか」…**通るものは通す向きに動かして測る**（蓋は Y へ滑らせる） |

⭐ **教訓: 噛み合う2部品の実機の印刷向きが違うなら、ゲージも向きを分ける。**
蓋の 1.2 は板を寝かせて刷るので **XY** に出る。筐体側の溝の高さは **Z** に出る。
`COV_CL` が飲み込むのはこの2つの誤差の和なので、片方の向きだけで刷ったゲージでは
どちらも再現できない。rev.C は受け側を寝かせ、ツメ側は板から立てたリブにして分けてある。

### 板バネのゲージ ❌ → 🔒 レジン①では作れない

厚み 0.4/0.6/0.8mm × 長さ 12/18/24mm の9枚（根元を桟に固定した片持ち梁）。
⚠ **刃は寝かせず「立てて」ある**（厚みが水平方向）。厚みを Z に取ると、ボトム層（35秒露光の
5層＝0.25mm）が刃の大部分を占めてしまい、**過硬化した層の硬さを測ることになる。**

**刷った直後（2026-08-02）**: t/L が **1/30 以上なら全部OK、1/40 以下なら全部NG。例外なし。**
OK の下限3つ（0.8×24・0.6×18・0.4×12）は厚みも長さもバラバラなのに t/L がぴったり 1/30 で揃った。
**成否を決めているのは絶対寸法ではなく縦横比。**

**約1日半後（2026-08-03）**: ❌ **同じ9枚が、押した瞬間に全数破断した。**
前回「戻る」だった3枚も、いちばん太く短い 0.8×12（t/L 1/15）も例外なし。
**変わったのは形状ではなく時間で、レジン①が経時で脆化した**（光造形のレジンは刷った後も硬化が進む）。

> 🔒 **結論: レジン①でプリント一体の板バネは作れない。** t/L の比率をどう取っても助からない。
> ⬜ **レジン②（高靭性）か金属片（リン青銅など）へ進む。**

⭐ **教訓: 弾性部品の合否は「刷った直後」で判定してはいけない。** 数日置いてから同じ試験を
やり直すまでが1セット。硬さ・寸法は直後でよいが、**曲げるものは別。**

⚠ **この🔒の守備範囲は「弾性部品」だけ。**「砕けた」「バリバリ」と言葉づかいが似ていても、
**未硬化の部品が剥がすときに割れる話は別件**（経時ゼロでも割れた実例がある）。
**破壊の言葉の一致を診断の証拠にしない。**

### 立ち上げ（0〜3）✅ 通過済み（2026-08-01）

| 段 | 何を見たか | 結果 |
|---|---|---|
| 0 | **LCD の生存確認**（バットを外し、露光テストで全面点灯。⚠ 消耗品で寿命2000時間前後） | ✅ 全面点灯・欠け線やドット抜けの塊なし |
| 1 | 機構（Z軸の上下・プレートとバットの固着レジン・FEP の白濁/傷/張り） | ✅ 全項目良好。**FEP は「ポン」＝張りあり**で張り替え不要 |
| 2 | **ビルドプレートのレベリング**（A4用紙1枚・対角の順に締める・紙が軽い抵抗つきで抜ける） | ✅ 完了。⚠ **Z=0 の設定を忘れると調整が全部消える** |
| 3 | 水洗いレジンで一連の流れを1回通す | ✅ 成功（20mm角の板・リング・薄壁・ピン） |

🔴 **0 が最優先である。** ここが通らなければレベリングも露光テストも全部無意味になる。

## 9.5 外注（JLC3DP）に出すときの数字（2026-09-12）

**🔴 上げるのは支柱を外した STL。** `hardware/stl/v5/` の STL には自分の機械用の支柱とラフトが入っている。
天板で比べると、支柱つきは 22.82cm³・三角 20,240 枚・面積ゼロ 702 枚・**閉じていない（不正な辺 451 本）**、
素の形（`-D PROPS_OFF=true`）は 21.74cm³・三角 11,774 枚・面積ゼロ 0 枚・閉じている。
値段も 5% 違う（$2.08 → $1.98）。向こうは自分で支柱を付けるので、こちらの支柱は入れない。

**向こうの下限**: 壁 1.2mm 超・最も薄い部分 0.8mm 以上（アップロード画面）。
薄肉のヒートマップは 灰 = 1.2mm 以上・黄 = 0.5〜1.2mm・赤 = 0.5mm 未満。
🔒 この 2 つの数字で `_stl_preflight.py --mat nylon` が判定する（2026-09-15・接地や立ち上がりは見ない。[CASE-V61N.md](CASE-V61N.md) 5 章）。

**素の天板でも警告は消えない。** 残っているのは次の 2 つで、外注に出すならここを直す。

| 場所 | いまの値 | 向こうの下限 |
|---|---|---|
| スピーカーのハニカムの肉（`spk_v5.scad` の `S_HEX_WALL`） | 0.6mm | 0.8mm |
| 先細りの縁（X 25.7〜28.4 / Z 3.4〜5.4・Y −10.76 の面） | 0.01 → 0.25mm | 0.5mm を割る＝赤 |

**値段（2026-09-12・レジン 9600 Resin White・サインイン後）**: 8 部品 88.2cm³ で $8.05、
送料 $7.16〜7.18（OCS Express・4〜6 営業日・0.26kg）、造形 3 日。**1 台ぶん 約 ¥2,350**。
DMM.make の同じレジンは ¥83/cm³ で ¥8,300＋送料だった。
基板と同じ買い物かごに入れれば送料は 1 回で済む（[POWER.md](POWER.md) 案③）。
**LCSC の部品・JLCPCB の基板・JLC3DP の 3D プリントは 1 つの箱にまとめられる**
（2026-09-12 に確かめた。条件と期限は POWER.md の「発送は…1 つにまとめられる」）。

### レジンと MJF（ナイロン）の値段の差（2026-09-12・同じ 21 点の素の STL で見積もり）

🔴 **MJF を選ぶ根拠に「反り」を使わないこと。** v5 の板が刺さらなかった件は反りではなく、
反り対策で壁を厚くしたときに口の奥行き（相手が基板から何 mm 出るか）を取り直さなかった
ことが原因である（2026-09-12・ユーザー）。**反りが組み立てを止めた記録は他に無い。**
MJF が買っているのは耐熱 175℃・支柱跡が出ない・丈夫の 3 つで、反りではない。

同じ画面で材料だけ切り替えて出した数字。単価は体積に比例し、**1 部品ごとの下限**がある。

| | 9600 Resin White | MJF PA12-HP ナチュラルグレー | MJF PA12-HP 黒染め |
|---|---|---|---|
| 単価 | $0.090/cm³ | $0.3395/cm³ | $0.3772/cm³ |
| 1 部品の下限 | $0.31 | $0.94 | $1.04 |
| 下限を抜ける体積 | 3.44cm³ 超 | 2.77cm³ 超 | 2.76cm³ 超 |
| 大きい 8 点（87.1cm³） | $7.95 | $29.58 | $32.85 |
| 小さい 13 点（14.0cm³・全部が下限） | $4.03 | $12.22 | $13.52 |
| **21 点の合計** | **$11.98** | **$41.80** | **$46.37** |
| ＋送料 $7.2（OCS・0.26〜0.28kg） | 約 ¥2,950 | 約 ¥7,540 | 約 ¥8,240 |

**MJF は約 3.5 倍。** 差の内訳は単価が 3.8 倍と、下限が 3 倍（$0.31 → $0.94）。
小さい 13 点は全部が下限に当たっていて、体積ぶんの値段（合計 $4.75）の 2.6 倍を払っている。
**小物をランナーで 1 部品につなげば** 13 点ぶんが $12.22 → 約 $4.8 になり、合計は $34 台まで落ちる（切り離しと面出しは自分の手）。

MJF に振り替えるときに設計で効くのは次の 3 つ。

| | 9600 Resin | MJF PA12-HP |
|---|---|---|
| 公差 | ±0.2mm または 0.3% | ±0.3mm または 0.4%（100mm 以内） |
| 熱変形温度 | 56℃ | 175℃ |
| 表面 | 積層の段・支柱の跡・紫外線で黄変 | 全面マット・支柱なし・染色は色ムラが出ることがある |

公差が 0.1mm 緩む側に動くので、**嵌め合い（E リングの溝・六角ポケット・爪）は MJF 前提で引き直す**。
最小肉は向こうの下限（最薄 0.8mm）が変わらないので、ハニカム 0.6 → 0.8 の直しはどちらでも要る。

#### MJF の本当の利点は軽量化（2026-09-12・ユーザー）

🔒 **v6 は自分の機械で刷る（レジン）。MJF が効いてくるのは v7 の軽量化・小型化のとき。**
値段の比がそうなっているためで、1 台あたり 自分で刷る 約 ¥340 ／ 外注レジン 約 ¥2,950 ／
外注 MJF 約 ¥7,550 である（上の表）。外注レジンは反りの理由にならないので、真ん中は選ばない。

重さを決めているのは**板の厚み**である。いまの板厚は 壁 2.0・天板 3.7・フロント 2.8 で、
この 3 つはどれも自分の機械の癖を避けるために厚くした数字である。

| 厚くした理由 | MJF だとどうなるか |
|---|---|
| 天板 2.5 → 3.7（大きい平面が厚く出る・土台がたわむ） | 接地もたわみも無いので理由が消える |
| 壁 2.0 ＋ 反り対策のリブ | 反らないので理由が消える |
| — | 強度はレジン 23.4MPa に対し PA12 はカタログで倍前後 |

⚠ **リブを外しても軽くならない。** 5 点（左右の壁・ハッチ・フロント・ブリッジ）のリブを
`RIBS_OFF=true` で外して測ったら **4.82cm³**、21 点 101.14cm³ の 5% しかなかった。
効くのは板そのものである。

| | 体積 | 重さ |
|---|---|---|
| いま（レジン・密度 1.10） | 101.14cm³ | **約 111g** |
| 同じ形を MJF（密度 1.01）で | 101.14cm³ | 約 102g |
| 壁 1.2・天板 2.0 まで薄くしたら | ざっと 60cm³ 台 | **60〜70g** |

⚠ 最後の行は板厚に比例するという見当で、**掃引して測ってはいない**（2026-09-12 時点）。

### 数量を増やしても単価は下がらない（2026-09-12・実測）

同じ 10 点を数量 1 と数量 10 で出したところ、**どちらの材料もぴったり 10 倍**だった。

| | 数量 1 | 数量 10 |
|---|---|---|
| 9600 Resin（10 点） | $8.57 | $85.70 |
| MJF ナチュラルグレー（10 点） | $31.46 | $314.60 |

1 部品の下限も台数ぶん掛かる（inabar 0.21cm³ は $0.31 → $3.10、MJF は $0.94 → $9.40）。
**つまり数量割引は無く、レジンと MJF の差額は台数に正比例して開く。**

送料だけは台数に比例しない。0.28kg で $7.18（OCS Express・4〜6 営業日）、
1.93kg で $9.82（UPS Worldwide Express Saver・2〜4 営業日）だった。
1 台ぶんの送料は 10 台まとめると 1/7 になる。

## 10. 設計に効く教訓

### 🔴 外形が合っていても、基板は板ではない

治具のコネクタのスロット位置が外れた件（2026-08-02）は、推定を外した話でも実物を測らなかった
話でもない。**ユーザーは、そこにピンヘッダーが立っていることを事前に説明していた。情報は在った。
にもかかわらず、ピンヘッダーが設計の構成要素として入っていなかった。**

証拠は `.scad` に残っている。スタンドオフ6mmを「**ピンの逃げ**」と書いていた
（[knob_jig.scad](../hardware/frozen/v1-v4/knob_jig.scad) の `STANDOFF_H`）。**基板から生えている物を、
空間を占める部品ではなく、下に空ける高さの数字として扱っている。** だからコネクタのハウジングが
入る体積も、線が曲がる余地も、最初から設計に存在しなかった。

> 🔒 **設計に入る前に、基板から突き出ている物を部品として列挙する。**
> 輪郭（外形・穴ピッチ）は列挙の対象の半分でしかない。
> ⚠ **寸法表だけでは、この事故は防げない。** 外形と穴ピッチの行がいくら正確でも、
> 「ピンヘッダーが立っている」は外形の行にならない。**表に載らない物のほうが落ちる。**

### ⬜ 治具の基板がまだ少し斜めに付いている（未解決）

窓に変えた後も**ピンヘッダーに対して窓がギリギリで、基板が少し斜めに付いている。**
「基板の下を丸ごと窓にしたから、ピンがどこに生えていても通る」は成立していない。

⚠ **これは治具の目的に直接効く。** 治具は AS5600 の**同芯**のために作ったもので、基板が傾けば
磁石とチップの距離と平行が崩れる。回転テストは合格しているが、**その数字は傾いた基板の上で
取られている**。AGC を紙で調整した経緯（`CHIP_GAP` を 1.5→1.1 に落とした）も、傾きと
切り分けられていない。

**次に刷るときに効かせること:**

- 窓は**ピンヘッダーの外形＋ハウジング＋線の曲がり**に対して余裕を取る。ギリギリで通すのではなく
  **当たらない寸法**にする
- **基板の姿勢は座（スタンドオフ）で決める。** コネクタやピンに触れて浮くなら、それは座が
  効いていないということ。**基板が水平に乗っていることを組んだ時点で見る**
