n416/katanori/docs/manual/_manual_img_v61/frontsub.png

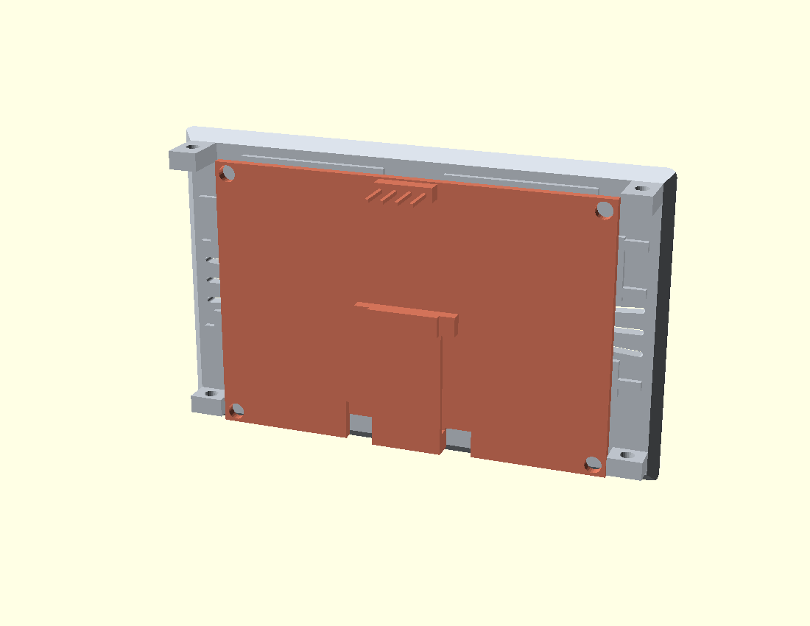
docs/manual/_manual_img_v61/frontsub.png
