n416/katanori/docs/manual/_manual_img_v61/g_press.png

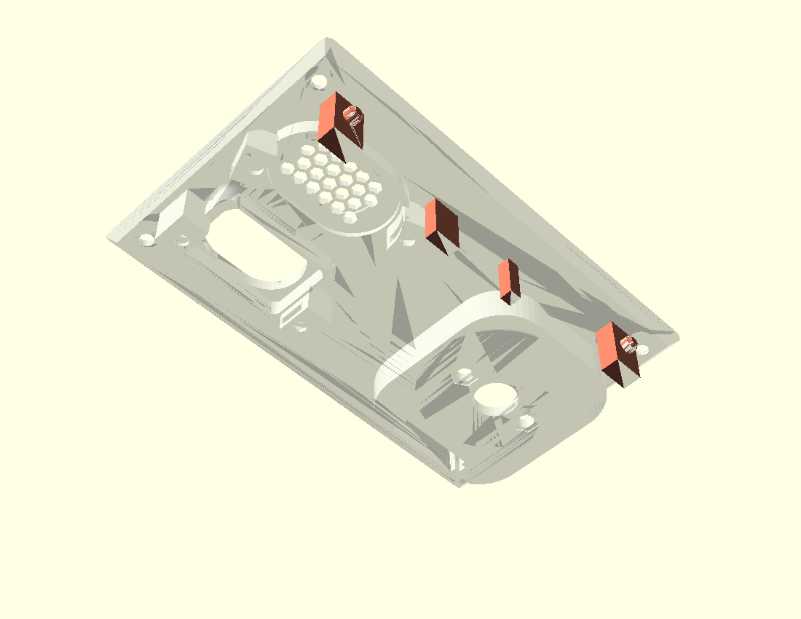
docs/manual/_manual_img_v61/g_press.png
