n416/katanori/docs/manual/_manual_img_v61/g_riser.png

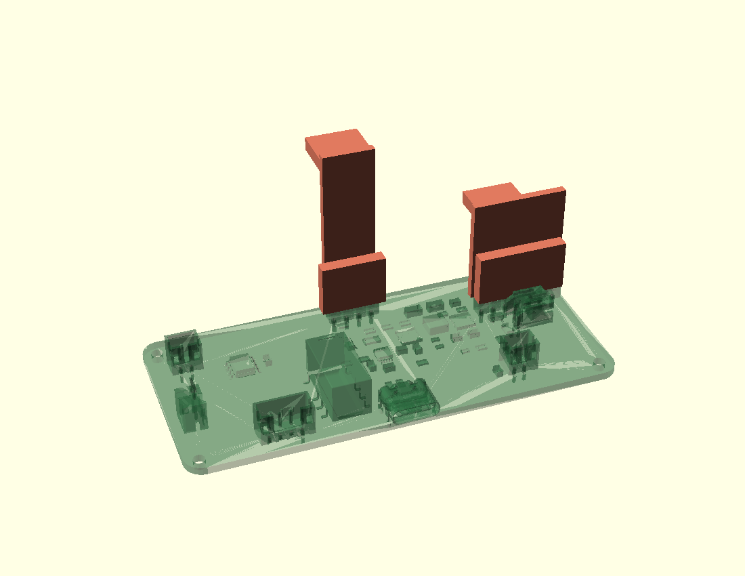
docs/manual/_manual_img_v61/g_riser.png
