n416/katanori/docs/manual/_manual_img_v61/r1.png

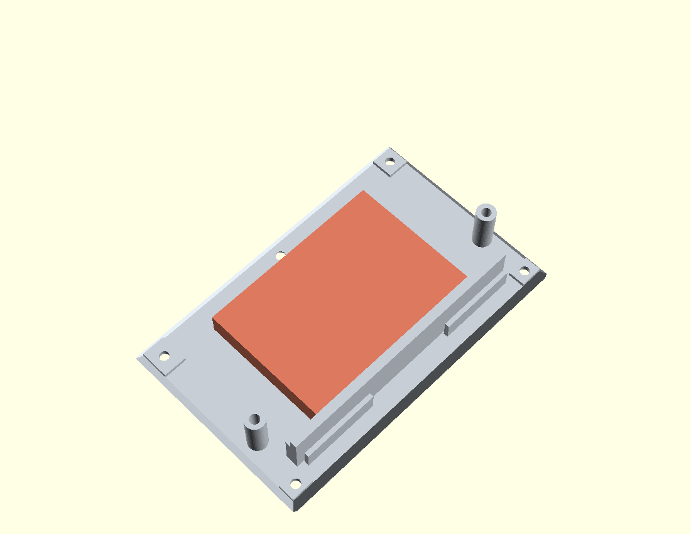
docs/manual/_manual_img_v61/r1.png
