n416/katanori/docs/manual/_manual_img_v61/r4.png

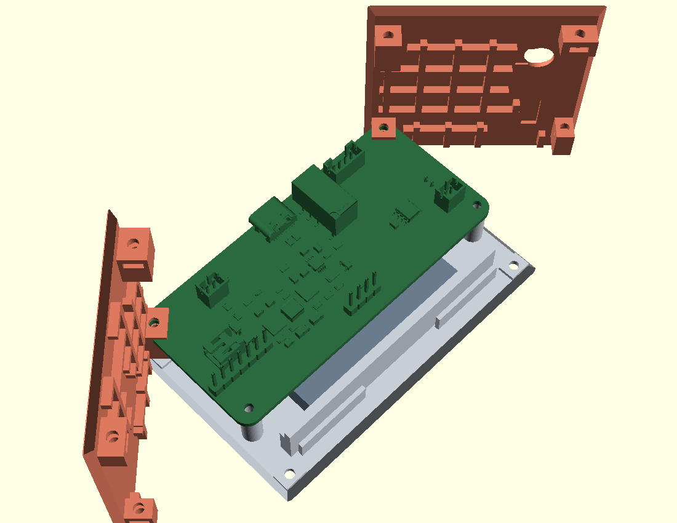
docs/manual/_manual_img_v61/r4.png
