n416/katanori/docs/manual/_manual_img_v61/r9.png

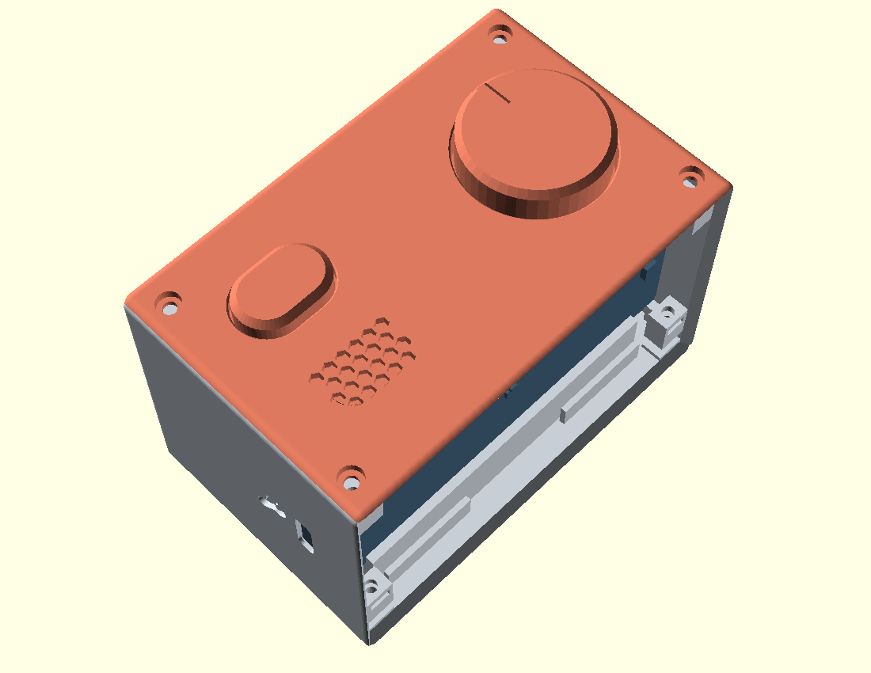
docs/manual/_manual_img_v61/r9.png
