n416/katanori/docs/manual/_manual_img_v61/r10.png

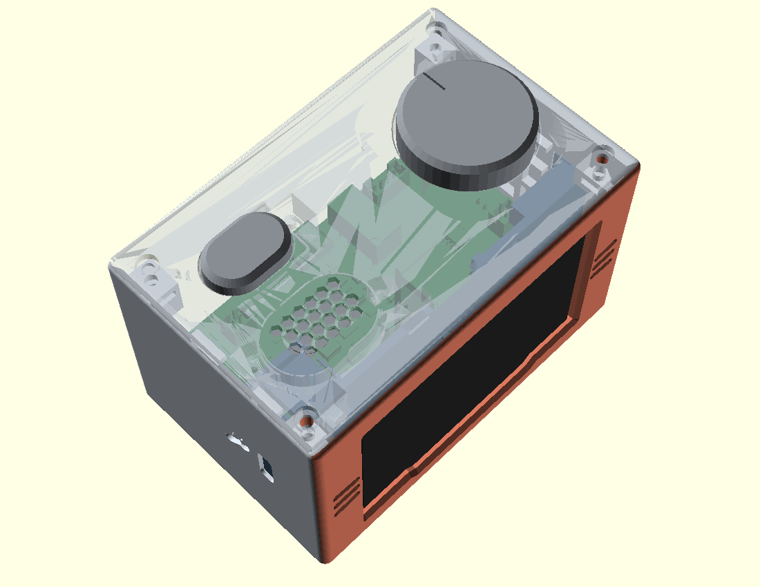
docs/manual/_manual_img_v61/r10.png
