n416/katanori/docs/manual/_manual_img_v61/rtop.png

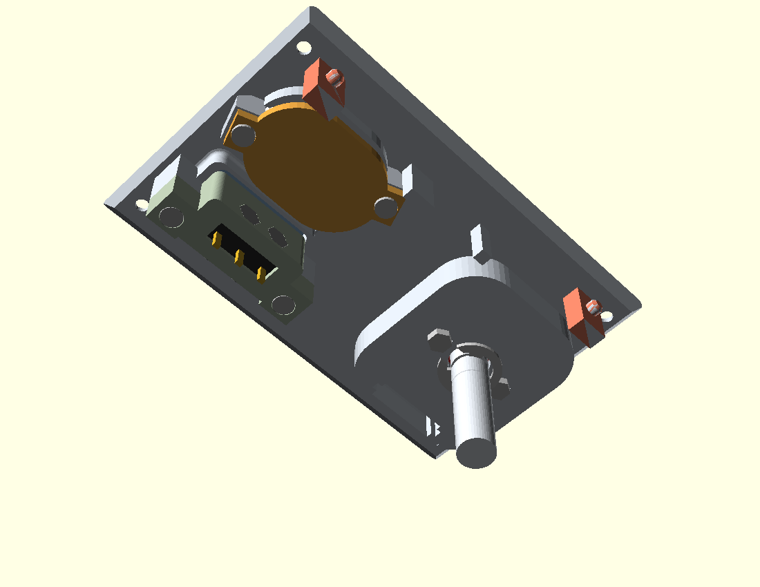
docs/manual/_manual_img_v61/rtop.png
