n416/katanori/docs/manual/_manual_img_v61/wires.png

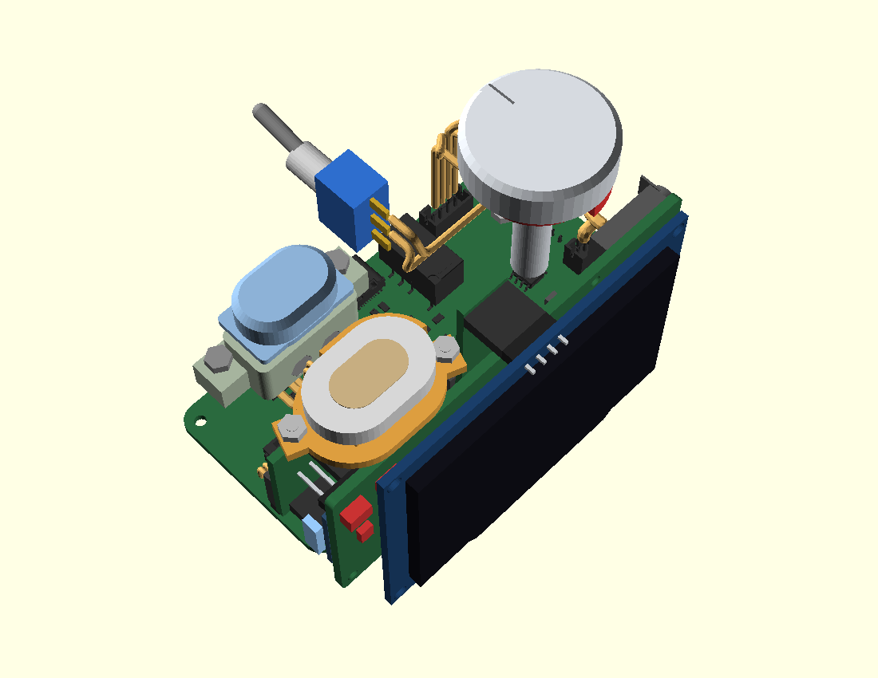
docs/manual/_manual_img_v61/wires.png
