n416/katanori/docs/manual/_manual_img_v61n/g_seat.png

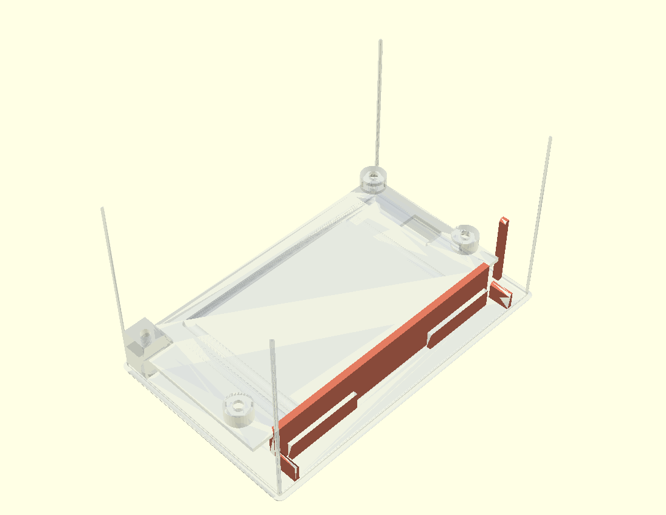
docs/manual/_manual_img_v61n/g_seat.png
