n416/katanori/docs/manual/_manual_img_v61n/n2.png

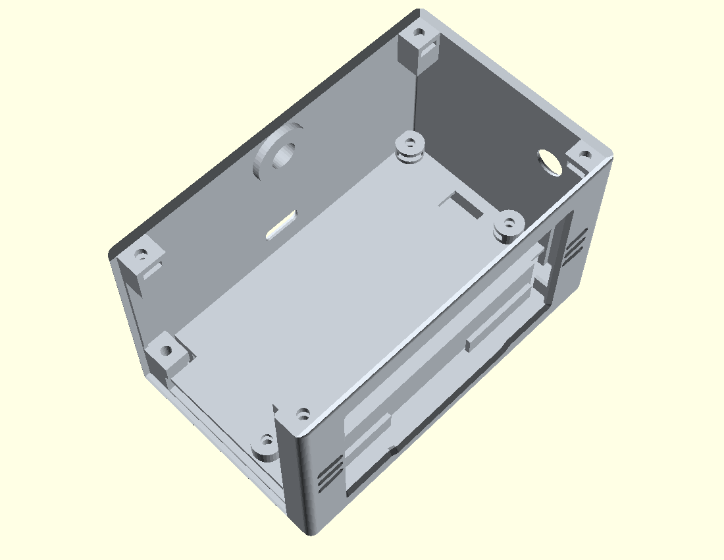
docs/manual/_manual_img_v61n/n2.png
