n416/katanori/docs/manual/_manual_img_v61n/n3.png

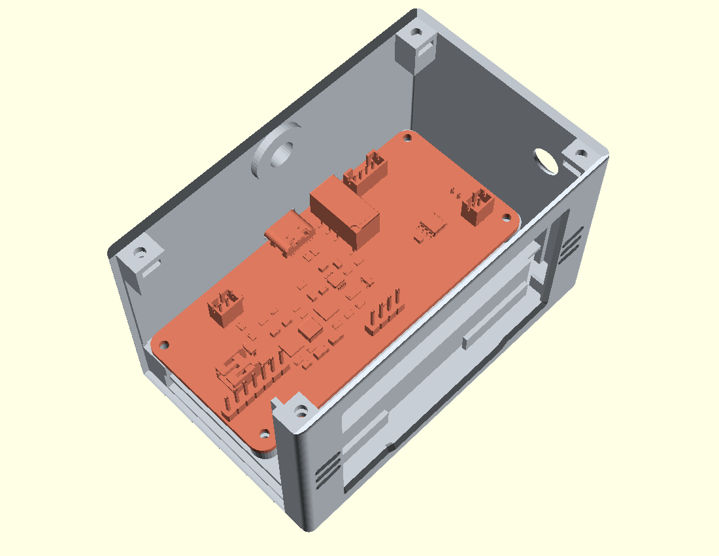
docs/manual/_manual_img_v61n/n3.png
