n416/katanori/docs/manual/_manual_img_v61n/nlid_in.png

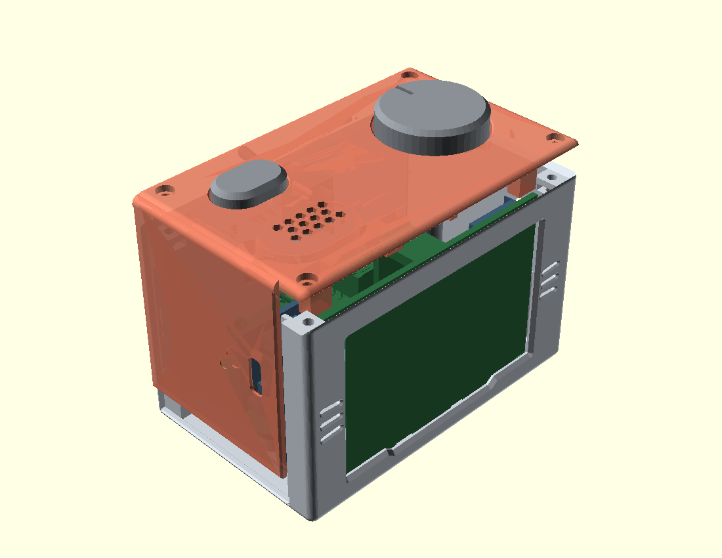
docs/manual/_manual_img_v61n/nlid_in.png
