n416/katanori/docs/manual/_manual_img_v61n/ntop.png

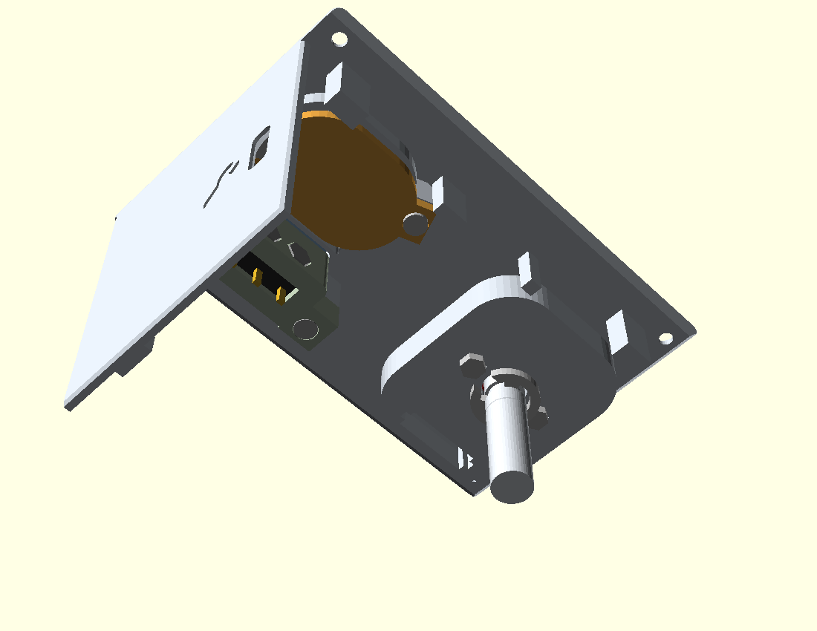
docs/manual/_manual_img_v61n/ntop.png
