n416/katanori/docs/manual/_manual_img_v61n/oledsub.png

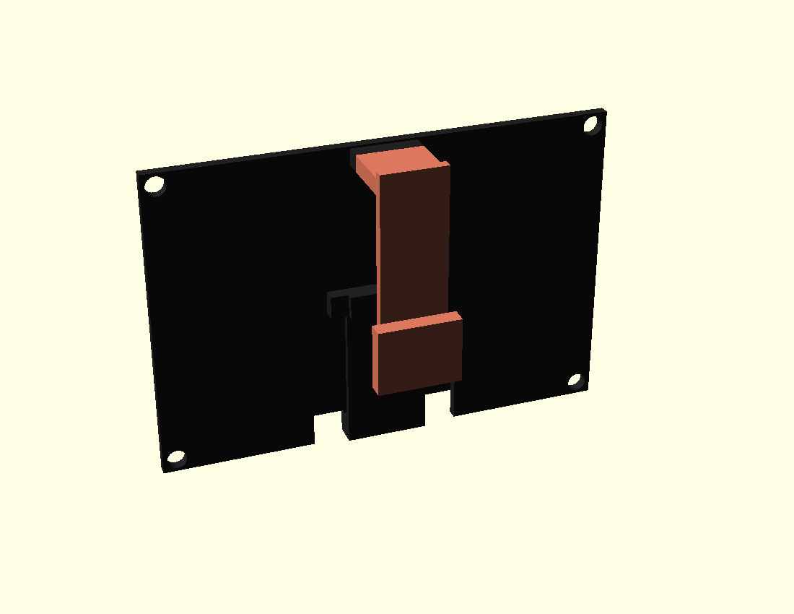
docs/manual/_manual_img_v61n/oledsub.png
