n416/katanori/hardware/frozen/v1-v4/_assemble_chk.png

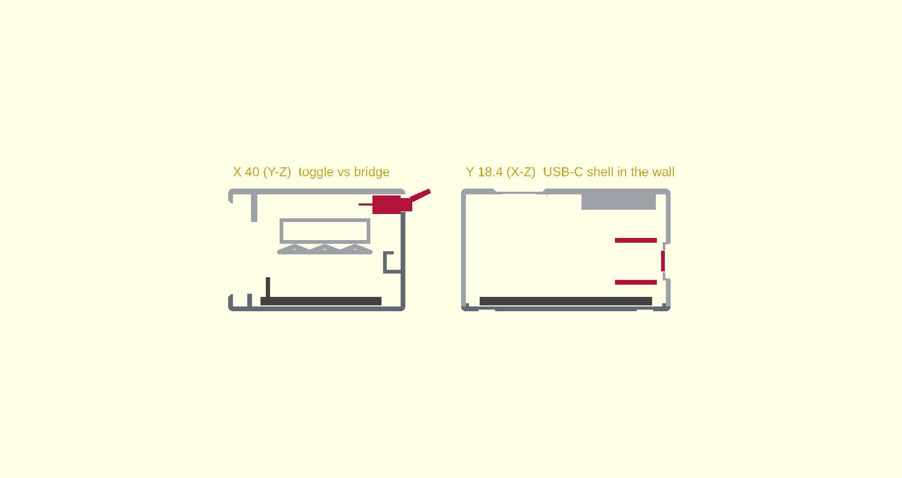
hardware/frozen/v1-v4/_assemble_chk.png
