n416/katanori/docs/TODO.md

# 残っている作業

ここには**残っている作業だけ**を書く。1 行に「項目・誰・何待ち・リンク」だけ。説明と経緯は各文書と git の履歴が持つ。
済んだ行は消す（済んだものは [README](../README.md) の「済んだもの」）。**「何待ち」が「無し」の行が、いま着手できるもの。**
全体の構成は [ARCHITECTURE.md](ARCHITECTURE.md)。

| 章 | いつ | 中身 |
|---|---|---|
| **A** | 🔒 **現フェーズ** | 最小単位で動かす。1 台が電源から会話・安全機構まで通ること |
| **B** | 次 | 人に渡す（第 1 世代の完成）。筐体・サービス・実使用者テスト |
| **C** | フェーズ 2 | 遠隔モジュール（Stackchan）を BLE で足す |

| 記号 | 意味 |
|---|---|
| 🔴 | これが無いと人に渡せない |
| 🟡 | 渡せるが、実用で困る |
| ⚪ | あとで良い |

---

# A. 現フェーズ — 最小単位で動かす

| | 項目 | 誰 | 何待ち |
|---|---|---|---|
| 🔴 | ハブ基板 v6.1（`hardware/pcb/katanori61/`）を JLCPCB へ。出す前に `python hardware/pcb/check_fab.py` で在庫と価格を取り直す（[PCB-V61.md](PCB-V61.md) 5・8 章） | ユーザー | 来月（ユーザー判断） |
| 🔴 | 筐体 v6.1n の MJF 7 点（`hardware/stl/v61n/`）を JLC3DP へ（[CASE-V61N.md](CASE-V61N.md) 5 章） | ユーザー | 基板と一緒に |
| 🔴 | ハブ基板 v6.1 のはんだ付け（[PCB-V61.md](PCB-V61.md)） | ユーザー | 基板の到着 |
| 🟡 | ピーク電流の実測（スピーカーが鳴った瞬間・[POWER.md](POWER.md)） | ユーザー | 無し |
| 🟡 | 音量の上限（天井 `KATANORI_KNOB_MAX_GAIN` 0.70）を耳で決める | ユーザー | 無し |

⚠ `D1`(GPIO2) は XMOS のリセット線なので使わない（`pinMode` 禁止）。
⚠ 監視中: XMOS が起動時に 1 回だけ落ちた（2026-08-05）。再発したら着手。

---

# B. 次 — 人に渡す（第 1 世代の完成）

A 章が通ってから着手する。筐体（B-1）だけは先に動いていて、いまは発注待ち（A 章）。

## B-1. 筐体・装着 — [CASE-V61N.md](CASE-V61N.md)

| | 項目 | 誰 | 何待ち |
|---|---|---|---|
| 🔴 | 肩への固定方法 | ユーザー | 筐体の形 |
| 🔴 | 重量とバランス | ユーザー | 筐体の形 |
| 🟡 | スピーカーのキャビティ | 両方 | 筐体の形 |
| 🟡 | アンテナの取り回し | ユーザー | 筐体の形 |
| 🟡 | 配線の固定 | ユーザー | 筐体の形 |
| ⚪ | 発熱 | ユーザー | 筐体 |
| ⚪ | 防滴・清掃 | ユーザー | 筐体の形 |
| ⬜ | 中を開けたときの見栄え | 両方 | 無し |
| ⬜ | `case_v6_1n.scad` の 136・737 行に残る v5 の注と `TC_*` の定数を片付ける（`LDG_L_Y` が `TC4_Y0` を読んでいる） | AI | 無し |

## B-2. バックエンド・サービス — [../仕様書.md](../仕様書.md)

| | 項目 | 誰 | 何待ち |
|---|---|---|---|
| 🔴 | 認証 | AI | 無し（B-2 はこれが先） |
| 🔴 | 費用の上限 | AI | 無し |
| 🔴 | 個体管理（QR ペアリング） | AI | 認証 |
| 🟡 | yorisoi-care-app との統合 | 両方 | 認証 |
| 🟡 | プッシュ（お薬の時間など） | AI | 認証 |
| 🟡 | 会話ログ・記憶の保存 | AI | 認証 |
| ⚪ | 障害時の挙動 | AI | 無し |

## B-3. 製品・運用

| | 項目 | 誰 | 何待ち |
|---|---|---|---|
| 🔴 | 実使用者でのテスト | ユーザー | 筐体 |
| 🟡 | プライバシーの説明と同意 | ユーザー | 無し |
| 🟡 | 安全性の線引き | ユーザー | 無し |
| 🟡 | 電波法（技適） | ユーザー | 無し |
| ⚪ | コストと量産 | ユーザー | 無し |
| ⚪ | ⏸ 🔒 自前の音声の板（保留・ユーザー 2026-09-15）。再開の手順は [VOICE-BOARD.md](VOICE-BOARD.md) 0 章 | ユーザー | 量産の計画 |

---

# C. フェーズ 2 — 遠隔モジュール（Stackchan）

いま手を付けない（[ARCHITECTURE.md](ARCHITECTURE.md)）。

| | 項目 | 誰 | 何待ち |
|---|---|---|---|
| 🔴 | Stackchan をどの M5Stack で作るか（カメラの有無で決まる） | 両方 | A 章・B 章 |
| 🔴 | 2 台のあいだの BLE プロトコル（画像は送らない） | AI | 上 |
| ⬜ | 会話をどちらが持つか | 両方 | 要確認 |
| ⬜ | ミュートリレーの駆動をどちらが持つか | 両方 | 上 |
| ⚪ | カメラの置き場所を写真で確認（[WAKEUP.md](WAKEUP.md)） | ユーザー | 無し |
