n416/katanori/docs/history/img/v61n_look.png

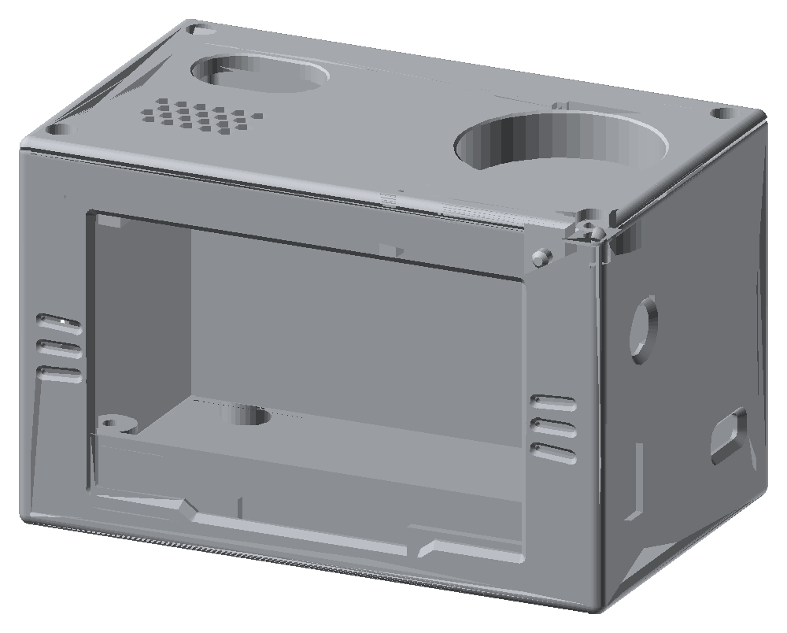
docs/history/img/v61n_look.png
