n416/katanori/docs/history/img/v61n_tray.png

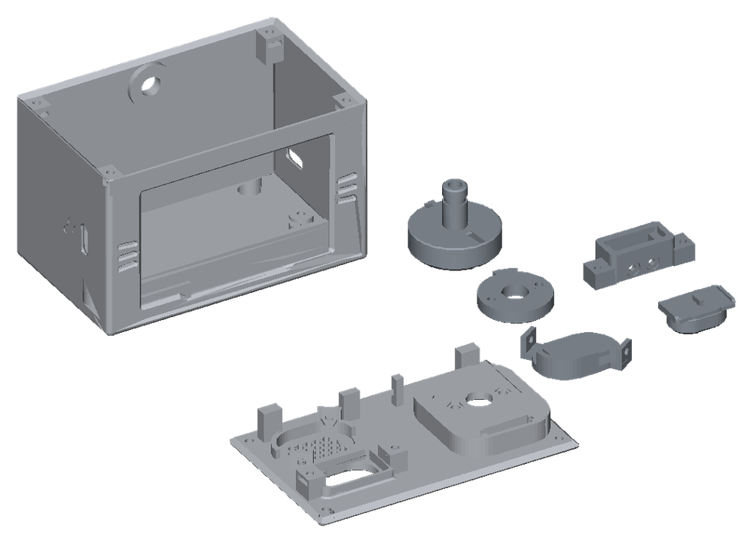
docs/history/img/v61n_tray.png
