n416/katanori/hardware/frozen/v1-v4/_boss_fix_l.png

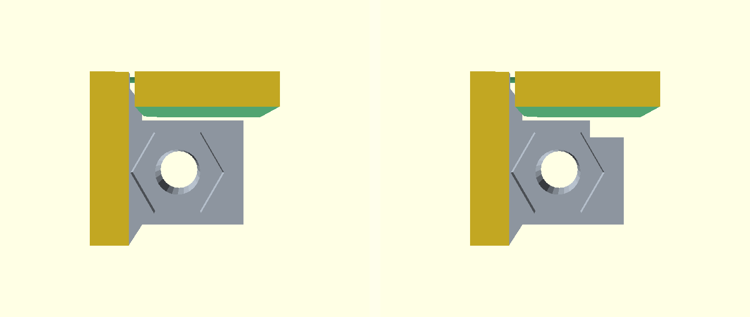
hardware/frozen/v1-v4/_boss_fix_l.png
