n416/katanori/hardware/pcb/katanori61_audio/katanori61_audio.pdf

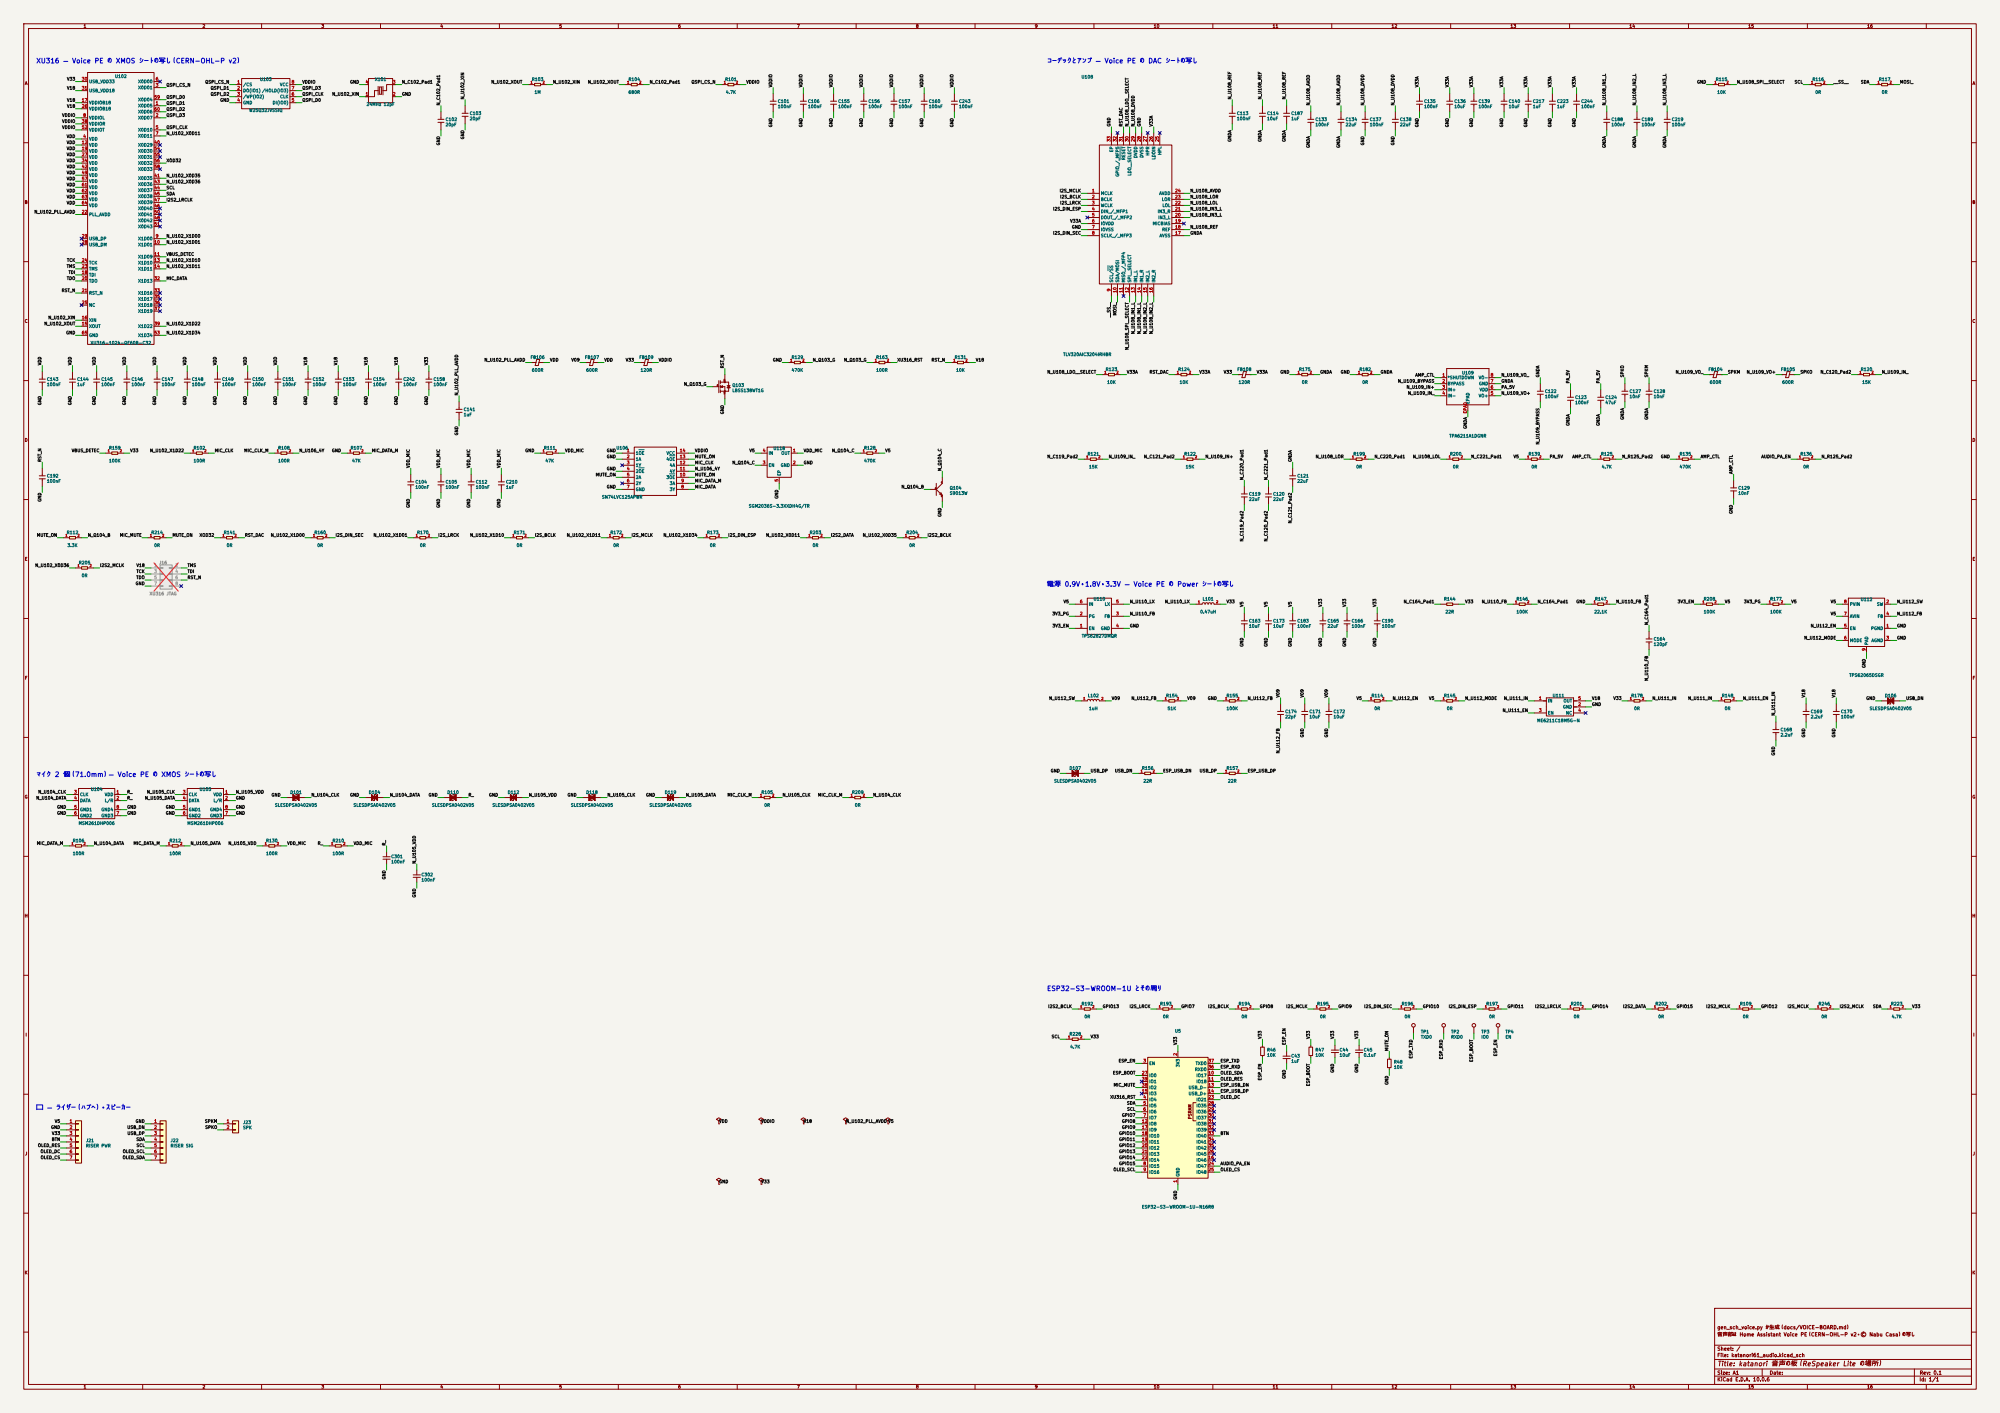
[picture p331: page 1]

24 HPL 25 LDOIN 26 HPR 27 DVSS 28 DVDD 29 LDO__SELECT 30 RESET 31 GPIO_/_MFP5 32 EP 33 U108

電源 0.9V・1.8V・3.3V — Voice PE の Power シートの写し

マイク 2 個（71.0mm）— Voice PE の XMOS シートの写し

gen_sch_voice.py が生成（docs/VOICE-BOARD.md）
音声部は Home Assistant Voice PE（CERN-OHL-P v2・© Nabu Casa）の写し

Sheet: /
File: katanori61_audio.kicad_sch
Title: katanori 音声の板（ReSpeaker Lite の場所）

Size: A1 | Rev: 0.1
KiCad E.D.A. 10.0.6 | Id: 1/1
