n416/katanori/hardware/pcb/katanori61_hub/katanori61_hub.pdf

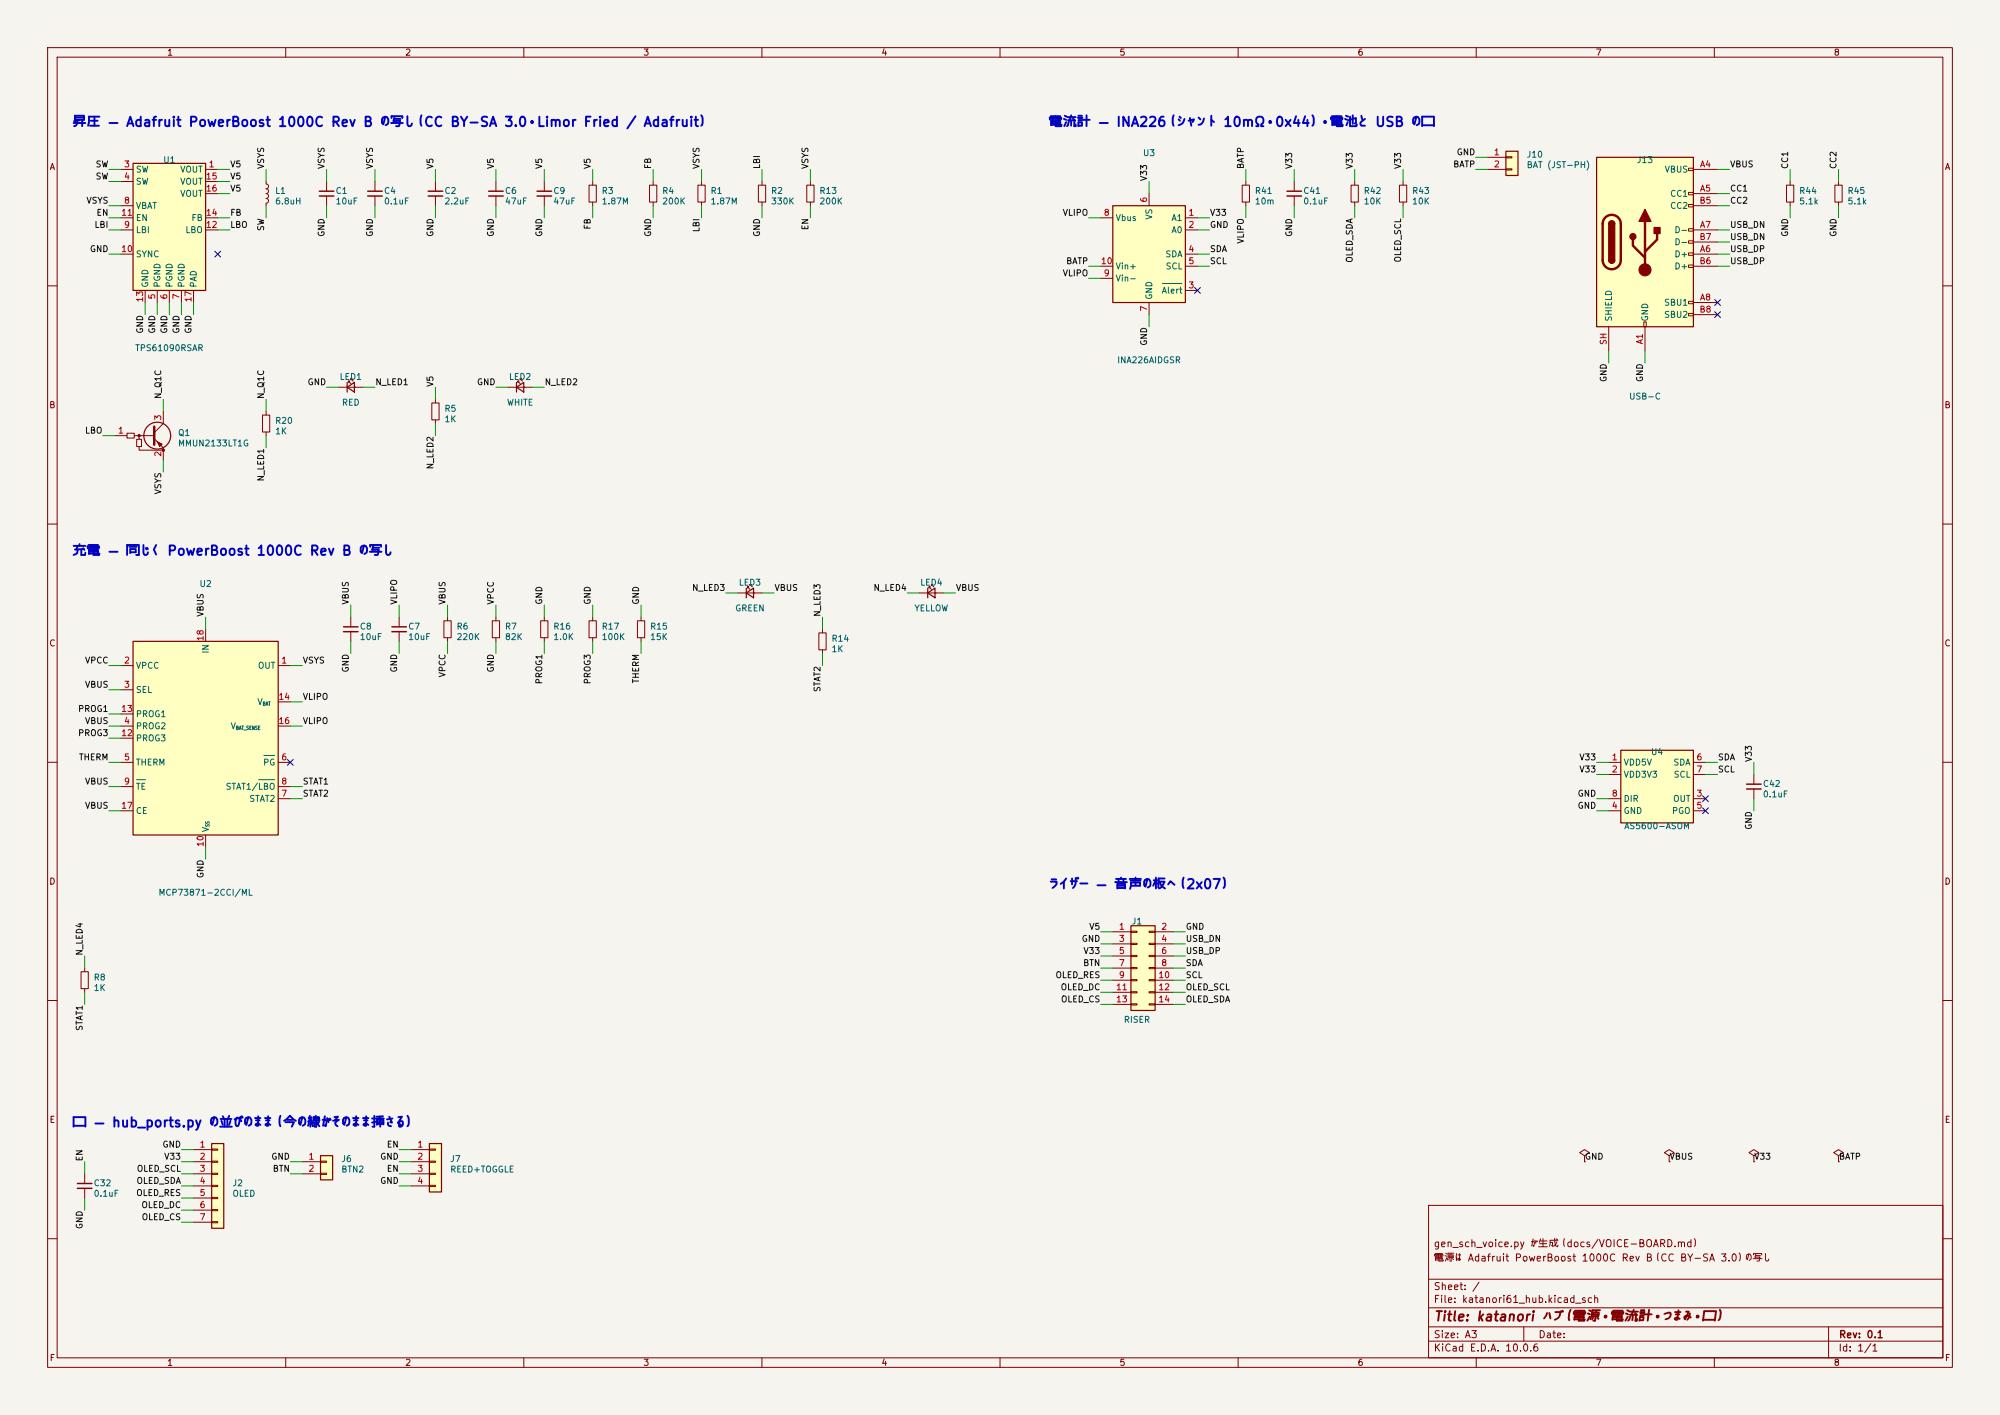
[picture p332: page 1]

昇圧 — Adafruit PowerBoost 1000C Rev B の写し（CC BY-SA 3.0・Limor Fried / Adafruit）
VOUT 16 PAD 17 U1

電流計 — INA226（シャント 10mΩ・0x44）・電池と USB の口

OLED_DC OLED_CS 充電 — 同じく PowerBoost 1000C Rev B の写し

gen_sch_voice.py が生成（docs/VOICE-BOARD.md）
電源は Adafruit PowerBoost 1000C Rev B（CC BY-SA 3.0）の写し

Sheet: /
File: katanori61_hub.kicad_sch
Title: katanori ハブ（電源・電流計・つまみ・口）

Size: A3 | Rev: 0.1 | F Date:
KiCad E.D.A. 10.0.6 | Id: 1/1
