n416/katanori/hardware/pcb/katanori61/katanori61.pdf

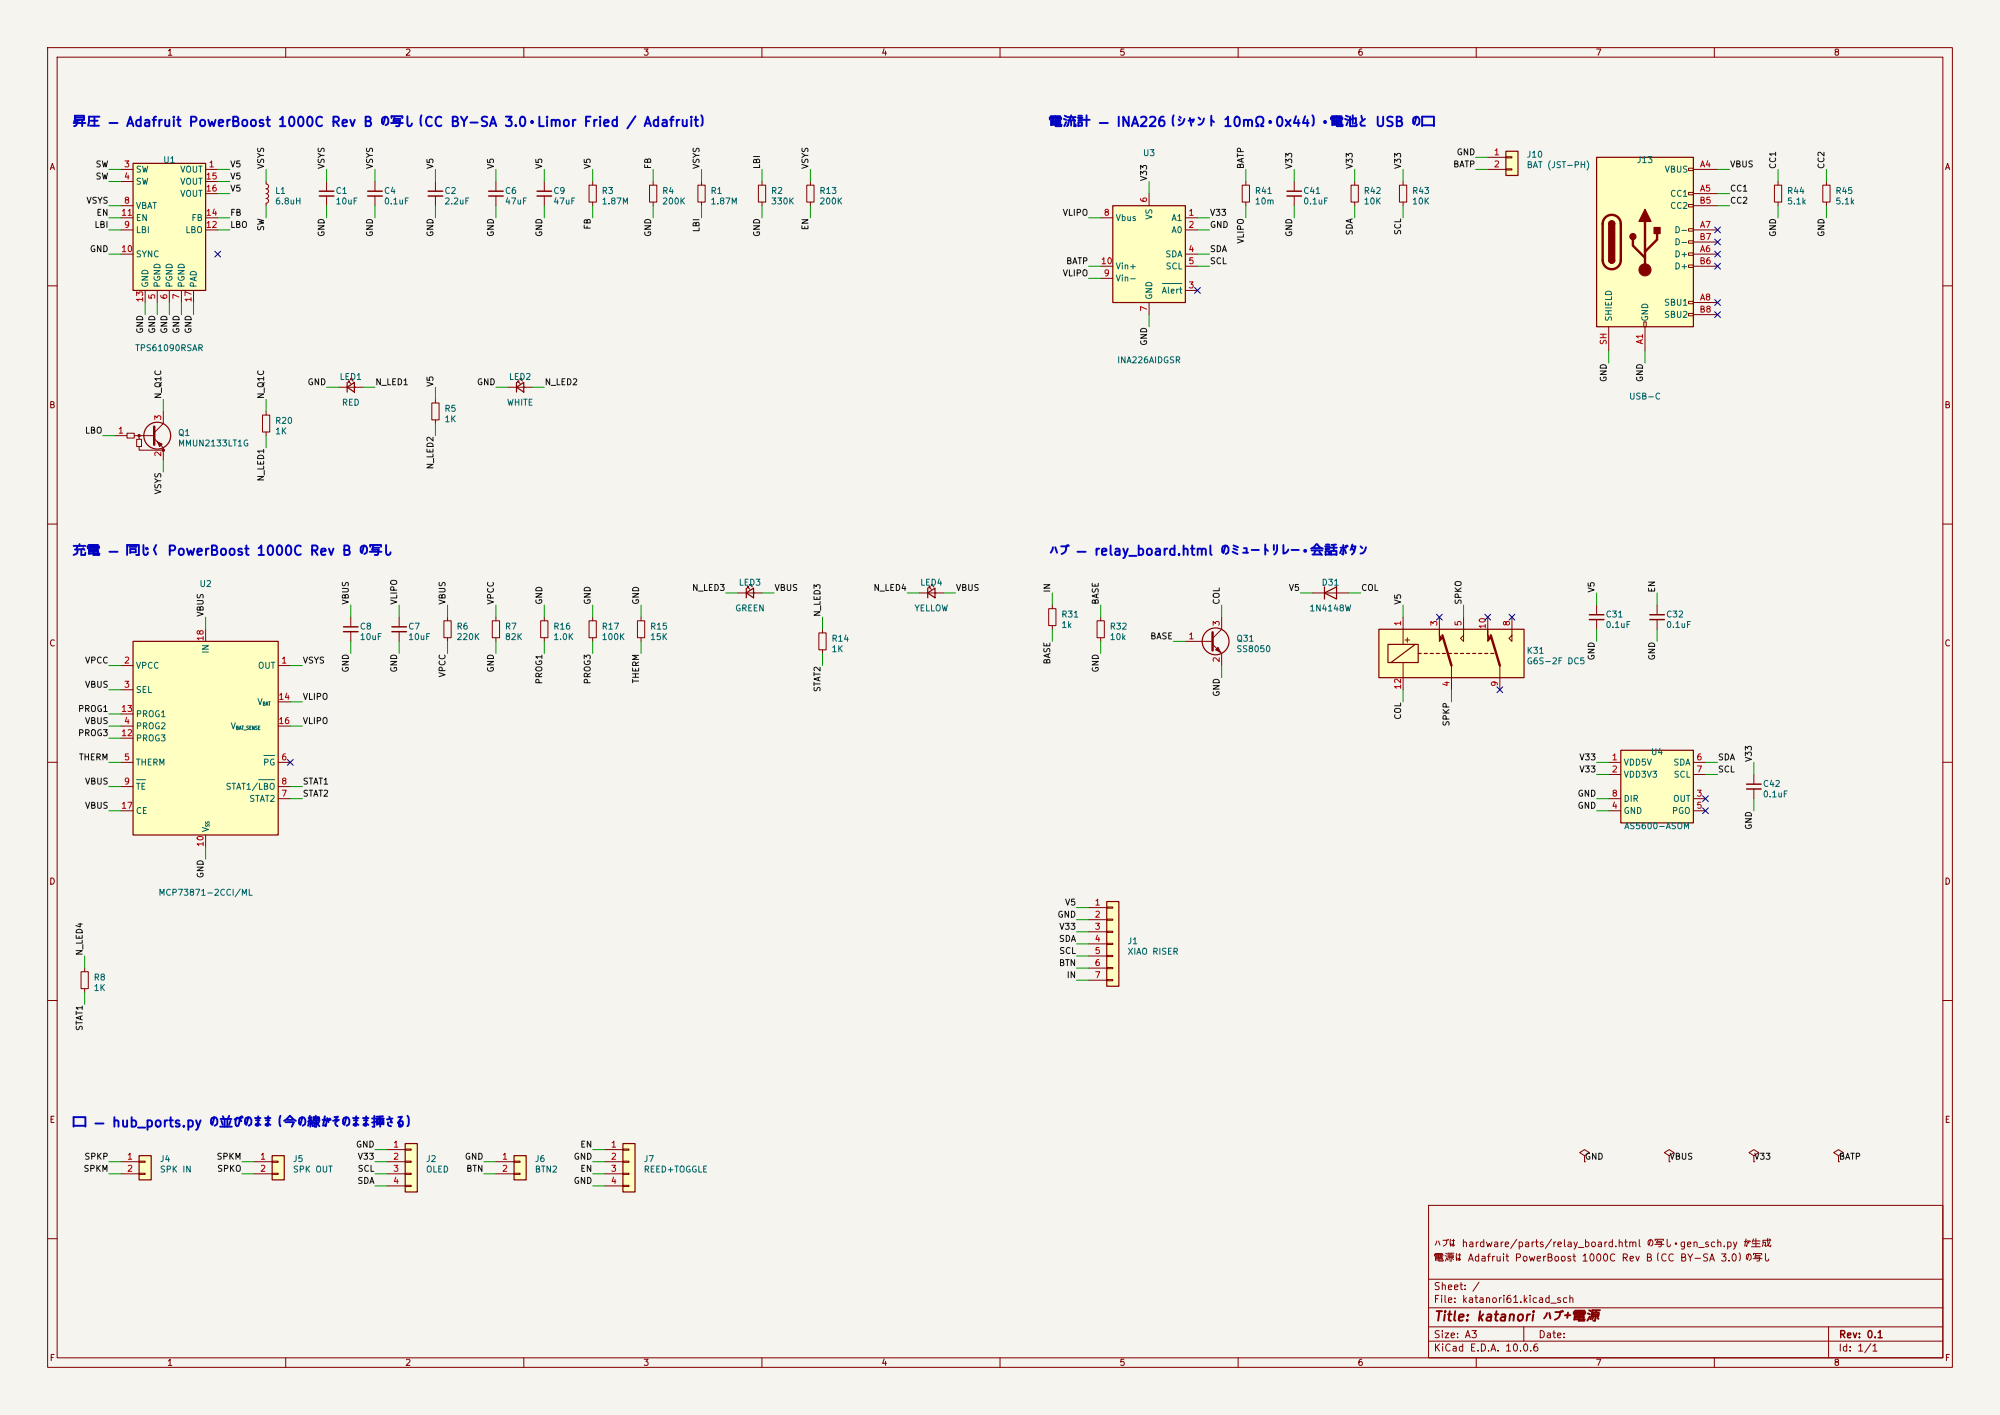
[picture p333: page 1]

充電 — 同じく PowerBoost 1000C Rev B の写し

ハブ — relay_board.html のミュートリレー・会話ボタン

ハブは hardware/parts/relay_board.html の写し・gen_sch.py が生成
電源は Adafruit PowerBoost 1000C Rev B（CC BY-SA 3.0）の写し

Sheet: /
File: katanori61.kicad_sch
Title: katanori ハブ＋電源

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
