n416/katanori/hardware/frozen/v6/pcb/hub_power/pcb_back.pdf

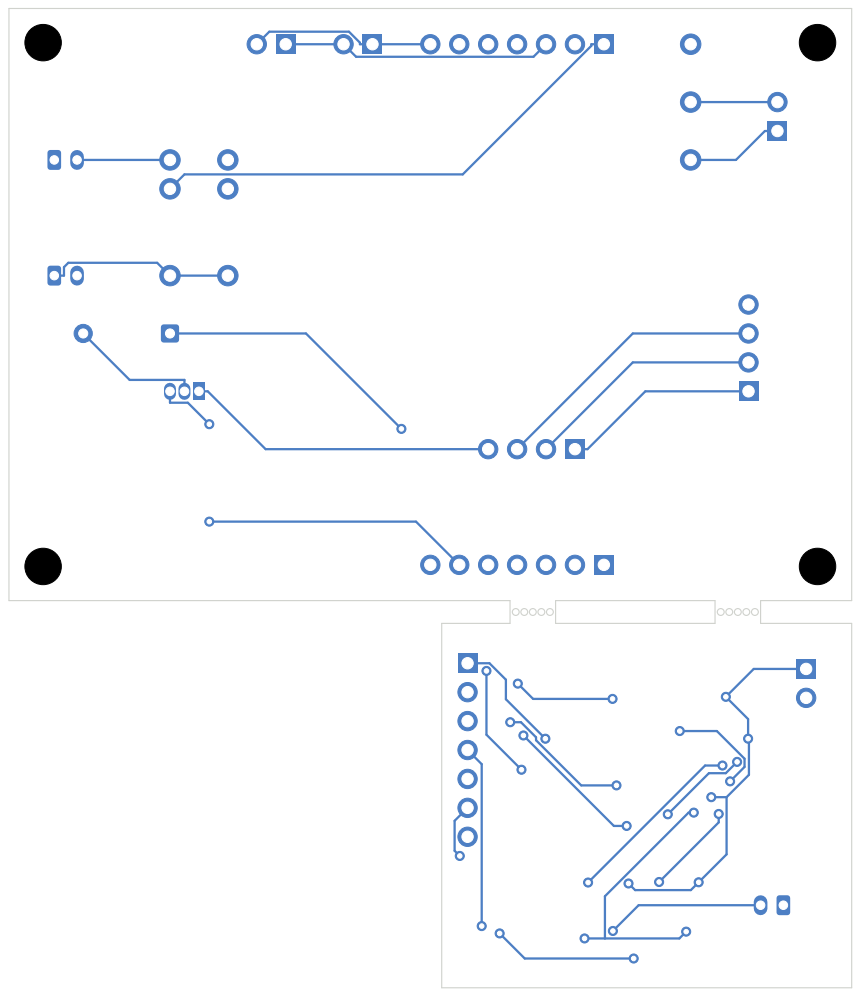
[picture p334: page 1]
