n416/katanori/hardware/frozen/v6/pcb/hub_power/pcb_front.pdf

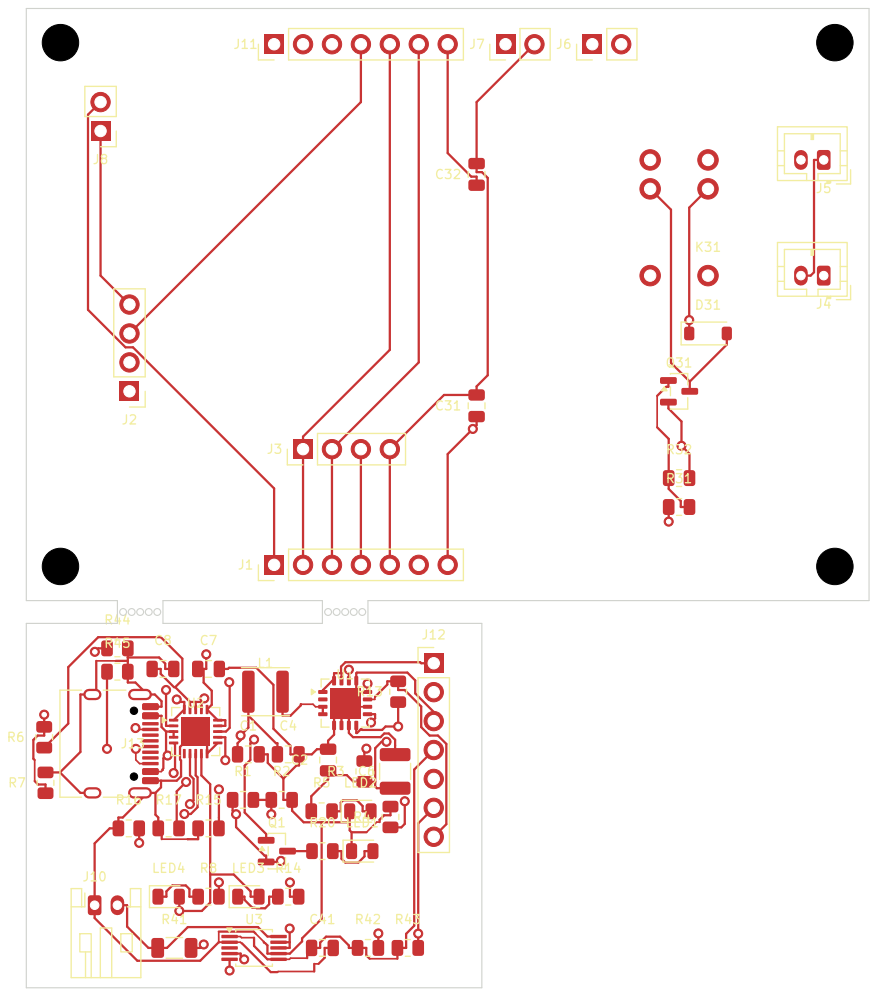
[picture p335: page 1]
