n416/katanori/hardware/frozen/v6/pcb/hub_power/pcb_top.pdf

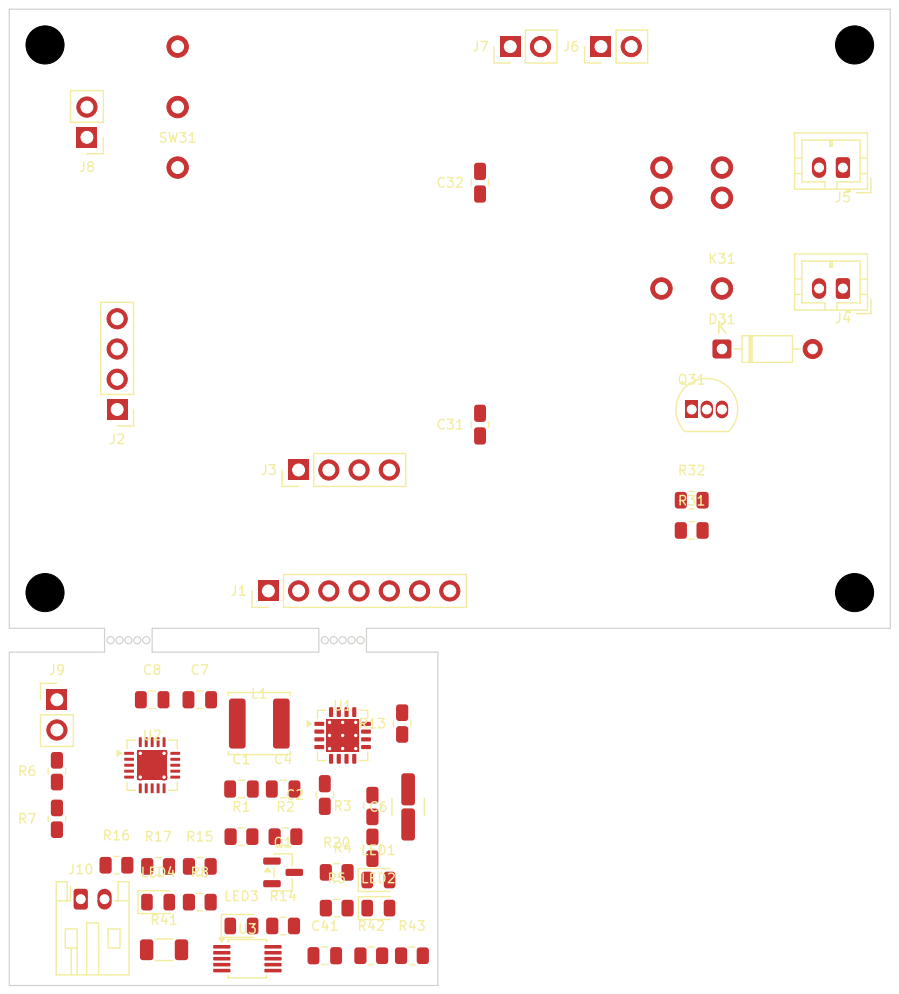
[picture p336: page 1]
