n416/katanori/(list of files, drawings)

Other design files:
hardware/frozen/v6/pcb/hub_power/hub_power.dsn
hardware/pcb/katanori61/katanori61.dsn
hardware/pcb/katanori61_audio/katanori61_audio.dsn
