n416/katanori/hardware/pcb/katanori61/katanori61.kicad_pcb

## KiCad design hardware/pcb/katanori61/katanori61.kicad_pcb (2026-09-20)

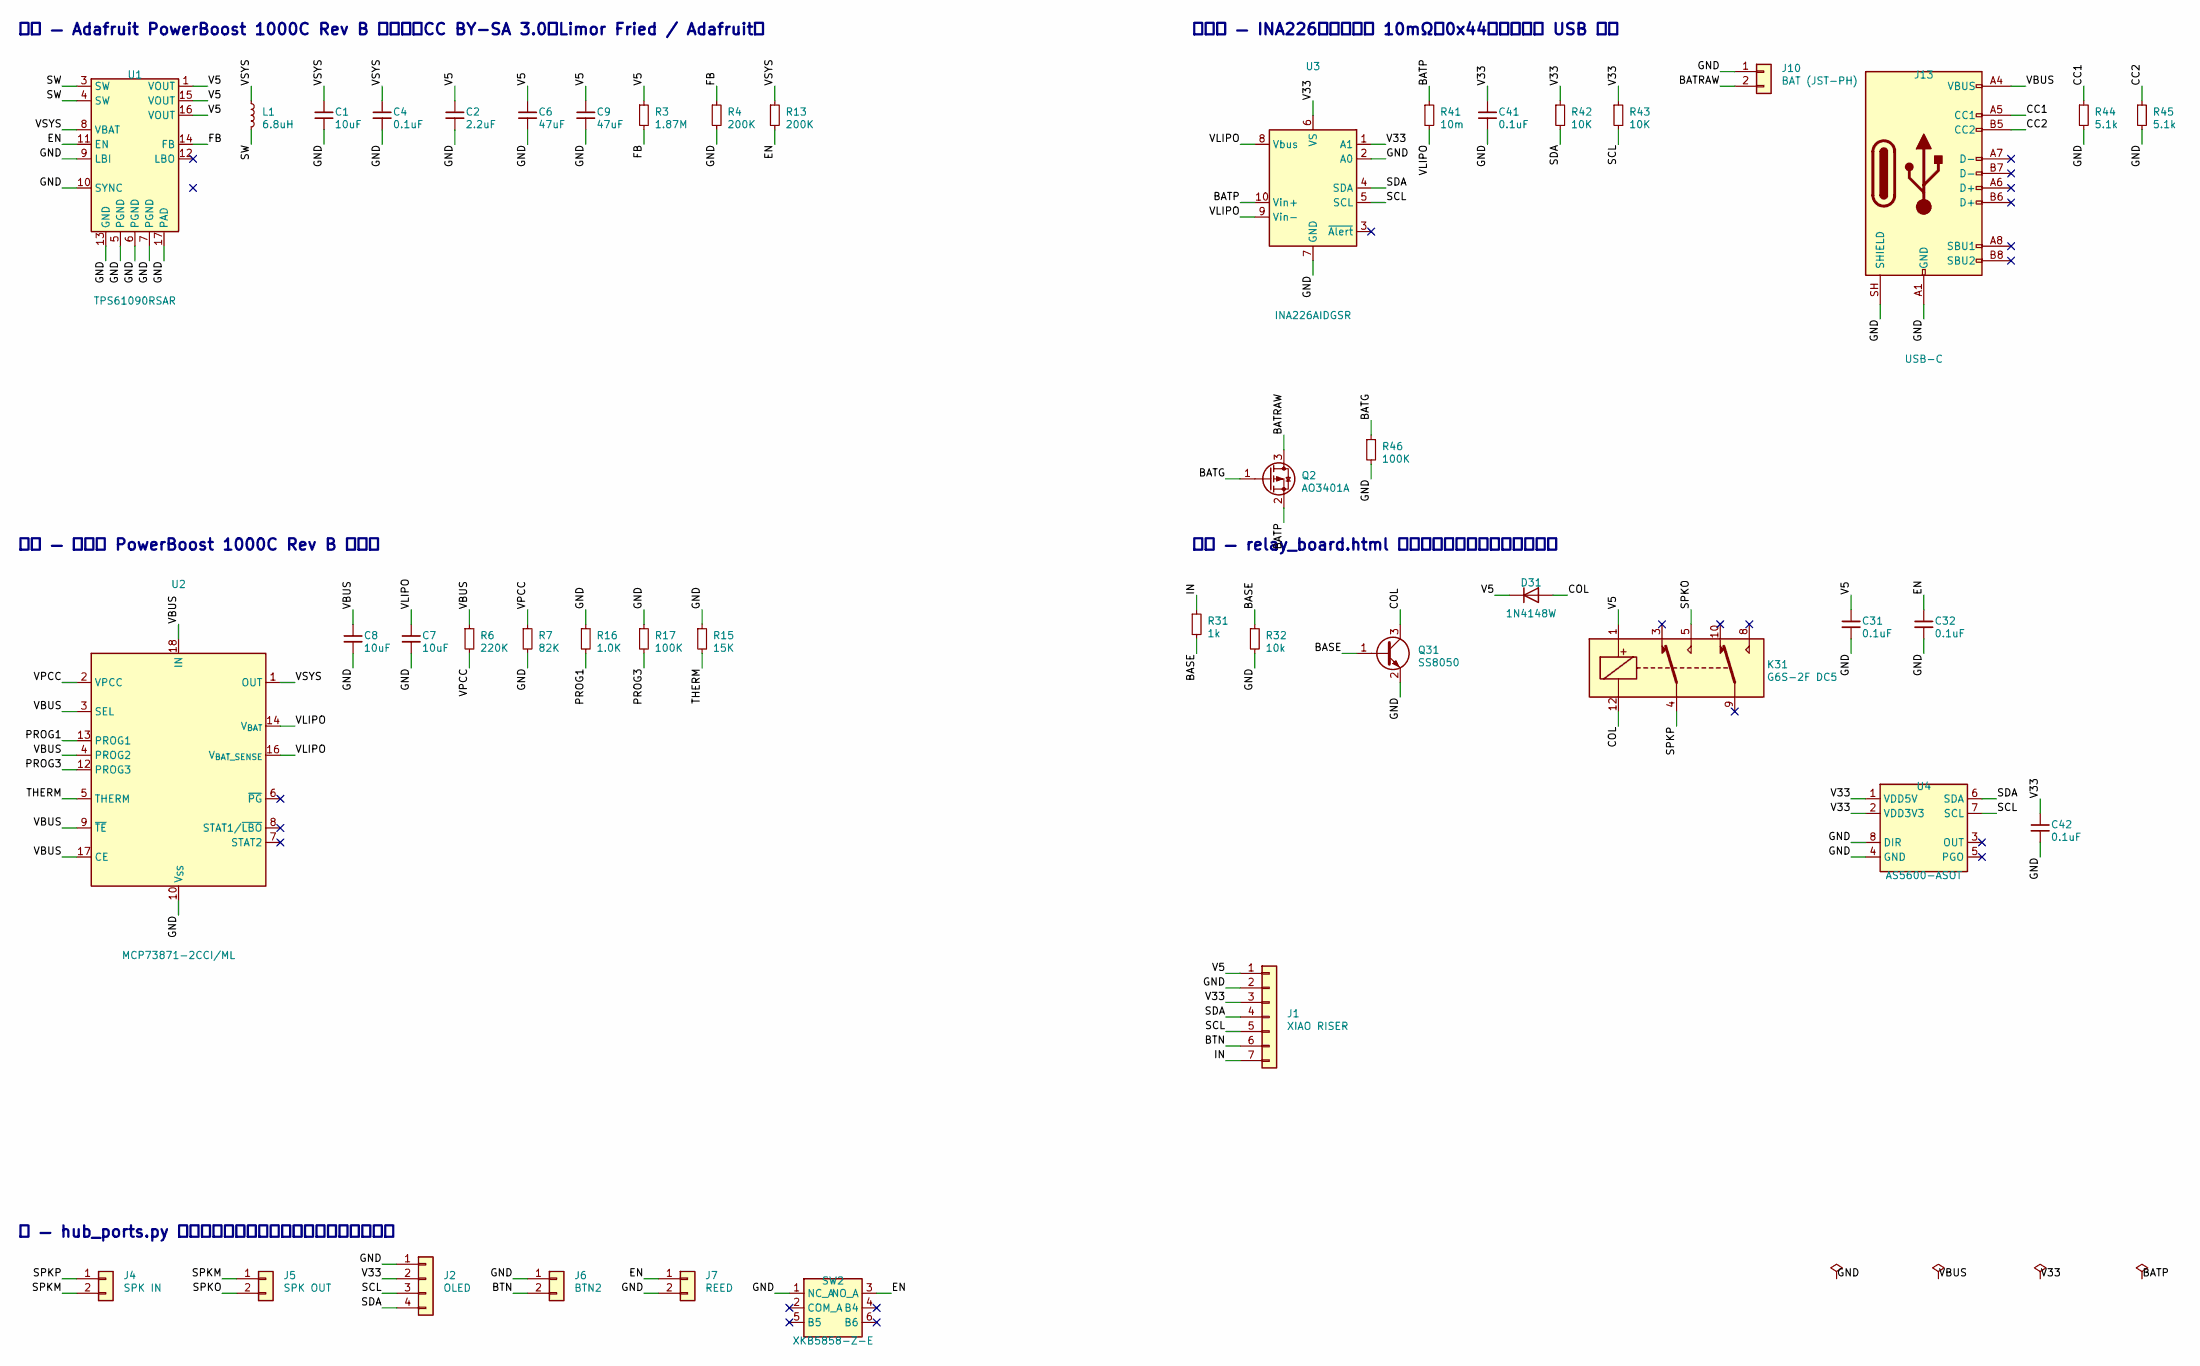
[picture p337: schematic katanori61.kicad_sch, katanori ハブ＋電源]

Parts:
C1, C7, C8: 10uF; C_0805_2012Metric; LCSC C15850
C2: 2.2uF; C_0805_2012Metric; LCSC C377773
C4, C31, C32, C41, C42: 0.1uF; C_0805_2012Metric; LCSC C49678
C6, C9: 47uF; C_1206_3216Metric; LCSC C96123
D31: 1N4148W; D_SOD-123; LCSC C81598
J1: XIAO RISER; PinHeader_1x07_P2.54mm_Vertical
J2: OLED; PinHeader_1x04_P2.54mm_Vertical
J4: SPK IN; JST_PH_B2B-PH-K_1x02_P2.00mm_Vertical
J5: SPK OUT; JST_PH_S2B-PH-K_1x02_P2.00mm_Horizontal
J6: BTN2; JST_PH_B2B-PH-K_1x02_P2.00mm_Vertical
J7: REED; JST_PH_B2B-PH-K_1x02_P2.00mm_Vertical
J10: BAT (JST-PH); JST_PH_B2B-PH-K_1x02_P2.00mm_Vertical
J13: USB-C; USB_C_Receptacle_HRO_TYPE-C-31-M-12; LCSC C165948
K31: G6S-2F DC5; Relay_DPDT_Omron_G6S-2F; LCSC C16707
L1: 6.8uH; L_Changjiang_FNR4018S; LCSC C167807
Q2: AO3401A; SOT-23; LCSC C15127
Q31: SS8050; SOT-23; LCSC C2150
R3: 1.87M; R_0805_2012Metric; LCSC C482988
R4, R13: 200K; R_0805_2012Metric; LCSC C17539
R6: 220K; R_0603_1608Metric; LCSC C22961
R7: 82K; R_0603_1608Metric; LCSC C23254
R15: 15K; R_0805_2012Metric; LCSC C17475
R16: 1.0K; R_0805_2012Metric; LCSC C17513
R17, R46: 100K; R_0805_2012Metric; LCSC C149504
R31: 1k; R_0805_2012Metric; LCSC C17513
R32: 10k; R_0805_2012Metric; LCSC C17414
R41: 10m; R_1206_3216Metric; LCSC C105362
R42, R43: 10K; R_0805_2012Metric; LCSC C17414
R44, R45: 5.1k; R_0805_2012Metric; LCSC C27834
SW2: XKB5858-Z-E; SW_XKB5858-Z-E; LCSC C780038
U1: TPS61090RSAR; Texas_RSA_VQFN-16-1EP_4x4mm_P0.65mm_EP2.7x2.7mm; LCSC C206167
U2: MCP73871-2CCI/ML; QFN-20-1EP_4x4mm_P0.5mm_EP2.5x2.5mm; LCSC C511310
U3: INA226AIDGSR; TSSOP-10_3x3mm_P0.5mm; LCSC C49851
U4: AS5600-ASOT; SOIC-8_3.9x4.9mm_P1.27mm; LCSC C499458

Connections:
BASE: Q31.1 (B), R31.2, R32.1
BATG: Q2.1 (G), R46.1
BATP: Q2.2 (S), R41.1, U3.10 (Vin+)
BATRAW: J10.2, Q2.3 (D)
BTN: J1.6, J6.2
CC1: J13.A5 (CC1), R44.1
CC2: J13.B5 (CC2), R45.1
COL: D31.2 (A), K31.12, Q31.3 (C)
EN: C32.1, J7.1, R13.2, SW2.3 (NO_A), U1.11 (EN)
FB: R3.2, R4.1, U1.14 (FB)
GND: C1.2, C2.2, C4.2, C6.2, C7.2, C8.2, C9.2, C31.2, C32.2, C41.2, C42.2, J1.2, J2.1, J6.1, J7.2, J10.1, J13.A1 (GND), J13.A12 (GND), J13.B1 (GND), J13.B12 (GND), J13.SH (SHIELD), Q31.2 (E), R4.2, R7.2, R15.1, R16.1, R17.1, R32.2, R44.2, R45.2, R46.2, SW2.1 (NC_A), U1.5 (PGND), U1.6 (PGND), U1.7 (PGND), U1.9 (LBI), U1.10 (SYNC), U1.13 (GND), U1.17 (PAD), U2.10 (V_{SS}), U2.11 (V_{SS}), U2.21 (V_{SS}), U3.2 (A0), U3.7 (GND), U4.4 (GND), U4.8 (DIR)
IN: J1.7, R31.1
PROG1: R16.2, U2.13 (PROG1)
PROG3: R17.2, U2.12 (PROG3)
SCL: J1.5, J2.3, R43.2, U3.5 (SCL), U4.7 (SCL)
SDA: J1.4, J2.4, R42.2, U3.4 (SDA), U4.6 (SDA)
SPKM: J4.2, J5.1
SPKO: J5.2, K31.5
SPKP: J4.1, K31.4
SW: L1.2, U1.3 (SW), U1.4 (SW)
THERM: R15.2, U2.5 (THERM)
V5: C2.1, C6.1, C9.1, C31.1, D31.1 (K), J1.1, K31.1, R3.1, U1.1 (VOUT), U1.15 (VOUT), U1.16 (VOUT)
V33: C41.1, C42.1, J1.3, J2.2, R42.1, R43.1, U3.1 (A1), U3.6 (VS), U4.1 (VDD5V), U4.2 (VDD3V3)
VBUS: C8.1, J13.A4 (VBUS), J13.A9 (VBUS), J13.B4 (VBUS), J13.B9 (VBUS), R6.1, U2.3 (SEL), U2.4 (PROG2), U2.9 (~TE), U2.17 (CE), U2.18 (IN), U2.19 (IN)
VLIPO: C7.1, R41.2, U2.14 (V_{BAT}), U2.15 (V_{BAT}), U2.16 (V_{BAT_SENSE}), U3.8 (Vbus), U3.9 (Vin-)
VPCC: R6.2, R7.1, U2.2 (VPCC)
VSYS: C1.1, C4.1, L1.1, R13.1, U1.8 (VBAT), U2.1 (OUT), U2.20 (OUT)

Notes on the sheet:
昇圧 — Adafruit PowerBoost 1000C Rev B の写し（CC BY-SA 3.0・Limor Fried / Adafruit）
充電 — 同じく PowerBoost 1000C Rev B の写し
電流計 — INA226（シャント 10mΩ・0x44）・電池と USB の口
ハブ — relay_board.html のミュートリレー・会話ボタン
口 — hub_ports.py の並びのまま（今の線がそのまま挿さる）

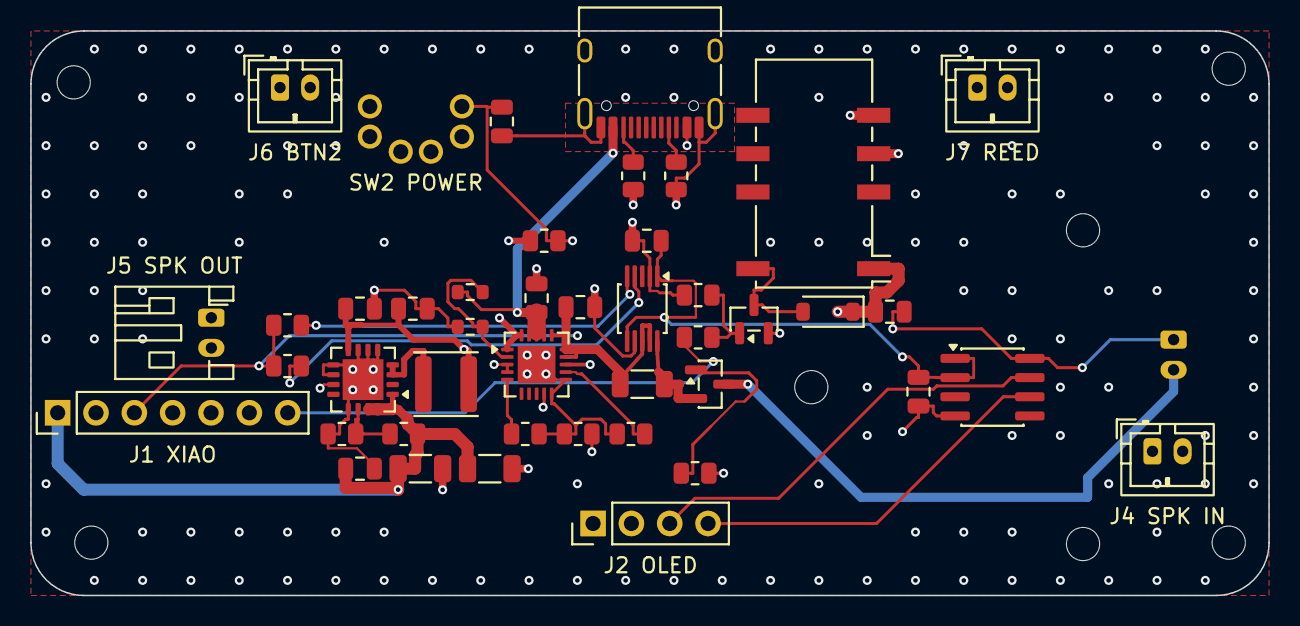
[picture p338: board katanori61.kicad_pcb from above]

Board: 4 copper layers, 82.0 x 37.4 mm, 45 parts (1 on the bottom side), 27 nets.
