n416/katanori/hardware/pcb/riser_xiao/riser_xiao.kicad_pcb

## KiCad design hardware/pcb/riser_xiao/riser_xiao.kicad_pcb (2026-09-19)

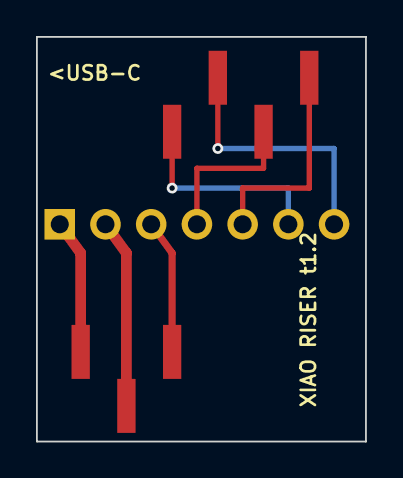
[picture p347: board riser_xiao.kicad_pcb from above]

Board: 2 copper layers, 18.3 x 22.5 mm, 3 parts (1 on the bottom side), 7 nets.

Parts:
J1: L_SOCKET_1x7; J1_L_SOCKET_1x7
J2: XIAO_SIG_1x4; J2_XIAO_SIG_1x4
J3: XIAO_PWR_1x3; J3_XIAO_PWR_1x3

Connections:
BTN: J1.6, J2.1
GND: J1.2, J3.2
IN: J1.7, J2.2
SCL: J1.5, J2.4
SDA: J1.4, J2.3
V5: J1.1, J3.1
V33: J1.3, J3.3
