n416/katanori/firmware/esp32/src/main.cpp

/*
 * ============================================================================
 *  カタノリロボ 実機ファームウェア (XIAO ESP32S3 + SSD1306 OLED)
 *
 *  Stage 1: 「顔が出る」まで
 *    - I2Cスキャンで OLED の実在を確認 (配線チェック)
 *    - firmware/core の RobotCore を実機で回して OLED に顔を描画
 *    - シリアル / BOOTボタンから状態遷移イベントを注入して目視確認
 *
 *  音声(I2S)・Wi-Fi・WebSocket は Stage 2 以降で追加する。
 *  このファイルが唯一の「実機依存コード」であり、firmware/core は
 *  シミュレーターとまったく同じソースを共有している。
 * ============================================================================
 */

#include <Arduino.h>
#include <Wire.h>
#include <Preferences.h>
#include <U8g2lib.h>
#include <WiFi.h>
#include <ArduinoOTA.h>
#include <esp_task_wdt.h>

#include "IHal.h"
#include "RobotCore.h"
#include "NetLink.h"
#include "AudioIo.h"
#include "Provisioning.h"
#include "Chimes.h"
#include "VoiceClips.h"
#include "Battery.h"
#include "BootLog.h"
#include "Settings.h"
#include "WakeWatch.h"
#include "MicroWake.h"

#include <qrcode.h>
#include "Console.h" // 最後に置く（Serial を Wi-Fi モニタへも流す差し替え。Console.h）

// ---------------------------------------------------------------------------
// ボード設定
// ---------------------------------------------------------------------------

// XIAO ESP32S3 の I2C: D4 = GPIO5 (SDA) / D5 = GPIO6 (SCL)
// ReSpeaker Lite に直挿しした場合は Grove I2C コネクタがこの2本に出ている。
#ifndef KATANORI_I2C_SDA
#define KATANORI_I2C_SDA 5
#endif
#ifndef KATANORI_I2C_SCL
#define KATANORI_I2C_SCL 6
#endif

// SSD1306 のI2Cアドレス (7bit)。基板によっては 0x3D の個体もある。
#ifndef KATANORI_OLED_ADDR
#define KATANORI_OLED_ADDR 0x3C
#endif

// XIAO ESP32S3 の BOOT ボタン (押下でLOW)
#ifndef KATANORI_BOOT_BUTTON
#define KATANORI_BOOT_BUTTON 0
#endif

// 会話ボタンの入力。D2 = GPIO3。XMOS側は未使用なので、押下でGNDに落ちる
// 普通のボタンとして読める。
// (GPIO3はストラッピングピンだが INPUT_PULLUP で読むだけなら影響しない)
//
// 🔴 **このコメントは 2026-08-17 まで「ReSpeaker 裏の Usr ボタンに Usr-D2 穴へ
//    ジャンパーピンを通して導通させている」と書いていたが、それは**壊れた旧ボード**の
//    話だった**（ユーザー指摘）。現行機にそのジャンパーは無い。
//    🔒 [[results-belong-to-a-build]] と同じ誤り: 旧構成の状態を現構成として書かない。
//    **主語がどのボードなのかを書かないコメントを残さないこと。**
// ⬜ 現行機で D2 に何が繋がるかは筐体 v2 で決める（ハブ基板に降ろすか、
//    XIAO から会話ボタンへ直結するか。docs/POWER.md の口の一覧と揃えること）
#ifndef KATANORI_USR_BUTTON
#define KATANORI_USR_BUTTON 3
#endif

// OTA (Wi-Fi経由のファーム更新)。筐体に封入した後もファームを直せるようにする。
// パスワードは「LAN内の他人が勝手に書き込めない」ための合言葉で、秘匿情報ではない
// (Wi-Fi資格情報と違いNVSではなくビルドフラグで差し替える)。
#ifndef KATANORI_OTA_HOSTNAME
#define KATANORI_OTA_HOSTNAME "katanori"
#endif
#ifndef KATANORI_OTA_PASSWORD
#define KATANORI_OTA_PASSWORD "katanori"
#endif

// XIAO ESP32S3 のユーザーLED (GPIO21)。アクティブLOW = LOWで点灯。
// 未設定のままだと点きっぱなしで眩しいので起動時に明示的に消す。
// 仕様書では「通信中のステータス表示」に使う予定なので Stage 2 で点灯制御を入れる。
#ifndef KATANORI_USER_LED
#define KATANORI_USER_LED 21
#endif

// 音量つまみ: AS5600 磁気角度センサ (I2C 0x36。docs/KNOB-ENCODER.md)。
// RAW ANGLE(12bit) を読み、ゼロ点（NVS保存。'knobzero' で設定）からの相対角度を
// 0-100% へ写す。起動時に 0x36 が応答しなければ下の可変抵抗(ADC)経路へ
// フォールバックする（机の上で配線を差し替えて切り替えられるように残してある）。
#ifndef KATANORI_KNOB_SPAN_DEG
#define KATANORI_KNOB_SPAN_DEG 270  // ゼロ点からこの角度で100%。本番は機構の壁に合わせる
#endif
#ifndef KATANORI_KNOB_OFF_DEG
// この角度未満はOFF。🔒 **リードスイッチが閉じる角度より外**に置くこと(docs/POWER.md 2章)。
// ここが内側にあると、ファームがまだ鳴らしているうちに EN が落ちてブツ切りになる。
// ✅ 2026-08-17 実測: リードの反応帯は磁石の真上から片側15度（開くのも閉じるのも同じ角度＝
//    ヒステリシスは見えなかった）。
// 🔒 機構側で OFF位置を帯の縁へ 10度 寄せた（knob_v4.scad の STOP_OFF_ANG）ので、
//    **リードが開くのは OFF から 5度**。閾値 15 で 10度 の余裕。
//    ⚠ 25 のままだと、鳴らない区間が 25度 と無駄に広い。STOP_OFF_ANG を変えたらここも直す
// ⚠ 15度は写真からの読み取り。🔴 これを実機の `knob` 表示で詰めることはできない
//    （この閾値より内側では pct が 0 のまま動かず、出てくるのは閾値そのもの）。
//    測るならテスタをリードの足に当てる。理由は docs/POWER.md 2章
#define KATANORI_KNOB_OFF_DEG 15
#endif
#ifndef KATANORI_KNOB_FULL_DEG
#define KATANORI_KNOB_FULL_DEG 10  // 上端からこの角度以内は100%。回し切りを点で当てずに済む
#endif
#ifndef KATANORI_KNOB_DIR_INVERT
#define KATANORI_KNOB_DIR_INVERT 0  // 回して%が逆に動く組み付けはこれを1に (DIR=GNDで時計回り増が既定)
#endif

// 音量つまみはAS5600（I2C・非接触絶対角度）のみ。可変抵抗のADCフォールバックは
// 2026-08-11 に削除した（ポットを二度と戻さない方針が確定したため。旧経路の記録は
// docs/KNOB-ENCODER.md）。これによりファームは **D0(GPIO1) に一切触らない**。
//
// 🔴 **D0(GPIO1) は空きピンではない。使わないこと**（2026-08-14・独立テストで確定）。
//   手順: D0に何も繋がっていないことを目視 → `hiz 0`（pinMode(INPUT)。内部プルアップ無し）
//   → テスター(約10MΩ)を D0-GND 間に当てる → **3.3V のまま動かない**。
//   浮いているだけなら10MΩに引かれて0V側へ落ちるので、**10MΩよりずっと低い
//   インピーダンスで何かが3.3Vに固定している**。D0には何も繋いでいないので、
//   残る候補は XIAO が載っている ReSpeaker Lite 側。**D10(GPIO9) と同じ穴**。
//   ⚠ 「ReSpeakerが犯人」は消去法。直接証明にはXIAOを降ろす必要があるが、
//   **使えないという結論は犯人が誰でも変わらない**ので追っていない。
//   ⚠ `low 0` の連打で「GPIOが勝てるか」は試していない。相手が押し込み型出力なら
//   両者が数十mAで殴り合う。ボードを1枚失って犯人未特定の機体なので踏まない。
//   ⚠ `vN` は当てにならない。浮いたピンでもADCのサンプルホールドが充電して
//   上限(3159mV)に張り付く。D2(プルアップ)と同じ値が出るので区別できない。
//
// ⚠ 旧つまみ連動スイッチが繋がっていた **D1(GPIO2) は、基板内でXMOSのリセット線
// （アクティブHIGH）に直結している**（2026-08-05確定。ESPHome公式構成の
// reset_pin: GPIO2 と、pinMode 1行の有無で mic 0フレームが再現/解消することの
// 両方で確認）。INPUT_PULLUP にした瞬間、XMOSはリセットに押さえ込まれて
// I2Sが止まる。**GPIO2には二度と pinMode しないこと。**
// 旧ボードで「つまみを回すとコーデックが死ぬ」ように見えたのもこれ
// （スイッチがGNDに落としている間だけXMOSが動けていた）。

// スピーカーのミュートリレー (docs/POWER.md)。HIGHでコイルが吸着し、接点が閉じて
// スピーカーが繋がる。アンプ出力とスピーカーの間に接点が入っている。
//
// ⚠ **D10(GPIO9) は使えない。** ファームでは未使用だが ReSpeaker Lite 側が握っていて、
// 線を挿すだけで電源投入時にリレーが閉じっぱなしになった（2026-08-08 実測。テスターで
// 1.49V ＝ クロックの平均値と見られる）。「ファームで未使用」は「ピンが空いている」ではない。
//
// リレー基板側のベースに 10kΩ のプルダウンが入っているので、リセット・書き込み中・
// クラッシュでこのピンが浮けば**接点は必ず開く**。耳を守っているのはソフトではなく、
// この「電気が来ていなければ開く」という配線そのもの。
#ifndef KATANORI_MUTE_RELAY_PIN
#define KATANORI_MUTE_RELAY_PIN 4  // D3 = GPIO4
#endif

// つまみ最大位置のゲイン。アンプは5Wまで出せるがスピーカーは2W・耳も近いので
// 上限を切る（既定の再生音量0.35が「実用の中心」になる程度の頭打ち）。
#ifndef KATANORI_KNOB_MAX_GAIN
#define KATANORI_KNOB_MAX_GAIN 0.70f
#endif

// 描画レート。128x64 の全面転送は 400kHz I2C で約23ms かかるため、
// 20FPS(50ms)がこの構成の実用上限。上げたい場合は I2C を 1MHz にする。
static constexpr uint32_t FRAME_INTERVAL_MS = 50;
// 音声受信中はこちらへ落とす（描画がCPUを占有して受信を落とすのを防ぐ）
static constexpr uint32_t FRAME_INTERVAL_SLOW_MS = 120;

// DisplayBuffer は MSB(0x80)=左ピクセル。U8g2 の drawBitmap() は U8glib互換の
// MSB-first なのでそのまま渡せる。万一 8ピクセル単位で左右反転して見えたら
// この定義を 1 にして XBM(LSB-first)へ変換する経路へ切り替える。
#ifndef KATANORI_DISPLAY_BIT_REVERSE
#define KATANORI_DISPLAY_BIT_REVERSE 0
#endif

// 診断用: I2Cバスに一切触らないビルド（-DKATANORI_I2C_SILENCE=1）。
//
// このI2CバスはXMOSとESP32の2マスター構成（コーデックを設定するのはXMOS。
// そこへESP32もミュート書き込み・スキャン・OLED転送を撃ち込む）。起動直後の
// 同時アクセスがXMOSを飛ばし、I2Sクロック停止（mic 0フレーム）を起こしている
// 疑いがある（2026-08-05・⚠推定）。このフラグはその切り分け専用で、
// コーデック・OLED・AS5600への全I2Cを黙らせる。顔は表示されない。
// ⚠ コーデックのミュートもしないので、スピーカー線を外して使うこと。
#ifndef KATANORI_I2C_SILENCE
#define KATANORI_I2C_SILENCE 0
#endif

// 診断用: audioIo.begin() 直後で setup を打ち切り、micだけ回す（-DKATANORI_MIN_BOOT=1）
#ifndef KATANORI_MIN_BOOT
#define KATANORI_MIN_BOOT 0
#endif

// ウォッチドッグ: loop() がこの秒数回らなければ再起動する（クラッシュからの復帰）。
// Wi-Fi の接続待ちは 1 候補 12 秒・TLS の握手は数秒なので、それより十分長く取る
#ifndef KATANORI_WDT_SEC
#define KATANORI_WDT_SEC 30
#endif

// ---------------------------------------------------------------------------
// グローバル
// ---------------------------------------------------------------------------

static U8G2_SSD1306_128X64_NONAME_F_HW_I2C u8g2(U8G2_R0, /* reset= */ U8X8_PIN_NONE);

#if KATANORI_DISPLAY_BIT_REVERSE
static uint8_t reverseByte(uint8_t b) {
    b = static_cast<uint8_t>((b & 0xF0) >> 4 | (b & 0x0F) << 4);
    b = static_cast<uint8_t>((b & 0xCC) >> 2 | (b & 0x33) << 2);
    b = static_cast<uint8_t>((b & 0xAA) >> 1 | (b & 0x55) << 1);
    return b;
}
#endif

// ---------------------------------------------------------------------------
// 接続状況の表示（繋がっていない間は、顔をやめてこれを出す）
//
// 顔だけを出していると「動いている = 正常」に見える。Wi-Fiに繋がっていなくても
// 顔は同じように動くので、繋がっていないことに気づけない。
// 実際、引っ越しで保存済みSSIDが消えた機体が、顔を出したまま1分近く黙って
// 再試行を続けた（2026-07-29）。繋がっていない間は、必ずここに理由を出す。
//
// 【顔の下に10pxの帯で重ねる方式は失敗した】128pxに9文字入れるには1文字10pxしか
// 使えず、実機では「つ」が潰れて読めなかった。文字を大きくすると顔と同居できない。
// 伝えるほうが顔より大事なので、繋がっていない間は画面ごと文字に明け渡す。
// 繋がれば顔に戻る。
//
// 文字は日本語。読むのは設置した本人ではなく使う人で、"no WiFi" では伝わらない。
// 16pxの日本語フォント(b16_t_japanese1)を2行。1行は全角8文字（128px）が上限で、
// 超えるとシリアルに警告が出る。**漢字は使わない**（japanese1 に無い字は
// 幅0で消える）。かな＋ASCIIに留めること。
// ---------------------------------------------------------------------------

/** 2行ぶん。1行目が空なら顔を出す（= 繋がっていて伝えることが無い）。UTF-8。 */
static char netMsg1[40] = {0};
static char netMsg2[40] = {0};

static void setNetMessage(const char* line1, const char* line2 = "") {
    if (line1 == nullptr) line1 = "";
    if (line2 == nullptr) line2 = "";
    if (strncmp(netMsg1, line1, sizeof(netMsg1)) == 0 &&
        strncmp(netMsg2, line2, sizeof(netMsg2)) == 0) {
        return;
    }
    strncpy(netMsg1, line1, sizeof(netMsg1) - 1);
    netMsg1[sizeof(netMsg1) - 1] = '\0';
    strncpy(netMsg2, line2, sizeof(netMsg2) - 1);
    netMsg2[sizeof(netMsg2) - 1] = '\0';
}

/** 自己診断パターンの表示終了時刻。この間は顔で上書きしない。 */
static uint32_t selfTestUntilMs = 0;

/** 音量オーバーレイ（つまみを回した直後だけ顔に重ねる）の表示終了時刻と値。 */
static uint32_t volOverlayUntilMs = 0;
static int volOverlayPct = 0;
/**
 * 次の1回だけ音量表示を出さない。
 *
 * ONへ戻すとしきい値を跨いだぶんで必ず%が変わるため、そのままだと
 * ブラウン管が開いた直後に音量画面が割り込み、顔より先に数字が出る。
 *
 * **時間で抑えてはいけない**（一度そうして直した）。抑えている間に回しても
 * 数字が動かず、「OFF直後にひねっても%が変わらない」という別の不満になる。
 * 跨いだ1回ぶんだけ捨てれば、手を止めれば顔・回し続ければ%と両立する。
 */
static bool volOverlaySuppressOnce = false;
/**
 * この時刻まで画面を黒のままにする（顔も接続表示も描かない）。
 *
 * ブラウン管が開いた直後に顔を描くと、まだ回している人には
 * 「顔が一瞬出てから数字に差し替わる」ちらつきになる。開いた後を少し黒で
 * 持たせれば、その間に回していれば数字へ・止まっていれば顔へ、直接分岐できる。
 */
static uint32_t uiBlankUntilMs = 0;

/**
 * 音量の画面（数字を大きく＋下にインジケーター）を1枚描く。
 *
 * **顔は出さない。** 顔に小さく重ねる案は読みにくかった（ユーザー判断
 * 2026-08-03）。治具には壁が無く「今どこまで回ったか・100%はどこか・
 * 折返し帯に入ったか」が手の感触では分からないため、回している間はこれだけを見せる。
 * OFFへ倒した瞬間にも直接呼ぶ（ブラウン管アニメの前に「OFF」を見せるため）。
 */
/**
 * 音量の画面の右上（上から 10 ドットの空いた帯）に電池の残りを出す。
 *
 * 🔒 ユーザー 2026-09-11「Aで」: 見本 docs/_img/battery_mock.png の案 A
 *   （電池の絵 12x7 ＋ 数字。少ないと絵の中が空・充電中は左に稲妻・電池が繋がっていなければ「USB」）。
 * 顔には重ねない（音量を顔に小さく重ねる案は 2026-08-03 に「読みにくい」で退けている）。
 * INA226 が居なければ何も出さない。% は Battery::percent() の目安（電池ごとの実測ではない）。
 */
static void drawBatteryBadge() {
    if (!katanori::battery.present() || !katanori::battery.hasReading()) {
        return;
    }
    u8g2.setFont(u8g2_font_6x10_tf);
    if (!katanori::battery.connected()) {
        u8g2.drawStr(128 - u8g2.getStrWidth("USB"), 8, "USB");
        return;
    }
    int pct = katanori::battery.percent();
    char txt[8];
    snprintf(txt, sizeof(txt), "%d%%", pct);
    int tx = 128 - u8g2.getStrWidth(txt);
    u8g2.drawStr(tx, 8, txt);

    // 電池の絵: 12x7 の枠と右の 1x3 の出っ張り。中（10x5）を残りの割合で塗る
    const int ix = tx - 3 - 13, iy = 1;
    u8g2.drawFrame(ix, iy, 12, 7);
    u8g2.drawBox(ix + 12, iy + 2, 1, 3);
    int inner = (pct * 10 + 50) / 100;
    if (inner > 0) {
        u8g2.drawBox(ix + 1, iy + 1, inner, 5);
    }

    if (katanori::battery.charging()) {
        // 稲妻 5x7（見本と同じ点）
        static const char* const kBolt[7] = {"...##", "..##.", ".##..", "#####", "..##.", ".##..", "##..."};
        for (int r = 0; r < 7; ++r) {
            for (int c = 0; c < 5; ++c) {
                if (kBolt[r][c] == '#') {
                    u8g2.drawPixel(ix - 7 + c, iy + r);
                }
            }
        }
    }
}

static void drawVolumeScreen(int pct) {
    if (KATANORI_I2C_SILENCE) {
        return;
    }
    char buf[8];
    if (pct <= 0) {
        snprintf(buf, sizeof(buf), "OFF");
    } else {
        snprintf(buf, sizeof(buf), "%d%%", pct);
    }

    u8g2.clearBuffer();
    u8g2.setDrawColor(1);
    u8g2.setFont(u8g2_font_fub25_tr);
    int w = u8g2.getStrWidth(buf);
    int x = (128 - w) / 2;
    if (x < 0) {
        x = 0;
    }
    u8g2.drawStr(x, 36, buf);

    // 下のインジケーター。枠を常に出して「あとどれだけ回せるか」を見せる
    const int bx = 4, bw = 120, by = 48, bh = 12;
    u8g2.drawFrame(bx, by, bw, bh);
    int fill = pct * (bw - 4) / 100;
    if (fill > 0) {
        u8g2.drawBox(bx + 2, by + 2, fill, bh - 4);
    }
    drawBatteryBadge();
    u8g2.sendBuffer();
}
/** オーバーレイの表示時間。回している最中は指を止めるたびに延長される。 */
static constexpr uint32_t kVolOverlayMs = 1500;

/**
 * 接続状況の表示を確かめている最中か（シリアル `bn`）。
 *
 * この表示はWi-Fiに繋がっていないときだけ出るので、繋がる機体では見られない。
 * 文字の大きさ・読みやすさは実物を見ないと判断できない（10pxの帯にしたときは
 * 実機で「つ」が潰れて読めなかった）ため、繋がったままでも出せる口を用意する。
 * この間は自動接続が表示を消すのを止める。
 */
static bool bannerDemo = false;

// メニューの画面（定義は「メニュー」の節）。出ている間は顔も音量表示も描かない
static bool menuActive();
static void drawMenuScreen();
/**
 * 普段の画面で押し始めた時刻（0 = 押していない）。長押しの「せっていへ」の棒に使う。
 * 🔒 ユーザー 2026-09-11「通常画面から設定画面の長押しの時も『せっていへ』でインジケーターを出したい」
 */
static uint32_t normalHoldStartMs = 0;
/** 普段の画面では、これより短く離したら短押し（会話）。これを過ぎたら棒を出し、途中で離しても何もしない。 */
static constexpr uint32_t kNormalTapMs = 700;
/** 待機スリープの手前で「ねむります」を数えている間か（pumpPowerDown が立てる）。 */
static bool powerDrowsy = false;
/** その画面（定義は「メニュー」の節）。 */
static void drawDrowsyScreen();
/** 長押しの進み具合の画面（定義は「メニュー」の節）。 */
static void drawHoldScreen(const char* line1, const char* line2, uint32_t held, uint32_t showMs);

/** 計測モードかどうか（定義は「VAD計測モード」の節）。 */
static bool vadMeasuringActive();
/** 計測モードの画面（いまのラベルと音量。定義は同じ節）。 */
static void drawVadScreen();

class Esp32Hal : public katanori::IHal {
public:
    uint32_t millis() override {
        return ::millis();
    }

    float getMicLevel() override {
        return katanori::audioIo.micLevel();
    }

    /** 音量表示の期間中なら1枚描いて true。描画の実体は drawVolumeScreen()。 */
    static bool drawVolumeScreenIfActive() {
        if (static_cast<int32_t>(::millis() - volOverlayUntilMs) >= 0) {
            return false;
        }
        drawVolumeScreen(volOverlayPct);
        return true;
    }

    /** 1行を中央に置く。幅が足りなければシリアルに出す（黙って切れないように）。 */
    static void drawCenteredLine(const char* text, int baselineY) {
        if (text[0] == '\0') {
            return;
        }
        const int w = u8g2.getUTF8Width(text);
        static int lastWarnedW = -1;
        if (w > 128 && w != lastWarnedW) {
            lastWarnedW = w;
            Serial.printf("[UI] !! \"%s\" は%dpx。128pxに収まりません（右が切れます）\n",
                          text, w);
        }
        int x = (128 - w) / 2;
        if (x < 0) {
            x = 0;
        }
        u8g2.drawUTF8(x, baselineY, text);
    }

    void flushDisplay(const uint8_t* fb) override {
        if (KATANORI_I2C_SILENCE) {
            return;
        }
        u8g2.clearBuffer();

        // メニュー（会話ボタン長押し）の間はメニューだけ
        if (menuActive()) {
            drawMenuScreen();
            return;
        }

        // 🔒 ユーザー 2026-09-21「me をあなたが書いてから実際に送られるまでに
        //    ラグがあるでしょ？正確かどうかが全然わからない。だったらカタノリの
        //    OLED になにか出してよ」。計測中は画面でラベルと音量を見せる
        if (vadMeasuringActive()) {
            drawVadScreen();
            return;
        }

        // 普段の画面で長押し中: 「せっていへ」と進み具合（棒が最後まで行くとメニュー）
        if (normalHoldStartMs != 0 && ::millis() - normalHoldStartMs >= kNormalTapMs) {
            drawHoldScreen("せっていへ", nullptr, ::millis() - normalHoldStartMs, kNormalTapMs);
            return;
        }

        // 待機スリープの手前: 「ねむります」と残り秒数（接点はもう開いている・無線はまだ）
        if (powerDrowsy) {
            drawDrowsyScreen();
            return;
        }

        // つまみを回している間は音量だけ。顔も接続表示も出さない（最優先）
        if (drawVolumeScreenIfActive()) {
            return; // 描画と転送は drawVolumeScreen() の中で済んでいる
        }

        // 復帰アニメ直後の黒。ここで顔を描くと、まだ回している人には
        // 顔が一瞬出てから数字へ差し替わるちらつきになる
        if (static_cast<int32_t>(::millis() - uiBlankUntilMs) < 0) {
            u8g2.sendBuffer(); // clearBuffer 済み = 黒
            return;
        }

        // 繋がっていないときは顔を出さない。顔と併記できる大きさでは読めなかった。
        if (netMsg1[0] != '\0') {
            u8g2.setDrawColor(1);
            u8g2.setFont(u8g2_font_b16_t_japanese1);
            drawCenteredLine(netMsg1, 28);
            drawCenteredLine(netMsg2, 56);
            u8g2.sendBuffer();
            return;
        }

#if KATANORI_DISPLAY_BIT_REVERSE
        static uint8_t xbm[katanori::DisplayBuffer::BUFFER_SIZE];
        for (size_t i = 0; i < katanori::DisplayBuffer::BUFFER_SIZE; ++i) {
            xbm[i] = reverseByte(fb[i]);
        }
        u8g2.drawXBM(0, 0, katanori::DisplayBuffer::W, katanori::DisplayBuffer::H, xbm);
#else
        u8g2.drawBitmap(0, 0,
                        katanori::DisplayBuffer::W / 8,
                        katanori::DisplayBuffer::H,
                        fb);
#endif
        u8g2.sendBuffer();
    }

    void log(const char* msg) override {
        Serial.println(msg);
    }
};

static Esp32Hal hal;
static katanori::RobotCore robot(hal);

// ---------------------------------------------------------------------------
// 対話フロー
//
// wrapper.py が確立した手順をそのまま実機へ移したもの:
//   ウェイクワード -> 録音してDOへ送る -> audioStreamEnd で発話終了を確定
//   -> 応答音声を再生 -> turnComplete + 再生完了で IDLE へ戻る
// ---------------------------------------------------------------------------

// 応答音声の受信中か（顔をSPEAKにするため）
static bool speaking = false;
// Geminiがターンを終えたか。再生キューが空になるまで IDLE には戻らない。
static bool turnComplete = false;
/**
 * 機体の側で割り込んだあと、同じ返事の残りを捨てるか。
 * Gemini がまだ返事を作っている最中に止めたとき、続きの音が届いて鳴り直すのを防ぐ。
 * その返事の終わり（turnComplete か interrupted）で解く。
 */
static bool dropReplyAudio = false;
// audioStreamEnd を送った時刻（応答遅延の実測用）
static uint32_t streamEndMs = 0;

// ---------------------------------------------------------------------------
// 自動接続
//
// 渡した相手はUSBもシリアルコンソールも持たない。電源を入れたら、こちらから
// 何も操作せずに会話できる状態まで行き着かなければならない。
//
// Wi-Fi は起動後すぐ自動で繋ぐ。WebSocketは「話しかけられたときに張る」まま
// にする（DOは接続と同時にGeminiへ繋ぐので、常時接続はセッションの浪費になる。
// 詳細は NetLink.h の設計方針）。
// ---------------------------------------------------------------------------

/** 次にWi-Fi接続を試す時刻。0なら即試す。 */
static uint32_t nextWifiTryMs = 0;
/** 連続失敗回数。成功したら0に戻す。 */
static uint8_t wifiFailures = 0;
/**
 * 起動してから一度でもWi-Fiに繋がったか。
 *
 * 一度も繋がらないなら設定が悪い（SSID変更・パスワード間違い）と判断して
 * 設定モードへ落ちる。一度繋がった後の切断はルーターの再起動や電波状況が
 * 原因なので、設定モードへ落とさず再試行を続ける（勝手に設定モードへ入って
 * 会話が終わるほうが利用者には理不尽）。
 */
static bool wifiEverConnected = false;
/**
 * 起動してから「繋ぐか、Wi-Fi設定モードへ渡すか」の振り分けがまだ済んでいないか。
 *
 * 待機スリープを止めてよいのはこの間だけ。振り分けが済めば、設定モードにいる間は
 * provisioning.active() が起きたままにするし、繋がらないまま普段の画面へ戻ったのなら
 * 眠ってよい。ここを wifiEverConnected で見ていたときは、電波の届かない場所に置いた
 * 機体が永久に Awake のままになり、ミュートリレーのコイルに電流が流れ続けていた
 * （G6S-2F DC5 は実測で電池から約45mA）。
 */
static bool wifiInitialDecisionPending = true;
/** 一度も繋がらないまま何回失敗したら設定モードへ落ちるか。 */
static constexpr uint8_t WIFI_FAILURES_TO_PROVISIONING = 3;
/**
 * 今の設定モードは機体が自分で入ったものか（3回失敗しての振り分け）。
 *
 * メニューの「WiFiせってい」で入った設定モードは、人がその場で選んだもの。
 * 3回失敗して入った設定モードは、誰も頼んでいない。だから後者だけは、誰も来なければ
 * 機体が自分で畳む。そうしないと、電波の届かない場所に置いた機体が設定画面のまま
 * 止まり、ミュートリレーのコイルに電流が流れ続ける（電池から約45mA）。
 */
static bool provAuto = false;
/** 自分で入った設定モードを、誰も来ないので畳んだか。次に起きるまで入り直さない。 */
static bool provGaveUp = false;
/**
 * 自分で入った設定モードで、スマホが1台も繋がらないまま待つ上限。
 *
 * 画面のQRを見つけて、スマホのWi-Fi一覧から katanori-setup を選ぶまでの時間。
 * 1台でも繋がれば（Phase::CONNECTED）数え直すので、設定の途中で切られることはない。
 */
static constexpr uint32_t PROV_AUTO_GIVEUP_MS = 5u * 60u * 1000u;
/**
 * 設定モードの画面を最後に描いたときの見た目（QR/文字 と Phase）。-1 = まだ描いていない。
 *
 * QRを読ませている最中に無用な全面転送（約29ms）を挟まないための間引き。設定モードへ
 * 入るたびに -1 へ戻す。戻さないと、一度抜けて（普段の顔で画面を上書きして）から同じ
 * 見た目で入り直したときに「変わっていない」と判断され、QRが出ないまま待つことになる。
 */
static int provRenderSig = -1;

/**
 * 直近の失敗が「そのSSIDが電波に出ていない」だったか。
 *
 * 画面に出す文言を変えるためと、再試行の間隔を詰めるために持つ。
 * 「パスワードが違う」と「引っ越してSSIDが消えた」は、利用者から見れば
 * まったく別の出来事なので、同じ文言で済ませてはいけない。
 */
static bool ssidMissing = false;
/**
 * SSIDが見当たらないときの再試行の間隔。
 *
 * この失敗は約2.5秒で返ってくる（理由コード201が来た時点で打ち切るため）ので、
 * 間隔も詰めてよい。3回失敗して設定モードへ移るまで、電源投入から約15秒。
 * 以前は12秒×3回＋広がる待ち時間で約56秒かかっていた。
 */
static constexpr uint32_t NO_AP_RETRY_MS = 4000;

// --- 焼き込み音声（VoiceClips.h） ---
//
// サーバーに繋がる前・繋がらないときに状況を伝えるための音。シリアルを持たない
// 相手にとっては、これが唯一の「今どうなっているか」の手がかりになる。

/** 起動アナウンスを鳴らしたか。電源を入れてから1回だけ。 */
static bool bootAnnounced = false;

// ---------------------------------------------------------------------------
// 音量つまみ（AS5600 磁気角度センサ。docs/KNOB-ENCODER.md）
//
// 磁石の絶対角度をI2Cで読んで再生ゲインへ反映する。回るのは磁石だけで、
// 電気的な接点も配線も動かない（可変抵抗で起きた摩耗・熱劣化・回転中の
// コーデック死をまとめて消すための移行）。
//
// ゼロ点＝OFF位置の RAW ANGLE は NVS に持つ（'knobzero' で保存）。AS5600 の
// OTP(ZPOS/MPOS) は焼き直しが効かないので一生使わない。OFF判定は角度の閾値で、
// 左に回し切ると将来はリードスイッチが昇圧ICのENを落として電源ごと切る
// （docs/POWER.md。ファームはENに触らない）。電源基板が無い今は
// 「会話を終え、出力ゲートを閉じ、Wi-Fiと画面を畳む」ところまでを担当する
// （疑似電源OFF。pumpPowerDown()）。
//
// 起動時に 0x36 が応答しなければ旧経路（可変抵抗のADC＋連動スイッチ）へ
// フォールバックする。判定し直しは 'knobsrc'。
// ---------------------------------------------------------------------------

// 会話制御・AS5600の読み出しは下の方で定義されるため前方宣言
static bool conversationActive();
static void endConversation();
static bool as5600Read(uint8_t reg, uint8_t* out, uint8_t len);
static uint16_t as5600Word(const uint8_t* p);

/** 画面を消したか（疑似電源OFF・待機スリープ）。ONへ戻したとき「消したものだけ」を戻すために持つ。 */
static bool powerOledDown = false;
/** 通信を止めたか（同上）。 */
static bool powerNetDown = false;

/**
 * 最後に使われた時刻と、そのきっかけ。待機スリープ（pumpPowerDown）はここからの
 * 経過で段階を進め、触られたら起きる。ボタン・つまみ・会話が更新する。
 */
static uint32_t lastActivityMs = 0;
static const char* lastActivityWhy = "起動";
static void noteActivity(const char* why) {
    lastActivityMs = millis();
    lastActivityWhy = why;
}

// メニュー（会話ボタン長押し）。定義は会話制御の後の「メニュー」の節
static bool menuActive();
static void menuOnKnob(uint16_t raw);
static void menuAbort();

/** つまみがOFF位置か。デバウンス済み。 */
static bool knobOff = false;
/** ならした後のつまみ位置(0-100)。-1 = まだ一度も読めていない。 */
static int knobPercent = -1;

/** AS5600で角度を読めているか。false のあいだは音量もOFF状態も最後の値で固定。 */
static bool knobAs5600Ok = false;
/** ゼロ点（OFF位置のRAW ANGLE値）。NVSの "knob/zero"。 */
static uint16_t knobZeroRaw = 0;
/** ゼロ点を一度でも保存したか。未設定のままでは角度が当てにならない。 */
static bool knobZeroSet = false;
/** 連続して読めなかった回数。続いたら knobAs5600Ok を落として知らせる。 */
static uint8_t knobReadFailures = 0;

// 角度(度)をRAW ANGLEの刻み(4096/周)へ。閾値の比較はすべてこの単位で行う
static constexpr uint16_t kKnobSpanRaw =
    (uint16_t)((uint32_t)KATANORI_KNOB_SPAN_DEG * 4096 / 360);
static constexpr uint16_t kKnobOffRaw =
    (uint16_t)((uint32_t)KATANORI_KNOB_OFF_DEG * 4096 / 360);
static constexpr uint16_t kKnobFullRaw =
    (uint16_t)((uint32_t)KATANORI_KNOB_FULL_DEG * 4096 / 360);
/** 100%に吸着し始める相対角度。ここから上端までは全部100%。 */
static constexpr uint16_t kKnobFullFromRaw =
    (kKnobSpanRaw > kKnobFullRaw + kKnobOffRaw) ? (uint16_t)(kKnobSpanRaw - kKnobFullRaw)
                                                : kKnobSpanRaw;
/** OFF解除はOFF閾値より3度上（境目でのバタつき防止のヒステリシス）。 */
static constexpr uint16_t kKnobHystRaw = (uint16_t)(3ul * 4096 / 360);

/**
 * つまみ位置(0-100)を再生ゲインへ写す。
 *
 * Bカーブ×振幅リニアだと聴感では上半分がほとんど変化しないため、
 * デシベル直線（1%あたり0.3dB、全域で-30dB..0dB）の指数カーブにする。
 * 0%は完全な無音。100%で上限ゲイン。
 */
static void applyKnobVolume(int pct) {
    float g = 0.0f;
    if (pct > 0) {
        float db = (pct - 100) * 0.30f;
        // 天井（KATANORI_KNOB_MAX_GAIN）× 設定のおんりょうMAX（天井から下げる向きだけ）
        g = KATANORI_KNOB_MAX_GAIN * katanori::settings.maxVolumeScale() * powf(10.0f, db / 20.0f);
    }
    katanori::audioIo.setGain(g);
}

/**
 * RAW ANGLE -> ゼロ点からの相対角度（RAW刻み・0..kKnobSpanRaw）。
 *
 * 本番の機構は壁があるので 0..SPAN の外へは行けないが、治具には壁が無い。
 * 範囲外へ回された値は近いほうの端（ゼロ点の少し手前→0 / 上端超え→SPAN）へ
 * 倒し、ありえない%が出ないようにする。
 */
static uint16_t knobRelAngle(uint16_t raw) {
#if KATANORI_KNOB_DIR_INVERT
    uint16_t rel = (uint16_t)((knobZeroRaw - raw) & 0x0FFF);
#else
    uint16_t rel = (uint16_t)((raw - knobZeroRaw) & 0x0FFF);
#endif
    if (rel > kKnobSpanRaw) {
        rel = (uint16_t)(rel - kKnobSpanRaw) < (uint16_t)((4096 - kKnobSpanRaw) / 2)
                  ? kKnobSpanRaw
                  : 0;
    }
    return rel;
}

/**
 * 相対角度 -> つまみ位置(%)。OFF閾値以下は0、上端で100。
 *
 * **0% は「OFF判定と同じ意味」でなければならない。** 素直に按分すると整数の
 * 切り捨てで OFF閾値の少し上（5.0〜7.6度）まで0%になり、「画面と音量は0%なのに
 * 疑似電源OFFに入らない」帯ができる（2026-08-03に実機で再現）。
 * OFF閾値を超えたら最低でも1%を返して、0%を OFF専用の値にしておく。
 */
static int knobAngleToPercent(uint16_t rel) {
    if (rel <= kKnobOffRaw) {
        return 0;
    }
    // 上端も帯にする。OFF側が5度の帯を持つのに100%だけ点で当てるのは非対称で、
    // 壁の無い治具では回し切っても100%に届かない（ユーザー指摘 2026-08-03）
    if (rel >= kKnobFullFromRaw) {
        return 100;
    }
    int pct = 1 + (int)((uint32_t)(rel - kKnobOffRaw) * 99u / (kKnobFullFromRaw - kKnobOffRaw));
    return pct > 100 ? 100 : pct;
}

/**
 * つまみを読むか。シリアル `knobdis` で止められる。
 *
 * 配線を外して切り分けるときに使う。止めているあいだはゲインもOFF判定も
 * 固定される。
 */
// I2C_SILENCEビルドは「I2Cに一切触らない」縛りなので最初から止める。
static bool knobEnabled = KATANORI_I2C_SILENCE == 0;

/**
 * OFF状態の確定。切り替わったときの後始末は経路（AS5600/ADC）によらず同じ。
 */
/**
 * ブラウン管が消えるときの演出。中央の横線につぶれ、点になって消える。
 *
 * つまみをOFFへ回した瞬間に出す。画面が黙って消えると「壊れた」と見えるが、
 * この2/3秒があるだけで「自分が消した」になる（ユーザー要望 2026-08-03）。
 * 描画を止めて一気に描く（OLEDの全面転送が約29msなので、これで約0.4秒）。
 */
static void powerSleepOled(); // 定義は疑似電源OFFの節（powerOledDown の直後）

static void playCrtOffAnimation() {
    const int cx = 64;
    const int cy = 32;

    // 1) 上下の縁が中央へ寄り、映像が横線へつぶれる
    //    白ベタで塗らないこと。OLEDでは白=全画素点灯で、ブラウン管とは逆の
    //    印象になる（実物で光っているのは縁の走査線で、中は黒）
    for (int h = 64; h >= 2; h -= 10) {
        u8g2.clearBuffer();
        u8g2.setDrawColor(1);
        u8g2.drawBox(0, cy - h / 2, 128, 2);
        u8g2.drawBox(0, cy + h / 2 - 2, 128, 2);
        u8g2.sendBuffer();
    }
    // 2) 横線が中央の点へ縮む
    for (int w = 128; w >= 4; w -= 20) {
        u8g2.clearBuffer();
        u8g2.drawBox(cx - w / 2, cy - 1, w, 2);
        u8g2.sendBuffer();
    }
    // 3) 残光。3px -> 1px と細めてから消す（いきなり消すと角が立つ）
    //    ※ 最後に画面そのものを落とす。演出の後に顔が戻らないようにするため
    u8g2.clearBuffer();
    u8g2.drawBox(cx - 1, cy - 1, 3, 3);
    u8g2.sendBuffer();
    delay(80);
    u8g2.clearBuffer();
    u8g2.drawPixel(cx, cy);
    u8g2.sendBuffer();
    delay(60);
    u8g2.clearBuffer();
    u8g2.sendBuffer();

    /*
     * 画面を落とすところまでが演出。
     *
     * 疑似電源OFFが画面を消すのは「OFF判定から2秒後」だが、演出は約1.2秒で
     * 終わる。その差の約0.8秒で通常の描画が動き、**消えた直後に顔が戻る**
     * （2026-08-03に実機で発生）。演出まで出したならもう確定でよい。
     */
    powerSleepOled();
}

static void powerWakeOled(); // 定義は疑似電源OFFの節（powerOledDown の直後）

/** 上の逆再生。点が灯り、横に伸び、画面が開く。つまみをONへ回した瞬間に出す。 */
static void playCrtOnAnimation() {
    // 疑似電源OFF中は表示が止まっている。戻すのは pumpPowerDown だが
    // それはこの後の処理なので、ここで自分で起こさないとアニメが見えない
    powerWakeOled();

    const int cx = 64;
    const int cy = 32;

    // 1) 点が灯る
    u8g2.clearBuffer();
    u8g2.setDrawColor(1);
    u8g2.drawBox(cx - 1, cy - 1, 3, 3);
    u8g2.sendBuffer();
    delay(80);

    // 2) 横線が伸びる
    for (int w = 4; w <= 128; w += 20) {
        u8g2.clearBuffer();
        u8g2.drawBox(cx - w / 2, cy - 1, w, 2);
        u8g2.sendBuffer();
    }
    // 3) 縁が上下へ開く。中は黒のままなので、開き切ると自然に真っ黒で終わる
    //    （白ベタで開くと、真っ白から顔が出ることになって違和感が出る）
    for (int h = 2; h <= 64; h += 10) {
        u8g2.clearBuffer();
        u8g2.drawBox(0, cy - h / 2, 128, 2);
        u8g2.drawBox(0, cy + h / 2 - 2, 128, 2);
        u8g2.sendBuffer();
    }
    // 4) 消え際を柔らかく。縁を1pxに細めてから消す（2pxのまま消すと角が立つ）
    u8g2.clearBuffer();
    u8g2.drawBox(0, 0, 128, 1);
    u8g2.drawBox(0, 63, 128, 1);
    u8g2.sendBuffer();

    // 5) 黒のまま少し置いてから顔へ渡す。開き切った次のフレームで顔が出ると
    //    「開く」と「映る」が重なって忙しく見える
    u8g2.clearBuffer();
    u8g2.sendBuffer();
    delay(120);

    // 6) しきい値を跨いだぶんの%変化は1回だけ捨てる。捨てないと顔ではなく
    //    数字が先に出てしまう（回し続けたときは2回目以降が出るので邪魔しない）
    volOverlayUntilMs = millis();
    volOverlaySuppressOnce = true;

    // 7) その後しばらく黒で持たせる。この間に回していれば数字へ、
    //    止まっていれば顔へ直接入る（顔をちらっと見せない）
    uiBlankUntilMs = millis() + 250;
}

// ---------------------------------------------------------------------------
// スピーカーのミュートリレー
//
// 耳を守る仕組みをソフトに依存させない、というのがこの部品の趣旨（docs/POWER.md）。
// ここのコードは「普段どおり動いているときに接点を閉じる」だけを担当していて、
// 異常時の保証はしていない。異常時に守っているのは基板側の 10kΩ プルダウンで、
// リセット・書き込み中・クラッシュ・ブラウンアウトでピンが浮けば接点は勝手に開く。
// ---------------------------------------------------------------------------

/** 接点が閉じている（＝スピーカーが繋がっている）か。 */
static bool muteRelayClosed = false;

/**
 * 接点を開閉する。
 *
 * ⚠ **順序が要る。** 閉じるのはコーデックがミュートされている状態で、開くのは
 * コーデックをミュートした後。電流が流れている最中に接点を切るとポップが出るし、
 * 接点にもアークが出る。呼ぶ側でこの順序を守ること。
 *
 * 開くときは出力LOWで能動的に落とす。10kΩ のプルダウンは残しておいて、
 * 「ファームが動いていないとき」の担保に専念させる。
 */
/** `spkcut` で接点を開けたまま鍵を掛けたか。掛かっている間は、どこからも閉じない（スピーカーに関わる試験用。再起動で外れる）。 */
static bool relayLockedOpen = false;

static void muteRelaySet(bool closed) {
    if (KATANORI_MUTE_RELAY_PIN < 0) {
        return;
    }
    if (closed && relayLockedOpen) {
        return;  // スピーカーを切り離した試験中（spkcut）
    }
    if (closed == muteRelayClosed) {
        return;
    }
    pinMode(KATANORI_MUTE_RELAY_PIN, OUTPUT);
    digitalWrite(KATANORI_MUTE_RELAY_PIN, closed ? HIGH : LOW);
    muteRelayClosed = closed;
    Serial.printf("[RELAY] 接点を%s\n", closed ? "閉じました（スピーカー接続）"
                                               : "開きました（スピーカー切離）");
}

static void knobSetOffState(bool off) {
    // 起動直後の初回同期では鳴らさない（自己診断パターンを潰さないため）
    static bool inited = false;
    bool animate = inited;
    inited = true;

    knobOff = off;
    if (off) {
        Serial.println("[KNOB] OFF位置 -> 会話を終了し、出力を閉じたままにします");
        if (conversationActive()) {
            endConversation();
        }
        // メニューの途中なら、変えかけの値は捨てて閉じる（電池ならこの先でリードが電源を切る）
        if (menuActive()) {
            menuAbort();
        }
        // 順序を守る: コーデックをミュート -> 接点を開く。
        // 逆にすると鳴っている最中に接点が切れてポップが出る。
        // ⚠ pumpOutputGate() も knobOff を見てミュートするが、あちらは次の周回まで
        //    走らない。接点をここで開ける以上、ミュートもここで済ませておく。
        if (!KATANORI_I2C_SILENCE) {
            katanori::audioIo.setOutputMute(true);
        }
        muteRelaySet(false);
        // Wi-Fi設定モード中はQRを消してはいけない（読み取り中の可能性がある）。
        // 待機スリープで画面が既に消えているなら、見えない演出で1.2秒止まるだけなので出さない
        if (animate && !katanori::provisioning.active() && !powerOledDown) {
            // 先に「OFF」を見せる。いきなり消えると、自分がOFFにしたのか
            // 勝手に落ちたのかが分からない（ユーザー要望 2026-08-03）
            drawVolumeScreen(0);
            delay(700);
            playCrtOffAnimation();
            // 消えた後に音量表示が蒸し返さないよう、余韻を残さず切る
            volOverlayUntilMs = millis();
        }
        // 画面と通信は pumpPowerDown() が遅らせて落とす（すぐ戻されたら
        // 何も起きなかったことにするため）
    } else {
        Serial.println("[KNOB] ON位置");
        noteActivity("つまみON");
        // 上りは逆順。コーデックがミュートされているうちに接点を閉じる（乾いた開閉）。
        // 解除は pumpOutputGate() が、鳴らすものがキューに入った時点でやる。
        muteRelaySet(true);
        if (animate && !katanori::provisioning.active()) {
            playCrtOnAnimation();
        }
    }
}

/**
 * 位置(%)の確定。ノイズでコーデック音量を叩き続けないためのデッドバンド(2%≒0.6dB)。
 * ただし両端(0/100)へは即吸着させる（「回し切ったのに無音にならない」を防ぐ）。
 */
static void knobSetPercent(int pct) {
    bool endstop = (pct == 0 || pct == 100) && pct != knobPercent;
    if (knobPercent < 0 || endstop || abs(pct - knobPercent) >= 2) {
        knobPercent = pct;
        applyKnobVolume(pct);
        katanori::audioIo.noteKnobMoved();  // 回した直後は割り込みも送りも休む（AudioIo.h の説明）
        noteActivity("つまみ");
        // 回した本人に見えるように画面へ出す。ただし復帰アニメ直後の1回だけは
        // 捨てる（顔が戻るのを先に見せる。回し続ければ次からは普通に出る）
        if (volOverlaySuppressOnce) {
            volOverlaySuppressOnce = false;
        } else {
            volOverlayPct = pct;
            volOverlayUntilMs = millis() + kVolOverlayMs;
        }
    }
}

/** AS5600経路。RAW ANGLE -> 相対角度 -> % と、角度閾値でのOFF判定。 */
static void pumpKnobAs5600(uint32_t now) {
    uint8_t buf[2];
    if (!as5600Read(0x0C, buf, 2)) {
        // 1回の失敗では騒がない（バスはOLEDの全面転送と共用で混んでいる）。
        // 続くようなら配線が抜けたと判断して読みを止める。音量とOFF状態は
        // 最後の値のまま固定（勝手に0%や大音量へ飛ばさない）。
        if (++knobReadFailures >= 5) {
            knobAs5600Ok = false;
            knobReadFailures = 0;
            Serial.println("[KNOB] !! AS5600が応答しません。音量は最後の値のまま固定します");
            Serial.println("[KNOB]    配線を確認して 'knobsrc' で再判定（'mag' で詳細が見えます）");
        }
        return;
    }
    knobReadFailures = 0;

    uint16_t rel = knobRelAngle(as5600Word(buf));

    // メニューの間は、つまみはメニューの入力。音量は変えず、ファームの OFF 判定もしない。
    // 🔒 ユーザー 2026-09-11「設定画面でもOFFになっちゃうのはまずい」: 回して項目を選ぶうちに
    //    OFF閾値（15度）へ入っても、メニューは閉じない。OFF の止まり手前（約5度）でリードが
    //    電源を切るのはハードなので止められない（知らせる表示は置かない・同日ユーザー）
    if (menuActive()) {
        menuOnKnob(as5600Word(buf));
        return;
    }

    // --- OFF判定（角度の閾値。3度のヒステリシス + 30msデバウンス） ---
    static bool rawLast = false;
    static uint32_t rawChangedMs = 0;
    static bool inited = false;
    // 入るときは「OFF閾値以下」。knobAngleToPercent の0%と同じ条件にしておく
    // （< と <= がずれていると、境目の1カウントで0%とOFFが食い違う）
    bool rawOff = knobOff ? (rel < kKnobOffRaw + kKnobHystRaw)
                          : (rel <= kKnobOffRaw);
    if (rawOff != rawLast) {
        rawLast = rawOff;
        rawChangedMs = now;
    } else if ((now - rawChangedMs) >= 30) {
        if (!inited || rawOff != knobOff) {
            inited = true;
            knobSetOffState(rawOff);
        }
    }

    // 12bitの角度はADCと違ってほぼ揺れないので、IIRは掛けずそのまま%へ。
    // OFF中は必ず0%（ヒステリシスの戻り帯5〜8度で「2%なのに疑似電源OFF」に
    // なるのを防ぐ。表示と実際の状態を常に一致させる）
    knobSetPercent(knobOff ? 0 : knobAngleToPercent(rel));
}

/** つまみの監視。main loop から毎回呼ぶ（実際は20ms間隔で動く）。 */
static void pumpVolumeKnob() {
    if (!knobEnabled) {
        return;
    }
    static uint32_t lastPollMs = 0;
    uint32_t now = millis();
    if ((now - lastPollMs) < 20) {
        return;
    }
    lastPollMs = now;

    // AS5600が落ちているあいだは何もしない（音量・OFF状態とも最後の値を保持。
    // 復帰は 'knobsrc'）。旧・可変抵抗のADCフォールバックは 2026-08-11 に廃止。
    if (knobAs5600Ok) {
        pumpKnobAs5600(now);
    }
}

/**
 * ゼロ点（OFF位置）の保存。つまみを左の壁（OFF位置）に当てて 'knobzero' を打つ。
 *
 * OTPには焼かない。NVSなら何度でもやり直せるし、機構を刷り直したら
 * ゼロ点も変わるのが当たり前なので、書き換えられる場所に持つのが正しい。
 */
static void knobSaveZero() {
    if (!knobAs5600Ok) {
        Serial.println("[KNOB] AS5600が使えません（'knobsrc' で再判定）");
        return;
    }
    uint8_t buf[2];
    if (!as5600Read(0x0C, buf, 2)) {
        Serial.println("[KNOB] RAW ANGLE が読めませんでした。'mag' で状態を見てください");
        return;
    }
    knobZeroRaw = as5600Word(buf);
    knobZeroSet = true;
    Preferences prefs;
    prefs.begin("knob", false);
    prefs.putUShort("zero", knobZeroRaw);
    prefs.end();
    Serial.printf("[KNOB] ゼロ点を保存しました RAW=%u (%.1f度)\n",
                  knobZeroRaw, knobZeroRaw * 360.0f / 4096.0f);
    Serial.printf("[KNOB] ここから右へ%d度でOFF解除、%d度で100%%になります\n",
                  KATANORI_KNOB_OFF_DEG, KATANORI_KNOB_SPAN_DEG);
}

/** つまみの読み元の判定。起動時と 'knobsrc' で呼ぶ。 */
static void knobProbeSource(bool verbose) {
    if (KATANORI_I2C_SILENCE) {
        knobAs5600Ok = false;
        if (verbose) {
            Serial.println("[KNOB] I2C_SILENCE: AS5600を探しません（つまみ無効）");
        }
        return;
    }
    uint8_t status = 0;
    knobAs5600Ok = as5600Read(0x0B, &status, 1);
    knobReadFailures = 0;
    if (knobAs5600Ok) {
        Serial.printf("[KNOB] AS5600で角度を読みます（ゼロ点 RAW=%u%s）\n",
                      knobZeroRaw, knobZeroSet ? "" : " ※未設定");
        if (!knobZeroSet) {
            Serial.println("[KNOB] ★ つまみをOFF位置にして 'knobzero' でゼロ点を保存してください");
        }
    } else if (verbose) {
        Serial.println("[KNOB] AS5600(0x36)が応答しません。読めるようになるまで音量は動きません");
    }
}

/** つまみの初期化。NVSからゼロ点を読み、読み元を判定する。setup() から1回。 */
static void knobInit() {
    Preferences prefs;
    prefs.begin("knob", false);
    knobZeroSet = prefs.isKey("zero");
    knobZeroRaw = prefs.getUShort("zero", 0);
    prefs.end();
    knobProbeSource(true);

    // AS5600が居ない＝つまみ未接続。読みを止めて既定ゲインで動く。
    // AS5600を繋げば次回起動から自動で有効になる。
    if (!knobAs5600Ok) {
        knobEnabled = false;
        Serial.println("[KNOB] つまみ未接続（AS5600なし）: 読み取りを止め、既定音量で動きます");
    }
}

// ---------------------------------------------------------------------------
// 疑似電源OFF（つまみOFF位置）と待機スリープ（つまみONのまま使われていない）
//
// ■ 疑似電源OFF
// 電池で動いているときは、つまみをOFFへ回し切るとリードスイッチが PowerBoost の EN を
// GND へ落とし、機体ごと止まる（docs/POWER.md 2章。🔒 ファームは EN に触らない）。
// ここが働くのは、USB給電のときと、OFF閾値（15度）とリードが閉じる角度のあいだに
// つまみが止まっているときだけ。「切ったように見せて、ESP32側の消費だけ減らす」。
//
// 一気に落とさず、段階を踏む。つまみは回し切る途中で一瞬OFFを通ることがあるし、
// 「切ったつもりが違った」とすぐ戻すこともある。落とすのが早いほど、戻したときに
// Wi-Fiの再接続で十数秒待たされる。落とし切る前に戻れば、何も起きなかったことになる。
//
// ■ 待機スリープ（2026-09-11 追加）
// つまみはONのまま、会話もボタンもつまみも触られない時間が続いたら、段階的に眠る。
//   無操作 1/3 : 画面を暗くする（顔は動いたまま）
//   無操作 全部 : 画面を消す・スピーカーの接点を開く・無線を止める（WIFI_OFF）
// ボタンかつまみに触れば起きる。ボタンは起こすだけでなく、そのまま会話を始める
// （Wi-Fiが繋がり直すまで待ってから録音する。startTurn の pendingTurn）。
//
// 眠っても XMOS（ReSpeaker の音声処理）は動いたままで、止められるのは ESP32 の
// 無線・画面・リレーのコイル（約30mA）だけ。どれだけ減ったかは INA226 で見る（`bat`）。
// ESP32 の deep sleep は使わない。起きるたびに再起動になり、ROMブートログが
// I2S の DOUT（GPIO43）へ流れる経路を毎回通るため（リレーは開いているが、踏む回数を
// 増やす理由が無い）。それに、眠っている間はマイクも聞けなくなる（docs/WAKEUP.md の
// 「常に聞く」と両立しない）。
// ---------------------------------------------------------------------------

/** OFF位置になってから画面を消すまで。 */
static constexpr uint32_t KNOB_OFF_OLED_MS = 2000;
/** OFF位置になってから通信を止めるまで。 */
static constexpr uint32_t KNOB_OFF_NET_MS = 5000;

#ifndef KATANORI_IDLE_SLEEP_SEC
#define KATANORI_IDLE_SLEEP_SEC 180 // 無操作でここまで来たら眠る。1/3 で画面を暗くする
#endif
/** 待機スリープを働かせるか。シリアル `sleep` でトグルする。 */
static bool idleSleepEnabled = true;
/** 無操作で眠るまで。`sleep <秒>` で変えられる（再起動で既定に戻る）。 */
static uint32_t idleSleepMs = KATANORI_IDLE_SLEEP_SEC * 1000ul;

// Drowsy = 接点だけ開けて「ねむります」を数えている間（無線はまだ生きている）
enum class IdleStage : uint8_t { Awake, Dim, Drowsy, Asleep };
/**
 * 接点を開けてから画面と無線を止めるまで。🔒 ユーザー 2026-09-11「スリープに入る時、リレーを
 * 落としてからカウントダウンしてからWifi落としてほしい。リレーの音で気が付いて戻した時にWifi
 * 接続に移るのが嫌」。この間に触れば接点を閉じ直すだけで、繋ぎ直しは起きない。
 */
static constexpr uint32_t kIdleDrowsyMs = 10000;
/** 今の待機の段階。定義は会話制御の後（見ている状態がそこで出揃うため）。 */
static IdleStage idleStageNow();

/** 画面を暗くしているか。 */
static bool powerDimmed = false;
/** 待機スリープでスピーカーの接点を開けたか（起きたら閉じ直す）。 */
static bool powerRelayDown = false;
/** 待機スリープで眠っているか（main loop が顔と自動接続を止める条件）。 */
static bool powerIdleAsleep = false;
/** 眠りから呼ばれたときの、待たせる声の段階（説明は pumpWakeChime の手前）。 */
static uint8_t sleepWakeStage = 0;
/** 眠りから呼ばれたあと、話しかけられたか（一息で続けた・待っている間に話した）。pumpWakeEngage。 */
static bool wakeEngaged = false;
/** 音声の初期化が通ったか。通っていなければ接点は閉じない（setup の方針と同じ）。 */
static bool audioReady = false;

/**
 * 待機スリープで暗くしたときの SSD1306 の明るさ。普段の明るさは設定（Settings・既定は
 * u8g2 の初期化列と同じ 0xCF）。普段をこれより暗くしてあるときは、そちらに合わせる。
 */
static constexpr uint8_t kOledContrastDim = 0x10;
static uint8_t oledDimContrast() {
    uint8_t normal = katanori::settings.contrast();
    return normal < kOledContrastDim ? normal : kOledContrastDim;
}

/** WIFI_OFF にした後は OTA の待受を張り直す。定義は pumpOta の後。 */
static void otaSuspend();

/** 消えている画面を先に起こす。ON復帰アニメを見せるために使う。 */
static void powerWakeOled() {
    if (powerOledDown) {
        powerOledDown = false;
        u8g2.setPowerSave(0);
    }
}

/**
 * 画面を落とす。OFF演出の最後に呼ぶ。
 *
 * pumpPowerDown() の2秒待ちを待たずに落とすのは、演出が終わってから
 * 待ち時間が明けるまでの隙間で顔が描き直されてしまうため。
 * 段階の管理は powerOledDown が持つので、ここで立てておけば
 * pumpPowerDown() は二重に落とさず、ONへ戻せば正しく戻る。
 */
static void powerSleepOled() {
    if (!powerOledDown) {
        powerOledDown = true;
        u8g2.setPowerSave(1);
    }
}

/**
 * 疑似電源OFFを働かせるか。シリアル `pwr` でトグルする。
 *
 * 無効にすると、つまみOFF位置の挙動はこの機能を足す前と同じ（会話終了と消音だけ）に
 * なる。「つまみを回したら音が出なくなった」の原因がこの機能かどうかを、焼き直さずに
 * 切り分けるために置いてある。
 */
static bool powerDownEnabled = true;

/**
 * 疑似電源OFFで無線を `WIFI_OFF` まで落とすか。シリアル `wifikill` でトグルする。
 *
 * 既定は false（切断まで）。消費電流は WIFI_OFF のほうが小さいので、本当は
 * true にしたい。実測してから決めること。
 *
 * 【この判断を2度間違えている記録】
 * 「WIFI_OFF にするとI2Sが巻き添えで止まる」(2026-07-29) →
 * 「I2Sではなくコーデックの設定が飛ぶ」(2026-07-30) → **どちらも誤り**。
 * 根拠にした試験はどちらも「つまみを回す」操作を含んでいて、そちらが犯人だった。
 * `wifistop` で WIFI_OFF を15秒保持しても、コーデックは生きたままになる。
 * コーデックが死ぬのはつまみを回している最中で、スイッチが開くより前
 * （docs/KNOB-TROUBLE.md）。**一度に1つしか変えないこと。**
 */
static bool powerWifiOff = false;

/** 画面の明るさ。変わるときだけ I2C を撃つ。 */
static void powerSetDim(bool dim) {
    if (dim == powerDimmed || KATANORI_I2C_SILENCE) {
        return;
    }
    powerDimmed = dim;
    u8g2.setContrast(dim ? oledDimContrast() : katanori::settings.contrast());
    if (dim) {
        Serial.printf("[PWR] 画面を暗くしました（無操作%u秒）\n", (unsigned)(idleSleepMs / 3000));
    }
}

/** 通信を止める。wifiOff なら無線ごと（WIFI_OFF）、でなければ APから離れるだけ。 */
static void powerNetStop(bool wifiOff, const char* why) {
    if (powerNetDown) {
        return;
    }
    powerNetDown = true;
    katanori::netLink.wsDisconnect();
    if (wifiOff) {
        otaSuspend(); // 無線を落とす前に待受を畳む（戻ったら pumpOta が張り直す）
        katanori::console.suspend(); // Wi-Fi モニタも同じ（戻ったら console.loop が張り直す）
        katanori::settings.webSuspend(); // 設定ページも同じ（戻ったら settings.webLoop が張り直す）
        katanori::netLink.wifiStop();
    } else {
        katanori::netLink.wifiDisconnect();
    }
    // LEDは「通信中」の表示なので、切り終わってから消す
    digitalWrite(KATANORI_USER_LED, HIGH); // アクティブLOW
    Serial.printf("[PWR] 通信を止めました（%s）\n", why);
}

/**
 * 設定（Settings）を機体へ反映する。起動時と、メニュー・設定ページで値が変わったとき。
 * 眠るまでの時間は、シリアルの `sleep` で一時的に変えた値をここで上書きする。
 */
static void applySettings() {
    if (!KATANORI_I2C_SILENCE) {
        u8g2.setContrast(powerDimmed ? oledDimContrast() : katanori::settings.contrast());
    }
    // おんりょうMAX を今のつまみの位置に掛け直す（鳴っていなければ次に鳴るときから効く）
    if (knobPercent >= 0) {
        applyKnobVolume(knobPercent);
    }
    uint32_t ms = katanori::settings.sleepMs();
    idleSleepEnabled = ms != 0;
    if (ms != 0) {
        idleSleepMs = ms;
    }
    noteActivity("設定");
}

/** 疑似電源OFF・待機スリープの進行。main loop から毎回呼ぶ。 */
static void pumpPowerDown() {
    static bool counting = false;
    static uint32_t offSinceMs = 0;
    uint32_t now = millis();

    // --- つまみOFF（疑似電源OFF）: 落とす方向にだけ進める ---
    if (knobOff && powerDownEnabled) {
        powerIdleAsleep = false;
        if (!counting) {
            counting = true;
            offSinceMs = now;
            return;
        }
        uint32_t held = now - offSinceMs;
        if (!powerOledDown && held >= KNOB_OFF_OLED_MS) {
            powerOledDown = true;
            u8g2.setPowerSave(1); // 表示だけ止まる。バッファは残るので戻せば同じ絵が出る
            Serial.printf("[PWR] 画面を消しました（OFFから%u秒）\n",
                          (unsigned)(KNOB_OFF_OLED_MS / 1000));
        }
        if (!powerNetDown && held >= KNOB_OFF_NET_MS) {
            // WIFI_OFF まで落とすかどうかは powerWifiOff で切り替わる（既定 false）。
            // 「WIFI_OFF がコーデックを殺す」と一度は結論づけたが、それは誤りだった
            // （詳細は powerWifiOff のコメント）。
            powerNetStop(powerWifiOff, "つまみOFFから5秒");
        }
        return;
    }
    counting = false;

    // --- ここから下はつまみON（または疑似電源OFFを無効にしている） ---
    IdleStage idle = idleStageNow();
    bool asleep = (idle == IdleStage::Asleep);
    bool drowsy = (idle == IdleStage::Drowsy);

    // 1 段目: 接点だけ開けて「ねむります」を数える（画面も無線もまだ止めない）
    if ((drowsy || asleep) && !powerRelayDown && muteRelayClosed) {
        // 順序はつまみOFFと同じ: コーデックをミュート -> 接点を開く
        if (!KATANORI_I2C_SILENCE && !katanori::audioIo.outputMuted()) {
            katanori::audioIo.setOutputMute(true);
        }
        muteRelaySet(false);
        powerRelayDown = true;
        Serial.printf("[PWR] 無操作%u秒。接点を開けました。%u秒後に画面と無線を止めます\n",
                      (unsigned)(idleSleepMs / 1000), (unsigned)(kIdleDrowsyMs / 1000));
    }
    powerDrowsy = drowsy;

    // 2 段目: 画面と無線を止める
    if (asleep && !powerIdleAsleep) {
        powerIdleAsleep = true;
        Serial.printf("[PWR] 待機スリープに入ります（無操作%u秒）\n",
                      (unsigned)(idleSleepMs / 1000));
        if (!powerOledDown) {
            powerOledDown = true;
            u8g2.setPowerSave(1);
        }
        powerNetStop(true, "待機スリープ");
        Serial.println("[PWR] ボタンかつまみで起きます（ボタンはそのまま会話を始めます）");
    }
    if (!asleep && powerIdleAsleep) {
        powerIdleAsleep = false;
        // 人が来た。畳んだ設定モードへもう一度入れるようにする（また3回失敗したら出す）
        provGaveUp = false;
        Serial.printf("[PWR] 起きます（%s）\n", lastActivityWhy);
    }

    powerSetDim(idle != IdleStage::Awake);

    if (asleep) {
        return;
    }
    // 「ねむります」を数えている間は、接点は開けたまま（画面と無線はまだ落としていない）
    if (drowsy) {
        return;
    }

    // 落としたものだけを戻す。まだ落ちていない段階には触らない。
    if (powerOledDown) {
        powerOledDown = false;
        u8g2.setPowerSave(0);
        Serial.println("[PWR] 画面を戻しました");
    }
    if (powerRelayDown) {
        powerRelayDown = false;
        // コーデックはミュートのまま閉じる（乾いた開閉）。解除は pumpOutputGate()。
        if (!KATANORI_I2C_SILENCE && audioReady && !knobOff) {
            muteRelaySet(true);
        }
    }
    // 眠りから呼ばれたときは、呼び名とその続きを言い終えてから無線を戻す（pumpWakeChime）。
    // 電波の探索（約 3 秒）の間は main loop が止まり、マイクも読めない
    if (powerNetDown && sleepWakeStage != 1) {
        powerNetDown = false;
        // 再試行の待ち時間を捨てて即つなぎにいく。つまみを戻した人を
        // 最大30秒待たせるのは、故障と区別がつかない。
        nextWifiTryMs = 0;
        wifiFailures = 0;
        ssidMissing = false;
        Serial.println("[PWR] 通信を戻します（自動接続が動きます）");
    }
}

// ---------------------------------------------------------------------------
// コーデックの見張り
//
// 3.3Vが一瞬落ちるとコーデック(AIC3204)がリセットされ、設定が初期値へ戻って
// 音が出なくなる。設定を書いているのはXMOSで、それをやるのは基板の電源投入時
// だけなので、ESP32を再起動しても直らない（USBを抜き差しするまで戻らない）。
//
// I2Cは応答し、I2Sのクロックも来ていて、再生サンプル数も増える。つまり
// 見ていないと気づけない。ここで気づけるようにしておく。
// 実機で発生した経緯は firmware/esp32/README.md を参照。
// ---------------------------------------------------------------------------

static void pumpCodecWatch() {
    if (KATANORI_I2C_SILENCE) {
        return;
    }
    static uint32_t lastPollMs = 0;
    static bool lastAlive = true;

    uint32_t now = millis();
    if ((now - lastPollMs) < 200) {
        return;
    }
    lastPollMs = now;

    bool alive = katanori::audioIo.codecOutputAlive();
    if (alive == lastAlive) {
        return;
    }
    lastAlive = alive;
    if (!alive) {
        Serial.println("[CODEC] !! リセットを検出しました（DACの電源が落ちています）");
        Serial.println("[CODEC]    3.3Vが瞬断しています。ESP32を再起動しても直りません");
        Serial.println("[CODEC]    USBを抜き差しするとXMOSが設定し直して復旧します");
    } else {
        Serial.println("[CODEC] 出力が復帰しました");
    }
}

// ---------------------------------------------------------------------------
// 出力ゲート
//
// コーデックの開け閉めは、必ずここ1か所だけで行う。
//
// 開けっ放しのまま電源を切られる/リセットされると、その状態がコーデックに
// 残り、次の起動でROMブートログ(115200bps)がGPIO43=I2S DOUTからそのまま
// 増幅されて轟音になる。実際にこれで耳を痛めている。
//
// 以前は再生経路ごとに setOutputMute() を呼んでいた（応答再生・割り込み・
// ターン終了）。経路が増えるたびに閉じ忘れの穴ができる作りで、起動アナウンスを
// 足した時点で「電源を入れるだけで自動的に開く」経路が生まれてしまった。
//
// 方針: 鳴らすものがキューにあるあいだだけ開ける。それ以外は必ず閉じる。
// ---------------------------------------------------------------------------

/**
 * キューが空になってから閉じるまでの猶予。
 *
 * isPlaying() が見ているのはソフト側のキューだけで、I2Sドライバ内にはまだ
 * 送信待ちが残っている。空になった瞬間に閉じると語尾が切れる。
 */
static constexpr uint32_t OUTPUT_TAIL_MS = 250;

/**
 * 手動 `unmute` のあいだだけゲートを止める。
 *
 * ゲートは「鳴っていなければ閉じる」ので、そのままでは手動で開けても
 * すぐ閉じられてスピーカー単独の切り分けができない。`mute` で戻る。
 */
static bool outputGateOverride = false;

/** 出力ゲート。main loop から毎回呼ぶ。 */
static void pumpOutputGate() {
    if (KATANORI_I2C_SILENCE) {
        return;
    }
    // つまみがOFF位置のあいだは何があっても閉じておく。
    // 手動 `unmute`（診断用）より物理操作を優先する。
    if (knobOff) {
        if (!katanori::audioIo.outputMuted()) {
            katanori::audioIo.setOutputMute(true);
        }
        return;
    }

    if (outputGateOverride) {
        return;
    }

    /*
     * 🔴 つまみが ON のあいだは開けたままにする。鳴り終わるたびに閉めてはいけない。
     *
     * ReSpeaker の AEC は適応フィルタなので、ミュートされている間はエコーが
     * 消えてフィルタが崩れる。解除してもエコーが戻るまで再収束が要り、その
     * 数百ms は消せない。実測（2026-09-21）では、定常の残留が RMS 100〜450 に
     * 対して、ミュート解除の直後だけ 1290〜12942 まで跳ね上がり、Gemini が
     * 始めたばかりの応答を割り込みと見なして捨てていた。会話1ターンごとに
     * 開け閉めしていたので、毎ターン起きていた。
     *
     * ⚠ 起動時の ROM ブートログの轟音（GPIO43 が UART0 TX と I2S DOUT を兼ねる）は
     * これで守っているのではない。ミュートリレーの 10kΩ プルダウンが、ファームが
     * 動いていない間は接点を開いて担保している。コーデックのミュートが要るのは
     * リレーの接点を開閉する瞬間だけで、それは knobOff の側で行っている
     * （2026-09-21 ユーザー「爆音対策はもうハードで超えてるじゃん」）。
     */
    if (katanori::audioIo.outputMuted()) {
        katanori::audioIo.setOutputMute(false);
    }
}

/**
 * こちらから再起動する前にコーデックを閉じる。
 *
 * 開いたままESP32だけがリセットされると、次の起動でROMブートログが増幅される。
 * クラッシュ・電池切れ・ブラウンアウトによるリセットはここを通らないので塞げないが、
 * 意図して落とすときは必ず閉じてから落とす（OTAの onStart も同じことをしている）。
 */
static void muteBeforeRestart() {
    if (!katanori::audioIo.setOutputMute(true)) {
        Serial.println("[CODEC] !! ミュートに失敗しました。スピーカーを耳から離してください");
    }
    // ミュートの後に接点を開く。コーデックのミュートが効かなかった場合、
    // 耳を守れるのはこちらだけになる。
    muteRelaySet(false);
}

/** ボタンが押されたが、まだサーバーに繋がっていない状態か。 */
static bool pendingTurn = false;
/** その待ち始めた時刻。 */
static uint32_t pendingTurnMs = 0;
/** この待ちで wsConnect() を撃ったか。繋がるまで毎周回撃つと「接続処理中です」が流れ続ける。 */
static bool pendingTurnWsAsked = false;
/** 接続を待つ上限。TLSハンドシェイクを含めても実測2秒程度で繋がる。 */
static constexpr uint32_t PENDING_TURN_TIMEOUT_MS = 15000;

// VAD計測モード（定義は下）。会話とマイクを共有するので、送信側から参照する。
static bool vadMeasuringActive();
static void vadFeed(const int16_t* pcm, size_t n);
/** 呼びかけの見張り（待機中）。計測モードとは同時に動かさない。 */
static bool vadWatchingActive();
/** 通った区間をクラウドへ送る（別タスク。すぐ戻る）。 */
/** 見張りの世話。判定の結果を受け取り、待機中なら見張りを掛け直す。 */
static void pumpWake();
/** 見張りを止める。会話へ移るときは録音を続けたまま止める。 */
static void vadStopWatching(bool keepRecording = false);
/** いまの検出線（騒音床×倍率）。控えの無音を詰めるのに同じ線を使う。 */
static float vadThreshold();

/**
 * 状態機械を目的の状態まで歩かせる。
 *
 * StateMachine は IDLE -> LISTEN -> THINK -> SPEAK の一本道で、途中の
 * イベントを飛ばせない。一方 Gemini は自前のVADで勝手にターンを進めるため、
 * こちらの状態と食い違う（例: LISTENが10秒でタイムアウトしてIDLEに戻った後に
 * 応答音声が届く）。顔を実際の会話に追従させるため、必要なイベントを
 * 順に注入して追いつかせる。
 */
static void driveTo(katanori::RobotState target) {
    for (int guard = 0; guard < 4 && robot.state() != target; ++guard) {
        switch (robot.state()) {
        case katanori::RobotState::IDLE:
            robot.injectEvent(katanori::RobotEvent::WAKE_WORD);
            break;
        case katanori::RobotState::LISTEN:
            robot.injectEvent(katanori::RobotEvent::SPEECH_END);
            break;
        case katanori::RobotState::THINK:
            robot.injectEvent(katanori::RobotEvent::RESPONSE_READY);
            break;
        case katanori::RobotState::SPEAK:
            robot.injectEvent(katanori::RobotEvent::SPEECH_DONE);
            break;
        }
    }
}

/** DOから届いた生PCM。そのまま再生キューへ積むだけ。 */
static void onAudio(const int16_t* pcm, size_t samples) {
    if (dropReplyAudio) {
        return;  // 機体の側で割り込んだ返事の残り（dropReplyAudio の説明）
    }
    if (!speaking) {
        speaking = true;
        turnComplete = false;
        // 出力を開けるのは pumpOutputGate() の仕事。ここでは触らない。
        if (streamEndMs != 0) {
            Serial.printf("[TURN] 発話終了 -> 応答開始 %.2f秒\n",
                          (millis() - streamEndMs) / 1000.0f);
            streamEndMs = 0;
        }
        driveTo(katanori::RobotState::SPEAK);
    }
    katanori::audioIo.play(pcm, samples);
}

// ---------------------------------------------------------------------------
// 会話の終わりの言葉
//
// 🔒 ユーザー 2026-09-12「終了っぽいことをユーザーが言ったら会話は終わらせてほしい。API費用的に」。
// Gemini が返してくる装着者の発話の文字起こし（inputTranscription）に終わりの言葉が入っていたら、
// ロボットの返事（たいてい挨拶）が終わったところで endConversation() する（接続を切るので料金も止まる）。
// 返事が来ないまま kEndAfterWordMs 過ぎたらそのまま閉じる。
// 文字起こしは「ちょっと 待っ て 。」のように語の間に空白が入るので、空白を抜いて照合する。
// ---------------------------------------------------------------------------

static const char* const kEndWords[] = {
    "バイバイ", "ばいばい", "さようなら", "さよなら", "またね", "またあとで", "また後で",
    "じゃあね", "じゃあまた", "おやすみ", "お休み", "おしまい", "おわり", "終わり", "終了",
};
static constexpr uint32_t kEndAfterWordMs = 10000;
/** 終わりの言葉を聞いた。返事が終わったら（来なければ kEndAfterWordMs で）会話を閉じる。 */
static bool endAfterReply = false;
/**
 * 会話の中で最後に声があった時刻（装着者の発話・ロボットの返事）。
 * 🔒 ユーザー 2026-09-12「（無音が続いたら閉じるのも）いれてください」: 声で割り込めるように
 * マイクを送り続けているので、サーバー側の「無音で切る」はもう働かない。kConvSilenceMs 声が
 * 無ければ、こちらで会話を閉じる（接続を切るので料金も止まる）。
 */
static uint32_t convLastVoiceMs = 0;
static constexpr uint32_t kConvSilenceMs = 60000;
static uint32_t endAfterReplyMs = 0;
/** 装着者の発話の直近（空白を抜いたもの）。文字起こしは細切れで届くので、つないで照合する。 */
static char userHeard[160];
static size_t userHeardLen = 0;

/** inputTranscription の text を拾って userHeard へつなぎ、終わりの言葉を探す。 */
static void noteUserTranscript(const char* json) {
    const char* p = strstr(json, "\"inputTranscription\"");
    if (!p) {
        return;
    }
    p = strstr(p, "\"text\":\"");
    if (!p) {
        return;
    }
    p += 8;
    convLastVoiceMs = millis(); // 装着者が喋った
    for (; *p && *p != '"'; ++p) {
        if (*p == '\\' && p[1]) {
            ++p; // \" などは次の 1 字だけ見る
        }
        if (*p == ' ') {
            continue;
        }
        if (userHeardLen >= sizeof(userHeard) - 1) {
            // あふれたら古い半分を捨てる（UTF-8 の途中で切れても照合には効かない部分）
            size_t half = userHeardLen / 2;
            memmove(userHeard, userHeard + half, userHeardLen - half);
            userHeardLen -= half;
        }
        userHeard[userHeardLen++] = *p;
    }
    userHeard[userHeardLen] = '\0';
    if (endAfterReply) {
        return;
    }
    for (const char* w : kEndWords) {
        if (strstr(userHeard, w)) {
            endAfterReply = true;
            endAfterReplyMs = millis();
            Serial.printf("[TURN] 終わりの言葉「%s」を聞きました。返事が終わったら会話を閉じます\n", w);
            return;
        }
    }
}

/** DOから届いた制御JSON。パーサは積まず、必要な語だけ拾う。 */
static void onControl(const char* json) {
    noteUserTranscript(json);
    // 割り込み: マイクがスピーカー音を拾うと Gemini がこれを返す。
    // 未再生ぶんを捨てないと、古い応答が延々と流れ続ける。
    if (strstr(json, "\"interrupted\"") != nullptr) {
        dropReplyAudio = false;  // 割り込まれた返事はここで終わり。次の返事は鳴らす
        Serial.println("[TURN] 割り込み検知 — 再生を中断します");
        // キューを空にすれば pumpOutputGate() が閉じる
        katanori::audioIo.stopPlayback();
        speaking = false;
        turnComplete = false;
        robot.injectEvent(katanori::RobotEvent::SPEECH_DONE);
        return;
    }
    if (strstr(json, "\"turnComplete\"") != nullptr) {
        if (dropReplyAudio) {
            dropReplyAudio = false;  // 割り込んだ返事が終わった。turnComplete は次の返事のものではない
            return;
        }
        turnComplete = true;
    }

    // GeminiのVADをそのまま顔に反映する。ボタンを押さなくても
    // 喋り始め・喋り終わりで表情が変わる。
    if (strstr(json, "\"speechState\":\"SPEECH\"") != nullptr) {
        convLastVoiceMs = millis(); // Gemini が装着者の声を聞き取り始めた
        if (!speaking) {
            driveTo(katanori::RobotState::LISTEN);
        }
    } else if (strstr(json, "\"speechState\":\"NON_SPEECH\"") != nullptr) {
        if (!speaking && robot.state() == katanori::RobotState::LISTEN) {
            robot.injectEvent(katanori::RobotEvent::SPEECH_END); // -> THINK
        }
    }
}

/** ウェイクワード相当。接続してから録音を始める。 */
static void startTurn() {
    // 🔒 ユーザー 2026-09-21「会話ボタンを押下した瞬間から保存しておいてほしい」。
    // 繋がるまで待つ間も控えに貯め、繋がったところで drainToNetLink() が流す。
    // 接続待ちで何度も呼ばれるので、印が無いときだけ打つ（＝最初の1回）
    if (!katanori::wakeWatch.hasTurn()) {
        katanori::wakeWatch.markTurn();
        // 🔴 無音の時計もここから。繋がるまでの間、見張りは解けていて録音は
        // 続いているので、更新しないと「60秒声が無かった」に即座に倒れて
        // 会話が始まる前に閉じられる（実機で ★呼ばれました の直後に
        // 「会話を終了しました」が出た）
        convLastVoiceMs = millis();
    }
    if (vadMeasuringActive()) {
        Serial.println("[TURN] VAD計測中です。'vad' で終了してから話しかけてください");
        return;
    }
    if (!katanori::netLink.wifiConnected()) {
        // 自動接続が繋ぎ直している最中。待機スリープから起こした直後は必ずここを通る
        // （眠るときに無線を止めているため）。押し直させず、繋がり次第サーバーへ張って
        // 録音を始める（pumpPendingTurn）。上限は PENDING_TURN_TIMEOUT_MS。
        if (!pendingTurn) {
            pendingTurn = true;
            pendingTurnMs = millis();
            pendingTurnWsAsked = false;
            Serial.println("[TURN] Wi-Fiに繋がり次第、会話を始めます");
        }
        return;
    }

    // まだサーバーに繋がっていなければ、ここから張って繋がり次第録音を始める。
    // 待つのは setupComplete まで。WebSocketが繋がっただけで音声を送ると
    // Gemini側のsetupが終わっておらず、最初のひと言が捨てられる。
    if (!katanori::netLink.wsReady()) {
        if (!pendingTurn) {
            pendingTurn = true;
            pendingTurnMs = millis();
            pendingTurnWsAsked = false;
            Serial.println("[TURN] サーバーへ接続します。繋がり次第録音を始めます");
        }
        if (!katanori::netLink.wsConnected() && !pendingTurnWsAsked) {
            katanori::netLink.wsConnect();
        }
        pendingTurnWsAsked = true;
        return;
    }

    pendingTurn = false;
    streamEndMs = 0;
    convLastVoiceMs = millis(); // 無音の時計は会話を始めたところから
    vadStopWatching(true);      // 見張りはここで終わり。録音は引き継ぐ
    katanori::audioIo.startRecording();
    robot.injectEvent(katanori::RobotEvent::WAKE_WORD);
    Serial.println("[TURN] 会話開始（発話の区切りは自動判定。もう一度ボタンで会話終了）");

    // 眠りから呼ばれて、話しかけられていないときは控えを送らない。
    // 🔴 送ると、呼び名だけの音（誤爆ならテレビや話し声）に Gemini が返事をして、声で起きたのが
    // バレる（2026-09-22 実機「カタノリ」とだけ言って黙ったら「ん？どうしたの？何か用事？」）。
    // 指示に「名前だけなら黙って待つ」と書いても Live は守らなかった。
    // このあと話し出せば、その声はライブでそのまま届く
    if (sleepWakeStage != 0 && !wakeEngaged) {
        katanori::wakeWatch.clearTurn();
        Serial.println("[WAKE] 話しかけられていないので、控えの音は送りません");
        return;
    }

    // ボタンを押した（あるいは呼ばれた）ところから、繋がるまでに喋ったぶん。
    // setupComplete を待ってから送る位置なので、Gemini に捨てられない
    katanori::wakeWatch.drainToNetLink(vadThreshold());
}

/** 発話終了。audioStreamEnd を送ると Gemini が応答生成を始める。 */
static void endTurn() {
    if (!katanori::audioIo.isRecording()) {
        return;
    }
    katanori::audioIo.stopRecording();
    robot.injectEvent(katanori::RobotEvent::SPEECH_END);

    // clientContent+turnComplete はVADが発話中と認識していると無視されて
    // ハングする。audioStreamEnd を使うこと（wrapper.py で確定済みの知見）
    if (katanori::netLink.sendControl("{\"realtimeInput\":{\"audioStreamEnd\":true}}")) {
        streamEndMs = millis();
        Serial.println("[TURN] audioStreamEnd 送信（応答待ち）");
    }
}

/**
 * 会話しているか。ボタンの「開始/終了」の分岐に使う。
 *
 * 録音中だけでなく、応答の受信中・再生中・接続待ちも「会話中」。
 * どの瞬間に押されても「終了」に倒れるようにする。
 */
static bool conversationActive() {
    return pendingTurn || speaking ||
           // 見張りも録音を使うが会話ではない。含めるとボタンが「終了」に倒れて
           // 会話を始められなくなる
           (katanori::audioIo.isRecording() && !vadWatchingActive()) ||
           katanori::audioIo.isPlaying();
}

/**
 * 会話全体を終了する。録音・再生を止め、サーバーとの接続も畳む。
 *
 * DOは接続と同時にGeminiセッションを張る（＝繋ぎっぱなしは課金される）ので、
 * 会話をやめたら接続ごと切るのが正しい。次の会話は startTurn() が張り直す。
 */
static void endConversation() {
    pendingTurn = false;
    katanori::audioIo.stopRecording();
    katanori::audioIo.stopPlayback();   // 喋りかけでも即座に黙る
    speaking = false;
    turnComplete = false;
    streamEndMs = 0;
    endAfterReply = false;
    userHeardLen = 0;
    katanori::netLink.wsDisconnect();
    katanori::netLink.setConnectTag("");  // 眠りから呼ばれた印（onMicroWake）は、この会話かぎり
    katanori::wakeWatch.clearTurn();
    driveTo(katanori::RobotState::IDLE);
    Serial.println("[TURN] 会話を終了しました");
}

/**
 * ファームに焼いた音声を鳴らす。
 *
 * 出力の開け閉めは pumpOutputGate() に任せる（ここでミュートを触らない）。
 */
static void announce(const int16_t* pcm, size_t samples, const char* what) {
    if (speaking) {
        // Geminiの応答再生中。割り込んで喋ると会話を壊すので見送る。
        return;
    }
    Serial.printf("[VOICE] %s\n", what);

    // 先にキューへ積む。出力を開けるのはこの後 pumpOutputGate() が行う。
    // 「開けてから積む」順にすると、音が出ていない状態で開いた時間ができる。
    katanori::audioIo.play(pcm, samples);
    pumpOutputGate();
}

/** Wi-Fiが繋がった。初回なら起動アナウンスを鳴らす。 */
static void noteWifiUp() {
    wifiFailures = 0;
    wifiEverConnected = true;
    wifiInitialDecisionPending = false;
    if (!bootAnnounced) {
        bootAnnounced = true;

        // 設定モードで保存した直後の接続なら「つながりました」を優先する。
        // 「起動しました」では、いま入れたパスワードが合っていたのかが
        // 伝わらない（設定の保存後は再起動を挟むので、印はNVS越しに届く）。
        Preferences p;
        p.begin("katanori", false);
        bool justProvisioned = p.getBool("provok", false);
        if (justProvisioned) {
            p.remove("provok");
        }
        p.end();

        if (justProvisioned) {
            announce(katanori::clips::WIFI_OK,
                     katanori::clips::WIFI_OK_SAMPLES,
                     "ワイファイにつながりました！");
        } else if (!katanori::settings.bootVoice()) {
            // 🔒 ユーザー 2026-09-11: 起動の声は設定で切れる（メニュー／katanori.local）
            Serial.println("[VOICE] 起動の声は鳴らさない設定です");
        } else {
            // ここが「使える状態になった」の合図。シリアルを持たない相手には
            // これが唯一の手がかりになる。
            announce(katanori::clips::BOOT_READY,
                     katanori::clips::BOOT_READY_SAMPLES,
                     "カタノリ、起動しました！");
        }
    }
}

/**
 * Wi-Fi設定モードへ入る。入ったことを声でも伝える。
 *
 * automatic = 3回失敗しての振り分けで入った（人は頼んでいない）。この場合だけ
 * pumpProvisioningGiveUp() が、誰も来なければ畳む。
 */
static bool enterProvisioning(bool automatic = false) {
    // 渡す先が決まった。この先は provisioning.active() が起きたままを担う
    // （begin() が失敗しても同じ。入れなかったぶん起きたまま待つ理由は無い）。
    wifiInitialDecisionPending = false;
    provAuto = automatic;
    provRenderSig = -1; // 入り直しでも必ず一度描く
    if (!automatic) {
        provGaveUp = false; // 人が自分で設定モードを開いた。振り分けも作り直してよい
    }
    // 設定ページ（katanori.local）も 80 番を使うので、先に畳む
    katanori::settings.webSuspend();
    if (!katanori::provisioning.begin()) {
        return false;
    }
    // 設定モードの画面が読めない/見えない相手にも状況を伝える
    announce(katanori::clips::PROV_NEEDED,
             katanori::clips::PROV_NEEDED_SAMPLES,
             "ワイファイの設定をしてください");
    return true;
}

/**
 * 画面に今すぐ反映する。この後で main loop が数秒止まる処理の前に呼ぶ。
 *
 * 帯を書き換えただけでは、次の描画まで画面は前のままになる。接続やスキャンで
 * 数秒止まる直前に呼んでおかないと、状況が出るのが常に一手遅れる。
 */
static void showNow() {
    if (static_cast<int32_t>(millis() - selfTestUntilMs) < 0) {
        return; // 自己診断パターンの表示中は上書きしない
    }
    robot.tick();
}

/**
 * 表示を順に出す（シリアル `bn`）。
 *
 * 実際に使う文言をそのまま出す。テスト用の別文字列にすると、本番の文言が
 * 読めるか・幅に収まっているかを確かめたことにならない。
 */
struct NetMessage { const char* l1; const char* l2; };
static const NetMessage NET_MESSAGES[] = {
    { "WiFiに",   "つないでいます" },
    { "WiFiが",   "みつかりません" },
    { "WiFiに",   "つながりません" },
    { "WiFiを",   "せっていして"   },
};
static constexpr uint32_t BANNER_DEMO_EACH_MS = 3000;
static uint8_t bannerDemoIndex = 0;
static uint32_t bannerDemoNextMs = 0;

static void bannerDemoStart() {
    bannerDemo = true;
    bannerDemoIndex = 0;
    bannerDemoNextMs = millis(); // 次の loop で1つ目を出す
    Serial.printf("[UI] 接続状況の表示を%u種類、%u秒ずつ画面に出します\n",
                  (unsigned)(sizeof(NET_MESSAGES) / sizeof(NET_MESSAGES[0])),
                  (unsigned)(BANNER_DEMO_EACH_MS / 1000));
}

/** 表示デモの進行。main loop から毎回呼ぶ。 */
static void pumpBannerDemo() {
    if (!bannerDemo || (int32_t)(millis() - bannerDemoNextMs) < 0) {
        return;
    }
    constexpr uint8_t count = sizeof(NET_MESSAGES) / sizeof(NET_MESSAGES[0]);
    if (bannerDemoIndex >= count) {
        bannerDemo = false;
        setNetMessage("");
        Serial.println("[UI] 表示を終わります（顔に戻ります）");
        return;
    }
    const NetMessage& m = NET_MESSAGES[bannerDemoIndex++];
    Serial.printf("[UI] %s%s\n", m.l1, m.l2);
    setNetMessage(m.l1, m.l2);
    bannerDemoNextMs = millis() + BANNER_DEMO_EACH_MS;
}

/**
 * Wi-Fiの接続待ちのあいだに呼ばれる。顔を動かし続けるためのもの。
 *
 * これが無いと wifiConnect() の十数秒のあいだ main loop ごと止まり、
 * 顔が固まる。利用者からは故障と区別がつかない。
 */
static void wifiWaitTick() {
    esp_task_wdt_reset(); // 接続待ちの十数秒でウォッチドッグに再起動されないように
    static uint32_t lastMs = 0;
    uint32_t now = millis();
    if ((now - lastMs) < FRAME_INTERVAL_MS) {
        return;
    }
    lastMs = now;
    showNow();
}

/**
 * Wi-Fiへ自動で繋ぐ。main loop から毎回呼ぶ。
 *
 * 電源の入れ方によっては、ロボットのほうがルーターより先に起きる。一度失敗した
 * ら諦めるのではなく、間隔を広げながら試し続ける。
 *
 * ただし「待てば繋がる」ものと「待っても繋がらない」ものは分ける。
 * 保存済みSSIDが電波に出ていない（引っ越し・ルーター交換）、パスワードが違う、
 * この2つは何度試しても結果が変わらないので、待たせずに設定モードへ渡す。
 */
static void pumpAutoConnect() {
    if (katanori::provisioning.active() || !katanori::netLink.hasCredentials()) {
        return;
    }
    if (sleepWakeStage == 1) {
        return;  // 眠りから呼ばれ、まだ言い終えていない。探索で loop を止めない（pumpPowerDown）
    }
    // 眠りから呼ばれたあとは、Gemini まで来るまで「ちょっと／まってね」、Wi-Fi がつながったら
    // 「あと／すこし」（sleepWakeStage の説明）
    const bool wakeWait = sleepWakeStage != 0;
    if (katanori::netLink.wifiConnected()) {
        if (!bannerDemo) {
            if (sleepWakeStage == 3) {
                setNetMessage("あと", "すこし");
            } else if (wakeWait) {
                setNetMessage("ちょっと", "まってね");
            } else {
                setNetMessage("");
            }
        }
        noteWifiUp();
        return;
    }
    if (nextWifiTryMs != 0 && (int32_t)(millis() - nextWifiTryMs) < 0) {
        // 待っている間も黙らない。顔だけが動いていると「正常」に見えてしまう。
        setNetMessage(ssidMissing ? "WiFiが" : "WiFiに",
                      ssidMissing ? "みつかりません" : "つながりません");
        return;
    }

    // --- 1. 繋ぐ ---
    Serial.printf("[NET] 自動接続を試みます（%u回目）\n", (unsigned)wifiFailures + 1);
    if (wakeWait && !ssidMissing) {
        setNetMessage("ちょっと", "まってね");
    } else {
        setNetMessage(ssidMissing ? "WiFiを" : "WiFiに",
                      ssidMissing ? "さがしています" : "つないでいます");
    }
    showNow();
    // 既定の20秒はここでは長い。待っている間は wifiWaitTick が顔を回す。
    // 結論が出た時点で打ち切られるので、駄目なときは実測2.5秒で戻ってくる。
    if (katanori::netLink.wifiConnect(12000, wifiWaitTick)) {
        setNetMessage(wakeWait ? "ちょっと" : "", wakeWait ? "まってね" : "");
        noteWifiUp();
        return;
    }

    ++wifiFailures;

    // --- 2. なぜ繋がらなかったのかで分ける ---
    const bool authBad = katanori::netLink.lastFailureWasAuth();
    const bool noAp = katanori::netLink.lastFailureWasNoAp();
    ssidMissing = noAp;
    setNetMessage(noAp ? "WiFiが" : "WiFiに",
                  noAp ? "みつかりません" : "つながりません");

    // 一度も繋がっていない機体だけを設定モードへ落とす。一度繋がった後の切断は
    // ルーターの再起動や電波状況なので、勝手に設定モードへ入れない
    // （会話の途中で設定画面になるほうが利用者には理不尽）。
    //
    // authBad は1回では信じない。再起動直後の初回接続は、正しいパスワードでも
    // ハンドシェイク不成立(理由15)で落ちることがある（実機で確認。設定を保存→
    // 再起動→即「設定してください」に戻るループの正体がこれだった）。
    // provGaveUp = 一度この振り分けで設定モードへ入ったが、誰も来ないので畳んだ。
    // 入り直すと畳んだ意味が無い（設定画面と普段の画面を往復するだけで眠れない）。
    // ボタンで起こされたら作り直す（pumpPowerDown の「起きます」）。
    if (!wifiEverConnected && !provGaveUp &&
        ((authBad && wifiFailures >= 2) ||
         wifiFailures >= WIFI_FAILURES_TO_PROVISIONING)) {
        // 保存された設定では繋がらない。利用者が自分で直せるよう設定モードへ。
        Serial.println(authBad ? "[NET] パスワードが違うようです。Wi-Fi設定モードへ移ります"
                       : noAp  ? "[NET] 設定されたWi-Fiが見当たりません。"
                                 "場所か機器が変わったとみて設定モードへ移ります"
                               : "[NET] 保存された設定では繋がりませんでした。"
                                 "Wi-Fi設定モードへ移ります");
        wifiFailures = 0;
        ssidMissing = false;
        nextWifiTryMs = 0;
        setNetMessage("");
        if (!enterProvisioning(true)) {
            setNetMessage("WiFiを", "せっていして");
        }
        return;
    }

    // 5秒, 10秒, 15秒... と広げる。上限30秒。
    // ただしSSIDが見当たらないだけなら、失敗そのものが速い（約2.5秒）ので
    // 間隔も詰める。ルーターの起動待ちなら、そのぶん早く繋がる。
    uint32_t waitMs = noAp ? NO_AP_RETRY_MS : 5000u * wifiFailures;
    if (waitMs > 30000u) {
        waitMs = 30000u;
    }
    nextWifiTryMs = millis() + waitMs;
    Serial.printf("[NET] %u秒後にもう一度試します\n", (unsigned)(waitMs / 1000));
}

/** ボタンを押したがサーバー未接続だった場合の続き。繋がり次第録音を始める。 */
static void pumpPendingTurn() {
    if (!pendingTurn) {
        return;
    }
    if (katanori::netLink.wsReady()) {
        pendingTurn = false;
        startTurn();
        return;
    }
    // Wi-Fi待ちで始まった場合は、繋がった時点でサーバーへ張る
    if (!pendingTurnWsAsked && katanori::netLink.wifiConnected()) {
        pendingTurnWsAsked = true;
        katanori::netLink.wsConnect();
    }
    if (millis() - pendingTurnMs > PENDING_TURN_TIMEOUT_MS) {
        pendingTurn = false;
        Serial.println("[TURN] サーバーへ接続できませんでした。もう一度押してください");
    }
}

/**
 * 待機スリープの段階。pumpPowerDown() から毎回呼ばれる。
 *
 * 「使っている」間は時計を進めない。会話（接続待ち・録音・受信・再生）、
 * VAD計測、表示の確認（`bn`・自己診断）、手動 `unmute`、Wi-Fi モニタが繋がっている間
 * （眠ると無線ごと切れて、見ている人の手が止まる）、そして起動直後の振り分けが
 * 済むまでの間（初回の接続と設定モードへの振り分けを眠りで止めない）。
 *
 * 振り分けが「済むまで」であって「繋がるまで」ではない。ここを wifiEverConnected で
 * 見ると、電波の届かない場所の機体が永久に Awake になり、接点を開く muteRelaySet(false)
 * まで辿り着かず、ミュートリレーのコイルに電流が流れ続ける。
 *
 * Wi-Fi設定モードはここに並べない。設定モードの間は loop が上の枝で return するので、
 * pumpPowerDown() も、この関数も呼ばれない。3回失敗して自分で入った設定モードを畳むのは
 * pumpProvisioningGiveUp() の役目。
 */
static IdleStage idleStageNow() {
    uint32_t now = millis();
    if (!idleSleepEnabled || knobOff) {
        lastActivityMs = now; // つまみOFFの間は数えない（ONへ戻した直後に眠らないように）
        return IdleStage::Awake;
    }
    bool busy = conversationActive() ||
                vadMeasuringActive() || bannerDemo || outputGateOverride ||
                wifiInitialDecisionPending || katanori::console.remoteActive() || menuActive() ||
                static_cast<int32_t>(now - selfTestUntilMs) < 0;
    if (busy) {
        noteActivity("会話・設定など");
        return IdleStage::Awake;
    }
    uint32_t idle = now - lastActivityMs;
    if (idle >= idleSleepMs + kIdleDrowsyMs) {
        return IdleStage::Asleep;
    }
    if (idle >= idleSleepMs) {
        return IdleStage::Drowsy;
    }
    if (idle >= idleSleepMs / 3) {
        return IdleStage::Dim;
    }
    return IdleStage::Awake;
}

// ---------------------------------------------------------------------------
// メニュー（会話ボタン長押し）
//
// 🔒 ユーザー 2026-09-11「会話ボタン長押しでメニュー。短押しはOK、長押しはキャンセル、
//    値はつまみで調整」「メニューが終わったときは音量を設定する画面を出して、音を出さない
//    ようにしないとダメ」。見本 docs/_img/menu_mock.png（同日 OK）。
// 項目は あかるさ／ねむるまで／きどうのこえ／WiFiせってい。値は Settings（NVS）へ入り、
// katanori.local の設定ページと同じ値を読み書きする。
//
// つまみは位置で選ぶ。🔒 ユーザー 2026-09-11「メニューのつまみの0位置は1で、最大はその
// メニューの最大（今であれば４）で合ってほしい」: 可動範囲（0〜310度）を選択肢の数で等分し、
// 一番下が 1 つ目・一番上が最後。境目には 3 度の遊びを置く（ちらつかないように）。
// ただし「値を変える」に入った直後と、決めて一覧へ戻った直後は、つまみが次の区切りへ
// 動くまで今の値（項目）のままにする（入った瞬間に値が位置へ飛ばないように）。
// メニューの間は音量を変えない（ゲインは入る前のまま・鳴らすものも無い）。抜けるときは
// 「0でかんりょう・100でメニュー」の出口を通り、つまみを 0 まで回させる。だから抜けた時点の
// 音量は必ず一番下で、次の周回からつまみの位置が音量になる（menuToExit）。
// ---------------------------------------------------------------------------

// Exit = 「0でかんりょう・100でメニュー」でつまみを待っている間。0 へ回すと Done（「せってい
// かんりょう!」を 1.5 秒）を出して普段へ戻る。100 へ回すとメニュー（Browse）へ戻る
enum class MenuMode : uint8_t { Off, Browse, Edit, Exit, Done };
static MenuMode menuMode = MenuMode::Off;
static uint8_t menuItem = 0;
/** 値を変えている最中の選択肢の番号と、長押しで取り消したときに戻す番号。 */
static uint8_t menuValue = 0;
static uint8_t menuSaved = 0;
/**
 * 切り替わった直後のつまみの区切り。つまみがここを出るまでは今の選択のまま（-1 = 位置どおり）。
 */
static int8_t menuPickupZone = -1;
/** つまみの今の RAW ANGLE（区切りの計算と、出口の棒に使う）。 */
static uint16_t menuKnobRaw = 0;
static uint32_t menuLastInputMs = 0;
/** 「せってい かんりょう!」を消して音量の画面へ進む時刻。 */
static uint32_t menuDoneUntilMs = 0;
static constexpr uint32_t kMenuDoneMs = 1500;
/** メニューから Wi-Fi 設定へ入った。設定モードを抜けたら出口（0でかんりょう）を通す。 */
static bool menuVolumeAfterProv = false;

#ifndef KATANORI_LONG_PRESS_MS
#define KATANORI_LONG_PRESS_MS 2000 // 長押し（メニューに入る・メニューの中で取り消す／戻る）
#endif
/**
 * メニューの中で押し始めた時刻（0 = 押していない）。長押しの進み具合の棒に使う。
 * 🔒 ユーザー 2026-09-11「キャンセル長押しは『キャンセルします』と出してインジケーターを出し、
 *    最後まで行ったらキャンセル」「戻る場合も同じく『戻る』でインジケーター」。
 */
static uint32_t menuHoldStartMs = 0;
/** これより短く離したら短押し（決定）。これを過ぎたら棒を出し、途中で離しても何もしない。 */
static constexpr uint32_t kMenuTapMs = 400;
/** 棒を出し始める時刻。短押しと棒が重ならないよう kMenuTapMs と同じにする。 */
static constexpr uint32_t kMenuHoldShowMs = kMenuTapMs;

static constexpr uint8_t kMenuItems = 6;
/**
 * 「IPアドレス」の番号（見るだけ。押しても何も起きない）。
 *
 * 🔒 ユーザー 2026-09-21「192.168.0.15 を機体から見る方法がない気がするんですが」。
 * ブラウザの設定ページを開くのに要るが、機体には出す場所が無かった。
 * katanori.local が引けない環境では、これしか手がかりが無い。
 */
static constexpr uint8_t kMenuItemIp = 4;
/** 「WiFiせってい」の番号（値を持たず、押すと Wi-Fi 設定モードへ入る）。 */
static constexpr uint8_t kMenuItemWifi = 5;
/** 区切りの境目の遊び（3 度）。 */
static constexpr uint16_t kMenuZoneHystRaw = (uint16_t)(3ul * 4096 / 360);
/** 触らないとこの時間で出口へ進む（うっかり入った人を置き去りにしない）。 */
static constexpr uint32_t kMenuTimeoutMs = 30000;
// 画面の日本語フォント（b16_t_japanese1）には漢字も全角の「：」も無い。かなと ASCII だけ
// 「おんりょうMAX」は 🔒 ユーザー 2026-09-12「設定追加しておこうよ」（Settings.h）。「さいだいおんりょう」は 145px で入らない
static const char* const kMenuTitle[kMenuItems] = {"あかるさ", "ねむるまで", "きどうのこえ", "おんりょうMAX", "IPアドレス", "WiFiせってい"};
static const char* const kMenuSleepLabel[katanori::Settings::kSleepOptions] = {
    "しない", "1ふん", "3ふん", "5ふん", "10ふん"};

static bool menuActive() {
    return menuMode != MenuMode::Off;
}

static uint8_t menuOptionCount(uint8_t item) {
    switch (item) {
    case 0: return katanori::Settings::kBrightLevels;
    case 1: return katanori::Settings::kSleepOptions;
    case 2: return 2; // あり／なし
    case 3: return katanori::Settings::kMaxVolLevels;
    case kMenuItemIp: return 1;       // 見るだけ
    default: return 1;
    }
}

/** 保存されている値を選択肢の番号で。 */
static uint8_t menuStoredValue(uint8_t item) {
    switch (item) {
    case 0: return katanori::settings.brightness() - 1;
    case 1: return katanori::settings.sleepIndex();
    case 2: return katanori::settings.bootVoice() ? 0 : 1;
    case 3: return katanori::settings.maxVolume() - 1;
    default: return 0;
    }
}

/** 画面の明るさを保存されている値へ戻す（あかるさを選んでいる最中の下見を取り消す）。 */
static void menuRestoreContrast() {
    if (!KATANORI_I2C_SILENCE) {
        u8g2.setContrast(powerDimmed ? oledDimContrast() : katanori::settings.contrast());
    }
}

/**
 * つまみの相対角（0〜可動範囲）を n 個の区切りの番号へ。一番下が 0・一番上が n-1。
 * cur（今の番号）の隣へ移るときだけ境目を 3 度越えるまで待つ（cur < 0 なら遊び無し）。
 */
static uint8_t menuZone(uint16_t rel, int n, int cur) {
    uint32_t span = (uint32_t)kKnobSpanRaw + 1;
    int z = (int)((uint32_t)rel * n / span);
    if (z > n - 1) z = n - 1;
    if (cur >= 0 && cur < n && (z == cur + 1 || z == cur - 1)) {
        uint32_t edge = (uint32_t)(z > cur ? z : cur) * span / n; // 越えようとしている境目
        if (z > cur && rel < edge + kMenuZoneHystRaw) return (uint8_t)cur;
        if (z < cur && rel + kMenuZoneHystRaw > edge) return (uint8_t)cur;
    }
    return (uint8_t)z;
}

static void menuEnter() {
    if (!knobAs5600Ok) {
        Serial.println("[MENU] つまみ（AS5600）が読めないのでメニューは使えません");
        return;
    }
    uint8_t buf[2];
    if (!as5600Read(0x0C, buf, 2)) {
        Serial.println("[MENU] つまみの角度が読めませんでした。もう一度長押ししてください");
        return;
    }
    if (conversationActive()) {
        endConversation();
    }
    menuKnobRaw = as5600Word(buf);
    menuItem = menuZone(knobRelAngle(menuKnobRaw), kMenuItems, -1); // 入ったときは位置どおり
    menuPickupZone = -1;
    menuMode = MenuMode::Browse;
    menuLastInputMs = millis();
    volOverlayUntilMs = millis(); // 音量表示が出ていたら畳む
    Serial.println("[MENU] メニューに入りました（つまみで選ぶ・短押しで決定・長押しで戻る）");
}

/** Exit で「100でメニュー」を受け付けるか。つまみが一度 90% より下へ来てから立てる。 */
static bool menuExitArmedTop = false;
/** 「0でかんりょう」と「100でメニュー」の境（音量の % で判定する。0% は OFF の範囲も含む）。 */
static constexpr int kMenuExitDonePct = 5;
static constexpr int kMenuExitArmPct = 90;
static constexpr int kMenuExitBackPct = 95;

/**
 * メニューの出口。「0でかんりょう・100でメニュー」を出してつまみを待つ。
 * 🔒 ユーザー 2026-09-11「設定完了画面の前に、つまみを0の位置に戻させよう」「『0でかんりょう・
 *    100でメニュー』でつまみ操作させよう。これで音量設定の不可解なUIが無くなる」。
 *    0 まで回させるので、抜けた時点の音量は必ず一番下（それまでの「音を出さない音量の画面」は廃止）。
 *    つまみが上の方にあるときに出口へ来ても、すぐメニューへ跳ね返らないよう、100 は一度 90% より
 *    下へ来てから受け付ける。
 */
static void menuToExit() {
    menuMode = MenuMode::Exit;
    menuLastInputMs = millis();
    menuExitArmedTop = false;
    Serial.println("[MENU] 出口: つまみを0でかんりょう・100でメニューへ戻る");
}

static void menuFinish() {
    menuMode = MenuMode::Off;
    noteActivity("メニュー");
    Serial.println("[MENU] メニューを終えました。つまみの位置が音量になります");
}

/** 途中で閉じる。変えかけの値は捨て、出口も通さない。 */
static void menuAbort() {
    if (menuMode == MenuMode::Edit && menuItem == 0) {
        menuRestoreContrast();
    }
    menuMode = MenuMode::Off;
    menuVolumeAfterProv = false;
    Serial.println("[MENU] メニューを閉じました（変えかけの値は捨てました）");
}

/** つまみの入力。pumpKnobAs5600() がメニューの間だけ呼ぶ。 */
static void menuOnKnob(uint16_t raw) {
    menuKnobRaw = raw;
    if (menuMode == MenuMode::Exit) {
        int pct = knobAngleToPercent(knobRelAngle(raw));
        if (pct <= kMenuExitDonePct) {
            menuMode = MenuMode::Done;
            menuDoneUntilMs = millis() + kMenuDoneMs;
            Serial.println("[MENU] せってい かんりょう");
        } else if (pct < kMenuExitArmPct) {
            menuExitArmedTop = true;
        } else if (menuExitArmedTop && pct >= kMenuExitBackPct) {
            menuMode = MenuMode::Browse;
            menuLastInputMs = millis();
            menuPickupZone = (int8_t)menuZone(knobRelAngle(raw), kMenuItems, -1);
            Serial.println("[MENU] メニューへ戻りました");
        }
        return;
    }
    int n = (menuMode == MenuMode::Browse) ? kMenuItems
          : (menuMode == MenuMode::Edit)   ? menuOptionCount(menuItem)
                                           : 0;
    if (n <= 1) {
        return;
    }
    uint8_t cur = (menuMode == MenuMode::Browse) ? menuItem : menuValue;
    uint8_t z = menuZone(knobRelAngle(raw), n, cur);
    if (menuPickupZone >= 0) {
        if (z == (uint8_t)menuPickupZone) {
            return; // 切り替わった直後。つまみが次の区切りへ動くまでは今のまま
        }
        menuPickupZone = -1;
    }
    if (z == cur) {
        return;
    }
    menuLastInputMs = millis();
    if (menuMode == MenuMode::Browse) {
        menuItem = z;
    } else {
        menuValue = z;
        if (menuItem == 0 && !KATANORI_I2C_SILENCE) {
            // あかるさはその場で効かせる（見ながら選べるように）
            u8g2.setContrast(katanori::Settings::contrastFor(menuValue + 1));
        }
    }
}

static void menuShortPress() {
    menuLastInputMs = millis();
    switch (menuMode) {
    case MenuMode::Browse:
        if (menuItem == kMenuItemWifi) {
            // Wi-Fi 設定モードへ。抜けたら出口を通す（exitProvisioning）
            menuMode = MenuMode::Off;
            menuVolumeAfterProv = true;
            Serial.println("[MENU] WiFiせってい -> Wi-Fi設定モードへ");
            katanori::netLink.wsDisconnect();
            katanori::audioIo.stopRecording();
            enterProvisioning();
            return;
        }
        if (menuItem == kMenuItemIp) {
            return;  // 見るだけ。変えるものが無い
        }
        menuValue = menuSaved = menuStoredValue(menuItem);
        menuMode = MenuMode::Edit;
        menuPickupZone = (int8_t)menuZone(knobRelAngle(menuKnobRaw), menuOptionCount(menuItem), -1);
        break;
    case MenuMode::Edit:
        switch (menuItem) {
        case 0: katanori::settings.setBrightness(menuValue + 1); break;
        case 1: katanori::settings.setSleepIndex(menuValue); break;
        case 2: katanori::settings.setBootVoice(menuValue == 0); break;
        case 3: katanori::settings.setMaxVolume(menuValue + 1); break;
        }
        menuMode = MenuMode::Browse;
        menuPickupZone = (int8_t)menuZone(knobRelAngle(menuKnobRaw), kMenuItems, -1);
        break;
    case MenuMode::Done:
        menuFinish(); // 押したら「かんりょう」を待たずに普段へ
        break;
    case MenuMode::Exit: // 出口ではボタンに役目は無い（つまみで選ぶ）
    case MenuMode::Off:
        break;
    }
}

static void menuLongPress() {
    menuLastInputMs = millis();
    switch (menuMode) {
    case MenuMode::Edit:
        // 取り消し。保存はしない
        menuValue = menuSaved;
        if (menuItem == 0) {
            menuRestoreContrast();
        }
        menuMode = MenuMode::Browse;
        menuPickupZone = (int8_t)menuZone(knobRelAngle(menuKnobRaw), kMenuItems, -1);
        break;
    case MenuMode::Browse:
        menuToExit();
        break;
    case MenuMode::Exit:
    case MenuMode::Done:
    case MenuMode::Off:
        break;
    }
}

/** 触られないまま時間が過ぎたら出口へ進める。「かんりょう」を出し終えたら普段へ。main loop から毎回呼ぶ。 */
static void pumpMenu() {
    if (menuMode == MenuMode::Done && (int32_t)(millis() - menuDoneUntilMs) >= 0) {
        menuFinish();
        return;
    }
    if (menuMode != MenuMode::Browse && menuMode != MenuMode::Edit) {
        return;
    }
    if (millis() - menuLastInputMs < kMenuTimeoutMs) {
        return;
    }
    if (menuMode == MenuMode::Edit && menuItem == 0) {
        menuRestoreContrast();
    }
    Serial.println("[MENU] 30秒触られなかったので、変えかけの値は捨てて出口へ進みます");
    menuToExit();
}

static void drawMenuCentered(const char* text, int baselineY) {
    int w = u8g2.getUTF8Width(text);
    u8g2.drawUTF8((128 - w) / 2, baselineY, text);
}

/**
 * 長押しの進み具合の画面を 1 枚描いて送る。上に何が起きるか（1〜2 行）、下に棒。
 * 棒は showMs で空、KATANORI_LONG_PRESS_MS で満ちる（そこで長押しが決まる）。
 */
static void drawHoldScreen(const char* line1, const char* line2, uint32_t held, uint32_t showMs) {
    u8g2.clearBuffer();
    u8g2.setDrawColor(1);
    u8g2.setFontMode(1);
    u8g2.setFont(u8g2_font_b16_t_japanese1);
    if (line2) {
        drawMenuCentered(line1, 22);
        drawMenuCentered(line2, 40);
    } else {
        drawMenuCentered(line1, 30);
    }
    uint32_t span = KATANORI_LONG_PRESS_MS - showMs;
    uint32_t fill = held > showMs ? (held - showMs) * 116 / span : 0;
    u8g2.drawFrame(4, 48, 120, 12);
    if (fill > 0) {
        u8g2.drawBox(6, 50, fill > 116 ? 116 : fill, 8);
    }
    u8g2.setFontMode(0);
    u8g2.sendBuffer();
}

/** 待機スリープの手前の画面。「ねむります」と、画面と無線を止めるまでの残り秒数。 */
static void drawDrowsyScreen() {
    int32_t left = (int32_t)(lastActivityMs + idleSleepMs + kIdleDrowsyMs - millis());
    int secs = left <= 0 ? 0 : (int)((left + 999) / 1000);
    u8g2.clearBuffer();
    u8g2.setDrawColor(1);
    u8g2.setFontMode(1);
    u8g2.setFont(u8g2_font_b16_t_japanese1);
    drawMenuCentered("ねむります", 20);
    char buf[4];
    snprintf(buf, sizeof(buf), "%d", secs);
    u8g2.setFont(u8g2_font_fub25_tr);
    u8g2.drawStr((128 - u8g2.getStrWidth(buf)) / 2, 58, buf);
    u8g2.setFontMode(0);
    u8g2.sendBuffer();
}

/** メニューの画面を 1 枚描いて送る。見本 docs/_img/menu_mock.png と同じ座標。 */
static void drawMenuScreen() {
    u8g2.clearBuffer();
    u8g2.setDrawColor(1);
    u8g2.setFontMode(1); // 透過。白抜きの上に黒で字を書くため

    // 長押しの途中: 何が起きるかと進み具合。棒が最後まで行ったら menuLongPress()
    uint32_t held = menuHoldStartMs ? millis() - menuHoldStartMs : 0;
    if (held >= kMenuHoldShowMs && (menuMode == MenuMode::Browse || menuMode == MenuMode::Edit)) {
        u8g2.setFontMode(0);
        if (menuMode == MenuMode::Edit) {
            // 「キャンセルします」は 129px で 1 行に収まらないので 2 行
            drawHoldScreen("キャンセル", "します", held, kMenuHoldShowMs);
        } else {
            drawHoldScreen("もどる", nullptr, held, kMenuHoldShowMs);
        }
        return;
    }

    if (menuMode == MenuMode::Done) {
        // 「せってい かんりょう!」（二重の枠。全角の「！」はフォントに無いので半角）
        u8g2.drawFrame(0, 0, 128, 64);
        u8g2.drawFrame(2, 2, 124, 60);
        u8g2.setFont(u8g2_font_b16_t_japanese1);
        drawMenuCentered("せってい", 28);
        drawMenuCentered("かんりょう!", 50);
    } else if (menuMode == MenuMode::Exit) {
        // 出口。つまみを 0 へ回せば終わり、100 へ回せばメニューへ戻る。
        // 🔒 ユーザー 2026-09-11「インジケーターは完了に向かって埋まってほしい」: 棒は 0 へ回すほど
        //    埋まる（100 で空・kMenuExitDonePct で満杯＝完了）
        u8g2.setFont(u8g2_font_b16_t_japanese1);
        drawMenuCentered("0でかんりょう", 18);
        drawMenuCentered("100でメニュー", 38);
        int pct = knobAngleToPercent(knobRelAngle(menuKnobRaw));
        u8g2.drawFrame(4, 48, 120, 12);
        int fill = (100 - pct) * 116 / (100 - kMenuExitDonePct);
        if (fill > 116) {
            fill = 116;
        }
        if (fill > 0) {
            u8g2.drawBox(6, 50, fill, 8);
        }
    } else {
        const bool editing = (menuMode == MenuMode::Edit);
        const uint8_t v = editing ? menuValue : menuStoredValue(menuItem);

        u8g2.setFont(u8g2_font_b16_t_japanese1);
        u8g2.drawUTF8(0, 14, kMenuTitle[menuItem]);
        char pg[6];
        snprintf(pg, sizeof(pg), "%u/%u", (unsigned)(menuItem + 1), (unsigned)kMenuItems);
        u8g2.setFont(u8g2_font_6x10_tf);
        u8g2.drawStr(128 - u8g2.getStrWidth(pg), 9, pg);
        u8g2.drawHLine(0, 17, 128);

        if (editing) {
            u8g2.drawBox(14, 20, 100, 24); // 値を変えている最中は白抜き
            u8g2.setDrawColor(0);
        }
        const int y = 38;
        u8g2.setFont(u8g2_font_b16_t_japanese1);
        switch (menuItem) {
        case 0:
        case 3: // あかるさ・おんりょうMAX は 5 段のブロック
            for (int i = 0; i < 5; ++i) {
                int x = 24 + i * 17;
                if (i <= v) {
                    u8g2.drawBox(x, y - 13, 13, 12);
                } else {
                    u8g2.drawFrame(x, y - 13, 13, 12);
                }
            }
            break;
        case 1: drawMenuCentered(kMenuSleepLabel[v], y); break;
        case 2: drawMenuCentered(v == 0 ? "あり" : "なし", y); break;
        case kMenuItemIp: {
            // 数字とドットだけなので、小さいフォントでそのまま出せる
            u8g2.setFont(u8g2_font_6x10_tf);
            const String ip = katanori::netLink.wifiConnected()
                                  ? WiFi.localIP().toString()
                                  : String("WiFi みせつぞく");
            u8g2.drawUTF8((128 - u8g2.getUTF8Width(ip.c_str())) / 2, y, ip.c_str());
            u8g2.setFont(u8g2_font_b16_t_japanese1);
            break;
        }
        default: drawMenuCentered("かいし", y); break;
        }
        u8g2.setDrawColor(1);
        if (editing) {
            for (int i = 0; i < 5; ++i) {
                u8g2.drawVLine(3 + i, 32 - i, 2 * i + 1);       // ◀
                u8g2.drawVLine(120 + 4 - i, 32 - i, 2 * i + 1); // ▶
            }
        }
        // 「OFFのてまえ」の表示は 2026-09-11 に外した（ユーザー「そもそもOFFにならないように
        // なってますよね。それならメッセージ不要では」）。メニューの間はファームの OFF 判定をしない
        drawMenuCentered(editing                    ? "おす:けってい"
                         : menuItem == kMenuItemWifi ? "おす:はじめる"
                         : menuItem == kMenuItemIp   ? "みるだけ"
                                                     : "おす:かえる", 62);
    }

    u8g2.setFontMode(0);
    u8g2.sendBuffer();
}

/** マイクを読んでDOへ送る。main loop から毎回呼ぶ。 */
/**
 * 喋っている最中はマイクを送らない「エコーガード」を掛けるか。既定は掛けない。
 *
 * 🔒 ユーザー 2026-09-12「ロボットが喋っている間はマイクを送らない暫定の止め。こんなのあったら
 *    ダメでしょ。何のために ReSpeaker 選んでここまで来たのか」。仕様書 2章のとおり、ReSpeaker Lite の
 *    ハードウェア AEC（ch0 は AEC 後の音声認識向けの信号）で、喋っている最中の人の声を聞き取って
 *    割り込めるのが既定。エコーガードは 2026-07-26（Stage 3・54ad884）に「AEC が効けば不要になる
 *    はずの暫定措置」として入り、見直されないまま 2026-09-12 まで残っていた。
 * 自分の声で「interrupted」が返って会話が壊れるときの切り分けにだけ、シリアル `echoguard` で
 * 一時的に掛けられる（再起動で外れる）。
 */
static bool echoGuardEnabled = false;

/**
 * ミュートを解いた直後、マイクを使わない時間。
 *
 * 🔒 ユーザー 2026-09-21「入れてください」。
 * ポップそのものは AudioIo::setOutputMute() のフェード（24ms）で出さないように
 * した。ここはその 24ms をまたぐだけの保険である。
 *
 * 🔴 これを伸ばして誤魔化してはいけない。ロボットが喋り始めた直後に人が
 * 割り込む場面で、その分だけ頭が切れる（ユーザー 2026-09-21「カタノリXXXXして
 * って言うときに 0.5秒も切れるんだったら使い物にならん」）。250ms を試して
 * 撤回した。
 *
 * ⚠ 2026-09-12 に外したエコーガード（喋っている間ずっとマイクを送らない）とは
 * 別物である。あれは ReSpeaker のハードウェア AEC があるのに人の割り込みまで
 * 殺していた。こちらは AEC では消せない電気的なノイズを、0.25秒だけよける。
 */
static constexpr uint32_t kUnmuteBlankMs = 30;

// 再生が始まってから AEC が落ち着くまで（600ms）は AudioIo.cpp の KATANORI_AEC_SETTLE_MS。
// 録った時点で印が付く（AudioIo::MIC_PLAY_SETTLING）

/**
 * 収束後の再生中に「人が喋った」とみなす音量。
 *
 * 2026-09-22 実測（ch0 の取り出し口 3・16 倍）: 収束後の残留は、つまみ 39% で中央 22・ほぼ 200 まで、
 * 62〜67% で中央 21・最大 112（音量を上げてもほとんど増えない）。割り込もうとした人の声は 279〜1300。
 * 2026-09-23 実測（黙って聞いた返事、0.3 秒ごとの最大）: つまみ 56% で最大 172（156 回）、92% で最大 286
 * （40 回）。つまみを回した直後は別（AudioIo::noteKnobMoved）。線は残留の上、声の下の 450。
 * 450 に届かない小さな声では割り込めない（2026-09-22 の声の下限 279 は切る）。
 * 🔴 取り出し口を 4（AGC あり）から 3 に下げたとき測り直さず、4 のときの 1000（残留 677・声 1880〜2632）の
 * ままにしていた。声が線に届かず、割り込めなかった（2026-09-22 ユーザー指摘）。取り出し口や倍率を
 * 変えたら、ここも測り直すこと。
 */
static constexpr float kPlaybackGateRms = 450.0f;
/** 再生中、線を越える声がこれだけ続いたら、機体の側で再生を止める（pumpMic）。 */
static constexpr uint32_t kBargeInMs = 200;
// 機体の側で割り込んだあとの返事の残りを捨てる印は dropReplyAudio（speaking の近く）

/** 再生が始まった時刻。0 なら再生していない。 */
static uint32_t playStartedMs = 0;

/**
 * 再生が終わってから、見張りを始めるまでの間。
 *
 * 🔴 会話を終えた直後に見張りを始めると、スピーカーに残っているロボットの声を
 * 拾う。ロボットは会話の中で自分の名前を言うので、それが「カタノリ」と
 * 文字起こしされて自分で起動する（2026-09-21 実機: 会話終了の直後に
 * 「区間 1.90秒 → 送る」→「カタノリ → ★呼ばれました」で勝手に会話が始まった）。
 */
static constexpr uint32_t kWatchAfterPlayMs = 1500;
/** 最後に再生が終わった時刻。 */
static uint32_t playEndedMs = 0;

static void onMicroWake();

/**
 * 試し聞きの印（シリアル `wakedry on`）。
 *
 * 入のあいだは、呼び名を聞き分けても会話へ進まない。確からしさを出して見張りへ戻るだけで、
 * Wi-Fi もサーバーも触らない。聞き分けの当たり外れを何度も測るための道で、再起動で切に戻る。
 */
static bool wakeDryRun = false;

/** 呼ばれたあと、合図の音を鳴らす機会を待っているか（onMicroWake・pumpWakeChime）。 */
static bool wakeChimePending = false;
static uint32_t wakeChimeAtMs = 0;     // 呼ばれた時刻
static uint32_t wakeQuietSinceMs = 0;  // 静かになった時刻（0 = 話している）
static constexpr uint32_t kWakeChimeQuietMs = 600;     // これだけ静かなら言い終えた
static constexpr uint32_t kWakeChimeTimeoutMs = 8000;  // 静かにならなくても鳴らす
static constexpr uint32_t kWakeContinueMs = 300;       // 聞き分けたあとこれだけ声が続いたら一息で続けた
static constexpr uint32_t kWakeWaitVoiceMs = 250;      // 待っている間、これだけ声が続いたら話しかけられた
static bool wakeEngagedInline = false;                 // 一息で続けた（待たせる声は出さない）
static float vadThreshold();

/*
 * 眠っている間に呼ばれたときの、待たせる声の段階。
 *
 * 🔒 ユーザー 2026-09-22「『ちょっと起きたばかりだから待ってね』とか言わせないとまずい。
 * Wifi繋いだら『Wifiがつながったからあと少し』。API繋ぐのに時間が掛かるから繋がったら
 * 『おまたせ！』とか言わさないと」。眠ると無線を止めているので、呼ばれてから話せるまでに
 * Wi-Fi とサーバーの 2 つを待つ。黙っていると、届いていないと思って呼び直される。
 * 声は機体に焼いてある（VoiceClips.h・会話と同じ Gemini Live の声）。
 *
 * 🔒 ユーザー 2026-09-22「ちょっと待ってねは辞めようかね。LEDに出すだけならいいのでは」
 * 「（ワイファイがつながったよも）画面だけ」「その間に声があったら音出してほしい」。
 * 誤爆のたびに声が出るとバレるので、ふだんは画面だけで待たせる。待っている間に話しかけ
 * られたら（wakeEngaged・pumpWakeEngage）、そこから前と同じく声で待たせる。
 *
 *   0: 何もしていない
 *   1: 呼ばれた。画面に「ちょっと／まってね」を出し、言い終えるのを待って無線を戻す
 *      （pumpWakeChime）。画面は Gemini まで来るまで出す（pumpAutoConnect）
 *   2: Wi-Fi を待つ。話しかけられたら「ちょっと待ってね、いま起きたところ」。
 *      Wi-Fi がつながったら画面を「あと／すこし」へ。話しかけられていれば声でも
 *      「ワイファイがつながったよ、あと少し」
 *   3: Gemini を待つ。話しかけられたら「ちょっと待ってね、いま起きたところ」
 *   Gemini まで来たら、話しかけられていて、しかも前の声から 2 秒以上待たせたときだけ「おまたせ！」
 * 声を鳴らしている間のマイクは控えに入れない（pumpMic）ので、自分の声は Gemini へ行かない。
 * 変数（sleepWakeStage）は、無線を戻す pumpPowerDown が見るので、上の待機スリープの節に置く。
 */

/*
 * 呼ばれたあとも少しのあいだ聞き分けを回し、確からしさの最大をログに出す。
 *
 * 🔴 聞き分けは、しきい値を越えた最初の瞬間に「呼ばれた」と返す。その値だけを出していた
 * ころは 0.70〜0.86 と、しきい値のすぐ上の数字しか並ばず、「機体では余裕が無い」と
 * 読み違えた（2026-09-22。同じ日・同じ機体の試験用ファームで最大を追うと 0.915〜1.000）。
 */
static uint32_t wakePeakUntilMs = 0;   // 0 = 追っていない
static float wakeCrossValue = 0.0f;    // 越えた瞬間の値
static constexpr uint32_t kWakePeakTrackMs = 600;

/**
 * 言い終えて一息ついたところで、呼ばれたのに気づいた合図を鳴らす。
 *
 * 🔒 ユーザー 2026-09-21「品の良い音、木を２回叩いたような音」（機体を見ていないときにも分かる）。
 * 鳴らす時刻は、呼び名とその続きを言い終えた後（onMicroWake の説明）。
 */
static void pumpWakeChime(const int16_t* pcm, size_t n) {
    if (!wakeChimePending) {
        return;
    }
    double acc = 0.0;
    for (size_t i = 0; i < n; ++i) {
        acc += (double)pcm[i] * (double)pcm[i];
    }
    const float rms = (float)sqrt(acc / n);
    const uint32_t now = millis();
    if (rms >= vadThreshold()) {
        wakeQuietSinceMs = 0;
    } else if (wakeQuietSinceMs == 0) {
        wakeQuietSinceMs = now;
    }
    const bool quiet = wakeQuietSinceMs != 0 && now - wakeQuietSinceMs >= kWakeChimeQuietMs;
    // 眠りから呼ばれたときは、この声を鳴らすまで無線を戻さない（pumpPowerDown）。長く待たない
    const uint32_t timeoutMs = sleepWakeStage == 1 ? 2000 : kWakeChimeTimeoutMs;
    if (quiet || now - wakeChimeAtMs >= timeoutMs) {
        wakeChimePending = false;
        if (sleepWakeStage == 1) {
            // 🔒 ユーザー 2026-09-22「ちょっと待ってねは辞めようかね。LEDに出すだけならいいのでは」。
            // 誤爆のたびに声が出るとバレる。画面の「ちょっと／まってね」は onMicroWake で出してある。
            // 言い終えるまで無線を戻さない待ちはそのまま（探索の約 3 秒は main loop がマイクを読めない）
            Serial.println("[WAKE] 言い終えました。無線を戻します（声は出さない）");
            sleepWakeStage = 2;
            if (!wakeEngaged) {
                katanori::audioIo.armVoiceWatch(kWakeWaitVoiceMs);  // ここからは待っている間の声を見る
            }
        } else {
            announce(katanori::chimes::WAKE_ACK, katanori::chimes::WAKE_ACK_SAMPLES,
                     "呼ばれたのに気づきました");
        }
    }
}

/**
 * 眠りから呼ばれたあと、話しかけられたか（wakeEngaged）。main loop から毎回呼ぶ。
 *
 * 声が続いたかはマイクのタスクが数える（AudioIo::armVoiceWatch）。ここは印を受け取るだけ。
 * ・段階 1（聞き分けたあと、言い終える前）に声が 300ms 続いた＝「カタノリ、今日の天気は？」と
 *   一息で続けた。控え（続きの言葉）を送る。待たせる声は出さない（言いかけの途中に重なる）
 * ・段階 2 以降（言い終えて待っている間）に声が 250ms 続いた＝話しかけられた。
 *   「ちょっと待ってね」から声で待たせる
 * 音量で見ているので、テレビの声も話しかけられたと数える。
 */
/**
 * 再生中に話しかけられて、マイクのタスクが止めた（AudioIo::armBargeIn）。main loop から毎回呼ぶ。
 *
 * 🔴 Gemini が返事を作り終えたあと（generationComplete）は「interrupted」が来ないので、たまった返事を
 * 最後まで鳴らし続けていた。🔒 ユーザー 2026-09-22「こっちが喋ってるのに無視されてるようでかなり心象がわるい」
 * 「ブツっと切らずに音量下げればいい」。止めるのはタスク、ここは状態を合わせるだけ。
 */
static void pumpBargeIn() {
    katanori::audioIo.armBargeIn(kPlaybackGateRms, kBargeInMs);
    // 再生中の声の残り方を測る（AudioIo::takeLevels）。0.3 秒ごとの最大を出す
    static uint32_t lvlMs = 0;
    if (millis() - lvlMs >= 300) {
        lvlMs = millis();
        float c0 = 0.0f, c1 = 0.0f;
        bool played = false;
        katanori::audioIo.takeLevels(c0, c1, played);
        if (played || c0 >= 150.0f) {
            Serial.printf("[LVL] %s ch0最大=%.0f ch1最大=%.0f\n", played ? "再生中" : "鳴っていない", c0, c1);
        }
    }
    if (!katanori::audioIo.takeBargeIn()) {
        return;
    }
    Serial.println("[TURN] 話しかけられたので、音量を下げて返事を止めました");
    dropReplyAudio = speaking && !turnComplete;  // 作っている途中なら、続きが届いても鳴らさない
    speaking = false;
    turnComplete = false;
    robot.injectEvent(katanori::RobotEvent::SPEECH_DONE);
}

static void pumpWakeEngage() {
    if (sleepWakeStage == 0) {
        return;
    }
    katanori::audioIo.setVoiceThreshold(vadThreshold());
    if (wakeEngaged || !katanori::audioIo.takeVoiceFired()) {
        return;
    }
    wakeEngaged = true;
    katanori::audioIo.armVoiceWatch(0);
    if (sleepWakeStage == 1) {
        wakeEngagedInline = true;
        Serial.println("[WAKE] 呼び名に続けて話しています（控えを送ります・待たせる声は出さない）");
    } else {
        Serial.println("[WAKE] 待っている間に話しかけられました。声で待たせます");
        announce(katanori::clips::WAKE_FROM_SLEEP, katanori::clips::WAKE_FROM_SLEEP_SAMPLES,
                 "ちょっと待ってね、いま起きたところ");
    }
}

/** 眠りから呼ばれたあとの、待たせる声の続き（sleepWakeStage の説明）。main loop から毎回呼ぶ。 */
static void pumpSleepWakeStages() {
    static uint32_t readyAtMs = 0;    // Gemini の準備ができた時刻
    static uint32_t quietAtMs = 0;    // 前の声を言い終えた時刻
    if (sleepWakeStage < 2) {
        readyAtMs = 0;
        quietAtMs = 0;
        return;
    }
    const uint32_t now = millis();
    if (katanori::netLink.wsReady() && readyAtMs == 0) {
        readyAtMs = now;
    }
    if (katanori::audioIo.isPlaying()) {
        quietAtMs = 0;
        return;
    }
    if (quietAtMs == 0) {
        quietAtMs = now;
    }
    // つながらずに諦めた（pumpPendingTurn の上限）か、会話が別の道で終わった
    if (!pendingTurn && !katanori::netLink.wsReady()) {
        sleepWakeStage = 0;
        katanori::audioIo.armVoiceWatch(0);
        return;
    }
    if (katanori::netLink.wsReady()) {
        // 🔒 ユーザー 2026-09-22「おまたせは、あと少しから数秒かかった時だけでいい。即時流れると
        // 『別に待たなかったような・・・』って感じ」。前の声を言い終えてから 2 秒以上待たせたときだけ。
        // 声で待たせていない（話しかけられていない）ときは言わない
        if (!wakeEngaged || wakeEngagedInline) {
            Serial.println("[VOICE] 声で待たせていないので「おまたせ！」は言いません");
        } else if ((int32_t)(readyAtMs - quietAtMs) >= 2000) {
            announce(katanori::clips::WAKE_READY, katanori::clips::WAKE_READY_SAMPLES, "おまたせ！");
        } else {
            Serial.println("[VOICE] 待たせなかったので「おまたせ！」は言いません");
        }
        sleepWakeStage = 0;
        katanori::audioIo.armVoiceWatch(0);
    } else if (sleepWakeStage == 2 && katanori::netLink.wifiConnected()) {
        // 画面の「あと／すこし」は pumpAutoConnect が出す。声は話しかけられたときだけ
        if (wakeEngaged && !wakeEngagedInline) {
            announce(katanori::clips::WAKE_WIFI_UP, katanori::clips::WAKE_WIFI_UP_SAMPLES,
                     "ワイファイがつながったよ、あと少し");
        } else {
            Serial.println("[WAKE] Wi-Fi がつながりました（声で待たせていないので声は出さない）");
        }
        sleepWakeStage = 3;
    }
}

static void pumpMic() {
    static int16_t buf[512];
    static int16_t wakeBuf[512];  // 呼び名の聞き分け用（ch1 を 16 倍・AudioIo.h の wakeOut）

    if (!katanori::audioIo.isRecording()) {
        return;
    }

    // ミュートを解いた直後のポップは、控えにも入れない（drain で送られるため）
    const uint32_t unmutedAt = katanori::audioIo.unmutedAtMs();
    if (unmutedAt != 0 && millis() - unmutedAt < kUnmuteBlankMs) {
        return;
    }
    uint8_t play = katanori::AudioIo::MIC_PLAY_NONE;  // この音を録ったときスピーカーが鳴っていたか
    size_t n = katanori::audioIo.readMic(buf, sizeof(buf) / sizeof(buf[0]), wakeBuf, &play);
    if (n == 0) {
        return;
    }
    pumpWakeChime(buf, n);
    if (wakePeakUntilMs != 0) {
        katanori::microWake.feed(wakeBuf, n);  // 返り値は見ない。最大を伸ばすだけ
        if ((int32_t)(millis() - wakePeakUntilMs) >= 0) {
            wakePeakUntilMs = 0;
            Serial.printf("[WAKE] 呼び名の確からしさ 最大 %.3f（しきい値を越えた瞬間 %.3f）\n",
                          katanori::microWake.peak(), wakeCrossValue);
        }
    }

    /*
     * 鳴らしていないときの音量を、再生中の [ECHO] とまったく同じ計算で出す。
     *
     * 🔴 これが無いと「再生中の RMS 1400」がロボットの声なのか部屋の音なのか
     * 分からない。騒音床は 5 から 641 まで動くうえ VAD の追従値なので、この
     * 計算とは別物である。比べられる数字を並べて初めて切り分けられる。
     * ⚠ 見張り中も会話中も通る位置に置くこと（手前の分岐で return される）。
     */
    if (!katanori::audioIo.isPlaying()) {
        static uint32_t quietProbeMs = 0;
        if (millis() - quietProbeMs >= 1000) {
            quietProbeMs = millis();
            double qacc = 0.0;
            for (size_t i = 0; i < n; ++i) {
                qacc += (double)buf[i] * (double)buf[i];
            }
            Serial.printf("[QUIET] 鳴らしていないときRMS=%.0f\n", sqrt(qacc / n));
        }
    }

    // 計測モード中は数えるだけ。送らない。
    if (vadMeasuringActive()) {
        vadFeed(buf, n);
        return;
    }

    // 待機中の見張り。呼び名は機体の中で聞き分け、会話の頭は控えに貯める（WakeWatch.h）。
    // ここで DO へは送らない。会話はまだ始まっていない
    if (vadWatchingActive()) {
        // 合図を鳴らしている間に録った音は貯めない。控えに入れると drain で送られ、
        // Gemini が「人が喋った」と見なして応答を割り込みで捨てる（録った時点の印で見る）
        if (play == katanori::AudioIo::MIC_PLAY_NONE) {
            katanori::wakeWatch.feed(buf, n);
            vadFeed(buf, n);
            // 呼び名は機体の中で聞き分ける（MicroWake.h）。クラウドへは送らない
            if (katanori::microWake.feed(wakeBuf, n)) {
                onMicroWake();
            }
        }
        return;
    }

    /*
     * 再生中は、AEC の残留を送らない。
     *
     * ReSpeaker の AEC は 28〜39dB 引いている（2026-09-21 実測: 再生開始直後の
     * RMS 8000〜13000 が、収束後は 134〜677 になる）。引けないのは適応フィルタが
     * 係数を学習するあいだで、無音のあとに音が始まるたびに 0.3〜0.6秒 かかる。
     *
     * 🔴 そこを送ると、Gemini が自分の声を「人が喋った」と見なして、始めたばかりの
     * 応答を割り込みとして捨てる。実機では毎ターン起きていた（generationComplete の
     * 直後に必ず ACTIVITY_START → interrupted）。
     *
     * ⚠ 「喋っている間ずっと送らない」ではない（2026-09-12 にユーザーが外した
     * エコーガードはそれで、人の割り込みまで殺していた）。収束前の 600ms を避け、
     * そのあとは残留（最大 677）を超える音だけ通す。0.6秒たてば割り込める。
     */
    if (!katanori::audioIo.isPlaying()) {
        if (playStartedMs != 0) {
            playEndedMs = millis();  // 見張りを始めるのはここから少し置いて
        }
        playStartedMs = 0;  // 次に鳴り始めたところから測り直す
    }
    if (play != katanori::AudioIo::MIC_PLAY_NONE) {
        if (playStartedMs == 0) {
            playStartedMs = millis();
        }
        double acc = 0.0;
        for (size_t i = 0; i < n; ++i) {
            acc += (double)buf[i] * (double)buf[i];
        }
        const float rms = (float)sqrt(acc / n);

        // 残留とつまみの位置を並べて出す。飽和で AEC が効かなくなる境目を
        // 押さえるため（2026-09-21・音量を下げると割り込みが消えた）
        static uint32_t echoProbeMs = 0;
        if (millis() - echoProbeMs >= 300) {
            echoProbeMs = millis();
            Serial.printf("[ECHO] 残留RMS=%.0f  つまみ=%d%%  再生から%ums\n",
                          rms, knobPercent, (unsigned)(millis() - playStartedMs));
        }

        if (play == katanori::AudioIo::MIC_PLAY_SETTLING) {
            return;  // 収束前（またはつまみを回した直後）に録った音。自分の声しか入っていない（録った時点の印で見る）
        }
        if (rms < kPlaybackGateRms) {
            return;  // 残留の範囲。人が喋っていない
        }
        // 話しかけられたら機体の側で止めるのはマイクのタスク（AudioIo::armBargeIn）。ここは送るだけ
    }

    // 喋っている最中も送る（声で割り込める・仕様書 2章）。AEC が消した後の信号なので、
    // 自分の声は Gemini に届かない前提。切り分けのときだけ `echoguard` で止められる
    if (play != katanori::AudioIo::MIC_PLAY_NONE && echoGuardEnabled) {
        return;
    }
    // 会話中も控えに流しておく。繋ぎ直しになっても頭から出し直せる
    katanori::wakeWatch.feed(buf, n);

    // 🔴 控えを出し切るまでは、ここから送ってはいけない。
    // 繋がった瞬間からライブで送ると、直後の drainToNetLink() が同じところを
    // もう一度送って二重になる（実機で「肩乗り 聞こえますか？」が2回届いた）。
    // 出し切るまでは貯めるだけにして、drain の後からライブに切り替える
    if (katanori::wakeWatch.hasTurn()) {
        return;
    }
    katanori::netLink.sendAudio(buf, n);
}

// ---------------------------------------------------------------------------
// VAD計測モード
//
// ウェイクワードを「クラウドで文字にして照合する」方式にするなら、費用は
// 「1日に何分ぶん送るか」だけで決まる。単価は音声1分あたり $0.00051
// (Cloudflare Workers AI whisper-large-v3-turbo, 2026-07時点) なので、
// 発話が1日1時間なら月140円ほど。費用は問題にならない。
//
// 分からないのは「実際の部屋で何分になるか」。テレビや家族の会話でVADが開けば
// そのぶん増える。ここは推測しても意味がないので実測する。
//
// このモードは音声をどこにも送らない。ローカルで有声区間を数えるだけ。
// ここで作るVADは、方式を採用した場合そのまま送信の判断に使える。
// ---------------------------------------------------------------------------

/** 計測中か。 */
static bool vadMeasuring = false;

static bool vadMeasuringActive() {
    return vadMeasuring;
}

/** 騒音床の測定に使う時間。この間は判定しない。 */
static constexpr uint32_t VAD_CALIBRATE_MS = 2000;
/** 騒音床の何倍を超えたら有声とみなすか。 */
static constexpr float VAD_MARGIN = 3.0f;
/** 静かすぎる部屋で騒音床が0近くになったときの下限。 */
/*
 * 🔴 AGC を外したので下げた（60 → 20・2026-09-21）。
 *
 * 60 は AGC があった頃の値で、あのときは騒音床が 12〜641 で動いていたから
 * 「床が低く測られすぎたときの保険」として意味があった。AGC を切ったあとは
 * 床が 1〜2 まで下がり、60 は床の30〜60倍にあたる。本来の検出線は床×3 なので
 * 3〜6 であるべきところで、**声を出しても検出線を越えなかった**
 * （実機で画面の棒が縦線に届かず、区間が1つも立たなかった）。
 *
 * 20 の根拠: 静かなときの実測が RMS 1〜11。そこを越えず、遠い声（121）も
 * 近い声（922）も区間にはなる。遠い声はこのあとのゲートで落とす。
 * ⚠ サンプルが少ない（遠い1件・近い1件）。測り直して詰める。
 */
static constexpr float VAD_MIN_THRESHOLD = 20.0f;
/**
 * 装着者ゲートの既定値（騒音床の何倍）。
 *
 * 実測(2026-07-26, 肩乗り・横に家族):
 *   家族の相槌   RMS 1856〜4287 (床の4〜9倍)
 *   装着者の発話 RMS 7242・22033 (床の15〜47倍)
 * 倍以上の差がある。口がマイクに近いぶんだけ大きく入るため。
 * この差で「装着者が喋ったか」を切り分ける。長さでは切り分けられない
 * （装着者の5秒の発話と家族の短い相槌が、長さでは逆に出る）。
 */
static constexpr float VAD_GATE_MARGIN = 13.0f;

/*
 * ゲートの下限。
 *
 * 🔴 検出線の下限（VAD_MIN_THRESHOLD）と分けること。以前は同じ値を使っていたが、
 * 検出線は「音があるか」、ゲートは「装着者が喋ったか」で役目が違う。AGC を外して
 * 床が 1〜2 になると「床の何倍」が意味を失う（どんな物音でも数十倍になる）ので、
 * ゲートは絶対値で押さえる。
 *
 * 200 の根拠（2026-09-21・AGC なし・ゲイン16 の実測）: 呼びかけが 288 で通る
 * 必要がある（300 だと落ちた）。遠い声は 121。
 * ⚠ 咳は 921 まで出るので、音量では落とせない。立ち上がりの速さで分ける
 * （vadSegPeakMs）。
 */
static constexpr float VAD_MIN_GATE = 200.0f;

/** これだけ続けて超えたら発話開始とみなす（単発の物音を弾く）。 */
static constexpr uint32_t VAD_ATTACK_MS = 96;
/** これだけ続けて下回ったら発話終了とみなす（語間の息継ぎで切らない）。 */
static constexpr uint32_t VAD_RELEASE_MS = 500;

/**
 * 1区間の上限。これを超えたら打ち切る。
 *
 * 騒音床を1回しか測らない作りだと、部屋が少し騒がしくなった時点で「声が
 * 続いている」と判断したまま永久に閉じなくなる（実測で2分間無反応になった）。
 * 呼びかけでも会話でも10秒は超えないので、超えたら打ち切って床を測り直す。
 */
static constexpr uint32_t VAD_MAX_SEGMENT_MS = 10000;

/**
 * 1区間の下限。これより短い区間は送らない。
 *
 * 単発の物音（0.1〜0.2秒）を落とすための下限である。
 *
 * 🔴 0.5秒にしてはいけない。
 * 2026-09-21 の実測（docs/WAKEUP.md 付録D）で 1m の本人が 0.80〜2.32秒だったのを
 * 根拠に 500 にしたが、あれは「3秒くらいの長めの発話」を頼んで取った値だった。
 * 呼び名だけを短く言うと 0.36秒 にしかならず、**呼びかけそのものが落ちた**
 * （実機で「カタノリ」が判定に出ず、顔も動かなかった）。
 *
 * 3m の誤検知も 0.36秒 だったので、長さでは分けられない。誤って通ったぶんは
 * クラウドで「呼び名が入っていない」と判定されて落ちる。費用は文字起こし
 * 1回ぶんで済むので、呼びかけを取りこぼすより安い。
 *
 * ⚠ 「呼びかけは短い」という長さの判定とは別物である。あちらは実測で逆に出て
 * 捨てた（装着者の5秒の発話と家族の0.2秒の相槌が逆になる）。ここで見ているのは
 * 喋った長さではなく、音が検出線を割らずに続いた時間である。
 */
static constexpr uint32_t VAD_MIN_SEGMENT_MS = 300;

/*
 * ❌ 「山までの時間で咳を落とす」は効かなかった（2026-09-21・判定から外した）。
 *
 * 1回目の咳は 0ms（1フレーム以内にピーク）で、呼びかけの 104ms と分かれて
 * 見えた。ところが次の咳は 542ms・553ms と出た。区間が複数の音をまとめたり、
 * 咳の後に息や声が続いたりすると「頭からピークまで」は意味を失う。
 * 計測（ログの「山まで○ms」）だけは残す。判定に戻すなら、区間の頭の
 * 数フレームの上がり方を見るなど、測り方から作り直すこと。
 */

/**
 * 騒音床の追従の速さ（静かなフレーム1つあたり）。
 *
 * 部屋の静けさは時間で変わる。ReSpeaker側の自動音量調整でも絶対値が動く
 * （実測で床が38〜469まで12倍動いた）。1回測って固定にはできない。
 */
static constexpr float VAD_FLOOR_ADAPT = 0.02f;

/**
 * 床を実勢へ寄せ直す間隔。
 *
 * 🔴 「静かなあいだだけ少しずつ追従」では足りない。
 * 起動直後の2秒で測った床が実勢とずれていると（実機では床 2〜5 に対して
 * 環境音が 100〜300 あった）、検出線を割る瞬間が来ないので「静か」と判定
 * されず、追従が一度も掛からない。区間が閉じないまま 10秒 の打ち切りを
 * 待つことになり、その間の呼びかけは全部取りこぼす。
 *
 * この窓の中の最小 RMS を見て、発話中でも床を寄せ直す。
 */
static constexpr uint32_t VAD_FLOOR_WINDOW_MS = 5000;
/** 報告の間隔。 */
static constexpr uint32_t VAD_REPORT_MS = 60000;

/** 音声1分あたりの単価(USD)。上記コメントの出典と揃えること。 */
static constexpr float STT_USD_PER_MIN = 0.00051f;
/** 月額の目安を円で出すための為替。厳密さは不要（桁を知りたいだけ）。 */
static constexpr float USD_JPY = 150.0f;

static uint32_t vadStartMs = 0;
static uint32_t vadLastReportMs = 0;
static float vadNoiseFloor = 0.0f;
/** 直前に読んだフレームの音量。計測モードの画面が見る。 */
static float vadLastRms = 0.0f;
/** 窓の中でいちばん静かだったところ。0 は未取得。 */
static float vadFloorMin = 0.0f;
static uint32_t vadFloorWindowMs = 0;
static uint32_t vadCalibratedMs = 0;
static uint32_t vadCalibrateFrames = 0;
static bool vadInSpeech = false;
static uint32_t vadAboveMs = 0;
static uint32_t vadBelowMs = 0;
/*
 * 区間ごとのピーク音量。
 *
 * 肩乗りなので、装着者の声は口の近くから入り、周囲の音より大きく入る。
 * 「呼びかけかどうか」を音量と長さで切り分けられるかを見るために、
 * 区間ごとの実測値を出す。しきい値はこの数字を見てから決める。
 */
static float vadSegPeakRms = 0.0f;
/**
 * 区間の頭からピークに達するまでの時間 [ms]。
 *
 * 咳は 10〜30ms でピークに達するが、声は母音が立ち上がるまでに 100ms 以上かかる。
 * 音量では分けられない（実機で呼びかけ 288 に対して咳が 921）ので、ここで分ける。
 */
static uint32_t vadSegPeakMs = 0;

/**
 * 装着者ゲート。この音量を超えた区間だけ「装着者が喋った」とみなす。
 *
 * 0 なら騒音床 × VAD_GATE_MARGIN を使う。`vadth <値>` で直接指定、
 * `vadme` で自分の声を測って自動設定する。
 */
static float vadGateRms = 0.0f;

/** ゲートを通った区間の数と時間（これが実際にクラウドへ送る量になる）。 */
static uint32_t vadGatedSegments = 0;
static uint32_t vadGatedMs = 0;

/*
 * 正解ラベル。
 *
 * しきい値を決めるには「どの区間が装着者の声だったか」が要る。ログの数字だけ
 * では判断できず、勘で動かすことになる（実測で 1260〜1674 の帯がどちらとも
 * つかず行き詰まった）。
 *
 * 計測中はボタンを「今喋っているのは自分」の目印として使う。押しながら喋れば
 * その区間は自分、押さなければ周囲として集計し、境界を機体に計算させる。
 */
static bool vadLabelSelf = false;
/**
 * シリアルから切り替えたラベル。
 *
 * XIAOのBOOTボタンは基板上の小さなスイッチで、押しながら喋るのは現実的でない。
 * モニタを開いているなら `me` と打って切り替えるほうが楽なので両方使えるようにする。
 */
static bool vadLabelSelfLatched = false;
/** 今の区間中に一度でも「自分」とされたか。 */
static bool vadSegLabeled = false;
static uint32_t vadSelfCount = 0;
static uint32_t vadOtherCount = 0;
/** 自分の声の最小と、周囲の最大。この2つの間が、しきい値の置ける範囲。 */
static float vadSelfMinRms = 0.0f;
static float vadOtherMaxRms = 0.0f;

/** 区間中の最小音量。打ち切ったときに騒音床を測り直すのに使う。 */
static float vadSegMinRms = 0.0f;

/*
 * 低域比（近接効果）。
 *
 * 口がマイクに近いほど低い周波数が持ち上がる。これは距離で決まる物理現象なので、
 * 遠くの人が大声を出しても真似できない。音量だけでは「近くの小声」と「遠くの
 * 大声」が同じに見えるが、低域比なら分けられる可能性がある。
 *
 * マイク2本の方向検知が使えれば一番良かったが、この機体では取り出せない
 * （DOAは4マイクの上位機の機能で、I2Sから来るのは処理済みの音声）。
 * 1本のマイクで距離の手がかりを得る代わりの手段。
 *
 * XMOS側のノイズ抑制が低域を削っている可能性があるので、効くかどうかは実測で判断する。
 */
static constexpr float VAD_LPF_ALPHA = 0.111f; // 一次ローパス ≒ 300Hz @16kHz
static float vadLpfState = 0.0f;
static double vadSegLowEnergy = 0.0;
static double vadSegTotalEnergy = 0.0;
/** 直近の区間の低域比（0〜1）。1に近いほど低音寄り＝近い。 */
static float vadSegLowRatio = 0.0f;
/** ラベルごとの低域比の合計と数（平均を出すため）。 */
static double vadSelfLowSum = 0.0;
static double vadOtherLowSum = 0.0;
/** 最後に音量を表示した時刻。無反応のとき原因を見えるようにするため。 */
static uint32_t vadLastLevelMs = 0;
/** 音量の表示間隔。 */
static constexpr uint32_t VAD_LEVEL_MS = 5000;

/** 自分の声を測っている最中か（`vadme`）。 */
static bool vadEnrolling = false;
static uint32_t vadEnrollStartMs = 0;
static float vadEnrollPeak = 0.0f;
/** 測った自分の声のピークに対して、この割合をゲートにする。 */
static constexpr float VAD_ENROLL_FACTOR = 0.35f;
/** 自分の声を測る時間。 */
static constexpr uint32_t VAD_ENROLL_MS = 4000;

/** 現在有効なゲート音量。 */
static float vadGate() {
    if (vadGateRms > 0.0f) {
        return vadGateRms;
    }
    const float g = vadNoiseFloor * VAD_GATE_MARGIN;
    return g > VAD_MIN_GATE ? g : VAD_MIN_GATE;
}
// 直近の報告区間ぶん
static uint32_t vadSegments = 0;
static uint32_t vadVoicedMs = 0;
// 計測開始からの累計
static uint32_t vadSegmentsTotal = 0;
static uint32_t vadVoicedMsTotal = 0;
static uint32_t vadLongestMs = 0;
static uint32_t vadCurrentMs = 0;

static void vadReport(bool final) {
    const uint32_t elapsed = millis() - vadStartMs;
    if (elapsed == 0) {
        return;
    }
    // 費用はゲートを通った分だけで決まる（送るのはそれだけなので）
    const float ratio = (float)vadGatedMs / (float)elapsed;
    // この割合で1日中身に着けていたら、という換算
    const float minPerMonth = ratio * 60.0f * 24.0f * 30.0f;
    const float yen = minPerMonth * STT_USD_PER_MIN * USD_JPY;

    Serial.printf(
        "[VAD] %s %.1f分 | 検出 %u回/%.1f秒 → ゲート通過 %u回/%.1f秒 (%.1f%%) | "
        "騒音床RMS=%.0f ゲート=%.0f | 送るぶんの月額目安 約%.0f円\n",
        final ? "計測終了" : "報告",
        elapsed / 60000.0f,
        (unsigned)vadSegmentsTotal, vadVoicedMsTotal / 1000.0f,
        (unsigned)vadGatedSegments, vadGatedMs / 1000.0f, ratio * 100.0f,
        vadNoiseFloor, vadGate(),
        yen);

    // 正解を付けた区間があれば、しきい値の置ける範囲を出す
    if (vadSelfCount == 0 && vadOtherCount == 0) {
        return;
    }

    Serial.printf("[VAD] 正解ラベル 自分%u回(最小RMS=%.0f) / 周囲%u回(最大RMS=%.0f)  → ",
                  (unsigned)vadSelfCount, vadSelfMinRms,
                  (unsigned)vadOtherCount, vadOtherMaxRms);
    if (vadSelfCount == 0) {
        Serial.println("自分の声が未記録。'me' で【自分】にしてから喋ってください");
        return;
    }
    if (vadOtherCount == 0) {
        Serial.printf("周囲が未記録。暫定ゲート %.0f\n", vadSelfMinRms * 0.7f);
        return;
    }

    if (vadSelfMinRms > vadOtherMaxRms) {
        // 綺麗に分かれている。真ん中に置けば両方満たせる
        Serial.printf("音量で分離できています。推奨ゲート %.0f\n",
                      (vadSelfMinRms + vadOtherMaxRms) / 2.0f);
    } else {
        // 重なっている。音量だけではどちらかを取りこぼす
        Serial.printf("重なっています(%.0f〜%.0f)。音量だけでは分けられません\n",
                      vadSelfMinRms, vadOtherMaxRms);
    }

    // 低域比（近さの手がかり）が音量の代わりになるかを見る
    const float selfLow = (float)(vadSelfLowSum / vadSelfCount);
    const float otherLow = (float)(vadOtherLowSum / vadOtherCount);
    Serial.printf("[VAD] 低域比の平均 自分=%.2f / 周囲=%.2f  → %s\n",
                  selfLow, otherLow,
                  selfLow > otherLow * 1.15f
                      ? "近接効果が出ています。距離の手がかりとして使えます"
                      : "差がありません。低域比は使えません");

    vadSegments = 0;
    vadVoicedMs = 0;
}

/**
 * 区間を1つ閉じて集計・表示する。
 *
 * @param forced 上限に達して打ち切った場合。声ではなく騒音の可能性が高い。
 */
static void vadCloseSegment(bool forced) {
    vadInSpeech = false;

    // 語尾判定に使った無音は長さから戻す（実際に声が出ていた分だけ見る）
    const uint32_t voicedMs =
        vadCurrentMs > VAD_RELEASE_MS ? vadCurrentMs - VAD_RELEASE_MS : vadCurrentMs;
    vadVoicedMs += vadCurrentMs;
    vadVoicedMsTotal += vadCurrentMs;
    if (vadCurrentMs > vadLongestMs) {
        vadLongestMs = vadCurrentMs;
    }

    /*
     * 判定は音量だけで行う。長さでは切り分けられない（実測で、装着者の5秒の
     * 発話と家族の0.2秒の相槌が、長さでは逆の判定になった）。
     *
     * 見るのは絶対値ではなく騒音床との倍率。ReSpeaker側の自動音量調整で
     * 絶対値は動くが、倍率は安定している（実測で床が38〜469まで動いても
     * 自分15〜58倍 / 周囲4〜10倍 の帯は変わらなかった）。
     */
    const float ratio = vadNoiseFloor > 1.0f ? vadSegPeakRms / vadNoiseFloor : 0.0f;
    vadSegLowRatio = vadSegTotalEnergy > 0.0
                         ? (float)sqrt(vadSegLowEnergy / vadSegTotalEnergy)
                         : 0.0f;
    const bool loudEnough = !forced && vadSegPeakRms >= vadGate();
    const bool longEnough = voicedMs >= VAD_MIN_SEGMENT_MS;
    const bool passed = loudEnough && longEnough;
    if (passed) {
        ++vadGatedSegments;
        vadGatedMs += vadCurrentMs;
    }
    // 正解が付いていれば、しきい値決めの材料として集計する（打ち切りは除く）
    if (!forced) {
        if (vadSegLabeled) {
            ++vadSelfCount;
            vadSelfLowSum += vadSegLowRatio;
            if (vadSelfMinRms == 0.0f || vadSegPeakRms < vadSelfMinRms) {
                vadSelfMinRms = vadSegPeakRms;
            }
        } else {
            ++vadOtherCount;
            vadOtherLowSum += vadSegLowRatio;
            if (vadSegPeakRms > vadOtherMaxRms) {
                vadOtherMaxRms = vadSegPeakRms;
            }
        }
    }

    Serial.printf("[VAD] 区間 %.2f秒  音量RMS=%.0f (床の%.1f倍)  低域比=%.2f  山まで%ums  [%s]  → %s\n",
                  voicedMs / 1000.0f, vadSegPeakRms, ratio, vadSegLowRatio,
                  (unsigned)vadSegPeakMs,
                  forced ? "打ち切り" : (vadSegLabeled ? "自分" : "周囲"),
                  forced ? "対象外"
                         : passed       ? "送る"
                         : loudEnough   ? "送らない(短い)"
                                        : "送らない");

    vadCurrentMs = 0;
    vadBelowMs = 0;
    vadAboveMs = 0;
    vadSegPeakRms = 0.0f;
    vadSegPeakMs = 0;
    vadSegMinRms = 0.0f;
    vadSegLabeled = false;

    // 🔴 2026-09-22 から呼び名は機体の中で聞き分ける（MicroWake）。VAD の区間を whisper へ
    // 送る判定は、咳で毎回起きたので捨てた（docs/WAKEUP.md の却下したもの）
}
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
void loop() {
#if KATANORI_MIN_BOOT
    // 診断: 5秒ごとに1秒だけマイクを読む。それ以外は何もしない。
    static uint32_t lastMicMs = 0;
    if (millis() - lastMicMs >= 5000) {
        lastMicMs = millis();
        katanori::audioIo.micTest(1000);
    }
    delay(10);
    return;
#endif
    // ウォッチドッグへの「生きている」の合図（setup の KATANORI_WDT_SEC を参照）
    esp_task_wdt_reset();

    // Wi-Fi モニタ（Console.h）。打たれた行は下の handleSerial() が USB と同じに読む
    katanori::console.loop();
    handleSerial();
    handleButton();
    pumpMenu(); // メニューを 30 秒触らなければ出口へ進める・「かんりょう」を出し終えたら普段へ

    // つまみは設定モード中も読む（OFF位置の検知が pumpOutputGate の前提になる）
    pumpVolumeKnob();

    // 設定モード中も閉じ忘れが起きてはいけないので、下の early return より前に置く
    pumpOutputGate();

    // 音が出ない原因のうち、これだけは黙って起きるので常に見張る
    pumpCodecWatch();

    // 電池は眠っている間も読む（眠って何mA減ったかを見るのがこの計器の用途の1つ）
    katanori::battery.loop();

    // 落ちる直前の様子を残す（次の起動で読む。BootLog.h）。early return より前に置く
    {
        using namespace katanori::bootlog;
        Stage stage = katanori::provisioning.active() ? kProvisioning
                    : knobOff                          ? kKnobOff
                    : powerIdleAsleep                  ? kAsleep
                    : powerDimmed                      ? kDim
                                                       : kAwake;
        tick(stage, conversationActive(), katanori::netLink.wifiConnected(),
             katanori::battery.volts(), katanori::battery.milliamps(),
             katanori::battery.hasReading());
    }

    // OTA待受。疑似電源OFFや設定モードの early return より前に置く
    // (Wi-Fiが生きている限り、どの状態からでも更新を受けられるように)
    pumpOta();

    // 設定ページ（http://katanori.local/）。Wi-Fi 設定モードの間は自分で畳む
    katanori::settings.webLoop();

    // Wi-Fi設定モード中は顔も音声も止めて、設定画面だけを回す
    if (katanori::provisioning.active()) {
        katanori::provisioning.loop();
        // 自分で入った設定モードに誰も来なければ、ここで畳んで普段の枝へ戻す
        pumpProvisioningGiveUp();
        if (!katanori::provisioning.active()) {
            delay(1);
            return; // 畳んだ直後。次の周回から普段の枝（pumpPowerDown）が動く
        }

        // 変化したときだけ描き直す。QRを読ませている最中に無用な
        // 全面転送(約29ms)を挟むと読み取りの邪魔になる。
        int sig = (provShowQr ? 1 : 0) * 16 + static_cast<int>(katanori::provisioning.phase());
        if (sig != provRenderSig) {
            provRenderSig = sig;
            renderProvisioning();
        }
        delay(1);
        return;
    }

    // つまみOFF位置は疑似電源OFF、つまみONのまま放っておかれたら待機スリープ。
    // どちらも段階的に落とし、戻せば落とした分だけ復帰する。
    // 設定モードは上で return しているので、ここには来ない（設定中は画面もAPも要る）。
    pumpPowerDown();
    if ((knobOff && powerDownEnabled) || powerIdleAsleep) {
        // 通信を落とすまでの数秒はWebSocketを生かしておく。この間に戻されれば
        // 繋ぎ直しが要らない。顔とマイクは止める（OFFに見えなければ意味がない）。
        // 待機スリープ中は自動接続も止める（回すと無線が戻ってしまう）。
        if (!powerNetDown) {
            katanori::netLink.loop();
        }
        // 眠っていても呼び名は聞き分ける（機体の中で済み、無線は要らない）。呼ばれたら
        // onMicroWake が起こす（2026-09-22 まで、眠ると呼んでも起きなかった）。
        // つまみOFF（疑似電源OFF）のときは聞かない（切ったつもりの人に応えない）
        if (powerIdleAsleep && !knobOff && vadWatchingActive()) {
            pumpMic();
        }
        delay(10);
        return;
    }

    /*
     * 再生キューが満杯に近いときは受信を待たせる（NetLink::holdReceive）。
     * Gemini の返事は実時間の 2〜3 倍で届くので、長い返事はキュー（AudioIo の PLAY_BUF_PSRAM）を越える。
     * 以前は越えた分を play() が捨てていて、返事の途中が抜けた（40 秒中 10 秒。2026-09-22）。
     * 待たせれば TCP の流れが止まり、サーバー側で持つ。制御の JSON も一緒に遅れるので、
     * 幅は 0.5 秒（容量の 1.5 秒手前で待たせ、2 秒手前で再開）に留める。
     */
    {
        const size_t q = katanori::audioIo.queuedSamples();
        const size_t cap = katanori::audioIo.queueCapacitySamples();
        static bool held = false;
        if (!held && q + (size_t)KATANORI_AUDIO_RATE * 3 / 2 > cap) {
            held = true;
        } else if (held && q + (size_t)KATANORI_AUDIO_RATE * 2 < cap) {
            held = false;
        }
        katanori::netLink.holdReceive(held);
    }

    // 電源を入れるだけで会話できる状態まで自力で行き着かせる
    pumpAutoConnect();
    pumpBannerDemo(); // `bn` のときだけ動く（表示を消す pumpAutoConnect より後）

    katanori::netLink.loop();
    pumpBargeIn();
    pumpWakeEngage();  // 控えを送るかを決める印なので、startTurn（pumpPendingTurn）より先に
    pumpPendingTurn(); // setupComplete は netLink.loop() の中で届く
    pumpSleepWakeStages();
    pumpMic();
    pumpWake();
    pumpTurnState();

    // 仕様書どおり、内蔵LEDを通信中のステータス表示に使う
    static bool lastWsState = false;
    bool wsNow = katanori::netLink.wsConnected();
    if (wsNow != lastWsState) {
        lastWsState = wsNow;
        digitalWrite(KATANORI_USER_LED, wsNow ? LOW : HIGH); // アクティブLOW
    }

    static uint32_t lastFrameMs = 0;
    static uint32_t lastStatMs = 0;
    static uint32_t frameCount = 0;
    static katanori::RobotState lastState = katanori::RobotState::IDLE;

    uint32_t now = millis();

    // 自己診断パターン表示中は顔の描画で上書きしない
    if (static_cast<int32_t>(now - selfTestUntilMs) < 0) {
        delay(1);
        return;
    }

    // 応答音声の受信中は描画を間引く。OLEDの全面転送は約29msブロックするので、
    // 20FPSのままだと時間の半分以上を描画に取られて受信が追いつかない。
    uint32_t interval = katanori::audioIo.isPlaying() ? FRAME_INTERVAL_SLOW_MS
                                                      : FRAME_INTERVAL_MS;
    if ((now - lastFrameMs) >= interval) {
        lastFrameMs = now;
        robot.tick();
        ++frameCount;

        katanori::RobotState s = robot.state();
        if (s != lastState) {
            Serial.printf("[STATE] %s -> %s\n", stateName(lastState), stateName(s));
            lastState = s;
        }
    }

    // 5秒ごとの生存確認。描画が固まっていないか / メモリが減り続けていないかを見る
    if ((now - lastStatMs) >= 5000) {
        Serial.printf("[STAT] state=%s fps=%.1f heap=%uB\n",
                      stateName(robot.state()),
                      frameCount * 1000.0f / (now - lastStatMs),
                      ESP.getFreeHeap());
        lastStatMs = now;
        frameCount = 0;
    }

    delay(1);
}
