n416/katanori/hardware/pcb/v61_board.py

# -*- coding: utf-8 -*-
"""v6.1 の 1 枚基板の「動かせない物」— 外形・穴・欠き・口・立入禁止。

座標は板の左前の角が原点（X 右・Y 後ろ、mm）。世界 = 板 + (2.0, 13.5)。
出どころは hardware/case_v6_1.scad（2026-09-14 に _tmp_v61_pcbchk.scad の echo で取った）と、
筐体担当からの引き継ぎ（同日）。⚠ が付く数字は仮で、型番が決まったら置き直す。
"""

import math

ORG_W = (2.0, 13.5)          # 板 → 世界
L, W, T = 82.024, 37.4, 1.6  # 外形と板厚
# ⭐ 2026-09-16 夕: 電池のケーシング（`BAT_CASE` 6.0）が**レジンにも入った**ので、
#    板の裏は両材料とも **Z 12.0**（床まで 12.0・電池の天面 6.0 まで 6.0）になった。
#    2026-09-14 に「上げる話は取り消し」で 8.0 に戻したが、別の理由で上がったことになる。
#    トップ型 B2B-PH-K の嵌合 8.0 が入るのはこの高さのおかげである（2 章）
Z_BOT, Z_TOP = 12.0, 13.6    # 世界 Z。裏 12.0・表 13.6

# M2 φ2.2。⭐ 2026-09-16 夕に**後ろの 2 点が動いた**（🔒 筐体側「後ろ 2 点を箱の柱の芯へ寄せた」）。
#   旧 (10.0, 33.4) と (72.5, 33.4) → 新 (2.834, 33.9942) と (79.354, 34.9)。
#   世界では [[6, 17], [74.5, 17], [4.834, 47.4942], [81.354, 48.4]]。
#   🔒 **留めは 上から 3 本・下から 1 本**。下の 1 本は**左後ろ (2.834, 33.9942)** で、
#      床の裏 → 床 → 柱（rear_post）→ 板 → フラップが持つ座のナット（板の上 Z 13.6〜17.0）を一本で締める。
#      ⇒ 板から見れば 4 点とも φ2.2 の素通しで、**4 点とも板の上に頭かナットが出る**（下のナットの検査はそのまま効く）。
#   ⚠ 2026-09-14 の「左前 (4.0, 3.5) は使わない・ねじは 3 本」は**取り消し**。4 点とも使う
#   ⭐ 2026-09-16 夕の 2 回目: 前右も (72.5, 3.5) → **(79.354, 3.5)** へ（🔒 ユーザー「組む順で
#      問題にならないのなら外側に出せるでしょ？」）。72.5 は「φ7 の柱の外周 78.0 が箱の隅の柱 78.354 まで
#      0.35」で決まった数字だったが、後ろ 2 点を柱の芯へ出したときに前右だけ内側に残っていた。
#      これで右は前後とも X 79.354 でそろう
HOLES = [(4.0, 3.5), (79.354, 3.5), (2.834, 33.9942), (79.354, 34.9)]
HOLE_D, HOLE_HEAD_D = 2.2, 4.4

# 板の欠き（後ろの縁から）。[x0, y0, x1, y1]
# ⭐ 2026-09-16 夕に**両隅の大きな欠きを全廃**した（🔒 筐体側）。
#   欠きは「上から降りてくる物（蓋の足・壁の上の柱）を板が避ける」ためのもので、
#   蓋の足が**床から立つ柱**（rear_post）に置き換わり、降りてくる物が無くなった。
#   旧: (0.0, 29.9, 7.6, 37.4) と (75.854, 31.4, 82.024, 37.4) ── 合わせて 41mm² の銅が戻る
# ⭐ 2026-09-17 に**最後の 1 個も廃止**した（🔒 ユーザー「たった 0.3mm で逃げもクソもない」）。
#   残っていたのは後ろのレール（背の高い方・世界 X 1.694〜2.894）の逃げ (0.0, 37.1, 1.694, 37.4) で、
#   深さ 0.3 ── ルータの刃 φ2 では切れない形であり、**通り道にも効いていなかった**。
#   板は左の窓から差して入る（筐体の path_hub ①）ので後ろの縁 82mm 全部がレールの X を通る。
#   角だけ欠いても掃引は 0.544mm³ 残ったままだった。⇒ 逃げは筐体のレール側（`flap_rail_pcb_relief`・
#   板の通る高さだけ前の面を Y 50.6 → 51.0 へ引く）へ移し、板は**角の立った長方形**に戻した。
NOTCHES = []

# --- 位置が決まっている口 ---
# 充電の USB-C は v6 と同じ **HRO TYPE-C-31-M-12（16P・LCSC C165948）**。足跡は
# hardware/frozen/v6/pcb/katanori.pretty/ にある。胴 8.94 × 7.30 × 3.26・courtyard 10.64 × 9.42
#   口は胴の前の面（足跡の +Y）。パッドは後ろ（Y −4.045）・シェルの足は前後に 2 本ずつ（Y +1.05 と −3.13）
#   🔴 板の縁から出す長さが 2.6 を超えると前のシェルの足 2 本が板から外れる ⇒ v6 の NoFrontLegs 版を使う。
#      v6.1 は 1.53 出しなので **足 4 本の素の足跡が使える**（はんだ 4 点で殻が留まる）
USBC_Y, USBC_SHELL_W, USBC_BODY_D = 26.0, 8.94, 7.30
# USB-C が板の縁から出る長さ。**引き算で出す。数字を書き写さない。**
#   2026-09-17 まで 1.53 を書いていたが、これは筐体の usbc_out() が **右の壁**から引いた値
#   （IN_X + WALL − 0.8）だった。口を後ろの縁（ハッチ）へ移したのに値がそのままで、
#   奥まりが 0.8 のはずが 0.57 になっていた（たまたま浅い側だったので通っていただけ）。
#     ハッチの内面 ＝ 板の後縁 ＋ PCB_HATCH_GAP
#     ハッチの外面 ＝ 内面 ＋ HATCH_T（ナイロン 1.6 / レジン 2.8）
#     口の面は外面の USBC_RECESS 裏で止める（右の壁と XIAO で実績のある関係）
PCB_HATCH_GAP = 0.5
HATCH_T_NYLON, HATCH_T_RESIN = 1.6, 2.8
USBC_RECESS = 0.8


def usbc_out(nylon=True):
    """後ろの縁（ハッチ）から **胴** が出る長さ。ナイロンで奥まり 0.8 になる値 ＝ 1.3。

    ⭐ 2026-09-17 🔒 ユーザー「1.3 以下に戻して」。一度 2.5（レジン基準）にしたが、
    それだと **シェルの足 4 本が使えなくなる**。前寄りの足はパッドの外縁が口の面から
    1.800 後ろで、2.5 出すと板の縁の 0.500 外へはみ出す。1.3 なら 0.470 内側に収まる。
    ⇒ 板は 1.3。レジン（ハッチ 2.8）では奥まりが 2.5 になるので、**ハッチの外面を
      口のまわりだけ 1.2 掘って**残り肉 1.6 ＝ ナイロンと同じにする（case_v6_1.scad）。
    """
    return PCB_HATCH_GAP + HATCH_T_NYLON - USBC_RECESS
USBC_CRTYD = (10.64, 9.42)           # 参考。板の内側へ入る端は 板の座標 x 74.634
USBC_FRONT_LEG_LIMIT = 2.6           # これを超えて出すなら NoFrontLegs 版
# 角度センサ（AS5600）の芯は **SHAFT から出す**（下で定義）。ここに数字を置くと、つまみが動いたとき取り残される。
#   実際に一度取り残して、リレーとの距離の根拠（下の RELAY の注）が 2mm ずれた。2026-09-20 に式へ替えた。
#   IC 上面 Z レジン 10.7／ナイロン 14.7・磁石の下面 Z 11.8／15.8（隙間 1.1 はどちらも同じ。板の高さが 4.0 違う）
AS5600_FP = (4.9, 6.2)         # SOIC-8（リード込み・MS-012）
AS5600_CLEAR_D = 6.0           # 真上に要る空き
# 筐体の帯 0.662〜17.902 は余白込みの仮の数字だった（固いのは XIAO のピンの列 板の座標 X 2.932〜15.632・
# 2.54 間隔の 6 列で、下の 4 本と上の 3 本が 1 列を共有する）。1x07 の courtyard が板に収まるよう右へ 0.108 寄せた
# 🔒 2026-09-14: ライザー側が**裏面の L 字のメス**になったので、受けるオスのピンの列は
#    ライザーの板より後ろ（+Y）へ 2.87 ずれる（ライザーの板 1.6 ＋ L 字の胴 2.54 の半分）。
#    ⚠ 2.87 のうち 1.27 は筐体側が置いた一般値。L 字の型番が決まったら取り直す
RISER_XIAO = (0.0, 18.79, 12.105)     # courtyard の X（板の左の縁と面一）・ピンの列の y
# ⭐ 2026-09-19: 11.805 → 12.105（+0.30）。🔒 ユーザー「J1 を移動させましょう」。ライザーの表の XIAO のメスを表面実装
#    （SHOU HAN PM2.54-1xNPLT-H8.5-R・胴が板から 0.30 浮く＝足込み 8.80）にしたので、ライザーの板が 0.30 後ろへ下がり、
#    裏の L 字のメスの軸（世界 Y 25.605）がこの列（25.305）から 0.30 ずれた。板の側を合わせる（case_v6_1.scad の XSOCK_H）
RISER_OLED = (35.97, 46.13, 4.77)     # x0, x1, ピンの列の y（同上・+2.87）
# 板に立てる縦のメスソケット（2.54）。枠は KiCad 10 の Connector_PinSocket_2.54mm.pretty の courtyard
#   1x07 … courtyard 18.78 × 3.54・胴 17.78 × 2.54   1x04 … courtyard 11.16 × 3.54・胴 10.16 × 2.54
#   背 8.5（v6 の J1・J14 と同じ）。ライザーの板はこのソケットに挿さる
RISER_D = 3.54                        # courtyard の奥行（当たりを見る値）
RISER_BODY_D = 2.54                   # 胴の奥行
RISER_SOCKETS = [("XIAO", 7, 18.78, 17.78), ("OLED", 4, 11.16, 10.16)]   # 名・ピン数・courtyard 長・胴の長さ

# --- まだ置いていない口（線が残る）---
OPEN_PORTS = ["SPK IN", "SPK OUT", "会話ボタン", "リード", "電池 JST-PH"]

# --- 面積の予算 ---
# v6 の板（hub_power）の電源系 38 部品の枠の合計は 482mm2 で、配線込みで 27 x 35 に収めていた。
POWER_BLOCK = (27.0, 35.0)   # INA226 + 10mΩ シャント・MCP73871・TPS61090 + 6.8uH・入出力の C

# --- 2026-09-14 筐体から来た追加（線の行き先と、動かせる幅）---
# つまみの軸 φ7 が真上から降りてくる。板の X は下の SHAFT、世界は +ORG_W（2026-09-19 に左へ 2.0 動いた）。角度センサの φ6 より広いのでこちらで抜く
SHAFT = (62.2 - 2.0, 10.3, 7.0, 7.0)     # x, y, w, h。🔒 ユーザー 2026-09-19「2mm 移動してください」: つまみを左へ 2.0（軸のガイドの 3 本足の右前が ReSpeaker の USB の下に入るのを避ける）。U4・C42・U4 のまわりの立入禁止・電池の線の道は gen_pcb.py がここから引く。筐体の KNOB_AT も同じだけ動かすこと
# 軸のガイド（🔒 ユーザー 2026-09-19: 基板に立てる輪＋3 本足。位置は U4 の胴に被さる枠で決め、足のねじは押さえるだけ）。
#   足は軸の芯を中心に 120° 等分・半径 12。1 本は真左、残り 2 本は右の前後に対称（60°・300°）。
#   穴は取付穴と同じ M2 の φ2.2 非メッキ（新しい穴の種類を増やさない）。逃げは刷る足の側で取る。
#   🔒 ユーザー「3 本・歪な三角は取ってつけた感」→ 120° 等分。右前が ReSpeaker の USB（Z 21.2〜）の下に入るのでつまみごと左へ 2.0（SHAFT）
# 角度センサの芯 ＝ 軸の芯。つまみが動けばここも動く（数字を書かない）
AS5600 = (SHAFT[0] + SHAFT[2] / 2, SHAFT[1] + SHAFT[3] / 2)
GUIDE_R = 12.0
GUIDE_HOLES = [(round(SHAFT[0] + SHAFT[2] / 2 + GUIDE_R * math.cos(math.radians(a)), 3),
                round(SHAFT[1] + SHAFT[3] / 2 + GUIDE_R * math.sin(math.radians(a)), 3)) for a in (60, 180, 300)]
# 電源の押しボタン（🔒 ユーザー 2026-09-19: ハッチのトグル → 板の後ろの縁の押しボタン・「2 で」＝ USB-C の左隣）。
#   XKB5858-Z-E（LCSC C780038・横向き・自己保持・DPDT・押し子 5.0）。1–3 番が「離して閉・押し込んで開」なので EN・GND はこの 2 本（1 GND・3 EN）
#   ⭐ 同日、押し子 2.5 の -75（C780035）から替えた（🔒 ユーザー「キャップがつかない」: 押し子に被せる筒が 0.3 しか掛からない）
#   （1–3 が「出ている間に閉」の根拠: 📄 CIRCUIT DIAGRAM（RELEASE で 1–3・LOCK で 2–4。4–6・2–5 は常に結ばれた同じ端子）と、📄 PCB LAYOUT のピンの前後（1・3 は胴の前寄り、2・4 はその 2.0 後ろ）。動く接点は押し子と一緒に前後し、出ていると前の 1・3、押し込むと後ろの 2・4 をつなぐ。2 つの図が同じことを言う）。
#   置き方: 胴の前の面（足形の原点から −3.70）を板の後ろの縁から PWR_INSET 内側へ下げる。
#     PWR_INSET 2.8 の出どころ（筐体・世界）: キャップの顔は切れているとき壁の外面（ナイロン 53.0）から 1.0 出る ＝ 54.0。
#     顔の厚み 0.9 ⇒ 押し子の先 53.1 ⇒ 胴の前の面 53.1 − 5.0 ＝ 48.1 ＝ 板 34.6 ＝ 縁 37.4 の 2.8 内側（case_v6_1.scad の PWR_CAP_*）
#   X 25.5 ＝ 世界 27.5（USB-C の左隣）。🔒 ユーザー 2026-09-19「もうすこし USB から離さないとおかしい」: 29.5 → 25.5（口の面取りの縁どうし 1.2 → 5.2）
PWR_INSET = 2.8
PWR_BTN = (25.5, 37.4 - PWR_INSET - 3.70, 0)     # 足形の原点 x, y と角度（0 で押し子が +Y ＝ 後ろ）
# リレーは前（−Y）へ 2.5 動かすと軸に当たる／右は板の座標 76.354 から箱の隅の柱
RELAY_LIMIT_FRONT, RELAY_LIMIT_RIGHT = 2.5, 76.354

# 線の行き先（板の座標。世界 = 板 + (2.0, 13.5)）
WIRE_TARGETS = {
    "SPK IN":  (77.44, 6.37, "ReSpeaker の J2・右の前・Z 24.50"),
    "SPK OUT": (9.16, 11.30, "スピーカーの線の出口・左・Z 46.35"),
    "会話ボタン": (16.65, 22.80, "端子 2 本（板の座標 x 11.57 と 21.73）・左寄り・下向き"),
    "リード":  (65.70, 28.30, "つまみの台座のリードの穴・右の後ろ・Z 52.45"),
    "電池":    (66.05, 13.90, "板の真下。⭐ 2026-09-16 夕に BAT_RZ 90 → 270 でタブが**右**の短い辺へ移った（板の座標 x 66.05 ＝ 世界 68.05・Y は電池の芯 世界 27.4 ＝ 板 13.9）"),
}
# ⚠ 前の縁の外は ReSpeaker の板（世界 Y 8.185〜10.035・Z 7.5〜41.5）が立っていて空きは 3.5。前向きの口は挿せない

# JST-PH 2.0 の枠。KiCad 10 の Connector_JST.pretty の courtyard から取った（2026-09-14）
#   横出し S2B/S4B-PH-K … 6.9 × 8.6 / 10.9 × 8.6・背 4.8
#   縦    B2B/B4B-PH-K … 6.9 × 5.5 / 10.9 × 5.5・胴の背 6.0（⚠ 挿した線の曲がりは別）
PH2_H, PH4_H, PH2_V, PH4_V = (6.9, 8.6), (10.9, 8.6), (6.9, 5.5), (10.9, 5.5)
# 縦の 2 ピンを 90° 回した枠（パッドが **Y** へ並ぶ）。J10 が使う。
# 🔒 これで 8 章の極性の言い方が「手前が VBAT ＋ ／ 奥が GND」になる。
PH2_V_ROT = (PH2_V[1], PH2_V[0])   # (5.5, 6.9)
# 胴（F.Fab）の実寸。courtyard は KiCad が周りに 0.3〜0.5 の逃げを足した枠で、**物ではない**。
# 筐体の窓や当たりは胴で見る。📄 ePH.pdf 1・3 ページ（表 B × 幅）と KiCad 10 Connector_JST の F.Fab。
#   B2B-PH-K   表 5.9 × 4.5   F.Fab 6.31 × 4.91   胴の背 6.0・嵌合 8.0
#   S2B-PH-K   表 5.9 × 4.8   F.Fab 5.90 × 7.60   背 4.8
#   B4B-PH-K   表 9.9 × 4.5   F.Fab 10.31 × 4.91  胴の背 6.0・嵌合 8.0
#   ハウジング PHR-2  5.8 × 4.5（📄 3 ページの表 B ＝ 5.8）⇒ **縦の口は挿しても平面の外形が胴より広がらない**
PH2_V_BODY, PH2_H_BODY, PH4_V_BODY = (6.31, 4.91), (5.90, 7.60), (10.31, 4.91)
PHR2_BODY = (5.8, 4.5)
PLUG_D = 3.1          # プラグの相手が板の面に沿って入る深さ（横出しのみ）
PLUG_UP = 16.0        # 縦の口でプラグと線の曲がりに要る高さ（⚠ 私の見積り。筐体の実測では 33 まで空く）
# 📄 ePH.pdf 1 ページ「With a mounting height of 8 mm ... in the top-entry version」
#    ＝ トップ型は嵌合した高さが板の面から 8.0。サイド型の背は 4.8（📄 ePH.pdf 3 ページ・v6 の J10 と同じ）
PH_TOP_MATED_H, PH_SIDE_H = 8.0, 4.8

# 前の縁の欠きは廃止（🔒 ユーザー 2026-09-14「電池は板の裏にあるんだから、口も裏に出せばいい」）。
# 電池の口を裏へ回したので、線が板を回り込まなくなり欠きが要らない。外形は 82.024 × 37.4 のまま
FRONT_NOTCH = None
# 板の裏に何が入るかは、**電池の箱から引き算して出す**。まとめた値は置かない。
#   2026-09-17 に BACK_BANDS（裏の帯）を消した。中身は「電池の上でない所」だったが、
#   名前が実体を作って「帯がこう言っている」と引用できてしまい、電池の厚みという
#   一次の事実の代わりに使われた。引き算はその場でする。
BAT_BOX = (16.05, 0.0, 66.05, 31.4)   # 電池の足跡（板の座標 x0, y0, x1, y1）。実物 50 × 35
BAT_T = 6.0                            # 電池の厚み（実物 DTP603450 の実測）
BOARD_UNDER_Z = 12.0                   # 床から板の裏の面まで（筐体 case_v6_1.scad の HUB_AT[2]）


def back_clear(x0, y0, x1, y1):
    """板の裏のこの四角の下に、いくつ空いているか（mm）。

    電池に少しでも掛かれば電池の天面まで（12.0 − 6.0 = 6.0）、外なら床まで 12.0。
    縦の PH を挿すと板の面から 8.0 要る（📄 ePH.pdf 1 ページ）ので、電池の上には置けない。
    横出し S2B-PH-K なら背 4.8 なので電池の上でも入る。
    """
    over = not (x1 <= BAT_BOX[0] or x0 >= BAT_BOX[2] or y1 <= BAT_BOX[1] or y0 >= BAT_BOX[3])
    return BOARD_UNDER_Z - BAT_T if over else BOARD_UNDER_Z

# ⭐ 2026-09-19 🔒 ユーザー「板単体で見たときにも美しいと思える配置に」（口を縁に並べる）:
#   後ろの縁の口（J6・J7）は同じ Y の線にそろえる
#   ⚠ J4 を裏の J10 の列（X 76.25）へ寄せる案は取り消した。胴の右端が 0.95 出て、板を箱へ差し入れる途中で
#     右前の箱の内側に触れた（sweep_chk.py hub で新しい当たり 3 件・静止の検査には出ない）。J10 は裏なので表からは見えない
REAR_ROW_Y = 33.1       # J7 の芯（枠の後ろの端が縁の 1.55 内側）

# 私が置いた口。exit は プラグを抜く向き（+Z は縦）
PORTS = [
    # ⭐ 2026-09-16 夕 🔒 ユーザー「J4とJ6を縦にして」: 横出し S2B-PH-K → **縦 B2B-PH-K**。
    #    横出しは口が**盤面の内側**を向いていて、挿したプラグの胴が板の上に 2.0 出て
    #    J4 は Y 14.30〜16.30 を塞いでいた（そこに J10 の足を置けず、J10 のパッドを
    #    X 並びにする羽目になっていた）。パッドの座標は動かさず、足形だけ縦に替える
    #    ⚠ 芯の Y は 8.60 → 9.00。8.60 だと枠の前端 5.85 が 取付穴 (72.5, 3.5) のナット（半径 2.56）の
    #    下へ 0.21 入る。縦にすると枠が前へ 0.35 伸びるぶんで、横出しのときは 0.14 空いていた
    ("SPK IN",      75.3,  9.00, PH2_V, "+Z", "SPKP・SPKM"),
    # 🔴 2026-09-14: ライザーが +2.87 下がって、その裏の L 字の胴が この口に 26.21mm³ 食い込んだ
    #    （筐体の実測）。後ろへ 1.9 逃がす。左向きなのは裏の電池の口に場所を譲ったため
    # ⭐ 2026-09-19: 17.1 → 17.4（+0.30）。J1 を +0.30 動かしたら枠が 0.23 重なった（前は 0.075 空き）。同じ 0.075 に戻す
    ("SPK OUT",      9.5, 17.4, PH2_H, "-X", "SPKM・SPKO"),
    # ⭐ 同上。J6 の横出しは −Y（盤面の内側）で、指の所に J1（背 8.5 のライザー）が居て、
    #    通り道が電池の下（挿し直すには電池を外す）にも当たっていた。縦にすると両方消える
    # ⭐ 2026-09-19: Y 30.00 → REAR_ROW_Y（J7 と同じ線）。30.00 は横出しの頃に −Y の通り道を取るための位置の名残だった
    ("会話ボタン",   17.5, REAR_ROW_Y, PH2_V, "+Z", "GND・BTN"),
    # 🔒 ユーザー 2026-09-19「板の後ろの縁に押しボタンを載せる方法にしようか」: ハッチのトグルをやめ、板の押しボタン（PWR_BTN）へ。
    #   J7 はリードだけになり 4 ピン → 2 ピン。芯は据え置き（4 ピンの枠 58.05〜68.95 の中に 2 ピンの枠が入る）
    # ⭐ 2026-09-19: X 63.5 → つまみの軸の芯。リードの足 2 本（芯の ±7.15）の真ん中に来る
    ("リード",       SHAFT[0] + SHAFT[2] / 2, REAR_ROW_Y, PH2_V, "+Z", "EN・GND"),
    # ⭐ 2026-09-16 夕 🔒 ユーザー「ケーシング作ったから垂直のがいい。結局一番穴は小さくなる」:
    #    サイド型 S2B-PH-K（左の帯・板の座標 6.00, 25.55）→ **トップ型 B2B-PH-K を板の裏に下向き**で、右の帯へ。
    #    ・線は電池のタブ（板の座標 66.05, 13.9）から真上に上がってそのまま挿さる
    #    ・天板の窓が 12.7 × 7.9（胴 8.6 ＋ 横向きの通り道 3.1 ＋ 逃げ）→ **8.11 × 5.91**（胴 6.31 × 4.91 ＋ 逃げ 0.5 ＋ 板を右へ滑らせる 0.8）になる
    #    ・置ける帯は 板 X 66.05 より右（世界 68.05 ＝ 電池の右端。ここより左は電池が −X へ抜ける道）で、
    #      床の柱 φ7（板 X 69.0〜76.0 × Y 0〜7.0 と 29.9〜36.9）を外す
    #    ・板の裏で効くのは **USB-C のシェルの足**（スルーホール・Y 20.63〜）だけ
    #    ・🔴🔴 表で効くのが 2 つある。J10 は裏でも、**はんだ足 2 本は表へ突き抜ける**からである:
    #        ① J4 の胴（Y 〜14.30）
    #        ② **J4 に挿さったプラグ**（Y 14.30〜16.30 ＝ 胴 ＋ PLUG_D 2.0）。ここに足があると
    #           プラグがはんだの上に乗る。2026-09-16 夕、筐体の hit_wires（1.17mm³）が先に見つけた
    #      ⇒ 足は Y 16.30 より後ろ、枠は Y 20.63 より手前。この 4.33 に 6.9 の枠は入らない。
    #        **パッドを Y へ並べるのをあきらめ、X へ並べた**（枠 6.9 × 5.5・角度 180）。
    #        ⚠ その代償で、極性の言い方が「手前／奥」から「**左／右**」に変わる（docs/PCB-V61.md 8 章を直した）
    #    ⇒ 枠 X 73.00〜79.90 × Y 14.475〜19.975。足は J4 のプラグから 0.60・枠は USB-C の足から 0.655
    #    ⭐⭐ 2026-09-16 夕 🔒 ユーザー「J10の極性も手前奥に戻して」: パッドを X 並び → **Y 並び**へ戻した。
    #    X 並びにしていたのは、J4 に挿さったプラグ（板 Y 14.30〜16.30）と USB-C のシェルの足（20.63〜）に
    #    挟まれて 4.33 しか無かったため。**J4 を縦にしてその帯が消えた**ので、6.9 の枠が入るようになった。
    #    ⇒ 極性の言い方が「左／右」から **「手前が VBAT ＋ ／ 奥が GND」** に戻る（8 章）
    #    枠 Y 12.50〜19.40。足は J4 の胴（Y 〜11.35）から 3.0・枠は USB-C の足（20.63）から 1.23
    ("電池",         76.25, 15.95, PH2_V_ROT, "-Z", "VBAT・GND", "B"),   # 板の裏（B.Cu）・トップ型・**下**（−Z）へ挿す。右の帯
]
PORTS = [(p + ("F",))[:7] for p in PORTS]   # 面を書いていない口は表（F.Cu）
# ⭐ 2026-09-16 夕 🔒 ユーザー「ケーシング作ったから垂直のがいい」: 裏の口は **トップ型 B2B-PH-K**（胴の背 6.0・嵌合 8.0）。
#    ナイロン版で板の裏が Z 12.0 に上がったので、板の裏から床まで 12.0 に対して嵌合 8.0 が入り 4.0 余る。
#    （2026-09-14 に一度サイド型 S2B-PH-K にしたのは、板の裏が Z 8.0 で嵌合 8.0 が入らなかったため。その前提が消えた）
# 🔒 電池はタブ（線の出る端）を**右**にして入れる（2026-09-16 夕・BAT_RZ 270）。タブは短い辺（35 の端）から出る（v4 の配置の記録）。
#    口を右の帯へ移したのはこれと対で、線が電池の天面を 50mm 渡さずに済む
# 電源の帯。2026-09-14 に実際に部品を置いた範囲（当時の gen_pcb.py の v6 → v6.1 の写像・関数は 2026-09-19 に消した）。
# 🔴 これは**区画の目安**であって部品の枠ではない。中の物どうしの当たりは gen_pcb.py と DRC が見る。
#    地図の重なりの検算からは外す（口やソケットと重なって見えるのは、その隙間に小物が入るため）
POWER_AREAS = [(16.8, 3.5, 39.1, 32.3)]
# 🔴 2026-09-17 夕: **AS5600 の横から退けた。**前は (56.3, 17.8, 15.3, 10.7) で、
#   リレーの胴と AS5600 の胴のすきまが **3.16mm**・芯と芯が **9.47mm** だった。
#   リレーは電磁石で、AS5600 は磁気で角度を読む。その 2 つを並べておいて
#   「オフセットなので knobzero が消す」で済ませていた（MEDIATOR-V6-HANDOFF.md 3 章
#   「設計で潰す手は無い」）。**それは嘘だった。**板の 64% には部品の胴が無く、
#   留め穴・欠き・縁 0.5 を避けてもリレーが入る場所は **501 通り** あった。
#   90° 回してここへ置くと芯と芯が **18.5mm**、1.95 倍離れる。
#   磁石（双極子）の場は 1/r³ なので **7.4 分の 1**。
#   （枠の中心 (46.48+10.7/2, 20.3+15.3/2) = (51.83, 27.95) と 角度センサ (63.7, 13.8) で 18.47。
#     リレーの中の磁石の位置は分からないので 1mm 未満は読まない）
#   ― 前へ 2.0 動かして「軍まで 0.5 残る」と書いていたのは、センサの真横へ
#     限界まで寄せていたということ。RELAY_LIMIT_FRONT はもう使わない。
# ⚠ Y は 21.5 ではなく **20.3**。レジンの筐体（格子）と 14.65mm³ 当たった
#   （世界 X 50.18〜57.48・Y 49.40〜50.10・Z 15.24〜22.80）ので 1.2 前へ退けた。
# ⭐ 2026-09-19: X 46.0 → 46.48。46.0 だと枠が USB-C（J13）の枠に 0.33 重なり、gen_pcb.py の押し離しが
#   毎回 +0.48 動かしていた（板と筐体の模型は前から 46.48 のほう）。狙いを実際の位置に合わせた
RELAY = (46.48, 20.3, 10.7, 15.3)   # G6S-2F（90° 回した。gen_pcb.py の角度は 180）
