n416/katanori/hardware/pcb/gen_pcb.py

# -*- coding: utf-8 -*-
"""katanori61.kicad_pcb（部品を置いただけの板・配線はまだ）を作る。

  python gen_pcb.py

つながりは回路図から kicad-cli が書き出したネットリストを読む（手で写さない）。
ハブ側の部品と口は、今のユニバーサル基板の穴の座標（hub_ports.py / relay_board.html）に置くので、
筐体の側の線の道は変えなくてよい。電源側は私が並べた（下の PLACE）。

パネル（1 枚で発注して割る）:
    ハブ  74 × 52   … 左上 (0, 0)
    電源  36 × 28   … 左下 (0, 54)。間は 2mm 空け、ミシン目のタブ 2 本でつなぐ
"""

import math
import re
import pathlib
import subprocess
import sys
import uuid
import xml.etree.ElementTree as ET

HERE = pathlib.Path(__file__).parent
sys.path.insert(0, str(HERE))
sys.path.insert(0, str(HERE.parents[0] / "parts"))
import kisym  # noqa: E402
from kisym import Str, find, find1  # noqa: E402
import hub_ports  # noqa: E402
import dsn  # noqa: E402

from kicad_paths import CLI, FPDIR  # noqa: E402
NL = chr(10)
OUT = HERE / "katanori61"
NAME = "katanori61"

# ---- 電源の道の線幅（2026-09-16）----
# ⭐ これを入れるまで、電池を流す線まで自動配線の既定 0.2mm のままだった。幅を決めた人がいなかった。
#   実測（docs/POWER.md 1886 行）: 放電 300〜325mA・2 秒の最大 355〜365mA／充電 505〜560mA。
#   充電の上限は PROG1 = R16 1.0kΩ で 1A。
#   0.2mm は 2.457mΩ/mm・IPC の許容 0.74A（外層 1oz・ΔT10℃）で、電池の道 88.4mm が 217mΩ になる。
#   0.8mm にすると 0.614mΩ/mm・許容 2.03A、同じ道が 54mΩ ＝ 最大放電で 20mV・充電で 30mV に収まる。
#   1.0mm との差は 6mV しかなく、2 層のこの密度で引けるほうを採った。
# ⚠ BATP と VLIPO は**シャントのセンス線と同じネット**なので、この幅はセンス線にも掛かる。
#   センス線は別に細い線で先に引いて protect で守る（ステップ 2）。
#
# 2 段に分ける。⭐ 最初 7 本を全部 0.8 にしたら未接続が 6 本出た（2026-09-16）。
#   VBUS・V5・VSYS は U2 の QFN-20（0.5mm ピッチ）・U1 の VQFN-16・J13 の USB-C という
#   細かいパッドに何本も降りる配り物で、太いまま通すと U3 まわりの SCL/SDA/V33 と
#   R16 の PROG1 を押し出した。**直列に電流が通る道だけ**を太くする。
#   BAT_NETS  … 電池 → 逆接保護 → シャント → 充電 IC の一本道。ここが 88.4mm ＝ 217mΩ の本体
#   POWER_NETS… 配り物。0.4mm で 1.229mΩ/mm・IPC 許容 1.23A（外層 1oz・ΔT10℃）あれば足りる
# ⭐ 2026-09-16: 並べ直して電池の道が短くなったので、0.8 で押し通す必要が消えた。0.6mm は
#   0.819mΩ/mm・IPC 許容 1.65A。
# 🔴 2026-09-17 夕に測り直した。**その日の朝に書いた「J10 → Q2 31.16mm・25.5mΩ（B.Cu）」は誤り**。
#   長さだけで計算していて、その区間がどの層にあるかを見ていなかった。実際は内層 In2.Cu に
#   34.27mm 乗っており、JLCPCB の 4 層は内層が 0.5oz なので抵抗は倍で **56.6mΩ** だった。
# ⭐ そこで bat_trunk() を入れ、J10 → Q2 を **裏の面**へ先に引いて protect で固定した。
#   いまの電池の道（測値）:
#     J10 → Q2   B.Cu 37.6mm ＋ F.Cu 1.6mm ＋ 穴 1 個   **32mΩ**
#       （⭐ 2026-09-17 夜に板から測り直した。28.6mm・23.9mΩ は AS5600 をよけて回す前の値。bat_trunk() を見よ）
#     Q2  → R41  F.Cu 6.5mm                          5.3mΩ 以下
#     R41 → U2   F.Cu（vlipo_link で先に引いてある）        2.8mΩ
#   合計 40mΩ 前後。充電の上限 1A で 40mV・実測の 560mA で 22mV。
#   ⚠ 幅の表（上）は外層 1oz で計算した値。**内層はその 2 倍で読むこと**。
#   0.8 のままだと U2（QFN-20・0.5mm ピッチ）の 14〜16 番から VLIPO が逃げられず未接続が出る。
# ---- 4 層（2026-09-17）----
# 2 層では U2（QFN-20・4×4）の 20 ピンが出入りできず、部品を動かすたびに別のネットが切れた
# （L1 の枠と U2 の枠の間が 0.4mm）。JLCPCB の見積もりで 82×38・5 枚が 2 層 $4.00 / 4 層 $7.00。
# In1 を GND の面にすると GND の 47 パッドが配線から消え、In2 が 3 枚目の配線層になる。
# ⚠ 内層を DSN の plane にすると Freerouting が落ちる（drillShapes is null・docs/VOICE-BOARD.md 10 章）。
#   ⇒ **plane は使わない。**自動配線には F.Cu / In2.Cu / B.Cu の 3 層だけ見せ、In1 は KiCad のベタで敷く。
COPPER = ["F.Cu", "In1.Cu", "In2.Cu", "B.Cu"]
ROUTE_COPPER = ["F.Cu", "In2.Cu", "B.Cu"]   # In1 は GND の面なので自動配線に見せない
# 貫通穴は 2 層のときと同じ 0.6/0.3。統合基板の 0.45/0.2 は XU316 の細ピッチのために
# 落とした値で、この板には要らない。0.2 の穴はこの板の規則（min_through_hole_diameter 0.3・
# min_via_annular_width 0.13）に掛かり、DRC が 69 件ずつエラーを出した（2026-09-17）。
VIA4 = (0.6, 0.3)

BAT_NETS = {"BATRAW", "BATP", "VLIPO"}
BAT_W = 0.6
VBUS_PIN_W = 1.2     # C8 の 1 番 → U2 の 17〜19 番（3 本とも VBUS）へ降ろす線。vbus_trunk() を見よ
#   ⚠ VBUS はこの組に**入れない**。U2（QFN-20・0.5mm ピッチ）に VBUS のパッドが 6 本あり、
#     0.4mm では辺から逃がせず、試すたびに違うピンが浮いた（9 番 → 3 番と VPCC・2026-09-16）。
#     得も小さい: 幹（J13 → U2）は 0.2mm で 141mΩ ＝ 充電 560mA で 85mV。5V 側なので効かない。
POWER_NETS = {"VSYS", "SW"}
POWER_W = 0.4
# ⭐ 2026-09-17: V5 だけ 0.8mm の独立した組。U1 から J1（XIAO）まで 57.49mm あり、その 57.3mm が
#   **内層 In2.Cu** に載っていた。JLCPCB の 4 層は **内層 0.5oz が既定**（外層 1oz）なので、
#   内層の線は同じ幅でも抵抗が 2 倍になる。0.4mm では 141.5mΩ ＝ 5V 側 0.3A で 42mV だった。
#   ⚠ gen_pcb.py の幅の表（上）は外層 1oz で計算した値。内層はその 2 倍で読むこと。
V5_NETS = {"V5"}
V5_W = 0.8
# ⭐ 2026-09-17 夕: スピーカーの 3 本。既定の 0.2mm のままだったので、内層 0.2mm で
#   SPKM 93.1mm＝458mΩ・SPKP 138mΩ・SPKO 125mΩ、合計 **720mΩ** あった。
#   アンプの先は 8Ω なので、出力の **8.3%** が板の銅で熱になる。
#   電流の上限は 5V の BTL に 8Ω で 5÷8÷√2 で 0.44A rms。信号線の桁ではない。
SPK_NETS = {"SPKP", "SPKM", "SPKO"}
SPK_W = 0.6

# ---- 先に手で引く線（2026-09-16）----
# 自動配線に任せられない所だけを、こちらで引いて固定する。
#   板（.kicad_pcb）へは locked を付けて書き、DSN へは (type protect) で渡す。
#   自動配線はこの線を動かさず、避けて引く。SES で返ってくる protect の写しは route.py が捨てる。
# ⚠ 座標は **KiCad の板の座標そのまま**（bx() を通した後の値）。パッドの中心に端を合わせること。
PRE_TRACKS = []   # ケルビンは kelvin_tracks() が置いてある物から作る
_KELVIN = []      # build() が入れる
_PRE_VIAS = []    # 先に引いた線が層を替える所の穴。build() が入れる（net, (図面 X, 図面 Y)）
_n = [0]


def uid():
    _n[0] += 1
    return str(uuid.uuid5(uuid.NAMESPACE_URL, f"katanori/pcb/{_n[0]}"))


# ---- 板の寸法（v6.1・2026-09-14）----
# 座標は **板の左前が原点・X 右・Y 後ろ**。図面（KiCad）の座標へは bx() で移す。
# ⚠ ここは筐体側（別セッション）が決めた数字で、こちらでは動かさない。1 か所に置くため
#    v61_board.py（この板の「動かせない物」の一覧）から読む。
sys.path.insert(0, str(HERE))
import v61_board as VB

BOARD_L, BOARD_W = VB.L, VB.W                      # 82.024 × 37.4
# 後ろの縁の欠き。x0, x1, この y から後ろの縁まで。
# ⭐ 2026-09-16 夕: 数を 2 個に決め打ちしていたのをやめた（欠きが 1 個になったため）
NOTCHES = [(n[0], n[2], n[1]) for n in VB.NOTCHES]
# 2026-09-18: 四隅を丸める（ユーザー「４隅全部丸めればいい」）。レジンの筐体で左右の壁を 45° 開くと、
#   後ろのねじより後ろの壁の端が内側へ回り込み、角の立った板の後ろの角をかすめていた。
#   模型で測って 2.8 で消える。JLCPCB の外形の精度 ±0.2 で角が外へずれると丸めの効きが約 0.5 減るので 3.5。
#   外側の角なのでルーターの刃の太さの制限は無い。欠きのある板では使わない（outline() が見る）
BOARD_CR = 3.5


def edge_gap(u, v):
    """板の座標の点から、角を BOARD_CR で丸めた外形までの距離（内側が正）。"""
    R = BOARD_CR
    cx, cy = min(max(u, R), BOARD_L - R), min(max(v, R), BOARD_W - R)
    if R > 0 and (u < R or u > BOARD_L - R) and (v < R or v > BOARD_W - R):
        return R - math.hypot(u - cx, v - cy)
    return min(u, BOARD_L - u, v, BOARD_W - v)
MOUNT = list(VB.HOLES) + list(VB.GUIDE_HOLES)   # M2 × 4（床から立つ柱 φ7 の上）＋ 軸のガイドの足 3（2026-09-19）。足形・銅の逃げ・枠からの押し出し・ナットの下の検査が全部掛かる
MOUNT_D = VB.HOLE_D               # φ2.2
MOUNT_KEEP = 0.5                  # 穴のまわりに **銅** を置かせない幅
# 🔒 2026-09-14 筐体側: ねじは板の上から M2×6・ナットは柱の中の横差し。板の上に出るのは頭だけ
NUT_R = 4.62 / 2 + 0.25
POSTS = []                        # v6.1 は板を貫く柱が無い（後ろの隅の 2 本は上の欠きになった）
POST_KEEP = 0.5
# 🔴 つまみの軸 φ7 が真上から降りる。ここに置いてよいのは AS5600（U4）だけ
KEEPOUT_MAGNET = (VB.SHAFT[0], VB.SHAFT[1], VB.SHAFT[0] + VB.SHAFT[2], VB.SHAFT[1] + VB.SHAFT[3])
SHAFT_CX, SHAFT_CY = VB.SHAFT[0] + VB.SHAFT[2] / 2, VB.SHAFT[1] + VB.SHAFT[3] / 2   # つまみの軸の芯＝ AS5600（U4）の芯
# 電池は板の**下**（板の裏まで 6.0）。表の部品の背には効かない。裏に置けるのはこの外の帯だけ
BATTERY = (16.05, 0.0, 66.05, 31.4)
ORG = (40.0, 40.0)                # 図面の上での板の左上
# 筐体（箱）の座標と板の座標のずれ。**箱 = 板 + BOX**（2026-09-14 筐体側）
BOX = VB.ORG_W


def outline_pts():
    """外形の頂点（板の座標・反時計回り）。後ろの縁に欠きが 0 個以上ある。

    ⭐ 2026-09-16 夕に一般化した。それまで「後ろの両隅に必ず 2 個」と決め打ちで、
    欠きが 1 個になったら書き換えるしかなかった。右の縁から左へ回りながら、
    欠きを右から順に落としていく。
    """
    pts = [(0, 0), (BOARD_L, 0), (BOARD_L, BOARD_W)]
    left_open = False
    for x0, x1, yf in sorted(NOTCHES, key=lambda n: -n[1]):
        pts += [(x1, BOARD_W), (x1, yf), (x0, yf)]
        left_open = x0 <= 1e-9
        if not left_open:
            pts += [(x0, BOARD_W)]
    if not left_open:
        pts += [(0, BOARD_W)]
    return pts


def bx(x, y):
    """板の座標（左下が原点・Y 上向き）→ 図面の座標（Y 下向き）。"""
    return (ORG[0] + x, ORG[1] + (BOARD_W - y))


def xb(X, Y):
    """図面の座標 → 板の座標（bx() の逆）。pad_box() の返り値を板の座標で扱うときに使う。"""
    return (X - ORG[0], BOARD_W - (Y - ORG[1]))


# ---- 足形の差し替え（KiCad の標準に無い物は katanori.pretty に作る） ----
LOCAL = HERE / "katanori.pretty"
FP_OVERRIDE = {
    # 🔒 2026-09-12 リレーは表面実装の Omron G6S-2F へ替えたので、自作の足形は要らなくなった
    #    （KiCad 標準の Relay_SMD:Relay_DPDT_Omron_G6S-2F を使う）。
    # ⭐ 2026-09-17 🔒 ユーザー「1.3 以下に戻してレジンのハッチは口の周りを掘るしかないね」:
    #   **素の足形（シェルの足 4 本）へ戻した**。前寄りの足はパッドの外縁が口の面から 1.800 後ろに
    #   あるので、胴の出が 1.800 を超えると板からはみ出す。v6 は 3.0 出していたので足 2 本を省いた
    #   自作版（katanori:…_NoFrontLegs）を使っていたが、v6.1 の出は 1.3 なのでパッドの外縁が
    #   板の縁の 0.470 内側に収まる。抜き挿しの力は 4 本で受ける。
    "J13": "Connector_USB:USB_C_Receptacle_HRO_TYPE-C-31-M-12",
}


# ---- 置き場所（板の座標・(x, y, 角度)。角度は KiCad の回し方に合わせて後で検算する）----

# ⭐ 2026-09-19: v6 の板の並び（PLACE_V6）と、それを v6.1 へ写す pwr() / v61() を消した。
#   電源部（POWER_V61）・リレーの駆動（RELAY_V61）・口（BOX_PLACE）がすべて v6.1 の板の上で並べ直され、
#   写しから来る部品が 1 つも残らなくなったため。中身は git の e096847 以前にある。


def org_from_box(fp_id, ang, x0, y0, x1, y1, back=False, key="CrtYd"):
    """置きたい**枠**（板の座標）と角度から、足形の**原点**（板の座標）を逆算する。

    🔴 こちらが筐体と決めてきたのは「枠」で、PLACE の表は「原点」を書く。手で引き算すると
       回転のたびに向きを間違える（v6 で 3 回踏んだ）。⇒ 足形を読んで、その角度での枠を測って引く。
    🔴 裏面（back）は**局所 Y が反転した状態で保存される**（KiCad 自身の板で確かめた。
       cm5_minima の同じ足形が表 (-1, 0.43) / 裏 (-1, -0.43)）。⇒ 反転してから測る。
    ⚠ 出来上がりは build() の中で **置いたあとの枠を測って**突き合わせる（check_boxes）。
       ここの式だけを信じない。
    ⭐ 2026-09-17: key="Fab" にすると **胴**で位置を決める。壁から出す量のように
       「物がどこまで出るか」で決まる置き方は、枠で指定すると逃げのぶんずれる
       （USB-C を枠で 1.3 出したら胴は 0.8 しか出ず、奥まりが 0.8 のはずが 1.3 になった）。
    """
    fp = load_fp(fp_id)
    if back:
        fp = mirror_y(fp)
    cx0, cy0, cx1, cy1 = courtyard(fp, 0.0, 0.0, ang, key)
    return (x0 - cx0, y0 + cy1)


# 板の上で場所が決まっている物（v61_board.py と筐体からの実測）。写像は通さない。
# 角度は「足形の 0 度での向き」から決めた:
#   PH 横（S2B/S4B）… 0 度で口は −Y。90 度で +X・180 度で +Y・270 度で −X
#   PH 縦（B2B/B4B）… 口は上。パッドは +X へ並ぶ
#   ピンソケット 1x0n … 0 度でパッドが +Y へ並ぶ。270 度で +X へ並ぶ
#   USB-C … 0 度で口は +Y（パッドは −Y 側）。270 度で口が +X
# ---- 枠で置く物（v61_board.py の PORTS と同じ枠を使う）----
#   (角度, 枠 x0, y0, x1, y1)。枠は v61_board.py が持っている値から作る
def _fb(nm):
    q = [x for x in VB.PORTS if x[0] == nm][0]
    fw, fh = q[3]
    w, h = (fh, fw) if q[4] in ("+X", "-X") else (fw, fh)
    return (q[1] - w / 2, q[2] - h / 2, q[1] + w / 2, q[2] + h / 2)


# 板の**裏**に付く物（KiCad でも B.Cu に置く）。局所 Y が反転する
BACK_SIDE = {"J10"}
# ⭐ 2026-09-17: 自分で手はんだする口（fab.py が --smd-only で実装から外す物と同じ顔ぶれ）。
#   この口の **貫通の GND パッドだけ** ベタを thermal relief でつなぐ。4 層にして In1 が全面 GND に
#   なったので、F.Cu・In1・B.Cu の 3 層が足に直結し、こてで温度が逃げて着かなくなる。
#   表面実装は直結のまま（リフローは JLCPCB 側なので熱の逃げは問題にならない）。
#   ⚠ 細いパッドは spoke が 1 本しか立たず KiCad が starved_thermal を出す。
#     規則を緩めるのは gen_sch.py が書く .kicad_pro の min_resolved_spokes（1 にしてある）。
#     🔴 カスタム規則のファイル（.kicad_dru）に書いても **kicad-cli は読まない**。
#       わざと壊した規則を入れても素通りした（2026-09-17 夕に確かめた）。
HAND_SOLDER = {"J1", "J2", "J4", "J5", "J6", "J7", "J10", "SW2"}   # SW2 = 電源の押しボタン（スルーホール・2026-09-19）
# ⭐ 2026-09-17: 枠ではなく **胴** で置く物。壁から出す量で位置が決まる口だけ。
#   枠（courtyard）は KiCad が付けた逃げで物の形ではない（USB-C は後ろへ 0.5 大きい）
BOX_BY_FAB = {"J13"}
PH_H2 = "Connector_JST:JST_PH_S2B-PH-K_1x02_P2.00mm_Horizontal"
PH_V2 = "Connector_JST:JST_PH_B2B-PH-K_1x02_P2.00mm_Vertical"
PH_V4 = "Connector_JST:JST_PH_B4B-PH-K_1x04_P2.00mm_Vertical"
SOCK7 = "Connector_PinHeader_2.54mm:PinHeader_1x07_P2.54mm_Vertical"   # 板の側はオス（2026-09-14）
SOCK4 = "Connector_PinHeader_2.54mm:PinHeader_1x04_P2.54mm_Vertical"
BOX_PLACE = {
    # 口。角度は「足形の 0 度で口が −Y」から決めた（90 で +X・180 で +Y・270 で −X）
    # ⭐ 2026-09-16 夕 🔒 ユーザー「J4とJ6を縦にして」: 横出し → 縦。角度はパッドの並びだけを決める
    "J4": (PH_V2, 0) + _fb("SPK IN"),
    "J5": (PH_H2, 270) + _fb("SPK OUT"),
    "J6": (PH_V2, 0) + _fb("会話ボタン"),
    "J7": (PH_V2, 0) + _fb("リード"),      # 縦 2 ピン（上から挿す）。⭐ 2026-09-19 トグルをやめて 4 ピン → 2 ピン
    # ⭐ 2026-09-16 夕 🔒 ユーザー「ケーシング作ったから垂直のがいい。結局一番穴は小さくなる」:
    #    サイド型 S2B-PH-K（横出し・左の帯）→ **トップ型 B2B-PH-K を板の裏に下向き**、右の帯へ。
    #    角度 180 は「パッドを **X** へ並べる」ため（枠は PH2_V 6.9 × 5.5）。裏なので足形は鏡になるが、
    #    縦の口は口の向きが ±Z で鏡に関係しない。**効くのはパッドの並びだけ**なので CHECK_PADS で見る。
    #    ⚠ Y へ並べる（270）も試したが、はんだ足が J4 に挿さったプラグの下に入って置けなかった（v61_board.py の注）
    # ⭐⭐ 角度 270 でパッドが **Y** へ並ぶ（手前が 2 番 ＝ VBAT ＋・奥が 1 番 ＝ GND）。
    #     180（X 並び）にしていたのは J4 のプラグに塞がれていたため。J4 を縦にして戻した
    # 電池の口は **電池の外**に置く。電池は板の座標 X 16.05〜66.05 を占め、その上は
    # 板の裏まで 12.0 − 6.0 = 6.0 しか無い。縦の PH は挿して 8.0 要る（📄 ePH.pdf 1 ページ）。
    # 電池の外なら床まで 12.0。電池のタブも X 66.05 から出るので、その右が線としても短い。
    # 判定は v61_board.back_clear() が電池の箱から引き算して出す。
    "J10": (PH_V2, 270) + _fb("電池"),     # 縦 2 ピン（板の裏・口は下 ＝ 電池の側）
    # ライザーの縦ソケット（パッドが板の +X へ 2.54 間隔で並ぶ向き）
    "J1": (SOCK7, 90, -0.01, VB.RISER_XIAO[2] - VB.RISER_D / 2, 18.79, VB.RISER_XIAO[2] + VB.RISER_D / 2),
    "J2": (SOCK4, 90, 35.47, VB.RISER_OLED[2] - VB.RISER_D / 2, 46.63, VB.RISER_OLED[2] + VB.RISER_D / 2),
    # 充電の USB-C（口が板の右の縁から 1.53 出る）
    # 🔴 2026-09-14: 270 度で置いたらパッドが板の外（板 X 82.8）へ出て、縁までの距離の違反が
    #    18 件出た。図面の Y は下向きなので、板の座標で見ると回る向きが逆になる。⇒ 90 度。
    # USB-C は **壁のある縁**にしか置けない（🔒 ユーザー 2026-09-16「壁であればどこでもいいですよ。
    # ハッチ側でもいいです」）。前の縁は壁ではなく ReSpeaker の板が立っていて、板の縁から
    # 背面まで 3.465・胴を 1.53 出すと残り 1.935 でプラグが入らない。
    # ⇒ **後ろの縁（ハッチ側）**。U2（板 X 33）に一番近い壁で、VBUS が短い。
    # 角度 180 で口が +Y（ハッチ）を向く。
    "J13": ("Connector_USB:USB_C_Receptacle_USB2.0_16P", 180,
            (BOARD_L - VB.USBC_SHELL_W) / 2, BOARD_W + VB.usbc_out() - VB.USBC_BODY_D,
            (BOARD_L + VB.USBC_SHELL_W) / 2, BOARD_W + VB.usbc_out()),   # 枠ではなく胴（BOX_BY_FAB）
    # ミュートリレー（背 9.33）
    "K31": ("Relay_SMD:Relay_DPDT_Omron_G6S-2F", 180) + VB.RELAY[:2]
           + (VB.RELAY[0] + VB.RELAY[2], VB.RELAY[1] + VB.RELAY[3]),
}
# ======== 電源部の配置（板の座標・2026-09-16）========
# ⭐ ここまでの電源部は **二重の写し**だった: 旧 PowerBoost 基板 → v6 の板 → v6.1 の板（写しの関数は 2026-09-19 に消した）。
#   gen_pcb.py の写しの注が「ここで並べ直してはいない」と書いているとおりで、v6.1 の板の上で
#   電源部を並べた人はいなかった。その結果:
#     ・電池の口 J10（X 76）から シャント R41（X 30）まで板を横断し、配線 107mm ＝ 0.2mm で 217mΩ
#     ・シャント R41 と 電流計 U3 が 23mm 離れ、ケルビンが取れず INA226 が 9.6 倍に読む
#     ・USB-C J13（X 80）から 充電 IC U2（X 28）まで 52mm
#     ・U2 の周りに全部が集まり、0.5mm ピッチの辺から 0.4mm の線が逃げられない
#   ⇒ **電流が流れる順に、左へ向かって一列**に並べ直す。
#      J10（電池）→ Q2（逆接保護）→ R41（シャント）→ U2（充電）→ L1・U1（昇圧）→ J1（XIAO・固定 X 0〜18.79）
#      U3（INA226）は R41 の真上に置く。J13（USB-C）は U2 のすぐ前の縁へ。
# 🔒 2026-09-16 ユーザー「この板が成立しなければ筐体は作り直し。ここが中枢」。
#    固定は **板の外形・取付穴・J1（XIAO のライザー）** の 3 つだけ。
#    v61_board.py の USBC_Y・電池のタブの位置は筐体側の都合なので縛らない。板の裏に何が入るかは
#    v61_board.py の back_clear()（電池の箱からの引き算）で毎回出す。
POWER_V61 = {
    # 並べ方: 小さい部品は列に揃える。⭐ 2026-09-19 🔒 ユーザー「板単体で見たときにも美しいと思える配置に」:
    #   X の間隔は **枠が重ならない 3.5**（0805 の枠は幅 3.36〜3.40。前の 3.0 では relax() が押し離して列が崩れていた）。
    #   Y の列は 8.4（出力の C）/ 10.7（FB・PROG・THERM）/ 14.0（主の道）/ 19.0（パスコン）/ 23.0（分圧）。
    #   **relax() が 1 つも動かさない狙い**にしてある。動いたら build() が ⚠ で名前を出す
    # 主の道だけ Y 14.0 の一直線（U2 は下の辺から 5 本逃がすので 1.5 上げてある）。
    # ---- 主の道（右から左へ流れる）----
    "U1":  (22.0, 14.3, 180),   # 昇圧 TPS61090（180°: SW と V5 を L1 の側＝右へ）
    "L1":  (27.5, 14.0, 180),   # インダクタ（180°: 2 番 SW を U1 の側＝左へ）
    "U2":  (33.5, 15.3, 0),     # 充電 MCP73871（下の辺 6〜10 番の逃げ道を空けるため 1.3 上）
    # ⭐ 2026-09-17 夕: 39.5 → 40.5。U2 の右の辺と R41 のあいだの谷が 1.595mm しか無く、
    #   VLIPO 0.6 ＋ PROG1 0.2 ＋ PROG3 0.2 ＋ すきま 0.15 × 4 ＝ 1.6 に 0.005 足りなかった。
    #   そのせいで VLIPO か PROG1 のどちらかが必ず浮いた。Q2 も一緒に右へ 1.0 送るので
    #   電池の道の長さはちゃら（R41→U2 が ＋1.0・J10→Q2 が −1.0）。
    "R41": (40.5, 14.0, 180),   # シャント 10mΩ（180°: 1 番 BATP を Q2 の側＝右へ）
    "Q2":  (45.0, 14.0, 0),     # 逆接保護 P-ch（3 番 ドレインが +X ＝ J10 の側）
    "U3":  (40.5, 19.0, 270),   # INA226 — R41 の真上（ケルビン。X を R41 と揃える）
    # ---- 前の列 Y 5.0（U2 の下の辺 6〜10 番へ行く物と CC）----
    # ⭐ 2026-09-19: CC の 5.1k を **J13 の足元**へ（前は前の列 Y 5.0 で J13 から 31〜35mm）。
    #   🔴 同じ轍の 2 回目: v6 でも「CC の引き下げは USB-C の足元」と書いたのに（v6 の並びの R44 の注）、
    #   v6.1 の並べ直しで前の列へ戻っていた。縦で 1 番（CC）が上 ＝ J13 の側。
    #   J13 の真ん中の足（D+・D−）は使っていないので、その真下に 2 本並べる。
    #   X 39.9 より左へ寄せない: VBUS の幹（vbus_trunk）が A9（X 38.56）から真下へ降りて Y 8.1 で裏へ潜る
    # ⭐ 2026-09-20: 胴どうしが 0.85mm しか空いていなかったので R44 を右へ 0.75（1.60mm へ）。
    #   R45 は上の注のとおり X 39.9 より左へ寄せられないので、開けるのは右側だけ
    "R45": (39.9, 27.8, 270), "R44": (42.75, 27.8, 270),  # CC2（B5 の下）・CC1（A5 の下）
    # ⭐ 2026-09-19: THERM は U2 の左下の 5 番の下へ（前は Y 5.0 の列で 9.4mm）。180° で 2 番（THERM）が左
    "R15": (32.75, 10.7, 180),                          # THERM（5 番）
    "R46": (44.0, 8.1, 0),                              # Q2 のゲート（J2 のライザーの枠 Y 6.54 の後ろ）。⭐ 2026-09-20: 7.6 → 8.1（J2 の枠まで 0.94 → 1.44）
    # ---- Y 9.5 / 11.0 ----
    # V5 の出力コンデンサは U1 の**下の辺**（15・16 番 板 Y 12.04）の真下に 3 本並べる。
    # ⭐ 2026-09-17: C6・C9 は Y 23.0 の列（U1 から銅で 33〜37mm・42〜48mΩ）に居た。
    #   600kHz では配線のインダクタンス（33mm で 30nH ≒ 120mΩ）が効いて、47µF が
    #   出力リプルに働いていなかった。1206 なので間隔は 3.5。
    # ⭐ 2026-09-17 夕: FB の 2 本（R3・R4）を U1 の下へ入れるために 9.5 → 8.6 へ 0.9 下げた。
    #   U1 の下のパッドは Y 11.625 から。C6（1206）の上の端が 10.400 だったので
    #   あいだは 1.225 しか無く、0805 のパッド 1.45 ＋ すきま 0.15 × 2 ＝ 1.75 が入らない。
    # ⚠ 2026-09-17 夕: C2 を 180° にして V5 のパッドを U1 の 15・16 番の真下へ向けてみたが、
    #   自動配線の答えが悪くなった（U1→C6 2.3 → 14.0mΩ・U1→XIAO 20.7 → 29.8mΩ、
    #   穴どうしの間隔の警告も 1 件）ので戻した。向きは 0° のまま。
    "C2": (21.8, 8.4, 0), "C6": (25.8, 8.4, 0), "C9": (30.4, 8.4, 0),
    # ⭐ 2026-09-17 夕: FB の分圧。**U1 の 14 番の真下**に置く。
    #   前は Y 23.0 の列（U1 から 12.4 / 14.3mm）にあり、FB の線はのべ 17.42mm、
    #   うち 13.21mm が内層 In2.Cu で、その斜めの区間が L1 の角と SW の線の真下を
    #   くぐっていた（x 24.73 で FB が y 14.21・SW が y 14.33）。R3 1.87M・R4 200k と
    #   高いので、この節点は拾いやすい。PowerBoost はこの 2 本を IC の真横に置いている。
    #   180° なので R4 は 1 番（FB）が右・R3 は 2 番（FB）が左。FB の 2 つのパッドが
    #   となり合い、その上 1.4mm に U1 の 14 番が来る。遠い端は R4 が GND・R3 が V5（C6 の側）。
    # ⚠ 2026-09-17 夕: 21.0 / 24.1 だと 2 つの FB のパッドの間が **0.22mm** しか無く、
    #   U1 の V5（15・16 番・X 22.3〜23.0）が真下へ降りられずに浮いた。
    #   左右に 0.6 ずつ離して隙間を 1.42mm にする（0.8mm の V5 ＋ すきま 0.15×2 が入る）。
    "R4": (20.6, 10.7, 180), "R3": (24.7, 10.7, 180),
    # ⚠ X 35.0 だと U2 の 9 番の逃げ道（escape_stub）が R16 の GND パッドに 0.01mm まで寄る
    "R16": (36.25, 10.7, 0), "R17": (39.75, 10.7, 0),    # PROG1 / PROG3（U2 の右の辺 11〜15 番）
    # ---- Y 19.0（パスコン）----
    "C1": (21.8, 19.0, 0), "C4": (25.3, 19.0, 0),       # VSYS
    # ⭐ 2026-09-19: C7（VLIPO・10µF）は **U2 の 16 番の右上**（前の C41 の場所）。1 番（VLIPO）が左。
    #   前は (28.0, 19.0) で、U2 の VLIPO まで裏 7.5mm（引き直したら内層 11.4mm・21mΩ）だった。
    #   C6・C9 と同じ轍（電源のコンデンサが IC から遠い）。1 番から U2 の 15 番へは c7_link() で先に引く。
    #   ⚠ 縦にして 16 番の真上へ寄せる案は、枠（courtyard）が U2・C41 と重なって押し離しで流された
    "C7": (36.4, 19.1, 0),
    # ⭐ 2026-09-17 夜: C8（VBUS）は **縦（90°）で U2 の 17〜19 番の真上**。1 番が下（U2 の側）。
    #   前は (31.0, 19.0, 0) の横向きで、U2 の入力まで 0.2mm × 6.6mm の枝が残っていた（vbus_trunk()）。
    #   X 31.0 は空きのまま。C41 は C8 の枠に押されないよう 34.0 → 36.4 へ。
    "C8": (33.5, 19.7, 90),
    # ⭐ 2026-09-19: C41（U3 の VS のパスコン）は C7 に場所を譲り、**U3 の 1 番（V33）・2 番（GND）の真上**
    #   （前の R7 の場所）へ。180° で 1 番（V33）が右＝U3 の 1 番の側。U3 の V33 まで 2mm 前後（前は 3.6mm）
    "C41": (40.8, 23.5, 180),
    # I2C の引き上げ。⭐ 2026-09-19: 前は R41 の右（Y 19.0）。リレーの駆動に場所を譲り、XIAO（J1）の SDA・SCL の右上へ
    # ⭐ 2026-09-20: 胴どうし 0.85 → 1.45mm（間隔 2.1 → 2.7）
    "R42": (17.0, 15.2, 0), "R43": (17.0, 17.9, 0),
    # ---- Y 23.0（分圧と大きいコンデンサ）----
    # R1・R2（低電池の分圧）は 2026-09-20 に廃止（gen_sch.py の U1 の注）。この列は空いた
    # R3・R4（FB）は 2026-09-17 夕に U1 の下へ移した。X 28.0 と 31.0 は空きのまま
    # ⭐ 2026-09-17 夜: 23.0 → 23.5。真下に縦の C8 が来て、その 2 番の GND の穴（cap_gnd_vias()）が
    #   R13 の 1 番まで 0.054 しか無かった。上の Q1 の枠までは 1.35 あったので 0.5 もらう
    "R13": (34.0, 23.5, 0),                             # EN
    # EN の跳ね止め。⭐ 2026-09-19: v6 の写し（押し離しで板 43.3, 21.7 へ流れていた）から、EN の口（SW2 の 3 番・板 28.55, 32.4）の右脇へ。
    #   SW2 の前（下）は口の名前「SW2 POWER」の場所（SILK_PORT を S にそろえた）。270° で 1 番（EN）が上 ＝ SW2 の 3 番と同じ高さ
    "C32": (31.2, 31.4, 270),
    # ⭐ 2026-09-19: VPCC の分圧は U2 の 2 番（左の辺）の左上、L1 の上へ（前は 9〜13mm）。
    #   どちらも VPCC の側を右（U2 の側）へ向ける: R6 は 0°（2 番 VPCC が右）・R7 は 180°（1 番 VPCC が右）
    "R6": (29.1, 20.1, 0), "R7": (29.1, 17.8, 180),    # VPCC（X 29.1: 枠が U2 の枠（X 30.9 から）に掛かると U2 が押されて C8 の真下から外れる）

    # 🔒 2026-09-19 ユーザー「LED は本来不要」: Y 27.0 の列（LED1・LED2・R5・R20・Q1）と
    #    Y 5.0 の列の LED3・LED4・R14・R8 を外した（gen_sch.py の U1 の下）
}
FIXED_V61 = {
    # つまみ（磁石と軸がこの真上に降りる）。AS5600 は芯で置く
    # ⭐ 2026-09-19: C42（AS5600 のパスコン）を U4 の左の足（2 番 V33・4 番 GND）の横へ（前は 6.7mm）。
    #   270° で 1 番（V33）が上。U4 の芯の左 4.9: 磁石の軸の枠（芯の左 3.5 から）の外
    #   ⭐ 2026-09-19 夕: 数字の直書きをやめ、軸（VB.SHAFT）の芯から引く（つまみを左へ 2.0 動かしたとき一緒に付いてくるように）
    "U4": (SHAFT_CX, SHAFT_CY, 0), "C42": (SHAFT_CX - 4.9, SHAFT_CY - 0.3, 270),
    # 電源の押しボタン。位置は v61_board.py の PWR_BTN（押し子が壁を抜ける所から決まる）
    "SW2": VB.PWR_BTN,
}
# ⭐ 2026-09-19 🔒 ユーザー「板単体で見たときにも美しいと思える配置に」（機能ごとに島・電気が先）:
#   ミュートリレーの駆動を **K31 のコイルの足元**へ集める。前は v6 の写しのまま板の左（X 15〜18）にあり、
#   コイル（K31 の 1 番 V5・12 番 COL ＝ 板 X 55.83 / 47.83・Y 21.65）から 35mm 離れていた。
#   帯は K31 の枠の前（Y 20.3）から、軸のガイドの左の穴 (51.7, 13.8) の頭までの Y 16.6〜20.3。
#   D31 はコイルの 2 本の足のあいだに渡す（1 番 V5 が右）。Q31 は 3 番 COL を上（12 番の側）へ。
RELAY_V61 = {
    "Q31": (47.9, 18.31, 90),
    "D31": (52.8, 18.8, 180),
    "C31": (56.9, 18.8, 0),                             # リレーの V5 のパスコン（1 番 V5 が左）
    # ⭐ 2026-09-20: 胴どうし 0.75 → 1.55mm（間隔 2.0 → 2.8）
    "R31": (44.2, 17.1, 0), "R32": (44.2, 19.9, 180),   # ベースの直列と引き下げ（どちらも BASE の足が右 ＝ Q31 の 1 番の側）
}
FIXED_V61.update(POWER_V61)
FIXED_V61.update(RELAY_V61)


def solve_fixed():
    """枠で指定した物の原点を足形から逆算して PLACE を仕上げる（load_fp が要るので実行時に呼ぶ）。"""
    for r, (fp, a, x0, y0, x1, y1) in BOX_PLACE.items():
        ox, oy = org_from_box(FP_OVERRIDE.get(r, fp), a, x0, y0, x1, y1, back=r in BACK_SIDE,
                              key="Fab" if r in BOX_BY_FAB else "CrtYd")
        FIXED_V61[r] = (ox, oy, a)
    PLACE.update(FIXED_V61)

PLACE = dict(FIXED_V61)


# 🔴 口は「枠が重なっていない」だけでは挿せない。**プラグの通り道**を別に見る。
#    2026-09-13 ユーザー「J4J5どうやって挿すんだ」。私は当たりの検査しか書いておらず、
#    J4・J6・J8 の 3 つで通り道が塞がっていた。[[clearance-is-not-assemblability]]
#    値: (足形の中でのプラグの向き, 通り道の長さ)
#      PH の横挿し   … 口は局所 −Y。プラグの胴 7.6 ＋ 指と曲がり 2.4 = 10.0
#      2.54 の L 字   … 口は局所 −X。DuPont のハウジング 14（hardware/parts/plug.scad）＋ 2 = 16.0
# v6.1: 板の面に沿ってプラグが入るのは 3 つだけ。J1・J2 はライザーのソケット（板が立つ）、
#       J7 と J10 は縦の PH（上・下から挿す）なので、板の面の通り道は要らない。
# ⭐ 2026-09-16 夕: J4 と J6 が縦になったので、板の面に沿ってプラグが入るのは **J5 だけ**になった
CONN = {
    "J5": ("-y", 10.0),
}
# ⛔⛔ **手書きの OPEN_DIR は捨てた**（2026-09-13）。全ての角度で 180° 逆で、
#    プラグの通り道の検査は 5 口とも **口の裏側**を見ていた。「5 口すべて空いている」は
#    「裏側が空いていた」という意味しかなかった。J2 は板の右の縁を 2.60 越えていて、
#    それを誰も捕まえられなかった（殻の側は「私が左と言ったので左を見た」）。
#    ⇒ **向きは表で持たない。置いてある足形から測る。**[[mirror-word-needs-proof]]
#
# 🔒 測り方: **口は必ずパッドと反対側に開く。**横挿しの口は、足が胴の後ろの端で板へ落ち、
#    胴がそこから前へ伸びて、その先が開いている（📄 ePH.pdf 3 ページの側面図。
#    足の (3.4) は胴の片方の端にしかない）。
#    ⇒ **パッドの重心から枠の中心へ向かう向き＝開いている向き。**
#      PH 2 ピン横で ±2.45 出る（枠 8.60 の中心とパッドのずれ）。X と Y のどちらが
#      大きいかで 4 方向に丸める。
# ⭐ 2026-09-16 夕に引き直した。🔴 **旧 3.1 は導出そのものが間違っていた。**
#   旧: 📄 2 ページ（SMT の図）の (9.6) − 6.0 − 逃げ 0.5 = 3.1。引いた 6.0 は**トップ型の背**で、
#       (9.6) が載っている**サイド型の奥行き 7.6** ではない。層の違う数どうしを引いていた。
#   正: 📄 1 ページ（Through-hole の組立図）  サイド型 (9.6) − 胴の奥行き 7.6 = **2.0**
#                                             トップ型 (8)   − 胴の背     6.0 = **2.0**
#   この表は courtyard の枠から測るので、逃げ 0.5 を引いて 1.5 を渡す（＝胴の縁から 2.0）。
PLUG_BODY = 1.5   # 相手のハウジングが **courtyard の縁**から出る量（胴の縁からは 2.0）
# ⚠ 押し離し（relax）だけは 3.1 のまま予約する。**検査の値ではなく置き方の手加減**である。
#    1.5 に詰めたら電源の区画の小物が流れ込み、D31 と Q31 が 2.3 × 1.29 重なって落ち着いた（2026-09-16 夕）。
#    口の前は指も取り付くので、置く段階では広めに空けておく方が結果が良い
PLUG_KEEP = 3.1


def plug_band(rect, d, n):
    """口の枠（**板の座標** x0, y0, x1, y1）の前へ、長さ n の帯を作る。

    🔴 向きの計算をここ 1 か所に閉じる。2026-09-13、同じ式を 3 か所に書いて
       2 か所で Y の符号を逆にした（gen_pcb の OPEN_DIR と parts_place の band）。
    """
    x0, y0, x1, y1 = rect
    dx, dy = d
    if dx:
        return (x1, y0, x1 + n, y1) if dx > 0 else (x0 - n, y0, x0, y1)
    return (x0, y1, x1, y1 + n) if dy > 0 else (x0, y0 - n, x1, y0)


def open_dir(fp, x, y, ang):
    """置いてある足形の「開いている向き」を測る。返すのは**板の座標**の単位ベクトル。"""
    a = math.radians(ang)
    px = py = 0.0
    n = 0
    for pd in find(fp, "pad"):
        q = find1(pd, "at")
        lx, ly = float(q[1]), float(q[2])
        px += x + lx * math.cos(a) + ly * math.sin(a)
        py += y - lx * math.sin(a) + ly * math.cos(a)
        n += 1
    px /= n
    py /= n
    b = courtyard(fp, x, y, ang)
    dx = (b[0] + b[2]) / 2 - px
    dy = -((b[1] + b[3]) / 2 - py)      # 図面の Y は下向き。板の Y へ直す
    return (1 if dx > 0 else -1, 0) if abs(dx) > abs(dy) else (0, 1 if dy > 0 else -1)

# ---- 板の面からの背の高さ [mm] ----
# 🔴 筐体側は板を「44 × 81.2 × 4.0 の塊」として持っていた（2026-09-13 に判明）。
#    実体に割るのに要るので、部品ごとの背をここに置く。**出どころを必ず付ける。**
#      📄 = データシート／図面で取った   ⚠ = 一般値（パッケージから推した・未確認）
HEIGHT = {
    "K31":  (9.33, "📄 en-g6s.pdf 5 ページ ＋ KiCad の STEP（Z 0〜9.330）"),
    # ⭐ 2026-09-16 夕に直した。2026-09-14 に「板の側は縦のメスソケット（背 8.5）」から
    #    **オスのピンヘッダ**（樹脂 2.5・ピンの先は板の面から 8.5）へ替えたのに、この表が 8.5 のままだった。
    #    ここで要るのは「板の上に立っている樹脂の塊」なので **2.5**。
    #    ピンの 6.0 はライザーの裏の L 字のメスが咥えるので、空間としては空いていない扱いでよい
    "J1":   (2.54, "🔒 2.54 ヘッダの規格の姿（樹脂 **2.54**・ピン 6.0・先は板の面から 8.54）。⭐ 2026-09-16 夕に 2.5 → 2.54（KiCad の 3D モデルの実測）"),
    "J2":   (2.54, "🔒 同上（1x04）"),   # 🔴 出どころの頭が 📄 か 🔒 でないと、gen_case_parts が 3D モデル（ピン込みの 8.65）で上書きする
    "J14":  (8.5,  "v6.1 に無い（XIAO の 2 列目・ライザーで 1 本になった）"),
    # 📄 ePH.pdf 3 ページ「Header（Through-hole type）・Side entry type」の側面図は
    #    **板が縦に描いてある**（足が横向きで (3.4) も横）。⇒ 4.8 が板からの高さ・7.6 が板の面の奥行き。
    #    courtyard 8.60 ＝ 7.6 ＋ 逃げ 0.5 × 2 で裏が取れる。
    #    挿した相手（PHR・厚み 4.5）は口の中に収まるので、**挿しても 4.8 を超えない**
    #    （📄 2 ページの SMT 型の組立図で、挿した外形の高さ (5.5) ＝ SMT の口自身の高さ 5.5）。
    # ⚠ 旧 "J2": (4.8, "📄 ePH.pdf 3 ページ Side entry") は、J2 が PH の横出しだった頃の残り。
    #    いまの J2 は OLED のライザーを受けるピンヘッダなので上へ移した（2026-09-16 夕）
    # 2026-09-16 夕に J4 と J6 を縦（Top entry）へ替えたので、背も 4.8 → 6.0。
    # J5 は口が板の左の縁を向いていて盤面を食わないので横出し（Side entry・4.8）のまま
    "J4":   (6.0,  "📄 ePH.pdf 3 ページ Top entry（B2B-PH-K の胴。嵌合は 8.0）"),
    "J5":   (4.8,  "📄 ePH.pdf 3 ページ Side entry"),
    "J6":   (6.0,  "📄 ePH.pdf 3 ページ Top entry（同上）"),
    # ⭐ 2026-09-16 夕にトップ型へ。📄 ePH.pdf 3 ページ Top entry の図で胴の背は 6.0、
    #    1 ページ「mounting height of 8 mm」で**嵌合した高さは 8.0**。板の裏が Z 12.0 なので床まで 4.0 余る
    "J7":   (6.0,  "📄 ePH.pdf 3 ページ Top entry（B2B-PH-K の胴。嵌合は 8.0）⭐ 2026-09-19 に 4 ピン → 2 ピン"),
    "SW2":  (5.8,  "📄 XKB5858-Z-E 図面（前の面 5.80±0.10 角・押し子の芯は板の上 2.9）"),
    "J10":  (6.0,  "📄 ePH.pdf 3 ページ Top entry（嵌合は 8.0・1 ページ）"),
    "Q2":   (1.1,  "⚠ 一般値 SOT-23（逆接保護の P-ch）"),
    "SW1":  (4.0,  "📄 MST-12D18G3.pdf（胴 3.5 ＋ 浮き 0.5。レバーは Z 2.3〜3.8）"),
    "J13":  (3.16, "⚠ 二次資料（PCBWiki）・メーカー図は未取得"),
    # 🔒 2026-09-13、JLCPCB の部品ページ（C79815）の仕様欄 `Height 1.75mm` で裏が取れた。
    #    ⚠ ただしこの欄の名前は部品によって違い、**板からの高さなのは `Z-Height of the Board` だけ**。
    #    SW1（C49023766）の `Switch Height 6.5mm` は板の面の奥行きで、板からの高さではない
    "U4":   (1.75, "📄相当 JLCPCB C79815 の仕様欄 Height 1.75mm"),
    "L1":   (1.8,  "型番の「18」＝ 1.8mm（FNR4018S）"),
    "C6":   (1.6,  "⚠ 一般値 1206 MLCC"),
    "C9":   (1.6,  "⚠ 一般値 1206 MLCC"),
    "R41":  (0.65, "⚠ 一般値 1206 合金シャント"),
    "D31":  (1.35, "⚠ 一般値 SOD-123"),
    "Q31":  (1.3,  "⚠ 一般値 SOT-23"),
    "U1":   (1.0,  "⚠ 一般値 VQFN-16"),
    "U2":   (0.9,  "⚠ 一般値 QFN-20"),
    "U3":   (1.1,  "⚠ 一般値 MSOP-10"),
}
HEIGHT_DEFAULT = (1.45, "⚠ 一般値・0805 の抵抗とコンデンサはこれ以下")

# 角度を検算する所。板の座標で「このパッドはここに来るはず」を書いておく。
# 🔴 鏡像事故はここで止める（[[mirror-accident-ledger]]）。1 本目と 7 本目の Y が入れ替わったら落ちる
# 🔴 置いたあとのパッドの位置を板の座標で検算する（角度の取り違えはここで捕まる）。
#    v6.1: ライザーのソケットは 1 番が左・パッドが +X へ 2.54 間隔（筐体へ渡した座標）。
CHECK_PADS = {
    # 🔒 2026-09-14: ライザーが裏面の L 字のメスで受ける形になり、ピンの列が +2.87 後ろへ動いた
    ("J1", "1"): (1.770, 12.105), ("J1", "7"): (17.010, 12.105),   # ⭐ 2026-09-19 +0.30（v61_board.py の RISER_XIAO）
    ("J2", "1"): (37.240, 4.770), ("J2", "4"): (44.860, 4.770),
    # 🔴🔴 電池の極性。裏面なので足形が鏡になる。ここが入れ替わると逆接で煙が出る
    #    （2026-09-11 に実機で INA226 から煙・PowerBoost が発熱している）。
    #    **奥（Y 大）が GND ／ 手前（Y 小）が VBAT（＋）** — PowerBoost B1 と同じ言い方。
    #    🔴 1 番 GND が**奥**（Y 16.950）・2 番 VBAT ＋ が**手前**（Y 14.950）
    ("J10", "1"): (75.700, 16.950), ("J10", "2"): (75.700, 14.950),
    # ⭐ 2026-09-16 夕: 逆接保護の P-ch（Q2）の向き。ここが回ると保護にならないので位置で縛る。
    #    SOT-23 は 1 番（G）と 2 番（S）が片側・3 番（D）が反対側で、**3 番＝ドレイン＝電池側**である。
    #    角度 0 で 3 番が +X 側（45.940）・1/2 番が −X 側（44.060）に並ぶ。J10（X 75.7）は Q2 の
    #    +X 側なので、電池は 3 番（ドレイン）から入る。ネットの対応（3=BATRAW・2=BATP・1=BATG）は check_sch.py が見る
    #    ⭐ 2026-09-17 夜: X を 1.0 送った。同日の夕に Q2 を 44.0 → 45.0 へ動かした（POWER_V61）のに
    #      この表が古いままで、生成のたびに「パッドの位置が違う Q2」が 3 行出ていた（向きは合っていた）。
    ("Q2", "1"): (44.060, 14.950), ("Q2", "2"): (44.060, 13.050), ("Q2", "3"): (45.940, 14.000),
    # USB-C は「パッドの列が板の内側」だけが条件（A1 と B1 のどちらが上かは足形が決める）。
    # 2026-09-16: 右の縁 → 後ろの縁（ハッチ側）。板の縁は Y 37.4 で、パッドの列が
    #    Y 31.000 ＝ 板の内側（胴の出 1.3・足 4 本）。X は足形の並びに任せる
    ("J13", "A1"): (None, 31.000), ("J13", "B1"): (None, 31.000),
}


def netlist():
    out = OUT / "_pcb.xml"
    r = subprocess.run([CLI, "sch", "export", "netlist", "--format", "kicadxml", "-o", str(out),
                        str(OUT / f"{NAME}.kicad_sch")], capture_output=True, text=True)
    if r.returncode != 0:
        sys.exit("ネットリストを書き出せない:\n" + r.stdout + r.stderr)
    root = ET.parse(out).getroot()
    out.unlink()
    comps = {}
    for c in root.iter("comp"):
        ref = c.get("ref")
        fp = c.findtext("footprint") or ""
        flds = {f.get("name"): (f.text or "") for f in c.iter("field")}
        comps[ref] = dict(fp=FP_OVERRIDE.get(ref, fp), value=c.findtext("value") or "",
                          lcsc=flds.get("LCSC", ""))
    pads, nets = {}, {}
    for net in root.iter("net"):
        nm = net.get("name").lstrip("/")
        nets.setdefault(nm, len(nets) + 1)
        for node in net.iter("node"):
            pads[(node.get("ref"), node.get("pin"))] = nm
    return comps, pads, nets


def load_fp(fp_id):
    lib, name = fp_id.split(":")
    p = (LOCAL if lib == "katanori" else FPDIR / f"{lib}.pretty") / f"{name}.kicad_mod"
    if not p.exists():
        sys.exit(f"足形が無い: {fp_id}")
    return kisym.parse(p.read_text(encoding="utf-8"))[0]


def rot_xy(x, y, ang):
    a = math.radians(ang)
    return (x * math.cos(a) + y * math.sin(a), -x * math.sin(a) + y * math.cos(a))


def courtyard(fp, x, y, ang, key="CrtYd"):
    """置いた足形の外接枠。key="Fab" にすると **胴（F.Fab／B.Fab）**の枠になる。

    ⭐ 2026-09-16 夕に key を足した。courtyard は KiCad が周りに 0.3〜0.5 の逃げを付けた
    **置き場所の予約**で、物の形ではない。板を貫いた足が板の反対側の物に当たるかは
    逃げではなく胴で見る（J10 を裏へ回して、J4 の逃げに 0.00 で触れる置き方が出た）。
    """
    xs, ys = [], []

    def walk(n):
        if isinstance(n, list):
            if n and n[0] in ("fp_line", "fp_poly", "fp_rect", "fp_circle"):
                lay = find1(n, "layer")
                if lay and key in str(lay[1]):
                    for k in ("start", "end", "center", "mid"):
                        for e in find(n, k):
                            xs.append(float(e[1]))
                            ys.append(float(e[2]))
                    for pts in find(n, "pts"):
                        for e in find(pts, "xy"):
                            xs.append(float(e[1]))
                            ys.append(float(e[2]))
            for e in n:
                if isinstance(e, list):
                    walk(e)
    walk(fp)
    if not xs and key != "CrtYd":   # その層が無い足形は courtyard で代用（安全側）
        return courtyard(fp, x, y, ang)
    if not xs:   # CrtYd の無い足形（自作）はパッドの範囲で代用
        for p in find(fp, "pad"):
            at = find1(p, "at")
            sz = find1(p, "size")
            for sx in (-1, 1):
                xs.append(float(at[1]) + sx * float(sz[1]) / 2)
                ys.append(float(at[2]) + sx * float(sz[2]) / 2)
    pts = [rot_xy(a, b, ang) for a in (min(xs), max(xs)) for b in (min(ys), max(ys))]
    return (x + min(p[0] for p in pts), y + min(p[1] for p in pts),
            x + max(p[0] for p in pts), y + max(p[1] for p in pts))


# 🔴 裏面の足形の書き方は、KiCad 自身の実例で確かめた（2026-09-14）。
#    C:/Program Files/KiCad/10.0/share/kicad/demos/cm5_minima/CM5_MINIMA_3.kicad_pcb に
#    同じ足形が表と裏の両方に置いてあり、**局所 Y だけが符号反転**して層が F↔B になっていた
#    （パッド 1 が F: (-1, 0.43) → B: (-1, -0.43)）。推測ではなく写した。
def mirror_y(node):
    """図形・パッドの局所座標の Y を反転する（裏面へ回すとき）。"""
    if not isinstance(node, list):
        return node
    if node and str(node[0]) in ("at", "start", "end", "center", "mid", "xy"):
        out = list(node)
        if len(out) > 2:
            try:
                out[2] = f"{-float(out[2]):g}"
            except ValueError:
                pass
        if str(node[0]) == "at" and len(out) > 3:      # 向きも反転
            try:
                out[3] = f"{(-float(out[3])) % 360:g}"
            except ValueError:
                pass
        return out
    return [mirror_y(e) for e in node]


def flip_layer(name):
    """F.* ↔ B.* を入れ替える（裏面に付ける部品用）。"""
    s = str(name)
    if s.startswith("F."):
        return "B." + s[2:]
    if s.startswith("B."):
        return "F." + s[2:]
    return s


def place_footprint(ref, comp, x, y, ang, pads, back=False):
    fp = load_fp(comp["fp"])
    if back:
        # 🔴 裏面は**足形ごと**局所 Y を反転してから使う。ここで 1 回だけ反転すれば、
        #    パッドも図形も枠（courtyard）も同じ物を見る。返す fp も反転済みなので、
        #    呼び出し側の当たり判定が「反転前の枠」を見る事故が起きない（2026-09-14 に踏んだ）
        fp = mirror_y(fp)
    # 🔴 記号（R15・C42…）は**一つも印刷しない**（2026-09-16 夕・ユーザー
    #    「口の名前と極性を入れて、SMD の記号は消してください」）。
    #    足形が持つ記号は「原点から上へ 2.5」の決め打ちにしか置けず、この密度では
    #    隣の部品やパッドの上に乗ってシルクが読めなくなっていた（R5 と R33 が
    #    重なって「R5-3R3」に見えていた）。自分で挿す口の番号は捨てずに、
    #    silk() が「J5 SPK OUT」の形で**名前と一緒に**置き直す。
    #    記号そのものは Value と同じく F.Fab／B.Fab へ回して隠す（部品表と実装位置は
    #    property を読むので、層を変えても壊れない）。
    tht = bool(find1(fp, "attr")) and "through_hole" in str(find1(fp, "attr")[1:])
    fab_lay = "B.Fab" if back else "F.Fab"
    # ⚠ 裏の層に置く文字は、隠してあっても鏡にしておく（KiCad の DRC が
    #    nonmirrored_text_on_back_layer で拾う）
    mir = [["justify", "mirror"]] if back else []

    def hidden_prop(nm, val, dy):
        return ["property", Str(nm), Str(val), ["at", "0", f"{dy}", "0"],
                ["layer", Str(fab_lay)], ["hide", "yes"], ["uuid", Str(uid())],
                ["effects", ["font", ["size", "0.8", "0.8"], ["thickness", "0.12"]]] + mir]

    out = ["footprint", Str(comp["fp"]), ["layer", Str("B.Cu" if back else "F.Cu")], ["uuid", Str(uid())],
           ["at", f"{x:.3f}", f"{y:.3f}"] + ([f"{ang:.0f}"] if ang else []),
           hidden_prop("Reference", ref, -2.5),
           hidden_prop("Value", comp["value"], 2.5),
           hidden_prop("LCSC", comp.get("lcsc", ""), 3.5),
           ["attr", "through_hole" if tht else "smd"]]
    for e in fp[2:]:
        if not isinstance(e, list) or e[0] in ("version", "generator", "generator_version", "layer",
                                               "descr", "tags", "attr", "property", "uuid", "embedded_fonts"):
            continue
        if e[0] == "pad":
            pad = [x for x in e if not (isinstance(x, list) and x[0] == "uuid")]
            # 🔴 パッドの at の 3 つ目は「板の上での向き」。部品を回したとき、位置は KiCad が回すが
            #    形は回らない（2026-09-12 に F.Cu の SVG を測って確認）。ここで足しておく
            if ang:
                # ⚠ 浅い複製なので at の中身はライブラリと共有している。作り直してから書く
                #    （共有したまま足すと、DSN に渡す向きにも二重に足さる）
                pa = list(find1(pad, "at"))
                pad[pad.index(find1(pad, "at"))] = pa
                a2 = ((float(pa[3]) if len(pa) > 3 else 0.0) + ang) % 360
                del pa[3:]
                if a2:
                    pa.append(f"{a2:.0f}")
            if back:
                lay = find1(pad, "layers")
                if lay:
                    pad[pad.index(lay)] = ["layers"] + [Str(flip_layer(str(s))) for s in lay[1:]]
            num = str(pad[1])
            net = pads.get((ref, num))
            if net is not None:
                pad = pad + [["net", str(NETNUM[net]), Str(net)]]
                if net == "GND" and ref in HAND_SOLDER and str(pad[2]) == "thru_hole":
                    pad = pad + [["zone_connect", "1"]]   # 1 = thermal relief（上の HAND_SOLDER）
            pad = pad + [["uuid", Str(uid())]]
            out.append(pad)
        elif e[0] == "model" and ref in MODEL_VIS:
            path, off = MODEL_VIS[ref]
            out.append(["model", Str(path),
                        ["offset", ["xyz", f"{off[0]}", f"{off[1]}", f"{off[2]}"]],
                        ["scale", ["xyz", "1", "1", "1"]], ["rotate", ["xyz", "0", "0", "0"]]])
        else:
            body = [x for x in e if not (isinstance(x, list) and x[0] == "uuid")]
            if back:
                lay = find1(body, "layer")
                if lay:
                    body[body.index(lay)] = ["layer", Str(flip_layer(str(lay[1])))]
                # ⚠ 足形が自分で持っている文字（JST の "${REFERENCE}" など）も、裏へ回したら
                #    鏡にする。付け忘れると DRC が nonmirrored_text_on_back_layer で拾う
                if e[0] == "fp_text":
                    eff = find1(body, "effects")
                    if eff is None:
                        eff = ["effects"]
                        body = body + [eff]
                    elif not find1(eff, "justify"):
                        eff = list(eff)
                        body[body.index(find1(body, "effects"))] = eff
                    if not find1(eff, "justify"):
                        eff.append(["justify", "mirror"])
                    elif "mirror" not in [str(t) for t in find1(eff, "justify")[1:]]:
                        j = list(find1(eff, "justify"))
                        eff[eff.index(find1(eff, "justify"))] = j + ["mirror"]
            # 🔴 シルクに出る線と字は、製造の下限（SILK_T = 0.15）まで太らせる。
            #    ⭐ 2026-09-16 夕。KiCad の標準ライブラリの枠線は 0.12 で、JLCPCB の
            #    capabilities（Rigid PCB）の "Minimum Line Width ≥ 0.15mm — Characters width
            #    less than 0.15mm will be unidentifiable" を下回っていた。
            #    表のシルクの**長さの 84%**（のべ 489.3mm / 313 本）がこれだった。
            #    ⚠ body は浅い複製で、中身はライブラリと**共有している**。中を書き換えると
            #       同じ足形を使う他の部品にも伝染するので、節ごと作り直して差し替える
            lay2 = find1(body, "layer")
            if lay2 and "SilkS" in str(lay2[1]):
                def _thicken(node, key):
                    w = find1(node, key)
                    if w is None or float(w[1]) >= SILK_T:
                        return node
                    return [c if not (isinstance(c, list) and c[0] == key) else [key, str(SILK_T)]
                            for c in node]
                st = find1(body, "stroke")
                if st is not None:
                    body[body.index(st)] = _thicken(st, "width")
                elif find1(body, "width") is not None:      # 古い書き方の足形
                    body = _thicken(body, "width")
                eff = find1(body, "effects")                # fp_text の字の太さ
                if eff is not None:
                    fnt = find1(eff, "font")
                    if fnt is not None and find1(fnt, "thickness") is not None:
                        eff2 = list(eff)
                        eff2[eff2.index(fnt)] = _thicken(fnt, "thickness")
                        body[body.index(eff)] = eff2
            # uuid を持てるのは図形・文字・ゾーンだけ（他に足すと KiCad が読めない）
            if e[0].startswith("fp_") or e[0] == "zone":
                body = body + [["uuid", Str(uid())]]
            out.append(body)
    return out, fp


def seg(x1, y1, x2, y2, layer="Edge.Cuts", width=0.1):
    return ["gr_line", ["start", f"{x1:.3f}", f"{y1:.3f}"], ["end", f"{x2:.3f}", f"{y2:.3f}"],
            ["stroke", ["width", str(width)], ["type", "default"]], ["layer", Str(layer)],
            ["uuid", Str(uid())]]


def rounded_outline():
    """角を BOARD_CR で丸めた外形（線 4 本 ＋ 弧 4 本）。欠きの無い板だけ（2026-09-18）。"""
    R, L, W, k = BOARD_CR, BOARD_L, BOARD_W, math.sqrt(0.5)
    o = [seg(*bx(R, 0), *bx(L - R, 0)), seg(*bx(L, R), *bx(L, W - R)),
         seg(*bx(L - R, W), *bx(R, W)), seg(*bx(0, W - R), *bx(0, R))]
    for cx, cy, sx, sy in ((L - R, R, 1, -1), (L - R, W - R, 1, 1), (R, W - R, -1, 1), (R, R, -1, -1)):
        st, md, en = bx(cx, cy + sy * R), bx(cx + sx * R * k, cy + sy * R * k), bx(cx + sx * R, cy)
        o.append(["gr_arc", ["start", f"{st[0]:.3f}", f"{st[1]:.3f}"], ["mid", f"{md[0]:.3f}", f"{md[1]:.3f}"],
                  ["end", f"{en[0]:.3f}", f"{en[1]:.3f}"], ["stroke", ["width", "0.1"], ["type", "default"]],
                  ["layer", Str("Edge.Cuts")], ["uuid", Str(uid())]])
    return o


def outline():
    """板の外形（44 × 81.2）と、上の縁の切り欠き。"""
    o = []
    # 左下 →（右回り）。上の辺は切り欠きで 2 本に割れる
    pts = outline_pts()
    if BOARD_CR > 0 and not NOTCHES:
        o += rounded_outline()
    else:
        for i in range(len(pts)):
            a, b = pts[i], pts[(i + 1) % len(pts)]
            o.append(seg(*bx(*a), *bx(*b)))
    # 柱が通る抜き（丸）
    for px, py, d in POSTS:
        X, Y = bx(px, py)
        o.append(["gr_circle", ["center", f"{X:.3f}", f"{Y:.3f}"],
                  ["end", f"{X + d / 2:.3f}", f"{Y:.3f}"],
                  ["stroke", ["width", "0.1"], ["type", "default"]], ["fill", "no"],
                  ["layer", Str("Edge.Cuts")], ["uuid", Str(uid())]])
    return o


def mounting_holes():
    """M2（φ2.2）4 つ。板 X 3.5 と 40.5・Y 3.5 と 69.5（37 × 66 の格子・🔒 筐体側 2026-09-13）。

    ⚠ DRC の lib_footprint_mismatch がこの 4 つで出る（2026-09-16・fp-lib-table を置いて
      検査が動くようになってから見えた）。**既知の差で、工場に出る物は一致している。**
        穴       np_thru_hole・円・(size 2.2 2.2)・(drill 2.2)  ← 元と完全に同じ
        layers   ここは "F&B.Cu"、元は "*.Cu"。2 層なので同じ意味
        欠け     元にある fp_circle 2 つ（Cmts.User の目印・F.CrtYd の枠）と fp_text と
                 attr の exclude_from_pos_files。どれもガーバーにもドリルにも出ない
      exclude_from_pos_files が無くても実装の位置ファイルには入らない。fab.py が
      --smd-only で出しているので、非メッキ穴はそもそも対象外（cpl.csv 48 行に留め穴は無い）。
      ⇒ この 4 件は残してよい。**別の名前の足形で mismatch が出たら、そちらは本物。**
    """
    o = []
    for mx, my in MOUNT:
        x, y = bx(mx, my)
        o.append(["footprint", Str("MountingHole:MountingHole_2.2mm_M2"), ["layer", Str("F.Cu")],
                  ["uuid", Str(uid())], ["at", f"{x:.3f}", f"{y:.3f}"], ["attr", "exclude_from_bom"],
                  ["pad", Str(""), "np_thru_hole", "circle", ["at", "0", "0"],
                   ["size", f"{MOUNT_D}", f"{MOUNT_D}"], ["drill", f"{MOUNT_D}"],
                   ["layers", Str("F&B.Cu"), Str("*.Mask")], ["uuid", Str(uid())]]])
    return o


# ---- シルク（読む人のための文字）----
# 🔴 板の上の文字は「自分で挿す口」のためだけに置く（2026-09-16 夕・ユーザー
#    「口の名前と極性を入れて、SMD の記号は消してください」）。
#    表面実装は JLCPCB が付けるので R15・C42 の記号は誰も読まない。読むのは
#    スルーホールの口を手で挿すときで、そこには番号（J4）しか出ていなかった。
#    名前は netlist の Value（"SPK IN" など）と同じ物を、印刷される層に出す。
SILK_H = 1.0          # 文字の高さ [mm]。製造の下限 0.8 に余裕を足す
SILK_T = 0.15         # 線の太さ [mm]。JLCPCB の下限ちょうど（記号の 0.12 は細すぎた）
SILK_GAP = 0.5        # 部品の枠から文字までの隙間 [mm]

# ref → (板に書く名前, 名前を置く向き)。向きは板の図面で N=上 S=下 W=左 E=右
# ⚠ 向きは**希望**。塞がっていれば silk() が残りの向きへ回し、回したことを画面に出す。
#    ここに書いてあるのは「回さずに収まる向き」なので、⚠ が出たら板の方が変わった合図。
# ⭐ 2026-09-19 🔒 ユーザー「口の下（前の縁の側）」: 口の名前は **S にそろえる**。
#   例外は 2 つ: J5（真下が J1 の枠）と、板の裏の J10（S に極性の ＋ − が座る）
SILK_PORT = {
    "J1":  ("XIAO",     "S"),
    "J2":  ("OLED",     "S"),
    "J4":  ("SPK IN",   "S"),   # W は U5 の枠に当たる。S は口の前の帯を外した下側
    "J5":  ("SPK OUT",  "N"),   # S は J1 の枠（J5 は J1 の真上に隙間 0.075 で座る）
    "J6":  ("BTN2",     "S"),   # ⭐ 2026-09-19: W → S。S を避けていたのは横出しの頃のプラグの帯で、縦になって消えた
    "J7":  ("REED", "S"),
    "SW2": ("POWER", "S"),
    "J10": ("BAT",      "N"),   # S は極性の ＋ − が先に座る。⭐ 2026-09-19: W → N（W は裏の AS5600 の枠が通る）
}
# 🔴 電池の極性。逆接で INA226 から煙が出た事故があるのに、板の上には一文字も無かった
#    （足形が持つピン 1 の小さな印だけ）。ネット名を出どころにして (ref, pin) で書く。
#    J10 は**裏**にあるので文字も B.SilkS に出る（鏡文字にする）。
SILK_POLARITY = {("J10", "2"): "+", ("J10", "1"): "-"}


def silk_text(txt, x, y, layer, just=None, h=SILK_H):
    e = ["effects", ["font", ["size", f"{h}", f"{h}"], ["thickness", str(SILK_T)]]]
    if just:
        # ⚠ justify の left／right／mirror は**裸の語**で書く。Str() で括ると KiCad が
        #    「'quoted string' が来た」と言って板ごと読めなくなる（2026-09-16 夕に踏んだ）
        e.append(["justify"] + list(just))
    return ["gr_text", Str(txt), ["at", f"{x:.3f}", f"{y:.3f}"], ["layer", Str(layer)],
            ["uuid", Str(uid())], e]


def text_w(txt, h=SILK_H):
    """KiCad の線の書体のおおよその幅 [mm]（板からはみ出していないかを見るだけ）。"""
    return len(txt) * h * 0.8


def silk(placed, boxes):
    """自分で挿す口の名前と、電池の極性を置く。

    位置は**置いたあとの枠**（relax を回したあとの courtyard）から決める。口が動いても
    文字が付いて回るように、数字をここに写さない。

    ⭐ 2026-09-16 夕に**当たり判定**を付けた。それまでは SILK_PORT に書いた向きへ黙って
    置くだけで、`J5 SPK OUT` と `J6 BTN2` が 1.2mm しか離れず「J5 SPK OUTJ6 BTN2」と
    一続きに読めていた（DRC は通る。文字どうしが触れてはいないので）。
    向きは希望として使い、**他の文字・部品の枠・パッド・板の縁**に当たるなら残りの向きへ回す。
    """
    out, warn = [], []
    box = dict(boxes)
    lim = (ORG[0], ORG[1], ORG[0] + BOARD_L, ORG[1] + BOARD_W)
    SIDES = ("N", "E", "S", "W")
    CLR = 0.3        # 文字のまわりに空けるすきま [mm]

    def inside(b):
        return b[0] >= lim[0] and b[1] >= lim[1] and b[2] <= lim[2] and b[3] <= lim[3]

    def hit(a, b):
        return a[0] < b[2] and b[0] < a[2] and a[1] < b[3] and b[1] < a[3]

    # ---- 避ける物を集める（面ごと）----
    pads = {"F": [], "B": []}
    for f in placed:
        at = find1(f, "at")
        fx, fy = float(at[1]), float(at[2])
        fa = float(at[3]) if len(at) > 3 else 0.0
        for q in find(f, "pad"):
            pa, sz = find1(q, "at"), find1(q, "size")
            if not sz:
                continue
            dx, dy = rot_xy(float(pa[1]), float(pa[2]), fa)
            r = max(float(sz[1]), float(sz[2])) / 2      # 向きを見ずに外接の丸で見る（安全側）
            lay = str(find1(q, "layers"))
            bb = (fx + dx - r, fy + dy - r, fx + dx + r, fy + dy + r)
            for side, nm in (("F", "F.Cu"), ("B", "B.Cu")):
                if nm in lay or "*.Cu" in lay:
                    pads[side].append(bb)

    # ---- 挿さったプラグの胴が板の上に出る帯 ----
    # 🔴 横挿しの口は、プラグの胴が口の前へ **courtyard の縁から PLUG_BODY** 出る。
    #    ここに文字を置くと DRC は通るのに**プラグで隠れて読めない**（📄 ePH.pdf 1 ページ）。
    #    帯の作り方は通り道の検査（build）と同じ plug_band に閉じる。数字をここに写さない。
    #    ⚠ plug_band と open_dir は **板の座標**で話すので、図面の座標へ直してから使う。
    fps = {}
    for f in placed:
        rs = [pr[2] for pr in find(f, "property") if str(pr[1]) == "Reference"]
        if rs:
            fps[str(rs[0])] = f

    def to_board(b):
        return (b[0] - ORG[0], BOARD_W - (b[3] - ORG[1]), b[2] - ORG[0], BOARD_W - (b[1] - ORG[1]))

    def to_draw(b):
        return (b[0] + ORG[0], ORG[1] + BOARD_W - b[3], b[2] + ORG[0], ORG[1] + BOARD_W - b[1])

    crt = {"F": [], "B": []}
    for r, b in boxes:
        crt["B" if r in BACK_SIDE else "F"].append((r, b))

    plugs = {"F": [], "B": []}
    for ref in CONN:
        if ref not in box or ref not in fps:
            continue
        f = fps[ref]
        at = find1(f, "at")
        ang = float(at[3]) if len(at) > 3 else 0.0
        d = open_dir(f, float(at[1]), float(at[2]), ang)
        band = to_draw(plug_band(to_board(box[ref]), d, PLUG_BODY))
        plugs["B" if ref in BACK_SIDE else "F"].append((ref, band))

    def blocked(bb, back, soft=False):
        """bb に何か居るか。soft=True なら部品の枠は見ない（最後の逃げ場）。"""
        if not inside(bb):
            return "板の外"
        for t in texts:
            if hit(bb, t):
                return "別の文字"
        for b in pads["B" if back else "F"]:
            if hit(bb, b):
                return "パッド"
        for r, b in plugs["B" if back else "F"]:
            if hit(bb, b):
                return f"{r} に挿したプラグの胴"
        if not soft:
            # ⚠ 枠は**同じ面の物だけ**。板の反対側に居る部品の胴は、この面のシルクを隠さない
            #    （これを面ごとにしないと、裏の J10 の極性が表の USB-C の枠に塞がれる）
            for r, b in crt["B" if back else "F"]:
                if hit(bb, b):
                    return f"{r} の枠"
        return None

    texts = []       # 置いた文字の枠（次の文字はここを避ける）

    def put(txt, ref, side, h, back, anchor):
        """anchor（枠）の side 側へ txt を置く。当たるなら他の向きを試す。"""
        x0, y0, x1, y1 = anchor
        w = text_w(txt, h)
        for soft in (False, True):
            for sd in (side,) + tuple(t for t in SIDES if t != side):
                if sd in ("N", "S"):
                    cx = (x0 + x1) / 2
                    cy = y0 - SILK_GAP - h / 2 if sd == "N" else y1 + SILK_GAP + h / 2
                    just = ["mirror"] if back else None
                    bb = (cx - w / 2, cy - h / 2, cx + w / 2, cy + h / 2)
                else:
                    cy = (y0 + y1) / 2
                    cx = x0 - SILK_GAP if sd == "W" else x1 + SILK_GAP
                    j = "right" if sd == "W" else "left"
                    if back:                       # 裏は鏡なので左右の寄せも入れ替わる
                        j = "left" if j == "right" else "right"
                    just = [j] + (["mirror"] if back else [])
                    bb = ((cx - w, cy - h / 2, cx, cy + h / 2) if sd == "W"
                          else (cx, cy - h / 2, cx + w, cy + h / 2))
                why = blocked((bb[0] - CLR, bb[1] - CLR, bb[2] + CLR, bb[3] + CLR), back, soft)
                if why:
                    continue
                if sd != side:
                    warn.append(f"{ref}「{txt}」は {side} が塞がっていたので {sd} へ回した")
                if soft:
                    warn.append(f"{ref}「{txt}」は部品の枠の上に乗せた（他に空きが無い）")
                texts.append(bb)
                out.append(silk_text(txt, cx, cy, "B.SilkS" if back else "F.SilkS", just, h=h))
                return True
        warn.append(f"{ref}「{txt}」を置く場所が無い")
        return False

    # ---- 先に極性。パッドの真ん中から、口の枠の外へまっすぐ逃がす ----
    pad_at = {}
    for f in placed:
        rs = [pr[2] for pr in find(f, "property") if str(pr[1]) == "Reference"]
        if not rs:
            continue
        at = find1(f, "at")
        fx, fy = float(at[1]), float(at[2])
        fa = float(at[3]) if len(at) > 3 else 0.0
        for q in find(f, "pad"):
            if not str(q[1]):
                continue
            pa = find1(q, "at")
            dx, dy = rot_xy(float(pa[1]), float(pa[2]), fa)
            pad_at[(str(rs[0]), str(q[1]))] = (fx + dx, fy + dy)

    pol_h = SILK_H * 1.4        # 極性は少し大きく（一番読めないと困る文字）
    for (ref, pin), mark in sorted(SILK_POLARITY.items()):
        if (ref, pin) not in pad_at or ref not in box:
            warn.append(f"{ref}.{pin} が見つからないので極性を置けない")
            continue
        px, py = pad_at[(ref, pin)]
        x0, y0, x1, y1 = box[ref]
        # 2 つのパッドが並んでいる軸を見て、**直角の向き**へ逃がす。
        # パッドの真上／真横に置きたいので、枠は「そのパッドの列」に細めて渡す
        pins = [v for (r, _), v in pad_at.items() if r == ref]
        horiz = (max(q[0] for q in pins) - min(q[0] for q in pins)
                 >= max(q[1] for q in pins) - min(q[1] for q in pins))
        anchor = ((px, y0, px, y1) if horiz else (x0, py, x1, py))
        put(mark, f"{ref}.{pin}", "S" if horiz else "E", pol_h, ref in BACK_SIDE, anchor)

    # ---- 口の名前（番号と一緒に「J5 SPK OUT」の形で置く）----
    for ref, (name, side) in sorted(SILK_PORT.items()):
        if ref not in box:
            warn.append(f"{ref} が板に無いので名前を置けない")
            continue
        put(f"{ref} {name}", ref, side, SILK_H, ref in BACK_SIDE, box[ref])

    print(f"  シルク: 口の名前 {len(SILK_PORT)} 個・極性 {len(SILK_POLARITY)} 個")
    for w in warn:
        print(f"  ⚠ シルク {w}")
    return out


# ⭐ 2026-09-19 🔒 ユーザー「裏のシルクに枠を書いて型番を書いておこうかと」「型番と役割を書いてください」:
#   板の上で値段の高い部品 5 つ（LCSC の 1 個の単価・2026-09-19）の真裏を枠で囲み、型番と役割を書く（鏡文字）。
#   ⚠ 置くのは配線と縫いのビアの後（route.py）。名前はビアの上に乗ってよい（膜で塞いである）
SILK_COST = [
    ("U1",  "TPS61090RSAR",     "5V BOOST"),       # $2.23
    ("U2",  "MCP73871-2CCI/ML", "LIPO CHARGER"),   # $2.20
    ("K31", "G6S-2F DC5",       "MUTE RELAY"),     # $1.49
    ("U4",  "AS5600-ASOT",      "ANGLE SENSOR"),   # $1.37
    ("U3",  "INA226AIDGSR",     "BAT MONITOR"),    # $0.78
    # 🔒 ユーザー「シャントとケルビンの形も書いておいてほしいです。今回一番失敗したので」:
    #   値段ではなく戒め。センスの線を内側の縁から取らず、10mΩ に 86.7mΩ が足されて 9.7 倍に読んだ（kelvin_tracks の注）
    ("R41", "SHUNT 10mΩ",       "KELVIN SENSE"),
    # 🔒 ユーザー「XIAOとOELDのインターフェイスも囲ってほしいです」: 値段ではなく、手で挿す口
    ("J1",  "1x7 2.54mm",       "XIAO RISER"),
    ("J2",  "1x4 2.54mm",       "OLED I2C"),
    # 🔒 ユーザー「電源スイッチも欲しいです」
    ("SW2", "XKB5858-Z-E",      "POWER SWITCH"),
]
COST_PAD = 0.4        # パッドの外接から枠の線まで [mm]
SILK_TITLE = ["Katanori ver6.1n", "2026-09-20"]   # 裏から見て右上。日付は板を直したら書き換える
FACE_W = 12.0         # 顔を描く画面（128 ドット）の幅 [mm]
FACE_MIC = 0.25       # 口の大きさを決める声の大きさ（0〜1）
COST_R = 0.6          # 枠の角の丸み [mm]


def cost_silk(pcb):
    """SILK_COST の部品の真裏に角の丸い枠と、型番・役割の 2 行を置く gr_* の並びを返す。"""
    h, CLR, W = SILK_H, 0.3, SILK_T
    ext, bpads, texts = {}, [], []
    for f in find(pcb, "footprint"):
        at = find1(f, "at")
        fx, fy = float(at[1]), float(at[2])
        fa = float(at[3]) if len(at) > 3 else 0.0
        rs = [p[2] for p in find(f, "property") if str(p[1]) == "Reference"]
        ref = str(rs[0]) if rs else ""
        for q in find(f, "pad"):
            pa, sz = find1(q, "at"), find1(q, "size")
            dx, dy = rot_xy(float(pa[1]), float(pa[2]), fa)
            pr = (float(pa[3]) if len(pa) > 3 else fa) % 180
            rx, ry = (float(sz[1]) / 2, float(sz[2]) / 2) if abs(pr - 90) > 45 else (float(sz[2]) / 2, float(sz[1]) / 2)
            bb = (fx + dx - rx, fy + dy - ry, fx + dx + rx, fy + dy + ry)
            if ref:
                e = ext.get(ref, bb)
                ext[ref] = (min(e[0], bb[0]), min(e[1], bb[1]), max(e[2], bb[2]), max(e[3], bb[3]))
            lay = str(find1(q, "layers"))
            if "B.Cu" in lay or "*.Cu" in lay or str(q[2]) in ("thru_hole", "np_thru_hole"):
                bpads.append(bb)
        if ref in BACK_SIDE and ref in ext:  # 裏の部品（J10）は胴のシルクごと避ける
            e = ext[ref]
            texts.append((e[0] - 2.5, e[1] - 1.5, e[2] + 2.5, e[3] + 1.5))
    for t in find(pcb, "gr_text"):
        if "B.SilkS" in str(find1(t, "layer")):
            at = find1(t, "at")
            j = str(find1(find1(t, "effects"), "justify") or "")
            w = len(str(t[1])) * h * 1.4 * 0.95
            x, y = float(at[1]), float(at[2])
            if "left" in j:                  # 鏡文字は寄せの向きと伸びる向きが逆になる
                x0 = x - w if "mirror" in j else x
            elif "right" in j:
                x0 = x if "mirror" in j else x - w
            else:
                x0 = x - w / 2
            texts.append((x0 - 1.0, y - h - 1.0, x0 + w + 1.0, y + h + 1.0))

    def hit(a, b):
        return a[0] < b[2] and b[0] < a[2] and a[1] < b[3] and b[1] < a[3]

    def on_board(bb):
        u0, v0 = xb(bb[0], bb[3])
        u1, v1 = xb(bb[2], bb[1])
        if min(edge_gap(u, v) for u in (u0, u1) for v in (v0, v1)) < 0.5:
            return False
        return not any(nx0 - 0.5 < u1 and u0 < nx1 + 0.5 and v1 > ny - 0.5 for nx0, nx1, ny in NOTCHES)

    def line(a, c):
        return ["gr_line", ["start", f"{a[0]:.3f}", f"{a[1]:.3f}"], ["end", f"{c[0]:.3f}", f"{c[1]:.3f}"],
                ["stroke", ["width", str(W)], ["type", "solid"]], ["layer", Str("B.SilkS")], ["uuid", Str(uid())]]

    def arc(c, r, a0):
        pt = [(c[0] + r * math.cos(math.radians(a)), c[1] + r * math.sin(math.radians(a))) for a in (a0, a0 + 45, a0 + 90)]
        return ["gr_arc", ["start", f"{pt[0][0]:.3f}", f"{pt[0][1]:.3f}"], ["mid", f"{pt[1][0]:.3f}", f"{pt[1][1]:.3f}"],
                ["end", f"{pt[2][0]:.3f}", f"{pt[2][1]:.3f}"],
                ["stroke", ["width", str(W)], ["type", "solid"]], ["layer", Str("B.SilkS")], ["uuid", Str(uid())]]

    out, frames, taken_k = [], [], []
    for ref, part, role in SILK_COST:
        if ref not in ext:
            print(f"  ⚠ 裏のシルク: {ref} が板に無い")
            continue
        e = ext[ref]
        x0, y0, x1, y1 = e[0] - COST_PAD, e[1] - COST_PAD, e[2] + COST_PAD, e[3] + COST_PAD
        r = COST_R
        out += [line((x0 + r, y0), (x1 - r, y0)), line((x1, y0 + r), (x1, y1 - r)),
                line((x1 - r, y1), (x0 + r, y1)), line((x0, y1 - r), (x0, y0 + r)),
                arc((x1 - r, y0 + r), r, 270), arc((x1 - r, y1 - r), r, 0),
                arc((x0 + r, y1 - r), r, 90), arc((x0 + r, y0 + r), r, 180)]
        frames.append((ref, part, role, (x0, y0, x1, y1)))
        if any(hit((x0 - W, y0 - W, x1 + W, y1 + W), b) and not hit((x0 + W, y0 + W, x1 - W, y1 - W), b) for b in bpads):
            print(f"  ⚠ 裏のシルク: {ref} の枠の線が裏のパッドに掛かる")

    # ---- つまみの軸のガイドの輪郭（AS5600 の上に立つ印刷部品。真上から見た形）----
    # 🔒 ユーザー「AS5600のガイドはその四角ではなく、ガイド部品の輪郭です」。形は case_v6_1.scad の kg_plate2d():
    #   軸の芯に丸 KG_HUB_D ＋ 足の穴（半径 VB.GUIDE_R・60／180／300°）へ幅 KG_ARM_W の腕、先に丸 KG_PAD_D。
    #   ⚠ 数字は scad から読む（書き写さない）。腕の先の丸が腕の幅より大きくなったら、この描き方（腕の先 ＝ 半円）は成り立たない
    kg = {k: float(v) for k, v in re.findall(r"(KG_HUB_D|KG_ARM_W|KG_PAD_D) = ([0-9.]+)",
                                             (HERE.parents[0] / "case_v6_1.scad").read_text(encoding="utf-8"))}
    assert kg["KG_PAD_D"] <= kg["KG_ARM_W"] + 1e-9, "ガイドの足の丸が腕より太い。輪郭の描き方を変える"
    Rh, wa, Ra = kg["KG_HUB_D"] / 2, kg["KG_ARM_W"] / 2, VB.GUIDE_R
    t0 = math.sqrt(Rh ** 2 - wa ** 2)       # 腕の縁が軸の丸と交わる所（腕の向きの距離）
    da = math.degrees(math.atan2(wa, t0))

    def P(ang, t, off=0.0):                 # 芯から ang 度へ t、左へ off（板の座標）→ 図面の座標
        a_ = math.radians(ang)
        return bx(SHAFT_CX + t * math.cos(a_) - off * math.sin(a_), SHAFT_CY + t * math.sin(a_) + off * math.cos(a_))

    def arc3(p0, pm, p1):
        return ["gr_arc", ["start", f"{p0[0]:.3f}", f"{p0[1]:.3f}"], ["mid", f"{pm[0]:.3f}", f"{pm[1]:.3f}"],
                ["end", f"{p1[0]:.3f}", f"{p1[1]:.3f}"],
                ["stroke", ["width", str(W)], ["type", "solid"]], ["layer", Str("B.SilkS")], ["uuid", Str(uid())]]
    arms = sorted(math.degrees(math.atan2(hy - SHAFT_CY, hx - SHAFT_CX)) % 360 for hx, hy in VB.GUIDE_HOLES)
    for i, ang in enumerate(arms):
        nxt = arms[(i + 1) % len(arms)] + (360 if i == len(arms) - 1 else 0)
        out.append(line(P(ang, t0, -wa), P(ang, Ra, -wa)))           # 腕の右の縁
        out.append(line(P(ang, t0, wa), P(ang, Ra, wa)))             # 腕の左の縁
        out.append(arc3(P(ang, Ra, -wa), P(ang, Ra + wa), P(ang, Ra, wa)))   # 腕の先（足の丸）
        m = (ang + da + nxt - da) / 2                               # 次の腕までの軸の丸
        out.append(arc3(P(ang + da, Rh), P(m, Rh), P(nxt - da, Rh)))
    # 名前が輪郭の線に乗らないように、線の上の点を塞ぐ（形の中は空けておく。名前は中に入ってよい）
    edge = []
    for ang in arms:
        edge += [P(ang, t0 + (Ra - t0) * k / 40, o) for k in range(41) for o in (-wa, wa)]
        edge += [P(ang, Ra + wa * math.cos(math.radians(q)), wa * math.sin(math.radians(q)))
                 for q in range(-90, 91, 5)]
    for q in range(0, 360, 2):
        X, Y = P(q, Rh)
        a_ = min(abs((q - ang + 180) % 360 - 180) for ang in arms)
        if a_ >= da:
            edge.append((X, Y))
    e_ = W / 2 + CLR
    taken_k += [(X - e_, Y - e_, X + e_, Y + e_) for X, Y in edge]

    # ---- ケルビンの線（銅の線の真裏を、同じ形でなぞる）----
    #   ⚠ 座標は写さない。銅の線を作る kelvin_tracks() に同じ板を渡して、同じ点を取る
    #   🔒 ユーザー: 抵抗の記号 → 枠とパッド → 枠だけ → 「パッドもあったほうがいいです」。
    #   R41 は他の部品と同じ枠、その中に R41 と U3（8・10 番）のパッドの輪郭。
    #   線が**パッドの内側の縁**から出ているのが見えないと、絵の意味が無い
    fps = find(pcb, "footprint")
    for ref, pad in (("R41", "1"), ("R41", "2"), ("U3", "8"), ("U3", "10")):
        px, py, pw, ph = pad_box(fps, ref, pad)
        a, b = (px - pw / 2, py - ph / 2), (px + pw / 2, py + ph / 2)
        out += [line((a[0], a[1]), (b[0], a[1])), line((b[0], a[1]), (b[0], b[1])),
                line((b[0], b[1]), (a[0], b[1])), line((a[0], b[1]), (a[0], a[1]))]
    for net, _, _, pts in kelvin_tracks(fps):
        out += [line(a, c) for a, c in zip(pts, pts[1:])]
        for a, c in zip(pts, pts[1:]):
            taken_k.append((min(a[0], c[0]) - 0.4, min(a[1], c[1]) - 0.4, max(a[0], c[0]) + 0.4, max(a[1], c[1]) + 0.4))

    # ---- 型番と役割（2 行）。枠の上か下にそろえて置き、塞がっていれば左右、最後に少しずつ離す ----
    PITCH = h * 1.5
    taken = [(b[0] - CLR, b[1] - CLR, b[2] + CLR, b[3] + CLR) for _, _, _, b in frames] + taken_k
    for ref, part, role, (x0, y0, x1, y1) in frames:
        w = max(len(part), len(role)) * h * 0.95
        th = PITCH + h
        cx, cy = (x0 + x1) / 2, (y0 + y1) / 2
        cand = []
        for gap in [0.4 + 0.2 * k for k in range(16)]:
            for sx in [0.0] + [d * s for d in (1.0, 2.0, 3.0, 4.0, 5.0) for s in (1, -1)]:
                cand.append(("上", cx + sx, y0 - gap - th / 2))
                cand.append(("下", cx + sx, y1 + gap + th / 2))
            cand.append(("左", x0 - gap - w / 2, cy))
            cand.append(("右", x1 + gap + w / 2, cy))
        # 上下左右に無ければ、枠の芯から近い順に広く探す（シャントは U3 と U2 に挟まれている）
        cand += sorted((("近く", cx + i * 0.2, cy + j * 0.2) for i in range(-50, 51) for j in range(-60, 61)),
                       key=lambda c: (c[1] - cx) ** 2 + (c[2] - cy) ** 2)
        for where, x, y in cand:
            bb = (x - w / 2 - CLR, y - th / 2 - CLR, x + w / 2 + CLR, y + th / 2 + CLR)
            if on_board(bb) and not any(hit(bb, o) for o in bpads + texts + taken):
                taken.append((bb[0] - 1.0, bb[1] - 1.0, bb[2] + 1.0, bb[3] + 1.0))
                out.append(silk_text(part, x, y - PITCH / 2, "B.SilkS", ["mirror"], h=h))
                out.append(silk_text(role, x, y + PITCH / 2, "B.SilkS", ["mirror"], h=h))
                print(f"  裏のシルク {ref}「{part} / {role}」: 枠の{where}")
                break
        else:
            print(f"  ⚠ 裏のシルク {ref}「{part}」を置く場所が無い")

    # ---- 板の名前と日付（裏から見て右上 ＝ 図面の左上の角に近い空き）----
    # 🔒 ユーザー「右上にKatanori ver6.1n あと今日の日付を」（2026-09-19）
    tw = max(len(t) for t in SILK_TITLE) * h * 0.95
    title_at = None
    th = PITCH * (len(SILK_TITLE) - 1) + h
    X0, Y0 = ORG
    for dx, dy in sorted(((i * 0.2, j * 0.2) for i in range(0, 200) for j in range(0, 90)),
                         key=lambda d: d[0] ** 2 + (2 * d[1]) ** 2):
        x, y = X0 + 1.0 + tw / 2 + dx, Y0 + 1.0 + th / 2 + dy
        bb = (x - tw / 2 - CLR, y - th / 2 - CLR, x + tw / 2 + CLR, y + th / 2 + CLR)
        if on_board(bb) and not any(hit(bb, o) for o in bpads + texts + taken):
            for k, t in enumerate(SILK_TITLE):
                out.append(silk_text(t, x, y - th / 2 + h / 2 + k * PITCH, "B.SilkS", ["mirror"], h=h))
            taken.append(bb)
            title_at = (x, bb[3])            # 顔はこの下に置く（文字の芯にそろえる）
            print(f"  裏のシルク「{' / '.join(SILK_TITLE)}」: 角から ({dx:.1f}, {dy:.1f})")
            break
    else:
        print(f"  ⚠ 裏のシルク「{SILK_TITLE[0]}」を置く場所が無い")

    # ---- カタノリの顔（画面の目と口。裏から見て右上、板の名前の下）----
    # 🔒 ユーザー「下にカタノリの顔（画面出力の目と口）を書いておいてください」（2026-09-19）
    #   形は firmware/core/Face.cpp の話している顔（SPEAK）: 128 × 64 の画面に 目の丸 2 つ ＋ 口の四角。
    #   ⚠ 数字は Face.cpp から読む（書き写さない）。口の大きさは声の大きさ FACE_MIC のとき
    src = (HERE.parents[1] / "firmware" / "core" / "Face.cpp").read_text(encoding="utf-8")
    sp = src[src.index("case RobotState::SPEAK:"):]
    num = lambda k: float(re.search(k + r" = ([0-9.]+)f", sp).group(1))
    lx, rx_, ey, er = num("target.leftCx"), num("target.rightCx"), num("target.leftCy"), num("target.rx")
    mw0, mw1 = map(float, re.search(r"mouthWidth = ([0-9.]+)f \+ micLevelSmooth_ \* ([0-9.]+)f", src).groups())
    mh0, mh1 = map(float, re.search(r"mouthHeight = ([0-9.]+)f \+ micLevelSmooth_ \* ([0-9.]+)f", src).groups())
    mcx, mcy = map(float, re.search(r"mX = ([0-9]+) - mW / 2;\s*int mY = ([0-9]+) - mH / 2", src).groups())
    mw, mh = mw0 + mw1 * FACE_MIC, mh0 + mh1 * FACE_MIC
    k_ = FACE_W / 128.0
    fw, fh = FACE_W, 64 * k_
    shapes = [("c", lx, ey, er), ("c", rx_, ey, er), ("r", mcx - mw / 2, mcy - mh / 2, mcx + mw / 2, mcy + mh / 2)]
    # 描く物の外接（画面の座標）: 目の上端から口の下端まで
    sx0, sy0 = lx - er, ey - er
    sx1, sy1 = rx_ + er, max(ey + er, mcy + mh / 2)
    bw, bh = (sx1 - sx0) * k_, (sy1 - sy0) * k_
    # 🔒 ユーザー（絵で指定）「こっちです」: 最初は下の縁に置いたが、右上の板の名前と日付の**すぐ下**（文字の芯にそろえる）
    X0, Y1 = title_at if title_at else (ORG[0] + BOARD_L / 2, ORG[1])
    for dx, dy in sorted(((i * 0.2, j * 0.2) for i in range(-50, 51) for j in range(0, 60)),
                         key=lambda d: (d[0] / 2) ** 2 + d[1] ** 2):
        x, y = X0 + dx, Y1 + 0.6 + bh / 2 + dy          # 板の名前の下の縁から
        bb = (x - bw / 2 - CLR, y - bh / 2 - CLR, x + bw / 2 + CLR, y + bh / 2 + CLR)
        if on_board(bb) and not any(hit(bb, o) for o in bpads + texts + taken):
            ox, oy = x - bw / 2 - sx0 * k_, y - bh / 2 - sy0 * k_   # 画面の (0,0) の位置
            st = ["stroke", ["width", str(W)], ["type", "solid"]]
            for sh in shapes:
                if sh[0] == "c":
                    cx, cy, rr = ox + sh[1] * k_, oy + sh[2] * k_, sh[3] * k_
                    out.append(["gr_circle", ["center", f"{cx:.3f}", f"{cy:.3f}"], ["end", f"{cx + rr:.3f}", f"{cy:.3f}"],
                                st, ["fill", "yes"], ["layer", Str("B.SilkS")], ["uuid", Str(uid())]])
                else:
                    out.append(["gr_rect", ["start", f"{ox + sh[1] * k_:.3f}", f"{oy + sh[2] * k_:.3f}"],
                                ["end", f"{ox + sh[3] * k_:.3f}", f"{oy + sh[4] * k_:.3f}"],
                                st, ["fill", "yes"], ["layer", Str("B.SilkS")], ["uuid", Str(uid())]])
            print(f"  裏のシルク 顔（幅 {bw:.1f} × 高さ {bh:.1f}・口 {mw:.0f}×{mh:.1f} ドット）: 板の名前の下から ({dx:+.1f}, {dy:.1f})")
            break
    else:
        print("  ⚠ 裏のシルク 顔を置く場所が無い")
    return out


def vbus_zone():
    """🔴 USB-C の足元に VBUS の小さなベタを置く（2026-09-13）。

    J13 の VBUS は A4・B4・A9・B9 の 4 パッドあり、真ん中の A4 が両隣の信号に囲まれて
    自動配線が届かなかった（未配線 1 本がこれだけ残った）。口の足元にベタを敷けば 4 つが
    まとめてつながる。ふつうの板でも電源はこう引く。
    """
    # ⭐ 2026-09-16: 口を右の縁から前の縁へ移したとき、この長方形が置き去りになって
    #    板の右端に VBUS の島（isolated_copper）が残った。**口の向きに追従させる。**
    #    パッドの列は足形の原点から 4.04 内側（口の反対側）にある。
    x, y, ang = PLACE["J13"]
    d = 4.04
    cx, cy = {0: (x, y + d), 90: (x - d, y), 180: (x, y - d), 270: (x + d, y)}[int(ang) % 360]
    hw, hh = (5.6, 1.6) if int(ang) % 180 == 0 else (1.6, 5.6)
    r = (cx - hw, cy - hh, cx + hw, cy + hh)      # 板の座標での長方形（パッドの列を覆う）
    pts = [(r[0], r[1]), (r[2], r[1]), (r[2], r[3]), (r[0], r[3])]
    poly = ["polygon", ["pts"] + [["xy", f"{bx(*q)[0]:.3f}", f"{bx(*q)[1]:.3f}"] for q in pts]]
    return [["zone", ["net", str(NETNUM["VBUS"])], ["net_name", Str("VBUS")],
             ["layer", Str("F.Cu")], ["uuid", Str(uid())], ["name", Str("VBUS")],
             ["priority", "1"], ["hatch", "edge", "0.5"],
             ["connect_pads", "yes", ["clearance", "0.25"]],
             ["min_thickness", "0.25"], ["filled_areas_thickness", "no"],
             ["fill", "yes", ["thermal_gap", "0.2"], ["thermal_bridge_width", "0.5"]],
             poly]]


def fp_lib_table(items):
    """足形のライブラリの表（fp-lib-table）を板から作る（2026-09-16）。

    ⭐ これが無いと kicad-cli の DRC は「ライブラリが構成に含まれていません」を足形の数だけ出して、
      **「板の足形が元のライブラリと同じ形か」の検査を丸ごと諦める**（v6.1 では 59 件＝全数）。
      59 件は「問題が 59 個」ではなく「1 度も検査していない」という意味だった。
    置くだけで検査が動く。⚠ 警告 0 になるのではなく、**本当の差が出るようになる**のが目的。
    パスは ${KICAD10_FOOTPRINT_DIR}（KiCad が解く）で書く。PC ごとに KiCad の場所が違うので
    絶対パスにしない（kicad_paths.py の注と同じ理由）。
    """
    # ⚠ placed だけでは足りない。留め穴は mounting_holes() が別に足すので、板の全体から拾う
    libs = sorted({str(e[1]).split(":")[0] for e in items
                   if isinstance(e, list) and e and e[0] == "footprint"})
    rows = ["(fp_lib_table", "  (version 7)"]
    for n in libs:
        uri = ("${KIPRJMOD}/../%s.pretty" % n) if n == "katanori" else ("${KICAD10_FOOTPRINT_DIR}/%s.pretty" % n)
        rows.append('  (lib (name "%s")(type "KiCad")(uri "%s")(options "")(descr ""))' % (n, uri))
    rows.append(")")
    (OUT / "fp-lib-table").write_text(chr(10).join(rows) + chr(10), encoding="utf-8")
    return libs


def ep_vias(placed, nets):
    """放熱パッド（EP）に GND のビアを 2×2 で打つ（2026-09-16・ステップ 3）。

    U1（TPS61090・EP 2.7×2.7）も U2（MCP73871・EP 2.5×2.5）も、データシートは
    「EP をグラウンド面へビアで落とす」前提である。2 層で表の GND ベタだけだと裏へ熱が逃げない。
    MCP73871 は 1A 充電で 1W 近く出る。
    ⚠ 置く場所は **その時の配置から計算する**。座標を書き写すと、部品を動かしたとき置き去りになる
      （USB-C を動かしたとき VBUS のベタが板の右端に残った・同日）。
    穴は縫いのビアと同じ φ0.6/0.3（新しい穴の種類を増やさない）。
    """
    out = []
    for fp in placed:
        ref = next((str(e[2]) for e in find(fp, "property") if str(e[1]) == "Reference"), None)
        if ref not in ("U1", "U2"):
            continue
        fat = find1(fp, "at")
        fx, fy, fa = float(fat[1]), float(fat[2]), float(fat[3]) if len(fat) > 3 else 0.0
        for pad in find(fp, "pad"):
            sz = find1(pad, "size")
            w, h = float(sz[1]), float(sz[2])
            if w < 2.0 or h < 2.0:                     # EP だけ（ふつうのパッドは 1mm 以下）
                continue
            pat = find1(pad, "at")
            dx, dy = rot_xy(float(pat[1]), float(pat[2]), fa)
            cx, cy = fx + dx, fy + dy
            ox, oy = w / 4, h / 4                      # 2×2（EP の四半分の芯）
            for sx in (-1, 1):
                for sy in (-1, 1):
                    out.append(["via", ["locked", "yes"], ["at", f"{cx + sx * ox:.4f}", f"{cy + sy * oy:.4f}"],
                                ["size", "0.6"], ["drill", "0.3"],
                                ["layers", Str("F.Cu"), Str("B.Cu")],
                                ["net", str(nets["GND"])], ["uuid", Str(uid())]])
    return out


def pad_box(placed, ref, num):
    """置いた足形からパッドの (中心x, 中心y, 幅, 高さ) を出す（板の図面の座標）。"""
    for fp in placed:
        r = next((str(e[2]) for e in find(fp, "property") if str(e[1]) == "Reference"), None)
        if r != ref:
            continue
        fat = find1(fp, "at")
        fx, fy, fa = float(fat[1]), float(fat[2]), float(fat[3]) if len(fat) > 3 else 0.0
        for pad in find(fp, "pad"):
            if str(pad[1]) != num:
                continue
            pat, sz = find1(pad, "at"), find1(pad, "size")
            dx, dy = rot_xy(float(pat[1]), float(pat[2]), fa)
            w, h = float(sz[1]), float(sz[2])
            # 🔴 縦横はパッドの**板の上での角度**で決める。置いた足形のパッドの (at x y 角度) には
            #    **部品の角度が既に入っている**（KiCad の書き方。90° の C8 のパッドは 90、270° の U3 は 270）。
            #    ⚠ 2026-09-17 に「部品の角度も足す」を入れたが、そのときはパッドに角度が無かった。
            #    後でパッドに角度が入るようになり、足すと 90°／270° で二重に回って縦横が元に戻っていた
            #    （2026-09-19 に C7 の先引きで見つけた。cap_gnd_vias の「他のパッドの箱」も入れ替わっていた）。
            #    パッドに角度が無いときだけ部品の角度を使う
            ang = float(pat[3]) if len(pat) > 3 else fa
            if ang % 180 == 90:
                w, h = h, w
            return fx + dx, fy + dy, w, h
    raise SystemExit("パッドが見つからない: %s.%s" % (ref, num))


def kelvin_tracks(placed):
    """シャント R41 のケルビンの線 2 本を、置いてある R41 と U3 から作る。

    電流は R41 の中を X 方向に流れる（右の 1 番から左の 2 番へ）。センスは
    **パッドの内側の縁から、電流と直角に**出す。ここを守らないと途中の銅が
    シャントに足し算され、INA226 が読み違える（並べ直す前は 10mΩ に 86.7mΩ が
    足されて 9.7 倍だった）。
    ⚠ 座標を書き写さない。書き写すと R41 か U3 を動かしたとき線がパッドから外れ、
      しかも **DRC は未接続を出さない**（別経路で繋がるため）ので黙って 10 倍に戻る。
    """
    out = []
    for rpad, upad, net in (("1", "10", "BATP"), ("2", "8", "VLIPO")):
        rx, ry, rw, rh = pad_box(placed, "R41", rpad)
        ox, _, _, _ = pad_box(placed, "R41", "2" if rpad == "1" else "1")
        ux, uy, _, uh = pad_box(placed, "U3", upad)
        inner = rx - rw / 2 if ox < rx else rx + rw / 2      # 相手のパッドを向いた縁
        tap_x = inner + (0.18 if ox < rx else -0.18)
        tap_y = ry - rh / 2 + 0.075 if uy < ry else ry + rh / 2 - 0.075
        end_y = uy + uh / 2 - 0.24 if uy < ry else uy - uh / 2 + 0.24
        mid_y = tap_y - 1.2 if uy < ry else tap_y + 1.2
        out.append((net, "F.Cu", 0.25, [(round(tap_x, 3), round(tap_y, 3)),
                                        (round(ux, 3), round(mid_y, 3)),
                                        (round(ux, 3), round(end_y, 3))]))
    return out


def v5_trunk(placed):
    """V5 の幹（U1 の足元 → XIAO のライザー）を **裏の面**で通す（2026-09-17 夕）。

    J1 の 1 番（V5）は板の左の端 X 1.77 にあり、U1 から 21mm ある。表で西へ抜ける道は
    U1 の下の辺（パッドの下端 Y 11.625）と V5 の出力コンデンサの列のあいだ 1.4mm の
    廊下しか無く、そこへ FB の R3・R4 を入れた。自動配線は **内層 In2** へ逃げたが、
    JLCPCB の 4 層は内層が 0.5oz なので同じ幅でも抵抗が 2 倍になり、U1 → XIAO が
    16.9 → 64.9mΩ に増えた（0.3A で 5.1 → 19.5mV）。
    裏は J10 しか居らず空いている。ここを通せば 15mΩ 前後で、しかも毎回同じ道になる。
    ⚠ 座標を書き写さない。両端はパッドの中心から取る。
    """
    # ⚠ 起点は **C6**。C2 から出すと U1 → C2 が 12.3mΩあり（R4 が間に入っている）
    #   幹の手前で損する。U1 → C6 は 2.3mΩで、C2 は逆にこの幹から館うことになる。
    cx, cy, _, _ = pad_box(placed, "C6", "1")       # U1 の足元の V5（出力コンデンサの V5 側）
    jx, jy, _, _ = pad_box(placed, "J1", "1")       # XIAO へ渡す V5。貫通なので裏に出ている
    c, j = xb(cx, cy), xb(jx, jy)
    y = c[1] - 1.39                                  # 板の手前へ。C2 のパッドの下の縁の 0.665 下
    k = 1.73                                         # 45° で板の左の端へ寄せる量
    tracks = [("V5", "F.Cu", V5_W, [bx(c[0], c[1]), bx(c[0], y)]),
              ("V5", "B.Cu", V5_W, [bx(c[0], y), bx(j[0] + k, y), bx(j[0], y + k), bx(j[0], j[1])])]
    return tracks, [("V5", bx(c[0], y))]


def bat_trunk(placed):
    """電池の生の線（J10 → 逆接保護 Q2）を **裏の面**で通す（2026-09-17 夕）。

    自動配線はこれを **内層 In2** に 34mm 載せていた。0.5oz なので 56.6mΩ ＝ 充電 1A で
    57mV。⚠ 同じ日の朝に「31.16mm・25.5mΩ（B.Cu）」と書いたのは私の誤りで、層を見ずに
    長さだけで計算していた。裏は J10 しか居らず空いているので、そこを通す。
    J10 は裏の部品・Q2 は表なので、Q2 の手前で 1 つだけ穴を開ける。

    🔒 ユーザー 2026-09-17 夕「数ミリΩをきにするのに、実働に影響が出そうな場所に線を
       通そうとするのはどうなんだろうな」。最初は J10 から Q2 へ Y 14.95 の一直線で引き、
       AS5600（U4・板の X 63.75〜67.65・Y 11.35〜16.25）の**真裏**を通していた。
       磁気の見積もりでは 0.063°（分解能 0.088° の 1 段未満）だが、これは磁石の 50mT と
       戻りの打ち消しを**仮に置いた**計算で、測った値ではない。
       ⇒ 前（Y 9.5）の帯へ下ろして U4 から離す。代償は **+4.6mΩ**（23.9 → 28.5mΩ）で、
         これは見えない。見えない物を払って、測っていない仮定の上のリスクを消す。
    """
    jx, jy, _, _ = pad_box(placed, "J10", "2")
    qx, qy, qw, _ = pad_box(placed, "Q2", "3")
    j, q = xb(jx, jy), xb(qx, qy)
    vx = q[0] + qw / 2 + 0.82        # Q2 の 3 番のパッドの外。φ0.6 の穴とすきまが入る
    # ⭐ 2026-09-17 夕（2 度目の引き直し）: 前は Y 9.5 の帯を西へ走らせていたが、AS5600 の胴の
    #   下端 11.35 から **1.85mm** しかなく、ユーザーに「AS5600 付近に極太線通すのやめませんか」
    #   と言われた。U4 のまわりの立入禁止（build() の ko）の外を回る。
    #     lane_x … 立入禁止の東の縁（U4 の芯の右 5.5）の 0.8 外。つまみを左へ 2.0 動かす前は 72.0 で J4 の足（X 73.7 から）の 1.4 手前
    #     lane_y  6.5 … U4 の胴の下端から 4.85 下。取付穴 (79.354, 3.5) の逃げ 5.1 より上
    lane_x, lane_y = SHAFT_CX + 6.3, 6.5
    y0 = j[1] - 1.45                 # J10 の足から下りる所。ここから 45°
    ky = y0 - (j[0] - lane_x)        # 45° で lane_x に着く Y。J4 の足の上端 10.425 を越える高さ
    tracks = [("BATRAW", "B.Cu", BAT_W, [bx(j[0], j[1]), bx(j[0], y0),
                                         bx(lane_x, ky), bx(lane_x, lane_y),
                                         bx(vx + (q[1] - lane_y), lane_y), bx(vx, q[1])]),
              ("BATRAW", "F.Cu", BAT_W, [bx(vx, q[1]), bx(q[0], q[1])])]
    return tracks, [("BATRAW", bx(vx, q[1]))]


def vbus_trunk(placed):
    """USB-C から充電 IC の入口（C8 と U2 の 17〜19 番）までを太い道で通す。

    VBUS は幅を決める組に入っていない（U2 の QFN-20 の 6 本から 0.4mm が逃げられないため）。
    そのもとで自動配線が幹も 0.2mm で内層へ逃がし、J13 → U2 が **102.5mΩ**、
    うち In2.Cu 0.2mm × 17.6mm が 87mΩ だった（2026-09-17 夕）。
    MCP73871 はリニア充電なので VBUS には **充電電流 ＋ 機体の電流**が乗る。
    実測からの見積もりで 約 0.78A、R16 1.0kΩ の設計上限で 約 1.22A。
    このファイルの幅の表は 0.2mm で外層 1oz 許容 0.74A で、**内層はその半分 約 0.37A**。

    ⭐ 2026-09-17 夜: **最後の枝も太くした。**前は幹（J13 → C8）だけ 0.6mm で、C8 → U2 の
      18・19 番は「3mm の枝」のつもりで自動配線に任せていた。板を測ると実際は
      B.Cu 0.2mm × 3.3mm → 穴 → F.Cu 0.2mm × 2.7mm ＋ ピンの足 0.66 の **6.6mm・16mΩ**で、
      太くした幹（15.2mm・12.5mΩ）より大きかった。原因は線幅ではなく**配置**:
        ・C8 が横向きで U2 の左上に居て、2 番（GND）の下端と U2 のピン列のあいだが 0.66mm
        ・C8 の 2 番が乗る表の GND の島に穴が無く、GND の 0.2mm 線が C8 の 1 番の真下を横切る
      ⇒ C8 を**縦（90°）**にして、1 番を U2 の 17・18・19 番（3 本とも VBUS で隣どうし）の
        真上に置く。1 番からピンへは VBUS_PIN_W の線をまっすぐ降ろす。隣の 20 番（VSYS）と
        16 番（VLIPO）までは 0.275 ずつ残る（線 1.2 の縁 ±0.6・ピンの縁 ±0.875）。
        幹は 1 番の**左の横**で表へ上がる（真上は 2 番 ＝ GND が居る）。
    SEL・PROG2・TE への枝は無電流なので自動配線に任せたまま。
    """
    ax, ay, _, ah = pad_box(placed, "J13", "A9")     # USB-C の VBUS（左側の 1 組）
    cx, cy, cw, ch = pad_box(placed, "C8", "1")      # 充電 IC の入口のコンデンサ
    px, py, _, ph = pad_box(placed, "U2", "18")      # 充電 IC の入力（17・18・19 番の真ん中）
    a = xb(ax, ay); c = xb(cx, cy); u = xb(px, py)
    if abs(c[0] - u[0]) > 0.05 or c[1] < u[1]:
        raise SystemExit("C8 の 1 番が U2 の 18 番の真上に居ない: C8.1 (%.3f, %.3f)・U2.18 (%.3f, %.3f)。"
                         "押し離しで動いたなら POWER_V61 の C8 を直すこと" % (c + u))
    y1 = a[1] - 1.7          # J13 のパッドの下。USB-C の殻の足（板 Y 30.87〜32.97）を避ける
    vx = c[0] - cw / 2 - 0.15 - VIA4[0] / 2 - 0.1    # C8 の 1 番の左の横。穴 φ0.6 ＋ すきま 0.15 ＋ 余り 0.1
    k = a[0] - vx            # 45° で左へ寄せる量（X の差）
    # ピンへ降ろす線の下の端。丸い端（半径 VBUS_PIN_W / 2）が U2 の EP（GND）へ寄らないよう、
    # 線の芯はピンの外の端から 0.15 だけ中で止める（丸い端はピンの長さ 0.82 の中に収まる）
    y_pin = u[1] + ph / 2 - 0.15
    tracks = [("VBUS", "F.Cu", BAT_W, [bx(a[0], a[1]), bx(a[0], y1)]),
              ("VBUS", "B.Cu", BAT_W, [bx(a[0], y1), bx(vx, y1 - k), bx(vx, c[1])]),
              ("VBUS", "F.Cu", BAT_W, [bx(vx, c[1]), bx(c[0], c[1])]),
              ("VBUS", "F.Cu", VBUS_PIN_W, [bx(c[0], c[1]), bx(u[0], y_pin)])]
    return tracks, [("VBUS", bx(a[0], y1)), ("VBUS", bx(vx, c[1]))]


# 電源のコンデンサの GND を、パッドのすぐ横で GND の面（In1）へ落とす（2026-09-17 夜）。
#   (部品, パッド, 穴を置く向き ＝ 板の座標の (dx, dy)・Y は上向き)
#   塗ったベタで測ると、最寄りの GND の穴まで C6 3.7mm・C9 2.6mm・C1 3.6mm、
#   C8 は同じ島に穴が 1 つも無く、GND を 0.2mm の線で C7 まで引いていた。
#   📄 TPS61090 データシート 12.1: 主電流とパワー GND の道は短く太く・入力と出力の
#      コンデンサは IC のできるだけ近く。In1 は表の 0.1mm 下なので、穴 1 つで戻りの輪が閉じる。
#   向きは「相手のパッドの反対」ではなく**空いている側**で選んである（C6 の右は C9 の V5 で 0.55 しか無い）。
#   ⚠ C8 は上（R13 の側）。左は裏を降りてくる VBUS の幹（vbus_trunk()）の真上で、置くと短絡する
#     （一度そう置いた。check_pre() はそのとき足した）。右は C41 の V33 まで 0.1 しか無い。
#   ⚠ C2（2.2µF）は入れていない。下は裏の V5 の幹（v5_trunk()）の真上・上は R4 の FB まで 0.18・
#     右は C6 の V5 まで 0.15 で、置ける側が無い。隣の C6 の穴（C2 の 2 番から 4.9mm）が受け持つ。
CAP_GND_VIAS = [("C8", "2", (0, 1)), ("C6", "2", (0, -1)), ("C9", "2", (1, 0)),
                ("C1", "2", (0, 1)), ("C7", "2", (0, 1)), ("C41", "2", (0, 1)),
                ("R44", "2", (0, -1)), ("R45", "2", (0, -1))]
CAP_GND_W = 0.5      # パッドから穴までの線。パッドの短い辺 1.0 より細く


def cap_gnd_vias(placed):
    """CAP_GND_VIAS の穴と、パッドから穴までの短い線を作る。→ (線, 穴)"""
    others = []          # GND でないパッドの箱（図面の座標）。穴が寄りすぎていないかを見る
    for fp in placed:
        ref = next((str(e[2]) for e in find(fp, "property") if str(e[1]) == "Reference"), None)
        for pad in find(fp, "pad"):
            net = find1(pad, "net")
            if net and str(net[-1]).strip('"') == "GND":
                continue
            X, Y, w, h = pad_box(placed, ref, str(pad[1])) if ref else (0, 0, 0, 0)
            others.append((ref, str(pad[1]), X - w / 2, Y - h / 2, X + w / 2, Y + h / 2))
    tracks, vias = [], []
    for ref, num, (dx, dy) in CAP_GND_VIAS:
        X, Y, w, h = pad_box(placed, ref, num)
        p = xb(X, Y)
        reach = (w / 2 if dx else h / 2) + 0.2 + VIA4[0] / 2      # パッドの縁から穴の縁まで 0.2（C8 の上は R13 まで 1.07 しか無い）
        v = (p[0] + dx * reach, p[1] + dy * reach)
        VX, VY = bx(*v)
        for oref, onum, x0, y0, x1, y1 in others:
            gap = math.hypot(max(x0 - VX, 0, VX - x1), max(y0 - VY, 0, VY - y1)) - VIA4[0] / 2
            if gap < 0.2:
                raise SystemExit("GND の穴 %s.%s が %s.%s に %.3f まで寄る。CAP_GND_VIAS の向きを直すこと"
                                 % (ref, num, oref, onum, gap))
        tracks.append(("GND", "F.Cu", CAP_GND_W, [bx(*p), (VX, VY)]))
        vias.append(("GND", (VX, VY)))
    return tracks, vias


def check_pre(tracks, vias):
    """先に引いた穴が、別のネットの先に引いた線に乗っていないか（貫通穴なので層は問わない）。

    どちらも protect で渡すので自動配線は直さず、DRC まで行って初めて短絡と出る。ここで止める。
    """
    bad = []
    for vnet, (VX, VY) in vias:
        for net, lay, w, pts in tracks:
            if net == vnet:
                continue
            for (x1, y1), (x2, y2) in zip(pts, pts[1:]):
                dx, dy = x2 - x1, y2 - y1
                L = dx * dx + dy * dy
                t = 0.0 if L == 0 else max(0.0, min(1.0, ((VX - x1) * dx + (VY - y1) * dy) / L))
                gap = math.hypot(VX - (x1 + t * dx), VY - (y1 + t * dy)) - VIA4[0] / 2 - w / 2
                if gap < 0.15:
                    bad.append("%s の穴 (%.3f, %.3f) ↔ %s の線（%s）: すきま %.3f"
                               % (vnet, *xb(VX, VY), net, lay, gap))
    if bad:
        raise SystemExit("先に引いた穴と線が当たる:" + NL + "  " + (NL + "  ").join(bad))


def pre_vias(nets):
    """_PRE_VIAS（先に引いた線が層を替える所）を板の要素にする。"""
    return [["via", ["locked", "yes"], ["at", f"{X:.4f}", f"{Y:.4f}"],
             ["size", f"{VIA4[0]}"], ["drill", f"{VIA4[1]}"],
             ["layers", Str("F.Cu"), Str("B.Cu")],
             ["net", str(nets[net])], ["uuid", Str(uid())]]
            for net, (X, Y) in _PRE_VIAS]


def vlipo_link(placed):
    """充電 IC U2 の 15 番とシャント R41 の 2 番を、表で直に結ぶ（2026-09-17 夕）。

    ここは U2 の右の辺（PROG1・PROG3）と R41・U3 に挙まれた幅 2.6mm の谷で、
    自動配線は引けたり引けなかったりする。R3・R4 を動かしたときに引けなくなり、
    PROG1 のビアが斜めの区間の 0.771mm 横に来ていた（要るのは 0.75）。
    電池の道は幅も道もこちらで決めておきたいので、先に引いて protect で守る。
    PROG1 は信号なので、よける側に回す。
    ⚠ 座標を書き写さない。両端はパッドの中心から取る。
    """
    ax, ay, _, _ = pad_box(placed, "R41", "2")
    bx_, by_, _, _ = pad_box(placed, "U2", "15")
    # 45° で寄せる量。両側から挑む。
    #   小さい→ 斜めの区間が U3 の下のパッドの列（6 番 V33・下端 Y 16.17）に寄る。
    #     0.9 だと 0.488（要るのは 0.3 ＋ 0.15 ＋ パッドの半分 0.15 ＝ 0.6）。
    #   大きい→ PROG1 の逃げ道の端（U2 の 13 番から 1.612）に寄る。1.5 で 1.054（要るのは 0.575）。
    k = 1.5
    sx = 1.0 if bx_ > ax else -1.0
    sy = 1.0 if by_ > ay else -1.0
    pts = [(ax, ay), (ax, by_ - sy * k), (ax + sx * k, by_), (bx_, by_)]
    return ("VLIPO", "F.Cu", BAT_W, [(round(x, 3), round(y, 3)) for x, y in pts])


def c7_link(placed):
    """C7 の 1 番（VLIPO）から、U2 の 15 番（VLIPO）へまっすぐ下ろす（2026-09-19）。

    線は C7 の 1 番の中心の X で縦に下り、15 番の高さで止まる（15 番・14 番は同じ VLIPO なので重なってよい）。
    横にある 16 番（VLIPO）・17 番（VBUS）とのすきまを見る。17 番まで 0.15 無ければ止める。
    ⚠ 座標を書き写さない。両端はパッドの中心から取る。
    """
    cx, cy, _, _ = pad_box(placed, "C7", "1")
    ux, uy, _, _ = pad_box(placed, "U2", "15")
    vx, _, vw, _ = pad_box(placed, "U2", "17")
    gap = (cx - BAT_W / 2) - (vx + vw / 2)
    if gap < 0.15:
        raise SystemExit("c7_link: U2 の 17 番（VBUS）まで %.3f しか無い" % gap)
    return ("VLIPO", "F.Cu", BAT_W, [(round(cx, 3), round(cy, 3)), (round(cx, 3), round(uy, 3))])


def u2_16_link(placed):
    """U2 の 16 番（VLIPO・上の辺の右端）から、右の c7_link の線へまっすぐ出す（2026-09-19）。

    c7_link を先に引くと、16 番の右は 0.5mm の隙間になり、自動配線が入れずに 16 番だけ浮いた。
    幅はパッドの幅（0.25）に合わせる。下の 15 番（VLIPO）の上の縁まで 0.4 以上ある。
    """
    px, py, _, _ = pad_box(placed, "U2", "16")
    cx, _, _, _ = pad_box(placed, "C7", "1")
    return ("VLIPO", "F.Cu", 0.25, [(round(px, 3), round(py, 3)), (round(cx, 3), round(py, 3))])


def escape_stub(placed, ref, num, net, length=1.2, w=0.25):
    """細ピッチのパッドから、部品の外へまっすぐ出す短い線を作る。

    QFN の 0.5mm ピッチの辺は、隣のパッドとの廊下が 0.25mm しかなく、自動配線が
    通せずにそのピンだけ浮かせることがある（U2 の 9 番 VBUS で何度も起きた）。
    パッドの列の外まで出してやれば、その先は自動配線が拾う。
    向きは **部品の中心からパッドへ**の向き（長い辺の軸）で決める。
    """
    px, py, pw, ph = pad_box(placed, ref, num)
    for fp in placed:
        r = next((str(e[2]) for e in find(fp, "property") if str(e[1]) == "Reference"), None)
        if r == ref:
            fat = find1(fp, "at")
            cx, cy = float(fat[1]), float(fat[2])
            break
    if ph >= pw:                      # 縦長のパッド ＝ 上下の辺 ⇒ Y へ出す
        d = ph / 2 + length
        end = (px, py + d if py > cy else py - d)
    else:                             # 横長 ＝ 左右の辺 ⇒ X へ出す
        d = pw / 2 + length
        end = (px + d if px > cx else px - d, py)
    return (net, "F.Cu", w, [(round(px, 3), round(py, 3)), (round(end[0], 3), round(end[1], 3))])


def pre_tracks(nets):
    """PRE_TRACKS を板の要素（locked を付けた segment）にする。"""
    out = []
    for net, lay, w, pts in PRE_TRACKS + _KELVIN:
        for (xa, ya), (xb, yb) in zip(pts, pts[1:]):
            if f"{xa:.4f},{ya:.4f}" == f"{xb:.4f},{yb:.4f}":
                continue
            out.append(["segment", ["start", f"{xa:.4f}", f"{ya:.4f}"], ["end", f"{xb:.4f}", f"{yb:.4f}"],
                        ["width", f"{w:.3f}"], ["locked", "yes"], ["layer", Str(lay)],
                        ["net", str(nets[net])], ["uuid", Str(uid())]])
    return out


def gnd_zone():
    """🔴 裏面に GND のベタを敷く（2026-09-13）。

    GND は 47 パッドあって全ネットの中で断然いちばん多く、これを自動配線に引かせると
    板が詰まって別のネットが残る（EN と VSYS が 2 本落ちた）。ベタにすれば自動配線から
    47 パッドぶんが消え、同時に戻りの経路も良くなる。
    ⚠ ベタ任せにするとパッドが島に取り残されることがある。**それは KiCad の DRC が
    unconnected_items で出す**ので、検査で捕まえられる。
    """
    pts = outline_pts()
    poly = ["polygon", ["pts"] + [["xy", f"{bx(*q)[0]:.3f}", f"{bx(*q)[1]:.3f}"] for q in pts]]
    # 🔴 **両面に敷く。**裏だけだと、表面実装の GND パッド（この板の GND のほとんど）が
    #    裏のベタに届かない（2026-09-13・裏だけで試したら 40 パッドが未接続で出た）。
    return [["zone", ["net", str(NETNUM["GND"])], ["net_name", Str("GND")],
             ["layer", Str(lay)], ["uuid", Str(uid())], ["name", Str("GND")],
             ["hatch", "edge", "0.5"],
             # 🔴 パッドはベタ直結（thermal relief を使わない）。
             #    足付きの部品だけ thermal にすると、PH や USB-C のシェルのように **幅 1.0mm の
             #    細いパッド**で spoke が 1 本しか立たず、KiCad が starved_thermal（error）を出す。
             #    橋の幅を 0.4〜1.2 で振っても 1 件は残った（2026-09-13）。
             #    ⚠ 代償: 手はんだする足付きの GND（J2・J4・J5・J6・J10・J14 の 7 点）に熱が逃げる。
             #    2 層 1oz なので実害は小さいと見ているが、組むときに温度が要るなら記録すること。
             ["connect_pads", "yes", ["clearance", "0.3"]],
             ["min_thickness", "0.25"], ["filled_areas_thickness", "no"],
             ["fill", "yes", ["thermal_gap", "0.2"], ["thermal_bridge_width", "0.5"]],
             [x for x in poly]] for lay in ("F.Cu", "In1.Cu", "B.Cu")]


NETNUM = {}
INSTS = []
NPTH = []      # 金属化していない穴のまわり（銅を置かせない四角）
# ⚠ 絵のためだけの 3D モデルの差し替え。KiCad 10 は TYPE-C-31-M-12 のモデルを同梱していないので、
#    ピン数と向きが同じ別の USB-C（GCT USB4105・16P 横挿し）を見た目の確認用に割り当てる。
#    **実際に載る部品は C165948（TYPE-C-31-M-12）のままで、足形も変えていない。**
MODEL_VIS = {"J13": ("${KICAD10_3DMODEL_DIR}/Connector_USB.3dshapes/"
                     "USB_C_Receptacle_GCT_USB4105-xx-A_16P_TopMnt_Horizontal.step", (0.0, 0.365, 0.0))}
# 🔒 筐体側が座標を決めた部品。押し離しの対象にしない（動かすと筐体と合わなくなる）
# 🔴 口も動かさない（2026-09-13）。押し離しは**動かす前の**枠からプラグの通り道を作るので、
#    口が動くと通り道だけが取り残され、他の部品がそこへ流れ込む（J2 の通り道に R41 が残った）。
#    口の位置はどれも総当たりで決めた値なので、動かす理由も無い
FIXED = {"J13", "J1", "J14", "U4", "SW1", "J2", "J4", "J5", "J6", "J10", "SW2"}
MARGIN = 0.5      # 板の縁から部品の枠まで


def fp_pad(p):
    """足形のパッド 1 つ → dsn.py に渡す形。"""
    at = find1(p, "at")
    sz = find1(p, "size")
    return dict(num=str(p[1]), type=str(p[2]), shape=str(p[3]),
                size=(float(sz[1]), float(sz[2])),
                at=(float(at[1]), float(at[2])),
                rot=float(at[3]) if len(at) > 3 else 0.0)


def relax(placed, boxes, rounds=3000):
    """枠が重なっている部品を少しずつ押し離す。🔒 FIXED（筐体側が決めた座標）は動かさない。

    置いた位置の狙い（上の PLACE）は残したいので、動かすのは重なっている分だけにする。
    """
    idx = {b[0]: i for i, b in enumerate(boxes)}
    movable = set(PLACE) - FIXED
    lo = (ORG[0] + MARGIN, ORG[1] + MARGIN)
    hi = (ORG[0] + BOARD_L - MARGIN, ORG[1] + BOARD_W - MARGIN)

    def shift(ref, dx, dy):
        i = idx[ref]
        r, (x0, y0, x1, y1) = boxes[i]
        dx = max(lo[0] - x0, min(hi[0] - x1, dx))
        dy = max(lo[1] - y0, min(hi[1] - y1, dy))
        boxes[i] = (r, (x0 + dx, y0 + dy, x1 + dx, y1 + dy))
        at = find1(placed[i], "at")
        at[1] = f"{float(at[1]) + dx:.3f}"
        at[2] = f"{float(at[2]) + dy:.3f}"
        for it in INSTS:      # 自動配線へ渡す座標も一緒に動かす（別々に持つと片方だけ動く）
            if it["ref"] == ref:
                it["x"] += dx
                it["y"] += dy
        return dx, dy

    # 板の外へ出ている物と、切り欠き・磁石の柱に掛かっている物を先に押し戻す
    blocks = [bx(n[0], n[2]) + bx(n[1], BOARD_W) for n in NOTCHES]
    blocks.append(bx(KEEPOUT_MAGNET[0], KEEPOUT_MAGNET[1]) + bx(KEEPOUT_MAGNET[2], KEEPOUT_MAGNET[3]))
    # 🔴 取付穴（無メッキ）が部品の枠の中に入ると KiCad の DRC が npth_inside_courtyard で落ちる。
    #    配線まで回してから気づくと遠いので、置く段階で押し出す（2026-09-13 に J4 で踏んだ）
    for mxy in MOUNT:
        cx, cy = bx(*mxy)
        r = MOUNT_D / 2 + MOUNT_KEEP
        blocks.append((cx - r, cy - r, cx + r, cy + r))
    for px, py, d in POSTS:                 # 柱の抜き
        cx, cy = bx(px, py)
        r = d / 2 + POST_KEEP
        blocks.append((cx - r, cy - r, cx + r, cy + r))
    # 🔴 口の前の「プラグの通り道」も押し出す所に入れる。入れないと、他の部品が後から
    #    そこへ流れ込む（2026-09-13・電源ブロックを広げたら J2 の通り道に U1 と R13 が入った）。
    #    位置は PLACE の初期値から作る（口はほとんど動かない）。自分の通り道では押されない
    exempt = {}
    for ref, (side, need) in CONN.items():
        if ref not in PLACE:
            continue
        x, y, ang = PLACE[ref]
        ang = 0 if not isinstance(ang, int) else ang
        b = boxes[idx[ref]][1]
        at = find1(placed[idx[ref]], "at")
        dx, dy = open_dir(placed[idx[ref]], float(at[1]), float(at[2]), ang)
        # 🔴 押し離すのは**相手の胴 3.1** だけ。残り（指と曲がり）まで押すと、
        #    板の真ん中に 10mm の空き地が 5 つできて押し離しが発散した（2026-09-13）。
        #    指の側は検査で「何が下に居るか」を出すだけにする
        need = PLUG_KEEP
        if dx:
            r = (b[2], b[1], b[2] + need, b[3]) if dx > 0 else (b[0] - need, b[1], b[0], b[3])
        else:   # 板の座標の +Y は図面の −Y
            r = (b[0], b[1] - need, b[2], b[1]) if dy > 0 else (b[0], b[3], b[2], b[3] + need)
        # 🔴 通り道のうち**板の外**の部分は、板の上の部品を押す理由が無い（そこに部品は置けない）。
        #    板へ切り詰めてから入れる。2026-09-13、切り詰めずに入れて押し離しが発散した
        r = (max(min(r[0], r[2]), ORG[0]), max(min(r[1], r[3]), ORG[1]),
             min(max(r[0], r[2]), ORG[0] + BOARD_L), min(max(r[1], r[3]), ORG[1] + BOARD_W))
        if r[2] - r[0] < 1e-6 or r[3] - r[1] < 1e-6:
            continue
        exempt[len(blocks)] = ref
        blocks.append(r)
    blocks = [(min(b[0], b[2]), min(b[1], b[3]), max(b[0], b[2]), max(b[1], b[3])) for b in blocks]
    for ref in movable:
        shift(ref, 0.0, 0.0)
    for _ in range(rounds):
        moved = False
        pairs = [(boxes[i], boxes[j]) for i in range(len(boxes)) for j in range(i + 1, len(boxes))]
        for (ra, a), (rb, b) in pairs:
            # ⭐ 2026-09-16 夕: **表と裏の物どうしは押し離さない**。板を挟んで別の側に居るので当たらない。
            #    入れていなかったとき、J10（裏）から押される Q2 が板の縁にも押し返されて
            #    「押し離しが収束しなかった」になった
            if (ra in BACK_SIDE) != (rb in BACK_SIDE):
                continue
            a = boxes[idx[ra]][1]
            b = boxes[idx[rb]][1]
            ov_x = min(a[2], b[2]) - max(a[0], b[0])
            ov_y = min(a[3], b[3]) - max(a[1], b[1])
            if ov_x <= 0 or ov_y <= 0:
                continue
            free = [r for r in (ra, rb) if r in movable]
            if not free:
                continue
            push = (min(ov_x, ov_y) + 0.15) / len(free)
            ax = (a[0] + a[2]) / 2 < (b[0] + b[2]) / 2
            ay = (a[1] + a[3]) / 2 < (b[1] + b[3]) / 2
            for r in free:
                if ov_x <= ov_y:
                    shift(r, (1 if (r == rb) == ax else -1) * push, 0)
                else:
                    shift(r, 0, (1 if (r == rb) == ay else -1) * push)
            moved = True
        # 切り欠きと磁石の柱から押し出す
        for ref in movable:
            x0, y0, x1, y1 = boxes[idx[ref]][1]
            for ki, k in enumerate(blocks):
                if exempt.get(ki) == ref:
                    continue
                ox = min(x1, k[2]) - max(x0, k[0])
                oy = min(y1, k[3]) - max(y0, k[1])
                if ox > 0 and oy > 0:
                    if ox <= oy:
                        shift(ref, (ox + 0.2) * (1 if (x0 + x1) / 2 > (k[0] + k[2]) / 2 else -1), 0)
                    else:
                        shift(ref, 0, (oy + 0.2) * (1 if (y0 + y1) / 2 > (k[1] + k[3]) / 2 else -1))
                    moved = True
        if not moved:
            return
    print("  ⚠ 押し離しが収束しなかった")


def build():
    solve_fixed()
    comps, pads, nets = netlist()
    NETNUM.update(nets)
    placed, boxes = [], []
    THPAD = {}          # ref → 板を貫くパッドの枠（図面の座標）。裏表が違う部品どうしの当たりに使う
    FABBOX = {}         # ref → 胴の枠（図面の座標・F.Fab／B.Fab）

    def add(ref, x, y, ang):
        back = ref in BACK_SIDE
        fpnode, raw = place_footprint(ref, comps[ref], x, y, ang, pads, back=back)
        placed.append(fpnode)
        boxes.append((ref, courtyard(raw, x, y, ang)))
        FABBOX[ref] = courtyard(raw, x, y, ang, key="Fab")   # 胴（逃げ抜き）。裏表が違う物どうしの当たりに使う
        INSTS.append(dict(ref=ref, fp=comps[ref]["fp"], x=x, y=y, ang=ang,
                          pads=[fp_pad(p) for p in find(raw, "pad")
                                if str(p[1]) and str(p[2]) != "np_thru_hole"]))
        # 🔴 金属化していない穴（位置決めの穴）も銅を置かせない。伝え忘れると配線が穴すれすれを通る
        #    （2026-09-12・USB-C の受け口で 0.015mm まで寄った）
        for q in find(raw, "pad"):
            if str(q[2]) != "np_thru_hole":
                continue
            d = fp_pad(q)
            dx, dy = rot_xy(d["at"][0], d["at"][1], ang)
            NPTH.append((ref, dx, dy, max(d["size"]) / 2 + 0.3))
        # 🔴 板を**貫く**パッド（thru_hole と np_thru_hole）。裏表が違う部品どうしの当たりは
        #    これだけが本物になる（胴は板を挟んで別の側に居るので当たらない）
        th = []
        for q in find(raw, "pad"):
            if str(q[2]) not in ("thru_hole", "np_thru_hole"):
                continue
            d = fp_pad(q)
            dx, dy = rot_xy(d["at"][0], d["at"][1], ang)
            w, h = d["size"]
            if abs(ang) % 180 == 90:
                w, h = h, w
            th.append((x + dx - w / 2, y + dy - h / 2, x + dx + w / 2, y + dy + h / 2))
        THPAD[ref] = th

    # 置く（板の座標 → 図面の座標）
    # 🔴 縦のピンソケットの足形のパッドは**局所 +Y** に並ぶ（+X ではない）。板の +X へ並べるには 270 度。
    # 🔴 J10 は**板の裏（B.Cu）**に置いてある（BACK_SIDE）。足形が鏡になって 2 ピンの並び
    #    （どちらが VBAT か）が入れ替わるので、置いたあとの座標を CHECK_PADS で必ず検算する。
    #    電池の極性を間違えると煙が出る（docs/PCB-V61.md 8 章）。
    for ref, v in PLACE.items():
        x, y, ang = v
        X, Y = bx(x, y)
        add(ref, X, Y, ang)

    before = dict(boxes)
    relax(placed, boxes)
    # ⭐ 2026-09-19: 列に揃えた狙いが押し離しで崩れたら名前を出す（崩れたまま 18 個が気づかれずにいた）
    pushed = [f"{r}（{b[0] - before[r][0]:+.2f}, {-(b[1] - before[r][1]):+.2f}）" for r, b in boxes
              if abs(b[0] - before[r][0]) > 0.005 or abs(b[1] - before[r][1]) > 0.005]
    print("  ⚠ 押し離しで狙いから動いた: " + "・".join(pushed) if pushed else "  押し離しで動いた部品は無い（狙いの列のまま）")
    out_of_board = []
    lim = (ORG[0], ORG[1], ORG[0] + BOARD_L, ORG[1] + BOARD_W)
    for ref, b in boxes:
        if ref in FIXED:      # USB-C とスイッチは口とレバーが板の外へ出るのが正しい
            continue
        d = max(lim[0] - b[0], lim[1] - b[1], b[2] - lim[2], b[3] - lim[3])
        if d > 1e-6:
            out_of_board.append((ref, round(d, 2)))
    for ref, d in out_of_board:
        print(f"  板からはみ出し {ref}: {d} mm")

    # 🔴 角度の検算。板の座標で「このパッドはここに来るはず」と突き合わせる（鏡像事故はここで止める）
    fps = {[pr[2] for pr in find(f, "property") if str(pr[1]) == "Reference"][0]: f for f in placed}
    at_of = {find1(f, "uuid")[1]: f for f in placed}
    bad_pad = []
    for f in placed:
        ref = [pr[2] for pr in find(f, "property") if str(pr[1]) == "Reference"][0]
        at = find1(f, "at")
        fx, fy = float(at[1]), float(at[2])
        fa = float(at[3]) if len(at) > 3 else 0.0
        for q in find(f, "pad"):
            key = (str(ref), str(q[1]))
            if key not in CHECK_PADS:
                continue
            pa = find1(q, "at")
            dx, dy = rot_xy(float(pa[1]), float(pa[2]), fa)
            bxx, byy = fx + dx - ORG[0], BOARD_W - (fy + dy - ORG[1])
            wx, wy = CHECK_PADS[key]
            # ⭐ 2026-09-16: None は「その軸は足形の並びに任せる」。USB-C を右の縁から前の縁へ
            #    移したので、見る軸が X から Y へ変わった。どちらの軸も None にできるようにした
            if wy is None:
                wy = round(byy, 2)
            if wx is None:
                wx = round(bxx, 2)
            if abs(bxx - wx) > 0.02 or abs(byy - wy) > 0.02:
                bad_pad.append((key, round(bxx, 2), round(byy, 2), wx, wy))
    for key, gx, gy, wx, wy in bad_pad:
        print(f"  🔴 パッドの位置が違う {key[0]}.{key[1]}: 板 ({gx}, {gy})、{wx}, {wy} のはず")
    if not bad_pad:
        print(f"  パッドの位置の検算 {len(CHECK_PADS)} 点すべて一致")

    # 🔴 取付穴どうし・取付穴と柱の芯間。ねじの頭とナットが並ぶか。
    #    2026-09-13、上の 2 つが OLED の柱から 2.309 しか離れておらず、頭もナットも入らなかった。
    #    枠の重なりだけ見ていて、**ねじを回す物どうしの間隔**を見ていなかった
    sp = []
    for i, (ax, ay) in enumerate(MOUNT):
        for bx2, by2 in MOUNT[i + 1:]:
            d = math.hypot(ax - bx2, ay - by2)
            if d < NUT_R * 2:
                sp.append(f"取付穴 ({ax}, {ay}) ↔ ({bx2}, {by2}): 芯間 {d:.2f}（{NUT_R * 2:.2f} 要る）")
        for px, py, pd in POSTS:
            need = NUT_R + pd / 2 + POST_KEEP
            d = math.hypot(ax - px, ay - py)
            if d < need:
                sp.append(f"取付穴 ({ax}, {ay}) ↔ 柱 ({px}, {py}) φ{pd}: 芯間 {d:.2f}（{need:.2f} 要る）")
    for s in sp:
        print("  🔴 ねじが並ばない " + s)
    if not sp:
        print(f"  取付穴 {len(MOUNT)} か所・柱 {len(POSTS)} 本、ねじの頭とナットが並ぶ間隔がある")

    # 🔴 取付穴のナットの下。銅ではなく **部品** が入っていないか（MOUNT_KEEP とは別の検査）
    nut = []
    for mx, my in MOUNT:
        for ref, b in boxes:
            x0, y0 = b[0] - ORG[0], BOARD_W - b[3] + ORG[1]
            x1, y1 = b[2] - ORG[0], BOARD_W - b[1] + ORG[1]
            cx, cy = min(max(mx, x0), x1), min(max(my, y0), y1)
            d = math.hypot(mx - cx, my - cy)
            if d < NUT_R - 1e-9:
                # 🔒 2026-09-13 筐体側: (40.5, 3.5) はブラケットと共締めで、ナットは板の面ではなく
                #    **ブラケットの足の上**（BRK_FT 2.15 ⇒ ナットの底 6.75）に座る。U4 の天面 6.45 を
                #    0.30 の隙間で宙で跨ぐので、平面で重なっていても当たらない
                if (ref, mx, my) == ("U4", 40.5, 3.5):
                    continue
                nut.append((mx, my, ref, round(NUT_R - d, 2)))
    for mx, my, ref, over in nut:
        print(f"  🔴 ナットの下に部品 ({mx}, {my}) ↔ {ref}: {over} mm 食い込む")
    if not nut:
        print(f"  取付穴 {len(MOUNT)} か所ともナット（対角 4.62・背 1.6）の下は空いている")

    # 🔴 パッドと「板に開いた穴」の間。枠（courtyard）は柱を避けていても、**パッドは避けていない**。
    #    2026-09-13、J2 を 180° 回したらパッドが枠の反対の端へ移り、柱の抜きに SCL と SDA が乗った
    #    （KiCad の copper_edge_clearance 0.000）。配線まで回さないと出ないので、置く段階で見る。
    holes = [(px, py, d / 2) for px, py, d in POSTS] + [(mx, my, MOUNT_D / 2) for mx, my in MOUNT]
    CLR_EDGE = 0.3
    onhole = []
    for f in placed:
        ref = [pr[2] for pr in find(f, "property") if str(pr[1]) == "Reference"][0]
        at = find1(f, "at")
        fx, fy = float(at[1]), float(at[2])
        fa = float(at[3]) if len(at) > 3 else 0.0
        for q in find(f, "pad"):
            pa = find1(q, "at")
            ddx, ddy = rot_xy(float(pa[1]), float(pa[2]), fa)
            pxb, pyb = fx + ddx - ORG[0], BOARD_W - (fy + ddy - ORG[1])
            sz = find1(q, "size")
            rad = max(float(sz[1]), float(sz[2])) / 2
            for hx, hy, hr in holes:
                gap = math.hypot(pxb - hx, pyb - hy) - hr - rad
                if gap < CLR_EDGE - 1e-9:
                    onhole.append((str(ref), str(q[1]), round(hx, 2), round(hy, 2), round(gap, 3)))
    for ref, pin, hx, hy, gap in onhole:
        print(f"  🔴 パッドが穴に近すぎる {ref}.{pin} ↔ ({hx}, {hy}): すきま {gap} mm（下限 {CLR_EDGE}）")
    if not onhole:
        print(f"  パッドと穴（柱 {len(POSTS)} ＋ 取付穴 {len(MOUNT)}）のすきまは全て {CLR_EDGE} 以上")

    # 🔴 プラグの通り道。口の前に、他の部品・板の縁・電池（背 4.4）が無いか
    box = {ref: (b[0] - ORG[0], BOARD_W - (b[3] - ORG[1]),
                 b[2] - ORG[0], BOARD_W - (b[1] - ORG[1])) for ref, b in boxes}
    blocked, soft, wall, need_out, finger = [], [], [], [], []
    for ref, (side, need) in CONN.items():
        if ref not in box:
            continue
        x0, y0, x1, y1 = box[ref]
        fp = fps[ref]
        at = find1(fp, "at")
        ang = float(at[3]) if len(at) > 3 else 0.0
        dx, dy = open_dir(fp, float(at[1]), float(at[2]), ang)
        a = plug_band((x0, y0, x1, y1), (dx, dy), need)
        # 🔴 縁の口は、プラグが板の外へ出るのが**普通**（線は板の外へ抜ける）。
        #    ⇒ 板の外へ出ること自体は間違いではない。分けて数える:
        #      ① 板の上で他の部品に当たる      → 直せるのは板の側。**間違い**
        #      ② 相手の胴（3.1）が板の縁を越える → 殻の壁を貫く。**殻に開けてもらう要求**
        #      ③ 残り（指と曲がり）が縁を越える → 組むときの空き。**殻への注文**
        body = plug_band((x0, y0, x1, y1), (dx, dy), PLUG_BODY)
        why, near = [], []
        for r2, b2 in box.items():
            if r2 == ref:
                continue
            # ⭐ 2026-09-16 夕: 通り道は**その面の上**にしかないので、板の反対側の物の**胴**は相手にならない。
            #    🔴 ただし**板を貫いた足**は相手の面へ出る。裏の物の足がこの面のプラグの下に居たら本物の当たり。
            #       （J10 を裏の右へ移したら、そのはんだ足 2 本が表の J4 の嵌合したプラグの真下に来た。
            #        筐体側の hit_wires が先に見つけた ── ここで捕まえられていなかった）
            if (r2 in BACK_SIDE) != (ref in BACK_SIDE):
                for t in THPAD.get(r2, ()):
                    tb = (t[0] - ORG[0], BOARD_W - (t[3] - ORG[1]), t[2] - ORG[0], BOARD_W - (t[1] - ORG[1]))
                    if (body[0] < tb[2] - 1e-6 and tb[0] < body[2] - 1e-6
                            and body[1] < tb[3] - 1e-6 and tb[1] < body[3] - 1e-6):
                        why.append(f"{r2} の足")
                        break
                continue
            if (body[0] < b2[2] - 1e-6 and b2[0] < body[2] - 1e-6
                    and body[1] < b2[3] - 1e-6 and b2[1] < body[3] - 1e-6):
                why.append(r2)
            elif a[0] < b2[2] - 1e-6 and b2[0] < a[2] - 1e-6 and a[1] < b2[3] - 1e-6 and b2[1] < a[3] - 1e-6:
                near.append(f"{r2}({HEIGHT.get(r2, HEIGHT_DEFAULT)[0]})")
        if near:
            finger.append((ref, near))
        over_body = max(-body[0], -body[1], body[2] - BOARD_L, body[3] - BOARD_W)
        over_all = max(-a[0], -a[1], a[2] - BOARD_L, a[3] - BOARD_W)
        if over_body > 1e-6:
            edge = ("左" if -body[0] == over_body else "下" if -body[1] == over_body
                    else "右" if body[2] - BOARD_L == over_body else "上")
            wall.append((ref, edge, round(over_body, 2)))
        if over_all > 1e-6:
            edge = ("左" if -a[0] == over_all else "下" if -a[1] == over_all
                    else "右" if a[2] - BOARD_L == over_all else "上")
            need_out.append((ref, edge, round(over_all, 2)))
        if why:
            blocked.append((ref, tuple(round(v, 2) for v in a), why))
        # ⚠ 電池の影（天井 4.4）は **組むときは邪魔にならない**（電池は線を挿したあとに載る）。
        #    効くのは組んだあとで挿し直すときだけなので、止めずに注意だけ出す
        elif a[0] < BATTERY[2] and a[2] > BATTERY[0] and a[1] < BATTERY[3] and a[3] > BATTERY[1]:
            soft.append(ref)
    for ref, a, why in blocked:
        print(f"  🔴 プラグが板の上の部品に当たる {ref}: 通り道 X {a[0]}〜{a[2]}・Y {a[1]}〜{a[3]} … "
              + "・".join(why))
    for ref, near in finger:
        print(f"  ⚠ 指と曲がりの所に低い部品が居る {ref}: " + "・".join(near)
              + "（相手の胴 3.1 の外なので挿せるが、指は入らない）")
    for ref, edge, d in wall:
        print(f"  🔴 相手の胴が板の{edge}の縁を {d} mm 越える {ref}（殻の壁を貫く）")
    if need_out:
        print("  ⚠ 殻へ空けてもらう空き（指と曲がりまで）: "
              + "・".join(f"{r} {e}へ {d}" for r, e, d in need_out))
    if soft:
        print("  ⚠ 通り道が電池の下（挿し直すには電池を外す）: " + "・".join(soft))
    if not blocked and not wall:
        print(f"  プラグの通り道 {len(CONN)} 口すべて空いている（相手の胴は板の上で終わる）")

    missing = sorted(set(comps) - {b[0] for b in boxes} - {r for r in comps if r.startswith("#")})
    if missing:
        sys.exit("置き場所が決まっていない部品: " + ", ".join(missing))
    # 🔴 枠の重なり。⭐ 2026-09-16 夕に**面ごと**にした。
    #    それまで表と裏を 1 枚の紙として見ていて、板を挟んで別の側に居る物どうしを重なりと呼んでいた。
    #    （J10 を裏の右の帯へ移したら、表の J4 の胴と 5.25 × 3.3 重なると出た。物は板の反対側に居る）
    #    ⇒ 同じ面どうしは今までどおり枠で見る。**別の面どうしは、板を貫くパッドが相手の枠に
    #      入っていないか**だけを見る（貫いた足の先は相手の側へ出るので、これは本物の当たり）。
    def _ov2(a, b):
        return a[0] < b[2] - 1e-6 and b[0] < a[2] - 1e-6 and a[1] < b[3] - 1e-6 and b[1] < a[3] - 1e-6
    bad, xside = [], []
    for i, (ra, a) in enumerate(boxes):
        for rb, b in boxes[i + 1:]:
            if not _ov2(a, b):
                continue
            if (ra in BACK_SIDE) == (rb in BACK_SIDE):
                bad.append((ra, rb, round(min(a[2], b[2]) - max(a[0], b[0]), 2),
                            round(min(a[3], b[3]) - max(a[1], b[1]), 2)))
                continue
            # 相手は **胴**（FABBOX）で見る。courtyard の逃げ 0.3〜0.5 は物ではない
            hit = [r for r, o in ((ra, FABBOX.get(rb, b)), (rb, FABBOX.get(ra, a)))
                   if any(_ov2(t, o) for t in THPAD.get(r, ()))]
            if hit:
                bad.append((ra, rb, round(min(a[2], b[2]) - max(a[0], b[0]), 2),
                            round(min(a[3], b[3]) - max(a[1], b[1]), 2)))
            else:
                xside.append((ra, rb))
    for ra, rb in xside:
        print(f"  表と裏なので当たらない {ra} ↔ {rb}（枠は重なるが、板を貫く足は相手の枠の外）")
    for ra, rb, w, h in bad:
        print(f"  重なり {ra} ↔ {rb}: {w} × {h} mm")
    doc = ["kicad_pcb", ["version", "20241229"], ["generator", Str("katanori/gen_pcb.py")],
           ["generator_version", Str("9.0")],
           ["general", ["thickness", "1.6"], ["legacy_teardrops", "no"]],
           ["paper", Str("A3")],
           ["layers",
            ["0", Str("F.Cu"), "signal"], ["4", Str("In1.Cu"), "power"],
            ["6", Str("In2.Cu"), "signal"], ["2", Str("B.Cu"), "signal"],
            ["9", Str("F.Adhes"), "user", Str("F.Adhesive")], ["11", Str("B.Adhes"), "user", Str("B.Adhesive")],
            ["13", Str("F.Paste"), "user"], ["15", Str("B.Paste"), "user"],
            ["5", Str("F.SilkS"), "user", Str("F.Silkscreen")], ["7", Str("B.SilkS"), "user", Str("B.Silkscreen")],
            ["1", Str("F.Mask"), "user"], ["3", Str("B.Mask"), "user"],
            ["17", Str("Dwgs.User"), "user", Str("User.Drawings")],
            ["19", Str("Cmts.User"), "user", Str("User.Comments")],
            ["21", Str("Eco1.User"), "user", Str("User.Eco1")], ["23", Str("Eco2.User"), "user", Str("User.Eco2")],
            ["25", Str("Edge.Cuts"), "user"], ["27", Str("Margin"), "user"],
            ["31", Str("F.CrtYd"), "user", Str("F.Courtyard")], ["29", Str("B.CrtYd"), "user", Str("B.Courtyard")],
            ["35", Str("F.Fab"), "user"], ["33", Str("B.Fab"), "user"]],
           ["setup",
            # 積層は 1.6mm（プリプレグ 0.1 ＋ コア 1.24 ＋ プリプレグ 0.1）。統合基板と同じ
            ["stackup",
             ["layer", Str("F.Cu"), ["type", Str("copper")], ["thickness", "0.035"]],
             ["layer", Str("dielectric 1"), ["type", Str("prepreg")], ["thickness", "0.1"], ["material", Str("FR4")]],
             ["layer", Str("In1.Cu"), ["type", Str("copper")], ["thickness", "0.035"]],
             ["layer", Str("dielectric 2"), ["type", Str("core")], ["thickness", "1.24"], ["material", Str("FR4")]],
             ["layer", Str("In2.Cu"), ["type", Str("copper")], ["thickness", "0.035"]],
             ["layer", Str("dielectric 3"), ["type", Str("prepreg")], ["thickness", "0.1"], ["material", Str("FR4")]],
             ["layer", Str("B.Cu"), ["type", Str("copper")], ["thickness", "0.035"]],
             ["copper_finish", Str("None")], ["dielectric_constraints", "no"]],
            ["pad_to_mask_clearance", "0"],
            ["pcbplotparams", ["layerselection", "0x00000000_00000000_55555555_5755f5ff"],
             ["disableapertmacros", "no"], ["usegerberextensions", "no"], ["usegerberattributes", "yes"],
             ["usegerberadvancedattributes", "yes"], ["creategerberjobfile", "yes"],
             ["dashed_line_dash_ratio", "12.000000"], ["dashed_line_gap_ratio", "3.000000"],
             ["svgprecision", "4"], ["plotframeref", "no"], ["mode", "1"], ["useauxorigin", "no"],
             ["dxfpolygonmode", "yes"], ["dxfimperialunits", "yes"], ["dxfusepcbnewfont", "yes"],
             ["psnegative", "no"], ["psa4output", "no"], ["plot_black_and_white", "yes"],
             ["sketchpadsonfab", "no"], ["plotpadnumbers", "no"], ["hidednponfab", "no"],
             ["sketchdnponfab", "yes"], ["crossoutdnponfab", "yes"], ["subtractmaskfromsilk", "no"],
             ["outputformat", "1"], ["mirror", "no"], ["drillshape", "1"], ["scaleselection", "1"],
             ["outputdirectory", Str("")]]],
           ["net", "0", Str("")]]
    for nm, num in sorted(nets.items(), key=lambda kv: kv[1]):
        doc.append(["net", str(num), Str(nm)])
    global _KELVIN
    # U2（QFN-20・0.5mm ピッチ）の逃げ道。自動配線が通せずにそのピンだけ浮かせるので先に出す
    global _PRE_VIAS
    _KELVIN = (kelvin_tracks(placed) + [escape_stub(placed, "U2", "13", "PROG1")]
               + [vlipo_link(placed), c7_link(placed), u2_16_link(placed)])
    # 長い幹は裏へ。自動配線に任せると内層（0.5oz）へ逃げて抵抗が倍になる
    _PRE_VIAS = []
    for tr, vi in (v5_trunk(placed), bat_trunk(placed), vbus_trunk(placed), cap_gnd_vias(placed)):
        _KELVIN += tr
        _PRE_VIAS += vi
    check_pre(PRE_TRACKS + _KELVIN, _PRE_VIAS)
    doc += (outline() + mounting_holes() + placed + gnd_zone() + vbus_zone() + silk(placed, boxes)
            + pre_tracks(nets) + ep_vias(placed, nets) + pre_vias(nets))
    OUT.mkdir(parents=True, exist_ok=True)
    (OUT / f"{NAME}.kicad_pcb").write_text(kisym.dump(doc) + "\n", encoding="utf-8")
    print(f"{len(placed)} 部品・ネット {len(nets)} 本 → {OUT / (NAME + '.kicad_pcb')}")
    print(f"  足形のライブラリの表: {len(fp_lib_table(doc))} 本 → {OUT / 'fp-lib-table'}")

    # 自動配線に渡す DSN。パネルの外形を囲い、板と板のあいだ・空いている所は銅を置かせない
    bnd = [bx(*q) for q in outline_pts()]
    ko = []
    pos = {it["ref"]: (it["x"], it["y"]) for it in INSTS}   # 押し離したあとの位置
    for ref, dx, dy, rr in NPTH:
        cx, cy = pos[ref]
        ko.append((cx + dx - rr, cy + dy - rr, cx + dx + rr, cy + dy + rr))
    for px, py, d in POSTS:                                 # 柱の抜き（＋ 逃げ）
        X, Y = bx(px, py)
        r = d / 2 + POST_KEEP
        ko.append((X - r, Y - r, X + r, Y + r))
    for mx, my in MOUNT:                                    # 取付穴（φ2.2 ＋ 逃げ 0.5）
        X, Y = bx(mx, my)
        r = MOUNT_D / 2 + MOUNT_KEEP
        ko.append((X - r, Y - r, X + r, Y + r))
    # 🔒 ユーザー 2026-09-17「AS5600 付近に極太線通すのやめませんかね」
    #   幅を決める組（電池 0.6・V5 0.8・スピーカー 0.6）を足すたびに、自動配線が
    #   ここへ**大きい電流の線**を呼び込んでいた。測って安心するのをやめ、**置けなくする**。
    #   ⚠ 危ないのは「太い」からではない。線が作る磁場は B = µ0·I / 2πr で、
    #     **電流と距離**で決まり幅にはほぼ依らない（0.44A・3mm なら幅 0.2 でも 0.6 でも 29µT）。
    #     幅の組を足したことが変えたのは配線の選び方で、悪くなったのは距離の方
    #     （レビュー側の指摘・2026-09-17）。だから距離で守るのが正しい。
    #   実測（防ぐ前）: SPKP 0.6mm が胴の **真下**・SPKM 1.39mm・BATRAW 1.85mm。
    #   スピーカーは 0.44A rms の**交流**なので、電池の直流より性質が悪い。
    #   ⚠ 表（F.Cu）は塞がない。U4 の SDA・SCL・V33 が出られなくなる。
    #     表に残るのは U4 自身の細い線だけで、太い線は内層と裏から逐う。
    kx0, kx1, ky0, ky1 = SHAFT_CX - 5.5, SHAFT_CX + 5.5, SHAFT_CY - 6.0, SHAFT_CY + 6.0   # U4 の胴（芯 ±1.95 × ±2.45）のまわり。芯は VB.SHAFT から
    KX, KY = bx(kx0, ky1)
    KX2, KY2 = bx(kx1, ky0)
    ko.append((KX, KY, KX2, KY2, ("In2.Cu", "B.Cu")))
    # 🔴 GND は **自動配線にも渡す**。ベタ（gnd_zone()）任せにすると、U3 のような細ピッチの
    #    GND パッドへベタが入れず、DRC が未接続で出る（2026-09-13 に試した）。
    #    ベタは銅の足しと戻りの経路として残す。
    netpins = {}
    for (ref, pin), net in pads.items():
        netpins.setdefault(net, []).append((ref, pin))
    cls = [("battery", BAT_NETS, BAT_W), ("power", POWER_NETS, POWER_W), ("v5", V5_NETS, V5_W),
           ("spk", SPK_NETS, SPK_W)]
    # ⚠ 4 層にしても **GND は自動配線に渡したまま**にする。2026-09-17 に外してみたら、
    #   U3（INA226・TSSOP-10）の 2 番と 7 番へ表のベタが届かず、島が 4 つ残った。
    #   ベタ 3 枚と縫いのビアだけでは細ピッチのパッドを拾えない（2 層のときと同じ症状）。
    n_part, n_net = dsn.write_dsn(OUT / f"{NAME}.dsn", NAME, INSTS, netpins, bnd, ko, classes=cls,
                                  copper=ROUTE_COPPER, via=VIA4)
    # 先に引いた線と、EP の放熱ビアを protect で渡す（自動配線が動かさない・避けて引く）
    # 🔴 ビアを渡し忘れると、自動配線がその上に別のネットを通して短絡になる（2026-09-16・3 件出た）
    rows = []
    for net, lay, w, pts in PRE_TRACKS + _KELVIN:
        for (xa, ya), (xb, yb) in zip(pts, pts[1:]):
            rows.append(f'    (wire (path {lay} {round(w * dsn.SCALE)} {dsn._x(xa)} {dsn._y(ya)} '
                        f'{dsn._x(xb)} {dsn._y(yb)}) (net "{net}") (type protect))')
    for v in ep_vias(placed, nets) + pre_vias(nets):
        at = find1(v, "at")
        vnet = next(nm for nm, num in nets.items() if str(num) == str(find1(v, "net")[1]))
        # ⚠ 穴の名前は **この板の層数と穴径から作る**。dsn.VIA（2 層の Via[0-1]_800:400）を
        #   そのまま渡すと DSN に定義の無い穴を指すことになり、Freerouting が黙って
        #   空の SES を返す（2026-09-17・4 層にした直後に起きた）
        vianame = f'Via[0-{len(ROUTE_COPPER) - 1}]_{round(VIA4[0] * 1000)}:{round(VIA4[1] * 1000)}_um'
        rows.append(f'    (via {vianame} {dsn._x(float(at[1]))} {dsn._y(float(at[2]))} '
                    f'(net "{vnet}") (type protect))')
    if rows:
        f = OUT / f"{NAME}.dsn"
        nl = chr(10)
        body = "  (wiring" + nl + nl.join(rows) + nl + "  )"
        f.write_text(f.read_text(encoding="utf-8").replace("  (wiring" + nl + "  )", body),
                     encoding="utf-8")
        print(f"  先に引いた線とビア {len(rows)} 個を protect で渡した")
    print(f"自動配線へ: {n_part} 部品・{n_net} ネット → {OUT / (NAME + '.dsn')}")
    for cname, ns, w in cls:
        have = sorted(n for n in ns if len(netpins.get(n, ())) > 1)
        print(f"  {cname}（{w}mm）: {' '.join(have)}")
        miss = sorted(ns - set(have))
        if miss:
            sys.exit(f"{cname} に板へ出ていない名前がある: {miss}")
    if bad:
        sys.exit(f"部品が {len(bad)} 組重なっている")


if __name__ == "__main__":
    sys.stdout.reconfigure(encoding="utf-8")
    build()
