n416/katanori/hardware/pcb/gen_sch.py

# -*- coding: utf-8 -*-
"""ハブ＋電源の板の回路図（katanori61.kicad_sch）を作る。

  python gen_sch.py        → hardware/pcb/katanori61/katanori61.kicad_sch と .kicad_pro

回路は 3 つの出どころの写しで、ここで新しく設計した回路は無い。
  電源   : Adafruit PowerBoost 1000C Rev B（hardware/ref/powerboost_1000c/・CC BY-SA 3.0）
  電流計 : 今の INA226 モジュールの役目（シャント 10mΩ・アドレス 0x44）を INA226 のチップで
  ハブ   : hardware/parts/relay_board.html の PARTS / RELAY / BUTTON と hub_ports.py の口

どのピンにも短い線とネット名を付ける形で描く（線で部品どうしを結ばない）。
つながりは check_sch.py が PowerBoost の EAGLE の回路図と突き合わせる。
"""

import json
import math
import pathlib
import sys
import uuid

sys.path.insert(0, str(pathlib.Path(__file__).parent))
sys.path.insert(0, str(pathlib.Path(__file__).parents[1] / "parts"))
import kisym  # noqa: E402
from kisym import Str  # noqa: E402
import hub_ports  # noqa: E402

OUT = pathlib.Path(__file__).parent / "katanori61"
NAME = "katanori61"
ROOT = str(uuid.uuid5(uuid.NAMESPACE_URL, "katanori/katanori61"))
_n = [0]


def uid():
    _n[0] += 1
    return str(uuid.uuid5(uuid.NAMESPACE_URL, f"katanori/{NAME}/{_n[0]}"))


G = 2.54
# ⭐ 2026-09-17: Basic 化で選び直した R6・R7（C22961 / C23254）は **0603**。
#   （同じときに選び直した R2 C23137 は、2026-09-20 に低電池の分圧ごと廃止した）
#   足形が 0805 のままだった。0805 のパッドの内側の間 0.875 に 0603 の胴 1.6 が両端 0.36 ずつ
#   乗るだけになり、機械実装で着かないか立つ。LCSC の部品ページで 3 つとも 0603 を確認した。
FP_R0603 = "Resistor_SMD:R_0603_1608Metric"
FP_R = "Resistor_SMD:R_0805_2012Metric"
FP_C = "Capacitor_SMD:C_0805_2012Metric"
FP_LED = "LED_SMD:LED_0805_2012Metric"

# ---- 部品 ----
# (ref, lib_id, value, gx, gy, {ピン番号: ネット}, 足形, LCSC, 注記)
# ネット None は「どこにも繋がない」（× を付ける）
# 置き場所は pack() が組（GROUPS）ごとに書いた順で詰める。gx, gy は使っていない（書いた順の目安）
PARTS = []
CUR = ["boost"]
# 組 → (左上 x, 左上 y, 幅) [mm]。A3 横（420 × 297）
GROUPS = {"boost": (15, 30, 190), "charge": (15, 120, 190), "ina": (220, 30, 185),
          "hub": (220, 120, 185), "ports": (15, 240, 250), "flags": (330, 240, 70),
          "knob": (330, 155, 70), "xiao": (220, 190, 185)}


def group(name):
    CUR[0] = name


def part(ref, lib, value, gx, gy, nets, fp="", lcsc="", note="", dnp=False, grp=None):
    PARTS.append(dict(ref=ref, lib=lib, value=value, x=0.0, y=0.0, nets=nets,
                      fp=fp, lcsc=lcsc, note=note, dnp=dnp, grp=grp or CUR[0]))


def r(ref, value, gx, gy, a, b, fp=FP_R, **kw):
    part(ref, "Device:R_Small", value, gx, gy, {"1": a, "2": b}, fp, **kw)


def c(ref, value, gx, gy, a, b, fp=FP_C, **kw):
    part(ref, "Device:C_Small", value, gx, gy, {"1": a, "2": b}, fp, **kw)


def led(ref, value, gx, gy, k, a):
    part(ref, "Device:LED_Small", value, gx, gy, {"1": k, "2": a}, FP_LED)


# ======== 電源: PowerBoost 1000C Rev B の写し ========
# 名前の読み替え（EAGLE → ここ）:
#   ネット  VBAT → VSYS（充電 IC が出す「負荷側」の電圧。電池そのものではない）
#           5.0V → V5（ハブの +5V と同じネット）  ENABLE → EN（ハブの EN と同じネット）
#           VLIPO・VBUS・GND はそのまま。N$n は役目の名前に付け替え
#   部品    THERM → R15、B1 → J10（電池）、CN4 → J13（USB の入口）
# 写さなかった物: CN1（USB-A の出口）・R9〜R12（USB-A の D+/D- の分圧）・X1（端子台）・
#                 JP2（8 本のヘッダ）・FID1〜3・取付穴。どれも 5V を板の外へ出すための物で、
#                 この板では 5V は板の中でハブへ渡る。
X0, Y0 = 10, 12
part("U1", "Regulator_Switching:TPS61090", "TPS61090RSAR", X0 + 30, Y0 + 8,
     {"1": "V5", "15": "V5", "16": "V5", "2": None, "3": "SW", "4": "SW",
      "5": "GND", "6": "GND", "7": "GND", "13": "GND", "17": "GND",
      "8": "VSYS", "9": "GND", "10": "GND", "11": "EN", "12": None, "14": "FB"},
     "Package_DFN_QFN:Texas_RSA_VQFN-16-1EP_4x4mm_P0.65mm_EP2.7x2.7mm",
     lcsc="C206167", note="昇圧（PowerBoost U1）")
part("U2", "Battery_Management:MCP73871-2CC", "MCP73871-2CCI/ML", X0 + 8, Y0 + 32,
     {"1": "VSYS", "20": "VSYS", "2": "VPCC", "3": "VBUS", "4": "VBUS", "5": "THERM",
      "6": None, "7": None, "8": None, "9": "VBUS", "10": "GND", "11": "GND",
      "21": "GND", "12": "PROG3", "13": "PROG1", "14": "VLIPO", "15": "VLIPO",
      "16": "VLIPO", "17": "VBUS", "18": "VBUS", "19": "VBUS"},
     "Package_DFN_QFN:QFN-20-1EP_4x4mm_P0.5mm_EP2.5x2.5mm",
     lcsc="C511310", note="充電・ロードシェア（PowerBoost U2）。MCP73871T-2CCI/ML ── T はテープ＆リールだけ（📄 データシート PRODUCT IDENTIFICATION・部品に刻印されない）。2026-09-19 に C5121473（$4.41）から替えた（$2.19・在庫 2410）", grp="charge")
part("L1", "Device:L_Small", "6.8uH", X0 + 18, Y0 + 4, {"1": "VSYS", "2": "SW"},
     "Inductor_SMD:L_Changjiang_FNR4018S",
     note="PowerBoost は TDK VLC5045（5×5mm）。JLCPCB の在庫に合わせて FNR4018S6R8MT（4×4mm・2A）にした")
c("C1", "10uF", X0 + 22, Y0 + 4, "VSYS", "GND")
c("C4", "0.1uF", X0 + 25, Y0 + 4, "VSYS", "GND")
c("C2", "2.2uF", X0 + 44, Y0 + 4, "V5", "GND")
# 🔒 2026-09-12 ユーザー: Extended を減らすため 100µF 10V 1210（Extended）を
#    47µF 10V 1206（Basic・C96123）2 個に分けた。耐圧 10V は変えていない。
c("C6", "47uF", X0 + 47, Y0 + 4, "V5", "GND", fp="Capacitor_SMD:C_1206_3216Metric",
  note="PowerBoost C6（100µF 1210）の片割れ")
c("C9", "47uF", X0 + 50, Y0 + 4, "V5", "GND", fp="Capacitor_SMD:C_1206_3216Metric",
  note="PowerBoost C6 の片割れ・私が足した（2026-09-12）")
r("R3", "1.87M", X0 + 44, Y0 + 12, "V5", "FB")
r("R4", "200K", X0 + 47, Y0 + 12, "FB", "GND")
# ⭐ 2026-09-20: 低電池の分圧（R1 1.87M・R2 330K）を外し、LBI（9 番）を GND へ直結した。
#   LBO（12 番）はどこにも繋いでいないので、この分圧が作る閾値 3.33V は誰も読まない。
#   📄 TPS61090/91/92 SLVS484C（2014 年 12 月改訂）12 ページ 9.3.7:
#     "If the low-battery detection circuit is not used, the LBI pin should be connected to GND
#      (or to VBAT) and the LBO pin can be left unconnected."
#   ⇒ 浮かせなければよいのではなく、GND へ繋げと書いてある。分圧である必要は無い。
#   低電池は INA226（U3）が I2C で読むので、機能としても重複していた。
#   得: 部品 2 個・VSYS から GND へ流れていた 1.9µA・JLCPCB へ出す品番 1 つ（330kΩ C23137 は R2 だけが使っていた）。
#   ⚠ 2026-09-19 に「分圧は残す」と書かれていたが（docs/POWER.md）、それは AI 側が決めた物で
#     ユーザーに聞いていなかった。2026-09-20 にユーザーの判断で外した。
r("R13", "200K", X0 + 22, Y0 + 12, "VSYS", "EN")
# 🔒 2026-09-19 ユーザー「LED は本来不要」: 表示灯の 4 つとそれだけに要る部品を写さない。
#    PowerBoost の LED1（赤・電池残量）＋ R20 ＋ T1（MMUN2133）・LED2（青・5V）＋ R5・
#    DONE（緑・充電済み）＋ R14・CHRG/LBO（橙・充電中）＋ R8 の 9 個。
#    U1 の LBO（12 番）と U2 の STAT1・STAT2（8・7 番）はオープンドレインなので、何もつながない。
#    電池の残量は INA226 で測っている（check_sch.py の DROPPED にも同じ 9 個）
# 充電側
group("charge")
c("C8", "10uF", X0 + 26, Y0 + 26, "VBUS", "GND")
c("C7", "10uF", X0 + 29, Y0 + 26, "VLIPO", "GND")
r("R6", "220K", X0 + 32, Y0 + 26, "VBUS", "VPCC", fp=FP_R0603,
  note="PowerBoost は 270kΩ（E96・Extended）。R7 と組で比を保つ")
r("R7", "82K", X0 + 35, Y0 + 26, "VPCC", "GND", fp=FP_R0603,
  note="PowerBoost は 100kΩ。R6 と組で 100/370=0.2703 → 82/302=0.2715（差 0.45%）")
r("R16", "1.0K", X0 + 26, Y0 + 34, "GND", "PROG1")
r("R17", "100K", X0 + 29, Y0 + 34, "GND", "PROG3")
r("R15", "15K", X0 + 32, Y0 + 34, "GND", "THERM", note="PowerBoost THERM")

# ======== 電流計: INA226 ========
# 今のモジュールと同じく、電池の + と充電 IC の VBAT のあいだに 10mΩ を入れる。
# A1 = VS・A0 = GND でアドレス 0x44（今の実機と同じ・ファームを変えずに済む）。
XI, YI = 82, 12
group("ina")
part("U3", "Sensor_Energy:INA226", "INA226AIDGSR", XI, YI + 8,
     {"1": "V33", "2": "GND", "3": None, "4": "SDA", "5": "SCL", "6": "V33",
      "7": "GND", "8": "VLIPO", "9": "VLIPO", "10": "BATP"},
     "Package_SO:TSSOP-10_3x3mm_P0.5mm", lcsc="C49851", note="A1=VS・A0=GND → 0x44")
# 🔴🔴 **R41 はケルビンで測る。**回路図では U3 の 9/10 番と R41 が「同じネット」としか書けないが、
#   それでは足りない。**同じ点**から取らないと、あいだの銅がシャントに足し算されて読み違える。
#   2026-09-16 に実測: v6.1 の自動配線は IN+ を R41 のパッドの 11.9mΩ 手前（Q2 の足元）から、
#   IN− を 73.7mΩ 先（U2 の VBAT パッド）から出していて、INA226 は 10mΩ ではなく **96.7mΩ**
#   ＝ 9.7 倍を見ていた。v5 で正しく読めていたのは、INA226 モジュールの上でシャントと IC が
#   数 mm しか離れておらず、ケルビンがモジュールの中で取れていたからである。
#   ⇒ 板の側の担保は **gen_pcb.py の PRE_TRACKS**。R41 の 2 つのパッドの**内側の縁**から、
#     負荷電流を流さない 0.25mm の線を 2 本、電流の向きと直角に出して U3 へ直行させている。
#     この回路図を作り直しても PRE_TRACKS は gen_pcb.py 側に残るが、**R41 か U3 を動かしたら
#     PRE_TRACKS の座標も直すこと**（座標は板の実寸で書いてある）。
r("R41", "10m", XI - 12, YI + 8, "BATP", "VLIPO", fp="Resistor_SMD:R_1206_3216Metric",
  note="シャント 10mΩ（今のモジュールと同じ値）。🔴 ケルビン必須 — gen_pcb.py の PRE_TRACKS を見よ")
c("C41", "0.1uF", XI + 8, YI + 1, "V33", "GND")
r("R42", "10K", XI + 12, YI + 1, "V33", "SDA", note="I2C の引き上げ")
r("R43", "10K", XI + 15, YI + 1, "V33", "SCL", note="I2C の引き上げ")
part("J10", "Connector_Generic:Conn_01x02", "BAT (JST-PH)", XI - 20, YI + 8,
     {"1": "GND", "2": "BATRAW"}, "Connector_JST:JST_PH_B2B-PH-K_1x02_P2.00mm_Vertical",
     note="🔴 1 番が −・2 番が ＋（PowerBoost B1 の並び。⭐ 2026-09-16 夕から 2 番のネットは BATRAW ＝ 逆接保護 Q2 の手前）。v6.1 は板の裏に**縦（トップ型）**で下向き（⭐ 2026-09-16 夕 🔒 ユーザー「ケーシング作ったから垂直のがいい」。2026-09-14 の横出しから戻した）")
# 🔒 2026-09-12 ユーザー「2 だね」: 充電の USB-C の受け口を電源板に載せる（秋月の Type-C 基板と
#    線 2 本と手付けの CC 抵抗が消える）。JLCPCB は SMT の流れで付ける（Assembly Type: SMT Assembly）。
#    ⚠ 板の縁を壁へ持っていくのは筐体 v6 側の仕事。
part("J13", "Connector:USB_C_Receptacle_USB2.0_16P", "USB-C", XI - 20, YI + 18,
     {"A1": "GND", "B1": "GND", "A12": "GND", "B12": "GND", "SH": "GND",
      "A4": "VBUS", "A9": "VBUS", "B4": "VBUS", "B9": "VBUS",
      "A5": "CC1", "B5": "CC2",
      "A6": None, "B6": None, "A7": None, "B7": None, "A8": None, "B8": None},
     "Connector_USB:USB_C_Receptacle_HRO_TYPE-C-31-M-12", lcsc="C165948",
     note="充電の口。D+/D− と SBU は使わない。v6.1 は板の後ろの縁から 1.3 出し（⭐ 2026-09-17）で、シェルの足 4 本とも板に載る")
r("R44", "5.1k", XI - 16, YI + 22, "CC1", "GND", note="CC1 の引き下げ（充電器に 5V を出させる）")
r("R45", "5.1k", XI - 13, YI + 22, "CC2", "GND", note="CC2 の引き下げ")

# ---- 逆接保護（⭐ 2026-09-16 夕 🔒 ユーザー「MOSFET 一つ入れましょ」）----
# 電池を逆に繋いでも電流が流れないようにする P チャネル MOSFET を 1 個。
#   置く場所: **J10 の 2 番と シャント R41 のあいだ**。ここに入れると、逆接のとき
#   INA226 の入力（IN+ = BATP・IN− = VLIPO）にも 3V3 の側にも電池がかからない。
#   🔴 2026-09-11 に焼けたのは INA226 で、焼けた経路がまさにここである。
# 向き（🔴 ここを逆にすると保護にならない）:
#   **ドレインを電池側（BATRAW）・ソースを負荷側（BATP）・ゲートは GND**。
#   P-ch のボディダイオードは アノード = ドレイン / カソード = ソース なので、
#     正常時 … ダイオードが順方向で BATP が立ち上がる → Vgs = 0 − Vbat = 負 → チャネルが開いて短絡する
#     充電時 … 電流は ソース → ドレイン（ダイオードとは逆向き）だが、チャネルが開いているので通る
#     逆接時 … ダイオードが逆方向・Vgs = 0 → 閉じたまま。**電流が流れない**
#   ⚠ ソースを電池側にすると、逆接のときボディダイオードが順方向になって電流が流れてしまう
part("Q2", "Transistor_FET:Q_PMOS_GSD", "AO3401A", XI - 16, YI + 12,
     {"1": "BATG", "2": "BATP", "3": "BATRAW"}, "Package_TO_SOT_SMD:SOT-23",
     note="逆接保護（P-ch）。1=G・2=S・3=D は AO3401A の SOT-23 の並び。"
          "📄 LCSC C15127（JLCPCB Basic）・Vgs(th) 900mV・RDS(on) 60mΩ@4.5V / 85mΩ@2.5V・Vgs ±12V")
r("R46", "100K", XI - 16, YI + 16, "BATG", "GND",
  note="Q2 のゲートを GND へ落とす。電池は 3.0〜4.2V なので Vgs は最大 −4.2V で、AO3401A の ±12V に余裕がある")

# ======== ハブ: relay_board.html の写し ========
XH, YH = 10, 62
group("hub")
# ミュートリレー（POWER.md 3 章）。部品番号は板の上の id に 30 を足した
r("R31", "1k", XH + 4, YH + 4, "IN", "BASE", note="relay_board R1")
r("R32", "10k", XH + 8, YH + 4, "BASE", "GND", note="relay_board R2・🔴 安全の要")
# 🔴 2026-09-12 ユーザー「トランジスタとダイオードは付けてよ」: 実装に載せるため表面実装へ。
#    SS8050 は hFE 200〜350（2SC1815-GR は 200〜400）・Ic 1.5A で、コイルの 30mA に対しては
#    2SC1815 と同じく深く飽和する。ベース 1kΩ・プルダウン 10kΩ・つなぎ方は変えていない。
part("Q31", "Transistor_BJT:MMBT3904", "SS8050", XH + 13, YH + 4,
     {"1": "BASE", "2": "GND", "3": "COL"}, "Package_TO_SOT_SMD:SOT-23",
     note="relay_board Q1（2SC1815-GR の表面実装の代わり・SOT-23 は 1=B・2=E・3=C）")
part("D31", "Diode:1N4148W", "1N4148W", XH + 20, YH + 4, {"1": "V5", "2": "COL"},
     "Diode_SMD:D_SOD-123", note="relay_board D1・カソードが +5V（表面実装の 1N4148W）")
# 🔒 2026-09-12 ユーザー「リレーに準じる物であればなんでもいい」: スルーホールの Y14H-1C-5DS から
#    表面実装の Omron G6S-2F DC5（C16707）へ。スルーホールだったのは手元の実物がそうだったからで、
#    理由は無かった。替えると機械が載せるので手はんだが消え、足形も KiCad の標準（Omron が引いた
#    land pattern）になる。コイルは 167Ω 30mA → 178Ω 28mA。接点は 2A@30VDC。
#    ピン番号は Omron のデータシート（en-g6s.pdf 5 ページ・Top View）と KiCad の記号の両方で確かめた:
#      1 = コイル ＋ ／ 12 = コイル −／ 4 = COM・3 = NC・5 = NO（もう 1 回路は 9 = COM・10 = NC・8 = NO）
part("K31", "Relay:G6S-2", "G6S-2F DC5", XH + 28, YH + 4,
     {"1": "V5", "12": "COL", "4": "SPKP", "5": "SPKO", "3": None,
      "9": None, "10": None, "8": None},
     "Relay_SMD:Relay_DPDT_Omron_G6S-2F",
     note="COM–NO を使う・NC は空き。2 回路のうち使うのは 1 回路だけ（もう 1 回路は未接続）")
c("C31", "0.1uF", XH + 36, YH + 4, "V5", "GND", note="relay_board C1")
c("C32", "0.1uF", XH + 40, YH + 4, "EN", "GND", note="relay_board C2・リードの跳ね止め")
# 🔒 2026-09-12 ユーザー「要らないね」: 板の上の直挿しの会話ボタン（relay_board の BUTTON）は載せない。
#    会話ボタンは天板のもの 1 つだけになり、口 J8（BTN2）で受ける。

# ======== つまみ: AS5600 をチップで載せる（2026-09-13） ========
# 🔒 ユーザー 2026-09-13「歯車 3 枚」。読み取りの芯が板 X 36.2・Y 7 に決まり、AS5600 は
#    外付けモジュール（口 J3）ではなく板の上のチップになった。線 4 本が消える。
# 📄 3.3V 動作の回路は AS5600 データシート 9 ページ Figure 13（hardware/ref/as5600/AS5600_v1-01.pdf）:
#    「In 3.3V operation, the VDD5V and VDD3V3 pins must be tied together.」＋ 100nF を GND へ。
#    1µF は 5V 動作の LDO 用・10µF は OTP を焼くときだけなので、どちらも要らない。
# 結線はいまのモジュールの使い方と同じ（docs/KNOB-ENCODER.md 配線章）:
#    VDD=3V3 ／ DIR=GND（時計回りで値が増える）／ SCL・SDA ／ OUT は繋がない
#    🔴 PGO には何も繋がない（OTP・焼くと戻せない）
XA, YA = 82, 62
group("knob")
part("U4", "katanori:AS5600-ASOM", "AS5600-ASOT", XA, YA,
     {"1": "V33", "2": "V33", "4": "GND", "8": "GND",
      "6": "SDA", "7": "SCL", "3": None, "5": None},
     "Package_SO:SOIC-8_3.9x4.9mm_P1.27mm", lcsc="C499458",
     note="つまみの角度。磁石は真上・板 X 36.2 Y 7。🔴 PGO(5) と OUT(3) は繋がない")
c("C42", "0.1uF", XA + 12, YA + 8, "V33", "GND", note="AS5600 のパスコン（📄 9 ページ Figure 13）")

# ======== マスタートグルは板の部品ではない（v6.1・2026-09-14） ========
# 🔒 筐体側 2026-09-14「トグルは板に立ちません。ハッチに付いて線 2 本です」。板の表から 14.45 上に
#    あるので板からは立てられない。v6 に在った SW1（MST-12D18G3）は消し、リードと同じ EN⇔GND の
#    線として下の J7 で受ける。

# 口（hub_ports.py の並びのまま = 今の線がそのまま挿さる）
# 🔒 2026-09-13 で口は 7 つになった: XIAO・OLED・スピーカー IN・スピーカー OUT・リード・
#    会話ボタン・電池。AS5600（J3）とトグル（J7）は板の上の部品になって消えた。
# 🔒 2026-09-12 ユーザー: OLED を HS154L03W2C01（1.54"・SSD1309・I2C・`C7465999`）に替える前提で、
#    **J2 だけピンの並びを逆にする**。穴の位置は動かさない（同じ 4 穴のまま、載る信号が逆順になる）。
#      いまのユニバーサル基板の J2 : 1 SDA・2 SCL・3 3V3・4 GND
#      HS154L03W2C01 のパネル      : 1 GND・2 VCC・3 SCL・4 SDA（📄 データシート 1.5 Pin Definition）
#    ⇒ 逆にすると 1 GND・2 3V3・3 SCL・4 SDA で、パネルの並びと 1 対 1 で合う。
#    🔒 2026-09-13 に口そのものを JST PH の 4 ピン横型へ替えたが、**この並びは維持する**。
PORT_FLIP = {"OLED"}
NETMAP = {"V5": "V5", "V33": "V33", "GND": "GND", "SDA": "SDA", "SCL": "SCL", "EN": "EN",
          "BTN": "BTN", "IN": "IN", "SPKP": "SPKP", "SPKM": "SPKM", "SPKO": "SPKO"}
# 🔒 2026-09-13 ユーザー「別に線が二股になるのは構わない」: リード（REED）と会話ボタン（BTN2）は
#    hub_ports から引かず、下で 1 つの 4 ピン PH（J6）にまとめる
PORT_REF = {"OLED": "J2", "PHIN": "J4", "PHOUT": "J5"}
PORT_NAME = {"OLED": "OLED", "PHIN": "SPK IN", "PHOUT": "SPK OUT"}
# 🔒 2026-09-13 筐体側: 口は全部「線が板の面と平行に抜ける」形にする（外向きだと壁に当たる）。
#    2 本の口は 2.54 の L 字ソケット・スピーカーと電池と OLED は JST PH の横型。
FP_PORT = {
    # 🔒 v6.1（2026-09-14）: OLED は線ではなくライザーの板で受ける。並び（1 GND・2 3V3・3 SCL・4 SDA）は
    #    パネルと 1 対 1 のまま変えない。口は PH の横型 → 2.54 の縦のメス → **オスのピンヘッダ**と替わった
    #    （メスの背 8.5 ではライザーの板が XIAO の下のメスに 2.49 届かなかった）
    "OLED": "Connector_PinHeader_2.54mm:PinHeader_1x04_P2.54mm_Vertical",
    # ⭐ 2026-09-16 夕 🔒 ユーザー「J4とJ6を縦にして」: SPK IN（J4）を横出し → **縦 B2B-PH-K**。
    #    横出しは口が盤面の内側（+Y）を向いていて、挿したプラグの胴が板の上に 2.0 出て
    #    Y 14.30〜16.30 を塞いでいた。SPK OUT（J5）は口が板の**左の縁**（−X）を向いていて
    #    盤面を食わないので横出しのまま
    "PHIN": "Connector_JST:JST_PH_B2B-PH-K_1x02_P2.00mm_Vertical",
    "PHOUT": "Connector_JST:JST_PH_S2B-PH-K_1x02_P2.00mm_Horizontal",
}
group("ports")
gx = XH + 4
for p in hub_ports.ports():
    if p.id not in PORT_REF:      # PWR・INA・XIAO・AS5600・TOGGLE は板の中の配線か別の部品になった
        continue
    pins = list(reversed(p.pins)) if p.id in PORT_FLIP else p.pins
    nets = {str(i): (NETMAP[net] if net else None) for i, (h, fn, net, x, y) in enumerate(pins, 1)}
    n = len(p.pins)
    part(PORT_REF[p.id], f"Connector_Generic:Conn_01x{n:02d}", PORT_NAME[p.id], gx, YH + 24, nets,
         FP_PORT[p.id], note=p.label)
    gx += 12

# ======== 会話ボタンの口と、リード＋トグルの口（v6.1・2026-09-14） ========
# v6 は「リード＋会話ボタン」で 1 つの 4 ピンだったが、v6.1 は板が広がって口の場所が増えたので分けた。
# 🔒 リードとトグルは**どちらも EN を GND へ落とすだけの並列のスイッチ**なので、1 つの 4 ピンにまとめる。
#    並びは隣り合う 2 本ずつで分かれる: 1 EN・2 GND がリードへ、3 EN・4 GND がトグルへ。
#    どちらも無極性なので組の中の順は効かない。GND を 2 本にしてあるので、1 つの端子へ線を 2 本
#    入れる（圧着できない）ことも、線を割って継ぐこともしないで済む。
# 🔒 ユーザー 2026-09-14「会話ボタンを基板に付ける必要はないと言ったんであって、線は必要でしょ。
#    天板の会話ボタンはあるんだし」: **押しボタンを板に載せないだけで、線を受ける口は要る。**
#    同日、いったん J6 を外して 1 時間後に戻した（外したのは伝言の読み違い）。
part("J6", "Connector_Generic:Conn_01x02", "BTN2", 0, 0,
     {"1": "GND", "2": "BTN"},
     "Connector_JST:JST_PH_B2B-PH-K_1x02_P2.00mm_Vertical",
     note="天板の会話ボタンへ 2 本。⭐ 2026-09-16 夕に横出し → **縦**（🔒 ユーザー「J4とJ6を縦にして」）。"
          "横出しは −Y（盤面の内側）で、指の所に J1（背 8.5 のライザー）が居て、通り道が電池の下にも当たっていた",
     grp="ports")
# ⭐ 2026-09-19 🔒 ユーザー「板の後ろの縁に押しボタンを載せる方法にしようか」: ハッチのトグルをやめて板の押しボタン SW2 へ。
#   J7 はリードだけの 2 ピンになった（3 EN・4 GND のトグルの組は消えた）
part("J7", "Connector_Generic:Conn_01x02", "REED", 0, 0,
     {"1": "EN", "2": "GND"},
     "Connector_JST:JST_PH_B2B-PH-K_1x02_P2.00mm_Vertical",
     note="1 EN・2 GND → リード（縦の口・上から挿す）", grp="ports")
# 電源の押しボタン（横向き・自己保持・DPDT）。リードと並列に EN を GND へ落とす。
#   📄 データシートの CIRCUIT DIAGRAM: 1–3 番は RELEASE で閉・LOCK で開 ⇒ 出ている間は OFF、押し込んで固定すると電源はつまみ（リード）に従う。
#   残りの 2・4・5・6 番は使わない。1–3 が「出ている間に閉」の根拠: 📄 CIRCUIT DIAGRAM（RELEASE で 1–3・LOCK で 2–4。4–6・2–5 は常に結ばれた同じ端子）と、📄 PCB LAYOUT のピンの前後（1・3 は胴の前寄り、2・4 はその 2.0 後ろ）。動く接点は押し子と一緒に前後し、出ていると前の 1・3、押し込むと後ろの 2・4 をつなぐ。2 つの図が同じことを言う
part("SW2", "katanori:SW_XKB5858-Z-E", "XKB5858-Z-E", 0, 0,
     {"1": "GND", "3": "EN", "2": None, "4": None, "5": None, "6": None},   # ⭐ 2026-09-19: 1 EN・3 GND → 1 GND・3 EN（無極性の 1 組。EN の行き先は右なので右の 3 番へ。左の 1 番は J6 との 1.1 の隙間で EN が引けなかった）
     "katanori:SW_XKB5858-Z-E",
     note="電源の押しボタン（板の後ろの縁・押し子は後ろの壁から出る）。1 GND・3 EN", grp="ports")

# ======== XIAO の口 — ライザーの板を受ける 1x07（v6.1・2026-09-14） ========
# 🔒 筐体側 2026-09-14。v6 は XIAO の 2×7 のピンヘッダが板のメスソケット 2 本へ真上から挿さっていたが、
#    v6.1 は板と XIAO の間にライザーの板が立つ。ライザーの上側のメスが XIAO のピンを受け（信号 4 本が
#    Z 32.11・電源 3 本が Z 16.88）、下側のオスがこの板の 1x07 のメスに挿さる。
#    ⇒ この板から見えるのは **7 本だけ**（D0・D1・D6〜D10 はライザーで終わる）。
# 🔴 どちらの列がどちらか、という v6 の鏡像の心配はここでは消える。ライザーの板の上で入れ替わるので、
#    この板の並びは配線の都合で決めてよい。電源 3 本を 1 番側・信号 4 本を 7 番側にした。
XX, YX = 15, 200
group("xiao")
part("J1", "Connector_Generic:Conn_01x07", "XIAO RISER", XX, YX,
     {"1": "V5", "2": "GND", "3": "V33", "4": "SDA", "5": "SCL", "6": "BTN", "7": "IN"},
     "Connector_PinHeader_2.54mm:PinHeader_1x07_P2.54mm_Vertical",
     note="ライザー: 1 5V・2 GND・3 3V3・4 SDA・5 SCL・6 D2(BTN)・7 D3(IN)。"
          "🔒 2026-09-14 板の側は**オスのピンヘッダ**（ライザー側が裏面の L 字のメスで受ける）")

# ---- JLCPCB（LCSC）の部品番号（2026-09-12 に JLCPCB の部品検索で取った） ----
# 「基」= Basic（種類ごとの取り付け料 $0 ）・「拡」= Extended（種類ごとに $3.07）
LCSC = {
    "U1": "C206167", "U2": "C511310", "U3": "C49851",          # 拡: 昇圧・充電・電流計
    "L1": "C167807",                                            # 拡: FNR4018S6R8MT 6.8µH 2A（4×4mm）
    "R41": "C105362",                                           # 拡: 10mΩ 1% 1W 合金 1206
    "R3": "C482988",                                            # 拡: 1.87MΩ 1%（R1 は 2026-09-20 に廃止）
    "R4": "C17539", "R13": "C17539",                            # 基: 200kΩ
    "R17": "C149504", "R46": "C149504",                         # 基: 100kΩ（R46 は Q2 のゲート。同じ品なので種類は増えない）
    # 📄 2026-09-16 夕に LCSC と JLCPCB の部品ページで直接取った:
    #    AO3401A（Alpha & Omega Semiconductor・SOT-23）= **C15127**・**Basic**・在庫 477,057・$0.0942（1+）。
    #    Basic なので種類ごとの取り付け料がかからない。
    #    仕様も同じページから: P-ch・Vds 30V・Id 4A・Vgs(th) 900mV・Vgs ±12V・
    #    RDS(on) 47mΩ@10V / 60mΩ@4.5V / **85mΩ@2.5V**。
    #    電池は 3.0〜4.2V なので Vgs は −3.0〜−4.2V ＝ RDS(on) は 60〜85mΩ に収まる。
    #    昇圧の入力が 1.6A のとき 落ちるのは 0.10〜0.14V・発熱 0.15〜0.22W（SOT-23 の Pd 1.4W 以内）
    "Q2": "C15127",                                             # 基: AO3401A（逆接保護の P-ch）
    "R6": "C22961",                                             # 基: 220kΩ 0603（元は 270kΩ C17589・Extended）
    "R7": "C23254",                                             # 基: 82kΩ 0603（元は 100kΩ。R6 と比を保つため）
    "C6": "C96123", "C9": "C96123",                             # 基: 47µF 10V 1206（元は 100µF 1210 C23742・Extended）
    "R15": "C17475",                                            # 基: 15kΩ
    "R32": "C17414", "R42": "C17414", "R43": "C17414",          # 基: 10kΩ
    "R16": "C17513", "R31": "C17513",                           # 基: 1kΩ
    "C1": "C15850", "C7": "C15850", "C8": "C15850",             # 基: 10µF 25V
    "C4": "C49678", "C41": "C49678", "C31": "C49678", "C32": "C49678",
    "C42": "C49678",                                            # 基: 0.1µF 50V（C42 は AS5600 のパスコン。
                                                                #     2026-09-13、fab.py が「番号が無い」で止まって気づいた）
    "C2": "C377773",                                            # 基: 2.2µF 50V
    "Q31": "C2150", "D31": "C81598", "R44": "C27834", "R45": "C27834",                            # 基: SS8050（SOT-23）・1N4148W（SOD-123）
    "K31": "C16707",                                            # 拡: Omron G6S-2F DC5（表面実装のリレー）
    "U4": "C499458",                                            # 拡: AS5600-ASOT（SOIC-8・つまみの角度）。2026-09-18 に ASOM C79815 から替えた ── 違いはリールだけ（📄 AS5600 データシート 38 ページ: ASOT 13" 2500 個／ASOM 7" 500 個）。在庫 6726 対 378・単価 $1.36 対 $1.76
    "SW1": "C49023766",                                         # ⬜ 区分未確認: MST-12D18G3（横出しのスライドスイッチ）
    "SW2": "C780038",                                           # XKB5858-Z-E（電源の押しボタン・押し子 5.0・スルーホール・手はんだ。2026-09-19 LCSC $0.30）。⭐ 同日 -75（C780035・押し子 2.5）から替えた: キャップが付かない
}
for P in PARTS:
    if P["ref"] in LCSC:
        P["lcsc"] = LCSC[P["ref"]]

# 🔒 2026-09-13 ユーザー: 電源基板を中継基板へ統合して **板は 1 枚**になった。
# 板をまたぐ口（J11 ↔ J12・7 本）とミシン目のタブは消え、板ごとにネット名を変える処理
# （V5P・GNDP・V33P …）も要らなくなった。USB-C の周りに残っていた GNDP も GND に戻す。

# ERC 用の電源の印（コネクタから入ってくる電源）
group("flags")
for i, net in enumerate(["GND", "VBUS", "V33", "BATP"]):
    part(f"#FLG0{i + 1}", "power:PWR_FLAG", "PWR_FLAG", 120 + i * 6, 10, {"1": net})


# ---- 書き出し ----
# 図の見出し・表題・用紙。gen_sch_voice.py はこれと OUT・NAME・ROOT・PARTS・GROUPS を差し替えて build() を呼ぶ
SHEET = {
    "paper": "A3",
    "title": "katanori ハブ＋電源",
    "comments": ["電源は Adafruit PowerBoost 1000C Rev B（CC BY-SA 3.0）の写し",
                 "ハブは hardware/parts/relay_board.html の写し・gen_sch.py が生成"],
    "heads": [("昇圧 — Adafruit PowerBoost 1000C Rev B の写し（CC BY-SA 3.0・Limor Fried / Adafruit）", "boost"),
              ("充電 — 同じく PowerBoost 1000C Rev B の写し", "charge"),
              ("電流計 — INA226（シャント 10mΩ・0x44）・電池と USB の口", "ina"),
              ("ハブ — relay_board.html のミュートリレー・会話ボタン", "hub"),
              ("口 — hub_ports.py の並びのまま（今の線がそのまま挿さる）", "ports")],
}


def prop(name, val, x, y, hide=False, just=None, ang=0):
    eff = ["effects", ["font", ["size", "1.27", "1.27"]]]
    if just:
        eff.append(["justify", just])
    if hide:
        eff.append(["hide", "yes"])
    return ["property", Str(name), Str(val), ["at", f"{x:.2f}", f"{y:.2f}", str(ang)], eff]


def label(net, x, y, ang):
    just = {0: ["left", "bottom"], 90: ["left", "bottom"], 180: ["right", "bottom"], 270: ["right", "bottom"]}[ang]
    return ["label", Str(net), ["at", f"{x:.2f}", f"{y:.2f}", str(ang)],
            ["effects", ["font", ["size", "1.27", "1.27"]], ["justify", *just]], ["uuid", Str(uid())]]


def wire(x1, y1, x2, y2):
    return ["wire", ["pts", ["xy", f"{x1:.2f}", f"{y1:.2f}"], ["xy", f"{x2:.2f}", f"{y2:.2f}"]],
            ["stroke", ["width", "0"], ["type", "default"]], ["uuid", Str(uid())]]


def text_pos(P):
    """部品番号と値を置く場所。ネット名の文字と重ならない側に逃がす。
    戻り値: ((ref の x, y, 寄せ), (値の x, y, 寄せ))"""
    pins = kisym.pins(P["lib"])
    X, Y = P["x"], P["y"]
    angs = {int(a) % 360 for (_, _, _, a, _) in pins.values()}
    pxs = [px for (_, px, _, _, _) in pins.values()]
    pys = [py for (_, _, py, _, _) in pins.values()]
    if 180 not in angs:           # 右へ出るネット名が無い（縦の R・C・L・コネクタ・トランジスタ・リレー）: 右に並べる
        x = X + max(0.0, max(pxs)) + (1.8 if len(pins) == 2 and angs <= {90, 270} else 3.0)
        return (x, Y - 0.6, "left"), (x, Y + 1.6, "left")
    if not angs & {90, 270}:      # 上下へ出るネット名が無い（横の LED・ダイオード・スイッチ）: 上下
        return (X, Y - max(pys) - 2.2, None), (X, Y - min(pys) + 3.2, None)

    def lab(sel):
        return max([G + 1.0 + 1.0 * len(P["nets"][n] or "") for n, (_, _, _, a, _) in pins.items()
                    if int(a) % 360 == sel] or [0.0])
    top = Y - max(pys) - lab(270) - 2.0
    bot = Y - min(pys) + lab(90) + 3.0
    return (X, top, None), (X, bot, None)


def extents(P):
    """部品の占める箱（ピン・短い線・ネット名の文字まで）。回路図の座標で (x0, y0, x1, y1)。"""
    pins = kisym.pins(P["lib"])
    X, Y = P["x"], P["y"]
    xs, ys = [], []
    for num, (nm, px, py, ang, typ) in pins.items():
        sx, sy = X + px, Y - py
        xs.append(sx)
        ys.append(sy)
        net = P["nets"][num] or ""
        L = G + 1.0 + 1.0 * len(net)
        dx, dy = {0: (-L, 0), 180: (L, 0), 90: (0, L), 270: (0, -L)}[int(ang) % 360]
        xs.append(sx + dx)
        ys.append(sy + dy)
    for (tx, ty, just), s in zip(text_pos(P), (P["ref"], P["value"])):
        w = 1.1 * len(s)
        xs += [tx, tx + w] if just == "left" else [tx - w / 2, tx + w / 2]
        ys += [ty - 1.3, ty + 0.6]
    return min(xs) - 0.5, min(ys) - 0.5, max(xs) + 0.5, max(ys) + 0.5


def check_layout():
    """部品の箱が重なっていないか。重なると別のネットがつながる（2026-09-12 に GND と VSYS がつながった）。"""
    bad = []
    boxes = [(P["ref"], extents(P)) for P in PARTS]
    for i, (ra, a) in enumerate(boxes):
        for rb, b in boxes[i + 1:]:
            if a[0] < b[2] and b[0] < a[2] and a[1] < b[3] and b[1] < a[3]:
                bad.append((ra, rb))
    return bad


def pack():
    """組ごとに、書いた順で左から右へ詰め、幅を超えたら次の段へ送る。原点はグリッドに乗せる。"""
    for gname, (gx0, gy0, gw) in GROUPS.items():
        cx, cy, rowh = gx0, gy0, 0.0
        for P in [P for P in PARTS if P["grp"] == gname]:
            P["x"] = P["y"] = 0.0
            x0, y0, x1, y1 = extents(P)
            w, h = x1 - x0, y1 - y0
            if cx + w > gx0 + gw and cx > gx0:
                cx, cy, rowh = gx0, cy + rowh + G, 0.0
            P["x"] = math.ceil((cx - x0) / G) * G
            P["y"] = math.ceil((cy - y0) / G) * G
            bx0, by0, bx1, by1 = extents(P)
            cx = bx1 + G
            rowh = max(rowh, by1 - cy)
    xs = [extents(P) for P in PARTS]
    print("図の範囲 x %.0f〜%.0f / y %.0f〜%.0f mm（A3 は 420 × 297）"
          % (min(b[0] for b in xs), max(b[2] for b in xs), min(b[1] for b in xs), max(b[3] for b in xs)))


def build():
    pack()
    bad = check_layout()
    if bad:
        for ra, rb in bad:
            print("重なり:", ra, rb, [round(v, 1) for v in extents(next(P for P in PARTS if P["ref"] == ra))],
                  [round(v, 1) for v in extents(next(P for P in PARTS if P["ref"] == rb))])
        sys.exit(f"部品の箱が {len(bad)} 組重なっている。置き場所を直す")
    libs = {}
    items = []
    for P in PARTS:
        libs.setdefault(P["lib"], kisym.symbol(P["lib"]))
        pins = kisym.pins(P["lib"])
        missing = set(pins) - set(P["nets"])
        extra = set(P["nets"]) - set(pins)
        assert not missing and not extra, (P["ref"], "ピンの割り当て漏れ", sorted(missing), sorted(extra))
        X, Y = P["x"], P["y"]
        ys = [py for (_, _, py, _, _) in pins.values()]
        top, bot = Y - max(ys), Y - min(ys)
        two = len(pins) == 2 and P["lib"].startswith("Device:")
        is_flag = P["ref"].startswith("#")
        sym = ["symbol", ["lib_id", Str(P["lib"])], ["at", f"{X:.2f}", f"{Y:.2f}", "0"], ["unit", "1"],
               ["exclude_from_sim", "no"], ["in_bom", "no" if is_flag else "yes"],
               ["on_board", "no" if is_flag else "yes"], ["dnp", "yes" if P["dnp"] else "no"],
               ["uuid", Str(uid())]]
        (rx, ry, rj), (vx, vy, vj) = text_pos(P)
        sym.append(prop("Reference", P["ref"], rx, ry, hide=is_flag, just=rj))
        sym.append(prop("Value", P["value"], vx, vy, hide=is_flag, just=vj))
        sym.append(prop("Footprint", P["fp"], X, Y, hide=True))
        sym.append(prop("Datasheet", "", X, Y, hide=True))
        if P["lcsc"]:
            sym.append(prop("LCSC", P["lcsc"], X, Y, hide=True))
        if P["note"]:
            sym.append(prop("Note", P["note"], X, Y, hide=True))
        for num in pins:
            sym.append(["pin", Str(num), ["uuid", Str(uid())]])
        sym.append(["instances", ["project", Str(NAME), ["path", Str("/" + ROOT),
                                                       ["reference", Str(P["ref"])], ["unit", "1"]]]])
        items.append(sym)
        # ピンごとに短い線とネット名（同じ位置に重なるピンは 1 回だけ）
        done = set()
        for num, (nm, px, py, ang, typ) in pins.items():
            sx, sy = round(X + px, 2), round(Y - py, 2)
            if (sx, sy) in done:
                continue
            done.add((sx, sy))
            net = P["nets"][num]
            if net is None:
                items.append(["no_connect", ["at", f"{sx:.2f}", f"{sy:.2f}"], ["uuid", Str(uid())]])
                continue
            if is_flag:
                items.append(label(net, sx, sy, 0))
                continue
            dx, dy, la = {0: (-G, 0, 180), 180: (G, 0, 0), 90: (0, G, 270), 270: (0, -G, 90)}[int(ang) % 360]
            items.append(wire(sx, sy, sx + dx, sy + dy))
            items.append(label(net, sx + dx, sy + dy, la))

    for t, gname in SHEET["heads"]:
        gxx, gyy, _ = GROUPS[gname]
        items.append(["text", Str(t), ["exclude_from_sim", "no"], ["at", f"{gxx:.2f}", f"{gyy - 3:.2f}", "0"],
                      ["effects", ["font", ["size", "2", "2"], ["bold", "yes"]], ["justify", "left", "bottom"]],
                      ["uuid", Str(uid())]])

    doc = ["kicad_sch", ["version", "20250114"], ["generator", Str("eeschema")],
           ["generator_version", Str("9.0")], ["uuid", Str(ROOT)], ["paper", Str(SHEET["paper"])],
           ["title_block", ["title", Str(SHEET["title"])], ["rev", Str("0.1")],
            *[["comment", str(i), Str(c)] for i, c in enumerate(SHEET["comments"], 1)]],
           ["lib_symbols", *libs.values()], *items,
           ["sheet_instances", ["path", Str("/"), ["page", Str("1")]]], ["embedded_fonts", "no"]]
    OUT.mkdir(parents=True, exist_ok=True)
    (OUT / f"{NAME}.kicad_sch").write_text(kisym.dump(doc) + "\n", encoding="utf-8")
    # 🔴 設計規則はここで書く。v6 では手で入れた .kicad_pro が残っていて気づかなかったが、
    #    規則の無い（からの）.kicad_pro だと KiCad は既定値（線 0.2 以上・すきま 0.2 以上・
    #    縁まで 0.5）で検査し、自動配線の結果が違反の山に見える（2026-09-14 に v6.1 で踏んだ）。
    #    値は v6 の hub_power.kicad_pro と同じ（案③ JLCPCB の 6/6mil 相当）。
    pro = OUT / f"{NAME}.kicad_pro"
    # ⭐ 2026-09-17 夕: min_resolved_spokes を 2 → 1。手はんだの口の貫通 GND パッドは
    #   ベタを thermal relief でつなぐ（gen_pcb.py の HAND_SOLDER）が、PH の 1.2mm の
    #   パッドには spoke が 1 本しか立たず、既定の 2 本では starved_thermal になる。
    #   🔴 最初これを katanori61.kicad_dru（カスタム規則）に書いたが、**kicad-cli は
    #      その .kicad_dru を読まない**。わざと壊した規則を入れても素通りしたので確かめた。
    #      設計規則はこの .kicad_pro に書くこと。
    rules = {"min_clearance": 0.15, "min_copper_edge_clearance": 0.3, "min_hole_clearance": 0.25,
             "min_hole_to_hole": 0.5, "min_microvia_diameter": 0.2, "min_microvia_drill": 0.1,
             "min_resolved_spokes": 1,
             "min_silk_clearance": 0.0, "min_through_hole_diameter": 0.3, "min_track_width": 0.1,
             "min_via_annular_width": 0.13, "min_via_diameter": 0.45}
    net_default = {"bus_width": 12.0, "clearance": 0.15, "diff_pair_gap": 0.25, "diff_pair_width": 0.2,
                   "line_style": 0, "microvia_diameter": 0.3, "microvia_drill": 0.1, "name": "Default",
                   "pcb_color": "rgba(0, 0, 0, 0.000)", "schematic_color": "rgba(0, 0, 0, 0.000)",
                   "track_width": 0.2, "via_diameter": 0.8, "via_drill": 0.4, "wire_width": 6.0}
    pro.write_text(json.dumps({
        "board": {"design_settings": {"rules": rules}},
        "meta": {"filename": f"{NAME}.kicad_pro", "version": 3},
        "net_settings": {"classes": [net_default], "meta": {"version": 4}},
        "sheets": [], "text_variables": {}}, indent=2), encoding="utf-8")
    print(f"{len(PARTS)} 部品 → {OUT / (NAME + '.kicad_sch')}")


if __name__ == "__main__":
    build()
