n416/katanori/firmware/esp32/src/AudioIo.cpp

#include "AudioIo.h"

#include <driver/i2s.h>
#include <freertos/FreeRTOS.h>
#include <freertos/stream_buffer.h>
#include <esp_heap_caps.h>
#include <Wire.h>
#include "Console.h" // 最後に置く（Serial を Wi-Fi モニタへも流す差し替え。Console.h）

namespace katanori {

namespace {

constexpr i2s_port_t I2S_PORT = I2S_NUM_0;

/*
 * XMOS のレートと機体の中のレートの比（AudioIo.h）。
 *
 * 16kHz 版のファームなら 1 で、下の変換は全部素通しになる（コンパイル時に消える）。
 * 48kHz 版なら 3。
 */
constexpr int RATE_RATIO = KATANORI_XMOS_RATE / KATANORI_AUDIO_RATE;
static_assert(RATE_RATIO >= 1, "XMOS のレートが機体のレートより低い");
static_assert(KATANORI_XMOS_RATE == KATANORI_AUDIO_RATE * RATE_RATIO,
              "XMOS のレートは機体のレートの整数倍でなければならない");

// I2S から一度に読む量。ステレオ16bit なので 1フレーム = 4バイト。
// 512フレーム = 32ms 相当。OLEDの全面転送(約29ms)の間に溜まる量を吸収できる。
// ⚠ 48kHz のときは3フレームで1サンプルになるので、同じ時間ぶんを読むには
//    比のぶん増やす必要がある（減らすと1回の呼び出しで 10ms 分しか取れない）。
constexpr size_t READ_FRAMES = 512 * RATE_RATIO;

// 再生バッファ。PSRAM があれば潤沢に取る。
// 16kHz/16bit モノラルなので 1秒 = 32000バイト。
// 🔴 Gemini の返事は実時間の 2〜3 倍で届く。512KB（16.4 秒）では 25 秒の返事で満杯になり、
// 越えた分を捨てて途中が抜けた（2026-09-22）。満杯に近づくと受信を待たせる（main loop の
// holdReceive）ので上限は保険。ユーザー指定で 2MB（4MB はやりすぎ）
constexpr size_t PLAY_BUF_PSRAM = 2 * 1024 * 1024; // 65.5秒
constexpr size_t PLAY_BUF_DRAM  = 48 * 1024;  // 1.5秒

StreamBufferHandle_t playBuf = nullptr;
StaticStreamBuffer_t playBufStruct;
uint8_t* playBufStorage = nullptr;
size_t playBufSize = 0;

// ステレオ読み出し用の一時領域。32bitスロットも受けられるよう2倍で確保する。
int32_t* stereoScratch = nullptr;
constexpr size_t SCRATCH_BYTES = READ_FRAMES * sizeof(int32_t) * 2;

bool driverInstalled = false;

/*
 * マイクの受け皿。読み取り用のタスク（captureTask）が I2S から読み続けてここへためる。
 *
 * 🔴 main loop が I2S を直接読んでいたころは、Gemini への接続（TLS の握手で 1〜2 秒
 * loop が止まる）の間にマイクが読まれず、I2S の DMA（64ms 分）が溢れて音が消えていた。
 * 「カタノリ、今日の天気は？」の続きがまるごと落ちた（2026-09-22 実機）。
 * 5 秒あれば、接続がもたついても取りこぼさない。
 */
constexpr uint32_t CAP_SAMPLES = KATANORI_AUDIO_RATE * 5;
int16_t* capMain = nullptr;   // 会話・VAD 用（KATANORI_MIC_CHANNEL・KATANORI_MIC_GAIN）
int16_t* capWake = nullptr;   // 呼び名の聞き分け用（ch1 を 16 倍）
uint8_t* capPlay = nullptr;   // 録ったときのスピーカーの状態（AudioIo::MIC_PLAY_*）
// ch1 を 30 秒ためる控え（dumpWake 専用）。受け皿（5 秒）とは別に、タスクが書き続ける
constexpr uint32_t WAKE_LOG_SAMPLES = KATANORI_AUDIO_RATE * 30;
int16_t* wakeLog = nullptr;
volatile uint32_t wakeLogW = 0;   // 書いた総数（％ で位置を出す）

/**
 * 再生が始まってから、AEC の係数が落ち着くまで [ms]。
 * 2026-09-21 実測: 再生開始直後の残留が RMS 8000〜13000、0.3〜0.6秒 で 134〜677 まで落ちる。安全側に 600ms。
 */
constexpr uint32_t KATANORI_AEC_SETTLE_MS = 600;
volatile uint32_t capW = 0;   // 書いた総数（タスクだけが進める）
volatile uint32_t capR = 0;   // 読んだ総数（readMic だけが進める）
volatile uint32_t capDropped = 0;
// 声が続いたかの見張り（armVoiceWatch）。条件は main loop が書き、数えるのはタスクだけ
volatile uint32_t vwMinSamples = 0;   // 0 = 見張らない
volatile float vwThreshold = 1e9f;
volatile bool vwFired = false;
uint32_t vwRun = 0;                   // 続いている声のサンプル数（タスクだけが触る）
uint32_t vwGap = 0;                   // 声が途切れてからのサンプル数
volatile bool vwReset = false;        // 条件が変わった。数え直す
// 音量を下げてから止める（stopPlayback）。頼むのは誰でもよく、実際に下げるのは鳴らすタスクだけ
constexpr uint32_t KATANORI_FADE_MS = 150;
volatile bool fadeReq = false;
// 再生中の割り込みの見張り（armBargeIn）
volatile float biThreshold = 0.0f;
volatile uint32_t biMinSamples = 0;   // 0 = 見張らない
// つまみを回した直後は AEC が合わせ直すので、この間は再生の始まりと同じ扱い（noteKnobMoved）
constexpr uint32_t KATANORI_KNOB_HOLD_MS = 1000;
volatile uint32_t knobHoldW = 0;      // この録音位置までは MIC_PLAY_SETTLING（main loop が書く）
volatile bool biFired = false;
uint32_t biRun = 0;                   // タスクだけが触る
uint32_t biGap = 0;
// 音量の最大（takeLevels）。タスクが書き、main loop が読んで消す
volatile float lvl0Max = 0.0f;
volatile float lvl1Max = 0.0f;
volatile bool lvlPlayed = false;
volatile int capHoldCount = 0;  // 診断のコマンドが I2S を直に触る間は止める
volatile bool capHeld = false;

} // namespace

AudioIo audioIo;

bool AudioIo::applyConfig(bool slave, bool msbFormat, int bits) {
    // 実行中に張り替えるときは、読み取り用のタスクを止めてから（入れ子になってよい）
    if (started_) {
        holdCapture(true);
    }
    struct Release {
        AudioIo* a;
        bool on;
        ~Release() { if (on) a->holdCapture(false); }
    } release{this, started_};
    if (started_ || driverInstalled) {
        i2s_driver_uninstall(I2S_PORT);
        driverInstalled = false;
    }

    i2s_config_t cfg = {};
    cfg.mode = static_cast<i2s_mode_t>(
        (slave ? I2S_MODE_SLAVE : I2S_MODE_MASTER) | I2S_MODE_TX | I2S_MODE_RX);
    cfg.sample_rate = KATANORI_XMOS_RATE;  // 機体の中のレートではなく XMOS の実レート
    cfg.bits_per_sample = (bits == 32) ? I2S_BITS_PER_SAMPLE_32BIT
                                       : I2S_BITS_PER_SAMPLE_16BIT;
    cfg.channel_format = I2S_CHANNEL_FMT_RIGHT_LEFT; // ステレオ
    cfg.communication_format = msbFormat ? I2S_COMM_FORMAT_STAND_MSB
                                         : I2S_COMM_FORMAT_STAND_I2S;
    cfg.intr_alloc_flags = ESP_INTR_FLAG_LEVEL1;
    /*
     * 4 x 256フレーム = 16kHz で 64ms。OLEDの全面転送(約29ms)の間の取りこぼしを
     * 防ぐには十分で、かつ「無音を流し続ける」方式で応答音声に乗る遅延を抑えられる。
     *
     * 🔴 48kHz では同じ数だと 21ms にしかならず、描画の 29ms の間に必ず溢れる。
     * 溢れた不連続が「静かなのに RMS 数千」として出てきて、VAD が誤って起動した
     * （2026-09-21 実機。QUIET が中央 49 から数千へ跳ねた）。比のぶん増やして
     * 時間を揃える。増える内蔵RAMは 32bitステレオで 16KB ほど。
     */
    cfg.dma_buf_count = 4 * RATE_RATIO;
    cfg.dma_buf_len = 256;
    cfg.use_apll = false;
    cfg.tx_desc_auto_clear = true; // 送るものが無いときは無音を流す
    cfg.fixed_mclk = 0;

    esp_err_t err = i2s_driver_install(I2S_PORT, &cfg, 0, nullptr);
    if (err != ESP_OK) {
        Serial.printf("[I2S] driver_install 失敗: %s\n", esp_err_to_name(err));
        return false;
    }

    i2s_pin_config_t pins = {};
    pins.mck_io_num = (KATANORI_I2S_MCLK < 0) ? I2S_PIN_NO_CHANGE : KATANORI_I2S_MCLK;
    pins.bck_io_num = KATANORI_I2S_BCLK;
    pins.ws_io_num = KATANORI_I2S_WS;
    pins.data_out_num = KATANORI_I2S_DOUT;
    pins.data_in_num = KATANORI_I2S_DIN;

    err = i2s_set_pin(I2S_PORT, &pins);
    if (err != ESP_OK) {
        Serial.printf("[I2S] set_pin 失敗: %s\n", esp_err_to_name(err));
        i2s_driver_uninstall(I2S_PORT);
        return false;
    }
    i2s_zero_dma_buffer(I2S_PORT);

    driverInstalled = true;
    curSlave_ = slave;
    curMsb_ = msbFormat;
    curBits_ = bits;
    return true;
}

bool AudioIo::begin() {
    if (started_) {
        return true;
    }

    if (!applyConfig(KATANORI_I2S_SLAVE, KATANORI_I2S_MSB_FORMAT, KATANORI_I2S_BITS)) {
        return false;
    }

    // 読み出し用スクラッチ
    stereoScratch = static_cast<int32_t*>(malloc(SCRATCH_BYTES));
    if (stereoScratch == nullptr) {
        Serial.println("[I2S] スクラッチ確保に失敗");
        i2s_driver_uninstall(I2S_PORT);
        return false;
    }

    // 再生バッファ: PSRAM を優先し、無ければ内蔵RAMで小さく取る
    playBufSize = PLAY_BUF_PSRAM;
    playBufStorage = static_cast<uint8_t*>(
        heap_caps_malloc(playBufSize + 1, MALLOC_CAP_SPIRAM));
    if (playBufStorage == nullptr) {
        playBufSize = PLAY_BUF_DRAM;
        playBufStorage = static_cast<uint8_t*>(malloc(playBufSize + 1));
        Serial.println("[I2S] PSRAMが使えないため再生バッファを縮小しました");
    }
    if (playBufStorage == nullptr) {
        Serial.println("[I2S] 再生バッファ確保に失敗");
        i2s_driver_uninstall(I2S_PORT);
        return false;
    }

    // 入れられるのは「渡した大きさ − 1」バイト。+1 で渡して、容量を偶数（＝サンプルの切れ目）にする
    // （2026-09-22: 524287 バイトだったため、満杯で奇数バイトに切れて以降が雑音になった。play() の説明）
    playBuf = xStreamBufferCreateStatic(playBufSize + 1, 1, playBufStorage, &playBufStruct);
    if (playBuf == nullptr) {
        Serial.println("[I2S] StreamBuffer作成に失敗");
        i2s_driver_uninstall(I2S_PORT);
        return false;
    }

    // 再生タスク。描画を止めないよう main loop とは別に回す。
    BaseType_t ok = xTaskCreatePinnedToCore(
        playbackTask, "katanori_play", 4096, this, 5, nullptr, 0);
    if (ok != pdPASS) {
        Serial.println("[I2S] 再生タスクの起動に失敗");
        return false;
    }

    // マイクの受け皿と読み取り用のタスク（capMain の説明）
    capMain = static_cast<int16_t*>(heap_caps_malloc(CAP_SAMPLES * sizeof(int16_t), MALLOC_CAP_SPIRAM));
    capWake = static_cast<int16_t*>(heap_caps_malloc(CAP_SAMPLES * sizeof(int16_t), MALLOC_CAP_SPIRAM));
    capPlay = static_cast<uint8_t*>(heap_caps_malloc(CAP_SAMPLES, MALLOC_CAP_SPIRAM));
    wakeLog = static_cast<int16_t*>(heap_caps_malloc(WAKE_LOG_SAMPLES * sizeof(int16_t), MALLOC_CAP_SPIRAM));
    if (capMain == nullptr || capWake == nullptr || capPlay == nullptr) {
        Serial.println("[I2S] マイクの受け皿（PSRAM）が取れません");
        return false;
    }
    started_ = true;
    // main loop と同じ core 1 で、loop より高い優先度。loop が TLS の握手で止まっていても
    // 割り込んで読む。I2S の読み出しで待つ間は CPU を譲る
    ok = xTaskCreatePinnedToCore(captureTask, "katanori_mic", 4096, this, 5, nullptr, 1);
    if (ok != pdPASS) {
        Serial.println("[I2S] マイクのタスクの起動に失敗");
        started_ = false;
        return false;
    }

    Serial.printf("[I2S] 初期化しました  %dHz 16bit stereo  %s / %s\n",
                  KATANORI_AUDIO_RATE,
                  KATANORI_I2S_SLAVE ? "SLAVE" : "MASTER",
                  KATANORI_I2S_MSB_FORMAT ? "MSB(左詰め)" : "標準I2S");
    Serial.printf("[I2S]   bclk=%d ws=%d dout=%d din=%d mclk=%d\n",
                  KATANORI_I2S_BCLK, KATANORI_I2S_WS,
                  KATANORI_I2S_DOUT, KATANORI_I2S_DIN, KATANORI_I2S_MCLK);
    Serial.printf("[I2S] 再生バッファ %uKB (%.1f秒ぶん)  マイクch=%d\n",
                  (unsigned)(playBufSize / 1024),
                  playBufSize / 2.0f / KATANORI_AUDIO_RATE,
                  KATANORI_MIC_CHANNEL);
    return true;
}

void AudioIo::startRecording() {
    if (!started_) {
        return;
    }
    // 前のターンの残りを持ち込まない（受け皿を空にする）
    capR = capW;
    sentSamples_ = 0;
    recording_ = true;
}

void AudioIo::stopRecording() {
    recording_ = false;
    micLevel_ = 0.0f;
}

size_t AudioIo::frameBytes() const {
    // ステレオなので 16bitスロットなら4バイト、32bitスロットなら8バイト
    return (curBits_ == 32) ? 8 : 4;
}

/** 固定ゲインを掛けて 16bit に収める（AudioIo.h の KATANORI_MIC_GAIN）。 */
int16_t AudioIo::applyMicGain(int16_t v) {
    if (KATANORI_MIC_GAIN == 1) {
        return v;
    }
    int32_t g = static_cast<int32_t>(v) * KATANORI_MIC_GAIN;
    if (g > 32767) {
        g = 32767;
        ++micClipped_;
    } else if (g < -32768) {
        g = -32768;
        ++micClipped_;
    }
    return static_cast<int16_t>(g);
}

/**
 * マイクから読む。readMic が受け皿から取り出すのに対し、こちらは I2S を直に読む。
 * 読み取り用のタスク（captureTask）だけが呼ぶ。
 */
size_t AudioIo::captureFromI2s(int16_t* out, size_t maxSamples, int16_t* wakeOut, TickType_t wait) {
    if (!started_) {
        return 0;
    }

    const size_t fb = frameBytes();
    // 48kHz のときは 3 フレームで 1 サンプルになるので、欲しいサンプル数の
    // 比のぶんだけフレームを読む
    size_t frames = maxSamples * RATE_RATIO;
    if (frames > READ_FRAMES) {
        frames = READ_FRAMES;
    }
    size_t want = frames * fb;
    if (want > SCRATCH_BYTES) {
        want = (SCRATCH_BYTES / fb) * fb;
    }

    size_t bytesRead = 0;
    // タイムアウト0 = 溜まっているぶんだけ。描画を止めない。
    if (i2s_read(I2S_PORT, stereoScratch, want, &bytesRead, wait) != ESP_OK) {
        return 0;
    }

    size_t got = bytesRead / fb;
    if (got == 0) {
        return 0;
    }

    /*
     * ステレオ -> モノラル。ch0 = 音声認識向けの処理済み信号。
     *
     * 48kHz のファームでは、ここで 3 サンプルの平均を 1 つにして 16kHz へ落とす
     * （AudioIo.h の KATANORI_XMOS_RATE）。呼び出し側は常に 16kHz を受け取る。
     *
     * ⚠ 平均は簡易な低域通過で、8kHz あたりの落ちは -6dB ほどしかない。折り返しが
     * 音声認識に響くようなら FIR に替える。まず平均で測る（ReSpeaker の
     * ノイズ抑制を通った後なので高域はもともと少ない）。
     * ⚠ 端数は次の呼び出しへ持ち越す。ここで捨てると 3 回に 1 回ずつ音が飛ぶ。
     */
    int32_t peak = 0;
    size_t produced = 0;
    // 聞き分け用（ch1 を 16 倍）。32bit スロットなら 32bit の段で倍にする（AudioIo.h の wakeOut）
    auto wakeRaw = [&](size_t i) -> int64_t {
        if (curBits_ == 32) {
            return stereoScratch[i * 2 + 1];
        }
        return static_cast<int64_t>(reinterpret_cast<const int16_t*>(stereoScratch)[i * 2 + 1]) << 16;
    };
    auto wakeOf = [this](int64_t v32) -> int16_t {
        // 16bit へは >>16。倍率ぶん掛けてから落とす（既定 16 倍 = 元の >>12 と同じ）
        const int64_t v = (v32 * static_cast<int64_t>(wakeGain_)) >> 16;
        if (v > 32767 || v < -32768) {
            ++wakeClipped_;
            return v > 0 ? 32767 : -32768;
        }
        return static_cast<int16_t>(v);
    };
    for (size_t i = 0; i < got; ++i) {
        int16_t s;
        if (curBits_ == 32) {
            // XMOS は32bitスロットで送ってくる。実データは上位16bit。
            s = static_cast<int16_t>(stereoScratch[i * 2 + KATANORI_MIC_CHANNEL] >> 16);
        } else {
            const int16_t* src = reinterpret_cast<const int16_t*>(stereoScratch);
            s = src[i * 2 + KATANORI_MIC_CHANNEL];
        }

        if (RATE_RATIO == 1) {
            s = applyMicGain(s);
            if (wakeOut) {
                wakeOut[produced] = wakeOf(wakeRaw(i));
            }
            out[produced++] = s;
        } else {
            decimAcc_ += s;
            decimAccWake_ += wakeRaw(i);
            if (++decimCount_ >= RATE_RATIO) {
                const int16_t avg = applyMicGain(
                    static_cast<int16_t>(decimAcc_ / RATE_RATIO));
                if (wakeOut) {
                    wakeOut[produced] = wakeOf(decimAccWake_ / RATE_RATIO);
                }
                out[produced++] = avg;
                decimAcc_ = 0;
                decimAccWake_ = 0;
                decimCount_ = 0;
                s = avg;  // ピークは出したサンプルで見る
            } else {
                continue;  // まだ 1 サンプル分そろっていない
            }
        }
        const int32_t a = s < 0 ? -static_cast<int32_t>(s) : s;
        if (a > peak) {
            peak = a;
        }
    }

    if (produced == 0) {
        return 0;  // 端数だけだった。次の呼び出しでそろう
    }
    if (recording_) {
        micLevel_ = peak / 32768.0f;
    }
    return produced;
}

void AudioIo::captureTask(void* arg) {
    static_cast<AudioIo*>(arg)->runCapture();
}

void AudioIo::runCapture() {
    static int16_t mainBuf[512];
    static int16_t wakeBuf[512];
    for (;;) {
        if (capHoldCount > 0) {
            capHeld = true;
            vTaskDelay(pdMS_TO_TICKS(5));
            continue;
        }
        capHeld = false;
        const size_t n = captureFromI2s(mainBuf, 512, wakeBuf, pdMS_TO_TICKS(40));
        if (n == 0) {
            vTaskDelay(1);  // I2S が止まっているときに core 1 を占有しない
            continue;
        }
        if (!recording_) {
            continue;  // 録音していないときは読み捨てる（DMA を溢れさせない）
        }
        watchVoice(mainBuf, n);
        // 録った時点のスピーカーの状態（MIC_PLAY_* の説明）。鳴り始めを音の数で数える
        static uint32_t playStartW = 0;
        static bool wasPlaying = false;
        const bool playing = isPlaying();
        if (playing && !wasPlaying) {
            playStartW = capW;
        }
        wasPlaying = playing;
        const bool settling = (capW - playStartW < KATANORI_AUDIO_RATE / 1000 * KATANORI_AEC_SETTLE_MS) ||
                              ((int32_t)(knobHoldW - capW) > 0);
        const uint8_t play = !playing ? MIC_PLAY_NONE : settling ? MIC_PLAY_SETTLING : MIC_PLAY_SETTLED;
        watchBargeIn(mainBuf, n, play);
        {
            double a0 = 0.0, a1 = 0.0;
            for (size_t i = 0; i < n; ++i) {
                a0 += (double)mainBuf[i] * mainBuf[i];
                a1 += (double)wakeBuf[i] * wakeBuf[i];
            }
            const float r0 = (float)sqrt(a0 / n);
            const float r1 = (float)sqrt(a1 / n);
            if (r0 > lvl0Max) lvl0Max = r0;
            if (r1 > lvl1Max) lvl1Max = r1;
            if (play == MIC_PLAY_SETTLED) lvlPlayed = true;  // AEC が落ち着いたあとの再生中
        }
        for (size_t i = 0; i < n; ++i) {
            if (capW - capR >= CAP_SAMPLES) {
                ++capDropped;  // 受け皿が一杯。読む側が 5 秒止まっている
                continue;
            }
            const uint32_t at = capW % CAP_SAMPLES;
            capMain[at] = mainBuf[i];
            capWake[at] = wakeBuf[i];
            capPlay[at] = play;
            if (wakeLog != nullptr) {
                wakeLog[wakeLogW % WAKE_LOG_SAMPLES] = wakeBuf[i];
                wakeLogW = wakeLogW + 1;
            }
            capW = capW + 1;
        }
    }
}

/** 声が続いたかを数える（armVoiceWatch の説明）。読み取り用のタスクだけが呼ぶ。 */
void AudioIo::watchVoice(const int16_t* pcm, size_t n) {
    if (vwReset) {
        vwReset = false;
        vwRun = 0;
        vwGap = 0;
    }
    const uint32_t minSamples = vwMinSamples;
    if (minSamples == 0 || vwFired || isPlaying()) {
        vwRun = 0;
        return;
    }
    double acc = 0.0;
    for (size_t i = 0; i < n; ++i) {
        acc += (double)pcm[i] * (double)pcm[i];
    }
    if ((float)sqrt(acc / n) >= vwThreshold) {
        if (vwGap > KATANORI_AUDIO_RATE * 300 / 1000) {
            vwRun = 0;  // 300ms を超えて途切れた。別の声として数え直す
        }
        vwGap = 0;
        vwRun += n;
        if (vwRun >= minSamples) {
            vwFired = true;
            vwRun = 0;
        }
    } else {
        vwGap += n;
    }
}

/** 再生中に話しかけられたかを数える（armBargeIn の説明）。読み取り用のタスクだけが呼ぶ。 */
void AudioIo::watchBargeIn(const int16_t* pcm, size_t n, uint8_t play) {
    const uint32_t minSamples = biMinSamples;
    if (minSamples == 0 || play != MIC_PLAY_SETTLED || fadeReq) {
        biRun = 0;
        biGap = 0;
        return;
    }
    double acc = 0.0;
    for (size_t i = 0; i < n; ++i) {
        acc += (double)pcm[i] * (double)pcm[i];
    }
    if ((float)sqrt(acc / n) >= biThreshold) {
        if (biGap > KATANORI_AUDIO_RATE * 300 / 1000) {
            biRun = 0;  // 300ms を超えて途切れた。別の声として数え直す
        }
        biGap = 0;
        biRun += n;
        if (biRun >= minSamples) {
            biRun = 0;
            biFired = true;
            stopPlayback();  // その場で止め始める（main loop を待たない）
        }
    } else {
        biGap += n;
    }
}

void AudioIo::armBargeIn(float threshold, uint32_t minMs) {
    biThreshold = threshold;
    biMinSamples = KATANORI_AUDIO_RATE / 1000 * minMs;
}

void AudioIo::noteKnobMoved() {
    knobHoldW = capW + KATANORI_AUDIO_RATE / 1000 * KATANORI_KNOB_HOLD_MS;
}

bool AudioIo::takeBargeIn() {
    if (!biFired) {
        return false;
    }
    biFired = false;
    return true;
}

void AudioIo::takeLevels(float& ch0Max, float& ch1Max, bool& played) {
    ch0Max = lvl0Max;
    ch1Max = lvl1Max;
    played = lvlPlayed;
    lvl0Max = 0.0f;
    lvl1Max = 0.0f;
    lvlPlayed = false;
}

size_t AudioIo::queuedSamples() const {
    return playBuf != nullptr ? xStreamBufferBytesAvailable(playBuf) / sizeof(int16_t) : 0;
}

size_t AudioIo::queueCapacitySamples() const {
    return playBufSize / sizeof(int16_t);
}

void AudioIo::armVoiceWatch(uint32_t minMs) {
    vwMinSamples = KATANORI_AUDIO_RATE / 1000 * minMs;
    vwReset = true;
    if (minMs == 0) {
        vwFired = false;
    }
}

void AudioIo::setVoiceThreshold(float rms) {
    vwThreshold = rms;
}

bool AudioIo::takeVoiceFired() {
    if (!vwFired) {
        return false;
    }
    vwFired = false;
    return true;
}

size_t AudioIo::readMic(int16_t* out, size_t maxSamples, int16_t* wakeOut, uint8_t* playOut) {
    if (!started_ || !recording_) {
        return 0;
    }
    const uint32_t avail = capW - capR;
    size_t n = avail < maxSamples ? avail : maxSamples;
    if (n > 0) {
        // 印が変わる所で止める（1 回に返す音は全部同じ印）
        const uint8_t first = capPlay[capR % CAP_SAMPLES];
        for (size_t i = 1; i < n; ++i) {
            if (capPlay[(capR + i) % CAP_SAMPLES] != first) {
                n = i;
                break;
            }
        }
        if (playOut) {
            *playOut = first;
        }
    }
    for (size_t i = 0; i < n; ++i) {
        const uint32_t at = (capR + i) % CAP_SAMPLES;
        out[i] = capMain[at];
        if (wakeOut) {
            wakeOut[i] = capWake[at];
        }
    }
    capR = capR + n;
    sentSamples_ += n;
    return n;
}

uint32_t AudioIo::micDropped() const {
    return capDropped;
}

void AudioIo::dumpWake(float backSec, float lenSec) {
    if (wakeLog == nullptr) {
        return;
    }
    holdCapture(true);  // 吐いている間に上書きされないよう、読み取りのタスクを止める
    const uint32_t now = wakeLogW;
    uint32_t back = (uint32_t)(backSec * KATANORI_AUDIO_RATE);
    if (back > WAKE_LOG_SAMPLES) back = WAKE_LOG_SAMPLES;
    if (back > now) back = now;
    uint32_t count = (uint32_t)(lenSec * KATANORI_AUDIO_RATE);
    if (count > back) count = back;
    const uint32_t start = now - back;
    static const char* const kHex = "0123456789abcdef";
    char line[16 + 64 * 4 + 2];
    uint32_t rows = 0;
    for (uint32_t i = 0; i < count; i += 64) {
        int len = snprintf(line, sizeof(line), "WD %05u ", (unsigned)rows);
        for (uint32_t k = 0; k < 64 && i + k < count; ++k) {
            const uint16_t v = (uint16_t)wakeLog[(start + i + k) % WAKE_LOG_SAMPLES];
            line[len++] = kHex[(v >> 12) & 15];
            line[len++] = kHex[(v >> 8) & 15];
            line[len++] = kHex[(v >> 4) & 15];
            line[len++] = kHex[v & 15];
        }
        line[len] = '\0';
        Serial.println(line);
        ++rows;
    }
    Serial.printf("WD END %u\n", (unsigned)rows);
    holdCapture(false);
}

void AudioIo::holdCapture(bool hold) {
    if (hold) {
        ++capHoldCount;
        // タスクが I2S から手を離すまで待つ（1 回の読み出しは最長 40ms）
        const uint32_t t0 = millis();
        while (started_ && !capHeld && millis() - t0 < 200) {
            delay(1);
        }
    } else if (capHoldCount > 0) {
        --capHoldCount;
    }
}
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
