n416/katanori/(notices)

Notices in the files:
hardware/ref/voice_pe/KiCad/Home Assistant Voice PE.kicad_sch:
Licensed under CERN-OHL-P v2
Copyright Nabu Casa 2025.
This project and the files contained within describe Open Hardware and is licensed under the CERN-OHL-P v2.
You may redistribute and modify this documentation and make products using it under the
terms of the CERN-OHL-P v2 (https://cern.ch/cern-ohl). This documentation is distributed
parts and their libraries:
microbuilder: This work is placed in the public domain, and may be freely used for commercial and non-commercial work with the following conditions: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
